duanxuebin1998/cube/docs/01_协议与寄存器/AO电流输出/README.md

# AO 电流输出资料索引

更新日期：2026-08-17

本目录集中保存 4-20 mA/AO 输出的外部参考资料和项目侧整理结论。外部手册只读归档，当前 CUBE 的实际参数语义和运行行为仍以 CPU2/CPU3 当前源码、共享协议记录和版本资料为准。

## 资料入口

| 资料 | 用途 | 维护口径 |
| --- | --- | --- |
| [4-20mA 电流输出逻辑](4-20mA电流输出逻辑.md) | 说明CUBE三种过程源、基础/修正目标、初始/过程/保持/故障状态、维护模式故障电流屏蔽、缓存、阻尼、驱动失败、运行态和可执行测试矩阵 | 当前项目AO行为的正式说明；AO功能基线为协议27，协议33把修正和运行态电流提升为x1000 |
| [NMS81 4-20 mA 输出配置菜单（XMind 导入）](NMS81_4-20mA输出配置菜单.opml) | 按 NMS81 原手册菜单路径整理 Analog I/O、HART 输出和电流仿真菜单；每个配置项包含含义、可配置内容、默认值、显示条件、权限和手册页，并展开 38 个输出源 | XMind 可直接导入的 OPML；只整理原厂设备菜单，不包含项目代码或实现对照 |
| [NMS81 4-20 mA 输出配置整理](NMS81_4-20mA输出配置整理.md) | 提炼 Endress+Hauser Proservo NMS81 的输出模式、量程、故障策略、HART联动、监视和仿真配置，并记录CUBE最终采纳边界 | 原厂事实和项目采纳边界分开维护；不能把CUBE能力反写成NMS81原厂菜单 |
| [N81 - 操作手册.pdf](00_原始资料/N81%20-%20操作手册.pdf) | Proservo NMS81 中文操作手册原件，文档号 `BA01459G/28/ZH/07.23-00` | 原厂资料，只读保存；手册原文与整理文档冲突时以原文为准 |
| [00_原始资料/README.md](00_原始资料/README.md) | 记录原件版本、来源、哈希和使用边界 | 新增或替换原件时同步更新 |

## CUBE 当前依据

- [系统参数出厂默认值](../系统参数出厂默认值.md)：AO 参数字段、默认值、单位和归一化范围。
- [CPU2/CPU3 协议变更记录](../CPU2_CPU3协议变更记录.md)：协议20至27的AO参数、运行态、旧参数迁移、固定地址和兼容性。
- [AO电流输出配置菜单同构优化详细计划](../../02_需求与计划/未实现/2026-07-15_电流输出配置菜单同构优化详细计划.html)：产品语义和测试矩阵；HTML正文已按“5组16项+2个隐藏预留”整理。
- [AO 电流输出正式回读方案与实现流程](../../03_问题分析与整改/已闭环/2026-06-25_AO电流输出正式回读方案与实现流程.md)：CPU2 AO 运行链路和正式回读逻辑。
- [CPU3 当前屏幕菜单树](../../04_界面与菜单/CPU3当前屏幕菜单树.md)：当前可见 AO 菜单项。

AO功能的首个协议27正式组合为CPU2 V1.31.0.0 / CPU3 V1.30.0.0；AO x1000语义从协议33正式组合CPU2 V1.39.0.0 / CPU3 V1.38.0.0起生效，当前协议34双端V1.40.0.0继续沿用。过程源仍为储罐液位、传感器位置和水位；基础AO配置保持x100，`电流修正`为`current_correction_mA_x1000`，最终目标和最近实发值同步为x1000。启用态按`base_x100 * 10 + correction_x1000`统一叠加一次，禁用3.400mA不修正。CPU3电流修正输入和输出电流显示使用三位小数。`AO输出电流`仍只是最近一次成功下发给AD5421的命令值；原错误等级槽位和`DAC回读电流`继续隐藏，DAC预留不是物理环路电流采样。

## 使用边界

- 本目录中的NMS81原始资料和OPML只用于外部产品配置参考；CUBE参数、寄存器、菜单和运行行为以当前协议34源码及上述项目正式文档为准，其中AO倍率和迁移规则源自协议33。
- NMS81 的接线方式、Ex-d/Ex-ia 输出能力、HART 和 SIL/WHG 功能依赖其订货选型与硬件模块，不能直接等同于 CUBE 硬件能力。
- 协议33保持第4个AO槽、LTD/LH地址、结构尺寸、CRC和`DEVICE_PARAM_VERSION=3`不变；协议26～32旧修正值乘10迁移，协议25及更早或未知版本归零。协议34不再改变AO字段。CPU2/CPU3必须严格使用同一协议版本，上位机协议32/33/34参数快照不得混用。自动检查和构建不证明真实电流环0.001mA精度、边界饱和、断环恢复或HART叠加，必须使用电流表台架验证。
