duanxuebin1998/cube/docs/06_SIL功能安全认证/00_外部资料/README.md

# 外部资料索引

更新日期：2026-07-03

## 目录用途

本目录用于归档 SIL/功能安全准备中可公开下载的官方资料，并记录版权受限、需授权或 NDA 资料的官方获取路径。资料只作为工程准备和学习参考，正式认证仍以官方完整标准、公司受控文件、认证机构要求和项目质量体系为准。

## 子目录

| 目录 | 内容 |
| --- | --- |
| `资料用途矩阵.md` | 按 SIL 工作场景整理外部资料用途、优先级、本地状态和推荐阅读顺序 |
| `01_标准与流程/` | IEC 61508 概览、HSE 功能安全流程参考、正式标准获取路径和官方公开下载核查记录 |
| `02_编码规范与静态分析/` | MISRA/CERT C、静态分析、偏离管理和编码检查资料 |
| `03_STM32与X-CUBE-STL/` | STM32、X-CUBE-STL、ST Safety Manual、芯片手册和勘误链接 |
| `04_认证机构与流程/` | TÜV、exida、DNV 等认证机构流程链接和沟通准备项 |
| `05_需购买或NDA资料/` | IEC/MISRA 主标准、ST FMEDA/FMEA、工具资质包等官方获取或受控资料清单 |
| `06_案例参考/` | 外部已认证产品的安全手册、证书整理和可借鉴的工程资料结构 |
| `07_GD32功能安全与自检库/` | CPU2 替换 GD32F450/GD32F470 时的 IEC60730 ClassB 自检库、IEC61508 证书差异和官方资料入口 |

## 资料入口

| 资料范围 | 本地状态 | 入口 |
| --- | --- | --- |
| IEC/GB/T 功能安全标准与流程 | 已归档用户提供的 GB/T 20438-2017 七分册、IEC 61784-3:2021、IEC 概览和 HSG238 | `01_标准与流程/README.md` |
| 标准原文归档状态 | 已登记 GB/T 20438-2017 七分册、IEC 概览、HSG238 和官方核查后待补入的 IEC/ISO/GB/T 标准原文路径 | `01_标准与流程/标准原文归档清单.md` |
| 官方公开下载核查 | 已记录 IEC Webstore 和国家标准全文公开系统页面的公开下载状态 | `01_标准与流程/官方预览与公开说明/README.md` |
| 传感器安全通信相关标准 | 已整理 IEC 61508、IEC 61784-3、IEC 62280、IEC 61511、IEC 62061、ISO 13849-1、IEC 62443 和 EMC 相关标准适用矩阵 | `01_标准与流程/传感器安全通信相关标准适用矩阵.md` |
| MISRA/CERT 与静态分析 | 已归档 MISRA Compliance、MISRA C:2012 Amendment 4 等公开资料；主规则需从官方渠道授权获取 | `02_编码规范与静态分析/README.md` |
| STM32 与 X-CUBE-STL | 已归档用户提供的 ST 官方 SIL 资料和 X-CUBE-STL-F4 V2.0.0 包内文档 | `03_STM32与X-CUBE-STL/README.md` |
| 认证机构流程 | 保留 TÜV、exida、DNV 等官方入口和沟通准备项 | `04_认证机构与流程/README.md` |
| 官方获取或受控资料 | 只记录官方获取路径，不绕过访问控制 | `05_需购买或NDA资料/README.md` |
| 外部案例 | 已归档用户提供的 Endress+Hauser NMS81 功能安全资料 | `06_案例参考/README.md` |
| GD32 功能安全与自检库 | 已整理官方入口和公开结论，未归档 PDF | `07_GD32功能安全与自检库/README.md` |

详细到单份 PDF、官方链接、本地归档状态和推荐阅读顺序时，优先看 `资料用途矩阵.md` 和各子目录 README。

## 资料使用建议

| 工作项 | 优先查看 |
| --- | --- |
| 不知道先看哪份外部资料 | `资料用途矩阵.md` |
| 查标准原文是否已入库、官方是否公开下载或是否待授权 | `01_标准与流程/标准原文归档清单.md`、`01_标准与流程/待获取标准原文/README.md` |
| 查 IEC 61784-3:2021 原文 | `01_标准与流程/待获取标准原文/IEC_61784-3/IEC_61784-3_2021.pdf` |
| 了解 SIL/功能安全生命周期 | `01_标准与流程/README.md`、`01_标准与流程/GB_T_20438_2017/`、IEC 概览、HSG238 |
| 设计或评审传感器安全通信协议 | `01_标准与流程/传感器安全通信相关标准适用矩阵.md`、`01_标准与流程/IEC_61784-3_传感器通信与功能安全手册.md` |
| 制定编码检查和偏离流程 | `02_编码规范与静态分析/README.md`、MISRA Compliance、CPU2 编码规范 |
| 评估 STM32 诊断和安全库 | `03_STM32与X-CUBE-STL/README.md`、X-CUBE-STL、ST Safety Manual |
| 评估 GD32F450/GD32F470 替代 CPU2 的自检库和证书边界 | `07_GD32功能安全与自检库/README.md` |
| 准备认证机构沟通 | `04_认证机构与流程/README.md`、项目交付物清单 |
| 发起授权、采购或 NDA | `05_需购买或NDA资料/README.md` |
| 借鉴外部产品安全手册结构 | `06_案例参考/README.md`、`../02_软件架构/NMS81案例对CUBE_SIL认证和软件架构的启发.md` |

## 维护规则

- 新增外部 PDF 时优先使用官方直链或官方网站下载，并确认下载结果是真正的 PDF 或原始资料文件。
- 不收录非官方分享的 IEC、MISRA、认证报告或供应商 NDA 文件。
- ST、工具厂商和认证机构资料如果需要登录、表单或 NDA，记录官方页面，不绕过访问控制。
- 每个子目录 README 要说明资料用途、获取方式和本地下载状态。
