duanxuebin1998/cube/docs/07_硬件原理图/00_原始资料/README.md

# 硬件原理图原始资料

更新日期：2026-08-03

本目录保存硬件原理图和供应商资料的原始文件。这里的文件用于追溯来源，不直接作为可持续维护的说明文档；需要解释固件关联、接口含义或问题结论时，应在上一级目录编写 Markdown 整理文档。

## 文件说明

| 文件 | 用途 |
| --- | --- |
| `储罐自动计量仪原理图汇总.pdf` | 储罐自动计量仪板级框图和分板原理图原始 PDF |
| `S002-2026-V1.1.pdf` | LTD 传感器 S002-2026-V1.1 原始原理图 |
| `CPU2芯片手册/TMC5130A_datasheet_rev1.21.pdf` | CPU2 电机驱动 TMC5130A 数据手册 |
| `CPU2芯片手册/CH9141K/` | CPU2 无线滑环/蓝牙透传链路使用的 CH9141K 规格书和模块说明 |
| `无线滑环蓝牙主从机/` | 由 `LTD-Transfor-MAIN-A3.DDB` 和 `LTD-Transfor-Slave-A3.DDB` 转换的主机、从机原理图矢量 PDF 及来源校验说明 |
| `DM4四代数字驱动V6.0/` | DM4 电源板、驱动板、采集板和测水连接板 V6.0 原理图 PDF，以及原始 SchDoc/PDF SHA-256 和转换检查说明 |

## 维护规则

- 原始图纸保留原文件名，避免和硬件版本、供应商资料脱节。
- 不直接修改原始 PDF；需要说明时新增或更新上一级 Markdown 整理文档。
- 新增图纸时在本 README 记录来源、版本和适用范围，并在 `docs/07_硬件原理图/README.md` 增加入口。
- 固件开发结论以原理图、BOM、PCB 文件和硬件评审结论共同确认，本目录只提供原始资料追溯。
