duanxuebin1998/cube/docs/01_协议与寄存器/CPU2通信与解耦/README.md

# 通信与解耦资料索引

更新日期：2026-07-10

本目录保存 CPU2 串口调试、CPU2/CPU3 通信、UART6、传感器无线通信、无线滑环匹配和解耦实施资料。

| 文档或目录 | 内容 |
| --- | --- |
| `CPU2串口调试命令协议卷.md` | CPU2 USART1 调试命令的帧格式、严格语法、ACK/ERR、通用 STOP、查询命令、安全边界和验证矩阵 |
| `串口助手命令面板/` | 可直接导入的 CPU2 串口助手命令面板 JSON，以及生成、同步、维护和验证说明 |
| `CPU2串口调试指令与打印信息梳理.md` | CPU2 串口调试指令、状态显示和主要打印字段总表 |
| `CPU2_HART旧栈适配与E+H兼容方案.html` | 放弃当前手写 HART 后，复用 CPU2_v1.563 HART 栈并兼容 E+H 的适配方案 |
| `UART6异常包与CPU2CPU3通信影响分析.md` | UART6 异常包对 CPU2/CPU3 通信链路的影响分析 |
| [CPU3与CPU2通信超时故障状态整改](../../03_问题分析与整改/已闭环/2026-07-09_CPU3与CPU2通信超时故障状态整改.md) | CPU3 连续请求未获得合法 CPU2 响应后的本机故障状态、错误码和状态页显示口径 |
| `传感器与无线通信优化检查.md` | 传感器与无线主从机通信优化检查；传感器内部协议正文维护在 `../传感器通信协议/` |
| `解耦实现计划.md` | LTD_MAIN_CPU2 解耦实施详细计划和 CubeMX 兼容边界 |
| `无线滑环匹配/` | 无线滑环人工匹配、设备端匹配方案和开发执行记录 |

涉及 CPU2/CPU3 共享状态或寄存器时，同步检查 `D:/CUBE/docs/01_协议与寄存器/CPU2_CPU3协议变更记录.md`。

## 维护口径

- 同名 Markdown 和 PDF 同时存在时，以 Markdown 为维护正文，PDF 仅作为导出或阅读件。
- `无线滑环匹配过程.docx` 作为原始过程记录保留在专题目录；后续形成实现结论时，优先补 Markdown 摘要。
