duanxuebin1998/cube/docs/01_协议与寄存器/传感器通信协议/传感器安全协议SIL/README.md

# 传感器安全协议 SIL 资料索引

更新日期：2026-08-07

本目录是 CPU2 与安全相关传感器通信协议的正式 Markdown 维护入口。资料按“现行协议、候选协议、实施与验证、安全论证、历史方案”分层，避免把已实现基线、未来设计和历史方案混在一起。

## 当前结论

- 当前已冻结并具有 CPU2 设备侧实现证据的是安全通信协议 V1，线上 `protocol_version=0x01`。
- V1 的传感器端实现、真实短线和 200 米 RS485、故障注入、FTTI、诊断覆盖率及 SIL 定量论证尚未关闭。
- V2 是待评审的新协议，线上候选 `protocol_version=0x02`，采用单活动端点互斥和安全运行期纯单向主动上报。
- V2 支持后续增加电导率、含水率等不同传感器 Profile，但任一时刻最多只有一个传感器主动发送。
- 旧“双端点同总线轮询”方案已被 V2 单活动端点方案替代，仅保留为历史资料。

## 阅读顺序

| 顺序 | 入口 | 用途 | 状态 |
| ---: | --- | --- | --- |
| 1 | [01_现行协议V1](01_现行协议V1/README.md) | 查看当前冻结协议和线上 V1 契约 | 当前基线 |
| 2 | [02_候选协议V2](02_候选协议V2/README.md) | 评审新的单活动端点纯单向协议 | 待评审，未实现 |
| 3 | [03_实施与验证](03_实施与验证/README.md) | 查看 V1 已有证据和 V2 待执行落地任务 | V1实施资料、V2实施设计 |
| 4 | [04_安全论证](04_安全论证/README.md) | 查看残余危险失效率输入和关闭条件 | 框架未关闭 |
| 5 | [99_历史方案](99_历史方案/README.md) | 追溯已经被替代的设计 | 不再作为实现输入 |

## 权威文档

| 文档 | 定位 |
| --- | --- |
| [传感器安全通信协议V1](01_现行协议V1/传感器安全通信协议V1.md) | 当前冻结线上协议，定义 V1 帧、命令、会话、参数和状态机 |
| [传感器安全通信协议V2](02_候选协议V2/传感器安全通信协议V2.md) | 新协议候选，定义单活动端点、纯单向上报和可扩展 Runtime Profile |
| [V2连接与测量通信示例](02_候选协议V2/V2连接与测量通信示例.md) | V2 控制阶段请求/响应、运行期主动上报、停止、切换和异常交互示例 |
| [V2协议落地方案](03_实施与验证/V2协议落地方案.md) | V2的CPU2、传感器端、Profile、工具、联调和安全证据实施拆分 |
| [V1协议验证记录](03_实施与验证/V1协议验证记录.md) | V1 已执行设备侧证据和未执行硬件证据边界 |

## 机器契约

V1 配套机器契约仍位于上级 `golden_frames/`：

- [sensor_safe_protocol_v1.json](../golden_frames/sensor_safe_protocol_v1.json)
- [sensor_safe_param_digest_v1.json](../golden_frames/sensor_safe_param_digest_v1.json)

V2 尚未生成机器契约和 golden frame。

## PDF 说明

本次只整理 Markdown。目录根部已有 PDF 保持原文件、原名称和原位置，不删除、不移动、不更新；PDF 可能晚于或早于对应 Markdown，不作为当前协议评审依据。

## 维护规则

1. V1 和 V2 分开维护，V2 未评审、实现和验证前不得写成当前固件行为。
2. 新传感器通过 V2 Runtime Profile 扩展；改变公共信封、命令或状态机时必须评估提升安全协议版本。
3. 实施证据必须注明协议版本、CPU2/传感器端范围以及真实硬件是否执行。
4. 历史方案不得重新成为实施输入；需要恢复时必须重新评审并形成新版本。
5. 代码、golden frame、主机测试或构建通过均不等于完成 SIL2/SC3 认证。
