duanxuebin1998/cube/docs/07_硬件原理图/00_原始资料/DM4四代数字驱动V6.0/README.md

# DM4 四代数字驱动 V6.0 原理图

更新日期：2026-08-03

本目录归档用户提供的 DM4 四代数字驱动 V6.0 传感器原理图 PDF。原始 `.SchDoc` 保留在外部来源目录，本仓库仅保存便于查阅的 PDF 和来源校验信息。

## 文件与校验值

| 板卡 | 原始 SchDoc SHA-256 | PDF | 页数 | PDF SHA-256 |
| --- | --- | --- | ---: | --- |
| 电源板 | `E15863B8D6A9390E54DE44D2D0B7FB24E2710EF94FB930B1E5E06C64D2D02629` | [DM4电源板V6.0.pdf](./DM4电源板V6.0.pdf) | 1 | `6F6F8FF259AD42A78A234AD35E39CC1ECA3CD201B045D382E70E18E7FD69F36B` |
| 驱动板 | `FC79E560E497B83C1F3F8D5289EFA8DA1F2EBBD08602663232D53E90CDCC7B45` | [DM4驱动板V6.0.pdf](./DM4驱动板V6.0.pdf) | 1 | `C798C071D3CF901D9DD299B6CFD1A29AC4B9A52092CB04CF115598F41D68A50A` |
| 采集板 | `DDF63B793EDD441FAB12EE67C671887B3522ED46493B9832B5CDE046ADD4980B` | [DM4采集板V6.0.pdf](./DM4采集板V6.0.pdf) | 1 | `F833BF9F6B20BE3F49F80298849027F48744DFCF642C2D27258B11D7A3E2C3C8` |
| 测水连接板 | `BB46F68F6566EFAD17B0022326B9858E40D17BC3F23A10C88ACEC51204FB0709` | [DM4测水连接板V6.0.pdf](./DM4测水连接板V6.0.pdf) | 1 | `9B4971889A487861FB735D125A373486F549442DF7102D03D95D8C297E13FD35` |

## 转换与检查说明

- 使用 `altium-toolkit 1.4.3` 原生解析 `.SchDoc`，生成 SVG 后通过 Chromium 矢量打印为 PDF；本机未安装 Altium Designer，因此这不是 Altium 官方打印输出。
- 四份 PDF 均为单页，页面尺寸为 `1125.12 x 743.04 pt`（约 `396.9 x 262.1 mm`）。
- 已从最终 PDF 重新渲染并逐页检查，未发现空页、裁切、明显重叠或中文乱码；文本层可检索，未发现 Unicode 替换字符或常见乱码字符串。
- 解析器报告了少量“同一网络恢复到多个显式网络名”的提示：驱动板涉及 `AGND/REFIN(-)`、`REFIN(+)/I-`、`IOUT1/I+`，采集板涉及 `LEVEL/OUT`，测水连接板涉及 `AIN1-/I-`、`AIN1+/I+`；电源板无此类提示。此类提示未自动改写图纸，使用时应回到原始 `.SchDoc`、BOM、PCB 和硬件评审记录核对网络语义。

## 使用边界

本目录只证明原理图已归档、转换并通过静态可读性检查，不证明硬件设计、PCB 实现、本安参数、传感器安全协议或 SIL 认证已经验证。生产与安全结论仍需结合原始设计文件、BOM、PCB、实物测试、故障注入和正式硬件/功能安全评审。

详细的四板系统、测量链路和安全证据边界分析见：

- [DM4四代数字驱动V6.0原理图详细分析.md](../../DM4四代数字驱动V6.0原理图详细分析.md)
- [DM4四代数字驱动V6.0原理图详细分析.html](../../DM4四代数字驱动V6.0原理图详细分析.html)
