duanxuebin1998/cube/docs/07_硬件原理图/00_原始资料/无线滑环蓝牙主从机/README.md

# 无线滑环蓝牙主从机原理图 PDF 归档说明

更新日期：2026-07-24

本目录保存由 Protel 99SE DDB 转换得到的无线滑环蓝牙主机、从机原理图 PDF。转换仅用于阅读和资料归档，未修改原始电气设计。

## 归档文件

| 文件 | 内容 | 页数与页面规格 |
| --- | --- | --- |
| `LTD-Transfor-MAIN-A3_蓝牙主机原理图.pdf` | 蓝牙主机项目总览、通信控制页和主机电源/无线供电页 | 3 页：横向 A4、横向 A3、横向 A4 |
| `LTD-Transfor-Slave-A3_蓝牙从机原理图.pdf` | 蓝牙从机项目总览、通信控制页和从机电源/无线供电页 | 3 页：横向 A4、横向 A3、横向 A3 |

两份文件均为可缩放、可检索文字的矢量 PDF。

## 原始文件校验

| 角色 | 原始文件 | SHA-256 |
| --- | --- | --- |
| 主机 | `LTD-Transfor-MAIN-A3.DDB` | `8646CE24DE37875D08CF3AA5EEC4A6BF382F134D8832B251641D0259DC0D47AB` |
| 从机 | `LTD-Transfor-Slave-A3.DDB` | `75224B79E5015513DE322D1767750484768395C9100BAC7CEE450301F572BBBA` |

## PDF 文件校验

| 文件 | SHA-256 |
| --- | --- |
| `LTD-Transfor-MAIN-A3_蓝牙主机原理图.pdf` | `DEA07080455D6C00F7F1167DCAF59A9295A9F661700707EE7A04834F3FEB5B91` |
| `LTD-Transfor-Slave-A3_蓝牙从机原理图.pdf` | `075D9506268A5C273320742E8D900D1966E0700795B6685D76C809A4E9BB505F` |

## 有效页面与主要内容

### 蓝牙主机

| PDF 页码 | DDB 文档 | 主要内容 |
| --- | --- | --- |
| 1 | `A0000-A0.prj` | 项目总览和分图入口 |
| 2 | `A0000-A0.SO1` | CH9141K 无线收发、32 MHz 晶振、ANT-2.4G 天线、SN65HVD72DR RS-485 收发和方向控制 |
| 3 | `A0000-A0.SO2` | 9 V/VDD 电源、PMEG6010CEH、SCT2230、XKT001、XKT-335 及 C424420 无线充电线圈 |

### 蓝牙从机

| PDF 页码 | DDB 文档 | 主要内容 |
| --- | --- | --- |
| 1 | `A0000-A0.prj` | 项目总览和分图入口 |
| 2 | `A0000-A0.SO1` | CH9141K 无线收发、32 MHz 晶振、ANT-2.4G 天线、SN65HVD72DR RS-485 收发、主从机接口 |
| 3 | `A0000-A0.SO2` | AP3015 升压、ADP7102、AP2210、T3168、3.3 V/5 V/AVCC 电源、保护器件及 C424420 无线充电线圈 |

## 转换范围与说明

- 两个 DDB 的当前 `Documents` 目录均只有 `A0000-A0.prj`、`A0000-A0.SO1`、`A0000-A0.SO2` 三个有效文档，因此每份 PDF 只归档这 3 页。
- 项目总览仍保留 `A0000-A0.SO3` 至 `A0000-A0.SO6` 和旧的 5 页编号，但这些文档当前并不存在；转换时没有虚构或补建缺失页面。
- DDB 回收站和历史记录中的旧页面不属于当前有效设计，未纳入 PDF。
- 原始 Protel 缓存中有多个不同器件共用 `Component_1` 名称；转换时依据器件型号、封装和兼容引脚定义消歧，避免 CH9141K、AP3015、SCT2230、XKT001、天线、晶振和二极管符号互相覆盖。
- PDF 未叠加 KiCad 图框，以避免新增图框遮挡原图标题和页码；原图中的标题、网络名、器件参数和设计备注均保留。
- 真实接线、器件选型和硬件版本仍应结合原始 DDB、BOM、PCB 文件及硬件评审结论确认。
