duanxuebin1998/cube/docs/01_协议与寄存器/AO电流输出/00_原始资料/README.md

# AO 电流输出原始资料

更新日期：2026-07-15

本目录保存 4-20 mA/AO 输出相关的外部原始资料。原件用于页级追溯，不直接作为 CUBE 当前实现口径；项目侧结论维护在上一级 Markdown 文档中。

## 文件说明

| 文件 | 来源与版本 | 用途 | 完整性 |
| --- | --- | --- | --- |
| `N81 - 操作手册.pdf` | Endress+Hauser Proservo NMS81 中文操作手册；文档号 `BA01459G/28/ZH/07.23-00`；发布日期 `2023-10-25`；适用设备固件 `01.07.zz` 及以上 | 核对 NMS81 安装、接线、操作和 4-20 mA/HART 输出配置 | 15,550,736 字节；344 页；SHA-256 `3B96DB6BDF3E9A7A05086F97AF4C8AEF8D481F46D7127204F0EA2D85E5A7B9B8` |

## 维护规则

- 原件从 `D:\程序存档\N81 - 操作手册.pdf` 归档，文件名保持不变。
- 不直接修改或重新导出原厂 PDF；如取得新版手册，保留版本可区分的原件并更新本 README。
- 4-20 mA 输出摘要、CUBE 对照和后续建议维护在 [NMS81 4-20 mA 输出配置整理](../NMS81_4-20mA输出配置整理.md)。
