duanxuebin1998/cube/docs/06_SIL功能安全认证/00_外部资料/03_STM32与X-CUBE-STL/99_ST官方原始包/README.md

# ST 官方原始包

更新日期：2026-06-06

## 目录用途

本目录保留用户提供的 X-CUBE-STL-F4 V2.0.0 原始资料包入口，便于后续重新解包、安装或核对包内文件。

## 文件索引

| 文件 | 状态 | 说明 |
| --- | --- | --- |
| `Readme.txt` | 已归档 | X-CUBE-STL-F4 V2.0.0 包 Readme |
| `X-CUBE-STL-F4_v2.0.0.zip` | 本机已复制，Git 忽略 | 原始 zip，受仓库 `.gitignore` 中 `*.zip` 规则忽略，不会进入普通提交 |

## 归档边界

- 未复制 `STM32CubeExpansion_STL_F4_V2.0.0` 解压后的完整源码树；该目录约 334.76MB、5748 个文件。
- 未复制安装包中的 `STM32CubeExpansion_STL_F4_V2.0.0_Setup.exe`，避免把可执行安装器纳入仓库。
- 需要集成 STL 源码或示例工程时，应单独建立引入方案，确认许可证、版本锁定、构建范围和测试证据。
