duanxuebin1998/cube/docs/06_SIL功能安全认证/00_外部资料/03_STM32与X-CUBE-STL/99_ST官方原始包/Readme.txt

version V2.0.0
--------------
This document describes the STM32F4 Safety release, X-CUBE-STL-F4_v2.0.0

Main changes:
- Maintenance release with new STL lib

Content:
- the SW expansion package, delivery itself: STM32CubeExpansion_STL_F4_V2.0.0_Setup.exe

Integrity content check via md5sum:
- STM32CubeExpansion_STL_F4_V2.0.0_Setup.exe: 62e0eefec36efdbbb370720ab27db2ec

version V1.1.0
------------
This document describes the STM32F4 Safety release V1.1.0

Main changes:
The Release content is in line with new Safety package content delivery with:
- removal of TUV certificate and appendix to certificate
- addition of the Safety Manual and User Guide inside STM32CubeExpansion

Contents:
- the SW expansion package, delivery itself: STM32CubeExpansion_STL_F4_V1.1.0_Setup.exe

Integrity content check via md5sum:
- STM32CubeExpansion_STL_F4_V1.1.0_Setup.exe: 6b49c51f0bd7c6943d421d8a8bf1afcf

version V1.0.0
---------------
Please find enclosed the STM32F4 Series self-test library Release V1.0.0.

You can find attached:
- the SW expansion package, delivery itself: STM32CubeExpansion_STL_F4_V1.0.0_Setup.exe
- the STL Safety Manual: STL_F4_SM_cx616769_4.0.pdf
- the STL User Guide: STL_F4_UG_cx616705_2.0.pdf
- the certificate itself: 968_FSP_1627_00_18_en_el.pdf
- the certificate related revision list: FSP_1627_00_18_RL_2019_04_05.pdf

Integrity content check via md5sum:

- 968_FSP_1627_00_18_en_el.pdf: 28e55877dd569afe07f08d09d586a783

- FSP_1627_00_18_RL_2019_04_05.pdf: 9c53bd7b701fe0e2ab0940a28753508f

- STL_F4_SM_cx616769_4.0.pdf: bbc0bdc0e8e397d2d87f61d05b71024e

- STL_F4_UG_cx616705_2.0.pdf: 3e2da1038eaadace9a463d5f279756b1

- STM32CubeExpansion_STL_F4_V1.0.0_Setup.exe: a33f6b4013740b8397425e17843de614
