duanxuebin1998/cube/docs/01_协议与寄存器/SI协议适配/05_官方资料中文整理/tools/audit/translation_audit_report.md

# SI-7000 中文翻译覆盖审计报告

- 原始 PDF 页数：101
- 原始 PDF 可抽取文本总字符数：123858
- 中文章节稿字符数：86103

## 可抽取文本较少的页面

这些页面通常是图片、扫描页、图纸或封面，需要以图片和人工译注核对。

| PDF 页码 | 可抽取字符数 | 文本片段 |
| --- | ---: | --- |
| 3 | 37 | The New SI-7000 LTD Tank Gauge System |
| 7 | 6 | Page 7 |
| 8 | 0 |  |
| 9 | 0 |  |
| 101 | 14 | CSF0030 Rev. - |

## 主题覆盖检查

| 原文主题 | 中文检查词 | 原文出现 | 中文出现 |
| --- | --- | --- | --- |
| Online Informational Catalog | 在线信息目录 | 是 | 是 |
| Cryogenic Temperature Sensors | 低温温度传感器 | 是 | 是 |
| LNG Tank Gauging | LNG 储罐计量 | 是 | 是 |
| DCS Modbus Interface Specification | DCS Modbus 接口规范 | 是 | 是 |
| RS485 | RS485 | 是 | 是 |
| Odd parity | 奇校验 | 是 | 是 |
| Function 1 | Function 1 | 是 | 是 |
| Function 2 | Function 2 | 是 | 是 |
| Function 3 | Function 3 | 是 | 是 |
| Function 4 | Function 4 | 是 | 是 |
| Function 5 | Function 5 | 是 | 是 |
| Function 6 | Function 6 | 是 | 是 |
| Manual | Manual | 是 | 是 |
| Calibrate | 校准 | 是 | 是 |
| Auto | Auto | 是 | 是 |
| Profile | Profile | 是 | 是 |
| Bottom Reference | Bottom Reference | 是 | 是 |
| Upper Level Sensor | 上液位传感器 | 是 | 是 |
| Lower Level Sensor | 下液位传感器 | 是 | 是 |
| Probe Un-calibrated | Probe Un-calibrated | 是 | 是 |
| Alarm Disable | 报警禁用 | 是 | 是 |
| Start Position | 起始位置 | 否 | 否 |
| Stop Position | 停止位置 | 否 | 否 |
| Interval Timer | 间隔定时 | 是 | 是 |
| Auto Profile | 自动 Profile | 否 | 是 |
| Density Alarm | 密度报警 | 是 | 是 |
| Temperature Alarm | 温度报警 | 是 | 是 |
| Level | 液位 | 是 | 是 |
| Temperature | 温度 | 是 | 是 |
| Density | 密度 | 是 | 是 |
| Packaging Specifications | 包装规格 | 是 | 是 |
| General Arrangement | 总体布置 | 是 | 是 |
| Field Wiring Diagram | 现场接线图 | 是 | 是 |
| Installation & Commissioning Manual | 安装与调试手册 | 是 | 是 |
| Warnings, Cautions, and Notices | 警告、注意和通知 | 是 | 是 |
| Installation Requirements | 安装要求 | 是 | 是 |
| Pre-Installation Check Lists | 安装前检查清单 | 是 | 是 |
| Unpacking and Inspection | 开箱和检查 | 是 | 是 |
| Connecting System Wiring | 连接系统接线 | 是 | 是 |
| Initial Power Up | 初始上电 | 是 | 是 |
| Motor Driver Test | 电机驱动测试 | 是 | 是 |
| Bench Marking | Bench Marking | 是 | 是 |
| Operational Manual | 操作手册 | 是 | 是 |
| Theory of Operation | 工作原理 | 是 | 是 |
| System Specifications | 系统规格 | 是 | 是 |
| Home Screen | Home Screen | 是 | 是 |
| System Configuration Menu | System Configuration Menu | 是 | 是 |
| Command Menu | Command Menu | 是 | 是 |
| Service Manual | 维修手册 | 是 | 是 |
| Periodic Maintenance Procedure | 周期性维护流程 | 是 | 是 |
| Basic Functionality Testing | 基本功能测试 | 是 | 是 |
| Systems Warranty Policy | 系统保修政策 | 否 | 是 |

## 英文残留高频词

以下仅用于人工判断，专业术语和界面英文可能需要保留。

| 英文词 | 次数 |
| --- | ---: |
| SI-7000 | 212 |
| png | 87 |
| assets/ | 85 |
| inch | 67 |
| Part | 56 |
| deg | 54 |
| Tank | 35 |
| Point | 32 |
| Mechanical | 31 |
| Instruments | 30 |
| Scientific | 28 |
| Probe | 28 |
| Figure | 28 |
| RS-485 | 27 |
| Reserved | 26 |
| kg/m3 | 26 |
| Host | 23 |
| arrow | 23 |
| Sheet | 22 |
| and | 22 |
| mode | 22 |
| Mode | 22 |
| Electrical | 22 |
| AWG | 22 |
| Alarm | 19 |
| SII | 19 |
| reference | 18 |
| Motor | 18 |
| Address | 16 |
| position | 16 |
| LCD | 16 |
| Operational | 15 |
| High | 15 |
| bottom | 15 |
| Low | 14 |
| Deviation | 14 |
| Unit | 14 |
| Enclosure | 14 |
| Configuration | 14 |
| Wiring | 13 |
| Sensor | 13 |
| Current | 13 |
| Power | 13 |
| IIC | 13 |
| down | 13 |
| parked | 13 |
| Field | 12 |
| Gauging | 12 |
| CUBE | 12 |
| bit | 12 |
| Automatic | 12 |
| Set | 12 |
| Calibration | 12 |
| Interface | 11 |
| Liquid | 11 |
| count | 11 |
| Test | 11 |
| mm2 | 11 |
| pdf | 10 |
| General | 10 |
| West | 10 |
| Bottom | 10 |
| Reference | 10 |
| steel | 10 |
| Communications | 10 |
| flame | 10 |
| path | 10 |
| Inc | 10 |
| run | 10 |
| Interlock | 9 |
| Arrangement | 9 |
| Installation | 9 |
| Gauge | 9 |
| Range | 9 |
| probe | 9 |
| switch | 9 |
| Worksheet | 9 |
| Diagram | 8 |
| drive | 8 |
| Reel | 8 |

## 高风险术语所在中文行

- | 3 | 总体布置图、带夹管阀（Pinch Valve）布置图、所需间隙、现场接线图 | `03_机械布置与现场接线_中文整理.md`，图纸 PNG | 已完成第一版 |
- 需要重点注意：如果主机手动设置任何与探头方向或速度相关的位，会停止正在执行的 Profile 活动或液位跟踪，并把系统切换到 Manual drive mode。系统会无限期保持在该手动驱动状态，直到重新设置为 `Auto`、`Cal` 或 `Profile`。在 Manual mode 下，系统不能执行自动功能。
- | Probe At Liquid Level | 10013 | 探头处于液气界面，液位读数为当前值 |
- - `Probe At Liquid Level`
- `Probe At Liquid Level` 在系统处于 Auto 且探头位于液气界面时置位。该状态表示当前上报的液位是最新值。
- `Liquid Level` 保存最近一次液位读数。如果探头处于液面以下，例如正在执行 Profile，液位读数不会更新，直到探头返回液面。前文的 `Probe At Liquid Level` 状态位用于指示当前上报液位是否为最新值。
- - 模式和速度位的写操作会打断 Profile 或液位跟踪，并进入 Manual drive mode；做兼容适配或联调脚本时应避免无意写入速度位。
- - `Probe At Liquid Level`、`Probe Un-calibrated` 和 `Profile Complete` 是判断液位或 Profile 数据是否有效的关键状态。
- 官方资料把 SI-7000 定位为 LNG 和 LPG 储罐中液位、温度和密度剖面测量的主力方案。第三代 LTD 用于检测储罐内分层现象，并向 DCS 和其他主机提供翻滚 `rollover` 预测、翻滚预防以及贸易计量或财务计算所需数据。
- | Sensor Isolation | Intrinsically Safe | 传感器隔离为本质安全设计。 |
- | Stilling Well | With or Without，Consult Factory | 可带或不带静液井，需咨询厂家。 |
- | Isolation Valves | External Pinch Valve，Required | 要求外部夹管阀（Pinch Valve）。 |
- - `External Pinch Valve (Required)` 在规格页中标为必需，中文按“外部夹管阀（Pinch Valve）”理解；后续安装章节和机械布置图中应继续关注夹管阀安装要求。
- - 限制条件：`Flameproof joints are not intended to be repaired.` 即隔爆接合面不应修理；如需处理应联系厂家，并按证书 Annex 和厂家资料执行。
- - 产品规格页要求外部夹管阀（Pinch Valve）；机械布置图、安装手册和维修手册中涉及夹管阀、法兰、探头保护泡棉、吊装和接地要求的内容已按官方口径保留。
- 本文整理 SI-7000 官方资料包中的总体布置图、带夹管阀（Pinch Valve）布置图、所需维护间隙图和现场接线图。该部分主要是工程图纸，文字抽取不能完全替代图纸，因此本文以原始图纸 PNG 为依据，并补充关键标注中文说明。
- ## 2. SI-7000 General Arrangement with Pinch Valve，Sheet 2 of 4
- SI-7000 带 Pinch Valve 布置图 Sheet 2
- | Title | SI-7000 General Arrangement - with Pinch Valve |
- | M32 Explosion Proof (Exd) Field Conduit Entry (6 PLCS) | M32 隔爆 Exd 现场电缆管入口，共 6 处 |
- ### 2.2 夹管阀（Pinch Valve）相关尺寸和方向
- 图纸备注：夹管阀（Pinch Valve）的方向理想情况下应与机械外壳正面成 90 度或 +/-45 度。
- ## 3. SI-7000 General Arrangement with Pinch Valve，Sheet 3 of 4
- SI-7000 带 Pinch Valve 顶视方向图 Sheet 3
- 该页为顶视图 `Top View`，给出带夹管阀（Pinch Valve）安装时允许的两个方向：
- > Shown above are the two possible orientations when mounting an SI-7000 with a pinch valve. Option A and B ensure proper contact angle with the chain. No other positioning is acceptable.
- 中文整理：上图显示带夹管阀（Pinch Valve）安装 SI-7000 时允许的两种方向。Option A 和 Option B 能确保链条具有正确接触角。其他安装定位均不可接受。
- | Explosion Proof Switch | 防爆开关 |
- - 机械布置图确认 SI-7000 安装到标准 ANSI 6 inch 法兰，且带夹管阀（Pinch Valve）安装方向有明确限制。后续安装手册翻译时，应把夹管阀方向、法兰、吊装和保护泡棉步骤连起来阅读。
- | 42 | 9 | 下放到夹管阀（Pinch Valve）法兰、安装紧固件 | 安装调试手册第 9 页 |
- | 1 ea | Explosion proof external AC power switch | 防爆外部 AC 电源开关 |
- | 探头垂直运动 | 从驱动机构一直到罐底或静液井（stilling well），探头组件是否能够无阻碍垂直移动？任何障碍都可能使探头组件卡住，并损坏探头组件、链条和/或驱动机构。 |
- | 静液井（Stilling well） | 如果使用静液井，它是否垂直且尺寸足够，确保探头不会接触静液井内表面？与内表面接触可能导致不可预测运行，并给驱动系统增加额外应力，导致部件过早失效。 |
- | 夹管阀（Pinch Valve） | 如果使用夹管阀，是否安装为尽可能夹在链条平面侧，且手轮不会阻碍打开电气外壳门或拆除机械外壳盖？夹管阀对不准可能导致密封不良，使维护时过量气体逸出，也可能阻碍人员接近 SI-7000 的一侧。 |
- 1. 确认夹管阀（Pinch Valve）已按 4.3 节说明安装。
- 4. 移除 Blind Flange，并丢弃 3/4 inch 螺栓和螺母。保留平垫圈和锁紧垫圈，用于与夹管阀（Pinch Valve）提供的 3/4-10 x 2.5 inch 螺栓配合安装。
- 8. 将等电位接地电缆连接到电气外壳顶部的接地凸耳，使连接方式能够承受 30 m 范围雷电放电引起的电流路径。原文为 `in such a way that a bolt lightning of a 30m can be controlled`，中文按雷电等电位/接地能力理解，现场应以电气设计和规范复核。
- 整理备注：证书页明确 `Flameproof joints are not intended to be repaired.`，因此隔爆接合面（flame path）的清洁、保护和关门紧固步骤必须严格按厂家资料和现场防爆要求执行。
- - 夹管阀（Pinch Valve）、保护泡棉、吊装和法兰安装步骤与第三批机械布置图互相印证，后续如果整理现场安装检查表，可把这两份中文稿一起引用。
- 除提供准确储罐液位测量外，SI-7000 还可通过把多传感器探头组件定位到储罐任意高度，实现整个储罐内温度和密度的精确测量。由此可获取 Profile，准确呈现罐内当前状态。对于低温液体的安全储存和处理，该信息很关键，因为低温液体可能发生分层，并随时间形成潜在翻滚（rollover）条件。
- LNG 等低温液体储存中的重要安全问题之一是翻滚（rollover）。如果发生翻滚，储罐内部压力可能升至过高水平。储罐配有安全放空阀，用于防止压力上升到可能造成结构损坏的水平。然而，当这些阀动作时，气体会以不受控速率排向大气，这本身也是额外安全风险。
- | Sensor Isolation | Internal I.S. Barriers | 内部本安栅。 |
- | Mechanical | Stilling Well | Not Required，不要求静液井 |
- | Mechanical | Pinch Valve | Required，要求夹管阀 |
- | WARNING | 存在爆炸性环境时不得打开。气体/空气混合物最大实验安全间隙 MESG >= 0.05 mm。 |
- | Special Conditions of Use | Flameproof joints are not intended to be repaired. 隔爆接合面不应修理。 |
- `Probe at Liquid Level`：系统处于 Auto mode 并位于液位时，该指示应点亮。如果该指示不亮，操作员无法确认当前液位读数正确。如果探头在液面以下或在蒸气区，就无法知道液位是否正在变化。
- 偏差报警非常重要，因为密度或温度变化可能表示分层（layering/stratification）；如果不检查，可能导致潜在翻滚（rollover）条件。
- - 偏差报警（Deviation alarms）是判断分层（layering/stratification）的关键报警，和翻滚（rollover）风险相关；不要把它与普通高低温、高低密度报警混为一谈。
- 本文保留必要英文术语，例如 `Service Manual`、`Configuration Worksheet`、夹管阀（`Pinch Valve`）、上锁挂牌（`Lock-out Tag-out`）、隔爆接合面（`flame path` / `flameproof joint`）、`Auto`、`Manual`、`Cal Run`、`Profile`、`DVM`、`COM LED`。
- | WARNING | 存在爆炸性环境时不得打开。气体/空气混合物最大实验安全间隙 `MESG >= 0.05 mm`。 |
- - Grease for pinch valve，夹管阀（Pinch Valve）用润滑脂。
- | WARNING | 轴和轴套属于隔爆接合面（flameproof joints），不应修理。如需替换这些部件，应联系 Scientific Instruments。 |
- | 打开机械单元前，等待探头升温到环境温度。期间执行电子单元检查流程。 | 温暖天气下，探头约 4 小时达到环境温度。机械单元在此期间不能打开，但电子单元可以打开。探头升温期间不必关闭夹管阀（Pinch Valve）。 |
- ### 7.2 Pinch Valve
- | 确认探头位于 top limit switch 后，检查夹管阀（Pinch Valve）是否动作顺畅。此时不要关闭夹管阀。 | 关闭夹管阀前必须确认探头顶部位于 upper limit switch，否则可能损坏探头。将手轮顺时针旋转 5 圈，再逆时针旋转 5 圈。如果配有 grease fitting，应使用优质润滑脂润滑。 |
- | 检查驱动到顶部时记录的数值。牢固关闭夹管阀（Pinch Valve）。 | Top stop value 应与 `Configuration Worksheet` 中的值基本一致。 |
- | 完全打开夹管阀（Pinch Valve），并在 Manual 下驱动系统向下。 | 使用高速。无需在液体界面处停止。驱动期间监测系统，确认运行平稳。 |
- - Manual 驱动、夹管阀（Pinch Valve）、机械单元吹扫（mechanical unit purge）、防爆认证（explosion proof certification）等属于现场安全和厂家授权范围，当前中文稿仅用于资料理解，不作为现场操作授权。

## 原 PDF 页级文本摘要

| PDF 页码 | 可抽取字符数 | 高频英文词 |
| --- | ---: | --- |
| 1 | 382 | and, SI-7000, Online, Informational, Catalog, Cryogenic, Temperature, Sensors |
| 2 | 648 | SI-7000, Manual, of, Specification, Diagram, Table, Contents, LTD |
| 3 | 37 | The, New, SI-7000, LTD, Tank, Gauge, System |
| 4 | 2182 | and, the, for, to, in, LNG, LTD, of |
| 5 | 1072 | to, Range, Accuracy, Sensor, kg/m3, Designed, meet, Resolution |
| 6 | 447 | and, Temperature, Services, OUR, GLOBAL, INSTALLED, BASE, SINCE |
| 7 | 6 | Page |
| 8 | 0 |  |
| 9 | 0 |  |
| 10 | 166 | Page, SI-7000, Tank, Gauging, System, DCS, Modbus, Interface |
| 11 | 2624 | Data, Input, Profile, Definition, General, Digital, Output, or |
| 12 | 1998 | the, and, of, The, to, is, interface, be |
| 13 | 1931 | the, to, is, Function, and, of, are, mode |
| 14 | 907 | the, to, be, mode, of, system, any, in |
| 15 | 2022 | the, is, are, probe, Level, and, Sensor, for |
| 16 | 2275 | the, is, set, it, that, be, in, Profile |
| 17 | 1571 | the, Point, Alarm, Profile, Set, and, to, Reserved |
| 18 | 1431 | the, Profile, at, profile, to, in, be, Automatic |
| 19 | 1822 | the, and, to, in, for, are, be, of |
| 20 | 1421 | Profile, Point, the, Reserved, Current, profile, Probe, Position |
| 21 | 2472 | the, is, of, and, to, number, profile, The |
| 22 | 1321 | the, is, The, and, be, to, LTD, for |
| 23 | 3104 | the, is, of, to, and, are, in, liquid |
| 24 | 706 | the, to, of, and, be, is, graph, The |
| 25 | 1857 | THE, AND, PACKAGING, IS, WITH, DATE, WOODEN, FOR |
| 26 | 1073 | in, mm, DATE, Unit, REV, KN, APPROVED, GTN |
| 27 | 348 | N/A, SCIENTIFIC, INSTRUMENTS, INC., W., TIFFANY, DR., WEST |
| 28 | 348 | N/A, SCIENTIFIC, INSTRUMENTS, INC., W., TIFFANY, DR., WEST |
| 29 | 350 | N/A, SCIENTIFIC, INSTRUMENTS, INC., W., TIFFANY, DR., WEST |
| 30 | 573 | KN, Date, JR, DATE, ECN, LTR, Description, Rev.By |
| 31 | 396 | SCIENTIFICINSTRUMENTSINC., RelatedDrawing, Nomodificationspermitted, W.TIFFANYDR.WESTPALMBEACH, withoutreferencetothe, FLORIDA33407USA, AuthorizedPerson, MATERIAL |
| 32 | 170 | Page, SI-7000, Tank, Gauging, System, Installation, Commissioning, Manual |
| 33 | 2089 | AND, INSTALLATION, REQUIREMENTS, ELECTRICAL, SI-7000, TANK, COMMUNICATIONS, WIRING |
| 34 | 1528 | the, and, of, enclosure, The, section, to, Figure |
| 35 | 705 | and, manual, the, system, at, are, to, location. |
| 36 | 2171 | the, to, be, in, or, and, SI-7000, is |
| 37 | 2228 | the, to, of, ea, and, SI-7000, are, is |
| 38 | 2527 | the, and, to, or, of, that, in, ea |
| 39 | 1409 | the, and, be, SI-7000, to, for, power, crate |
| 40 | 879 | the, SI-7000, to, of, and, lifting, enclosure, probe |
| 41 | 440 | Figure, SI-7000, to, foam, probe, Remove, the, bolts |
| 42 | 403 | the, Figure, SI-7000, Pinch, Valve, flange, are, hardware |
| 43 | 1296 | the, to, THE, be, FOR, AND, of, THREADED |
| 44 | 851 | the, to, port, or, and, door, lower, AWG |
| 45 | 1339 | the, to, AC, power, port, entry, in, be |
| 46 | 1595 | the, to, AWG, signal, be, connector, main, wire |
| 47 | 689 | the, flame, in, door, has, been, position., Remove |
| 48 | 1797 | the, is, power, to, not, If, SI-7000, in |
| 49 | 1612 | the, motor, should, to, The, Touch, probe, its |
| 50 | 830 | the, to, motor, probe, The, should, position., lift |
| 51 | 2039 | the, and, to, bolt, of, Round, on, for |
| 52 | 161 | Page, SI-7000, Tank, Gauging, System, Operational, Manual, Part |
| 53 | 207 | Rev, by, Date, KN, Record, of, Revisions, RFEA |
| 54 | 1517 | SYSTEM, INTRODUCTION, GENERAL, DESCRIPTION, APPLICATION, CONFIGURATION, SPECIFICATIONS, CERTIFICATION |
| 55 | 2533 | the, of, to, and, in, is, tank, an |
| 56 | 1061 | IEC, EN, II, Ex, IIC, Ga, T4, Ta |
| 57 | 1379 | the, Input, to, and, of, cm, Required, all |
| 58 | 1712 | to, the, be, WARNING, or, when, and, Failure |
| 59 | 739 | the, in, to, NOTICE, no, is, operation, are |
| 60 | 153 | SI-7000, Tank, Gauging, System, Operational, Manual, Part, SCIENTIFIC |
| 61 | 248 | Rev, KN, by, Date, Record, of, Revisions, RFEA |
| 62 | 3210 | MODE, LEVEL, TEMPERATURE, DENSITY, ALARMS, SYSTEM, OF, LIQUID |
| 63 | 925 | MODE, START, AUTO/MANUAL, COMMAND, MENU, MANUAL, LEVEL, CALIBRATION |
| 64 | 2285 | the, to, The, and, is, in, liquid, controller |
| 65 | 1394 | the, of, probe, is, to, The, controller, in |
| 66 | 2660 | the, is, to, and, probe, The, of, in |
| 67 | 2441 | the, to, is, it, and, or, in, of |
| 68 | 1652 | the, is, and, The, be, level, to, it |
| 69 | 2404 | the, is, level, be, and, in, of, probe |
| 70 | 1532 | the, is, alarms, and, to, are, temperature, density |
| 71 | 289 | the, screen, SYSTEM, This, INFO, displays, software, revision |
| 72 | 585 | the, of, to, are, level, in, limits, alarms |
| 73 | 1294 | the, is, and, alarm, The, in, are, to |
| 74 | 1027 | the, is, and, alarm, density, are, to, Density |
| 75 | 326 | the, to, of, bottom, The, tank, and, touches |
| 76 | 543 | the, and, enter, ID, of, lower, level, bottom |
| 77 | 523 | the, and, date, to, time, with, for, one |
| 78 | 1147 | is, the, to, This, CAL, for, internal, use |
| 79 | 450 | is, Level, value, Scale, the, The, calibration, that |
| 80 | 630 | the, is, probe, and, Interlock, to, in, that |
| 81 | 844 | the, is, of, at, in, profile, The, point |
| 82 | 870 | the, in, to, is, start, it, will, time |
| 83 | 1083 | the, to, will, it, mode, probe, Manual, button |
| 84 | 1317 | the, to, it, and, After, will, liquid, button |
| 85 | 887 | or, Scientific, Instruments, the, please, contact, scientificinstruments.com, by |
| 86 | 149 | Page, SI-7000, Tank, Gauging, System, Service, Manual, SCIENTIFIC |
| 87 | 1777 | OF, CALIBRATION, ENCLOSURE, MAINTENANCE, ELECTRICAL, DOOR, TEST, TABLE |
| 88 | 1523 | the, and, of, enclosure, The, section, to, Figure |
| 89 | 384 | manual, to, the, at, typical, location., for, This |
| 90 | 2378 | the, to, be, and, in, is, shall, not |
| 91 | 357 | NOTICE, shall, be, All, service, in, to, by |
| 92 | 2521 | the, to, is, of, be, temperature, and, for |
| 93 | 1845 | the, to, door, be, enclosure, flame, is, not |
| 94 | 313 | of, be, WARNING, Shafts, and, bushings, flameproof, joints |
| 95 | 2586 | the, probe, and, in, is, to, with, liquid |
| 96 | 2170 | the, and, to, probe, of, is, Check, it |
| 97 | 1922 | the, to, and, is, it, be, no, are |
| 98 | 1676 | the, is, to, power, not, Touch, The, motor |
| 99 | 1488 | the, motor, to, probe, should, The, Touch, arrow |
| 100 | 640 | the, to, motor, probe, position., The, should, From |
| 101 | 14 | CSF0030, Rev. |
