duanxuebin1998/cube/docs/01_协议与寄存器/系统参数出厂默认值.md

# 系统参数出厂默认值

更新日期：2026-08-17

本文整理 CPU2 `RestoreFactoryParamsConfig()` 写入的系统参数出厂默认值。CPU2 是参数 FRAM 的最终持久化端；CPU3 参数菜单名称和小数位来自 `param_meta[]`，用于辅助阅读。未在恢复出厂函数中显式赋值的 `reserved*` 字段由 `memset()` 清零。

## 数据来源

| 来源 | 用途 |
| --- | --- |
| `LTD_MAIN_CPU2/Services/ParamStorage/system_parameter.c` | 恢复出厂默认值的实际赋值入口 |
| `LTD_MAIN_CPU2/Services/ParamStorage/system_parameter.h` | `DeviceParameters` 字段、枚举、常量 |
| `LTD_DISPLAY_CPU3/Application/system_param/system_parameter.c` | CPU3 参数菜单中文名、单位、小数位 |
| `LTD_MAIN_CPU2/Application/Inc/app_version.h` | CPU2 固件版本编码 |

## 基础参数

| 字段 | 菜单/含义 | 出厂默认值 | 人读值/说明 |
| --- | --- | --- | --- |
| `command` | 设备指令 | `CMD_NONE` | 0，无命令 |
| `powerOnDefaultCommand` | 上电默认指令 | `CMD_NONE` | 0，无命令 |
| `sensorType` | 传感器类型 | `DSM_SENSOR` | 12，一体机传感器 |
| `sensorID` | 传感器编号 | `1234567` | 传感器编号 |
| `sensorSoftwareVersion` | 传感器软件版本 | `0x00010001` | V0.1.0.1 形式编码 |
| `softwareVersion` | CPU2 程序版本 | `CPU2_APP_VERSION_U32` | 当前版本头为 `V1.40.0.0` |
| `protocolVersion` | 协议版本 | `DEVICE_PROTOCOL_VERSION` | 当前开发源码为34；CPU2/CPU3必须严格配套 |
| `error_auto_back_zero` | 故障自动回零 | `0` | 禁用 |
| `error_stop_measurement` | 故障停止测量 | `1` | 启用 |
| `fault_auto_recovery_retry_limit` | 故障自动恢复重跑次数 | `3` | 0 关闭，1~10 为最多重跑次数 |
| `position_source_auto_switch` | 位置源自动切换 | `0` | 禁用 |

## 电机与编码器

| 字段 | 菜单/含义 | 原始默认值 | 人读值/单位 |
| --- | --- | --- | --- |
| `motor_current` | 电机运行电流 | `12` | TMC5130 `IRUN`；按当前 `RSENSE=0.15Ω`、`vsense=0` 硬件换算约 `0.55A RMS` 相电流 |
| `encoder_wheel_circumference_mm` | 编码轮周长 | `95000` | 95.000 mm，单位 0.001 mm |
| `max_motor_speed` | 电机限速 | `200` | 2.00 m/min，单位 0.01 m/min |
| `first_loop_circumference_mm` | 首圈周长 | `6000` | 600.0 mm，单位 0.1 mm |
| `tape_thickness_mm` | 尺带厚度 | `200` | 0.200 mm，单位 0.001 mm |
| `position_count_mode` | 记步模式 | `0` | 编码轮记步 |
| `motor_count_first_loop_circumference_mm` | 电机局部周长 | `600000` | 600.000 mm，单位 0.001 mm，由首圈周长乘 100 得到 |

## 扭力参数

| 字段 | 菜单/含义 | 出厂默认值 | 说明 |
| --- | --- | --- | --- |
| `empty_weight` | 空载扭力 | `0` | 有符号参数 |
| `empty_weight_upper_limit` | 空载扭力上限 | `5000` |  |
| `empty_weight_lower_limit` | 空载扭力下限 | `0` |  |
| `full_weight` | 满载扭力 | `5000` |  |
| `full_weight_upper_limit` | 满载扭力上限 | `30000` |  |
| `full_weight_lower_limit` | 满载扭力下限 | `1000` |  |
| `weight_upper_limit_ratio` | 碰撞上限比率 | `80` | 80% |
| `weight_lower_limit_ratio` | 碰撞下限比率 | `80` | 80% |

## 零点参数

| 字段 | 菜单/含义 | 原始默认值 | 人读值/单位 |
| --- | --- | --- | --- |
| `zero_weight_threshold_ratio` | 零点阈值比例 | `50` | 50% |
| `weight_ignore_zone` | 扭力忽略区 | `1000` | 100.0 mm，单位 0.1 mm |
| `max_zero_deviation_distance` | 零点最大偏差 | `1000` | 100.0 mm，单位 0.1 mm |
| `findZeroDownDistance` | 找零下行距离 | `1000` | 100.0 mm，单位 0.1 mm |

## 液位参数

| 字段 | 菜单/含义 | 原始默认值 | 人读值/单位 |
| --- | --- | --- | --- |
| `tankHeight` | 液位罐高 | `200000` | 20000.0 mm，单位 0.1 mm |
| `liquid_sensor_distance_diff` | 液位探头距差 | `1500` | 150.0 mm，单位 0.1 mm |
| `blindZone` | 液位盲区 | `3000` | 300.0 mm，单位 0.1 mm |
| `oilLevelThreshold` | 液位找液阈值 | `150` | CPU3 菜单显示 15.0 Hz；频率找液兼容路径按 x10 折算回 15 Hz 使用，密度路径复用同一 raw 时为 1.50 kg/m3 |
| `oilLevelHysteresisThreshold` | 液位滞后阈值 | `200` | CPU3 菜单显示 20.0 Hz；频率找液兼容路径按 x10 折算回 20 Hz 使用，密度路径复用同一 raw 时为 2.00 kg/m3 |
| `liquidLevelMeasurementMethod` | 液位测量方式 | `0` | 默认方式 0 |
| `oilLevelFrequency` | 液位跟随频率 | `5200` | Hz |
| `oilLevelDensity` | 液位跟随密度 | `0` | kg/m3，菜单小数位 2，内部密度 raw 为 x100 |
| `oilLevelHysteresisTime` | 液位滞后时间 | `0` | 0 s；仅用于方法 0/1 跟随变化确认，0 表示偏差超滞后阈值后立即重找，>0 表示连续超阈值 N 秒才重找，最大 60 s |

## 水位参数

| 字段 | 菜单/含义 | 原始默认值 | 人读值/单位 |
| --- | --- | --- | --- |
| `water_tank_height` | 水位罐高 | `200000` | 20000.0 mm，单位 0.1 mm |
| `water_level_mode` | 水位测量方式 | `0` | 默认方式 0 |
| `waterBlindZone` | 水位盲区 | `300` | 30.0 mm，单位 0.1 mm |
| `water_cap_threshold` | 水位跟随电容阈值 | `20000` | 20.000 pF，按 x1000 |
| `water_find_cap_threshold` | 水位寻找电容阈值 | `10000` | 10.000 pF，按 x1000 |
| `maxDownDistance` | 水位最大下行距离 | `3000` | 300.0 mm，单位 0.1 mm |
| `zero_cap` | 零点电容 | `0` | 菜单小数位 1 |
| `water_stable_threshold` | 水位稳定阈值 | `500` | 50.0 mm，单位 0.1 mm |
| `waterLevelCorrection` | 水位修正值 | `0` | 0.0 mm，单位 0.1 mm |
| `water_lag_cap_threshold` | 水位滞后电容阈值 | `15000` | 15.000 pF，按 x1000 |
| `water_level_hysteresis_time_s` | 水位滞后时间 | `0` | 0 s，范围 0~3600 s；当前为预留参数，不参与水位算法 |

## 罐底与罐高修正

| 字段 | 菜单/含义 | 原始默认值 | 人读值/单位 |
| --- | --- | --- | --- |
| `bottom_detect_mode` | 罐底检测模式 | `0` | `0=扭力`，`1=陀螺仪角度`；异常值运行期归零 |
| `bottom_angle_threshold` | 探底角度阈值 | `12` | 原始值 |
| `bottom_weight_threshold` | 探底扭力阈值 | `500` | 原始值 |
| `refreshTankHeightFlag` | 更新罐高标志 | `0` | 不自动刷新 |
| `maxTankHeightDeviation` | 实测罐高最大偏差 | `1000` | 100.0 mm，单位 0.1 mm |
| `initialTankHeight` | 初始罐高 | `0` | 0.0 mm，单位 0.1 mm |
| `currentTankHeight` | 当前罐高 | `0` | 0.0 mm，单位 0.1 mm |
| `bottom_encoder_correction_enable` | 探底后编码器修正 | `0` | 禁用 |
| `bottom_encoder_correction_tank_height` | 探底修正罐高 | `0` | 0 表示沿用液位罐高 |

## 密度和温度修正

| 字段 | 菜单/含义 | 原始默认值 | 说明 |
| --- | --- | --- | --- |
| `densityCorrection` | 密度修正 | `100000` | 显示修正量为 0.00 kg/m3；实际修正量 `(raw - 100000) / 100` |
| `temperatureCorrection` | 温度修正 | `1000` | 显示修正量为 0.0 ℃；实际修正量 `(raw - 1000) / 10` |

## 综合测量和分布测

| 字段 | 菜单/含义 | 原始默认值 | 人读值/单位 |
| --- | --- | --- | --- |
| `requireBottomMeasurement` | 是否测罐底 | `0` | 不测 |
| `requireWaterMeasurement` | 是否测水位 | `0` | 不测 |
| `requireSinglePointDensity` | 是否测单点密度 | `0` | 不测 |
| `spreadMeasurementOrder` | 分布测顺序 | `0` | 默认顺序 |
| `spreadMeasurementMode` | 分布测模式 | `0` | 默认模式 |
| `spreadMeasurementCount` | 分布测点数 | `5` | 5 点 |
| `spreadMeasurementDistance` | 分布点间距 | `10000` | 1000.0 mm，单位 0.1 mm |
| `spreadTopLimit` | 最高点距液面 | `1000` | 100.0 mm，单位 0.1 mm |
| `spreadBottomLimit` | 最低点距罐底 | `3000` | 300.0 mm，单位 0.1 mm |
| `spreadPointHoverTime` | 分布点悬停 | `10` | 10 s |
| `intervalMeasurementTopLimit` | 区间测量上限 | `0` | 0.0 mm，单位 0.1 mm |
| `intervalMeasurementBottomLimit` | 区间测量下限 | `0` | 0.0 mm，单位 0.1 mm |

## Wartsila 密度测量

| 字段 | 菜单/含义 | 原始默认值 | 说明 |
| --- | --- | --- | --- |
| `wartsila_upper_density_limit` | 最高密度点 | `38000` | CPU3 菜单单位标为 mm |
| `wartsila_lower_density_limit` | 最低密度点 | `500` | CPU3 菜单单位标为 mm |
| `wartsila_density_interval` | 密度点间距 | `1000` | CPU3 菜单单位标为 mm |
| `wartsila_max_height_above_surface` | 最高点液面距 | `200` | CPU3 菜单单位标为 mm |
| `wartsila_bottom_detect_interval` | 瓦锡兰探底间隔 | `0` | 0 不探底，N 表示每 N 次测量探底一次 |

## SI Profile 参数

| 字段 | 菜单/含义 | 原始默认值 | 人读值/单位 |
| --- | --- | --- | --- |
| `si_profile_first_point` | SI 首点 | `5000` | 500.0 mm，单位 0.1 mm |
| `si_profile_increment` | SI 步距 | `10000` | 1000.0 mm，单位 0.1 mm |
| `si_profile_dwell_time` | SI 停留 | `10` | 10 s |
| `si_profile_bottom_detect_interval` | SI 探底频次 | `1` | 1 次；1 表示每轮 profile 探底 |

## 继电器报警输出

四路继电器 `relayAlarm[0..3]` 出厂默认值完全一致。

| 字段 | 菜单/含义 | 出厂默认值 | 人读值/说明 |
| --- | --- | --- | --- |
| `operating_mode` | 工作模式 | `0` | 禁用 |
| `digital_source` | 输出报警位 | `0` | 无 |
| `contact_type` | 接点 | `0` | 常开 |
| `alarm_mode` | 报警模式 | `0` | 关 |
| `error_value` | 无效值 | `0` | 无报警 |
| `alarm_source` | 报警取值源 | `0` | 储罐液位 |
| `HH_alarm_value` | 高高值 | `0.0f` | IEEE754 原始位 |
| `H_alarm_value` | 高值 | `0.0f` | IEEE754 原始位 |
| `L_alarm_value` | 低值 | `0.0f` | IEEE754 原始位 |
| `LL_alarm_value` | 低低值 | `0.0f` | IEEE754 原始位 |
| `alarm_hysteresis` | 滞回 | `0.0f` | IEEE754 原始位 |
| `damping_factor` | 阻值/阻尼 | `0` | 原始值 |
| `clear_alarm` | 清报警 | `0` | 不清报警 |

## 4-20mA 输出

| 字段 | 菜单/含义 | 原始默认值 | 人读值/单位 |
| --- | --- | --- | --- |
| `ao_output.work_mode` | AO工作模式 | `0` | 0禁用、1为4-20mA输出、2为HART从站+输出；禁用时固定输出3.40mA |
| `ao_output.current_mode` | AO电流模式 | `0` | 0为NE、1为US、2为普通、3为固定电流 |
| `ao_output.output_source` | AO输出源 | `0` | 0储罐液位、1传感器位置、2水位；单位均为mm |
| `ao_output.current_correction_mA_x1000` | AO电流修正 | `0` | 0.000mA，单位0.001mA；原始范围-1000~+1000，对应-1.000~+1.000mA；复用原AO SIL/WHG预留槽 |
| `ao_output.fixed_current_mA_x100` | AO固定电流 | `400` | 4.00mA，单位0.01mA；允许范围4.00~22.50mA |
| `ao_output.range_0_01mm` | AO 0%对应值 | `0` | 0.0mm，单位0.1mm；对应4mA标称点 |
| `ao_output.range_100_01mm` | AO 100%对应值 | 当前源上限 | 储罐液位/传感器位置默认罐高；水位默认水罐高度，水罐高度为0时回退罐高 |
| `ao_output.damping_x10_s` | AO阻尼系数 | `0` | 0.0s，单位0.1s；允许范围0~999.9s，0表示关闭 |
| `ao_output.fault_mode` | AO故障动作 | `0` | 0输出配置的故障电流、1保持上次有效过程电流；保持动作无历史时回退初始电流 |
| `ao_output.fault_current_mA_x100` | AO故障电流 | `2200` | 22.00mA，单位0.01mA；允许范围3.40~22.60mA，仅在真实设备故障且故障动作为“故障电流”时输出 |
| `ao_output.error_level` | AO隐藏预留 | `0` | 原错误等级槽位固定为0，不显示、不允许配置 |
| `ao_output.power_on_current_mA_x100` | AO初始电流 | `400` | 4.00mA，单位0.01mA；允许范围3.40~22.60mA；上电后首次取得有效过程目标前，以及故障保持无历史时使用 |
| `ao_output.simulation_current_mA_x100` | AO仿真电流 | `1200` | 12.00mA，单位0.01mA；允许范围3.40~23.00mA |

`AO输出仿真`不属于`DeviceParameters`，位于CRC后的独立保持寄存器，默认0=关且不持久化。AO当前实际显示5组17项：12项可见持久化配置、仿真开关，以及AO输出状态、AO输入值、AO输入百分比和AO输出电流4项只读运行状态；原错误等级槽位和DAC回读继续隐藏。基础AO电流配置仍为x100，电流修正为x1000；AO输出电流复用运行态`last_sent_mA_x1000`，以三位小数显示最近一次成功下发给AD5421的修正后电流命令值，不是DAC回读或物理环路实测值。12项可见持久化配置始终可预配置，当前模式不使用时仅暂不参与输出；非持久化仿真开关仍仅在输出已启用时可操作，工作模式切到禁用时强制清零。

## 指令和标定参数

| 字段 | 菜单/含义 | 原始默认值 | 人读值/单位 |
| --- | --- | --- | --- |
| `calibrateOilLevel` | 标定液位值 | `0` | 0.0 mm，单位 0.1 mm |
| `calibrateWaterLevel` | 标定水位值 | `0` | 0.0 mm，单位 0.1 mm |
| `calibrateTankHeight` | 标定罐高值 | `0` | 0.0 mm，单位 0.1 mm |
| `singlePointMeasurementPosition` | 单点测量位置 | `0` | 0.0 mm，单位 0.1 mm |
| `singlePointMonitoringPosition` | 单点监测位置 | `0` | 0.0 mm，单位 0.1 mm |
| `densityDistributionOilLevel` | 电机运行位置 | `0` | 0.0 mm，单位 0.1 mm |
| `motorCommandDistance` | 电机上行距离 | `0` | 0.0 mm，单位 0.1 mm |
| `lastOilCorrectionLevel` | 上次液位修正液位 | `0` | 0.0 mm，单位 0.1 mm |
| `tankGasPhaseTemperature` | 气相温度 | `0` | 0.0 ℃，单位 0.1 ℃ |
| `tapeExpansionCoefficient` | 尺带伸缩率 | `0` | 菜单小数位 6 |
| `tapeCalibrationTemperature` | 标定尺带温度 | `0` | 0.0 ℃，单位 0.1 ℃ |

## 元信息和校验字段

| 字段 | 出厂默认值 | 说明 |
| --- | --- | --- |
| `param_version` | `DEVICE_PARAM_VERSION` | 当前源码为 3；密度倍率迁移使用 `protocolVersion < 13` 作为一次性标记，SI Profile 参数补默认使用 `protocolVersion < 14` 作为标记，协议24及更早版本升级时将水位滞后时间预留槽归零 |
| `struct_size` | `sizeof(DeviceParameters)` | 运行时写入结构体大小 |
| `magic` | `DEVICE_PARAM_MAGIC` | `0x4C54444D`，即 `LTDM` |
| `crc` | 保存时计算 | 恢复出厂函数先置 0，`save_device_params()` 再更新 CRC |

## 注意事项

- 恢复出厂会先清零整个`DeviceParameters`，再写入上述AO默认值。0%和100%对应值有效范围为0到所选源上限，两值禁止相等但允许反向；用户写入非法组合时严格拒绝并保留原有效配置，不使用恢复默认掩盖写入错误。
- 普通、NE和US模式中，储罐液位与水位只在匹配跟随状态且样本有效时更新过程电流；传感器位置在当前记步源就绪后不受命令门禁限制并持续跟随。首次有效过程目标成功写入AD5421前输出初始电流；已有成功过程目标后，命令切换、重新搜索或样本暂时无效进入保持状态，不回退初始电流。
- 真实设备故障严格定义为`device_state == STATE_ERROR`且错误码既不是`NO_ERROR`也不是`STATE_SWITCH`，优先级高于仿真。故障动作只允许输出配置的故障电流或保持上次有效过程电流；上次有效值仅在正常过程目标成功写入AD5421后更新，同时缓存该轮输入值和比例。禁用、输出源、电流模式或量程端点变化时清除缓存；传感器位置源的罐高或记步方式变化也清除缓存。
- 保持期间冻结一阶阻尼状态，恢复有效过程输入后从保持值继续计算。缓存只存在于CPU2 RAM，不跨掉电；AD5421写失败不得更新缓存。
- `softwareVersion`和`protocolVersion`取决于当前编译源码。当前工作区目标为共享协议35，首个正式CPU2/CPU3版本组合待版本提交时确定；最近已记录的正式组合为CPU2 `V1.40.0.0` / CPU3 `V1.40.0.0`、共享协议34。
- 2026-07-06 当前源码为协议版本 14，新增 SI Profile 参数默认值并通过旧协议标记或运行期归一化补齐；`DEVICE_PARAM_VERSION` 和 `DeviceParameters` 结构大小保持不变。
- 2026-07-08 CPU2 `V1.21.3.0` 保持协议版本 14 和参数存储版本 3；`oilLevelHysteresisTime` 仅作为方法 0/1 跟随变化确认时间，速度闭环稳定等待改为固定 1000 ms。
- 2026-07-11 CPU2 已更新到 `V1.22.0.0`；共享协议仍为 14，`DEVICE_PARAM_VERSION` 仍为 3，恢复出厂默认值和 `DeviceParameters` 布局未因 V1.21.4.0～V1.22.0.0 改变。
- 2026-07-12 共享协议升至 15，用于同步故障码责任域和编号重排；`DEVICE_PARAM_VERSION` 仍为 3，`DeviceParameters` 结构布局、字段默认值和 FRAM 校验范围均未变化，升级不会因此恢复出厂参数。
- 2026-07-13 CPU2 更新到 `V1.24.0.0`，新增 `SAFE_SENSOR=14` 和设备侧安全传感器协议栈；该值复用既有 `sensorType` 存储位置，`DEVICE_PARAM_VERSION`、结构大小、默认值和 CRC 范围不变。降级到不识别该枚举值的旧固件前，应先恢复旧固件支持的传感器类型。
- 2026-07-14 共享协议正式升至 17，按二代计量仪责任域重新分类、删减并重编号故障码；`DEVICE_PARAM_VERSION` 仍为 3，`DeviceParameters` 结构、默认值和 CRC 范围不变，从 V1.24.0.0 升级到 V1.25.0.0 不会清除现场参数。
- 2026-07-15 协议18正式追加SI Profile阶段、周期计数和有效点进度；这些字段属于共享运行态，不进入 `DeviceParameters`，CPU2 `DEVICE_PARAM_VERSION` 仍为3，从V1.25.0.0升级到V1.26.0.0不会因此清参。
- 2026-07-15 开发中的协议19仅拆分共享故障码解释；`DeviceParameters`结构、默认值、大小、元信息和CRC范围均不变。协议19未形成独立正式版本组合，相关能力随协议21发布。
- 2026-07-15 开发中的协议20将原连续13个AO槽位原位改为`AoOutputConfig`，结构总尺寸、元信息、CRC范围和`DEVICE_PARAM_VERSION=3`仍不变。CPU2按旧协议标记迁移合法的旧使能、液位量程、初始/故障/调试电流，其余新字段补默认值；协议20未单独发布，相关能力随协议21发布，升级不因本次AO重构清除其它现场参数。
- 2026-07-16 协议21在输入寄存器尾部新增单点测量完成代际和固定点监测样本代际，用于CPU3同代快照提交；字段不进入`DeviceParameters`。CPU2 `V1.27.0.0`继续使用`DEVICE_PARAM_VERSION=3`，从V1.26.0.0升级不会因协议21清除其它现场参数。
- 2026-07-16 开发中的协议22只重排32项共享故障编号，不改变`DeviceParameters`、默认值、大小、元信息或CRC范围；`DEVICE_PARAM_VERSION`保持3，不因本次调整清除现场参数。
- 2026-07-16 协议23不新增或移动AO槽位，把`fault_mode`收敛为两种故障动作、`error_level`固定为隐藏预留、`power_on_current_mA_x100`解释为非跟随电流，并把AO运行态来源0解释为非跟随。CPU2启动时迁移协议20~22旧值，`DEVICE_PARAM_VERSION`仍保持3，不清除其它现场参数。
- 2026-07-17 协议24保持AO地址、13个槽位、结构尺寸、元信息和CRC范围不变；输出源1改为传感器位置，原非跟随电流改为初始电流，并新增过程保持运行态。旧FRAM参数通常保留，但升级前后必须人工复核`output_source=1`及0%/100%量程。
- 2026-07-17 开发中的协议24仍不新增或移动AO持久化槽位：输出源1改为传感器位置，`power_on_current_mA_x100`改为初始电流，运行态来源0改为初始并新增来源7保持。`DEVICE_PARAM_VERSION`保持3，结构大小、元信息和CRC范围不变；旧值1升级后按传感器位置解释，现场应复核输出源配置。
- 2026-07-18 协议25将原 `reserved3` 槽位复用为 `water_level_hysteresis_time_s`，范围0~3600 s、默认0 s，当前不参与水位算法。协议24及更早版本升级时强制归零该槽；`DEVICE_PARAM_VERSION`、结构大小、元信息和CRC范围保持不变。
- 2026-07-22 协议26将AO第4个32位槽由`sil_whg_reserved`复用为有符号`current_correction_mA_x100`，默认0、范围-100~100。AO启用时，过程、初始、固定、仿真、故障及保持的基础目标统一叠加一次修正；禁用3.40mA不修正。协议25及更早存储升级时该槽归零，`DEVICE_PARAM_VERSION=3`、结构大小、字段偏移和CRC范围不变。
- 2026-07-22 协议27只把CPU2/CPU3共享Modbus旧紧凑地址替换为固定功能块地址，PDU地址直接作为数组索引；`DeviceParameters`字段、大小、`DEVICE_PARAM_VERSION=3`、magic、CRC范围及FRAM A/B槽格式均不改变。合法旧参数镜像不会仅因地址重排被清除；只有原有参数版本、结构大小、magic、CRC或A/B槽有效性校验失败时，才按既有逻辑回退另一槽或恢复出厂默认值。
- 2026-07-25 协议28增加的命令参数pending/active快照、字段代次和CPU3逐字段ACK确认位均只驻留RAM；共享字段地址、`DeviceParameters`结构、`DEVICE_PARAM_VERSION=3`、CRC范围及FRAM A/B槽格式不变。
- 2026-07-25 协议29只调整故障码数值解释和密度有效上限；不新增、删除或移动持久参数字段，`DeviceParameters`结构、`DEVICE_PARAM_VERSION=3`、CRC范围及FRAM A/B槽格式不变。
- 2026-07-28 协议30只新增23-1～23-6共享故障码；`DeviceParameters`结构、`DEVICE_PARAM_VERSION=3`、CRC范围及参数FRAM A/B槽格式不变。编码器独立位置记录只写V2并兼容读取V1，不因本轮升级清除设备参数。
- 2026-07-29 协议31复用共享调试输入寄存器`0x0116~0x0117`发布Newhall扭力模块温度；该运行态不进入`DeviceParameters`，参数结构、`DEVICE_PARAM_VERSION=3`、CRC范围及参数FRAM A/B槽格式不变。CPU2 `V1.36.1.0`的CH9141K RSSI修复同样不改变参数存储。
- 2026-08-04 CPU2 `V1.36.2.0`在液位标定提交新罐高后归一化既有AO动态端点；不新增参数字段，不改变协议31、`DeviceParameters`结构、`DEVICE_PARAM_VERSION=3`、CRC范围或参数FRAM A/B槽格式。
- 2026-08-10 协议33正式组合CPU2 V1.39.0.0 / CPU3 V1.38.0.0把AO修正槽改为`current_correction_mA_x1000`，默认0、范围-1000~+1000；基础AO配置继续x100，最终目标和最近实发值改为x1000。协议26～32旧值乘10迁移，协议25及更早或未知版本归零；`DEVICE_PARAM_VERSION=3`、结构大小、字段偏移和CRC范围不变。
- 2026-08-14 协议34正式组合CPU2/CPU3 V1.40.0.0新增编码器连续性故障语义，不新增持久参数字段。编码轮周长出厂值仍为`95000`；加载旧参数值0时归一化为该值，FC10写入0被拒绝。`DEVICE_PARAM_VERSION=3`、结构大小、字段偏移、CRC范围和FRAM A/B布局不变。
- 2026-08-18 协议35将同一物理DM4传感器统一为`DM4_SENSOR=14`，V4为普通运行协议，Safe为预留运行协议模式。CPU2加载协议32～34保存的旧`sensorType=15`时只把该字段迁移为14并通过既有FRAM A/B路径写回；其它参数不变。`DEVICE_PARAM_VERSION=3`、`DeviceParameters`结构大小、字段偏移、CRC范围和FRAM A/B布局均不变，不触发整套参数恢复出厂。
- CPU2 源码是出厂默认值的权威来源；CPU3 参数表只用于菜单展示、单位和小数位说明。
