duanxuebin1998/cube/docs/01_协议与寄存器/CPU3外部COM安全快速设备发现协议设计.md

# CPU3 外部 COM `0xF8/0x47` 安全快速设备发现协议设计

更新日期：2026-07-24

## 1. 文档状态与结论

| 项目 | 当前结论 |
| --- | --- |
| 设计版本 | V3 简化版 |
| 实施状态 | 方案已整理，CPU3 固件尚未实现 |
| 适用范围 | CPU3 三路外部 COM 口，不包括 CPU2↔CPU3 UART5 |
| 线上协议 | 保留 V2 已确定的 14 字节组发现、26 字节 UID 逻辑单播和 40 字节统一响应 |
| 设备端状态机 | 每端口一个不可替换的当前发现事务，不保存固定 30 秒历史 Nonce |
| 安全属性 | 完全只读，不写 FRAM，不调用 CPU2，不切换协议、站号或串口参数 |
| 版本影响 | 暂不提升 CPU3 固件版本；不修改 `DEVICE_PROTOCOL_VERSION` |
| 本次范围外 | CPU2、LTDDeviceDebugTool、CPU2↔CPU3 共享协议和真实 RS485 台架实施 |

本方案不需要改动 CPU2、共享参数结构或现有业务命令，功能边界较小；但需要接入三路 UART 的 IDLE 成帧、DMA 发送、错误恢复和主循环调度，因此属于**中等规模改动，串口并发与时序风险中等偏高**，不能按普通的单一功能码解析补丁处理。

### 1.1 改动规模评估

| 维度 | 评估 | 说明 |
| --- | --- | --- |
| 产品功能范围 | 小 | 只新增 CPU3 外部只读管理协议 |
| 固件代码规模 | 中 | 预计新增 2 个纯协议文件，修改约 3 个 CPU3 集成文件 |
| 跨 CPU 影响 | 无 | 不增加 CPU2 命令、寄存器、状态或共享字段 |
| 持久化影响 | 无 | 不修改 FRAM、参数版本、迁移或恢复默认逻辑 |
| 业务协议影响 | 可控 | 在统一分发入口提前消费 `0x47`，不修改 DSM、LTD、LH、SI、Wärtsilä业务语义 |
| 实现风险 | 中等偏高 | 风险集中在 RX DMA 新字节竞态、发送窗口、业务优先级和 UART 恢复 |
| 静态验证工作量 | 中 | 需要纯协议单元测试、状态机测试、CPU3 构建和现有协议回归 |
| 真实台架工作量 | 较大 | 需要多设备、同站号、多串口参数、CPU2 故障和逻辑分析仪验证 |

### 1.2 预计代码落点

| 文件 | 动作 | 主要职责 |
| --- | --- | --- |
| `LTD_DISPLAY_CPU3/Communication/common/protocol_discovery_frame.c` | 新增 | 严格解析、CRC、响应构造、UID匹配、哈希和时隙参数计算 |
| `LTD_DISPLAY_CPU3/Communication/common/protocol_discovery_frame.h` | 新增 | 常量、数据结构、纯协议接口和处理结果枚举 |
| `LTD_DISPLAY_CPU3/Application/app_main.c` | 修改 | 三路事务状态、取消入口、调度、总线空闲复核和仅立即发送DMA入口 |
| `LTD_DISPLAY_CPU3/Application/app_main.h` | 预计修改 | 向IDLE中断暴露只记录完成时刻的轻量入口 |
| `LTD_DISPLAY_CPU3/Core/Src/stm32f4xx_it.c` | 修改 | 在三路外部 UART IDLE 成帧位置记录 `requestCompleteTick` |
| `tools/` 下主机测试 | 本机新增或扩展 | 纯协议、时隙、回绕、状态机和静态副作用检查；按仓库规则不强制纳入 Git |

`LTD_DISPLAY_CPU3/CMakeLists.txt` 当前通过 `GLOB_RECURSE` 自动收录 `Communication/*.c`，正常情况下不需要为新增纯协议模块单独修改构建清单。

以上是实施前预计范围，最终以实际 diff 为准。不得为了实现发现协议顺手重构普通业务发送队列、CPU2 同步通信或所有 UART 状态结构。

## 2. 目标与非目标

### 2.1 目标

1. 在未知设备站号时，用一次组发现请求代替上位机逐站号 `1~247` 扫描。
2. 使用 STM32 UID96 区分相同站号的多台新设备。
3. 使用 Nonce32 绑定请求和响应，避免上位机把残留响应匹配到新一轮发现。
4. 使用确定性时隙降低多设备同时响应造成的碰撞概率。
5. 使用 UID和站号联合匹配的逻辑单播，对已经发现的设备身份进行复核。
6. 发现过程只读取 CPU3 已有身份、版本和当前串口配置，不产生任何配置副作用。
7. 所有非法、非目标或不支持的 `0x47` 帧静默消费，不进入业务协议。

### 2.2 非目标

1. 不实现地址 `0x00` 广播应答。
2. 不保证有限轮次发现绝对完整。
3. 不提供密码学认证、加密、访问控制或抗拒绝服务能力。
4. 不把 CPU2 同步通信改成非阻塞状态机。
5. 不实现设备端重试、发现响应排队或跨时隙迟发。
6. 不修改现有 DSM 地址 `0x00` 兼容行为。
7. 不修改现有 `0x46` 协议切换行为；`0x46/0xFF` 只读当前协议查询是独立的已实现兼容能力，不代替本设计的 `0x47` 多设备快速发现。
8. 不在本任务中修改 CPU2、上位机或共享协议。

## 3. 设计前提

### 3.1 单发现主站

一条 RS485 总线只允许一个发现主站。发现主站必须串行执行发现事务，在当前完整轮次结束前不得启动下一组发现或逻辑单播。

采用该约束后，设备不再需要处理多个发现主站之间的抢占、替换和历史 Nonce 竞争。普通 Modbus/RS485 总线本身通常也是单主站结构。

### 3.2 只读与无副作用

`0x47` 路径只能读取以下信息：

- 当前设备站号。
- 当前 COM 口 `ComProtocolType`。
- 当前 COM 口波特率、数据位、校验和停止位。
- `CPU3_APP_VERSION_U32`。
- STM32 UID96。
- 编译期固定能力位。

`0x47` 路径禁止：

- 调用任何 FRAM 写入或参数写接口。
- 发起任何 CPU2 请求。
- 修改协议、站号、串口配置或运行参数。
- 执行测量、控制、取消、复位或校准命令。
- 使用 `HAL_Delay()` 等阻塞等待。

### 3.3 Nonce边界

Nonce32只用于：

- 上位机把响应绑定到当前请求。
- 参与组发现时隙哈希，使不同轮次获得不同的时隙分布。
- 当前事务内识别重复请求。

Nonce32不是密钥，不证明请求方身份，也不提供防重放或密码学认证能力。

## 4. 协议常量

| 名称 | 值 | 说明 |
| --- | ---: | --- |
| 组地址 | `0xF8` | 请求和响应首字节均固定使用该保留地址 |
| 管理功能码 | `0x47` | 项目自定义发现管理功能码 |
| Magic | `0x4C 0x54 0x44` | ASCII `"LTD"` |
| 发现协议版本 | `0x01` | 首版 |
| 组发现请求操作码 | `0x01` | 所有配置合法的新固件设备均可建立组发现事务 |
| UID逻辑单播请求操作码 | `0x02` | 站号和UID96均匹配时才可建立事务 |
| 组发现响应操作码 | `0x81` | 组发现响应 |
| UID逻辑单播响应操作码 | `0x82` | 逻辑单播响应 |
| 允许的时隙数 | `16`、`32`、`64` | 其它值非法 |

所有多字节整数除CRC外均采用大端。帧尾CRC使用Modbus CRC16，低字节在前、高字节在后。

Modbus CRC16定义为：

- 初值：`0xFFFF`。
- 反射多项式：`0xA001`。
- 按输入字节顺序计算。
- 无最终异或。

## 5. 组发现请求

组发现请求固定为14字节：

```text
[F8][47][4C 54 44][01][01][Nonce32-BE][slotCount][CRC_L][CRC_H]
```

| 偏移 | 长度 | 字段 | 说明 |
| ---: | ---: | --- | --- |
| 0 | 1 | 组地址 | 固定 `0xF8` |
| 1 | 1 | 功能码 | 固定 `0x47` |
| 2 | 3 | Magic | 固定 `"LTD"` |
| 5 | 1 | 版本 | 固定 `0x01` |
| 6 | 1 | 操作码 | 固定 `0x01` |
| 7 | 4 | Nonce32 | 大端 |
| 11 | 1 | `slotCount` | 只能是 `16`、`32` 或 `64` |
| 12 | 2 | CRC16 | 覆盖偏移 `0~11`，低字节在前 |

## 6. UID逻辑单播请求

逻辑单播请求固定为26字节：

```text
[F8][47][4C 54 44][01][02]
[目标站号]
[Nonce32-BE]
[目标UIDw0-BE][目标UIDw1-BE][目标UIDw2-BE]
[CRC_L][CRC_H]
```

| 偏移 | 长度 | 字段 | 说明 |
| ---: | ---: | --- | --- |
| 0 | 1 | 组地址 | 固定 `0xF8` |
| 1 | 1 | 功能码 | 固定 `0x47` |
| 2 | 3 | Magic | 固定 `"LTD"` |
| 5 | 1 | 版本 | 固定 `0x01` |
| 6 | 1 | 操作码 | 固定 `0x02` |
| 7 | 1 | 目标站号 | 范围 `1~247` |
| 8 | 4 | Nonce32 | 大端 |
| 12 | 12 | 目标UID96 | `UIDw0-BE || UIDw1-BE || UIDw2-BE` |
| 24 | 2 | CRC16 | 覆盖偏移 `0~23`，低字节在前 |

只有目标站号和UID96同时匹配本机时，才允许建立逻辑单播事务。

以下情况必须静默消费，且不得占用、替换或取消本机当前发现事务：

- 目标站号不匹配。
- UID96不匹配。
- 地址、Magic、版本、长度、操作码或CRC非法。

## 7. 统一响应

发现响应固定为40字节，首字节始终为 `0xF8`：

| 偏移 | 长度 | 字段 | 说明 |
| ---: | ---: | --- | --- |
| 0 | 1 | 组地址 | 固定 `0xF8` |
| 1 | 1 | 功能码 | 固定 `0x47` |
| 2 | 3 | Magic | 固定 `"LTD"` |
| 5 | 1 | 版本 | 固定 `0x01` |
| 6 | 1 | 响应操作码 | 组发现 `0x81`；逻辑单播 `0x82` |
| 7 | 4 | Nonce32 | 原样返回请求Nonce，大端 |
| 11 | 1 | 实际站号 | 当前 `SlaveAddress`，范围 `1~247` |
| 12 | 1 | 时隙号 | 组发现返回 `0~slotCount-1`；逻辑单播固定 `0xFF` |
| 13 | 1 | 当前协议 | 当前 `ComProtocolType` |
| 14 | 4 | 当前波特率 | 大端 |
| 18 | 1 | 数据位 | V1仅允许返回语义上的 `8` |
| 19 | 1 | 校验 | `0=None`、`1=Even`、`2=Odd` |
| 20 | 1 | 停止位 | `0=1位`、`1=2位` |
| 21 | 4 | CPU3版本 | `CPU3_APP_VERSION_U32`，大端 |
| 25 | 12 | UID96 | `UIDw0-BE || UIDw1-BE || UIDw2-BE` |
| 37 | 1 | 能力位 | 见下表 |
| 38 | 2 | CRC16 | 覆盖偏移 `0~37`，低字节在前 |

### 7.1 `ComProtocolType`

| 值 | 协议 |
| ---: | --- |
| 0 | DSM |
| 1 | Wärtsilä |
| 2 | LTD |
| 3 | LH |
| 4 | 预留 |
| 5 | SI |

线上编码必须显式转换，不能依赖C枚举的底层宽度或未来排列。

### 7.2 能力位

| 位 | 含义 |
| ---: | --- |
| bit0 | 支持16时隙 |
| bit1 | 支持32时隙 |
| bit2 | 支持64时隙 |
| bit3 | 支持UID逻辑单播 |
| bit4 | 支持现有 `0x46` 管理通道（协议切换及 `0xFF` 当前协议只读查询） |
| bit5~7 | 保留，必须为0 |

首版能力值为 `0x1F`。

## 8. 管理层识别与静默消费

统一分发顺序必须为：

1. `0x47` 发现管理层。
2. 现有 `0x46` 管理通道，包括协议切换及 `0xFF` 当前协议只读查询。
3. 当前 DSM、LTD、LH、SI 或 Wärtsilä业务协议。

只要完整接收帧满足 `rx_len >= 2 && rx[1] == 0x47`，就必须由发现管理层消费，不得进入任何业务解析器。该规则覆盖：

- 合法组发现请求。
- 合法UID逻辑单播请求。
- 其他设备的 `0x81/0x82` 响应。
- 地址不是 `0xF8` 的 `0x47` 帧。
- CRC、Magic、版本、长度、操作码或 `slotCount` 非法的 `0x47` 帧。

发现管理层建议返回以下内部分类：

| 内部结果 | 后续动作 |
| --- | --- |
| `NOT_DISCOVERY` | 继续现有 `0x46` 和业务解析 |
| `CONSUMED` | 静默恢复接收，不产生响应 |
| `ELIGIBLE_GROUP_REQUEST` | 由 `app_main.c` 判断配置和端口事务状态 |
| `ELIGIBLE_UID_REQUEST` | 由 `app_main.c` 判断配置和端口事务状态 |

只有严格合法、地址为 `0xF8` 且本机有资格响应的请求，才允许建立新事务。

## 9. UID与组发现时隙

### 9.1 UID字节顺序

```text
UIDw0-BE || UIDw1-BE || UIDw2-BE
```

每个32位UID字按大端展开。

### 9.2 哈希输入

组发现哈希输入固定为17字节：

```text
UID96 || 实际站号 || Nonce32-BE
```

计算：

```text
hash = CRC16_Modbus(hashInput)
slot = hash % slotCount
```

这里的 `hash` 是CRC计算函数返回的16位数值，不对CRC结果再次交换字节。

不同Nonce会重新计算哈希，但仍可能得到相同slot。协议和文档不得声称不同Nonce一定改变时隙。

## 10. 时隙参数

发现协议V1只支持语义上的8数据位。

```text
bitsPerChar =
    1 + 8 + parityBitCount + physicalStopBitCount
```

| 帧格式 | `parityBitCount` | `physicalStopBitCount` | `bitsPerChar` |
| --- | ---: | ---: | ---: |
| 8N1 | 0 | 1 | 10 |
| 8E1 | 1 | 1 | 11 |
| 8O1 | 1 | 1 | 11 |
| 8N2 | 0 | 2 | 11 |

停止位计算必须使用物理数量1或2，不能直接把线上停止位枚举0或1代入。

```text
txMs =
    ceil(40 × bitsPerChar × 1000 / baudRate)

gapMs =
    max(2, ceil(3.5 × bitsPerChar × 1000 / baudRate))

slotMs =
    max(20, txMs + gapMs + 2)

guardMs =
    slotMs
```

`gapMs`最小取2 ms，用于覆盖高波特率下约1.75 ms的Modbus帧间隔，并适配 `HAL_GetTick()` 的毫秒分辨率。

计算必须使用足够宽的无符号中间值，避免先乘法后溢出。任何除数为0或结果不合法的配置均不得响应。

### 10.1 组发现发送窗口

```text
windowStart =
    requestCompleteTick + guardMs + slot × slotMs

latestStart =
    windowStart + slotMs - txMs - gapMs

roundEnd =
    requestCompleteTick + guardMs + slotCount × slotMs
```

### 10.2 逻辑单播发送窗口

逻辑单播使用虚拟slot 0，但响应字段仍返回 `0xFF`：

```text
windowStart =
    requestCompleteTick + guardMs

latestStart =
    windowStart + slotMs - txMs - gapMs

roundEnd =
    requestCompleteTick + guardMs + slotMs
```

### 10.3 调度规则

- `now < windowStart`：继续等待。
- `now > latestStart`：本轮静默放弃。
- 第一次进入合法窗口时，只执行一次总线空闲复核和DMA启动尝试。
- 总线不空闲、业务发送优先、DMA启动失败或任一安全条件不满足：立即静默放弃。
- 不在窗口内反复等待，不排队，不重试，不迟发到下一设备时隙。

Tick比较必须支持32位回绕，例如：

```text
reached(now, deadline) = (int32_t)(now - deadline) >= 0
after(now, deadline)   = (int32_t)(now - deadline) > 0
```

所有单轮时间必须保持远小于 `2^31 ms`。

### 10.4 4800 8N1示例

```text
txMs   = ceil(40 × 10 × 1000 / 4800) = 84 ms
gapMs  = ceil(3.5 × 10 × 1000 / 4800) = 8 ms
slotMs = 84 + 8 + 2 = 94 ms
guardMs = 94 ms
```

16时隙一轮最长等待约：

```text
94 + 16 × 94 = 1598 ms
```

两轮约3.20秒，与“4800 8N1下两轮16时隙约3秒”的目标基本一致。该值是协议计算值，不是多设备现场实测结论。

## 11. V3简化事务状态机

### 11.1 每端口状态

三路外部COM口分别保存一个事务，互不影响。建议状态至少包含：

```text
reservationActive
responseArmed
discoveryTxActive
opcode
nonce
slot
slotCount
gapMs
windowStart
latestStart
roundEnd
response[40]
```

含义：

- `reservationActive`：当前端口处于一个发现轮次内。
- `responseArmed`：本机仍有资格在当前窗口尝试发送。
- `discoveryTxActive`：发现响应DMA已经启动，用于发送完成和错误恢复区分。

### 11.2 建立事务

只有同时满足以下条件才建立事务：

1. 发现管理层返回严格合法且本机有资格响应的请求。
2. 当前端口没有尚未到 `roundEnd` 的事务保留。
3. `SlaveAddress` 在 `1~247`。
4. 当前配置为语义上的8数据位。
5. 波特率、校验、停止位和协议值均合法。
6. 时隙和窗口计算成功。
7. 响应帧构造成功。

### 11.3 当前事务不可替换

`reservationActive`期间：

- 相同操作码和Nonce的重复请求只消费，不重新排期。
- 不同Nonce或不同操作码的请求也只消费，不替换当前事务。
- 原有 `windowStart`、`latestStart` 和响应内容保持不变。
- 其他设备的发现响应只更新总线活动时间。
- UID或站号不匹配的逻辑单播不改变任何事务状态。

该规则替代V2的“新合法请求替换旧pending”。发现主站必须等待完整 `roundEnd` 后才能开始下一事务。

### 11.4 不保存固定30秒历史

V3不保存30秒Nonce历史表。防重复边界改为：

- 当前事务从接收请求一直保留到 `roundEnd`。
- 本机成功发送、窗口超时、总线忙或取消响应后，均只清除 `responseArmed`，事务保留继续存在。
- 在同一轮结束前，旧请求不能重新激活响应。
- 到达 `roundEnd` 后释放事务；同一Nonce此后理论上可被再次接受。

上位机必须保证每轮发现、每台设备复核和每次重试均使用新Nonce。

该简化不降低只读和无配置副作用边界，但不提供“30秒内任意历史Nonce绝不再次应答”的承诺。

## 12. 请求完成时刻

`requestCompleteTick`必须来自各外部UART的IDLE成帧位置，而不是主循环开始解析帧的时刻。

ISR职责仅限：

1. 识别已经形成IDLE帧。
2. 停止RX DMA并计算长度。
3. 在长度大于0时记录 `HAL_GetTick()`。
4. 写入长度并设置 `rx_ready`。

ISR禁止：

- 解析Magic、CRC或操作码。
- 计算时隙。
- 构造响应。
- 打印日志。
- 切换RS485发送方向。
- 启动发现发送。

时间戳必须在设置 `rx_ready` 之前写入，使主循环观察到ready时可以取得同一帧的完成时刻。

## 13. 总线空闲判定

发现响应尝试发送前必须同时满足：

1. 本端口 `g_tx_busy == 0`。
2. 本端口普通业务pending长度为0。
3. 本端口 `rx_ready == 0`。
4. 没有尚未处理的业务候选帧。
5. RX DMA处于预期接收状态。
6. RX DMA剩余计数等于完整缓冲区容量，没有尚未形成IDLE帧的新字节。
7. UART `RXNE`未置位。
8. 没有UART错误、DMA收满或恢复事件pending。
9. 没有单端口或全部端口重初始化pending。
10. 没有串口参数重配置或协议切换pending。
11. 距离本端口最近一次RX/TX活动至少 `gapMs`。
12. 当前时刻仍在本机合法启动窗口内。

`lastBusActivityTick`至少在以下位置更新：

- 外部UART收到非空IDLE帧。
- 外部UART最后一个停止位发送完成。

新字节已经进入RX DMA但尚未形成IDLE时，DMA计数变化直接阻止发现发送，不依赖 `lastBusActivityTick`。

## 14. 仅立即发送入口与原子复核

发现响应禁止调用普通的 `uart_try_send_or_queue()`，也不得写入普通pending缓冲区。

新增的发现发送入口只有两个结果：

- 当前窗口内立即成功启动DMA。
- 立即失败并静默放弃。

### 14.1 原子占用步骤

建议流程：

1. 保存当前中断屏蔽状态并进入短临界区。
2. 重新检查busy、普通pending、ready、恢复、重配置和协议切换状态。
3. 读取RX DMA剩余计数并确认等于缓冲区容量，同时检查 `RXNE`。
4. 设置本端口 `g_tx_busy` 和 `discoveryTxActive`。
5. 关闭IDLE中断并停止RX DMA。
6. 停止后再次检查DMA计数变化、`RXNE`和UART错误标志。
7. 如发现新字节或错误，撤销发送占用并恢复RX DMA。
8. 无新字节时切换RS485发送方向并启动40字节DMA。
9. 恢复进入临界区前的中断屏蔽状态。

关键点：**只关闭CPU中断不足以冻结RX DMA。** DMA在中断关闭期间仍可能接收最后一个字节，因此停止RX DMA后必须再次复核DMA计数和 `RXNE`。

### 14.2 DMA启动失败

DMA启动失败时必须：

- 清除 `g_tx_busy` 和 `discoveryTxActive`。
- 清除 `responseArmed`。
- 切回接收方向。
- 清理必要的UART状态。
- 重新启动RX DMA；失败时进入现有恢复队列。
- 不写普通pending，不在本轮重试。

发现发送成功后复用现有 `g_tx_busy` 和发送完成回调。发现响应不得影响 `0x46` 的 `PENDING_TX→PENDING_APPLY` 语义。

## 15. 业务优先与取消规则

发现响应优先级低于正常业务应答。

### 15.1 集中取消

以下事件必须清除对应端口的 `responseArmed`：

- 发给本机站号的非 `0x47` 业务候选帧。
- 当前DSM协议下地址为 `0x00` 的业务候选帧。
- 现有 `0x46` 协议切换候选或已接受请求。
- UART错误。
- RX DMA收满。
- 端口完整恢复。
- 单端口或全部端口重初始化。
- 串口参数重配置。
- 协议切换应用。
- 发现窗口超时。
- 总线不空闲。
- 发现DMA启动失败。

为保证业务绝对优先，发给本机的非 `0x47` 业务候选帧可以在业务CRC最终确认前撤销发现响应。这样可能因噪声少答一次发现，但不会使发现响应与正常业务抢总线。

取消只清除 `responseArmed`；`reservationActive`继续保留到 `roundEnd`，防止旧请求在同一轮内重新激活。

### 15.2 不得取消的输入

以下输入只消费或更新总线活动，不取消本机当前发现事务：

- 其他设备的 `0x81/0x82` 响应。
- 地址不是 `0xF8` 的 `0x47` 帧。
- CRC、Magic、版本、长度、操作码或 `slotCount` 非法的 `0x47` 帧。
- 站号或UID不匹配的逻辑单播。
- 当前事务期间收到的另一个合法发现请求。

## 16. 配置合法性

发现协议V1只支持：

- `SlaveAddress`：`1~247`。
- 数据位：语义上的8位。
- 波特率：`1200`、`2400`、`4800`、`9600`、`19200`、`38400`、`57600`、`115200`。
- 校验：None、Even、Odd。
- 停止位：1位或2位。
- 帧格式：8N1、8E1、8O1、8N2及由上述合法字段组成的其它8数据位组合。

以下情况必须消费 `0x47` 但不建立事务：

- `SlaveAddress` 不在 `1~247`。
- `cfg->databits == 9`。
- 波特率不在白名单。
- 校验或停止位枚举非法。
- `ComProtocolType` 超出已定义线上编码范围。

9数据位支持留作后续独立任务。

## 17. 纯协议模块边界

`protocol_discovery_frame.c/.h`负责：

- 判断是否为 `0x47` 管理帧。
- 严格解析两类请求。
- 校验长度、地址、功能码、Magic、版本、操作码、`slotCount`和CRC。
- UID和站号联合匹配。
- 计算组发现哈希与slot。
- 计算 `txMs`、`gapMs`和 `slotMs`。
- 构造40字节响应。

模块输入由调用方显式传入：

- 本机站号。
- UID96。
- CPU3版本。
- 当前端口配置。
- 请求字节和长度。

纯协议模块不得直接：

- 调用 `HAL_GetTick()`、`HAL_GetUIDw0/1/2()`或UART HAL。
- 读取或写入FRAM。
- 调用CPU2接口。
- 调用参数写接口。
- 访问普通发送队列。
- 执行阻塞延时。

读取UID、版本和当前端口配置由 `app_main.c` 完成，再作为普通值传给纯协议模块。

## 18. 上位机必须遵守的事务约束

虽然本任务只实现设备端，但以下主站行为是V3成立的协议前提：

1. 一条RS485总线只能有一个发现主站。
2. 每轮使用新的Nonce。
3. 发送组发现后，等待 `guardMs + slotCount × slotMs` 完整结束。
4. 不得在组发现轮次中途对已收到的UID立即发起逻辑单播。
5. 逻辑单播也使用新的Nonce，并等待 `guardMs + slotMs`。
6. 按UID96聚合多轮结果，站号只作为当前设备属性。
7. 使用多个独立Nonce执行多轮发现。
8. 首轮可使用16时隙，碰撞较多时扩大到32或64时隙。
9. 对已发现UID执行站号+UID联合逻辑单播复核。
10. 不得把一轮无新增响应解释为“总线上绝对没有其它设备”。

快速发现只替代站号 `1~247` 扫描。上位机仍需按产品范围遍历可能的波特率、校验和停止位组合。

## 19. 兼容性与安全边界

### 19.1 旧固件

- 新请求和新响应都以 `0xF8` 开头，避免同站号旧DSM设备把新设备响应当成本机未知功能请求。
- 当前CPU3各外部业务协议通常会先检查站号，`0xF8`不属于合法设备站号。
- 仍不能仅凭当前源码断言所有历史固件、所有现场分支都一定忽略 `0xF8`。
- 新旧固件混合行为必须通过真实RS485台架确认。
- 旧固件不支持 `0x47` 时，快速发现只能找到新固件；旧设备后台兼容扫描属于上位机后续任务。

### 19.2 碰撞与完整性

- 同一slot内的多个响应仍会碰撞。
- 不同Nonce可能仍落入相同slot。
- 16时隙只适合低延迟首轮，不代表完整发现。
- 多轮、不同Nonce、扩大slotCount和UID逻辑单播共同提高发现成功率。
- 任何有限轮次都不能从协议上绝对证明不存在尚未成功响应的设备。

### 19.3 信息与访问安全

- UID不是密钥。
- 响应不得包含设备密钥、认证数据或其它敏感配置。
- 协议会公开UID、固件版本和当前串口配置。
- 任意能够接入RS485链路的节点都可以发送请求或使用新Nonce制造发现流量。
- CRC16只提供传输差错检测，不提供身份认证或防篡改能力。
- 如果现场总线不可信，应通过物理隔离、网关访问控制或后续认证协议解决，而不是依赖Nonce。

## 20. CPU2阻塞与best-effort口径

当前CPU3主循环中的CPU2同步请求单次最长可能等待约1秒。发现协议不改变该结构。

因此：

- 主循环在窗口前恢复调度时，可以正常尝试发送。
- 主循环恢复时已经超过 `latestStart`，必须静默放弃，禁止迟发。
- 在115200等高波特率下，20 ms量级slot更容易被CPU2长事务错过。
- 连续CPU2超时可能使发现长期不可用。
- 本任务只记录结果，不扩大为CPU2通信非阻塞化或主循环全面重构。
- 上位机使用新Nonce重试。

主机状态机测试可以模拟主循环停顿1秒并证明“不迟发”；但真实CPU2正常、超时和连续故障对RS485发现成功率的影响，仍需硬件联调。

## 21. Golden Frame

以下示例固定使用：

| 字段 | 示例值 |
| --- | --- |
| 实际站号 | `1` |
| UIDw0 | `0x00112233` |
| UIDw1 | `0x44556677` |
| UIDw2 | `0x8899AABB` |
| 当前协议 | LTD，`0x02` |
| 当前波特率 | 4800，`0x000012C0` |
| 帧格式 | 8N1 |
| 示例CPU3版本值 | `0x01200000`，即V1.32.0.0 |
| 能力位 | `0x1F` |

### 21.1 组发现

Nonce为 `0x12345678`、16时隙：

```text
请求：
F8 47 4C 54 44 01 01 12 34 56 78 10 E4 7C
```

哈希输入：

```text
00 11 22 33 44 55 66 77 88 99 AA BB 01 12 34 56 78
```

哈希CRC数值为 `0x43DA`：

```text
slot = 0x43DA % 16 = 10
```

组发现响应：

```text
F8 47 4C 54 44 01 81 12 34 56 78 01 0A 02
00 00 12 C0 08 00 00 01 20 00 00
00 11 22 33 44 55 66 77 88 99 AA BB
1F 0D 6F
```

### 21.2 UID逻辑单播

Nonce为 `0x89ABCDEF`：

```text
请求：
F8 47 4C 54 44 01 02 01 89 AB CD EF
00 11 22 33 44 55 66 77 88 99 AA BB
0F 00
```

逻辑单播响应：

```text
F8 47 4C 54 44 01 82 89 AB CD EF 01 FF 02
00 00 12 C0 08 00 00 01 20 00 00
00 11 22 33 44 55 66 77 88 99 AA BB
1F 8A 1C
```

Golden Frame测试应向响应构造函数传入固定示例版本值，不直接依赖测试时源码中的实际版本宏；这样未来正常升版不会使协议构造测试无意义地失效。

## 22. 静态与主机测试矩阵

| 编号 | 测试 | 通过标准 |
| --- | --- | --- |
| P01 | 合法16/32/64时隙组发现 | 三类请求均被接受，slot在合法范围 |
| P02 | 合法UID逻辑单播 | 站号和UID均匹配时建立事务 |
| P03 | 站号不匹配 | 静默消费，不建立或修改事务 |
| P04 | UID不匹配 | 静默消费，不建立或修改事务 |
| P05 | 请求Golden Frame | 请求CRC和字节序与第21章一致 |
| P06 | 响应Golden Frame | 40字节长度、字段和CRC与第21章一致 |
| P07 | 错误CRC | 静默消费 |
| P08 | 错误Magic | 静默消费 |
| P09 | 错误版本 | 静默消费 |
| P10 | 错误长度 | 静默消费 |
| P11 | 错误操作码 | 静默消费 |
| P12 | 错误slotCount | 静默消费 |
| P13 | 地址不是F8的0x47 | 静默消费，不进入业务协议 |
| P14 | 其他设备0x81/0x82响应 | 静默消费，只形成总线活动 |
| H01 | 确定性时隙 | 相同UID、站号、Nonce和slotCount结果固定 |
| H02 | 不同Nonce | 能产生不同分布，同时允许选取两个Nonce得到相同slot |
| H03 | UID字节序 | 按三个32位字各自大端参与哈希和响应 |
| T01 | 8N1/8E1/8O1/8N2 | `bitsPerChar`分别为10/11/11/11 |
| T02 | 所有合法波特率 | `txMs + gapMs <= slotMs` |
| T03 | 保护时隙 | slot 0不早于请求完成后的一个 `slotMs` |
| T04 | 逻辑单播虚拟slot 0 | 响应字段为FF，调度使用首个保护后窗口 |
| T05 | HAL Tick回绕 | 回绕前后的窗口判断正确 |
| S01 | 相同请求重复 | 不重新排期，不改变原响应 |
| S02 | 不同Nonce到达 | 当前事务不可替换 |
| S03 | 不同操作码到达 | 当前事务不可替换 |
| S04 | roundEnd前重复 | 已发送、放弃或取消后均不能重新激活 |
| S05 | roundEnd后新请求 | 新Nonce可建立新事务 |
| S06 | 三个COM口 | 三路事务互不影响 |
| C01 | 本机业务候选帧 | 清除 `responseArmed` |
| C02 | DSM地址0业务帧 | 清除 `responseArmed` |
| C03 | 0x46请求 | 清除发现响应资格且0x46行为不变 |
| C04 | UART错误和DMA收满 | 清除响应资格并进入现有恢复 |
| C05 | 重配置和协议切换应用 | 清除响应资格 |
| D01 | 普通业务busy/pending | 发现不发送且不进入普通pending |
| D02 | rx_ready或未处理帧 | 发现不发送 |
| D03 | RX DMA已有新字节 | 发现不发送 |
| D04 | 距最近活动不足gapMs | 发现不发送 |
| D05 | 错过latestStart | 静默放弃且后续不迟发 |
| D06 | DMA启动失败 | 恢复RX，普通pending保持不变 |
| I01 | requestCompleteTick来源 | 证明使用IDLE ISR记录值，而非主循环处理时刻 |
| I02 | CPU2模拟阻塞1秒 | 超过窗口后不迟发 |
| R01 | 0x46回归 | 现有ACK、延迟应用和失败恢复不变 |
| R02 | 五类业务协议回归 | DSM、LTD、LH、SI、Wärtsilä正常通信不进入0x47路径 |
| N01 | 只读静态审计 | 0x47调用图不包含FRAM写、CPU2调用、配置写或控制命令 |
| B01 | CPU3 clean-first构建 | 固件构建成功且无新增错误 |

V2中的以下测试由V3语义替换：

| V2测试 | V3替代测试 |
| --- | --- |
| 固定30秒去重有效期 | 当前事务一直保留到 `roundEnd` |
| 新Nonce替换旧pending | 当前事务期间任何新发现请求均不得替换 |
| 组发现与复核相同Nonce互不抑制 | 主站事务串行化，每次请求使用新Nonce |

## 23. 真实RS485台架矩阵

以下验证不能由CPU3构建或主机测试替代：

- 1、2、4、8台设备。
- 两台新设备使用相同站号。
- 同站号的新旧固件混合。
- 人为选择发生首轮slot冲突的UID、站号和Nonce组合。
- 使用新Nonce以及32/64时隙恢复发现。
- 2400、4800、9600、115200。
- 8N1、8E1、8O1、8N2。
- CPU2正常响应、单次约1秒超时和连续故障。
- UART错误、DMA收满和恢复过程。
- 发现前后正常业务通信。
- 不同USB-RS485适配器、本地回显和线路干扰。
- 逻辑分析仪确认设备没有早于 `windowStart` 或晚于 `latestStart` 启动发送。
- 确认发现响应从未进入普通pending队列。
- 确认新旧固件混合时，旧设备没有因 `0xF8/0x47` 返回未知功能异常。

台架报告必须区分：

- 已观察到的设备数量。
- 每轮收到的UID集合。
- 碰撞、CRC错误和超时。
- CPU2状态。
- 实际发送起点与所属窗口。
- 是否经过多轮和逻辑单播复核。

不得把“CPU3构建成功”或“单机串口响应正确”表述为多设备RS485验证完成。

## 24. V2到V3的正式调整

线上帧格式保持不变，只调整设备端事务语义：

| 项目 | V2 | V3 |
| --- | --- | --- |
| 请求和响应格式 | `0xF8/0x47` | 不变 |
| UID逻辑单播 | 站号+UID96 | 不变 |
| 端口pending | 最多一个，新合法请求可替换 | 每端口一个当前事务，轮次内不可替换 |
| Nonce去重 | 操作码+Nonce，固定30秒 | 当前事务内抑制，不保存固定历史 |
| 组发现和复核并发 | 分操作码记录 | 主站严格串行 |
| 逻辑单播调度 | 未完全定义 | 使用保护后的虚拟slot 0 |
| gapMs | 3.5字符向上取整 | 再增加最小2 ms约束 |
| 取消后行为 | pending清除 | 清除响应资格，事务保留到roundEnd |
| 多主站 | 规则复杂但仍可能互相抢占 | 明确不支持多个发现主站 |

V3减少了历史Nonce缓存、请求替换、分操作码去重和交错请求状态，降低了实现与测试复杂度，同时保留V2的线协议、只读边界、业务优先和不迟发原则。

## 25. 完成定义

只有同时满足以下条件，设备端实现才可标记为完成：

1. 纯协议模块和三路应用状态机已经实现。
2. 所有 `0x47` 帧均在业务协议前被管理层消费。
3. 发现响应只能立即发送，不能进入普通pending。
4. IDLE ISR时间戳、总线活动和RX DMA新字节复核已经接入。
5. 集中取消入口覆盖业务、`0x46`、错误、恢复和重配置。
6. 主机纯协议、状态机、Tick回绕和静态副作用测试通过。
7. CPU3 clean-first构建通过。
8. 正式协议文档与最终代码字段、时序和限制一致。
9. 未完成的真实RS485、多设备、旧固件混合和CPU2故障验证明确保留。

## 26. 当前源码参考

| 入口 | 当前作用 |
| --- | --- |
| `LTD_DISPLAY_CPU3/Application/app_main.c` | 普通单帧发送队列、统一协议分发、协议切换状态和CPU2轮询 |
| `LTD_DISPLAY_CPU3/Core/Src/stm32f4xx_it.c` | 三路外部UART的DMA+IDLE成帧 |
| `LTD_DISPLAY_CPU3/Communication/common/protocol_switch_frame.c` | 现有 `0x46` 管理帧解析参考 |
| `LTD_DISPLAY_CPU3/Communication/external/DSM_modbus/DSM_communication.c` | 当前DSM本机站号与地址0兼容入口 |
| `LTD_DISPLAY_CPU3/Application/system_param/cpu3_comm_display_params.c` | 当前三路端口配置和合法波特率 |
| `LTD_DISPLAY_CPU3/Communication/internal/main_board_modbus/cpu2_communicate.c` | CPU2同步通信和最长约1秒等待 |
| `LTD_DISPLAY_CPU3/Application/app_version.h` | `CPU3_APP_VERSION_U32` |
| `LTD_DISPLAY_CPU3/Communication/common/my_crc.c` | 当前Modbus CRC16实现 |
