duanxuebin1998/cube/docs/07_硬件原理图/DM4四代数字驱动V6.0原理图详细分析.md

# DM4 四代数字驱动 V6.0 原理图详细分析

分析日期：2026-08-04；结构与密度章节整理：2026-08-06；扫频判定说明补充：2026-08-07；双 DDS、密度与黏度链路补充：2026-08-10

DM4 V6.0 由电源板、驱动板、采集板和测水连接板组成。四块板共同完成供电与 RS485 通信、振动式密度测量、温度采集、电容式测水、姿态和零点检测。本文按“测量原理—电路实现—可观测信号—风险与验证”的顺序整理四份原理图，便于设计评审、固件对接和后续安全分析使用。

## 1. 文档目的与使用边界

### 1.1 分析范围

本文回答三个问题：DM4 各板如何配合；密度等物理量怎样从传感器信号得到；现有硬件为诊断和安全通信提供了哪些观测入口。

分析依据只有四份 V6.0 原理图及其转换 PDF。没有 BOM、PCB、装配图、机械图纸、传感器端固件、标定记录和台架数据，因此文中的结论分为四类：

| 结论类型 | 含义 | 典型内容 |
| --- | --- | --- |
| 原理图确认 | 可直接从器件、网络和标注中读取 | STM32G071、双 AD9832、ADS1247、FDC2212、SN65HVD72 |
| 静态计算 | 按图中理想阻容值计算，未计入公差和负载 | POWERTEST 约为 VCC/11、MidV 约为 1.65 V、差分增益约为 41 |
| 功能推断 | 根据信号名和拓扑判断，需由固件或实测确认 | SWAP 的工作时序、TA1CLK 的计数方式、诊断位映射 |
| 待补证据 | 无法由原理图单独判断 | 实装参数、测量精度、标定算法、故障覆盖率、FTTI 和 SIL 符合性 |

原理图可以证明 DM4 具备多参数测量和部分诊断所需的硬件链路，但不能证明传感器端已经实现安全协议，也不能替代 BOM 核对、样机测试、故障注入和功能安全认证。

### 1.2 原始资料

| 板卡 | 原始文件 | 归档 PDF | 原始 SchDoc SHA-256 |
| --- | --- | --- | --- |
| 电源板 | `DM4电源板V6.0.SchDoc` | [DM4电源板V6.0.pdf](00_原始资料/DM4四代数字驱动V6.0/DM4电源板V6.0.pdf) | `E15863B8D6A9390E54DE44D2D0B7FB24E2710EF94FB930B1E5E06C64D2D02629` |
| 驱动板 | `DM4驱动板V6.0.SchDoc` | [DM4驱动板V6.0.pdf](00_原始资料/DM4四代数字驱动V6.0/DM4驱动板V6.0.pdf) | `FC79E560E497B83C1F3F8D5289EFA8DA1F2EBBD08602663232D53E90CDCC7B45` |
| 采集板 | `DM4采集板V6.0.SchDoc` | [DM4采集板V6.0.pdf](00_原始资料/DM4四代数字驱动V6.0/DM4采集板V6.0.pdf) | `DDF63B793EDD441FAB12EE67C671887B3522ED46493B9832B5CDE046ADD4980B` |
| 测水连接板 | `DM4测水连接板V6.0.SchDoc` | [DM4测水连接板V6.0.pdf](00_原始资料/DM4四代数字驱动V6.0/DM4测水连接板V6.0.pdf) | `BB46F68F6566EFAD17B0022326B9858E40D17BC3F23A10C88ACEC51204FB0709` |

转换过程和文件校验见 [原始资料 README](00_原始资料/DM4四代数字驱动V6.0/README.md)。四份图的标题栏没有填写独立的 Title、Number、Revision 或原始发布日期；转换 PDF 中的 `8/03/2026` 是渲染日期，不能作为设计批准日期。本文也不把相似的 [LTD 传感器 S002 原理图整理](LTD传感器S002-2026-V1.1原理图整理.md)中的 MCU 引脚、固件参数或测试结论直接移植到 DM4。

## 2. DM4 系统组成

<div class="system-flow">
  <div class="board board-power"><b>电源板</b><span>VCC → 5 V / 3.3 V</span><span>RS485</span><span>POWERTEST / SWD</span></div>
  <div class="flow-arrow">→</div>
  <div class="board board-control"><b>驱动板</b><span>STM32G071</span><span>DDS / ADC / 姿态 / 零点</span><span>测量控制与通信</span></div>
  <div class="flow-arrow">→</div>
  <div class="board board-analog"><b>采集板</b><span>压电差分驱动与采集</span><span>同步检测</span><span>DDS / 自激切换</span></div>
  <div class="flow-arrow">→</div>
  <div class="board board-sensor"><b>测水连接板</b><span>FDC2212 + LC</span><span>温度 / 压电 / 水电极端子</span><span>传感器物理接口</span></div>
</div>

| 板卡 | 核心器件 | 主要职责 | 关键网络 |
| --- | --- | --- | --- |
| 电源板 | ADP7102-3.3、ADP7102-5、MCP6241、SN65HVD72 | 供电、总线收发、电源监测和调试信号转接 | 3.3 V、5 V、RXD、TXD、DE、POWERTEST |
| 驱动板 | STM32G071RBT6、AD9832×2、ADS1247、ADXL345、DRV5055、TLV9061 | 控制激励和采样，处理姿态、零点与外部通信 | Drive_A/B、DRDY、ZERO、TA1CLK、IN_AD |
| 采集板 | AD8630、MAX942、ADG702、TS5A3160 | 压电驱动与接收、同步检测、液位比较和激励模式切换 | Aout1/2、Ain1/2、LEVEL_INT、IN_AD、SWAP |
| 测水连接板 | FDC2212、18 uH、33 pF、18 pF | 电容测水，并转接压电、温度和测试端子 | TWater、INTB、SD、FDC_SCL/SDA |

板间信号可分为供电、通信、激励、采集和维护五组：

| 信号组 | 主要信号 | 作用 |
| --- | --- | --- |
| 供电 | VCC、5V、3.3V、GND | 电源板产生低压电源并分配给其余板卡 |
| 通信 | A+、B-、TXD、RXD、DE | 外部 RS485 总线经电源板收发器连接驱动板 MCU |
| 密度测量 | Drive_A、Drive_B、SWAP、Aout1/2、Ain1/2、IN_AD、TA1CLK | 形成激励、机械响应采集、同步检测和频率观测链路 |
| 其他测量 | AIN1+/AIN1-、I+/I-、FDC_SCL/SDA、INTB、SD、ZERO | 温度、电容式测水和零点测量 |
| 维护 | JTMS-SWDIO、JTCK-SWCLK、TEST | 烧写、调试和生产测试 |

堆叠连接器一侧标注“插针，底层”，另一侧标注“插母，顶层”。同一物理连接在两张图上的脚号可能因镜像方向产生偏移，不能只按相同脚号判断连通性，最终应结合 PCB、装配方向和实物导通测试确认。

## 3. 密度测量原理

### 3.1 测量对象与基本关系

密度表示单位体积内包含多少质量。对同样大小的一杯液体，质量越大，密度越高。DM4 并不是直接称量液体，而是让一个机械敏感结构在液体中振动，再根据谐振频率反推密度。

这套结构可以近似理解为“弹簧上挂着砝码”：弹簧越硬，振动越快；参与振动的质量越大，振动越慢。对应的简化关系为：

<div class="formula">f<sub>r</sub> = [1 / (2π)] × √(k<sub>eff</sub> / m<sub>eff</sub>)</div>

其中 `f_r` 是谐振频率，`k_eff` 是等效刚度，`m_eff` 是探头本体与周围液体共同形成的等效质量。对几何结构固定的探头，可作一阶近似：

<div class="formula">m<sub>eff</sub> = m<sub>0</sub> + αρ</div>

由此可看出，在结构、温度和安装状态相近时，液体密度 `ρ` 增大通常会使谐振频率下降。工程上常用下式说明标定曲线的大致方向：

<div class="formula">ρ ≈ K<sub>0</sub> + K<sub>1</sub> / f<sub>r</sub><sup>2</sup></div>

这个式子只是物理近似，不是已经确认的 DM4 产品公式。实际算法还可能考虑温度、黏度、幅值、相位和探头个体标定，形式更接近 `ρ = F(f_r, T, A, Q, C_cal)`。

### 3.2 从激励到密度结果

<div class="signal-chain">
  <span>STM32G071</span><i>→</i>
  <span>DDS A / Drive_A</span><i>→</i>
  <span>压电差分驱动</span><i>→</i>
  <span>机械结构与液体</span><i>→</i>
  <span>压电差分采集</span><i>→</i>
  <span>放大与同步检测</span><i>→</i>
  <span>频率、幅值和相位观测</span><i>→</i>
  <span>温度补偿与标定</span><i>→</i>
  <span>密度及质量状态</span>
</div>

一次测量从 MCU 设置激励频率开始。DDS A 产生 `Drive_A`，采集板把它变成 `Aout1/Aout2` 差分电压，驱动组压电陶瓷再把电信号变成机械振动。机械结构受到液体的附加质量和阻尼影响，其振动由采集组压电陶瓷转换为 `Ain1/Ain2` 微弱差分信号。

接收信号经放大后，一路用于幅值门限和同步检测，另一路进入反馈与周期观测链路。MCU据此寻找并测量稳定的谐振频率，同时检查幅值、相位和振荡状态。最后，固件结合温度与该探头的标定参数，把谐振频率换算成密度。

因此，硬件直接提供的是电压、边沿、周期和状态，密度是后续计算结果。`IN_AD` 不是“密度电压”，`LEVEL_INT` 也不是密度值；它们只用于判断当前机械响应是否足够、稳定和可信。

### 3.3 DDS 扫频、谐振点判定与反馈自激

先明确一个容易混淆的结论：**DDS A 是实际激励路，DDS B 是选频/同步参考路。45°和 22.5°首先表示 DDS B 的参考相位设置，不是第二个机械振动通道，也不是电路直接输出的机械相位测量值。**

两颗 AD9832 的作用如下：

| 通道 | 原理图连接 | 是否直接驱动压电 | 实际作用 |
| --- | --- | --- | --- |
| DDS A / `Drive_A` | 经 C701 和 TS5A3160 U7 进入 `Drive` | 是 | 产生实际激励正弦波，用于定频、扫频或为自激切换提供起始激励 |
| DDS B / `Drive_B` | 经 C501、MAX942 U5A 形成 `Select_A`，控制 ADG702 U8 | 否 | 产生与 DDS A 同频、相位可调的选频参考，控制 U8 对接收信号同步取样 |

<div class="signal-chain">
  <span>DDS A 激励</span><i>→</i>
  <span>压电与机械结构</span><i>→</i>
  <span>Ain1/Ain2 接收</span><i>→</i>
  <span>LEVEL 放大信号</span><i>→</i>
  <span>DDS B 控制同步取样</span><i>→</i>
  <span>低通积分得到 IN_AD</span>
</div>

#### 3.3.1 第二路为什么叫“选频”

`Drive_B` 先由 U5A 比较器整形成方波 `Select_A`，再控制 U8 周期性地接通或断开 `LEVEL`。如果 `LEVEL` 中某一部分与 DDS B 同频且相位关系稳定，连续多个周期取样后会在低通电路中累积成稳定的直流分量；其它频率、随机噪声和不稳定分量则会相互抵消。因此，第二路不是再激励一次探头，而是像一把只按指定节奏开门的“电子快门”，从接收信号中选择与参考频率和参考相位匹配的成分。

同步检测结果可用下式说明大致关系：

<div class="formula">IN_AD ∝ A<sub>response</sub> × cos(θ<sub>response</sub> − θ<sub>reference</sub>)</div>

其中 `A_response` 是接收响应幅值，`θ_response` 是包含机械结构、压电、放大器和线缆在内的总响应相位，`θ_reference` 是 DDS B 的参考相位。该式只用于解释同步检波方向，不是已经确认的 DM4 产品公式。

#### 3.3.2 45°和 22.5°到底是什么角度

AD9832 数据手册确认每颗芯片有四个 12 位相位寄存器，所选相位寄存器的数值会作为相位偏移量加到相位累加器输出上。理想数字相位偏移关系为：

<div class="formula">φ<sub>register</sub> = 360° × N / 4096，N = 0～4095</div>

因此，如果以 DDS A 为 0°基准、DDS B 没有额外固定偏移，则 45°对应寄存器值 `512`，22.5°对应寄存器值 `256`。V4.0 协议中的“选频相位”参数范围也是 0～4095，与 AD9832 的 12 位相位寄存器一致。这里能够确认的是数字寄存器的换算关系；当前协议没有直接写明产品运行时一定把 `512` 和 `256` 写入哪个相位寄存器，仍需传感器端固件或串行总线抓取确认。

还要区分三个容易混为一谈的角度：

| 角度 | 由什么决定 | 是否就是协议中的 45°/22.5° |
| --- | --- | --- |
| DDS 数字设定角 | MCU 写入 DDS B 的 12 位相位寄存器决定 | 是，最直接的含义 |
| 电路参考相位 | DDS 数字设定角再叠加比较器、开关极性、连线和器件延时 | 不一定完全相等 |
| 机械响应相位 | 激励频率、机械结构、液体密度与黏度、压电和模拟前端共同决定 | 不是；它是被同步检测的对象 |

所以“为什么选 45°和 22.5°”不能只回答成“硬件固定的”。更准确的说法是：固件选择两个参考相位，在机械响应相位随频率变化的曲线上取得两个特征频率。密度主要移动这条曲线的位置，黏度主要改变相位过渡的宽度；两个特征点之间的间隔因而能为黏度计算提供信息。至于 DM4 为什么最终选择这两个具体角度，以及角度中是否已经包含板级固定补偿，现有原理图和协议没有给出设计推导或标定试验，属于待确认项。

#### 3.3.3 `SWAP` 对应两种工作模式

| `SWAP` 状态 | U7 选择 | 工作方式 | 用途 |
| --- | --- | --- | --- |
| 低电平 | DDS A 输出 | 外部受迫激励 | 主动改变频率，逐点扫描机械响应 |
| 高电平 | 模拟反馈输出 | 反馈自激 | 让环路在满足增益与相位条件的频率附近自行振荡，供连续跟踪或复核 |

扫频模式下，DDS A 负责“敲”，DDS B 负责“按指定节奏听”；自激模式下，接收信号经增益和移相网络返回驱动端，`TA1CLK` 可作为 MCU 的周期观测入口。原理图证明硬件具备这两种模式，但没有传感器端固件，不能确认产品是否在每次密度测量中都执行自激复核。

#### 3.3.4 扫频怎样得到谐振区域和相位特征点

协议给出的密度扫频默认范围为 5500 Hz 到 3000 Hz，并允许配置扫频方向。一次合理的逐点扫描过程如下；等待时间、步长和判定阈值仍需由传感器端固件确认：

| 步骤 | MCU 与电路动作 | 得到的数据 |
| ---: | --- | --- |
| 1 | `SWAP` 选择 DDS A；DDS A 设置当前激励频率 | 当前频率寄存器值 |
| 2 | DDS B 跟随相同频率，并设置选频参考相位 | 45°或 22.5°参考条件 |
| 3 | 等待机械振动和约 0.1 s 名义时间常数的 `IN_AD` 低通链路稳定 | 剔除切换瞬态后的响应 |
| 4 | 连续读取 `IN_AD`，同时观察 `LEVEL_INT` 和可用的周期捕获信号 | 当前频率 AD 平均值和质量状态 |
| 5 | 改变频率并重复上述过程 | “频率—相敏响应”曲线 |
| 6 | 在曲线中寻找峰值、过零点或规定阈值交点 | 候选谐振区域或相位特征频率 |
| 7 | 重复扫描并平均，必要时切换自激，用 `TA1CLK` 复核 | 最终周期、频率和稳定度 |

密度增大主要增加等效振动质量，使整条响应曲线沿频率轴移动；黏度增大主要增加阻尼，使响应幅值降低、相位过渡变缓、曲线变宽。用两个固定参考相位观察同一条曲线，可以同时获得“曲线位置”和“曲线宽度”信息。

协议将两组结果命名为“45°扫频周期平方均值”和“22.5°扫频周期平方均值”。按硬件连接和“选频相位”参数，更合理的理解是：传感器在 DDS B 的两个参考相位条件下分别提取特征频率，可能采用两次独立扫描，也可能在同一频点交替相位取样。原理图和协议没有给出这两种实现的裁决证据。

若两个相位条件下得到的特征频率分别为 `f_45` 和 `f_22.5`，周期平方量可写成：

<div class="formula">S<sub>45</sub> = mean[(K / f<sub>45</sub>)<sup>2</sup>]</div>

<div class="formula">S<sub>22.5</sub> = mean[(K / f<sub>22.5</sub>)<sup>2</sup>]</div>

其中 `K` 表示定时器计数或单位换算比例；当前协议没有写出周期平方的单位和缩放。协议还上报两者的差值 `ΔS`，但没有规定是 `S_22.5 − S_45` 还是相反方向。

候选点还必须通过质量检查：结果不能位于扫描边界；主响应应明显高于背景且不能同时出现多个相近峰；正向扫频、反向扫频和重复扫描的结果应在允许偏差内；`IN_AD` 不应饱和，`LEVEL_INT` 应保持稳定；如果启用自激复核，`TA1CLK` 测得的频率应与扫频区域一致。任一条件不满足时，应报告无峰、多峰、信号过弱、模式不一致或频率不稳定，而不是继续换算密度。

<div class="signal-chain">
  <span>宽范围粗扫</span><i>→</i>
  <span>确定主响应区</span><i>→</i>
  <span>45°与 22.5°相敏取样</span><i>→</i>
  <span>重复扫描并平均</span><i>→</i>
  <span>必要时自激复核</span>
</div>

双 DDS 共用 MCU、时钟、供电和串行控制链路，且只连接一套机械测量结构，因此它们构成激励与同步参考，不是两套独立的安全冗余密度通道。

### 3.4 标定、温度补偿与结果有效性

V4.0 协议的参数结构可以确认“哪些原始量参与哪类标定”，但没有给出插值函数、差值方向和修正顺序。下述公式按参数名称说明最可能的数据关系，不能替代 DM4 传感器端算法源码。

#### 3.4.1 基础密度

协议提供四组“已知密度—45°扫频周期平方”标定点：

| 标定输入 | 标定输出 |
| --- | --- |
| `S_45,1` | 密度点 1 |
| `S_45,2` | 密度点 2 |
| `S_45,3` | 密度点 3 |
| `S_45,4` | 密度点 4 |

因此，基础密度可概括为：

<div class="formula">ρ<sub>raw</sub> = F<sub>density</sub>(S<sub>45</sub>)</div>

`F_density` 可能是分段插值、多项式拟合或其它标定函数，当前资料无法确认。选用周期平方的物理原因是振动系统近似满足 `T² ∝ m_eff`，液体密度改变附加质量后，密度与周期平方通常比与频率本身更接近线性关系。

#### 3.4.2 动力黏度和运动黏度

协议提供十三组“扫频周期平方均值的差—动力黏度×密度²”标定点。令：

<div class="formula">ΔS = S<sub>22.5</sub> − S<sub>45</sub>　或　S<sub>45</sub> − S<sub>22.5</sub></div>

按参数名称，黏度换算关系可概括为：

<div class="formula">G = F<sub>viscosity</sub>(ΔS),　G = η × ρ<sup>2</sup></div>

<div class="formula">η<sub>raw</sub> ≈ G / ρ<sup>2</sup></div>

其中 `η` 为动力黏度。十三点如何排序、越界如何处理、密度采用修正前还是修正后数值，以及单位缩放均需由传感器端固件确认。运动黏度的常用物理换算为：

<div class="formula">ν(cSt) = 1000 × η(cP) / ρ(kg/m³)</div>

#### 3.4.3 黏度、温度和固定修正

协议另有十三组“动力黏度—密度修正值”、四组 30 ℃ 密度温度修正、四组 10 ℃副温度修正，以及黏度、密度等固定修正参数。因此最终结果的合理结构为：

<div class="signal-chain">
  <span>45°周期平方得到基础密度</span><i>→</i>
  <span>双相位差值得到动力黏度</span><i>→</i>
  <span>黏度引起的密度修正</span><i>→</i>
  <span>温度与固定修正</span><i>→</i>
  <span>最终密度和黏度</span>
</div>

上述流程方向有协议字段支持，但加减符号、插值算法和执行顺序没有直接证据，不应写成已确认的产品公式。CUBE CPU2 侧读取的是传感器已经计算完成的频率、密度、动力黏度和运动黏度结果，不负责用 45°、22.5°原始量重新计算。

#### 3.4.4 只为看懂流程的算术示例

下面故意使用虚构系数，只演示数据怎样逐层流动，不能用于 DM4 标定或现场计算。假设某次重复扫描得到 `f_45 = 4000 Hz`、`f_22.5 = 3900 Hz`，用微秒表示周期，则：

<div class="formula">T<sub>45</sub> = 1 / 4000 = 250.00 μs，S<sub>45</sub> = 62500 μs²</div>

<div class="formula">T<sub>22.5</sub> = 1 / 3900 ≈ 256.41 μs，S<sub>22.5</sub> ≈ 65746 μs²</div>

若示例中约定 `ΔS = S_22.5 − S_45`，则 `ΔS ≈ 3246 μs²`。再假设四点密度插值得到 `ρ = 810 kg/m³`，十三点黏度插值得到 `G = η × ρ² = 65,610,000`，则：

<div class="formula">η = G / ρ² = 100 cP，ν = 1000 × 100 / 810 ≈ 123.46 cSt</div>

这个示例只说明“45°特征周期平方 → 密度”“两个特征周期平方的差 → 黏度相关量”“动力黏度除以密度 → 运动黏度”的层级关系。真实设备的周期单位、差值正负方向、插值表数值、温度补偿和固定修正顺序均应以传感器端固件与标定记录为准。

#### 3.4.5 标定和结果有效性

标定需要在受控温度下使用若干已知密度、已知黏度的参考介质，记录两个相位条件下的周期平方、温度和信号质量，再拟合每支探头或受控批次的标定系数，并用独立参考点验证误差。探头的机械尺寸、粘接、预紧和压电装配存在差异，标定系数应与硬件身份、标定版本和适用温度范围绑定。

温度补偿不可省略。温度既会改变液体密度，也会改变敏感结构的刚度和压电、模拟前端特性。DM4 的 ADS1247 温度/电阻通道为补偿提供了硬件入口，但原理图没有给出实际温度元件、补偿模型和标定系数。

影响密度结果的主要因素如下：

| 因素 | 对测量的影响 | 常见表现 |
| --- | --- | --- |
| 温度 | 改变液体性质和机械刚度 | 同一介质的频率随温度缓慢漂移 |
| 黏度 | 增加机械阻尼 | 幅值降低、峰变宽、建立时间变长 |
| 气泡或未完全浸没 | 改变参与振动的介质 | 频率跳变、多峰或结果不稳定 |
| 污垢和沉积 | 增加长期附加质量 | 零点持续偏移，清洗前后读数变化 |
| 安装应力或机械松动 | 改变等效刚度和振动模态 | 重复性下降或谐振点迁移 |
| 压电、电源或时钟故障 | 激励或接收链路失真 | 无峰、停振、饱和或频率不一致 |
| 标定错配 | 使用了错误的换算参数 | 频率稳定但密度持续偏差 |

出现无峰、多峰、响应过小、频率越界或跳变、温度无效、扫频与自激不一致、标定身份不一致时，本次密度应标为无效并报告原因，不能沿用旧值或强行输出平滑结果。

### 3.5 原理图中的关键信号

| 信号或器件 | 原理图可确认的作用 | 在密度测量中的用途 |
| --- | --- | --- |
| `Drive_A` | DDS A 的实际激励输出 | 设置扫频或定频激励 |
| `Drive_B` | 经比较器整形的同步参考 | 控制同步选通的频率和相位 |
| `Aout1/Aout2` | 驱动组压电陶瓷的差分输出 | 把电激励转换为机械振动 |
| `Ain1/Ain2` | 采集组压电陶瓷的差分输入 | 接收机械振动产生的微弱信号 |
| U6A/U6B | 理想差分增益约 41 的接收放大器 | 提高接收信号幅值和共模抑制能力 |
| `IN_AD` | 同步选通并低通后的慢速模拟量 | 观测与激励同频、相位相关的响应质量 |
| `LEVEL_INT` | `LEVEL` 越过比较阈值后的数字状态 | 判断响应是否达到门限，不能直接表示密度 |
| `TA1CLK` | 反馈链的周期信号 | 供 MCU 测量周期、频率和稳定度 |
| ADS1247 温度通道 | 精密差分温度/电阻采样入口 | 为密度换算和结果有效性提供温度信息 |

一条可用的密度结果至少应同时满足：谐振频率有效、响应幅值和相位稳定、温度有效、标定身份正确、关键诊断无故障。只有密度数值而没有这些质量信息，接收方无法区分真实介质变化与传感器故障。

## 4. 四块板的电路实现

### 4.1 电源与 RS485 通信

电源板使用 ADP7102-3.3 和 ADP7102-5，把外部 `VCC` 转换为 3.3 V 和 5 V。两颗 LDO 的 `EN/UVLO` 直接接 VCC，`PG` 未进入 MCU 或板间连接器，因此图中没有独立的 3.3 V、5 V 电源良好诊断。LDO 功耗仍需按实际输入电压和负载核算：

<div class="formula">P<sub>LDO</sub> ≈ (V<sub>CC</sub> − V<sub>OUT</sub>) × I<sub>OUT</sub></div>

`RF01=100 kΩ`、`RF02=10 kΩ` 对 VCC 分压，MCP6241 缓冲后形成 `POWERTEST`：

<div class="formula">POWERTEST ≈ VCC × 10 / (100 + 10) = VCC / 11</div>

该信号适合监测 VCC 的欠压、过压和变化趋势，但不能单独证明 5 V、3.3 V 或各板局部供电正常。3.3 V 上还有 PWR 指示灯以及两只并联的 `SMB5338A` 钳位器件；其钳位电压、功率和并联均流必须以 BOM 和实测确认。

RS485 使用 `SN65HVD72`，DI 接 TXD，RO 接 RXD，DE 与 `/RE` 同接 MCU 的 DE。A+ 由 10 kΩ 上拉，B- 由 10 kΩ 下拉，形成弱空闲偏置。图中未见 120 Ω 终端、总线 TVS、共模电感、隔离和浪涌保护；这些器件是否位于线束或其他板卡需要另行核对。长线使用前应冻结线缆阻抗、终端位置、唯一偏置点、屏蔽接地、DE/RE 时序和 EMC 方案。

### 4.2 控制、DDS 与精密采样

驱动板主控为 `STM32G071RBT6`，外接 7.3728 MHz 晶振。MCU 管理双 DDS、ADS1247、FDC2212、ADXL345、Hall 零点、RS485 以及采集板的模拟和数字信号。

两颗 `AD9832BRUZ` 共用 `MCLK/SCLK/SDATA`，分别保留独立的同步、频率选择和相位选择信号。这种结构便于建立相干激励和同步参考，但公共 MCU、时钟、供电与控制总线仍是共同故障点。

`ADS1247` 用于精密差分温度/电阻测量。`AIN1+`、`AIN1-` 各经 47 Ω 串联，两端各有 47 pF 对 AGND，差分端之间有 100 nF。按理想值计算，差分 RC 截止频率约为：

<div class="formula">f<sub>c</sub> ≈ 1 / [2π × (47 Ω + 47 Ω) × 100 nF] ≈ 16.9 kHz</div>

`IOUT1` 是外部温度敏感元件的激励电流候选，`DRDY` 为采样就绪信号。参考异常、输入开短路、饱和、DRDY 停滞和样本冻结都需要由固件诊断。

驱动板还包含 `ADXL345` 姿态传感器和 `DRV5055 + TLV9061` Hall 零点通道。`ZERO_EN` 可控制 Hall 相关供电或使能路径，为“关闭—开启—检查 ZERO 响应”的主动自检提供条件。图中 `3V3` 与 `3.3V` 使用了不同网络名，两者关系必须通过 PCB/BOM 确认。

有三个上电前需要核对的细节：复位器件标注为 `TLV809I50_DBV_3`，其完整料号和阈值必须适配 3.3 V；`CAPTURE` 同时连接 MCU 的 PC9 和 PA15，固件必须避免双输出争用；SWD 和 TEST 信号经连接器外露，量产时应明确调试口保护和维护解锁策略。

### 4.3 压电驱动、采集与同步检测

采集板用两只 10 kΩ 电阻对 3.3 V 分压，并由 U6C 缓冲形成 `MidV≈1.65 V`。MidV 是单电源模拟链路的公共参考，漂移会同时影响接收放大、比较阈值、自激反馈和 ADC 读数。

`Drive` 经 AD8630 U4C/U4D 形成 `Aout1/Aout2` 差分驱动，两路分别通过 51 Ω 电阻连接驱动组压电陶瓷。接收组输出 `Ain1/Ain2`，经 1 uF 交流耦合和 U6A/U6B 两运放结构放大。图中给出的关系为：

<div class="formula">Uo2 = 20(Ui2 − Ui1) + Ui2</div>
<div class="formula">Uo1 = 20(Ui1 − Ui2) + Ui1</div>

两式相减后，理想差分增益为：

<div class="formula">Uo1 − Uo2 = 41(Ui1 − Ui2)</div>

这个 41 倍只表示理想差分电压增益。实际结果还受电阻匹配、运放参数、压电源阻抗、PCB 对称性和输出饱和裕量影响。

`Drive_B` 经 MAX942 U5A 整形成 `Select_A`，控制 ADG702 U8 对 `LEVEL` 同步选通。选通后的信号进入 U6D，R606=100 kΩ 与 C603=1 uF 形成约 0.1 s 的名义时间常数，对应低通截止频率约 1.59 Hz。由此得到的 `IN_AD` 是慢速幅值/相位相关观测量，不是原始波形和密度数值。

`LEVEL` 同时进入 MAX942 U5B。R503=4.7 kΩ、R504=9.1 kΩ 形成约 2.176 V 的理想比较阈值，输出 `LEVEL_INT`。原理图未明确迟滞量，阈值附近可能抖动，因此固件应结合模拟值、数字状态和持续时间判断。

TS5A3160 U7 由 `SWAP` 控制：低电平选择 DDS 输出，高电平选择反馈输出。自激区标注“移相 90 度”和 `Au=11.9`，名义 RC 转折点约为 79.6 Hz 和 1.59 kHz。真实环路相位还包含机械结构、压电、运放、线缆和寄生参数，不能仅凭图纸标注判断一定在正确模态稳定振荡。

图中还给出了 R408、R609 的 3.3 V/5 V 装配选项。装配差异会改变模拟前端的偏置或范围，应纳入硬件配置 ID、BOM 和标定版本管理。

### 4.4 测水、温度、姿态与零点

温度测量链路为 `I+/I- 激励 → 温度敏感元件 → AIN1+/AIN1- → RC 滤波 → ADS1247 → SPI/DRDY → 温度换算`。原理图没有给出外部温度元件的完整参数，实际量程、接线和换算公式需要结合探头资料确认。

测水连接板使用 `FDC2212` 和 LC 网络测量 TWater 电极电容。当前可见通道采用 18 uH、33 pF 以及两只 18 pF 对地电容，仅按 18 uH 和 33 pF 计算的基础谐振频率约为：

<div class="formula">f<sub>0</sub> ≈ 1 / [2π√(18 uH × 33 pF)] ≈ 6.53 MHz</div>

实际频率还受电极、线缆、PCB 寄生、油水介电常数、盐度、乳化和附着层影响，6.53 MHz 不能当作产品标称值。应覆盖电极开路、短路、对壳泄漏、I2C 超时、INTB 固定、原始值冻结和配置错误。

| 功能 | 物理入口 | 电路 | MCU 接口 | 主要诊断 |
| --- | --- | --- | --- | --- |
| 姿态/冲击 | 板卡运动 | ADXL345 | SPI、INT1/2 | 通信、自检、冻结、范围和安装方向 |
| 磁零点 | Hall 磁场 | DRV5055 + TLV9061 | ZERO、ZERO_EN | 受控使能、固定高低、抖动和超时 |
| 水电容 | TWater 电极 | FDC2212 + LC | I2C、INTB、SD | 开短路、超范围、变化率和配置一致性 |

测水板同时转接压电、温度和测试端子，堆叠连接器故障可能一次影响多个测量通道，应按公共原因故障处理。

## 5. MCU 可观测信号与诊断

驱动板上的 STM32G071 是所有测量状态的汇聚点，也是传感器端安全协议执行节点的合理候选。当前 CUBE [传感器安全协议 V1](../01_协议与寄存器/传感器通信协议/传感器安全协议SIL/01_现行协议V1/传感器安全通信协议V1.md)已定义 CRC32C、会话、序号、采样计数、数据年龄、状态位、诊断位和配置一致性，但 DM4 传感器端实现及硬件联调仍需单独取证。

| 硬件观测 | 可反映的状态 | 建议的诊断处理 |
| --- | --- | --- |
| POWERTEST | 外部 VCC 水平 | 范围、迟滞、持续时间和 ADC/参考合理性 |
| TA1CLK、CAPTURE | 周期、频率和振荡稳定性 | 停滞、跳变、超范围以及模式一致性 |
| IN_AD、LEVEL_INT | 压电响应强度和同步检测状态 | 模拟/数字交叉确认、阈值防抖和饱和检查 |
| ADS1247 DRDY、AIN、REF | 温度采样及精密 ADC 状态 | DRDY 停滞、参考故障、开短路和饱和 |
| FDC 原始频率、INTB、SD | 水电容测量和接口状态 | I2C 错误、开短路、原始值冻结和变化率 |
| ADXL345 INT1/2 | 姿态、运动和冲击 | 通信、自检、冻结和方向合理性 |
| ZERO、ZERO_EN | Hall 零点及主动自检 | 使能后响应、固定高低和抖动 |
| SWAP、DDS 配置 | 当前激励模式 | 切换确认、稳定时间和旧快照失效 |
| 硬件/标定身份 | 量程与换算配置 | 纳入配置摘要，错配时拒绝测量结果 |

安全协议不能替代硬件诊断。CRC 只能发现传输损坏，`sample_counter` 只能证明快照在更新，`data_age_ms` 只能约束数据新鲜度；它们都不能证明机械响应、温度或电容值本身正确。密度上报应在同一采样快照中至少包含原始频率或周期、测量模式、信号质量、温度有效性、诊断状态、采样计数、数据年龄以及硬件/标定配置身份。

## 6. 主要风险和待确认问题

下表按处理时机归并原理图评审中最重要的问题。优先级表示建议的关闭顺序，不代表现场故障频率。

| 优先级 | 问题 | 影响 | 关闭依据 |
| --- | --- | --- | --- |
| P0 | TLV809 完整料号和复位阈值未确认 | 阈值不匹配可能造成复位长期不释放或欠压保护不足 | BOM、上电/掉电和慢升压波形 |
| P0 | CAPTURE 同时连接 PC9 与 PA15 | 两脚均输出时可能发生管脚争用 | 原理图意图、固件方向和上电默认态测试 |
| P0 | 堆叠连接器存在镜像脚号理解风险 | 错位可同时损坏供电和多个测量通道 | PCB/装配图、逐针导通表和实物检查 |
| P0 | VCC 范围、LDO 负载和热设计未冻结 | 压差、启动和温升裕量未知 | 输入范围、最大负载、铜皮与温升测试 |
| P0 | RS485 图中未见终端、TVS、隔离和浪涌方案 | 长线、EMC 和接地故障风险未关闭 | 总线图、BOM、线缆规范和 200 米测试 |
| P0 | R408/R609 对应的 3.3 V/5 V 装配版本未冻结 | 错装会引起量程、阈值和标定错误 | 硬件 ID、BOM、标定与配置摘要一致 |
| P0 | 未提供 STM32G071 传感器端安全固件 | 协议、诊断和安全状态尚无实现证据 | 源码、协议对拍、真实硬件状态和故障注入 |
| P1 | 只用 POWERTEST 监测 VCC，LDO PG 未接入 | 3.3 V/5 V 局部故障可能缺少独立诊断 | 分别监测各电源并验证掉电恢复 |
| P1 | 双 DDS 共用 MCU、时钟、供电和控制链路 | 不能把双 DDS 计为独立冗余 | 共同故障分析和外部观测交叉诊断 |
| P1 | LEVEL 迟滞、滤波和持续时间未冻结 | 阈值附近可能抖动或误判 | 示波器波形、噪声测试和固件判据 |
| P1 | 压电、ADS1247、FDC2212、ADXL345、ZERO 的故障阈值未建立 | 测量前端可能稳定地输出错误值 | 开短路、冻结、越界和模式错配注入 |
| P2 | 图纸标题栏、网络别名和版本链不完整 | 生产追溯和变更控制不足 | 原理图—BOM—PCB—固件—标定—协议矩阵 |
| P2 | 调试口、测试点和装配选项缺少量产规则 | 维护边界和返修一致性不足 | 生产检验表、调试口策略和返修复测规范 |

目前有利的基础是测量功能分区清楚，MCU 能观察电源、频率、模拟量、ADC、FDC、姿态和零点状态；主要缺口集中在独立电源诊断、复位与看门狗证据、通信物理层、共同故障、传感器端固件和生产配置管理。安全评审应围绕这些可观测量建立诊断覆盖，而不是把“双 DDS”或“多个传感器”直接解释为冗余。

## 7. 板级验证建议

| 阶段 | 主要测试 | 需要记录的证据 |
| --- | --- | --- |
| 1. 供电 | VCC、5 V、3.3 V、静态电流、启动和 LDO 温升 | 输入范围、纹波、压差、慢升压和钳位器件温升 |
| 2. 复位与时钟 | RESET、7.3728 MHz、SWD、IWDG | 复位阈值、释放时间、欠压和看门狗最坏恢复时间 |
| 3. RS485 | RXD、TXD、DE、A/B 波形 | 终端、偏置、方向切换、短线和 200 米误码统计 |
| 4. DDS 与压电 | Drive_A/B、Aout1/2、Ain1/2 | 频率、相位、幅值、失真、负载和温升 |
| 5. 采集前端 | MidV、LEVEL、IN_AD、LEVEL_INT、TA1CLK | 增益、阈值、迟滞、噪声、饱和恢复和频率稳定度 |
| 6. 温度与测水 | ADS1247 的 AIN/REF/DRDY；FDC 的 TWater/INTB/SD | 原始码、温漂、空载、油、水、污染和线缆寄生 |
| 7. 姿态与零点 | ADXL345、ZERO_EN/ZERO | 自检、固定故障、安装方向和冲击响应 |
| 8. 测量与标定 | 扫频、自激、参考介质、温度点 | 峰值、模式一致性、补偿曲线、重复性和无效条件 |
| 9. 安全通信 | HELLO、组合快照、快报、退出与恢复 | CRC、会话、序号、年龄、状态、诊断和配置摘要 |
| 10. 整机故障注入 | 掉电、重启、噪声、连接器及传感器故障 | 从故障发生到安全输出动作的端到端时间 |

验证时应保留原始波形、配置、环境条件、样机编号和判定标准。静态检查、协议对拍和构建结果不能替代真实探头、长线、温度、介质和故障注入试验。

## 8. 结论

DM4 V6.0 已形成完整的多参数传感器硬件骨架。双 DDS 与压电前端承担振动式密度测量，ADS1247 提供温度/电阻采样，FDC2212 承担电容式测水，ADXL345 和 Hall 通道提供姿态与零点信息，STM32G071 汇总状态并通过 RS485 对外通信。

密度测量的核心不是把某个模拟电压直接换算为密度，而是通过压电激励和接收获得机械谐振频率，再结合响应质量、温度和探头标定得到密度。`Drive_A` 是实际激励，`Drive_B` 是同步检测参考，`IN_AD` 和 `LEVEL_INT` 用于判断信号质量，`TA1CLK` 提供频率观测；这些信号共同构成测量与诊断基础。

在复位器件、CAPTURE 同网、连接器镜像、供电热设计、RS485 物理层、模拟装配版本和传感器端安全固件等问题关闭之前，这四份原理图只能作为研发和安全分析输入，不能作为测量精度、量产合格或 SIL 达成的证明。

## 附录 A：主要器件

| 板卡 | 主要器件 |
| --- | --- |
| 电源板 | ADP7102-3.3、ADP7102-5、MCP6241T-E、SN65HVD72、SMB5338A |
| 驱动板 | STM32G071RBT6、AD9832BRUZ×2、ADS1247、ADXL345BCCZ-RL7、DRV5055A1QLPG、TLV9061IDBVR、TLV809、SI4559ADY |
| 采集板 | AD8630、MAX942、ADG702、TS5A3160 |
| 测水连接板 | FDC2212、18 uH、33 pF、18 pF、4.7 kΩ I2C 上拉 |

## 附录 B：静态计算汇总

| 项目 | 理想结果 | 使用边界 |
| --- | ---: | --- |
| POWERTEST 分压 | VCC/11 | 未计入电阻、运放、ADC 和参考误差 |
| MidV | 1.65 V | 未计入负载、偏置和温漂 |
| 压电差分增益 | 41 V/V | 未计入电阻匹配、运放和源阻抗 |
| LEVEL 阈值 | 约 2.176 V | 未确认比较器迟滞和器差 |
| 同步检测低通 | τ≈0.1 s，f_c≈1.59 Hz | 未计入开关、运放和采样影响 |
| ADS1247 差分 RC 截止 | 约 16.9 kHz | 未计入 ADC 数字滤波和传感器阻抗 |
| FDC 基础 LC 频率 | 约 6.53 MHz | 未计入 18 pF、电极、线缆和寄生参数 |

## 附录 C：故障注入要点

| 故障 | 可用观测 | 期望处理 | 仍需确定 |
| --- | --- | --- | --- |
| VCC 或 LDO 异常 | POWERTEST、复位、模拟量 | 数据失效、会话重建并报告电源故障 | 阈值、迟滞、反应时间和独立监测 |
| RS485 开路、短路或反接 | 超时、CRC、UART 错误 | 撤销当前快照，在 FTTI 内进入定义的安全状态 | 终端、200 米、EMC 和浪涌条件 |
| MCU 卡死 | 上报静默、看门狗 | 复位或由 CPU2 超时撤销数据 | IWDG 配置和最坏恢复时间 |
| DDS 或压电故障 | TA1CLK、IN_AD、LEVEL_INT | 密度通道无效并报告具体故障 | 扫频、自激、开短路和寄存器测试 |
| ADS1247 输入/参考故障 | DRDY、饱和码、参考值 | 温度无效，保留 ADC 或参考错误 | 原始码范围和激励诊断 |
| FDC 电极故障 | 原始频率、INTB、SD | 水电容无效，区分开路、短路和超范围 | 电极、线缆和对壳泄漏注入 |
| ADXL345 或 ZERO 冻结 | SPI、中断、ZERO_EN/ZERO | 对应通道无效，不接受伪姿态或伪零点 | 自检和安装方向基准 |
| 连接器松动或错位 | 多个信号同时异常 | 按公共原因故障处理 | 振动、插拔、污染和接触电阻测试 |
| 配置或标定错配 | 配置摘要、标定版本 | 拒绝结果并重新确认配置 | 硬件 ID 和标定身份管理 |

## 附录 D：原理图解析提示

`altium-toolkit 1.4.3` 原生解析时没有报告丢页或组件恢复失败，但报告少量“同一网络恢复到多个显式网络名”的提示，包括 `AGND/REFIN(-)`、`REFIN(+)/I-`、`IOUT1/I+`、`LEVEL/OUT`、`AIN1-/I-` 和 `AIN1+/I+`。这些名称可能是设计者有意使用的别名，也可能反映连接或标注需要清理。本文没有自动合并或改写网络，最终网络表应由 Altium 官方工程、PCB 和硬件评审确认。
