duanxuebin1998/cube/docs/07_硬件原理图/储罐自动计量仪原理图汇总整理.md

# 储罐自动计量仪原理图汇总整理

整理日期：2026-06-06

## 资料信息

| 项目 | 内容 |
| --- | --- |
| 原始文件 | `00_原始资料/储罐自动计量仪原理图汇总.pdf` |
| 来源文件 | `C:\Users\admin\Downloads\储罐自动计量仪原理图汇总.pdf` |
| PDF 页数 | 30 页 |
| PDF 元数据 | Producer: `jsPDF 0.0.0`; 创建时间：2025-09-18 13:48:28; 修改时间：2026-06-04 09:37:11 |
| 文件大小 | 4,536,481 字节 |
| SHA256 | `6DF2037F76BE29A8715D20077DBB5873FA7954B479DBBFCBE30CB9E44A0870E5` |
| 整理方式 | 结合 `pdfinfo`、`pdftotext -layout` 文本提取和 160 dpi 页面渲染人工核对 |

说明：该 PDF 的部分中文字体在 `pdftotext` 中存在 Adobe-GB1 字体映射告警，因此本文以页面渲染核对为主、文本提取为辅。本文用于固件和联调快速定位，不替代硬件设计评审、本安认证、BOM 或 PCB 文件。

## 总体架构

第一页是整机板级框图，核心结构如下：

| 模块 | 图纸表现 | 主要连接 |
| --- | --- | --- |
| 对外接线腔 | 外部接线入口，包含可选 `220AC 转 24DC` 电源 | 通过排线和插槽连接母板 |
| 母板 | 作为 CPU2 主控板、CPU3 板、CPU4 板和对外接线腔之间的转接底板 | 母型插槽、公型插头、排线插座 |
| 主控板 | CPU2 相关主板，图中标注主控板和“本安部分” | 电机、编码器、扭力传感器、导电滑环、4-20mA、HART、CPU3 485 |
| CPU3 板 | 显示和外部通讯板 | 上位机 485、CPU2 485、BPM、HART、瓦锡兰协议通讯、显示板 |
| CPU4 板 | 温度采集相关板 | 9V 供电、温度通讯、瓦锡兰温度计接口 |
| 本安部分 | 以红色虚线框标注，覆盖无线供电、传感器、HART、温度采集等接口 | 需要结合本安参数、隔离器件和安规评审单独确认 |

整机可以按三条主链路理解：

| 链路 | 说明 |
| --- | --- |
| 测量控制链路 | CPU2 控制电机驱动、编码器、扭力传感器、传感器驱动板和无线从机链路 |
| 显示通讯链路 | CPU3 负责 OLED/显示、外部 RS485、CPU2 通讯、HART/BPM 等接口 |
| 温度采集链路 | CPU4/RTD 板负责温度采集和瓦锡兰温度计接口，本安小板负责信号限能 |

## 逐页目录

| 页码 | 图纸标题或编号 | 主要内容 | 固件/联调关注点 |
| --- | --- | --- | --- |
| 1 | 总体框图 | 对外接线腔、母板、主控板、CPU3 板、CPU4 板和本安区域关系 | 理解 CPU2/CPU3/CPU4 的物理边界和外部接口来源 |
| 2 | 主控板 CPU2 主控 | `STM32F429ZGT6`、24V/12V 检测、复位/看门狗、FRAM、SWD、调试串口 | CPU2 引脚复用、`24V-TEST`、`12V-TEST`、`WDI`、`NRESET`、`DRV_ENN`、SPI/USART 网络 |
| 3 | 主控板电机驱动 | `TMC5130A` 步进电机驱动、`SPI2`、`DRV_ENN`、`AOUT/BOUT`、24V 电机电源、隔离串口和局部电源 | CPU2 电机驱动、失能脚、安全启动、驱动电源和 TMC5130 寄存器调试 |
| 4 | 主控板 HART/4-20mA | `SD2017B` HART 调制解调、`AD5421` 4-20mA 输出、隔离器件和浪涌/限能保护 | 4-20mA 输出、HART RTS/TX/RX、外部回路保护和本安边界 |
| 5 | CPU2 隔离 RS485 和指示 | `SN65HVD72DR`、`NSI8021N1D`、`B0303S-1WR3`、`SEL-485`、多路 RX/TX 指示灯、SPI5 缓冲 | CPU2 到外部/母板 RS485 通道、方向控制和串口指示灯 |
| 6 | CPU2 继电器和母板接口 | `ULN2001D` 继电器驱动、`HFD3/9` 继电器、`ADUM1200` 隔离、50 针母板连接器 | 继电器 COM/NC/NO 关系、`P420PW`、`NB_A+`/`NB_B-`、AOUT/BOUT 等跨板信号 |
| 7 | CPU2 传感侧电源/接口 | `BA_EN` 控制的 24V 开关、`TXD6/RXD6` 缓冲、`OUT_12V`、`SA+`、`SB-` 连接器 | 传感器供电使能、串口 6 方向、传感侧接口安全状态 |
| 8 | CPU2 电源树 | `48VIN` 输入，生成 `24V_MD`、`24V`、`12V`、`5V`、`3V3`、`9V`，含保险、TVS、DC/DC 和 LDO | 上电时序、电源检测、外设供电来源和故障排查 |
| 9 | `LTD-01-01` | 24V 到 24V/3.3V、本安 RS485、`SA+`/`SB-`、9V/24V 连接器，标注本安参数 | 无线/传感链路第一类本安接口，关注 `ISO-TXD`、`ISO-RXD`、`485_SEL` |
| 10 | `LTD-01-02` | 24V 到 9V/18V 供电，LM2576/LM317/LM258/LM293，齐纳限能网络 | 9V 输出和电源监测/开关逻辑，图中部分本安参数文本需以原图复核 |
| 11 | `LTD-01-03` 第 1 页 | `CH9141K` 2.4G 无线 UART、天线、`SN65HVD72DR` RS485 | 无线 UART 和 RS485 的 TXD/RXD/485_SEL 关系 |
| 12 | `LTD-01-03` 第 2 页 | `VIN/GND/SA+/SB-` 输入、9V/VDD 电源、`XKT-L108` 无线供电相关电路 | 无线供电线圈和 VDD 电源边界 |
| 13 | `LTD-01-04` 第 1 页 | `VIN` 到 `AVCC`、`3V3` 的电源生成，含 `AP3015`、`ADP7104`、`AP2210`、`T3168` 和 `XKT-L108` | 模拟/无线侧电源和 AVCC/3V3 保护 |
| 14 | `LTD-01-04` 第 2 页 | `CH9141K` 无线 UART、`SN65HVD72DR` RS485、`SA+`/`SB-` 接口 | 第二类无线/RS485 子板接口 |
| 15 | `LTD-01-05` | `STM32F103RET6`、`AD9832`、`ADS1247`、`AD8226`、`AD8629/AD8630`、`MAX942`、`ADG702` 等模拟采集/激励电路 | 传感器驱动、DDS 激励、ADC 采样、`AIN`、`I+`/`I-`、`A/B` 信号 |
| 16 | CPU3 第 1 页 | OLED/显示接口、按键/离散输入、HART/BPM 接口连接器和滤波 | CPU3 显示、HART/BPM 插座和面板输入信号 |
| 17 | CPU3 第 5 页 | CPU3 `STM32F429ZGT6`、FRAM、复位、SWD、调试串口、OLED/SPI/UART 网络 | CPU3 主控引脚、OLED、外部通讯口、`SEL_485`、`WDI` |
| 18 | CPU3 第 7 页 | RS485 总线、CPU2/CPU4/母板 50 针连接、串口指示灯 | CPU3 到 CPU2/CPU4 的 RS485/串口路径和母板针脚 |
| 19 | CPU3 第 2 页 | `P20MA1` 和 `485A1/485B1` 通道，继电器/TVS/PTC 保护，`TY-485` | 外部 COM 通道 1、P20MA 与 RS485 切换关系 |
| 20 | CPU3 第 6 页 | `P20MA1/P20MA2` 光耦隔离控制、`OUT1/OUT2`、TX/RX 指示 | P20MA 通道控制、光耦输入输出和调试灯 |
| 21 | CPU3 第 4 页 | `12V1` 到 `12V/5V/3V3` 电源树，含 `URB2412S`、`K7805`、`AMS1117` | CPU3 供电来源、CPU2/CPU3 3.3V 域和复位电源 |
| 22 | CPU3 第 3 页 | `P20MA2` 和 `485A2/485B2` 通道，继电器/TVS/PTC 保护，`TY-485` | 外部 COM 通道 2、P20MA 与 RS485 切换关系 |
| 23 | HART 第 1 页 | HART 板 12V 到隔离 24V/5V/3.3V，`WP420HT1+/-` 本安限能 | CPU3/HART 板供电、本安参数和 HART 外部端子 |
| 24 | HART 第 2 页 | `SD2017B` HART 调制解调，光耦隔离 RX/TX/RTS，HART 回路保护 | HART 通讯方向、RTS 控制和 `WP420HT` 回路 |
| 25 | CPU4 第 1 页 | CPU4/温度链路电源、`DSM05S`、隔离 RS485、`AB09DT` 相关接口 | CPU4 与 CPU3/CPU2、RTD/DSM 小板之间的通信和供电 |
| 26 | CPU4 第 2 页 | CPU4 50 针连接器、CPU3/CPU2 电源和 `NB_A+`/`NB_B-`，RTD 接插件 | CPU4 母板针脚、RTD 插座和电源域 |
| 27 | RTD | `MSP430FR2476`、`ADS1220IRVAR`、32.768 kHz 晶振、SBW 调试、RTD 输入 | RTD 温度采集、ADC 输入、`AIN1`、`I+`/`I-`、SBW 调试 |
| 28 | `LTD-01-09` / AB09 | AB09 本安限能小板，9V/3.3V_T 保护，标注 Uo/Io/Po/Co/Lo | 温度/通信小板限能参数复核 |
| 29 | `LTD-01-10` / AB10D | AB10D 本安限能小板，9V/3.3V_T 保护，标注 Uo/Io/Po/Co/Lo | 与 AB09 类似但 Io/Po/Lo 参数不同 |
| 30 | `LTD-01-011` / DSM05S | DSM05S 串口 TXD/RXD 限能保护，保险丝、6.8V 齐纳和 6 针连接器 | DSM05S 通讯线保护和本安参数复核 |

## 主要板卡和功能归类

| 板卡/页段 | 角色 | 关键器件或网络 |
| --- | --- | --- |
| 主控板/CPU2，页 2-8 | 测量控制、电机、4-20mA/HART、继电器、传感器接口、电源 | `STM32F429ZGT6`、`TMC5130A`、`AD5421`、`SD2017B`、`MAX6746`、`MB85RS2M`、`SN65HVD72DR`、`DRV_ENN`、`BA_EN` |
| 本安/无线/传感侧子板，页 9-15 | 无线供电、无线 UART/RS485、传感器激励和采集、本安限能 | `CH9141K`、`XKT-L108`、`XKT-335`、`STM32F103RET6`、`ADS1247`、`AD9832`、`AD8226` |
| CPU3 板，页 16-22 | 显示、外部通讯、CPU2/CPU4 桥接、P20MA/RS485 切换、电源 | `STM32F429ZGT6`、OLED SPI、`TY-485`、`P20MA1/2`、`SEL_485`、`URB2412S` |
| HART 板，页 23-24 | HART 本安接口和 HART 调制解调 | `SD2017B`、`WP420HT1+/-`、24VOUT/5VOUT/3V3-1 |
| CPU4/RTD/DSM/AB 小板，页 25-30 | 温度采集、RTD ADC、DSM 通讯限能和本安保护 | `MSP430FR2476`、`ADS1220IRVAR`、`DSM05S`、`AB09`、`AB10D` |

## 电源整理

| 电源域 | 来源/生成位置 | 主要用途 |
| --- | --- | --- |
| `48VIN` | 对外输入，经保险、浪涌保护和隔离/转换模块 | 主控板一次电源输入 |
| `24V_MD` | 主控板页 8，由 48V 转换后滤波 | 电机驱动高压侧 |
| `24V` | 主控板页 8，48V 转 24V | 传感器/外部接口/后级电源 |
| `12V` | 主控板页 8、CPU3 页 21、HART 页 23 | HART、BPM、CPU3 后级和部分模拟/隔离模块 |
| `9V` | 主控板页 8、LTD-01-02 页 10、CPU4 页 25 | 继电器、无线/本安小板、CPU4/AB09DT 相关链路 |
| `5V` | 主控板页 8、CPU3 页 21、HART 页 23 | 模拟、隔离电源、CPU3/子板后级 |
| `3V3` | 主控板、CPU3、LTD 子板和 RTD 板多处 LDO 生成 | MCU、FRAM、OLED、RS485、无线 UART 和 ADC 数字侧 |
| `AVCC`/`AGND` | LTD-01-04、RTD 板局部生成 | 模拟采集、ADC 和传感器激励 |

## 通讯和接口整理

| 接口 | 相关页 | 硬件路径 | 固件关注 |
| --- | --- | --- | --- |
| CPU2 到 CPU3 内部通讯 | 页 1、5、18 | 主控板隔离 RS485，CPU3 母板连接器 | CPU2/CPU3 Modbus RTU、方向控制、超时和错误分类 |
| CPU3 外部 RS485 | 页 18、19、22 | `TY-485`、继电器切换、TVS/PTC 保护 | COM1/COM2/COM3 协议适配和 P20MA/485 切换 |
| CPU4 温度通讯 | 页 1、25、26、27 | CPU4 连接器、RTD 板、DSM/AB 小板 | 温度数据采集、瓦锡兰温度计接口、DSM 通讯 |
| HART | 页 4、23、24 | CPU2 主控板 HART/4-20mA 与 CPU3/HART 本安板均有相关电路 | HART RTS/TX/RX、4-20mA 回路和本安接口需按实际接线区分 |
| 无线 UART/无线 RS485 | 页 9、11、14 | `CH9141K`、`SN65HVD72DR`、`SA+`/`SB-` | 无线从机通讯、传感器驱动板链路、串口方向 |
| RTD | 页 26、27 | CPU4 到 RTD 板，`MSP430FR2476` + `ADS1220` | 温度采集、ADC 配置、SBW 调试接口 |
| 4-20mA/P20MA | 页 4、6、19、20、22 | `AD5421` 和 CPU3 P20MA1/2 相关电路 | 输出模式、通道选择和外部回路保护 |

## 本安和安全边界

图纸中多处以红色虚线或绿色隔离线表达本安边界，重点位置如下：

| 位置 | 相关页 | 说明 |
| --- | --- | --- |
| 主控板右侧无线/传感器区域 | 页 1 | 无线供电主机、无线线圈、传感器驱动板、传感器和无线从机均在“本安部分”框内 |
| CPU3 HART 区域 | 页 1、23、24 | HART 安全栅和本安 HART 接口 |
| CPU4 温度采集区域 | 页 1、25-30 | 电源安全栅、信号安全栅、RTD 和 DSM/AB 限能小板 |
| LTD/AB/DSM 小板 | 页 9-14、28-30 | 多处使用保险丝、齐纳管、限流电阻和隔离器件标注 Uo/Io/Po/Co/Lo |

已能从图中辨认的本安参数示例：

| 图纸页 | 标注对象 | Uo | Io | Po | Co | Lo |
| --- | --- | --- | --- | --- | --- | --- |
| 9 | `LTD-01-01` | 7.14 V | 16.4 mA | 29.3 mW | 150 uF | 100 mH |
| 23 | HART | 27.3 V | 0.1 A | 0.69 W | 0.06 uF | 5.5 mH |
| 28 | AB09 | 10.7 V | 180.3 mA | 2.38 W | 22 uF | 2 mH |
| 29 | AB10D | 10.7 V | 0.36 A | 0.96 W | 22 uF | 0.1 mH |
| 30 | DSM05S | 7.14 V | 16.4 mA | 29.3 mW | 150 uF | 100 mH |

注意：页 10 的参数文本在渲染图中存在字符叠加，正式引用前应回到原 PDF 或硬件设计源文件复核。

## 和当前固件工程的关联

| 固件工程 | 硬件依据 | 需要重点对照的代码方向 |
| --- | --- | --- |
| `LTD_MAIN_CPU2` | 页 2-8 的 CPU2 主控板、电机、传感器、4-20mA/HART、RS485 和继电器 | TMC5130 驱动、测量状态机、传感器供电使能、4-20mA/HART、内部 Modbus、错误检测 |
| `LTD_DISPLAY_CPU3` | 页 16-22 的 CPU3 主控、OLED、外部 RS485/P20MA、CPU2/CPU4 通讯 | 屏幕显示、COM1/COM2/COM3 协议适配、CPU2 轮询、P20MA/RS485 模式切换 |
| 温度/RTD 相关逻辑 | 页 25-30 的 CPU4、RTD、DSM05S、AB09/AB10D | 瓦锡兰温度计接口、RTD 数据来源、DSM 通讯和本安侧状态限制 |

建议后续开发或排故时按以下顺序使用本文：

1. 先从“逐页目录”找到目标硬件页码。
2. 再从“通讯和接口整理”确认信号属于 CPU2、CPU3、CPU4 还是本安小板。
3. 最后打开原始 PDF 核对具体网络名、器件位号和连接器针脚。

## 待确认项

| 项目 | 说明 |
| --- | --- |
| 部分页标题缺失 | 页 2-8 的图纸标题栏主要给出页号，具体功能名由器件和网络名推断 |
| `P20MA`、`BPM`、`WP420HT` 等命名 | 已按图纸网络名记录，业务含义需结合硬件工程师或 BOM 确认 |
| HART 路径 | 主控板和 HART 小板均有 HART 相关电路，实际部署中哪个作为主通道需要结合接线和固件配置确认 |
| 本安参数 | 本文只摘录清晰可见的 Uo/Io/Po/Co/Lo，不能作为认证依据 |
| CPU4 温度链路 | 图纸显示 CPU4/RTD/DSM/AB 小板组合，固件是否已完整接入需要结合当前代码和现场需求再核对 |
