duanxuebin1998/cube/docs/03_问题分析与整改/2026-06-16_AD5421控制寄存器回读FFFF问题分析与现场验证.md

# AD5421 控制寄存器回读 0xFFFF 问题分析与现场验证

更新日期：2026-06-16

## 1. 问题摘要

CPU2 开启 AO 输出后，AD5421 初始化失败，最终错误码为 `0x00130009`，CPU3 侧显示为报警 `19-9`。

错误含义：

| 字段 | 值 | 含义 |
| --- | --- | --- |
| 完整错误码 | `0x00130009` | AD5421 控制寄存器回读失败 |
| 高 16 位 | `0x0013`，十进制 19 | 模块/错误族显示为 19 |
| 低 16 位 | `0x0009`，十进制 9 | AD5421 控制回读失败 |
| 触发动作 | AO 使能后初始化 AD5421 | 写控制寄存器后回读校验 |
| 当前处理 | 停止测量/置错误状态 | 防止 AO 初始化异常后继续默认测量 |

补充现场信息：之前电流值能够正常下发并设置。若该现象指的是同一硬件上实测 4-20mA 输出会随设定值变化，则不能优先判断为整条 SPI 写入链路断开，也不能简单判断为 AD5421 完全未工作。当前问题更应优先看成“写入方向可能可用，但控制寄存器读回方向异常”。

现场串口关键日志：

```text
AD5421 PB4/MISO probe: nopull=1 pulldown=1 pullup=1
AD5421 diag pins: cs=1 miso=1 fault=1
AD5421 diag mode=0 pol=0 pha=0 w=0x00000000 direct=0xFFFF rx=FF FF FF cmd1=0xFFFF rx=FF FF two=0xFFFF rx=FF FF FF ret=0x00000000
AD5421 diag mode=1 pol=0 pha=1 w=0x00000000 direct=0xFFFF rx=FF FF FF cmd1=0xFFFF rx=FF FF two=0xFFFF rx=FF FF FF ret=0x00000000
AD5421 diag mode=2 pol=2 pha=0 w=0x00000000 direct=0xFFFF rx=FF FF FF cmd1=0xFFFF rx=FF FF two=0xFFFF rx=FF FF FF ret=0x00000000
AD5421 diag mode=3 pol=2 pha=1 w=0x00000000 direct=0xFFFF rx=FF FF FF cmd1=0xFFFF rx=FF FF two=0xFFFF rx=FF FF FF ret=0x00000000
AD5421 control readback mismatch: write=0x1000 read=0xFFFF rx=FF FF FF
```

当前结论：软件 SPI 模式、速度和读帧格式基本已排除。结合历史上电流值能够正常下发并设置的信息，更可能是 AD5421 SDO 到 CPU2 PB4 的回读链路一直处于高电平，或当前初始化/回读校验时序和历史写电流路径存在差异。排查重点应从“整条 AD5421 通信链路不通”收敛到“读回方向、读回时序、U9 回读通道、当前上电/AO 使能状态差异”。

## 2. 触发路径

AO 使能打开后，CPU2 会进入 AD5421 初始化流程：

1. `AoOutput_EnsureInitialized()` 或 AO 输出刷新路径触发 `Ad5421Init()`。
2. `Ad5421Init()` 复位 AD5421。
3. `WriteControlRegister(CUR_SPIOFF_COMMAND)` 写入控制寄存器。
4. 写入值为 `0x1000`，含义是关闭 AD5421 SPI 看门狗。
5. 随后读取 `READCONTROL` 做回读校验。
6. 当前读回值始终为 `0xFFFF`，和写入的 `0x1000` 不一致。
7. 驱动返回 `AD5421_READBACK_ERROR`，上层转为 `0x00130009`。

相关源码位置：

| 文件 | 说明 |
| --- | --- |
| `LTD_MAIN_CPU2/BSP/Peripherals/src/ad5421.c` | AD5421 SPI 写入、读取、初始化和诊断打印 |
| `LTD_MAIN_CPU2/BSP/Peripherals/inc/ad5421.h` | AD5421 寄存器命令和故障标志定义 |
| `LTD_MAIN_CPU2/Services/AoOutput/ao_output.c` | AO 使能后初始化和运行态维护 |
| `LTD_MAIN_CPU2/Application/Src/app_main.c` | 全局错误进入错误状态 |

## 3. 已做的软件侧验证

### 3.1 SPI 原始接收字节

最初只打印 `read=0xFFFF`，后续增加原始 SPI 接收字节：

```text
AD5421 control readback mismatch: write=0x1000 read=0xFFFF rx=FF FF FF
```

说明不是解析高低字节顺序导致的误判，而是整个 SPI 接收帧三个字节全为 `0xFF`。

### 3.2 PB4/MISO 普通 GPIO 探测

临时诊断把 PB4 先从 SPI3_MISO 切为普通输入，分别配置无上下拉、内部下拉、内部上拉：

```text
AD5421 PB4/MISO probe: nopull=1 pulldown=1 pullup=1
```

该结果说明 PB4 输入在内部下拉时仍然读高。考虑到 PB4 前级接了数字隔离器 U9，这个结果不能直接等价于 PB4 对 3.3V 短路，更准确的解释是：U9 的 MCU 侧输出正在把 PB4 驱动为高，或 PB4 线上存在比 MCU 内部下拉更强的外部高电平驱动。

### 3.3 SPI 模式矩阵

临时诊断遍历 4 种 CPOL/CPHA，并把 SPI3 降速到 `SPI_BAUDRATEPRESCALER_256`。四种组合全部读回 `0xFFFF`：

| mode | CPOL | CPHA | 直接 3 字节读 | 1 字节命令 + 2 字节读 | 两帧读 |
| --- | --- | --- | --- | --- | --- |
| 0 | LOW | 1EDGE | `0xFFFF` | `0xFFFF` | `0xFFFF` |
| 1 | LOW | 2EDGE | `0xFFFF` | `0xFFFF` | `0xFFFF` |
| 2 | HIGH | 1EDGE | `0xFFFF` | `0xFFFF` | `0xFFFF` |
| 3 | HIGH | 2EDGE | `0xFFFF` | `0xFFFF` | `0xFFFF` |

这基本排除 SPI 极性、相位和速度造成的读取失败。

### 3.4 读帧格式对比

已测试三种读法：

| 读法 | 说明 | 结果 |
| --- | --- | --- |
| 直接 3 字节 `TransmitReceive` | `82 00 00` 同一帧读回 | `FF FF FF` |
| 1 字节读命令 + 2 字节空读 | CS 保持低，先发命令再读 2 字节 | `FF FF` |
| 两帧读 | 先发读命令帧，再发 dummy 帧读回 | `FF FF FF` |

三种读法都为全 `FF`，所以问题不集中在软件读帧格式。

### 3.5 CS 默认电平

GPIO 初始化已临时调整为 AD5421 CS 默认高电平，避免上电后 CS 长时间低电平：

```text
AD5421 diag pins: cs=1 miso=1 fault=1
```

CS 空闲状态符合低有效片选器件的一般要求，但回读仍然失败。

### 3.6 历史正常输出信息

现场补充信息显示：之前电流值能够正常下发并设置。该信息对判断有明显约束：

| 约束点 | 对根因排序的影响 |
| --- | --- |
| 若同一硬件曾经实测电流输出随设定值变化 | `SYNC/SCLK/SDIN` 前向写入链路、AD5421 输出回路和基本供电不应被优先判为永久断开 |
| 当前只在控制寄存器回读处失败 | 更像是 `SDO -> U9 -> PB4` 回读方向异常，或新增/当前回读校验暴露了原来未检查的问题 |
| 若“正常下发并设置”只是上位机命令被接受 | 仍需要现场实测 `P420+`/`P420-` 电流，不能把命令接受等同于 AD5421 输出正常 |
| 若当前硬件、接线、固件版本或 AO 使能时序已经变化 | 仍需重新确认供电、回路、CS 上电状态和 AD5421 初始化时序 |

因此，后续验证应优先区分“写能生效但读不回来”和“当前写也已经不生效”这两种情况。

## 4. 原理图对照

原理图依据：

| 资料 | 位置 |
| --- | --- |
| 原始 PDF | `docs/07_硬件原理图/00_原始资料/储罐自动计量仪原理图汇总.pdf` 第 4 页 |
| 整理文档 | `docs/07_硬件原理图/储罐自动计量仪原理图汇总整理.md` |
| 对照问题清单 | `docs/07_硬件原理图/原理图与固件对照问题清单.md` |

### 4.1 MCU 到 AD5421 的 SPI 链路

原理图第 4 页显示 CPU2 SPI3 先经过 U9 数字隔离器，再到 AD5421：

| CPU2 MCU 侧 | U9 MCU 侧 | U9 AD5421 侧 | AD5421 侧 | 方向 |
| --- | --- | --- | --- | --- |
| `PB6/SPI3_CS` | U9 `VIA` pin3 | U9 `VOA` pin14 | `SPI1_NSS1` -> AD5421 `SYNC` | CPU2 -> AD5421 |
| `PB3/SPI3_SCK` | U9 `VIB` pin4 | U9 `VOB` pin13 | `SPI1_SCLK1` -> AD5421 `SCLK` | CPU2 -> AD5421 |
| `PB5/SPI3_MOSI` | U9 `VIC` pin5 | U9 `VOC` pin12 | `SPI1_SDI1` -> AD5421 `SDIN` | CPU2 -> AD5421 |
| AD5421 `SDO` | U9 `VID` pin11 | U9 `VOD` pin6 | `SPI3_MISO` -> `PB4` | AD5421 -> CPU2 |

结论：从原理图看，PB4/PB5 物理方向没有接反。PB4 是 MISO，PB5 是 MOSI。

### 4.2 容易误导的命名问题

固件工程存在标签和宏名错误：

| 实际引脚 | 实际功能 | 当前标签/宏名问题 |
| --- | --- | --- |
| PB4 | `SPI3_MISO` | CubeMX 标签为 `AD5421_SPI3_MOSI`，宏名也是 `AD5421_SPI3_MOSI_Pin` |
| PB5 | `SPI3_MOSI` | 标签也为 `AD5421_SPI3_MOSI`，生成 `AD5421_SPI3_MOSIB5_Pin` |

这个问题不一定影响 HAL SPI 复用，因为 `.ioc` 的 Signal 仍然是 PB4=`SPI3_MISO`、PB5=`SPI3_MOSI`；但会严重影响现场核线、临时 GPIO 探测和后续维护。

### 4.3 FAULT 引脚疑点

固件中 PB8 配置为 `AD5421_FAULT` 输入。原理图 MCU 页能看到 `FAULT` 网络在 PB8 附近，但 AD5421 页上 AD5421 `FAULT` 脚附近没有清晰看到它通过 U9 或跨页网络回到 PB8。

当前判断：

- 这不是导致 SPI 回读全 `FF` 的直接原因。
- 但它说明 AD5421 硬件故障诊断闭环可能和固件假设不一致。
- 现场应确认 AD5421 `FAULT` 脚是否实际接到 PB8，还是 PB8 的 `FAULT` 来自别的网络或未装配链路。

### 4.4 LDAC 引脚疑点

原理图中 AD5421 `LDAC` 脚看起来没有明显连接。若 LDAC 确实悬空，可能影响 DAC 输出更新行为。该点不太像导致 SPI SDO 全 `FF` 的主因，但会影响后续“写入是否能产生电流输出”的验证。

现场应确认：

- LDAC 是否在 PCB 上有隐藏网络、默认焊接或器件内部处理。
- 若无连接，是否需要固定到明确电平。

## 5. 关键判断

当前最关键的证据是：

```text
PB4/MISO probe: nopull=1 pulldown=1 pullup=1
rx=FF FF FF
历史上电流值能够正常下发并设置
```

由于 PB4 不是直接接 AD5421 SDO，而是通过 U9 隔离器接收，所以应把问题优先定位为“AD5421 SDO -> U9 -> PB4 回读通道一直为高”。历史上电流输出能设置，则进一步降低了“前向写入链路永久断开”的优先级。

优先级最高的可能原因：

1. AD5421 `SDO -> U9 -> PB4` 回读方向被固定为高，导致所有读回字节都是 `FF`。
2. U9 回读方向通道供电、焊接或器件状态异常，AD5421 侧 SDO 有数据但 MCU 侧 PB4 仍为高。
3. AD5421 在当前初始化/回读校验时序下没有驱动 SDO，但历史写电流路径可能仍曾经可用。
4. 新增或当前启用的控制寄存器回读校验暴露了原来未检查的读回问题，旧流程可能只写 DAC 而没有强制读回确认。
5. 当前上电、AO 使能、CS 默认电平或复位时序和历史正常设置电流时不同，导致 AD5421 当前没有进入可读状态。
6. AD5421 所在 PVDD/COM/VLOOP/REGOUT/DVDD 条件在当前现场状态下异常，历史正常不代表当前仍正常。
7. AD5421 SDO 到 U9 pin11 断线、虚焊、连锡或网络接错。
8. 只有在示波器确认 `SYNC/SCLK/SDIN` 到不了 AD5421 后，才把前向写入链路断开作为高优先级原因。

相对低优先级的软件原因：

| 软件原因 | 当前判断 |
| --- | --- |
| SPI CPOL/CPHA 错误 | 已遍历 4 种模式，仍全 `FF` |
| SPI 速度过快 | 已降速，仍全 `FF` |
| 读帧格式错误 | 已测三种读法，仍全 `FF` |
| 字节序解析错误 | 原始字节全 `FF`，不是解析问题 |
| CS 空闲电平不对 | 已改为默认高，仍失败 |

## 6. 现场验证步骤

### 6.1 优先使用逻辑分析仪或示波器

建议同时抓 4 根 SPI 线，并尽量在 U9 两侧都测：

| 信号 | MCU 侧 | AD5421 侧 | 期望现象 |
| --- | --- | --- | --- |
| CS/SYNC | PB6、U9 pin3 | U9 pin14、AD5421 SYNC | 访问时拉低，空闲高 |
| SCLK | PB3、U9 pin4 | U9 pin13、AD5421 SCLK | 访问时有时钟 |
| MOSI/SDIN | PB5、U9 pin5 | U9 pin12、AD5421 SDIN | 写控制寄存器时有 `02 10 00`，读时有 `82` |
| MISO/SDO | AD5421 SDO、U9 pin11 | U9 pin6、PB4 | 不应一直高，应在读回阶段有数据变化 |

判断分支：

| 观测结果 | 判断方向 |
| --- | --- |
| 写电流帧能改变实际输出，但读回帧 MISO 全高 | 写入链路基本成立，重点查读回链路、读回命令/时序和 U9 回读方向 |
| PB6/PB3/PB5 有波形，但 U9 另一侧没有 | 查 U9 输入方向通道、U9 供电、焊接 |
| U9 到 AD5421 的 SYNC/SCLK/SDIN 正常，AD5421 SDO 一直高 | 查 AD5421 供电、回路、外围脚、焊接或芯片 |
| AD5421 SDO 有波形，U9 pin6/PB4 一直高 | 查 U9 回读方向通道、U9 供电或 PB4 网络 |
| PB4 有数据波形但软件仍读 `0xFFFF` | 再回到 SPI 模式、采样边沿和软件读法 |

### 6.2 电源和参考点测量

在 AO 使能、AD5421 初始化期间测：

| 测点 | 目的 |
| --- | --- |
| U9 左侧 `3V3/GND` | 确认 MCU 侧隔离器供电正常 |
| U9 右侧 `PVDD/COM` | 确认 AD5421 侧隔离器供电正常 |
| AD5421 `DVDD/IOVDD` | 确认数字接口电源正常 |
| AD5421 `REGOUT/REGIN` | 确认内部调节相关脚状态正常 |
| AD5421 `VLOOP/LOOP-/COM` | 确认回路供电和输出回路条件 |
| `P420+`/`P420-` 外部端子 | 确认现场电流环连接和负载条件 |

### 6.3 断电电阻/连通性检查

断电后检查：

| 检查项 | 预期 |
| --- | --- |
| PB4 到 U9 pin6 | 应连通 |
| U9 pin11 到 AD5421 SDO | 应连通 |
| PB5 到 U9 pin5，再到 U9 pin12/AD5421 SDIN | 路径应符合原理图 |
| PB3 到 U9 pin4，再到 U9 pin13/AD5421 SCLK | 路径应符合原理图 |
| PB6 到 U9 pin3，再到 U9 pin14/AD5421 SYNC | 路径应符合原理图 |
| PB4 对 3V3/COM/GND 的阻值 | 不应异常低阻短路 |
| AD5421 SDO 对 PVDD/COM 的阻值 | 不应异常低阻短路 |

### 6.4 FAULT 和 LDAC 补充确认

| 项目 | 验证目的 |
| --- | --- |
| AD5421 FAULT 是否接 PB8 | 确认固件 `AD5421_FAULT` 是否真实有效 |
| PB8 的 `fault=1` 是否来自 AD5421 | 避免误把悬空或其它网络当成 AD5421 非故障 |
| LDAC 是否固定电平 | 避免后续电流输出写入不更新 |
| `REG_SEL0/1/2`、`Rext1/2` 实装 | 确认量程/调节相关外围符合设计 |

## 7. 建议的排查顺序

1. 先确认“之前电流值能够正常下发并设置”是实测电流输出变化，还是仅上位机/CPU2 接受了设定值。
2. 若是实测输出曾正常，优先做一次受控对比：写电流设定帧是否仍能让 `P420+`/`P420-` 输出变化。
3. 如果写电流仍能生效，但控制寄存器读回全 `FF`，优先查 AD5421 `SDO -> U9 -> PB4` 回读链路。
4. 如果当前写电流也不再生效，再用示波器确认 PB6/PB3/PB5 在 MCU 侧有波形。
5. 再确认 U9 输出到 AD5421 侧的 `SPI1_NSS1/SCLK1/SDI1` 有对应波形。
6. 测 AD5421 SDO 和 U9 pin11 是否有变化。
7. 如果 AD5421 SDO 一直高，优先查 AD5421 当前供电、回路、复位/CS 时序和焊接。
8. 如果 AD5421 SDO 有变化但 PB4 一直高，优先查 U9 回读通道。
9. 确认 FAULT 和 LDAC 是否和固件假设一致。
10. 若硬件波形恢复正常，再移除临时诊断代码，保留必要的错误打印和 CS 默认高修正。

## 8. 当前临时软件改动说明

当前用于诊断的临时改动包括：

| 文件 | 改动 |
| --- | --- |
| `LTD_MAIN_CPU2/Core/Src/gpio.c` | AD5421 CS 初始电平改为高，HART_RTS 仍保持低 |
| `LTD_MAIN_CPU2/BSP/Peripherals/src/ad5421.c` | 增加 PB4/MISO GPIO 上下拉探测 |
| `LTD_MAIN_CPU2/BSP/Peripherals/src/ad5421.c` | 打印原始 SPI 接收字节 |
| `LTD_MAIN_CPU2/BSP/Peripherals/src/ad5421.c` | 增加 SPI 模式矩阵、降速和多读法诊断 |

这些改动用于现场定位，不建议作为最终长期版本全部保留。建议最终保留：

- CS 默认高电平。
- AD5421 初始化失败时打印 `write/read/rx` 原始字节。
- 有节流的 AO 错误记录和运行态上报。

建议最终移除：

- 每次启动的 SPI 模式矩阵测试。
- PB4 临时 GPIO 上下拉探测。
- 影响启动时间或改变 SPI 配置的临时诊断函数。

## 9. 整改建议

### 9.1 硬件和原理图

1. 确认 U9 型号、方向、供电和默认输出状态。
2. 确认 AD5421 SDO 到 U9 pin11、U9 pin6 到 PB4 的实际 PCB 网络。
3. 补充或修正 AD5421 FAULT 到 PB8 的原理图连接说明。
4. 确认 LDAC 是否固定到有效电平，避免悬空。
5. 确认 AD5421 回路供电条件和外部 4-20mA 负载要求。

### 9.2 固件

1. 修正 CubeMX 标签：PB4 使用 `AD5421_SPI3_MISO`，PB5 使用 `AD5421_SPI3_MOSI`。
2. 更新生成后的宏名引用，避免 `AD5421_SPI3_MOSI_Pin` 实际指向 PB4。
3. 保留 AD5421 回读失败时的原始字节打印，便于现场区分全 `FF`、全 `00` 和随机数据。
4. 若 FAULT 线确认有效，将 PB8 和 `READFAULT` 合并为 AO 诊断状态。
5. 若 FAULT 线确认无效，应从固件和文档中明确标注 PB8 诊断不可用，避免误报。

## 10. 当前结论

本次问题不是典型的软件 SPI 配置错误，也不应在已有“历史上电流值能够正常下发并设置”的前提下直接判断为完整 AD5421 写入链路断开。已验证的现象说明 CPU2 从 AD5421 回读路径收到的始终是高电平。原理图显示该路径经过 U9 数字隔离器，因此现场排查应集中在：

- 历史正常设置电流是否为实测输出正常，当前写电流是否仍能生效。
- AD5421 是否在当前 AO 使能和初始化时序下进入可读状态。
- U9 两侧供电和回读隔离方向是否正常。
- AD5421 SDO 到 U9，再到 PB4 的回读链路是否断线、焊接异常或被固定高电平。
- 原理图中 FAULT/LDAC 等辅助脚是否和固件假设一致。

在 U9 两侧波形和“写能否生效”没有确认前，不建议继续反复调整 SPI 模式或读帧格式，也不建议把读回校验直接长期屏蔽。
