duanxuebin1998/cube/docs/00_构建与版本/版本改动与测试/2026-09-24_CPU2_V1.45.1.0_无线状态格式异常重试_改动与测试方案.md

# CPU2 V1.45.1.0 无线状态格式异常重试改动与测试方案

## 1. 版本与兼容性

- CPU2：`V1.45.0.0 -> V1.45.1.0`（PATCH）。
- CPU3：保持 `V1.44.0.0`，本次无 CPU3 源码和固件行为变化。
- `DEVICE_PROTOCOL_VERSION` 保持 38；CPU2/CPU3 共享命令、寄存器、状态、错误码数值和字段语义不变，不需要新增交叉版本兼容逻辑。
- CPU2 `DEVICE_PARAM_VERSION` 为 `3 -> 3`，CPU3 `CPU3_PARAM_VERSION` 为 `0x0007 -> 0x0007`。`DeviceParameters` / `struct_size` 为 `682 -> 682` 字节，字段偏移、CRC 范围和 FRAM 布局均未修改，升级不恢复出厂、不清除或迁移现场参数。
- 本次只改变 CPU2 读取部件参数期间的无线状态诊断恢复；扫描、连接、保存默认连接、模块复位等有副作用流程仍按原逻辑单次执行。

## 2. 提交范围

- CPU2 源码：`LTD_MAIN_CPU2/Services/Sensor/Wireless/wireless_pairing.c`、`LTD_MAIN_CPU2/Application/Src/diagnostics/part_diagnostics.c`、CPU2 版本头。
- 正式资料：`CHANGELOG.md`、售后版本升级记录、本方案、问题整改记录及两级问题索引。
- 本机同步但不提交：`tools/check_wireless_rssi_contract.py`、`docs/00_程序流程导航/CPU2/09_传感器与无线通信.html` 及导航生成资料。
- 本次不纳入工作区已有的历史 PDF 删除；不修改 CPU3、共享协议资料、参数存储升级清单、`ch9141_at.c/.h` 和错误码定义。

## 3. 详细改动

### 3.1 格式异常按完整只读事务重试

- 源码位置：`wireless_pairing.c` 的 `WirelessPairing_UpdateConnectionStatusSnapshot()`；调用链为 `PartDiagnostics_ReadAllInternal -> PartDiagnostics_UpdateWirelessRssi -> WirelessPairing_UpdateConnectionStatusSnapshot -> WirelessPairing_ReadConnectionStatus`。
- 改前问题：`BLEMODE`、`BLESTA`、`CCADD` 或异步 RSSI 任一格式异常都会在第一次查询后返回 `WIRELESS_RESP_FORMAT_ERROR`，周期刷新随后进入最终故障并停止测量。
- 具体改法：增加 `WIRELESS_STATUS_QUERY_MAX_ATTEMPTS=3` 和 `WIRELESS_STATUS_QUERY_RETRY_DELAY_MS=300`；仅当执行返回值为格式错误，或执行安全完成但快照错误码为格式错误时，记录重试并在可被命令切换取消的 300 ms 等待后重做整个读取函数。
- 必查边界：首次成功、第二/三次恢复、明确未连接、非格式执行错误、重试等待期间命令切换、计数上限；不在同一 AT 会话中重发当前命令。
- 通过标准：格式异常最多调用 3 次完整事务；每次尝试均经既有路径关闭 RSSI、退出 AT 并完成透明交接；非格式结果和不安全执行错误不进入下一次查询。

### 3.2 连续格式异常安全降级

- 源码位置：`wireless_pairing.c` 的重试耗尽出口及 `WirelessPairing_ResetConnectionStatus()`。
- 改前问题：单次格式异常既停止整条部件参数刷新，又可能被上层描述成 UART6 透明交接失败，无法区分诊断内容无效与共享串口不安全。
- 具体改法：连续 3 次格式异常且每轮执行返回仍证明收尾安全时，清空连接、MAC、RSSI 等有效标志，保留 `WIRELESS_RESP_FORMAT_ERROR`，发布无效快照、记录告警并返回 `NO_ERROR`；其它部件诊断继续刷新。
- 必查边界：三次快照不能混合前次字段；明确未连接不按格式异常重试；清理、退出 AT、透明交接及等待错误均原样返回，不允许降级掩盖。
- 通过标准：安全耗尽后 CPU3 只看到同一代无效无线快照，上层不进入最终故障；任何无法证明 UART6 安全的错误仍阻断后续访问。

### 3.3 上层失败日志收口

- 源码位置：`part_diagnostics.c` 的 `PartDiagnostics_ReadAllInternal()`。
- 改前问题：所有无线状态刷新非零返回统一打印“蓝牙状态刷新失败，UART6透明传输未确认”，即使错误只是内容格式异常且透明交接已经成功。
- 具体改法：安全格式异常由快照层内部重试或降级并返回成功；上层非零路径改写为“无线状态查询收尾失败”，只描述真正传播到调用方的执行、清理或交接错误。
- 必查边界：`STATE_SWITCH` 仍正常退出、不打印最终故障；安全降级不进入该日志；其它非零返回继续阻断。
- 通过标准：格式异常不会被误报为交接失败，真实不安全错误仍保留具体错误码并停止后续 UART6 访问。

## 4. 数据流与异常闭环

```text
每 5 秒无线状态刷新
  -> 完整读取 BLEMODE/BLESTA/CCADD/RSSI
  -> RSSI OFF、AT EXIT、UART6 透明交接
  -> 成功或明确业务状态：发布快照并返回
  -> 非格式执行/收尾错误：发布本次状态并立即返回错误
  -> 格式错误且收尾安全：等待 300 ms 后重做完整事务，最多 3 次
  -> 三次均为格式错误且收尾安全：发布统一无效快照、告警、继续其它部件诊断
  -> 等待期间命令切换：返回 STATE_SWITCH，不进入最终故障
```

## 5. 测试矩阵

| 编号 | 关联改动 | 前置条件 | 操作与观测位置 | 预期结果与通过标准 | 状态 |
| --- | --- | --- | --- | --- | --- |
| WLS-01 | 3.1 | 最终源码 | 运行无线契约检查并核对循环、次数和延时 | 只对格式错误执行最多 3 次完整事务，间隔 300 ms | 已通过 |
| WLS-02 | 3.2 | 最终源码 | 核对重试耗尽出口和快照发布 | 所有有效标志清零，错误码为格式异常，记录告警并返回成功 | 已通过 |
| WLS-03 | 3.1、3.2 | 最终源码 | 核对非格式错误、`STATE_SWITCH` 和延时错误出口 | 命令切换正常退出；其它不安全错误立即返回且不重试 | 已通过 |
| WLS-04 | 3.3 | 最终源码 | 检查部件诊断上层日志和返回路径 | 仅非零收尾/交接错误打印停止访问；格式安全降级不进入该日志 | 已通过 |
| WLS-05 | 全部 | CPU2 ARM 工具链 | `--fresh` 配置、clean、Debug 全量构建 | 134 个目标完成，无编译或链接错误，产物名包含 V1.45.1.0 | 已通过 |
| WLS-06 | 3.1 | CPU2、CH9141K 和 UART6 故障注入 | 分别向 BLEMODE、BLESTA、CCADD 和 RSSI 注入一次坏帧，第二次返回正常 | 第一轮完整收尾，第二轮成功并记录恢复，不进入最终故障 | 待台架 |
| WLS-07 | 3.2 | 同上 | 连续三轮返回格式错误，每轮允许安全退出 | 发布无线无效快照并告警，其它部件参数继续刷新 | 待台架 |
| WLS-08 | 3.2 | 同上 | 在格式异常后制造 RSSI OFF、AT EXIT 或透明交接失败 | 不开始下一轮，返回具体错误并停止后续 UART6 访问 | 待台架 |
| WLS-09 | 3.1 | 可切换命令 | 在 300 ms 重试等待中下发新命令 | 返回 `STATE_SWITCH`，不进入最终故障，不遗留 AT/RSSI 状态 | 待台架 |
| WLS-10 | 全部 | DSM/V3/V4 与抓包工具 | 重试后立即继续其它传感器访问，并运行读取部件参数 24 小时 | 无 RSSI 尾包污染、owner 冲突或额外停机 | 待台架/长期 |

## 6. 已执行验证

- 2026-09-24 CPU2 `V1.45.1.0` Debug clean-first 构建通过：重新配置、清理并完成 134 个目标；`text=370404`、`data=2360`、`bss=60672`。
- `LTD_MAIN_CPU2_DEBUG.hex` 与 `LTD_MAIN_CPU2_V1.45.1.0_DEBUG.hex` 均为 1048590 字节，SHA-256 均为 `1D5E971E2EE754055A6CBE73B1FB7306CF0FB24FC21212A5E2F69A64EF111883`；BIN 为 372788 字节，SHA-256 为 `04C57F29321FB7E10819EF85FDF5AB3498DEAEF1FC7326F21CC542D6F4C3E166`。
- `py tools/check_wireless_rssi_contract.py`、`py tools/check_si_protocol_contract.py`、CP936 严格往返、流程导航检查和程序流程 HTML 契约检查通过。
- 售后工作簿新增 CPU2 V1.45.1.0 / CPU3 V1.44.0.0 记录后重新导入成功，无公式错误；“版本改动”页渲染检查确认新增行内容完整可见。

## 7. 回归范围

- 读取部件参数首次进入和 1 秒长驻刷新、5 秒无线状态节流、命令切换和最终故障入口。
- CH9141K 进入 AT、BLEMODE/BLESTA/CCADD/RSSI 读取、RSSI OFF、AT EXIT、强制恢复和 UART6 owner 交接。
- 无线扫描、按 RSSI/名称配对、连接保存和复位，确认未继承本次自动重试。
- DSM、V3、V4 后续串口访问，确认无线查询没有遗留异步文本或错误 owner 状态。
- CPU3 无线连接、MAC、RSSI 和错误码显示，确认无效快照不混用旧字段。

## 8. 风险与未验证项

- 尚未获得现场异常前完整 AT 日志和 UART6 抓包，代码修复降低瞬态格式错误影响，但不能证明现场原始坏帧来源已消除。
- 目标板短帧、粘包、丢 ACK、异步 RSSI 延迟/残留、UART FE/NE/ORE、清理/退出失败和命令切换均未注入验证。
- 尚未验证 DSM/V3/V4 与无线重试的串口互不污染，以及读取部件参数 24 小时长期稳定性。
- Debug 构建和静态契约只能证明当前源码可编译及策略结构符合约束，不能替代真实 CH9141K、传感器、RS485 和现场运行证据。

## 9. 提交前检查清单

- [x] CPU2 版本头为 `V1.45.1.0`，CPU3 保持 `V1.44.0.0`。
- [x] `DEVICE_PROTOCOL_VERSION=38`，参数存储版本、结构大小和 FRAM 布局不变。
- [x] `CHANGELOG.md`、售后版本记录、问题整改记录、索引和本方案已同步。
- [x] 最终版本执行 CPU2 Debug clean-first 构建并记录产物大小和哈希。
- [x] 无线契约、共享协议、编码、流程 HTML 和工作簿检查已执行。
- [x] `git diff --check`、文档检查、暂存范围和版本门禁已通过。
- [ ] 提交消息与提交后范围检查在提交阶段执行。
- [x] 本文件随本次提交纳入；提交哈希以 Git 记录为准。
