duanxuebin1998/cube/docs/00_构建与版本/版本改动与测试/2026-09-24_CPU2_V1.44.2.0_继电器参数对齐修复_改动与测试方案.md

# CPU2 V1.44.2.0 继电器参数对齐修复改动与测试方案

## 1. 版本与兼容性

- CPU2：`V1.44.1.0 -> V1.44.2.0`（PATCH）。
- CPU3：保持 `V1.43.1.0`。
- `DEVICE_PROTOCOL_VERSION` 保持 37，CPU2/CPU3 的共享寄存器、命令、状态和字段语义不变。
- CPU2 `DEVICE_PARAM_VERSION` 保持 3。ARM 目标 ABI 下，`RelayAlarmConfig` 修改前后均为 52 字节，`DeviceParameters.relayAlarm` 偏移均为 458，`DeviceParameters` 总大小均为 682 字节；`struct_size`、CRC 范围和 FRAM 布局不变。
- 从 CPU2 V1.44.1.0 升级不恢复出厂、不清除或迁移现场参数。升级前记录继电器报警设置，升级后读取核对并执行一次物理报警输出测试；回退时无需转换参数。

## 2. 提交范围

- CPU2 源码：`LTD_MAIN_CPU2/Services/ParamStorage/system_parameter.h`。
- 版本与日志：`LTD_MAIN_CPU2/Application/Inc/app_version.h`、`CHANGELOG.md`。
- 发布资料：`docs/00_构建与版本/版本改动与测试/Ⅱ代储罐在线计量仪版本升级记录.xlsx` 和本方案。

本次不修改继电器报警计算、输出 GPIO、共享协议和 CPU3 源码。参数存储版本及清参数规则不变，因此不更新 `CPU2参数存储升级清单.md`。本次只收紧类型对齐契约，不改变入口、命令分发、状态机、循环、异常出口或结果上报，所以不更新本机程序流程导航。

## 3. 详细改动

### 3.1 固化继电器报警配置的一字节对齐

- 源码位置：`LTD_MAIN_CPU2/Services/ParamStorage/system_parameter.h` 的 `RelayAlarmConfig`；数据链路为 `DeviceParameters.relayAlarm -> relay_output.c 配置快照 -> 报警计算`。
- 改前问题：父结构使用一字节打包，但 `RelayAlarmConfig` 类型自身仍按自然对齐声明。编译器在通过该类型访问嵌套成员时可能假定四字节对齐，Release 优化下读取非对齐浮点原始位存在生成不安全装载指令并触发 HardFault 的风险。
- 具体改法：在 `RelayAlarmConfig` 定义外单独使用 `#pragma pack(push, 1)` 与 `#pragma pack(pop)`，使类型本身的对齐要求固定为 1，同时不改变 13 个 `uint32_t` 字段的顺序和大小。
- 必查边界：两个继电器通道、首末字段、零值与 IEEE754 浮点原始位、CPU2 Debug/Release 编译、旧 FRAM 数据读取、结构嵌套和数组步长。
- 通过标准：`sizeof(RelayAlarmConfig)=52`、`_Alignof(RelayAlarmConfig)=1`；ARM 固件可编译，旧参数位置和值不变，目标板读取配置时不再依赖四字节对齐假设。

### 3.2 增加持久化布局编译期门禁

- 源码位置：同一头文件中 `DeviceParameters` 定义后的 `_Static_assert`。
- 改前问题：继电器子结构的大小、对齐、父结构偏移和总大小缺少就地约束，后续修改可能在代码评审时漏掉持久化兼容性变化。
- 具体改法：增加 52 字节大小和 1 字节对齐断言；在 ARM/Thumb 构建中增加 `relayAlarm` 偏移 458 和父结构总大小 682 的断言。
- 必查边界：主机 ABI 与 ARM ABI 不同，因此父结构偏移和总大小只在固件目标宏下断言；子结构大小和对齐在全部编译环境检查。
- 通过标准：当前 ARM 工具链通过全部断言；任一受保护值变化时编译直接失败，要求开发者先评估协议和参数存储版本。

## 4. 测试矩阵

| 编号 | 关联改动 | 前置条件 | 操作与观测位置 | 预期结果与通过标准 | 状态 |
| --- | --- | --- | --- | --- | --- |
| TC01 | 3.1、3.2 | ARM GCC 工具链可用，CPU2 最终源码和版本头已固定 | 对 `build/LTD_MAIN_CPU2` 重新配置后执行 clean 和 Debug 全量构建，观察静态断言及链接结果 | 134 个目标完成，无断言、编译或链接错误；产物名包含 `V1.44.2.0` | 已通过 |
| TC02 | 3.1、3.2 | 当前参数头文件 | 运行继电器配置契约检查并核对 ARM 基线 | 子结构大小 52、对齐 1；ARM 偏移 458、总大小 682 | 已通过 |
| TC03 | 3.1 | 已保存 V1.44.1.0 现场参数样本 | 升级到 V1.44.2.0 后读取两路继电器模式、源、阈值、回差、故障动作和清报警命令 | 所有值与升级前一致，不触发恢复出厂；读写不重启 | 待台架 |
| TC04 | 3.1 | 继电器 1、2 分别配置模拟量高低限和数字量报警 | 分别跨越阈值与回差，观察 GPIO、报警状态和复位 | 两路输出仍按原配置动作和释放，无 HardFault 或看门狗重启 | 待台架 |
| TC05 | 3.1 | 可执行长时间目标板测试 | 在继电器报警反复动作、参数读取和保存并发条件下持续运行 | 无 HardFault、异常复位和参数漂移；异常日志为空 | 待现场 |

## 5. 回归范围

- 两路继电器的模拟量源、数字量源、常开/常闭、上下限、回差、故障动作和清报警命令。
- CPU2 参数加载、CRC 校验、保存、恢复出厂和 CPU3 参数读取。
- 协议 37 下的继电器配置地址、读写权限及 CPU2/CPU3 配套通信。
- 正常上电、看门狗复位和 FRAM 掉电恢复；本次未修改这些路径，但它们消费同一持久化结构。

## 6. 已执行验证

- 2026-09-24 CPU2 `V1.44.2.0` Debug clean-first 构建通过：重新配置当前工作区构建缓存后，清理并完成 134 个目标，无编译警告或错误；`text=370188`、`data=2360`、`bss=60672`。
- 构建产物 `LTD_MAIN_CPU2_DEBUG.hex` 与 `LTD_MAIN_CPU2_V1.44.2.0_DEBUG.hex` SHA-256 均为 `7F4F8CD77551B5A90B9C1CAD66F448DFFCD65F5FFD521CFA239F7691E814A456`。
- 继电器布局契约检查通过；ARM 编译期断言确认偏移 458、总大小 682。源文件按 CP936 严格解码和重新编码检查通过，无中文乱码或不可编码字符。
- 售后工作簿新增记录后重新导入成功，历史首行正确下移，未发现公式错误；“版本改动”页已渲染检查，日期、版本、编号换行和文本显示完整。

## 7. 风险与未验证项

- 尚未执行目标板烧写、真实继电器负载、FRAM 掉电、CPU3 联机读取、Release 反汇编和长期现场验证。
- Debug 构建和静态断言证明布局契约与可编译性，不证明真实硬件总线访问、现场电气负载或长期运行稳定性。
- 建议台架同时覆盖旧参数升级读取和两路继电器反复动作；如需要关闭原 HardFault 风险证据，再补充 Release 反汇编确认非对齐字段不使用要求四字节对齐的装载序列。

## 8. 提交前检查清单

- [x] CPU2 版本头为 `V1.44.2.0`，CPU3 保持 `V1.43.1.0`。
- [x] `DEVICE_PROTOCOL_VERSION=37`、CPU2 `DEVICE_PARAM_VERSION=3` 和结构持久化布局不变。
- [x] `CHANGELOG.md`、售后版本升级记录和本方案已同步。
- [x] 使用最终版本头执行 CPU2 Debug clean-first 构建并记录产物。
- [x] `git diff --check`、布局契约和编码检查已执行。
- [ ] 提交消息、暂存范围、版本门禁和提交后范围检查在提交阶段执行。
- [x] 本文件随本次提交纳入；提交哈希以 Git 记录为准。
