duanxuebin1998/cube/docs/03_问题分析与整改/未处理/2026-09-18_UART6液位频率乱包与蓝牙主机重启证据分析.md

# 2026-09-18 UART6 液位频率乱包与蓝牙主机重启证据分析

日期：2026-09-18

当前状态：日志分析完成；确认两天内存在多次 DSM 响应格式错误、超时和跨帧内容。2026-09-15 22:21:13 首次出现明确的 `Welcome` 启动文本，随后又出现 `25 0D 0A`、`Welcome` 与 `F0006600...` 粘连，强烈支持无线主机或无线透传模块发生重启、重新初始化或模式切换。2026-09-14 和 2026-09-15 白天的孤立坏帧不能全部归为蓝牙模块重启。是否为模块真实掉电复位，仍需模块侧串口、复位脚和电源波形证据确认。

## 1. 分析目标

本次重新核对以下问题：

1. 两天日志中的所有液位频率乱包具体包含什么内容；
2. 哪些乱包只是通信帧损坏，哪些乱包包含启动或控制输出；
3. 是否可以把全部格式错误统一解释为蓝牙主机重启；
4. 第一次出现蓝牙主机重启有力证据的时间；
5. 现象最可能的原因和下一步最有区分力的验证方法。

## 2. 原始证据和边界

### 2.1 原始文件

原始文件位于用户下载目录，分析时按 CP936 解码，未修改原始文件。行号均为原始文本行号，时间为日志中的设备时间，未做跨设备时钟校正。

| 文件 | 大小 | 行数 | 日志时间范围 | SHA-256 |
| --- | ---: | ---: | --- | --- |
| `2026.09.14.txt` | 6,455,629 字节 | 189,812 | `00:00:00`～`23:59:59` | `44D3245FE9D9554B4D267061165C477C7F27DC7CC78F4D9A51FD27AA598BD3AB` |
| `2026.09.15.txt` | 9,735,635 字节 | 244,720 | `00:00:02`～`23:19:24` | `6AEB4F30BE65BF2A73B99104B07985016BB5147FD72CBBB36A0B3EB801FE09DF` |

日志中的异常是 CPU2 软件记录的 UART6 接收结果，属于透明通信链路的一个观测点。当前没有无线主机模块前后两侧的同步抓包，也没有 CH9141K 的 `RST`、电源、连接状态或复位原因记录。因此，日志可以证明“CPU2 收到了什么”，不能单独证明字节是在传感器、无线模块、UART6 电气链路还是 CPU2 接收缓存中发生变化。

### 2.2 日志总体统计

| 文件 | 传感器响应格式异常 | 传感器通信超时 | 震动管频率异常 | 最终报错 | 自动恢复失败 | 含 `Welcome` 字节 | 含 `25 0D 0A` |
| --- | ---: | ---: | ---: | ---: | ---: | ---: | ---: |
| `2026.09.14.txt` | 2 | 0 | 5 | 0 | 0 | 0 | 0 |
| `2026.09.15.txt` | 22 | 11 | 36 | 4 | 1 | 9 | 8 |

`Welcome` 的统计按 ASCII 对应字节 `57 65 6C 63 6F 6D 65` 计算，`25 0D 0A` 是 `%\r\n` 的十六进制表示。9 月 15 日的 22 条格式错误中，19 条是实际收到的异常字节，3 条是格式错误最终报错行；统计没有把最终报错重复当成新的接收帧。

两天日志时间均没有倒退。9 月 14 日没有超过 10 秒的时间间隔；9 月 15 日只有 15:47 和 16:00 附近的 3 个日志间隔，均不靠近晚间乱包。因此，没有发现 CPU2 黑匣子整体重启的直接证据。无线模块单独重启仍可能不影响 CPU2 日志时间轴。

## 3. 协议判断基准

这两份日志中的异常命令是 DSM 文本命令 `Cb`、`Ch`，不是多参数传感器 V3 的固定 8 字节二进制帧。当前仓库的 DSM 实现定义：

| 项目 | 当前实现依据 |
| --- | --- |
| `Cb` 液位频率响应 | 正常响应长度 11 字节；命令表位于 `dsm_sensor_communication.c` 第 62～74 行 |
| `Cb` 读取入口 | `Read_Level_Frequency()` 调用 `UART6_SendWithRetry("Cb", ...)`，位于第 1342～1348 行 |
| 通用收帧错误 | 收到长度不符合预期、帧未完成或超时收到部分数据时返回 `SENSOR_RESP_FORMAT_ERROR`，位于第 389～448 行 |
| DSM BCC | 从第 0 字节开始，跳过第 1 字节，对后续字段异或，位于第 1410～1416 行 |
| `25 0D 0A` | DSM 的模式切换应答宏为 `%\r\n`；同时当前 CH9141K AT 代码把“只有 `%` 加 CR/LF”识别为上电百分号，位于 `ch9141_at.c` 第 245～280 行 |

这意味着，异常帧首先可以确认是“对 `Cb` 或 `Ch` 请求返回的内容不符合 DSM 当前帧约束”。`25 0D 0A` 在 DSM 模式切换场景下有合法含义，但它出现在 `Cb` 或 `Ch` 的响应窗口内时已经是错位内容；结合当前 CH9141K 代码对该字节串的上电处理，它同时具备无线模块启动输出的嫌疑。

## 4. 全部乱包内容

### 4.1 2026-09-14：两帧孤立乱码

| 时间 | 原始行 | 长度 | 十六进制 | 可见文本 | 后续现象 |
| --- | ---: | ---: | --- | --- | --- |
| `02:38:41` | 20475 | 10 | `45 30 F8 AA 92 AA 82 3A 35 0A` | `E0.....:5\n` | 第 2 次重试成功；随后收到 `F0006600F`，报震动管频率异常 |
| `02:38:43` | 20480 | 10 | `45 30 30 F0 36 3F 98 2A 35 0A` | `E00.6?.*5\n` | 第 2 次重试成功；随后再次收到 `F0006600F`，报震动管频率异常 |

两帧都不是 `Welcome`、`%\r\n` 或完整的 DSM `Cb` 响应。它们包含非 ASCII 字节、长度不足、结尾只有 `LF` 或没有规范的 `CRLF`，更像响应内容被破坏或接收边界错位。由于 `uart=0x00000000`，日志没有同时记录 UART 硬件错误标志，不能从这两行确认 UART6 发生过 ORE、帧错误或噪声错误。

### 4.2 2026-09-15 白天：两帧与正常响应有部分重合的坏帧

| 时间 | 原始行 | 十六进制 | 可见文本 | 对照 |
| --- | ---: | --- | --- | --- |
| `05:34:58` | 46021 | `46 30 30 30 35 72 3C 37 F8 47 FC` | `F0005r<7.G.` | 前 5 字节 `F0005` 与正常帧前缀相似，但数值字段、BCC 和 `CRLF` 均不成立 |
| `06:31:15` | 52465 | `45 30 30 30 35 32 33 30 41 0D 2A` | `E0005230A\r*` | 长度为 11，但结尾不是 `\r\n`，且首字节和尾部不符合正常 `Cb` 响应 |

第一帧前后是正常的 `F0005250D`，异常后第 2 次重试成功，但紧接着得到 `F0006600F` 并报频率异常。第二帧后第 2 次重试得到 `F0005230B`，随后记录 `5230 Hz`，说明通信很快恢复。

这两帧可以确认是 DSM 响应损坏或错位，不能单独确认蓝牙主机重启。它们没有启动字符串，也没有同一时间窗内的 `25 0D 0A` 或连续多帧控制输出。

### 4.3 2026-09-15 22:21 以后：启动文本和跨帧粘连

| 时间 | 原始行 | 收到内容 | 说明 |
| --- | ---: | --- | --- |
| `22:21:13`～`22:21:15` | 233245～233247 | `Welcome`、`WelcomeWelco`、`Welcome` | 同一个 `Cb` 读取的 3 次重试连续收到启动文本，随后第 3 次重试最终格式错误并停止测量 |
| `22:22:07` | 233404 | `%\r\n` | 在 `Cb` 响应窗口中出现；当前 CH9141K 代码将单独的 `%` 加 CR/LF 视为上电百分号 |
| `23:00:07`～`23:00:10` | 240842～240847 | `Cb` 先两次无响应，再收到 `%\r\n`；随后 `Ch` 也收到 `%\r\n` | 同一透明链路上的不同命令都受到影响 |
| `23:06:26`～`23:06:27` | 242116～242117 | `Welcome`、`%\r\n` | 启动文本和上电百分号连续出现，之后恢复到 `F0006600F`，并报频率异常 |
| `23:11:58`～`23:12:02` | 243144～243150 | `Welcome`、`Welcome`、`%\r\nF0006600F`；`Ch` 收到 `Welcome`、`%\r\n` | 启动文本、控制输出和传感器帧粘连；随后液位频率和倾角均进入格式错误 |
| `23:19:01`、`23:19:21` | 244694～244715 | `Welcome`；`%\r\nF0006600` | 同样的启动文本和部分 `F0006600...` 重复出现，随后无响应并在 23:19:24 自动恢复失败 |

这一组内容已经超出单个 DSM 传感器频率值异常的解释范围：

1. `Welcome` 不是 DSM `Cb` 或 `Ch` 的合法响应字段；
2. `WelcomeWelco` 表明启动文本至少重复到接收窗口中，存在缓存或连续输出；
3. `%\r\nF0006600F` 把控制应答和频率帧拼在一起，说明接收窗口内存在跨事务内容；
4. `Cb` 和 `Ch` 在同一时间段收到相似内容，问题更接近共同的 UART6 透明链路或无线主机状态；
5. 之后出现超时、最终报错和自动恢复失败，说明链路异常并非一次孤立字节翻转。

## 5. 第一次重启有力证据的时间

应区分两个时间点：

### 5.1 最早的明确启动文本

**2026-09-15 22:21:13，原始行 233245** 是两天日志中第一次出现强烈指向模块启动或重新初始化的内容：

```text
cmd=Cb,len=7,hex=57 65 6C 63 6F 6D 65
ASCII: Welcome
```

随后 22:21:14 和 22:21:15 仍分别收到 `WelcomeWelco` 和 `Welcome`。这不是普通 BCC 错误或单字节乱码，而是完整的可读启动文本连续进入 `Cb` 响应窗口。因此，把 **22:21:13 作为第一次出现启动证据的时间** 是有力且可复核的判断。

### 5.2 第一次与当前 CH9141K 启动处理逻辑直接对应的字节串

**2026-09-15 22:22:07，原始行 233404** 首次出现：

```text
hex=25 0D 0A
ASCII: %\r\n
```

当前仓库的 CH9141K AT 处理代码明确把“只有 `%` 加可选 CR/LF”的响应识别为上电百分号，并在首次进入 AT 失败时执行恢复重试。由于现场日志对应的固件版本和当前源码提交尚未建立一一映射，这一条是**源码相关的强支持证据**，不是单独的现场硬件复位证明。

综合时间顺序，模块异常状态至少在 `22:21:13` 已经表现出来，`22:22:07` 又出现了与当前 CH9141K 启动处理相符的输出。真实复位时刻可能早于 `22:21:13`，因为日志只记录接收窗口结束后的结果，且模块输出可能经过缓冲后才被 CPU2 收到。

## 6. 原因判断

### 6.1 最可能原因：无线主机或透传模块重启、重新初始化或发生模式切换

支持证据：

- `Welcome` 完整启动文本连续出现；
- `%\r\n` 与当前 CH9141K 对上电百分号的处理逻辑相符；
- `Welcome`、`%\r\n`、`F0006600...` 互相粘连，符合模块启动输出与透明传感器数据同时进入 UART6 接收窗口的表现；
- `Cb` 和 `Ch` 都受到影响，说明异常点可能位于共同链路；
- 后续出现无响应、最终报错和自动恢复失败，符合模块重启后尚未恢复透明通信或连接状态的过程。

当前可给出的结论是：**2026-09-15 22:21:13 之后，蓝牙主机发生重启、重新初始化或透明/AT 状态切换的可能性高，重启是首要怀疑方向。** 日志本身还不能区分“模块掉电复位”“模块内部看门狗复位”“无线链路重新初始化”或“CPU2 主动触发 AT/RESET”。

### 6.2 次要原因：透明链路缓存残留、迟到响应或接收边界错位

9 月 14 日的两帧乱码、9 月 15 日 05:34 和 06:31 的两帧坏帧都在第 2 次重试恢复，且没有启动文本。这一模式更符合以下一种或多种情况：

- 无线透明传输中短时丢字节或插入字节；
- 模块重连或模式切换期间，前一事务的残留字节进入下一次 `Cb` 接收窗口；
- 响应迟到，在下一次 DMA/接收窗口中被拼接；
- UART6 DMA 停止、启动或清理时刻与透明数据到达重叠，造成帧边界错位。

这些解释能说明早期孤立坏帧，但不能说明 22:21 之后的完整 `Welcome` 文本来自哪里。后者仍需模块侧抓包确认。

### 6.3 可能的触发因素：模块供电瞬态、复位脚、电磁干扰或连接不良

电源跌落、模块 `RST` 触发、地线或连接器接触问题，都可能使无线模块重启并输出启动内容，也可能只造成短时乱码。当前日志没有模块供电、复位原因、UART6 引脚波形或无线空口记录，因此这些只能作为硬件触发方向，不能从日志中直接排序确认。

### 6.4 不宜单独作为根因的现象：`F0006600F` 和震动管频率异常

`F0006600F` 看起来是格式完整的 `Cb` 文本响应，但其数值随后被程序判定为震动管频率异常。它可能是传感器在通信恢复过程中的真实异常值，也可能是模式切换或残留内容产生的合法外形帧。日志只能证明程序收到了该内容并判为频率异常，不能据此单独证明传感器本体故障或蓝牙模块重启。

## 7. 结论矩阵

| 判断项 | 结论 | 置信度和证据边界 |
| --- | --- | --- |
| 两天存在通信格式错误 | 确认 | 9 月 14 日 2 条，9 月 15 日 22 条，均有原始行号和十六进制内容 |
| 所有乱包都是蓝牙主机重启 | 不成立 | 白天 4 帧是孤立坏帧，没有启动文本或启动标记 |
| 9 月 15 日 22:21 之后存在模块启动/重新初始化迹象 | 高度怀疑 | `Welcome`、`%\r\n`、跨帧粘连和 `Cb/Ch` 同时异常；尚缺模块侧电气证据 |
| 第一次出现有力的启动证据 | `2026-09-15 22:21:13` | 首次出现完整 `Welcome`；真实复位时刻可能更早 |
| 第一次出现与当前 CH9141K 启动处理直接对应的字节 | `2026-09-15 22:22:07` | 首次出现 `25 0D 0A`；现场固件与当前源码映射尚未确认 |
| CPU2 黑匣子整体重启 | 未发现证据 | 时间轴没有倒退；日志持续到后续事件 |
| 9 月 14 日乱码的唯一原因 | 未确认 | 可确认帧损坏/错位，无法区分无线传输、UART6 接收和传感器端 |

## 8. 建议的区分性验证

后续复现时，优先保留同一时间基准下的以下证据：

1. 在无线主机模块 UART6 侧直接抓取 TX/RX 原始字节，确认 `Welcome` 和 `%\r\n` 是模块主动输出，还是传感器端经透明链路送来的内容；
2. 同时监测无线主机模块的 `RST`、电源使能、供电电压和连接状态，记录复位前后至少 2 秒；
3. 在传感器或无线从机侧同步抓取 `Cb`、`Ch` 请求和响应，区分“传感器返回坏帧”“无线主机插入启动输出”和“CPU2 接收边界错位”；
4. 对无线主机执行一次受控断电/复位，在 `Cb` 连续读取期间采集完整 UART6 字节流，检查是否能复现 `Welcome`、`%\r\n` 和 `Welcome + F000...` 的顺序；
5. CPU2 临时诊断中记录每次事务的请求、重试号、DMA 实际接收长度、原始 HEX、UART `ErrorCode`、接收窗口起止时间和模块链路状态；
6. 检查自动恢复前是否先清空 UART6 残留并确认透明模式。恢复动作不能只依赖下一次 `Cb` 重试成功，否则可能把旧帧或启动输出误当作新事务内容。

## 9. 本次分析的验证边界

- 已完成：原始文件大小、行数、SHA-256、时间轴、异常类型计数、全部格式错误行和关键乱包上下文核对。
- 已完成：按当前仓库 DSM 和 CH9141K 代码检查 `Cb` 帧长度、DSM BCC、`%\r\n` 双重语义及启动百分号处理路径。
- 未执行：无线主机前后双端抓包、传感器端抓包、UART6 引脚示波器/逻辑分析仪采集、模块电源和复位波形测量、受控故障注入。
- 未确认：两份黑匣子日志对应的 CPU2 固件版本、无线主机固件版本和模块实际复位原因。因此，本文将 22:21:13 定义为“首次出现强启动证据”，不写成“已证明模块在该秒掉电重启”。

关联源码：

- [DSM 传感器通信实现](../../../LTD_MAIN_CPU2/Services/Sensor/Protocols/Dsm/dsm_sensor_communication.c)
- [CH9141K AT/透传实现](../../../LTD_MAIN_CPU2/Services/Sensor/Wireless/ch9141_at.c)
- [无线滑环设备端匹配方案](../../01_协议与寄存器/CPU2通信与解耦/无线滑环匹配/无线滑环设备端匹配方案.md)
