duanxuebin1998/cube/docs/00_构建与版本/版本改动与测试/2026-09-05_CPU2_V1.42.11.0_方式5丢步检测修复与架构资料更新_改动与测试方案.md

# CPU2 V1.42.11.0 方式5丢步检测修复与架构资料更新改动与测试方案

## 1. 版本与目的

- CPU2：`V1.42.10.0 -> V1.42.11.0`（PATCH）。
- CPU3：保持 `V1.41.0.0`。
- 目的：修复方式5液位定频闭环在换向、变速、停止等待和低速检测切换时使用错误方向或速度累计期望位移的问题，并纳入当前已完成的 SI PLC 对接协议、系统架构和软件架构资料。
- 范围边界：本次明确不纳入称重探底可靠性改造；普通液位运动仍保留原有向下绝对称重阈值保护。

## 2. 协议版本与兼容性

- `DEVICE_PROTOCOL_VERSION` 保持 35；CPU2/CPU3 共享寄存器、共享命令、共享状态和 SI 对外寄存器语义不变。
- CPU2 `DEVICE_PARAM_VERSION` 保持 3，CPU3 `CPU3_PARAM_VERSION` 保持 `0x0007`；参数结构、字段偏移、CRC 范围和 FRAM 布局不变，升级不恢复出厂、不清除现场参数。
- 方式5改动只调整 CPU2 内部丢步检测输入和窗口统计，不新增命令、状态、故障码或参数。
- SI PLC 对接协议 PDF 当前文件与上一版本二进制不同，但逐页栅格比对未发现视觉差异；不能据此声明对外协议内容发生变化。

## 3. 本次修改

### 3.1 方式5按有效指令积分期望位移

- 源码位置：`motor_ctrl_lost_step_detect.c` 的 `MotorCtrl_CheckLostStepAutoTimingWithSpeed()` 及其方式5私有状态；声明位于 `motor_ctrl.h`。
- 改前问题：通用丢步检测按窗口首尾位置和固定阈值判断，方式5闭环的换向、速度变化和停机等待没有形成与实际指令一致的期望位移窗口，可能用新方向解释旧位移或继续按旧速度累计停止时段，造成误报。
- 具体改法：新增方式5专用累计状态。每次调用先按“上一有效方向和速度”结算上一个时间段的期望位移和三路实际有效前进量，再保存本次新方向和速度；速度为 0 时只刷新三路前沿，不累计期望位移。
- 必查边界：首次进入、同方向变速、上转下、下转上、运动转停止、停止转运动、HAL tick 回绕、非法方向、负速度、超上限速度、窗口未满和期望位移为 0 均需复核。
- 通过标准：每段期望位移等于该段已下发速度与持续时间的积分；换向后的首个样本不把旧方向位移计入新方向；停止等待期间期望位移不增长；非法输入返回 `PARAM_RANGE_ERROR`。

### 3.2 三路位置按指令方向累计有效前进量

- 源码位置：`MotorCtrl_UpdateMethod5ForwardProgress01mm()`、`MotorCtrl_AccumulateMethod5ForwardProgress()` 和 `MotorCtrl_StoreMethod5LostStepSnapshot()`。
- 改前问题：窗口首尾差值会受换向、回退和抖动抵消或放大，无法稳定表达业务位置、电机模型和编码器在当前指令方向上的实际进展。
- 具体改法：业务位置、电机模型位置和编码器位置分别维护方向前沿，只有越过当前指令方向上的最远前沿时才累计有效前进量；回退、抖动和重复到达旧位置均计 0。窗口保存三路累计值与累计期望位移快照。
- 必查边界：三路信号的正负方向不同、编码器抖动、短时回退后恢复、跨方向切换、累计量长时间增长和窗口索引回绕均需复核。
- 通过标准：单调前进量正常累计；回退和未越过前沿的恢复不重复累计；电机模型有明显前进而编码器跟随不足时仍可返回 `ENCODER_LOST_STEP`；电机位置源场景保持既有只记录、不返回编码器丢步的处理。

### 3.3 液位定频闭环传递当前方向、速度和检测状态

- 源码位置：`oil_level_frequency.c` 的 `FrequencyLevel_CheckMotionGuards()`、`FrequencyLevel_ReadCurrentWithGuards()` 和 `FrequencyLevel_RunClosedLoopConfigured()`。
- 改前问题：运动保护只接收一个方向，无法区分“本轮位置/碰撞保护方向”和“上一段已生效的丢步统计方向”；细调速度变化和换向前停机也没有显式结算上一指令时段。
- 具体改法：保护函数分别接收保护方向、有效指令方向和有效指令速度。换向停机前用旧方向、速度 0 调用方式5接口结算上一时段；运动状态或低速检测启停发生变化时重建窗口，同一运动阶段的连续速度变化由方式5接口逐段积分。
- 必查边界：定频初始运动、细调速度连续变化、细调速度低于 `0.03 m/min`、低速后重新启用检测、稳定停机、上下限保护和称重碰撞保护均需复核。
- 通过标准：丢步检测只在已经存在有效运动指令且检测启用时运行；低速禁用和重新启用不会继承旧窗口；换向前先结算旧方向，换向后重建方向前沿；位置和称重保护返回码不变。

### 3.4 协议与架构资料

- 资料位置：SI PLC 对接协议 PDF、`CG01.系统架构设计-V1.2.docx` 和 `ER02.储罐在线自动计量仪软件架构设计V0.4.docx`。
- 改前问题：当前工作区已经形成相应资料修订，但尚未纳入版本记录；静态文档与本次固件修复属于不同证据层级，需要在提交中分别说明。
- 具体改法：按当前文件状态纳入版本；对 PDF/DOCX 做只读渲染检查，不对其技术内容作超出来源的扩展解释。
- 必查边界：页码、目录、表格、分页、正文裁切、图文对应关系和协议对外语义均需人工复核。
- 通过标准：Word 原生分页下正文无重叠或裁切；SI PDF 所有页面可渲染；架构文档可打开且主体内容可读。ER02 末页旧总页数字段作为已知问题记录，不据此判定正文失效。

## 4. 提交文件

- `LTD_MAIN_CPU2/Application/Inc/app_version.h`
- `LTD_MAIN_CPU2/Application/Src/measurement/oil_level/oil_level_frequency.c`（仅方式5相关语义，保留原向下绝对称重阈值）
- `LTD_MAIN_CPU2/Services/MotorControl/motor_ctrl.h`
- `LTD_MAIN_CPU2/Services/MotorControl/motor_ctrl_lost_step_detect.c`
- `CHANGELOG.md`
- `docs/00_构建与版本/版本改动与测试/2026-09-05_CPU2_V1.42.11.0_方式5丢步检测修复与架构资料更新_改动与测试方案.md`
- `docs/01_协议与寄存器/SI协议适配/06_对外PLC协议/CUBE_SI_Modbus_RTU_PLC对接协议V1.0.pdf`
- `docs/06_SIL功能安全认证/02_软件架构/CG01.系统架构设计-V1.2.docx`
- `docs/06_SIL功能安全认证/02_软件架构/ER02软件架构设计编制工作包/03_当前二代软件架构/ER02.储罐在线自动计量仪软件架构设计V0.4.docx`

以下内容明确保留在工作区，不纳入本次提交：

- `measure_level_commands.c`、`measure_tank_height.c`、`weight.c`、`weight.h` 中的称重探底可靠性改造。
- `2026-09-03_CPU2称重探底可靠判定方案.md/.pdf` 及问题目录索引更新。
- `oil_level_frequency.c` 中取消普通液位向下绝对称重阈值的改动。
- `docs/00_程序流程导航/` 和 `tools/` 的本机同步内容。

## 5. 测试环境与前置条件

- 固件：CPU2 `V1.42.11.0` Debug；CPU3 继续使用 `V1.41.0.0`。
- 设备：可执行液位定频闭环的目标板、电机、编码器、尺带与液位传感器；可控的换向和速度阶跃条件。
- 采集：CPU2 完整日志、电机指令方向和速度、业务位置、电机模型位置、编码器位置以及最终错误码。
- 判定：每个实机用例必须保存输入条件、指令时序、三路位置、窗口统计和返回码；缺少任一关键证据只记为未完成，不记为通过。

## 6. 可执行测试矩阵

| 编号 | 关联改动 | 前置与输入 | 操作步骤 | 观测位置 | 预期与通过标准 | 状态/证据 |
|---|---|---|---|---|---|---|
| M5-01 | 3.1、3.3 | 定频闭环稳定向同一方向运动 | 先以一个速度运行，再连续改变细调速度 | 指令速度、期望位移、三路进展 | 每段按旧速度结算后采用新速度；无突跳和误报 | 未执行，待目标板 |
| M5-02 | 3.1~3.3 | 可触发上下换向 | 连续执行上转下、下转上 | 停机前结算日志、窗口快照、返回码 | 旧方向先结算，新方向从当前点建立前沿；旧位移不进入新方向窗口 | 未执行，待目标板 |
| M5-03 | 3.1、3.3 | 运动后进入稳定等待 | 记录停止前后至少一个完整窗口 | 指令速度、期望位移 | 停止期间速度为 0，期望位移不增长，不产生停止导致的丢步报警 | 未执行，待目标板 |
| M5-04 | 3.3 | 细调速度跨越 `0.03 m/min` | 分别从高于阈值降到低于阈值，再升回高于阈值 | 检测状态、窗口重建日志 | 低速时暂停检测；重新启用时窗口从当前状态开始，不继承旧样本 | 未执行，待目标板 |
| M5-05 | 3.2 | 编码器正常跟随 | 正常运行多个约 5 秒窗口 | 电机模型与编码器累计前进量 | 编码器进展不低于随动阈值，不返回 `ENCODER_LOST_STEP` | 未执行，待目标板 |
| M5-06 | 3.2 | 可模拟编码器停滞 | 保持电机模型前进而冻结编码器反馈 | 窗口统计、错误码 | 达到最小电机进展且编码器不足时返回 `ENCODER_LOST_STEP` | 未执行，待故障注入 |
| M5-07 | 3.2 | 可模拟短时回退和抖动 | 先前进、回退、再恢复但不越过旧前沿 | 三路累计有效前进量 | 回退和恢复段不重复累计，只有越过旧前沿的增量被加入 | 未执行，待模拟器或目标板 |
| M5-08 | 3.3 | 分别接近上限、下限和称重保护阈值 | 执行相应方向运动 | 保护返回码、电机停机 | 位置上下限和原向下绝对称重阈值仍生效，返回码保持既有语义 | 未执行，待目标板 |
| DOC-01 | 3.4 | 安装 Microsoft Word | 只读打开并导出 CG01、ER02，逐页检查 | Word 导出 PDF、页面图像 | 主体正文、表格和图形无重叠或裁切 | 已执行；CG01 19 页、ER02 16 页 |
| DOC-02 | 3.4 | 当前与 HEAD 的 SI PDF | 同参数逐页栅格化并比较 | 页面像素 | 页面数量一致且未发现视觉差异 | 已执行；13 页 |

## 7. 已执行验证

- 隔离候选树执行 `cmake --build build/LTD_MAIN_CPU2 --clean-first -j 8`：通过，132 个目标完成；`text=362876`、`data=2360`、`bss=59920`。
- `LTD_MAIN_CPU2_DEBUG.hex` 与 `LTD_MAIN_CPU2_V1.42.11.0_DEBUG.hex` 均为 1027398 字节，SHA-256 均为 `CB6EE1AEA44477B8F02A656BCA4E9D3DF3CFD4C2858FCE28A8C0E5DC07A272F0`。
- `LTD_MAIN_CPU2_DEBUG.bin` 为 365260 字节，SHA-256 为 `DD901E953F4A26B0CB1737AA6D2C2A8607A31F76DE9370E3491E23EDD1F10A12`。
- `LTD_MAIN_CPU2.elf` 为 3968980 字节，SHA-256 为 `3483EA9EBCB01836B7EAEFD690F4470CD9E3A4B9405B735F011382EB83149001`。
- 方式5本机流程导航已同步；`check_flow_docs.py` 通过（34 页、196 张 SVG、60 张表格），严格 `check_flow_impact.py` 通过（2 个流程、4 条业务链路、无待复核项）。
- `check_motor_motion_target_plan.py`、`check_version_bumped.py`、scoped 提交范围门禁和 `git diff --cached --check` 通过；四个候选源码文件均通过 CP936 严格解码并保持 CRLF。
- `check_docs.py` 通过；本机证据身份登记补齐 3 份既有版本方案后，29 份稳定证据精确覆盖流程清单，18/18 个流程和 8/8 条业务链路无专项缺口。本机登记文件不纳入 Git。
- CG01 使用 Word 只读导出为 19 页、ER02 导出为 16 页并逐页检查；主体内容未发现重叠或裁切。ER02 末页显示“第13页 共12页”，属于文档内部旧总页数字段，未在本次范围内改写。
- SI PDF 共 13 页，当前文件与 HEAD 逐页栅格比对未发现视觉差异。

## 8. 剩余风险与现场验证

- 尚未执行目标板烧写、真实电机/编码器换向、连续变速、低速阈值切换、编码器停滞、RS485/PLC、故障注入、现场或 SIL 验证。
- 构建和静态检查只能证明候选源码可编译及指定静态约束成立，不能证明机械系统在负载、惯性、抖动和编码器故障下满足检测阈值。
- ER02 末页旧总页数字段需要后续文档维护时更新；本次只记录，不将其解释为正文分页失败。
- SI PDF 的二进制差异未表现为页面像素差异；其变更原因仍应由文档源或生成链进一步追溯，本次不据此声明协议内容更新。

## 9. 提交前检查清单与状态

- [x] CPU2 版本从 `V1.42.10.0` 升为 `V1.42.11.0`；CPU3 保持 `V1.41.0.0`。
- [x] `DEVICE_PROTOCOL_VERSION=35`、CPU2 `DEVICE_PARAM_VERSION=3`、CPU3 `CPU3_PARAM_VERSION=0x0007` 保持不变。
- [x] 称重探底可靠性改造和问题资料保留在工作区，未纳入隔离候选提交。
- [x] CPU2 隔离候选 Debug clean-first 构建通过。
- [x] 文档完成只读渲染检查，已知页脚问题和验证边界已记录。
- [ ] 目标板、真实电机/编码器、RS485/PLC、故障注入、现场和 SIL 验证尚未执行，不能据此声称实机或安全完整性验证通过。
