duanxuebin1998/cube/docs/00_构建与版本/版本改动与测试/2026-09-05_CPU3_V1.41.0.0_LED面板指示灯初始化_改动与测试方案.md

# CPU3 V1.41.0.0 LED 面板指示灯初始化改动与测试方案

## 1. 版本与目的

- CPU2：保持 `V1.42.10.0`。
- CPU3：`V1.40.1.0 -> V1.41.0.0`（MINOR）。
- 目的：初始化 LED 面板的两个指示灯并暂时保持常亮，为后续状态指示逻辑建立稳定的 GPIO 基线。

## 2. 协议版本与兼容性

- `DEVICE_PROTOCOL_VERSION` 保持 35；CPU2/CPU3 共享寄存器、命令、状态和字段不变。
- CPU3 `CPU3_PARAM_VERSION` 保持 `0x0007`；参数布局、FRAM 数据和启动加载逻辑不变，升级不清除现场参数。
- 本次只新增 PF0/PF10 GPIO 输出初始化，不改变串口、SPI、OLED 刷新、菜单和对外协议行为。

## 3. 本次修改

### 3.1 LED 引脚定义与低电平常亮

- 源码位置：`LTD_DISPLAY_CPU3/Core/Inc/main.h` 的 GPIO 宏，以及 `LTD_DISPLAY_CPU3/Core/Src/gpio.c` 的 `MX_GPIO_Init()`。
- 改前问题：CPU3 未定义或初始化 LED 面板的两个控制引脚，固件无法保证上电后的指示灯状态。
- 具体改法：定义 `WLED1=PF10`、`WLED2=PF0`；GPIOF 时钟启用后先把两引脚写为 `GPIO_PIN_RESET`，再配置为低速推挽输出、无上下拉，使其按当前低有效假设保持常亮。
- 必查边界：冷上电、软件复位、看门狗复位、两灯同时驱动、OLED 刷新和 SPI 通信期间的电平保持；还需核对面板实物是否存在引脚互换或硬件改线。
- 通过标准：PF10 和 PF0 初始化后均持续为低电平，两只指示灯从 CPU3 初始化完成后持续点亮，且 OLED、按键和通信功能无新增异常。

### 3.2 CubeMX 配置同步

- 源码位置：`LTD_DISPLAY_CPU3/LTD_DISPLAY_CPU3.ioc` 的 `PF0`、`PF10` 和 `Mcu.Pin*` 配置。
- 改前问题：只修改生成源码会在后续 CubeMX 重新生成时丢失 LED 初始化。
- 具体改法：把 PF0 标记为 `WLED2`、PF10 标记为 `WLED1`，均设置为 `GPIO_Output`，初始状态为 `GPIO_PIN_RESET`，并把引脚总数由 54 更新为 56。
- 必查边界：重新打开 `.ioc` 时无引脚冲突；重新生成后宏、输出电平和 GPIO 模式与当前源码一致；PF0 不再作为 I2C2，PF10 不再作为 ADC3 使用。
- 通过标准：CubeMX 能正常载入工程且不报告 PF0/PF10 冲突，重新生成的 `main.h` 与 `gpio.c` 保留相同配置。

## 4. 提交文件

- `LTD_DISPLAY_CPU3/Core/Inc/main.h`
- `LTD_DISPLAY_CPU3/Core/Src/gpio.c`
- `LTD_DISPLAY_CPU3/LTD_DISPLAY_CPU3.ioc`
- `LTD_DISPLAY_CPU3/Application/app_version.h`
- `CHANGELOG.md`
- `docs/00_构建与版本/版本改动与测试/2026-09-05_CPU3_V1.41.0.0_LED面板指示灯初始化_改动与测试方案.md`

现有 CPU2 源码、SI 协议资料、问题分析资料和架构文档改动不属于本次提交，保持原有暂存或工作区状态。

## 5. 可执行测试矩阵

| 编号 | 前置条件 | 操作步骤 | 观测位置 | 预期与通过标准 | 状态/证据 |
|---|---|---|---|---|---|
| LED-01 | 烧写 CPU3 V1.41.0.0，连接当前 LED 面板 | 断电后重新上电 | WLED1、WLED2 实物及 PF10/PF0 电平 | PF10、PF0 均为低电平且两灯持续点亮 | 未执行，需目标板 |
| LED-02 | 设备正常运行 | 分别执行软件复位和看门狗复位 | 两灯、启动日志、PF10/PF0 | 初始化完成后两灯恢复常亮，无长期熄灭或闪烁 | 未执行，需目标板 |
| LED-03 | 两灯常亮 | 连续切换页面并保持 OLED 刷新 10 分钟 | OLED、两灯、SPI 波形 | 页面显示正常，两灯状态不受刷新影响 | 未执行，需目标板 |
| LED-04 | 连接通信台架 | 同时执行 CPU2/CPU3 通信和外部 Modbus 轮询 | 通信统计、错误日志、两灯 | 无新增超时或帧错误，两灯持续点亮 | 未执行，需台架 |
| LED-05 | 安装 STM32CubeMX 6.16.0 | 打开 `.ioc`，检查 PF0/PF10 后重新生成并比较 | CubeMX 冲突提示、生成差异 | 无引脚冲突，生成代码保留低电平推挽输出 | 未执行，避免提交前重生成覆盖并行改动 |

## 6. 已执行验证

- `cmake --build build/LTD_DISPLAY_CPU3 --clean-first`：通过，62 个目标完成；`text=220960`、`data=20996`、`bss=100764`。
- `LTD_DISPLAY_CPU3.hex` 与 `LTD_DISPLAY_CPU3_V1.41.0.0.hex` 均为 680652 字节，SHA-256 均为 `067353FD8C41F10F044F0A30A0C45D75B8B6028B4AD82D95B2F19A7111475A17`。
- `LTD_DISPLAY_CPU3.bin` 为 241976 字节，SHA-256 为 `DBB887332E6A7A654DE90BDE4A59BF22D8768FCFCB17F6E2474C90F2ABE02835`。
- 高电平初始化版本已由目标板反馈“两灯未亮”，因此本次改为低电平初始化；该反馈不能替代低电平版本的实板验证。
- 本次只增加启动 GPIO 配置，不改变业务流程、状态机、命令分发或异常出口，因此不更新 `docs/00_程序流程导航/`。

## 7. 回归范围与剩余风险

- 回归 CPU3 上电、复位、OLED 初始化和正常页面刷新，确认 GPIOF 新增输出不影响 PF1~PF5 按键/OLED 复位及 PF12~PF15 地址输入。
- 回归 SPI1 OLED、SPI4 FRAM、CPU2 板间通信和外部 Modbus 基本收发。
- 低电平常亮依据当前高电平版本未点亮的实板现象推定；尚未对 PF0/PF10 电压、LED 驱动极性、面板引脚互换和硬件改线做测量确认。
- 尚未执行本版固件烧写、目标板常亮确认、示波器测量、长时间运行、EMC、现场或 SIL 验证。

## 8. 提交前检查清单与状态

- [x] CPU3 版本已从 `V1.40.1.0` 升为 `V1.41.0.0`；CPU2 保持 `V1.42.10.0`。
- [x] `DEVICE_PROTOCOL_VERSION=35`、`CPU3_PARAM_VERSION=0x0007`，协议和参数存储不变。
- [x] `CHANGELOG.md` 已按版本、兼容性、本次修改和验证四部分补齐。
- [x] CPU3 clean-first 构建通过，产物版本名与版本头一致。
- [x] 本文件随本次范围提交纳入，提交哈希以 Git 记录为准。
- [ ] 低电平版本尚未在目标板和台架验证，不能声称硬件或现场验证通过。
