duanxuebin1998/cube/docs/00_构建与版本/版本改动与测试/2026-09-03_CPU2_V1.42.9.0_V4通信重试与频率判定修复_改动与测试方案.md

# CPU2 V1.42.9.0 V4通信重试与频率判定修复改动与测试方案

## 1. 文档目的和适用版本

- CPU2：`V1.42.8.0 -> V1.42.9.0`（PATCH）。
- CPU3：保持`V1.40.1.0`。
- 适用链路：DM4 V4交互读取、部件参数刷新、主动/交互异常包打印、液位频率读取与运动等待、自动恢复检查。
- 本文件随本次提交纳入；提交哈希以Git记录为准。

## 2. 协议和参数存储兼容性

- `DEVICE_PROTOCOL_VERSION`保持35；不改变CPU2/CPU3共享寄存器、命令、状态、字段或CPU3对外LTD标准Modbus共享区。
- DM4 V4帧格式、参数地址、R/W/D/S/L/M功能码和错误码不变。通信重试只改变CPU2本地执行次数、日志和耗时，不要求传感器协议升级。
- 幂等读取及可安全重复的D/S模式命令只对超时、UART传输、响应格式、BCC和地址不匹配最多尝试3次；`STATE_SWITCH`、调用条件、流状态、模式不匹配及业务数据异常不在协议层重试。
- 参数写入保持单次写命令，写应答失败后使用读回确认；L/M等非幂等命令仍为单次下发，避免重复执行远端动作。
- CPU2 `DEVICE_PARAM_VERSION`保持3；`DeviceParameters`、`struct_size`、字段偏移、CRC范围和FRAM布局不变。升级不恢复出厂、不清除现场参数，无需迁移或补默认值。

## 3. 本次提交范围

### 3.1 V4幂等通信错误最多尝试3次并逐次打印原包

- 源码位置：`LTD_MAIN_CPU2/Services/Sensor/Protocols/Dm4/V4/multiparam_v4_interactive.c`的`MULTIPARAM_V4_TransceiveIdempotent`；`multiparam_v4_diagnostics.c`的`MULTIPARAM_V4_PrintTransactionFailureAttempt`和`MULTIPARAM_V4_PrintFailurePackets`；对应声明位于`multiparam_v4_communication.h`和`multiparam_v4_internal.h`。
- 改前问题：V4读取虽然存在三次循环，但各类返回码没有明确区分是否可重试，也没有在每次通信失败后输出对应TX/RX原包和尝试序号，现场难以确认是哪一包导致失败。
- 具体改法：仅将超时、UART传输、响应格式、BCC和地址不匹配列为可重试通信错误；每次失败后打印TX、实收RX、失败阶段、UART状态和`尝试=n/3`，第三次后返回最后错误。后续尝试成功时记录恢复日志。同一事务增加打印去重，避免协议层和业务层重复输出。
- 必查边界：首次成功、第二/第三次成功、连续三次同类或不同类通信错误、空RX、短帧、错误地址、BCC错误、命令切换、非重试错误、tick回绕和UART所有权切换。
- 通过标准：五类可重试通信错误最多产生三次真实发送，每次失败均有对应包；成功立即停止后续发送；非重试错误不额外发送；返回码保持最后一次真实结果。

### 3.2 主动与交互模式统一提供失败包证据

- 源码位置：`LTD_MAIN_CPU2/Services/Sensor/sensor_comm_diagnostics.c/.h`的`SensorComm_PrintFailurePackets`；`multiparam_v4_diagnostics.c`的主动帧和交互事务分流；`part_diagnostics.c`的`PartDiagnostics_ReportV4Failure`。
- 改前问题：交互读取失败只在上层打印最后事务，主动模式没有对应发送事务且缺少匹配的原始帧；多层调用还可能重复打印。
- 具体改法：确认当前已识别为DM4 V4后再输出证据。交互模式优先使用当前事务TX/RX且自动去重；主动模式优先打印错误码匹配且不早于最后有效快照的异常帧，否则打印最近有效主动帧，没有原帧时明确长度0。
- 必查边界：V3/DSM、未识别、主动异常帧早于/晚于快照、交互事务尚未实际发送、业务拒绝频率和`SENSOR_DATA_STALE`。
- 通过标准：只在DM4 V4线程态失败路径打印；不发送额外探测包、不改变错误码；交互事务不重复，主动模式不把旧异常帧误归因于新快照。

### 3.3 读取部件参数复用相同通信重试

- 源码位置：`LTD_MAIN_CPU2/Application/Src/diagnostics/part_diagnostics.c`的状态、密度、分析参数和水位电容读取；底层经`MULTIPARAM_V4_ReadParamRaw`进入幂等事务。
- 改前问题：上层只能看到一次最终错误，无法确认部件参数读取是否进入协议重试，也无法获得主动/交互模式一致的失败包。
- 具体改法：保持原有部件读取顺序和返回码，仅把失败包输出收口到`SensorComm_PrintFailurePackets`。交互参数读取沿用底层最多3次通信尝试；`SENSOR_DATA_STALE`仍表示当前数据未更新，不打印为通信故障。
- 必查边界：状态读取、密度/温度/频率、水位电容、分析参数、主动数据未更新、模式切换失败和命令切换。
- 通过标准：部件参数的五类交互通信错误按底层最多尝试3次；未稳定/未更新数据不触发通信错误包；原有首个真实错误继续向上返回。

### 3.4 频率0等待与非零越界业务判定

- 源码位置：`multiparam_v4_measurement.c`的`MULTIPARAM_V4_MeasurementReadLevelFrequency`；`oil_level_common.c`的`OilLevel_ReadFrequencySample`和`OilLevel_ReadValidatedFrequencyInternal`；`oil_level_frequency.c`与`oil_level_step_search.c`的运动读取路径。
- 改前问题：V4测量层把0或越界频率直接归为`SONIC_FREQ_ABNORMAL`，导致0这个“当前未稳定”状态一次即报错，上层也无法统一执行三次业务判定。
- 具体改法：交互和主动路径收到0时返回`NO_ERROR`并输出频率0，不刷新调试频率。非零可解码样本原样返回，由液位业务层按`1..6500 Hz`判断。静止校验遇0只等待下一样本且不增加错误计数；运动闭环和步进判定遇0先停机、清稳定状态并等待。非零越界每轮连续计数3次后才进入原有有限模式恢复，搜索流程继续受统一超时约束。
- 必查边界：`0`、`1`、`6500`、`6501`、`6600`、`6601`、普通负值和`INT32_MIN`；主动/交互、静止/运动、搜索超时和跟随无超时路径。
- 通过标准：0不会直接产生频率异常且运动停止；`1..6500 Hz`正常进入业务；非零越界不由V4测量层首次报错，液位层完成连续计数；真实通信错误仍立即返回底层错误。

### 3.5 自动恢复检查有界退出并保留首次错误

- 源码位置：`LTD_MAIN_CPU2/Application/Src/diagnostics/fault_recovery.c`的`FaultRecoveryContext`、`FaultRecovery_HandleCheckFailure`、`FaultRecovery_Start`和`FaultRecovery_Poll`。
- 改前问题：电机初始化或部件检查持续失败时，每秒重复检查但没有独立上限；后续检查错误还会覆盖首次触发自动恢复的原因。
- 具体改法：分别保存首次触发错误和最近错误；恢复检查失败使用独立计数，达到配置的自动恢复上限后保持`STATE_ERROR`、停止恢复并打印首次/最终错误。检查成功后清检查失败段，再按原业务重跑计数决定是否重跑原命令。
- 必查边界：电机错误触发、通信错误触发、检查间歇成功、连续失败到上限、业务重跑失败、达到业务上限和新命令取消。
- 通过标准：连续检查失败不会无限轮询；首次触发错误不被覆盖；检查次数和业务重跑次数互不混用；新命令仍能立即取消恢复。

## 4. 提交文件清单

- `LTD_MAIN_CPU2/Application/Inc/app_version.h`
- `LTD_MAIN_CPU2/Application/Src/diagnostics/fault_recovery.c`
- `LTD_MAIN_CPU2/Application/Src/diagnostics/part_diagnostics.c`
- `LTD_MAIN_CPU2/Application/Src/measurement/oil_level/oil_level_common.c`
- `LTD_MAIN_CPU2/Application/Src/measurement/oil_level/oil_level_frequency.c`
- `LTD_MAIN_CPU2/Application/Src/measurement/oil_level/oil_level_internal.h`
- `LTD_MAIN_CPU2/Application/Src/measurement/oil_level/oil_level_step_search.c`
- `LTD_MAIN_CPU2/Services/Sensor/Protocols/Dm4/V4/multiparam_v4_communication.h`
- `LTD_MAIN_CPU2/Services/Sensor/Protocols/Dm4/V4/multiparam_v4_diagnostics.c`
- `LTD_MAIN_CPU2/Services/Sensor/Protocols/Dm4/V4/multiparam_v4_interactive.c`
- `LTD_MAIN_CPU2/Services/Sensor/Protocols/Dm4/V4/multiparam_v4_internal.h`
- `LTD_MAIN_CPU2/Services/Sensor/Protocols/Dm4/V4/multiparam_v4_measurement.c`
- `LTD_MAIN_CPU2/Services/Sensor/sensor_comm_diagnostics.c`
- `LTD_MAIN_CPU2/Services/Sensor/sensor_comm_diagnostics.h`
- `CHANGELOG.md`
- `docs/00_构建与版本/版本改动与测试/2026-09-03_CPU2_V1.42.9.0_V4通信重试与频率判定修复_改动与测试方案.md`

本机同步但不提交：`docs/00_程序流程导航/CPU2/04_液位测量与跟随.html`、`07_故障管理与恢复.html`、`09_传感器与无线通信.html`、`流程证据清单.json`及`tools/update_multiparam_v4_flow_docs.py`。它们记录了频率0等待、非零越界判定、通信重试和恢复检查上限；按仓库边界不进入Git。

## 5. 可执行测试矩阵

| 编号 | 关联改动 | 前置条件和操作 | 观测位置 | 预期结果和通过标准 | 状态/证据 |
| --- | --- | --- | --- | --- | --- |
| V4-RETRY-01 | 3.1 | 对同一R请求分别注入超时、UART、短帧/BCC、错地址，连续失败3次 | UART6抓包、CPU2日志 | 每类最多3次TX；每次有对应TX/RX和`尝试=n/3`；最终返回最后错误 | 待台架 |
| V4-RETRY-02 | 3.1 | 第1次通信错误，第2次返回合法应答 | UART6抓包、恢复日志 | 只发送2次并记录第2次恢复成功，不再发送第3次 | 待台架 |
| V4-RETRY-03 | 3.1 | 触发`STATE_SWITCH`、调用条件错误或模式不匹配 | UART6抓包 | 不执行通信重试，不产生伪造TX包 | 静态契约通过，待台架 |
| V4-WRITE-01 | 3.1 | W命令应答丢失但远端实际写入成功 | UART6抓包、参数读回 | W只发送1次；读回值一致时按成功处理 | 待台架 |
| V4-LM-01 | 3.1 | L/M应答丢失 | UART6抓包、状态R02 | L/M不盲目重发，后续只通过状态确认 | 静态契约通过，待台架 |
| V4-PACKET-01 | 3.2 | 交互读取在第1、2、3次分别失败 | CPU2原包日志 | 每次输出本次8字节TX和实际RX，业务层不重复打印 | 待台架 |
| V4-PACKET-02 | 3.2 | 主动模式注入CRC/固定字段异常后触发业务失败 | 主动异常包日志 | 打印匹配异常帧；无匹配异常时使用最近有效主动帧并标明来源 | 待台架 |
| PART-READ-01 | 3.3 | 命令15读取状态、密度和水位电容时令前两次超时、第3次成功 | UART6抓包、部件参数输出 | 各幂等参数读取最多3次，成功后继续原流程 | 待台架 |
| PART-READ-02 | 3.3 | 主动数据代次未更新 | CPU2日志 | 返回`SENSOR_DATA_STALE`，不打印为通信错误 | 静态契约通过，待台架 |
| V4-FREQ-01 | 3.4 | 交互和主动路径分别输入0 | CPU2日志、频率输出 | 返回`NO_ERROR`和0，不上报`SONIC_FREQ_ABNORMAL`，不发布为有效调试频率 | 静态契约通过，待台架 |
| V4-FREQ-02 | 3.4 | 运动中连续输入0 | 电机状态、液位稳定标志 | 电机先停止，稳定/命中状态清零，等待下一样本且不增加非零越界计数 | 静态契约通过，待台架 |
| V4-FREQ-03 | 3.4 | 依次输入1、6500、6501、6600、6601 Hz | V4返回值、液位业务日志 | 1和6500有效；6501及以上交液位层判定，不在V4层首次报错 | 静态契约通过，待台架 |
| V4-FREQ-04 | 3.4 | 连续输入3个非零越界样本 | 重试日志、模式切换包 | 第3个样本后才进入模式恢复；搜索总超时仍有效 | 静态契约通过，待台架 |
| RECOVER-01 | 3.5 | 自动恢复检查连续失败到配置上限 | CPU2恢复日志、设备状态 | 检查失败次数达到上限后停止恢复并保持`STATE_ERROR` | 静态契约通过，待台架 |
| RECOVER-02 | 3.5 | 首次电机错误，后续部件检查返回通信错误 | 恢复停止日志 | 同时保留首次电机错误和最终通信错误，电机初始化判断不丢失 | 静态契约通过，待台架 |
| STATIC-01 | 全部 | 运行8项V4、传感器、液位、故障和Safe集成检查 | 主机脚本输出 | 所有脚本退出码0 | 已通过，2026-09-03 |
| FLOW-01 | 全部 | 运行`py tools/check_flow_docs.py`及严格流程影响检查 | 主机脚本输出 | HTML合同通过，3个受影响页面无未分类源码 | 已通过，2026-09-03 |
| BUILD-01 | 全部 | 在隔离验证树应用与主工作区哈希一致的14个固件文件，配置Debug并clean-first构建 | 隔离树`build/LTD_MAIN_CPU2` | 132个目标完成，无编译/链接错误 | 已通过，2026-09-03 17:32:12 |

## 6. 已执行验证证据

- 静态检查：`check_v4_retry_zero_recovery_contract.py`、`check_multiparam_v4_protocol.py`、`check_sensor_service_architecture.py`、`check_density_level_control_contract.py`、`check_read_part_params_refresh_contract.py`、`check_sensor_fault_contract.py`、`check_tmc5130_diagnostic_contract.py`和`check_sensor_safe_cpu2_integration.py`全部退出码0。
- 流程HTML：`py tools/check_flow_docs.py`通过，检查34页、196张SVG和60张表格；`check_flow_impact.py --strict`确认13个固件文件全部映射到04、07、09三个受影响页面，待判断为0。
- 构建环境：`CMake + Ninja`，GNU Arm Embedded GCC 15.2.1，Debug配置。
- 构建命令：`cmake -S LTD_MAIN_CPU2 -B build/LTD_MAIN_CPU2 -G Ninja "-DCMAKE_TOOLCHAIN_FILE=D:/CUBE/cmake/toolchain-arm-none-eabi.cmake" -DCMAKE_BUILD_TYPE=Debug`；`cmake --build build/LTD_MAIN_CPU2 --clean-first -j 8`。
- 构建结果：132个目标完成，`text=360060`、`data=2360`、`bss=59632`；ELF的SHA-256为`035B74BEA17025EC3AAF04D9D150DAE4377499A5B8E3EBDAC7192273FFF520AD`。
- 固件产物：固定名和`LTD_MAIN_CPU2_V1.42.9.0_DEBUG.hex`大小均为1019478字节，SHA-256均为`D1E5F2C5FEBD55AEF11DC9AC36A7F5210452FD816449AF0D9D53DAE1467985A3`；BIN大小362444字节，SHA-256为`5EC8428AB0AC0FFC20C47FEAE4D9398A0A7515CC2E08C0C68F5A126448938036`。
- 构建证明最终固件文件可编译链接，不证明目标板、UART6/RS485时序、传感器响应或恢复动作符合现场要求。

## 7. 回归范围

- V4 R01/R02/R04/R05/R06/R07/R22/R65/R67读取，D/S模式切换，W写入读回，L取水和M磁零点。
- V4主动帧接收、异常帧保存、交互抢占、UART6所有权、帧间隔、地址学习和广播请求地址策略。
- 命令15读取部件参数、DM4综合通信自检、密度/温度/水位电容和分析参数刷新。
- 方法0/1步进找液位、方法4/5频率速度闭环、液位跟随、命令切换、搜索超时和停机失败出口。
- 自动恢复的电机初始化、部件检查、业务重跑、新命令取消和达到上限停止。

## 8. 风险与未验证项

- 未执行真实DM4 V4传感器和RS485抓包，无法以静态检查证明每次异常包与物理总线时序一一对应。
- 未执行超时、UART、短帧、BCC、错地址组合故障注入；不同错误跨3次尝试时的现场日志可读性仍需台架确认。
- 未执行频率0、6500/6501/6600/6601及`INT32_MIN`真实帧注入；运动中停机时序和稳定标志需目标板观测。
- 未执行长时间自动恢复和新命令抢占压力测试；检查上限退出只由静态契约覆盖。
- 未执行现场、硬件故障注入或SIL独立验证；本提交不能作为这些证据的替代。

## 9. 提交前检查清单

- [x] CPU2版本按BUG修复由`V1.42.8.0`升为`V1.42.9.0`，CPU3保持`V1.40.1.0`。
- [x] `DEVICE_PROTOCOL_VERSION=35`、`DEVICE_PARAM_VERSION=3`，参数结构和存储布局不变。
- [x] `CHANGELOG.md`覆盖版本、兼容性、改动、验证和未验证边界。
- [x] CPU2 Debug clean-first构建和8项相关静态检查通过。
- [x] 本机流程导航已同步；`tools/`和`docs/00_程序流程导航/`不进入Git。
- [ ] 最终scoped暂存区执行版本、提交范围、提交信息、编码、`git diff --cached --check`和敏感信息门禁。
- [ ] 提交后核对完整正文、真实文件范围、剩余并行改动及`origin/MAIN..HEAD`标题版本门禁。
