duanxuebin1998/cube/docs/00_构建与版本/版本改动与测试/2026-08-27_CPU2_V1.42.8.0_V4帧间隔与负频率提示_改动与测试方案.md

# CPU2 V1.42.8.0 V4帧间隔与负频率提示改动与测试方案

## 1. 版本和适用范围

- CPU2：`V1.42.7.0 -> V1.42.8.0`（PATCH）。
- CPU3：保持`V1.40.1.0`。
- 适用链路：CPU2 DM4 多参数传感器 V4 交互读写、主动转交互窗口、密度/液位前台频率读取。

## 2. 协议和参数存储兼容性

- `DEVICE_PROTOCOL_VERSION`保持35；不改变CPU2/CPU3共享寄存器、共享命令、共享状态或共享字段。
- DM4 V4帧格式和命令语义保持兼容；所有8字节V4请求新增CPU2侧事务间最小30 ms门禁。
- CPU2 `DEVICE_PARAM_VERSION`保持3；`DeviceParameters`大小、字段偏移、元信息和CRC范围不变。
- 升级不会恢复出厂参数、不清除现场参数；无需参数迁移。

## 3. 本次提交范围

### 3.1 V4事务帧间隔

- 源码位置：`LTD_MAIN_CPU2/Services/Sensor/Protocols/Dm4/V4/multiparam_v4_internal.h` 的 `MULTIPARAM_V4_INTER_FRAME_GAP_MS`；`multiparam_v4_interactive.c` 的 `MULTIPARAM_V4_WaitInterFrameGap`、`MULTIPARAM_V4_MarkTransactionEnd` 和 `MULTIPARAM_V4_TransceiveOnceInternal`。
- 改前问题：连续V4事务可能在上一笔事务收尾后立即进入下一次发送，无法保证总线静默时间。
- 具体改法：事务成功、业务校验失败、异常帧和超时返回前后统一记录退出 tick；下一次发送前以 `HAL_GetTick() - last_exit_tick >= 30` 检查，不满足时每次延时1 ms；主动转交互还必须同时满足主动帧15～100 ms窗口。
- 必查边界：首次事务无历史tick、有效应答、业务校验失败、短帧、UART错误、无响应超时、命令切换请求、主动帧窗口过早/过晚、tick回绕。
- 通过标准：相邻V4事务TX时间戳差值满足上一笔事务退出后至少30 ms；错误或超时后下一次V4 TX也满足同一门禁；不产生永久等待。

### 3.2 负频率提示

- 源码位置：`LTD_MAIN_CPU2/Services/Sensor/Protocols/Dm4/V4/multiparam_v4_measurement.c` 的 `MULTIPARAM_V4_PrintNegativeFrequencyWarning` 及密度/液位读取入口。
- 改前问题：前台读到负频率时没有明确提示当前频率可能不稳定，现场容易把该值当作可信频率。
- 具体改法：密度交互读取、密度主动快照读取、液位交互读取和液位主动快照读取在消费R04前台值时，检测负值并打印原始有符号频率；不改变既有返回码、原始值保留、绝对值发布和无效值归一化。
- 必查边界：`0`、正值、普通负值、`INT32_MIN`、超量程值、密度模式和液位模式、交互和主动两条路径。
- 通过标准：负值出现一条明确提示并包含原始值；返回码和业务归一化结果与改动前保持一致；`INT32_MIN`不执行未定义的绝对值转换。

## 4. 测试矩阵

| 编号 | 关联改动 | 前置条件与步骤 | 观测位置 | 通过标准 | 状态 |
| --- | --- | --- | --- | --- | --- |
| V4-GAP-01 | 3.1 | 连续发送至少20笔正常R02/R/W请求，记录RX结束和下一笔TX时间戳 | UART6逻辑分析仪/抓包 | 每笔事务退出后至下一TX不少于30 ms | 待执行 |
| V4-GAP-02 | 3.1 | 注入业务校验失败和坏帧后继续发送下一笔R02 | UART6抓包、V4诊断 | 错误返回后仍满足30 ms，不立即重发 | 待执行 |
| V4-GAP-03 | 3.1 | 让传感器无响应直至事务超时，再触发下一笔读取 | UART6抓包、错误日志 | 超时路径记录退出tick，下一TX经过门禁且无死锁 | 待执行 |
| V4-GAP-04 | 3.1 | 主动帧窗口内执行V4I，覆盖事件年龄小于15 ms、15～100 ms、大于100 ms | UART6抓包 | 仅双门禁同时满足时发送W/R65=1 | 待执行 |
| V4-FREQ-01 | 3.2 | 交互密度模式返回R04正值、0、负值 | CPU2串口日志和测量输出 | 负值打印提示；0和正值行为不变 | 待执行 |
| V4-FREQ-02 | 3.2 | 主动快照分别提供正值、0、负值和`INT32_MIN` | CPU2测量输出 | 负值提示；`INT32_MIN`按无效编码处理 | 待执行 |
| V4-FREQ-03 | 3.2 | 液位模式重复V4频率读取并切换交互/主动路径 | CPU2串口日志 | 两条路径均提示负值且不改变原返回码 | 待执行 |
| V4-REG-01 | 3.1/3.2 | 运行V4协议、传感器服务架构、传感器故障、参数测量故障、读取部件参数刷新、DSM兼容和探测日志契约检查 | 主机脚本输出 | 所有相关检查通过 | 已通过 |
| V4-BUILD-01 | 3.1/3.2 | CPU2 Debug clean-first构建 | `build/LTD_MAIN_CPU2` | 132个目标完成，无编译/链接错误；`text=357012`、`data=2352`、`bss=59632` | 已通过 |

## 5. 回归范围

- V4协议探测R01、状态R02、参数R/W、密度/液位模式D/S、取水L、磁零点M和通信方式切换R65。
- 主动接收、主动帧校验失败、主动帧超时、交互抢占、UART6所有权交接和命令切换恢复。
- 密度无效值归一化、温度NaN处理、频率范围校验、`INT32_MIN`和快扫完成标志解析。

## 6. 已执行验证和未验证风险

- 已完成工作区差异和协议文档对照，确认本次不改变共享协议版本和参数存储布局。
- 已对用户提供的V4抓包复核：相邻RX到TX为38～41 ms，说明当前30 ms门禁之外还有日志和调度开销；该抓包不是目标板认证证据。
- 已执行相关静态检查、`git diff --check`和CPU2 V1.42.8.0 Debug clean-first构建；结果均通过。
- 尚未由本方案证明真实RS485静默时间、传感器响应边界、目标板异常注入、长时间恢复和SIL安全证据；这些必须在对应硬件/台架环境单独验证。
