duanxuebin1998/cube/docs/00_构建与版本/版本改动与测试/2026-08-26_CPU2_V1.42.5.0_DM4综合通信自检修复_改动与测试方案.md

# CPU2 V1.42.5.0 DM4综合通信自检修复改动与测试方案

## 1. 文档目的和适用版本

本文记录CPU2 V1.42.5.0相对V1.42.4.0的提交范围、兼容性、已执行验证、台架测试步骤和未验证风险。本次为CPU2范围提交，不修改CPU3，不自动推送。

## 2. 版本、协议和参数存储兼容性

- CPU2：`V1.42.4.0 -> V1.42.5.0`，PATCH。
- CPU3：保持`V1.40.1.0`。
- CPU2/CPU3 `DEVICE_PROTOCOL_VERSION`保持35；不修改共享寄存器、共享命令、共享状态和共享字段。
- CPU2 `DEVICE_PARAM_VERSION`保持3；`DeviceParameters`结构大小、字段偏移、CRC范围和FRAM布局不变，升级不恢复出厂、不清除现场参数。
- DM4 V4、V3、DSM和CH9141K线上帧格式、命令、地址及错误码不变；本次仅调整CPU2串口调试命令`SC`的调用顺序和测试结果归类。

## 3. 本次提交范围

- CPU2服务调试：`LTD_MAIN_CPU2/Application/Src/service_debug/service_debug_command.c`。
- CPU2版本：`LTD_MAIN_CPU2/Application/Inc/app_version.h`。
- 正式资料：`CHANGELOG.md`、`docs/01_协议与寄存器/CPU2通信与解耦/CPU2串口调试指令与打印信息梳理.md`和本文档。
- 本机同步但不提交：`tools/check_sensor_probe_trace.py`、`tools/update_multiparam_v4_flow_docs.py`和`docs/00_程序流程导航/`。
- 其它已修改或未跟踪的构建配置、串口代码、SIL资料和测试目录全部保留，不进入本次提交。

## 4. 逐项改动清单

### 4.1 SC先监听V4主动帧再按需查询蓝牙

- 源码位置：`service_debug_command.c`的`SensorWireless_CommTest()`；调用链为串口`SC` -> `SensorService_Detect()` -> V4主动监听 -> 必要时蓝牙AT查询 -> 透传恢复后再次监听 -> 交互协议识别。
- 改前问题：`SC`在调用统一识别流程前额外执行一次`WirelessPairing_CheckBluetoothLink()`。V4主动DMA已经占用UART6时，蓝牙AT查询无法取得链路所有权并返回`0x000D0021`，随后统一识别却能通过主动帧识别成功，形成同一轮测试先报蓝牙异常再报传感器正常的矛盾结果。
- 具体改法：删除`SC`入口的重复蓝牙查询和只为该查询服务的停止辅助函数；`SC`直接调用`SensorService_Detect()`，由识别流程统一保证“主动监听优先、未命中才查蓝牙、恢复透传后再监听”的顺序。
- 必查边界：查询前主动帧命中、查询前监听超时、蓝牙已连接、蓝牙未连接、AT查询失败、透传恢复后主动帧命中、主动帧两次未命中后V4/V3/DSM交互回退及命令切换。
- 通过标准：主动帧命中时本轮不进入蓝牙AT查询且不出现`0x000D0021`；主动帧未命中时仍打印蓝牙链路检查和透传恢复后监听阶段；协议识别结果及原始探测包保持可观察。

### 4.2 空气中DM4密度无效不计通信故障

- 源码位置：`service_debug_command.c`的`SensorWireless_CommTest()`；调用链为DM4识别 -> 切换密度模式 -> `SensorService_ReadDensity()` -> `SC`结果计数和日志。
- 改前问题：DM4位于空气中时可能返回R04为0、R07为NaN。8字节请求、应答和校验均成功，但协议层以`SENSOR_DATA_STALE`表示当前密度无有效值，旧`SC`通过通用结果函数把它计为通信失败并打印`0x000D0024`。
- 具体改法：仅当返回值为`SENSOR_DATA_STALE`且当前V4通信方式为交互模式时，`SC`增加成功计数并打印“交互通信正常，当前密度无有效值（空气中允许）”；不写频率、密度和温度输出，也不改变协议驱动及正式测量接口的返回值。
- 必查边界：交互模式有效密度、交互模式R07为NaN、交互模式其它通信或格式错误、主动模式快照过期、主动模式无密度新数据、传感器模式不匹配和密度模式切换失败。
- 通过标准：交互模式R04为0、R07为NaN时`SC`该项打印`[正常]`且失败计数不增加；主动上报超时及其它错误仍打印`[异常]`和原错误码；正式测量流程仍能收到`SENSOR_DATA_STALE`。

## 5. 数据流和异常闭环

- 识别链路：`SC` -> `SensorService_Detect()` -> 首次V4主动监听；未命中后才执行蓝牙链路查询，恢复透传后再次监听，最后进入R01/V3/DSM交互探测。
- 密度链路：DM4识别成功 -> `SensorService_EnableDensityMode()` -> `SensorService_ReadDensity()`；有效结果按原格式打印，交互模式空气密度无效只改变调试汇总，主动超时和其它错误仍进入通用失败记录。
- 本次不修改传感器驱动、错误码、全局故障状态、正式测量状态机、CPU2/CPU3共享数据或参数存储。

## 6. 可执行测试矩阵

### T01 V4主动上报识别优先

- 前置条件：DM4参数65处于主动上报方式，蓝牙透传正常。
- 步骤：执行`SC`，记录首次72字节主动帧、是否进入蓝牙AT查询、识别结果和汇总计数。
- 预期与通过标准：首次主动帧命中后直接完成V4识别，不打印蓝牙AT查询异常，不出现`0x000D0021`。
- 执行状态：未执行；缺少本轮目标板和真实主动上报台架。

### T02 V4交互模式空气探头

- 前置条件：DM4处于交互通信，探头在空气中；确认R04为0、R06为有限温度、R07为NaN。
- 步骤：执行`SC`并保存R02/R04/R06/R07原始应答和最终汇总。
- 预期与通过标准：模式切换和8字节交互校验成功；密度读取打印`[正常]`及“当前密度无有效值（空气中允许）”，失败数不因`0x000D0024`增加。
- 执行状态：现场原始帧已证明R04为0、R06为27.61、R07为NaN；V1.42.5.0目标板汇总尚未复测。

### T03 V4交互模式有效介质

- 前置条件：DM4浸入可形成有效密度的稳定介质，处于交互通信。
- 步骤：执行`SC`，记录频率、密度、温度和汇总。
- 预期与通过标准：三项值通过范围检查并按原格式输出；成功计数增加且不进入空气无效提示分支。
- 执行状态：未执行，缺少本轮真实介质台架。

### T04 主动流超时和其它错误保持失败

- 前置条件：分别制造主动帧超时、8字节应答超时、校验失败或模式不匹配。
- 步骤：执行`SC`并记录错误码和汇总计数。
- 预期与通过标准：主动模式`SENSOR_DATA_STALE`及其它错误仍打印`[异常]`，保留原错误码并增加失败数，不被空气无效特例吞掉。
- 执行状态：未执行，缺少可控故障注入环境。

## 7. 已执行验证

- `py tools/check_sensor_probe_trace.py`通过，确认`SC`先进入统一识别流程、V4主动帧监听早于蓝牙查询，且空气密度无效特例仅作用于V4交互模式。
- `py tools/check_wireless_rssi_contract.py`和`py tools/check_sensor_service_architecture.py`通过。
- `service_debug_command.c`与`app_version.h`通过CP936严格解码和CRLF检查；`py -X utf8 tools/check_flow_docs.py`通过，程序流程HTML契约为33页、194张SVG、59张表格。
- `py -X utf8 tools/check_docs.py`的正式文档结构检查通过；其聚合流程同步检查因工作区另有18个非本任务源码改动而报告对应本机流程页待同步，本次scoped提交不纳入这些其它改动。
- CPU2 V1.42.5.0在隔离候选树执行`cmake --build build/LTD_MAIN_CPU2 --clean-first -j 8`通过，132个目标完成编译链接；`text=357556`、`data=2352`、`bss=59624`。
- `LTD_MAIN_CPU2.hex`与`LTD_MAIN_CPU2_V1.42.5.0.hex`的SHA-256均为`AF6335F2A55C0C4FC367F0D71FAD715E9F8DD1C592F6CA57C764B5C4353A6424`；`LTD_MAIN_CPU2.bin`的SHA-256为`A8E3C771537EAAFDB4CDA5CB81F5F20486FBEBBF3027B9703DCFA62CBE0C7090`。

## 8. 回归范围和风险

- 回归范围：`SC`命令分发、V4主动帧识别、蓝牙AT查询与透传恢复、V4交互识别、V3/DSM回退、DM4密度模式切换、有效密度输出、空气密度无效提示、主动流超时和命令切换。
- 未执行真实DM4/V3/DSM、CH9141K、RS485、目标板、台架、现场或SIL验证；构建和静态契约不能证明真实UART6所有权切换、无线恢复首帧时序或空气/介质测量行为。
- `SENSOR_DATA_STALE`仍由正式测量和协议层原样传播；本次非故障口径只适用于`SC`的V4交互通信自检，不扩大到主动流或生产测量流程。

## 9. 提交前检查清单

- [x] CPU2升级为`V1.42.5.0`；CPU3保持`V1.40.1.0`。
- [x] `DEVICE_PROTOCOL_VERSION`保持35；`DEVICE_PARAM_VERSION`保持3。
- [x] CHANGELOG、串口调试说明和本文档覆盖兼容性、改动、测试与未验证风险。
- [x] 最终CPU2 clean-first构建和验证证据新鲜度通过。
- [x] 暂存区范围、编码、hook和版本门禁通过；提交消息按仓库四段式格式校验。
- [x] 根目录Compare通过；提交后继续核对完整提交正文和剩余工作区。
