duanxuebin1998/cube/docs/00_构建与版本/版本改动与测试/2026-08-25_CPU2_V1.42.4.0_部件参数与DM4自检模式修复_改动与测试方案.md

# CPU2 V1.42.4.0 部件参数与DM4自检模式修复改动与测试方案

## 1. 文档目的和适用版本

本文记录CPU2 V1.42.4.0相对V1.42.3.0的提交范围、兼容性、已执行验证、可执行测试和未验证风险。本次只创建本地Git提交，不自动推送；范围外工作区改动保持原样。

## 2. 版本、协议和参数存储兼容性

- CPU2：`V1.42.3.0 -> V1.42.4.0`，PATCH。
- CPU3：保持`V1.40.1.0`。
- CPU2/CPU3 `DEVICE_PROTOCOL_VERSION`保持35；不修改共享寄存器、共享命令、共享状态和共享字段。
- CPU2 `DEVICE_PARAM_VERSION`保持3；参数结构、字段偏移、CRC范围和FRAM布局不变，升级不恢复出厂、不清除现场参数。
- DM4 V4、DSM和V3帧格式、命令码、参数地址及错误码不变；本次仅补齐既有密度模式切换前置。

## 3. 本次提交范围

- CPU2部件诊断：`LTD_MAIN_CPU2/Application/Src/diagnostics/part_diagnostics.c`。
- CPU2服务调试：`LTD_MAIN_CPU2/Application/Src/service_debug/service_debug_command.c`。
- 版本与记录：`LTD_MAIN_CPU2/Application/Inc/app_version.h`、`CHANGELOG.md`和本文档。
- 本机契约检查同步：`tools/check_read_part_params_refresh_contract.py`，按仓库规则不进入Git。
- 其它已修改或未跟踪的文档、测试目录和资料不属于本次提交，全部保留在工作区。

## 4. 逐项改动清单

### 4.1 命令15统一准备密度模式

- 源码位置：`part_diagnostics.c`的`PartDiagnostics_PrepareDensityMode()`和`PartDiagnostics_ReadAllInternal()`；调用链为命令15 -> 识别传感器 -> 切换密度模式 -> `SensorService_ReadDensity()`。
- 改前问题：旧逻辑只对V3/LTD执行密度模式切换。DM4 V4或DSM若继承上一液位测量状态，命令15直接读取密度，V4在R02业务校验阶段返回`0x000D002F`并停止测量。
- 具体改法：所有已识别传感器在读取密度前统一调用`SensorService_EnableDensityMode()`；非V3成功后立即读取，V3继续执行原有3000 ms稳定等待；模式切换错误和命令切换`STATE_SWITCH`沿既有出口返回。
- 必查边界：V4从液位模式进入、V4已处于密度模式、DSM、V3稳定等待、切换失败、等待期间命令切换和未知传感器类型。
- 通过标准：V4或DSM处于液位模式时执行命令15，先完成密度模式切换再读取密度，不再因残留模式返回`0x000D002F`；V3等待时序和中断行为不变。

### 4.2 DM4诊断测试显式准备密度模式

- 源码位置：`service_debug_command.c`的`Sensor_CommCheckAndLog()`和`SensorWireless_CommTest()`；消费链路为诊断入口 -> DM4模式切换 -> 密度/温度/频率读取 -> 结果计数与日志。
- 改前问题：两处DM4诊断路径直接读取密度，残留液位模式会被计为通信失败，无法区分模式前置缺失与真实通信错误。
- 具体改法：读取前调用`SensorService_EnableDensityMode()`并单独记录切换结果；切换失败时保留底层错误和失败计数，不再发送后续密度读取。
- 必查边界：切换成功、切换超时、帧校验失败、业务校验失败、已处于密度模式、无线识别后首次读取和连续多次诊断。
- 通过标准：模式切换与密度读取分别形成可观察日志；切换失败只计一次对应失败且不继续读密度；成功时输出频率、密度和温度。

## 5. 数据流和异常闭环

- 命令15：命令分发 -> `PartDiagnostics_ReadAllInternal()` -> 传感器识别 -> `SensorService_EnableDensityMode()` -> V3可中断稳定等待 -> `SensorService_ReadDensity()` -> 成功打印或既有故障上报。
- DM4自检：调试入口 -> `SensorService_EnableDensityMode()` -> 独立打印/记录切换结果 -> 成功后读取密度 -> 输出数据或记录底层错误。
- 本次不修改V4底层R02模式校验，因为该校验能正确识别调用方前置缺失；修复位于发起密度读取的业务入口。

## 6. 可执行测试矩阵

### T01 DM4液位模式后执行命令15

- 前置条件：CPU2 V1.42.4.0目标板连接DM4 V4传感器，先执行液位测量使R02 Bit0为1。
- 步骤：执行命令15，抓取模式切换及后续R02通信包、返回码和最终状态。
- 预期与通过标准：先完成密度模式切换，后续密度读取帧通过业务校验；不出现`0x000D002F`，命令继续输出密度、温度和频率。
- 执行状态：未执行，缺少本轮目标板和真实DM4台架。

### T02 DM4已处于密度模式时执行命令15

- 前置条件：DM4 R02 Bit0为0，通信正常。
- 步骤：连续执行命令15至少3次，记录每次模式准备、读取结果和耗时。
- 预期与通过标准：模式准备幂等成功，每次读取均不改变错误语义，不产生模式不一致故障。
- 执行状态：未执行，缺少本轮目标板和真实DM4台架。

### T03 DSM和V3兼容回归

- 前置条件：分别连接DSM和V3/LTD传感器。
- 步骤：使传感器经历液位读取后执行命令15；V3等待期间再下发其它命令。
- 预期与通过标准：DSM先执行既有密度模式命令再读取；V3保留3000 ms稳定等待；等待期间命令切换返回`STATE_SWITCH`且不置普通测量故障。
- 执行状态：未执行；DSM兼容和命令15源码契约检查已通过，但不替代真实设备。

### T04 DM4通信自检模式切换失败

- 前置条件：可通过断线、超时或仿真响应使密度模式切换失败。
- 步骤：分别执行普通DM4通信自检和无线综合通信测试，记录包序列、日志和计数。
- 预期与通过标准：日志明确记录“DM4切换密度模式”失败；本轮不发送密度读取；保留原底层错误码且不重复计数。
- 执行状态：未执行，缺少可控RS485故障注入环境。

## 7. 已执行验证

- 六项传感器静态契约通过：命令15刷新合同、V4协议、传感器服务架构、传感器故障、DSM兼容和测量故障合同。
- 修改后的CP936源码和版本头严格往返检查通过，无替换字符；源码保持CRLF，新增注释使用块注释。
- CPU2执行`cmake --build build/LTD_MAIN_CPU2 --clean-first -j 8`并通过，132个目标完成编译链接，生成V1.42.4.0 ELF/HEX/BIN；`text=356716`、`data=2352`、`bss=59624`。
- 程序流程导航已在本机同步到V1.42.4.0，命令15流程图补充统一密度模式准备节点；`check_flow_docs.py`检查33页HTML、194张SVG和59张表格通过，严格流程影响检查通过。
- `git diff --cached --check`、scoped提交范围、hook、版本一致性和根目录Compare均已在最终暂存区上执行并通过。

## 8. 回归范围和风险

- 回归范围：命令15刷新循环、V3等待中断、DM4主动/交互通信、DSM密度读取、普通密度测量、液位测量后切换、无线识别及两类DM4通信自检。
- 未执行真实DM4/DSM/V3、RS485、无线滑环、目标板、台架、现场或SIL验证；构建和静态契约不能证明真实传感器时序、总线质量或模式切换耗时。
- `MotorLostStep_NoDetectRuntimeLogUpdate()`的密度读取属于不改变传感器业务模式的尽力运行日志，错误被局部忽略且不会置全局故障；本次不从电机层引入传感器模式切换副作用。

## 9. 提交前检查清单

- [x] CPU2升级为`V1.42.4.0`；CPU3保持`V1.40.1.0`。
- [x] `DEVICE_PROTOCOL_VERSION`保持35；`DEVICE_PARAM_VERSION`保持3。
- [x] `CHANGELOG.md`和本文档覆盖兼容性、改动、验证与未验证风险。
- [x] 最终V1.42.4.0 CPU2 clean-first构建和验证证据新鲜度通过。
- [x] 暂存区范围、编码、`git diff --cached --check`、hook及提交消息门禁通过。
- [x] 根目录Compare通过；提交后版本标题检查按真实提交范围执行。
- [x] 本文档随本次提交纳入，提交哈希以Git记录为准。
