duanxuebin1998/cube/docs/00_构建与版本/版本改动与测试/2026-08-21_CPU2_V1.42.1.0_测量流程模块拆分与探底兜底恢复_改动与测试方案.md

# CPU2 V1.42.1.0 测量流程模块拆分与探底兜底恢复改动与测试方案

## 1. 文档目的和适用版本

本文记录CPU2 V1.42.1.0相对V1.42.0.0的提交范围、兼容性、已执行验证和未验证风险。本次只创建本地Git提交，不自动推送；`tools/`、`docs/00_程序流程导航/`、`docs-site/`、`outputs/`和`tmp/`不进入提交。

## 2. 版本、协议和参数存储兼容性

- CPU2：`V1.42.0.0 -> V1.42.1.0`，PATCH。
- CPU3：保持`V1.40.1.0`。
- CPU2/CPU3 `DEVICE_PROTOCOL_VERSION`保持35；共享寄存器、共享命令、共享状态和共享字段不变。
- CPU2 `DEVICE_PARAM_VERSION`保持3，`DeviceParameters`结构大小、字段偏移、`struct_size`、CRC范围和FRAM布局不变；升级不恢复出厂、不清除现场参数。
- 串口调试命令名称和正式测量命令编号保持兼容；本次改变集中在CPU2内部代码组织、测量收尾和AO过程样本边界。

## 3. 本次提交范围

- CPU2源码：`Application/Src/measurement/`、`Application/Src/commands/`、`Application/Src/diagnostics/`、`Application/Src/service_debug/`、`Services/MotorControl/`、`Services/Sensor/`和`Services/Weight/`。
- 构建和版本：`LTD_MAIN_CPU2/CMakeLists.txt`、`LTD_MAIN_CPU2/Application/Inc/app_version.h`、`CHANGELOG.md`和本文档。
- 正式资料：`docs/00_构建与版本/`、`docs/01_协议与寄存器/`和`docs/03_问题分析与整改/`下本次暂存的代码规模、故障码和传感器协议资料。

## 4. 逐项改动清单

### 4.1 测量代码目录拆分

- 源码位置：`LTD_MAIN_CPU2/Application/Src/measure*.c`拆分到`Application/Src/measurement/`各子目录，命令入口由`measurement/measure.c`和`measure_commands_internal.h`组织。
- 改前问题：测量、密度、油位、水位、调试和维护逻辑集中在少数大文件，命令入口、算法状态和调试路径边界难以逐项复核。
- 具体改法：按入口分发、液位命令、维护命令、油位、水位、密度、零点和罐高拆分源文件，更新CMake源列表和公共头文件。
- 必查边界：正式命令编号、外部头文件符号、CMake编译清单、旧文件删除、新文件新增和GBK源码编码。
- 通过标准：CPU2 clean-first构建通过，正式命令入口仍由`ProcessMeasureCmd()`分发。

### 4.2 测量启动和命令切换收口

- 源码位置：`Application/Src/measurement/measure.c`的`ProcessMeasureCmd()`；各`CMD_*`命令中的`STATE_SWITCH`返回处理。
- 改前问题：多个命令内部各自调用`MeasureStart()`，初始化时机分散；命令切换可能进入普通错误上报路径。
- 具体改法：分发层统一执行`Encoder_BeginNewProcess()`、`PowerMonitor_BeginNewProcess()`和`MeasureStart()`；测量过程遇到`STATE_SWITCH`时安全停机并直接返回。
- 必查边界：直接调用`CMD_*`、重复测量、取消/切换命令、传感器识别失败和初始化失败。
- 通过标准：正式命令经`ProcessMeasureCmd()`进入时只执行一次测量初始化；命令切换不被记录为普通测量失败。

### 4.3 探底兜底和罐底参考封装

- 源码位置：`measurement/measure_level_commands.c`的`CMD_MeasureBottom()`；`measurement/tank_height/measure_tank_height.c`的`TankHeight_SetBottomCableLength01mm()`；`Services/MotorControl/motor_ctrl_lost_step_detect.c`。
- 改前问题：罐底参考原为全局`bottom_value`，调用边界不清；探底失败或偏差过大时曾被改成不再作为成功参考，偏离原有兜底逻辑。
- 具体改法：罐底参考通过`TankHeight_Set/GetBottomCableLength01mm()`封装，并同步到电机失步检测；恢复非开关错误且允许停止测量时使用标定罐高或当前罐高兜底，设置当前实高和`bottom_reference_valid`后完成探底。
- 必查边界：探底成功、探底失败、偏差超过10.0 mm、命令切换、无罐高参数、失步检测靠近罐底区间。
- 通过标准：失败兜底路径仍能写入罐底参考并结束探底；命令切换不走兜底成功路径。

### 4.4 油位、水位、密度和AO样本边界

- 源码位置：`measurement/oil_level/`、`measurement/water_level/`和`measurement/density/measure_density.c`。
- 改前问题：油位、水位、密度测量的结果提交、AO过程样本失效和前置找液位逻辑分散，异常出口不易保持一致。
- 具体改法：油位通过`OilLevelRuntime_CommitLevel()`和`OilLevelRuntime_StopAndInvalidate()`统一提交或失效AO油位样本；水位通过`WaterLevel_SetAndLog()`统一计算、钳位和发布AO水位样本；密度测量内部统一调用`SearchOilLevel()`完成前置找油位。
- 必查边界：油位负值、无效液位、找油失败、找水失败、跟随误差、AO更新失败、密度测量前找油位失败。
- 通过标准：成功测量发布对应AO过程样本，失败或退出时失效旧样本；静态契约检查通过。

### 4.5 故障管理、部件诊断和串口调试拆分

- 源码位置：`diagnostics/fault_manager.c`、`diagnostics/part_diagnostics.c`、`commands/serial_command.c`和`service_debug/`。
- 改前问题：故障上下文使用外部全局变量，调试命令集中在`test.c`，部件诊断启动测量的职责和正式分发层重叠。
- 具体改法：故障上下文收为`fault_manager`内部静态对象，`RETURN_ERROR`、`CHECK_ERROR`和命令切换走统一函数；部件诊断读取内部不再重复`MeasureStart()`；串口正式入口调用`ServiceDebug_ProcessSerialCommand()`，调试功能按传感器、存储、水位、电机等模块拆分。
- 必查边界：同步错误、异步错误、命令切换、读部件参数、V3/V4调试命令、固定频率调试命令。
- 通过标准：构建和命令解析契约检查通过，正式串口命令仍能进入调试处理模块。

## 5. 已执行验证

- `cmake --build build/LTD_MAIN_CPU2 --clean-first -j 8`：通过，最终CPU2源码、版本头和CMake列表均参与构建。
- `py tools/check_parameter_measurement_fault_contract.py`：通过。
- `py tools/check_command_argument_transaction_contract.py`：通过。
- `py tools/check_si_protocol_contract.py`：通过。
- `py tools/check_version_bumped.py`：通过。
- `py .agents/skills/cube-development/scripts/bootstrap_cube_hooks.py --check --repo-root D:\CUBE`：通过。
- `git diff --cached --check`：通过。
- 根目录布局Snapshot/Compare：通过。

## 6. 回归范围和未验证风险

- 回归范围：探底、罐高标定、找零、找水、跟随水位、找油、跟随油位、综合测量、密度测量、单点密度、读取部件参数、取消/切换命令、电机失步检测、AO输出和V3/V4串口调试。
- 未验证项：尚未执行真实探底、找水、找油、密度测量、命令切换、电机失步、AO输出、RS485、传感器、目标板、台架、现场或SIL验证。
- 风险说明：本次有大范围目录拆分和内部职责收口，构建和静态契约只能证明编译与约束检查通过，不能替代完整目标板流程回归。

## 7. 提交前检查清单

- [x] CPU2版本头升至`V1.42.1.0`；CPU3保持`V1.40.1.0`。
- [x] `DEVICE_PROTOCOL_VERSION`保持35；CPU2 `DEVICE_PARAM_VERSION`保持3。
- [x] `CHANGELOG.md`和本文档覆盖本次主要行为变化、兼容性、验证和未验证风险。
- [x] `tools/`、`docs/00_程序流程导航/`、`docs-site/`、`outputs/`和`tmp/`未进入暂存区。
- [x] 本文件随本次提交纳入，提交哈希以Git记录为准。
