duanxuebin1998/cube/docs/00_构建与版本/版本改动与测试/2026-08-19_CPU2_V1.41.1.0_无线滑环匹配后传感器识别与13-3抑制_改动与测试方案.md

# CPU2 V1.41.1.0 无线滑环匹配后传感器识别与 13-3 抑制改动与测试方案

## 版本与兼容性

- CPU2：`V1.41.0.0 -> V1.41.1.0`，PATCH 修复。
- CPU3：保持 `V1.40.1.0`。
- `DEVICE_PROTOCOL_VERSION` 保持 34；不新增或移动共享寄存器、命令、状态和字段，CPU3 无需修改。
- CPU2 `DEVICE_PARAM_VERSION` 保持 3；参数结构、`struct_size`、CRC 范围和 FRAM 布局不变，升级不恢复出厂参数。
- 无线滑环旧 RSSI 接口继续保留；正式命令 117 使用带传感器识别校验的新接口。

## 改动点

### 1. 匹配后重新识别传感器

- 源码位置：`LTD_MAIN_CPU2/Application/Src/measure.c` 的 `ProcessMeasureCmd`；`LTD_MAIN_CPU2/Services/Sensor/Wireless/wireless_pairing.c/.h` 的 RSSI 匹配入口。调用链为 `命令117 -> RSSI扫描/连接保存 -> SensorService_Detect -> 最终成功状态`。
- 改前问题：无线连接成功后直接发布匹配成功，可能继续使用 FRAM 中旧的传感器类型；测量命令检测状态无效时也可能仅依据旧结果继续执行。
- 具体改法：增加 `WirelessPairing_RunByRssiWithValidator`；命令117在连接保存后调用 `SensorService_Detect`，识别失败则将匹配结果改为失败。需要传感器的测量命令在检测状态无效时主动重新识别，`STATE_SWITCH` 保持取消语义，其它失败设置错误并拒绝测量。
- 必查边界：扫描无候选、连接失败、复位后断链、DSM/V3/V4识别、识别超时、命令切换和重复匹配。
- 通过标准：只有链路正常且识别有效时命令117显示成功并发布目标信息；识别失败不进入测量流程。

### 2. 识别阶段抑制预期的 V4 异步故障上报

- 源码位置：`multiparam_v4_communication.h`、`multiparam_v4_diagnostics.c` 的识别探测模式；`sensor_detector.c` 的 `Sensor_ProbeV4Active`。调用链为 `V4主动探测 -> 预期超时统计 -> 质量故障上报门禁`。
- 改前问题：DSM传感器对V4主动帧保持静默时，连续超时达到阈值会触发全局异步 `13-3`，随后DSM识别成功但屏幕曾短暂显示故障。
- 具体改法：主动探测前开启识别模式；仍记录探测包、超时和质量统计，但不排队全局异步质量故障。成功、超时、命令切换和启动失败均关闭模式并清理质量锁存与连续计数。
- 必查边界：真实V4有效帧、非V4静默、连续超时、异常帧、启动失败、命令切换、中断并发和下一次正常测量。
- 通过标准：非V4识别期间可见探测超时日志，但不出现短暂 `13-3` 屏显；正常测量阶段仍保留连续异常故障上报能力。

## 测试用例

| 编号 | 前置条件与步骤 | 观测与通过标准 | 状态 |
| --- | --- | --- | --- |
| T1 | 连接DSM传感器，执行 `SC`。 | `Cv/CV/CN` 和密度握手成功，识别为DSM；V4探测超时不引起 `13-3`。 | 已执行，日志通过 |
| T2 | 连接正常，执行命令117。 | 匹配、复位后链路检查和传感器识别均成功，最终发布成功。 | 已执行，日志通过 |
| T3 | 首次扫描无候选，再次执行命令117。 | 首次返回无线扫描未发现设备并复位恢复；第二次可重新扫描、连接和识别。 | 已执行，日志通过 |
| T4 | 让传感器类型状态无效后执行需要传感器的测量命令。 | 先重新识别；识别失败时设置错误并拒绝测量，命令切换时正常取消。 | 未执行，需目标板 |
| T5 | 连续执行10轮命令117，覆盖已连接、断链和重连。 | 不出现瞬时 `13-3`；MAC、传感器类型和编号一致，失败恢复路径有界。 | 未执行，需目标板 |
| T6 | 使用真实V4设备连续产生异常帧，退出识别进入正常测量。 | 识别阶段不误报；正常测量阶段达到阈值仍能产生质量故障。 | 未执行，需故障注入 |

## 已执行验证与未验证风险

- 已执行：CPU2构建、识别探测质量门禁主机测试、传感器服务架构检查、无线RSSI契约检查、源码编码/CRLF检查、`git diff --check`和根目录布局Compare。
- 目标板日志已覆盖 `SPC`、`SC`、命令117二次匹配成功，以及首次无候选后的模块复位恢复；日志属于设备实测证据，但不替代连续压力和故障注入。
- 未验证：10轮重复匹配、断链重连压力、真实V4异常帧故障阈值、功耗/复位边界、现场长期运行和SIL。构建及静态检查不能证明这些硬件行为。
