duanxuebin1998/cube/docs/00_构建与版本/版本改动与测试/2026-08-17_CPU2_V1.40.1.0_方法5精细调速与AO禁用态硬件门禁_改动与测试方案.md

# CPU2 V1.40.1.0 方法5精细调速与AO禁用态硬件门禁改动与测试方案

## 1. 文档目的和适用版本

本文记录CPU2 `V1.40.0.0 -> V1.40.1.0`的两项问题修复：方法5在液面附近的精细连续调速，以及AO禁用态对AD5421硬件访问的完整门禁。本文用于代码复核、台架测试和提交范围核对，不把静态检查或构建结果表述为目标板验证。

适用组合：CPU2 `V1.40.1.0`、CPU3 `V1.40.0.0`、共享协议34。

## 2. 版本、协议和参数存储兼容性

| 项目 | 改前 | 改后 | 兼容结论 |
| --- | --- | --- | --- |
| CPU2固件 | `V1.40.0.0` | `V1.40.1.0` | PATCH问题修复 |
| CPU3固件 | `V1.40.0.0` | 保持 | CPU3无需修改 |
| `DEVICE_PROTOCOL_VERSION` | 34 | 34 | 共享地址、命令、状态和字段不变 |
| `DEVICE_PARAM_VERSION` | 3 | 3 | 参数结构、大小、偏移、CRC及FRAM A/B槽不变 |
| CPU3参数版本 | `0x0007` | 保持 | CPU3本机FRAM布局不变 |

升级不恢复出厂、不清除现场参数。方法5继续消费既有`oilLevelFrequency`、`oilLevelThreshold`和`oilLevelHysteresisThreshold`；AO仍消费既有工作模式、输出源、电流模式、量程和修正参数，没有新增默认值或改变旧值解释。

## 3. 本次提交范围

### 3.1 CPU2源码

- `LTD_MAIN_CPU2/Application/Inc/app_version.h`
- `LTD_MAIN_CPU2/Application/Src/measure_oilLevel.c`
- `LTD_MAIN_CPU2/Services/MotorControl/motor_ctrl.h`
- `LTD_MAIN_CPU2/Services/MotorControl/motor_ctrl_motion_api.c`
- `LTD_MAIN_CPU2/Services/AoOutput/ao_output.c`

### 3.2 版本与正式资料

- `CHANGELOG.md`
- `docs/00_构建与版本/版本改动与测试/2026-08-17_CPU2_V1.40.1.0_方法5精细调速与AO禁用态硬件门禁_改动与测试方案.md`
- `docs/01_协议与寄存器/AO电流输出/4-20mA电流输出逻辑.md`
- `docs/01_协议与寄存器/AO电流输出/README.md`
- `docs/03_问题分析与整改/未处理/2026-06-16_AD5421控制寄存器回读FFFF问题分析与现场验证.md`

### 3.3 本机同步但不提交

- `docs/00_程序流程导航/流程证据清单.json`
- `docs/00_程序流程导航/CPU2/04_液位测量与跟随.html`
- `docs/00_程序流程导航/CPU2/13_扭力与继电器输出.html`

`tools/`和程序流程导航按仓库规则保持本机同步，不进入Git暂存区。传感器通信源码、DM4协议资料、无效值方案及其PDF、DM4现场记录和混合索引明确保留在工作区。

## 4. 详细改动

### 4.1 方法5在首次换向后进入精细调速

- 源码位置：`measure_oilLevel.c`的`FrequencyLevel_RunClosedLoopConfigured()`和`FrequencyLevel_ComputeFineSpeedMMin()`。
- 改前问题：方法5接近目标频率后仍受常规`0.01 m/min`速度分辨率限制；液面反馈约4秒一轮时，最小步幅偏大，容易在死区两侧反复越过。
- 具体改法：首次搜索记录初始方向，第一次跨越目标并换向后锁存精细模式；持续跟随从入口即使用精细模式。死区外速度按`0.0007 + (0.1000 - 0.0007) * ratio^2`计算，`ratio=(|频差|-死区)/450`并限制到`0~1`。
- 必查边界：死区内返回0并慢停；死区外最小速度不低于`0.0007 m/min`；频差达到死区外450 Hz后不超过`0.10 m/min`；首次搜索在尚未换向时仍保留常规速度。
- 通过标准：曲线单调、边界限幅正确；16 Hz死区示例中55 Hz绝对频差对应约`0.001446 m/min`，4秒理论位移小于`0.1 mm`。

### 4.2 精细速度运动入口保持原安全前置条件

- 源码位置：`motor_ctrl.h`和`motor_ctrl_motion_api.c`的`MotorCtrl_StartFineVelocity()`。
- 改前问题：既有速度接口使用`m/min x100`整数，无法表达液面附近所需的千分之一米每分钟以下速度。
- 具体改法：新增浮点线速度入口，校验方向、正速度和设备最大速度，随后依次执行命令切换、驱动就绪、驱动健康、位置同步、线速度换算和JOG启动；运动显示状态仍由原统一接口发布。
- 必查边界：非法方向、速度0、负速度、超过最大速度、位置未就绪、驱动故障、速度换算为0和命令切换。
- 通过标准：合法精细速度能转换为非零驱动速度并启动；任一前置门禁失败时不启动运动并返回原错误码。

### 4.3 低速失步门限按适用范围启用

- 源码位置：`measure_oilLevel.c`的`FrequencyLevel_CheckMotionGuards()`和`FrequencyLevel_ReadCurrentWithGuards()`。
- 改前问题：现有失步检测以`0.5 mm/s`为最小速度门限；精细速度低于`0.03 m/min`时，实际期望速度低于该门限，继续套用会形成确定性误报。
- 具体改法：精细速度低于`0.03 m/min`时只跳过`MotorCtrl_CheckLostStepAutoTiming()`；位置刷新、罐高/盲区、称重通信、满载/罐底、碰撞、传感器读取和命令切换仍执行。速度达到阈值或处于常规速度模式时恢复失步检测。
- 必查边界：`0.0299`和`0.0300 m/min`两侧；跳过失步检测时的碰撞、位置越界和称重故障；精细模式退出后的门禁恢复。
- 通过标准：低于阈值不因旧速度门限误报失步，其他安全出口仍能停止并传播原错误；达到阈值后失步检测重新执行。

### 4.4 AO禁用态不访问AD5421

- 源码位置：`ao_output.c`的`AoOutput_EnterDisabledState()`、`AoOutput_Init()`和`AoOutput_UpdateInternal()`。
- 改前问题：AO工作模式为禁用时仍可能初始化AD5421、轮询诊断或写入名义禁用电流；在未安装、断环或故障硬件上会产生无意义SPI访问和故障副作用。
- 具体改法：上电即禁用或运行中切到禁用时，先清驱动就绪/重试、诊断节拍、恢复状态、写入尝试和仿真状态，再在临界区清待处理诊断事件；运行态发布`AO_OUTPUT_SOURCE_DISABLED`、名义目标、最近实发0、无驱动故障、无有效回读，并直接返回。
- 必查边界：上电禁用、启用后切禁用、禁用期间周期刷新、禁用期间电流修正非0、禁用后重新启用、AD5421开路和故障状态残留。
- 通过标准：禁用期间SPI上没有AD5421初始化、诊断或写入帧；最近实发为0、回读无效、故障状态清除；重新启用后按原驱动初始化和恢复路径工作。

## 5. 数据流和异常闭环

方法5链路为：目标频率/死区配置 -> 当前频率 -> 方向与精细速度计算 -> 电机就绪/健康/位置同步 -> 连续运动 -> 位置/称重/碰撞/适用范围内失步检查 -> 死区稳定或错误出口。换向前先慢停，任何启动、停止或保护错误都由`FrequencyLevel_StopAndReturn()`停止并返回。

AO链路为：AO配置快照 -> 工作模式判断。禁用分支只更新CPU2运行态并返回；启用分支才进入AD5421就绪、诊断、恢复、目标选择、修正、写入和结果发布。该分支顺序保证禁用时不会先产生硬件访问再退出。

## 6. 已执行验证

| 编号 | 验证 | 结果 |
| --- | --- | --- |
| STATIC-01 | `py tmp/20260814-method5-fine-speed-tune/verify_fine_speed_curve.py` | 通过；17~516 Hz样点速度单调且限幅正确 |
| STATIC-02 | `py tools/check_density_level_control_contract.py` | 通过；方法5生产入口和连续闭环契约保持 |
| STATIC-03 | `py tools/check_motor_motion_target_plan.py` | 通过；运动目标和状态计划契约保持 |
| STATIC-04 | `py tools/check_ao_output_enable_contract.py` | 通过；协议34 AO共享契约和禁用语义一致 |
| BUILD-01 | `cmake --build build/LTD_MAIN_CPU2 --clean-first` | 通过；隔离候选未混入传感器通信工作区改动 |

隔离候选树为`a9fe8ee7c197b6b569204102b5efb33933e67171`。2026-08-17 14:29 +08:00完成CPU2 clean-first构建，结果为`text=343092`、`data=2352`、`bss=59296`。固定名与版本名HEX的SHA-256均为`F4985EF4056F015F94F91BBB7A13ED44AFC1CD90EC08F509F25118E45292B847`。

## 7. 可执行台架测试矩阵

| 用例 | 前置条件 | 操作步骤 | 观测位置 | 预期与通过标准 | 状态 |
| --- | --- | --- | --- | --- | --- |
| M5-01 首次搜索 | 方法5，目标与死区已配置，探头位于目标同侧 | 启动找液，记录首次跨越目标前后方向和速度 | 串口日志、电机驱动、频率 | 换向前为常规速度；首次换向先慢停，随后进入精细曲线 | 未执行：缺目标板和电机台架 |
| M5-02 死区边缘 | 稳定提供死区外1 Hz、14 Hz、39 Hz频差 | 每档保持至少3轮反馈 | 日志速度、4秒位移、方向 | 速度单调且接近目标时位移收敛，不出现方向抖动 | 未执行：缺可控频率源 |
| M5-03 低速保护 | 精细速度分别设在`0.0299`和`0.0300 m/min`附近 | 注入失步、碰撞和位置越界 | 返回码、电机状态、错误日志 | 低速侧不因旧门限误报；碰撞/越界仍触发；阈值侧恢复失步检测 | 未执行：缺故障注入台架 |
| M5-04 命令切换 | 方法5正在精细运动 | 下发取消或其它测量命令 | 电机、设备状态、返回码 | 有界停止并返回`STATE_SWITCH`，无继续运动 | 未执行：缺目标板 |
| AO-01 上电禁用 | AO模式禁用，逻辑分析仪连接SPI | CPU2上电并观察10秒 | SPI、AO运行态、错误日志 | 无AD5421初始化/诊断/写入；最近实发0且回读无效 | 未执行：缺硬件台架 |
| AO-02 启用转禁用 | AO先正常输出，随后切换禁用 | 记录切换前后SPI和运行态 | SPI、电流表、CPU3 AO页 | 切换后停止访问AD5421，运行态来源为禁用，不残留驱动错误 | 未执行：缺硬件台架 |
| AO-03 禁用转启用 | AO保持禁用后切到启用 | 观察驱动初始化、诊断和首次写入 | SPI、电流表、错误日志 | 重新走原就绪链，成功后发布真实实发值；失败时报告原驱动错误 | 未执行：缺硬件台架 |
| AO-04 禁用加修正 | 禁用模式，修正分别设`-1000/+1000` | 周期刷新并读取运行态 | SPI、目标值、实发值 | 名义禁用目标不受修正影响，SPI保持静默，实发仍为0 | 未执行：缺硬件台架 |

## 8. 回归范围

- 方法5原目标频率、搜索/跟随死区、盲区、低液位、600秒超时、稳定3次和`LF/LF?`调试入口。
- 方法0/1离散精找、方法2/4速度闭环、普通电机JOG/定位、位置源切换、称重与碰撞保护。
- AO启用态的初始、过程、保持、固定、仿真、故障电流、修正、诊断恢复和CPU3运行态显示。
- 协议34严格匹配、参数读取/保存、恢复出厂和CPU2/CPU3既有通信。

## 9. 风险与未验证项

- 尚未验证真实机械系统在`0.0007 m/min`附近能否克服静摩擦，或驱动换算后的最小非零速度是否产生爬行；需要电机、卷筒和实际缆带负载台架。
- 低于`0.03 m/min`时有意跳过旧失步判据；位置、称重和碰撞保护仍在，但极低速真实失步需要后续建立适用的独立判据。
- 尚未用逻辑分析仪证明禁用态SPI绝对静默，也未验证从禁用重新启用时AD5421电气状态和4-20mA环路恢复。
- 未执行目标板、FRAM掉电、RS485、长期运行、现场或SIL验证。静态检查和构建只证明代码形状与可编译链接。

## 10. 提交前检查清单

- [x] CPU2版本头更新为`V1.40.1.0`。
- [x] 共享协议34、CPU2参数存储3和CPU3参数版本`0x0007`保持不变。
- [x] CHANGELOG覆盖版本、兼容性、改动、验证和未验证风险。
- [x] CPU2隔离候选完成clean-first构建并记录产物哈希。
- [x] 方法5、AO和电机相关静态检查通过。
- [x] 最终暂存区范围、编码、Markdown链接、`git diff --cached --check`和版本门禁在提交前执行。
- [x] 本文件随本次提交纳入，提交哈希以Git记录为准。
