duanxuebin1998/cube/docs/03_问题分析与整改/未处理/2026-08-13_CPU3到CPU2带参指令偶发超时问题分析与整改.md

# CPU3到CPU2带参指令偶发超时问题分析与整改

更新时间：2026-08-13

## 1. 问题结论

外部LTD协议下发带参指令时，CPU3需要先把参数槽通过FC10写入CPU2，再写命令寄存器。现场“正在读取参数”并不是CPU2进入读取参数状态，而是CPU3在板间参数事务失败后使完整参数快照失效，随后按忙状态拒绝继续发送带参命令。

本次原CPU2实板诊断中，毫秒级ST-LINK采样未观察到失败FC10进入CPU2 UART5接收缓冲，CPU2也未生成对应ACK；采样能力不能排除短帧已经出现在物理线上但未被捕获。结合故障总发生在CPU3完成上一笔周期读取、立即启动参数写事务的边界，当前最高置信的软件触发机制是板间通信没有统一保证Modbus RTU帧间静默时间。原CPU2板的RS485换向裕量较小可能使该问题更易暴露；更换另一块CPU2板后不触发说明板级差异会改变复现概率，但尚不能确定具体硬件层原因。

当前整改在CPU3到CPU2的UART5统一发送入口增加3ms毫秒门限。由于HAL毫秒节拍的量化误差，实际静默时间不少于约2ms，覆盖115200波特率下固定1.75ms的Modbus RTU帧间要求。整改不改变寄存器、功能码、帧格式、响应超时、重试策略、参数存储和共享协议版本。

## 2. 现场基线

| 项目 | 现场配置或结果 |
| --- | --- |
| 外部端口 | COM5，LTD协议，地址129，4800 8N1 |
| CPU3打印口 | COM12，115200 8N1 |
| CPU2板间通信 | UART5，115200 8N1，RS485半双工 |
| 现场CPU2 | V1.39.1.0，协议33 |
| 现场CPU3 | 与CPU2协议33匹配 |
| 故障操作 | 写参数槽`0x0524`后下发带参命令 |
| 界面现象 | 显示“正在读取参数”，指令未继续执行 |
| 板级对照 | 原CPU2复现；更换CPU2后不复现；换回原CPU2再次复现 |

任务开始时仓库工作区同时存在其它并行开发，CPU3为V1.38.1.1且共享协议已在未提交工作区推进到34。本专题的现场结论以现场固件和原始抓包为准；当前源码仅用于落实同一板间通信入口的鲁棒性修复，不能用当前构建替代现场固件解释历史行为。

## 3. 触发链

1. 上位机向CPU3外部COM3发送13字节LTD FC10参数写帧。
2. CPU3主循环此前可能已启动一笔100ms周期的CPU2 FC03或FC04读取；外部帧接收完成中断在等待期间置位。
3. CPU3收到CPU2响应并退出同步等待，下一轮主循环立即处理已经就绪的外部FC10。
4. CPU3在没有显式帧间保护的情况下切换UART5为发送方向；在失败轮的毫秒级采样中未观察到参数FC10进入CPU2 UART5接收缓冲，CPU2也未生成ACK。
5. CPU3等待1秒仍无响应，记录“响应超时，功能码0x10，起始地址0x0524，接收长度0”。
6. CPU3使参数快照失效，后续参数写或带参命令在本地返回Slave Device Busy。
7. OLED显示“正在读取参数”；后台参数组重新同步完成后链路恢复。

## 4. 直接证据

### 4.1 对外事务与CPU3日志

- 重复写相同参数值时可稳定观察到正常FC10 ACK与`81 90 06`交替出现。
- 等待约1.18秒后返回的Busy对应CPU3已启动板间FC10事务，但等待CPU2响应超时。
- 约0.17秒即返回的Busy对应参数快照已经失效，CPU3在本地门禁处直接拒绝，没有再次发送板间FC10。
- CPU3超时日志共同特征为接收长度0、UART标志0，随后参数快照变为无效并进入“同步中”。

### 4.2 CPU2 ST-LINK运行态观测

- ST-LINK HOTPLUG连接期间未复位、未halt、未烧写CPU2。
- CPU2目标始终处于running，UART5 RX DMA开启，DMA错误标志为0，RS485方向为空闲接收。
- 30,405个约毫秒级NDTR样本确认CPU2在故障前后持续接收CPU3的8字节周期读请求。
- 正常参数写轮能够在CPU2接收缓冲中捕获`01 10 05 24 00 02 04...`帧头。
- 真实超时轮在外部FC10到达后只捕获到一帧CPU3周期FC04；随后约1秒的毫秒级采样未观察到参数FC10，CPU2未生成对应ACK，超时后FC03参数组读取立即恢复。

这些证据显著削弱了“CPU2完整收到FC10后被FRAM保存阻塞一秒”的解释，也没有证据支持CPU2主循环或UART5持续失联；但在取得逻辑分析仪物理层波形前，不能绝对排除CPU2端收到残缺短帧或采样遗漏。

### 4.3 固件与硬件边界

- 板上CPU2 Flash已只读备份，SHA-256为`964714E896B6510217D46ADA0C6B17B4A92D69EE5AF3BDFE5A7879FA4C2B7AEC`。
- 板上固件与保留的V1.39.0.0正式固件属于同一链接谱系；不存在可安全直接套用的逐字节匹配ELF，因此本次没有在线下断点。
- 更换CPU2板后现象消失仍是有效的板级对照证据。它说明原板的RS485收发器、方向控制、器件离散性或时钟裕量可能更差，但不能单独证明CPU2 MCU损坏。

## 5. 源码问题点

CPU3板间通信的所有读写最终进入`CPU2_CombinatePackage_SendWire()`和`sendToCPU2()`：

- 每笔事务使用全局期望功能码、起始地址、数量和`wait_response`同步等待CPU2响应。
- UART5 IDLE中断把一帧响应标记为完成。
- 响应解析结束后，下一笔周期读、参数写或命令写可以立即调用`sendToCPU2()`。
- 原实现没有记录上一帧响应结束时间，也没有在下一次切换RS485发送方向之前保证Modbus RTU帧间静默时间。

这使板间通信可靠性可能依赖CPU2板上收发器和方向切换的实际裕量。响应更快或换向更稳定的CPU2板可能长期不触发，原CPU2板则可能在特定相位漏掉下一请求；该机制仍需修复后波形和重复回归确认。

## 6. 整改设计

### 6.1 实现范围

仅修改CPU3板间通信文件：

`LTD_DISPLAY_CPU3/Communication/internal/main_board_modbus/cpu2_communicate.c`

实现内容：

1. 定义统一帧间门限`CPU2_MODBUS_INTERFRAME_GAP_MS = 3U`。
2. UART5响应等待结束后记录`HAL_GetTick()`。
3. 所有事务进入`sendToCPU2()`后，先等待上一响应结束至当前发送满足门限，再切换RS485发送方向并启动TX DMA。
4. 首次事务没有上一响应时间，直接发送。
5. 使用无符号节拍差，兼容`HAL_GetTick()`回绕。

### 6.2 不改变的契约

- CPU2/CPU3共享寄存器地址与字段不变。
- FC03、FC04、FC10帧格式和ACK语义不变。
- `DEVICE_PROTOCOL_VERSION`不因本修复提升。
- CPU2的参数校验、运行状态门禁、FRAM A/B保存和参数更新代际不变。
- CPU3的一秒响应超时、连续失败计数、快照失效和恢复策略不变。

### 6.3 性能影响

帧间保护只在已经完成过CPU2事务后生效，单次最多阻塞约3ms。正常100ms轮询周期中，该开销不会放大为额外板间请求，也不会改变业务状态机。相比现有1秒超时和参数全量重同步，3ms保护的最坏开销显著更小。

## 7. 验证方案

### 7.1 静态与构建

- 运行`tools/check_cpu3_uart5_interframe_gap_contract.py`，确认所有UART5事务共用同一门限，且等待发生在切发送方向和启动TX DMA之前。
- 运行现有CPU3通信超时、命令参数事务和外部快照契约检查。
- 检查源码保持UTF-8、CRLF，新增C注释只使用块注释。
- 对最终源码执行CPU3 clean-first构建。

### 7.2 原CPU2实板回归

1. 备份并记录待烧写CPU3固件版本、BIN/HEX哈希。
2. 保持原CPU2、COM5地址129、LTD 4800 8N1和COM12打印配置不变。
3. 连续写相同参数`0x0524 = 1000`至少200次，不发送电机动作命令。
4. 通过标准：200次均取得合法FC10 ACK；CPU3无新增板间FC10超时；参数快照不失效；界面不出现“正在读取参数”。
5. 再执行最小安全带参命令，先写`0x0524 = 10`，再写命令`0x0F00 = 104`，确认ACK、状态变化和动作完成；测试后恢复`0x0524 = 1000`并读回。
6. 对新CPU2板执行同样回归，确认修复没有引入兼容回退。

### 7.3 波形闭环

使用逻辑分析仪同步观察CPU3 UART5 TX、CPU3 `MAIN_BOARD_485_SEL`、CPU2 UART5 RX和CPU2 `CPU2_485_SEL`。至少保存一次周期读响应后紧接参数FC10的最小间隔。

通过标准为上一响应结束到下一请求起始不小于1.75ms，CPU2 RX端看到完整13字节FC10，且方向脚没有重叠驱动。

## 8. 当前状态与残余风险

- COM5、COM12和CPU2 ST-LINK运行态证据已把问题收敛到相邻事务边界，并支持“缺少帧间静默保护”为当前最高置信的软件触发机制；尚未完成修复后实板闭环。
- CPU3软件整改已实现：统一发送入口增加3ms帧间静默保护；新增专项契约及既有通信超时、带参事务、外部快照新鲜度契约均通过。
- 当前工作区CPU3 V1.38.1.1 clean-first构建通过，ELF为`text=220672`、`data=20996`、`bss=100764`。该构建同时包含其它并行任务的协议34改动，只证明当前工作区组合可编译，不能直接烧入现场协议33的CPU2/CPU3组合。
- 已在独立worktree以`HEAD c90e7346`的协议33基线应用相同修复并按最终CPU3 V1.38.2.0完成clean-first构建，ELF为`text=220664`、`data=20996`、`bss=100764`；专项契约、通信超时、带参事务和外部快照新鲜度契约均通过。固定名与版本名HEX的SHA-256均为`91911364F5C4775E3657FB53C341B1B86CD620623F4C9005E71DBDD50D0D95AA`。
- 当前仍需将ST-LINK接回CPU3后烧写协议33 V1.38.2.0台架候选，并在原CPU2上完成200次参数写、最小安全带参命令和逻辑分析仪回归。该构建尚未经过实板验收，不能作为已验证正式发布件。
- 在取得修复后逻辑分析仪波形前，“原CPU2板具体哪颗器件导致裕量更小”仍属于未确认硬件层原因。
- 如果加帧间保护后原板仍丢帧，应继续检查CPU2 RS485收发器供电、终端/偏置、方向脚电平、焊接和晶振误差，而不是继续扩大软件等待时间掩盖硬件异常。
