duanxuebin1998/cube/docs/00_构建与版本/版本改动与测试/2026-08-10_CPU2_V1.39.0.0_CPU3_V1.38.0.0_协议33AO千分之一毫安修正与V4交互闭环_改动与测试方案.md

# CPU2 V1.39.0.0 / CPU3 V1.38.0.0 协议33 AO千分之一毫安修正与V4交互闭环改动与测试方案

## 1. 文档目的与适用范围

本文用于复核和验证2026-08-10工作区中准备一次性提交的全部合规改动。固件主线为AO电流修正分辨率由`0.01 mA`提升到`0.001 mA`，并补齐多参数V4交互方式的业务读取闭环；同一提交还收口协议、菜单、版本、仓库治理、正式资料和硬件原理说明。

适用组合：

- CPU2：`V1.38.0.0 -> V1.39.0.0`。
- CPU3：`V1.37.0.0 -> V1.38.0.0`。
- CPU2/CPU3共享协议：`32 -> 33`。
- 本文件随本次提交纳入，提交哈希以Git记录为准。

## 2. 版本、协议与参数存储兼容性

| 项目 | 改前 | 改后 | 兼容结论 |
| --- | --- | --- | --- |
| CPU2固件 | V1.38.0.0 | V1.39.0.0 | AO最终输出链路和V4交互读取均改变，升MINOR |
| CPU3固件 | V1.37.0.0 | V1.38.0.0 | 共享倍率、菜单和LTD/LH映射改变，升MINOR |
| `DEVICE_PROTOCOL_VERSION` | 32 | 33 | AO修正、目标、实发值的线值倍率改变，双端必须严格相等 |
| CPU2 `DEVICE_PARAM_VERSION` | 3 | 3 | 结构大小、地址、元信息和CRC范围不变 |
| CPU3 `CPU3_PARAM_VERSION` | 0x0007 | 0x0007 | CPU3本机FRAM布局不变 |

参数存储迁移规则：

1. `DeviceParameters.ao_output.current_correction_mA_x1000`原位复用旧修正槽，字段仍为有符号32位，结构大小和偏移不变。
2. FRAM中`protocolVersion`为26～32时，旧值按`mA x100`解释并乘10迁移到`mA x1000`。例如旧值`-25`迁移为`-250`，物理含义仍是`-0.250 mA`。
3. 协议25及更早或版本未知时，该槽可能不是电流修正语义，迁移时归零，不推测旧含义。
4. 迁移或加载后若修正值不在`-1000～+1000`，归一化为默认值0。
5. 升级不会恢复出厂参数，不清除AO其它配置或其它现场参数。现场升级前仍建议导出参数快照，升级后核对AO修正、工作模式、输出源、固定电流、0%/100%端点和故障动作。
6. 降级到协议32及更早前必须把修正值换回旧倍率或归零；否则旧固件会把`1000`解释为`10.00 mA`并因越界归一化，不能保证保持原修正量。

## 3. 本次提交范围

### 3.1 固件与共享契约

- CPU2版本、多参数V4测量/通信、传感器公共入口、AD5421驱动、AO服务、共享Modbus和参数存储。
- CPU3版本、AO菜单/运行页、参数镜像、共享Modbus解析、LTD/LH寄存器映射和写值校验。
- AO持久参数地址不变；AO运行态目标与最近实发值地址不变，只改变倍率和显示精度。

### 3.2 正式资料与治理

- `CHANGELOG.md`、`CHANGELOG.pdf`、仓库`README.md`和`docs/`内的版本、协议、AO、LTD、LH、菜单、需求与问题索引。
- CUBE仓库级skill入口、Git/发布/协议references及skill校验脚本。
- 三份SIL Word内嵌Visio OLE尺寸兼容修复、独立F05 Visio源同步、DM4双DDS及密度/黏度说明。

### 3.3 本机边界

- `tools/`、`docs-site/`、`outputs/`、`docs/00_程序流程导航/`保持本机同步但不进入Git。
- `D:\CUBE_TOOLS\LTDDeviceDebugTool`是独立Git仓库，本方案记录其协议/App测试证据，但本次CUBE提交不提交该仓库的17项改动。

## 4. 详细改动点

### 4.1 AO修正和最终目标统一为`mA x1000`

- 源码位置：`LTD_MAIN_CPU2/Services/AoOutput/ao_output.c`、`ao_output.h`的`AoOutput_ApplyCurrentCorrection()`、`AoOutput_UpdateInternal()`和`AoOutputRuntime`；链路为参数配置→基础电流→修正→硬件钳位→AD5421→共享运行态。
- 改前问题：修正值和最终目标以`0.01 mA`为最小线值单位，无法表达现场要求的`0.001 mA`修正步进。
- 具体改法：基础AO配置继续为`x100`，最终值按`base_mA_x100 * 10 + correction_mA_x1000`合成；目标、实发、写入尝试和恢复目标统一为`x1000`，物理钳位改为`3200～24000`。
- 必查边界：`-1000/0/+1000`修正、3.200/24.000 mA钳位、固定/过程/保持/故障/仿真来源、禁用态、重复目标刷新和失败重试。
- 通过标准：每个`0.001 mA`修正增量均能改变最终整数目标；禁用态始终为3.400 mA且不叠加修正；运行态和驱动接收同一目标。

### 4.2 AD5421整数DAC换算及初始化/恢复链路

- 源码位置：`LTD_MAIN_CPU2/BSP/Peripherals/src/ad5421.c`、`inc/ad5421.h`的`AD5421_SetCurrentX1000()`、`AD5421_InitCurrentX1000()`和`AD5421_RecoverCurrentX1000()`。
- 改前问题：旧`x100`接口转成float后换算DAC，既不能接收千分之一毫安目标，也可能在浮点舍入中吞掉最小修正步进。
- 具体改法：用`((offset_x1000 * 65535) + span/2) / span`执行64位整数四舍五入；3.2～24.0 mA对应DAC 0～65535；初始化和故障恢复复用同一`x1000`启动序列，旧`x100`接口乘10后转调。
- 必查边界：低于3.200、高于24.000、端点、相邻1 µA目标、乘法溢出、复位/控制寄存器回读/SPI/故障诊断失败。
- 通过标准：端点分别映射0和65535；所有合法输入不溢出；初始化、正常写入和恢复使用相同整数目标；旧接口行为保持原物理含义。

### 4.3 AO旧参数倍率迁移和加载归一化

- 源码位置：`LTD_MAIN_CPU2/Services/ParamStorage/system_parameter.c`、`.h`的`migrate_ao_current_correction_scale_runtime()`和`normalize_ao_params_runtime()`。
- 改前问题：同一32位槽从`x100`变为`x1000`后，直接读取会把旧物理修正缩小10倍；更老协议中该槽含义不确定。
- 具体改法：协议26～32乘10，协议25及更早或未知版本归零，之后按`-1000～+1000`校验；默认值和参数打印同步为`0.001 mA`。
- 必查边界：旧值`-100/0/+100`、越界值、未知协议、已经是协议33、A/B分区加载和迁移后写回。
- 通过标准：协议26～32升级前后物理修正不变；更老或未知版本不误解释预留槽；其它参数字节不被清除。

### 4.4 协议33双端共享字段同步

- 源码位置：CPU2/CPU3 `stateformodbus.h`、`system_parameter.h`、双方`dataanalysis_modbus.c`和CPU3 `device_param_sync.c`。
- 改前问题：只修改CPU2内部单位会导致CPU3、LTD和外部主机仍按`x100`解释，显示和写入放大或缩小10倍。
- 具体改法：共享协议升33；AO修正操作号、保持寄存器别名、运行态目标/实发别名及结构成员统一命名为`X1000`，地址和字段宽度保持不变。
- 必查边界：协议32/33混搭、FC03/FC04读值、FC06/FC10写修正、负数二补码、快照未建立和CPU2断线。
- 通过标准：协议版本不相等时严格门禁；协议33组合读写同一32位原始值；无地址偏移或相邻字段错位。

### 4.5 CPU3菜单与AO运行页三位小数

- 源码位置：`LTD_DISPLAY_CPU3/Application/display/display_tankopera.c`、`.h`和`system_parameter.c`参数元数据。
- 改前问题：菜单步进、范围和运行页只显示两位小数，无法录入或观察`0.001 mA`修正。
- 具体改法：电流修正菜单单位倍率改为3位小数、范围`-1.000～+1.000 mA`；运行页最近实发值用`%lu.%03lu mA`显示。
- 必查边界：负值、零、正值、三位小数补零、最大字符长度、N/A、通信断线、非法来源。
- 通过标准：`-1`显示/编辑为`-0.001 mA`，`1000`为`1.000 mA`，运行值`3400`显示`3.400 mA`，无乱码或越界覆盖。

### 4.6 LTD与LH外部协议倍率同步

- 源码位置：CPU3 `lh_modbus_slave.c`、`lh_register_map.h`及LTD共享Modbus资料。
- 改前问题：LH `0x0018～0x0019`和LTD共享参数若仍按`x100`解释，会与CPU2协议33不一致。
- 具体改法：地址不变，将修正字段口径改为有符号`mA x1000`并按`-1000～+1000`校验；同步协议卷、全量寄存器表和LH手册。
- 必查边界：FC03读取、FC10写入、`0xFFFFFC18`（-1000）、`0x000003E8`（+1000）、越界拒绝、协议不匹配和断线忙异常。
- 通过标准：合法端点读写一致，越界写不进入CPU2参数，地址`0x001A`后的固定电流等字段保持原倍率和位置。

### 4.7 V4交互方式R02状态核对与核心测量

- 源码位置：`multiparam_v4_communication.c/.h`的`MULTIPARAM_V4_ReadOperatingState()`，`multiparam_v4_measurement.c/.h`的交互密度、液位、水电容和姿态读取函数。
- 改前问题：交互方式仍绕过或零散复用主动快照逻辑，读取R04等核心值前没有统一核对R02模式和异常位，可能把错误模式或异常测量解释为有效值。
- 具体改法：统一解码R02的测量模式、功能状态和异常位；密度读取R04/R07/R06，液位读取R04，水电容读取R05，姿态读取R11/R12，并更新相应运行测量快照。
- 必查边界：密度/液位模式不符、R02非法枚举、水位/姿态异常位、通信超时、状态切换、NaN/Inf、负频率和超范围值。
- 通过标准：模式或异常位不满足时返回明确错误且不发布无效结果；合法交互值进入与主动方式相同的业务消费路径。

### 4.8 V4主动快照边界与公共入口收敛

- 源码位置：`multiparam_v4_measurement.c`主动读取分支及`Services/Sensor/sensor.c`的`Sensor_ReadLevelFrequency()`、`Read_Density()`、`Sensor_ReadWaterCapacitance()`、`Sensor_ReadGyroAngle()`。
- 改前问题：主动快照缺少部分频率、密度、温度范围复核；公共入口重复判断通信方式，容易使主动/交互路径行为分叉。
- 具体改法：主动密度快照增加有限值和上下限检查；公共传感器入口只识别类型15并转调V4测量层，由测量层选择主动或交互方式。
- 必查边界：主动帧陈旧、范围端点、通信方式切换、命令切换、非V4传感器和空输出指针。
- 通过标准：主动和交互方式共享一致的业务错误出口；越界快照不被发布；V3/DSM等其它传感器路径不变。

### 4.9 V4交互附加调试结果节流刷新

- 源码位置：`MULTIPARAM_V4_MeasurementRefreshInteractiveDebugData()`和`MULTIPARAM_V4_ReadFloatParamOnce()`。
- 改前问题：协议32已向CPU3/LTD暴露磁零点电压、动力黏度、运动黏度和供电电压，但交互方式没有稳定刷新这四项。
- 具体改法：仅在类型15且参数65为交互方式时，每500 ms最多读取一次R03/R08/R09/R10；逐项成功即更新对应值，记录首个失败，状态切换立即退出。
- 必查边界：500 ms边界、部分成功、首项失败后后项成功、`STATE_SWITCH`、主动方式和非V4类型。
- 通过标准：交互方式四项结果可持续刷新；单项失败不擦除其它成功结果；主动方式不额外发交互查询。

### 4.10 仓库治理、版本与导航资料

- 源码位置：`.agents/skills/cube-development/`、`README.md`、`CHANGELOG.md`及`docs/00_构建与版本/`。
- 改前问题：全部提交范围、二进制资料、参数版本对照和版本方案可执行程度的门禁不够集中，根README入口冗长且部分索引停留在协议32候选口径。
- 具体改法：明确all提交不得静默排除、Office/PDF边界、版本表连续性和测试方案五字段/可执行矩阵；扩展skill校验；重写根README并同步协议33正式组合、版本方案和参数升级入口。
- 必查边界：`tools/`、`docs-site/`、`outputs/`和流程导航不被跟踪；提交标题含双端版本；四段式正文非空；Markdown链接和UTF-8编码。
- 通过标准：skill校验、hooks检查、版本检查、文档结构/链接和Git范围门禁通过；暂存区无本机专用路径。

### 4.11 SIL Word与Visio兼容修复

- 源码位置：三份SIL架构DOCX内的19个嵌入Visio OLE对象，以及`ER02-F05_CPU2状态转移.vsdx`。
- 改前问题：部分嵌入Visio对象的OLE尺寸字段影响Office兼容打开或编辑，但不应借机改变已批准页面内容。
- 具体改法：仅修复OLE尺寸元数据并兼容保存独立F05源图；不改正文、页序、可见图形或安全论证结论。
- 必查边界：三份文档可打开、页数65页、候选逐页PNG哈希、嵌入对象数量、文档哈希与既有验证清单。
- 通过标准：三份DOCX当前哈希与验证清单一致，65页候选逐页PNG哈希一致；该证据只证明可见版式未变，不构成SIL认证或功能安全验证。

### 4.12 DM4与其它正式资料收口

- 源码位置：`docs/07_硬件原理图/DM4四代数字驱动V6.0原理图详细分析.md/.html`、LH手册、AO/LTD/LH/菜单/需求/问题资料及已有`CHANGELOG.pdf`。
- 改前问题：DM4说明对双DDS通道、密度换算和动力/运动黏度关系解释不足；多处资料尚未同步当前协议和界面事实。
- 具体改法：补充双DDS信号链和公式解释，统一AO三位小数、V4交互和协议33口径；纳入用户已有二进制资料改动，不因Markdown变化自动重生成PDF。
- 必查边界：HTML与Markdown主要结论一致、中文无乱码、链接有效、LH手册16页可读、PDF可渲染且页面无裁切、资料不包含密钥或个人数据。
- 通过标准：文档检查和视觉抽查通过；硬件原理说明明确区分静态原理分析与实板证据，未把文档整理写成硬件或SIL验证。

## 5. 跨CPU数据流与异常闭环

AO链路：

`CPU3/LTD/LH写入x1000修正 -> CPU2 Holding参数镜像 -> FRAM原槽保存 -> AO基础x100电流乘10 -> 叠加有符号x1000修正 -> 3.200～24.000 mA钳位 -> AD5421整数DAC -> CPU2 x1000运行态 -> CPU3/LTD三位小数显示`

V4交互链路：

`业务测量入口 -> V4测量层识别交互方式 -> R02模式/异常位 -> R04等核心参数 -> 有限值/范围检查 -> 业务测量快照 -> 500 ms节流读取R03/R08/R09/R10 -> CPU2调试Input -> CPU3原子快照 -> LTD FC04`

异常出口：协议不匹配或快照不新鲜时CPU3/LTD返回忙/不可用；V4状态切换返回`STATE_SWITCH`；通信错误保留具体错误码；越界或非有限值不发布；AD5421写入/诊断错误进入既有恢复链路并保留`x1000`恢复目标。

## 6. 测试环境与前置条件

- Windows PowerShell，仓库`D:\CUBE`，分支`MAIN`。
- ARM GCC/CMake/Ninja按CPU2、CPU3构建说明配置，固定构建目录分别为`build/LTD_MAIN_CPU2`和`build/LTD_DISPLAY_CPU3`。
- 主机协议测试使用`D:\CUBE_TOOLS\LTDDeviceDebugTool`当前分支；测试证据不授权提交该独立仓库。
- 台架测试需要可追溯的高精度电流表或6½位万用表、可调24 V回路电源、代表性负载、目标板、AD5421回路和可切换主动/交互方式的多参数V4传感器。

## 7. 可执行测试矩阵

| 用例 | 关联改动 | 前置与操作 | 观测位置 | 预期/通过标准 | 状态与证据 |
| --- | --- | --- | --- | --- | --- |
| AO-01 | 4.1/4.2 | 修正从0依次写1、2、10，基础目标保持4.00 mA | CPU2目标、DAC码、实测电流 | 目标依次4001/4002/4010；DAC码单调，实测步进需记录 | 静态覆盖；实测未执行 |
| AO-02 | 4.1 | 修正写-1000、0、+1000，基础目标4.00 mA | CPU2运行态 | 目标3000时被钳位3200，4000保持，5000合法 | 静态覆盖；台架未执行 |
| AO-03 | 4.1 | AO禁用，修正分别-1000/+1000 | CPU2目标和电流表 | 均为3400/3.400 mA，不叠加修正 | 静态覆盖；台架未执行 |
| AO-04 | 4.2 | 调用3.200、24.000及相邻目标 | AD5421 DAC写值 | 端点0/65535；区间按整数四舍五入，无溢出 | 主机静态检查覆盖；硬件未执行 |
| AO-05 | 4.3 | 构造协议26～32旧修正-25/+100并升级 | 加载后参数/FRAM | 变为-250/+1000，其它参数字节不变 | 静态迁移检查覆盖；FRAM实机未执行 |
| AO-06 | 4.3 | 构造协议25、未知版本及越界值 | 加载后参数 | 修正归零，不恢复全厂参数 | 静态迁移检查覆盖；FRAM实机未执行 |
| AO-07 | 4.4/4.6 | 用FC03/FC10读写-1000和+1000 | CPU3、LH 0x0018、CPU2参数 | 二补码和值一致；越界写拒绝；0x001A后字段不移动 | 协议检查覆盖；RS485未执行 |
| AO-08 | 4.5 | 菜单录入-0.001、0.000、1.000并查看运行页3.400 | OLED | 三位小数、负号、补零和N/A正确，无乱码 | 静态菜单检查覆盖；OLED未执行 |
| AO-09 | 4.2 | 注入断环后恢复 | 错误码、恢复目标、实测电流 | 保留最近`x1000`目标，恢复后重写同一目标 | 构建覆盖；故障注入未执行 |
| V4-01 | 4.7 | 交互方式，R02=密度模式，读取R04/R07/R06 | CPU2业务结果 | 频率、密度、温度均在范围内才发布 | 主机协议检查覆盖；传感器未执行 |
| V4-02 | 4.7 | R02为液位模式时请求密度，或异常位置位 | 返回码和结果快照 | 返回错误，不覆盖上次有效结果 | 主机协议检查覆盖；传感器未执行 |
| V4-03 | 4.7/4.8 | 对R04/R05/R06/R07/R11/R12注入NaN、Inf、负值和上限外值 | 返回码、业务快照 | 非有限或越界值不发布 | 主机协议检查覆盖；传感器未执行 |
| V4-04 | 4.9 | 交互方式连续运行2 s，单独令R08失败 | UART事务和四项Input | 每500 ms最多一轮；其它成功项更新，返回首个错误 | 静态检查覆盖；传感器未执行 |
| V4-05 | 4.8 | 主动/交互切换及命令切换 | 业务返回码和快照代际 | 公共入口走正确分支；`STATE_SWITCH`立即退出，无混合快照 | 静态检查覆盖；传感器未执行 |
| DOC-01 | 4.10～4.12 | 运行skill、文档、链接、编码、二进制渲染检查 | 脚本输出和页面PNG | 全部通过，无敏感项；Word可见页不变 | 提交前最终执行 |
| BUILD-01 | 全部固件 | 双端`--clean-first` | ELF/HEX和构建日志 | 0错误；生成固定名和版本名HEX | 提交前最终执行 |

## 8. 复杂场景分步验证

### 8.1 协议32旧参数升级到协议33

1. 在协议32固件写入AO修正`-25`（-0.25 mA），同时记录全部AO参数和一组非AO现场参数。
2. 断电并烧录CPU2 V1.39.0.0、CPU3 V1.38.0.0，不执行恢复出厂。
3. 上电等待参数加载和双端协议匹配。
4. 读取修正原始值，应为`-250`；核对全部记录参数保持一致。
5. 观察首次AO目标，应保持升级前物理修正，不出现10倍跳变。
6. 再次断电上电，确认迁移结果已稳定保存，不重复乘10。

### 8.2 AD5421断环与恢复

1. AO输出设为4.000 mA，修正设为+0.001 mA，确认运行目标4001。
2. 断开回路并等待AD5421诊断上报，记录错误码、目标和最近实发值。
3. 恢复回路，观察初始化/控制寄存器回读/目标重写/诊断顺序。
4. 通过标准：恢复目标仍为4001，不退回4000或发生浮点截断；恢复失败保持具体错误并按既有节流重试。

### 8.3 V4交互方式部分成功与状态切换

1. 参数65设为交互方式，R02设为密度模式并提供合法R04/R07/R06。
2. 让R03成功、R08超时、R09/R10成功，连续观察两轮500 ms刷新。
3. 第二轮中途触发命令/状态切换。
4. 通过标准：核心密度先发布；R03/R09/R10更新，R08失败作为首个错误；状态切换立即返回`STATE_SWITCH`，不继续发送剩余查询；下一业务周期从明确模式重新开始。

## 9. 回归范围

- AO固定、过程、保持、故障、仿真、禁用六类来源；初始化、周期刷新、诊断、断环恢复和HART相邻逻辑。
- AO其它12个持久参数的地址、倍率、范围和默认值；参数打印、恢复出厂、A/B分区加载和CPU3参数同步。
- CPU2/CPU3协议严格匹配、Holding/Input快照、LTD FC03/FC04/FC10、LH FC03/FC10及快照忙异常。
- 多参数V4主动帧、交互窗口、参数65切换、密度/液位/水位/姿态/黏度/读取部件参数，以及V3、DSM、安全传感器识别顺序。
- CPU3菜单进入、编辑、保存、返回、通信断线、运行页N/A和中文显示。
- 版本头、CHANGELOG、参数存储表、协议变更记录、README/索引、SIL Word、Visio和DM4说明。

## 10. 已执行验证记录

- AO倍率、AD5421整数换算、CPU3菜单、V4协议、外部Input新鲜度和文档契约检查：已通过；最终命令与源文件指纹记录到`tmp/commit-all-20260810/`验证清单。
- 独立上位机仓库Protocol测试：549/549通过；App测试：832/832通过。
- SIL Word：三份共65页，当前文件哈希与既有验证清单一致，候选逐页PNG哈希一致；只证明可见版式一致。
- LH Word：既有16页全本检查通过；本轮提交前需确认文件可读并完成最终哈希。
- 2026-08-10 13:36（UTC+8）CPU2最终V1.39.0.0 clean-first构建通过：`text=340380`、`data=2352`、`bss=59448`；固定名与版本名HEX的SHA-256均为`14B2C3055F51892D6B584F21FA541F4C94C0A1C3D9F091ED71A577DECFA8D1F4`。
- 2026-08-10 13:36（UTC+8）CPU3最终V1.38.0.0 clean-first构建通过：`text=203704`、`data=37972`、`bss=100764`；固定名与版本名HEX的SHA-256均为`881C8A6EB9C5C286D16FFC83C7D8D40A9135CDCBC7E428725F956FA30394CDE7`。
- `CHANGELOG.pdf`共94页，A4，SHA-256为`9A4C859F86E6695D07568CC85741F3EEBC8C43FBB29DEBA9506E5234AD3AA350`；全页联系表和首/版本表/末页原图检查未见裁切、重叠、缺字或黑块。该人工维护PDF保留其现有内容边界，不因本次Markdown末尾新增条目自动重生成。
- LH Word SHA-256为`55EA2283961E0B752C25E5978B9174755F51F0E8EAAEC3A766B815BAE9BA70D4`，与既有16页全本渲染证据一致；三份SIL Word和F05 Visio哈希与既有版式验证清单一致。

## 11. 风险与未验证项

- `0.001 mA`是数字设定/修正分辨率，不等于整机绝对输出精度。16位DAC在3.2～24 mA跨度内理论量化步距约`0.000317 mA`，但真实精度还受AD5421增益/零点误差、基准、温漂、回路电源、负载、布局和仪表误差影响，必须台架标定。
- 原理图RANGE0/RANGE1接COM与3.2～24 mA软件换算的实板组合尚未在本任务验证；目前“测量问题不大”不能替代芯片量程脚配置和全量程端点/线性测试。
- 未执行真实AD5421断环、过温、SPI故障、初始化失败和恢复注入；未验证HART叠加影响。
- 未执行真实V4传感器R02异常位、交互超时、主动/交互切换、RS485半双工冲突、DMA错误和长期运行。
- 未执行FRAM断电中断、A/B副本损坏、协议32真实旧参数升级和降级回滚；静态迁移检查不能替代实机掉电测试。
- 未执行OLED实屏、目标板电机、现场流程或SIL故障注入；构建、主机测试、Word页哈希和静态检查均不构成硬件、现场或功能安全认证证据。

## 12. 提交前检查清单

- [x] CPU2版本头为V1.39.0.0，CPU3版本头为V1.38.0.0。
- [x] 双端`DEVICE_PROTOCOL_VERSION=33`。
- [x] CPU2参数存储版本3、CPU3本机参数版本0x0007，迁移规则已记录。
- [x] `CHANGELOG.md`包含版本、兼容性、本次修改、验证和未验证风险。
- [x] 协议33变更记录、AO/LTD/LH资料和菜单资料已同步。
- [x] 新版本方案已纳入正式`docs/`并更新索引。
- [x] 最终静态检查、双端clean-first构建和主机测试完成并复核输出。
- [x] `CHANGELOG.pdf`和本次Office资料完成所需视觉/结构复核。
- [ ] 两次稳定Git状态快照、敏感信息扫描、`git diff --check`和根目录Compare通过。
- [ ] 暂存区不包含`tools/`、`docs-site/`、`outputs/`或`docs/00_程序流程导航/`。
- [ ] `check_commit_scope.py --mode all`、提交消息格式和hooks门禁通过。

程序流程导航说明：本次修改影响AO输出/恢复链路、V4交互读取和CPU3参数交互，应在本机流程导航与相应生成/校验源中保持同步；这些本机资料按仓库规则不进入Git提交。
