duanxuebin1998/cube/docs/00_构建与版本/版本改动与测试/2026-08-07_CPU2_V1.36.4.0_DSM与UART6通信修复_改动与测试方案.md

# CPU2 V1.36.4.0 DSM与UART6通信修复改动与测试方案

## 1. 文档目的和适用范围

本文记录CPU2从V1.36.3.0升级到V1.36.4.0时，DSM一代文本通信、CH9141K AT/透传交接、无线状态查询错误传播以及无丢步日志读取节流的实际代码变化和验证方法。

本次只修改CUBE CPU2，不修改DSM传感器端程序，不改变CPU3固件，不引入新的自动协议探测步骤。本文随本次提交纳入，提交哈希以Git记录为准。

## 2. 版本与兼容性

| 项目 | 变更前 | 变更后 | 兼容性结论 |
| --- | --- | --- | --- |
| CPU2固件 | V1.36.3.0 | V1.36.4.0 | PATCH修复 |
| CPU3固件 | V1.36.0.0 | V1.36.0.0 | 不受影响 |
| DEVICE_PROTOCOL_VERSION | 31 | 31 | CPU2/CPU3共享协议不变 |
| DEVICE_PARAM_VERSION | 3 | 3 | 参数存储格式不变 |
| DeviceParameters结构 | 不变 | 不变 | 大小、偏移、struct_size、CRC范围和FRAM地址不变 |
| 升级参数处理 | 保留现场参数 | 保留现场参数 | 不恢复出厂、不清参数 |

DSM线上命令字和响应字节定义保持不变。`CL/CB/CD`仍以`25 0D 0A`表示成功；`CN/CK/Cb/Cd/Ch/Cl`仍按既有BCC和CRLF传输；`CV/Cv`只补齐既有六字节无CRLF响应的事务层处理，未加入开机或识别流程。测水电容小于`30.0 pF`映射为`99999.9 pF`的产品规则继续保留。

## 3. 本次提交范围

### 3.1 CPU2源码

- `LTD_MAIN_CPU2/Services/Sensor/dsm_sensor_communication.c`
- `LTD_MAIN_CPU2/Services/Sensor/ch9141_at.c`
- `LTD_MAIN_CPU2/Services/Sensor/ch9141_at.h`
- `LTD_MAIN_CPU2/Services/Sensor/wireless_pairing.c`
- `LTD_MAIN_CPU2/Services/Sensor/sensor.c`：只纳入RSSI错误传播相关两个代码块，不纳入同一工作区的多参数协议并行改动。
- `LTD_MAIN_CPU2/Services/MotorControl/motor_ctrl_lost_step_detect.c`

### 3.2 版本与正式记录

- `LTD_MAIN_CPU2/Application/Inc/app_version.h`
- `CHANGELOG.md`
- 本文档

### 3.3 本机同步但不提交

- `tools/check_dsm_uart6_frame_contract.py`等本机契约工具。
- `docs/00_程序流程导航/CPU2/09_传感器与无线通信.html`及流程证据清单。
- `build/LTD_MAIN_CPU2/`构建产物。

## 4. 详细改动

### 4.1 建立DSM命令级固定帧规格

- 源码位置：`dsm_sensor_communication.c`的`DsmCommandFrameSpec`、`s_dsm_frame_specs`、`DSM_GetExpectedFrameLength()`和`UART6_WaitTextReceiveDma()`。
- 改前问题：旧接收路径遇到首个`0x0A`就结束；当原始BCC恰好为`0x0A`时，`CN`或`Cb`会被提前截断并报格式或BCC错误。`CV/Cv`没有CRLF，会一直等到超时。
- 具体改法：为`CL/CB/CD/CV/Cv/CN/CK/Cb/Cd/Ch/Cl`登记正常长度、错误长度、帧类型和日志操作名；数据命令收到首字节`A`时按19字节错误帧接收，其余按正常长度接收；DMA额外保留一个字节用于发现已经进入缓冲区的超长帧。
- 必查边界：BCC为`0x00/0x0A/0x0D`、零字节、全长度短一字节、超长一字节、无CRLF版本帧、19字节错误帧和未知命令。
- 通过标准：合法帧不因BCC内容提前结束；短帧和超长帧返回格式错误；`CV/Cv`六字节帧能在事务层完成，不改变生产探测顺序。

### 4.2 严格校验ACK、字段、BCC和CRLF

- 源码位置：`dsm_sensor_communication.c`的`DSM_ValidateFixedFrame()`、`DSM_IsSevenDigitInteger()`、`DSM_IsSevenDigitValue()`、`DSM_IsSignedSevenDigitValue()`和`DSM_ParseSevenByteFloat()`。
- 改前问题：模式ACK只判断响应是否包含`%`；数值使用`atof/strtod`直接从帧内地址继续读取，原始BCC为ASCII数字时可能被继续消费；中间版本错误地要求`Cd`频率必须带小数点。
- 具体改法：`CL/CB/CD`只接受精确`25 0D 0A`；正常数据帧逐字节校验标签、七字节字段、BCC和CRLF；`Cd`频率允许六位整数或小数，密度和温度必须带一个小数点；数值复制到八字节本地缓冲区后限长解析。
- 必查边界：额外`%`、缺少CRLF、错误标签、频率`+000000`、密度或温度无小数点、BCC为数字字符、NaN/Inf文字和字段错位。
- 通过标准：现场帧`F+000000D+0000.0T+26.590`通过；异常ACK和错位帧不能进入业务解析。

### 4.3 锁存UART6硬件错误

- 源码位置：`dsm_sensor_communication.c`的`UART6_StopDmaReceive()`、`UART6_TakeHardwareError()`和事务完成检查。
- 改前问题：停止DMA会清除`huart6.ErrorCode`，最后几个字节附近的FE、NE、ORE或PE可能被误报为格式/BCC错误，日志中的`uart`字段仍为0。
- 具体改法：停止DMA前后把HAL错误位合并到本事务快照；协议解析前消费锁存值；收到硬件错误后禁止部分数据继续进入协议解析。
- 必查边界：接收中错误、最后字节附近错误、停止DMA过程中新增错误、无数据超时和部分帧超时。
- 通过标准：契约检查确认锁存顺序存在；目标板错误注入时应返回UART传输错误并保留非零HAL位图。

### 4.4 完整映射DSM错误并改进日志

- 源码位置：`dsm_sensor_communication.c`的`s_dsm_response_errors`、`DSM_MapErrorResponse()`和`UART6_SendWithRetry()`。
- 改前问题：错误6、7满足正常倾角格式，可能被当作`666.66°/777.88°`；所有DSM重试日志都显示“读取液位”。
- 具体改法：错误6、7映射为`SENSOR_REMOTE_INTERNAL_ERROR`；错误帧必须是精确19字节并具有CRLF；重试、恢复和失败日志的操作名来自当前命令规格。
- 必查边界：错误1至9、未知16字节载荷、低电压`E/e`编号帧、不同命令的重试和恢复日志。
- 通过标准：错误6、7不进入角度解析；`CN/CD/Cd/Ch/Cl`日志分别显示真实业务操作。

### 4.5 建立CH9141K与DSM共用UART6的交接状态机

- 源码位置：`ch9141_at.h/.c`的`CH9141Uart6LinkState`、`CH9141_AT_GetUart6LinkState()`、`CH9141_AT_CompleteTransparentHandoff()`、`CH9141_AT_RecoverRssiQuery()`和AT发送/恢复路径。
- 改前问题：AT退出或复位后的排空过程可以被命令切换打断；函数返回后UART6可能永久停在`NOT_READY`或仍有异步RSSI文本，随后DSM模式切换连续返回`0x000D0021`。
- 具体改法：显式维护`TRANSPARENT_READY/ENTERING_AT/AT_ACTIVE/RECOVERING/NOT_READY`；AT退出、复位和强制恢复使用不可中断的最终交接；恢复步骤保留第一个具体错误，只有完整排空成功才发布`TRANSPARENT_READY`。
- 必查边界：正常AT退出、半ACK、无ACK、命令切换、RSSI关闭失败、AT退出失败、HAL abort失败、持续异步文本和恢复后二次DSM访问。
- 通过标准：交接未完成时DSM不能抢占；失败状态可在下一次DSM事务前进行一次有界恢复，不会无限恢复或永久锁死。

### 4.6 无线状态查询和部件参数读取传播交接错误

- 源码位置：`wireless_pairing.c`的连接状态查询/打印/扫描收尾；`sensor.c`的`Sensor_UpdateWirelessRssiForPartParams()`和`Sensor_ReadPartParamsInternal()`。
- 改前问题：RSSI关闭、AT退出或透明交接失败后仍可能继续读传感器；部件参数流程会打印失败但把返回值改回`NO_ERROR`。
- 具体改法：无线流程检查强制恢复和透明交接结果并保存具体错误；部件参数流程在透明传输未确认时立即返回错误，停止后续DSM访问。
- 必查边界：未连接、RSSI无有效数值但交接成功、恢复失败、命令切换、查询错误和原始错误优先级。
- 通过标准：只有UART6已确认恢复透明传输时才能继续读传感器；RSSI数值无效与链路交接失败得到不同结果。

### 4.7 避免无丢步日志连续占用UART6

- 源码位置：`motor_ctrl_lost_step_detect.c`的`MotorLostStep_NoDetectRuntimeLogUpdate()`。
- 改前问题：密度读取前更新周期时间戳；若一次UART事务耗时较长，返回时下一周期可能已到，主循环会立即再次读取。
- 具体改法：在`Read_Density()`阻塞调用结束后用新的`HAL_GetTick()`更新周期起点。
- 必查边界：快速成功、三次重试、模式恢复、通信超时和命令切换。
- 通过标准：下一轮间隔从本次读取结束时开始计算，慢事务结束后不立即再次占用UART6。

## 5. 跨模块数据流和异常闭环

```text
部件参数/测量请求
  -> WirelessPairing进入CH9141K AT状态
  -> RSSI关闭、AT退出或模块复位
  -> CompleteTransparentHandoff确认UART6透明链路
  -> DSM事务检查链路状态
       READY：按命令启动定长DMA
       NOT_READY：执行一次有界恢复后重试
       其它AT状态：返回模式未就绪，禁止抢占
  -> 固定长度、字段、BCC、CRLF和UART错误校验
  -> 正常数据/远端错误/本地通信错误向上传递
  -> ErrorLog按真实命令记录
```

## 6. 测试环境

- 构建主机：Windows，Arm GNU Toolchain 15.2.1，Ninja/CMake。
- 范围候选：从`MAIN@015aae58906b`建立的隔离worktree，只应用本次六个源码文件、版本和记录文件。
- CPU2版本：V1.36.4.0。
- CPU3版本：V1.36.0.0。
- 共享协议：31。
- 参数存储版本：3。

## 7. 可执行测试矩阵

| 用例 | 关联改动 | 前置条件 | 操作与输入 | 观测位置 | 预期与通过标准 | 状态 |
| --- | --- | --- | --- | --- | --- | --- |
| DSM-01 | 4.1/4.2 | 运行契约工具 | 正常执行全部DSM命令模拟帧 | 工具退出码 | 全部正常帧通过 | 已通过 |
| DSM-02 | 4.1 | 运行契约工具 | BCC分别为`00/0A/0D` | 帧判定结果 | 不提前截帧 | 已通过 |
| DSM-03 | 4.1/4.2 | 运行契约工具 | 短帧、超长帧、坏BCC、坏CRLF | 错误分类 | 分别返回格式或BCC错误 | 已通过 |
| DSM-04 | 4.2 | 运行契约工具 | `25 0D 0A`及额外`%` | ACK判定 | 仅精确ACK通过 | 已通过 |
| DSM-05 | 4.2 | 运行契约工具 | `F+000000D+0000.0T+26.590` | 字段解析 | 频率0、密度0、温度26.590正常解析 | 已通过 |
| DSM-06 | 4.4 | 运行契约工具 | 错误1至9 | 错误映射 | 错误6/7不进入角度解析 | 已通过 |
| UART-01 | 4.5/4.6 | 运行无线契约工具 | 检查AT状态、恢复和交接调用形状 | 工具退出码 | 状态机和错误传播契约通过 | 已通过 |
| BUILD-01 | 全部 | 隔离候选、完整工具链 | `cmake --build build/LTD_MAIN_CPU2 --clean-first` | 链接和size输出 | 0错误完成并生成V1.36.4.0 HEX | 已通过 |
| FIELD-01 | 4.1至4.6 | 正常DSM传感器和整机 | 冷启动后连续执行`SC`20次 | 串口完整日志 | 每次识别成功，不出现合法帧格式错误和永久模式未就绪 | 未执行 |
| FIELD-02 | 4.1至4.6 | 正常传感器 | 密度、油位、水位、倾角各10轮 | 结果和错误日志 | 数据合理，日志操作名对应当前命令 | 未执行 |
| FIELD-03 | 4.5/4.6 | 可安全断开蓝牙 | 断开、重新连接后再次`SC`，共5轮 | 链路状态和恢复日志 | 允许断开时报错；重连后恢复，不持续`0x000D0021` | 未执行 |
| FIELD-04 | 全部 | 正常整机 | 连续运行2小时或100轮 | 完整串口记录 | 无偶发合法帧截断、AT文本污染或恢复死锁 | 未执行 |

## 8. 复杂场景验证步骤

### 8.1 正常设备综合验证

1. 记录CPU2启动打印、HEX文件名和SHA-256。
2. 冷启动设备，确认蓝牙主从机连接正常。
3. 连续执行`SC`20次，记录`CN`编号、`CD`成功和`Cd`数据。
4. 执行密度、油位、水位和倾角业务流程；没有测水探针时将水位流程明确标记为未测试。
5. 检查错误日志操作名是否分别对应编号、模式、频率、密度温度、倾角和电容读取。

### 8.2 断链与恢复

1. 在设备静止且允许断链的条件下断开蓝牙链路。
2. 执行一次`SC`或部件参数读取，保存预期通信失败日志。
3. 恢复蓝牙连接，等待连接状态稳定。
4. 再次执行`SC`，确认发生一次有界恢复或直接进入透明就绪。
5. 重复5轮；任何一轮持续返回`0x000D0021`或需要重启CPU2才能恢复均判定失败。

### 8.3 特殊BCC和硬件错误

普通传感器不能稳定主动制造BCC特殊值、非法ACK、错误6/7或UART FE/NE/ORE。这些边界由静态契约覆盖，但目标板硬件证据仍需可控串口应答器或故障注入环境；未执行时不得登记为实机通过。

## 9. 回归范围

- DSM传感器识别：蓝牙链路、`CN`编号和密度模式握手。
- DSM模式与数据：`CL/CB/CD/Cb/Cd/Ch/Cl/CK`。
- 安全传感器和原LTD/V2回退顺序保持不变。
- 无线状态查询、调试扫描、RSSI读取和配对失败收尾。
- 部件参数读取的错误传播、命令切换和上次RSSI快照保留。
- 无丢步运行日志的密度读取周期。
- 现有故障码、CPU2/CPU3共享协议和参数存储兼容性。

## 10. 已执行验证

- `py -X utf8 tools/check_dsm_uart6_frame_contract.py`：通过。
- `py -X utf8 tools/check_dsm_compat_contract.py`：通过。
- `py -X utf8 tools/test_dsm_cn_low_voltage_response.py`：通过。
- `py -X utf8 tools/check_wireless_rssi_contract.py`：通过。
- `py -X utf8 tools/check_version_bumped.py`：通过，CPU2版本和流程影响识别通过。
- `git diff --cached --check`：通过。
- CPU2隔离候选clean-first构建：2026-08-07 17:27 +08:00通过，`text=328100`、`data=2344`、`bss=58352`。
- `LTD_MAIN_CPU2.hex`与`LTD_MAIN_CPU2_V1.36.4.0.hex`的SHA-256均为`BBCF73064D3A33AF7A954B9CA4D0D1AFE20600AB69223B5159206379B1684C6A`。
- BIN SHA-256为`ECD55DB0F7E39996C27165A4A1F34D35ACDAB283F1E281C14310A43B53678B31`。

`check_sensor_fault_contract.py`在主工作区组合状态曾通过；隔离候选中该本机工具依赖另一个并行任务尚未提交的`multiparam_v3_communication.c`，因此本版本不把该结果登记为范围候选证据。

## 11. 风险与未验证项

- 已由代码和契约关闭：首个LF截帧、宽松ACK、整数频率误拒绝、越界数值解析、错误6/7误当角度、DMA停止后UART错误丢失、日志操作名错误。
- 已由构建关闭：本次范围候选的声明、类型、链接和版本产物生成错误。
- 必须台架或现场验证：真实CH9141K半ACK/无ACK、异步RSSI残留、AT退出失败、UART硬件错误注入、传感器错误6/7、正常设备长时间运行。
- 静态检查和clean-first构建不能替代目标板、传感器、蓝牙链路、电机动作或现场验收。

## 12. 提交前检查清单

- [x] CPU2版本升级到V1.36.4.0，CPU3保持V1.36.0.0。
- [x] `DEVICE_PROTOCOL_VERSION`保持31。
- [x] `DEVICE_PARAM_VERSION`保持3，参数结构不变且升级不清参数。
- [x] CHANGELOG覆盖版本、兼容性、改动、验证和未验证风险。
- [x] 版本测试方案覆盖全部范围源码和可执行验证步骤。
- [x] CPU2隔离候选clean-first构建通过。
- [x] DSM和无线相关范围契约通过。
- [x] CP936、CRLF、无BOM、无替换字符和无新增`//`检查纳入提交门禁复核。
- [x] 程序流程影响定位为CPU2“传感器与无线通信”，本机流程资料同步但不提交。
- [x] `git diff --cached --check`通过。
- [ ] 真实目标板、CH9141K和DSM传感器验证未执行，已作为未验证风险保留。
