duanxuebin1998/cube/docs/00_构建与版本/版本改动与测试/2026-08-07_CPU2_V1.36.3.0_电机目标运动动态超时_改动与测试方案.md

# CPU2 V1.36.3.0 电机目标运动动态超时改动与测试方案

## 1. 文档目的和适用版本

本文用于复核并验证CPU2普通阻塞目标运动由固定1小时上限改为按计划距离和生效线速度计算单次等待预算的行为变化。

- 修改前版本：CPU2 `V1.36.2.0`
- 修改后版本：CPU2 `V1.36.3.0`
- CPU3版本：保持`V1.36.0.0`
- CPU2/CPU3共享协议：`DEVICE_PROTOCOL_VERSION = 31`，不变
- CPU2参数存储：`DEVICE_PARAM_VERSION = 3`，不变

## 2. 协议与参数存储兼容性

- 不新增、删除或移动CPU2/CPU3共享寄存器，不改变命令、状态、错误码、字段宽度、字序、缩放或双方消费语义；CPU3无需升版。
- `DeviceParameters`结构、大小、字段偏移、`struct_size`、magic、CRC范围、FRAM A/B地址和单槽容量均不变。
- 升级不会因版本变化恢复出厂或清除现场参数；`MOTOR_RUN_TIMEOUT`编号及既有故障恢复入口保持不变。

## 3. 本次提交范围

### 3.1 Git提交文件

- `LTD_MAIN_CPU2/Services/MotorControl/motor_ctrl_motion_api.c`
- `LTD_MAIN_CPU2/Application/Inc/app_version.h`
- `CHANGELOG.md`
- `docs/00_构建与版本/版本改动与测试/2026-08-07_CPU2_V1.36.3.0_电机目标运动动态超时_改动与测试方案.md`

### 3.2 本机维护但不提交

- `docs/00_程序流程导航/CPU2/08_电机与位置模型.html`同步目标运动等待预算说明，并执行本机流程导航检查。
- `tools/`、`docs-site/`、`tmp/`、`outputs/`和构建产物不进入Git，不使用`git add -f`。

当前工作区内其它`.agents/`和`docs/`并行改动不属于本提交；最终精确范围以提交前`git diff --cached --name-status`为准。

## 4. 详细改动

### 4.1 按距离和生效速度计算单次目标运动等待预算

- 源码位置：`LTD_MAIN_CPU2/Services/MotorControl/motor_ctrl_motion_api.c`的`MotorCtrl_MoveAndWait()`；调用链为`MotorMotion_BeginSpeedScope -> MotorMotion_BuildRelativeTargetPlan -> MotorCtrl_MoveNoWait -> MotorMotion_WaitUntilStopWithTarget`。
- 改前问题：所有普通阻塞目标运动统一使用固定`3600000 ms`上限；同一目标运动在低速度或长距离条件下，即使仍按计划运行，也可能在1小时后返回`MOTOR_RUN_TIMEOUT`。
- 具体改法：临时速度生效并完成目标规划后读取当前线速度设定，计算`理论时间(ms) = 计划距离(mm) × 60 ÷ 生效线速度(m/min)`；允许时间取`max(3600000 ms, 理论时间 × 2 + 60000 ms)`并在启动运动前固化，本次运动进展不重置该预算。
- 必查边界：距离小于等于0的原提前返回；0.10～6.00 m/min速度限幅；允许时间恰好落在1小时下限两侧；最大合法行程；`uint32_t`换算；HAL Tick回绕；命令切换、位置刷新、碰撞和驱动健康错误先于超时退出。
- 通过标准：短距离仍至少保留1小时预算；长距离或低速度按公式获得更长预算；预算只计算一次并传给目标等待函数；其它保护顺序和返回码不变。

### 4.2 超时日志区分实际时间和允许时间

- 源码位置：`MotorMotion_WaitUntilStopWithTarget()`的超时判断和`ErrorLog_WarnDetail()`调用。
- 改前问题：日志只输出固定超时常量，无法区分现场实际等待时长与本次允许运行预算。
- 具体改法：每轮以`HAL_GetTick() - startTick`计算已运行时间；超过本次`max_wait_ms`后，结构化日志和普通打印同时输出当前位置、目标位置、已运行毫秒数和允许毫秒数，仍返回`MOTOR_RUN_TIMEOUT`。
- 必查边界：Tick正常递增与单次回绕；日志缓冲区长度；目标到位、驱动停止、命令切换、碰撞和健康错误不得误报为运行超时。
- 通过标准：真实超时日志能同时看到“已运行”和“允许”两个值，且错误码和停机出口保持原语义。

## 5. 可执行测试矩阵

| 用例 | 关联改动 | 前置条件 | 操作步骤 | 观测位置 | 预期结果 | 状态 |
| --- | --- | --- | --- | --- | --- | --- |
| T01 | 4.1 | CPU2目标运动可用，距离较短 | 以合法速度执行理论时间明显小于29.5分钟的目标运动 | 调试日志、返回码 | 允许时间为`3600000 ms`，到位返回`NO_ERROR` | 未执行台架 |
| T02 | 4.1 | 可设置低速度或长距离 | 选择`理论时间 × 2 + 60000 ms`大于1小时的组合并启动目标运动 | 允许时间日志、运动状态 | 允许时间按公式大于1小时，不在固定1小时处误报 | 未执行台架 |
| T03 | 4.1 | 可构造1小时下限临界组合 | 分别选择理论时间略低于、等于和略高于29.5分钟的距离/速度 | 计算值、超时预算 | 下限两侧分别保持1小时或切换到公式值，无截断反向 | 未执行台架 |
| T04 | 4.2 | 可缩短测试环境等待或注入Tick | 让运动持续超过本次允许时间 | 结构化错误日志、普通打印、错误码 | 日志同时输出已运行/允许时间并返回`MOTOR_RUN_TIMEOUT` | 未执行故障注入 |
| T05 | 4.1、4.2 | 可注入命令切换、碰撞和驱动异常 | 在等待期间分别触发各保护 | 返回码、停机动作、错误日志 | 对应保护先退出，不被改写为`MOTOR_RUN_TIMEOUT` | 未执行台架 |
| T06 | 全部 | 本地ARM工具链可用 | 执行专项静态检查、编码检查和CPU2 clean-first构建 | 命令退出码、ELF/HEX | 检查退出码0，生成V1.36.3.0产物 | 已执行 |

## 6. 回归范围

- `MotorCtrl_MoveAndWait()`的相对目标规划、临时速度应用与恢复、启动观察、目标到位和最终位置复核。
- `MotorCtrl_MoveToPosition()`及测量、回零、水位和传感器流程对普通阻塞运动接口的调用。
- 命令切换、驱动通信与健康检查、24 V异常、位置刷新、碰撞检测、停止收尾和`MOTOR_RUN_TIMEOUT`错误传播。
- `MotorCtrl_JogMoveAndWait()`、强制无检测运动和停止命令等待使用各自既有时限，本次不改变其行为。
- CPU2/CPU3协议31、CPU2参数存储版本3和CPU3 V1.36.0.0兼容组合。

## 7. 已执行验证与提交前检查

- [x] `py tools\check_motor_motion_target_plan.py`通过。
- [x] 目标源码CP936往返、CRLF、无`U+FFFD`、无连续问号和无新增`//`注释检查通过。
- [x] `git diff --check`对目标源码无空白错误；工作区其它并行文档存在行尾转换提示，不属于本提交。
- [x] `py -X utf8 tools\update_flow_navigation.py --check`通过，本机流程导航与最终源码同步。
- [x] `cmake --build build\LTD_MAIN_CPU2 --clean-first`按最终CPU2 V1.36.3.0源码通过；生成`LTD_MAIN_CPU2_V1.36.3.0.hex`，ELF为`text=326596`、`data=2344`、`bss=58352`。
- [x] 版本头、`DEVICE_PROTOCOL_VERSION`、`DEVICE_PARAM_VERSION`、`CHANGELOG.md`、协议兼容性和4个计划提交文件已按最终工作区复核。
- 最终暂存区范围、提交信息格式、敏感信息和根目录Compare由提交门禁及提交后检查继续复核。

## 8. 风险与未验证项

- 尚未在真实目标板和电机机构上执行短距离、长距离、最低/最高速度、1小时临界预算和真实超时验证。
- 尚未执行运动期间命令切换、碰撞、驱动通信/健康异常和故障恢复的目标板注入测试。
- 静态检查和clean-first构建只证明源码契约、编码和可编译性，不替代真实电机、编码器、机构、目标板或现场验收。

## 9. 提交状态

本文件随本次scoped提交纳入，提交哈希以Git记录为准；本次不推送。提交前以两次稳定快照和最终暂存区为准。
