duanxuebin1998/cube/docs/06_SIL功能安全认证/03_软件详细设计/CPU2软件详细设计编制工作包/04_流程图版式基准/流程图预览V0.4.png

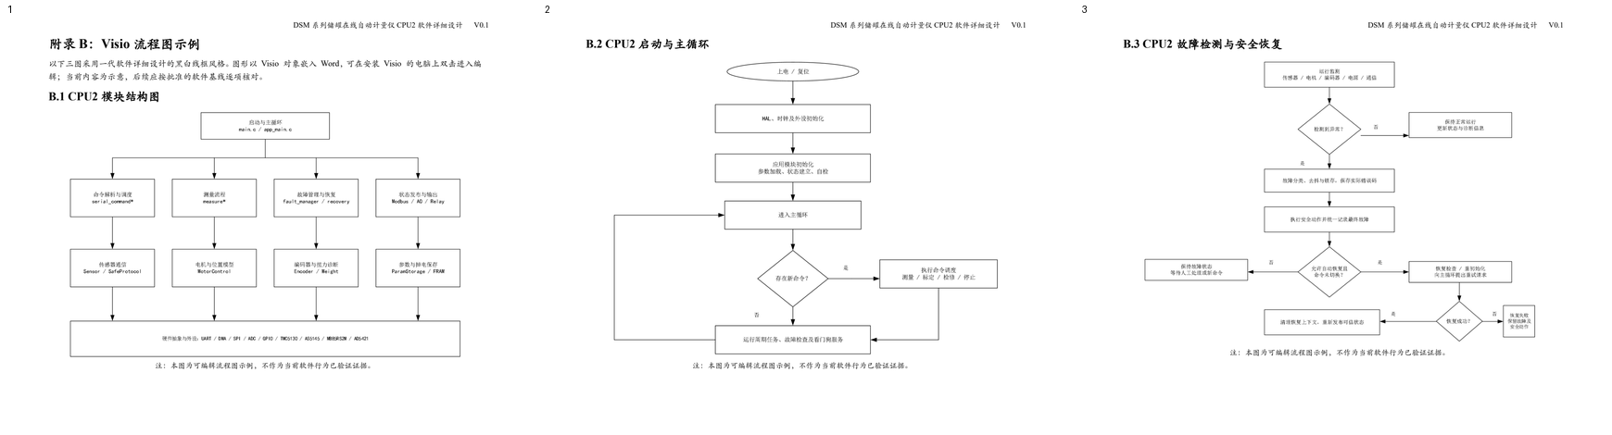
docs/06_SIL功能安全认证/03_软件详细设计/CPU2软件详细设计编制工作包/04_流程图版式基准/流程图预览V0.4.png
