duanxuebin1998/cube/docs/04_界面与菜单/CPU3参数单位与范围补充清单.md

# CPU3参数单位与范围补充清单

日期：2026-08-17

## 1. 结论

本文用于跟踪 CPU3 参数菜单 `param_meta[]` 的单位、范围显示和范围校验后续工作。

当前结论：

- 已完成稳定单位补充：机械、液位、水位、罐高、分布、Wartsila、AO、手输值等已确认单位的参数已经在菜单中显示单位。
- 已完成已有范围显示：`is_check=true` 的参数会在详情页显示范围，未额外打开新的范围校验。
- 已完成继电器动态单位：CPU3 V1.11.1.1 起，K1~K4 报警阈值和报警滞回按本路“报警取值源”动态显示 `mm` 或 `℃`。
- 暂不启用新的静态范围：罐高、盲区、分布上下限、单点位置、电机距离等依赖现场配置或其它参数，不适合直接写死范围。
- 本轮已从源码确认：电机限速为 `0.01m/min`，协议 13 起液位找液/滞后阈值按密度阈值 `kg/m3 x100` 保存，旧频率找液路径由 CPU2 折算回历史 Hz 阈值使用；运行态角度为 `0.01°`，探底角度阈值为 `°`，水位阈值类电容为 `pF` 且参数原始值 `x1000`，零点电容为 `0.1pF`，磁通量 D/T 本质为密度/温度修正量。
- 已完成密度两位小数口径整改：CPU2/CPU3 共享密度 raw 按 `kg/m3 x100` 解释，CPU3 状态页和参数菜单按两位小数显示；DSM/Wartsila 外部协议在边界继续保持原 `x10` 口径。
- CPU3本地参数结构当前`CPU3_PARAM_VERSION`为`0x0007`，并保留V3～V6迁移路径；CPU2设备参数和CPU2/CPU3共享协议单独维护。当前正式`DEVICE_PROTOCOL_VERSION = 34`、双端固件V1.40.0.0；协议33把AO电流修正和输出电流显示提升为三位小数，协议34不改变CPU3本机FRAM参数布局或该显示倍率。
- 已同步读取部件参数状态页口径：X/Y 角按 `debug_data.angle_x/y` 的角度 `x100` 显示，读取参数态不受 `bottom_detect_mode` 限制；协议31扭力模块温度按`debug_data.torque_temperature_bits`的IEEE754单精度原始位显示2位小数，无效时显示`--.--`；蓝牙 RSSI 为运行态字段，单位 `dB`，`rssi_valid == 0` 时显示 `RSSI:N/A`。三者都不属于 `param_meta[]` 可写参数。
- 仍需现场或算法确认：扭力类原始量含义、尺带伸缩率单位、是否给液位探头距差启用范围校验，以及“尺带类型”选项与厚度映射。

## 2. 参数元数据规则

CPU3 参数菜单的数据来自 `LTD_DISPLAY_CPU3/Application/system_param/system_parameter.c` 中的 `param_meta[]`。

| 字段 | 作用 |
| --- | --- |
| `unit` | 菜单列表、详情页和输入页的单位显示 |
| `flag_checkvalue` | 是否启用写入前范围检查 |
| `valuemin` / `valuemax` | 写入范围 |
| `point` | 小数位，决定原始整数和显示值之间的倍率 |
| `offset` | 输入/显示偏移，当前主要用于磁通量 D/T |

维护原则：

1. 只补 `unit` 属于显示体验变化，通常只升 CPU3 固件版本，不改变 `DEVICE_PROTOCOL_VERSION`。
2. 启用 `flag_checkvalue` 或改 `valuemin` / `valuemax` 会改变现场可写入行为，必须单独评估版本、CHANGELOG 和测试方案。
3. 源相关参数不写静态单位，例如继电器报警阈值和滞回，必须按“报警取值源”动态显示。
4. 动态范围和组合校验不要混入单位补充提交，应单独设计、单独验证。

## 3. 已完成项

### 3.1 稳定单位

| 参数类别 | 已完成内容 | 版本/说明 |
| --- | --- | --- |
| 编码与尺带 | 编码轮周长、首圈周长、尺带厚度显示 `mm` | 已完成 |
| 液位/水位 | 液位罐高、液位探头距差、液位盲区、水位罐高、水位盲区、水位最大下行距离显示 `mm` | 已完成 |
| 罐高/罐底 | 实测罐高最大偏差、初始罐高、当前罐高、探底修正罐高显示 `mm` | 已完成 |
| 零点/扭力行程 | 扭力忽略区、零点最大偏差、找零下行距离显示 `mm` | 已完成 |
| 分布/区间 | 分布点间距、最高点距液面、最低点距罐底、区间测量上下限显示 `mm` | 已完成 |
| Wartsila | 最高密度点、最低密度点、密度点间距、最高点液面距显示 `mm`，瓦锡兰探底间隔显示 `次` | 已完成 |
| AO输出 | 0%/100%对应值和输入值显示`mm`；电流修正、固定、故障、初始、仿真和输出电流显示`mA`；阻尼显示`s`；输入百分比显示`%`；工作模式、电流模式、输出源、故障动作、输出状态和仿真开关不显示物理单位 | 协议27口径；当前5组17项（13项可操作、4项只读），另2个隐藏预留不计菜单 |
| CPU3 手输值 | 液位/水位手输值显示 `mm`，密度手输值显示 `kg/m3`，温度手输值显示 `℃` | 已完成 |

### 3.2 已有范围显示

以下参数已有 `flag_checkvalue=true`，菜单详情页可显示范围，写入时也按现有范围检查。

| 参数 | 范围 | 单位/说明 |
| --- | --- | --- |
| 故障自动恢复重跑次数 | `0~10` | 次，`0` 表示关闭自动重跑 |
| 电机运行电流 | `1~31` | TMC5130 `IRUN` 档位，CPU3 选择列表显示档位和当前硬件换算的 RMS 相电流，例如默认 `12 0.55A` |
| 电机局部周长 | `50000~5000000` | `50.000~5000.000 mm` |
| 零点阈值比例 | `0~100` | `%` |
| 罐底检测模式 | `0~1` | `0=扭力`，`1=陀螺仪角度` |
| 分布测点数 | `1~200` | 点 |
| 分布点悬停 | `0~600` | s |
| 瓦锡兰探底间隔 | `0~100` | 次 |
| AO工作模式 | `0~2` | 0禁用、1为4-20mA输出、2为HART从站+输出 |
| AO电流模式 | `0~3` | 0为NE、1为US、2为普通、3为固定电流 |
| AO输出源 | `0~2` | 0储罐液位、1传感器位置、2水位；单位均为mm |
| AO电流修正 | `-1000~1000` | `-1.000~1.000 mA`，原始倍率0.001mA并显示三位小数；仅在启用态的最终输出阶段叠加一次，禁用态仍固定3.400mA |
| AO固定电流 | `400~2250` | `4.00~22.50 mA` |
| AO 0%/100%对应值 | `0~当前源上限` | 原始倍率0.1mm；两值禁止相等但允许反向，切换源时加载新源默认量程 |
| AO阻尼系数 | `0~9999` | `0.0~999.9 s`，0表示关闭 |
| AO故障动作 | `0~1` | 0输出故障电流、1保持上次有效过程电流；保持无历史时回退初始电流 |
| AO故障电流 | `340~2260` | `3.40~22.60 mA`；故障动作选择故障电流时参与输出 |
| AO初始电流 | `340~2260` | `3.40~22.60 mA`，默认4.00mA；首次有效过程目标成功写入前使用 |
| AO仿真电流 | `340~2300` | `3.40~23.00 mA`，默认12.00mA；仿真关闭时仍可预配置 |
| AO输出仿真 | `0~1` | 关/开；非持久化，上电和切换禁用时关闭，仅输出已启用时可操作 |
| AO输出状态/输入值/输入百分比 | 只读 | 输出状态显示初始、过程、保持、故障、模拟、固定、禁用、驱动故障或N/A；输入值和百分比分别显示mm和%，过程、保持及采用保持动作的故障状态显示同一成功过程目标对应的值，初始、固定、仿真、禁用、驱动错误或CPU2快照不可用时显示`N/A` |
| AO输出电流 | 只读 | 显示最近一次成功下发给AD5421的电流命令值，单位mA并保留三位小数；禁用、CPU2快照不可用或尚无成功下发记录时显示`N/A`；不是物理环路实测值 |
| 液位/水位手输值 | `0~999999` | `0.0~99999.9 mm` |
| 密度手输值 | `0~300000` | `0.00~3000.00 kg/m3` |
| 温度手输值 | `-500~2000` | `-50.0~200.0 ℃` |
| 小数点位数 | `0~4` | 位 |
| 屏幕密码 | `0~9999` | 无单位 |
| COM 参数 | 按枚举范围 | 波特率、数据位、校验、停止位、协议 |

AO上述12项持久化配置始终可预配置，不受工作模式、电流模式、故障动作或仿真开关状态限制；表内模式说明只表示配置何时参与运行输出。AO输出状态、输入值、输入百分比和输出电流共4项继续永久只读；原错误等级槽位和DAC回读继续隐藏预留。

### 3.3 继电器动态单位

CPU3 V1.11.1.1 起，K1~K4 的 HH/H/L/LL 报警阈值和报警滞回不在 `param_meta[]` 写静态单位，而是在显示侧按本路 `报警取值源` 动态显示。

| 报警取值源 | 显示单位 |
| --- | --- |
| 储罐液位 | `mm` |
| 水位 | `mm` |
| 浮子位置 | `mm` |
| 液相温度 | `℃` |
| 无/非法值 | 不显示静态单位 |

覆盖页面：

- 参数列表页
- 参数详情页
- 参数输入页

## 4. 本轮确认结果

依据 CPU2/CPU3 当前源码确认如下。本节只确认单位和倍率口径，不改变寄存器地址、字段顺序或写入行为。

| 参数/类别 | 确认口径 | 源码依据 | 菜单建议 |
| --- | --- | --- | --- |
| 电机限速 | 原始值单位为 `0.01m/min`；`200` 表示 `2.00m/min` | `max_motor_speed` 注释、运动接口 `speed_x100` 和日志均按 `0.01m/min` | 可显示为 `m/min`，`point=2`，单位 `m/min` |
| 运行态电机速度 | 原始值单位为 `0.01m/min` | `debug_data.motor_speed` 注释和打印口径 | 状态/调试页按 `m/min` 显示时用 `point=2` |
| 运行态 X/Y 角 | 原始值为角度 `x100`；`123` 表示 `1.23°` | 读陀螺仪后写入 `angle_x = ax * 100`，显示侧 `point=2` | 已按 `°`、2 位小数显示，保持 |
| 读取参数态 X/Y 角 | 与运行态 X/Y 角同口径；读取部件参数完成态直接按 `debug_data.angle_x/y` 显示，不依赖 `bottom_detect_mode` | `CMD_ReadPartParams()` 读取陀螺仪后刷新 `debug_data.angle_x/y`，CPU3 状态页读取参数上下文直接使用该快照 | 读取参数页保持 `°`、2 位小数；探底/罐高上下文仍按探底模式控制角度显示 |
| 扭力模块温度 | 协议31共享IEEE754单精度原始位；只在读取部件参数完成态消费 | CPU2把Newhall帧温度原始位发布到`debug_data.torque_temperature_bits`；CPU3拒绝NaN、无穷和`-999.99～999.99 ℃`范围外数值 | 状态页只读显示“扭温”/`T.Temp`、单位`℃`和2位小数；无效时固定显示`--.--`，不是`param_meta[]`参数 |
| 蓝牙连接 RSSI | 运行态原始值为 dB；`rssi_valid` 表示当前快照是否有效 | CPU2 发布 `wireless_pairing_status.rssi_valid/rssi`，CPU3 从协议 9 起读取 | 状态页只读显示 `RSSI:<value>dB` 或 `RSSI:N/A`；不是 `param_meta[]` 参数 |
| 液位找液阈值 | 底层 raw 仍经协议 13 迁移为原值的 10 倍；频率液位路径通过 `FrequencyLevel_GetCompatThresholdHz(raw/10)` 折算为 Hz | 频率找液位按 Hz 死区比较；密度连续找液位复用同一 raw 时仍按 `RAW_TO_DENSITY()` 比较密度差 | CPU3 按 `Hz`、`point=1` 显示；默认 `150` 显示为 `15.0 Hz` |
| 液位滞后阈值 | 底层 raw 仍经协议 13 迁移为原值的 10 倍；频率液位路径通过 `FrequencyLevel_GetCompatThresholdHz(raw/10)` 折算为 Hz | 频率跟随按 Hz 滞后死区比较；密度跟随复用同一 raw 时仍按 `RAW_TO_DENSITY()` 比较密度差 | CPU3 按 `Hz`、`point=1` 显示；默认 `200` 显示为 `20.0 Hz` |
| 探底角度阈值 | 原始值为整度；默认 `12` 表示 `12°` | 默认值注释为“单位(度)/倍率*1”，探底判断中直接转 `float` 比较 | 可补单位 `°`，小数位保持 `0` |
| 水位跟随电容阈值 | 原始值为 `pF x1000`；CPU2 V1.12.1.3 默认 `20000` 表示 `20.000pF` | `WaterCapRawToFloat(raw) = raw / 1000.0f`，跟随目标为 `air_cap + threshold` | 可显示单位 `pF`，`point=3` |
| 水位寻找电容阈值 | 原始值为 `pF x1000`；CPU2 V1.12.1.3 默认 `10000` 表示 `10.000pF` | 与水位跟随阈值同用 `WaterCapRawToFloat()` | 可显示单位 `pF`，`point=3` |
| 水位滞后电容阈值 | 原始值为 `pF x1000`；CPU2 V1.12.1.3 默认 `30000` 表示 `30.000pF` | 稳定监测中用 `WaterCapRawToFloat(water_lag_cap_threshold)` | 可显示单位 `pF`，`point=3` |
| 零点电容 | 原始值为 `0.1pF`；保存时 `zero_cap = 10 * cap` | 读取零点电容后保存 `10*cap`，加载时 `zero_cap / 10.0` | 可显示单位 `pF`，`point=1` |
| 当前电容状态量 | 运行态是 float pF；显示侧乘 10 后按 1 位显示 | `current_capacitance` 来自 `Sensor_ReadWaterCapacitance(float*)`，状态页显示 `cap * 10` 且 `point=1` | 状态页可补显示单位 `pF` |
| 磁通量D/密度修正 | 协议 13 起存储原始值以 `100000` 为零点，实际修正量为 `(raw - 100000) / 100` | CPU2 传感器读数后执行 `density += (densityCorrection - 100000) / 100` | CPU3 按 `密度修正` 语义显示，单位 `kg/m3`，`point=2`，菜单 offset 为 `-100000` |
| 磁通量T/温度修正 | 存储原始值以 `1000` 为零点，实际修正量为 `(raw - 1000) / 10` | CPU2 传感器读数后执行 `temp += (temperatureCorrection - 1000) / 10` | CPU3 V1.11.1.2 起文案改为 `温度修正`，单位 `℃`，`point=1` |
| 扭力类参数 | 当前源码只能确认是扭力传感器/算法内部计数，不是物理 g/kg | UART4 取 `int16_t g_weight`，`current_weight = empty_weight - g_weight`，碰撞阈值直接用该内部值计算 | 暂不补 g/kg；可文案标注“扭力值”或“计数” |
| 探底扭力阈值 | 与扭力内部值同口径 | 探底判断直接比较 `current_weight` 和 `bottom_weight_threshold` | 暂不补 g/kg；可显示为“扭力值” |
| 密度手输值 | 原始值按 `kg/m3 x100`；`100000` 表示 `1000.00kg/m3` | 运行态密度显示按 `x100 kg/m3`，CPU3 本地手输值字段为 32 位，V3/V4 本地 FRAM 迁移时从 x10 转为 x100 | CPU3 显示为 `kg/m3`，`point=2`，范围 `0~300000` |

## 5. 可直接做的下一步

这些工作风险较低，但仍建议拆成独立提交。

| 优先级 | 工作项 | 建议动作 | 版本影响 |
| --- | --- | --- | --- |
| P1 | 液位探头距差范围校验 | 现场确认后决定是否打开 `flag_checkvalue`，现有范围字段为 `-999999~999999` | 改写入行为，需升 CPU3 build/patch 并写明兼容影响 |
| P2 | 补电容/速度/角度显示单位 | 已在 CPU3 V1.11.1.2 补 `pF`、`m/min`、`°` | 需实物确认 OLED 排版和输入页显示 |
| P2 | 磁通量 D/T 文案优化 | 已在 CPU3 V1.11.1.2 改为“密度修正/温度修正” | 需现场确认操作人员是否接受新文案 |
| P2 | 清理不确定单位表 | 对扭力类、尺带伸缩率逐项确认单位 | 先只更新文档，不升版 |

## 6. 需要确认后再做

这些参数目前不能直接补单位或启用范围，需要你或现场/算法口径确认。

| 参数 | 当前线索 | 需要确认 |
| --- | --- | --- |
| 探底扭力阈值 | 与 `current_weight` 直接比较 | 是否对现场文档命名为“扭力计数/扭力值”，不建议写 g/kg |
| 空载/满载扭力及上下限 | 来自扭力串口原始值差值 | 是否对现场文档命名为“扭力计数/扭力值”，不建议写 g/kg |
| 尺带伸缩率 | 小数 6 位 | 是无量纲系数、ppm，还是 1/℃ 系数 |
| 尺带类型 | 《LNG计量仪屏幕菜单.docx》备注要求将“尺带厚度”改为选项型“尺带类型”；当前 CPU2/CPU3 共享字段仍为 `tape_thickness_mm`，单位 0.001mm | 需要确认每个尺带类型的显示名称、对应写入的 `tape_thickness_mm` 原始值，以及是否保留手工输入厚度 |

## 7. 暂不做静态范围的项目

以下参数适合后续做动态范围或组合校验，不建议直接在 `param_meta[]` 写死范围。

| 参数类别 | 参数 | 原因 |
| --- | --- | --- |
| 罐高/盲区 | 液位罐高、液位盲区、水位罐高、水位盲区 | 上限依赖机械行程、项目罐高或其它参数 |
| 回零/水位行程 | 扭力忽略区、零点最大偏差、找零下行距离、水位最大下行距离 | 与安全边界和实际行程相关 |
| 分布/区间 | 分布点间距、最高点距液面、最低点距罐底、区间测量上下限 | 需要与点数、液位、罐底和上下限组合判断 |
| Wartsila | 最高密度点、最低密度点、密度点间距、最高点液面距 | 方向口径和上下限组合关系需确认 |
| 指令参数 | 单点测量位置、单点监测位置、电机运行位置、电机上行/下行距离 | 调试和强制运动需要保留弹性，不能简单收窄 |

## 8. 不建议补单位的参数

以下参数是枚举、布尔、版本号、只读校验值、命令值或源相关配置，不需要静态物理单位。

- `设备指令`
- `传感器类型`
- `传感器编号`
- `传感器软件版本`
- `CPU2程序版本`
- `CPU3程序版本`
- `协议版本`
- `参数版本号`
- `结构体大小`
- `魔术字`
- `参数CRC32`
- `上电默认指令`
- `故障自动回零`
- `故障停止测量`
- `位置源自动切换`
- `记步模式`
- `液位测量方式`
- `水位测量方式`
- `罐底检测模式`
- `更新罐高标志`
- `罐底后编码器修正`
- `是否测罐底`
- `是否测水位`
- `是否测单点密度`
- `分布测顺序`
- `分布测模式`
- `语言`
- `液位/水位/密度/温度数据源`
- `上传手输密度`
- `息屏开关`
- `COM1/COM2/COM3` 的波特率、数据位、校验、停止位、协议
- `K1~K4` 的工作模式、输出报警位、接点、报警模式、无效值、报警取值源、清报警
- `K1~K4` 的报警阈值和报警滞回：不写静态单位，已按报警取值源动态显示

## 9. 下一步计划

### 第一步：文档确认，不改代码

目标：确认剩余不确定单位。

待确认清单：

1. 扭力类参数现场名称：建议使用“扭力值/扭力计数”，除非传感器或标定文档确认 g/kg。
2. 尺带伸缩率是否为无量纲系数、ppm 或 1/℃。

输出：更新本文第 6 节，形成可直接改代码的确认表。

### 第二步：低风险显示补充

前提：第一步确认单位后执行。

可做内容：

- 只补 `unit` 和必要显示文案。
- 不改 `flag_checkvalue`。
- 不改 `valuemin` / `valuemax`。
- 不改 `DEVICE_PROTOCOL_VERSION`。

验证：

- `py LTD_DISPLAY_CPU3\font_check.py`
- `cmake --build build\LTD_DISPLAY_CPU3`
- `py tools\check_version_bumped.py`

### 第三步：已有范围校验评估

前提：现场确认不会依赖超限写入。

候选项：

| 参数 | 现有范围字段 | 建议 |
| --- | --- | --- |
| 液位探头距差 | `-999999~999999`，小数 1 位，`mm` | 可优先评估是否启用 |
| 磁通量D | `-10000~10000`，小数 1 位，offset `-10000` | 算法口径已确认，启用前仍需确认现场是否允许负修正范围 |
| 磁通量T | `-1000~1000`，小数 1 位，offset `-1000` | 算法口径已确认，启用前仍需确认现场是否允许负修正范围 |

注意：这一步会改变写入行为，必须单独升 CPU3 版本并写清兼容影响。

### 第四步：动态范围/组合校验设计

前提：完成现场边界和安全策略确认。

候选规则：

- 液位盲区 `<=` 液位罐高。
- 水位盲区 `<=` 水位罐高。
- 区间测量上限/下限满足方向口径和大小关系。
- 分布点数、点间距、最高点距液面、最低点距罐底组合后不越界。
- 单点位置满足盲区和罐高边界。
- 电机运行距离满足普通/强制运动不同安全边界。

注意：这一步不是简单 `param_meta[]` 范围，建议独立做校验函数和测试方案。
