duanxuebin1998/cube/docs/03_问题分析与整改/未处理/2026-07-23_CUBE全量问题核对清单与整改跟踪.md

<div class="hero">

# CUBE 全量问题核对清单与整改跟踪

本页以 2026-06-30 首轮多智能体代码审查清单为基础，交叉核对后续全工程审查、专题问题文档、流程导航和协议增量。稳定编号用于追溯；**2026-09-07 增量是本轮现行状态入口**，此前各层保留历史证据。本轮重点复核 20 个既有 C 主项及 DM4 专题，不表示所有历史问题均已重新完成源码审查。当前固件版本以[版本总览](../../00_构建与版本/版本总览.md)为准，不能把历史证据基线、未提交工作树或构建结果冒充当前发布和实机闭环。

<div class="meta-grid">

<div class="meta-item">

**本轮源码基线** `MAIN@b756b6b6d7e5` / CPU2 V1.42.11.0 / CPU3 V1.41.0.0 / 共享协议 35；称重探底另注明已暂存工作树

</div>

<div class="meta-item">

**整理方式**全来源去重；按统一编号、当前状态、责任端和证据层维护

</div>

<div class="meta-item">

**2026-09-07 复核结果**更新代码已整改及部分整改事实；C-25 增加非有限温度消费链；补录 C-48／C-49，仍有 47 个未关闭主项

</div>

<div class="meta-item">

**证据限制**本轮为源码审查、专项静态检查和文档校验；未运行固件构建或实机台架。历史 clean-first 记录不作为本轮硬件闭环证据

</div>

</div>

</div>

<div id="current-review-2026-09-07" class="section">

## 2026-09-07 整改状态复核（现行增量）

### 基线、范围与统计

本轮源码提交基线为 `MAIN@b756b6b6d7e5`，CPU2 `V1.42.11.0`、CPU3 `V1.41.0.0`、双端共享协议 `35`，CPU2 参数存储版本 `3`、CPU3 本机参数版本 `0x0007`。开始时有 26 个已暂存文件，包含 7 个 CPU2 称重探底相关源码文件；本轮 C-11 的进展取自该已暂存工作树，不冒充 HEAD 或已发布固件。恢复审查时另出现并行液位策略文件和规则文档改动，本轮不修改、不纳入整改完成结论。

本轮仅维护总账、HTML 阅读版和两个问题索引，不整改固件、不升版、不暂存、不提交、不生成 PDF。重点复核 C-03、C-07～C-11、C-14、C-22、C-23、C-25～C-27、C-32、C-35～C-38、C-41、C-46、C-47 共 20 个既有主项，以及 2026-08-10 DM4 专题三项。其余编号沿用历史状态，标识为待下一轮复核，而非本轮重新确认。

| 统计项 | 数量 | 口径 |
| --- | ---: | --- |
| C 主项总数 | 49 | C-01～C-49；保留 C-21 产品行为和 C-39→F-22 的历史编号 |
| 尚未关闭主问题 | 47 | 原 45 项，加本轮专题补录 C-48、C-49；代码已整改但未满足关闭条件的仍计入 |
| CPU2／CPU3／工具主责 | 31 / 15 / 1 | 沿用既有主责归属；C-48、C-49 均归 CPU2 |
| P0 / P1 / P2 / P3 | 11 / 25 / 10 / 1 | C-48 定为 P1；C-49 对应专题中等级，定为 P2；其余不因局部改善自动降级 |
| 本轮完整关闭 C 主项 | 0 | 不把代码主因消除、静态通过或历史构建等同于全部验收完成 |
| 本轮新证据／专题补录 | 1 / 2 | 新证据为 C-25 非有限温度消费链；C-48／C-49 是 8 月已有专题问题，不是 9 月新引入 |
| R／B／F 记录 | 5 / 10 / 22 | R-01～R-05、B-01～B-10、F-01～F-22；F-11 关闭前提失效并入 C-03，不能称 22 项全部已关闭 |

### 已修复的代码主因与部分整改

表中“代码主因已消除”仅指明确列出的原路径；现存残余和未完成验收分别列出。源码位置按本轮基线记录；CPU2 路径相对 `LTD_MAIN_CPU2/`，表内应用层短路径 `app/`、`measurement/`、`tank_height/`、`measure_density.c` 对应 `Application/Src/` 下相应模块，后续重构时优先按函数名定位。

| 编号 | 本轮状态 | 已核实的整改事实 | 剩余关闭条件 |
| --- | --- | --- | --- |
| C-10 / P0 | 代码已整改，待边界验证 | `Application/Src/measurement/density/measure_density.c:612` 的 `BuildPoints_Interval_Exact()` 使用 `uint32_t i`，先检查点数上限与输出容量；原 128～200 点 `int8_t` 回绕写栈路径已消除 | 仍需 0、1、100、127、128、199、200、201 点及容量不足的输出数量、数组哨兵、取消／失败不发布验证；本轮未执行该宿主矩阵 |
| C-47 / P1 | 原两条代码主因已整改，待台架 | `Services/power_monitor.c:301` 启动先进入安全态，失败锁存 `POWER_MONITOR_INIT_FAILED`；`app/app_main.c:132` 已消费启动返回。`power_monitor.c:457` 在电压稳定且紧急持久化结束后才释放 FRAM 预留；`Services/Encoder/encoder.c:595` 等自行释放路径仅限测试来源 | 低压保持、恢复抖动、ADC／DMA／OVR 故障和随机相位掉电台架；记录供电波形、保持时间、普通写门禁和重启值。关联 B-01，不再列“启动返回被丢弃／真实低压期间提前释放”作为当前代码缺陷 |
| C-07 / P1 | 部分整改 | 编码器已有启动稳定同步、动态增量上限、断档撤销位置可信度和锁存；`Services/Encoder/encoder.c:933` 的 `Encoder_IsReady()` 同时要求位置有效、角度同步且无锁存，不再仅靠历史单帧好值。`FaultManager_LatchAsyncError()` 已硬件禁用驱动 | 保留多故障覆盖／清错归属、连续故障及真实停机验证。新正式命令清锁存和 LIN 仅统计是当前明确策略，不继续把旧“白名单过宽／LIN 漏判”当作未确认产品需求 |
| C-14 / P1 | 部分整改，待时延证据 | AS5145 硬件 ISR 最小投递、PendSV 有界消费已进入 HEAD，不再写“仅未提交试改” | PendSV 仍执行有界 FRAM 提交／读回和延后协议任务；需最坏占用、积压、HART／板间通信／编码器竞争实测，不能仅凭移出硬件 IRQ 关闭 |
| C-22 / P1 | 维持部分整改 | 命令定长、精确 ACK、严格字段校验、有界重试与 RAM-only 版本识别仍在；本轮 DSM 帧与兼容契约通过 | CPU1 `CB/CD` ACK 不等于内部业务模式成功；真实版本、坏帧、恢复后首帧及结果不陈旧矩阵留 B-06 |
| C-23 / P2 | 统一 owner 已实现，集成验证未闭环 | `95142c6d` 后 `Services/Sensor/sensor_uart6_owner.c:21` 提供非抢占所有权、同 owner 嵌套和原子交接；DSM、V3、V4 主动／交互、Safe、CH9141 AT 已接入，回调按 owner 路由；本轮架构契约通过 | 无线长稳、冷唤醒、协议切换、UART 错误恢复和 owner 释放闭环仍需实物验证；不再保留“尚无 UART6 统一 owner”的旧结论。DM4 不确定切换另按 C-49 跟踪，避免重复计数 |
| C-26 / P2 | 部分整改，策略口径已纠正 | `BSP/Peripherals/src/AS5145.c:24` 明确 `SSI_LINEARITY_FAULT_ENABLED 0U`；LIN 仅计数、12-13 保留是当前实现策略，不是遗漏条件的新增缺陷 | 其它故障码边界、双端展示和故障注入仍待验收；未来启用 LIN 故障需单独变更策略与验收，不以补判据作为当前必改项 |
| C-35 / P1 | 部分整改 | 电机位置存储已有统一 FRAM 调用与读回，安全身份平台 `sensor_safe_identity_platform.c:33/55` 已通过 `FRAM_Read/Write`；旧“身份绕锁／电机完全忽略写结果”不再适用 | 旧 void 包装仍需逐调用者审查；`BSP/Peripherals/src/TMC5130.c:376/463` 仍使用 `HAL_MAX_DELAY`，超时、BUSY、掉线和共享 SPI4 竞争未整体关闭 |
| C-41 / P0 | 编码器异步硬停已整改，通用出口仍缺 | `Application/Src/diagnostics/fault_manager.c:58` 发布异步错误后直接 `stpr_disableDriver()`，不是单纯等待主循环处理 | 通用 `AbortableDelay_CommandSwitch()` 及密度长循环仍主要检查命令切换，缺统一阻塞故障出口；硬停不等于停止结果发布、终态正确或机械停止时延已证 |
| C-11 / P0 | 已暂存工作树部分整改，未发布 | 称重探底增加预计窗口、两次触发一致性、按触发／刹停位置释放；`tank_height/measure_tank_height.c:758` 在最终释放成功后才提交候选罐高，`770` 才发布罐底参考有效 | 300／200／10 mm 是内部暂定值；需不同载荷、噪声、惯性、取消和释放失败的目标板验证。不能由局部探底整改关闭全部探底／标定终态路径 |
| DM4-MSR-01（专题） | 测水使能未接入的代码主因已消除 | `Services/Sensor/sensor_driver_registry.c:274` 读水前调用 `SensorDriverV4_SetWaterEnabled(1U)`，成功后 `SensorDriverV4_WaitForValue()` 等新鲜值，支持取消／超时；统一入口为 `sensor_service.c:213` | 真实 DM4 测水、霍尔互斥、首个新鲜 R05 和状态切换验收留 B-06；不另增开放 C 主项，也不把整套 DM4 测量流程写成已闭环 |

对应实现资料：[编码器当前实现说明](2026-08-14_CPU2编码器采集_连续性保护与持久化当前实现说明.md)、[传感器分层与 DM4 身份统一整改记录](../已闭环/2026-08-18_传感器代码分层与DM4身份统一整改记录.md)、[称重探底可靠判定方案](2026-09-03_CPU2称重探底可靠判定方案.md)。历史专题中尚未刷新的状态，以本节逐项结论为准。

### 本轮仍确认存在的旧问题

| 编号 | 本轮代码证据 | 结论与下一步 |
| --- | --- | --- |
| C-03 / P0 | `Services/ParamStorage/system_parameter.c:1777` 分别写 A/B，`1791` 仅双槽失败才返回失败，`1826` 至少一槽成功即推进完成标志；`1932` 启动仍固定优先有效 A | A 保留旧有效镜像、更新 A 失败而 B 成功时，保存完成后重启仍可读旧 A；需参数提交代次与启动选新槽一致。**编码器记录已有 generation，不代表参数 A/B 已修复。** 此前“工作树回归”现已存在于 HEAD |
| C-08 / P1 | `Core/Src/stm32f4xx_it.c:538` 仍以 `RETTOBASE` 作为 CPU2 喂狗门禁 | 缺前台／关键任务健康票据，不能用 CPU3 已整改代替 CPU2 闭环 |
| C-09 / P0 | `Services/Weight/weight.c:82` 的 `weight_init()` 刷新接收时间；`Application/Src/measurement/measure.c:337` 测量启动仍调用 | 称重探底优化不等于扭力新鲜度已修复；只有真实合格接收帧才能刷新该时间 |
| C-32 / P1 | `measurement/density/measure_density_acquisition.c:124` 超时兜底可返回 `NO_ERROR`；`measure_density.c:221` 分布调用传 `stable_out=NULL`，随后累加并 `valid++` | 固定点消费者已有稳定标志检查，不代表分布路径已修；无效／未稳定数据应等待或跳过且不发布，不应被当作正常稳定样本或直接升级为通信错误 |
| C-36 / P1 | CPU3 `Application/system_param/mb85rs2m.c` 仍多处 `HAL_MAX_DELAY` | CPU2 FRAM 超时整改不覆盖 CPU3；需其调用链有界等待与失败传播 |
| C-37 / P2 | CPU3 `Application/display/display_tankopera.c:2857/2865` 仍 `HAL_Delay(100/500)` | 前台交互阻塞仍在，需按键＋通信并行台架与非阻塞退出设计 |
| C-38 / P2 | CPU3 `Application/display/display.c:2435` 的周期判断到 60000 ms 无条件成立 | 8 月恢复重试和 GDDRAM 清屏改善不等于取消健康周期复位；仍需长稳及屏幕波形证据 |
| C-27 / P3 | `tools/check_parameter_measurement_fault_contract.py:77` 对提交顺序使用固定 240／360／180／600 字符窗口，本轮报错 | 源码最终释放、`CHECK_ERROR(ret)`、候选罐高提交顺序正确；新增释放分支超出文本窗口，归工具漂移，不伪报“安全抬升前提交”的固件缺陷 |
| C-46 / P2 | 本轮 strict inventory 为 `diagnostics.status=error`、62 个 `unresolvedCalls`，前置入口实际 5 个而工具仍要求 2 个，继电器 END 地址双端 `None` | 工具尚不能作为完整协议闭环证据；需适配当前分发／ACK 链、嵌套宏和函数来源。7 月的 54 个未解析调用及 440 项回归结果只保留历史用途 |

### C-25 新确认：非有限温度穿过通用稳定判定

本项是既有“字段质量无统一契约”的新增可达证据，仍归 C-25 / P1，不另增主项；本轮没有据此认定缺陷最初引入日期。

1. DM4 交互密度读取在 R06 为非有限或越界值时返回 `NAN` 温度；核心通信及后续刷新正常时仍可返回 `NO_ERROR`。见 `Services/Sensor/Protocols/Dm4/V4/multiparam_v4_measurement.c:395`。驱动内部调试快照有 `isfinite()` 保护，但不能保护服务层后续消费者。
2. `Services/Sensor/sensor_service.c:194` 成功分支修正温度后，在 `202` 无条件执行 `TEMP_TO_RAW(*temp)`；`Services/ParamStorage/system_parameter.h:221` 宏直接转为 `uint32_t`。对 NaN 不能依赖可移植的整数结果，本轮不臆测目标 MCU 的具体转换值。
3. `Application/Src/measurement/density/measure_density_acquisition.c:201` 只跳过零密度；当密度非零且温度为 NaN 时，`234` 可把 NaN 记作参考温度。`242` 的温差为 NaN，`245` 的 `dt > TEMP_EPS` 不成立；若频率、密度满足窗口，`256` 仍进入稳定分支，转换无效温度并在 `270` 标记稳定成功。
4. SI 消费者的局部 `isfinite()` 检查不能撤销更早的服务层 NaN 转整数，也不能覆盖通用单点稳定窗口。

关闭条件：驱动、服务和消费者对“传输成功但当前未稳定／字段无效”保持一致；在任何原始值转换、稳定计时和结果发布之前处理非有限值；以正常密度配 NaN、±Inf、越界温度、恢复为正常温度的序列验证不误发布。合法未稳定值按等待／跳过处理，真实通信／帧错误保持故障语义。是否允许单独发布不含有效温度的密度结果，应先明确结果质量契约，不能在本轮文档整理中擅自决定。

### C-48／C-49：补录既有 DM4 专题问题

来源为 [2026-08-10 DM4 测量流程专题](2026-08-10_DM4传感器V4测量流程待处理问题记录.md)。两项在 8 月已记录，9 月仅复核仍可达并纳入统一编号，不应写成“本次新改坏”。专题 DM4-MSR-01 的代码主因已修复，见上表。

| 编号／等级 | 专题映射 | 当前证据与影响 | 关闭条件 |
| --- | --- | --- | --- |
| C-48 / P1 | DM4-MSR-02 | `multiparam_v4_measurement.c:339` 的交互分支读取 R02 后只查密度模式，随后读 R04／R07／R06，未检查 Bit8／Bit9 新数据；同文件 `459` 主动分支已有双标志检查。交互路径可能把旧 R06／R07 当作本轮新结果 | 消费同次 R02 的模式及新数据标志，缺任一标志不得发布；覆盖标志全零、单位置位、双位置位和读取 R02 后标志清零的连续事务。通用质量传播归 C-25，此项只计交互新数据准入 |
| C-49 / P2 | DM4-COM-01 | `multiparam_v4_interactive.c:863` 主动转交互时，R65=1 写入应答失败且 `932` 回读也失败，`941` 仍启动主动接收；`multiparam_v4_active_stream.c:315` 在本地 DMA 启动成功后把本地模式设为主动，但传感器可能已经进入交互，形成状态失步 | 对写成功但 ACK 丢失、读回超时／坏帧等不确定态提供有界重同步；只在取得模式证据后恢复业务，失败可退出且不可发布旧值。UART6 owner 已实现并不证明远端通信模式一致 |

上述源码文件均位于 `LTD_MAIN_CPU2/Services/Sensor/Protocols/Dm4/V4/`。本轮只记录问题和验收边界，不擅自实现新的 DM4 专用状态机。

### 本轮验证与下一步

| 验证项 | 本轮结果 | 证据边界 |
| --- | --- | --- |
| 11 项直接专项静态检查 | 10 通过、1 失败 | 通过项见下文；失败为 C-27 的固定文本窗口漂移，不代表整套检查全绿 |
| `protocol_fact_inventory.py --strict` | 失败，退出码 1 | 本机输出 `tmp/2026-09-07-full-issue-audit/protocol-inventory.json`；62 个未解析调用、双端继电器 END 地址 `None`，归 C-46 |
| 文档结构／Markdown 链接 | 通过 | 本轮检查 887 个文档文件、429 份 Markdown，缺失链接 0；版本人工索引漏收近期方案等提示不等于固件问题，不在本轮顺手扩改 |
| HTML／编码／差异 | 通过 | 保留原阅读样式；桌面 1440 px、手机 390 px 检查，无失效页内锚点或重复 ID，表格列数一致；UTF-8／CRLF 与 Markdown 源哈希同步，`git diff --check` 通过 |
| 固件构建／宿主边界矩阵 | 本轮未执行 | 只读审查与文档维护不重跑固件构建；历史方案中的构建不提升为本轮测试结果 |
| 实机／台架／现场／SIL | 本轮未执行 | 不证明 FRAM 掉电、低压保持、机械硬停、无线长稳、RS485、PLC、OLED 或 DM4 真实时序 |

本轮通过脚本：`check_dsm_uart6_frame_contract.py`、`check_dsm_compat_contract.py`、`check_sensor_fault_contract.py`、`check_multiparam_v4_protocol.py`、`check_cpu3_uart5_interframe_gap_contract.py`、`check_read_part_params_refresh_contract.py`、`check_density_profile_publish_contract.py`、`check_relay_alarm_config_contract.py`、`check_cpu3_display_command_contract.py`、`check_sensor_service_architecture.py`。失败脚本为 `check_parameter_measurement_fault_contract.py`。这些工具的静态通过不能推翻本轮识别的 C-25／C-48／C-49 消费与恢复链缺口。

后续优先级：先处理 C-03 参数持久化回退、C-09 扭力伪新鲜及 C-41 统一故障出口；并行准备 C-10 点数边界与 C-47 供电台架。DM4 按 C-25／C-48／C-49 分别验证字段有效性、新数据准入和模式恢复，C-27／C-46 工具失败单独治理。未在本节重点复核的历史条目继续开放待核对，不据此声称“全工程无其它问题”。

</div>

<div id="current-review-2026-08-10-dsm" class="section">

## 2026-08-10 DSM增量复核（历史专项状态）

本节保留当时的 DSM 证据；UART6 owner 等后续整改及现行状态以 2026-09-07 增量为准。

本增量形成时以`MAIN@c5fed025efc8`为发布基线：CPU2 `V1.38.0.0`、CPU3 `V1.37.0.0`、已发布共享协议32、CPU2参数存储3、CPU3本机参数`0x0007`。截至2026-08-17，当前正式组合已升至CPU2/CPU3 V1.40.0.0、共享协议34；协议33的AO倍率和协议34的编码器故障语义均未改变本节DSM整改事实或剩余关闭条件。

| 编号 | 等级 | 2026-08-10 当前状态 | 已落地事实 | 剩余关闭条件 |
| --- | --- | --- | --- | --- |
| C-22 | P1 | 部分整改，残余仍在 | `d3792fdf`随CPU2 V1.36.4.0发布命令级定长接收、精确ACK、BCC／CRLF／固定字段严检和业务解析有界重试；`c5fed025`随CPU2 V1.38.0.0把RAM-only `Cv/CV`版本上下文接入生产探测链 | DSM CPU1 `CB/CD` ACK仍不能证明内部模式切换成功；需真实V1／V2、V3及以上、歧义版本、golden frame、坏帧及UART错误注入，且失败不得发布旧／部分结果 |
| C-23 | P2 | 部分整改，残余仍在 | CPU2 V1.36.4.0已加入100 ms总时限的有界drain、命令切换／UART错误出口和CH9141K透明链路交接；V1.38.0.0只对大写`E`记录低电压 | 仍需收口DSM／LTD／多参数V3／AT的UART6 owner，验证恢复后首帧和长期无线透传，并处理V5.4 `Ch`冷唤醒首轮日志噪声 |
| B-06 | — | 静态证据增加，实机缺口仍在 | DSM帧、兼容和CN低电压三项静态契约通过；CPU2 V1.36.4.0与V1.38.0.0版本方案记录clean-first构建通过 | 补V1／V2、V3、V4、V5.0／V5.3／V5.4／V6.x、CK／CM、控制字符BCC、冷唤醒、FE／NE／ORE和CH9141K恢复实物证据 |

DSM CPU1 `Cb`本次通信失败后返回旧值的新鲜度风险继续由C-25／B-06承接；CUBE严格帧校验不能证明传感器内部数据新鲜。本次不新增或关闭稳定编号，只把C-22／C-23从旧“未实现”口径更新为“部分整改”，全量统计数量不变。

静态契约和构建只能证明代码形状与可编译性，不证明DSM、UART6、CH9141K、供电电压、密度分析参数或故障恢复的目标板行为。

</div>

<div id="current-review-2026-07-28" class="section">

## 2026-07-28 继续复核（历史全量基线）

本轮以 `MAIN@8297130855cdc294211850dc8cb9deb7be3152a3` 为提交基线，CPU2／CPU3 均为 `V1.34.0.0`，共享协议为 `29`。开始扫描时工作树共有 72 个状态项：46 个已暂存文件、26 个未暂存文件和 2 个未跟踪文件。C-03、C-07、C-14、C-35、C-41、C-47、R-03 和 B-01 的本轮结论包含尚未提交的 CPU2 整改代码，只能说明“当前工作树行为”，不能写成 `HEAD` 已发布能力。

2026-07-23 记录使用的 `46f5d634`、`db0b1322` 仍是可读取的历史对象，但已经不在当前 `MAIN` 祖先链。当前可达的等价固件基线分别为 `3dc72ed4`、`ba7094e8`；差异仅位于 `CHANGELOG.md` 和版本方案文档，固件源码无差异。后续引用保留这组映射，避免把悬空历史对象误作当前分支发布入口。

### 当前统计

| 统计项 | 数量 | 口径 |
| --- | ---: | --- |
| C 主项总数 | 47 | C-01～C-47；C-21 为产品行为，C-39 已转 F-22 |
| 尚未关闭主问题 | 45 | 2026-07-23 的 44 项，关闭 C-39，新增 C-46、C-47 |
| CPU2／CPU3／工具主责 | 29 / 15 / 1 | C-47 归 CPU2，C-46 归本机验证工具治理 |
| P0 / P1 / P2 / P3 | 11 / 24 / 9 / 1 | C-03 因确定性持久化回退链由 P1 上调 P0；C-39 从 P2 关闭；新增 C-46 P2、C-47 P1 |
| 受控偏差／产品决定 | 5 | R-01～R-05 |
| 台架、硬件和证据缺口 | 10 | B-01～B-10 |
| F 归档／转归记录 | 22 | F-01～F-22；其中 F-11 的关闭前提已失效，现重新并入 C-03 |

### 状态变化和新增项

| 编号 | 等级 | 2026-07-28 当前状态 | 本轮结论 | 下一步／关闭条件 |
| --- | --- | --- | --- | --- |
| C-03 | P0 | 部分整改，当前工作树确认回归 | 协议 28 已改善候选校验和 ACK 门禁，但当前已暂存参数 A/B 保存允许“任一槽写入新镜像即成功”；若 A 保留旧有效镜像、A 更新失败而 B 更新成功，本轮会发布完成，重启却固定优先旧 A。F-11 的关闭前提已经失效。 | 见下方 A/B 详细链；保存成功、启动选槽、CPU3 ACK 和重启值必须属于同一代提交。 |
| C-07 | P1 | 代码整改中，残余仍在 | 当前未暂存代码已取消好帧自动清锁存并增加连续坏帧确认；但 LIN-only 帧仍不进入错误条件，Ready 仍可由历史单帧好值成立，测量启动清锁存范围过宽，异步编码器错误仍可能覆盖其它全局故障。 | 建立错误 owner、连续好帧 Ready 和新鲜度；按显式命令白名单清锁存；多故障并发不得互相覆盖。 |
| C-14 | P1 | 部分整改，待时延验证 | AS5145／SPI5 ISR 已改为最小投递且每次 PendSV 有界消费，当前工作树 clean-first 构建通过；PendSV 仍同步执行完整 FRAM 提交、读回和其它 UART／HART 延后任务。 | 测量最坏 PendSV 占用和堆积；把持久化拆成可中断状态机，确认板间通信、HART 和编码器不互相饿死。 |
| C-26 | P2 | 部分关闭，产生链仍缺 | 12-13 在正式工作簿中已标“保留”，源码仍保留 LIN 映射，但错误判定只检查 parity／OCF／COF，LIN-only 帧走正常路径。现有故障码检查器机械期待“使用中”属于假失败，不能作为产生链证据。 | 产品决定删除休眠映射，或实现 LIN 判据和 owner；检查器需能表达“保留定义／显示映射但无产生入口”。 |
| C-27 | P3 | 治理边界正确，验证基线漂移 | `tools/` 和流程导航保持本机不跟踪是治理决定；但 3 个契约脚本仍锁协议 28，流程导航测试仍锁旧固件版本，完整回归不是绿灯。 | 更新本机工具基线并保留版本身份；30 项直接契约和 440 项 unittest 全绿后再关闭工具基线漂移。 |
| C-35 | P1 | 部分整改，错误传播仍缺 | FRAM 核心 API 已增加范围、5 ms 超时、状态和锁；旧 void 包装仍丢弃失败，电机持久化可在写失败后推进“已保存”标记，安全传感器身份链仍绕过统一 FRAM 锁，TMC 仍有 `HAL_MAX_DELAY`。 | 所有调用者消费分阶段状态；统一 SPI4／FRAM owner，并覆盖 BUSY、超时、掉线、读回失败和并发。 |
| C-39 | — | 已关闭，转 F-22 | 协议 28 已明确四路继电器阻尼为预留字段：CPU2 只接受 0，CPU3 输入范围固定 `0..0`，不再存在“可任意写入但业务不消费”的开放语义。 | 维持协议、CPU2 校验、CPU3 元数据和契约检查一致。 |
| C-41 | P0 | 仍存在 | 当前异步编码器故障发布本身不等于立即停机；忽略全局错误的长循环仍要等业务函数返回，不能由 PendSV 改造代替统一故障中断。 | 长循环统一检查“命令切换或全局阻塞故障”，并做运动、密度、水位和断链故障注入。 |
| C-46 | P2 | 新增确认，工具治理 | 协议事实清单解析器仍绑定旧命令集合、旧 ACK／分发函数形状，并不能解析继电器嵌套地址宏；当前生成结果含 54 个 `unresolvedCalls` 和 `address=None`，协议审计退化为不可用。 | 适配当前 3 个维护命令、ACK／分发链和嵌套宏；inventory `diagnostics.status=ok`、地址全为整数、`unresolvedCalls=0`，inventory／catalog／closure 测试全过。 |
| C-47 | P1 | 新增确认，当前工作树 | 24 V 掉电监测启动失败被入口丢弃；紧急编码器保存成功后会在低压仍 active 时释放 FRAM 预留，普通持久化和命令可在持续欠压期间重新进入。 | 低压恢复稳定前保持全局门禁／预留，定义命令和持久化安全态；启动失败必须发布健康状态；用电源波形、保持时间和随机相位掉电验证。 |
| R-03 | — | 继续受控，未关闭 | USART1 生产调试入口仍编译存在；当前解析更严格，但超大移动量仍可能被无符号范围接受后交给 `atoi` 下游。 | 核对物理可达性和维护授权；增加 Release 符号／命令门禁及有符号转换边界测试。 |
| B-01 | — | 代码整改中，硬件未证 | 当前工作树新增 ADC1 DMA／模拟看门狗和 24 V 查询，但阈值、分压、保持时间、启动失败和持续低压安全态尚未由板级证据冻结。 | 原理图／BOM／实测点、阈值误差、掉电保持、启动失败和持续棕断故障注入。 |
| B-09 | — | 协议 29 双端构建已证，其余仍缺 | 本轮已对当前工作树重新执行 CPU2 95 目标、CPU3 62 目标 clean-first 构建并通过；这不覆盖正式 Release 告警策略、WirelessHost 独立构建、长期可复现性或任何实机行为。 | 补 Release／WirelessHost／可复现构建和硬件证据，禁止用本轮构建关闭台架项。 |

### C-03 当前工作树的 A/B 回退链

1. `system_parameter.c:1446-1453` 分别写入并校验 A、B；`1460-1500` 只要任一槽保存本次镜像成功，就允许递增 `parameter_update_flag`。
2. 若 A 仍是旧但有效的镜像、A 本次写入失败、B 写入新镜像成功，本次保存会以“单槽降级”发布完成。
3. `system_parameter.c:1574-1593` 上电始终先接受任何有效 A，只有 A 无效才读取 B；槽中没有用于比较新旧提交的 generation。
4. 因此 CPU3 可收到本次持久化完成，设备重启后却恢复旧 A。该链是确定性的静态回归，不需要依赖随机掉电才能触发。

关闭条件至少包括：保存镜像具有可比较的提交代次；上电从 A/B 选择最新完整提交；单槽失败、写后读回失败和任意掉电切点都不能出现“ACK 成功但重启旧值”；RAM、寄存器镜像、FRAM、CPU3 ACK 和重启读回必须逐项对账。

### C-46 协议审计工具失配

- `tools/protocol_fact_inventory.py:313-320` 仍按旧的前置命令集合建模，未覆盖维护进入、维护退出和清继电器锁存 3 个现行命令。
- `tools/protocol_fact_inventory.py:551-589` 的宏求值不能稳定处理带嵌套参数的继电器地址宏，生成地址为 `None`。
- `tools/protocol_fact_inventory.py:1598-1611`、`1672-1691`、`1781-1823` 仍按旧 ACK 和 CPU2 分发函数形状取证。
- 相关 47 项协议事实测试出现 18 个 failure、1 个 error；完整 440 项工具回归共 20 个 failure、2 个 error。失败证明工具当前不能作为闭环证据，不直接证明固件运行错误。

### C-47 低压活动态门禁

低压 ISR 在 `power_monitor.c:145-162` 置 active、关闭模拟看门狗中断并预留 FRAM；PendSV 紧急提交成功后，`encoder.c:378-386` 在仍未达到恢复条件时即可释放预留。`power_monitor.c:169-198` 要等恢复阈值连续稳定后才清 active 和重新布防，但 active 期间没有统一禁止新命令、普通 FRAM 保存或继续业务。另 `main.c:122` 丢弃 `PowerMonitor_Start()` 返回值，ADC 配置、DMA 或首样本启动失败只打印后继续运行。

关闭条件是把监测健康、低压 active、紧急提交完成和系统安全态分成独立状态；低压恢复稳定前保持持久化／命令门禁；启动失败进入可见故障或受控降级；台架记录 ADC 原始值、电源波形、触发到提交延迟、保持时间和重启恢复值。

### 本轮验证

| 验证 | 结果 | 证明边界 |
| --- | --- | --- |
| 根目录 Snapshot／Check | 通过 | 当前无白名单外根目录或非法 `build/` 一级子项 |
| CPU2 `cmake --build build/LTD_MAIN_CPU2 --clean-first` | 通过，95 个目标 | 当前工作树可编译链接，不证明 FRAM、ADC、电机或传感器硬件行为 |
| CPU3 `cmake --build build/LTD_DISPLAY_CPU3 --clean-first` | 通过，62 个目标 | 当前 V1.34／协议 29 可编译链接，不证明 RS485、OLED 或外部 PLC |
| 文档结构／链接／总检 | 通过 | 617 个文档文件、315 份 Markdown，缺失链接 0 |
| 30 项直接契约检查 | 25 通过、5 失败 | 5 项均定位为协议版本、12-13 分类或旧函数文本形状漂移；固件相关语义另按源码链复核 |
| 440 项工具 unittest | 20 failure、2 error | 主要为协议事实解析器和旧版本断言，已登记 C-46／C-27；当前验证体系不是全绿 |
| 实机／台架 | 未执行 | 不证明 RS485、FRAM 掉电、低压保持、电机停止、PLC、OLED 或真实故障恢复 |

</div>

<div id="review-2026-07-23" class="section">

## 2026-07-23 基线复核（历史）

本节历史证据基线：`MAIN@db0b1322`，CPU2 `V1.31.0.0`，CPU3 `V1.31.0.0`，共享协议 `27`。C-01～C-45 的基础全量复核形成于 `46f5d634`；当时继续核对 `db0b1322` 新增的 CPU3 维护入口／退出、清锁存、维护与 AO 徽标、继电器运行态显示和 LH 状态白名单投影。该增量改善了 C-12、C-19、C-25 和 B-10 的消费端表达，但没有满足当时任何主问题的关闭条件。可达历史对象映射见 2026-07-28 增量，现行复核状态以 2026-09-07 增量为准。

状态口径：

- “代码已整改，待验证”仍保留原 C 编号和原风险等级，完成畸形帧、故障注入或实机台架后才能关闭。
- “部分整改”表示原问题的一部分已经消除，但剩余路径仍可达。
- C-21 已由产品确认属于有意行为，移入 F-18，不再进入整改统计。
- C-42 下设 8 个独立运动风险子项；统计时按 1 个主项计数，但整改和验收必须逐子项关闭。

| 统计项 | 数量 | 口径 |
| --- | ---: | --- |
| 尚未关闭主问题 | 44 | C-01～C-45 中除 C-21 外；包含 C-01、C-02 两项“代码已改、待验证” |
| CPU2 主责 | 29 | C-40 按正常硬件数据源主责归 CPU2，CPU3 协同 |
| CPU3 主责 | 15 | 含 C-43、C-45 |
| P0 / P1 / P2 / P3 | 10 / 24 / 9 / 1 | 只统计尚未关闭主问题 |
| 受控偏差／待产品决定 | 5 | R-01～R-05 |
| 台架、硬件和证据缺口 | 10 | B-01～B-10 |
| 已关闭／明确不整改 | 21 | F-01～F-21 |

### 当前问题矩阵

| 编号 | 等级 | 当前状态 | 2026-07-23 复核结论 | 下一步／关闭条件 |
| --- | --- | --- | --- | --- |
| C-01 | P0 | 代码已整改，待验证 | FC03／FC04 已增加 `1～125` 数量和响应容量门禁，原越界组包路径已被代码封堵。 | 覆盖数量 0、1、125、126，以及原 N=498／499／1001 边界；畸形帧不得组包、越界或污染后续事务。 |
| C-02 | P0 | 代码已整改，待验证 | 共享 FC10 已收口为偶数起始、偶数数量 `2～122`，并校验 byte count 和实际帧长。 | 覆盖短帧、长帧、奇地址、奇数量、0／1／122／123／253；失败必须不改 RAM、硬件或 FRAM。 |
| C-03 | P1 | 部分整改，残余仍在 | FC10 尚未形成通用的候选校验、硬件应用、RAM／FRAM 提交和 ACK 原子事务；写后校验失败不回滚运行态，LH 阈值／标定／阻尼及 `waterLevelCorrection` 仍缺 CPU2 权威语义校验。 | 建立“候选—统一校验—提交—持久化—ACK”事务；故障注入验证 RAM、寄存器镜像、硬件副作用、FRAM 和重启值属于同一次提交。 |
| C-04 | P0 | 仍存在 | 电机故障仍可能被后续健康同步覆盖，目标未到位路径仍可能返回成功。 | 锁存首个高优先级运动故障，完成状态只能在停止、到位和驱动健康均成立时发布。 |
| C-05 | P0 | 仍存在 | 取消流程仍存在先清故障、慢停失败后发布待机的状态失真。 | 先停机并确认停止，再决定清错和发布待机；覆盖停机超时、驱动异常和重复取消。 |
| C-06 | P1 | 部分整改，残余仍在 | 非法命令、重复启动、全局清错和活动故障下的命令准入仍未统一；长循环的全局故障及时退出另见 C-41。 | 建立统一命令准入和清错权限表，活动故障、忙态、重复命令和非法值均有确定返回。 |
| C-07 | P1 | 部分整改，残余仍在 | 协议29已取消无实际生成链的12-11；AS5145好帧仍可能越权清运动故障，12-13的LIN生成链仍未闭环，编码器Ready仍缺连续稳定窗口，孤立好帧可过早恢复可用。 | 按故障owner清错；明确LIN判据；要求连续N帧满足parity、OCF、COF条件后才Ready，并验证单帧好坏交替和持续故障。 |
| C-08 | P1 | 部分整改，CPU2 残余仍在 | CPU3 已改为前台健康代际推进后才由 TIM4 喂狗；CPU2 目前只用 `RETTOBASE` 避免 TIM4 抢占其它 ISR 时喂狗，仍没有主循环／关键业务健康票据，阻塞式前台失活仍可能被持续续命。 | 为 CPU2 建立主循环／关键任务健康投票；双端执行前台卡死、ISR 活跃、通信活锁和外设阻塞故障注入。 |
| C-09 | P0 | 仍存在 | 每次测量启动仍可能刷新扭力接收时间，制造“刚收到帧”的伪新鲜状态。 | 只有真实校验通过的扭力帧可更新新鲜度；覆盖启动前已超时、启动后无帧和畸形帧。 |
| C-10 | P0 | 仍存在 | 合法 128～200 点仍可能使 `int8_t` 索引回绕并形成负索引写栈。 | 改用可覆盖点数上限的无符号类型，并覆盖 127、128、199、200 和上限外输入。 |
| C-11 | P0 | 仍存在 | 探底失败、偏差超限和取消路径仍可能伪装为完成态或发布回退结果。 | 统一成功、失败、取消、降级四类终态；只有完整成功路径可发布完成代次和有效结果。 |
| C-12 | P1 | 部分整改，残余仍在 | 原维护模式前台忙等已改为非阻塞叠加态；CPU3 V1.31 在完整快照无效时禁发维护命令，并把结果页改为“指令已发送”。但进入／退出维护和清锁存仍占用正式命令槽，可隐式抢占测量。 | 产品明确“不抢占、忙时拒绝或显式取消后执行”；若不抢占，应把瞬时控制事件与测量命令槽分离。 |
| C-13 | P1 | 仍存在 | 水位跟随恢复阈值仍存在“定义 20 次、实际按 5 次”不一致，步进后水位未可靠刷新。 | 统一计数语义；每次步进后重新采样并更新水位，覆盖阈值两侧和状态抖动。 |
| C-14 | P1 | 部分整改，残余仍在 | UART／HART 已部分移出硬件 IRQ，但 HART 仍在 PendSV 异常上下文；AS5145／SPI5 回调仍有同步处理和日志风险。 | 中断只记录事件和最小快照，协议解析、日志、重试和 SPI 重操作移至有界后台状态机，并测量最坏中断延迟。 |
| C-15 | P1 | 仍存在 | CPU3 单次 CPU2 请求仍可同步等待约 1000 ms；LH FC10 外层 1.5 s 轮询又嵌套逐笔内部等待，不能形成真实硬截止时间。 | 改为跨主循环推进的异步事务，使用覆盖全部内部请求的绝对 deadline，并做断链／慢响应／并发 COM 压测。 |
| C-16 | P1 | 仍存在 | CPU3 本机参数仍是单槽覆盖写，掉电可能同时破坏最后有效值。 | 实现 A/B 槽、generation、完整 CRC 和写后校验；执行逐字节掉电／复位矩阵。 |
| C-17 | P1 | 部分整改，残余仍在 | `490820b`已增强UART接管和失败重初始化；协议29进一步把远程0x46收口为“保留物理串口参数、旧参数发完ACK后逐口应用、FRAM失败回滚并恢复RX DMA”。单帧pending覆盖以及普通重配等待三口全空、无总截止仍在。 | 建立队列或背压，给普通重配事务统一deadline；台架覆盖三口并发、持续流量、取消、FRAM失败和切换失败。 |
| C-18 | P1 | 仍存在 | SI 自动 Profile 仍缺 Manual／维护态门禁，`manual_alarm_inhibit` 也未完整投影到 SI 对外状态。 | 调度器和命令入口同时门禁，并定义 Manual／维护时的报警、忙态和完成状态。 |
| C-19 | P1 | 部分表达改善，闭环仍缺 | CPU3 维护页已不再把写 ACK 显示成“已进入／已退出”，但外部动作命令仍以寄存器写 ACK 代替业务接受／完成闭环，没有 request ID、完成 ID 或 boot epoch。 | 增加可关联的请求、接受、执行、完成／失败代次，重启和重复请求不得误配旧结果。 |
| C-20 | P0 | 仍存在 | Wärtsilä 超 100 点仍会截断；旧结果失效、完成／失败关联、液位识别条件、超时按空气、整区本地写成功回显等语义仍未闭环。任意地址转发已修，但不能据此关闭本项。 | 明确最大点数和字段有效性；启动时失效旧结果；失败不得发布完成；覆盖 100／101／200 点、传感器超时、液面未识别和写范围边界。 |
| C-21 | — | 产品行为，不整改 | `<30.0 pF → 99999.9 pF` 已明确为产品特殊处理，不得作为缺陷删除，也不得顺带清理 `zero_cap`。 | 移至 F-18；只需把契约、适用版本和回归用例写清。 |
| C-22 | P1 | 仍存在 | DSM 版本、定长帧、ACK、BCC 和模式业务成功判定仍未形成统一事务契约。 | 按命令定义精确长度、帧形和 ACK；业务解析失败允许有界重试，并覆盖全部维护线版本和 golden frame。 |
| C-23 | P2 | 部分整改，残余仍在 | DSM drain 仍缺总截止和取消；CK 的 `E/e`、V5.4 冷唤醒诊断仍混杂；CH9141K 仍用单字节轮询，UART6 的 DSM／LTD／V2／AT 无统一 owner。 | 建立 UART6 owner、缓冲接收和统一 abort／drain／deadline；区分传输失败、业务失败和诊断噪声。 |
| C-24 | P1 | 仍存在 | DSM 外部 Modbus 地址 0 仍会执行并以本机地址回包。 | 明确广播契约；若不支持广播则静默丢弃，若支持写广播则绝不回包。 |
| C-25 | P1 | 仍存在 | CPU3 V1.31 已在继电器快照无效时显示 `N/A`，并把 LH 未定义内部状态投影为待机；这些只是消费端保护。跨 CPU 的位置 0、水位 0、温度哨兵、HART 0、Wärtsilä固定状态和 VCF 双哨兵仍无统一 valid／quality／age 契约。 | 为字段定义有效位、质量、来源和新鲜度，禁止以正常数值兼作多种无效原因。 |
| C-26 | P2 | 部分关闭，待台架 | 协议29已删除12-11、统一13-2为“震动管频率异常”、把13-26上限调整为3000.0 kg/m³并交换18/21类别；双端源码、当前清单、协议记录和两份工作簿已同步。12-13实际产生链和3000边界仍缺台架证据。 | 明确12-13的LIN判据和清错所有权；台架验证2999.99／3000.00／3000.01、双端显示及恢复动作，并持续用自动对账门禁防止漂移。 |
| C-27 | P3 | 部分整改，残余仍在 | `outputs` 仍有历史跟踪资产；`tools/` 和流程导航不跟踪是治理决定，不应再当缺陷。 | 明确历史资产的保留／迁移身份和本机恢复来源，禁止用 `git add -f` 绕过治理边界。 |
| C-28 | P2 | 部分整改，残余仍在 | 国标密度筛点阈值 100 仍是 TODO；SI 空气阈值 100 属当前需求或待确认值，不能直接判定代码错误。 | 产品确认各协议阈值、单位和边界，再建立参数化契约和阈值两侧测试。 |
| C-29 | P1 | 部分整改，残余仍在 | 已补部分帧形／长度门禁，但接收长度尚未完整贯穿 HART 解析契约，未知命令仍会生成非标准响应，8 位长度风险仍在。 | 解析 API 强制携带实际长度，未知命令按协议拒绝或静默；覆盖截断、超长和边界长度。 |
| C-30 | P1 | 仍存在 | UART4 扭力帧仍主要按长度读取固定字节，缺帧头、来源和校验门禁。 | 建立完整帧契约，并与 C-09 的真实新鲜度更新联改。 |
| C-31 | P1 | 代码已整改，待台架 | CPU2 V1.32已把LTD／V2第7字节`0xFF`映射为`SENSOR_REMOTE_INTERNAL_ERROR`并进入原有有限重试，失败帧不再解析数据或完成模式切换；静态契约与构建已通过。 | 用真实设备或故障注入覆盖模式切换、浮点读和整数读的`0xFF`，确认三次重试、最终13-38、旧值保持和状态不伪成功。 |
| C-32 | P1 | 仍存在 | 分布密度单点等待 5 分钟仍未稳定时，结果仍可能被计为有效测点。 | 超时必须返回无效或整点失败，定义是否重试／降级，并发布点级质量。 |
| C-33 | P1 | 仍存在 | 部分密度流程仍忽略传感器模式切换失败。 | 所有模式切换必须检查返回并在失败时停止、恢复原模式和发布失败。 |
| C-34 | P2 | 仍存在 | CPU2 板间 Modbus 地址 0 仍会执行并以本机地址回包。 | 与 C-24 一致收口广播语义，补 CPU2↔CPU3 地址 0 用例。 |
| C-35 | P1 | 仍存在 | CPU2 FRAM／SPI／TMC 仍存在 `HAL_MAX_DELAY` 或 void API，无法向上层报告具体阶段失败。 | 使用有限 deadline 和分阶段错误返回；覆盖 BUSY、超时、CRC／回读失败和总线卡死。 |
| C-36 | P1 | 仍存在 | CPU3 FRAM 同样可能无限阻塞，事务保存拿不到底层阶段结果。 | 与 C-16 联动改造有限超时、错误传播和 A/B 提交流程。 |
| C-37 | P2 | 仍存在 | CPU3 密码结果页仍以固定 `HAL_Delay(100/500)` 阻塞主循环。 | 改为 tick 驱动的结果页状态，期间通信、OLED 和后台任务继续推进。 |
| C-38 | P2 | 仍存在 | 健康 OLED 在满 60 秒后的下一次绘制仍会走硬复位和清屏。 | 区分无响应恢复与正常周期绘制，禁止健康路径周期性复位 OLED。 |
| C-39 | P2 | 新增确认 | K1～K3 阻尼系数可写、可读、可持久化，但继电器判断完全不消费。 | 产品二选一：定义并实现阻尼算法，或将字段改成明确保留／只读并拒绝写入。 |
| C-40 | P2 | 新增确认 | LH 幅值寄存器读取 `current_amplitude`，正常硬件测量路径没有生产该值，可能输出初值或旧值。 | 接入真实硬件数据源并定义单位、刷新和无效语义；若硬件不提供，协议明确“不支持”。 |
| C-41 | P0 | 新增确认 | CPU2 多个长循环和 `AbortableDelay` 只响应命令切换，不响应已经产生的全局阻塞故障；自动恢复只能等待业务函数返回。 | 建立统一“命令切换或全局故障”中断接口，覆盖密度监测、液位闭环、运动等待和 Wärtsilä 后置等待。 |
| C-42 | P0 | 新增确认，含 8 个子项 | 电机保护未形成覆盖所有入口的统一机械硬边界、业务软边界和场景例外边界。 | 按 C-42A～C-42H 独立整改和验收，不能只用已有目标运动限位整体关闭。 |
| C-43 | P1 | 新增确认 | CPU3 数据源／手输值和小数位参数仍未完整驱动状态页；FRAM 显示类参数缺统一启动合法化。 | 逐字段证明菜单入口、范围、持久化、运行态消费和显示输出；非法 FRAM 值必须安全回退。 |
| C-44 | P1 | 新增确认 | `Sensor_CheckAllPartParams()` 和“读取部分参数”路径仍可能复用宽松读取或旧 `debug_data`，把非新鲜／不完整响应当作健康快照。 | 每次请求清除旧快照，严格校验版本、长度、字段、状态和新鲜代次；自动恢复只能消费严格快照。 |
| C-45 | P2 | 新增确认 | CPU3 长标题数值输入页仍可能把第 4 行标题与软键／数值区域重叠。 | 明确标题最大行数和保留区域，中文／英文、最长标题和最大数值均做渲染检查。 |

### C-42 运动安全包络子项

| 子项 | 等级 | 独立风险 | 关闭条件 |
| --- | --- | --- | --- |
| C-42A | P0 | `MoveNoWait`、速度模式及强制运动缺运行中绝对机械限位。 | 公共运动层对所有方向持续检查不可关闭的绝对边界，并能快速停止。 |
| C-42B | P0 | 水位粗找／精找缺下行边界、重量碰撞和总超时。 | 三类保护同时存在，并覆盖水状态始终不翻转和重量异常。 |
| C-42C | P0 | 强制上／下行缺维护授权、单次距离限制和不可绕过硬限位。 | 普通入口不可执行；维护入口也必须受绝对边界和审计日志约束。 |
| C-42D | P1 | 油位负位置会被钳为 0，未形成明确下限错误。 | 负位置立即停机并发布位置／低限故障，保留原始值用于诊断。 |
| C-42E | P1 | `SearchAir()` 缺顶部限位和总超时。 | 到达顶部软边界或超时时停止并返回明确失败。 |
| C-42F | P1 | 找零粗找／精找缺不可关闭上限和总超时。 | 零点条件失效时仍能在绝对上限或 deadline 前停止。 |
| C-42G | P1 | 普通手动和直接目标运动未统一执行业务盲区边界。 | 普通业务统一限制在允许区域，特殊越界只能通过明确维护模式。 |
| C-42H | P2 | `tankHeight`、`blindZone`、`maxDownDistance`、找零距离和手动距离缺关联合例校验。 | 加载、保存和每次运动启动均验证组合关系及单位。 |

### 受控偏差与产品决定

| 编号 | 当前结论 | 维持条件／下一步 |
| --- | --- | --- |
| R-01 | Modbus RTU 仍以 UART IDLE 约 1T 判帧，未严格实现 t1.5／t3.5；已有暂缓决定。 | 保留帧内停顿、ORE／FE／NE、满缓冲和真实波形测试，未完成前不得宣称严格合规。 |
| R-02 | `g_handlers` 以枚举作数组下标，但已有运行期边界和空处理器检查。 | 新增处理器时保持编译期数量检查和未知枚举用例，不夸大为现行越界。 |
| R-03 | 生产固件保留 USART1 高风险调试入口，是否升级为缺陷取决于物理可达性和维护授权。 | 核对 PA9／PA10、封签／跳线和现场流程；物理可接触则升级整改。 |
| R-04 | `tools/` 与流程导航不纳入 Git 是治理决定。 | 本机同步源、恢复步骤和运行记录必须可审计，禁止 `git add -f`。 |
| R-05 | Wärtsilä 最高测点未越过液面时，是否应判整次失败仍属产品语义决定。 | 明确成功所需的液面穿越条件、最高点容差及降级规则，再决定并入 C-20 的实现方式。 |

### 台架、硬件和证据缺口更新

B-01～B-04、B-06、B-08 保留后文既有内容；B-05、B-07、B-09 按下表更新，并新增 B-10。

| 编号 | 更新后的缺口 | 必须补充的证据 |
| --- | --- | --- |
| B-05 | 电机结构改动已有小范围台架记录，但主要只覆盖约 `1.0 m/min`、20～50 mm；不能覆盖 C-42 的全速度、长距离和边界安全。 | 多速度、长距离、上下极限、强制入口、传感状态卡死、TMC／24 V／编码器故障注入。 |
| B-07 | `490820b` 已修复外部 RS485 确定性活锁主因，但 A/B 短接恢复、三路 COM 压力、CPU2 拔线重连、LH／SI／Wärtsilä PLC 和液位识别物理条件仍缺实机证据。 | 真实 PLC、A/B 短接、持续噪声、10 Hz 并发、100／200 点、慢响应和液面／油品／速度组合测试。 |
| B-09 | 当前协议 27 提交已通过双端 clean-first 构建和版本／流程门禁；原“当前双端未构建”表述已过期。 | 仍需核对正式 Release 告警策略、WirelessHost 独立构建和长期可复现性；不得用构建替代硬件验证。 |
| B-10 | K1～K4 NC／NO 输入存在，但业务未读取；CPU3 V1.31 已明确显示“最终逻辑动作”，快照无效时显示 `N/A`，仍不代表物理触点反馈。 | 确认有效电平、装配、断线语义和消抖；注入拒动、粘连、NC／NO 矛盾及线圈失效。 |

### 已关闭／不整改项更新

原 F-01～F-17 保留，新增：

| 编号 | 项目 | 关闭／不整改依据 |
| --- | --- | --- |
| F-18 | C-21 低于 30 pF 映射巨大哨兵值 | 已明确为产品特殊处理；不得删除，也不得清理 `zero_cap`。 |
| F-19 | 历史保持寄存器末尾 off-by-one | 当前地址范围检查已封堵末尾越界；后续边界台架由 C-01 承接。 |
| F-20 | 命令切换后把部分密度点误作完整剖面 | 当前路径已阻止该历史发布方式；Wärtsilä旧结果和字段有效性残余由 C-20 承接。 |
| F-21 | CPU3 外部 RS485 连续流量确定性中断活锁 | `490820b` 已完成代码整改；A/B 短接和压力实机证据转入 B-07。 |
| F-22 | C-39 四路继电器阻尼字段可写但不消费 | 协议 28 已将该字段明确为预留，CPU2 只接受 0、CPU3 范围固定 `0..0`；维持契约即可，不再实现阻尼算法。 |

### 来源文档对账

| 来源资料 | 纳入总账的结论 | 整理后位置／处置 |
| --- | --- | --- |
| 2026-06-30 首轮审查 | 历史 34 项逐项映射至 C、R、B、F；不再单独作为当前状态入口。 | 本文后部保留历史快照。 |
| 2026-07-16 全工程梳理 | 既有 C-01～C-38 的详细分析基础，并吸收 DSM、协议 27／LH 增量。 | 保留专题正文，现行状态以本文为准。 |
| CPU2 系统通信／编码器专题 | AS5145 稳定窗口并入 C-07，中断重处理并入 C-14，CH9141K／UART6 owner 并入 C-23。 | 保留问题专题。 |
| CPU2 全局错误响应专题 | 命令准入并入 C-06；长循环无法及时响应全局故障形成 C-41。 | 保留问题专题。 |
| 传感器运动上下限位专题 | 八类独立风险合并为 C-42A～C-42H；小范围台架边界并入 B-05。 | 保留问题专题。 |
| Wärtsilä 分布测量流程 | 旧结果、超时按空气、完成语义与写范围并入 C-20；物理液面条件并入 B-07；最高点判据列 R-05。 | [归档到流程导航](../../00_程序流程导航/2026-06-11_Wartsila分布测量专题流程.html)。 |
| 电机优化计划、改动汇总与台架资料 | 代码已实现内容与安全缺口分离；C-42 负责代码整改，B-05 负责未完成台架证据。 | 分别归档到需求计划和测试记录目录。 |
| AD5421 两个专题 | 回读 FFFF 的硬件链保留 B-03；断环恢复代码已实现但真实循环验证保留 B-04。 | 保留问题专题。 |
| Modbus RTU 时序专题 | 继续作为 R-01 受控偏差，不能写成严格 t1.5／t3.5 合规。 | 保留问题专题。 |
| 参数与协议无效值专题 | 纳入 C-03、C-20、C-25、C-26；低电容项排除并转 F-18。 | 保留问题专题。 |
| 故障码逐项核查 | 可达性与工作簿一致性纳入 C-07、C-26。 | 保留 Markdown；删除同名 PDF。 |
| DSM 协议适配复查 | 低电容转 F-18；定长事务、恢复／owner 与地址 0 分别纳入 C-22、C-23、C-24。上游 CPU1 空指针 HardFault 与陈旧值风险作为 C-22／C-25／B-06 的开放外部依赖保留，不能写成已关闭。 | 保留 Markdown；删除同名 PDF。 |
| CPU3 外部 RS485 整改专题 | 确定性活锁代码关闭为 F-21；架构残余指向 C-08、C-14、C-17、R-01，完整实机证据并入 B-07。 | 保留 Markdown；删除同名 PDF。 |
| 协议 27／LH 增量 | FRAM 回滚、维护抢占、同步等待、参数质量分别并入 C-03、C-12、C-15、C-25；新增 C-39、C-40 与 B-10。`db0b1322` 已完成 LH 状态白名单投影，但不等于字段质量闭环。 | 已纳入本文稳定编号。 |
| 十个历史孤立项 | 末尾 off-by-one 与部分剖面发布转 F-19／F-20；其余并入 C-03、C-20、C-43、C-44、C-45。 | 不再保留游离编号。 |

统一去重映射：协议 27／LH 的 FRAM 失败不回滚→C-03，维护控制抢占→C-12，LH 同步等待→C-15，参数质量→C-03／C-25，阻尼→C-39，幅值→C-40，物理继电器反馈→B-10；AS5145 稳定窗→C-07，AS5145 ISR→C-14，CH9141K／UART6 owner→C-23；Wärtsilä 软件语义→C-20，物理液面条件→B-07，最高点成功判据→R-05。

</div>

<div class="historical-banner">

**以下“详细问题条目”来自此前统一总账基线，用于保留根因、路径和整改方案。**其中出现的“当前”均指该条目原复核时点；现行状态优先采用 2026-09-07 增量，再按 2026-08-10、2026-07-28 和 2026-07-23 各层追溯。未在新增量复核的条目属于历史待核对状态，不代表本轮已重新证实；历史路径和行号也不作为当前源码位置。

</div>

<div id="current-ledger" class="section">

## 既有详细问题条目总览（追溯）

本节保留 2026-07-21 前后形成的 38 个详细条目、4 个受控偏差、9 个证据缺口和 17 个关闭项，便于追溯原始执行链与整改建议。其统计和状态已经由上方 2026-07-23 矩阵取代。

<div class="ledger-grid">

<div class="ledger-stat">

**25**CPU2 主责问题

</div>

<div class="ledger-stat">

**13**CPU3 主责问题

</div>

<div class="ledger-stat">

**4 + 9**受控偏差与证据缺口

</div>

<div class="ledger-stat">

**17**已关闭／不单独纳入

</div>

</div>

<div class="focus-grid">

<div class="focus-card">

**P0 · 8 项**内存破坏、运动安全状态失真、伪新鲜数据和分布结果截断，必须优先封堵。

</div>

<div class="focus-card">

**P1 · 23 项**事务一致性、错误传播、数据可信度、维护隔离和阻塞恢复。

</div>

<div class="focus-card">

**P2 · 6 项**可靠性、可诊断性、交互停顿和协议治理。

</div>

<div class="focus-card">

**P3 · 1 项**工程资产与检查可复现性。

</div>

</div>

|  |  |
|----|----|
| 仍存在 | 当前源码或当前 Git／配置状态可以直接证明，允许进入整改排期；不等于已经在实机复现。 |
| 受控偏差 | 当前实现与通用规范或理想架构存在差异，但已有产品决定、兼容原因或条件门槛，不能直接按缺陷修改。 |
| 证据缺口 | 静态源码不能给出最终结论，必须补原理图、物料、波形、PLC golden frame、掉电或故障注入证据。 |
| 已关闭 | 问题已被现行实现关闭，或原结论已被当前源码反证；只保留关闭依据，不进入整改优先级。 |

<div class="note">

**归属规则：**跨 CPU 问题按主要代码改动和验收责任端放置，并标明协同端；优先级只对仍存在的问题生效。整改时以统一编号为入口，再回到当前源码和来源专题确认细节。

</div>

</div>

<div id="current-cpu2" class="section owner-issues">

## CPU2 问题清单

主责范围：CPU2 Modbus、测量／运动、传感器、DSM 文本协议、故障码与本机中断边界。C-08 为双端同类问题，CPU2 主责条目要求 CPU3 同步整改。

| 优先级 | 数量 | 统一问题编号 |
|---|---|---|
| P0 | 7 | C-01、C-02、C-04、C-05、C-09～C-11 |
| P1 | 15 | C-03、C-06～C-08、C-12～C-14、C-21、C-22、C-29～C-33、C-35 |
| P2 | 3 | C-23、C-28、C-34 |
| P3 | 0 | 无 |

<div class="issue-head">

### C-01 FC03／FC04 未限制 1～125，零数量与超响应缓冲请求仍可进入组包

<span class="badge p0">P0 · 仍存在</span>

</div>

<div class="evidence">

**原因与证据：**`INPUTREGISTER_AMOUNT=0x0A48`，但 `HCOM_SendBuff` 只有 1000 B；FC04 请求 N=498 时 CRC 高字节首次写到索引 1000，N≥499 时响应 payload 已越界，N≥1001 时还会越写 `SlaveTempBuffer[1000]`。FC03 当前表长 346，不会写越 1000 B 发送缓冲，但 N≥128 时 1 B byte count 截断。FC03／FC04 均未拒绝数量 0。位置：`LTD_MAIN_CPU2/Services/Modbus/hostcommu.c:192-327`、`hostcommu_modbus.c:31-34,126-167,218-258`。

</div>

**影响：**异常大范围 FC04 可写坏响应缓冲、相邻内存或临时数组；超量 FC03 会形成错误 byte count；数量 0 会形成 `start-1` 的有符号负边界，并可能返回空成功帧。

**整改方案：**落实共享协议 25 已规定的 `1～125` 门禁，并按目标表长、PDU 上限和实际发送缓冲做三重校验；组包函数必须接收容量并可失败返回。

**验证边界：**FC03 覆盖 0、1、125、126、127、128、346、347；FC04 覆盖 497、498、499、1000、1001、2632，并补末地址和超范围主机帧。本次仅静态确认，未执行串口压力测试。

完整分析：越界路径、三重容量门禁与负向契约

<div class="analysis-body">

<div class="analysis-grid">

<div class="analysis-panel">

**当前结论**仍存在，维持 P0。这是站号和 CRC 正确、但数量异常的 UART5 请求可直接触发的静态数组越界路径，不只是 Modbus 标准偏差；当前 CPU3 正常轮询不会发送这种请求。

</div>

<div class="analysis-panel">

**关键边界**FC04 输入表有 2632 项，发送缓冲仅 1000 B；完整响应长度为 `2×N+5`。N=498 首次越写 CRC 高字节，N≥499 payload 越界，N≥1001 临时数组也越界；FC03 表长 346，仅存在超标准和 byte count 截断。

</div>

</div>

#### 当前执行链

1.  UART5 收到地址和 CRC 正确的 FC03／FC04 请求，`HostCommuProcess()` 只校验总长度、站号和 CRC；当前 CPU3 正常轮询最大组为 114 个寄存器，点阵块为 96，不会主动触发超 125 请求。
2.  `JudgeStartAddress()` 只拿起始地址和数量与整张表比较，没有要求数量大于 0，也没有限制标准上限 125。
3.  `Compose03Package()`／`Compose04Package()` 把 `count×2` 窄化写入 1 B byte count，并按请求数量连续写临时数组和发送缓冲。
4.  外层继续在当前发送长度后写两字节 CRC：N=498 时 payload 止于索引 998、CRC 低字节位于 999，CRC 高字节首次写到索引 1000；N≥499 时 payload 本身开始越界，随后 CRC 计算／写入和 DMA 长度仍继续扩大；N≥1001 时 `SlaveTempBuffer` 也越界。
5.  数量为 0 时变量仍是有符号 `int`，`start+count-1` 形成 `start-1` 的负边界值，不是整数下溢或未定义行为；`start=table_count,count=0` 还可能被接受并返回空成功帧。

#### 根因

地址跨度、Modbus PDU 约束和真实缓冲容量被混在一个只看整表范围的判断中；组包器没有接收目标容量，也没有失败返回语义；byte count 窄化前没有范围证明。

#### 整改方案

1.  请求分派前统一要求 `1<=count<=125`，并用 `start<table_count && count<=table_count-start` 避免加法溢出。
2.  编译期和运行期同时证明 `2×count+5<=sizeof(send_buffer)`；组包函数必须接收容量并能在不足时返回失败，禁止部分组包。
3.  非法数量返回 Modbus 异常 `0x03`，非法地址跨度返回 `0x02`；长度不足以安全解析时静默丢弃。
4.  完整方案建立按功能码的请求形状表和容量安全响应构建器，解析结果使用局部不可变对象，并与 C-14 一起把组包移出 ISR。

#### 协议与回归

这只是落实共享协议 25 已有的 `1～125` 契约，不新增共享故障码，也无需提升 `DEVICE_PROTOCOL_VERSION`。当前 CPU3 最大轮询组 114、点阵块 96，合法板间轮询无需拆分；实际修复落地仍应提升 CPU2 固件版本，并纳入对应版本改动与测试方案。

<div class="table-scroll">

| 测试组 | 输入 | 预期 |
|----|----|----|
| 数量边界 | FC03：0、1、125、126、127、128、346、347；FC04：497、498、499、1000、1001、2632 | 仅 1～125 进入正常组包，其余返回 `0x03`；byte count 不截断，发送区和临时数组哨兵均不变化。 |
| 地址边界 | 表首、表尾、表尾＋1、跨表跨度 | 零数量和非法跨度均被拒绝，不发生越界访问，异常码准确。 |
| 容量保护 | 缓冲前后放置哨兵 | 任何非法请求都不改变哨兵、不启动超长 DMA。 |
| 正常轮询 | CPU3 当前全部分段请求，含最大组 114 和点阵块 96 | 合法板间数据不回归。 |

</div>

**证据：**`hostcommu.c:15,40-42,192-209,250-330`、`hostcommu.h:8`、`hostcommu_modbus.c:31-34,126-167,207-258`、`stateformodbus.h:390-396`、CPU3 `cpu2_communicate.c:1320-1329,1527-1576`、正式协议卷第 3、8 节。静态分析已能确认异常 UART5 帧的写越界路径；未用真实串口畸形帧复现内存破坏或复位。

</div>

<div class="issue-head">

### C-02 CPU2 共享板间 FC10 缺少数量、对齐、byte count 与实际帧长的原子门禁

<span class="badge p0">P0 · 仍存在</span>

</div>

<div class="evidence">

**原因与证据：**`HostCommuProcess()` 只做总体长度、地址和 CRC；`Compose10Package()` 随后按声明数量直接读取数据区，没有证明 `byteCount == registerCount * 2` 和实际 PDU 足够。UART5 接收数组仅 512 B，声明 N=253 时最后读取索引 512，已构成真实越界读。位置：`hostcommu.c:192-327`、`hostcommu_modbus.c:263-374`、`Core/Inc/usart.h:64-66`。

</div>

**影响：**CRC 正确的短帧或自相矛盾帧可能读取本帧之外的 DMA 残留；较大声明数量还会读越 UART5 数组，随后污染参数候选、回显成功并触发保存。

**整改方案：**任何读取前一次性要求：起始地址和数量均为偶数、`2<=count<=122`、`byteCount==2×count`、`len==9+byteCount` 且地址跨度合法；失败时不得触碰运行态或保存请求。

**来源：**首轮审查、流程图 Modbus 接收链、[全工程问题梳理](2026-07-16_全工程问题梳理与整改优先级.md)。

完整分析：短帧陈旧数据链、原子解析门禁与毒化测试

<div class="analysis-body">

<div class="analysis-grid">

<div class="analysis-panel">

**当前结论**仍存在，维持 P0。CRC 正确只能证明收到的那段字节未损坏，不能证明 FC10 数据区满足声明长度；N=253 时还会读取 512 B UART5 数组之外。

</div>

<div class="analysis-panel">

**核心风险**`Compose10Package()` 不接收实际帧长，也不读取 `byteCount`；小数量短帧读取本次接收长度之外的 DMA 残留，大数量声明则可形成真实数组越界读并写入参数。

</div>

</div>

#### 触发与执行链

1.  可构造 CRC 正确、总长度仍小于 256 B，但数量、byte count 和实际数据长度互相矛盾的 FC10；例如声明 N=253 的短帧可通过当前 CRC、功能码和整表范围检查。
2.  `HostCommuProcess()` 接受 4～255 B，却没有按功能码检查精确长度；4／5 B 片段通过地址和 CRC 门禁后，读取 `rcvbuff[4]`／`rcvbuff[5]` 已越过本次实际接收片段，虽仍落在 512 B UART5 数组内。
3.  `JudgeStartAddress()` 只判整表跨度，允许数量 0，也没有共享字段所需的偶数起始、偶数数量和 `2～122` 数量门禁。
4.  `Compose10Package()` 按声明数量读取 `revframe[7+2*i]` 和 `revframe[8+2*i]`，不证明 `byteCount==2×count` 或 `len==9+byteCount`；末次读取索引为 `2×N+6`，N=253 时访问索引 512。
5.  读出的本帧数据或旧缓冲残留进入保持寄存器、`g_deviceParams` 和延后保存链，并可能得到成功回显。

#### 根因与影响

解析层没有把“实际接收长度、声明数量、byte count、32 位字段对齐、表跨度和目标容量”作为一个不可分割的请求契约，组包／执行函数也没有接收 length。结果是 CRC 正确的短帧可读取 DMA 旧数据，N=253 时还会读取索引 512 越过 UART5 数组，随后污染运行参数、进入持久化并向主机回显成功。

#### 整改方案

先执行不会越界的安全最小长度、地址和 CRC 检查；短到不足以读取 FC10 固定头的帧静默丢弃。对可安全解析的帧，在任何数据读取和全局写入前一次性验证：起始地址为偶数、`count` 为偶数且 `2<=count<=122`、`byteCount==2×count`、`len==9+byteCount`，并用 `start<table_count && count<=table_count-start` 校验范围。解析函数接收 `(buf,len)` 并只输出局部候选，全部验证成功后才提交。数量、对齐、byte count 或帧形状错误返回 `0x03`，地址跨度错误返回 `0x02`。

#### 状态与兼容

所有门禁失败都必须保证保持寄存器、`g_deviceParams`、硬件、保存标志和 FRAM 请求完全不变。这是在 CPU2 端实现共享协议 25 已有契约，不需要新故障码或提升协议版本；它与 Wärtsilä 已确认的现场特殊 FC10 方言必须在代码、文档和测试中保持分离。

<div class="table-scroll">

| 测试维度 | 取值 | 断言 |
|----|----|----|
| 数量／对齐 | 0、1、2、3、122、123、124；奇／偶起始地址 | 只有偶数起始地址且偶数数量 2～122 可进入数据解码，其余返回 `0x03`。 |
| byte count | 0、2N−1、2N、2N＋1、255 | 只有精确 2N 合法。 |
| 实际长度 | 不足安全固定头、期望−1、期望、期望＋1 | 过短帧静默丢弃；可安全解析但形状不一致返回 `0x03`；任何情况均不读取实际长度之外的数据。 |
| DMA 尾部与数组哨兵 | 预填 `0xA5` 后发 CRC 正确短帧，并构造 N=252／253／346 | 三者均在数量门禁返回 `0x03`，不得进入 `Compose10Package()`；不得读取末索引 510、首次越界索引 512 或更远位置。 |

</div>

**证据：**`hostcommu.c:15,192-209,238-310`、`hostcommu_modbus.c:126-147,263-399`、`Core/Inc/usart.h:64-66`、`Core/Src/stm32f4xx_it.c:459-467`、CPU3 参考门禁 `ltd_modbus_slave.h:16-17`、`ltd_modbus_slave.c:148-197,200-240`、正式协议卷 `:36-44,227-237`。越实际帧长和 N=253 的数组越界读取均可静态确认；具体残留值和后续破坏形态仍需抓帧、ASan 宿主测试或内存哨兵验证。

</div>

<div class="issue-head">

### C-03 FC10 仅严格校验 AO 子集，候选、硬件、RAM／FRAM 与 ACK 未形成事务

<span class="badge p1">P1 · 仍存在</span>

</div>

<div class="evidence">

**原因与证据：**`dataanalysis_modbus.c:302-480` 对候选参数没有覆盖所有枚举、布尔、范围和字段关系；电机电流变更后仍以 `(void)MotorCtrl_SetCurrent(...)` 丢弃下发结果。写应答发生在业务消费和 FRAM 最终写后验证之前。

</div>

**影响：**非法组合或未真正作用到硬件的值可能被主机认为成功，并进入持久化链；重启后运行态、存储值和硬件状态可能不一致。

**整改方案：**建立统一候选校验器；硬件应用、运行态更新、持久化提交按事务顺序执行，并把具体失败返回到本次请求。

**来源：**[参数与协议数据无效值梳理](2026-07-18_参数与协议数据无效值梳理及风险分析.md)；需要异常帧、边界值、硬件下发失败和掉电矩阵。

完整分析：候选参数事务、ACK 成功语义与失败回滚

<div class="analysis-body">

<div class="analysis-grid">

<div class="analysis-panel">

**当前结论**仍存在，P1 合理；如果该写入口暴露给不可信主机或可直接改变运动参数，应重新评估为 P0。

</div>

<div class="analysis-panel">

**已确认缺口**严格校验主要集中在 AO；多个枚举、布尔、罐高／盲区／上下限关系和分布参数直接解码。电机电流硬件下发结果被丢弃，FRAM 保存晚于 ACK。

</div>

</div>

#### 当前执行链

1.  FC10 数据先写入全局保持寄存器镜像。
2.  `ReadDeviceParamsFromHoldingRegisters()` 将大部分镜像直接解码到候选参数，只有少数字段被归一化，AO 子集另有严格校验。
3.  电机电流变化时调用 `MotorCtrl_SetCurrent()`，但以 `(void)` 丢弃具体失败。
4.  响应路径提交 RAM、设置延后保存标志并回成功；主循环稍后才写 FRAM A／B 和读回。
5.  FRAM 失败只会在之后置全局存储错误，本次主机早已收到成功 ACK。

#### 根因

寄存器镜像被当作权威对象而不是待验证候选；“帧被接受、硬件已应用、RAM 已提交、持久化已完成”四种成功语义未拆分；硬件和延后保存结果没有回到本次事务。

#### 整改方案

1.  从 `previous_params` 复制 candidate，只覆盖本帧涉及字段；统一执行字段值域、枚举和跨字段关系校验。
2.  提交全局前执行需要立即生效的硬件 prepare／apply，并保留具体错误；失败时恢复硬件和 RAM 镜像。
3.  明确 ACK 提交点。若保持普通 FC10“已完成”语义，则必须等 FRAM A／B 写后读回；若采用 accepted／committed 两阶段，则需正式扩展事务状态，不能继续用普通回显冒充持久化完成。
4.  完整流程按 `parse→candidate→validate→hardware apply→RAM commit→FRAM verify→ACK` 执行，回滚保留首错并追加次生诊断。

#### 错误和协议影响

参数非法返回 Modbus `0x03`，硬件或持久化失败返回 `0x04` 并保留 TMC／`PARAM_STORAGE_WRITE_VERIFY_FAILED` 等具体错误。仅修复电流返回值且不改变合法集合时可不升协议；完整收紧范围或改变 ACK 语义属于共享写事务契约变化，建议 CPU2／CPU3 同步提升 `DEVICE_PROTOCOL_VERSION`。

<div class="table-scroll">

| 用例 | 注入 | 通过标准 |
|----|----|----|
| 逐字段边界 | min−1／min／max／max＋1、未知枚举 | 非法值不改变任何运行态。 |
| 关系校验 | 罐高／盲区／上下限反向或相等 | 整组拒绝并指出责任字段。 |
| 硬件应用失败 | TMC 写／回读失败 | RAM、保持寄存器和硬件一致回滚。 |
| 持久化失败 | A 失败、B 失败、双失败、读回不一致 | ACK 符合最终定义，重启值与返回结果一致。 |

</div>

**证据：**`hostcommu_modbus.c:263-399`、`dataanalysis_modbus.c:294-485`、`motor_ctrl_driver_param.c:485-508`、`system_parameter.c:652-745,1000-1113`。完整事务的可接受时延仍需与 CPU3 请求超时一起台架确认。

</div>

<div class="issue-head">

### C-04 电机错误仍可能被后续健康同步覆盖，未到位也可能返回成功

<span class="badge p0">P0 · 仍存在</span>

</div>

<div class="evidence">

**原因与证据：**`MoveAndWait()` 检出丢步后会用健康同步返回值覆盖原错误；驱动先报告停止的出口没有再次证明当前活动位置源位于目标容差。`MotorDriver_SyncPositionOrCheckHealth()` 自身又可能用健康成功覆盖位置同步失败。另有当前无调用者的 `MotorCtrl_MoveToPosition()` 在 10 轮耗尽后可返回 `NO_ERROR`。位置：`LTD_MAIN_CPU2/Services/MotorControl/motor_ctrl_motion_api.c:438-575,661-726,1774-1782,2299-2370`、`motor_ctrl_driver_param.c:1126-1133`。

</div>

**影响：**上层可能把提前停机、失步、位置源失效或未到位发布为成功；返回值、共享错误码和 CPU3 显示还可能不一致，属于运动安全和结果可信性问题。

**整改方案：**保存首个具体错误并只允许追加诊断；停稳后必须用本次新鲜、读取成功的当前活动位置源（电机或编码器）做最终到位验收。循环耗尽返回明确未到位错误，生产调用链同时发布共享故障并禁止完成态。

**验证边界：**需执行偏差、卡滞、编码器错误、驱动错误和循环耗尽故障注入；静态检查不替代 T15／T16 台架。

完整分析：执行链、根因、整改语义与回归矩阵

<div class="analysis-body">

<div class="analysis-grid">

<div class="analysis-panel">

**当前结论**C-04A 的错误覆盖和 C-04B 的停稳后到位缺口均在实际使用的 `MotorCtrl_MoveAndWait()` 路径存在，维持 P0。C-04C 的 10 轮耗尽出口也存在，但当前业务已改用 Jog 绝对定位，该公共接口在当前源码中没有调用者，属于潜在 P1。

</div>

<div class="analysis-panel">

**成功判定缺口**当前代码把“驱动已停止、同步／健康 helper 返回 `NO_ERROR`”近似当作“运动成功”；该成功甚至可能来自“位置同步失败但健康检查成功”。对于 5 mm 及以下命令、位移偏差不超过 70% 的提前停止，或使用电机位置源时，即使最终偏差很大，现有丢步分支也不会返回错误。

</div>

</div>

#### 当前执行链与触发条件

1.  `MotorCtrl_MoveAndWait()` 读取起点，计算相对目标并下发 TMC5130 位置运动。
2.  `MotorMotion_WaitUntilStopWithTarget()` 在驱动仍运动时会同步当前位置，并在当前活动位置源到达或越过目标时主动停机；缺口出现在驱动先报告停止的分支，该分支直接退出循环，只执行同步／健康检查，没有用本次新鲜的最终位置再次证明到位。
3.  停稳后用实际位移与命令位移计算偏差；仅当偏差大于 70%、命令大于 5 mm 且使用编码器位置源时设置 `ENCODER_LOST_STEP`。
4.  下一步无条件执行 `ret = MotorDriver_SyncPositionOrCheckHealth(&stepper)`。同步成功返回 `NO_ERROR`，覆盖刚刚确认的丢步错误；即使位置同步自身失败，只要随后健康检查成功，该 helper 也会返回 `NO_ERROR`。
5.  局部丢步只修改该 API 的返回值，不直接发布全局故障；即使修正返回覆盖，生产调用链仍必须显式进入统一故障出口，才能让共享错误码和 CPU3 显示一致。
6.  `MotorCtrl_MoveToPosition()` 每轮只在运动前判断到位，第 10 次运动后不再采样，循环耗尽直接以 `NO_ERROR` 退出。

#### 根因

- 同一个 `ret` 同时承载主运动结果、最终同步结果和速度恢复结果，没有“主错误／附加诊断”的明确所有权。
- 运动接口没有统一规定 `NO_ERROR` 必须同时满足“已停稳＋最终位置有效＋到位合格”。
- 重试次数只限制循环，没有为“重试耗尽”定义失败出口。
- `MotorMotion_RefreshActivePositionMm()` 当前除空指针外固定返回成功；电机位置源丢弃位置同步布尔结果，编码器位置源也没有“本次样本新鲜”的证明，因此整改不能继续用缓存值证明到位。

#### 分阶段整改方案

1.  **先关闭错误覆盖：**拆分 `motion_ret`、`sync_ret`、`restore_ret`。已经确认的运动错误保持为主错误，后续同步或恢复失败只追加日志；后续成功绝不能把主错误改回 `NO_ERROR`。
2.  **建立停稳后验收：**无论是活动位置源主动停机还是驱动先报告停止，都取得能够证明本次刷新成功且样本新鲜的最终活动位置，确认驱动停稳后再按明确容差判断到位。读取失败返回位置源或驱动具体错误，不能使用缓存继续判成功。
3.  **修复循环耗尽：**第 10 次运动后再做一次最终采样；确实到位才返回成功，仍超差则返回现有 `POSITION_ARRIVAL_DEVIATION` 并记录目标、实际、偏差、容差和尝试次数。
4.  **统一完成态门禁：**业务调用方只有在返回 `NO_ERROR` 且到位验收通过时才能发布完成、保存依赖到位的结果或继续测量。
5.  **补齐小步边界：**重新定义正式相对运动的停稳容差。无有效位移使用 `MOTOR_STEP_ERROR`，编码器明显未跟随使用 `ENCODER_LOST_STEP`，停稳但位置超差使用 `POSITION_ARRIVAL_DEVIATION`；容差必须由编码器分辨率、制动距离和台架数据确认。

#### 返回优先级与兼容影响

首个真实运动／安全错误优先；没有主错误时才返回停机、同步或最终采样错误；底层均成功但位置不合格时返回 `POSITION_ARRIVAL_DEVIATION`；临时速度恢复失败只在前述步骤全部成功时成为最终错误。`STATE_SWITCH` 属于正常打断，但若取消停机失败，停机故障应优先。上述错误码 CPU2、CPU3 和显示文案均已存在，不需要新增共享故障码或提升共享协议版本。

#### 回归矩阵

<div class="table-scroll">

| 场景 | 预期结果 | 重点观察 |
|----|----|----|
| API 丢步成立，最终同步成功 | `MotorCtrl_MoveAndWait()` 返回 `ENCODER_LOST_STEP` | 主错误不被 helper 成功覆盖。 |
| 生产调用收到丢步返回 | 锁存共享 `ENCODER_LOST_STEP` | CPU2 共享错误码与 CPU3 显示同码，不只停留在函数返回值。 |
| 丢步成立，最终同步也失败 | 保留首个丢步错误，记录同步次生错误 | 日志同时保留两段证据，不能只剩最后一次错误。 |
| 驱动提前报告停止但活动位置未到 | 返回位置超差或位置源具体错误 | 停稳不等于到位，必须执行最终活动位置验收。 |
| 位置同步失败但驱动健康检查成功 | 不得返回成功 | 健康结果不能覆盖同步失败；禁止使用旧缓存。 |
| 编码器样本过期／本轮无新样本 | 返回位置源不可用 | 缓存值即使落在容差内也不能作为本次到位证据。 |
| 3 mm 命令但没有有效位移 | 不得返回成功 | 覆盖当前 `total_cmd_mm > 5 mm` 门槛遗漏。 |
| 第 10 轮刚好到位 | 最终采样确认后成功 | 避免简单把循环后出口改成无条件失败。 |
| 10 轮后仍超差 | 返回 `POSITION_ARRIVAL_DEVIATION` | 不得发布运动完成态或依赖到位的测量结果。 |
| 运动错误且速度恢复失败 | 返回原运动错误 | 速度恢复失败作为附加诊断。 |
| 命令切换与停机失败并发 | 返回停机具体错误 | 不能以普通 `STATE_SWITCH` 掩盖安全停机失败。 |

</div>

**证据边界：**当前源码可证明错误覆盖、位置新鲜度缺口和循环出口缺陷，但不能证明现场失步概率或最终容差。关闭本项必须补 T15 编码器、T16 TMC／24 V 故障注入以及小步、卡滞、越界和命令切换台架记录；每个失败用例同时断言函数返回值、CPU2 共享错误码和 CPU3 故障显示。

</div>

<div class="issue-head">

### C-05 取消测量先清故障，慢停失败后仍发布待机

<span class="badge p0">P0 · 仍存在</span>

</div>

<div class="evidence">

**原因与证据：**取消路径先清命令和错误码，再调用慢停；慢停失败只打印，最终仍无条件设置待机。位置：`LTD_MAIN_CPU2/Application/Src/measure.c:312-332`。

</div>

**影响：**停止下发、运动状态读取或停机超时失败时，外部仍可能看到“待机、无错误”，无法证明机构已安全停稳。

**整改方案：**把“确认停稳”和“取消收尾”分开；进入取消时快照既有锁存故障。只有取消前无锁存故障且停稳、收尾均成功，才进入待机；否则保留具体错误并进入经风险评审、已验证的停机故障策略，禁止新运动。

**来源：**取消流程图、[全工程问题梳理 P1-04](2026-07-16_全工程问题梳理与整改优先级.md)。

完整分析：取消意图、停稳证据与待机发布门禁

<div class="analysis-body">

<div class="analysis-grid">

<div class="analysis-panel">

**当前结论**仍存在，复核后上调 P0：停止下发／VZERO 失败时会在未证明停稳的情况下发布待机；即便已停稳，速度配置恢复失败或取消前已有锁存故障也会被错误清零。

</div>

<div class="analysis-panel">

**状态语义**`STATE_SWITCH` 只说明取消来源，不是物理停稳证明；用户取消也不是故障复位。成功取消需停止命令、VZERO／最终运动状态和收尾共同成功，且取消前不存在必须锁存的故障。

</div>

</div>

#### 当前执行链

1.  运动或测量期间收到取消，当前同步业务函数通过命令切换退出。
2.  主循环进入 `CMD_CancelMeasurement()`，先取消恢复／Profile，并清 pending、current command 和全局错误。
3.  随后调用 `MotorCtrl_SlowStop()`；停止下发、等待 VZERO 或恢复速度任一步骤都可能失败。
4.  失败结果当前只打印，不恢复原错误，也不进入统一故障出口。
5.  函数最终无条件写入 `STATE_STANDBY`，CPU3 因而可能看到待机且错误码为 0。

#### 根因与整改

取消被错误地等同为“非故障”，进而先清除所有故障；命令取消、物理停稳和驱动收尾没有独立结果，void 接口也不能返回取消终态。最小改法在进入取消时快照既有 error，再按“记录取消意图→发停止→确认 VZERO／停稳→恢复配置→裁决终态”排序：停止命令／VZERO 失败优先成为停机故障；VZERO 已确认后若安静速度恢复失败，物理停稳虽已证明，仍以驱动配置错误进入 `STATE_ERROR`。完整方案增加非阻塞 `CANCELLING／STOPPING` 过渡态和取消结果结构；直接硬停、失能或断电可能造成悬挂机构下坠，未完成风险评审前不得写成默认动作，应保持驱动故障态并禁止新运动。

**固定终态裁决：**`active_error = (stop_ret != NO_ERROR) ? normalized_stop_fault : prior_latched_error`。停机失败时对外激活归一后的停机故障，并把取消前故障保留为因果；停机成功仍保留必须锁存的 prior error；两者均无错且收尾成功时才进入待机。即使未来 `stop_ret==STATE_SWITCH`，也必须视为“停机未证明”并归一成具体停机故障。

**避免重复停机的故障发布：**停机失败后不能直接调用 `SET_ERROR(stop_ret)`，因为它会进入 `FaultManager_SetErrorState()→HandleError()→MotorCtrl_SlowStop()`，在同一取消路径再次执行慢停，存在潜在重入。需要增加 `FinalizeAfterStopAttempt` 一类“停机已尝试”专用终结器：只锁存具体错误、发布 `STATE_ERROR`、记录因果链并置锁存式 `motion-inhibit／stop-unconfirmed`，不再次调用停机动作。由于 `MeasureStart()／fault_info_init()` 仍会清 error，运动禁止必须同时放在命令准入和电机公共 API 两层，不能只依赖 `STATE_ERROR`。

#### 错误和兼容

复用 `MOTOR_STOP_WAIT_TIMEOUT`、`MOTOR_TMC_COMM_ERROR` 等具体码即可；只有取消前无锁存故障且本次停机／收尾成功，才允许 `STATE_STANDBY+NO_ERROR`。取消前已有丢步、通信等锁存故障时，即便慢停成功也保留原故障与安全停止／错误态。若只复用现有状态不升协议；新增 `STATE_CANCELLING` 则两端枚举、显示和共享协议版本需同步。

<div class="table-scroll">

| 场景 | 预期 | 禁止结果 |
|----|----|----|
| 正常运动中取消 | 取消前无锁存故障且停机／收尾全部成功后进入待机 | 停稳前清错或发布待机。 |
| 停止命令写失败／VZERO 超时 | 保留具体错误并进入错误态 | `STATE_STANDBY+NO_ERROR`。 |
| VZERO 已确认、恢复安静速度失败 | 确认已停但以配置错误进入错误态 | 把“已停稳”误写成“全部取消成功”。 |
| 取消前已有丢步错误且停稳成功 | 继续锁存原丢步错误 | 取消隐式全清。 |
| 已有真实故障且本次停机又失败 | 停机失败作为当前安全故障，原故障保留为因果 | 只保留最后错误或把原故障清零。 |
| 停机失败进入故障发布 | `MotorCtrl_SlowStop()` 调用次数严格为 1 | `SET_ERROR→HandleError` 再次慢停；同一取消只允许一次停机动作。 |
| 停机返回 `STATE_SWITCH` | 归一为“停机未证明”的具体故障 | 把切令语义当作停稳成功并进入待机。 |
| 取消与新命令连续到达 | 命令准入和电机 API 双门禁拒绝新运动 | 机构未停又接受下一动作。 |
| 故障后显式恢复 | 重新证明停稳和驱动健康后才解除 inhibit | 仅清错误码即可重新运动。 |

</div>

**证据：**`measure.c:94-99,312-333,408-417`、`motor_ctrl_motion_api.c:840-858`、`motor_ctrl_driver_param.c:703-759,847-880`、`app_main.c:39-52,195-204`、`fault_manager.c:230-295,332-335`、`fault_manager.h:169-179`。状态误发布和简单 `SET_ERROR` 导致同一路径再次慢停可静态确认；慢停失败后的机械惯性、驱动使能和 inhibit 解锁必须做电机故障注入。

</div>

<div class="issue-head">

### C-06 非法命令、重复启动和全局清错的边界仍未收口

<span class="badge p1">P1 · 仍存在</span>

</div>

<div class="evidence">

**原因与证据：**`ProcessMeasureCmd()` 在具体命令合法性判定前统一执行 `MeasureStart()`；未知／保留命令也会先初始化并清错。多个命令内部再次调用 `MeasureStart()`；`fault_info_init()` 和 `MeasureStart()` 仍会清全局错误。位置：`measure.c:93-125,291-301,408-417`、`fault_manager.c:332-335`。

</div>

**影响：**无效请求也可能改变硬件和故障状态；重复初始化增加状态重置和本次错误归属不清的风险。

**整改方案：**先做命令白名单与前置条件裁决，再只执行一次启动；故障清除必须由明确恢复／确认流程负责。

**边界澄清：**旧报告“`MeasureStart()` 失败后仍继续分派”已被当前 `SET_ERROR()` 的 `return` 关闭，不再包含在本项。

完整分析：命令裁决顺序、重复启动与故障所有权

<div class="analysis-body">

<div class="analysis-grid">

<div class="analysis-panel">

**当前结论**仍存在，P1。顶层启动失败后继续分派的旧缺陷已经关闭；但未知／预留命令先产生停机、重初始化和清错副作用，以及合法命令重复启动，仍是当前可达路径。

</div>

<div class="analysis-panel">

**直接触发**CPU3 或板间 FC10 写入未知 32 位命令、保留命令 21／22，或下发一个 handler 内部仍自行调用 `MeasureStart()` 的合法命令。

</div>

</div>

#### 当前执行链

1.  板间参数写入口可把候选值写入 `g_deviceParams.command`；整组取值合法性缺口归入 C-03。
2.  主循环只要看到非 `CMD_NONE` 就优先调用 `ProcessMeasureCmd()`。
3.  除取消／无线配对外，函数在命令 `switch` 之前统一执行 `MeasureStart()`。
4.  `MeasureStart()` 经 `fault_info_init()` 尝试慢停并清全局错误，再初始化电机、扭力等上下文；慢停结果本身没有形成可传播的准备失败。
5.  未知／预留命令随后才落入“不支持”分支；多数合法 handler 又调用一次 `MeasureStart()`。

#### 根因、影响与整改

**根因：**命令识别、授权和前置条件裁决晚于硬件准备；顶层统一启动与历史 handler 自启动并存；`fault_info_init()` 又把安全停机与全局故障清除绑成一个无返回值动作。

**影响：**非法命令也可改变机构、驱动和故障状态；重复初始化增加 TMC 通信、位置恢复与扭力新鲜度重置等副作用，后一次清错还会破坏首个故障归属。

**第一阶段：**增加无副作用的 `MeasureCommand_IsSupported／NeedsStart／AllowedInState`，在写命令和分派入口双重白名单；未知命令不调用硬件、不改状态与错误，FC10 以异常码 `0x03` 拒绝。

**第二阶段：**每个合法命令只允许顶层启动一次，移除 handler 内重复启动；让准备过程返回首个具体错误，禁止隐式清除锁存故障。

**完整方案：**以命令描述表驱动编码、权限、可执行状态、依赖资源与重入策略，并改为 `VALIDATE → PREPARE → RUN → COMPLETE／FAIL` 状态机；把 `fault_info_init()` 拆成“安全停机并返回结果”和“初始化本次故障上下文”。

#### 状态、错误和兼容

非法命令应保持原状态／原错误并返回协议拒绝，不应制造新的运行故障；准备失败保留首个具体错误。仅收紧未定义命令且不改合法编码时无需升共享协议，若新增命令 ACK 或状态字段则必须同步 CPU2／CPU3 并升级 `DEVICE_PROTOCOL_VERSION`。

<div class="table-scroll">

| 用例 | 预期 | 关键观测 |
|---|---|---|
| 未知值／保留 21、22 | 入口拒绝 | 电机、错误、状态和 FRAM 均不变。 |
| 已有锁存故障时非法命令 | 保留原故障 | 不得被 `fault_info_init()` 清除。 |
| 每个合法命令 | 准备恰好一次 | 统计慢停、TMC 初始化和扭力初始化次数。 |
| 慢停／TMC 初始化失败 | 立即失败 | 保留首错，不进入 RUN 或完成态。 |

</div>

**证据：**`app_main.c:39-52,59-97,195-204`、`measure.c:94-126,292-303,408-429,473,486,533,545,575,679,770,805,1252`、`fault_manager.c:332-335`、`serial_command.c:113-159`、`hostcommu_modbus.c:278-354`。静态审查可确认副作用顺序；真实 TMC 初始化时延和非法板间帧响应仍需台架。

</div>

<div class="issue-head">

### C-07 AS5145好帧可越权清运动故障，12-13生成链仍不可达

<span class="badge p1">P1 · 仍存在</span>

</div>

<div class="evidence">

**原因与证据：**收到有效SSI帧会清除整个12-x编码器错误范围，其中包含失步等锁存运动故障；`Check_SSI_Error_Condition()`不检查LIN，使LIN对应的12-13不可达。原12-11“连续无效数据”没有独立判据，已在协议29取消。位置：`LTD_MAIN_CPU2/BSP/Peripherals/src/AS5145.c:101-140,155-179`。

</div>

**影响：**一次通信恢复可能掩盖另一类运动故障；工作簿又把不可达错误标为“使用中”，现场和源码口径冲突。

**整改方案：**按错误所有者和恢复条件逐码清除；明确LIN的实际检测条件。协议29已取消12-11，不再为其补造产生逻辑或兼容别名。

**来源：**[二代计量仪故障码逐项核查](2026-07-18_二代计量仪故障码问题逐项核查.md)。

完整分析：SSI 好帧越权清错与不可达错误码

<div class="analysis-body">

<div class="analysis-grid">

<div class="analysis-panel">

**当前结论**部分整改、残余仍存在，P1；协议29已取消12-11。丢步等锁存运动故障仍可被下一帧SSI好数据清除，是本项的高风险部分；LIN对应的12-13仍无实际产生入口。

</div>

<div class="analysis-panel">

**直接触发**先由运动链置 `ENCODER_LOST_STEP(12-3)` 等 12-x 故障，随后输入一帧 parity 正确、OCF=1、COF=0 的 AS5145 数据；另以 LIN=1 的帧验证检测链。

</div>

</div>

#### 当前执行链

1.  运动、校准或 SSI 通信路径把某个 12-x 错误写入全局故障。
2.  任一后续好帧进入 AS5145 成功分支，`Is_Encoder_Error_Code()` 只按 12-1～12-15 的连续数值范围判断。
3.  命中该范围后直接把全局错误改为 `NO_ERROR`，没有验证该错误是否由本次 SSI 通信产生、物理条件是否已恢复。
4.  反向路径只检测parity／OCF／COF，不检查LIN；因此LIN的12-13映射当前没有生成链。原默认回退12-11已由协议29删除。

#### 根因、影响与整改

**根因：**连续编号被当成错误所有者，通信恢复和运动／校准锁存恢复共用一条清错逻辑；检测谓词与“原始位→错误码”映射也不是同一张真值表。

**影响：**一次通信好帧可掩盖仍未处理的丢步、位置差或上电变化；12-13虽保留在源码和CPU3显示映射中，但工作簿已标为“保留”且没有实际产生证据，不能把它当作可用的现场诊断。

**第一阶段：**建立显式 `SSI_IsOwnedErrorCode()` 白名单，只允许好帧清除本模块最近报告且可自动恢复的传输类错误；丢步／差值／标定类故障由各自恢复流程确认后清除。

**第二阶段：**明确LIN是warning还是blocking，并加入统一判定表；12-11已取消，不再进入运行期判定。

**完整方案：**维护 SSI 独立健康对象：当前故障、连续坏／好帧、最后有效时间、锁存位；由表驱动原始位组合、严重度和恢复所需好帧数，全局故障管理器只消费状态事件。

#### 状态、错误和兼容

现有错误码可复用。修复错误所有权并激活既有12-13通常无需新增数值，但必须同步工作簿“使用中／预留”、原因、恢复条件和CPU3显示；不得重新占用协议29已经取消的12-11。

<div class="table-scroll">

| 用例 | 预期 | 禁止结果 |
|----|----|----|
| 先置 12-3，再输入好帧 | 12-3 保持锁存 | SSI 好帧全段清错。 |
| parity／OCF／COF 故障后好帧 | 按规定连续好帧恢复 | 单帧误恢复或清其它错误。 |
| LIN 单独为 1 | 产生已定义的 12-13 或 warning | 完全无诊断。 |
| LIN 与 parity 组合 | 按表确定唯一优先级 | 依赖分支偶然顺序。 |

</div>

**证据：**`AS5145.c:101-140,155-179,194-224,232-247,343-370`、`system_parameter.h:234-246`、`motor_ctrl_motion_api.c:545-553`、`motor_ctrl_position_model.c:1080-1089`。可达性和越权清错可静态确认；LIN 在真实磁场／安装偏差下的严重度与恢复阈值需编码器台架确定。

</div>

<div class="issue-head">

### C-08 双 CPU IWDG 仍由 TIM ISR 无条件刷新

<span class="badge p1">P1 · 仍存在</span>

</div>

<div class="evidence">

**原因与证据：**CPU2 `TIM4_IRQHandler()` 在 `Core/Src/stm32f4xx_it.c:324` 刷新 IWDG；CPU3 对应逻辑位于 `Core/Src/stm32f4xx_it.c:627`，均没有主循环健康代际门禁。

</div>

**影响：**主循环永久卡死但中断继续运行时，看门狗仍持续被喂，不能监督关键任务是否推进。

**整改方案：**由前台发布健康票据，ISR 仅在票据推进且关键任务健康时刷新，或由关键调度完成点直接喂狗。

**验证边界：**必须注入“主循环死锁、TIM 中断正常”和“全局关中断”两类故障，分别确认复位行为。

完整分析：看门狗实际监督对象与健康票据方案

<div class="analysis-body">

<div class="analysis-grid">

<div class="analysis-panel">

**当前结论**CPU2、CPU3 均仍存在，维持 P1；若 IWDG 被安全分析列为关键软件执行监督措施，应提升为 P0 并用故障注入提供证据。

</div>

<div class="analysis-panel">

**直接触发**让前台主循环永久停在 while、死锁或同步外设等待，同时保持 TIM4 中断可以每约 1 秒抢占运行。

</div>

</div>

#### 当前执行链

1.  两端 IWDG 均配置为 prescaler 32、reload 4095，按 32 kHz 标称 LSI 约 4.096 秒超时。
2.  TIM4 初始化后周期中断，CPU2 在处理继电器／AO 请求后、CPU3 在定时处理后均无条件刷新 IWDG。
3.  主循环即使永久不推进，只要 TIM4 仍可抢占，刷新就持续发生；只有关中断或更高优先级永久占用等情况才会复位。

#### 根因、影响与整改

**根因：**喂狗仅证明 TIM4 中断存活，没有证明前台调度、CPU 间通信、运动安全或显示／外部协议在推进。

**影响：**C-10 无限循环、C-12 维护忙等以及 FRAM／SPI 前台阻塞等故障可能长期存在；CPU3 冻结时显示和外部协议停滞但仍不会自动恢复。

**第一阶段：**主循环在完成一个有界调度周期后递增单调健康代际，TIM4 仅在代际较上次消费值推进时刷新；重复票据不能算健康。

**完整方案：**为每个 CPU 定义关键参与者位图与截止期，参与者仅在完成有效工作后打票；watchdog manager 收齐本窗口全部必需新票据才喂狗，并持久化复位原因和缺失参与者。先把所有可能超过 IWDG 最短容差的同步流程改成分步状态机或明确打进度票。

#### 状态和兼容

只改内部健康门禁无需升共享协议；若新增复位原因／健康位共享寄存器则两端同步并升级协议。硬件复位不应被普通业务错误码替代，但复位原因应可追溯。

<div class="table-scroll">

| 故障注入 | 预期 | 判据 |
|---|---|---|
| 主循环死循环，TIM4 正常 | IWDG 复位 | 在 LSI 容差窗口内发生。 |
| 全局关中断 | IWDG 复位 | 记录复位来源。 |
| 票据重复不推进 | 停止喂狗  | 布尔常 1 不可绕过。 |
| 正常长运动／密度测量 | 不误复位  | 每个有界进度点持续发布新代际。 |

</div>

**证据：**CPU2 `Core/Src/iwdg.c:30-46`、`tim.c:72-108`、`stm32f4xx_it.c:315-325`；CPU3 `Core/Src/iwdg.c:30-46`、`tim.c:156-192`、`stm32f4xx_it.c:620-628`。静态确认无健康门禁；未做目标板故障注入，真实超时受 LSI 容差影响。

</div>

<div class="issue-head">

### C-09 每次测量启动会伪造扭力“刚收到帧”的新鲜时间

<span class="badge p0">P0 · 仍存在</span>

</div>

<div class="evidence">

**原因与证据：**`weight_init()` 重置 `s_weight_last_rx_tick`，而超时检测基于该时间戳；测量启动会再次初始化重量链。位置：`LTD_MAIN_CPU2/Services/Weight/weight.c:78-81,117-158`。

</div>

**影响：**已持续断链的扭力通信可在新命令开始时获得新的“宽限期”，推迟真实超时故障，随后运动链可能在缺少最新碰撞信息时继续。

**整改方案：**区分首次上电初始化和业务重入；只有满足已冻结供应商帧契约的样本才更新时间戳，启动流程不得把断链历史伪装成新鲜。

**验证边界：**断开扭力后等待超过阈值，再下发每类运动命令，确认故障不会被清零或延后。

完整分析：伪新鲜窗口、碰撞门禁与快照设计

<div class="analysis-body">

<div class="analysis-grid">

<div class="analysis-panel">

**当前结论**仍存在。扭力是运动碰撞保护输入，已知断链仍可获得约 1 秒伪健康窗口，复核后由 P1 上调 P0。

</div>

<div class="analysis-panel">

**直接触发**距上次被当前解析器接受的 ≥21 B UART4 IDLE 片段已超过 1 秒，随后下发会执行 `MeasureStart()` 并开始运动的命令。当前解析器并没有完整帧校验，见 C-30。

</div>

</div>

#### 当前执行链

1.  长时间无新帧后，主循环可置 `WEIGHT_COMM_TIMEOUT`。
2.  新命令优先进入 `MeasureStart()`；`fault_info_init()` 先尝试慢停，随后清全局错误。
3.  `weight_init()` 把 `s_weight_last_rx_tick` 改成当前时刻并清超时报告位，等同于伪造“刚收到数据”。
4.  随后约 1 秒内，`CheckWeightCollision()` 的通信超时检查返回成功，并继续消费上次缓存的扭力。
5.  部分 handler 重复启动还可能再次重置该窗口；约 1 秒后才会重新报告断链。

#### 根因、影响与整改

**根因：**参数镜像初始化与通信会话新鲜度复用同一函数，把“开始等待首帧”错误地当成“收到有效帧”，快照也没有 valid／generation。

**影响：**运动碰撞判断在已知断链时使用陈旧扭力，真实超时周期性消失／重现；若陈旧值偏低，会削弱机械碰撞保护。

**第一阶段：**`weight_init()` 只加载空／满量程参数，不改最后接收时间和超时状态；新增 `has_valid_frame`。上电后尚未收到首个合法样本或 age≥1000 ms 时，所有可启动或继续运动的入口直接返回 `WEIGHT_COMM_TIMEOUT`；取消、停机和安全收尾必须始终允许执行，不得被无首帧门禁拦住。不依赖扭力的只读诊断命令另设白名单。

**第二阶段：**按冻结的供应商帧契约执行全部有效性规则，只有通过的样本才更新时间戳并清除本模块通信错误；仓库尚无正式帧格式，不能预设一定存在 CRC。C-30 必须与本项一起落地。

**完整方案：**拆成 `Weight_InitOnce／ApplyParams／OnValidatedFrame／GetFreshSnapshot`；快照携带 value、tick、generation、valid，运动开始锁定新鲜代际并在运动中持续检查年龄。

#### 错误和兼容

复用 `WEIGHT_COMM_TIMEOUT(0x00150006)` 即可，无需升协议；若区分“启动后首帧未建立”，新增错误码时需同步 CPU3 显示、故障表和共享协议评估。扭力恢复不得清除其它高优先级故障。

<div class="table-scroll">

| 用例 | 预期 | 关键边界 |
|----|----|----|
| 上电从未收到合法帧 | 首次运动准备立即拒绝 | 不得先给 1 秒伪宽限；取消／停机仍可执行。 |
| 已有合法帧后断线再启动 | 准备阶段按 age 拒绝 | 999／1000／1001 ms。 |
| 重复／嵌套 `MeasureStart()` | 不刷新 tick、generation 或 valid | 同一命令不得重复制造宽限窗。 |
| 不满足冻结帧契约的片段 | 不刷新新鲜度 | generation 不变。 |
| 收到新有效帧 | 仅恢复扭力通信故障 | 其它锁存错误保持。 |
| 运动中断链 | 在阈值到达时安全失败 | 不得继续使用陈旧值。 |

</div>

**证据：**`weight.c:32,39-40,77-109,117-168,287-305`、`measure.c:408-429`、`app_main.c:181-204`、`stm32f4xx_it.c:42-80,423-443`。伪宽限窗可静态确认；真实扭力帧格式和陈旧值的机械后果需协议资料与碰撞台架验证。

</div>

<div class="issue-head">

### C-10 合法 128～200 点使 int8_t 索引超范围，目标 GCC 可回绕并负索引写栈

<span class="badge p0">P0 · 仍存在</span>

</div>

<div class="evidence">

**原因与证据：**点数上限可到 200，相关循环变量仍使用 `int8_t`。位置：`LTD_MAIN_CPU2/Application/Src/measure_density.c:802-862`。

</div>

**影响：**点数超过 127 后计数可溢出为负，造成异常循环、数组访问错误或结果数量不可信。

**整改方案：**把索引和点数统一为与容量匹配的无符号类型，并在入口证明 `count <= capacity`。

**验证边界：**至少覆盖 0、1、100、127、128、199、200、201 点以及中途取消／失败。

完整分析：合法配置触发的索引回绕与栈破坏

<div class="analysis-body">

<div class="analysis-grid">

<div class="analysis-panel">

**当前结论**仍存在。合法点数 128～200 必然让 `int8_t` 索引发生超范围转换；目标 ARM-GCC 通常回绕为负数并继续负索引写栈，即使其它实现不回绕，循环也没有可证明的有界性。复核后由 P1 上调 P0。

</div>

<div class="analysis-panel">

**直接触发**执行区间密度命令，将 `spreadMeasurementCount` 配置为 128～200；不需要坏帧、竞争或异常硬件。

</div>

</div>

#### 当前执行链

1.  区间规划器把点数转成 `int`，并钳制到 `MAX_MEASUREMENT_POINTS=200`。
2.  循环索引却是 `int8_t i`；128 无法由该类型表示，转换结果在 C 标准上实现相关，项目目标 ARM-GCC 通常把 127 加 1 回绕为 -128。
3.  `-128 < count` 仍成立，循环继续并写 `out_p01[-128]`，之后反复回绕。
4.  调用者输出是栈上 `points01[200]`，因此出现负索引写、栈破坏和函数无法正常返回；C-08 还可能让 IWDG 继续被中断喂养。

#### 根因、影响与整改

**根因：**容量从 100 扩到 200 后索引类型未同步，入口只静默钳位而不拒绝非法数量，planner 接口也没有输出容量。

**影响：**无限循环、栈内存覆盖、异常运动点、HardFault 或不可预测控制流；不是单纯“结果数量不可信”。

**第一阶段：**把 count 和索引统一为 `uint32_t`／`size_t`；`count==0 || count>MAX` 返回 `MEASUREMENT_DENSITY_PLAN_INVALID`，不再静默钳位。

**完整方案：**所有 BuildPoints 接口增加 `out_capacity`，用统一安全 append helper 证明每次写入 `index<capacity`；对 FC10 解析出的 `spreadMeasurementCount` 参数候选值限制 1～200，并以宿主测试、数组 canary 和转换告警门禁覆盖。planner 失败时显式令 `*out_n=0`，输出数组保持不变。

#### 错误和兼容

复用现有 `MEASUREMENT_DENSITY_PLAN_INVALID(15-29)`；内部类型修复不改协议。把 \>200 从钳位改成拒绝属于非法参数收紧，应与 C-03 参数事务变更一并记录。

<div class="table-scroll">

| 点数 | 预期 | 附加检查 |
|---|---|---|
| 0、201、UINT32_MAX | 明确拒绝 | 输出数组不变。 |
| 1、2、3、126、127  | 正常生成 | 首尾和单调性正确。 |
| 128、129、199、200 | 正常且有界返回 | 前后 canary 不变。 |
| 上下行／中途取消 | 结果数不超过容量 | 无部分剖面误发布。 |

</div>

**证据：**`measure_density.h:16`、`system_parameter.h:29,575,800`、`measure_density.c:793-863,870-923`、入口 `measure.c:202-205`，以及工程 `.cproject` 的 ARM GCC 目标。类型范围缺口可静态确认；应再用目标 Release 构建／反汇编或板级故障注入确认本构建的回绕和实际破坏形态。

</div>

<div class="issue-head">

### C-11 探底失败／偏差超限会伪装完成，取消也可能发布完成态

<span class="badge p0">P0 · 仍存在</span>

</div>

<div class="evidence">

**原因与证据：**罐底 fallback 在搜索失败或偏差超限时可能写入参考值、清除错误并发布完成；`SearchBottom()` 返回 `STATE_SWITCH` 时虽跳过 fallback，后续仍无条件写 `STATE_FINDBOTTOM_OVER`，旧 `bottom_reference_valid` 也可能继续为 1。位置：`LTD_MAIN_CPU2/Application/Src/measure.c:573-669`。

</div>

**影响：**外部无法区分“本次真实找到罐底”“失败后使用配置参考”和“已取消”；测量结果、有效位和运动状态会被错误闭环。

**整改方案：**把实测、显式降级、失败和取消拆成不同终态；回退不得清掉本次搜索错误或使用普通完成语义，取消不得发布完成沿或沿用上一轮有效位。

**验证边界：**需要搜索超时、碰撞、位置偏差超限、参考值合法／非法和取消矩阵。

完整分析：失败随机回退、完成态伪装与参考值传播

<div class="analysis-body">

<div class="analysis-grid">

<div class="analysis-panel">

**当前结论**仍存在。该路径既会把“本次未测得”伪装成“物理测量完成”，也会把命令切换后的取消出口写成完成态；旧参考有效位还可能跨尝试残留，复核后由 P1 上调 P0。

</div>

<div class="analysis-panel">

**直接触发**路径 A：`error_stop_measurement==1`、ret≠`STATE_SWITCH`、参考罐高非 0，且探底失败或成功值与参考偏差\>10 mm；只有采用非 0 标定罐高时才叠加 ±3 mm 随机量。路径 B：`SearchBottom()` 返回 `STATE_SWITCH`，随后仍走到无条件完成态。

</div>

</div>

#### 当前执行链

1.  `CMD_FIND_BOTTOM → CMD_MeasureBottom → SearchBottom()` 执行真实搜索。
2.  失败或偏差超限时，优先从 `calibrateTankHeight`，否则从 `currentTankHeight` 取得非 0 配置参考。
3.  标定罐高非 0 时，以 tick 和缆长播种，生成参考值 ±30 个 0.1 mm、即 ±3 mm 的随机结果；currentTankHeight 分支不随机。
4.  该结果覆盖 `bottom_value／current_real_height`，清全局错误并仅记录 warning。
5.  随后置 `bottom_reference_valid=1` 和 `STATE_FINDBOTTOM_OVER` 并提前返回，绕过正常 `SET_ERROR(ret)`。
6.  CPU3 显示、SI Bottom Reference 和 CPU2 SI Profile 均可继续消费该值。
7.  另一路取消缺口是：`ret==STATE_SWITCH` 时 fallback 被跳过，`SET_ERROR(STATE_SWITCH)` 不置错误，但函数随后仍无条件写 `STATE_FINDBOTTOM_OVER`；若上一轮已置 `bottom_reference_valid=1`，本轮也没有先清除。

#### 根因、影响与整改

**根因：**容错继续运行与本次测量成功共用同一值、有效位和完成态；没有 attempt generation／source／quality；标定分支还用随机抖动掩盖重复回退。此处硬编码 10 mm，而 `maxTankHeightDeviation` 默认值与它并不相同，不能未经产品确认就直接替换。

**影响：**CPU3／SI 对外得到“罐底完成且无故障”，却无法区分实测、配置推算和取消；同一失败重复执行还可能得到不同“测量值”，破坏追溯、校准和后续运动点位可信性。

**第一阶段：**先在 CPU2 本地建立 attempt generation，并在每轮开始清本轮 valid；历史 last-good 独立保存且带 source／age。删除随机回退和提前成功出口，搜索失败原样保留具体错误；先冻结唯一权威偏差阈值并确认是否复用 `maxTankHeightDeviation`，再对成功值校验。失败／超限不得覆盖本次结果、清错、置完成态或沿用上一轮有效位；`STATE_SWITCH` 必须显式返回取消态，后续由 C-05 的停稳终态处理。

**完整方案：**定义 `MEASURED／FALLBACK_LAST_VALID／CONFIG_REFERENCE／INVALID` 来源和质量；只有 MEASURED 进入普通完成。若业务允许降级，使用独立降级状态／质量字段、明确告警和消费策略，SI、密度、校准分别声明是否接受，禁止随机化。

#### 状态、错误和兼容

最小修复复用 `SearchBottom()` 首个具体错误和现有高度无效／偏差码，失败进入 `STATE_ERROR`，取消返回现有切令语义，均无需升协议。本地 attempt generation 不改变共享结构；若把 generation、`STATE_FINDBOTTOM_DEGRADED` 或 reference source 暴露到 CPU2／CPU3 共享结构，则两端、SI 映射和 `DEVICE_PROTOCOL_VERSION` 必须同步。

<div class="table-scroll">

| 场景 | 预期 | 禁止结果 |
|----|----|----|
| 成功且阈值内 | 发布 MEASURED 完成 | 人为随机化。 |
| 成功但刚好／超过阈值 | 按统一参数判定 | 硬编码 10 mm 漂移。 |
| 超时／碰撞／TMC 错误 | 保留具体首错 | error=0、完成态、valid=1。 |
| 多次相同失败 | 结果无新测量 | 每次产生不同随机值。 |
| `STATE_SWITCH`／取消 | 显式取消并交给停稳终态 | `STATE_FINDBOTTOM_OVER` 完成沿或沿用旧 valid。 |
| 旧 last-good 存在 | 仅以历史来源读取 | 冒充本次完成沿。 |

</div>

**证据：**`measure.c:573-669`、`system_parameter.c:1245,1306`、`system_parameter.h:716,781`、`dataanalysis_modbus.c:552-560`、CPU3 `dataanalysis_modbus.c:560`、`si_modbus_slave.c:1158`、CPU2 `measure_density.c:1191-1205`。数据伪装链可静态确认；是否允许某种显式降级及机械风险需产品决策和罐底台架。

</div>

<div class="issue-head">

### C-12 维护模式忙等占满前台，异类自动命令还可解除隔离

<span class="badge p1">P1 · 仍存在</span>

</div>

<div class="evidence">

**原因与证据：**维护模式在 `LTD_MAIN_CPU2/Application/Src/measure.c:826-841` 进入 `while(1)`，等待新命令退出，而不是由主循环状态机调度。

</div>

**影响：**进入维护态后会阻塞同一前台中的后台任务；同时 SI 自动 Profile 可发送新命令并意外打断维护。

**整改方案：**改为显式维护状态，由主循环继续调度通信、健康和安全任务；只有授权退出命令可切换状态。

**验证边界：**维护中持续轮询三路外部协议、CPU2 链路、OLED 和安全任务，并验证自动任务不会强制退出。

完整分析：前台忙等、后台停滞与维护态授权缺口

<div class="analysis-body">

<div class="analysis-grid">

<div class="analysis-panel">

**当前结论**仍存在。它不仅占用 CPU，还停止 CPU2 前台健康与延后任务，并允许异类自动命令解除维护隔离，复核后由 P2 上调 P1。

</div>

<div class="analysis-panel">

**直接触发**下发命令 109 进入维护态；随后保持无退出命令，或由 CPU3／SI 写入任一与当前维护命令不同的有效命令。

</div>

</div>

#### 当前执行链

1.  顶层先执行 `MeasureStart()`，handler 设置两个 manual inhibit 并发布 `STATE_MAINTENANCEMODE`。
2.  函数进入无 delay、无任务调度的紧密 `while(1)`，循环只检查 `HasEffectiveCommandSwitchRequest()`。
3.  电机位置轮询、扭力超时、延后日志、AO 诊断、参数延后保存和故障恢复等 CPU2 主循环任务停止；TIM／UART 中断仍运行，C-08 仍可能喂狗。
4.  除同一且不可自中断的维护命令外，任一 pending／串口新命令都可使循环退出、清 inhibit，随后主循环执行新命令；自动 SI Profile 也可能触发。

#### 根因、影响与整改

**根因：**长期运行状态被实现成阻塞函数，维护态没有来源／权限白名单，只复用了普通命令切换布尔判断。

**影响：**CPU 占用 100%，CPU2 数据新鲜度、故障检测和持久化停滞；维护人员预期的手动隔离可被自动任务解除。CPU3 自身 OLED／外部协议不会因 CPU2 while 直接停机，但板间业务语义会退化。

**第一阶段：**进入命令只执行一次准备并立即返回；主循环看到 `STATE_MAINTENANCEMODE` 时继续全部后台健康任务，仅白名单接受显式退出／取消／安全命令，其余返回 busy 或拒绝并保持维护态。

**完整方案：**维护态改成 `ENTERING → ACTIVE → EXITING／FAULT` 状态机；进入先证明电机停稳和输出安全，退出验证授权来源，自动调度器读取 manual inhibit 后不得下发任务，异常退出保证 inhibit 与终态一致。

#### 状态和兼容

维护本身不是错误：ACTIVE 保持 `STATE_MAINTENANCEMODE`，显式退出后才进入待机，硬件失败进入错误态并保留具体码。复用取消作为退出且不新增枚举可不升协议；新增退出命令／过渡态需双端同步升级。

<div class="table-scroll">

| 用例 | 预期 | 关键观测 |
|---|---|---|
| 维护态持续 10 分钟 | 后台 generation 持续推进 | 位置、扭力、日志、保存不饥饿。 |
| 普通／自动 SI 命令 | 拒绝且保持维护 | manual inhibit 不被清。 |
| 显式取消／退出 | 有序退出到待机 | 先确认安全终态。 |
| 维护中硬件故障 | 进入错误态 | 首个具体错误可追溯。 |

</div>

**证据：**`measure.c:283-286,826-841`、`app_main.c:169-232`、`system_parameter.h:893-925`、UART5 入口 `stm32f4xx_it.c:451-468`。阻塞和退出条件可静态确认；现场允许命令集、SI 自动触发频率和长期运行行为需产品／台架确认。

</div>

<div class="issue-head">

### C-13 水位跟随定义 20 次却按 5 次恢复，步进后水位不刷新

<span class="badge p1">P1 · 仍存在</span>

</div>

<div class="evidence">

**原因与证据：**流程设计宏使用 20 次阈值，实际丢失计数以 `lost_count >= 5` 触发；稳定带内的 `WaterLevelSyncFromCable()` 调用仍被注释，位置状态不会持续刷新。

</div>

**影响：**流程图、参数口径与运行态行为不一致，可能导致过早判失、稳定区内位置陈旧和下游状态抖动。

**整改方案：**确定唯一阈值来源并由配置／宏消费；明确稳定带内是否必须同步缆长和有效状态，补临界值用例。

**来源：**水位跟随流程图与当前算法交叉核查；需要真实水位信号抖动和边界台架才能确定最终参数。

完整分析：丢失判据漂移、运动后水位未发布与恢复状态机

<div class="analysis-body">

<div class="analysis-grid">

<div class="analysis-panel">

**当前结论**仍存在。阈值宏未被消费、恢复判据忽略电容响应、运动和 monitor 期间共享水位长期不刷新，复核后由 P2 上调 P1。

</div>

<div class="analysis-panel">

**直接触发**进入任一水位跟随模式；持续出现超过 `0.6×water_cap_threshold` 的偏差，或探头每步成功移动但共享水位／AO 仍由旧缓存提供。

</div>

</div>

#### 当前执行链

1.  两种入口最终进入 `FollowWaterLevelCore()`，约每 500 ms 读取电容。
2.  大偏差时运动 10 mm；成功后只打印旧 `water_level`，未调用 `WaterLevelSyncFromCable()`。
3.  每次大偏差直接 `lost_count++`，虽然计算了 `cap_delta`，但它不参与“机构／传感器无响应”判断。
4.  实际使用硬编码 `lost_count>=5` 触发重新寻水，文件定义的 `WATER_FOLLOW_LOST_COUNT_MAX=20` 和“10 秒”注释未生效。
5.  稳定带同步也被注释；仅进入 monitor 时同步一次，monitor 循环继续发布缓存值。

#### 根因、影响与整改

**根因：**参数／宏与执行条件分叉；“真实液位快速变化”和“运动或传感器无响应”共用大偏差计数；电机位置更新没有统一映射为水位结果发布。

**影响：**约 5 轮偏差即可过早重复寻水，即便电容正正常响应；每步后的共享水位和 AO 样本仍为旧值但保持 valid，CPU3／外部看到电机位置与水位不一致。

**第一阶段：**只保留一个阈值来源并实际消费；每次运动成功并获得新鲜位置后立即调用 `WaterLevelSyncFromCable()`，稳定／monitor 也按明确周期发布。丢失至少要求“连续大偏差且运动后电容变化低于响应阈值”。

**完整方案：**改为按真实 elapsed 管理的 `TRACKING／STABLE_MONITOR／RECOVERING` 状态机；记录命令位移、实际位移、电容前后差和 position generation，区分液位阶跃、探头脱离、机构未动和传感器卡值。结果携带 fresh tick／valid／source，失败立即使 AO 样本失效。

#### 错误、状态和兼容

恢复失败继续传播搜索／运动的具体错误，不新增笼统错误覆盖原因。只修正阈值消费和现有水位同步不需升协议；新增 fresh／valid／source 共享字段需同步 CPU3 显示与外部映射并升级协议。

<div class="table-scroll">

| 用例 | 预期 | 边界 |
|---|---|---|
| 计数 4／5／19／20 | 按最终唯一规则触发 | 代码、流程图、日志一致。 |
| 大偏差且 cap 正常变化 | 继续跟踪，不误恢复 | cap_delta 进入判据。 |
| 大偏差且 cap 卡死 | 目标时限内恢复／失败 | 不依赖可变循环耗时。 |
| 每次步进与 monitor | 水位=罐高−缆长且新鲜 | AO valid／age 同步。 |

</div>

**证据：**`measure_waterLevel.c:52-60,104-183,1038-1075,1084-1136,1138-1209,1215-1299,1307-1328`、入口 `measure.c:483-524`、共享发布 `dataanalysis_modbus.c:546-550`。阈值漂移和缓存不刷新可静态确认；5／20、cap_delta 阈值和真实液位动态必须由水位／运动台架定标。

</div>

<div class="issue-head">

### C-14 ISR 调用链仍执行完整协议处理或同步日志

<span class="badge p1">P1 · 仍存在</span>

</div>

<div class="evidence">

**原因与证据：**CPU2 UART5 中断路径直接执行完整 `HostCommuProcess()`；USART2 IDLE 中断直接完成 HART 解包、打印和组包；HART 发送完成回调还会等待 TC 并执行 180000 次 NOP；AS5145 DMA 完成回调直接解析，错误重试路径同步进入 `ErrorLog_Retry()`／`printf` 并立即重启 DMA。

</div>

**影响：**CRC、Modbus、HART、SPI 参数应用、日志和忙等的执行时间进入中断上下文，放大其它 UART／DMA 的抖动并降低最坏时序可证明性。

**整改方案：**ISR 只收帧、记录时间和发布事件；协议解析、错误日志、硬件应用和重试统一移到前台任务。

**验证边界：**需用逻辑分析仪量化中断占用、嵌套延迟和满负荷多串口丢帧率；源码重构本身不能证明时序达标。

完整分析：五类中断重处理、无界等待与事件化改造

<div class="analysis-body">

<div class="analysis-grid">

<div class="analysis-panel">

**当前结论**仍存在，P1。HostCommu 异常日志、AO 诊断和部分保存已延后，但 UART5／HART／SSI／扭力／TIM4 的核心非恒定业务仍在 ISR，只能判“部分改善、主问题未关闭”。

</div>

<div class="analysis-panel">

**最高风险触发**HART TX 完成后 TC 位迟迟不置位会在回调中无上限等待；大 FC03／FC04／FC10、连续 SSI 坏帧和多串口同时满载会放大 ISR 占用。

</div>

</div>

#### 当前 ISR 执行链

- **UART5：**停 DMA／取长度后直接进入 CRC、地址、FC03／04 投影、FC10 候选解析及可能的 TMC SPI 硬件应用，再启动 TX DMA。
- **HART：**USART2 IDLE ISR 直接解析、打印和组包；TX 回调 `while(TC未置位)` 无超时，随后执行 180000 次 NOP 才切回接收。
- **SSI：**DMA 完成回调直接解析，错误路径同步记录重试／打印并立即重启 DMA；TIM1 回调也可直接启动 DMA。
- **扭力／TIM4：**UART4 ISR 取值、滤波并更新恢复日志；TIM4 ISR 执行继电器状态计算、GPIO、AO 请求和无条件喂狗。

#### 根因、影响与整改

**根因：**DMA／IDLE 完成被当作业务任务入口，缺少帧所有权队列、双缓冲与前台事件层；方向切换用忙等补时序，日志 API 也没有 ISR 安全边界。

**影响：**ISR 时间随寄存器数量、命令和错误日志变化，推迟其它 UART／DMA／TIM，造成丢帧、采样抖动和位置／扭力更新延迟；TC 异常可永久卡在中断，最坏时序不可证明。

**第一阶段：**UART5／USART2／UART4 ISR 仅冻结 length、tick、buffer index 并投递事件，采用 ping-pong buffer 立即重启接收；SSI ISR 只复制固定 4 字节和状态。所有解析、日志、硬件应用和重试移到前台。

**第二阶段：**删除 TX 回调中的无界 while／NOP，改用 UART TC 中断、硬件 DE 或一次性定时器完成方向切换，并为异常设置有限截止。

**完整方案：**统一 SPSC 事件队列、溢出计数和背压；协议任务按优先级／截止期运行；静态门禁禁止 ISR 可达 `printf／ErrorLog／HAL_Delay／FRAM／同步 SPI`，继电器计算移前台，只在中断提交必要的原子 GPIO。

#### 状态和兼容

保持线上帧与响应期限不变时无需升共享协议；若新增 busy／重试响应则更新协议。队列溢出、DMA 重启和 TC 超时应进入通信诊断计数或现有具体错误，ISR 不直接覆盖全局最终故障。

<div class="table-scroll">

| 负载／故障 | 预期 | 证明方式 |
|----|----|----|
| FC03／04 1、125；FC10 123 | ISR 固定短时 | DWT／GPIO 测平均、99.9% 和最大值。 |
| HART 最大帧／TC 不置位 | 有限退出 | 无中断永久等待。 |
| SSI 连续坏帧／恢复 | 日志不占 ISR | 事件队列可追踪。 |
| UART2／4／5／SPI5 满载 | 无 DMA 覆盖和业务丢帧 | 队列满策略和 CRC／BCC 保持。 |

</div>

**证据：**`stm32f4xx_it.c:331-360,366-404,423-468,505-510`、`usart.c:48-93`、`hart.c:116-193,206-250`、`AS5145.c:101-140,194-224,232-283,337-370`、`hostcommu.c:192-330`、`hostcommu_modbus.c:207-399`、`relay_output.c:565-671`。静态确认非恒定业务和无界等待；未用 DWT／逻辑分析仪量化现场时序。

</div>

<div class="issue-head">

### C-21 DSM 小于 30 pF 的水电容映射（产品特殊处理）

<span class="badge p3">已关闭 · 不整改</span>

</div>

<div class="evidence">

**现行决定：**传统 DSM 水测量链的 `<30.0 pF → 99999.9 pF` 是已确认的产品特殊处理，不作为缺陷修改，也不得顺带清理 `zero_cap`。原 DSM-CUBE-01 结论已由 F-18 取代。

</div>

**边界：**该口径只适用于传统 `DSM_SENSOR` 的 Cl 水电容链；`SAFE_SENSOR` 不经过该转换。调用方必须按现有产品语义解释，不得把该数值推广为通用无效值契约。

**维护要求：**冻结适用版本、触发阈值和消费链；任何改变必须先取得新的产品决定，再评估历史 FRAM 与回归影响。

**验证边界：**用 3.3、29.9、30.0、30.1 pF golden frame 确认阈值两侧保持既定产品行为，并证明没有误改其它传感器类型。

历史分析校正：产品特殊处理的适用范围与回归边界

<div class="analysis-body">

<div class="analysis-grid">

<div class="analysis-panel">

**当前结论**已关闭／不整改。仅传统文本协议 `DSM_SENSOR` 的 Cl 水电容链采用该产品特殊处理；`SAFE_SENSOR` 不经过该转换，不能笼统扩大范围。

</div>

<div class="analysis-panel">

**直接触发**传统 DSM 返回 BCC 和 CRLF 均正确、D／E 格式合法且真实数值小于 30.0 pF 的 11 字节 Cl 响应；触发后按既定产品口径映射。

</div>

</div>

#### 当前执行链

1.  `Sensor_ReadWaterCapacitance()` 调用 `Read_Water_Capacitance()` 完成协议事务。
2.  合法 D／E、BCC、CRLF 响应先被正确解析成真实 pF 数值。
3.  解码函数随后把任何 `<30.0` 的值静默改为 `99999.9`，仍返回 `NO_ERROR`。
4.  该值可继续写入 `zero_cap`，被水／空气判断、方向选择和后续测量算法消费。

#### 根因、影响与整改

**产品口径：**该阈值与映射已被确认是有意行为，不能再以“缺少来源”为由删除；本条只记录其适用范围和消费边界。

**兼容影响：**现场参数、零点和算法已按该映射运行；擅自恢复原始低值会改变历史设备行为并可能造成跨版本不一致。

**当前动作：**保持 `<30 → 99999.9` 和现有 `zero_cap` 行为，不做代码清理或数据迁移。

**后续变更条件：**只有新的产品决定明确替代语义、迁移方案和回归矩阵后，才允许另立变更项；通用字段质量治理继续由 C-25 处理，但不得借此改写本条行为。

#### 错误和兼容

合法低值按产品语义映射后继续返回 `NO_ERROR`；真正的帧形状或 BCC 异常仍返回既有具体错误。若未来改变映射或持久化结构，必须同步评估 CPU2／CPU3、现场历史值和迁移版本。

<div class="table-scroll">

| 输入 | 预期 | 检查点 |
|---|---|---|
| 3.3／29.9 pF | 映射为 99999.9 pF | 保持既定产品行为。 |
| 30.0／30.1 pF | 原值交付 | 阈值边界符合现行实现。 |
| D／E 合法格式 | 数值一致 | 单位和符号正确。 |
| 坏 BCC／短帧 | 明确错误 | 不更新值和时间戳。 |
| 历史 `zero_cap` | 原样保留 | 不执行清理或迁移。 |

</div>

**证据：**`dsm_sensor_communication.c:761-802`、`sensor.c:749-759`、`measure_waterLevel.c:683-699,708-745`。源码确认数值改写与消费链；2026-07-23 总账复核已按当前产品决定转入 F-18。

</div>

<div class="issue-head">

### C-22 DSM 版本、帧边界、ACK 和模式成功判定仍未形成定长事务契约

<span class="badge p1">P1 · 仍存在</span>

</div>

<div class="evidence">

**原因与证据：**尚未执行 `Cv/CV` 版本识别，现有 LF 截帧无法接收 6 字节无 CRLF 版本帧；任意 LF 都会结束接收，BCC 为 `0x0A` 时提前截帧；ACK、密度、频率、编号和陀螺仪缺命令级严格形状校验；`CB/CD` ACK 被 CUBE 当成模式成功。

</div>

**影响：**控制字符 BCC、短帧、错事务 ACK 或未知维护线可能形成伪成功；DSM CPU1 的 `CB/CD` 路径还存在空指针 HardFault 上游风险。

**整改方案：**先查询版本并选择能力矩阵；按命令固定长度接收，完整校验后才更新状态；模式成功必须以 CPU1 内部结果成功为准。

**来源：**[DSM 复查 DSM-CUBE-02～05](2026-07-18_DSM传感器协议适配复查.md)；同时需要 DSM CPU1 端修复与 golden frame。

完整分析：版本能力、定长收帧、ACK 与模式完成语义

<div class="analysis-body">

<div class="analysis-grid">

<div class="analysis-panel">

**当前结论**总体仍为 P1，需拆成四个子项：模式伪成功和版本／能力选择为 P1；LF 截帧及形状／重试设计为 P2。不能把 ACK 等同于物理模式已就绪。

</div>

<div class="analysis-panel">

**直接触发**维护线版本不同、6 字节无 CRLF 的版本响应、BCC 恰为 `0x0A`、短／错形状响应，或 CPU1 接受 `CB／CD` 后内部执行失败。

</div>

</div>

#### 当前执行链与四个缺口

1.  启动只用 `CN` 探测，未通过 `Cv／CV` 选择版本／能力矩阵，随后直接发送 `CD`。
2.  UART6 把遇到的首个 LF 当帧尾：6 字节无 CRLF 版本帧无法收齐，11 字节数据帧若 BCC=`0x0A` 也会提前结束。
3.  `CB／CD／CL` 只要响应中含 `%` 就可通过；没有对长度、CRLF、字段范围和命令上下文逐项验证。
4.  部分形状错误在通用重试层之后才暴露，不能触发正确的本事务重试；CPU1 的 ACK 只表示收到命令，CUBE 却将其当成模式已成功。

#### 根因、影响与整改

**根因：**串口结束条件、命令响应形状、能力选择和业务完成语义没有统一事务描述；接收器按分隔符猜帧而不是按命令契约收帧。

**影响：**合法控制字符会被误判帧尾，错事务 ACK／短帧可形成伪成功，不兼容维护线可能继续运行；模式未真正完成时后续测量语义错误。DSM CPU1 的 CB／CD 空指针路径还需上游独立修复。

**第一阶段：**引入 `DsmTransactionSpec`，至少包含命令、允许长度、CRLF 策略、BCC 位置、超时和重试条件；按已知长度收齐后再校验。ACK 必须精确为 `%\r\n`，只表示受理。

**第二阶段：**启动查询 `Cv／CV`，按明确版本／能力矩阵选择命令；模式切换完成必须通过 CPU1 明确结果或可验证的新状态／新数据确认。

**完整方案：**UART6 由单一事务引擎所有，统一完成排空、发送、按 spec 收帧、形状／BCC 校验、重试和取消；DSM CPU1 同步修复 CB／CD 内部结果上报。

#### 错误、状态和协议

优先复用 `SENSOR_PROTOCOL_VERSION_INCOMPATIBLE`、`SENSOR_MODE_NOT_READY`、`SENSOR_COMMAND_UNSUPPORTED`、`SENSOR_CAPABILITY_UNSUPPORTED`、`SENSOR_RESP_FORMAT_ERROR`、`SENSOR_BCC_ERROR`。如这些码已在共享表中，仅激活无需新增编号；改变 CPU1 对外响应语义则需维护线协议与兼容矩阵同步。

<div class="table-scroll">

| 用例 | 预期 | 关键检查 |
|---|---|---|
| 6 字节版本帧无 CRLF  | 按定长完整接收  | 能力矩阵选择正确。 |
| 11 字节帧 BCC=0x0A | 不提前截帧 | BCC 位按 spec 解析。 |
| `%\r\n`／含 % 的杂帧 | 仅精确 ACK 通过 | 不把受理当模式完成。 |
| 短帧／错形状／坏 BCC | 本事务有限重试  | 最终返回具体错误。 |

</div>

**证据：**`app_main.c:133-135`、`sensor.c:223-255,284-351`、`dsm_sensor_communication.h:14-27`、`dsm_sensor_communication.c:191-255,342-432,437-504,533-602,605-676,696-746,838-874`。静态审查可确认当前契约缺失；CPU1 真实模式完成时序和跨版本兼容需 golden frame 与联机台架。

</div>

<div class="issue-head">

### C-23 DSM 失败恢复、UART6 排空和供电／冷唤醒诊断语义仍不完整

<span class="badge p2">P2 · 部分存在</span>

</div>

<div class="evidence">

**原因与证据：**`Cb` 可能用旧值／默认值掩盖 CPU0 本次失败；UART6 drain 只等待连续空闲 5 ms，没有总超时和命令切换出口；`CK` 的 `e/E` 日志和数据质量语义不完整；V5.4 正常 `Ch` 冷唤醒首轮 500 ms 超时会打印通信错误。

</div>

**影响：**旧结果、持续噪声和协议允许的冷启动等待可能分别造成伪数据、前台卡住或现场错误日志噪声。

**整改方案：**解析失败纳入本次事务重试；drain 增加总时限／取消；供电状态写入质量语义；对 V5.4 首轮冷唤醒使用普通诊断而非最终错误。

**来源：**[DSM 复查 DSM-CUBE-06～09](2026-07-18_DSM传感器协议适配复查.md)。

完整分析：排空无总截止、旧值新鲜度与冷唤醒诊断

<div class="analysis-body">

<div class="analysis-grid">

<div class="analysis-panel">

**当前结论**部分存在且风险不同：UART6 排空无总超时／取消为已确认 P2；Cb 旧值问题主要源于 DSM CPU1；CK 供电语义和 V5.4 首次冷唤醒日志为当前无生产调用或诊断噪声的 P3 子项。

</div>

<div class="analysis-panel">

**直接触发**UART6 连续每小于 5 ms 到来一个噪声字节；CPU1 本次 Cb 失败但返回旧／默认频率；或 V5.4 冷启动 `Ch` 首次需要超过 500 ms。

</div>

</div>

#### 当前执行链与证据边界

1.  每个 UART6 命令先调用 `UART6_DrainRX_UntilIdle(5)`；每收到一个字节都会重置空闲计时。
2.  排空没有总截止、命令切换检查或错误返回，持续噪声可在真正发命令前永久占住前台。
3.  Cb 结果没有“本请求代际／新鲜度”语义，上游 CPU0 失败时可能看到旧／默认频率；该修复不能只在 CUBE 端猜测。
4.  CK 把 `E／e` 作为低电压日志但仍以数值成功返回，当前无生产调用；V5.4 合法冷唤醒的首次超时会被记成错误重试。

#### 根因、影响与整改

**根因：**排空只定义“连续空闲”而没有事务总预算；值、质量和新鲜度混在一个返回值中；协议允许的冷启动阶段与最终失败使用同一日志级别。

**影响：**持续噪声可阻塞所有后续传感器事务；旧值被误认为本次结果；合法冷启动产生错误日志噪声，CK 若未来启用则无法表达低压质量。

**第一阶段：**让 drain 返回状态，同时具有 idle deadline、total deadline、`STATE_SWITCH` 和 UART 错误出口；任何退出路径清理 DMA／接收状态。

**第二阶段：**Cb 由 DSM CPU1 返回每请求结果或 generation／freshness；CK 把数值与供电质量分开；V5.4 已知的首次唤醒等待记为普通诊断，只有后续失败升级为重试错误。

**完整方案：**与 C-22 合并为 UART6 单所有者事务引擎；每个命令的排空、冷启动预算、重试、取消和质量输出都由 spec 管理。

#### 错误和状态

排空总超时应返回明确 UART／事务超时，不得静默继续；命令切换透传 `STATE_SWITCH`。Cb／CK 使用 `{value, valid, quality, generation}`，上一次成功值只能作为带 STALE 标记的诊断缓存，不能伪装本次成功。

<div class="table-scroll">

| 用例 | 预期 | 关键检查 |
|----|----|----|
| 持续噪声／每 4 ms 一字节 | 总时限内退出 | 主循环可继续，DMA 状态干净。 |
| 排空中命令切换 | 立即返回 STATE_SWITCH | 不再发送旧命令。 |
| Cb 本次失败但有旧值 | 返回失败或 STALE | generation 不冒充更新。 |
| V5.4 冷唤醒首轮超时 | 按能力矩阵继续 | 成功后不留下最终错误。 |

</div>

**证据：**`dsm_sensor_communication.c:32-46,71-90,191-255,342-356,437-504,508-530,627-647,838-874`。drain 无总截止可静态确认；Cb 的旧值来源、CK 实际用途和 V5.4 冷启动时间需 CPU1 源码／联机记录验证。

</div>

<div class="issue-head">

### C-28 国标密度筛点阈值仍是 TODO 占位；SI 100 阈值待契约确认

<span class="badge p2">P2 · 部分存在</span>

</div>

<div class="evidence">

**原因与证据：**国标路径仍使用局部 `oil_standard_th = 100`，旁有“替换为实际参数”TODO，当前参数结构中又未找到权威 `Oil_Standard` 字段。SI 的 `100.0f` 与现有需求“实际密度小于 100 判空气”一致，单凭硬编码不能判错。

</div>

**影响：**国标筛点规则缺少可追溯的产品／规范来源，若现场介质要求不同，可能误删或漏删测点并改变平均值；SI 仅在需求、单位或阈值将来变化时有治理风险。

**整改方案：**先冻结国标阈值单位、来源和默认值；若规范固定为 100，改为语义化常量并加契约测试；若需要配置，再接入唯一参数源和完整迁移链。SI 100 暂保留并补需求引用。

**验证边界：**未取得 `Oil_Standard` 权威参数定义／计量规范，不能把 SI=100 定性为缺陷。

完整分析：已确认的国标占位与未证实的 SI 常量风险

<div class="analysis-body">

<div class="analysis-grid">

<div class="analysis-panel">

**当前结论**部分存在，P2。C-28A 国标筛点阈值仍为 TODO 占位可确认；C-28B SI 空气阈值 100 与现行需求一致，只能列为待产品确认，不能直接算代码缺陷。

</div>

<div class="analysis-panel">

**直接触发**国标密度测量进入 `GB_FilterPoints_ByDensity20()` 后处理；SI 点的实际密度位于 100 边界附近。

</div>

</div>

#### 当前执行链

1.  国标路径在 `Density_MeasureByMode_Exact()` 后把局部 `oil_standard_th=100` 传入筛点逻辑，注释仍要求替换为实际参数。
2.  当前 `g_deviceParams` 未找到对应权威字段，因此该 100 的单位、来源、默认值和可配置性无法由代码闭环。
3.  SI 路径以 `SI_PROFILE_AIR_DENSITY_THRESHOLD=100.0f` 区分空气；已有需求明确同一判据，因此“硬编码”本身不等于行为错误。

#### 根因、影响与整改

**根因：**国标算法代码先落地了占位阈值，但产品参数模型和规范引用未同步；SI 虽有需求，却缺少就地来源注释和边界契约测试。

**影响：**国标在不同介质／标准下可能误删或漏删点并改变平均密度；SI 当前无已证实偏差，风险仅在需求或单位变化后常量漂移。

**第一阶段：**由产品／计量规范冻结国标阈值的物理量、单位、适用模式和固定／可配属性。若固定为 100，改为命名常量并引用规范；若已有权威参数，改为从唯一运行态入口读取。

**完整方案：**只有确需可配置时才新增参数校验、默认值、版本迁移、CPU3 菜单／读写和 A/B 存储；避免为尚未证实的配置需求扩大共享协议。

#### 状态和兼容

常量治理不需新错误码或协议升级。新增共享持久化参数才需 CPU2／CPU3 同步并评估 `DEVICE_PROTOCOL_VERSION／DEVICE_PARAM_VERSION`；非法参数应在保存事务入口拒绝，不在测量中静默替换。

<div class="table-scroll">

| 用例 | 预期 | 判据 |
|---|---|---|
| 国标阈值 99／100／101  | 筛点符合冻结规则 | 边界含等号语义明确。 |
| 3／4／5 点及删点后平均 | 有效点数和均值正确 | 全删时明确失败。 |
| 正／反测量顺序 | 筛点结果与顺序无关 | 点来源可追溯。 |
| SI 99.99／100／100.01  | 符合现行需求 | 单位和实际密度口径一致。 |

</div>

**证据：**`measure_density.c:374-384,927-938,1300-1317,1974-2056`；需求 `2026-06-11_瓦锡兰分布测量点间移动与慢速下行识别液位优化需求方案.md:297`。源码能确认国标 TODO，不能在缺少计量规范时断言正确阈值。

</div>

<div class="issue-head">

### C-29 HART 接收长度未进入解析契约，未知命令仍会继续生成非标准响应

<span class="badge p1">P1 · 仍存在</span>

</div>

<div class="evidence">

**原因与证据：**`HartCommunicationProcess()` 没有接收本帧长度参数；`AnalyseRcvPackage()` 直接按帧内 `BytesCount` 访问 BCC 和数据，却不证明 `USART2_RX_LEN` 足够。未知命令的 `default` 只打印，随后仍对零长度／旧发送区执行短地址转换、BCC 和前导码处理。位置：`LTD_MAIN_CPU2/Services/Hart/hart.c:116-252`。

</div>

**影响：**短帧、伪造 byte count 或未知命令可能读取本帧之外的旧 DMA 数据并形成不可预测响应；HART 主站难以区分不支持命令、坏帧和正常设备响应。

**整改方案：**把实际接收长度传入解析器，按长／短帧最小长度、byte count、BCC 位置和接收上限逐项校验；未知命令返回规范状态码，禁止继续使用未初始化的响应长度。

**验证边界：**覆盖 0～最大长度、byte count 0／越界、缺 BCC、长短地址、未知命令和连续短帧污染场景。

完整分析：实际长度缺失、8 位截断与未知命令 0 长度回绕

<div class="analysis-body">

<div class="analysis-grid">

<div class="analysis-panel">

**当前结论**仍存在，P1。除解析 API 不接收实际长度外，512 字节 DMA 缓冲配 `uint8_t USART2_RX_LEN` 会截断；短地址未知命令还可把 0 长度减 4 回绕为 252。

</div>

<div class="analysis-panel">

**直接触发**截断帧、帧内 byteCount 大于实收、256 字节以上接收、未知命令，尤其是短地址未知命令。

</div>

</div>

#### 当前执行链

1.  USART2 IDLE ISR 计算接收长度，但调用 `HartCommunicationProcess()` 时不传本帧实际 length／capacity。
2.  `AnalyseRcvPackage()` 信任帧内 `BytesCount` 定位数据和 BCC，无法证明索引仍在本次 DMA 数据内。
3.  DMA 缓冲为 512 字节而长度变量仅 8 位，255 以上会截断。
4.  未知命令 default 只打印，`Sendlen` 保持 0；短地址转换把 `uint8_t datalen -= 4` 回绕为 252，随后读取旧 TX 区组装异常响应。
5.  长地址未知命令也继续在未初始化候选区计算 BCC 和前导码。

#### 根因、影响与整改

**根因：**解析 API 没有 rx_len／capacity，长度类型不足；帧验证、命令分派和响应构造耦合，未知命令没有终止语义或独立 TX 候选。

**影响：**读取本帧之外的旧 DMA／TX 数据，生成异常响应或静默，外部 HART 主站无法区分坏帧、不支持命令和正常响应；C-14 还会把整条风险链放在 ISR。

**第一阶段：**API 显式传 `size_t rx_len／capacity`，长度变量改 `uint16_t／size_t`；按 delimiter、长／短头、最小／最大长度、byteCount、BCC 下标与实收长度完全一致校验。

**第二阶段：**未知命令立即构造目标 HART 版本规定的“不支持命令”响应或按契约静默，禁止继续用 0 长度组包；每帧使用清零的独立 TX candidate，并在每次 append 前检查容量。

**完整方案：**ISR 只投递 frame+length，前台 parser 返回 `OK／BAD_FRAME／BAD_BCC／WRONG_ADDRESS／UNSUPPORTED`，response builder 只接受验证后的解析结果。

#### 协议和版本

这是外部 HART 行为修复，不改 CPU2／CPU3 共享布局；CPU2 功能版本需记录。具体 Response Code 必须按目标 HART 版本和主站契约确认，不能在整改文档中凭空写死。

<div class="table-scroll">

| 帧 | 预期 | 关键检查 |
|----|----|----|
| byteCount 0／合法最大／声明超实收 | 严格形状裁决 | BCC 下标不越界。 |
| 128／255／256／511 字节 | 长度不截断 | 容量上限生效。 |
| 未知命令长／短地址 | 规范 unsupported 或静默 | 不读取旧 TX 缓冲。 |
| 连续坏帧后好帧 | 帧间隔离 | 候选区无污染。 |

</div>

**证据：**`stm32f4xx_it.c:366-401`、`hart.c:116-193,206-258,443-476`、`usart.h:54-58`、`usart.c:37-40`、`hart.h:48-73,140-148`。静态确认契约缺口；未用 HART 主站／示波器复现具体现场表现。

</div>

<div class="issue-head">

### C-30 UART4 扭力帧只按长度取固定字节，没有帧头、来源或校验门禁

<span class="badge p1">P1 · 仍存在</span>

</div>

<div class="evidence">

**原因与证据：**`UART4_UpdateWeightFromFrame()` 只要求接收长度大于 20，随后固定取第 19／20 字节更新扭力并调用 `Weight_MarkFrameReceived()`；没有校验帧头、固定总长、地址、功能码、校验和或 CRC。位置：`LTD_MAIN_CPU2/Core/Src/stm32f4xx_it.c:42-79,423-442`。

</div>

**影响：**噪声、错位帧或任意 21 字节以上数据都可能刷新“通信新鲜”时间并进入碰撞保护，既可能误停，也可能用错误扭力掩盖真实碰撞。

**整改方案：**冻结扭力模块正式帧格式；只有完整通过帧头、长度、地址／类型和校验的数据才更新扭力与新鲜时间，坏帧只累计诊断并保持上一有效值。

**验证边界：**需要真实模块 golden frame、错一字节、插删字节、噪声、粘包、半帧和超时恢复测试。

完整分析：任意长帧刷新扭力与通信新鲜度

<div class="analysis-body">

<div class="analysis-grid">

<div class="analysis-panel">

**当前结论**仍存在，P1。任意 21 字节以上数据都可更新碰撞输入并刷新“合法帧”时间；512 字节缓冲配 8 位长度还存在 256／512 截断。

</div>

<div class="analysis-panel">

**直接触发**UART4 收到噪声、错位、半帧／粘包、校验错帧或任意长度≥21 的字节流；持续发送即可一直掩盖通信超时。

</div>

</div>

#### 当前执行链

1.  UART4 以 19200／8N1、512 字节 DMA 接收，IDLE 中断计算长度。
2.  `UART4_UpdateWeightFromFrame()` 只检查 `rx_len>20`，固定取字节 19／20。
3.  该值直接更新 `g_weight／current_weight`，再无条件调用 `Weight_MarkFrameReceived()`。
4.  新鲜时间被刷新；若当前只有 `WEIGHT_COMM_TIMEOUT`，还会直接清成 `NO_ERROR`。8 位 length 在长接收时可截断。

#### 根因、影响与整改

**根因：**仓库没有可执行的正式帧契约门禁，“收到足够字节”被等同为“收到合法称重帧”，长度类型和流式重同步也未设计。

**影响：**伪扭力参与碰撞保护，可能误停或漏停；持续坏帧保持链路健康并清除超时，和 C-09 一起形成陈旧／错误值的安全窗口。

**第一阶段：**先冻结供应商正式帧格式；解析器校验帧头、精确长度、来源／类型和校验，返回成功或具体失败。只有成功帧更新重量并调用 `Weight_MarkFrameReceived()`，length 改 16 位以上。

**完整方案：**ISR 仅投递 RX 事件，前台流式 parser 处理半帧、粘包和错位重同步；维护 last-valid weight、timestamp 和 quality，碰撞保护对 stale／invalid 采用经风险评审的 fail-safe。

#### 错误和兼容

`WEIGHT_COMM_TIMEOUT` 可定义为“超时内没有收到合法帧”；坏帧只计诊断，不刷新有效时间、不清全局其它错误。若新增共享校验错误码需同步 CPU3 故障表并评估协议升级。

<div class="table-scroll">

| 输入 | 预期 | 安全判据 |
|---|---|---|
| 真实合法帧 | 更新值和 generation | 允许恢复本模块超时。 |
| 20／21／22 字节噪声 | 全部拒绝 | 时间戳不刷新。 |
| 单比特错／插删／半帧／粘包 | 拒绝或正确重同步 | 不更新碰撞输入。 |
| 持续坏帧超过 1 秒 | 报告通信超时 | 不得被坏帧清除。 |

</div>

**证据：**`stm32f4xx_it.c:42-80,420-446`、`usart.c:113-139`、`usart.h:60-62`、`weight.c:78-109,117-149`。仓库未找到正式扭力帧协议，不能猜帧头或校验算法；需真实模块帧与碰撞台架。

</div>

<div class="issue-head">

### C-31 LTD/V2传感器0xFF粗粒度失败已映射为明确错误

<span class="badge p1">P1 · 代码已整改，待台架</span>

</div>

<div class="evidence">

**整改与证据：**正式传感器协议卷把LTD/V2的`0xFF`定义为粗粒度失败。CPU2 V1.32已修改`DSM_V2_CheckReply()`：当`rx[6] == 0xFF`时返回`SENSOR_REMOTE_INTERNAL_ERROR`，由模式切换、浮点读取和整数读取入口进入既有限次重试及最终故障传播；失败帧不得继续解析`rx[2..5]`或发布模式切换成功。

</div>

**当前影响：**已封堵已知软件伪成功路径；剩余风险是供应商实机对`0xFF`的具体语义、三类命令实际重试次数以及最终错误传播尚未完成台架复核。

**后续方案：**不再扩大代码改动；用真实设备或主机故障注入确认模式切换、浮点读、整数读均保持旧值、不发布完成状态，并最终形成13-38。

**验证边界：**已有静态契约和clean-first构建证据；仍需真实链路覆盖三类`0xFF` golden frame、三次重试、最终13-38、旧值保持和后续恢复。

完整分析：远端明确失败的软件路径已关闭，保留台架验收

<div class="analysis-body">

<div class="analysis-grid">

<div class="analysis-panel">

**当前结论**代码已整改、待台架，P1。源码已把第7字节`0xFF`作为明确远端失败处理，不再返回`NO_ERROR`；静态和构建证据不能替代真实传感器验收。

</div>

<div class="analysis-panel">

**直接触发**LTD／V2 对模式切换、浮点参数读或整数参数读的任一固定 8 字节事务返回 `rx[6]==0xFF` 且帧校验和正确。

</div>

</div>

#### 当前执行链

1.  主机发送固定 8 字节请求，接收器先验证长度、校验和和功能码。
2.  `DSM_V2_CheckReply()`发现`rx[6]==0xFF`时返回`SENSOR_REMOTE_INTERNAL_ERROR`。
3.  模式切换、浮点和整数读取沿原有重试链处理，失败帧不写输出、不发布切换成功。
4.  通用重试层接收明确失败并按既有次数重试；全部失败后向测量层传播错误。

#### 根因、影响与整改

**历史根因：**旧实现把远端“没有细分原因的失败”误当成可接受响应，协议校验只验证传输完整性，没有验证业务结果字段。CPU2 V1.32已修复该偏差。

**当前影响：**已知软件路径不再把失败帧当作新数据或模式完成；若真实设备返回形态与协议卷不同，仍需台架捕获后再评估。

**已完成阶段：**把`0xFF`映射为现有`SENSOR_REMOTE_INTERNAL_ERROR`并进入有限重试；失败帧禁止解析数据、更新模式或刷新有效性。

**完整方案：**若供应商将来提供细分原因，再按设备版本／能力映射 `SENSOR_MODE_NOT_READY／SENSOR_COMMAND_UNSUPPORTED` 等；在只有 0xFF 时不得猜具体原因。

#### 错误和兼容

复用已有共享错误码通常无需升协议；新增编号才需 CPU2／CPU3 故障表同步。传输校验失败、远端业务失败和版本不支持必须保持不同诊断。

<div class="table-scroll">

| 用例 | 预期 | 输出约束 |
|---|---|---|
| 模式／浮点／整数各 0xFF | 明确远端失败 | 模式和输出不变。 |
| 前两次失败、第三次成功  | 成功并记录重试 | 只提交第三帧数据。 |
| 三次均失败 | 返回最终具体错误 | 不发布完成。 |
| 校验错与 0xFF | 分类不同 | 诊断可区分链路／远端。 |

</div>

**证据：**`ltd_sensor_communication.h:13-31`、`ltd_sensor_communication.c:251-325,342-404,421-485,500-567`。当前源码的错误映射和禁止提交路径可静态确认；各命令0xFF的真实设备语义仍需供应商协议／实机确认。

</div>

<div class="issue-head">

### C-32 分布密度单点等待 5 分钟未稳定后仍会计为有效测点

<span class="badge p1">P1 · 仍存在</span>

</div>

<div class="evidence">

**原因与证据：**`SinglePoint_ReadSensorWithStableWindow()` 超时后用最后非零值或 0 填充结果并返回 `NO_ERROR`；普通单点包装器通过 `stable_out` 识别并重试，但分布路径传入 `NULL`，随后无条件累加并递增 `valid`。位置：`LTD_MAIN_CPU2/Application/Src/measure_density.c:417-455,2181-2267,2399-2415`。

</div>

**影响：**未达到稳定条件的兜底值会被当成正式分布点，参与平均密度、点数和完成结果；全程无非零密度时甚至可把 0 当有效点发布。

**整改方案：**让稳定状态成为必填返回值或独立错误码；分布路径只能提交稳定点，超时应按产品策略重试、跳点并标质量，或整轮失败，不能仅凭 `NO_ERROR` 计入有效数。

**验证边界：**覆盖始终抖动、始终为 0、最后一次非零、单点稳定／不稳定混合，以及取消和总体超时。

完整分析：稳定超时返回成功并被分布流程计为有效点

<div class="analysis-body">

<div class="analysis-grid">

<div class="analysis-panel">

**当前结论**仍存在，P1。5 分钟超时并不返回测量失败，分布调用者又丢弃 `stable_out`，因此不稳定／零兜底值会确定性进入 valid 和平均值。

</div>

<div class="analysis-panel">

**直接触发**单点在 5 分钟内持续抖动、始终为 0，或始终无法形成要求的连续稳定窗口；分布流程调用时传 `stable_out=NULL`。

</div>

</div>

#### 当前执行链

1.  `Density_RunPoints01mmWithDwell()` 完成移动／停留后调用 `SinglePoint_ReadSensorWithStableWindow(..., NULL)`。
2.  函数最多等 5 分钟；若未稳定，写入最后一次非零值，若从未非零则写 0。
3.  超时分支仍返回 `NO_ERROR`，稳定性只通过可选 out 参数表达。
4.  分布调用者没有该参数，随后无条件累加温度／密度、`valid++`、计算平均并发布完成。

#### 根因、影响与整改

**根因：**返回码只表示采样循环结束，不表示数据达到稳定质量；关键质量被设计成可选参数，调用者可以无意丢弃。

**影响：**不稳定或 0 兜底点污染分布点数和平均密度，外部无法观察失败；全部点无效时也可能得到成功完成。

**第一阶段：**`stable_out` 改为必填且所有分布调用强制检查，或稳定超时直接返回明确非成功；未稳定点绝不进入 sum／valid。

**完整方案：**产品先确定“整轮失败／有限重试／跳点并标质量”；若允许跳点，结果保存每点 quality 和 reason，全无效返回 `MEASUREMENT_DENSITY_NO_VALID_POINT`，`STATE_SWITCH` 始终原样透传。

#### 错误和协议

现有 `MEASUREMENT_DENSITY_NO_VALID_POINT` 可用于全无效，`DENSITY_INVALID` 可用于值无效；仓库暂无专用稳定超时码。若新增点级质量字段／错误码需同步 CPU3 展示和共享协议，单纯使超时返回失败不改变布局。

<div class="table-scroll">

| 场景 | 预期 | 结果约束 |
|---|---|---|
| 始终抖动／始终 0 | 不计有效点 | 不得发布成功均值。 |
| 最后一次非零但不稳定 | 保持诊断样本，不提交 | valid 不递增。 |
| 稳定／不稳定混合 | 按冻结策略跳点或整轮失败 | 每点质量可追溯。 |
| 通信失败／命令取消 | 保留原返回 | 取消不转成测量错误。 |

</div>

**证据：**`measure_density.c:397-475,2152-2267,2371-2415`，错误码 `system_parameter.h:256,305-312`。静态确认不稳定点被提交；5 分钟路径可用 tick／传感器桩加速测试，现场策略仍需产品裁决。

</div>

<div class="issue-head">

### C-33 部分密度流程仍忽略传感器模式切换失败

<span class="badge p1">P1 · 仍存在</span>

</div>

<div class="evidence">

**原因与证据：**`Density_MeasureByMode_Exact()` 在找液位成功后直接调用 `EnableDensityMode()` 而不检查返回值；综合测量入口也再次忽略该返回值，随后继续规划测点和读数。位置：`LTD_MAIN_CPU2/Application/Src/measure_density.c:870-909`、`Application/Src/measure.c:1191-1226`。

</div>

**影响：**传感器可能仍停留在液位模式，错误被延迟到读数阶段甚至得到语义错误的数据；重复调用还增加流程耗时和本次失败归属不清。

**整改方案：**模式切换只保留一个责任入口并强制检查结果；失败立即停止测点流程、保持原错误码并禁止发布完成沿。

**验证边界：**注入模式切换超时、坏 ACK、`0xFF` 失败、命令切换和第二次调用成功／失败组合。

完整分析：两处裸调用、重复切换与首错被后续成功掩盖

<div class="analysis-body">

<div class="analysis-grid">

<div class="analysis-panel">

**当前结论**仍存在，P1。全仓确认有两处生产裸调用；综合流程还重复寻找液位和切模式，模式保障责任分散。

</div>

<div class="analysis-panel">

**直接触发**第一次或第二次 `EnableDensityMode()` 返回超时、坏 ACK、LTD `0xFF` 或 `STATE_SWITCH`，尤其前一次失败而后续点内重试成功。

</div>

</div>

#### 当前两条执行链

1.  **精确密度：**`Density_MeasureByMode_Exact()` 找液位成功后裸调用模式切换，不论结果继续规划／移动；每个点内部又切一次且检查。
2.  **综合测量：**入口先找液位、裸切模式，再调用精确密度；后者重复找液位、裸切模式，点读取又再次保证模式。
3.  后续一次成功可掩盖第一次失败，导致错误归属延后；命令切换也可能被继续执行的流程消耗。

#### 根因、影响与整改

**根因：**模式保障责任同时落在业务入口、流程路由和单点读取层，两处返回值被丢弃，也没有统一“保留首个失败”规则。

**影响：**模式未切成功仍可能开始规划和运动；失败被后续成功掩盖，数据可能来自错误模式，重复外设事务增加耗时和命令切换窗口。

**第一阶段：**两处立即保存并检查 ret：`STATE_SWITCH` 原样返回，其它失败停止流程，禁止规划、运动和完成发布。

**完整方案：**选择唯一责任模型。建议由 `Density_MeasureByMode_Exact()` 负责一次找液位和一次切模式且强制检查，底层点读取只读；综合入口删除重复 Search／Enable。若改为每点自保证，上层就完全不得再调用。

#### 错误和兼容

保留传感器返回的首个具体错误；`STATE_SWITCH` 是正常打断，不设置故障。仅修复控制流无需升协议，除非新增运行状态或错误码。

<div class="table-scroll">

| 注入 | 预期 | 关键观测 |
|---|---|---|
| 超时／坏 ACK／0xFF | 立即失败 | 无运动、无点数、无完成沿。 |
| STATE_SWITCH | 正常取消 | 不改全局错误。 |
| 第一次失败、第二次可成功 | 不得进入第二次 | 首错保持。 |
| 传统 DSM／SAFE／LTD | 每条路径责任唯一 | 统计切模式调用次数。 |

</div>

**证据：**`measure_density.c:870-925,2152-2173`、`measure.c:1191-1236`、`sensor.c:373-383`。全仓裸调用仅位于 `measure_density.c:885` 与 `measure.c:1212`；真实错模式是否产出看似合理数据需传感器台架。

</div>

<div class="issue-head">

### C-34 CPU2 板间 Modbus 地址 0 仍会执行并以本机地址回包

<span class="badge p2">P2 · 仍存在</span>

</div>

<div class="evidence">

**原因与证据：**CPU2 `SlaveCheckAddress()` 同时接受配置站号和地址 0，后续 FC03／FC04／FC10 响应均使用 `SlaveAddress` 组帧，没有广播静默分支。位置：`LTD_MAIN_CPU2/Services/Modbus/hostcommu_modbus.c:49-55,173-185,218-257,358-372`。

</div>

**影响：**当前 CPU2—CPU3 点对点链路不一定立即冲突，但行为偏离通用 Modbus 广播语义；复用到多节点或误发地址 0 时可能出现非预期读写和回包。

**整改方案：**先冻结板间协议是否允许地址 0；若按 Modbus，广播读静默丢弃，允许的广播写可执行但不得应答；若不需要广播则入口直接拒绝。

**验证边界：**对 FC03／FC04／FC10 分别发送地址 0、配置站号和其它站号，核对执行与响应矩阵。

完整分析：地址 0 被当单播执行并以地址 1 回包

<div class="analysis-body">

<div class="analysis-grid">

<div class="analysis-panel">

**当前结论**代码偏差仍存在，P2。正常 CPU2—CPU3 点对点链路风险较低，因为 CPU3 固定发送 0x01；但向 UART5 注入合法地址 0 帧可真实执行并回包。

</div>

<div class="analysis-panel">

**直接触发**向 CPU2 UART5 发送 CRC 正确、地址 0 的 FC03／FC04／FC10，或地址 0 的非法功能／非法寄存器帧。

</div>

</div>

#### 当前执行链

1.  `SlaveCheckAddress()` 同时接受全局 `SlaveAddress` 和 0，但没有向后传递 `is_broadcast` 属性。
2.  CRC、功能和寄存器门禁通过后，FC03／04 执行读表，FC10 修改 holding array／`g_deviceParams` 并可能请求保存。
3.  所有正常／异常组包器均使用全局 `SlaveAddress=1`；发送层没有广播静默兜底，因此地址 0 请求以地址 1 回包。
4.  CPU3 当前内部主站只发 0x01 且严格校验响应地址 1，所以正常链路不会主动产生该触发。

#### 根因、影响与整改

**根因：**寻址层把 0 当合法请求，却没有区分单播与广播的执行／响应规则；组包器只知道本机全局地址。

**影响：**地址 0 读会执行并回地址 1，地址 0 写会改 RAM／可能落 FRAM 并回包；未来多节点复用或误发广播时会产生总线冲突和非预期副作用。

**推荐最小整改：**若板间契约不需要广播，地址检查只接受固定本机地址，地址 0 静默丢弃，并在正式板间协议写明。

**完整 Modbus 方案：**若确需广播，解析结果携带 `is_broadcast`；广播读静默且不执行，允许的广播写可执行但所有正常／异常分支均不得应答；TX 层增加最终兜底。

#### 错误和兼容

地址不匹配／广播静默属于协议丢弃，不设置整机故障、不返回异常；合法单播保持 0x01／0x02／0x03。冻结地址只能为 1 且不改寄存器布局时可只升 CPU2 功能版本；正式新增广播写能力则需双端协议和版本评估。

<div class="table-scroll">

| 矩阵 | 检查 | 预期 |
|---|---|---|
| 地址 0／1／2 × FC03／04 | 是否执行／是否 TX | 符合冻结的单播／广播规则。 |
| 地址 0／1／2 × FC10 | RAM、FRAM、响应 | 静默写策略无歧义。 |
| 非法功能／地址／坏 CRC  | 异常或静默 | 广播绝不回包。 |
| CPU3 既有轮询写参 | 0x01 全回归 | 行为不变。 |

</div>

**证据：**`hostcommu_modbus.c:50-55,170-193,208-258,263-375`、`hostcommu.c:192-331`、CPU3 `cpu2_communicate.c:16,1488-1493,1855-1884`。静态确认执行／回包及 CPU3 不发 0；未做 UART5 抓包或多节点台架。

</div>

<div class="issue-head">

### C-35 CPU2 通用 FRAM／SPI 驱动可无限阻塞且不能向上层报告阶段失败

<span class="badge p1">P1 · 仍存在</span>

</div>

<div class="evidence">

**原因与证据：**`WriteMultiData()`／`ReadMultiData()` 对 SPI 命令、地址和数据阶段全部使用 `HAL_MAX_DELAY`，返回类型为 `void`，也不检查空指针、负地址或 `start + length` 越界。位置：`LTD_MAIN_CPU2/BSP/Peripherals/src/mb85rs2m.c:112-159`；TMC 通用 SPI 也仍使用 `HAL_MAX_DELAY`。

</div>

**影响：**总线卡死可永久占住前台，而 C-08 的 ISR 喂狗又可能阻止复位；立即返回的 HAL 失败被丢弃，上层只能靠后续内容校验间接发现，地址错误还可能破坏相邻 FRAM 区域。

**整改方案：**统一使用有限超时和分阶段状态返回；校验指针、地址、长度和溢出；参数／位置／编码器存储层必须消费失败并保持最后有效镜像。

**验证边界：**注入命令、地址、数据三阶段超时／失败和边界地址，确认有限时间返回、看门狗恢复、A/B 槽与相邻区域不受污染。

完整分析：FRAM 无返回契约与 TMC SPI 无限等待

<div class="analysis-body">

<div class="analysis-grid">

<div class="analysis-panel">

**当前结论**仍存在，P1。应拆成 C-35A 通用 FRAM 驱动无边界／无结果契约，以及 C-35B TMC SPI 虽能映射错误、但 `HAL_MAX_DELAY` 使标志卡死时永远到不了错误分支。

</div>

<div class="analysis-panel">

**直接触发**SPI4 BUSY／标志卡死、任一 HAL_BUSY／ERROR、MISO 故障、空指针、负地址、0 长、\>65535 长度或跨越 0x40000；TMC SPI 标志永久不完成。

</div>

</div>

#### 当前执行链

1.  参数、编码器和电机位置层调用 `ReadMultiData／WriteMultiData`。
2.  驱动依次执行 WREN、命令、3 字节地址和数据传输，全部使用 `HAL_MAX_DELAY`，忽略每阶段 `HAL_StatusTypeDef`，接口为 void。
3.  上层只能把未初始化／旧缓冲按 magic／version／CRC 解释，或靠写后读回间接发现；即时 I/O 失败无法区分。
4.  编码器／电机保存路径还可能在真实写失败后推进 saved 标记，抑制后续重写；32 位 length 传入 HAL 16 位 size 也可截断。
5.  TMC 驱动已有参数、互斥和错误映射，但底层传输同样用无限等待，卡死时不会返回 `MOTOR_TMC_COMM_ERROR`。

#### 根因、影响与整改

**根因：**底层 transaction 不返回阶段结果、不校验容量／溢出，失败后仍继续下一阶段；无限等待禁用了 HAL 超时。A/B 上层校验只能处理内容损坏，不能替代 I/O 结果。

**影响：**前台永久阻塞且 C-08 可能继续喂狗；I/O 失败被误分类为内容坏并可能触发错误恢复／默认重写；越界污染相邻区域，写失败却更新 saved 代际。

**第一阶段：**FRAM API 改为显式结果、`uint32_t address／size_t length`，校验 null、0 长、\>UINT16_MAX、`address<0x40000` 和 `length<=capacity-address`；各阶段使用有限超时、失败立即短路，所有出口 CS 拉高。

**第二阶段：**上层先消费 I/O 结果：读失败不解析对象，写失败不更新 saved／完成标志；传输成功但读回不一致才用 `PARAM_STORAGE_WRITE_VERIFY_FAILED`。TMC 改为经时序验证的有限超时并沿用现有通信错误。

**完整方案：**抽取已有 `sensor_safe_identity_platform.c` 的 0x40000 容量、100 ms 超时、短路和 CS 释放模板为单一 FRAM transaction；串行化 SPI4，共享给参数、编码器、电机和安全身份，A/B 至少一槽成功才推进代际。

#### 错误、状态和版本

参数存储复用 `PARAM_EEPROM_FAIL／PARAM_STORAGE_WRITE_VERIFY_FAILED`，TMC 复用 `MOTOR_TMC_COMM_ERROR`；不改 FRAM 布局时无需升共享／参数版本，但 CPU2 功能版本需升级。若新增共享“FRAM I/O 失败”码，需同步 CPU3 故障表并评估协议。

<div class="table-scroll">

| 注入／边界 | 预期 | 关键不变量 |
|----|----|----|
| 0、0x3FFFF、0x40000、跨尾、NULL、65535／65536 | 合法有界或明确拒绝 | 无溢出、无相邻污染。 |
| WREN／命令／地址／数据各阶段失败 | 有限时间返回 | CS 高，后续阶段不执行。 |
| A／B 槽四种成功失败组合 | 至少一好槽保留 | 瞬时 I/O 失败不恢复出厂。 |
| 编码器／电机写失败 | saved 不推进 | 总线恢复后可重写。 |
| TMC 永久 BUSY | 通信错误并安全停止 | 与 C-08 联测复位策略。 |

</div>

**证据：**`mb85rs2m.c:11-22,25-77,81-110,112-163`、`system_parameter.c:770-905,990-1065`、`encoder.c:60-129,152-171,200-207,285-326`、`motor_ctrl_position_model.c:1439-1532`、`sensor_safe_identity_platform.c:8-131`、`TMC5130.c:320-383,393-463`。无限等待和错误丢弃可静态确认；未做 SPI 故障注入、断电或逻辑分析仪测试。

</div>

</div>

<div id="current-cpu3" class="section owner-issues">

## CPU3 问题清单

主责范围：CPU2 板间通信、CPU3 本机参数、三路外部 COM、SI、Wärtsilä、对外 DSM Modbus、显示／协议数据投影和工程门禁。

| 优先级 | 数量 | 统一问题编号 |
|---|---|---|
| P0 | 1 | C-20 |
| P1 | 8 | C-15～C-19、C-24、C-25、C-36 |
| P2 | 3 | C-26、C-37、C-38 |
| P3 | 1 | C-27 |

<div class="issue-head">

### C-15 CPU3 单次 CPU2 请求约 1000 ms 同步忙等，断链重试可连续阻塞前台

<span class="badge p1">P1 · 仍存在</span>

</div>

<div class="evidence">

**原因与证据：**`CPU2_CombinatePackage_Send()` 启动 UART5 DMA 后在 `while (wait_response)` 中空转，直到响应中断或约 1000 ms 超时；断链后 `PollingInputData()` 仍按前台周期继续探测。位置：`LTD_DISPLAY_CPU3/Application/app_main.c:927-945,1113-1125`、`Communication/internal/main_board_modbus/cpu2_communicate.c:17,1582-1652,1835-1923`。

</div>

**影响：**CPU2 断链时会造成 OLED、SI 周期任务、外部协议处理和重连逻辑反复出现秒级停顿；三路 COM 的最坏响应时间不可控。

**整改方案：**改为单所有者非阻塞事务状态机；过渡阶段至少对断链探测退避，并让外部请求快速返回 Busy／Unavailable。

**验证边界：**拔掉 CPU2，同时向 COM1～3 发送 10 Hz 请求，量化最大响应、OLED 刷新和重连时间。

完整分析：同步 RPC 执行链、非阻塞改造与并发验证

<div class="analysis-body">

<div class="analysis-grid">

<div class="analysis-panel">

**当前结论**问题仍存在，P1 准确。1000 ms 是单请求超时，不是整个断链期的总上限；持续断链时下一轮探测会再次进入同步等待。

</div>

<div class="analysis-panel">

**影响范围**周期轮询、外部写穿透 CPU2、菜单写参、SI／Wärtsilä命令都复用该同步入口，阻塞的是 CPU3 单一前台，而不只是 UART5。

</div>

</div>

#### 当前执行链

1.  `App_MainLoop()` 在同一前台依次推进 SI、显示、三路外部 COM 和 CPU2 轮询。
2.  `PollingInputData()` 选择一组状态或参数请求，并调用 `CPU2_CombinatePackage_Send()`。
3.  发送函数启动 UART5 DMA、设置全局期望字段和 `wait_response`，随后原地等待。
4.  只有响应中断清标志，或约 1000 ms 到期，调用才返回；等待期间其它前台业务均不推进。
5.  故障锁存后仍会继续探测，形成“约 1 s 阻塞—短暂返回—再次阻塞”的重复空窗。

#### 根因与整改

UART5 已使用 DMA／中断，但上层仍以单一全局标志模拟同步 RPC，没有请求对象、pending 状态、截止时间、回调和断链退避。最小方案是对故障探测分级退避，CPU2 不可用时对外立即返回不可用；完整方案是建立 `IDLE→TX→RX_WAIT→PARSE→DONE/FAILED→BACKOFF` 非阻塞状态机，每轮只推进一步，并让 CPU2 ACK 完成后再唤醒对应外部事务。

#### 兼容与验收

只改变 CPU3 调度、保持共享寄存器和命令格式时不提升 `DEVICE_PROTOCOL_VERSION`；若新增共享事务字段才需要 CPU2／CPU3 同步升版。验收覆盖 CPU2 拔线、迟到响应、CRC／地址／功能／长度错误、参数刷新中读写和协议不匹配，并记录外部响应最大值、OLED 最大帧间隔和重连时间。

<div class="table-scroll">

| 用例 | 期望 | 证明边界 |
|----|----|----|
| CPU2 拔线＋三路 COM 10 Hz | 前台不中断；外部快速返回不可用 | 量化 P99／最大响应，不以中断仍运行代替。 |
| 响应刚好越过截止时间 | 旧响应不污染下一事务 | 检查事务代际和目的缓冲。 |
| 断链后恢复 | 退避后有限时间重连且不请求风暴 | 记录探测频率和恢复时延。 |
| 外部写与周期轮询并发 | 单所有者仲裁，ACK 关联正确 | 不能重入同一 CPU2 事务。 |

</div>

**证据边界：**同步忙等和重复探测可由源码确认；具体 RS485 最坏响应、显示卡顿和重连时间必须在高负荷台架测量。

</div>

<div class="issue-head">

### C-16 CPU3 本机参数仍是单槽覆盖写，掉电时没有最后有效镜像

<span class="badge p1">P1 · 仍存在</span>

</div>

<div class="evidence">

**原因与证据：**参数只有 magic、版本、payload 和 CRC；保存直接覆盖同一 FRAM 槽，完成后才读回。CRC 失败启动路径恢复默认值。位置：`LTD_DISPLAY_CPU3/Application/system_param/cpu3_comm_display_params.c:1258-1292,1299-1418`。

</div>

**影响：**覆盖中断电可同时破坏旧值和新值，导致 COM 协议／波特率、显示、SI 周期和报警阈值整份恢复默认。

**整改方案：**采用 A/B 双槽、generation 和最后提交标记；先写非活动槽并完整读回，再切换有效代际；迁移成功前保留旧槽。

**验证边界：**需要逐字节边界断电、HAL_ERROR／TIMEOUT、各历史版本迁移和保存失败回滚矩阵。

完整分析：掉电事务、A／B 槽设计与迁移矩阵

<div class="analysis-body">

<div class="analysis-grid">

<div class="analysis-panel">

**当前结论**仍存在，P1 准确。C-16 负责“唯一镜像覆盖导致掉电不原子”，与 C-36 的“底层 SPI 可无限阻塞且不返回阶段错误”相关但不重复。

</div>

<div class="analysis-panel">

**受影响数据**同一镜像包含 COM1～3 协议和串口参数、显示、密码、SI 调度和报警阈值；CRC 失败会整份恢复默认。

</div>

</div>

#### 当前执行链

1.  菜单或外部协议调用 `Cpu3Local_WriteValueChecked()`，先修改 RAM 运行态。
2.  `Cpu3_Params_SaveToFRAM()` 生成 magic、V7、payload 和 CRC，并读取 `0x1000` 唯一槽判重。
3.  保存直接覆盖同一槽，写完后才读回；失败时调用方恢复 RAM，并再次“尽力”覆盖旧镜像。
4.  掉电或总线故障期间，旧镜像和新镜像可以同时失去有效性；冷启动只能恢复整份默认。
5.  V3～V6 迁移也会回写同一槽，没有保留可回退的旧代。

#### 根因与完整方案

CRC 只能检错，不能提供原子提交。新槽头建议至少包含 `magic`、存储版本、结构长度、`generation`、payload CRC 和提交标记；保存按“非活动槽未提交头→payload→CRC→完整读回→最后写提交标记”执行，启动扫描两槽并选择已提交且 CRC 有效的最新代。增加 generation 回绕比较、双坏默认原因和 V3～V7 单槽到双槽的可断电迁移。

#### 地址与版本影响

`FRAM_CPU3_PARAM_ADDRESS=0x1000` 与驱动头遗留的 `FRAM_ANGLE_ADDRESS=0x1000` 重名，虽然后者当前无运行调用，布局设计仍应清理或冻结。A／B 槽属于 CPU3 本机存储变化，应提升 CPU3 本地参数版本并提供迁移，不自动提升共享协议。

<div class="table-scroll">

| 用例 | 预期 | 检查点 |
|----|----|----|
| 槽头／payload／CRC／提交标记处断电 | 启动仍选择上一有效代 | 旧槽在新槽提交前不得失效。 |
| A 坏 B 好／A 好 B 坏／双好／双坏 | 选择最新有效代或明确恢复默认 | 记录恢复原因和 generation。 |
| V3～V7 迁移中断电 | 旧布局或新槽至少一份可恢复 | 迁移不得先破坏唯一旧值。 |
| 保存失败后重启 | 运行态和持久化结果一致 | 逐字段复核三路 COM、显示和 SI。 |

</div>

**证据边界：**单槽覆盖和启动回默认可静态确认；真实断电窗口、FRAM 写时序和历史现场数据只能通过逐阶段断电测试证明。

</div>

<div class="issue-head">

### C-17 外部响应单帧 pending 仍可覆盖，普通串口重配可能长期等待

<span class="badge p1">P1 · 部分存在</span>

</div>

<div class="evidence">

**原因与证据：**外部 COM pending 使用单帧槽，新响应可以覆盖旧帧：`LTD_DISPLAY_CPU3/Application/app_main.c:352-398`；串口重配要求三路端口同时空闲，持续流量下没有强制收敛出口：`app_main.c:306-325`。

</div>

**影响：**并发或背靠背请求可能丢失待发响应；高流量现场修改串口参数后可能长期不生效，且缺少可观测状态。

**整改方案：**每端口独立有界队列／事务所有权；重配使用“停止接新请求—排空—切换—复验”状态机并设置总时限。

**边界纠正：**专用“协议切换帧”已经采用目标端口 `PENDING_TX→PENDING_APPLY`，不再要求三口同时空闲；当前长期等待主要指普通菜单串口参数重配。

完整分析：响应覆盖窗口、已改善边界与逐口重配方案

<div class="analysis-body">

<div class="analysis-grid">

<div class="analysis-panel">

**当前结论**部分存在，P1 保留。单帧 pending 和普通菜单重配饥饿仍在；专用协议切换已改为等目标端口最后一帧发送完成后逐口应用，原表述不能再覆盖该路径。

</div>

<div class="analysis-panel">

**可达性边界**代码允许忙时第二个响应覆盖第一个 pending；半双工发送期间接收 DMA 的恢复节奏会影响真实触发窗口，因此发生频率需台架确认。

</div>

</div>

#### 两条真实执行链

1.  **响应覆盖：**每端口只有 `tx_busy`、一个 `pending_len` 和 256 B 缓冲；第一帧等待续发时，第二帧直接重写该槽，发送完成回调只续发最后保留的一帧。
2.  **普通重配：**菜单保存串口参数后置全局 reinit 标志；只有三路端口同时满足接收空闲、发送空闲、pending 为空时才一次性重初始化，持续流量下没有截止时间。
3.  **已改善路径：**协议切换请求等待目标口 TX 完成后进入 APPLY，仅重配该口，不依赖其它两口空闲。

#### 根因与影响

外部响应没有队列或事务所有权，串口参数应用又以“三口偶然同时空闲”代替显式静默／排空协议。背靠背请求因此可能无告警覆盖响应，持续流量则可让普通菜单改参无限期停留在“待应用”，运行配置、保存值和用户看到的设置长期不一致。

#### 整改方案

每端口采用至少 2～4 深度的有界 TX 队列，满时明确拒绝新请求并计数，不能覆盖旧响应。菜单改参和协议切换共用逐口事务状态机：`RUNNING→QUIESCING→DRAINING→RECONFIGURING→VERIFYING／ROLLBACK`；进入静默期后停止接新业务或返回 Busy，排空必须有总时限，并对外／对 UI 发布“待应用、已应用、失败”。

#### 兼容和回归

纯 CPU3 队列与串口重配行为不影响 CPU2 共享协议；如果新增外部可读状态寄存器，则按各外部协议治理。回归覆盖同口背靠背响应、三口并发洪泛、队列满、TX DMA 启动／续发失败、旧／新串口参数交界、协议 ACK 最后停止位后应用，以及 FRAM／HAL 重配失败回滚。

<div class="table-scroll">

| 场景 | 预期 | 关键证据 |
|----|----|----|
| DMA 忙时连续产生两帧响应 | 顺序发送或明确拒绝后一帧 | 不得覆盖前一事务响应。 |
| 三口持续流量下菜单改参 | 目标口有限时间进入静默并完成／回滚 | 其它端口不被无关重配。 |
| 协议切换专用帧 | ACK 完整发完后再应用新参数 | 保持已实现的逐口边界。 |
| 重初始化失败 | 恢复旧配置并发布失败 | 保存值、运行态和硬件串口一致。 |

</div>

**证据边界：**`app_main.c:306-325,352-398` 可静态确认单槽覆盖能力和普通重配无总截止；半双工接收恢复节奏、真实覆盖频率和长流量下的应用时限仍需三口并发台架。

</div>

<div class="issue-head">

### C-18 SI Manual／维护态仍可能启动自动 Profile，且报警抑制未投影到 SI

<span class="badge p1">P1 · 仍存在</span>

</div>

<div class="evidence">

**原因与证据：**`si_modbus_periodic_task()` 到时直接调用 Profile 请求，没有 Manual 门禁：`si_modbus_slave.c:1352-1442`；SI 报警合成未消费 CPU2 已发布的 `manual_alarm_inhibit`：`si_modbus_slave.c:1140-1206`。

</div>

**影响：**自动计划可打断维护／强制操作；Manual 时 PLC 仍可能收到阈值报警，违反当前 SI 操作口径。

**整改方案：**使用 CPU2 权威维护状态阻止自动启动，并只抑制 SI 对外报警投影，不掩盖 CPU2 本机安全故障和继电器保护。

**验证边界：**需覆盖 Manual 跨计划点、RTC 回拨、重启首轮、报警阈值跨越和退出 Manual 后恢复。

完整分析：自动调度互斥、报警投影白名单与产品决策

<div class="analysis-body">

<div class="analysis-grid">

<div class="analysis-panel">

**当前结论**仍存在，P1 准确。应在同一卡片区分 C-18A“自动 Profile 调度缺少 Manual 互斥”和 C-18B“SI 对外过程报警未消费抑制状态”。

</div>

<div class="analysis-panel">

**安全边界**整改只能抑制 SI 对外的过程阈值报警，不得清除 CPU2 真实故障、卷筒报警、继电器保护或本机安全停机。

</div>

</div>

#### 当前执行链

1.  CPU2 已把 `manual_alarm_inhibit` 同步到 CPU3。
2.  `si_modbus_periodic_task()` 到计划时间后检查开关、间隔、RTC 和重复触发，但不检查当前工作模式、命令或抑制状态，随后直接向 CPU2 写入 `CMD_SI_PROFILE`。
3.  SI 离散输入刷新会按密度、温度、液位和 Profile 阈值重新合成报警，也没有消费 `manual_alarm_inhibit`。
4.  因此维护／强制操作可能被新 Profile 请求切换，PLC 在 Manual 期间仍能看到应被抑制的过程报警。

#### 根因与影响

自动调度、操作模式互斥和报警投影分别演进，CPU2 已发布的抑制事实没有成为 CPU3 两条路径的共同门禁。结果是自动 Profile 可打断维护隔离，SI 又对外发布与 Manual 口径冲突的过程报警；若整改误做成全局清错，还会反向掩盖真实安全故障。

#### 整改方案与状态语义

最小方案是在计划触发前要求 CPU2 快照有效且 `manual_alarm_inhibit==0`，被 Manual 阻止时记录该计划点已抑制，避免每 5 s 重发；SI 报警合成最后按白名单只清过程报警位。完整方案增加 CPU2 权威的 `automatic_allowed`／操作模式语义和 `DUE→BLOCKED→START_REQUESTED→ACCEPTED→RUNNING→TERMINAL` 调度状态，并与 C-19 的事务 ID 关联。

#### 兼容与待决策

复用现有抑制字段且不改变共享含义时不升协议；新增操作模式或调度状态字段则需 CPU2／CPU3 同步提升 `DEVICE_PROTOCOL_VERSION`。Manual 跨过计划点后是否补跑属于产品决定，不能由实现默认猜测。

<div class="table-scroll">

| 用例 | 预期 | 不得发生 |
|----|----|----|
| Manual 在计划点前／同分钟／计划后 | 不启动自动 Profile，且不反复重发 | 自动命令切换维护操作。 |
| 退出 Manual | 按已确认的补跑策略执行 | 未决策时偷偷补跑。 |
| Manual 下跨越过程阈值 | SI 过程报警位被抑制 | 清除卷筒报警、CPU2 错误或继电器保护。 |
| RTC 回拨／跨日／CPU3 重启 | 同一计划点最多一次确定性处理 | 重复 Profile 或漏记阻断原因。 |

</div>

**显示边界：**若新增“自动测量受抑制”OLED 提示，必须检查 4 行布局、字串长度和新增汉字字库。

**证据边界：**`si_modbus_slave.c:1140-1206,1352-1442` 可静态确认两处未消费抑制状态；Manual 跨计划点是否补跑、真实 PLC 对报警抑制的期望和自动任务时序需产品决定与联机台架。

</div>

<div class="issue-head">

### C-19 外部动作命令只有寄存器 ACK，仍缺请求到完成的可关联闭环

<span class="badge p1">P1 · 仍存在</span>

</div>

<div class="evidence">

**原因与证据：**参数写至少能确认 CPU2 返回合法 FC10 ACK；真正缺口是 SI／DSM／Wärtsilä 动作命令写入唯一 `g_deviceParams.command` 后立即对外成功，而共享状态没有 request id、accepted id、completed id、result 或重启代际。

</div>

**影响：**主站无法判断某次动作是已接受、执行中、已完成、被后续命令覆盖还是在 CPU2 重启后中止，失败结果也不能严格关联到请求。

**整改方案：**短期把现有 ACK 定义为“寄存器写已接受”并在 busy 时拒绝第二动作；完整方案增加请求 ID、接受／完成 ID、阶段、结果和 boot epoch，定义重发幂等与并发行为。

**来源：**命令流程图、共享协议链和外部协议专题；需要 Busy、前置条件失败、运行中失败、重启和重复请求台架。

完整分析：寄存器接受、业务执行与完成结果的三层语义

<div class="analysis-body">

<div class="analysis-grid">

<div class="analysis-panel">

**当前结论**仍存在，P1；范围应限定为动作命令。普通参数写已有 CPU2 FC10 形状正确的 ACK，不能笼统说“所有外部写都无法确认”。

</div>

<div class="analysis-panel">

**直接触发**SI／DSM／Wärtsilä 下发任一映射为 `CMD_*` 的动作，随后在 CPU2 主循环消费前重发、并发写另一个命令，或在 accepted 后 CPU2 重启。

</div>

</div>

#### 当前执行链

1.  外部动作在 CPU3 被映射为 `CMD_*`，同步写 CPU2 的 `HOLDREGISTER_DEVICEPARAM_COMMAND`。
2.  CPU2 FC10 把值写入唯一 `g_deviceParams.command` 并立即回 ACK；CPU3 因此向外部返回写成功。
3.  CPU2 主循环之后才取走该单槽、清空它、设置 `current_command` 并运行 `ProcessMeasureCmd()`。
4.  ACK 到消费之间的另一次写可覆盖单槽；完成后 `current_command` 清零，只剩通用 state／error，不能证明属于哪次请求。
5.  CPU2 重启、迟到 ACK 或多端口重发也没有 boot epoch／事务代际可区分。

#### 根因、影响与整改

**根因：**共享协议只有 command 单槽和全局状态，把“帧写成功、命令已接受、业务执行成功”三种成功混为一体，没有请求身份、阶段或结果所有权。

**影响：**外部主机可把动作失败误当成功；并发／超时重发可能覆盖或重复运动，重启后旧状态也会被错配为旧请求的完成。

**第一阶段：**正式说明现有 ACK 只表示 CPU2 接受了寄存器写；当 command／current_command／busy 未清时，CPU3 拒绝第二动作并返回 Busy，主机再轮询状态和错误。该方案只能降低覆盖风险，不能完全关联。

**完整方案：**共享协议增加 `request_id、accepted_id、completed_id、command_echo、phase、result_code、boot_epoch`；重复 ID 幂等，重启代际变化将未完成事务明确标记 aborted。全局 `error_code` 不得冒充本请求 result。

#### 状态、协议和版本

标准写响应只在 accepted 后返回；运行完成／失败通过状态寄存器查询。完整闭环需 CPU2／CPU3 同步改动并升级 `DEVICE_PROTOCOL_VERSION`，外部三路端口还需各自定义 Busy、查询和超时策略。

<div class="table-scroll">

| 场景 | 预期 | 关联不变量 |
|----|----|----|
| A accepted 后、消费前注入 B | A 不丢，B Busy 或排队 | 两者 ID 不混淆。 |
| A 成功／具体失败 | 只更新 A 的结果 | completed_id 与 request_id 一致。 |
| 同一 ID 超时重发 | 幂等返回 | 不重复运动。 |
| accepted 后 CPU2 重启 | A=aborted | boot_epoch 变化。 |
| 三端口并发 | 顺序／拒绝确定 | 迟到 ACK 不污染下一事务。 |

</div>

**证据：**CPU3 `si_modbus_slave.c:877-905`、`DSM_SlaveModbus_modbus2.c:886-972`、`wartsila_modbus_communication.c:252-306`；CPU2 `dataanalysis_modbus.c:305-306,504-506`、`hostcommu_modbus.c:263-354`、`app_main.c:39-53,190-204`。静态可确认语义缺口；未做多端口／外部主机台架。

</div>

<div class="issue-head">

### C-20 Wärtsilä 超 100 点结果被截断，完成态和字段有效性仍未闭环

<span class="badge p0">P0 · 仍存在</span>

</div>

<div class="evidence">

**原因与证据：**CPU2／CPU3 共享结果支持 200 点，但外部适配常量、`dens_points[100]` 和寄存器图只到 100，`measurement_points>100` 被静默钳成 100。现场抓包的点数字段为 114、下载统计有 115 个非零槽，两者差 1 的语义尚未冻结，但已证明存在 \>100 点场景。

</div>

**影响：**PLC 获得不完整 profile 却看不到截断；完成态仍像测量中，无效／旧值又可能被解释为正常 0，直接影响分布密度结果完整性。

**整改方案：**先把点表端到端统一到已冻结容量并禁止静默截断；再以真实 PLC／供应商 golden frame 冻结状态序列、错误和字段质量，候选完成码不能静态猜定。

**边界：**“无法区分测量中／完成”是当前源码事实；完成码是否直接改为 `0x2840` 仍是外部契约决策，不能静态猜定。

完整分析：点表容量丢失、状态字冲突与字段质量

<div class="analysis-body">

<div class="analysis-grid">

<div class="analysis-panel">

**当前结论**仍存在。C-20A 的代码对 \>100 点静态必截断，现场抓包证明存在 \>100 点需求，但尚未用当前 CUBE＋真实 PLC 复现截断，仍按 P0；C-20B 完成态／字段质量为 P1。整项按最高子项由 P1 上调 P0。

</div>

<div class="analysis-panel">

**直接触发**CPU2 产生 101～200 点分布结果；或主机读取测量完成、无效密度／温度、旧快照和失败回位／探底状态。

</div>

</div>

#### 当前执行链

1.  CPU2／CPU3 共享点阵可承载 200 点，CPU3 外部适配常量却固定 100，并把 `measurement_points>100` 钳为 100。
2.  Wärtsilä 寄存器图终点只覆盖 100 点，投影只写前 100 项，对外点数也被改成 100；101 项以后不可读取。
3.  现场抓包中 `0x0050` 点数字段为 114，下载统计为 115 个非零槽；差 1 语义未冻结，但两项共同证明现场存在 \>100 点场景，并不等同于当前 CUBE 已实机复现。
4.  `STATE_WARTSILA_DENSITY_OVER` 和 MEASURING 均输出 `0x0C60`；主机不能靠工作状态区分完成。
5.  float／temp／density／liquid 状态固定 0，无效密度会转成数值 0 仍配状态 0；整帧 freshness 不能替代字段级质量。

#### 根因、影响与整改

**根因：**第一版 100 点适配容量被当作正式上限并用静默钳位消化；状态字、倍率和质量位缺少供应商／现场冻结契约，共享数据又缺字段级 quality。

**影响：**PLC 接收不完整 profile 但看不到错误；完成态长期像测量中；无效／旧值可被解释为正常 0，影响密度和库存结论可信性。

**第一阶段：**先冻结外部点表容量和寄存器地址契约，再统一常量、`dens_points` 结构、`HOLDREG_END_ADDR`、freshness 分类、清零和投影循环。容量尚未冻结或 `point_count` 超出当前支持能力时，投影函数必须返回失败，相关摘要／点表 FC03 按冻结契约返回异常或忙态，并且不得提交“截成 100 点”的伪成功快照；未冻结前不得发布普通完成态。

**第二阶段：**用真实主机冻结完成状态码；候选 `0x2840` 未验证前不得写死。建立每字段 valid→状态位／数值的显式表，无正式定义时标决策缺口，不猜“0=正常”。

**完整方案：**建立版本化 Wärtsilä 协议卷和字段 quality／age／generation；保留并扩展现有 `CPU2_ProfileCommitCandidate()` 的同代原子提交／完成门禁。只有目标外部协议已定义能力字段时才映射能力，不能自行新增寄存器。

#### 协议和版本

只扩 CPU3 外部寄存器适配、不改板间共享字段时无需提升 `DEVICE_PROTOCOL_VERSION`，但仍必须修订 Wärtsilä 外部协议卷、寄存器地址边界和 golden frames；若新增共享质量／能力字段则两端同步升级。莆田现场 FC10 的 `byteCount=qty`、数据仍 `2×qty` 是已冻结契约，本整改不得改回标准格式。

<div class="table-scroll">

| 用例 | 预期 | 关键检查 |
|----|----|----|
| 99／100／101／200 点 | 按冻结容量完整或明确拒绝 | 尾部清零、无静默截断。 |
| 抓包回放：摘要 114＋115 个非零槽 | 先确认差 1 语义再映射 | 不得当作两个普通点数用例混同。 |
| 成功／回位失败／探底失败／断链 | 状态序列可区分 | 候选提交不提前完成。 |
| 有效／哨兵／边界／过期字段 | 数值与状态组合正确 | 旧值不标正常。 |
| 莆田 FC10 golden frame | 既有现场方言保持 | 标准 FC10 继续按冻结策略处理。 |

</div>

**证据：**`external_read_freshness.h:6-10,235-245,280-307`、`wartsila_register_map.h:21,72-101`、`wartsila_modbus_data_analysis.h:53-58`、`wartsila_modbus_data_analysis.c:30-42,56-94,150-217,261-320`、`wartsila_modbus_communication.c:67-134`，正式兼容资料及 `2026-01-27_莆田现场Wartsila抓包协议整理.md:227-231`。源码证明 \>100 必截断，抓包证明 \>100 场景；未用当前 CUBE＋真实 PLC 复现，完成码也仍需主机确认。

</div>

<div class="issue-head">

### C-24 DSM 外部 Modbus 地址 0 仍会执行并回包

<span class="badge p1">P1 · 仍存在</span>

</div>

<div class="evidence">

**原因与证据：**地址检查同时接受配置站号和 0，地址 0 会继续进入读写和异常响应路径，响应又使用配置站号构造。位置：`LTD_DISPLAY_CPU3/Communication/external/DSM_modbus/DSM_communication.c`。

</div>

**影响：**多台从站收到地址 0 时可能同时回包造成 RS485 冲突；广播读和异常响应也偏离通用 Modbus 语义。

**整改方案：**除非 DSM 正式协议明确把 0 定义为非标准单播，否则广播读静默丢弃，允许的广播写可执行但绝不应答。

**验证边界：**最终行为必须写入 DSM 协议卷，并用多从站总线验证。

完整分析：地址 0 的广播执行与回包语义

<div class="analysis-body">

<div class="analysis-grid">

<div class="analysis-panel">

**当前结论**仍存在，P1。当前 DSM 正式资料未找到“0 是特殊单播”的依据；代码会对地址 0 的读、写和非法请求全部执行／响应。

</div>

<div class="analysis-panel">

**直接触发**在一台或多台 DSM Modbus 从站总线上发送 CRC 正确、地址 0 的 FC01／03／04／05／10 或非法功能帧。

</div>

</div>

#### 当前执行链

1.  `DSM_CommunicationProcess()` 的地址门禁显式接受配置站号或 0。
2.  地址 0 随后照常进入长度、功能码、读表／写入和异常响应路径。
3.  各响应构建器统一写配置 `SlaveAddress`，没有广播静默分支，回包地址还与请求地址 0 不一致。
4.  多台同固件设备收到同一广播时可能同时驱动 RS485。

#### 根因、影响与整改

**根因：**0 被实现成第二个本机地址，没有把 broadcast 作为请求属性传入执行／响应层，也没有按功能码建立广播许可表。

**影响：**广播读、非法请求和写操作都可能多机同时回包造成碰撞；主站收到与请求地址不一致的响应，诊断和兼容行为不可预测。

**第一阶段：**若按 Modbus，地址 0 仅允许协议明确可广播的写，执行一次但 `tx_len=0`；广播读、非法功能和异常全部静默且无读副作用。

**完整方案：**解析结果携带 `address_mode(unicast／broadcast)`，按功能码表驱动广播许可，每个响应构建器和最终发送层都强制 `broadcast ⇒ no TX`。若正式 DSM 协议证明 0 是非标准单播，应以协议卷和现场抓包冻结为受控偏差。

#### 错误和兼容

广播静默不设置整机故障，也不返回异常；单播异常码保持。该变更只影响 CPU3 外部协议，不改共享字段，无需升 `DEVICE_PROTOCOL_VERSION`，但可能影响依赖错误回包的旧主机，应先抓包。

<div class="table-scroll">

| 请求 | 预期 | 副作用／回包 |
|---|---|---|
| 配置站号读／写 | 正常单播 | 执行并按规范响应。 |
| 其它站号 | 静默忽略 | 无副作用。 |
| 地址 0 读／非法功能 | 静默 | 不执行、不响应。 |
| 地址 0 合法写 | 至多执行一次 | `tx_len=0`。 |
| 两从站并联广播 | 总线无回包 | 波形无碰撞。 |

</div>

**证据：**`DSM_communication.c:67-128`、示例响应 `DSM_SlaveModbus_modbus2.c:886-972`。静态确认地址 0 的执行和回包；未做真实多从站波形测试。

</div>

<div class="issue-head">

### C-25 跨 CPU 的无效值和字段质量仍无统一契约

<span class="badge p1">P1 · 仍存在</span>

</div>

<div class="evidence">

**原因与证据：**合法位置／水位 0 与 `UNVALID_POSITION=0` 冲突；温度存在 0、9999、99999、-2000 四类哨兵；HART 把无效 PV／SV／TV 输出为 0.0；VCF 无效值同时使用 0 和 1；OLED、SI、继电器和 Wärtsilä 的漏判口径不一致。

</div>

**影响：**合法 0 可能被误判无效，无效数据又可能伪装成合法 0；不同协议对同一快照给出互相矛盾的有效性。

**整改方案：**短期先统一每个消费端的有效判断；中期在共享契约增加字段级 valid／quality、样本代际和无效值总表。

**来源：**[参数与协议数据无效值梳理](2026-07-18_参数与协议数据无效值梳理及风险分析.md)；改变共享字段需评估协议版本。

完整分析：数值哨兵跨出口漂移与字段级质量契约

<div class="analysis-body">

<div class="analysis-grid">

<div class="analysis-panel">

**当前结论**仍存在，P1，属于跨 CPU 问题：CPU2 是多数样本生产端，CPU3／OLED／外部协议是消费端，整改不能只归 CPU3 本地。

</div>

<div class="analysis-panel">

**直接触发**冷启动、CPU2 断链、样本过期、合法位置／水位为 0、温度为历史哨兵 9999／99999／-2000，或 VCF／HART 字段无效。

</div>

</div>

#### 当前传播链

1.  CPU2 各业务用不同数值表示无效：温度 99999、无线 9999、位置／密度／水位 0、VCF 1 等，共享结构大多只传数值和全局状态。
2.  CPU3 另有无线温度 -2000，OLED、SI、继电器、HART、Wärtsilä 各自重写有效范围。
3.  OLED 温度只判断 `0<value<40000`，9999 可被显示为有效；水位 0 又被判无效，而 AO 已证明位置 0 可以是真实值。
4.  HART 无效值改成 0.0 但变量状态未同步，Wärtsilä 字段状态固定 0；同一数值在不同出口得到相反质量结论。

#### 根因、影响与整改

**根因：**业务数值承担 validity；范围、来源就绪、年龄和质量散落在消费模块，没有 producer contract／统一 helper，少量共享状态也未跟随样本原子发布。

**影响：**合法 0 被丢弃，9999／99999 被当真实温度，无效 0 被 PLC 标正常；AO、继电器、OLED 和外部协议可能对同一快照作出相反控制／显示。

**第一阶段：**CPU2 定义按字段的 validity／quality helper（温度、位置、水位、密度、VCF），CPU3 所有消费端复用同一规则；位置以 source ready／quality 判断，不能只判 0。OLED 在现有 4 行内显示 `--／N/A`，不新增第 5 行。

**第二阶段：**HART 按正式 DeviceStatus／变量状态表示无效，Wärtsilä 状态位经协议确认后映射；CPU2 断链、协议不匹配和 age 超限一律不得返回旧有效。

**完整方案：**在共享测量结构尾部增加 per-field valid／quality、sample_generation、age／source，由 CPU2 原子发布，CPU3 完整快照验证后消费。

#### 协议和版本

仅统一本地 helper 且不改线缆契约可不升协议；新增共享字段属于语义／布局变化，必须 CPU2／CPU3 同步、拦截旧新固件组合并提升 `DEVICE_PROTOCOL_VERSION`。

<div class="table-scroll">

| 用例组 | 预期 | 跨出口不变量 |
|---|---|---|
| 最小／最大／真实 0／历史哨兵 | 逐字段质量正确 | OLED、AO、继电器、协议一致。 |
| encoder／motor 来源的真实 0  | 有效位置 | 不被 UNVALID_POSITION 吞掉。 |
| 断链／过期／协议不匹配 | invalid／stale | 旧值不标 valid。 |
| HART／Wärtsilä／SI | 数值与状态匹配 | 0.0 不冒充正常。 |
| 冷启动到首样本 | 质量单向建立 | generation 和 age 正确。 |

</div>

**证据：**CPU2 `system_parameter.h:17-27`、`relay_output.c:309-352`、`ao_output.c:272-300`、`hart.c:70-107,267-278,355-414`、`measure_density.c:479,966,1356,1613,2264,2382`；CPU3 `system_parameter.h:198-205`、`display.c:252-261,377-419,465-494`、`si_modbus_slave.c:265-321`、`wartsila_modbus_data_analysis.c:150-217`。静态确认跨出口冲突；未做 HART／PLC／继电器台架。

</div>

<div class="issue-head">

### C-26 故障码主要口径已同步，12-13可达性和台架证据仍开放

<span class="badge p2">P2 · 部分关闭</span>

</div>

<div class="evidence">

**原因与证据：**协议29已删除不可达12-11、把13-26密度上限提高到3000.0 kg/m³、统一13-2名称并交换18/21类别；CPU2/CPU3 V1.34.0.0、当前清单和两份工作簿已同步。剩余问题是12-13虽有LIN映射但AS5145检测入口仍未检查LIN状态，且3000边界、双端显示和真实故障注入尚无台架证据。

</div>

**影响：**售后、测试和源码对“会不会报、何时会报、适用版本”得出不同结论，故障注入和现场处置容易偏离。

**整改方案：**保留协议29已完成的编号和资料治理；后续单独明确12-13的LIN判据、报警级别和清错所有权，再完成2999.99／3000.00／3000.01、双端显示和故障恢复台架验证。

**来源：**[二代计量仪故障码逐项核查](2026-07-18_二代计量仪故障码问题逐项核查.md)。

完整分析：页眉基线、逐码可达性与协议适用域

<div class="analysis-body">

<div class="analysis-grid">

<div class="analysis-panel">

**当前结论**部分关闭，P2。协议29的编号、名称、阈值、工作簿版本和迁移记录已一致；静态契约与构建仍不能替代12-13真实产生链、3000边界、双端显示和恢复动作验证。

</div>

<div class="analysis-panel">

**直接触发**测试12-13的LIN状态、密度2999.99～3000.01边界，或用协议28旧表解释CPU2/CPU3 V1.34.0.0协议29设备的18/21类别故障。

</div>

</div>

#### 当前不一致链

1.  工作簿“文档简介”“故障代码”和内部技术表已统一为CPU2/CPU3 V1.34.0.0、共享协议29。
2.  12-11已从双端枚举、日志、显示和当前工作簿删除；12-13仍保留双端定义和显示映射，当前工作簿已标为“保留”，且AS5145入口只检查parity／OCF／COF，LIN映射没有实际产生入口。
3.  13-26源码有效上限已为3000.0 kg/m³，CPU3手输原始上限已为300000；2999.99／3000.00／3000.01尚待目标板验证。
4.  13-31～13-56的安全协议来源、编号迁移和技术链路已保留在内部治理表；正式售后表继续使用简化现场语言。
5.  13-2已统一为“震动管频率异常”，CPU3 OLED已补“震”字点阵；其它本轮核对文案已按当前产生场景收敛。

#### 根因、影响与整改

**根因：**历史工作簿是手工快照，版本身份、调用可达性、适用域和阈值曾与源码脱节；本轮已同步静态口径，但12-13硬件状态判据和真实边界仍必须由源码入口与台架共同证明。

**影响：**协议29发布后若仍使用协议28历史表，18/21类别会被误解；12-13仍可能被误认为当前入口可主动产生，3000临界值未经台架时也不能视为现场验收完成。

**已完成阶段：**协议29删除12-11、交换18/21类别、统一13-2、提高13-26上限并同步双端源码、当前清单、协议记录和两份工作簿；历史页保持冻结。

**剩余阶段：**单独决定12-13的LIN判据、warning／阻断等级和清错所有权；随后执行3000边界、OLED故障详情、CPU2→CPU3传递、真实故障注入和恢复测试。

**后续门禁：**继续扩展检查器，自动比对版本、枚举唯一性、“使用中”码生产调用点、协议标签和关键阈值；允许已确认的3项预留白名单，并把台架证据与静态契约分开记录。

#### 兼容和版本

协议29随CPU2/CPU3 V1.34.0.0正式发布，不提供协议28旧故障码别名、数值翻译或运行时规避。后续若改变12-13产生语义，仍需重新评估共享协议和双端配套版本。

<div class="table-scroll">

| 检查组 | 预期 | 门禁 |
|----|----|----|
| 故意旧页眉 | 脚本失败 | CPU2／CPU3／协议三项自动比对。 |
| 使用中／预留码 | 调用点与状态一致 | 预留不得有生产调用。 |
| 12-13 位组合 | 判据和文档一致 | parity／OCF／COF／LIN 全覆盖；当前LIN入口仍待实现。 |
| 2999.99／3000.00／3000.01 | 双端一致 | 源码、手输、协议、工作簿已同步，目标板边界待验证。 |
| 工作簿渲染 | 列宽、换行、筛选正常 | 历史页不覆写。 |

</div>

**证据：**`docs/00_构建与版本/故障码/LTD故障代码统一表.xlsx`、`LTD内部技术与治理资料.xlsx`、双端`system_parameter.h`、CPU2 `AS5145.c`与`measure_oilLevel.c`、CPU3 `system_parameter.c`和`display.c`。两份工作簿已完成结构、公式和全部工作表渲染检查；真实OLED、边界输入和故障注入仍未执行。

</div>

<div class="issue-head">

### C-27 历史 outputs 仍被跟踪，本机检查资产恢复身份未闭环

<span class="badge p3">P3 · 部分存在</span>

</div>

<div class="evidence">

**原因与证据：**`outputs/` 已被忽略但仍有 4 个 Git 跟踪文件；完整文档／流程／协议检查依赖本机同步的 `tools/` 和流程导航源，普通新克隆或 CI 不能直接复现全部门禁。

</div>

**影响：**派生产物可能继续出现在版本差异中；发布者可能只运行到仓库可见的检查子集，却误认为全部门禁已覆盖。

**整改方案：**对 4 个跟踪产物逐项决定迁出或正式保留；为本机工具建立受控恢复源、版本身份和 CI 可执行的最小公开检查集。

**边界：**`tools/` 和 `docs/00_程序流程导航/` 不纳入 Git 是当前项目规则，本项不是要求用 `git add -f` 强制跟踪。

完整分析：已跟踪派生物与本机门禁的可恢复证据

<div class="analysis-body">

<div class="analysis-grid">

<div class="analysis-panel">

**当前结论**部分存在，P3。确定缺陷是 `outputs/` 仍有 4 个历史 Git 对象；`tools/` 和流程导航不跟踪是治理决定，不是缺陷，但依赖它们的“完整检查”必须证明本机资产身份和恢复方式。

</div>

<div class="analysis-panel">

**直接触发**后续提交更新已跟踪 outputs，或在新克隆／另一台开发机宣称“完整检查通过”但使用了不同版本或缺失的本机工具。

</div>

</div>

#### 当前资产链

1.  生成／检查产物曾进入 Git；后来 `.gitignore` 忽略 outputs，但已跟踪的 3 个历史 xlsx 和 1 个 inspect.ndjson 不会自动退出索引。
2.  这些派生副本可继续出现在差异中，与 `docs/` 正式工作簿漂移。
3.  `tools/` 和 `docs/00_程序流程导航/` 当前均为 0 个跟踪文件，符合 AGENTS 规则。
4.  发布检查依赖这些本机资产时，普通 clone 缺少同步源版本、哈希和恢复验收，无法严格复现同名检查。

#### 根因、影响与整改

**根因：**ignore 规则添加后未一次性清理历史索引；本机资产边界虽已声明，但发布证据没有强制记录同步源身份和哈希。

**影响：**审查者难以判断正式／派生版本，NDJSON 和输出包污染仓库；不同机器使用不同 tools 仍可能给出同样的“全部门禁通过”表述。本项不影响固件运行，维持 P3。

**第一阶段：**逐项确认 4 个对象不承载唯一历史证据后，用精确路径从索引移除并保留忽略；增加门禁，任何 `git ls-files` 命中 outputs／docs-site／tmp 等禁止目录即失败。

**第二阶段：**保持 tools／流程导航本机不跟踪且绝不 `git add -f`；在已跟踪治理文档记录同步源标识、版本／哈希、恢复命令和验收命令，发布证据记录本次实际资产身份。

**边界：**若没有可恢复同步源，只能称“本机检查”，不能宣称普通 clone／CI 可复现。本次任务不授权移除索引、提交或修改这些资产。

<div class="table-scroll">

| 验证 | 预期 | 失败条件 |
|----|----|----|
| `git ls-files -- outputs` | 为空 | 任一派生物仍跟踪。 |
| 新生成 outputs | 保持 ignored | 出现在 status／提交候选。 |
| 禁止目录样例 | 门禁失败 | 被错误允许跟踪。 |
| 干净 clone 恢复本机资产 | 哈希一致且门禁可运行 | 无同步源／版本不匹配仍放行。 |

</div>

**证据：**当前跟踪项为 `outputs/fault_code_after_sales_20260711/LTD故障代码统一表.xlsx`、`outputs/fault_code_formal_20260711/LTD内部技术与治理资料.xlsx`、同目录 `LTD故障代码统一表.xlsx` 和 `.inspect.ndjson`；`.gitignore:69-73` 与 `AGENTS.md`。静态 Git 索引确认；未执行索引移除。

</div>

<div class="issue-head">

### C-36 CPU3 本机 FRAM 驱动同样可无限阻塞，事务保存无法获得底层阶段状态

<span class="badge p1">P1 · 仍存在</span>

</div>

<div class="evidence">

**原因与证据：**CPU3 `WriteMultiData()`／`ReadMultiData()` 的 SPI 命令、地址和数据阶段均使用 `HAL_MAX_DELAY`，接口返回 `void` 且没有地址／长度边界检查。上层 `Cpu3_Params_SaveToFRAM()` 虽做写后读回，但只能判断最终镜像，不知道哪个底层阶段失败。位置：`LTD_DISPLAY_CPU3/Application/system_param/mb85rs2m.c:112-159`、`cpu3_comm_display_params.c:1258-1292`。

</div>

**影响：**SPI 卡死可冻结显示、外部 COM、CPU2 轮询和串口重配，而 C-08 的 ISR 喂狗可能继续；HAL 立即失败又会被静默吞掉，事务层只能间接回滚，无法形成准确诊断。

**整改方案：**把 CPU3 FRAM 驱动改为有限超时、带阶段错误码和完整边界校验；保存、迁移和旧镜像修复必须消费底层结果并记录可显示的恢复原因。

**验证边界：**分别注入命令／地址／数据阶段失败、总线忙、越界和旧镜像二次修复失败，验证有限时间返回、运行态回滚和掉电重启结果。

完整分析：SPI 阻塞、启动读失败误判坏镜像与默认覆盖

<div class="analysis-body">

<div class="analysis-grid">

<div class="analysis-panel">

**当前结论**仍存在，P1，与 C-16 不重复：C-16 是单槽覆盖／掉电原子性，C-36 是底层阻塞、参数边界和 I/O／内容错误语义。

</div>

<div class="analysis-panel">

**直接触发**CPU3 保存或启动加载时出现 SPI BUSY／ERROR／TIMEOUT、MISO 故障，或传入 NULL、负地址、跨容量和超过 65535 的长度。

</div>

</div>

#### 当前执行链

1.  保存／启动加载调用 `ReadMultiData／WriteMultiData`；WREN、命令、3 字节地址和数据均使用 `HAL_MAX_DELAY`。
2.  HAL 状态全部丢弃，接口 void；`startcnt` 为 int、length 为 uint32，未检查 NULL、负数、容量、加法溢出和 HAL 16 位 size。
3.  保存层只能做最终 CRC／memcmp，不知道哪个阶段失败，也不能在标志卡死时返回。
4.  启动读若瞬时失败，目标结构保持全 0，被解释成 magic／version 无效；随后初始化默认值并尝试覆盖 FRAM。

#### 根因、影响与整改

**根因：**驱动按“SPI 总会成功”的顺序脚本设计，没有事务预算、统一 cleanup 和结构化阶段状态；存储层又把“传输失败”与“成功读取但内容无效”合并。

**影响：**SPI 卡死会冻结 OLED、三路 COM、SI 和 CPU2 轮询，而 C-08 仍可能喂狗；瞬时读失败可把合法现场参数当坏数据并触发默认覆盖，越界／长度截断访问未定义区域。

**第一阶段：**定义 FRAM 容量和事务总预算，API 返回 `status+stage`；校验 NULL、len\>0、start\<capacity、len≤capacity-start、len≤UINT16_MAX，任何失败统一拉高 CS 并可受控复位 SPI。

**第二阶段：**Save／Load 区分 transport failure 与 content invalid：读失败不得恢复默认或写回；只有读取成功且 magic／version／CRC 无效才进入恢复策略，日志保留首个阶段错误。

**完整方案：**与 C-16 合并建立 A/B 槽、代际／提交标记、统一地址图和编译期重叠检查。历史 angle／encoder 地址与参数槽重叠目前无生产调用，只能记潜在死代码冲突，不宣称已覆盖。

#### 兼容和版本

纯驱动 API／错误传播不改共享协议；A/B 布局需提升 CPU3 本机存储版本并提供 V3～V7 迁移。新增 CPU3 本机故障码需更新显示／工作簿，但不自动要求共享协议升级。

<div class="table-scroll">

| 注入／参数 | 预期 | 不变量 |
|----|----|----|
| 命令／地址／数据／读回 BUSY、ERROR、TIMEOUT | 有限返回且 stage 准确 | CS 拉高。 |
| NULL、len0、start=-1、末地址、65535／65536 | 合法有界或明确拒绝 | 不触发 SPI。 |
| 启动瞬时读失败 | 保留运行态／报告 I/O 失败 | 不写默认。 |
| 读成功但 CRC 坏 | 进入受控内容恢复 | 与传输失败可区分。 |
| 每个写偏移掉电 | 旧／新至少一份可恢复 | 与 C-16 联测。 |

</div>

**证据：**`mb85rs2m.c:5-22,112-163`、`mb85rs2m.h:15-33`、HAL `stm32f4xx_hal_spi.h:674-675`、`cpu3_comm_display_params.h:12`、`cpu3_comm_display_params.c:1258-1292,1299-1418`。静态确认阻塞和误分类链；未做 SPI 故障注入／掉电。

</div>

<div class="issue-head">

### C-37 CPU3 密码结果页仍用固定 HAL_Delay 阻塞整个主循环

<span class="badge p2">P2 · 仍存在</span>

</div>

<div class="evidence">

**原因与证据：**`ifsendcmd()` 在密码正确时固定延时 100 ms，密码错误时固定延时 500 ms，然后切页；该函数由显示任务在单一前台主循环中执行。位置：`LTD_DISPLAY_CPU3/Application/display/display_tankopera.c:2540-2577`。

</div>

**影响：**密码操作期间 CPU2 轮询、SI 周期任务、三路外部协议和串口重配全部停顿；错误输入可反复制造 500 ms 响应空窗。

**整改方案：**用显示状态和截止时间代替阻塞延时，主循环继续调度；到期后再切回目标页面，并限制连续错误尝试的交互频率。

**验证边界：**在密码正确／错误连续操作时并发三路 COM 请求和 CPU2 拔线，量化最大响应间隔和 OLED 状态。

完整分析：密码结果展示阻塞前台调度与非阻塞页面状态

<div class="analysis-body">

<div class="analysis-grid">

<div class="analysis-panel">

**当前结论**仍存在，P2。100／500 ms 延时位于真实菜单按键执行链，不是测试辅助代码。

</div>

<div class="analysis-panel">

**直接触发**用户提交正确或错误密码；错误输入可连续触发 500 ms 前台响应空窗。

</div>

</div>

#### 当前执行链

1.  用户输入密码后进入 `ifsendcmd()`，页面清屏、比较密码并绘制正确／错误提示。
2.  `Display_Task()` 由 `App_MainLoop()` 同步调用输入和按键处理。
3.  `ifsendcmd()` 原地 `HAL_Delay(100／500)`，到期后才跳参数／命令菜单或主菜单。
4.  延时期间主循环后续三路 COM、CPU2 轮询、SI 调度和串口重配均不推进；UART／DMA 只能继续收字节，无法及时消费。

#### 根因、影响与整改

**根因：**结果绘制、展示时长和导航跳转耦合在一次同步回调，没有 `result_state+deadline`。

**影响：**正确输入造成 100 ms、错误输入造成 500 ms 响应空窗；与 C-17 单帧 pending 覆盖叠加时会丢外部响应，断链检测和 OLED／CPU2 调度也被推迟。

**第一阶段：**进入 `PASSWORD_RESULT_OK／ERROR`，记录 `deadline=HAL_GetTick()+100／500`，绘制一次后立即返回；每轮用无符号 tick 差判断到期再导航，结果阶段明确忽略／去抖按键。

**完整方案：**建立通用非阻塞 modal／transition 计时器供确认页复用。保持 128×64／4 行布局，不增加第 5 行；错误尝试限频／持久化锁定是独立产品决策，不能顺手改变认证语义，也不得记录密码。

#### 状态和兼容

密码错误是 UI 结果，不置共享故障码；本地页面状态不改共享协议／FRAM。只有新增持久化锁定计数时才评估本机存储版本和升级体验。

<div class="table-scroll">

| 用例 | 预期 | 关键检查 |
|---|---|---|
| 正确／错误 + 三路 COM 10 Hz | 调度持续 | 提示仍保持 100／500 ms。 |
| 连续错误输入 | 无通信阻塞 | 结果阶段无重复跳页。 |
| deadline 跨 tick 回绕 | 到期判断正确 | 使用无符号差值。 |
| 提示期 CPU2 断链／恢复 | 仍被调度 | 状态及时更新。 |
| 中英文 4 行页面 | 无截断 | 不增加第 5 行。 |

</div>

**证据：**`display_tankopera.c:2540-2577,651-652,1400-1411`、`display.c:2144-2175,2217-2236`、`app_main.c:927-945`。静态确认阻塞链；未做按键＋通信台架。

</div>

<div class="issue-head">

### C-38 健康 OLED 在满 60 秒后的下一次绘制也会硬复位并清屏

<span class="badge p2">P2 · 仍存在</span>

</div>

<div class="evidence">

**原因与证据：**`Display_ShouldRecoverBeforeDraw()` 除了响应显式恢复和 SPI 错误计数变化，还在距离上次恢复达到 `DISPLAY_RECOVER_INTERVAL_MS=60000` 时无条件返回 true，下一帧调用 `OLED_RecoverAndClear()`。位置：`LTD_DISPLAY_CPU3/Application/display/display.c:14,2034-2055`。

</div>

**影响：**健康屏幕也会在下一次绘制时重初始化／清屏，至少产生硬复位空窗和额外 SPI 占用；是否形成可见闪烁尚未实机验证。

**整改方案：**只在显式请求、SPI 错误增长、显示健康探针失败或受控维护窗口触发恢复；正常周期仅做轻量健康检查，不清屏。

**验证边界：**连续运行超过 10 个周期，记录无故障时的重初始化次数、屏幕闪烁、SPI 错误和外部 COM 最坏响应。

完整分析：定时条件触发破坏性恢复与分级恢复设计

<div class="analysis-body">

<div class="analysis-grid">

<div class="analysis-panel">

**当前结论**代码路径存在，P2。准确表述是“距上次恢复≥60 秒后的下一次绘制触发”，60 秒分支本身不主动调度刷新；静态审查不能宣称现场已看到闪烁。

</div>

<div class="analysis-panel">

**直接触发**显示健康、没有新显式恢复请求和 SPI 错误增长，运行超过 60000 ms 后发生下一次状态页／菜单绘制。

</div>

</div>

#### 当前执行链

1.  `DisplayInit()` 记录 `last_recover_tick`，正常绘制持续运行。
2.  下次绘制调用 `Display_ShouldRecoverBeforeDraw()`；即使无错误，只要 elapsed≥60000 也返回 true 并更新时间。
3.  调用 `OLED_RecoverAndClear()`：全屏清零、NREST 拉低、`HAL_Delay(10)`、重发初始化命令，再分 80 块写满 5120 B 零数据并 DisplayOn。
4.  最后才重绘当前页；恢复 API 为 void，失败只能由后续 SPI 错误计数间接看见。

#### 根因、影响与整改

**根因：**把固定时间当作恢复条件，没有区分无破坏的周期健康检查与硬复位／清屏；void API 也掩盖阶段成本和失败结果。

**影响：**健康屏至少出现 10 ms 复位空窗、全屏清空／重绘和每分钟额外 SPI 流量，并阻塞同一主循环其它任务；闪烁和真实总耗时需录像／波形确认。

**第一阶段：**移除 elapsed 分支的破坏性恢复，只保留显式请求和 SPI 错误增长；周期任务最多做不清屏的软件统计／健康检查。

**完整方案：**建立 `HEALTHY → SOFT_REDRAW → REINIT → HARD_RESET → COOLDOWN` 分级状态机，恢复 API 返回阶段结果并限制连续次数。shadow CRC／refresh sequence 只能证明软件写入一致，不能冒充面板读回。

**受控偏差边界：**若历史现场确有 OLED 挂机且必须周期复位，需以长稳台架证据冻结为受控维护策略，并选择不影响操作的窗口，而不是默认每 60 秒硬复位。

#### 兼容

CPU3 本地显示改动不改共享协议／FRAM，不增加第 5 行；新增本机诊断计数也无需协议升级，除非决定通过共享寄存器对外暴露。

<div class="table-scroll">

| 用例 | 预期 | 观测 |
|---|---|---|
| 健康运行超过 10×60 秒 | hard recovery=0 | 无可见闪烁，COM 间隔稳定。 |
| 一次 HAL SPI 失败 | 一次分级恢复 | 有 cooldown 和阶段结果。 |
| 显式息屏→亮屏 | 按设计恢复一次 | 不被定时器重复触发。 |
| 持续 SPI 失败 | 有限重试，不每帧复位 | 外部调度仍有界。 |
| tick 回绕／中英文页面 | 时间和重绘正确 | 4 行内容一致。 |

</div>

**证据：**`display.c:14,30-32,1993-1999,2034-2057,2088-2106,3187-3238`、`hgs.c:12,136-140,163-190,330-374,434-451,591-594,675-686`。静态确认周期路径和最低 10 ms 复位延时；未做示波／录像／长稳台架。

</div>

</div>

<div id="controlled-risks" class="section">

## 条件风险与受控偏差

| 编号 | 主责端 | 当前结论 | 继续保持的条件 |
|----|----|----|----|
| R-01 | CPU2＋CPU3 | **Modbus RTU 仍以 UART IDLE 约 1T 判帧。**与 t1.5／t3.5 严格实现有偏差，但已有“暂缓实施”决定。 | 保留为受控偏差，必须继续保存帧内停顿、ORE／FE／NE、满缓冲和真实波形测试计划；未完成前不得宣称严格合规。 |
| R-02 | CPU3 | **`g_handlers` 以枚举作数组下标。**当前已有边界和空处理器检查，不能夸大为现行越界。 | 新增命令或处理器时维持编译期数量检查、运行期边界检查和未知值用例；作为低优先级维护风险。 |
| R-03 | CPU2 | **生产固件包含 USART1 高风险调试入口。**CMake、启动和主循环均启用，且可进入测试命令；是否为发布阻断取决于成品物理可达性和维护控制。 | 必须确认 PA9／PA10 的物理暴露、封签／跳线／授权流程。若现场可接触，升级为 P1；若受控，也应以 Release 符号／字符串检查证明边界。 |
| R-04 | CPU2＋CPU3 | **`tools/` 与流程导航不纳入 Git。**这是项目治理决定，不是“未跟踪即错误”。 | 本机同步源、版本身份、恢复步骤和运行记录必须可审计；不得用 `git add -f` 绕过规则。 |

</div>

<div id="flow-audit" class="section">

## 流程导航问题核验结果

本轮扫描 [CPU2 问题点总表](../../00_程序流程导航/CPU2/问题点总表.html)中的 171 条候选，以及 [CPU3 八个流程页](../../00_程序流程导航/CPU3/CPU3程序流程总览.html)中的 43 条候选。流程页只负责提示风险，最终是否进入整改仍以当前源码、正式协议和已确认产品口径为准。

<div class="audit-list">

<div class="audit-item">

**新增确认：10 个**CPU2 新增 7 个，覆盖 HART、扭力帧、LTD/V2、密度稳定性、模式切换、广播和 FRAM；CPU3 新增 3 个，覆盖 FRAM、菜单阻塞和 OLED 周期恢复。

</div>

<div class="audit-item">

**重复项：并入既有问题**CPU2 同步阻塞、外部单帧 pending、多字段写非原子、ISR 协议处理、水位阈值、国标硬编码等均已在原 28 项中，不重复编号。

</div>

<div class="audit-item">

**条件项：保留边界**生产调试入口、RS485 DE 尾保持、1 ms 主循环负载、FRAM 迁移和真实 PLC 行为需要硬件或台架证据，继续放在受控风险／证据缺口中。

</div>

<div class="audit-item">

**反证项：不进入整改**无线配对虽忽略返回值但已发布独立成功／失败状态；`g_handlers` 已有运行期边界；Wärtsilä 特殊 FC10 是已确认现场契约；`stpr_waitMove()` 当前仅由测试入口调用。

</div>

</div>

核验日期：2026-07-21。静态确认不等于真实设备复现；所有新增项仍保留各自验证边界。

</div>

<div id="bench-gaps" class="section">

## 台架、硬件和产品决策缺口

以下事项不能仅凭当前源码定为“已修复”或“实机故障已复现”，但在发布或关闭前必须补齐证据。

| 编号 | 主责端 | 缺口 | 必须补的证据 |
|----|----|----|----|
| B-01 | CPU2＋硬件 | 24 V／12 V 检测 ADC 引脚存在，但业务层未形成采样闭环；外部 WDI 是否装配、是否需要 GPIO 喂狗仍不清楚。 | 原理图、BOM、PCB 实测点、阈值／故障注入和复位行为。 |
| B-02 | CPU2 | `SENSOR_ENN` 只在 GPIO 初始化置高，没有运行期电源管理和恢复状态机。 | 传感器上电时序、掉电／棕断／重启、命令切换和安全状态测试。 |
| B-03 | CPU2＋硬件 | AD5421 FAULT 引脚未接 MCU，只能依赖 SPI `READFAULT`；回读全 `FFFF` 的 SDO→U9→PB4 链仍需现场核实。 | 不同板卡的连通性、电平、SPI 波形、READCONTROL／READFAULT 返回和异常负载。 |
| B-04 | CPU2 | AD5421 断环恢复代码已实现，但尚不能据此关闭现场 4 mA／24 mA 乱跳问题。 | 真实断环／重接至少 10 轮、HART 共存、逻辑分析仪帧、长期自动跟随。 |
| B-05 | CPU2 | 电机结构改动已有小范围台架记录，但主要只覆盖约 `1.0 m/min`、20～50 mm；不能覆盖 C-42A～C-42H 的全速度、长距离、边界、强制入口和故障注入安全。 | 多速度、长距离、上下极限、强制入口、传感状态卡死、TMC／24 V／编码器故障注入，并保留串口、位置、驱动状态和最终停机证据。 |
| B-06 | CPU2＋DSM | DSM V5.4 冷唤醒第二次是否在 500 ms 内成功、控制字符 BCC 和各维护线版本兼容仍缺真实传感器证明。 | V4.10／V5.0／V5.3／V5.4／V6.1 实物或 golden frame、冷启动与持续噪声测试。 |
| B-07 | CPU2＋CPU3 | `490820b` 已修复外部 RS485 确定性活锁主因，但 A/B 短接恢复、三路 COM 压力、CPU2 拔线重连、LH／SI／Wärtsilä PLC 和液位识别物理条件仍缺实机证据。 | 真实 PLC、A/B 短接、持续噪声、10 Hz 并发、100／200 点、慢响应和液面／油品／速度组合测试。 |
| B-08 | CPU2＋传感器 | 安全传感器已有主机桩和静态契约，但不构成 SIL 或整条安全链闭环。 | 真实传感器端、9600 bps／200 m、噪声和重启、故障注入、SRS／FTTI、独立性与认证证据。 |
| B-09 | CPU2＋CPU3 | 协议 27、CPU2／CPU3 V1.31.0.0 已有双端 clean-first 构建和版本／流程门禁；原“当前双端未构建”口径已过期。正式 Release 告警策略、WirelessHost 独立构建和长期可复现性仍未完整证明。 | 核对 Release 告警策略、独立子工程和长期可复现性；把过期脚本结论与真实失败分开。 |

</div>

<div id="closed-items" class="section">

## 已关闭／不纳入整改

| 编号 | 归属 | 原问题 | 关闭依据 |
|----|----|----|----|
| F-01 | CPU2 | `MeasureStart()` 失败后仍继续命令分派 | `SET_ERROR()` 当前会直接 `return`；本问题已关闭。保留的清错／非法命令问题见 C-06。 |
| F-02 | CPU3 | 不校验 CPU2 FC03／FC04／FC10 响应长度 | `CPU2_ResponseFrameFailureReason()` 已精确检查功能码、byte count、实际长度和 FC10 回显。 |
| F-03 | CPU2＋CPU3 | 协议不匹配仍继续解析和写命令 | 已有协议快照门禁，普通命令和快照访问保持关闭；不能再列为当前未解决。 |
| F-04 | CPU3 | SI 非整日周期重启后相位漂移 | 已改为当天固定起始时分锚点；当前逻辑不再以重启时刻重新起算。 |
| F-05 | CPU3 | SI 探底频次 off-by-one | 当前使用 `count + 1 >= interval`，探底后置 1；按当前计数语义已关闭。 |
| F-06 | CPU3 | Wärtsilä FC10 现场特殊 byteCount 被误判 | 当前已按莆田现场契约仅接受 `byteCount=qty`，数据区仍为 `2*qty`；标准 `byteCount=2*qty` 返回 `0x03`。FC03 保持标准 `2*qty` 响应。 |
| F-07 | CPU2 | HART TX／RX 原理图标签反向 | 标签已修复，不再列为待整改问题。 |
| F-08 | CPU2 | SPI2／SPI3 MISO／MOSI 标签错误 | 当前资料已修复。 |
| F-09 | CPU2＋CPU3 | 文档结构检查未闭环 | 结构检查已闭环；后续仍需按当前治理清单持续检查，但不是同一个未解决项。 |
| F-10 | CPU2＋CPU3 | 暂存区与发布资料冲突 | 工作区／暂存区差异属于任务和发布时点的瞬时状态，不是固件缺陷；本清单不把脏工作区列为主问题，实际发布前仍需单独执行范围核对并保留无关改动。 |
| F-11 | CPU2 | A/B 参数槽缺少单槽自愈 | 该结论只适用于原实现，已被 2026-07-28 当前已暂存工作树推翻：单槽新镜像可发布成功，但上电仍固定优先任何有效 A，存在“B 为新值、A 为旧值、重启回退旧 A”的确定性链。当前重新并入 C-03，不再作为已关闭依据。 |
| F-12 | CPU2 | 无线配对返回值被入口忽略 | 入口确实使用 `(void)WirelessPairing_RunByRssi()`，但函数内部已发布运行中、成功／失败和具体错误状态；当前不构成“失败无反馈”的独立问题。 |
| F-13 | CPU2 | `stpr_waitMove()` 没有总超时 | 当前调用点仅位于 `test.c`，不在正式测量运动链；其风险已并入生产调试入口 R-03 和电机台架缺口 B-05，不重复列主问题。 |
| F-14 | CPU3 | Wärtsilä FC10 使用 `byteCount=qty` | 这是已由现场抓包冻结的唯一口径，标准 `2*qty` 被拒绝是当前产品契约，不是实现缺陷。 |
| F-15 | CPU3 | `g_handlers` 以枚举作数组下标 | 现行路径已有运行期范围和空处理器检查，不能据此认定越界；后续维护风险保留在 R-02。 |
| F-16 | CPU2 | 普通单点超时后直接发布兜底值 | 现行 `SinglePoint_ReadSensor()` 会检查 `stable_out`，未稳定则重开窗口，不再直接发布；分布路径传 `NULL` 的残留问题已单列 C-32。 |
| F-17 | CPU3 | 1 ms 空闲节拍、DE 尾保持和 V7 迁移已静态证明现场安全 | 这些结论仍需要负载、波形和真实 FRAM 证据，只能留在 B-07／B-09 等证据缺口，不能作为已确认代码缺陷或已验证通过项。 |

</div>

<div id="evidence-boundary" class="section">

## 证据、来源与使用边界

<div class="split">

<div>

### 既有详细条目采用的权威顺序（历史）

1.  当前用户决定和 `AGENTS.md` 的项目边界。
2.  该节原复核基线 `MAIN@fa9a8643bd3ad0e9c5ef75e3487952e4e2c8afc6` 的源码、配置和 Git 状态；现行结论改以上方 `MAIN@db0b1322` 矩阵为准。
3.  `docs/` 中当前正式协议、故障资料和专题分析。
4.  流程图、旧 HTML 和历史报告，只作为候选线索。

</div>

<div>

### 统一清单明确没有证明的内容

- 该节形成时没有运行 CPU2／CPU3 构建；当前协议 27 已有双端 clean-first 构建证据，但本次文档整理未改固件，也未重跑固件构建。
- 没有执行台架、真实传感器、PLC、HART 或长线测试。
- 没有进行掉电、故障注入、逻辑分析仪或硬件批次复核。
- 静态确认只能证明当前代码路径存在，不能冒充现场复现或 SIL 证据。

</div>

</div>

### 已交叉核查的主要来源文档

- [CPU2 程序流程问题点总表](../../00_程序流程导航/CPU2/问题点总表.html)、[CPU3 程序流程总览及八个分流程页](../../00_程序流程导航/CPU3/CPU3程序流程总览.html)
- [2026-07-16 全工程问题梳理与整改优先级](2026-07-16_全工程问题梳理与整改优先级.md)
- [2026-07-18 DSM 传感器协议适配复查](2026-07-18_DSM传感器协议适配复查.md)
- [2026-07-18 参数与协议数据无效值梳理及风险分析](2026-07-18_参数与协议数据无效值梳理及风险分析.md)
- [2026-07-18 二代计量仪故障码问题逐项核查](2026-07-18_二代计量仪故障码问题逐项核查.md)
- [2026-07-10 Modbus RTU 帧间隔与字节间超时问题分析及整改方案](2026-07-10_Modbus_RTU帧间隔与字节间超时问题分析及整改方案.md)
- [2026-07-08 AD5421 环路断开重接问题分析](2026-07-08_AD5421环路断开重接后电流乱跳问题分析.md)、[AD5421 回读 FFFF 问题分析](2026-06-16_AD5421控制寄存器回读FFFF问题分析与现场验证.md)
- [电机运动结构优化改动与待测项汇总](../../05_测试记录/版本验证/2026-06-12_CPU2电机运动结构优化改动与待测项汇总.md)、[电机运动剩余台架验证执行规程](../../02_需求与计划/未实现/2026-06-12_电机运动剩余台架验证执行规程.md)

</div>

<div class="historical-banner" hidden="">

**以下为 2026-06-30 历史审查快照，仅供追溯。** 其中既包含当前仍存在的问题，也包含已关闭、已降级或证据口径已经变化的项目；请优先使用上方当前核查总账。

</div>

<div id="summary" class="section" hidden="">

## 2026-06-30 历史审查概览

本轮共整理 34 个问题，其中 P0 3 个、P1 14 个、P2 14 个、P3 3 个。最高风险集中在三条主线：CPU2 Modbus 边界校验不足、电机安全错误被覆盖或清除、CPU3 对 CPU2 数据和外部协议的帧校验不足。

<div class="tagline">

<span class="tag">CPU2 Modbus 边界</span> <span class="tag">电机失步与停机安全</span> <span class="tag">命令切换状态一致性</span> <span class="tag">CPU3 内外协议帧校验</span> <span class="tag">显示参数保存后不生效</span> <span class="tag">版本与提交门禁追溯</span>

</div>

<div class="note">

**处理原则：**先封住会造成内存破坏、错误漏报和现场误动作的 P0/P1，再处理参数语义、显示一致性、文档门禁和诊断体验。涉及 CPU2/CPU3 共享协议、参数语义或错误码传递的修复，需要同步评估 `DEVICE_PROTOCOL_VERSION`、CPU2/CPU3 固件版本、版本文档和回归用例。

</div>

</div>

<div id="priority" class="section" hidden="">

## 2026-06-30 历史优先级定义

|  |  |
|----|----|
| P0 | 可能造成内存破坏、安全边界漏报、参数被错误持久化，或直接阻断现场发布的问题。建议作为第一批修复并补回归测试。 |
| P1 | 可能导致测量状态误报、主机协议不可用、关键错误被吞掉、现场数据错位或用户配置不生效的问题。建议紧随 P0 处理。 |
| P2 | 会降低可靠性、诊断性、兼容性或现场维护效率的问题。建议在 P0/P1 稳定后按模块排期。 |
| P3 | 一致性、可维护性、文档追溯或低概率兼容问题。可以随相关模块改动一起处理。 |

</div>

<div id="p0" class="section" hidden="">

## 历史 P0 阻断级问题

<div class="issue-head">

### P0-01 电机位移偏差检测到失步后被后续健康检查覆盖

<span class="badge p0">P0</span>

</div>

<div class="evidence">

**证据位置：**`LTD_MAIN_CPU2/Services/MotorControl/motor_ctrl_motion_api.c:545-577`，调用点 `LTD_MAIN_CPU2/Application/Src/measure.c:835-882`。

</div>

<div class="split">

<div>

#### 问题原因

`MotorCtrl_MoveAndWait()` 在检测到实际位移与目标位移偏差超过 70% 时，将 `ret` 设置为 `ENCODER_LOST_STEP`。随后函数又立即执行 `MotorDriver_SyncPositionOrCheckHealth(&stepper)`，并把返回值重新赋给同一个 `ret`。如果驱动健康检查返回 `NO_ERROR`，前面已经识别出的失步错误会被覆盖。

调用层通常只根据最终返回值决定是否 `SET_ERROR(ret)`。因此“检测到失步”和“函数最终返回成功”之间出现冲突。

</div>

<div>

#### 影响

大幅位移异常可能不上报、不进入故障、不触发恢复，CPU3 和外部主机看到的是正常状态。该问题属于电机安全边界漏报，现场风险高。

</div>

</div>

#### 整改方案

- 将位移偏差结果保存为独立变量，例如 `motion_ret`，驱动健康检查保存为 `health_ret`，不得覆盖首个具体运动错误。
- 返回优先级建议为：运动安全错误优先，其次驱动健康错误，最后速度恢复错误。
- 当 `motion_ret == ENCODER_LOST_STEP` 时，强制进入故障路径并记录错误日志；如果还需要同步驱动状态，把健康检查结果作为附加诊断信息。
- 同步检查 `MotorCtrl_MoveUp/Down`、手动移动、油位/水位/密度路径是否都正确传播该返回值。

#### 验证建议

- 构造电机实际移动距离明显小于目标距离的仿真或 HIL 场景，确认返回 `ENCODER_LOST_STEP`。
- 确认 CPU2 输入寄存器、CPU3 故障页、外部 DSM/SI 状态均能看到该错误码。
- 补单元测试或静态测试，锁定“健康检查成功不能覆盖失步错误”。

<div class="issue-head">

### P0-02 CPU2 FC04 输入寄存器大范围读可能写爆响应缓冲区

<span class="badge p0">P0</span>

</div>

<div class="evidence">

**证据位置：**`LTD_MAIN_CPU2/Services/Modbus/hostcommu_modbus.c:137`、`hostcommu_modbus.c:244-260`、`LTD_MAIN_CPU2/Services/Modbus/hostcommu.h:8`、`stateformodbus.h:374`。

</div>

<div class="split">

<div>

#### 问题原因

`JudgeStartAddress()` 只校验起始地址和寄存器数量是否落在 `INPUTREGISTER_AMOUNT` 范围内，没有限制 Modbus 单帧读寄存器数量。`Compose04Package()` 根据 `RCV_registercnt` 直接写 `sendframe[3...]`，响应长度为 `3 + RCV_registercnt * 2`。

CPU2 的 `HCOM_SendBuff` 只有 1000 字节，而输入寄存器总量约 2570 个。一次大范围 FC04 请求可以通过地址校验，但响应组包会超过缓冲区，并且 `sendframe[2]` 的 byte count 只有 1 字节，超过 255 后还会截断。

</div>

<div>

#### 影响

外部主站或 CPU3 内部主站发出大范围读取时，CPU2 可能发生内存破坏、响应 CRC 错乱、协议失步或运行异常。该问题不应依赖主站“正常不会这么读”来规避。

</div>

</div>

#### 整改方案

- FC04 寄存器数量必须限制为 `1..125`，超限返回异常码 `0x03`。
- 增加响应缓冲长度保护：`5 + 2 * RCV_registercnt <= HOSTCOMMU_SENDLENGTH`，包含地址、功能码、byte count、数据和 CRC。
- 把 FC03/FC04 的数量限制统一封装，避免保持寄存器和输入寄存器口径不同。
- 对 `RCV_registercnt == 0` 也要返回非法数据值，不能生成空成功响应。

#### 验证建议

- 增加 FC04 数量边界测试：0、1、125、126、500、全表数量。
- 确认 126 及以上返回异常响应，且不写响应缓冲越界。
- 用地址靠近输入寄存器末尾的合法/非法组合测试半开区间边界。

<div class="issue-head">

### P0-03 CPU2 FC10 未校验 byte count 和实际帧长，短帧可污染并持久化参数

<span class="badge p0">P0</span>

</div>

<div class="evidence">

**证据位置：**`LTD_MAIN_CPU2/Services/Modbus/hostcommu.c:209-320`、`LTD_MAIN_CPU2/Services/Modbus/hostcommu_modbus.c:277-337`。

</div>

<div class="split">

<div>

#### 问题原因

CPU2 接收层只做了最小长度、地址、功能码、CRC 等基础检查。FC10 处理时解析 `startAddr` 和 `regCount` 后，`Compose10Package()` 没有检查 `revframe[6]` 是否等于 `regCount * 2`，也没有检查实际接收长度是否等于 `9 + byteCount`。

组包函数直接按 `RCV_registercnt` 循环读取 `revframe[j + 7]` 和 `revframe[j + 8]`。短帧情况下，读取内容可能落到 CRC 字节或 DMA 缓冲旧数据，随后写入 `HoldingRegisterArray`，再由 `ReadDeviceParamsFromHoldingRegisters()` 回灌到 `g_deviceParams` 并触发延迟保存。

</div>

<div>

#### 影响

构造一个 CRC 对短帧有效的 FC10 请求，就可能把错误数据写入参数区并持久化。影响范围包括命令、罐高、密度参数、报警参数、电流输出参数等所有可写保持寄存器。

</div>

</div>

#### 整改方案

- 在进入 `Response10Process()` 前按功能码做精确长度校验。
- FC10 规则：`regCount >= 1`，`regCount <= 123`，`byteCount == regCount * 2`，`frameLen == 9 + byteCount`。
- 长度或 byte count 非法时返回异常码 `0x03`，不得调用 `Compose10Package()`、不得回灌参数、不得请求保存。
- 把 `Compose10Package()` 改成只负责“已验证帧”的寄存器写入，函数入口用断言或显式参数说明前置条件。

#### 验证建议

- 构造 FC10 正常写 1/2/123 个寄存器的 golden frame。
- 构造 byte count 少 1、多 1、帧长短、帧长长但 CRC 有效的异常帧，确认全部拒绝且参数快照不变。
- 验证异常帧不会触发 `request_device_params_save()`。

</div>

<div id="p1" class="section" hidden="">

## 历史 P1 高优先级问题

<div class="issue-head">

### P1-01 CPU2 保持寄存器边界 off-by-one，末尾地址可越界读写

<span class="badge p1">P1</span>

</div>

<div class="evidence">

**证据位置：**`LTD_MAIN_CPU2/Services/Modbus/hostcommu_modbus.c:25-27`、`hostcommu_modbus.c:131`、`stateformodbus.h:200`。

</div>

#### 问题原因

`HoldingRegisterArray` 定义为 `HoldingRegisterArray[HOLEREGISTER_STOP]`，合法下标是 `0..HOLEREGISTER_STOP-1`。但 `HoldingregisterAmount` 被定义为 `HOLEREGISTER_STOP + 1`，地址校验因此允许访问 `HOLEREGISTER_STOP` 对应的越界位置。

#### 影响

FC03 可越界读一个保持寄存器，FC10 可越界写一个保持寄存器。虽然越界宽度小，但位置靠近静态数据区，可能污染相邻状态或导致不可预测问题。

#### 整改方案

- 把保持寄存器数量定义统一为 `HOLEREGISTER_STOP`，不要加 1。
- 边界判断改为半开区间：`start >= base` 且 `start + count <= base + amount`。
- 使用无溢出的范围判断，避免 `start + count - 1` 在 count 为 0 时下溢。

#### 验证建议

补边界测试：最后一个合法地址读写成功，`HOLEREGISTER_STOP` 地址读写返回非法地址。

<div class="issue-head">

### P1-02 CPU2 FC03 保持寄存器读未限制 125 个寄存器，byte count 会截断

<span class="badge p1">P1</span>

</div>

<div class="evidence">

**证据位置：**`LTD_MAIN_CPU2/Services/Modbus/hostcommu_modbus.c:218-232`。

</div>

#### 问题原因

`Compose03Package()` 与 FC04 一样使用 `sendframe[2] = RCV_registercnt * 2`，但没有限制 `RCV_registercnt <= 125`。保持寄存器总长度虽然通常不会超过 1000 字节缓冲，但超过 125 后已违反标准 Modbus RTU 响应长度，超过 127 后 byte count 可能接近或超过单字节边界。

#### 影响

外部主站或 CPU3 大块读保持寄存器时，可能收到非标准响应，造成解析错位、CRC 不一致或后续通信失步。

#### 整改方案

- FC03 和 FC04 共用数量校验函数，统一限制 `1..125`。
- 数量非法返回异常码 `0x03`，地址越界返回 `0x02`。
- 在文档中说明大范围读取需要拆分多帧。

#### 验证建议

用 125 和 126 个保持寄存器分别测试，确认 125 成功、126 异常。

<div class="issue-head">

### P1-03 多个测量命令重复调用 MeasureStart 且不检查返回值

<span class="badge p1">P1</span>

</div>

<div class="evidence">

**证据位置：**`LTD_MAIN_CPU2/Application/Src/measure.c:104`、`measure.c:446-467`、`measure.c:511`、`measure.c:571`、`measure.c:613`、`measure_density.c:1474`、`measure_waterLevel.c:1355`。

</div>

#### 问题原因

调度入口 `ProcessMeasureCmd()` 已经调用并检查 `MeasureStart()`。但多个 `CMD_*` 函数内部再次调用 `MeasureStart();`，且不保存返回值。`MeasureStart()` 中 `MotorCtrl_Init()` 失败时会返回错误，但内部调用方没有处理该错误。

#### 影响

第二次初始化失败时，流程仍可能继续进入找水、找底、密度、重量等动作，造成基于无效电机状态的后续操作。该问题还会让错误日志和 CPU3 状态无法反映真正失败原因。

#### 整改方案

- 优先采用单入口初始化：只在调度层执行 `MeasureStart()`，删除子命令内重复调用。
- 如果某些测试命令确实需要独立初始化，应改为 `ret = MeasureStart(); SET_ERROR(ret);` 并在失败时立即返回。
- 梳理所有 `MeasureStart();` 未检查调用点，明确正式命令、调试命令和测试命令的不同策略。

#### 验证建议

模拟 `MotorCtrl_Init()` 返回错误，确认所有正式命令都会停在错误态，不继续执行测量动作。

<div class="issue-head">

### P1-04 取消测量时电机停机失败只打印，仍强制进入待机

<span class="badge p1">P1</span>

</div>

<div class="evidence">

**证据位置：**`LTD_MAIN_CPU2/Application/Src/measure.c:294-314`、`LTD_MAIN_CPU2/Services/MotorControl/motor_ctrl_motion_api.c:840-847`。

</div>

#### 问题原因

`CMD_CancelMeasurement()` 在用户取消时先清命令和错误码，然后调用 `MotorCtrl_SlowStop()`。如果停机返回真实错误，代码只打印日志，随后仍设置 `device_state = STATE_STANDBY`。

#### 影响

用户取消本身不是故障，但取消过程中的停机失败是安全问题。当前逻辑会把“停止失败”对 CPU3 和外部主站隐藏起来，现场可能以为设备已经安全待机。

#### 整改方案

- 先执行停机，确认停机成功后再清取消相关状态。
- 如果 `MotorCtrl_SlowStop()` 返回真实错误，调用 `FaultManager_SetErrorState()` 或等效路径进入 `STATE_ERROR`。
- 取消成功和取消失败分别记录不同日志，便于现场判断。

#### 验证建议

注入 TMC 停机失败或通信失败，执行取消命令，确认 CPU2/CPU3/外部协议均显示具体错误而不是待机。

<div class="issue-head">

### P1-05 STATE_SWITCH 被 SET_ERROR 吞掉后，包装函数继续写完成态

<span class="badge p1">P1</span>

</div>

<div class="evidence">

**证据位置：**`LTD_MAIN_CPU2/Application/Inc/fault_manager.h:168-178`、`LTD_MAIN_CPU2/Application/Src/measure.c:509-518`、`measure.c:569-578`、`measure.c:611-700`、`measure.c:963`。

</div>

#### 问题原因

`SET_ERROR()` 对 `STATE_SWITCH` 不进入错误路径，也不返回。水位、回零、找底、空/满载重量等命令包装层在子流程返回 `STATE_SWITCH` 后继续执行后续语句，最终写入 `STATE_FINDWATER_OVER`、`STATE_STANDBY`、`STATE_FINDBOTTOM_OVER` 等完成态。

#### 影响

命令切换或取消发生时，CPU2 可能短暂或持续报告“完成”，CPU3 和外部主站可能将中断流程的结果当作有效结果。

#### 整改方案

- 在所有可能返回 `STATE_SWITCH` 的调用后增加显式判断：`if (ret == STATE_SWITCH) return;`。
- 新增专用宏，例如 `SET_ERROR_OR_SWITCH_RETURN(ret)`，避免 void 包装函数遗漏。
- 对测量完成态写入做统一保护：只有 `ret == NO_ERROR` 才能写完成态。

#### 验证建议

在水位、找底、回零、密度过程中注入新命令，确认旧命令不会发布完成态或有效结果。

<div class="issue-head">

### P1-06 区间密度点数循环变量为 int8_t，点数超过 127 有越界风险

<span class="badge p1">P1</span>

</div>

<div class="evidence">

**证据位置：**`LTD_MAIN_CPU2/Application/Src/measure_density.c:643-714`、`LTD_MAIN_CPU2/Application/Inc/measure_density.h:15`。

</div>

#### 问题原因

区间点数 `c_num` 最大被钳到 `MAX_MEASUREMENT_POINTS`，当前为 200。但循环变量 `i` 使用 `int8_t`。当点数大于 127 时，`i++` 会溢出为负数，仍满足 `i < c_num`，并继续作为数组下标。

#### 影响

配置 128 到 200 个区间密度点时，可能出现栈越界、死循环、测量卡死或结果数组污染。

#### 整改方案

- 循环变量改为 `int` 或 `uint32_t`。
- 参数写入阶段限制 `spreadMeasurementCount` 的业务上限。
- 明确 Wartsila/DSM/内部协议对最大密度点数的统一口径。
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
