duanxuebin1998/cube/docs/00_构建与版本/故障码/LTD内部技术与治理资料.xlsx

Sheet: 故障代码技术表
屏幕编号 | 完整码 | 内部标识 | 类别代码 | 子代码 | 类别 | 责任域 | 日志名称 | 日志原因 | CPU3显示 | 当前状态 | 引用次数 | 主要调用位置 | 一代对照 | 兼容性影响
— | 0x00000000 | NO_ERROR | 0 | 0 | 正常状态 | 状态/非故障 | 正常 | — | — | 非故障状态 | 944 | LTD_MAIN_CPU2/Application/Inc/fault_manager.h:126 LTD_MAIN_CPU2/Application/Inc/fault_manager.h:134 LTD_MAIN_CPU2/Application/Inc/fault_manager.h:154 LTD_MAIN_CPU2/Application/Inc/fault_manager.h:172 LTD_MAIN_CPU2/Application/Inc/measure_density.h:73 LTD_MAIN_CPU2/Application/Inc/measure_density.h:80 | 一代无直接同义编号；按二代责任域独立编号 | 协议29正式版；CPU2/CPU3 V1.34.0.0；不兼容协议28旧故障码
— | 0x00000001 | STATE_SWITCH | 0 | 1 | 正常状态 | 状态/非故障 | 状态切换 | — | — | 非故障状态 | 213 | LTD_MAIN_CPU2/Application/Inc/fault_manager.h:144 LTD_MAIN_CPU2/Application/Inc/fault_manager.h:172 LTD_MAIN_CPU2/Application/Inc/fault_manager.h:188 LTD_MAIN_CPU2/Application/Inc/fault_manager.h:190 LTD_MAIN_CPU2/Application/Inc/fault_manager.h:192 LTD_MAIN_CPU2/Application/Src/app_main.c:72 | 一代无直接同义编号；按二代责任域独立编号 | 协议29正式版；CPU2/CPU3 V1.34.0.0；不兼容协议28旧故障码
11-2 | 0x000B0002 | MOTOR_TMC_COMM_ERROR | 11 | 2 | 电机驱动 | 电机驱动 | TMC5130通信异常 | TMC5130寄存器通信失败 | TMC5130通信异常 | 使用中 | 47 | LTD_MAIN_CPU2/Application/Src/fault_manager.c:67 LTD_MAIN_CPU2/Application/Src/fault_recovery.c:45 LTD_MAIN_CPU2/Application/Src/measure_zero.c:67 LTD_MAIN_CPU2/BSP/Peripherals/src/TMC5130.c:47 LTD_MAIN_CPU2/BSP/Peripherals/src/TMC5130.c:343 LTD_MAIN_CPU2/BSP/Peripherals/src/TMC5130.c:369 LTD_MAIN_CPU2/BSP/Peripherals/src/TMC5130.c:431 LTD_MAIN_CPU2/BSP/Peripherals/src/TMC5130.c:454 | 1-2 电机通讯错误 | 协议29正式版；CPU2/CPU3 V1.34.0.0；不兼容协议28旧故障码
11-3 | 0x000B0003 | MOTOR_TMC_CONFIG_LOST | 11 | 3 | 电机驱动 | 电机驱动 | 电机驱动配置丢失 | TMC5130运行期复位或关键配置丢失 | 电机驱动配置丢失 | 使用中 | 7 | LTD_MAIN_CPU2/Application/Src/fault_manager.c:68 LTD_MAIN_CPU2/Application/Src/fault_recovery.c:46 LTD_MAIN_CPU2/Application/Src/measure_zero.c:68 LTD_MAIN_CPU2/BSP/Peripherals/src/TMC5130.c:881 LTD_MAIN_CPU2/BSP/Peripherals/src/TMC5130.c:888 LTD_MAIN_CPU2/BSP/Peripherals/src/TMC5130.c:1021 LTD_MAIN_CPU2/BSP/Peripherals/src/TMC5130.c:1028 | 1-3 电机驱动异常重启 | 协议29正式版；CPU2/CPU3 V1.34.0.0；不兼容协议28旧故障码
11-4 | 0x000B0004 | MOTOR_DISABLED | 11 | 4 | 电机驱动 | 电机驱动 | 电机驱动未使能 | 电机驱动输出未使能 | 电机驱动未使能 | 使用中 | 5 | LTD_MAIN_CPU2/Application/Src/fault_recovery.c:48 LTD_MAIN_CPU2/Application/Src/measure_zero.c:70 LTD_MAIN_CPU2/BSP/Peripherals/src/TMC5130.c:1071 LTD_MAIN_CPU2/BSP/Peripherals/src/TMC5130.c:1075 LTD_MAIN_CPU2/Services/MotorControl/motor_ctrl_driver_param.c:162 | 1-4 修改电机使能输入状态后无法运行（上限位） | 协议29正式版；CPU2/CPU3 V1.34.0.0；不兼容协议28旧故障码
11-5 | 0x000B0005 | MOTOR_UNKNOWN_FEEDBACK | 11 | 5 | 电机驱动 | 电机驱动 | 电机反馈未知 | 电机反馈状态无法识别 | 电机反馈未知 | 使用中 | 2 | LTD_MAIN_CPU2/Application/Src/fault_recovery.c:70 LTD_MAIN_CPU2/BSP/Peripherals/src/TMC5130.c:964 | 1-5 电机状态异常 | 协议29正式版；CPU2/CPU3 V1.34.0.0；不兼容协议28旧故障码
11-10 | 0x000B000A | MOTOR_STEP_ERROR | 11 | 10 | 电机驱动 | 电机驱动 | 电机无有效位移 | 丢步检测 | 电机无有效位移 | 使用中 | 4 | LTD_MAIN_CPU2/Services/MotorControl/motor_ctrl_motion_api.c:1108 LTD_MAIN_CPU2/Services/MotorControl/motor_ctrl_motion_api.c:1111 LTD_MAIN_CPU2/Services/MotorControl/motor_ctrl_motion_api.c:1122 LTD_MAIN_CPU2/Services/MotorControl/motor_ctrl_motion_api.c:2024 | 1-10 输入步进数错误； 下位位置高于当前位置 限制上行时步进数超过零点 | 协议29正式版；CPU2/CPU3 V1.34.0.0；不兼容协议28旧故障码
11-11 | 0x000B000B | MOTOR_STALL_ERROR | 11 | 11 | 电机驱动 | 电机驱动 | 电机堵转 | 电机堵转或负载阻力过大 | 电机运行阻力大 | 使用中 | 3 | LTD_MAIN_CPU2/Application/Src/fault_recovery.c:72 LTD_MAIN_CPU2/BSP/Peripherals/src/TMC5130.c:97 LTD_MAIN_CPU2/BSP/Peripherals/src/TMC5130.c:148 | 1-11 电机堵转 | 协议29正式版；CPU2/CPU3 V1.34.0.0；不兼容协议28旧故障码
11-16 | 0x000B0010 | MOTOR_CHARGE_PUMP_UNDER_VOLTAGE | 11 | 16 | 电机驱动 | 电机驱动 | 电荷泵欠压 | 电荷泵欠压 | 电荷泵欠压 | 使用中 | 3 | LTD_MAIN_CPU2/Application/Src/fault_recovery.c:47 LTD_MAIN_CPU2/Application/Src/measure_zero.c:69 LTD_MAIN_CPU2/BSP/Peripherals/src/TMC5130.c:998 | 1-7 电机驱动器报警 | 协议29正式版；CPU2/CPU3 V1.34.0.0；不兼容协议28旧故障码
11-17 | 0x000B0011 | MOTOR_OVERTEMPERATURE | 11 | 17 | 电机驱动 | 电机驱动 | 电机驱动过温关断 | 电机驱动已过温关断 | 电机驱动过温停止 | 使用中 | 3 | LTD_MAIN_CPU2/Application/Src/fault_recovery.c:71 LTD_MAIN_CPU2/BSP/Peripherals/src/TMC5130.c:101 LTD_MAIN_CPU2/BSP/Peripherals/src/TMC5130.c:142 | 1-7 电机驱动器报警 | 协议29正式版；CPU2/CPU3 V1.34.0.0；不兼容协议28旧故障码
11-18 | 0x000B0012 | MOTOR_RUN_TIMEOUT | 11 | 18 | 电机驱动 | 电机驱动 | 电机运行超时 | 电机整段运行超时 | 电机运行超时 | 使用中 | 6 | LTD_MAIN_CPU2/Application/Src/fault_recovery.c:50 LTD_MAIN_CPU2/Application/Src/measure_zero.c:72 LTD_MAIN_CPU2/Services/MotorControl/motor_ctrl_motion_api.c:2028 LTD_MAIN_CPU2/Services/MotorControl/motor_ctrl_motion_api.c:2352 LTD_MAIN_CPU2/Services/MotorControl/motor_ctrl_motion_api.c:2355 LTD_MAIN_CPU2/Services/MotorControl/motor_ctrl_motion_api.c:2362 | 1-10 输入步进数错误 | 协议29正式版；CPU2/CPU3 V1.34.0.0；不兼容协议28旧故障码
11-19 | 0x000B0013 | MOTOR_PHASE_SHORT_ERROR | 11 | 19 | 电机驱动 | 电机驱动 | 电机相线短路 | 电机相线检测到短路 | 电机相线短路 | 使用中 | 4 | LTD_MAIN_CPU2/Application/Src/fault_recovery.c:73 LTD_MAIN_CPU2/BSP/Peripherals/src/TMC5130.c:114 LTD_MAIN_CPU2/BSP/Peripherals/src/TMC5130.c:121 LTD_MAIN_CPU2/BSP/Peripherals/src/TMC5130.c:144 | 1-15 电机芯片报警 | 协议29正式版；CPU2/CPU3 V1.34.0.0；不兼容协议28旧故障码
11-20 | 0x000B0014 | MOTOR_PHASE_OPEN_ERROR | 11 | 20 | 电机驱动 | 电机驱动 | 电机相线断路 | 电机相线断路或接触不良 | 电机相线开路 | 使用中 | 4 | LTD_MAIN_CPU2/Application/Src/fault_recovery.c:74 LTD_MAIN_CPU2/BSP/Peripherals/src/TMC5130.c:128 LTD_MAIN_CPU2/BSP/Peripherals/src/TMC5130.c:135 LTD_MAIN_CPU2/BSP/Peripherals/src/TMC5130.c:146 | 1-15 电机芯片报警 | 协议29正式版；CPU2/CPU3 V1.34.0.0；不兼容协议28旧故障码
11-21 | 0x000B0015 | MOTOR_DRIVER_OVERTEMP_WARNING | 11 | 21 | 电机驱动 | 电机驱动 | 电机驱动过温预警 | 电机驱动温度接近保护值 | 电机驱动过温预警 | 使用中 | 3 | LTD_MAIN_CPU2/Application/Src/fault_recovery.c:75 LTD_MAIN_CPU2/BSP/Peripherals/src/TMC5130.c:107 LTD_MAIN_CPU2/BSP/Peripherals/src/TMC5130.c:150 | 1-7 电机驱动器报警 | 协议29正式版；CPU2/CPU3 V1.34.0.0；不兼容协议28旧故障码
11-22 | 0x000B0016 | MOTOR_DRIVER_NOT_INITIALIZED | 11 | 22 | 电机驱动 | 电机驱动 | 电机驱动未初始化 | 电机驱动尚未完成初始化 | 电机驱动未初始化 | 使用中 | 6 | LTD_MAIN_CPU2/Application/Src/fault_recovery.c:49 LTD_MAIN_CPU2/Application/Src/measure_zero.c:71 LTD_MAIN_CPU2/Services/MotorControl/motor_ctrl_driver_param.c:319 LTD_MAIN_CPU2/Services/MotorControl/motor_ctrl_position_model.c:439 LTD_MAIN_CPU2/Services/MotorControl/motor_ctrl_position_model.c:575 LTD_MAIN_CPU2/Services/MotorControl/motor_ctrl_position_model.c:880 | 1-3 电机驱动异常重启；1-4 修改电机使能输入状态后无法运行（上限位） | 协议29正式版；CPU2/CPU3 V1.34.0.0；不兼容协议28旧故障码
11-23 | 0x000B0017 | MOTOR_STOP_WAIT_TIMEOUT | 11 | 23 | 电机驱动 | 电机驱动 | 电机停止等待超时 | 停止命令后电机未在规定时间停稳 | 电机停止等待超时 | 使用中 | 6 | LTD_MAIN_CPU2/Application/Src/fault_recovery.c:51 LTD_MAIN_CPU2/Application/Src/measure_zero.c:73 LTD_MAIN_CPU2/Services/MotorControl/motor_ctrl_driver_param.c:735 LTD_MAIN_CPU2/Services/MotorControl/motor_ctrl_driver_param.c:736 LTD_MAIN_CPU2/Services/MotorControl/motor_ctrl_motion_api.c:2416 LTD_MAIN_CPU2/Services/MotorControl/motor_ctrl_motion_api.c:2420 | 1-10 输入步进数错误； 下位位置高于当前位置 限制上行时步进数超过零点 | 协议29正式版；CPU2/CPU3 V1.34.0.0；不兼容协议28旧故障码
11-24 | 0x000B0018 | MOTOR_ARRIVAL_WAIT_TIMEOUT | 11 | 24 | 电机驱动 | 电机驱动 | 电机到位等待超时 | 电机未在规定时间到达目标位置 | 电机到位等待超时 | 使用中 | 5 | LTD_MAIN_CPU2/Application/Src/fault_recovery.c:52 LTD_MAIN_CPU2/Application/Src/measure_zero.c:74 LTD_MAIN_CPU2/Services/MotorControl/motor_ctrl_motion_api.c:1181 LTD_MAIN_CPU2/Services/MotorControl/motor_ctrl_motion_api.c:1184 LTD_MAIN_CPU2/Services/MotorControl/motor_ctrl_motion_api.c:1191 | 1-10 输入步进数错误 | 协议29正式版；CPU2/CPU3 V1.34.0.0；不兼容协议28旧故障码
12-1 | 0x000C0001 | ENCODER_TIMEOUT | 12 | 1 | 编码器 | 编码器链路 | 编码器采集接口异常 | 编码器SPI或DMA采集接口异常 | 编码器读取异常 | 使用中 | 10 | LTD_MAIN_CPU2/Application/Src/app_main.c:33 LTD_MAIN_CPU2/BSP/Peripherals/src/AS5145.c:157 LTD_MAIN_CPU2/BSP/Peripherals/src/AS5145.c:178 LTD_MAIN_CPU2/BSP/Peripherals/src/AS5145.c:260 LTD_MAIN_CPU2/BSP/Peripherals/src/AS5145.c:261 LTD_MAIN_CPU2/BSP/Peripherals/src/AS5145.c:276 LTD_MAIN_CPU2/BSP/Peripherals/src/AS5145.c:277 LTD_MAIN_CPU2/Services/Encoder/encoder.c:176 | 2-1 与EC板通讯超时 （EC板和主控板通讯问题） | 协议29正式版；CPU2/CPU3 V1.34.0.0；不兼容协议28旧故障码
12-2 | 0x000C0002 | ENCODER_PARITY_ERROR | 12 | 2 | 编码器 | 编码器链路 | 编码器校验失败 | 编码器校验失败 | 编码器校验失败 | 使用中 | 1 | LTD_MAIN_CPU2/BSP/Peripherals/src/AS5145.c:160 | 2-2 与EC板通讯编码数据校验错误 | 协议29正式版；CPU2/CPU3 V1.34.0.0；不兼容协议28旧故障码
12-3 | 0x000C0003 | ENCODER_LOST_STEP | 12 | 3 | 编码器 | 编码器链路 | 编码器检测到丢步 | 丢步检测 | 编码器检测到丢步 | 使用中 | 4 | LTD_MAIN_CPU2/Services/MotorControl/motor_ctrl_lost_step_detect.c:168 LTD_MAIN_CPU2/Services/MotorControl/motor_ctrl_lost_step_detect.c:191 LTD_MAIN_CPU2/Services/MotorControl/motor_ctrl_motion_api.c:553 LTD_MAIN_CPU2/Services/MotorControl/motor_ctrl_position_model.c:518 | 2-3 运行过程中丢步 | 协议29正式版；CPU2/CPU3 V1.34.0.0；不兼容协议28旧故障码
12-5 | 0x000C0005 | ENCODER_POWERON_FAIL | 12 | 5 | 编码器 | 编码器链路 | 编码器上电初始化失败 | 初始化失败 | 编码器上电初始化失败 | 使用中 | 4 | LTD_MAIN_CPU2/Application/Src/test.c:2256 LTD_MAIN_CPU2/Application/Src/test.c:2269 LTD_MAIN_CPU2/Application/Src/test.c:2270 LTD_MAIN_CPU2/Services/Encoder/encoder.c:165 | 2-5 读取断电编码值失败 | 协议29正式版；CPU2/CPU3 V1.34.0.0；不兼容协议28旧故障码
12-6 | 0x000C0006 | ENCODER_POWERON_CHANGE | 12 | 6 | 编码器 | 编码器链路 | 编码器上电值变化 | 编码器上电状态变化 | 编码器上电值变化 | 预留 | 0 | 无主动调用 | 2-6 上电后编码值变动； | 协议29正式版；CPU2/CPU3 V1.34.0.0；不兼容协议28旧故障码
12-10 | 0x000C000A | ENCODER_DIFF_EXCESS | 12 | 10 | 编码器 | 编码器链路 | 编码器相邻差值过大 | 丢步检测 | 编码器相邻差值过大 | 使用中 | 1 | LTD_MAIN_CPU2/Services/MotorControl/motor_ctrl_position_model.c:518 | 2-10 固定点检测时编码值发生变化 | 协议29正式版；CPU2/CPU3 V1.34.0.0；不兼容协议28旧故障码
12-12 | 0x000C000C | ENCODER_CORDIC_OVERFLOW | 12 | 12 | 编码器 | 编码器链路 | 编码器角度运算溢出 | 编码器内部角度运算溢出 | 编码器角度运算溢出 | 使用中 | 1 | LTD_MAIN_CPU2/BSP/Peripherals/src/AS5145.c:166 | 一代无直接同义编号；按二代责任域独立编号 | 协议29正式版；CPU2/CPU3 V1.34.0.0；不兼容协议28旧故障码
12-13 | 0x000C000D | ENCODER_LINEARITY_WARNING | 12 | 13 | 编码器 | 编码器链路 | 编码器线性度报警 | 编码器线性度报警 | 编码器线性度报警 | 使用中 | 1 | LTD_MAIN_CPU2/BSP/Peripherals/src/AS5145.c:169 | 一代无直接同义编号；按二代责任域独立编号 | 协议29正式版；CPU2/CPU3 V1.34.0.0；不兼容协议28旧故障码
12-14 | 0x000C000E | ENCODER_OCF_INCOMPLETE | 12 | 14 | 编码器 | 编码器链路 | 编码器角度计算未完成 | 编码器角度计算尚未完成 | 编码器角度计算未完成 | 使用中 | 1 | LTD_MAIN_CPU2/BSP/Peripherals/src/AS5145.c:163 | 一代无直接同义编号；按二代责任域独立编号 | 协议29正式版；CPU2/CPU3 V1.34.0.0；不兼容协议28旧故障码
12-15 | 0x000C000F | ENCODER_FIRST_SAMPLE_TIMEOUT | 12 | 15 | 编码器 | 编码器链路 | 编码器首帧超时 | 启动后未收到首个有效位置 | 编码器首次读取超时 | 使用中 | 8 | LTD_MAIN_CPU2/Application/Src/app_main.c:33 LTD_MAIN_CPU2/Application/Src/app_main.c:144 LTD_MAIN_CPU2/BSP/Peripherals/src/AS5145.c:178 LTD_MAIN_CPU2/BSP/Peripherals/src/AS5145.c:328 LTD_MAIN_CPU2/Services/MotorControl/motor_ctrl_driver_param.c:208 LTD_MAIN_CPU2/Services/MotorControl/motor_ctrl_driver_param.c:220 LTD_MAIN_CPU2/Services/MotorControl/motor_ctrl_driver_param.c:222 LTD_MAIN_CPU2/Services/MotorControl/motor_ctrl_position_model.c:1088 | 2-1 与EC板通讯超时 （EC板和主控板通讯问题） | 协议29正式版；CPU2/CPU3 V1.34.0.0；不兼容协议28旧故障码
12-16 | 0x000C0010 | ENCODER_CIRCUMFERENCE_CALIBRATION_ERROR | 12 | 16 | 编码器 | 编码器链路 | 编码轮周长标定异常 | 编码轮周长标定结果不可信 | 编码轮周长标定异常 | 使用中 | 25 | LTD_MAIN_CPU2/Application/Src/fault_recovery.c:76 LTD_MAIN_CPU2/Services/MotorControl/motor_ctrl_motion_api.c:358 LTD_MAIN_CPU2/Services/MotorControl/motor_ctrl_motion_api.c:364 LTD_MAIN_CPU2/Services/MotorControl/motor_ctrl_motion_api.c:391 LTD_MAIN_CPU2/Services/MotorControl/motor_ctrl_motion_api.c:400 LTD_MAIN_CPU2/Services/MotorControl/motor_ctrl_position_model.c:457 LTD_MAIN_CPU2/Services/MotorControl/motor_ctrl_position_model.c:578 LTD_MAIN_CPU2/Services/MotorControl/motor_ctrl_position_model.c:590 | 2-3 运行过程中丢步；2-10 固定点检测时编码值发生变化 | 协议29正式版；CPU2/CPU3 V1.34.0.0；不兼容协议28旧故障码
13-1 | 0x000D0001 | SENSOR_BCC_ERROR | 13 | 1 | 传感器与密度 | 传感器与密度 | 传感器校验错误 | 传感器数据校验失败 | 传感器校验错误 | 使用中 | 5 | LTD_MAIN_CPU2/Services/Sensor/dsm_sensor_communication.c:432 LTD_MAIN_CPU2/Services/Sensor/dsm_sensor_communication.c:793 LTD_MAIN_CPU2/Services/Sensor/ltd_sensor_communication.c:295 LTD_MAIN_CPU2/Services/Sensor/SafeProtocol/sensor_safe_legacy_adapter.c:33 LTD_MAIN_CPU2/Services/Sensor/SafeProtocol/sensor_safe_legacy_adapter.c:84 | 3-1 传感器数据校验错误 | 协议29正式版；CPU2/CPU3 V1.34.0.0；不兼容协议28旧故障码
13-2 | 0x000D0002 | SONIC_FREQ_ABNORMAL | 13 | 2 | 传感器与密度 | 传感器与密度 | 震动管频率异常 | 震动管频率异常 | 震动管频率异常 | 使用中 | 14 | LTD_MAIN_CPU2/Application/Src/measure_density.c:1304 LTD_MAIN_CPU2/Application/Src/wartsila_density_measurement.c:224 LTD_MAIN_CPU2/Services/Sensor/SafeProtocol/sensor_safe_legacy_adapter.c:348 LTD_MAIN_CPU2/Services/Sensor/SafeProtocol/sensor_safe_legacy_adapter.c:357 LTD_MAIN_CPU2/Services/Sensor/sensor.c:435 LTD_MAIN_CPU2/Services/Sensor/sensor.c:546 LTD_MAIN_CPU2/Services/Sensor/sensor.c:549 LTD_MAIN_CPU2/Services/Sensor/sensor.c:552 | 3-2 密度传感器频率异常 | 协议29正式版；CPU2/CPU3 V1.34.0.0；不兼容协议28旧故障码
13-3 | 0x000D0003 | SENSOR_DEVICE_COMM_TIMEOUT | 13 | 3 | 传感器与密度 | 传感器与密度 | 传感器通信超时 | 传感器无响应 | 传感器通信超时 | 使用中 | 25 | LTD_MAIN_CPU2/Services/Sensor/ch9141_at.c:174 LTD_MAIN_CPU2/Services/Sensor/ch9141_at.c:510 LTD_MAIN_CPU2/Services/Sensor/ch9141_at.c:599 LTD_MAIN_CPU2/Services/Sensor/dsm_sensor_communication.c:254 LTD_MAIN_CPU2/Services/Sensor/dsm_sensor_communication.c:409 LTD_MAIN_CPU2/Services/Sensor/dsm_sensor_communication.c:442 LTD_MAIN_CPU2/Services/Sensor/ltd_sensor_communication.c:241 LTD_MAIN_CPU2/Services/Sensor/ltd_sensor_communication.c:345 | 3-3 密度传感器通信超时 | 协议29正式版；CPU2/CPU3 V1.34.0.0；不兼容协议28旧故障码
13-5 | 0x000D0005 | SENSOR_INTERNAL_CPU_COMM_TIMEOUT | 13 | 5 | 传感器与密度 | 传感器与密度 | 传感器内部通信超时 | 传感器内部处理单元通信超时 | 传感器内部通信超时 | 使用中 | 1 | LTD_MAIN_CPU2/Services/Sensor/dsm_sensor_communication.c:60 | 3-5 二代密度传感器：密度传感器组件失效 三代密度传感器：与CPU0通讯超时 | 协议29正式版；CPU2/CPU3 V1.34.0.0；不兼容协议28旧故障码
13-14 | 0x000D000E | SENSOR_GYRO_ANGLE_ERROR | 13 | 14 | 传感器与密度 | 传感器与密度 | 传感器姿态角异常 | 传感器姿态角异常 | 传感器角度异常 | 使用中 | 2 | LTD_MAIN_CPU2/Services/Sensor/dsm_sensor_communication.c:58 LTD_MAIN_CPU2/Services/Sensor/SafeProtocol/sensor_safe_legacy_adapter.c:381 | 3-14 本次确认液体或者空气中角度值与上次差值大; | 协议29正式版；CPU2/CPU3 V1.34.0.0；不兼容协议28旧故障码
13-16 | 0x000D0010 | SENSOR_INTERNAL_COMM_CHECK_ERROR | 13 | 16 | 传感器与密度 | 传感器与密度 | 传感器内部校验异常 | 传感器内部通信校验异常 | 传感器内部校验异常 | 使用中 | 1 | LTD_MAIN_CPU2/Services/Sensor/dsm_sensor_communication.c:61 | 3-16 与密度管通讯校验错误 | 协议29正式版；CPU2/CPU3 V1.34.0.0；不兼容协议28旧故障码
13-21 | 0x000D0015 | SENSOR_NO_RESONANCE | 13 | 21 | 传感器与密度 | 传感器与密度 | 传感器无谐振 | 传感器未检测到谐振信号 | 传感器频率异常 | 使用中 | 1 | LTD_MAIN_CPU2/Services/Sensor/dsm_sensor_communication.c:55 | 3-21 传感器扫频无谐振(FS) （探头频率>17900或小于10010） | 协议29正式版；CPU2/CPU3 V1.34.0.0；不兼容协议28旧故障码
13-26 | 0x000D001A | DENSITY_INVALID | 13 | 26 | 传感器与密度 | 传感器与密度 | 密度值异常 | 密度值异常（有效范围>0且≤3000.0kg/m³） | 密度值异常 | 使用中 | 4 | LTD_MAIN_CPU2/Application/Src/measure_oilLevel.c:356 LTD_MAIN_CPU2/Application/Src/measure_oilLevel.c:511 LTD_MAIN_CPU2/Application/Src/measure_oilLevel.c:514 LTD_MAIN_CPU2/Services/Sensor/SafeProtocol/sensor_safe_legacy_adapter.c:345 | 3-26 等同于3-12（3-26不会受密度分层影响） 1.二代密度传感器的频率异常 2.三代传感器的密度值异常； 3.温度无效值。 | 协议29正式版；CPU2/CPU3 V1.34.0.0；不兼容协议28旧故障码
13-27 | 0x000D001B | SENSOR_RESP_FORMAT_ERROR | 13 | 27 | 传感器与密度 | 传感器与密度 | 传感器响应格式异常 | 传感器响应内容不符合协议 | 传感器响应格式异常 | 使用中 | 28 | LTD_MAIN_CPU2/Services/Sensor/dsm_sensor_communication.c:168 LTD_MAIN_CPU2/Services/Sensor/dsm_sensor_communication.c:199 LTD_MAIN_CPU2/Services/Sensor/dsm_sensor_communication.c:238 LTD_MAIN_CPU2/Services/Sensor/dsm_sensor_communication.c:254 LTD_MAIN_CPU2/Services/Sensor/dsm_sensor_communication.c:412 LTD_MAIN_CPU2/Services/Sensor/dsm_sensor_communication.c:529 LTD_MAIN_CPU2/Services/Sensor/dsm_sensor_communication.c:549 LTD_MAIN_CPU2/Services/Sensor/dsm_sensor_communication.c:573 | 一代无直接同义编号；按二代责任域独立编号 | 协议29正式版；CPU2/CPU3 V1.34.0.0；不兼容协议28旧故障码
13-28 | 0x000D001C | SENSOR_POWER_SUPPLY_ERROR | 13 | 28 | 传感器与密度 | 传感器与密度 | 传感器供电异常 | 传感器供电电压异常 | 传感器电源异常 | 使用中 | 2 | LTD_MAIN_CPU2/Services/Sensor/dsm_sensor_communication.c:56 LTD_MAIN_CPU2/Services/Sensor/SafeProtocol/sensor_safe_legacy_adapter.c:108 | 3-3 密度传感器通信超时；3-5 二代密度传感器：密度传感器组件失效 三代密度传感器：与CPU0通讯超时 | 协议29正式版；CPU2/CPU3 V1.34.0.0；不兼容协议28旧故障码
13-29 | 0x000D001D | SENSOR_GYRO_COMM_TIMEOUT | 13 | 29 | 传感器与密度 | 传感器与密度 | 姿态模块通信超时 | 传感器姿态模块通信超时 | 角度单元通信超时 | 使用中 | 1 | LTD_MAIN_CPU2/Services/Sensor/dsm_sensor_communication.c:57 | 3-8 陀螺仪组件未响应；；3-10 读取陀螺仪时通信超时； | 协议29正式版；CPU2/CPU3 V1.34.0.0；不兼容协议28旧故障码
13-30 | 0x000D001E | SENSOR_SELF_TEST_FAILED | 13 | 30 | 传感器与密度 | 传感器与密度 | 传感器自检失败 | 传感器自检未通过 | 传感器自检失败 | 使用中 | 2 | LTD_MAIN_CPU2/Services/Sensor/dsm_sensor_communication.c:59 LTD_MAIN_CPU2/Services/Sensor/SafeProtocol/sensor_safe_legacy_adapter.c:106 | 3-5 二代密度传感器：密度传感器组件失效 三代密度传感器：与CPU0通讯超时 | 协议29正式版；CPU2/CPU3 V1.34.0.0；不兼容协议28旧故障码
13-31 | 0x000D001F | SENSOR_IDENTITY_MISMATCH | 13 | 31 | 传感器与密度 | 传感器与密度 | 传感器身份不匹配 | 传感器身份信息与当前设备配置不一致 | 传感器身份不一致 | 使用中 | 3 | LTD_MAIN_CPU2/Application/Src/fault_recovery.c:77 LTD_MAIN_CPU2/Services/Sensor/SafeProtocol/sensor_safe_legacy_adapter.c:43 LTD_MAIN_CPU2/Services/Sensor/SafeProtocol/sensor_safe_legacy_adapter.c:150 | 一代无直接同义编号；按二代责任域独立编号 | 协议29正式版；CPU2/CPU3 V1.34.0.0；不兼容协议28旧故障码
13-32 | 0x000D0020 | SENSOR_PROTOCOL_VERSION_INCOMPATIBLE | 13 | 32 | 传感器与密度 | 传感器与密度 | 传感器协议版本不兼容 | 传感器通信协议版本不兼容 | 传感器协议版本不匹配 | 使用中 | 3 | LTD_MAIN_CPU2/Application/Src/fault_recovery.c:78 LTD_MAIN_CPU2/Services/Sensor/SafeProtocol/sensor_safe_legacy_adapter.c:35 LTD_MAIN_CPU2/Services/Sensor/SafeProtocol/sensor_safe_legacy_adapter.c:76 | 一代无直接同义编号；按二代责任域独立编号 | 协议29正式版；CPU2/CPU3 V1.34.0.0；不兼容协议28旧故障码
13-33 | 0x000D0021 | SENSOR_MODE_NOT_READY | 13 | 33 | 传感器与密度 | 传感器与密度 | 传感器模式未就绪 | 传感器测量模式尚未准备完成 | 传感器模式未准备 | 使用中 | 2 | LTD_MAIN_CPU2/Services/Sensor/SafeProtocol/sensor_safe_legacy_adapter.c:92 LTD_MAIN_CPU2/Services/Sensor/SafeProtocol/sensor_safe_legacy_adapter.c:308 | 一代无直接同义编号；按二代责任域独立编号 | 协议29正式版；CPU2/CPU3 V1.34.0.0；不兼容协议28旧故障码
13-34 | 0x000D0022 | SENSOR_CONFIG_EPOCH_MISMATCH | 13 | 34 | 传感器与密度 | 传感器与密度 | 传感器配置代次不一致 | 传感器配置代次与当前会话不一致 | 传感器配置代次不一致 | 使用中 | 2 | LTD_MAIN_CPU2/Services/Sensor/SafeProtocol/sensor_safe_legacy_adapter.c:53 LTD_MAIN_CPU2/Services/Sensor/SafeProtocol/sensor_safe_legacy_adapter.c:102 | 一代无直接同义编号；按二代责任域独立编号 | 协议29正式版；CPU2/CPU3 V1.34.0.0；不兼容协议28旧故障码
13-35 | 0x000D0023 | SENSOR_STREAM_STATE_ERROR | 13 | 35 | 传感器与密度 | 传感器与密度 | 传感器上报状态不一致 | 传感器周期上报状态与当前记录不一致 | 传感器上报状态不一致 | 使用中 | 1 | LTD_MAIN_CPU2/Services/Sensor/SafeProtocol/sensor_safe_legacy_adapter.c:57 | 一代无直接同义编号；按二代责任域独立编号 | 协议29正式版；CPU2/CPU3 V1.34.0.0；不兼容协议28旧故障码
13-36 | 0x000D0024 | SENSOR_DATA_STALE | 13 | 36 | 传感器与密度 | 传感器与密度 | 传感器数据过期 | 传感器数据超过允许更新时间 | 传感器数据过期 | 使用中 | 3 | LTD_MAIN_CPU2/Services/Sensor/SafeProtocol/sensor_safe_legacy_adapter.c:61 LTD_MAIN_CPU2/Services/Sensor/SafeProtocol/sensor_safe_legacy_adapter.c:100 LTD_MAIN_CPU2/Services/Sensor/SafeProtocol/sensor_safe_legacy_adapter.c:144 | 一代无直接同义编号；按二代责任域独立编号 | 协议29正式版；CPU2/CPU3 V1.34.0.0；不兼容协议28旧故障码
13-37 | 0x000D0025 | SENSOR_TEMPERATURE_RANGE_ERROR | 13 | 37 | 传感器与密度 | 传感器与密度 | 传感器温度超限 | 传感器温度超出工作范围 | 传感器温度超限 | 使用中 | 1 | LTD_MAIN_CPU2/Services/Sensor/SafeProtocol/sensor_safe_legacy_adapter.c:110 | 一代无直接同义编号；按二代责任域独立编号 | 协议29正式版；CPU2/CPU3 V1.34.0.0；不兼容协议28旧故障码
13-38 | 0x000D0026 | SENSOR_REMOTE_INTERNAL_ERROR | 13 | 38 | 传感器与密度 | 传感器与密度 | 传感器内部故障 | 传感器远端内部故障 | 传感器内部故障 | 使用中 | 6 | LTD_MAIN_CPU2/Services/Sensor/SafeProtocol/sensor_safe_legacy_adapter.c:118 LTD_MAIN_CPU2/Services/Sensor/SafeProtocol/sensor_safe_legacy_adapter.c:154 LTD_MAIN_CPU2/Services/Sensor/SafeProtocol/sensor_safe_legacy_adapter.c:171 LTD_MAIN_CPU2/Services/Sensor/SafeProtocol/sensor_safe_legacy_adapter.c:241 LTD_MAIN_CPU2/Services/Sensor/SafeProtocol/sensor_safe_legacy_adapter.c:248 LTD_MAIN_CPU2/Services/Sensor/SafeProtocol/sensor_safe_legacy_adapter.c:369 | 3-5 二代密度传感器：密度传感器组件失效 三代密度传感器：与CPU0通讯超时 | 协议29正式版；CPU2/CPU3 V1.34.0.0；不兼容协议28旧故障码
13-39 | 0x000D0027 | SENSOR_ADDRESS_MISMATCH | 13 | 39 | 传感器与密度 | 传感器与密度 | 传感器地址不匹配 | 传感器响应地址与目标地址不一致 | 传感器地址不匹配 | 使用中 | 2 | LTD_MAIN_CPU2/Services/Sensor/SafeProtocol/sensor_safe_legacy_adapter.c:39 LTD_MAIN_CPU2/Services/Sensor/SafeProtocol/sensor_safe_legacy_adapter.c:90 | 一代无直接同义编号；按二代责任域独立编号 | 协议29正式版；CPU2/CPU3 V1.34.0.0；不兼容协议28旧故障码
13-40 | 0x000D0028 | SENSOR_SESSION_INVALID | 13 | 40 | 传感器与密度 | 传感器与密度 | 传感器会话失效 | 传感器通信会话已失效 | 传感器会话失效 | 使用中 | 4 | LTD_MAIN_CPU2/Services/Sensor/SafeProtocol/sensor_safe_legacy_adapter.c:41 LTD_MAIN_CPU2/Services/Sensor/SafeProtocol/sensor_safe_legacy_adapter.c:88 LTD_MAIN_CPU2/Services/Sensor/SafeProtocol/sensor_safe_legacy_adapter.c:152 LTD_MAIN_CPU2/Services/Sensor/SafeProtocol/sensor_safe_legacy_adapter.c:173 | 一代无直接同义编号；按二代责任域独立编号 | 协议29正式版；CPU2/CPU3 V1.34.0.0；不兼容协议28旧故障码
13-41 | 0x000D0029 | SENSOR_SEQUENCE_ERROR | 13 | 41 | 传感器与密度 | 传感器与密度 | 传感器报文序号异常 | 传感器报文序号不连续或不符合预期 | 传感器报文序号异常 | 使用中 | 2 | LTD_MAIN_CPU2/Services/Sensor/SafeProtocol/sensor_safe_legacy_adapter.c:45 LTD_MAIN_CPU2/Services/Sensor/SafeProtocol/sensor_safe_legacy_adapter.c:86 | 一代无直接同义编号；按二代责任域独立编号 | 协议29正式版；CPU2/CPU3 V1.34.0.0；不兼容协议28旧故障码
13-42 | 0x000D002A | SENSOR_HANDSHAKE_REQUIRED | 13 | 42 | 传感器与密度 | 传感器与密度 | 传感器需要重新握手 | 传感器要求重新建立通信会话 | 传感器需要重新握手 | 使用中 | 1 | LTD_MAIN_CPU2/Services/Sensor/SafeProtocol/sensor_safe_legacy_adapter.c:47 | 一代无直接同义编号；按二代责任域独立编号 | 协议29正式版；CPU2/CPU3 V1.34.0.0；不兼容协议28旧故障码
13-43 | 0x000D002B | SENSOR_REPLAY_DETECTED | 13 | 43 | 传感器与密度 | 传感器与密度 | 传感器重复报文 | 检测到传感器重复或过期报文 | 传感器收到重复报文 | 使用中 | 1 | LTD_MAIN_CPU2/Services/Sensor/SafeProtocol/sensor_safe_legacy_adapter.c:49 | 一代无直接同义编号；按二代责任域独立编号 | 协议29正式版；CPU2/CPU3 V1.34.0.0；不兼容协议28旧故障码
13-44 | 0x000D002C | SENSOR_CAPABILITY_UNSUPPORTED | 13 | 44 | 传感器与密度 | 传感器与密度 | 传感器能力不支持 | 传感器不支持当前设备要求的功能 | 传感器能力不支持 | 使用中 | 3 | LTD_MAIN_CPU2/Application/Src/fault_recovery.c:79 LTD_MAIN_CPU2/Services/Sensor/SafeProtocol/sensor_safe_legacy_adapter.c:37 LTD_MAIN_CPU2/Services/Sensor/SafeProtocol/sensor_safe_legacy_adapter.c:146 | 一代无直接同义编号；按二代责任域独立编号 | 协议29正式版；CPU2/CPU3 V1.34.0.0；不兼容协议28旧故障码
13-45 | 0x000D002D | SENSOR_COMMAND_UNSUPPORTED | 13 | 45 | 传感器与密度 | 传感器与密度 | 传感器命令不支持 | 传感器不支持本次命令 | 传感器命令不支持 | 使用中 | 2 | LTD_MAIN_CPU2/Application/Src/fault_recovery.c:80 LTD_MAIN_CPU2/Services/Sensor/SafeProtocol/sensor_safe_legacy_adapter.c:78 | 一代无直接同义编号；按二代责任域独立编号 | 协议29正式版；CPU2/CPU3 V1.34.0.0；不兼容协议28旧故障码
13-46 | 0x000D002E | SENSOR_ARGUMENT_REJECTED | 13 | 46 | 传感器与密度 | 传感器与密度 | 传感器命令参数被拒绝 | 传感器拒绝本次命令参数 | 传感器拒绝命令参数 | 使用中 | 2 | LTD_MAIN_CPU2/Application/Src/fault_recovery.c:81 LTD_MAIN_CPU2/Services/Sensor/SafeProtocol/sensor_safe_legacy_adapter.c:80 | 一代无直接同义编号；按二代责任域独立编号 | 协议29正式版；CPU2/CPU3 V1.34.0.0；不兼容协议28旧故障码
13-47 | 0x000D002F | SENSOR_MODE_MISMATCH | 13 | 47 | 传感器与密度 | 传感器与密度 | 传感器模式不一致 | 传感器返回的测量模式与请求不一致 | 传感器测量模式不一致 | 使用中 | 2 | LTD_MAIN_CPU2/Application/Src/fault_recovery.c:82 LTD_MAIN_CPU2/Services/Sensor/SafeProtocol/sensor_safe_legacy_adapter.c:63 | 一代无直接同义编号；按二代责任域独立编号 | 协议29正式版；CPU2/CPU3 V1.34.0.0；不兼容协议28旧故障码
13-48 | 0x000D0030 | SENSOR_MODE_NOT_ALLOWED | 13 | 48 | 传感器与密度 | 传感器与密度 | 传感器模式不允许 | 传感器当前状态不允许执行本次操作 | 传感器当前模式不允许 | 使用中 | 2 | LTD_MAIN_CPU2/Application/Src/fault_recovery.c:83 LTD_MAIN_CPU2/Services/Sensor/SafeProtocol/sensor_safe_legacy_adapter.c:94 | 一代无直接同义编号；按二代责任域独立编号 | 协议29正式版；CPU2/CPU3 V1.34.0.0；不兼容协议28旧故障码
13-49 | 0x000D0031 | SENSOR_TRANSACTION_PENDING | 13 | 49 | 传感器与密度 | 传感器与密度 | 传感器通信未完成 | 上一笔传感器通信事务尚未完成 | 传感器通信尚未完成 | 使用中 | 1 | LTD_MAIN_CPU2/Services/Sensor/SafeProtocol/sensor_safe_legacy_adapter.c:65 | 一代无直接同义编号；按二代责任域独立编号 | 协议29正式版；CPU2/CPU3 V1.34.0.0；不兼容协议28旧故障码
13-50 | 0x000D0032 | SENSOR_DEVICE_BUSY | 13 | 50 | 传感器与密度 | 传感器与密度 | 传感器设备忙 | 传感器正在处理其它任务 | 传感器设备忙 | 使用中 | 1 | LTD_MAIN_CPU2/Services/Sensor/SafeProtocol/sensor_safe_legacy_adapter.c:96 | 一代无直接同义编号；按二代责任域独立编号 | 协议29正式版；CPU2/CPU3 V1.34.0.0；不兼容协议28旧故障码
13-51 | 0x000D0033 | SENSOR_PARAM_CRC_ERROR | 13 | 51 | 传感器与密度 | 传感器与密度 | 传感器参数校验失败 | 传感器参数内容校验失败 | 传感器参数校验失败 | 使用中 | 3 | LTD_MAIN_CPU2/Services/Sensor/SafeProtocol/sensor_safe_legacy_adapter.c:51 LTD_MAIN_CPU2/Services/Sensor/SafeProtocol/sensor_safe_legacy_adapter.c:104 LTD_MAIN_CPU2/Services/Sensor/SafeProtocol/sensor_safe_legacy_adapter.c:402 | 一代无直接同义编号；按二代责任域独立编号 | 协议29正式版；CPU2/CPU3 V1.34.0.0；不兼容协议28旧故障码
13-52 | 0x000D0034 | SENSOR_SAMPLE_COUNTER_ERROR | 13 | 52 | 传感器与密度 | 传感器与密度 | 传感器采样计数异常 | 传感器采样计数停滞或跳变异常 | 传感器采样计数异常 | 使用中 | 1 | LTD_MAIN_CPU2/Services/Sensor/SafeProtocol/sensor_safe_legacy_adapter.c:55 | 一代无直接同义编号；按二代责任域独立编号 | 协议29正式版；CPU2/CPU3 V1.34.0.0；不兼容协议28旧故障码
13-53 | 0x000D0035 | SENSOR_STREAM_STOPPED | 13 | 53 | 传感器与密度 | 传感器与密度 | 传感器周期上报停止 | 传感器周期上报意外停止 | 传感器周期上报已停止 | 使用中 | 1 | LTD_MAIN_CPU2/Services/Sensor/SafeProtocol/sensor_safe_legacy_adapter.c:59 | 一代无直接同义编号；按二代责任域独立编号 | 协议29正式版；CPU2/CPU3 V1.34.0.0；不兼容协议28旧故障码
13-54 | 0x000D0036 | SENSOR_STREAM_NOT_ACTIVE | 13 | 54 | 传感器与密度 | 传感器与密度 | 传感器周期上报未启动 | 传感器周期上报尚未启动 | 传感器周期上报未启动 | 使用中 | 1 | LTD_MAIN_CPU2/Services/Sensor/SafeProtocol/sensor_safe_legacy_adapter.c:112 | 一代无直接同义编号；按二代责任域独立编号 | 协议29正式版；CPU2/CPU3 V1.34.0.0；不兼容协议28旧故障码
13-55 | 0x000D0037 | SENSOR_STREAM_ALREADY_ACTIVE | 13 | 55 | 传感器与密度 | 传感器与密度 | 传感器周期上报已启动 | 传感器周期上报已在运行 | 传感器周期上报已启动 | 使用中 | 1 | LTD_MAIN_CPU2/Services/Sensor/SafeProtocol/sensor_safe_legacy_adapter.c:114 | 一代无直接同义编号；按二代责任域独立编号 | 协议29正式版；CPU2/CPU3 V1.34.0.0；不兼容协议28旧故障码
13-56 | 0x000D0038 | SENSOR_STREAM_EXIT_FAILED | 13 | 56 | 传感器与密度 | 传感器与密度 | 传感器周期上报退出失败 | 传感器周期上报退出失败 | 传感器周期上报退出失败 | 使用中 | 1 | LTD_MAIN_CPU2/Services/Sensor/SafeProtocol/sensor_safe_legacy_adapter.c:116 | 一代无直接同义编号；按二代责任域独立编号 | 协议29正式版；CPU2/CPU3 V1.34.0.0；不兼容协议28旧故障码
14-9 | 0x000E0009 | MEASUREMENT_ZERO_OUT_OF_RANGE | 14 | 9 | 零点与位置检测 | 位置检测 | 零点超限 | 零点超限 | 零点超限 | 使用中 | 3 | LTD_MAIN_CPU2/Application/Src/measure_zero.c:127 LTD_MAIN_CPU2/Application/Src/measure_zero.c:221 LTD_MAIN_CPU2/Application/Src/measure_zero.c:352 | 4-9 越过零点位置XXmm报错（1.117以上版本） | 协议29正式版；CPU2/CPU3 V1.34.0.0；不兼容协议28旧故障码
14-11 | 0x000E000B | MEASUREMENT_ZERO_REPEAT_FAIL | 14 | 11 | 零点与位置检测 | 位置检测 | 零点重复性差 | 校验失败 | 零点重复性差 | 使用中 | 2 | LTD_MAIN_CPU2/Application/Src/measure_tank_height.c:726 LTD_MAIN_CPU2/Application/Src/measure_tank_height.c:861 | 一代无直接同义编号；按二代责任域独立编号 | 协议29正式版；CPU2/CPU3 V1.34.0.0；不兼容协议28旧故障码
14-12 | 0x000E000C | POSITION_DATA_INVALID | 14 | 12 | 零点与位置检测 | 位置检测 | 位置数据无效 | 当前位置数据无效 | 位置数据无效 | 使用中 | 4 | LTD_MAIN_CPU2/Services/MotorControl/motor_ctrl_motion_api.c:697 LTD_MAIN_CPU2/Services/MotorControl/motor_ctrl_motion_api.c:1833 LTD_MAIN_CPU2/Services/MotorControl/motor_ctrl_motion_api.c:1875 LTD_MAIN_CPU2/Services/MotorControl/motor_ctrl_motion_api.c:1978 | 2-10 固定点检测时编码值发生变化；4-9 越过零点位置XXmm报错（1.117以上版本） | 协议29正式版；CPU2/CPU3 V1.34.0.0；不兼容协议28旧故障码
14-13 | 0x000E000D | POSITION_TARGET_OVERRUN | 14 | 13 | 零点与位置检测 | 位置检测 | 运动越过目标 | 运动越过目标位置 | 运动位置超过设定 | 使用中 | 1 | LTD_MAIN_CPU2/Services/MotorControl/motor_ctrl_motion_api.c:1984 | 4-9 越过零点位置XXmm报错（1.117以上版本） | 协议29正式版；CPU2/CPU3 V1.34.0.0；不兼容协议28旧故障码
14-14 | 0x000E000E | POSITION_ARRIVAL_DEVIATION | 14 | 14 | 零点与位置检测 | 位置检测 | 到位偏差过大 | 停止后实际位置与目标偏差过大 | 到位偏差过大 | 使用中 | 2 | LTD_MAIN_CPU2/Application/Src/wartsila_density_measurement.c:174 LTD_MAIN_CPU2/Services/MotorControl/motor_ctrl_motion_api.c:2237 | 5-12 电机步进数和实际运行数差距大，拟合数据不正确； | 协议29正式版；CPU2/CPU3 V1.34.0.0；不兼容协议28旧故障码
14-15 | 0x000E000F | POSITION_MOTOR_NOT_STOPPED | 14 | 15 | 零点与位置检测 | 位置检测 | 电机未停止 | 提交测量结果时电机仍未停止 | 电机未停止 | 使用中 | 1 | LTD_MAIN_CPU2/Application/Src/measure_density.c:966 | 1-10 输入步进数错误； 下位位置高于当前位置 限制上行时步进数超过零点 | 协议29正式版；CPU2/CPU3 V1.34.0.0；不兼容协议28旧故障码
15-6 | 0x000F0006 | MEASUREMENT_OILLEVEL_HIGH | 15 | 6 | 测量过程 | 测量流程 | 液位超过罐高 | 液位测量结果超过罐高 | 液位超过罐高 | 使用中 | 2 | LTD_MAIN_CPU2/Application/Src/measure_oilLevel.c:1927 LTD_MAIN_CPU2/Application/Src/measure_oilLevel.c:1950 | 5-6 1.区间测量参数设置最高点高于罐高。 2.分布测量或每米测量液位高度高于罐高 | 协议29正式版；CPU2/CPU3 V1.34.0.0；不兼容协议28旧故障码
15-15 | 0x000F000F | MEASUREMENT_OVERSPEED | 15 | 15 | 测量过程 | 测量流程 | 液位变化过快 | 液位变化过快 | 液位变化过快 | 使用中 | 1 | LTD_MAIN_CPU2/Application/Src/measure_oilLevel.c:1874 | 5-15 液位变化超过最大跟随速度 | 协议29正式版；CPU2/CPU3 V1.34.0.0；不兼容协议28旧故障码
15-16 | 0x000F0010 | MEASUREMENT_HEIGHT_DEVIATION | 15 | 16 | 测量过程 | 测量流程 | 实高偏差过大 | 校验失败 | 实高偏差过大 | 预留 | 0 | 无主动调用 | 5-16 罐高与标定时相差过大 | 协议29正式版；CPU2/CPU3 V1.34.0.0；不兼容协议28旧故障码
15-17 | 0x000F0011 | MEASUREMENT_DENSITY_LEVEL_TIMEOUT | 15 | 17 | 测量过程 | 测量流程 | 密度找液位超时 | 密度闭环找液位超时 | 密度找液位超时 | 使用中 | 1 | LTD_MAIN_CPU2/Application/Src/measure_oilLevel.c:597 | 一代无直接同义编号；按二代责任域独立编号 | 协议29正式版；CPU2/CPU3 V1.34.0.0；不兼容协议28旧故障码
15-18 | 0x000F0012 | MEASUREMENT_OILLEVEL_LOW | 15 | 18 | 测量过程 | 测量流程 | 下行未找到液位 | 下行测量未找到液位 | 下行未找到液位 | 使用中 | 9 | LTD_MAIN_CPU2/Application/Src/measure_oilLevel.c:954 LTD_MAIN_CPU2/Application/Src/measure_oilLevel.c:1471 LTD_MAIN_CPU2/Application/Src/measure_oilLevel.c:1497 LTD_MAIN_CPU2/Application/Src/measure_oilLevel.c:1549 LTD_MAIN_CPU2/Application/Src/measure_oilLevel.c:1797 LTD_MAIN_CPU2/Application/Src/measure_oilLevel.c:1933 LTD_MAIN_CPU2/Application/Src/measure_oilLevel.c:1949 LTD_MAIN_CPU2/Application/Src/wartsila_density_measurement.c:375 | 6-4 油位太低；下行到盲区未检测到油。 | 协议29正式版；CPU2/CPU3 V1.34.0.0；不兼容协议28旧故障码
15-19 | 0x000F0013 | MEASUREMENT_OILLEVEL_NOTFOUND | 15 | 19 | 测量过程 | 测量流程 | 上行未找到液位 | 上行测量未找到液位 | 上行未找到液位 | 使用中 | 3 | LTD_MAIN_CPU2/Application/Src/measure_density.c:963 LTD_MAIN_CPU2/Application/Src/measure_oilLevel.c:1154 LTD_MAIN_CPU2/Application/Src/measure_oilLevel.c:1201 | 6-5 运行到零点位置未找到液位； | 协议29正式版；CPU2/CPU3 V1.34.0.0；不兼容协议28旧故障码
15-20 | 0x000F0014 | MEASUREMENT_WEIGHT_DOWN_FAIL | 15 | 20 | 测量过程 | 测量流程 | 下行寻重失败 | 下行寻重失败 | 下行寻重失败 | 使用中 | 4 | LTD_MAIN_CPU2/Application/Src/measure_oilLevel.c:1354 LTD_MAIN_CPU2/Application/Src/measure_tank_height.c:85 LTD_MAIN_CPU2/Application/Src/measure_tank_height.c:544 LTD_MAIN_CPU2/Application/Src/measure_tank_height.c:642 | 4-4 测量罐底，下行到达罐高+最大下行位置； | 协议29正式版；CPU2/CPU3 V1.34.0.0；不兼容协议28旧故障码
15-21 | 0x000F0015 | MEASUREMENT_WEIGHT_UP_FAIL | 15 | 21 | 测量过程 | 测量流程 | 上行寻重失败 | 上行寻重失败 | 上行寻重失败 | 使用中 | 1 | LTD_MAIN_CPU2/Application/Src/measure_zero.c:338 | 4-3 测量罐底时上行细找找到零点位置； | 协议29正式版；CPU2/CPU3 V1.34.0.0；不兼容协议28旧故障码
15-22 | 0x000F0016 | MEASUREMENT_WATERLEVEL_LOW | 15 | 22 | 测量过程 | 测量流程 | 下行未找到水位 | 下行测量未找到水位 | 下行未找到水位 | 使用中 | 6 | LTD_MAIN_CPU2/Application/Src/measure_waterLevel.c:273 LTD_MAIN_CPU2/Application/Src/measure_waterLevel.c:333 LTD_MAIN_CPU2/Application/Src/measure_waterLevel.c:578 LTD_MAIN_CPU2/Application/Src/measure_waterLevel.c:613 LTD_MAIN_CPU2/Application/Src/measure_waterLevel.c:660 LTD_MAIN_CPU2/Application/Src/measure_waterLevel.c:863 | 6-3 1.找水位时上行到了零点； | 协议29正式版；CPU2/CPU3 V1.34.0.0；不兼容协议28旧故障码
15-23 | 0x000F0017 | MEASUREMENT_DENSITY_NO_VALID_POINT | 15 | 23 | 测量过程 | 测量流程 | 密度测量无有效点 | 密度分布测量无有效测点 | 密度测量无有效点 | 使用中 | 5 | LTD_MAIN_CPU2/Application/Src/measure_density.c:352 LTD_MAIN_CPU2/Application/Src/measure_density.c:959 LTD_MAIN_CPU2/Application/Src/measure_density.c:1490 LTD_MAIN_CPU2/Application/Src/wartsila_density_measurement.c:456 LTD_MAIN_CPU2/Application/Src/wartsila_density_measurement.c:586 | 一代无直接同义编号；按二代责任域独立编号 | 协议29正式版；CPU2/CPU3 V1.34.0.0；不兼容协议28旧故障码
15-24 | 0x000F0018 | MEASUREMENT_DENSITY_SURFACE_NOTFOUND | 15 | 24 | 测量过程 | 测量流程 | 密度测量未找到油面 | 密度分布测量未找到油面 | 密度测量未找到油面 | 使用中 | 1 | LTD_MAIN_CPU2/Application/Src/wartsila_density_measurement.c:581 | 一代无直接同义编号；按二代责任域独立编号 | 协议29正式版；CPU2/CPU3 V1.34.0.0；不兼容协议28旧故障码
15-25 | 0x000F0019 | MEASUREMENT_FREQUENCY_LEVEL_TIMEOUT | 15 | 25 | 测量过程 | 测量流程 | 频率找液位超时 | 频率闭环找液位超时 | 频率找液位超时 | 使用中 | 1 | LTD_MAIN_CPU2/Application/Src/measure_oilLevel.c:979 | 一代无直接同义编号；按二代责任域独立编号 | 协议29正式版；CPU2/CPU3 V1.34.0.0；不兼容协议28旧故障码
15-26 | 0x000F001A | MEASUREMENT_BOTTOM_RELEASE_FAIL | 15 | 26 | 测量过程 | 测量流程 | 探底前离底失败 | 粗找罐底前上行后仍处于触底状态 | 探底前离底失败 | 使用中 | 1 | LTD_MAIN_CPU2/Application/Src/measure_tank_height.c:591 | 4-3 测量罐底时上行细找找到零点位置； | 协议29正式版；CPU2/CPU3 V1.34.0.0；不兼容协议28旧故障码
15-27 | 0x000F001B | MEASUREMENT_TANK_HEIGHT_NOT_CONFIGURED | 15 | 27 | 测量过程 | 测量过程 | 未设置罐高标定值 | 罐高标定值未设置 | 未设置罐高标定值 | 使用中 | 2 | LTD_MAIN_CPU2/Application/Src/fault_recovery.c:91 LTD_MAIN_CPU2/Application/Src/measure.c:41 | 一代无直接同义编号；按二代责任域独立编号 | 协议29正式版；CPU2/CPU3 V1.34.0.0；不兼容协议28旧故障码
15-28 | 0x000F001C | MEASUREMENT_WATER_CALIBRATION_NOT_CONFIGURED | 15 | 28 | 测量过程 | 测量过程 | 未设置水位标定值 | 水位标定值未设置 | 未设置水位标定值 | 使用中 | 2 | LTD_MAIN_CPU2/Application/Src/fault_recovery.c:92 LTD_MAIN_CPU2/Application/Src/measure_waterLevel.c:1365 | 一代无直接同义编号；按二代责任域独立编号 | 协议29正式版；CPU2/CPU3 V1.34.0.0；不兼容协议28旧故障码
15-29 | 0x000F001D | MEASUREMENT_DENSITY_PLAN_INVALID | 15 | 29 | 测量过程 | 测量流程 | 密度测点规划失败 | 密度测点范围、步距或数量无法形成有效计划 | 密度测点设置失败 | 使用中 | 19 | LTD_MAIN_CPU2/Application/Src/fault_recovery.c:95 LTD_MAIN_CPU2/Application/Src/measure_density.c:290 LTD_MAIN_CPU2/Application/Src/measure_density.c:411 LTD_MAIN_CPU2/Application/Src/measure_density.c:413 LTD_MAIN_CPU2/Application/Src/measure_density.c:629 LTD_MAIN_CPU2/Application/Src/measure_density.c:665 LTD_MAIN_CPU2/Application/Src/measure_density.c:700 LTD_MAIN_CPU2/Application/Src/measure_density.c:704 | 5-4 1.进行单点监测或单点测量时，输入的检测位置小于盲区位置或高于罐高。 2.区间测量输入液位区间错误；5-5 密度分布测量或标定液位时，液位值过低； 2.区间测量参数设置最低点要＞（盲区+300）；否侧报错；5-6 1.区间测量参数设置最高点高于罐高。 2.分布测量或每米测量液位高度高于罐高；5-7 密度分布测量点数超过100（加测点过多） | 协议29正式版；CPU2/CPU3 V1.34.0.0；不兼容协议28旧故障码
15-30 | 0x000F001E | MEASUREMENT_TANK_HEIGHT_RESULT_INVALID | 15 | 30 | 测量过程 | 测量过程 | 罐高测量结果无效 | 罐高测量未得到有效实高 | 罐高测量结果无效 | 使用中 | 2 | LTD_MAIN_CPU2/Application/Src/fault_recovery.c:93 LTD_MAIN_CPU2/Application/Src/measure.c:53 | 一代无直接同义编号；按二代责任域独立编号 | 协议29正式版；CPU2/CPU3 V1.34.0.0；不兼容协议28旧故障码
15-31 | 0x000F001F | MEASUREMENT_WATER_CALC_OUT_OF_RANGE | 15 | 31 | 测量过程 | 测量过程 | 水位标定计算超限 | 水位标定计算结果超出允许范围 | 水位标定计算超限 | 使用中 | 2 | LTD_MAIN_CPU2/Application/Src/fault_recovery.c:94 LTD_MAIN_CPU2/Application/Src/measure_waterLevel.c:1334 | 一代无直接同义编号；按二代责任域独立编号 | 协议29正式版；CPU2/CPU3 V1.34.0.0；不兼容协议28旧故障码
17-1 | 0x00110001 | PARAM_EEPROM_FAIL | 17 | 1 | 参数与存储 | 参数与存储 | 参数存储读写失败 | 参数存储分区异常 | 参数存储读写失败 | 使用中 | 2 | LTD_MAIN_CPU2/Services/ParamStorage/system_parameter.c:702 LTD_MAIN_CPU2/Services/ParamStorage/system_parameter.c:979 | 7-1 主控板中存储器的参数异常 | 协议29正式版；CPU2/CPU3 V1.34.0.0；不兼容协议28旧故障码
17-2 | 0x00110002 | PARAM_UNINITIALIZED | 17 | 2 | 参数与存储 | 参数与存储 | 参数未初始化 | 参数未初始化 | 参数未初始化 | 使用中 | 3 | LTD_MAIN_CPU2/Application/Src/test.c:2237 LTD_MAIN_CPU2/Application/Src/test.c:2238 LTD_MAIN_CPU2/Services/ParamStorage/system_parameter.c:699 | 7-2 没有存储置零点时的角度值。 | 协议29正式版；CPU2/CPU3 V1.34.0.0；不兼容协议28旧故障码
17-5 | 0x00110005 | PARAM_RANGE_ERROR | 17 | 5 | 参数与存储 | 参数与存储 | 参数值超出范围 | 参数超限 | 参数值超出范围 | 使用中 | 27 | LTD_MAIN_CPU2/Application/Src/fault_recovery.c:84 LTD_MAIN_CPU2/Application/Src/measure.c:1118 LTD_MAIN_CPU2/Application/Src/measure_density.c:30 LTD_MAIN_CPU2/Application/Src/measure_density.c:150 LTD_MAIN_CPU2/Application/Src/measure_density.c:151 LTD_MAIN_CPU2/Application/Src/measure_density.c:156 LTD_MAIN_CPU2/Application/Src/measure_density.c:157 LTD_MAIN_CPU2/Application/Src/measure_oilLevel.c:641 | 5-4 1.进行单点监测或单点测量时，输入的检测位置小于盲区位置或高于罐高。 2.区间测量输入液位区间错误；5-5 密度分布测量或标定液位时，液位值过低； 2.区间测量参数设置最低点要＞（盲区+300）；否侧报错；5-6 1.区间测量参数设置最高点高于罐高。 2.分布测量或每米测量液位高度高于罐高；5-7 密度分布测量点数超过100（加测点过多） | 协议29正式版；CPU2/CPU3 V1.34.0.0；不兼容协议28旧故障码
17-6 | 0x00110006 | PARAM_CRC_ERROR | 17 | 6 | 参数与存储 | 参数与存储 | 参数完整性校验失败 | CRC不匹配 | 参数完整性校验失败 | 使用中 | 1 | LTD_MAIN_CPU2/Services/ParamStorage/system_parameter.c:684 | 一代无直接同义编号；按二代责任域独立编号 | 协议29正式版；CPU2/CPU3 V1.34.0.0；不兼容协议28旧故障码
17-7 | 0x00110007 | PARAM_CONFIG_MISSING | 17 | 7 | 参数与存储 | 参数与存储 | 必需配置缺失 | 执行当前功能所需配置缺失 | 基础配置未设置 | 使用中 | 10 | LTD_MAIN_CPU2/Application/Src/fault_recovery.c:85 LTD_MAIN_CPU2/Application/Src/measure.c:1116 LTD_MAIN_CPU2/Application/Src/measure_density.c:138 LTD_MAIN_CPU2/Application/Src/measure_density.c:139 LTD_MAIN_CPU2/Application/Src/measure_oilLevel.c:474 LTD_MAIN_CPU2/Application/Src/measure_oilLevel.c:636 LTD_MAIN_CPU2/Application/Src/measure_oilLevel.c:854 LTD_MAIN_CPU2/Application/Src/test.c:325 | 7-1 主控板中存储器的参数异常；；7-2 没有存储置零点时的角度值。 | 协议29正式版；CPU2/CPU3 V1.34.0.0；不兼容协议28旧故障码
17-8 | 0x00110008 | PARAM_COMBINATION_CONFLICT | 17 | 8 | 参数与存储 | 参数与存储 | 参数组合冲突 | 多个参数组合互相冲突 | 参数组合错误 | 使用中 | 4 | LTD_MAIN_CPU2/Application/Src/fault_recovery.c:86 LTD_MAIN_CPU2/Application/Src/measure.c:1117 LTD_MAIN_CPU2/Application/Src/measure_density.c:144 LTD_MAIN_CPU2/Application/Src/measure_density.c:145 | 5-4 1.进行单点监测或单点测量时，输入的检测位置小于盲区位置或高于罐高。 2.区间测量输入液位区间错误；5-5 密度分布测量或标定液位时，液位值过低； 2.区间测量参数设置最低点要＞（盲区+300）；否侧报错；5-6 1.区间测量参数设置最高点高于罐高。 2.分布测量或每米测量液位高度高于罐高；5-7 密度分布测量点数超过100（加测点过多） | 协议29正式版；CPU2/CPU3 V1.34.0.0；不兼容协议28旧故障码
17-9 | 0x00110009 | PARAM_FEATURE_UNSUPPORTED | 17 | 9 | 参数与存储 | 参数与存储 | 功能不支持 | 当前传感器、方法或模式不支持所选功能 | 功能无法使用 | 使用中 | 5 | LTD_MAIN_CPU2/Application/Src/fault_recovery.c:87 LTD_MAIN_CPU2/Application/Src/measure_oilLevel.c:1135 LTD_MAIN_CPU2/Application/Src/measure_oilLevel.c:1436 LTD_MAIN_CPU2/Services/Sensor/sensor.c:782 LTD_MAIN_CPU2/Services/Sensor/sensor.c:802 | 一代无直接同义编号；按二代责任域独立编号 | 协议29正式版；CPU2/CPU3 V1.34.0.0；不兼容协议28旧故障码
17-10 | 0x0011000A | PARAM_STORAGE_SIZE_MISMATCH | 17 | 10 | 参数与存储 | 参数与存储 | 参数存储结构不匹配 | 参数存储结构大小与当前程序不一致 | 参数存储结构不匹配 | 使用中 | 2 | LTD_MAIN_CPU2/Application/Src/fault_recovery.c:88 LTD_MAIN_CPU2/Services/ParamStorage/system_parameter.c:689 | 7-1 主控板中存储器的参数异常 | 协议29正式版；CPU2/CPU3 V1.34.0.0；不兼容协议28旧故障码
17-11 | 0x0011000B | PARAM_STORAGE_VERSION_MISMATCH | 17 | 11 | 参数与存储 | 参数与存储 | 参数存储版本不匹配 | 参数存储版本与当前程序不一致 | 参数存储版本不匹配 | 使用中 | 2 | LTD_MAIN_CPU2/Application/Src/fault_recovery.c:89 LTD_MAIN_CPU2/Services/ParamStorage/system_parameter.c:694 | 7-1 主控板中存储器的参数异常 | 协议29正式版；CPU2/CPU3 V1.34.0.0；不兼容协议28旧故障码
17-12 | 0x0011000C | PARAM_STORAGE_WRITE_VERIFY_FAILED | 17 | 12 | 参数与存储 | 参数与存储 | 参数存储写入校验失败 | 参数写入后读回内容不一致 | 参数存储写入校验失败 | 使用中 | 5 | LTD_MAIN_CPU2/Application/Src/fault_recovery.c:90 LTD_MAIN_CPU2/Services/ParamStorage/system_parameter.c:844 LTD_MAIN_CPU2/Services/ParamStorage/system_parameter.c:847 LTD_MAIN_CPU2/Services/ParamStorage/system_parameter.c:850 LTD_MAIN_CPU2/Services/ParamStorage/system_parameter.c:856 | 7-1 主控板中存储器的参数异常 | 协议29正式版；CPU2/CPU3 V1.34.0.0；不兼容协议28旧故障码
18-1 | 0x00120001 | WEIGHT_OUT_OF_RANGE | 18 | 1 | 扭力检测 | 扭力检测 | 扭力超上限 | 扭力超限 | 扭力超上限 | 使用中 | 1 | LTD_MAIN_CPU2/Services/Weight/weight.c:215 | 一代无直接同义编号；按二代责任域独立编号 | 协议29正式版；CPU2/CPU3 V1.34.0.0；不兼容协议28旧故障码
18-2 | 0x00120002 | WEIGHT_UNDER_RANGE | 18 | 2 | 扭力检测 | 扭力检测 | 扭力超下限 | 扭力超限 | 扭力超下限 | 使用中 | 1 | LTD_MAIN_CPU2/Services/Weight/weight.c:212 | 一代无直接同义编号；按二代责任域独立编号 | 协议29正式版；CPU2/CPU3 V1.34.0.0；不兼容协议28旧故障码
18-3 | 0x00120003 | WEIGHT_COLLISION_DETECTED | 18 | 3 | 扭力检测 | 扭力检测 | 检测到碰撞 | 碰撞检测 | 检测到碰撞 | 使用中 | 10 | LTD_MAIN_CPU2/Services/Weight/weight.c:285 LTD_MAIN_CPU2/Services/Weight/weight.c:407 LTD_MAIN_CPU2/Services/Weight/weight.c:444 LTD_MAIN_CPU2/Services/Weight/weight.c:500 LTD_MAIN_CPU2/Services/Weight/weight.c:535 LTD_MAIN_CPU2/Services/Weight/weight.c:561 LTD_MAIN_CPU2/Services/Weight/weight.c:632 LTD_MAIN_CPU2/Services/Weight/weight.c:649 | 一代无直接同义编号；按二代责任域独立编号 | 协议29正式版；CPU2/CPU3 V1.34.0.0；不兼容协议28旧故障码
18-4 | 0x00120004 | WEIGHT_DRIFT_ERROR | 18 | 4 | 扭力检测 | 扭力检测 | 扭力漂移异常 | 扭力漂移 | 扭力漂移异常 | 使用中 | 1 | LTD_MAIN_CPU2/Services/Weight/weight.c:187 | 一代无直接同义编号；按二代责任域独立编号 | 协议29正式版；CPU2/CPU3 V1.34.0.0；不兼容协议28旧故障码
18-5 | 0x00120005 | WEIGHT_SENSOR_SATURATION | 18 | 5 | 扭力检测 | 扭力检测 | 扭力传感器饱和 | 扭力传感器饱和 | 扭力传感器饱和 | 预留 | 0 | 无主动调用 | 一代无直接同义编号；按二代责任域独立编号 | 协议29正式版；CPU2/CPU3 V1.34.0.0；不兼容协议28旧故障码
18-6 | 0x00120006 | WEIGHT_COMM_TIMEOUT | 18 | 6 | 扭力检测 | 扭力检测 | 扭力通信超时 | 扭力模块无响应 | 扭力通信超时 | 使用中 | 3 | LTD_MAIN_CPU2/Services/Weight/weight.c:61 LTD_MAIN_CPU2/Services/Weight/weight.c:148 LTD_MAIN_CPU2/Services/Weight/weight.c:149 | 一代无直接同义编号；按二代责任域独立编号 | 协议29正式版；CPU2/CPU3 V1.34.0.0；不兼容协议28旧故障码
20-1 | 0x00140001 | COMM_UART_TRANSFER_ERROR | 20 | 1 | 设备通信链路 | 设备通信链路 | 串口传输异常 | 串口或DMA传输异常 | 通信传输异常 | 使用中 | 16 | LTD_MAIN_CPU2/Services/Sensor/ch9141_at.c:503 LTD_MAIN_CPU2/Services/Sensor/ch9141_at.c:693 LTD_MAIN_CPU2/Services/Sensor/ch9141_at.c:700 LTD_MAIN_CPU2/Services/Sensor/dsm_sensor_communication.c:148 LTD_MAIN_CPU2/Services/Sensor/dsm_sensor_communication.c:155 LTD_MAIN_CPU2/Services/Sensor/dsm_sensor_communication.c:181 LTD_MAIN_CPU2/Services/Sensor/dsm_sensor_communication.c:215 LTD_MAIN_CPU2/Services/Sensor/dsm_sensor_communication.c:377 | 一代无直接同义编号；按二代责任域独立编号 | 协议29正式版；CPU2/CPU3 V1.34.0.0；不兼容协议28旧故障码
20-2 | 0x00140002 | SLIPRING_COMM_FAIL | 20 | 2 | 设备通信链路 | 设备通信链路 | 滑环通信失败 | 滑环设备应答失败 | 滑环通信失败 | 使用中 | 1 | LTD_MAIN_CPU2/Services/Sensor/ch9141_at.c:497 | 一代无直接同义编号；按二代责任域独立编号 | 协议29正式版；CPU2/CPU3 V1.34.0.0；不兼容协议28旧故障码
20-3 | 0x00140003 | SLIPRING_SIGNAL_WEAK | 20 | 3 | 设备通信链路 | 设备通信链路 | 滑环信号弱 | 滑环信号弱 | 滑环信号弱 | 使用中 | 1 | LTD_MAIN_CPU2/Services/Sensor/wireless_pairing.c:1947 | 一代无直接同义编号；按二代责任域独立编号 | 协议29正式版；CPU2/CPU3 V1.34.0.0；不兼容协议28旧故障码
20-4 | 0x00140004 | WIRELESS_HOST_COMM_TIMEOUT | 20 | 4 | 设备通信链路 | 设备通信链路 | 蓝牙主机通信超时 | 蓝牙主机无响应 | 无线主机通信超时 | 使用中 | 3 | LTD_MAIN_CPU2/Services/Sensor/wireless_pairing.c:557 LTD_MAIN_CPU2/Services/Sensor/wireless_pairing.c:1612 LTD_MAIN_CPU2/Services/Sensor/wireless_pairing.h:62 | 一代无直接同义编号；按二代责任域独立编号 | 协议29正式版；CPU2/CPU3 V1.34.0.0；不兼容协议28旧故障码
20-5 | 0x00140005 | WIRELESS_SLAVE_COMM_TIMEOUT | 20 | 5 | 设备通信链路 | 设备通信链路 | 蓝牙从机未连接 | 蓝牙从机未连接 | 无线从机未连接 | 使用中 | 3 | LTD_MAIN_CPU2/Services/Sensor/wireless_pairing.c:593 LTD_MAIN_CPU2/Services/Sensor/wireless_pairing.c:1618 LTD_MAIN_CPU2/Services/Sensor/wireless_pairing.h:62 | 一代无直接同义编号；按二代责任域独立编号 | 协议29正式版；CPU2/CPU3 V1.34.0.0；不兼容协议28旧故障码
20-6 | 0x00140006 | WIRELESS_RESP_FORMAT_ERROR | 20 | 6 | 设备通信链路 | 设备通信链路 | 无线响应格式异常 | 无线模块响应格式异常 | 无线响应格式异常 | 使用中 | 12 | LTD_MAIN_CPU2/Services/Sensor/wireless_pairing.c:640 LTD_MAIN_CPU2/Services/Sensor/wireless_pairing.c:655 LTD_MAIN_CPU2/Services/Sensor/wireless_pairing.c:1213 LTD_MAIN_CPU2/Services/Sensor/wireless_pairing.c:1591 LTD_MAIN_CPU2/Services/Sensor/wireless_pairing.c:1605 LTD_MAIN_CPU2/Services/Sensor/wireless_pairing.c:1634 LTD_MAIN_CPU2/Services/Sensor/wireless_pairing.c:1654 LTD_MAIN_CPU2/Services/Sensor/wireless_pairing.c:1755 | 一代无直接同义编号；按二代责任域独立编号 | 协议29正式版；CPU2/CPU3 V1.34.0.0；不兼容协议28旧故障码
20-8 | 0x00140008 | WIRELESS_SCAN_NO_DEVICE | 20 | 8 | 设备通信链路 | 设备通信链路 | 无线扫描无设备 | 无线扫描未发现任何候选设备 | 无线扫描无设备 | 使用中 | 1 | LTD_MAIN_CPU2/Services/Sensor/wireless_pairing.c:1315 | 一代无直接同义编号；按二代责任域独立编号 | 协议29正式版；CPU2/CPU3 V1.34.0.0；不兼容协议28旧故障码
20-9 | 0x00140009 | WIRELESS_NAME_NOT_UNIQUE | 20 | 9 | 设备通信链路 | 设备通信链路 | 无线名称重复 | 扫描到两个及以上同名无线设备，无法确定连接目标 | 无线名称重复 | 使用中 | 1 | LTD_MAIN_CPU2/Services/Sensor/wireless_pairing.c:1418 | 一代无直接同义编号；按二代责任域独立编号 | 协议29正式版；CPU2/CPU3 V1.34.0.0；不兼容协议28旧故障码
20-10 | 0x0014000A | WIRELESS_NAME_INVALID | 20 | 10 | 设备通信链路 | 设备通信链路 | 无线名称无效 | 无线设备名称为空、过长或格式无效 | 无线名称无效 | 使用中 | 2 | LTD_MAIN_CPU2/Services/Sensor/wireless_pairing.c:1977 LTD_MAIN_CPU2/Services/Sensor/wireless_pairing.c:1978 | 一代无直接同义编号；按二代责任域独立编号 | 协议29正式版；CPU2/CPU3 V1.34.0.0；不兼容协议28旧故障码
20-11 | 0x0014000B | WIRELESS_NOT_HOST_MODE | 20 | 11 | 设备通信链路 | 设备通信链路 | 无线非主机模式 | 无线模块未处于主机模式 | 无线非主机模式 | 使用中 | 1 | LTD_MAIN_CPU2/Services/Sensor/wireless_pairing.c:1261 | 一代无直接同义编号；按二代责任域独立编号 | 协议29正式版；CPU2/CPU3 V1.34.0.0；不兼容协议28旧故障码
20-12 | 0x0014000C | WIRELESS_NAME_NOT_FOUND | 20 | 12 | 设备通信链路 | 设备通信链路 | 无线名称未找到 | 扫描到候选无线设备，但没有找到指定名称 | 无线名称未找到 | 使用中 | 1 | LTD_MAIN_CPU2/Services/Sensor/wireless_pairing.c:1425 | 一代无直接同义编号；按二代责任域独立编号 | 协议29正式版；CPU2/CPU3 V1.34.0.0；不兼容协议28旧故障码
21-2 | 0x00150002 | AD5421_INIT_ERROR | 21 | 2 | 模拟输出与自检 | 模拟输出 | 模拟输出初始化失败 | AD5421初始化失败且未取得更具体原因 | 模拟输出初始化失败 | 使用中 | 14 | LTD_MAIN_CPU2/BSP/Peripherals/src/ad5421.c:587 LTD_MAIN_CPU2/BSP/Peripherals/src/ad5421.c:588 LTD_MAIN_CPU2/BSP/Peripherals/src/ad5421.c:591 LTD_MAIN_CPU2/BSP/Peripherals/src/ad5421.c:597 LTD_MAIN_CPU2/BSP/Peripherals/src/ad5421.c:601 LTD_MAIN_CPU2/BSP/Peripherals/src/ad5421.c:607 LTD_MAIN_CPU2/BSP/Peripherals/src/ad5421.c:611 LTD_MAIN_CPU2/BSP/Peripherals/src/ad5421.c:653 | 8-2 AD5421写控制寄存器失败；8-3 上电自检_电流芯片报警 | 协议29正式版；CPU2/CPU3 V1.34.0.0；不兼容协议28旧故障码
21-6 | 0x00150006 | AD5421_READBACK_ERROR | 21 | 6 | 模拟输出与自检 | 模拟输出 | 模拟输出控制回读不一致 | AD5421控制寄存器回读不一致 | 模拟输出控制回读不一致 | 使用中 | 4 | LTD_MAIN_CPU2/BSP/Peripherals/src/ad5421.c:628 LTD_MAIN_CPU2/BSP/Peripherals/src/ad5421.c:629 LTD_MAIN_CPU2/BSP/Peripherals/src/ad5421.c:632 LTD_MAIN_CPU2/Services/AoOutput/ao_output.c:252 | 8-6 输入电流对比异常 | 协议29正式版；CPU2/CPU3 V1.34.0.0；不兼容协议28旧故障码
21-9 | 0x00150009 | AD5421_INTERNAL_COMM_ERROR | 21 | 9 | 模拟输出与自检 | 模拟输出 | 模拟输出内部通信异常 | AD5421内部通信异常 | 模拟输出内部通信异常 | 使用中 | 3 | LTD_MAIN_CPU2/BSP/Peripherals/src/ad5421.c:202 LTD_MAIN_CPU2/Services/AoOutput/ao_output.c:253 LTD_MAIN_CPU2/Services/AoOutput/ao_output.c:791 | 8-3 上电自检_电流芯片报警 | 协议29正式版；CPU2/CPU3 V1.34.0.0；不兼容协议28旧故障码
21-10 | 0x0015000A | AD5421_LOOP_CURRENT_HIGH | 21 | 10 | 模拟输出与自检 | 模拟输出 | 模拟输出电流过高 | 模拟输出环路电流过高 | 模拟输出电流过高 | 使用中 | 3 | LTD_MAIN_CPU2/BSP/Peripherals/src/ad5421.c:208 LTD_MAIN_CPU2/Services/AoOutput/ao_output.c:254 LTD_MAIN_CPU2/Services/AoOutput/ao_output.c:792 | 8-3 上电自检_电流芯片报警；8-6 输入电流对比异常 | 协议29正式版；CPU2/CPU3 V1.34.0.0；不兼容协议28旧故障码
21-11 | 0x0015000B | AD5421_LOOP_CURRENT_LOW | 21 | 11 | 模拟输出与自检 | 模拟输出 | 模拟输出电流过低 | 模拟输出环路电流过低或断环 | 模拟输出电流过低 | 使用中 | 3 | LTD_MAIN_CPU2/BSP/Peripherals/src/ad5421.c:211 LTD_MAIN_CPU2/Services/AoOutput/ao_output.c:255 LTD_MAIN_CPU2/Services/AoOutput/ao_output.c:793 | 8-3 上电自检_电流芯片报警；8-6 输入电流对比异常 | 协议29正式版；CPU2/CPU3 V1.34.0.0；不兼容协议28旧故障码
21-12 | 0x0015000C | AD5421_LOOP_VOLTAGE_LOW | 21 | 12 | 模拟输出与自检 | 模拟输出 | 模拟输出环路电压低 | 模拟输出环路供电电压不足 | 模拟输出环路电压低 | 使用中 | 3 | LTD_MAIN_CPU2/BSP/Peripherals/src/ad5421.c:214 LTD_MAIN_CPU2/Services/AoOutput/ao_output.c:256 LTD_MAIN_CPU2/Services/AoOutput/ao_output.c:794 | 8-4 设备供电电压异常 | 协议29正式版；CPU2/CPU3 V1.34.0.0；不兼容协议28旧故障码
21-13 | 0x0015000D | AD5421_SPI_TRANSFER_ERROR | 21 | 13 | 模拟输出与自检 | 模拟输出 | 模拟输出通信失败 | AD5421与主控之间SPI传输失败 | 模拟输出通信失败 | 使用中 | 10 | LTD_MAIN_CPU2/BSP/Peripherals/src/ad5421.c:246 LTD_MAIN_CPU2/BSP/Peripherals/src/ad5421.c:247 LTD_MAIN_CPU2/BSP/Peripherals/src/ad5421.c:250 LTD_MAIN_CPU2/BSP/Peripherals/src/ad5421.c:294 LTD_MAIN_CPU2/BSP/Peripherals/src/ad5421.c:295 LTD_MAIN_CPU2/BSP/Peripherals/src/ad5421.c:298 LTD_MAIN_CPU2/BSP/Peripherals/src/ad5421.c:311 LTD_MAIN_CPU2/BSP/Peripherals/src/ad5421.c:312 | 一代无直接同义编号；按二代责任域独立编号 | 协议29正式版；CPU2/CPU3 V1.34.0.0；不兼容协议28旧故障码
21-14 | 0x0015000E | AD5421_ACCESS_BUSY | 21 | 14 | 模拟输出与自检 | 模拟输出 | 模拟输出访问冲突 | AD5421访问冲突或前一操作未结束 | 模拟输出状态异常 | 使用中 | 7 | LTD_MAIN_CPU2/BSP/Peripherals/src/ad5421.c:339 LTD_MAIN_CPU2/BSP/Peripherals/src/ad5421.c:340 LTD_MAIN_CPU2/BSP/Peripherals/src/ad5421.c:343 LTD_MAIN_CPU2/BSP/Peripherals/src/ad5421.c:378 LTD_MAIN_CPU2/BSP/Peripherals/src/ad5421.c:379 LTD_MAIN_CPU2/BSP/Peripherals/src/ad5421.c:382 LTD_MAIN_CPU2/Services/AoOutput/ao_output.c:258 | 一代无直接同义编号；按二代责任域独立编号 | 协议29正式版；CPU2/CPU3 V1.34.0.0；不兼容协议28旧故障码
21-15 | 0x0015000F | AD5421_OVERTEMP_SHUTDOWN | 21 | 15 | 模拟输出与自检 | 模拟输出 | 模拟输出过温关断 | AD5421过温并停止输出 | 模拟输出过温停止 | 使用中 | 5 | LTD_MAIN_CPU2/BSP/Peripherals/src/ad5421.c:205 LTD_MAIN_CPU2/Services/AoOutput/ao_output.c:237 LTD_MAIN_CPU2/Services/AoOutput/ao_output.c:259 LTD_MAIN_CPU2/Services/AoOutput/ao_output.c:795 LTD_MAIN_CPU2/Services/AoOutput/ao_output.c:813 | 8-8 芯片温度过高 | 协议29正式版；CPU2/CPU3 V1.34.0.0；不兼容协议28旧故障码
21-16 | 0x00150010 | AD5421_OVERTEMP_WARNING | 21 | 16 | 模拟输出与自检 | 模拟输出 | 模拟输出过温预警 | AD5421温度接近保护值 | 模拟输出过温预警 | 使用中 | 5 | LTD_MAIN_CPU2/BSP/Peripherals/src/ad5421.c:217 LTD_MAIN_CPU2/Services/AoOutput/ao_output.c:238 LTD_MAIN_CPU2/Services/AoOutput/ao_output.c:260 LTD_MAIN_CPU2/Services/AoOutput/ao_output.c:796 LTD_MAIN_CPU2/Services/AoOutput/ao_output.c:814 | 8-8 芯片温度过高 | 协议29正式版；CPU2/CPU3 V1.34.0.0；不兼容协议28旧故障码
22-1 | 0x00160001 | SYSTEM_BUFFER_CAPACITY_ERROR | 22 | 1 | 系统与软件 | 系统与软件 | 系统容量不足 | 内部缓冲区或存储分区容量不足 | 系统容量过小 | 使用中 | 4 | LTD_MAIN_CPU2/Application/Src/fault_recovery.c:96 LTD_MAIN_CPU2/Services/ParamStorage/system_parameter.c:793 LTD_MAIN_CPU2/Services/ParamStorage/system_parameter.c:925 LTD_MAIN_CPU2/Services/Sensor/SafeProtocol/sensor_safe_legacy_adapter.c:148 | 一代无直接同义编号；按二代责任域独立编号 | 协议29正式版；CPU2/CPU3 V1.34.0.0；不兼容协议28旧故障码
22-2 | 0x00160002 | SYSTEM_CALL_CONDITION_ERROR | 22 | 2 | 系统与软件 | 系统与软件 | 系统调用条件异常 | 内部调用参数或前置条件异常 | 系统输入异常 | 使用中 | 85 | LTD_MAIN_CPU2/Application/Src/fault_recovery.c:97 LTD_MAIN_CPU2/Application/Src/measure_density.c:30 LTD_MAIN_CPU2/Application/Src/measure_density.c:288 LTD_MAIN_CPU2/Application/Src/measure_density.c:393 LTD_MAIN_CPU2/Application/Src/measure_density.c:617 LTD_MAIN_CPU2/Application/Src/measure_density.c:682 LTD_MAIN_CPU2/Application/Src/measure_density.c:757 LTD_MAIN_CPU2/Application/Src/measure_density.c:1145 | 一代无直接同义编号；按二代责任域独立编号 | 协议29正式版；CPU2/CPU3 V1.34.0.0；不兼容协议28旧故障码
22-3 | 0x00160003 | SYSTEM_CALCULATION_ERROR | 22 | 3 | 系统与软件 | 系统与软件 | 系统计算异常 | 内部计算无法得到有效结果 | 系统计算异常 | 使用中 | 2 | LTD_MAIN_CPU2/Application/Src/fault_recovery.c:98 LTD_MAIN_CPU2/BSP/Peripherals/src/TMC5130.c:787 | 一代无直接同义编号；按二代责任域独立编号 | 协议29正式版；CPU2/CPU3 V1.34.0.0；不兼容协议28旧故障码

Sheet: 链路复查
屏幕编号 | 内部标识 | 主要来源 | 最终出口 | 日志名称 | 日志原因 | CPU3显示 | 恢复口径 | 检查结论 | 验证建议 | 一代对照
11-2 | MOTOR_TMC_COMM_ERROR | LTD_MAIN_CPU2/Application/Src/fault_manager.c:67 LTD_MAIN_CPU2/Application/Src/fault_recovery.c:45 LTD_MAIN_CPU2/Application/Src/measure_zero.c:67 LTD_MAIN_CPU2/BSP/Peripherals/src/TMC5130.c:47 LTD_MAIN_CPU2/BSP/Peripherals/src/TMC5130.c:343 LTD_MAIN_CPU2/BSP/Peripherals/src/TMC5130.c:369 LTD_MAIN_CPU2/BSP/Peripherals/src/TMC5130.c:431 LTD_MAIN_CPU2/BSP/Peripherals/src/TMC5130.c:454 | 具体故障码沿返回链保留，最终由业务流程或统一故障管理置错 | TMC5130通信异常 | TMC5130寄存器通信失败 | TMC5130通信异常 | 按现有命令白名单和故障恢复边界处理 | 来源、名称、原因和CPU3显示均已覆盖 | 台架核对编号、日志、停机和恢复行为 | 1-2 电机通讯错误
11-3 | MOTOR_TMC_CONFIG_LOST | LTD_MAIN_CPU2/Application/Src/fault_manager.c:68 LTD_MAIN_CPU2/Application/Src/fault_recovery.c:46 LTD_MAIN_CPU2/Application/Src/measure_zero.c:68 LTD_MAIN_CPU2/BSP/Peripherals/src/TMC5130.c:881 LTD_MAIN_CPU2/BSP/Peripherals/src/TMC5130.c:888 LTD_MAIN_CPU2/BSP/Peripherals/src/TMC5130.c:1021 LTD_MAIN_CPU2/BSP/Peripherals/src/TMC5130.c:1028 | 具体故障码沿返回链保留，最终由业务流程或统一故障管理置错 | 电机驱动配置丢失 | TMC5130运行期复位或关键配置丢失 | 电机驱动配置丢失 | 按现有命令白名单和故障恢复边界处理 | 来源、名称、原因和CPU3显示均已覆盖 | 台架核对编号、日志、停机和恢复行为 | 1-3 电机驱动异常重启
11-4 | MOTOR_DISABLED | LTD_MAIN_CPU2/Application/Src/fault_recovery.c:48 LTD_MAIN_CPU2/Application/Src/measure_zero.c:70 LTD_MAIN_CPU2/BSP/Peripherals/src/TMC5130.c:1071 LTD_MAIN_CPU2/BSP/Peripherals/src/TMC5130.c:1075 LTD_MAIN_CPU2/Services/MotorControl/motor_ctrl_driver_param.c:162 | 具体故障码沿返回链保留，最终由业务流程或统一故障管理置错 | 电机驱动未使能 | 电机驱动输出未使能 | 电机驱动未使能 | 按现有命令白名单和故障恢复边界处理 | 来源、名称、原因和CPU3显示均已覆盖 | 台架核对编号、日志、停机和恢复行为 | 1-4 修改电机使能输入状态后无法运行（上限位）
11-5 | MOTOR_UNKNOWN_FEEDBACK | LTD_MAIN_CPU2/Application/Src/fault_recovery.c:70 LTD_MAIN_CPU2/BSP/Peripherals/src/TMC5130.c:964 | 具体故障码沿返回链保留，最终由业务流程或统一故障管理置错 | 电机反馈未知 | 电机反馈状态无法识别 | 电机反馈未知 | 按现有命令白名单和故障恢复边界处理 | 来源、名称、原因和CPU3显示均已覆盖 | 台架核对编号、日志、停机和恢复行为 | 1-5 电机状态异常
11-10 | MOTOR_STEP_ERROR | LTD_MAIN_CPU2/Services/MotorControl/motor_ctrl_motion_api.c:1108 LTD_MAIN_CPU2/Services/MotorControl/motor_ctrl_motion_api.c:1111 LTD_MAIN_CPU2/Services/MotorControl/motor_ctrl_motion_api.c:1122 LTD_MAIN_CPU2/Services/MotorControl/motor_ctrl_motion_api.c:2024 | 具体故障码沿返回链保留，最终由业务流程或统一故障管理置错 | 电机无有效位移 | 丢步检测 | 电机无有效位移 | 按现有命令白名单和故障恢复边界处理 | 来源、名称、原因和CPU3显示均已覆盖 | 台架核对编号、日志、停机和恢复行为 | 1-10 输入步进数错误； 下位位置高于当前位置 限制上行时步进数超过零点
11-11 | MOTOR_STALL_ERROR | LTD_MAIN_CPU2/Application/Src/fault_recovery.c:72 LTD_MAIN_CPU2/BSP/Peripherals/src/TMC5130.c:97 LTD_MAIN_CPU2/BSP/Peripherals/src/TMC5130.c:148 | 具体故障码沿返回链保留，最终由业务流程或统一故障管理置错 | 电机堵转 | 电机堵转或负载阻力过大 | 电机运行阻力大 | 按现有命令白名单和故障恢复边界处理 | 来源、名称、原因和CPU3显示均已覆盖 | 台架核对编号、日志、停机和恢复行为 | 1-11 电机堵转
11-16 | MOTOR_CHARGE_PUMP_UNDER_VOLTAGE | LTD_MAIN_CPU2/Application/Src/fault_recovery.c:47 LTD_MAIN_CPU2/Application/Src/measure_zero.c:69 LTD_MAIN_CPU2/BSP/Peripherals/src/TMC5130.c:998 | 具体故障码沿返回链保留，最终由业务流程或统一故障管理置错 | 电荷泵欠压 | 电荷泵欠压 | 电荷泵欠压 | 按现有命令白名单和故障恢复边界处理 | 来源、名称、原因和CPU3显示均已覆盖 | 台架核对编号、日志、停机和恢复行为 | 1-7 电机驱动器报警
11-17 | MOTOR_OVERTEMPERATURE | LTD_MAIN_CPU2/Application/Src/fault_recovery.c:71 LTD_MAIN_CPU2/BSP/Peripherals/src/TMC5130.c:101 LTD_MAIN_CPU2/BSP/Peripherals/src/TMC5130.c:142 | 具体故障码沿返回链保留，最终由业务流程或统一故障管理置错 | 电机驱动过温关断 | 电机驱动已过温关断 | 电机驱动过温停止 | 按现有命令白名单和故障恢复边界处理 | 来源、名称、原因和CPU3显示均已覆盖 | 台架核对编号、日志、停机和恢复行为 | 1-7 电机驱动器报警
11-18 | MOTOR_RUN_TIMEOUT | LTD_MAIN_CPU2/Application/Src/fault_recovery.c:50 LTD_MAIN_CPU2/Application/Src/measure_zero.c:72 LTD_MAIN_CPU2/Services/MotorControl/motor_ctrl_motion_api.c:2028 LTD_MAIN_CPU2/Services/MotorControl/motor_ctrl_motion_api.c:2352 LTD_MAIN_CPU2/Services/MotorControl/motor_ctrl_motion_api.c:2355 LTD_MAIN_CPU2/Services/MotorControl/motor_ctrl_motion_api.c:2362 | 具体故障码沿返回链保留，最终由业务流程或统一故障管理置错 | 电机运行超时 | 电机整段运行超时 | 电机运行超时 | 可在部件状态恢复后按命令白名单重跑 | 来源、名称、原因和CPU3显示均已覆盖 | 故障注入11-18，核对屏幕编号、日志原因、停机和恢复口径 | 1-10 输入步进数错误
11-19 | MOTOR_PHASE_SHORT_ERROR | LTD_MAIN_CPU2/Application/Src/fault_recovery.c:73 LTD_MAIN_CPU2/BSP/Peripherals/src/TMC5130.c:114 LTD_MAIN_CPU2/BSP/Peripherals/src/TMC5130.c:121 LTD_MAIN_CPU2/BSP/Peripherals/src/TMC5130.c:144 | 具体故障码沿返回链保留，最终由业务流程或统一故障管理置错 | 电机相线短路 | 电机相线检测到短路 | 电机相线短路 | 按现有命令白名单和故障恢复边界处理 | 来源、名称、原因和CPU3显示均已覆盖 | 台架核对编号、日志、停机和恢复行为 | 1-15 电机芯片报警
11-20 | MOTOR_PHASE_OPEN_ERROR | LTD_MAIN_CPU2/Application/Src/fault_recovery.c:74 LTD_MAIN_CPU2/BSP/Peripherals/src/TMC5130.c:128 LTD_MAIN_CPU2/BSP/Peripherals/src/TMC5130.c:135 LTD_MAIN_CPU2/BSP/Peripherals/src/TMC5130.c:146 | 具体故障码沿返回链保留，最终由业务流程或统一故障管理置错 | 电机相线断路 | 电机相线断路或接触不良 | 电机相线开路 | 按现有命令白名单和故障恢复边界处理 | 来源、名称、原因和CPU3显示均已覆盖 | 台架核对编号、日志、停机和恢复行为 | 1-15 电机芯片报警
11-21 | MOTOR_DRIVER_OVERTEMP_WARNING | LTD_MAIN_CPU2/Application/Src/fault_recovery.c:75 LTD_MAIN_CPU2/BSP/Peripherals/src/TMC5130.c:107 LTD_MAIN_CPU2/BSP/Peripherals/src/TMC5130.c:150 | 具体故障码沿返回链保留，最终由业务流程或统一故障管理置错 | 电机驱动过温预警 | 电机驱动温度接近保护值 | 电机驱动过温预警 | 按现有命令白名单和故障恢复边界处理 | 来源、名称、原因和CPU3显示均已覆盖 | 台架核对编号、日志、停机和恢复行为 | 1-7 电机驱动器报警
11-22 | MOTOR_DRIVER_NOT_INITIALIZED | LTD_MAIN_CPU2/Application/Src/fault_recovery.c:49 LTD_MAIN_CPU2/Application/Src/measure_zero.c:71 LTD_MAIN_CPU2/Services/MotorControl/motor_ctrl_driver_param.c:319 LTD_MAIN_CPU2/Services/MotorControl/motor_ctrl_position_model.c:439 LTD_MAIN_CPU2/Services/MotorControl/motor_ctrl_position_model.c:575 LTD_MAIN_CPU2/Services/MotorControl/motor_ctrl_position_model.c:880 | 具体故障码沿返回链保留，最终由业务流程或统一故障管理置错 | 电机驱动未初始化 | 电机驱动尚未完成初始化 | 电机驱动未初始化 | 按现有命令白名单和故障恢复边界处理 | 来源、名称、原因和CPU3显示均已覆盖 | 台架核对编号、日志、停机和恢复行为 | 1-3 电机驱动异常重启；1-4 修改电机使能输入状态后无法运行（上限位）
11-23 | MOTOR_STOP_WAIT_TIMEOUT | LTD_MAIN_CPU2/Application/Src/fault_recovery.c:51 LTD_MAIN_CPU2/Application/Src/measure_zero.c:73 LTD_MAIN_CPU2/Services/MotorControl/motor_ctrl_driver_param.c:735 LTD_MAIN_CPU2/Services/MotorControl/motor_ctrl_driver_param.c:736 LTD_MAIN_CPU2/Services/MotorControl/motor_ctrl_motion_api.c:2416 LTD_MAIN_CPU2/Services/MotorControl/motor_ctrl_motion_api.c:2420 | 具体故障码沿返回链保留，最终由业务流程或统一故障管理置错 | 电机停止等待超时 | 停止命令后电机未在规定时间停稳 | 电机停止等待超时 | 按现有命令白名单和故障恢复边界处理 | 来源、名称、原因和CPU3显示均已覆盖 | 台架核对编号、日志、停机和恢复行为 | 1-10 输入步进数错误； 下位位置高于当前位置 限制上行时步进数超过零点
11-24 | MOTOR_ARRIVAL_WAIT_TIMEOUT | LTD_MAIN_CPU2/Application/Src/fault_recovery.c:52 LTD_MAIN_CPU2/Application/Src/measure_zero.c:74 LTD_MAIN_CPU2/Services/MotorControl/motor_ctrl_motion_api.c:1181 LTD_MAIN_CPU2/Services/MotorControl/motor_ctrl_motion_api.c:1184 LTD_MAIN_CPU2/Services/MotorControl/motor_ctrl_motion_api.c:1191 | 具体故障码沿返回链保留，最终由业务流程或统一故障管理置错 | 电机到位等待超时 | 电机未在规定时间到达目标位置 | 电机到位等待超时 | 可在部件状态恢复后按命令白名单重跑 | 来源、名称、原因和CPU3显示均已覆盖 | 故障注入11-26，核对屏幕编号、日志原因、停机和恢复口径 | 1-10 输入步进数错误
12-1 | ENCODER_TIMEOUT | LTD_MAIN_CPU2/Application/Src/app_main.c:33 LTD_MAIN_CPU2/BSP/Peripherals/src/AS5145.c:157 LTD_MAIN_CPU2/BSP/Peripherals/src/AS5145.c:178 LTD_MAIN_CPU2/BSP/Peripherals/src/AS5145.c:260 LTD_MAIN_CPU2/BSP/Peripherals/src/AS5145.c:261 LTD_MAIN_CPU2/BSP/Peripherals/src/AS5145.c:276 LTD_MAIN_CPU2/BSP/Peripherals/src/AS5145.c:277 LTD_MAIN_CPU2/Services/Encoder/encoder.c:176 | 具体故障码沿返回链保留，最终由业务流程或统一故障管理置错 | 编码器采集接口异常 | 编码器SPI或DMA采集接口异常 | 编码器读取异常 | 按现有命令白名单和故障恢复边界处理 | 来源、名称、原因和CPU3显示均已覆盖 | 台架核对编号、日志、停机和恢复行为 | 2-1 与EC板通讯超时 （EC板和主控板通讯问题）
12-2 | ENCODER_PARITY_ERROR | LTD_MAIN_CPU2/BSP/Peripherals/src/AS5145.c:160 | 具体故障码沿返回链保留，最终由业务流程或统一故障管理置错 | 编码器校验失败 | 编码器校验失败 | 编码器校验失败 | 按现有命令白名单和故障恢复边界处理 | 来源、名称、原因和CPU3显示均已覆盖 | 台架核对编号、日志、停机和恢复行为 | 2-2 与EC板通讯编码数据校验错误
12-3 | ENCODER_LOST_STEP | LTD_MAIN_CPU2/Services/MotorControl/motor_ctrl_lost_step_detect.c:168 LTD_MAIN_CPU2/Services/MotorControl/motor_ctrl_lost_step_detect.c:191 LTD_MAIN_CPU2/Services/MotorControl/motor_ctrl_motion_api.c:553 LTD_MAIN_CPU2/Services/MotorControl/motor_ctrl_position_model.c:518 | 具体故障码沿返回链保留，最终由业务流程或统一故障管理置错 | 编码器检测到丢步 | 丢步检测 | 编码器检测到丢步 | 按现有命令白名单和故障恢复边界处理 | 来源、名称、原因和CPU3显示均已覆盖 | 台架核对编号、日志、停机和恢复行为 | 2-3 运行过程中丢步
12-5 | ENCODER_POWERON_FAIL | LTD_MAIN_CPU2/Application/Src/test.c:2256 LTD_MAIN_CPU2/Application/Src/test.c:2269 LTD_MAIN_CPU2/Application/Src/test.c:2270 LTD_MAIN_CPU2/Services/Encoder/encoder.c:165 | 具体故障码沿返回链保留，最终由业务流程或统一故障管理置错 | 编码器上电初始化失败 | 初始化失败 | 编码器上电初始化失败 | 按现有命令白名单和故障恢复边界处理 | 来源、名称、原因和CPU3显示均已覆盖 | 台架核对编号、日志、停机和恢复行为 | 2-5 读取断电编码值失败
12-6 | ENCODER_POWERON_CHANGE | 无主动调用 | 具体故障码沿返回链保留，最终由业务流程或统一故障管理置错 | 编码器上电值变化 | 编码器上电状态变化 | 编码器上电值变化 | 按现有命令白名单和故障恢复边界处理 | 来源、名称、原因和CPU3显示均已覆盖 | 台架核对编号、日志、停机和恢复行为 | 2-6 上电后编码值变动；
12-10 | ENCODER_DIFF_EXCESS | LTD_MAIN_CPU2/Services/MotorControl/motor_ctrl_position_model.c:518 | 具体故障码沿返回链保留，最终由业务流程或统一故障管理置错 | 编码器相邻差值过大 | 丢步检测 | 编码器相邻差值过大 | 按现有命令白名单和故障恢复边界处理 | 来源、名称、原因和CPU3显示均已覆盖 | 台架核对编号、日志、停机和恢复行为 | 2-10 固定点检测时编码值发生变化
12-12 | ENCODER_CORDIC_OVERFLOW | LTD_MAIN_CPU2/BSP/Peripherals/src/AS5145.c:166 | 具体故障码沿返回链保留，最终由业务流程或统一故障管理置错 | 编码器角度运算溢出 | 编码器内部角度运算溢出 | 编码器角度运算溢出 | 按现有命令白名单和故障恢复边界处理 | 来源、名称、原因和CPU3显示均已覆盖 | 台架核对编号、日志、停机和恢复行为 | 一代无直接同义编号；按二代责任域独立编号
12-13 | ENCODER_LINEARITY_WARNING | LTD_MAIN_CPU2/BSP/Peripherals/src/AS5145.c:169 | 具体故障码沿返回链保留，最终由业务流程或统一故障管理置错 | 编码器线性度报警 | 编码器线性度报警 | 编码器线性度报警 | 按现有命令白名单和故障恢复边界处理 | 来源、名称、原因和CPU3显示均已覆盖 | 台架核对编号、日志、停机和恢复行为 | 一代无直接同义编号；按二代责任域独立编号
12-14 | ENCODER_OCF_INCOMPLETE | LTD_MAIN_CPU2/BSP/Peripherals/src/AS5145.c:163 | 具体故障码沿返回链保留，最终由业务流程或统一故障管理置错 | 编码器角度计算未完成 | 编码器角度计算尚未完成 | 编码器角度计算未完成 | 按现有命令白名单和故障恢复边界处理 | 来源、名称、原因和CPU3显示均已覆盖 | 台架核对编号、日志、停机和恢复行为 | 一代无直接同义编号；按二代责任域独立编号
12-15 | ENCODER_FIRST_SAMPLE_TIMEOUT | LTD_MAIN_CPU2/Application/Src/app_main.c:33 LTD_MAIN_CPU2/Application/Src/app_main.c:144 LTD_MAIN_CPU2/BSP/Peripherals/src/AS5145.c:178 LTD_MAIN_CPU2/BSP/Peripherals/src/AS5145.c:328 LTD_MAIN_CPU2/Services/MotorControl/motor_ctrl_driver_param.c:208 LTD_MAIN_CPU2/Services/MotorControl/motor_ctrl_driver_param.c:220 LTD_MAIN_CPU2/Services/MotorControl/motor_ctrl_driver_param.c:222 LTD_MAIN_CPU2/Services/MotorControl/motor_ctrl_position_model.c:1088 | 具体故障码沿返回链保留，最终由业务流程或统一故障管理置错 | 编码器首帧超时 | 启动后未收到首个有效位置 | 编码器首次读取超时 | 按现有命令白名单和故障恢复边界处理 | 来源、名称、原因和CPU3显示均已覆盖 | 台架核对编号、日志、停机和恢复行为 | 2-1 与EC板通讯超时 （EC板和主控板通讯问题）
12-16 | ENCODER_CIRCUMFERENCE_CALIBRATION_ERROR | LTD_MAIN_CPU2/Application/Src/fault_recovery.c:76 LTD_MAIN_CPU2/Services/MotorControl/motor_ctrl_motion_api.c:358 LTD_MAIN_CPU2/Services/MotorControl/motor_ctrl_motion_api.c:364 LTD_MAIN_CPU2/Services/MotorControl/motor_ctrl_motion_api.c:391 LTD_MAIN_CPU2/Services/MotorControl/motor_ctrl_motion_api.c:400 LTD_MAIN_CPU2/Services/MotorControl/motor_ctrl_position_model.c:457 LTD_MAIN_CPU2/Services/MotorControl/motor_ctrl_position_model.c:578 LTD_MAIN_CPU2/Services/MotorControl/motor_ctrl_position_model.c:590 | 具体故障码沿返回链保留，最终由业务流程或统一故障管理置错 | 编码轮周长标定异常 | 编码轮周长标定结果不可信 | 编码轮周长标定异常 | 确定性配置、边界或硬件故障，不自动重跑 | 来源、名称、原因和CPU3显示均已覆盖 | 台架核对编号、日志、停机和恢复行为 | 2-3 运行过程中丢步；2-10 固定点检测时编码值发生变化
13-1 | SENSOR_BCC_ERROR | LTD_MAIN_CPU2/Services/Sensor/dsm_sensor_communication.c:432 LTD_MAIN_CPU2/Services/Sensor/dsm_sensor_communication.c:793 LTD_MAIN_CPU2/Services/Sensor/ltd_sensor_communication.c:295 LTD_MAIN_CPU2/Services/Sensor/SafeProtocol/sensor_safe_legacy_adapter.c:33 LTD_MAIN_CPU2/Services/Sensor/SafeProtocol/sensor_safe_legacy_adapter.c:84 | 具体故障码沿返回链保留，最终由业务流程或统一故障管理置错 | 传感器校验错误 | 传感器数据校验失败 | 传感器校验错误 | 按现有命令白名单和故障恢复边界处理 | 来源、名称、原因和CPU3显示均已覆盖 | 台架核对编号、日志、停机和恢复行为 | 3-1 传感器数据校验错误
13-2 | SONIC_FREQ_ABNORMAL | LTD_MAIN_CPU2/Application/Src/measure_density.c:1304 LTD_MAIN_CPU2/Application/Src/wartsila_density_measurement.c:224 LTD_MAIN_CPU2/Services/Sensor/SafeProtocol/sensor_safe_legacy_adapter.c:348 LTD_MAIN_CPU2/Services/Sensor/SafeProtocol/sensor_safe_legacy_adapter.c:357 LTD_MAIN_CPU2/Services/Sensor/sensor.c:435 LTD_MAIN_CPU2/Services/Sensor/sensor.c:546 LTD_MAIN_CPU2/Services/Sensor/sensor.c:549 LTD_MAIN_CPU2/Services/Sensor/sensor.c:552 | 具体故障码沿返回链保留，最终由业务流程或统一故障管理置错 | 震动管频率异常 | 震动管频率异常 | 震动管频率异常 | 按现有命令白名单和故障恢复边界处理 | 来源、名称、原因和CPU3显示均已覆盖 | 台架核对编号、日志、停机和恢复行为 | 3-2 密度传感器频率异常
13-3 | SENSOR_DEVICE_COMM_TIMEOUT | LTD_MAIN_CPU2/Services/Sensor/ch9141_at.c:174 LTD_MAIN_CPU2/Services/Sensor/ch9141_at.c:510 LTD_MAIN_CPU2/Services/Sensor/ch9141_at.c:599 LTD_MAIN_CPU2/Services/Sensor/dsm_sensor_communication.c:254 LTD_MAIN_CPU2/Services/Sensor/dsm_sensor_communication.c:409 LTD_MAIN_CPU2/Services/Sensor/dsm_sensor_communication.c:442 LTD_MAIN_CPU2/Services/Sensor/ltd_sensor_communication.c:241 LTD_MAIN_CPU2/Services/Sensor/ltd_sensor_communication.c:345 | 具体故障码沿返回链保留，最终由业务流程或统一故障管理置错 | 传感器通信超时 | 传感器无响应 | 传感器通信超时 | 按现有命令白名单和故障恢复边界处理 | 来源、名称、原因和CPU3显示均已覆盖 | 台架核对编号、日志、停机和恢复行为 | 3-3 密度传感器通信超时
13-5 | SENSOR_INTERNAL_CPU_COMM_TIMEOUT | LTD_MAIN_CPU2/Services/Sensor/dsm_sensor_communication.c:60 | 具体故障码沿返回链保留，最终由业务流程或统一故障管理置错 | 传感器内部通信超时 | 传感器内部处理单元通信超时 | 传感器内部通信超时 | 按现有命令白名单和故障恢复边界处理 | 来源、名称、原因和CPU3显示均已覆盖 | 台架核对编号、日志、停机和恢复行为 | 3-5 二代密度传感器：密度传感器组件失效 三代密度传感器：与CPU0通讯超时
13-14 | SENSOR_GYRO_ANGLE_ERROR | LTD_MAIN_CPU2/Services/Sensor/dsm_sensor_communication.c:58 LTD_MAIN_CPU2/Services/Sensor/SafeProtocol/sensor_safe_legacy_adapter.c:381 | 具体故障码沿返回链保留，最终由业务流程或统一故障管理置错 | 传感器姿态角异常 | 传感器姿态角异常 | 传感器角度异常 | 按现有命令白名单和故障恢复边界处理 | 来源、名称、原因和CPU3显示均已覆盖 | 台架核对编号、日志、停机和恢复行为 | 3-14 本次确认液体或者空气中角度值与上次差值大;
13-16 | SENSOR_INTERNAL_COMM_CHECK_ERROR | LTD_MAIN_CPU2/Services/Sensor/dsm_sensor_communication.c:61 | 具体故障码沿返回链保留，最终由业务流程或统一故障管理置错 | 传感器内部校验异常 | 传感器内部通信校验异常 | 传感器内部校验异常 | 按现有命令白名单和故障恢复边界处理 | 来源、名称、原因和CPU3显示均已覆盖 | 台架核对编号、日志、停机和恢复行为 | 3-16 与密度管通讯校验错误
13-21 | SENSOR_NO_RESONANCE | LTD_MAIN_CPU2/Services/Sensor/dsm_sensor_communication.c:55 | 具体故障码沿返回链保留，最终由业务流程或统一故障管理置错 | 传感器无谐振 | 传感器未检测到谐振信号 | 传感器频率异常 | 按现有命令白名单和故障恢复边界处理 | 来源、名称、原因和CPU3显示均已覆盖 | 台架核对编号、日志、停机和恢复行为 | 3-21 传感器扫频无谐振(FS) （探头频率>17900或小于10010）
13-26 | DENSITY_INVALID | LTD_MAIN_CPU2/Application/Src/measure_oilLevel.c:356 LTD_MAIN_CPU2/Application/Src/measure_oilLevel.c:511 LTD_MAIN_CPU2/Application/Src/measure_oilLevel.c:514 LTD_MAIN_CPU2/Services/Sensor/SafeProtocol/sensor_safe_legacy_adapter.c:345 | 具体故障码沿返回链保留，最终由业务流程或统一故障管理置错 | 密度值异常 | 密度值异常（有效范围>0且≤3000.0kg/m³） | 密度值异常 | 按现有命令白名单和故障恢复边界处理 | 源码、日志、显示和3000.0kg/m³边界已同步 | 台架验证3000.0有效、3000.01触发13-26 | 3-26 等同于3-12（3-26不会受密度分层影响） 1.二代密度传感器的频率异常 2.三代传感器的密度值异常； 3.温度无效值。
13-27 | SENSOR_RESP_FORMAT_ERROR | LTD_MAIN_CPU2/Services/Sensor/dsm_sensor_communication.c:168 LTD_MAIN_CPU2/Services/Sensor/dsm_sensor_communication.c:199 LTD_MAIN_CPU2/Services/Sensor/dsm_sensor_communication.c:238 LTD_MAIN_CPU2/Services/Sensor/dsm_sensor_communication.c:254 LTD_MAIN_CPU2/Services/Sensor/dsm_sensor_communication.c:412 LTD_MAIN_CPU2/Services/Sensor/dsm_sensor_communication.c:529 LTD_MAIN_CPU2/Services/Sensor/dsm_sensor_communication.c:549 LTD_MAIN_CPU2/Services/Sensor/dsm_sensor_communication.c:573 | 具体故障码沿返回链保留，最终由业务流程或统一故障管理置错 | 传感器响应格式异常 | 传感器响应内容不符合协议 | 传感器响应格式异常 | 按现有命令白名单和故障恢复边界处理 | 来源、名称、原因和CPU3显示均已覆盖 | 台架核对编号、日志、停机和恢复行为 | 一代无直接同义编号；按二代责任域独立编号
13-28 | SENSOR_POWER_SUPPLY_ERROR | LTD_MAIN_CPU2/Services/Sensor/dsm_sensor_communication.c:56 LTD_MAIN_CPU2/Services/Sensor/SafeProtocol/sensor_safe_legacy_adapter.c:108 | 具体故障码沿返回链保留，最终由业务流程或统一故障管理置错 | 传感器供电异常 | 传感器供电电压异常 | 传感器电源异常 | 按现有命令白名单和故障恢复边界处理 | 来源、名称、原因和CPU3显示均已覆盖 | 台架核对编号、日志、停机和恢复行为 | 3-3 密度传感器通信超时；3-5 二代密度传感器：密度传感器组件失效 三代密度传感器：与CPU0通讯超时
13-29 | SENSOR_GYRO_COMM_TIMEOUT | LTD_MAIN_CPU2/Services/Sensor/dsm_sensor_communication.c:57 | 具体故障码沿返回链保留，最终由业务流程或统一故障管理置错 | 姿态模块通信超时 | 传感器姿态模块通信超时 | 角度单元通信超时 | 按现有命令白名单和故障恢复边界处理 | 来源、名称、原因和CPU3显示均已覆盖 | 台架核对编号、日志、停机和恢复行为 | 3-8 陀螺仪组件未响应；；3-10 读取陀螺仪时通信超时；
13-30 | SENSOR_SELF_TEST_FAILED | LTD_MAIN_CPU2/Services/Sensor/dsm_sensor_communication.c:59 LTD_MAIN_CPU2/Services/Sensor/SafeProtocol/sensor_safe_legacy_adapter.c:106 | 具体故障码沿返回链保留，最终由业务流程或统一故障管理置错 | 传感器自检失败 | 传感器自检未通过 | 传感器自检失败 | 按现有命令白名单和故障恢复边界处理 | 来源、名称、原因和CPU3显示均已覆盖 | 台架核对编号、日志、停机和恢复行为 | 3-5 二代密度传感器：密度传感器组件失效 三代密度传感器：与CPU0通讯超时
13-31 | SENSOR_IDENTITY_MISMATCH | LTD_MAIN_CPU2/Application/Src/fault_recovery.c:77 LTD_MAIN_CPU2/Services/Sensor/SafeProtocol/sensor_safe_legacy_adapter.c:43 LTD_MAIN_CPU2/Services/Sensor/SafeProtocol/sensor_safe_legacy_adapter.c:150 | 具体故障码沿返回链保留，最终由业务流程或统一故障管理置错 | 传感器身份不匹配 | 传感器身份信息与当前设备配置不一致 | 传感器身份不一致 | 确定性配置故障，不自动重跑 | 来源、名称、原因和CPU3显示均已覆盖 | 故障注入13-31，核对屏幕编号、日志原因、停机和恢复口径 | 一代无直接同义编号；按二代责任域独立编号
13-32 | SENSOR_PROTOCOL_VERSION_INCOMPATIBLE | LTD_MAIN_CPU2/Application/Src/fault_recovery.c:78 LTD_MAIN_CPU2/Services/Sensor/SafeProtocol/sensor_safe_legacy_adapter.c:35 LTD_MAIN_CPU2/Services/Sensor/SafeProtocol/sensor_safe_legacy_adapter.c:76 | 具体故障码沿返回链保留，最终由业务流程或统一故障管理置错 | 传感器协议版本不兼容 | 传感器通信协议版本不兼容 | 传感器协议版本不匹配 | 确定性版本故障，不自动重跑 | 来源、名称、原因和CPU3显示均已覆盖 | 故障注入13-32，核对屏幕编号、日志原因、停机和恢复口径 | 一代无直接同义编号；按二代责任域独立编号
13-33 | SENSOR_MODE_NOT_READY | LTD_MAIN_CPU2/Services/Sensor/SafeProtocol/sensor_safe_legacy_adapter.c:92 LTD_MAIN_CPU2/Services/Sensor/SafeProtocol/sensor_safe_legacy_adapter.c:308 | 具体故障码沿返回链保留，最终由业务流程或统一故障管理置错 | 传感器模式未就绪 | 传感器测量模式尚未准备完成 | 传感器模式未准备 | 状态恢复后可重新执行测量 | 来源、名称、原因和CPU3显示均已覆盖 | 故障注入13-33，核对屏幕编号、日志原因、停机和恢复口径 | 一代无直接同义编号；按二代责任域独立编号
13-34 | SENSOR_CONFIG_EPOCH_MISMATCH | LTD_MAIN_CPU2/Services/Sensor/SafeProtocol/sensor_safe_legacy_adapter.c:53 LTD_MAIN_CPU2/Services/Sensor/SafeProtocol/sensor_safe_legacy_adapter.c:102 | 具体故障码沿返回链保留，最终由业务流程或统一故障管理置错 | 传感器配置代次不一致 | 传感器配置代次与当前会话不一致 | 传感器配置代次不一致 | 重新建立连接并确认配置后可恢复 | 来源、名称、原因和CPU3显示均已覆盖 | 故障注入13-34，核对屏幕编号、日志原因、停机和恢复口径 | 一代无直接同义编号；按二代责任域独立编号
13-35 | SENSOR_STREAM_STATE_ERROR | LTD_MAIN_CPU2/Services/Sensor/SafeProtocol/sensor_safe_legacy_adapter.c:57 | 具体故障码沿返回链保留，最终由业务流程或统一故障管理置错 | 传感器上报状态不一致 | 传感器周期上报状态与当前记录不一致 | 传感器上报状态不一致 | 重新建立上报状态后可恢复 | 来源、名称、原因和CPU3显示均已覆盖 | 故障注入13-35，核对屏幕编号、日志原因、停机和恢复口径 | 一代无直接同义编号；按二代责任域独立编号
13-36 | SENSOR_DATA_STALE | LTD_MAIN_CPU2/Services/Sensor/SafeProtocol/sensor_safe_legacy_adapter.c:61 LTD_MAIN_CPU2/Services/Sensor/SafeProtocol/sensor_safe_legacy_adapter.c:100 LTD_MAIN_CPU2/Services/Sensor/SafeProtocol/sensor_safe_legacy_adapter.c:144 | 具体故障码沿返回链保留，最终由业务流程或统一故障管理置错 | 传感器数据过期 | 传感器数据超过允许更新时间 | 传感器数据过期 | 按现有命令白名单和故障恢复边界处理 | 来源、名称、原因和CPU3显示均已覆盖 | 台架核对编号、日志、停机和恢复行为 | 一代无直接同义编号；按二代责任域独立编号
13-37 | SENSOR_TEMPERATURE_RANGE_ERROR | LTD_MAIN_CPU2/Services/Sensor/SafeProtocol/sensor_safe_legacy_adapter.c:110 | 具体故障码沿返回链保留，最终由业务流程或统一故障管理置错 | 传感器温度超限 | 传感器温度超出工作范围 | 传感器温度超限 | 按现有命令白名单和故障恢复边界处理 | 来源、名称、原因和CPU3显示均已覆盖 | 台架核对编号、日志、停机和恢复行为 | 一代无直接同义编号；按二代责任域独立编号
13-38 | SENSOR_REMOTE_INTERNAL_ERROR | LTD_MAIN_CPU2/Services/Sensor/SafeProtocol/sensor_safe_legacy_adapter.c:118 LTD_MAIN_CPU2/Services/Sensor/SafeProtocol/sensor_safe_legacy_adapter.c:154 LTD_MAIN_CPU2/Services/Sensor/SafeProtocol/sensor_safe_legacy_adapter.c:171 LTD_MAIN_CPU2/Services/Sensor/SafeProtocol/sensor_safe_legacy_adapter.c:241 LTD_MAIN_CPU2/Services/Sensor/SafeProtocol/sensor_safe_legacy_adapter.c:248 LTD_MAIN_CPU2/Services/Sensor/SafeProtocol/sensor_safe_legacy_adapter.c:369 | 具体故障码沿返回链保留，最终由业务流程或统一故障管理置错 | 传感器内部故障 | 传感器远端内部故障 | 传感器内部故障 | 按现有命令白名单和故障恢复边界处理 | 来源、名称、原因和CPU3显示均已覆盖 | 台架核对编号、日志、停机和恢复行为 | 3-5 二代密度传感器：密度传感器组件失效 三代密度传感器：与CPU0通讯超时
13-39 | SENSOR_ADDRESS_MISMATCH | LTD_MAIN_CPU2/Services/Sensor/SafeProtocol/sensor_safe_legacy_adapter.c:39 LTD_MAIN_CPU2/Services/Sensor/SafeProtocol/sensor_safe_legacy_adapter.c:90 | 具体故障码沿返回链保留，最终由业务流程或统一故障管理置错 | 传感器地址不匹配 | 传感器响应地址与目标地址不一致 | 传感器地址不匹配 | 地址恢复一致后重新连接 | 来源、名称、原因和CPU3显示均已覆盖 | 故障注入13-39，核对屏幕编号、日志原因、停机和恢复口径 | 一代无直接同义编号；按二代责任域独立编号
13-40 | SENSOR_SESSION_INVALID | LTD_MAIN_CPU2/Services/Sensor/SafeProtocol/sensor_safe_legacy_adapter.c:41 LTD_MAIN_CPU2/Services/Sensor/SafeProtocol/sensor_safe_legacy_adapter.c:88 LTD_MAIN_CPU2/Services/Sensor/SafeProtocol/sensor_safe_legacy_adapter.c:152 LTD_MAIN_CPU2/Services/Sensor/SafeProtocol/sensor_safe_legacy_adapter.c:173 | 具体故障码沿返回链保留，最终由业务流程或统一故障管理置错 | 传感器会话失效 | 传感器通信会话已失效 | 传感器会话失效 | 重新建立会话后可恢复 | 来源、名称、原因和CPU3显示均已覆盖 | 故障注入13-40，核对屏幕编号、日志原因、停机和恢复口径 | 一代无直接同义编号；按二代责任域独立编号
13-41 | SENSOR_SEQUENCE_ERROR | LTD_MAIN_CPU2/Services/Sensor/SafeProtocol/sensor_safe_legacy_adapter.c:45 LTD_MAIN_CPU2/Services/Sensor/SafeProtocol/sensor_safe_legacy_adapter.c:86 | 具体故障码沿返回链保留，最终由业务流程或统一故障管理置错 | 传感器报文序号异常 | 传感器报文序号不连续或不符合预期 | 传感器报文序号异常 | 重新建立连接并确认新序号后恢复 | 来源、名称、原因和CPU3显示均已覆盖 | 故障注入13-41，核对屏幕编号、日志原因、停机和恢复口径 | 一代无直接同义编号；按二代责任域独立编号
13-42 | SENSOR_HANDSHAKE_REQUIRED | LTD_MAIN_CPU2/Services/Sensor/SafeProtocol/sensor_safe_legacy_adapter.c:47 | 具体故障码沿返回链保留，最终由业务流程或统一故障管理置错 | 传感器需要重新握手 | 传感器要求重新建立通信会话 | 传感器需要重新握手 | 重新握手后可恢复 | 来源、名称、原因和CPU3显示均已覆盖 | 故障注入13-42，核对屏幕编号、日志原因、停机和恢复口径 | 一代无直接同义编号；按二代责任域独立编号
13-43 | SENSOR_REPLAY_DETECTED | LTD_MAIN_CPU2/Services/Sensor/SafeProtocol/sensor_safe_legacy_adapter.c:49 | 具体故障码沿返回链保留，最终由业务流程或统一故障管理置错 | 传感器重复报文 | 检测到传感器重复或过期报文 | 传感器收到重复报文 | 取得新的有效报文后恢复 | 来源、名称、原因和CPU3显示均已覆盖 | 故障注入13-43，核对屏幕编号、日志原因、停机和恢复口径 | 一代无直接同义编号；按二代责任域独立编号
13-44 | SENSOR_CAPABILITY_UNSUPPORTED | LTD_MAIN_CPU2/Application/Src/fault_recovery.c:79 LTD_MAIN_CPU2/Services/Sensor/SafeProtocol/sensor_safe_legacy_adapter.c:37 LTD_MAIN_CPU2/Services/Sensor/SafeProtocol/sensor_safe_legacy_adapter.c:146 | 具体故障码沿返回链保留，最终由业务流程或统一故障管理置错 | 传感器能力不支持 | 传感器不支持当前设备要求的功能 | 传感器能力不支持 | 确定性能力故障，不自动重跑 | 来源、名称、原因和CPU3显示均已覆盖 | 故障注入13-44，核对屏幕编号、日志原因、停机和恢复口径 | 一代无直接同义编号；按二代责任域独立编号
13-45 | SENSOR_COMMAND_UNSUPPORTED | LTD_MAIN_CPU2/Application/Src/fault_recovery.c:80 LTD_MAIN_CPU2/Services/Sensor/SafeProtocol/sensor_safe_legacy_adapter.c:78 | 具体故障码沿返回链保留，最终由业务流程或统一故障管理置错 | 传感器命令不支持 | 传感器不支持本次命令 | 传感器命令不支持 | 确定性命令故障，不自动重跑 | 来源、名称、原因和CPU3显示均已覆盖 | 故障注入13-45，核对屏幕编号、日志原因、停机和恢复口径 | 一代无直接同义编号；按二代责任域独立编号
13-46 | SENSOR_ARGUMENT_REJECTED | LTD_MAIN_CPU2/Application/Src/fault_recovery.c:81 LTD_MAIN_CPU2/Services/Sensor/SafeProtocol/sensor_safe_legacy_adapter.c:80 | 具体故障码沿返回链保留，最终由业务流程或统一故障管理置错 | 传感器命令参数被拒绝 | 传感器拒绝本次命令参数 | 传感器拒绝命令参数 | 确定性参数故障，不自动重跑 | 来源、名称、原因和CPU3显示均已覆盖 | 故障注入13-46，核对屏幕编号、日志原因、停机和恢复口径 | 一代无直接同义编号；按二代责任域独立编号
13-47 | SENSOR_MODE_MISMATCH | LTD_MAIN_CPU2/Application/Src/fault_recovery.c:82 LTD_MAIN_CPU2/Services/Sensor/SafeProtocol/sensor_safe_legacy_adapter.c:63 | 具体故障码沿返回链保留，最终由业务流程或统一故障管理置错 | 传感器模式不一致 | 传感器返回的测量模式与请求不一致 | 传感器测量模式不一致 | 模式重新一致后可恢复 | 来源、名称、原因和CPU3显示均已覆盖 | 故障注入13-47，核对屏幕编号、日志原因、停机和恢复口径 | 一代无直接同义编号；按二代责任域独立编号
13-48 | SENSOR_MODE_NOT_ALLOWED | LTD_MAIN_CPU2/Application/Src/fault_recovery.c:83 LTD_MAIN_CPU2/Services/Sensor/SafeProtocol/sensor_safe_legacy_adapter.c:94 | 具体故障码沿返回链保留，最终由业务流程或统一故障管理置错 | 传感器模式不允许 | 传感器当前状态不允许执行本次操作 | 传感器当前模式不允许 | 确定性操作顺序故障，不自动重跑 | 来源、名称、原因和CPU3显示均已覆盖 | 故障注入13-48，核对屏幕编号、日志原因、停机和恢复口径 | 一代无直接同义编号；按二代责任域独立编号
13-49 | SENSOR_TRANSACTION_PENDING | LTD_MAIN_CPU2/Services/Sensor/SafeProtocol/sensor_safe_legacy_adapter.c:65 | 具体故障码沿返回链保留，最终由业务流程或统一故障管理置错 | 传感器通信未完成 | 上一笔传感器通信事务尚未完成 | 传感器通信尚未完成 | 等待事务完成后可重试 | 来源、名称、原因和CPU3显示均已覆盖 | 故障注入13-49，核对屏幕编号、日志原因、停机和恢复口径 | 一代无直接同义编号；按二代责任域独立编号
13-50 | SENSOR_DEVICE_BUSY | LTD_MAIN_CPU2/Services/Sensor/SafeProtocol/sensor_safe_legacy_adapter.c:96 | 具体故障码沿返回链保留，最终由业务流程或统一故障管理置错 | 传感器设备忙 | 传感器正在处理其它任务 | 传感器设备忙 | 设备空闲后可重试 | 来源、名称、原因和CPU3显示均已覆盖 | 故障注入13-50，核对屏幕编号、日志原因、停机和恢复口径 | 一代无直接同义编号；按二代责任域独立编号
13-51 | SENSOR_PARAM_CRC_ERROR | LTD_MAIN_CPU2/Services/Sensor/SafeProtocol/sensor_safe_legacy_adapter.c:51 LTD_MAIN_CPU2/Services/Sensor/SafeProtocol/sensor_safe_legacy_adapter.c:104 LTD_MAIN_CPU2/Services/Sensor/SafeProtocol/sensor_safe_legacy_adapter.c:402 | 具体故障码沿返回链保留，最终由业务流程或统一故障管理置错 | 传感器参数校验失败 | 传感器参数内容校验失败 | 传感器参数校验失败 | 重新读取到完整参数后恢复 | 来源、名称、原因和CPU3显示均已覆盖 | 故障注入13-51，核对屏幕编号、日志原因、停机和恢复口径 | 一代无直接同义编号；按二代责任域独立编号
13-52 | SENSOR_SAMPLE_COUNTER_ERROR | LTD_MAIN_CPU2/Services/Sensor/SafeProtocol/sensor_safe_legacy_adapter.c:55 | 具体故障码沿返回链保留，最终由业务流程或统一故障管理置错 | 传感器采样计数异常 | 传感器采样计数停滞或跳变异常 | 传感器采样计数异常 | 取得连续的新采样后恢复 | 来源、名称、原因和CPU3显示均已覆盖 | 故障注入13-52，核对屏幕编号、日志原因、停机和恢复口径 | 一代无直接同义编号；按二代责任域独立编号
13-53 | SENSOR_STREAM_STOPPED | LTD_MAIN_CPU2/Services/Sensor/SafeProtocol/sensor_safe_legacy_adapter.c:59 | 具体故障码沿返回链保留，最终由业务流程或统一故障管理置错 | 传感器周期上报停止 | 传感器周期上报意外停止 | 传感器周期上报已停止 | 重新启动周期上报后恢复 | 来源、名称、原因和CPU3显示均已覆盖 | 故障注入13-53，核对屏幕编号、日志原因、停机和恢复口径 | 一代无直接同义编号；按二代责任域独立编号
13-54 | SENSOR_STREAM_NOT_ACTIVE | LTD_MAIN_CPU2/Services/Sensor/SafeProtocol/sensor_safe_legacy_adapter.c:112 | 具体故障码沿返回链保留，最终由业务流程或统一故障管理置错 | 传感器周期上报未启动 | 传感器周期上报尚未启动 | 传感器周期上报未启动 | 启动周期上报后恢复 | 来源、名称、原因和CPU3显示均已覆盖 | 故障注入13-54，核对屏幕编号、日志原因、停机和恢复口径 | 一代无直接同义编号；按二代责任域独立编号
13-55 | SENSOR_STREAM_ALREADY_ACTIVE | LTD_MAIN_CPU2/Services/Sensor/SafeProtocol/sensor_safe_legacy_adapter.c:114 | 具体故障码沿返回链保留，最终由业务流程或统一故障管理置错 | 传感器周期上报已启动 | 传感器周期上报已在运行 | 传感器周期上报已启动 | 确认现有上报状态或重启上报后恢复 | 来源、名称、原因和CPU3显示均已覆盖 | 故障注入13-55，核对屏幕编号、日志原因、停机和恢复口径 | 一代无直接同义编号；按二代责任域独立编号
13-56 | SENSOR_STREAM_EXIT_FAILED | LTD_MAIN_CPU2/Services/Sensor/SafeProtocol/sensor_safe_legacy_adapter.c:116 | 具体故障码沿返回链保留，最终由业务流程或统一故障管理置错 | 传感器周期上报退出失败 | 传感器周期上报退出失败 | 传感器周期上报退出失败 | 成功退出并重新建立状态后恢复 | 来源、名称、原因和CPU3显示均已覆盖 | 故障注入13-56，核对屏幕编号、日志原因、停机和恢复口径 | 一代无直接同义编号；按二代责任域独立编号
14-9 | MEASUREMENT_ZERO_OUT_OF_RANGE | LTD_MAIN_CPU2/Application/Src/measure_zero.c:127 LTD_MAIN_CPU2/Application/Src/measure_zero.c:221 LTD_MAIN_CPU2/Application/Src/measure_zero.c:352 | 具体故障码沿返回链保留，最终由业务流程或统一故障管理置错 | 零点超限 | 零点超限 | 零点超限 | 按现有命令白名单和故障恢复边界处理 | 来源、名称、原因和CPU3显示均已覆盖 | 台架核对编号、日志、停机和恢复行为 | 4-9 越过零点位置XXmm报错（1.117以上版本）
14-11 | MEASUREMENT_ZERO_REPEAT_FAIL | LTD_MAIN_CPU2/Application/Src/measure_tank_height.c:726 LTD_MAIN_CPU2/Application/Src/measure_tank_height.c:861 | 具体故障码沿返回链保留，最终由业务流程或统一故障管理置错 | 零点重复性差 | 校验失败 | 零点重复性差 | 按现有命令白名单和故障恢复边界处理 | 来源、名称、原因和CPU3显示均已覆盖 | 台架核对编号、日志、停机和恢复行为 | 一代无直接同义编号；按二代责任域独立编号
14-12 | POSITION_DATA_INVALID | LTD_MAIN_CPU2/Services/MotorControl/motor_ctrl_motion_api.c:697 LTD_MAIN_CPU2/Services/MotorControl/motor_ctrl_motion_api.c:1833 LTD_MAIN_CPU2/Services/MotorControl/motor_ctrl_motion_api.c:1875 LTD_MAIN_CPU2/Services/MotorControl/motor_ctrl_motion_api.c:1978 | 具体故障码沿返回链保留，最终由业务流程或统一故障管理置错 | 位置数据无效 | 当前位置数据无效 | 位置数据无效 | 按现有命令白名单和故障恢复边界处理 | 来源、名称、原因和CPU3显示均已覆盖 | 台架核对编号、日志、停机和恢复行为 | 2-10 固定点检测时编码值发生变化；4-9 越过零点位置XXmm报错（1.117以上版本）
14-13 | POSITION_TARGET_OVERRUN | LTD_MAIN_CPU2/Services/MotorControl/motor_ctrl_motion_api.c:1984 | 具体故障码沿返回链保留，最终由业务流程或统一故障管理置错 | 运动越过目标 | 运动越过目标位置 | 运动位置超过设定 | 按现有命令白名单和故障恢复边界处理 | 来源、名称、原因和CPU3显示均已覆盖 | 台架核对编号、日志、停机和恢复行为 | 4-9 越过零点位置XXmm报错（1.117以上版本）
14-14 | POSITION_ARRIVAL_DEVIATION | LTD_MAIN_CPU2/Application/Src/wartsila_density_measurement.c:174 LTD_MAIN_CPU2/Services/MotorControl/motor_ctrl_motion_api.c:2237 | 具体故障码沿返回链保留，最终由业务流程或统一故障管理置错 | 到位偏差过大 | 停止后实际位置与目标偏差过大 | 到位偏差过大 | 按现有命令白名单和故障恢复边界处理 | 来源、名称、原因和CPU3显示均已覆盖 | 台架核对编号、日志、停机和恢复行为 | 5-12 电机步进数和实际运行数差距大，拟合数据不正确；
14-15 | POSITION_MOTOR_NOT_STOPPED | LTD_MAIN_CPU2/Application/Src/measure_density.c:966 | 具体故障码沿返回链保留，最终由业务流程或统一故障管理置错 | 电机未停止 | 提交测量结果时电机仍未停止 | 电机未停止 | 按现有命令白名单和故障恢复边界处理 | 来源、名称、原因和CPU3显示均已覆盖 | 台架核对编号、日志、停机和恢复行为 | 1-10 输入步进数错误； 下位位置高于当前位置 限制上行时步进数超过零点
15-6 | MEASUREMENT_OILLEVEL_HIGH | LTD_MAIN_CPU2/Application/Src/measure_oilLevel.c:1927 LTD_MAIN_CPU2/Application/Src/measure_oilLevel.c:1950 | 具体故障码沿返回链保留，最终由业务流程或统一故障管理置错 | 液位超过罐高 | 液位测量结果超过罐高 | 液位超过罐高 | 按现有命令白名单和故障恢复边界处理 | 来源、名称、原因和CPU3显示均已覆盖 | 台架核对编号、日志、停机和恢复行为 | 5-6 1.区间测量参数设置最高点高于罐高。 2.分布测量或每米测量液位高度高于罐高
15-15 | MEASUREMENT_OVERSPEED | LTD_MAIN_CPU2/Application/Src/measure_oilLevel.c:1874 | 具体故障码沿返回链保留，最终由业务流程或统一故障管理置错 | 液位变化过快 | 液位变化过快 | 液位变化过快 | 按现有命令白名单和故障恢复边界处理 | 来源、名称、原因和CPU3显示均已覆盖 | 台架核对编号、日志、停机和恢复行为 | 5-15 液位变化超过最大跟随速度
15-16 | MEASUREMENT_HEIGHT_DEVIATION | 无主动调用 | 具体故障码沿返回链保留，最终由业务流程或统一故障管理置错 | 实高偏差过大 | 校验失败 | 实高偏差过大 | 按现有命令白名单和故障恢复边界处理 | 来源、名称、原因和CPU3显示均已覆盖 | 台架核对编号、日志、停机和恢复行为 | 5-16 罐高与标定时相差过大
15-17 | MEASUREMENT_DENSITY_LEVEL_TIMEOUT | LTD_MAIN_CPU2/Application/Src/measure_oilLevel.c:597 | 具体故障码沿返回链保留，最终由业务流程或统一故障管理置错 | 密度找液位超时 | 密度闭环找液位超时 | 密度找液位超时 | 按现有命令白名单和故障恢复边界处理 | 来源、名称、原因和CPU3显示均已覆盖 | 台架核对编号、日志、停机和恢复行为 | 一代无直接同义编号；按二代责任域独立编号
15-18 | MEASUREMENT_OILLEVEL_LOW | LTD_MAIN_CPU2/Application/Src/measure_oilLevel.c:954 LTD_MAIN_CPU2/Application/Src/measure_oilLevel.c:1471 LTD_MAIN_CPU2/Application/Src/measure_oilLevel.c:1497 LTD_MAIN_CPU2/Application/Src/measure_oilLevel.c:1549 LTD_MAIN_CPU2/Application/Src/measure_oilLevel.c:1797 LTD_MAIN_CPU2/Application/Src/measure_oilLevel.c:1933 LTD_MAIN_CPU2/Application/Src/measure_oilLevel.c:1949 LTD_MAIN_CPU2/Application/Src/wartsila_density_measurement.c:375 | 具体故障码沿返回链保留，最终由业务流程或统一故障管理置错 | 下行未找到液位 | 下行测量未找到液位 | 下行未找到液位 | 按现有命令白名单和故障恢复边界处理 | 来源、名称、原因和CPU3显示均已覆盖 | 台架核对编号、日志、停机和恢复行为 | 6-4 油位太低；下行到盲区未检测到油。
15-19 | MEASUREMENT_OILLEVEL_NOTFOUND | LTD_MAIN_CPU2/Application/Src/measure_density.c:963 LTD_MAIN_CPU2/Application/Src/measure_oilLevel.c:1154 LTD_MAIN_CPU2/Application/Src/measure_oilLevel.c:1201 | 具体故障码沿返回链保留，最终由业务流程或统一故障管理置错 | 上行未找到液位 | 上行测量未找到液位 | 上行未找到液位 | 按现有命令白名单和故障恢复边界处理 | 来源、名称、原因和CPU3显示均已覆盖 | 台架核对编号、日志、停机和恢复行为 | 6-5 运行到零点位置未找到液位；
15-20 | MEASUREMENT_WEIGHT_DOWN_FAIL | LTD_MAIN_CPU2/Application/Src/measure_oilLevel.c:1354 LTD_MAIN_CPU2/Application/Src/measure_tank_height.c:85 LTD_MAIN_CPU2/Application/Src/measure_tank_height.c:544 LTD_MAIN_CPU2/Application/Src/measure_tank_height.c:642 | 具体故障码沿返回链保留，最终由业务流程或统一故障管理置错 | 下行寻重失败 | 下行寻重失败 | 下行寻重失败 | 按现有命令白名单和故障恢复边界处理 | 来源、名称、原因和CPU3显示均已覆盖 | 台架核对编号、日志、停机和恢复行为 | 4-4 测量罐底，下行到达罐高+最大下行位置；
15-21 | MEASUREMENT_WEIGHT_UP_FAIL | LTD_MAIN_CPU2/Application/Src/measure_zero.c:338 | 具体故障码沿返回链保留，最终由业务流程或统一故障管理置错 | 上行寻重失败 | 上行寻重失败 | 上行寻重失败 | 按现有命令白名单和故障恢复边界处理 | 来源、名称、原因和CPU3显示均已覆盖 | 台架核对编号、日志、停机和恢复行为 | 4-3 测量罐底时上行细找找到零点位置；
15-22 | MEASUREMENT_WATERLEVEL_LOW | LTD_MAIN_CPU2/Application/Src/measure_waterLevel.c:273 LTD_MAIN_CPU2/Application/Src/measure_waterLevel.c:333 LTD_MAIN_CPU2/Application/Src/measure_waterLevel.c:578 LTD_MAIN_CPU2/Application/Src/measure_waterLevel.c:613 LTD_MAIN_CPU2/Application/Src/measure_waterLevel.c:660 LTD_MAIN_CPU2/Application/Src/measure_waterLevel.c:863 | 具体故障码沿返回链保留，最终由业务流程或统一故障管理置错 | 下行未找到水位 | 下行测量未找到水位 | 下行未找到水位 | 按现有命令白名单和故障恢复边界处理 | 来源、名称、原因和CPU3显示均已覆盖 | 台架核对编号、日志、停机和恢复行为 | 6-3 1.找水位时上行到了零点；
15-23 | MEASUREMENT_DENSITY_NO_VALID_POINT | LTD_MAIN_CPU2/Application/Src/measure_density.c:352 LTD_MAIN_CPU2/Application/Src/measure_density.c:959 LTD_MAIN_CPU2/Application/Src/measure_density.c:1490 LTD_MAIN_CPU2/Application/Src/wartsila_density_measurement.c:456 LTD_MAIN_CPU2/Application/Src/wartsila_density_measurement.c:586 | 具体故障码沿返回链保留，最终由业务流程或统一故障管理置错 | 密度测量无有效点 | 密度分布测量无有效测点 | 密度测量无有效点 | 按现有命令白名单和故障恢复边界处理 | 来源、名称、原因和CPU3显示均已覆盖 | 台架核对编号、日志、停机和恢复行为 | 一代无直接同义编号；按二代责任域独立编号
15-24 | MEASUREMENT_DENSITY_SURFACE_NOTFOUND | LTD_MAIN_CPU2/Application/Src/wartsila_density_measurement.c:581 | 具体故障码沿返回链保留，最终由业务流程或统一故障管理置错 | 密度测量未找到油面 | 密度分布测量未找到油面 | 密度测量未找到油面 | 按现有命令白名单和故障恢复边界处理 | 来源、名称、原因和CPU3显示均已覆盖 | 台架核对编号、日志、停机和恢复行为 | 一代无直接同义编号；按二代责任域独立编号
15-25 | MEASUREMENT_FREQUENCY_LEVEL_TIMEOUT | LTD_MAIN_CPU2/Application/Src/measure_oilLevel.c:979 | 具体故障码沿返回链保留，最终由业务流程或统一故障管理置错 | 频率找液位超时 | 频率闭环找液位超时 | 频率找液位超时 | 按现有命令白名单和故障恢复边界处理 | 来源、名称、原因和CPU3显示均已覆盖 | 台架核对编号、日志、停机和恢复行为 | 一代无直接同义编号；按二代责任域独立编号
15-26 | MEASUREMENT_BOTTOM_RELEASE_FAIL | LTD_MAIN_CPU2/Application/Src/measure_tank_height.c:591 | 具体故障码沿返回链保留，最终由业务流程或统一故障管理置错 | 探底前离底失败 | 粗找罐底前上行后仍处于触底状态 | 探底前离底失败 | 按现有命令白名单和故障恢复边界处理 | 来源、名称、原因和CPU3显示均已覆盖 | 台架核对编号、日志、停机和恢复行为 | 4-3 测量罐底时上行细找找到零点位置；
15-27 | MEASUREMENT_TANK_HEIGHT_NOT_CONFIGURED | LTD_MAIN_CPU2/Application/Src/fault_recovery.c:91 LTD_MAIN_CPU2/Application/Src/measure.c:41 | 具体故障码沿返回链保留，最终由业务流程或统一故障管理置错 | 未设置罐高标定值 | 罐高标定值未设置 | 未设置罐高标定值 | 确定性配置故障，不自动重跑 | 来源、名称、原因和CPU3显示均已覆盖 | 故障注入15-28，核对屏幕编号、日志原因、停机和恢复口径 | 一代无直接同义编号；按二代责任域独立编号
15-28 | MEASUREMENT_WATER_CALIBRATION_NOT_CONFIGURED | LTD_MAIN_CPU2/Application/Src/fault_recovery.c:92 LTD_MAIN_CPU2/Application/Src/measure_waterLevel.c:1365 | 具体故障码沿返回链保留，最终由业务流程或统一故障管理置错 | 未设置水位标定值 | 水位标定值未设置 | 未设置水位标定值 | 确定性配置故障，不自动重跑 | 来源、名称、原因和CPU3显示均已覆盖 | 故障注入15-29，核对屏幕编号、日志原因、停机和恢复口径 | 一代无直接同义编号；按二代责任域独立编号
15-29 | MEASUREMENT_DENSITY_PLAN_INVALID | LTD_MAIN_CPU2/Application/Src/fault_recovery.c:95 LTD_MAIN_CPU2/Application/Src/measure_density.c:290 LTD_MAIN_CPU2/Application/Src/measure_density.c:411 LTD_MAIN_CPU2/Application/Src/measure_density.c:413 LTD_MAIN_CPU2/Application/Src/measure_density.c:629 LTD_MAIN_CPU2/Application/Src/measure_density.c:665 LTD_MAIN_CPU2/Application/Src/measure_density.c:700 LTD_MAIN_CPU2/Application/Src/measure_density.c:704 | 具体故障码沿返回链保留，最终由业务流程或统一故障管理置错 | 密度测点规划失败 | 密度测点范围、步距或数量无法形成有效计划 | 密度测点设置失败 | 确定性配置、边界或硬件故障，不自动重跑 | 来源、名称、原因和CPU3显示均已覆盖 | 台架核对编号、日志、停机和恢复行为 | 5-4 1.进行单点监测或单点测量时，输入的检测位置小于盲区位置或高于罐高。 2.区间测量输入液位区间错误；5-5 密度分布测量或标定液位时，液位值过低； 2.区间测量参数设置最低点要＞（盲区+300）；否侧报错；5-6 1.区间测量参数设置最高点高于罐高。 2.分布测量或每米测量液位高度高于罐高；5-7 密度分布测量点数超过100（加测点过多）
15-30 | MEASUREMENT_TANK_HEIGHT_RESULT_INVALID | LTD_MAIN_CPU2/Application/Src/fault_recovery.c:93 LTD_MAIN_CPU2/Application/Src/measure.c:53 | 具体故障码沿返回链保留，最终由业务流程或统一故障管理置错 | 罐高测量结果无效 | 罐高测量未得到有效实高 | 罐高测量结果无效 | 确定性结果故障，不自动重跑 | 来源、名称、原因和CPU3显示均已覆盖 | 故障注入15-32，核对屏幕编号、日志原因、停机和恢复口径 | 一代无直接同义编号；按二代责任域独立编号
15-31 | MEASUREMENT_WATER_CALC_OUT_OF_RANGE | LTD_MAIN_CPU2/Application/Src/fault_recovery.c:94 LTD_MAIN_CPU2/Application/Src/measure_waterLevel.c:1334 | 具体故障码沿返回链保留，最终由业务流程或统一故障管理置错 | 水位标定计算超限 | 水位标定计算结果超出允许范围 | 水位标定计算超限 | 确定性计算边界故障，不自动重跑 | 来源、名称、原因和CPU3显示均已覆盖 | 故障注入15-33，核对屏幕编号、日志原因、停机和恢复口径 | 一代无直接同义编号；按二代责任域独立编号
17-1 | PARAM_EEPROM_FAIL | LTD_MAIN_CPU2/Services/ParamStorage/system_parameter.c:702 LTD_MAIN_CPU2/Services/ParamStorage/system_parameter.c:979 | 具体故障码沿返回链保留，最终由业务流程或统一故障管理置错 | 参数存储读写失败 | 参数存储分区异常 | 参数存储读写失败 | 参数存储故障，不自动重跑测量 | 来源、名称、原因和CPU3显示均已覆盖 | 故障注入17-1，核对屏幕编号、日志原因、停机和恢复口径 | 7-1 主控板中存储器的参数异常
17-2 | PARAM_UNINITIALIZED | LTD_MAIN_CPU2/Application/Src/test.c:2237 LTD_MAIN_CPU2/Application/Src/test.c:2238 LTD_MAIN_CPU2/Services/ParamStorage/system_parameter.c:699 | 具体故障码沿返回链保留，最终由业务流程或统一故障管理置错 | 参数未初始化 | 参数未初始化 | 参数未初始化 | 按现有命令白名单和故障恢复边界处理 | 来源、名称、原因和CPU3显示均已覆盖 | 台架核对编号、日志、停机和恢复行为 | 7-2 没有存储置零点时的角度值。
17-5 | PARAM_RANGE_ERROR | LTD_MAIN_CPU2/Application/Src/fault_recovery.c:84 LTD_MAIN_CPU2/Application/Src/measure.c:1118 LTD_MAIN_CPU2/Application/Src/measure_density.c:30 LTD_MAIN_CPU2/Application/Src/measure_density.c:150 LTD_MAIN_CPU2/Application/Src/measure_density.c:151 LTD_MAIN_CPU2/Application/Src/measure_density.c:156 LTD_MAIN_CPU2/Application/Src/measure_density.c:157 LTD_MAIN_CPU2/Application/Src/measure_oilLevel.c:641 | 具体故障码沿返回链保留，最终由业务流程或统一故障管理置错 | 参数值超出范围 | 参数超限 | 参数值超出范围 | 确定性配置、边界或硬件故障，不自动重跑 | 来源、名称、原因和CPU3显示均已覆盖 | 台架核对编号、日志、停机和恢复行为 | 5-4 1.进行单点监测或单点测量时，输入的检测位置小于盲区位置或高于罐高。 2.区间测量输入液位区间错误；5-5 密度分布测量或标定液位时，液位值过低； 2.区间测量参数设置最低点要＞（盲区+300）；否侧报错；5-6 1.区间测量参数设置最高点高于罐高。 2.分布测量或每米测量液位高度高于罐高；5-7 密度分布测量点数超过100（加测点过多）
17-6 | PARAM_CRC_ERROR | LTD_MAIN_CPU2/Services/ParamStorage/system_parameter.c:684 | 具体故障码沿返回链保留，最终由业务流程或统一故障管理置错 | 参数完整性校验失败 | CRC不匹配 | 参数完整性校验失败 | 按现有命令白名单和故障恢复边界处理 | 来源、名称、原因和CPU3显示均已覆盖 | 台架核对编号、日志、停机和恢复行为 | 一代无直接同义编号；按二代责任域独立编号
17-7 | PARAM_CONFIG_MISSING | LTD_MAIN_CPU2/Application/Src/fault_recovery.c:85 LTD_MAIN_CPU2/Application/Src/measure.c:1116 LTD_MAIN_CPU2/Application/Src/measure_density.c:138 LTD_MAIN_CPU2/Application/Src/measure_density.c:139 LTD_MAIN_CPU2/Application/Src/measure_oilLevel.c:474 LTD_MAIN_CPU2/Application/Src/measure_oilLevel.c:636 LTD_MAIN_CPU2/Application/Src/measure_oilLevel.c:854 LTD_MAIN_CPU2/Application/Src/test.c:325 | 具体故障码沿返回链保留，最终由业务流程或统一故障管理置错 | 必需配置缺失 | 执行当前功能所需配置缺失 | 基础配置未设置 | 确定性配置、边界或硬件故障，不自动重跑 | 来源、名称、原因和CPU3显示均已覆盖 | 台架核对编号、日志、停机和恢复行为 | 7-1 主控板中存储器的参数异常；；7-2 没有存储置零点时的角度值。
17-8 | PARAM_COMBINATION_CONFLICT | LTD_MAIN_CPU2/Application/Src/fault_recovery.c:86 LTD_MAIN_CPU2/Application/Src/measure.c:1117 LTD_MAIN_CPU2/Application/Src/measure_density.c:144 LTD_MAIN_CPU2/Application/Src/measure_density.c:145 | 具体故障码沿返回链保留，最终由业务流程或统一故障管理置错 | 参数组合冲突 | 多个参数组合互相冲突 | 参数组合错误 | 确定性配置、边界或硬件故障，不自动重跑 | 来源、名称、原因和CPU3显示均已覆盖 | 台架核对编号、日志、停机和恢复行为 | 5-4 1.进行单点监测或单点测量时，输入的检测位置小于盲区位置或高于罐高。 2.区间测量输入液位区间错误；5-5 密度分布测量或标定液位时，液位值过低； 2.区间测量参数设置最低点要＞（盲区+300）；否侧报错；5-6 1.区间测量参数设置最高点高于罐高。 2.分布测量或每米测量液位高度高于罐高；5-7 密度分布测量点数超过100（加测点过多）
17-9 | PARAM_FEATURE_UNSUPPORTED | LTD_MAIN_CPU2/Application/Src/fault_recovery.c:87 LTD_MAIN_CPU2/Application/Src/measure_oilLevel.c:1135 LTD_MAIN_CPU2/Application/Src/measure_oilLevel.c:1436 LTD_MAIN_CPU2/Services/Sensor/sensor.c:782 LTD_MAIN_CPU2/Services/Sensor/sensor.c:802 | 具体故障码沿返回链保留，最终由业务流程或统一故障管理置错 | 功能不支持 | 当前传感器、方法或模式不支持所选功能 | 功能无法使用 | 确定性配置、边界或硬件故障，不自动重跑 | 来源、名称、原因和CPU3显示均已覆盖 | 台架核对编号、日志、停机和恢复行为 | 一代无直接同义编号；按二代责任域独立编号
17-10 | PARAM_STORAGE_SIZE_MISMATCH | LTD_MAIN_CPU2/Application/Src/fault_recovery.c:88 LTD_MAIN_CPU2/Services/ParamStorage/system_parameter.c:689 | 具体故障码沿返回链保留，最终由业务流程或统一故障管理置错 | 参数存储结构不匹配 | 参数存储结构大小与当前程序不一致 | 参数存储结构不匹配 | 确定性兼容故障，不自动重跑 | 来源、名称、原因和CPU3显示均已覆盖 | 故障注入17-10，核对屏幕编号、日志原因、停机和恢复口径 | 7-1 主控板中存储器的参数异常
17-11 | PARAM_STORAGE_VERSION_MISMATCH | LTD_MAIN_CPU2/Application/Src/fault_recovery.c:89 LTD_MAIN_CPU2/Services/ParamStorage/system_parameter.c:694 | 具体故障码沿返回链保留，最终由业务流程或统一故障管理置错 | 参数存储版本不匹配 | 参数存储版本与当前程序不一致 | 参数存储版本不匹配 | 确定性版本故障，不自动重跑 | 来源、名称、原因和CPU3显示均已覆盖 | 故障注入17-11，核对屏幕编号、日志原因、停机和恢复口径 | 7-1 主控板中存储器的参数异常
17-12 | PARAM_STORAGE_WRITE_VERIFY_FAILED | LTD_MAIN_CPU2/Application/Src/fault_recovery.c:90 LTD_MAIN_CPU2/Services/ParamStorage/system_parameter.c:844 LTD_MAIN_CPU2/Services/ParamStorage/system_parameter.c:847 LTD_MAIN_CPU2/Services/ParamStorage/system_parameter.c:850 LTD_MAIN_CPU2/Services/ParamStorage/system_parameter.c:856 | 具体故障码沿返回链保留，最终由业务流程或统一故障管理置错 | 参数存储写入校验失败 | 参数写入后读回内容不一致 | 参数存储写入校验失败 | 再次写入并读回一致后仅清除此故障 | 来源、名称、原因和CPU3显示均已覆盖 | 故障注入17-12，核对屏幕编号、日志原因、停机和恢复口径 | 7-1 主控板中存储器的参数异常
18-1 | WEIGHT_OUT_OF_RANGE | LTD_MAIN_CPU2/Services/Weight/weight.c:215 | 具体故障码沿返回链保留，最终由业务流程或统一故障管理置错 | 扭力超上限 | 扭力超限 | 扭力超上限 | 按现有命令白名单和故障恢复边界处理 | 来源、名称、原因和CPU3显示均已覆盖 | 台架核对编号、日志、停机和恢复行为 | 一代无直接同义编号；按二代责任域独立编号
18-2 | WEIGHT_UNDER_RANGE | LTD_MAIN_CPU2/Services/Weight/weight.c:212 | 具体故障码沿返回链保留，最终由业务流程或统一故障管理置错 | 扭力超下限 | 扭力超限 | 扭力超下限 | 按现有命令白名单和故障恢复边界处理 | 来源、名称、原因和CPU3显示均已覆盖 | 台架核对编号、日志、停机和恢复行为 | 一代无直接同义编号；按二代责任域独立编号
18-3 | WEIGHT_COLLISION_DETECTED | LTD_MAIN_CPU2/Services/Weight/weight.c:285 LTD_MAIN_CPU2/Services/Weight/weight.c:407 LTD_MAIN_CPU2/Services/Weight/weight.c:444 LTD_MAIN_CPU2/Services/Weight/weight.c:500 LTD_MAIN_CPU2/Services/Weight/weight.c:535 LTD_MAIN_CPU2/Services/Weight/weight.c:561 LTD_MAIN_CPU2/Services/Weight/weight.c:632 LTD_MAIN_CPU2/Services/Weight/weight.c:649 | 具体故障码沿返回链保留，最终由业务流程或统一故障管理置错 | 检测到碰撞 | 碰撞检测 | 检测到碰撞 | 按现有命令白名单和故障恢复边界处理 | 来源、名称、原因和CPU3显示均已覆盖 | 台架核对编号、日志、停机和恢复行为 | 一代无直接同义编号；按二代责任域独立编号
18-4 | WEIGHT_DRIFT_ERROR | LTD_MAIN_CPU2/Services/Weight/weight.c:187 | 具体故障码沿返回链保留，最终由业务流程或统一故障管理置错 | 扭力漂移异常 | 扭力漂移 | 扭力漂移异常 | 按现有命令白名单和故障恢复边界处理 | 来源、名称、原因和CPU3显示均已覆盖 | 台架核对编号、日志、停机和恢复行为 | 一代无直接同义编号；按二代责任域独立编号
18-5 | WEIGHT_SENSOR_SATURATION | 无主动调用 | 具体故障码沿返回链保留，最终由业务流程或统一故障管理置错 | 扭力传感器饱和 | 扭力传感器饱和 | 扭力传感器饱和 | 按现有命令白名单和故障恢复边界处理 | 来源、名称、原因和CPU3显示均已覆盖 | 台架核对编号、日志、停机和恢复行为 | 一代无直接同义编号；按二代责任域独立编号
18-6 | WEIGHT_COMM_TIMEOUT | LTD_MAIN_CPU2/Services/Weight/weight.c:61 LTD_MAIN_CPU2/Services/Weight/weight.c:148 LTD_MAIN_CPU2/Services/Weight/weight.c:149 | 具体故障码沿返回链保留，最终由业务流程或统一故障管理置错 | 扭力通信超时 | 扭力模块无响应 | 扭力通信超时 | 按现有命令白名单和故障恢复边界处理 | 来源、名称、原因和CPU3显示均已覆盖 | 台架核对编号、日志、停机和恢复行为 | 一代无直接同义编号；按二代责任域独立编号
20-1 | COMM_UART_TRANSFER_ERROR | LTD_MAIN_CPU2/Services/Sensor/ch9141_at.c:503 LTD_MAIN_CPU2/Services/Sensor/ch9141_at.c:693 LTD_MAIN_CPU2/Services/Sensor/ch9141_at.c:700 LTD_MAIN_CPU2/Services/Sensor/dsm_sensor_communication.c:148 LTD_MAIN_CPU2/Services/Sensor/dsm_sensor_communication.c:155 LTD_MAIN_CPU2/Services/Sensor/dsm_sensor_communication.c:181 LTD_MAIN_CPU2/Services/Sensor/dsm_sensor_communication.c:215 LTD_MAIN_CPU2/Services/Sensor/dsm_sensor_communication.c:377 | 具体故障码沿返回链保留，最终由业务流程或统一故障管理置错 | 串口传输异常 | 串口或DMA传输异常 | 通信传输异常 | 按现有命令白名单和故障恢复边界处理 | 来源、名称、原因和CPU3显示均已覆盖 | 台架核对编号、日志、停机和恢复行为 | 一代无直接同义编号；按二代责任域独立编号
20-2 | SLIPRING_COMM_FAIL | LTD_MAIN_CPU2/Services/Sensor/ch9141_at.c:497 | 具体故障码沿返回链保留，最终由业务流程或统一故障管理置错 | 滑环通信失败 | 滑环设备应答失败 | 滑环通信失败 | 按现有命令白名单和故障恢复边界处理 | 来源、名称、原因和CPU3显示均已覆盖 | 台架核对编号、日志、停机和恢复行为 | 一代无直接同义编号；按二代责任域独立编号
20-3 | SLIPRING_SIGNAL_WEAK | LTD_MAIN_CPU2/Services/Sensor/wireless_pairing.c:1947 | 具体故障码沿返回链保留，最终由业务流程或统一故障管理置错 | 滑环信号弱 | 滑环信号弱 | 滑环信号弱 | 按现有命令白名单和故障恢复边界处理 | 来源、名称、原因和CPU3显示均已覆盖 | 台架核对编号、日志、停机和恢复行为 | 一代无直接同义编号；按二代责任域独立编号
20-4 | WIRELESS_HOST_COMM_TIMEOUT | LTD_MAIN_CPU2/Services/Sensor/wireless_pairing.c:557 LTD_MAIN_CPU2/Services/Sensor/wireless_pairing.c:1612 LTD_MAIN_CPU2/Services/Sensor/wireless_pairing.h:62 | 具体故障码沿返回链保留，最终由业务流程或统一故障管理置错 | 蓝牙主机通信超时 | 蓝牙主机无响应 | 无线主机通信超时 | 按现有命令白名单和故障恢复边界处理 | 来源、名称、原因和CPU3显示均已覆盖 | 台架核对编号、日志、停机和恢复行为 | 一代无直接同义编号；按二代责任域独立编号
20-5 | WIRELESS_SLAVE_COMM_TIMEOUT | LTD_MAIN_CPU2/Services/Sensor/wireless_pairing.c:593 LTD_MAIN_CPU2/Services/Sensor/wireless_pairing.c:1618 LTD_MAIN_CPU2/Services/Sensor/wireless_pairing.h:62 | 具体故障码沿返回链保留，最终由业务流程或统一故障管理置错 | 蓝牙从机未连接 | 蓝牙从机未连接 | 无线从机未连接 | 按现有命令白名单和故障恢复边界处理 | 来源、名称、原因和CPU3显示均已覆盖 | 台架核对编号、日志、停机和恢复行为 | 一代无直接同义编号；按二代责任域独立编号
20-6 | WIRELESS_RESP_FORMAT_ERROR | LTD_MAIN_CPU2/Services/Sensor/wireless_pairing.c:640 LTD_MAIN_CPU2/Services/Sensor/wireless_pairing.c:655 LTD_MAIN_CPU2/Services/Sensor/wireless_pairing.c:1213 LTD_MAIN_CPU2/Services/Sensor/wireless_pairing.c:1591 LTD_MAIN_CPU2/Services/Sensor/wireless_pairing.c:1605 LTD_MAIN_CPU2/Services/Sensor/wireless_pairing.c:1634 LTD_MAIN_CPU2/Services/Sensor/wireless_pairing.c:1654 LTD_MAIN_CPU2/Services/Sensor/wireless_pairing.c:1755 | 具体故障码沿返回链保留，最终由业务流程或统一故障管理置错 | 无线响应格式异常 | 无线模块响应格式异常 | 无线响应格式异常 | 按现有命令白名单和故障恢复边界处理 | 来源、名称、原因和CPU3显示均已覆盖 | 台架核对编号、日志、停机和恢复行为 | 一代无直接同义编号；按二代责任域独立编号
20-8 | WIRELESS_SCAN_NO_DEVICE | LTD_MAIN_CPU2/Services/Sensor/wireless_pairing.c:1315 | 具体故障码沿返回链保留，最终由业务流程或统一故障管理置错 | 无线扫描无设备 | 无线扫描未发现任何候选设备 | 无线扫描无设备 | 按现有命令白名单和故障恢复边界处理 | 来源、名称、原因和CPU3显示均已覆盖 | 台架核对编号、日志、停机和恢复行为 | 一代无直接同义编号；按二代责任域独立编号
20-9 | WIRELESS_NAME_NOT_UNIQUE | LTD_MAIN_CPU2/Services/Sensor/wireless_pairing.c:1418 | 具体故障码沿返回链保留，最终由业务流程或统一故障管理置错 | 无线名称重复 | 扫描到两个及以上同名无线设备，无法确定连接目标 | 无线名称重复 | 按现有命令白名单和故障恢复边界处理 | 来源、名称、原因和CPU3显示均已覆盖 | 台架核对编号、日志、停机和恢复行为 | 一代无直接同义编号；按二代责任域独立编号
20-10 | WIRELESS_NAME_INVALID | LTD_MAIN_CPU2/Services/Sensor/wireless_pairing.c:1977 LTD_MAIN_CPU2/Services/Sensor/wireless_pairing.c:1978 | 具体故障码沿返回链保留，最终由业务流程或统一故障管理置错 | 无线名称无效 | 无线设备名称为空、过长或格式无效 | 无线名称无效 | 按现有命令白名单和故障恢复边界处理 | 来源、名称、原因和CPU3显示均已覆盖 | 台架核对编号、日志、停机和恢复行为 | 一代无直接同义编号；按二代责任域独立编号
20-11 | WIRELESS_NOT_HOST_MODE | LTD_MAIN_CPU2/Services/Sensor/wireless_pairing.c:1261 | 具体故障码沿返回链保留，最终由业务流程或统一故障管理置错 | 无线非主机模式 | 无线模块未处于主机模式 | 无线非主机模式 | 按现有命令白名单和故障恢复边界处理 | 来源、名称、原因和CPU3显示均已覆盖 | 台架核对编号、日志、停机和恢复行为 | 一代无直接同义编号；按二代责任域独立编号
20-12 | WIRELESS_NAME_NOT_FOUND | LTD_MAIN_CPU2/Services/Sensor/wireless_pairing.c:1425 | 具体故障码沿返回链保留，最终由业务流程或统一故障管理置错 | 无线名称未找到 | 扫描到候选无线设备，但没有找到指定名称 | 无线名称未找到 | 按现有命令白名单和故障恢复边界处理 | 来源、名称、原因和CPU3显示均已覆盖 | 台架核对编号、日志、停机和恢复行为 | 一代无直接同义编号；按二代责任域独立编号
21-2 | AD5421_INIT_ERROR | LTD_MAIN_CPU2/BSP/Peripherals/src/ad5421.c:587 LTD_MAIN_CPU2/BSP/Peripherals/src/ad5421.c:588 LTD_MAIN_CPU2/BSP/Peripherals/src/ad5421.c:591 LTD_MAIN_CPU2/BSP/Peripherals/src/ad5421.c:597 LTD_MAIN_CPU2/BSP/Peripherals/src/ad5421.c:601 LTD_MAIN_CPU2/BSP/Peripherals/src/ad5421.c:607 LTD_MAIN_CPU2/BSP/Peripherals/src/ad5421.c:611 LTD_MAIN_CPU2/BSP/Peripherals/src/ad5421.c:653 | 具体故障码沿返回链保留，最终由业务流程或统一故障管理置错 | 模拟输出初始化失败 | AD5421初始化失败且未取得更具体原因 | 模拟输出初始化失败 | 按现有命令白名单和故障恢复边界处理 | 来源、名称、原因和CPU3显示均已覆盖 | 台架核对编号、日志、停机和恢复行为 | 8-2 AD5421写控制寄存器失败；8-3 上电自检_电流芯片报警
21-6 | AD5421_READBACK_ERROR | LTD_MAIN_CPU2/BSP/Peripherals/src/ad5421.c:628 LTD_MAIN_CPU2/BSP/Peripherals/src/ad5421.c:629 LTD_MAIN_CPU2/BSP/Peripherals/src/ad5421.c:632 LTD_MAIN_CPU2/Services/AoOutput/ao_output.c:252 | 具体故障码沿返回链保留，最终由业务流程或统一故障管理置错 | 模拟输出控制回读不一致 | AD5421控制寄存器回读不一致 | 模拟输出控制回读不一致 | 按现有命令白名单和故障恢复边界处理 | 来源、名称、原因和CPU3显示均已覆盖 | 台架核对编号、日志、停机和恢复行为 | 8-6 输入电流对比异常
21-9 | AD5421_INTERNAL_COMM_ERROR | LTD_MAIN_CPU2/BSP/Peripherals/src/ad5421.c:202 LTD_MAIN_CPU2/Services/AoOutput/ao_output.c:253 LTD_MAIN_CPU2/Services/AoOutput/ao_output.c:791 | 具体故障码沿返回链保留，最终由业务流程或统一故障管理置错 | 模拟输出内部通信异常 | AD5421内部通信异常 | 模拟输出内部通信异常 | 按现有命令白名单和故障恢复边界处理 | 来源、名称、原因和CPU3显示均已覆盖 | 台架核对编号、日志、停机和恢复行为 | 8-3 上电自检_电流芯片报警
21-10 | AD5421_LOOP_CURRENT_HIGH | LTD_MAIN_CPU2/BSP/Peripherals/src/ad5421.c:208 LTD_MAIN_CPU2/Services/AoOutput/ao_output.c:254 LTD_MAIN_CPU2/Services/AoOutput/ao_output.c:792 | 具体故障码沿返回链保留，最终由业务流程或统一故障管理置错 | 模拟输出电流过高 | 模拟输出环路电流过高 | 模拟输出电流过高 | 按现有命令白名单和故障恢复边界处理 | 来源、名称、原因和CPU3显示均已覆盖 | 台架核对编号、日志、停机和恢复行为 | 8-3 上电自检_电流芯片报警；8-6 输入电流对比异常
21-11 | AD5421_LOOP_CURRENT_LOW | LTD_MAIN_CPU2/BSP/Peripherals/src/ad5421.c:211 LTD_MAIN_CPU2/Services/AoOutput/ao_output.c:255 LTD_MAIN_CPU2/Services/AoOutput/ao_output.c:793 | 具体故障码沿返回链保留，最终由业务流程或统一故障管理置错 | 模拟输出电流过低 | 模拟输出环路电流过低或断环 | 模拟输出电流过低 | 按现有命令白名单和故障恢复边界处理 | 来源、名称、原因和CPU3显示均已覆盖 | 台架核对编号、日志、停机和恢复行为 | 8-3 上电自检_电流芯片报警；8-6 输入电流对比异常
21-12 | AD5421_LOOP_VOLTAGE_LOW | LTD_MAIN_CPU2/BSP/Peripherals/src/ad5421.c:214 LTD_MAIN_CPU2/Services/AoOutput/ao_output.c:256 LTD_MAIN_CPU2/Services/AoOutput/ao_output.c:794 | 具体故障码沿返回链保留，最终由业务流程或统一故障管理置错 | 模拟输出环路电压低 | 模拟输出环路供电电压不足 | 模拟输出环路电压低 | 按现有命令白名单和故障恢复边界处理 | 来源、名称、原因和CPU3显示均已覆盖 | 台架核对编号、日志、停机和恢复行为 | 8-4 设备供电电压异常
21-13 | AD5421_SPI_TRANSFER_ERROR | LTD_MAIN_CPU2/BSP/Peripherals/src/ad5421.c:246 LTD_MAIN_CPU2/BSP/Peripherals/src/ad5421.c:247 LTD_MAIN_CPU2/BSP/Peripherals/src/ad5421.c:250 LTD_MAIN_CPU2/BSP/Peripherals/src/ad5421.c:294 LTD_MAIN_CPU2/BSP/Peripherals/src/ad5421.c:295 LTD_MAIN_CPU2/BSP/Peripherals/src/ad5421.c:298 LTD_MAIN_CPU2/BSP/Peripherals/src/ad5421.c:311 LTD_MAIN_CPU2/BSP/Peripherals/src/ad5421.c:312 | 具体故障码沿返回链保留，最终由业务流程或统一故障管理置错 | 模拟输出通信失败 | AD5421与主控之间SPI传输失败 | 模拟输出通信失败 | 按现有命令白名单和故障恢复边界处理 | 来源、名称、原因和CPU3显示均已覆盖 | 台架核对编号、日志、停机和恢复行为 | 一代无直接同义编号；按二代责任域独立编号
21-14 | AD5421_ACCESS_BUSY | LTD_MAIN_CPU2/BSP/Peripherals/src/ad5421.c:339 LTD_MAIN_CPU2/BSP/Peripherals/src/ad5421.c:340 LTD_MAIN_CPU2/BSP/Peripherals/src/ad5421.c:343 LTD_MAIN_CPU2/BSP/Peripherals/src/ad5421.c:378 LTD_MAIN_CPU2/BSP/Peripherals/src/ad5421.c:379 LTD_MAIN_CPU2/BSP/Peripherals/src/ad5421.c:382 LTD_MAIN_CPU2/Services/AoOutput/ao_output.c:258 | 具体故障码沿返回链保留，最终由业务流程或统一故障管理置错 | 模拟输出访问冲突 | AD5421访问冲突或前一操作未结束 | 模拟输出状态异常 | 按现有命令白名单和故障恢复边界处理 | 来源、名称、原因和CPU3显示均已覆盖 | 台架核对编号、日志、停机和恢复行为 | 一代无直接同义编号；按二代责任域独立编号
21-15 | AD5421_OVERTEMP_SHUTDOWN | LTD_MAIN_CPU2/BSP/Peripherals/src/ad5421.c:205 LTD_MAIN_CPU2/Services/AoOutput/ao_output.c:237 LTD_MAIN_CPU2/Services/AoOutput/ao_output.c:259 LTD_MAIN_CPU2/Services/AoOutput/ao_output.c:795 LTD_MAIN_CPU2/Services/AoOutput/ao_output.c:813 | 具体故障码沿返回链保留，最终由业务流程或统一故障管理置错 | 模拟输出过温关断 | AD5421过温并停止输出 | 模拟输出过温停止 | 按现有命令白名单和故障恢复边界处理 | 来源、名称、原因和CPU3显示均已覆盖 | 台架核对编号、日志、停机和恢复行为 | 8-8 芯片温度过高
21-16 | AD5421_OVERTEMP_WARNING | LTD_MAIN_CPU2/BSP/Peripherals/src/ad5421.c:217 LTD_MAIN_CPU2/Services/AoOutput/ao_output.c:238 LTD_MAIN_CPU2/Services/AoOutput/ao_output.c:260 LTD_MAIN_CPU2/Services/AoOutput/ao_output.c:796 LTD_MAIN_CPU2/Services/AoOutput/ao_output.c:814 | 具体故障码沿返回链保留，最终由业务流程或统一故障管理置错 | 模拟输出过温预警 | AD5421温度接近保护值 | 模拟输出过温预警 | 按现有命令白名单和故障恢复边界处理 | 来源、名称、原因和CPU3显示均已覆盖 | 台架核对编号、日志、停机和恢复行为 | 8-8 芯片温度过高
22-1 | SYSTEM_BUFFER_CAPACITY_ERROR | LTD_MAIN_CPU2/Application/Src/fault_recovery.c:96 LTD_MAIN_CPU2/Services/ParamStorage/system_parameter.c:793 LTD_MAIN_CPU2/Services/ParamStorage/system_parameter.c:925 LTD_MAIN_CPU2/Services/Sensor/SafeProtocol/sensor_safe_legacy_adapter.c:148 | 具体故障码沿返回链保留，最终由业务流程或统一故障管理置错 | 系统容量不足 | 内部缓冲区或存储分区容量不足 | 系统容量过小 | 确定性配置、边界或硬件故障，不自动重跑 | 来源、名称、原因和CPU3显示均已覆盖 | 台架核对编号、日志、停机和恢复行为 | 一代无直接同义编号；按二代责任域独立编号
22-2 | SYSTEM_CALL_CONDITION_ERROR | LTD_MAIN_CPU2/Application/Src/fault_recovery.c:97 LTD_MAIN_CPU2/Application/Src/measure_density.c:30 LTD_MAIN_CPU2/Application/Src/measure_density.c:288 LTD_MAIN_CPU2/Application/Src/measure_density.c:393 LTD_MAIN_CPU2/Application/Src/measure_density.c:617 LTD_MAIN_CPU2/Application/Src/measure_density.c:682 LTD_MAIN_CPU2/Application/Src/measure_density.c:757 LTD_MAIN_CPU2/Application/Src/measure_density.c:1145 | 具体故障码沿返回链保留，最终由业务流程或统一故障管理置错 | 系统调用条件异常 | 内部调用参数或前置条件异常 | 系统输入异常 | 确定性配置、边界或硬件故障，不自动重跑 | 来源、名称、原因和CPU3显示均已覆盖 | 台架核对编号、日志、停机和恢复行为 | 一代无直接同义编号；按二代责任域独立编号
22-3 | SYSTEM_CALCULATION_ERROR | LTD_MAIN_CPU2/Application/Src/fault_recovery.c:98 LTD_MAIN_CPU2/BSP/Peripherals/src/TMC5130.c:787 | 具体故障码沿返回链保留，最终由业务流程或统一故障管理置错 | 系统计算异常 | 内部计算无法得到有效结果 | 系统计算异常 | 确定性配置、边界或硬件故障，不自动重跑 | 来源、名称、原因和CPU3显示均已覆盖 | 台架核对编号、日志、停机和恢复行为 | 一代无直接同义编号；按二代责任域独立编号

Sheet: 第3.2日志清单
ID | 批次 | 故障码 | 源码位置 | 实际场景 | 当前日志 | 缺失上下文 | 建议日志 | 上下文风险 | 行为影响 | 治理结论 | 验证方法 | 状态
P1-001 | 第一批：AD5421/AO | 0x00160002 PARAM_ERROR | LTD_MAIN_CPU2/BSP/Peripherals/src/ad5421.c:AD5421_ReadRegCheckedRaw():176 | AD5421 内部寄存器读接口参数或输出指针非法 | 函数内未见 ErrorLog_* 或 printf | 参数名、输入/输出值、调用模块、失败前置条件 | 模块：调用模块；操作：参数校验；原因：配置或内部调用非法；字段：参数名、输入值、配置项、阶段 | PendSV/SPI/锁敏感；底层只保存快照，禁止直接打印，任务态延后输出 | 清单阶段无源码改动；后续实施必须保持返回值、重试、停机、恢复和状态机不变 | 内部诊断优先；暂不新增对外码 | 参数缺失、非法值和边界输入验证；核对最终错误出口 | 清单完成，待源码批次审批
P1-002 | 第一批：AD5421/AO | 0x00160002 PARAM_ERROR | LTD_MAIN_CPU2/BSP/Peripherals/src/ad5421.c:AD5421_ReadRegChecked():236 | AD5421 内部寄存器读接口参数或输出指针非法 | 函数内未见 ErrorLog_* 或 printf | 参数名、输入/输出值、调用模块、失败前置条件 | 模块：调用模块；操作：参数校验；原因：配置或内部调用非法；字段：参数名、输入值、配置项、阶段 | PendSV/SPI/锁敏感；底层只保存快照，禁止直接打印，任务态延后输出 | 清单阶段无源码改动；后续实施必须保持返回值、重试、停机、恢复和状态机不变 | 内部诊断优先；暂不新增对外码 | 参数缺失、非法值和边界输入验证；核对最终错误出口 | 清单完成，待源码批次审批
P1-003 | 第一批：AD5421/AO | 0x00160002 PARAM_ERROR | LTD_MAIN_CPU2/Services/AoOutput/ao_output.c:AoOutput_GetLevelRange():342 | AO 输出范围、目标选择或电流换算参数无效 | 函数内未见 ErrorLog_* 或 printf | 参数名、输入/输出值、调用模块、失败前置条件 | 模块：调用模块；操作：参数校验；原因：配置或内部调用非法；字段：参数名、输入值、配置项、阶段 | PendSV/SPI/锁敏感；底层只保存快照，禁止直接打印，任务态延后输出 | 清单阶段无源码改动；后续实施必须保持返回值、重试、停机、恢复和状态机不变 | 内部诊断优先；暂不新增对外码 | 参数缺失、非法值和边界输入验证；核对最终错误出口 | 清单完成，待源码批次审批
P1-004 | 第一批：AD5421/AO | 0x00160002 PARAM_ERROR | LTD_MAIN_CPU2/Services/AoOutput/ao_output.c:AoOutput_CalculateLevelCurrent():377 | AO 输出范围、目标选择或电流换算参数无效 | 函数内未见 ErrorLog_* 或 printf | 参数名、输入/输出值、调用模块、失败前置条件 | 模块：调用模块；操作：参数校验；原因：配置或内部调用非法；字段：参数名、输入值、配置项、阶段 | PendSV/SPI/锁敏感；底层只保存快照，禁止直接打印，任务态延后输出 | 清单阶段无源码改动；后续实施必须保持返回值、重试、停机、恢复和状态机不变 | 内部诊断优先；暂不新增对外码 | 参数缺失、非法值和边界输入验证；核对最终错误出口 | 清单完成，待源码批次审批
P1-005 | 第一批：AD5421/AO | 0x00160002 PARAM_ERROR | LTD_MAIN_CPU2/Services/AoOutput/ao_output.c:AoOutput_SelectTarget():477 | AO 输出范围、目标选择或电流换算参数无效 | 函数内未见 ErrorLog_* 或 printf | 参数名、输入/输出值、调用模块、失败前置条件 | 模块：调用模块；操作：参数校验；原因：配置或内部调用非法；字段：参数名、输入值、配置项、阶段 | PendSV/SPI/锁敏感；底层只保存快照，禁止直接打印，任务态延后输出 | 清单阶段无源码改动；后续实施必须保持返回值、重试、停机、恢复和状态机不变 | 内部诊断优先；暂不新增对外码 | 参数缺失、非法值和边界输入验证；核对最终错误出口 | 清单完成，待源码批次审批
P1-006 | 第一批：AD5421/AO | 0x00160003 OTHER_PERIPHERAL_CONFIG_ERROR | LTD_MAIN_CPU2/BSP/Peripherals/src/ad5421.c:AD5421_WriteRegRaw():157 | AD5421 SPI/锁/寄存器访问底层失败被归入外设配置兜底 | 函数内未见 ErrorLog_* 或 printf | 真实外设、操作阶段、SPI/UART/锁状态、底层返回值、配置项 | 模块：真实责任域；操作：外设启动/访问；原因：底层配置或通信失败；字段：外设、阶段、状态、返回值 | PendSV/SPI/锁敏感；底层只保存快照，禁止直接打印，任务态延后输出 | 清单阶段无源码改动；后续实施必须保持返回值、重试、停机、恢复和状态机不变 | AD5421责任域回收候选 | SPI/锁失败与fault位注入；核对任务态日志、错误码和AO恢复行为 | 清单完成，待源码批次审批
P1-007 | 第一批：AD5421/AO | 0x00160003 OTHER_PERIPHERAL_CONFIG_ERROR | LTD_MAIN_CPU2/BSP/Peripherals/src/ad5421.c:AD5421_ReadRegCheckedRaw():189,198 | AD5421 SPI/锁/寄存器访问底层失败被归入外设配置兜底 | 函数内未见 ErrorLog_* 或 printf | 真实外设、操作阶段、SPI/UART/锁状态、底层返回值、配置项 | 模块：真实责任域；操作：外设启动/访问；原因：底层配置或通信失败；字段：外设、阶段、状态、返回值 | PendSV/SPI/锁敏感；底层只保存快照，禁止直接打印，任务态延后输出 | 清单阶段无源码改动；后续实施必须保持返回值、重试、停机、恢复和状态机不变 | AD5421责任域回收候选 | SPI/锁失败与fault位注入；核对任务态日志、错误码和AO恢复行为 | 清单完成，待源码批次审批
P1-008 | 第一批：AD5421/AO | 0x00160003 OTHER_PERIPHERAL_CONFIG_ERROR | LTD_MAIN_CPU2/BSP/Peripherals/src/ad5421.c:AD5421_WriteReg():218 | AD5421 SPI/锁/寄存器访问底层失败被归入外设配置兜底 | 函数内未见 ErrorLog_* 或 printf | 真实外设、操作阶段、SPI/UART/锁状态、底层返回值、配置项 | 模块：真实责任域；操作：外设启动/访问；原因：底层配置或通信失败；字段：外设、阶段、状态、返回值 | PendSV/SPI/锁敏感；底层只保存快照，禁止直接打印，任务态延后输出 | 清单阶段无源码改动；后续实施必须保持返回值、重试、停机、恢复和状态机不变 | AD5421责任域回收候选 | SPI/锁失败与fault位注入；核对任务态日志、错误码和AO恢复行为 | 清单完成，待源码批次审批
P1-009 | 第一批：AD5421/AO | 0x00160003 OTHER_PERIPHERAL_CONFIG_ERROR | LTD_MAIN_CPU2/BSP/Peripherals/src/ad5421.c:AD5421_ReadRegChecked():241 | AD5421 SPI/锁/寄存器访问底层失败被归入外设配置兜底 | 函数内未见 ErrorLog_* 或 printf | 真实外设、操作阶段、SPI/UART/锁状态、底层返回值、配置项 | 模块：真实责任域；操作：外设启动/访问；原因：底层配置或通信失败；字段：外设、阶段、状态、返回值 | PendSV/SPI/锁敏感；底层只保存快照，禁止直接打印，任务态延后输出 | 清单阶段无源码改动；后续实施必须保持返回值、重试、停机、恢复和状态机不变 | AD5421责任域回收候选 | SPI/锁失败与fault位注入；核对任务态日志、错误码和AO恢复行为 | 清单完成，待源码批次审批
P1-010 | 第一批：AD5421/AO | 0x00120009 AD5421_READFAULT_ERROR | LTD_MAIN_CPU2/BSP/Peripherals/src/ad5421.c:AD5421_PollDiagnostics():340 | READFAULT 寄存器访问失败 | 函数内仅见 printf/调试输出，未见统一 ErrorLog_* | READFAULT 原值、SPI/锁返回、fault 位、诊断快照、访问阶段 | 模块：AO；操作：读取READFAULT；原因：访问失败或状态异常；字段：原值、fault位、底层返回 | PendSV/SPI/锁敏感；底层只保存快照，禁止直接打印，任务态延后输出 | 清单阶段无源码改动；后续实施必须保持返回值、重试、停机、恢复和状态机不变 | READFAULT通信失败拆分条件候选；先验证现有诊断快照 | SPI/锁失败与fault位注入；核对任务态日志、错误码和AO恢复行为 | 清单完成，待源码批次审批
P1-011 | 第一批：AD5421/AO | 0x00120009 AD5421_READFAULT_ERROR | LTD_MAIN_CPU2/BSP/Peripherals/src/ad5421.c:AD5421_PollDiagnostics():357 | READFAULT 读取成功但 fault 状态位异常 | 函数内仅见 printf/调试输出，未见统一 ErrorLog_* | READFAULT 原值、SPI/锁返回、fault 位、诊断快照、访问阶段 | 模块：AO；操作：解析READFAULT状态；原因：访问失败或状态异常；字段：原值、fault位、底层返回 | PendSV/SPI/锁敏感；底层只保存快照，禁止直接打印，任务态延后输出 | 清单阶段无源码改动；后续实施必须保持返回值、重试、停机、恢复和状态机不变 | fault状态异常拆分条件候选；先验证现有诊断快照 | SPI/锁失败与fault位注入；核对任务态日志、错误码和AO恢复行为 | 清单完成，待源码批次审批
P2-001 | 第二批：TMC 电机驱动 | 0x000B0002 MOTOR_TMC_COMM_ERROR | LTD_MAIN_CPU2/BSP/Peripherals/src/TMC5130.c:<global>():47 | TMC 寄存器访问宏的统一失败出口 | 函数内未见 ErrorLog_* 或 printf | 寄存器名/地址、读写方向、初始化或运行阶段、底层返回值、驱动状态 | 模块：电机；操作：TMC寄存器访问；原因：通信/状态失败；字段：寄存器、方向、阶段、返回值 | SPI和运动时序敏感；避免重复最终报错，不改变停机/恢复分类 | 清单阶段无源码改动；后续实施必须保持返回值、重试、停机、恢复和状态机不变 | 保持TMC恢复大类；先补寄存器/方向/阶段，不拆码 | TMC读/写/初始化失败注入；核对停机、重试、恢复和寄存器字段 | 清单完成，待源码批次审批
P2-002 | 第二批：TMC 电机驱动 | 0x000B0002 MOTOR_TMC_COMM_ERROR | LTD_MAIN_CPU2/BSP/Peripherals/src/TMC5130.c:stpr_stop():541 | TMC 寄存器读写、初始化、状态检查或运动等待失败 | 函数内未见 ErrorLog_* 或 printf | 寄存器名/地址、读写方向、初始化或运行阶段、底层返回值、驱动状态 | 模块：电机；操作：TMC寄存器访问；原因：通信/状态失败；字段：寄存器、方向、阶段、返回值 | SPI和运动时序敏感；避免重复最终报错，不改变停机/恢复分类 | 清单阶段无源码改动；后续实施必须保持返回值、重试、停机、恢复和状态机不变 | 保持TMC恢复大类；先补寄存器/方向/阶段，不拆码 | TMC读/写/初始化失败注入；核对停机、重试、恢复和寄存器字段 | 清单完成，待源码批次审批
P2-003 | 第二批：TMC 电机驱动 | 0x000B0002 MOTOR_TMC_COMM_ERROR | LTD_MAIN_CPU2/BSP/Peripherals/src/TMC5130.c:stpr_moveBy():581 | TMC 寄存器读写、初始化、状态检查或运动等待失败 | 函数内仅见 printf/调试输出，未见统一 ErrorLog_* | 寄存器名/地址、读写方向、初始化或运行阶段、底层返回值、驱动状态 | 模块：电机；操作：TMC寄存器访问；原因：通信/状态失败；字段：寄存器、方向、阶段、返回值 | SPI和运动时序敏感；避免重复最终报错，不改变停机/恢复分类 | 清单阶段无源码改动；后续实施必须保持返回值、重试、停机、恢复和状态机不变 | 保持TMC恢复大类；先补寄存器/方向/阶段，不拆码 | TMC读/写/初始化失败注入；核对停机、重试、恢复和寄存器字段 | 清单完成，待源码批次审批
P2-004 | 第二批：TMC 电机驱动 | 0x000B0002 MOTOR_TMC_COMM_ERROR | LTD_MAIN_CPU2/BSP/Peripherals/src/TMC5130.c:stpr_checkDriverStatus():651,666,679,744,751,776,795,808 | TMC 寄存器读写、初始化、状态检查或运动等待失败 | 函数内已有 ErrorLog_*；需确认是否覆盖本分支及关键字段 | 寄存器名/地址、读写方向、初始化或运行阶段、底层返回值、驱动状态 | 模块：电机；操作：TMC寄存器访问；原因：通信/状态失败；字段：寄存器、方向、阶段、返回值 | SPI和运动时序敏感；避免重复最终报错，不改变停机/恢复分类 | 清单阶段无源码改动；后续实施必须保持返回值、重试、停机、恢复和状态机不变 | 保持TMC恢复大类；先补寄存器/方向/阶段，不拆码 | TMC读/写/初始化失败注入；核对停机、重试、恢复和寄存器字段 | 清单完成，待源码批次审批
P2-005 | 第二批：TMC 电机驱动 | 0x000B0002 MOTOR_TMC_COMM_ERROR | LTD_MAIN_CPU2/BSP/Peripherals/src/TMC5130.c:stpr_checkDriverPowerReady():838 | TMC 寄存器读写、初始化、状态检查或运动等待失败 | 函数内已有 ErrorLog_*；需确认是否覆盖本分支及关键字段 | 寄存器名/地址、读写方向、初始化或运行阶段、底层返回值、驱动状态 | 模块：电机；操作：TMC寄存器访问；原因：通信/状态失败；字段：寄存器、方向、阶段、返回值 | SPI和运动时序敏感；避免重复最终报错，不改变停机/恢复分类 | 清单阶段无源码改动；后续实施必须保持返回值、重试、停机、恢复和状态机不变 | 保持TMC恢复大类；先补寄存器/方向/阶段，不拆码 | TMC读/写/初始化失败注入；核对停机、重试、恢复和寄存器字段 | 清单完成，待源码批次审批
P2-006 | 第二批：TMC 电机驱动 | 0x000B0002 MOTOR_TMC_COMM_ERROR | LTD_MAIN_CPU2/BSP/Peripherals/src/TMC5130.c:stpr_waitMove():877,889 | TMC 寄存器读写、初始化、状态检查或运动等待失败 | 函数内仅见 printf/调试输出，未见统一 ErrorLog_* | 寄存器名/地址、读写方向、初始化或运行阶段、底层返回值、驱动状态 | 模块：电机；操作：TMC寄存器访问；原因：通信/状态失败；字段：寄存器、方向、阶段、返回值 | SPI和运动时序敏感；避免重复最终报错，不改变停机/恢复分类 | 清单阶段无源码改动；后续实施必须保持返回值、重试、停机、恢复和状态机不变 | 保持TMC恢复大类；先补寄存器/方向/阶段，不拆码 | TMC读/写/初始化失败注入；核对停机、重试、恢复和寄存器字段 | 清单完成，待源码批次审批
P2-007 | 第二批：TMC 电机驱动 | 0x000B0002 MOTOR_TMC_COMM_ERROR | LTD_MAIN_CPU2/BSP/Peripherals/src/TMC5130.c:stpr_initStepper():1081 | TMC 寄存器读写、初始化、状态检查或运动等待失败 | 函数内仅见 printf/调试输出，未见统一 ErrorLog_* | 寄存器名/地址、读写方向、初始化或运行阶段、底层返回值、驱动状态 | 模块：电机；操作：TMC寄存器访问；原因：通信/状态失败；字段：寄存器、方向、阶段、返回值 | SPI和运动时序敏感；避免重复最终报错，不改变停机/恢复分类 | 清单阶段无源码改动；后续实施必须保持返回值、重试、停机、恢复和状态机不变 | 保持TMC恢复大类；先补寄存器/方向/阶段，不拆码 | TMC读/写/初始化失败注入；核对停机、重试、恢复和寄存器字段 | 清单完成，待源码批次审批
P2-008 | 第二批：TMC 电机驱动 | 0x000B0002 MOTOR_TMC_COMM_ERROR | LTD_MAIN_CPU2/Services/MotorControl/motor_ctrl_driver_param.c:MotorCtrl_BootSafeStop():106,112,115,119 | 电机驱动参数/运行状态读取阶段向上传递 TMC 访问失败 | 函数内仅见 printf/调试输出，未见统一 ErrorLog_* | 寄存器名/地址、读写方向、初始化或运行阶段、底层返回值、驱动状态 | 模块：电机；操作：TMC寄存器访问；原因：通信/状态失败；字段：寄存器、方向、阶段、返回值 | SPI和运动时序敏感；避免重复最终报错，不改变停机/恢复分类 | 清单阶段无源码改动；后续实施必须保持返回值、重试、停机、恢复和状态机不变 | 保持TMC恢复大类；先补寄存器/方向/阶段，不拆码 | TMC读/写/初始化失败注入；核对停机、重试、恢复和寄存器字段 | 清单完成，待源码批次审批
P2-009 | 第二批：TMC 电机驱动 | 0x000B0002 MOTOR_TMC_COMM_ERROR | LTD_MAIN_CPU2/Services/MotorControl/motor_ctrl_driver_param.c:MotorDriver_ClearInitResetFlag():243,256 | 电机驱动参数/运行状态读取阶段向上传递 TMC 访问失败 | 函数内仅见 printf/调试输出，未见统一 ErrorLog_* | 寄存器名/地址、读写方向、初始化或运行阶段、底层返回值、驱动状态 | 模块：电机；操作：TMC寄存器访问；原因：通信/状态失败；字段：寄存器、方向、阶段、返回值 | SPI和运动时序敏感；避免重复最终报错，不改变停机/恢复分类 | 清单阶段无源码改动；后续实施必须保持返回值、重试、停机、恢复和状态机不变 | 保持TMC恢复大类；先补寄存器/方向/阶段，不拆码 | TMC读/写/初始化失败注入；核对停机、重试、恢复和寄存器字段 | 清单完成，待源码批次审批
P2-010 | 第二批：TMC 电机驱动 | 0x000B0002 MOTOR_TMC_COMM_ERROR | LTD_MAIN_CPU2/Services/MotorControl/motor_ctrl_driver_param.c:MotorDriver_ReadTargetPositionOpen():440,443 | 电机驱动参数/运行状态读取阶段向上传递 TMC 访问失败 | 函数内未见 ErrorLog_* 或 printf | 寄存器名/地址、读写方向、初始化或运行阶段、底层返回值、驱动状态 | 模块：电机；操作：TMC寄存器访问；原因：通信/状态失败；字段：寄存器、方向、阶段、返回值 | SPI和运动时序敏感；避免重复最终报错，不改变停机/恢复分类 | 清单阶段无源码改动；后续实施必须保持返回值、重试、停机、恢复和状态机不变 | 保持TMC恢复大类；先补寄存器/方向/阶段，不拆码 | TMC读/写/初始化失败注入；核对停机、重试、恢复和寄存器字段 | 清单完成，待源码批次审批
P2-011 | 第二批：TMC 电机驱动 | 0x000B0002 MOTOR_TMC_COMM_ERROR | LTD_MAIN_CPU2/Services/MotorControl/motor_ctrl_driver_param.c:MotorDriver_AlignTargetToActual():470,473 | 电机驱动参数/运行状态读取阶段向上传递 TMC 访问失败 | 函数内未见 ErrorLog_* 或 printf | 寄存器名/地址、读写方向、初始化或运行阶段、底层返回值、驱动状态 | 模块：电机；操作：TMC寄存器访问；原因：通信/状态失败；字段：寄存器、方向、阶段、返回值 | SPI和运动时序敏感；避免重复最终报错，不改变停机/恢复分类 | 清单阶段无源码改动；后续实施必须保持返回值、重试、停机、恢复和状态机不变 | 保持TMC恢复大类；先补寄存器/方向/阶段，不拆码 | TMC读/写/初始化失败注入；核对停机、重试、恢复和寄存器字段 | 清单完成，待源码批次审批
P2-012 | 第二批：TMC 电机驱动 | 0x000B0002 MOTOR_TMC_COMM_ERROR | LTD_MAIN_CPU2/Services/MotorControl/motor_ctrl_driver_param.c:MotorDriver_ReadMovingState():805,815,823 | 电机驱动参数/运行状态读取阶段向上传递 TMC 访问失败 | 函数内未见 ErrorLog_* 或 printf | 寄存器名/地址、读写方向、初始化或运行阶段、底层返回值、驱动状态 | 模块：电机；操作：TMC寄存器访问；原因：通信/状态失败；字段：寄存器、方向、阶段、返回值 | SPI和运动时序敏感；避免重复最终报错，不改变停机/恢复分类 | 清单阶段无源码改动；后续实施必须保持返回值、重试、停机、恢复和状态机不变 | 保持TMC恢复大类；先补寄存器/方向/阶段，不拆码 | TMC读/写/初始化失败注入；核对停机、重试、恢复和寄存器字段 | 清单完成，待源码批次审批
P2-013 | 第二批：TMC 电机驱动 | 0x000B0002 MOTOR_TMC_COMM_ERROR | LTD_MAIN_CPU2/Services/MotorControl/motor_ctrl_driver_param.c:MotorDriver_ReadStoppingState():860,869,876 | 电机驱动参数/运行状态读取阶段向上传递 TMC 访问失败 | 函数内未见 ErrorLog_* 或 printf | 寄存器名/地址、读写方向、初始化或运行阶段、底层返回值、驱动状态 | 模块：电机；操作：TMC寄存器访问；原因：通信/状态失败；字段：寄存器、方向、阶段、返回值 | SPI和运动时序敏感；避免重复最终报错，不改变停机/恢复分类 | 清单阶段无源码改动；后续实施必须保持返回值、重试、停机、恢复和状态机不变 | 保持TMC恢复大类；先补寄存器/方向/阶段，不拆码 | TMC读/写/初始化失败注入；核对停机、重试、恢复和寄存器字段 | 清单完成，待源码批次审批
P2-014 | 第二批：TMC 电机驱动 | 0x000B0002 MOTOR_TMC_COMM_ERROR | LTD_MAIN_CPU2/Services/MotorControl/motor_ctrl_motion_api.c:MotorCtrl_MoveByTicksAndWait():257 | 运动控制流程向上传递 TMC 驱动通信失败 | 函数内已有 ErrorLog_*；需确认是否覆盖本分支及关键字段 | 寄存器名/地址、读写方向、初始化或运行阶段、底层返回值、驱动状态 | 模块：电机；操作：TMC寄存器访问；原因：通信/状态失败；字段：寄存器、方向、阶段、返回值 | SPI和运动时序敏感；避免重复最终报错，不改变停机/恢复分类 | 清单阶段无源码改动；后续实施必须保持返回值、重试、停机、恢复和状态机不变 | 保持TMC恢复大类；先补寄存器/方向/阶段，不拆码 | TMC读/写/初始化失败注入；核对停机、重试、恢复和寄存器字段 | 清单完成，待源码批次审批
P2-015 | 第二批：TMC 电机驱动 | 0x000B0002 MOTOR_TMC_COMM_ERROR | LTD_MAIN_CPU2/Services/MotorControl/motor_ctrl_motion_api.c:MotorMotion_WaitTicksReachTarget():1163 | 运动控制流程向上传递 TMC 驱动通信失败 | 函数内已有 ErrorLog_*；需确认是否覆盖本分支及关键字段 | 寄存器名/地址、读写方向、初始化或运行阶段、底层返回值、驱动状态 | 模块：电机；操作：TMC寄存器访问；原因：通信/状态失败；字段：寄存器、方向、阶段、返回值 | SPI和运动时序敏感；避免重复最终报错，不改变停机/恢复分类 | 清单阶段无源码改动；后续实施必须保持返回值、重试、停机、恢复和状态机不变 | 保持TMC恢复大类；先补寄存器/方向/阶段，不拆码 | TMC读/写/初始化失败注入；核对停机、重试、恢复和寄存器字段 | 清单完成，待源码批次审批
P2-016 | 第二批：TMC 电机驱动 | 0x000B0002 MOTOR_TMC_COMM_ERROR | LTD_MAIN_CPU2/Services/MotorControl/motor_ctrl_position_model.c:MotorCtrl_SwitchPositionSourceToMotor():450,535 | 位置源切换或持久化位置恢复时 TMC 读写失败 | 函数内仅见 printf/调试输出，未见统一 ErrorLog_* | 寄存器名/地址、读写方向、初始化或运行阶段、底层返回值、驱动状态 | 模块：电机；操作：TMC寄存器访问；原因：通信/状态失败；字段：寄存器、方向、阶段、返回值 | SPI和运动时序敏感；避免重复最终报错，不改变停机/恢复分类 | 清单阶段无源码改动；后续实施必须保持返回值、重试、停机、恢复和状态机不变 | 保持TMC恢复大类；先补寄存器/方向/阶段，不拆码 | TMC读/写/初始化失败注入；核对停机、重试、恢复和寄存器字段 | 清单完成，待源码批次审批
P2-017 | 第二批：TMC 电机驱动 | 0x000B0002 MOTOR_TMC_COMM_ERROR | LTD_MAIN_CPU2/Services/MotorControl/motor_ctrl_position_model.c:MotorPosition_RestorePersistedRegisters():887 | 位置源切换或持久化位置恢复时 TMC 读写失败 | 函数内仅见 printf/调试输出，未见统一 ErrorLog_* | 寄存器名/地址、读写方向、初始化或运行阶段、底层返回值、驱动状态 | 模块：电机；操作：TMC寄存器访问；原因：通信/状态失败；字段：寄存器、方向、阶段、返回值 | SPI和运动时序敏感；避免重复最终报错，不改变停机/恢复分类 | 清单阶段无源码改动；后续实施必须保持返回值、重试、停机、恢复和状态机不变 | 保持TMC恢复大类；先补寄存器/方向/阶段，不拆码 | TMC读/写/初始化失败注入；核对停机、重试、恢复和寄存器字段 | 清单完成，待源码批次审批
P3-001 | 第三批：传感器和无线 | 0x000D001B SENSOR_RESP_FORMAT_ERROR | LTD_MAIN_CPU2/Services/Sensor/dsm_sensor_communication.c:UART6_StartTextReceiveDma():166 | UART/DMA 启动、完成状态、接收长度或部分帧异常 | 函数内未见 ErrorLog_* 或 printf | 协议类型、命令、接收长度、期望长度、解析字段、UART/DMA 状态、原始片段 | 模块：传感器/无线；操作：响应解析；原因：格式/硬件状态异常；字段：协议、长度、字段、DMA状态 | UART/DMA/重试时序敏感；ISR仅置标志，避免循环内高频打印 | 清单阶段无源码改动；后续实施必须保持返回值、重试、停机、恢复和状态机不变 | UART/DMA责任域回收候选；格式码暂不改 | 无响应/部分帧/格式错/UART错误注入；核对ISR边界和重试结果 | 清单完成，待源码批次审批
P3-002 | 第三批：传感器和无线 | 0x000D001B SENSOR_RESP_FORMAT_ERROR | LTD_MAIN_CPU2/Services/Sensor/dsm_sensor_communication.c:UART6_WaitTextReceiveDma():197,213,236,252 | UART/DMA 启动、完成状态、接收长度或部分帧异常 | 函数内未见 ErrorLog_* 或 printf | 协议类型、命令、接收长度、期望长度、解析字段、UART/DMA 状态、原始片段 | 模块：传感器/无线；操作：响应解析；原因：格式/硬件状态异常；字段：协议、长度、字段、DMA状态 | UART/DMA/重试时序敏感；ISR仅置标志，避免循环内高频打印 | 清单阶段无源码改动；后续实施必须保持返回值、重试、停机、恢复和状态机不变 | UART/DMA责任域回收候选；格式码暂不改 | 无响应/部分帧/格式错/UART错误注入；核对ISR边界和重试结果 | 清单完成，待源码批次审批
P3-003 | 第三批：传感器和无线 | 0x000D001B SENSOR_RESP_FORMAT_ERROR | LTD_MAIN_CPU2/Services/Sensor/dsm_sensor_communication.c:UART6_SendCommand():404,410 | UART/DMA 启动、完成状态、接收长度或部分帧异常 | 函数内仅见 printf/调试输出，未见统一 ErrorLog_* | 协议类型、命令、接收长度、期望长度、解析字段、UART/DMA 状态、原始片段 | 模块：传感器/无线；操作：响应解析；原因：格式/硬件状态异常；字段：协议、长度、字段、DMA状态 | UART/DMA/重试时序敏感；ISR仅置标志，避免循环内高频打印 | 清单阶段无源码改动；后续实施必须保持返回值、重试、停机、恢复和状态机不变 | UART/DMA责任域回收候选；格式码暂不改 | 无响应/部分帧/格式错/UART错误注入；核对ISR边界和重试结果 | 清单完成，待源码批次审批
P3-004 | 第三批：传感器和无线 | 0x000D001B SENSOR_RESP_FORMAT_ERROR | LTD_MAIN_CPU2/Services/Sensor/dsm_sensor_communication.c:Read_Sensor_Voltage():526 | 传感器响应长度、字段、校验或数值解析失败 | 函数内仅见 printf/调试输出，未见统一 ErrorLog_* | 协议类型、命令、接收长度、期望长度、解析字段、UART/DMA 状态、原始片段 | 模块：传感器/无线；操作：响应解析；原因：格式/硬件状态异常；字段：协议、长度、字段、DMA状态 | UART/DMA/重试时序敏感；ISR仅置标志，避免循环内高频打印 | 清单阶段无源码改动；后续实施必须保持返回值、重试、停机、恢复和状态机不变 | 保持传感器格式码并补解析上下文 | 无响应/部分帧/格式错/UART错误注入；核对ISR边界和重试结果 | 清单完成，待源码批次审批
P3-005 | 第三批：传感器和无线 | 0x000D001B SENSOR_RESP_FORMAT_ERROR | LTD_MAIN_CPU2/Services/Sensor/dsm_sensor_communication.c:Probe_EnableWaterSensor():546 | 传感器响应长度、字段、校验或数值解析失败 | 函数内仅见 printf/调试输出，未见统一 ErrorLog_* | 协议类型、命令、接收长度、期望长度、解析字段、UART/DMA 状态、原始片段 | 模块：传感器/无线；操作：响应解析；原因：格式/硬件状态异常；字段：协议、长度、字段、DMA状态 | UART/DMA/重试时序敏感；ISR仅置标志，避免循环内高频打印 | 清单阶段无源码改动；后续实施必须保持返回值、重试、停机、恢复和状态机不变 | 保持传感器格式码并补解析上下文 | 无响应/部分帧/格式错/UART错误注入；核对ISR边界和重试结果 | 清单完成，待源码批次审批
P3-006 | 第三批：传感器和无线 | 0x000D001B SENSOR_RESP_FORMAT_ERROR | LTD_MAIN_CPU2/Services/Sensor/dsm_sensor_communication.c:DSM_EnableLevelMode():570 | 传感器响应长度、字段、校验或数值解析失败 | 函数内仅见 printf/调试输出，未见统一 ErrorLog_* | 协议类型、命令、接收长度、期望长度、解析字段、UART/DMA 状态、原始片段 | 模块：传感器/无线；操作：响应解析；原因：格式/硬件状态异常；字段：协议、长度、字段、DMA状态 | UART/DMA/重试时序敏感；ISR仅置标志，避免循环内高频打印 | 清单阶段无源码改动；后续实施必须保持返回值、重试、停机、恢复和状态机不变 | 保持传感器格式码并补解析上下文 | 无响应/部分帧/格式错/UART错误注入；核对ISR边界和重试结果 | 清单完成，待源码批次审批
P3-007 | 第三批：传感器和无线 | 0x000D001B SENSOR_RESP_FORMAT_ERROR | LTD_MAIN_CPU2/Services/Sensor/dsm_sensor_communication.c:DSM_EnableDensityMode():594 | 传感器响应长度、字段、校验或数值解析失败 | 函数内仅见 printf/调试输出，未见统一 ErrorLog_* | 协议类型、命令、接收长度、期望长度、解析字段、UART/DMA 状态、原始片段 | 模块：传感器/无线；操作：响应解析；原因：格式/硬件状态异常；字段：协议、长度、字段、DMA状态 | UART/DMA/重试时序敏感；ISR仅置标志，避免循环内高频打印 | 清单阶段无源码改动；后续实施必须保持返回值、重试、停机、恢复和状态机不变 | 保持传感器格式码并补解析上下文 | 无响应/部分帧/格式错/UART错误注入；核对ISR边界和重试结果 | 清单完成，待源码批次审批
P3-008 | 第三批：传感器和无线 | 0x000D001B SENSOR_RESP_FORMAT_ERROR | LTD_MAIN_CPU2/Services/Sensor/dsm_sensor_communication.c:Read_Level_Frequency():640 | 传感器响应长度、字段、校验或数值解析失败 | 函数内仅见 printf/调试输出，未见统一 ErrorLog_* | 协议类型、命令、接收长度、期望长度、解析字段、UART/DMA 状态、原始片段 | 模块：传感器/无线；操作：响应解析；原因：格式/硬件状态异常；字段：协议、长度、字段、DMA状态 | UART/DMA/重试时序敏感；ISR仅置标志，避免循环内高频打印 | 清单阶段无源码改动；后续实施必须保持返回值、重试、停机、恢复和状态机不变 | 保持传感器格式码并补解析上下文 | 无响应/部分帧/格式错/UART错误注入；核对ISR边界和重试结果 | 清单完成，待源码批次审批
P3-009 | 第三批：传感器和无线 | 0x000D001B SENSOR_RESP_FORMAT_ERROR | LTD_MAIN_CPU2/Services/Sensor/dsm_sensor_communication.c:DSM_Read_Frequency_Density_Temp():671 | 传感器响应长度、字段、校验或数值解析失败 | 函数内未见 ErrorLog_* 或 printf | 协议类型、命令、接收长度、期望长度、解析字段、UART/DMA 状态、原始片段 | 模块：传感器/无线；操作：响应解析；原因：格式/硬件状态异常；字段：协议、长度、字段、DMA状态 | UART/DMA/重试时序敏感；ISR仅置标志，避免循环内高频打印 | 清单阶段无源码改动；后续实施必须保持返回值、重试、停机、恢复和状态机不变 | 保持传感器格式码并补解析上下文 | 无响应/部分帧/格式错/UART错误注入；核对ISR边界和重试结果 | 清单完成，待源码批次审批
P3-010 | 第三批：传感器和无线 | 0x000D001B SENSOR_RESP_FORMAT_ERROR | LTD_MAIN_CPU2/Services/Sensor/dsm_sensor_communication.c:Read_VibrationTube_ID():719,731 | 传感器响应长度、字段、校验或数值解析失败 | 函数内仅见 printf/调试输出，未见统一 ErrorLog_* | 协议类型、命令、接收长度、期望长度、解析字段、UART/DMA 状态、原始片段 | 模块：传感器/无线；操作：响应解析；原因：格式/硬件状态异常；字段：协议、长度、字段、DMA状态 | UART/DMA/重试时序敏感；ISR仅置标志，避免循环内高频打印 | 清单阶段无源码改动；后续实施必须保持返回值、重试、停机、恢复和状态机不变 | 保持传感器格式码并补解析上下文 | 无响应/部分帧/格式错/UART错误注入；核对ISR边界和重试结果 | 清单完成，待源码批次审批
P3-011 | 第三批：传感器和无线 | 0x000D001B SENSOR_RESP_FORMAT_ERROR | LTD_MAIN_CPU2/Services/Sensor/dsm_sensor_communication.c:Read_Water_Capacitance():773,778,781,784 | 传感器响应长度、字段、校验或数值解析失败 | 函数内未见 ErrorLog_* 或 printf | 协议类型、命令、接收长度、期望长度、解析字段、UART/DMA 状态、原始片段 | 模块：传感器/无线；操作：响应解析；原因：格式/硬件状态异常；字段：协议、长度、字段、DMA状态 | UART/DMA/重试时序敏感；ISR仅置标志，避免循环内高频打印 | 清单阶段无源码改动；后续实施必须保持返回值、重试、停机、恢复和状态机不变 | 保持传感器格式码并补解析上下文 | 无响应/部分帧/格式错/UART错误注入；核对ISR边界和重试结果 | 清单完成，待源码批次审批
P3-012 | 第三批：传感器和无线 | 0x000D001B SENSOR_RESP_FORMAT_ERROR | LTD_MAIN_CPU2/Services/Sensor/dsm_sensor_communication.c:Read_Gyro_Angle():856,864 | 传感器响应长度、字段、校验或数值解析失败 | 函数内未见 ErrorLog_* 或 printf | 协议类型、命令、接收长度、期望长度、解析字段、UART/DMA 状态、原始片段 | 模块：传感器/无线；操作：响应解析；原因：格式/硬件状态异常；字段：协议、长度、字段、DMA状态 | UART/DMA/重试时序敏感；ISR仅置标志，避免循环内高频打印 | 清单阶段无源码改动；后续实施必须保持返回值、重试、停机、恢复和状态机不变 | 保持传感器格式码并补解析上下文 | 无响应/部分帧/格式错/UART错误注入；核对ISR边界和重试结果 | 清单完成，待源码批次审批
P3-013 | 第三批：传感器和无线 | 0x000D001B SENSOR_RESP_FORMAT_ERROR | LTD_MAIN_CPU2/Services/Sensor/ltd_sensor_communication.c:DSM_V2_StartFixedReceiveDma():139 | UART/DMA 启动、完成状态、接收长度或部分帧异常 | 函数内未见 ErrorLog_* 或 printf | 协议类型、命令、接收长度、期望长度、解析字段、UART/DMA 状态、原始片段 | 模块：传感器/无线；操作：响应解析；原因：格式/硬件状态异常；字段：协议、长度、字段、DMA状态 | UART/DMA/重试时序敏感；ISR仅置标志，避免循环内高频打印 | 清单阶段无源码改动；后续实施必须保持返回值、重试、停机、恢复和状态机不变 | UART/DMA责任域回收候选；格式码暂不改 | 无响应/部分帧/格式错/UART错误注入；核对ISR边界和重试结果 | 清单完成，待源码批次审批
P3-014 | 第三批：传感器和无线 | 0x000D001B SENSOR_RESP_FORMAT_ERROR | LTD_MAIN_CPU2/Services/Sensor/ltd_sensor_communication.c:DSM_V2_WaitFixedReceiveDma():165,179,198 | UART/DMA 启动、完成状态、接收长度或部分帧异常 | 函数内未见 ErrorLog_* 或 printf | 协议类型、命令、接收长度、期望长度、解析字段、UART/DMA 状态、原始片段 | 模块：传感器/无线；操作：响应解析；原因：格式/硬件状态异常；字段：协议、长度、字段、DMA状态 | UART/DMA/重试时序敏感；ISR仅置标志，避免循环内高频打印 | 清单阶段无源码改动；后续实施必须保持返回值、重试、停机、恢复和状态机不变 | UART/DMA责任域回收候选；格式码暂不改 | 无响应/部分帧/格式错/UART错误注入；核对ISR边界和重试结果 | 清单完成，待源码批次审批
P3-015 | 第三批：传感器和无线 | 0x000D001B SENSOR_RESP_FORMAT_ERROR | LTD_MAIN_CPU2/Services/Sensor/ltd_sensor_communication.c:DSM_V2_CheckReply():265,276 | 传感器响应长度、字段、校验或数值解析失败 | 函数内仅见 printf/调试输出，未见统一 ErrorLog_* | 协议类型、命令、接收长度、期望长度、解析字段、UART/DMA 状态、原始片段 | 模块：传感器/无线；操作：响应解析；原因：格式/硬件状态异常；字段：协议、长度、字段、DMA状态 | UART/DMA/重试时序敏感；ISR仅置标志，避免循环内高频打印 | 清单阶段无源码改动；后续实施必须保持返回值、重试、停机、恢复和状态机不变 | 保持传感器格式码并补解析上下文 | 无响应/部分帧/格式错/UART错误注入；核对ISR边界和重试结果 | 清单完成，待源码批次审批
P3-016 | 第三批：传感器和无线 | 0x000D001B SENSOR_RESP_FORMAT_ERROR | LTD_MAIN_CPU2/Services/Sensor/sensor.c:Sensor_ParseDsmTextId():183,192 | 传感器响应长度、字段、校验或数值解析失败 | 函数内未见 ErrorLog_* 或 printf | 协议类型、命令、接收长度、期望长度、解析字段、UART/DMA 状态、原始片段 | 模块：传感器/无线；操作：响应解析；原因：格式/硬件状态异常；字段：协议、长度、字段、DMA状态 | UART/DMA/重试时序敏感；ISR仅置标志，避免循环内高频打印 | 清单阶段无源码改动；后续实施必须保持返回值、重试、停机、恢复和状态机不变 | 保持传感器格式码并补解析上下文 | 无响应/部分帧/格式错/UART错误注入；核对ISR边界和重试结果 | 清单完成，待源码批次审批
P3-017 | 第三批：传感器和无线 | 0x000D001B SENSOR_RESP_FORMAT_ERROR | LTD_MAIN_CPU2/Services/Sensor/wireless_pairing.c:WirelessPairing_PublishStatus():640,655 | CH9141/无线 AT 响应或状态字段解析失败 | 函数内未见 ErrorLog_* 或 printf | 协议类型、命令、接收长度、期望长度、解析字段、UART/DMA 状态、原始片段 | 模块：传感器/无线；操作：响应解析；原因：格式/硬件状态异常；字段：协议、长度、字段、DMA状态 | UART/DMA/重试时序敏感；ISR仅置标志，避免循环内高频打印 | 清单阶段无源码改动；后续实施必须保持返回值、重试、停机、恢复和状态机不变 | 无线责任域回收候选；先补AT上下文 | 无响应/部分帧/格式错/UART错误注入；核对ISR边界和重试结果 | 清单完成，待源码批次审批
P3-018 | 第三批：传感器和无线 | 0x000D001B SENSOR_RESP_FORMAT_ERROR | LTD_MAIN_CPU2/Services/Sensor/wireless_pairing.c:WirelessPairing_EnterAtAndHostMode():1213 | CH9141/无线 AT 响应或状态字段解析失败 | 函数内仅见 printf/调试输出，未见统一 ErrorLog_* | 协议类型、命令、接收长度、期望长度、解析字段、UART/DMA 状态、原始片段 | 模块：传感器/无线；操作：响应解析；原因：格式/硬件状态异常；字段：协议、长度、字段、DMA状态 | UART/DMA/重试时序敏感；ISR仅置标志，避免循环内高频打印 | 清单阶段无源码改动；后续实施必须保持返回值、重试、停机、恢复和状态机不变 | 无线责任域回收候选；先补AT上下文 | 无响应/部分帧/格式错/UART错误注入；核对ISR边界和重试结果 | 清单完成，待源码批次审批
P3-019 | 第三批：传感器和无线 | 0x000D001B SENSOR_RESP_FORMAT_ERROR | LTD_MAIN_CPU2/Services/Sensor/wireless_pairing.c:WirelessPairing_ReadConnectionStatus():1578,1592,1621,1641 | CH9141/无线 AT 响应或状态字段解析失败 | 函数内仅见 printf/调试输出，未见统一 ErrorLog_* | 协议类型、命令、接收长度、期望长度、解析字段、UART/DMA 状态、原始片段 | 模块：传感器/无线；操作：响应解析；原因：格式/硬件状态异常；字段：协议、长度、字段、DMA状态 | UART/DMA/重试时序敏感；ISR仅置标志，避免循环内高频打印 | 清单阶段无源码改动；后续实施必须保持返回值、重试、停机、恢复和状态机不变 | 无线责任域回收候选；先补AT上下文 | 无响应/部分帧/格式错/UART错误注入；核对ISR边界和重试结果 | 清单完成，待源码批次审批
P3-020 | 第三批：传感器和无线 | 0x000D001B SENSOR_RESP_FORMAT_ERROR | LTD_MAIN_CPU2/Services/Sensor/wireless_pairing.c:WirelessPairing_PrintConnectionStatus():1742,1761,1790,1820 | CH9141/无线 AT 响应或状态字段解析失败 | 函数内仅见 printf/调试输出，未见统一 ErrorLog_* | 协议类型、命令、接收长度、期望长度、解析字段、UART/DMA 状态、原始片段 | 模块：传感器/无线；操作：响应解析；原因：格式/硬件状态异常；字段：协议、长度、字段、DMA状态 | UART/DMA/重试时序敏感；ISR仅置标志，避免循环内高频打印 | 清单阶段无源码改动；后续实施必须保持返回值、重试、停机、恢复和状态机不变 | 无线责任域回收候选；先补AT上下文 | 无响应/部分帧/格式错/UART错误注入；核对ISR边界和重试结果 | 清单完成，待源码批次审批
P3-021 | 第三批：传感器和无线 | 0x000D001B SENSOR_RESP_FORMAT_ERROR | LTD_MAIN_CPU2/Services/Sensor/wireless_pairing.c:WirelessPairing_RunByName():1977 | CH9141/无线 AT 响应或状态字段解析失败 | 函数内仅见 printf/调试输出，未见统一 ErrorLog_* | 协议类型、命令、接收长度、期望长度、解析字段、UART/DMA 状态、原始片段 | 模块：传感器/无线；操作：响应解析；原因：格式/硬件状态异常；字段：协议、长度、字段、DMA状态 | UART/DMA/重试时序敏感；ISR仅置标志，避免循环内高频打印 | 清单阶段无源码改动；后续实施必须保持返回值、重试、停机、恢复和状态机不变 | 无线责任域回收候选；先补AT上下文 | 无响应/部分帧/格式错/UART错误注入；核对ISR边界和重试结果 | 清单完成，待源码批次审批
P3-022 | 第三批：传感器和无线 | 0x000D0003 SENSOR_DEVICE_COMM_TIMEOUT | LTD_MAIN_CPU2/Services/Sensor/ch9141_at.c:CH9141_AT_CollectResponse():491 | 无线/AT 响应等待超时 | 函数内未见 ErrorLog_* 或 printf | 链路类型、TX/RX 阶段、已收字节数、期望长度、尝试次数、UART 状态 | 模块：传感器/无线；操作：发送或等待响应；原因：通信超时；字段：链路、字节数、尝试、UART状态 | UART/DMA/重试时序敏感；ISR仅置标志，避免循环内高频打印 | 清单阶段无源码改动；后续实施必须保持返回值、重试、停机、恢复和状态机不变 | 复用无线主机/从机专用超时码候选 | 无响应/部分帧/格式错/UART错误注入；核对ISR边界和重试结果 | 清单完成，待源码批次审批
P3-023 | 第三批：传感器和无线 | 0x000D0003 SENSOR_DEVICE_COMM_TIMEOUT | LTD_MAIN_CPU2/Services/Sensor/dsm_sensor_communication.c:UART6_WaitTransmitDmaDone():153 | UART DMA 发送完成等待超时 | 函数内未见 ErrorLog_* 或 printf | 链路类型、TX/RX 阶段、已收字节数、期望长度、尝试次数、UART 状态 | 模块：传感器/无线；操作：发送或等待响应；原因：通信超时；字段：链路、字节数、尝试、UART状态 | UART/DMA/重试时序敏感；ISR仅置标志，避免循环内高频打印 | 清单阶段无源码改动；后续实施必须保持返回值、重试、停机、恢复和状态机不变 | 保持传感器主链路超时码并补链路上下文 | 无响应/部分帧/格式错/UART错误注入；核对ISR边界和重试结果 | 清单完成，待源码批次审批
P3-024 | 第三批：传感器和无线 | 0x000D0003 SENSOR_DEVICE_COMM_TIMEOUT | LTD_MAIN_CPU2/Services/Sensor/dsm_sensor_communication.c:UART6_WaitTextReceiveDma():252 | 接收窗口无有效字节或未形成完整响应 | 函数内未见 ErrorLog_* 或 printf | 链路类型、TX/RX 阶段、已收字节数、期望长度、尝试次数、UART 状态 | 模块：传感器/无线；操作：发送或等待响应；原因：通信超时；字段：链路、字节数、尝试、UART状态 | UART/DMA/重试时序敏感；ISR仅置标志，避免循环内高频打印 | 清单阶段无源码改动；后续实施必须保持返回值、重试、停机、恢复和状态机不变 | 保持传感器主链路超时码并补链路上下文 | 无响应/部分帧/格式错/UART错误注入；核对ISR边界和重试结果 | 清单完成，待源码批次审批
P3-025 | 第三批：传感器和无线 | 0x000D0003 SENSOR_DEVICE_COMM_TIMEOUT | LTD_MAIN_CPU2/Services/Sensor/dsm_sensor_communication.c:UART6_SendCommand():407 | 传感器主链路无响应或重试后仍超时 | 函数内仅见 printf/调试输出，未见统一 ErrorLog_* | 链路类型、TX/RX 阶段、已收字节数、期望长度、尝试次数、UART 状态 | 模块：传感器/无线；操作：发送或等待响应；原因：通信超时；字段：链路、字节数、尝试、UART状态 | UART/DMA/重试时序敏感；ISR仅置标志，避免循环内高频打印 | 清单阶段无源码改动；后续实施必须保持返回值、重试、停机、恢复和状态机不变 | 保持传感器主链路超时码并补链路上下文 | 无响应/部分帧/格式错/UART错误注入；核对ISR边界和重试结果 | 清单完成，待源码批次审批
P3-026 | 第三批：传感器和无线 | 0x000D0003 SENSOR_DEVICE_COMM_TIMEOUT | LTD_MAIN_CPU2/Services/Sensor/dsm_sensor_communication.c:UART6_SendWithRetry():440 | 传感器主链路无响应或重试后仍超时 | 函数内已有 ErrorLog_*；需确认是否覆盖本分支及关键字段 | 链路类型、TX/RX 阶段、已收字节数、期望长度、尝试次数、UART 状态 | 模块：传感器/无线；操作：发送或等待响应；原因：通信超时；字段：链路、字节数、尝试、UART状态 | UART/DMA/重试时序敏感；ISR仅置标志，避免循环内高频打印 | 清单阶段无源码改动；后续实施必须保持返回值、重试、停机、恢复和状态机不变 | 保持传感器主链路超时码并补链路上下文 | 无响应/部分帧/格式错/UART错误注入；核对ISR边界和重试结果 | 清单完成，待源码批次审批
P3-027 | 第三批：传感器和无线 | 0x000D0003 SENSOR_DEVICE_COMM_TIMEOUT | LTD_MAIN_CPU2/Services/Sensor/ltd_sensor_communication.c:DSM_V2_WaitTransmitDmaDone():126 | UART DMA 发送完成等待超时 | 函数内未见 ErrorLog_* 或 printf | 链路类型、TX/RX 阶段、已收字节数、期望长度、尝试次数、UART 状态 | 模块：传感器/无线；操作：发送或等待响应；原因：通信超时；字段：链路、字节数、尝试、UART状态 | UART/DMA/重试时序敏感；ISR仅置标志，避免循环内高频打印 | 清单阶段无源码改动；后续实施必须保持返回值、重试、停机、恢复和状态机不变 | 保持传感器主链路超时码并补链路上下文 | 无响应/部分帧/格式错/UART错误注入；核对ISR边界和重试结果 | 清单完成，待源码批次审批
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
