duanxuebin1998/cube/docs/06_SIL功能安全认证/06_模板/北德sil认证文件模板/part_1_概念阶段/1-4 文档管理清单/README.md

# 模板资料

本目录保留北德 SIL 认证文件模板的原始资料；文件名和层级按来源保留，使用时应复核适用标准、项目版本和授权。
