duanxuebin1998/cube/docs/00_构建与版本/文档库整理候选清单.md

# 文档库整理候选清单

更新日期：2026-08-03

本清单站在使用者查找和维护的角度，记录下一批文档整理候选项。CPU2/CPU3 子项目文档已并入整机 `docs/`，后续扫描和整理只以 `docs/` 为正式文档源。

## 盘点结论

当前扫描范围：`docs/`。下表是 2026-07-13 运行 `py tools\check_docs.py` 并按扩展名复核得到的快照；后续以检查脚本实时输出为准。

| 项目 | 结果 |
| --- | ---: |
| 文件总数 | 547 |
| Markdown | 275 |
| HTML | 67 |
| PDF | 48 |
| DOCX | 13 |
| XLSX | 7 |
| DAT | 1 |
| ZIP | 1 |
| 其他资源文件 | 135 |
| 缺少 `README.md` 的业务目录 | 0 |
| 无独立 README 的支撑资源目录 | 4（流程导航根目录、CPU2、CPU3 和 SI 中文整理的 `assets/`，仅图片、样式或脚本） |
| Office 临时锁文件 | 0 |

当前文档库的主要问题不是缺业务目录，也不是同名导出件堆积；当前存在少量同名 Markdown+PDF 文件对，统一以 Markdown 为维护正文，PDF 只作为历史导出或外发阅读件且不阻塞文档检查。`assets/` 仅是流程 HTML 的支撑资源目录，不按业务入口补 README。后续重点是让使用者明确“正文改 Markdown、表格看 README、PDF/DOCX/DAT/ZIP 多数是附件、源表、原始记录或外部资料”。

## 已完成的收敛动作

| 范围 | 处理结果 |
| --- | --- |
| CPU2 子项目文档 | 已并入 `docs/00_程序流程导航/CPU2/`、`docs/01_协议与寄存器/CPU2通信与解耦/`、`docs/03_问题分析与整改/`、`docs/07_硬件原理图/00_原始资料/CPU2芯片手册/` 和 `docs/00_构建与版本/故障码/` |
| CPU3 子项目文档 | 已并入 `docs/00_程序流程导航/CPU3/` 和 `docs/00_构建与版本/故障码/` |
| 测试记录旧日期命名 | 当前维护文件已拆入 `问题复测/`、`版本验证/`、`现场记录/`；未建立单独的 `旧格式归档/` 入口，旧名称只在迁移记录和历史版本说明中保留 |
| 故障码表 | 历史分表已收敛：`LTD故障代码统一表.xlsx` 是面向交付的唯一故障项目工作簿；`LTD内部技术与治理资料.xlsx` 保存协议29的130项治理快照、调用点、链路和迁移证据，协议30～34增量待同步 |
| 本地预览展示层 | `docs-site/` 只同步 `docs/`，但不纳入 Git 跟踪；旧 `site/` 工作区副本已删除，只从 Git 历史追溯 |
| 人工查找索引 | 已补 `版本总览.md`、`附件与源文件清单.md`、`流程排查入口.md`、`问题专题索引.md` 和 SIL `资料用途矩阵.md`；这些索引不改变后续 skill 生成版本文档规则 |
| 新增资料落位 | 已补 `新增资料落位检查表.md`，用于新增、移动或重命名前判断业务域、文件类型、索引同步和验证动作；不改变 skill 生成规则 |
| Office/日志附件责任说明 | 已复核 DOCX、XLSX、DAT、ZIP/TXT 所在父目录 README，并在附件总清单记录覆盖情况；附件仍不转换、不批量改名 |
| 旧路径和旧站点引用 | 已复查旧 CPU2/CPU3 docs、旧 `/html/cpu2`、`/html/cpu3`、`8128` 和旧静态站脚本关键词；活文档入口未继续指向旧目录 |
| 同名 PDF 导出件 | 当前存在少量同名 Markdown+PDF 文件对；Markdown 是维护正文，PDF 按历史导出或外发阅读件处理，默认不检查、不自动同步 |
| 入口页瘦身 | 已把 `00_构建与版本/README.md` 的完整版本历史表移交给 `版本总览.md`；已把根 `docs/README.md` 的文件类型/命名细则移交给使用指南、附件清单和治理清单；已把 SIL 外部资料长表压缩为资料范围入口 |

## 判定规则

| 类型 | 维护口径 | 后续处理 |
| --- | --- | --- |
| 同目录同名 Markdown + PDF | Markdown 作为可维护正文，PDF 视为历史导出件或交付阅读件 | 暂不删除、不新增专用归档目录；在父目录 README 标明“以 Markdown 为准” |
| 外部 PDF、芯片手册、标准文档 | 原始资料，不修改正文 | 保留原厂文件名，放在 `00_原始资料/`、`00_外部资料/` 或芯片手册目录 |
| DOCX/XLSX 表格 | 可能是原始确认表、现场交付表或维护表 | 补 Markdown 索引说明用途、责任人和是否仍在维护 |
| HTML 流程页 | 当前作为流程图、结构图或历史阅读页保留 | 放入业务目录并由文档站统一入口跳转 |
| `docs-site/` 生成内容 | 本地预览层，不是业务资料权威来源 | 只改 `docs/` 源文档；`docs-site/` 整体忽略，不提交 |
| 旧 `site/` 与旧静态站脚本 | 已淘汰展示层 | 不恢复、不发布；旧页面需要追溯时看 Git 历史 |
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
