duanxuebin1998/cube/docs/06_SIL功能安全认证/03_软件详细设计/CPU2软件详细设计编制工作包/06_分卷编制/05_故障恢复与安全机制/visio源文件V0.2/README.md

# 第5分册 Visio 源文件 V0.2

本目录保存故障统一出口、自动恢复、业务重跑、供电异常、ADC/DMA 监控和监督喂狗的可编辑流程图。修改后须同步更新对应分册并重新执行整本渲染与逐页复核。
