duanxuebin1998/cube/docs/00_构建与版本/版本改动与测试/2026-09-14_CPU3_V1.43.1.0_外部COM长期运行通信故障修复_改动与测试方案.md

# CPU3 V1.43.1.0 外部 COM 长期运行通信故障修复改动与测试方案

## 1. 文档目的和适用版本

本方案对应 MAIN 分支的 CPU3 `V1.43.1.0` 固件。CPU2 配套版本保持 `V1.44.0.0`。目标是修复外部 COM 启动保护状态在 `HAL_GetTick()` 长期运行回绕后可能重新变为未就绪，导致 COM1/COM2/COM3 不再处理协议帧的问题。

本次提交只改变 CPU3 外部 COM 启动保护状态的判定和版本资料，不改变 CPU2 程序、CPU2/CPU3 共享协议字段、外部协议帧格式、参数地址或参数存储布局。

## 2. 版本、协议和参数存储兼容性

| 项目 | 改前 | 改后 | 说明 |
| --- | --- | --- | --- |
| CPU2 程序 | `V1.44.0.0` | `V1.44.0.0` | 本次不修改 CPU2 |
| CPU3 程序 | `V1.43.0.0` | `V1.43.1.0` | 兼容范围内的通信状态修复，PATCH 升版 |
| 共享协议 | `DEVICE_PROTOCOL_VERSION=37` | `37` | 寄存器、命令、状态和字段不变 |
| CPU2 参数存储 | `DEVICE_PARAM_VERSION=3` | `3` | `DeviceParameters`、`struct_size`、CRC 和 FRAM 布局不变 |
| CPU3 参数存储 | `CPU3_PARAM_VERSION=0x0007` | `0x0007` | `Cpu3CommAndDisplayParams`、CRC 和 FRAM 布局不变 |

从 `V1.43.0.0`/`V1.44.0.0` 升级不恢复出厂、不清除现场参数，不需要重新下发串口参数。现场仍应按既有流程记录当前参数，并确认双板配套版本。

## 3. 本次提交范围

### 3.1 CPU3 源码和版本

- `LTD_DISPLAY_CPU3/Application/app_main.c`
- `LTD_DISPLAY_CPU3/Application/app_version.h`

### 3.2 版本资料

- `CHANGELOG.md`
- `docs/00_构建与版本/版本改动与测试/2026-09-14_CPU3_V1.43.1.0_外部COM长期运行通信故障修复_改动与测试方案.md`
- `docs/00_构建与版本/版本改动与测试/Ⅱ代储罐在线计量仪版本升级记录.xlsx`

## 4. 详细改动清单

### 4.1 外部 COM 就绪状态跨 tick 回绕保持有效

- 源码位置：`LTD_DISPLAY_CPU3/Application/app_main.c` 的 `s_external_ports_start_tick`、`s_external_ports_ready` 和 `cpu3_external_ports_startup_ready()`；调用链为 `App_Init()` -> `App_MainLoop()` -> `cpu3_uart_rx_recovery_task()`/COM1～COM3 协议分发。
- 改前问题：初始化完成后保存未来截止 tick，并用 `(int32_t)(HAL_GetTick() - 截止tick) >= 0` 判断。长期运行跨 32 位 tick 回绕时，已达到保护时间的端口可能再次被判为未就绪，主循环仍运行但不再消费外部 COM 接收帧，现场表现为电流和屏幕正常、通信无响应。
- 具体改法：初始化完成后保存 `s_external_ports_start_tick = HAL_GetTick()`；每轮用 `(uint32_t)(HAL_GetTick() - s_external_ports_start_tick) >= CPU3_EXTERNAL_PORT_STARTUP_GUARD_MS` 判断经过时间；条件满足后置位 `s_external_ports_ready` 并保持为真。`App_Init()` 重新进入时先清零锁存状态，再在三路外部串口初始化完成后重新开始计时。
- 必查边界：启动后 0 ms、999 ms、1000 ms 和更晚时刻；`HAL_GetTick()` 在 `0xFFFFFFFF -> 0` 回绕前后；主循环继续运行但外部端口未就绪；三路端口同时有帧；重复调用就绪判断；重新执行 `App_Init()`；保护期间 CPU2 板间通信、屏幕和日志任务不得被阻塞。
- 通过标准：保护期内不消费 COM1/COM2/COM3 协议帧；达到 1000 ms 后开始消费；tick 回绕后 `s_external_ports_ready` 不回退；屏幕任务和 CPU2 轮询持续执行；源码中不再使用旧的有符号截止 tick 判断。

### 4.2 CPU3 补丁版本和发布资料同步

- 源码位置：`LTD_DISPLAY_CPU3/Application/app_version.h`、`CHANGELOG.md`、售后版本记录和本方案。
- 改前问题：行为修复若沿用旧版本号，会使现场无法区分包含回绕修复的程序包。
- 具体改法：CPU3 `V1.43.0.0` 升为 `V1.43.1.0`；CPU2 保持 `V1.44.0.0`；协议和两端参数存储版本保持原值。售后表新增最新记录，改动点使用现场可理解的现象和修复描述。
- 必查边界：版本头四个字段与字符串一致；CHANGELOG、测试方案和售后表版本一致；协议37、CPU2 参数存储版本3、CPU3 参数版本0x0007 均未误升；升级说明不要求清参数。
- 通过标准：版本脚本识别 CPU3 PATCH 升版；三份发布资料均写出 `V1.43.1.0` 和 `V1.44.0.0` 配套关系；提交标题包含双端版本号。

## 5. 跨模块数据流和异常闭环

1. `App_Init()` 记录 CPU3 启动时间并初始化显示、RTC、FRAM 参数、三路外部串口和 DSM 通信。
2. 三路外部串口初始化完成后记录 `s_external_ports_start_tick`，启动保护窗口为 1000 ms。
3. `App_MainLoop()` 每轮先报告看门狗进度，再计算外部 COM 就绪状态；保护期间仍执行 UART 接收异常恢复、显示、CPU2 板间轮询和日志任务。
4. 就绪后，COM1/COM2/COM3 各消费一帧接收数据，按现有协议处理器生成响应，DMA 发送完成回调按既有路径恢复接收。
5. UART 错误、接收溢出、发送失败和协议处理失败仍沿用原错误统计和恢复路径；本次不把通信错误改成“成功”，也不修改看门狗喂狗逻辑。

## 6. 测试环境和前置条件

- 主机：Windows，CMake + Ninja + `arm-none-eabi-gcc`。
- 固件：CPU3 `V1.43.1.0` Debug，CPU2 配套 `V1.44.0.0`。
- 构建目录：`build/LTD_DISPLAY_CPU3`，使用独立 CPU3 子工程 clean-first 构建。
- 台架：CPU3 三路外部 COM 接入可配置的 RS485 主站，能够连续发送有效请求、记录响应和时间戳；另接 CPU2 板间通信和 OLED 观察点。
- 诊断：保留 CPU3 启动保护日志、端口收发统计、UART 错误统计和发送完成计数；需要时在测试固件中提供可控 tick 回绕注入，不把注入宏带入发布构建。

## 7. 可执行测试矩阵

| 用例 | 关联改动 | 前置条件和步骤 | 观测位置 | 预期结果和通过标准 | 状态/证据 |
| --- | --- | --- | --- | --- | --- |
| COM-01 启动保护 | 4.1 | 上电后在 0 ms、999 ms、1000 ms、1001 ms 各发送一帧 COM3 请求 | COM3 响应、启动日志 | 1000 ms 前不处理，达到门限后按原协议响应；不阻塞 OLED 和 CPU2 轮询 | 主机已执行，待目标板证据 |
| COM-02 三口并行 | 4.1 | 启动后同时向 COM1/COM2/COM3 连续发送合法帧，保持 10 min | 三口响应计数、端口日志 | 三口均在保护结束后持续响应，无端口永久停收 | 待台架 |
| COM-03 tick 回绕 | 4.1 | 将模拟 `HAL_GetTick()` 设为 `0xFFFFFF00`，初始化端口后跨 `0xFFFFFFFF -> 0` 运行并发送请求 | 就绪锁存值、响应和端口统计 | 回绕前后就绪值保持 true，COM3 不丢失处理；无有符号比较误判 | 待仿真/目标板 |
| COM-04 长时间通信 | 4.1 | 三口持续请求至少 24 h，期间保持显示刷新和 CPU2 轮询 | 响应时间序列、`tx_complete_count`、UART 错误计数、看门狗复位记录 | 无永久无响应；若发生单帧错误，按原恢复路径恢复；无看门狗复位 | 待现场台架 |
| COM-05 发送完成恢复 | 4.1 | 连续发送不同长度响应，注入接收帧紧邻发送完成的时序 | DMA 状态、发送完成计数、接收恢复 | 每次最后一帧发送完成后恢复接收，后续请求仍有响应 | 待目标板 |
| COM-06 UART 异常 | 4.1 | 注入 ORE/FE/NE/PE 或接收满块后继续发送 | UART 错误统计、恢复日志、后续响应 | 错误被统计并恢复，不影响已锁存的就绪状态；屏幕和 CPU2 任务继续 | 待目标板 |
| COM-07 重新初始化 | 4.1 | 运行中执行一次受支持的外部串口重配，再分别检查保护窗口前后 | 参数应用日志、COM 响应 | 重新初始化重新开始 1000 ms 保护，保护结束后就绪再次锁存；不影响其它端口 | 待目标板 |
| COM-08 版本与兼容 | 4.2 | 检查版本头、协议37、CPU2 参数3、CPU3 参数0x0007，并使用旧 FRAM 镜像启动 | 启动日志、FRAM 参数和协议握手 | 版本字符串为 `V1.43.1.0`；旧参数不被清除；CPU2/CPU3 协议握手仍成功 | 静态已执行，FRAM 待目标板 |

## 8. 复杂场景分步验证

### 8.1 长时间运行和回绕场景

1. 上电并确认启动日志打印 `V1.43.1.0`、协议37以及外部 COM 初始化完成。
2. 在保护窗口内发送 COM3 合法请求，确认不会因为初始化阶段而执行协议响应，同时确认 OLED 刷新和 CPU2 板间状态继续变化。
3. 保护结束后持续发送 COM3 请求，记录每一笔请求、响应、响应时间、发送完成计数和 UART 错误计数。
4. 让 tick 跨过 32 位回绕，或在受控测试固件中将 tick 起点设到回绕前，重复发送请求并检查 `s_external_ports_ready` 不回退。
5. 继续运行至 24 h，期间加入短时断链、恢复、重复请求和三口并行流量，确认一次异常不会造成永久停收。
6. 测试结束读取看门狗复位原因、端口统计和日志；任何复位、永久无响应或统计停止均判定失败并保留原始记录。

### 8.2 发送完成和接收恢复场景

1. 主站按 COM3 当前协议发送会产生短响应和长响应的请求。
2. 在 DMA 发送期间发送下一帧请求，确认单帧 pending 队列及发送完成回调按现有逻辑工作。
3. 在最后一帧发送完成后立即发送下一帧，确认方向控制恢复接收，后续帧仍能被消费。
4. 记录发送完成回调次数与响应数量；计数单调增加且无永久 busy 即通过。

## 9. 回归范围

- CPU3 启动顺序：日志、OLED 首屏、RTC、FRAM 参数加载、三路外部串口初始化、DSM 初始化。
- COM1/COM2/COM3：当前协议分发、合法请求、无需响应帧、处理失败、DMA 发送、pending 队列和发送完成恢复。
- UART 异常：空闲帧、接收满块、ORE/FE/NE/PE、退避恢复和端口统计。
- CPU2 板间 UART5：轮询门限、方向控制、协议37握手和看门狗进度报告。
- CPU3 显示、参数菜单、串口重配和日志任务，确认启动保护修改未引入前台阻塞。
- 参数和发布资料：CPU2 `DEVICE_PARAM_VERSION=3`、CPU3 `CPU3_PARAM_VERSION=0x0007`、FRAM CRC、版本字符串和售后记录。

## 10. 已执行验证和构建证据

- 已检查最终源码差异，确认只改变外部 COM 启动就绪状态判断、CPU3 补丁版本和发布资料。
- 已完成源码 UTF-8/CRLF 检查；本文件和 CHANGELOG 保持 UTF-8，CPU3 源码保持 UTF-8 与 CRLF。
- CPU3 `V1.43.1.0` Debug clean-first 构建已通过，62 个目标完成；`text=221224`、`data=20996`、`bss=100764`。固定名和版本名 HEX 均为 681401 字节，SHA-256 均为 `E22408214B4DF69FA0AB146A3978258E395422703A03A6AAFCCAF7A868C22B1A`。产物保存在 `outputs/main-com3-long-run-fix-20260914/`。
- `check_cpu3_display_isr_boundaries.py`、`check_cpu3_uart5_interframe_gap_contract.py`、`check_cpu3_cpu2_comm_timeout_fault_contract.py`、`check_cpu3_profile_snapshot_contract.py` 和 `check_flow_impact.py --files LTD_DISPLAY_CPU3/Application/app_main.c --strict --json` 已通过。
- `check_cpu3_external_freshness_contract.py` 和 `check_cpu3_uart5_rx_prearm_contract.py` 仍因 MAIN 基线缺少 `CPU3_Uart5ArmResponseRx`、UART5 RX 预置恢复契约而失败；该既有 UART5 问题不在本次改动路径内，未通过 `--no-verify` 绕过。
- `docs/00_程序流程导航/` 已按 CPU3 `V1.43.1.0` 同步并完成严格影响检查；该目录及 `tools/` 不进入 Git 提交。

## 11. 风险与未验证项

- 已由源码检查关闭：旧的有符号截止 tick 判断已移除；就绪状态在保护结束后锁存；协议、参数存储和看门狗调用未改变。
- 已由构建和通过的静态检查覆盖：代码可编译、版本字符串一致、CPU3 ISR 边界和流程映射符合现有契约。UART5 RX 预置契约缺失是本次之前的基线问题，不能据此宣称 CPU3 所有通信链路均已关闭风险。
- 构建和静态检查不证明中断向量、RS485 收发器、DMA 电气时序或真实 tick 回绕行为。
- 未验证：目标板烧写、RS485 电平和方向控制、真实发送完成中断、长时间 24 h/跨回绕运行、断链恢复、FRAM 掉电、现场多设备安装顺序、SIL 和硬件故障注入。
- 现场验收至少应提供 CPU3 版本、CPU2 配套版本、连续运行时长、三路请求/响应原始时间序列、发送完成计数、UART 错误计数和看门狗复位原因。

## 12. 提交前检查清单

- [ ] `app_version.h` 为 CPU3 `V1.43.1.0`，CPU2 保持 `V1.44.0.0`。
- [ ] `DEVICE_PROTOCOL_VERSION=37`、CPU2 `DEVICE_PARAM_VERSION=3`、CPU3 `CPU3_PARAM_VERSION=0x0007` 已核对。
- [ ] `CHANGELOG.md`、本方案和售后版本记录的日期、版本和改动点一致。
- [ ] CPU3 clean-first 构建成功，固定名 HEX 与版本名 HEX 哈希一致。
- [ ] 相关静态契约、编码、差异、版本和提交范围门禁通过；UART5 RX 预置基线失败项已记录且未绕过门禁。
- [ ] 本机流程导航已同步检查但未进入 Git 暂存区。
- [ ] 目标板、RS485、长期运行和 SIL 未执行项在提交记录和现场计划中保留。

## 13. 提交状态

本文件随本次 MAIN 分支提交纳入，提交哈希以 Git 记录为准；提交前构建和门禁结果将在本节及 CHANGELOG 验证段补录。
