duanxuebin1998/cube/docs/00_构建与版本/故障码/当前程序故障代码清单.md

# 当前程序故障代码清单

更新日期：2026-09-07

本文记录当前开发源码中的故障码定义、屏幕编号、一代对照和版本兼容口径。正式中文说明、可能原因和现场处理方法以 `LTD故障代码统一表.xlsx` 为准；协议29及更早的调用点、拆分来源和编号迁移可查 `LTD内部技术与治理资料.xlsx`，该工作簿尚未同步协议30及以后新增项，协议30～34现行事实应以源码、本清单和共享协议记录为准。

## 当前口径

- CPU2 `ErrorCode` 共138项，其中2项为非故障状态、136项为CPU2/CPU3共享故障。
- CPU3共140项定义：同步CPU2的138项，并额外保留2个本机故障：`CPU2_COMM_TIMEOUT = 0x00140007`（屏幕显示 `20-7`）和 `CPU2_PROFILE_SYNC_FAILED = 0x0014000D`（屏幕显示 `20-13`）。
- 正式工作簿共138个故障项目：均已并入`故障代码`页，`协议34新增故障`页仅保留并入记录；合计136个共享故障和2个CPU3本机故障，其中使用中135项、保留3项。
- 屏幕使用十进制“类别代码-故障码”，例如 `13-3`；正式工作簿不使用十六进制编号作为现场查询入口。
- 协议34首个正式固件组合为CPU2 `V1.40.0.0` / CPU3 `V1.40.0.0`。协议34启用 `12-6` 并新增 `12-17`；`12-13` 保留定义和显示映射，LIN位仅作诊断统计，不作为停机条件。
- 当前开发源码为共享协议36，对应CPU2 `V1.43.0.0` / CPU3 `V1.42.0.0`。新增15-34“液位定时矫正失败”：刷新无法有效回退、回退超时或连续3轮失败时使用；具体传感器、电机、位置故障优先透传，不用15-34覆盖。不复用冻结的历史15-32/15-33。
- 协议29取消不可达的 `12-11`，把扭力检测调整到18类、模拟输出与自检调整到21类，并把 `13-26` 的有效密度上限提升到 `3000.0 kg/m³`。协议29不提供旧故障码别名、翻译或兼容规避，CPU2与CPU3必须成对使用。
- 协议30新增23类整机供电与电源监控故障，分别区分24 V欠压、ADC溢出、DMA停止、监控启动失败、连续3次恢复失败和掉电位置保存失败；协议29及更早程序不能解释这些新编号。
- 协议34上电连续确认3帧稳定角后核对FRAM保存角；运行中按20 m/min物理极限、实际采样间隔和编码轮周长计算动态上限，连续3个超物理上限候选锁存 `12-17`，上电位置跳变立即锁存 `12-6`。16 counts只用于上电稳定确认，不是运行门限。LIN位和方向不一致持续计入 `ENC?` 诊断统计，但两者本身不拒绝位置帧、不触发停机。
- CPU2 `DEVICE_PARAM_VERSION` 仍为3，`DeviceParameters` 结构、大小和校验范围未变；本次故障码拆分不会清除现场参数。
- 现场查询CPU2产生的共享故障时，先确认设备代际，再按CPU2程序版本选择故障表；`DEVICE_PROTOCOL_VERSION` 只用于CPU2与CPU3严格配套判断。CPU3本机 `20-7`、`20-13` 按CPU3程序版本确认。

## 版本归档

| 工作表 | 适用范围 | 项目数 | 维护规则 |
| --- | --- | ---: | --- |
| `故障代码` | CPU2 `V1.43.0.0` / CPU3 `V1.42.0.0`、共享协议36 | 138 | 保留原有项目，12-17已并入；表尾追加15-34，12-13继续保留定义和显示映射 |
| `协议34新增故障` | 协议34历史并入记录 | 0 | 12-17已在主表维护，本页不再重复列故障项目 |
| `历史故障代码_CPU2V1.27.0.0` | CPU2 V1.27.0.0、CPU3 V1.25.0.0、共享协议21 | 130 | 内容保持不变，按CPU2程序版本查询 |
| `历史故障代码_CPU2V1.25.0.0-V1.26.0.0` | CPU2 V1.25.0.0～V1.26.0.0的历史口径；含当时63个共享故障和1个CPU3本机故障记录 | 64 | 内容保持不变，按CPU2程序版本查询 |
| `历史故障代码_CPU2V1.24.0.0` | CPU2 V1.24.0.0开发基线；含75个共享故障和当时CPU3本机故障记录 | 76 | 内容保持不变，保留12个早期停用项 |
| `一代计量仪历史故障代码` | 一代资料版本v1.0（2026-05-23） | 106项两段式代码，另含1项特殊通信代码 | 只用于一代设备，不与二代当前表混用 |

历史页中的编号和含义不回写。二代后续CPU2版本可以复用相同编号，但旧日志仍按产生时的CPU2程序版本解释；协议18移出的10个通用码和CPU2 V1.24.0.0历史页中的12个早期停用码继续分批统计。

## 一代与二代的编号关系

- 二代优先采用“一代类别加10、同含义保留子码”，例如一代 `3-3` 传感器无响应对应二代 `13-3` 传感器通信超时。
- 只有责任域、现场现象和处理方式一致时才沿用一代子码；一代一个大类被拆成多个可定位故障时，二代新增子码并在表中保留一代来源。
- 二代新增责任域使用18扭力检测、20设备通信链路、21模拟输出与自检、22系统与软件、23整机供电与电源监控。10、16、19只保留代际类别位置，当前不分配故障码。
- 一代已有编号不得改作完全不同的二代含义；二代新增项目从不占用一代既有含义的最低可用子码开始安排。

## 类别统计

| 类别代码 | 类别 | CPU2共享故障数 | 正式故障项目数 | 说明 |
| ---: | --- | ---: | ---: | --- |
| 0 | 正常状态 | 0 | 0 | 2项非故障状态，不进入正式故障项目统计 |
| 10 | 上位机预留 | 0 | 0 | 对应一代0类，当前不分配故障码 |
| 11 | 电机驱动 | 15 | 15 | 驱动通信、供电、温度、相线、堵转、停止、到位和配置 |
| 12 | 编码器 | 12 | 12 | 采集、校验、初始化、上电/运行位置跳变、线性度、位置质量和周长标定；12-11已取消 |
| 13 | 传感器与密度 | 38 | 38 | 一代子码优先延续，并拆分安全传感器会话、命令、模式、参数和周期上报结果 |
| 14 | 零点与位置检测 | 6 | 6 | 零点、位置数据、目标越界、到位偏差和停止确认 |
| 15 | 测量过程 | 19 | 19 | 液位、水位、探底、罐高、标定前置条件、密度找液、测点规划和液位定时矫正 |
| 16 | 角度异常预留 | 0 | 0 | 对应一代6类，当前不分配故障码 |
| 17 | 参数与存储 | 10 | 10 | 存储读写、结构与版本校验、写后核对、范围、完整性、缺项、组合和能力 |
| 18 | 扭力检测 | 6 | 6 | 范围、碰撞、漂移、饱和和通信 |
| 19 | 液位预留 | 0 | 0 | 对应一代9类，二代液位过程故障归15类 |
| 20 | 设备通信链路 | 11 | 13 | 11项共享故障，另有2项CPU3本机故障 `20-7`、`20-13` |
| 21 | 模拟输出与自检 | 10 | 10 | 初始化、回读、环路诊断、传输、占用和温度 |
| 22 | 系统与软件 | 3 | 3 | 内部容量、调用条件和计算结果 |
| 23 | 整机供电与电源监控 | 6 | 6 | 24 V欠压、ADC/DMA链路、监控启动与恢复、掉电位置保存 |

## 共享状态和故障码

| 屏幕编号 | 完整码 | 内部标识 | 中文名称 | 状态 | 一代对照编号 |
| --- | --- | --- | --- | --- | --- |
| — | `0x00000000` | `NO_ERROR` | 正常 | 非故障状态 | — |
| — | `0x00000001` | `STATE_SWITCH` | 状态切换 | 非故障状态 | — |
| 11-2 | `0x000B0002` | `MOTOR_TMC_COMM_ERROR` | TMC5130通信异常 | 使用中 | 1-2 |
| 11-3 | `0x000B0003` | `MOTOR_TMC_CONFIG_LOST` | 电机驱动配置丢失 | 使用中 | 1-3 |
| 11-4 | `0x000B0004` | `MOTOR_DISABLED` | 电机驱动电流未建立 | 使用中 | 1-4 |
| 11-5 | `0x000B0005` | `MOTOR_UNKNOWN_FEEDBACK` | 电机驱动故障类型未知 | 使用中 | 1-5 |
| 11-10 | `0x000B000A` | `MOTOR_STEP_ERROR` | 电机无有效位移 | 使用中 | 1-10 |
| 11-11 | `0x000B000B` | `MOTOR_STALL_ERROR` | 电机堵转 | 使用中 | 1-11 |
| 11-16 | `0x000B0010` | `MOTOR_CHARGE_PUMP_UNDER_VOLTAGE` | 电机驱动内部升压不足 | 使用中 | 1-7 |
| 11-17 | `0x000B0011` | `MOTOR_OVERTEMPERATURE` | 电机驱动过温关断 | 使用中 | 1-7 |
| 11-18 | `0x000B0012` | `MOTOR_RUN_TIMEOUT` | 电机运行超时 | 使用中 | 1-10 |
| 11-19 | `0x000B0013` | `MOTOR_PHASE_SHORT_ERROR` | 电机相线短路 | 使用中 | 1-15 |
| 11-20 | `0x000B0014` | `MOTOR_PHASE_OPEN_ERROR` | 电机相线断路 | 使用中 | 1-15 |
| 11-21 | `0x000B0015` | `MOTOR_DRIVER_OVERTEMP_WARNING` | 电机驱动过温预警 | 使用中 | 1-7 |
| 11-22 | `0x000B0016` | `MOTOR_DRIVER_NOT_INITIALIZED` | 电机驱动未初始化 | 使用中 | 1-3、1-4 |
| 11-23 | `0x000B0017` | `MOTOR_STOP_WAIT_TIMEOUT` | 电机未按时停下 | 使用中 | 1-10 |
| 11-24 | `0x000B0018` | `MOTOR_ARRIVAL_WAIT_TIMEOUT` | 电机未按时到位 | 使用中 | 1-10 |
| 12-1 | `0x000C0001` | `ENCODER_TIMEOUT` | 编码器没有有效位置数据 | 使用中 | 2-1 |
| 12-2 | `0x000C0002` | `ENCODER_PARITY_ERROR` | 编码器数据校验失败 | 使用中 | 2-2 |
| 12-3 | `0x000C0003` | `ENCODER_LOST_STEP` | 编码器记录位移不足 | 使用中 | 2-3 |
| 12-5 | `0x000C0005` | `ENCODER_POWERON_FAIL` | 编码器位置记录不可用 | 使用中 | 2-5 |
| 12-6 | `0x000C0006` | `ENCODER_POWERON_CHANGE` | 编码器上电位置跳变 | 使用中 | 2-6 |
| 12-10 | `0x000C000A` | `ENCODER_DIFF_EXCESS` | 编码轮周长标定值过大 | 使用中 | 2-10 |
| 12-12 | `0x000C000C` | `ENCODER_CORDIC_OVERFLOW` | 编码器角度计算超限 | 使用中 | — |
| 12-13 | `0x000C000D` | `ENCODER_LINEARITY_WARNING` | 编码器角度线性异常（保留码） | 保留 | — |
| 12-14 | `0x000C000E` | `ENCODER_OCF_INCOMPLETE` | 编码器角度计算未完成 | 使用中 | — |
| 12-15 | `0x000C000F` | `ENCODER_FIRST_SAMPLE_TIMEOUT` | 编码器首帧超时 | 使用中 | 2-1 |
| 12-16 | `0x000C0010` | `ENCODER_CIRCUMFERENCE_CALIBRATION_ERROR` | 编码轮周长标定异常 | 使用中 | 2-3、2-10 |
| 12-17 | `0x000C0011` | `ENCODER_POSITION_JUMP` | 编码器运行位置跳变 | 使用中 | — |
| 13-1 | `0x000D0001` | `SENSOR_BCC_ERROR` | 传感器校验错误 | 使用中 | 3-1 |
| 13-2 | `0x000D0002` | `SONIC_FREQ_ABNORMAL` | 振动管频率异常 | 使用中 | 3-2 |
| 13-3 | `0x000D0003` | `SENSOR_DEVICE_COMM_TIMEOUT` | 传感器通信超时 | 使用中 | 3-3 |
| 13-5 | `0x000D0005` | `SENSOR_INTERNAL_CPU_COMM_TIMEOUT` | 传感器内部通信超时 | 使用中 | 3-5 |
| 13-14 | `0x000D000E` | `SENSOR_GYRO_ANGLE_ERROR` | 传感器姿态角异常 | 使用中 | 3-14 |
| 13-16 | `0x000D0010` | `SENSOR_INTERNAL_COMM_CHECK_ERROR` | 传感器内部通信校验失败 | 使用中 | 3-16 |
| 13-21 | `0x000D0015` | `SENSOR_NO_RESONANCE` | 传感器无谐振 | 使用中 | 3-21 |
| 13-26 | `0x000D001A` | `DENSITY_INVALID` | 密度值超出有效范围 | 使用中 | 3-26、3-12 |
| 13-27 | `0x000D001B` | `SENSOR_RESP_FORMAT_ERROR` | 传感器响应格式异常 | 使用中 | — |
| 13-28 | `0x000D001C` | `SENSOR_POWER_SUPPLY_ERROR` | 传感器供电异常 | 使用中 | 3-3、3-5 |
| 13-29 | `0x000D001D` | `SENSOR_GYRO_COMM_TIMEOUT` | 姿态模块通信超时 | 使用中 | 3-8、3-10 |
| 13-30 | `0x000D001E` | `SENSOR_SELF_TEST_FAILED` | 传感器自检失败 | 使用中 | 3-5 |
| 13-31 | `0x000D001F` | `SENSOR_IDENTITY_MISMATCH` | 传感器身份不匹配 | 使用中 | — |
| 13-32 | `0x000D0020` | `SENSOR_PROTOCOL_VERSION_INCOMPATIBLE` | 传感器协议版本不兼容 | 使用中 | — |
| 13-33 | `0x000D0021` | `SENSOR_MODE_NOT_READY` | 传感器模式未就绪 | 使用中 | — |
| 13-34 | `0x000D0022` | `SENSOR_CONFIG_EPOCH_MISMATCH` | 传感器配置批次不一致 | 使用中 | — |
| 13-35 | `0x000D0023` | `SENSOR_STREAM_STATE_ERROR` | 传感器上报状态不一致 | 使用中 | — |
| 13-36 | `0x000D0024` | `SENSOR_DATA_STALE` | 传感器数据过期 | 使用中 | — |
| 13-37 | `0x000D0025` | `SENSOR_TEMPERATURE_RANGE_ERROR` | 传感器温度超限 | 使用中 | — |
| 13-38 | `0x000D0026` | `SENSOR_REMOTE_INTERNAL_ERROR` | 传感器内部故障 | 使用中 | 3-5 |
| 13-39 | `0x000D0027` | `SENSOR_ADDRESS_MISMATCH` | 传感器地址不匹配 | 使用中 | — |
| 13-40 | `0x000D0028` | `SENSOR_SESSION_INVALID` | 传感器连接状态失效 | 使用中 | — |
| 13-41 | `0x000D0029` | `SENSOR_SEQUENCE_ERROR` | 传感器应答序号不一致 | 使用中 | — |
| 13-42 | `0x000D002A` | `SENSOR_HANDSHAKE_REQUIRED` | 传感器需要重新确认连接 | 使用中 | — |
| 13-43 | `0x000D002B` | `SENSOR_REPLAY_DETECTED` | 收到重复的传感器数据 | 使用中 | — |
| 13-44 | `0x000D002C` | `SENSOR_CAPABILITY_UNSUPPORTED` | 传感器不支持所需功能 | 使用中 | — |
| 13-45 | `0x000D002D` | `SENSOR_COMMAND_UNSUPPORTED` | 传感器命令不支持 | 使用中 | — |
| 13-46 | `0x000D002E` | `SENSOR_ARGUMENT_REJECTED` | 传感器不接受当前参数 | 使用中 | — |
| 13-47 | `0x000D002F` | `SENSOR_MODE_MISMATCH` | 传感器测量模式不一致 | 使用中 | — |
| 13-48 | `0x000D0030` | `SENSOR_MODE_NOT_ALLOWED` | 传感器当前模式不允许操作 | 使用中 | — |
| 13-49 | `0x000D0031` | `SENSOR_TRANSACTION_PENDING` | 上一次传感器操作尚未完成 | 使用中 | — |
| 13-50 | `0x000D0032` | `SENSOR_DEVICE_BUSY` | 传感器设备忙 | 使用中 | — |
| 13-51 | `0x000D0033` | `SENSOR_PARAM_CRC_ERROR` | 传感器参数校验失败 | 使用中 | — |
| 13-52 | `0x000D0034` | `SENSOR_SAMPLE_COUNTER_ERROR` | 传感器采样序号异常 | 使用中 | — |
| 13-53 | `0x000D0035` | `SENSOR_STREAM_STOPPED` | 传感器周期上报停止 | 使用中 | — |
| 13-54 | `0x000D0036` | `SENSOR_STREAM_NOT_ACTIVE` | 传感器周期上报未启动 | 使用中 | — |
| 13-55 | `0x000D0037` | `SENSOR_STREAM_ALREADY_ACTIVE` | 传感器周期上报重复启动 | 使用中 | — |
| 13-56 | `0x000D0038` | `SENSOR_STREAM_EXIT_FAILED` | 传感器周期上报退出失败 | 使用中 | — |
| 14-9 | `0x000E0009` | `MEASUREMENT_ZERO_OUT_OF_RANGE` | 零点位置超出允许范围 | 使用中 | 4-9 |
| 14-11 | `0x000E000B` | `MEASUREMENT_ZERO_REPEAT_FAIL` | 陀螺仪基准不稳定 | 使用中 | — |
| 14-12 | `0x000E000C` | `POSITION_DATA_INVALID` | 位置数据无效 | 使用中 | 2-10、4-9 |
| 14-13 | `0x000E000D` | `POSITION_TARGET_OVERRUN` | 运动越过目标 | 使用中 | 4-9 |
| 14-14 | `0x000E000E` | `POSITION_ARRIVAL_DEVIATION` | 电机到位偏差过大 | 使用中 | 5-12 |
| 14-15 | `0x000E000F` | `POSITION_MOTOR_NOT_STOPPED` | 电机未停止 | 使用中 | 1-10 |
| 15-6 | `0x000F0006` | `MEASUREMENT_OILLEVEL_HIGH` | 上行找液位到达位置上限 | 使用中 | 5-6 |
| 15-15 | `0x000F000F` | `MEASUREMENT_OVERSPEED` | 液位变化过快 | 使用中 | 5-15 |
| 15-16 | `0x000F0010` | `MEASUREMENT_HEIGHT_DEVIATION` | 实高偏差过大 | 保留 | 5-16 |
| 15-17 | `0x000F0011` | `MEASUREMENT_DENSITY_LEVEL_TIMEOUT` | 密度找液位超时 | 使用中 | — |
| 15-18 | `0x000F0012` | `MEASUREMENT_OILLEVEL_LOW` | 下行未找到液位 | 使用中 | 6-4 |
| 15-19 | `0x000F0013` | `MEASUREMENT_OILLEVEL_NOTFOUND` | 上行未找到液位 | 使用中 | 6-5 |
| 15-20 | `0x000F0014` | `MEASUREMENT_WEIGHT_DOWN_FAIL` | 下行未找到罐底 | 使用中 | 4-4 |
| 15-21 | `0x000F0015` | `MEASUREMENT_WEIGHT_UP_FAIL` | 上行未找到零点 | 使用中 | 4-3 |
| 15-22 | `0x000F0016` | `MEASUREMENT_WATERLEVEL_LOW` | 下行未找到水位 | 使用中 | 6-3 |
| 15-23 | `0x000F0017` | `MEASUREMENT_DENSITY_NO_VALID_POINT` | 密度测量无有效点 | 使用中 | — |
| 15-24 | `0x000F0018` | `MEASUREMENT_DENSITY_SURFACE_NOTFOUND` | 密度测量未找到油面 | 使用中 | — |
| 15-25 | `0x000F0019` | `MEASUREMENT_FREQUENCY_LEVEL_TIMEOUT` | 频率找液位超时 | 使用中 | — |
| 15-26 | `0x000F001A` | `MEASUREMENT_BOTTOM_RELEASE_FAIL` | 探底前未能离开罐底 | 使用中 | 4-3 |
| 15-27 | `0x000F001B` | `MEASUREMENT_TANK_HEIGHT_NOT_CONFIGURED` | 未设置罐高标定值 | 使用中 | — |
| 15-28 | `0x000F001C` | `MEASUREMENT_WATER_CALIBRATION_NOT_CONFIGURED` | 未设置水位标定值 | 使用中 | — |
| 15-29 | `0x000F001D` | `MEASUREMENT_DENSITY_PLAN_INVALID` | 密度测点规划失败 | 使用中 | 5-4、5-5、5-6、5-7 |
| 15-30 | `0x000F001E` | `MEASUREMENT_TANK_HEIGHT_RESULT_INVALID` | 罐高测量结果无效 | 使用中 | — |
| 15-31 | `0x000F001F` | `MEASUREMENT_WATER_CALC_OUT_OF_RANGE` | 水位标定计算结果越界 | 使用中 | — |
| 15-34 | `0x000F0022` | `MEASUREMENT_LEVEL_REFERENCE_REFRESH_FAILED` | 液位定时矫正失败 | 使用中 | — |
| 17-1 | `0x00110001` | `PARAM_EEPROM_FAIL` | 参数存储读写失败 | 使用中 | 7-1 |
| 17-2 | `0x00110002` | `PARAM_UNINITIALIZED` | 参数未初始化 | 使用中 | 7-2 |
| 17-5 | `0x00110005` | `PARAM_RANGE_ERROR` | 参数值超出范围 | 使用中 | 5-4、5-5、5-6、5-7 |
| 17-6 | `0x00110006` | `PARAM_CRC_ERROR` | 参数完整性校验失败 | 使用中 | — |
| 17-7 | `0x00110007` | `PARAM_CONFIG_MISSING` | 关键参数未设置 | 使用中 | 7-1、7-2 |
| 17-8 | `0x00110008` | `PARAM_COMBINATION_CONFLICT` | 参数组合冲突 | 使用中 | 5-4、5-5、5-6、5-7 |
| 17-9 | `0x00110009` | `PARAM_FEATURE_UNSUPPORTED` | 功能不支持 | 使用中 | — |
| 17-10 | `0x0011000A` | `PARAM_STORAGE_SIZE_MISMATCH` | 参数存储结构不匹配 | 使用中 | 7-1 |
| 17-11 | `0x0011000B` | `PARAM_STORAGE_VERSION_MISMATCH` | 参数存储版本不匹配 | 使用中 | 7-1 |
| 17-12 | `0x0011000C` | `PARAM_STORAGE_WRITE_VERIFY_FAILED` | 参数写入后校验失败 | 使用中 | 7-1 |
| 18-1 | `0x00120001` | `WEIGHT_OUT_OF_RANGE` | 满载标定扭力超过上限 | 使用中 | — |
| 18-2 | `0x00120002` | `WEIGHT_UNDER_RANGE` | 满载标定扭力低于下限 | 使用中 | — |
| 18-3 | `0x00120003` | `WEIGHT_COLLISION_DETECTED` | 扭力变化超过保护值 | 使用中 | — |
| 18-4 | `0x00120004` | `WEIGHT_DRIFT_ERROR` | 空载标定扭力偏离零点 | 使用中 | — |
| 18-5 | `0x00120005` | `WEIGHT_SENSOR_SATURATION` | 扭力传感器饱和 | 保留 | — |
| 18-6 | `0x00120006` | `WEIGHT_COMM_TIMEOUT` | 扭力通信超时 | 使用中 | — |
| 20-1 | `0x00140001` | `COMM_UART_TRANSFER_ERROR` | 串口传输异常 | 使用中 | — |
| 20-2 | `0x00140002` | `SLIPRING_COMM_FAIL` | 无线滑环通信失败 | 使用中 | — |
| 20-3 | `0x00140003` | `SLIPRING_SIGNAL_WEAK` | 无线配对信号不达标 | 使用中 | — |
| 20-4 | `0x00140004` | `WIRELESS_HOST_COMM_TIMEOUT` | 蓝牙主机通信超时 | 使用中 | — |
| 20-5 | `0x00140005` | `WIRELESS_SLAVE_COMM_TIMEOUT` | 蓝牙从机未连接 | 使用中 | — |
| 20-6 | `0x00140006` | `WIRELESS_RESP_FORMAT_ERROR` | 无线响应格式异常 | 使用中 | — |
| 20-8 | `0x00140008` | `WIRELESS_SCAN_NO_DEVICE` | 无线扫描未发现设备 | 使用中 | — |
| 20-9 | `0x00140009` | `WIRELESS_NAME_NOT_UNIQUE` | 无线名称重复 | 使用中 | — |
| 20-10 | `0x0014000A` | `WIRELESS_NAME_INVALID` | 无线名称无效 | 使用中 | — |
| 20-11 | `0x0014000B` | `WIRELESS_NOT_HOST_MODE` | 无线非主机模式 | 使用中 | — |
| 20-12 | `0x0014000C` | `WIRELESS_NAME_NOT_FOUND` | 无线名称未找到 | 使用中 | — |
| 21-2 | `0x00150002` | `AD5421_INIT_ERROR` | 模拟输出初始化失败 | 使用中 | 8-2、8-3 |
| 21-6 | `0x00150006` | `AD5421_READBACK_ERROR` | 模拟输出控制回读不一致 | 使用中 | 8-6 |
| 21-9 | `0x00150009` | `AD5421_INTERNAL_COMM_ERROR` | 模拟输出内部通信异常 | 使用中 | 8-3 |
| 21-10 | `0x0015000A` | `AD5421_LOOP_CURRENT_HIGH` | 模拟输出电流过高 | 使用中 | 8-3、8-6 |
| 21-11 | `0x0015000B` | `AD5421_LOOP_CURRENT_LOW` | 模拟输出电流过低 | 使用中 | 8-3、8-6 |
| 21-12 | `0x0015000C` | `AD5421_LOOP_VOLTAGE_LOW` | 模拟输出环路电压低 | 使用中 | 8-4 |
| 21-13 | `0x0015000D` | `AD5421_SPI_TRANSFER_ERROR` | 主控与模拟量输出模块通信失败 | 使用中 | — |
| 21-14 | `0x0015000E` | `AD5421_ACCESS_BUSY` | 模拟输出访问冲突 | 使用中 | — |
| 21-15 | `0x0015000F` | `AD5421_OVERTEMP_SHUTDOWN` | 模拟输出过温关断 | 使用中 | 8-8 |
| 21-16 | `0x00150010` | `AD5421_OVERTEMP_WARNING` | 模拟输出过温预警 | 使用中 | 8-8 |
| 22-1 | `0x00160001` | `SYSTEM_BUFFER_CAPACITY_ERROR` | 内部数据空间不足 | 使用中 | — |
| 22-2 | `0x00160002` | `SYSTEM_CALL_CONDITION_ERROR` | 系统调用条件异常 | 使用中 | — |
| 22-3 | `0x00160003` | `SYSTEM_CALCULATION_ERROR` | 系统计算异常 | 使用中 | — |
| 23-1 | `0x00170001` | `POWER_SUPPLY_24V_UNDERVOLTAGE` | 整机24 V欠压 | 使用中 | — |
| 23-2 | `0x00170002` | `POWER_MONITOR_ADC_OVERRUN` | 电源采样数据处理不及时 | 使用中 | — |
| 23-3 | `0x00170003` | `POWER_MONITOR_DMA_STOPPED` | 电源采样传输意外停止 | 使用中 | — |
| 23-4 | `0x00170004` | `POWER_MONITOR_INIT_FAILED` | 电源采样启动失败 | 使用中 | — |
| 23-5 | `0x00170005` | `POWER_MONITOR_RECOVERY_FAILED` | 电源采样连续恢复失败 | 使用中 | — |
| 23-6 | `0x00170006` | `POWER_LOSS_POSITION_SAVE_FAILED` | 掉电位置保存失败 | 使用中 | — |

## CPU3本机扩展故障码

| 屏幕编号 | 完整码 | 内部标识 | 中文名称 | 触发和恢复口径 |
| --- | --- | --- | --- | --- |
| 20-7 | `0x00140007` | `CPU2_COMM_TIMEOUT` | 主控单元通信超时 | 连续10个请求未获得合法CPU2响应后置错；只有完整包含设备状态和错误码的合法响应才能解除锁存 |
| 20-13 | `0x0014000D` | `CPU2_PROFILE_SYNC_FAILED` | 分布结果读取失败 | 完成锁存有效，但连续三轮或15秒内无法取得完成计数、测点数量、结果来源和完成锁存前后一致的完整点阵时置错；完成锁存清除或新完成代际出现后重新同步，完整提交成功后解除 |

## 保留编号

以下3项保留现有含义，当前流程不主动产生；启用前必须补齐调用点、显示、日志和验证：

- `12-13 ENCODER_LINEARITY_WARNING`：编码器线性度报警；双端保留定义和显示映射，当前仅在 `ENC?` 中保留LIN原始位和累计统计，不进入故障判定。
- `15-16 MEASUREMENT_HEIGHT_DEVIATION`：实高偏差过大，对照一代 `5-16`。
- `18-5 WEIGHT_SENSOR_SATURATION`：扭力传感器饱和，二代新增责任域。

## 协议29取消项

`12-11 ENCODER_INVALID_DATA` 的原实现只是编码器状态位检查后的不可达兜底，协议29已从CPU2/CPU3共享枚举、CPU2日志和CPU3显示中删除。协议29不保留旧码别名；历史设备或旧日志仍按产生该记录的CPU2程序版本解释。

## 协议30新增项

- `23-1`只表示ADC链路可信时检测到的真实24 V欠压，不再复用电机驱动类欠压码。
- `23-2`、`23-3`分别保留ADC溢出和DMA停止的首次原因；主循环最多局部恢复3次，恢复成功仍保留故障码。
- `23-4`用于启动或5 ms首样本失败；连续3次局部恢复失败后升级为`23-5`。
- `23-6`用于真实低压紧急保存未确认，或BOR/POR上电发现真实掉电回执与编码器A/B记录不一致、提交标记或CRC不完整；软件测试回执和非掉电复位不产生该码。
- 同一事件的当前对外故障只按`23-6 > 23-5 > 23-1 > 23-2／23-3 > 23-4`升级；首次原因和恢复原因仍保留在线程态诊断快照中。

## 协议18移出当前枚举

以下10项在 `历史故障代码_CPU2V1.25.0.0-V1.26.0.0` 中保留，当前开发版已用更具体的故障码替代。旧日志必须按当时CPU2版本解释；后续CPU2版本允许复用相同编号：

`MOTOR_ALARM_TRIGGERED`、`SENSOR_DEVICE_REPORTED_ERROR`、`MEASUREMENT_POSITION_ERROR`、`MEASUREMENT_TIMEOUT`、`AD5421_WRITE_CURRENT_ERROR`、`AD5421_FAULT_STATUS_ERROR`、`AD5421_READFAULT_ERROR`、`PARAM_ADDRESS_OVERFLOW`、`PARAM_ERROR`、`OTHER_PERIPHERAL_CONFIG_ERROR`。

## CPU2 V1.24.0.0历史页中的早期停用项

以下12项在协议17阶段已移出当前枚举，只保留在CPU2 V1.24.0.0历史页，和上面的协议18停用批次分开维护：

`MOTOR_FAIL_SETTING`、`MOTOR_RESET_FAIL`、`SLIPRING_BCC_ERROR`、`SLIPRING_PACKET_LOSS`、`SENSOR_TEMPERATURE_ERROR`、`SENSOR_VOLTAGE_ERROR`、`DENSITY_UNSTABLE`、`MEASUREMENT_DENSITY_RANGE_INVALID`、`AD5421_FAULT_PIN_ERROR`、`OTHER_UNKNOWN_ERROR`、`OTHER_ADDRESS_READ_ERROR`、`OTHER_POWER_FLUCTUATION`。

## 维护要求

1. 新增、拆分或调整共享故障码时，同步修改CPU2枚举和产生路径、CPU2日志名称和原因、CPU3枚举和显示、正式工作簿、内部技术工作簿及协议记录。
2. 具体故障已经能够判断时，不得再压缩成一个跨责任域或跨处理方式的通用码；同一代码允许覆盖的多个触发点必须具有相同现场含义和处理方式。
3. 新编号优先保持一代对照，但不得为了编号相似把不同责任域或不同处理方法合在一起。
4. 二代历史、保留和取消项目保留在对应CPU2版本页；后续版本可以复用相同编号，迁移关系追加到内部工作簿“编号迁移”表，现场不得脱离CPU2程序版本解释。
5. 共享故障码取值或解释变化时，同步提升 `DEVICE_PROTOCOL_VERSION`；现场选表仍按CPU2程序版本，不按共享协议版本替代。
6. 修改CPU3中文显示后检查字库；修改源码后运行故障码契约、相关专项检查和CPU2/CPU3构建。
7. 一代、CPU2 V1.24.0.0、CPU2 V1.25.0.0～V1.26.0.0和CPU2 V1.27.0.0历史页只按核验过的历史资料追加说明或勘误，不按当前源码反向改写。
