duanxuebin1998/cube/docs/00_构建与版本/故障码/故障码第3.2阶段日志增强清单.md

# 故障码第 3.2 阶段日志增强清单

更新日期：2026-07-12

> 历史快照：本文保留协议15、16阶段的调用点、日志编号和审批状态，不作为当前故障码表。现行协议34在协议30故障口径上启用12-6并新增12-17；拆分项、停用项和兼容关系见 `LTD内部技术与治理资料.xlsx` 的“编号迁移”工作表和《当前程序故障代码清单》。历史段落不随现行编号改写。

## 1. 范围和结论

本文承接 `故障码第3阶段调用点评审.md`，基于 2026-07-10 工作树快照扫描 8 个候选故障码的 CPU2 业务产生点。第 3.2 形成日志和治理清单时没有修改源码，也没有改变故障码数值、返回值、重试、停机、恢复、状态机、CPU3 显示或共享协议；后续四批源码治理已经完成，当前结果以交接计划为准。

本次共记录 166 个故障码产生函数组、238 个故障码产生语句；另有 15 个仅消费/比较/辅助引用组明确排除。行号和“待源码批次审批”状态均是 2026-07-10 清单快照，不代表当前待办；当前待办是 FI-01～FI-08 台架故障注入。

CPU3 本机扩展码在本阶段仍使用旧值 `CPU2_COMM_TIMEOUT = 0x0013000A`，不并入本清单的8个共享候选码。协议版本15曾将该码调整为 `0x000E000C`（屏幕 `14-12`）；协议版本16又随通信链路类别号互换调整为 `0x000D000C`（屏幕 `13-12`）。当前值以源码和《当前程序故障代码清单》为准。

当前编号对照如下。第5节逐调用点表仍保留重编号前的完整码、行号和“待源码批次审批”状态，用于审计当时的治理依据，不作为当前测试或售后查码依据。

| 快照候选 | 协议15当前编号 | 实施结果 |
| --- | --- | --- |
| `PARAM_ERROR` | 19-3 | 归入系统与软件类，名称调整为调用条件异常 |
| `PARAM_ADDRESS_OVERFLOW` | 19-2 | 归入系统与软件类，名称调整为数据位置异常 |
| `SENSOR_RESP_FORMAT_ERROR` | 14-3 | 保留传感器响应格式语义；UART传输和无线格式分别拆为14-4、14-11 |
| `MOTOR_TMC_COMM_ERROR` | 11-10 | 保留通信异常；TMC关键配置丢失拆为11-11 |
| `SENSOR_DEVICE_COMM_TIMEOUT` | 14-2 | 保留传感器通信超时；无线主机和从机超时继续使用14-9、14-10 |
| `OTHER_PERIPHERAL_CONFIG_ERROR` | 19-6 | 保留外部设备配置失败；UART和AD5421具体故障已回收到14类和16类 |
| `MEASUREMENT_POSITION_ERROR` | 15-1 | 归入测量流程类，名称调整为定位结果异常 |
| `AD5421_READFAULT_ERROR` | 16-4 | 归入模拟量输出类；读取成功但芯片主动报警拆为16-5 |

## 2. 扫描和排除口径

- 扫描范围：`LTD_MAIN_CPU2` 当前 `.c` 业务源码。
- 记录口径：按函数归并，同一函数内的每个产生语句行号全部保留。
- 排除 CPU2/CPU3 枚举定义、CPU2 日志名称/原因映射、CPU3 显示映射、历史注释和纯文档引用。
- `test.c` 诊断入口保留记录，但明确排除出现场日志源码实施批次。
- `ErrorLog_*` 检测以函数范围为线索；“函数内已有”不代表当前分支已经携带足够上下文，实施前仍需逐分支核对。

## 3. 候选码统计

| 故障码 | 业务函数组 | 产生语句 | 函数内已有 ErrorLog_* | 第 3.2 总结论 |
| --- | ---: | ---: | ---: | --- |
| `PARAM_ERROR` | 47 | 75 | 0 | 先补参数/配置上下文；内部调用优先内部诊断 |
| `PARAM_ADDRESS_OVERFLOW` | 50 | 51 | 5 | 真实地址边界保留，其余进入第3.3收窄候选 |
| `SENSOR_RESP_FORMAT_ERROR` | 21 | 41 | 0 | 解析错误保留，UART/DMA和无线边界待回收 |
| `MOTOR_TMC_COMM_ERROR` | 17 | 36 | 4 | 保持恢复大类，先补寄存器、方向和阶段 |
| `SENSOR_DEVICE_COMM_TIMEOUT` | 9 | 10 | 2 | 主传感器链路保留，无线边界复用专用码候选 |
| `OTHER_PERIPHERAL_CONFIG_ERROR` | 15 | 17 | 3 | 停止扩大兜底，按AD5421/传感器/校准责任域回收 |
| `MEASUREMENT_POSITION_ERROR` | 5 | 6 | 0 | 保持兼容，目标非法和到位校验作为条件拆分候选 |
| `AD5421_READFAULT_ERROR` | 2 | 2 | 0 | 区分访问失败和fault状态；先验证现有诊断快照 |

## 4. 源码实施安全边界

- `ErrorLog_*` 会直接打印；ISR 或 ISR 直接调用链只能记录标志/快照，由主循环或任务态延后输出。
- AD5421/AO 公共底层链可能由 PendSV 触发，禁止在底层 SPI/锁路径直接新增打印。
- TMC 日志不得改变电机停止、健康检查、驱动重初始化和恢复分类。
- 传感器/无线日志不得改变 UART/DMA 时序、接收缓冲、重试次数或部分帧判定。
- 参数/位置日志不得把用户配置、内部调用、目标规划和到位校验重新混成新的通用码。
- 最终报错继续由 `fault_manager` 统一出口负责；业务路径只补重试、恢复、警告或诊断上下文，避免重复最终报错。

## 5. 逐调用点清单

### 5.1 第一批：AD5421/AO

| ID | 故障码 | 源码位置 | 实际场景 | 当前日志 | 缺失上下文 | 建议日志 | 上下文风险 | 行为影响 | 治理结论 | 验证方法 | 状态 |
| --- | --- | --- | --- | --- | --- | --- | --- | --- | --- | --- | --- |
| P1-001 | 0x00110006 PARAM_ERROR | LTD_MAIN_CPU2/BSP/Peripherals/src/ad5421.c:AD5421_ReadRegCheckedRaw():176 | AD5421 内部寄存器读接口参数或输出指针非法 | 函数内未见 ErrorLog_* 或 printf | 参数名、输入/输出值、调用模块、失败前置条件 | 模块：调用模块；操作：参数校验；原因：配置或内部调用非法；字段：参数名、输入值、配置项、阶段 | PendSV/SPI/锁敏感；底层只保存快照，禁止直接打印，任务态延后输出 | 清单阶段无源码改动；后续实施必须保持返回值、重试、停机、恢复和状态机不变 | 内部诊断优先；暂不新增对外码 | 参数缺失、非法值和边界输入验证；核对最终错误出口 | 清单完成，待源码批次审批 |
| P1-002 | 0x00110006 PARAM_ERROR | LTD_MAIN_CPU2/BSP/Peripherals/src/ad5421.c:AD5421_ReadRegChecked():236 | AD5421 内部寄存器读接口参数或输出指针非法 | 函数内未见 ErrorLog_* 或 printf | 参数名、输入/输出值、调用模块、失败前置条件 | 模块：调用模块；操作：参数校验；原因：配置或内部调用非法；字段：参数名、输入值、配置项、阶段 | PendSV/SPI/锁敏感；底层只保存快照，禁止直接打印，任务态延后输出 | 清单阶段无源码改动；后续实施必须保持返回值、重试、停机、恢复和状态机不变 | 内部诊断优先；暂不新增对外码 | 参数缺失、非法值和边界输入验证；核对最终错误出口 | 清单完成，待源码批次审批 |
| P1-003 | 0x00110006 PARAM_ERROR | LTD_MAIN_CPU2/Services/AoOutput/ao_output.c:AoOutput_GetLevelRange():342 | AO 输出范围、目标选择或电流换算参数无效 | 函数内未见 ErrorLog_* 或 printf | 参数名、输入/输出值、调用模块、失败前置条件 | 模块：调用模块；操作：参数校验；原因：配置或内部调用非法；字段：参数名、输入值、配置项、阶段 | PendSV/SPI/锁敏感；底层只保存快照，禁止直接打印，任务态延后输出 | 清单阶段无源码改动；后续实施必须保持返回值、重试、停机、恢复和状态机不变 | 内部诊断优先；暂不新增对外码 | 参数缺失、非法值和边界输入验证；核对最终错误出口 | 清单完成，待源码批次审批 |
| P1-004 | 0x00110006 PARAM_ERROR | LTD_MAIN_CPU2/Services/AoOutput/ao_output.c:AoOutput_CalculateLevelCurrent():377 | AO 输出范围、目标选择或电流换算参数无效 | 函数内未见 ErrorLog_* 或 printf | 参数名、输入/输出值、调用模块、失败前置条件 | 模块：调用模块；操作：参数校验；原因：配置或内部调用非法；字段：参数名、输入值、配置项、阶段 | PendSV/SPI/锁敏感；底层只保存快照，禁止直接打印，任务态延后输出 | 清单阶段无源码改动；后续实施必须保持返回值、重试、停机、恢复和状态机不变 | 内部诊断优先；暂不新增对外码 | 参数缺失、非法值和边界输入验证；核对最终错误出口 | 清单完成，待源码批次审批 |
| P1-005 | 0x00110006 PARAM_ERROR | LTD_MAIN_CPU2/Services/AoOutput/ao_output.c:AoOutput_SelectTarget():477 | AO 输出范围、目标选择或电流换算参数无效 | 函数内未见 ErrorLog_* 或 printf | 参数名、输入/输出值、调用模块、失败前置条件 | 模块：调用模块；操作：参数校验；原因：配置或内部调用非法；字段：参数名、输入值、配置项、阶段 | PendSV/SPI/锁敏感；底层只保存快照，禁止直接打印，任务态延后输出 | 清单阶段无源码改动；后续实施必须保持返回值、重试、停机、恢复和状态机不变 | 内部诊断优先；暂不新增对外码 | 参数缺失、非法值和边界输入验证；核对最终错误出口 | 清单完成，待源码批次审批 |
| P1-006 | 0x00130004 OTHER_PERIPHERAL_CONFIG_ERROR | LTD_MAIN_CPU2/BSP/Peripherals/src/ad5421.c:AD5421_WriteRegRaw():157 | AD5421 SPI/锁/寄存器访问底层失败被归入外设配置兜底 | 函数内未见 ErrorLog_* 或 printf | 真实外设、操作阶段、SPI/UART/锁状态、底层返回值、配置项 | 模块：真实责任域；操作：外设启动/访问；原因：底层配置或通信失败；字段：外设、阶段、状态、返回值 | PendSV/SPI/锁敏感；底层只保存快照，禁止直接打印，任务态延后输出 | 清单阶段无源码改动；后续实施必须保持返回值、重试、停机、恢复和状态机不变 | AD5421责任域回收候选 | SPI/锁失败与fault位注入；核对任务态日志、错误码和AO恢复行为 | 清单完成，待源码批次审批 |
| P1-007 | 0x00130004 OTHER_PERIPHERAL_CONFIG_ERROR | LTD_MAIN_CPU2/BSP/Peripherals/src/ad5421.c:AD5421_ReadRegCheckedRaw():189,198 | AD5421 SPI/锁/寄存器访问底层失败被归入外设配置兜底 | 函数内未见 ErrorLog_* 或 printf | 真实外设、操作阶段、SPI/UART/锁状态、底层返回值、配置项 | 模块：真实责任域；操作：外设启动/访问；原因：底层配置或通信失败；字段：外设、阶段、状态、返回值 | PendSV/SPI/锁敏感；底层只保存快照，禁止直接打印，任务态延后输出 | 清单阶段无源码改动；后续实施必须保持返回值、重试、停机、恢复和状态机不变 | AD5421责任域回收候选 | SPI/锁失败与fault位注入；核对任务态日志、错误码和AO恢复行为 | 清单完成，待源码批次审批 |
| P1-008 | 0x00130004 OTHER_PERIPHERAL_CONFIG_ERROR | LTD_MAIN_CPU2/BSP/Peripherals/src/ad5421.c:AD5421_WriteReg():218 | AD5421 SPI/锁/寄存器访问底层失败被归入外设配置兜底 | 函数内未见 ErrorLog_* 或 printf | 真实外设、操作阶段、SPI/UART/锁状态、底层返回值、配置项 | 模块：真实责任域；操作：外设启动/访问；原因：底层配置或通信失败；字段：外设、阶段、状态、返回值 | PendSV/SPI/锁敏感；底层只保存快照，禁止直接打印，任务态延后输出 | 清单阶段无源码改动；后续实施必须保持返回值、重试、停机、恢复和状态机不变 | AD5421责任域回收候选 | SPI/锁失败与fault位注入；核对任务态日志、错误码和AO恢复行为 | 清单完成，待源码批次审批 |
| P1-009 | 0x00130004 OTHER_PERIPHERAL_CONFIG_ERROR | LTD_MAIN_CPU2/BSP/Peripherals/src/ad5421.c:AD5421_ReadRegChecked():241 | AD5421 SPI/锁/寄存器访问底层失败被归入外设配置兜底 | 函数内未见 ErrorLog_* 或 printf | 真实外设、操作阶段、SPI/UART/锁状态、底层返回值、配置项 | 模块：真实责任域；操作：外设启动/访问；原因：底层配置或通信失败；字段：外设、阶段、状态、返回值 | PendSV/SPI/锁敏感；底层只保存快照，禁止直接打印，任务态延后输出 | 清单阶段无源码改动；后续实施必须保持返回值、重试、停机、恢复和状态机不变 | AD5421责任域回收候选 | SPI/锁失败与fault位注入；核对任务态日志、错误码和AO恢复行为 | 清单完成，待源码批次审批 |
| P1-010 | 0x00130008 AD5421_READFAULT_ERROR | LTD_MAIN_CPU2/BSP/Peripherals/src/ad5421.c:AD5421_PollDiagnostics():340 | READFAULT 寄存器访问失败 | 函数内仅见 printf/调试输出，未见统一 ErrorLog_* | READFAULT 原值、SPI/锁返回、fault 位、诊断快照、访问阶段 | 模块：AO；操作：读取READFAULT；原因：访问失败或状态异常；字段：原值、fault位、底层返回 | PendSV/SPI/锁敏感；底层只保存快照，禁止直接打印，任务态延后输出 | 清单阶段无源码改动；后续实施必须保持返回值、重试、停机、恢复和状态机不变 | READFAULT通信失败拆分条件候选；先验证现有诊断快照 | SPI/锁失败与fault位注入；核对任务态日志、错误码和AO恢复行为 | 清单完成，待源码批次审批 |
| P1-011 | 0x00130008 AD5421_READFAULT_ERROR | LTD_MAIN_CPU2/BSP/Peripherals/src/ad5421.c:AD5421_PollDiagnostics():357 | READFAULT 读取成功但 fault 状态位异常 | 函数内仅见 printf/调试输出，未见统一 ErrorLog_* | READFAULT 原值、SPI/锁返回、fault 位、诊断快照、访问阶段 | 模块：AO；操作：解析READFAULT状态；原因：访问失败或状态异常；字段：原值、fault位、底层返回 | PendSV/SPI/锁敏感；底层只保存快照，禁止直接打印，任务态延后输出 | 清单阶段无源码改动；后续实施必须保持返回值、重试、停机、恢复和状态机不变 | fault状态异常拆分条件候选；先验证现有诊断快照 | SPI/锁失败与fault位注入；核对任务态日志、错误码和AO恢复行为 | 清单完成，待源码批次审批 |

### 5.2 第二批：TMC 电机驱动

| ID | 故障码 | 源码位置 | 实际场景 | 当前日志 | 缺失上下文 | 建议日志 | 上下文风险 | 行为影响 | 治理结论 | 验证方法 | 状态 |
| --- | --- | --- | --- | --- | --- | --- | --- | --- | --- | --- | --- |
| P2-001 | 0x000B000A MOTOR_TMC_COMM_ERROR | LTD_MAIN_CPU2/BSP/Peripherals/src/TMC5130.c:<global>():47 | TMC 寄存器访问宏的统一失败出口 | 函数内未见 ErrorLog_* 或 printf | 寄存器名/地址、读写方向、初始化或运行阶段、底层返回值、驱动状态 | 模块：电机；操作：TMC寄存器访问；原因：通信/状态失败；字段：寄存器、方向、阶段、返回值 | SPI和运动时序敏感；避免重复最终报错，不改变停机/恢复分类 | 清单阶段无源码改动；后续实施必须保持返回值、重试、停机、恢复和状态机不变 | 保持TMC恢复大类；先补寄存器/方向/阶段，不拆码 | TMC读/写/初始化失败注入；核对停机、重试、恢复和寄存器字段 | 清单完成，待源码批次审批 |
| P2-002 | 0x000B000A MOTOR_TMC_COMM_ERROR | LTD_MAIN_CPU2/BSP/Peripherals/src/TMC5130.c:stpr_stop():541 | TMC 寄存器读写、初始化、状态检查或运动等待失败 | 函数内未见 ErrorLog_* 或 printf | 寄存器名/地址、读写方向、初始化或运行阶段、底层返回值、驱动状态 | 模块：电机；操作：TMC寄存器访问；原因：通信/状态失败；字段：寄存器、方向、阶段、返回值 | SPI和运动时序敏感；避免重复最终报错，不改变停机/恢复分类 | 清单阶段无源码改动；后续实施必须保持返回值、重试、停机、恢复和状态机不变 | 保持TMC恢复大类；先补寄存器/方向/阶段，不拆码 | TMC读/写/初始化失败注入；核对停机、重试、恢复和寄存器字段 | 清单完成，待源码批次审批 |
| P2-003 | 0x000B000A MOTOR_TMC_COMM_ERROR | LTD_MAIN_CPU2/BSP/Peripherals/src/TMC5130.c:stpr_moveBy():581 | TMC 寄存器读写、初始化、状态检查或运动等待失败 | 函数内仅见 printf/调试输出，未见统一 ErrorLog_* | 寄存器名/地址、读写方向、初始化或运行阶段、底层返回值、驱动状态 | 模块：电机；操作：TMC寄存器访问；原因：通信/状态失败；字段：寄存器、方向、阶段、返回值 | SPI和运动时序敏感；避免重复最终报错，不改变停机/恢复分类 | 清单阶段无源码改动；后续实施必须保持返回值、重试、停机、恢复和状态机不变 | 保持TMC恢复大类；先补寄存器/方向/阶段，不拆码 | TMC读/写/初始化失败注入；核对停机、重试、恢复和寄存器字段 | 清单完成，待源码批次审批 |
| P2-004 | 0x000B000A MOTOR_TMC_COMM_ERROR | LTD_MAIN_CPU2/BSP/Peripherals/src/TMC5130.c:stpr_checkDriverStatus():651,666,679,744,751,776,795,808 | TMC 寄存器读写、初始化、状态检查或运动等待失败 | 函数内已有 ErrorLog_*；需确认是否覆盖本分支及关键字段 | 寄存器名/地址、读写方向、初始化或运行阶段、底层返回值、驱动状态 | 模块：电机；操作：TMC寄存器访问；原因：通信/状态失败；字段：寄存器、方向、阶段、返回值 | SPI和运动时序敏感；避免重复最终报错，不改变停机/恢复分类 | 清单阶段无源码改动；后续实施必须保持返回值、重试、停机、恢复和状态机不变 | 保持TMC恢复大类；先补寄存器/方向/阶段，不拆码 | TMC读/写/初始化失败注入；核对停机、重试、恢复和寄存器字段 | 清单完成，待源码批次审批 |
| P2-005 | 0x000B000A MOTOR_TMC_COMM_ERROR | LTD_MAIN_CPU2/BSP/Peripherals/src/TMC5130.c:stpr_checkDriverPowerReady():838 | TMC 寄存器读写、初始化、状态检查或运动等待失败 | 函数内已有 ErrorLog_*；需确认是否覆盖本分支及关键字段 | 寄存器名/地址、读写方向、初始化或运行阶段、底层返回值、驱动状态 | 模块：电机；操作：TMC寄存器访问；原因：通信/状态失败；字段：寄存器、方向、阶段、返回值 | SPI和运动时序敏感；避免重复最终报错，不改变停机/恢复分类 | 清单阶段无源码改动；后续实施必须保持返回值、重试、停机、恢复和状态机不变 | 保持TMC恢复大类；先补寄存器/方向/阶段，不拆码 | TMC读/写/初始化失败注入；核对停机、重试、恢复和寄存器字段 | 清单完成，待源码批次审批 |
| P2-006 | 0x000B000A MOTOR_TMC_COMM_ERROR | LTD_MAIN_CPU2/BSP/Peripherals/src/TMC5130.c:stpr_waitMove():877,889 | TMC 寄存器读写、初始化、状态检查或运动等待失败 | 函数内仅见 printf/调试输出，未见统一 ErrorLog_* | 寄存器名/地址、读写方向、初始化或运行阶段、底层返回值、驱动状态 | 模块：电机；操作：TMC寄存器访问；原因：通信/状态失败；字段：寄存器、方向、阶段、返回值 | SPI和运动时序敏感；避免重复最终报错，不改变停机/恢复分类 | 清单阶段无源码改动；后续实施必须保持返回值、重试、停机、恢复和状态机不变 | 保持TMC恢复大类；先补寄存器/方向/阶段，不拆码 | TMC读/写/初始化失败注入；核对停机、重试、恢复和寄存器字段 | 清单完成，待源码批次审批 |
| P2-007 | 0x000B000A MOTOR_TMC_COMM_ERROR | LTD_MAIN_CPU2/BSP/Peripherals/src/TMC5130.c:stpr_initStepper():1081 | TMC 寄存器读写、初始化、状态检查或运动等待失败 | 函数内仅见 printf/调试输出，未见统一 ErrorLog_* | 寄存器名/地址、读写方向、初始化或运行阶段、底层返回值、驱动状态 | 模块：电机；操作：TMC寄存器访问；原因：通信/状态失败；字段：寄存器、方向、阶段、返回值 | SPI和运动时序敏感；避免重复最终报错，不改变停机/恢复分类 | 清单阶段无源码改动；后续实施必须保持返回值、重试、停机、恢复和状态机不变 | 保持TMC恢复大类；先补寄存器/方向/阶段，不拆码 | TMC读/写/初始化失败注入；核对停机、重试、恢复和寄存器字段 | 清单完成，待源码批次审批 |
| P2-008 | 0x000B000A MOTOR_TMC_COMM_ERROR | LTD_MAIN_CPU2/Services/MotorControl/motor_ctrl_driver_param.c:MotorCtrl_BootSafeStop():106,112,115,119 | 电机驱动参数/运行状态读取阶段向上传递 TMC 访问失败 | 函数内仅见 printf/调试输出，未见统一 ErrorLog_* | 寄存器名/地址、读写方向、初始化或运行阶段、底层返回值、驱动状态 | 模块：电机；操作：TMC寄存器访问；原因：通信/状态失败；字段：寄存器、方向、阶段、返回值 | SPI和运动时序敏感；避免重复最终报错，不改变停机/恢复分类 | 清单阶段无源码改动；后续实施必须保持返回值、重试、停机、恢复和状态机不变 | 保持TMC恢复大类；先补寄存器/方向/阶段，不拆码 | TMC读/写/初始化失败注入；核对停机、重试、恢复和寄存器字段 | 清单完成，待源码批次审批 |
| P2-009 | 0x000B000A MOTOR_TMC_COMM_ERROR | LTD_MAIN_CPU2/Services/MotorControl/motor_ctrl_driver_param.c:MotorDriver_ClearInitResetFlag():243,256 | 电机驱动参数/运行状态读取阶段向上传递 TMC 访问失败 | 函数内仅见 printf/调试输出，未见统一 ErrorLog_* | 寄存器名/地址、读写方向、初始化或运行阶段、底层返回值、驱动状态 | 模块：电机；操作：TMC寄存器访问；原因：通信/状态失败；字段：寄存器、方向、阶段、返回值 | SPI和运动时序敏感；避免重复最终报错，不改变停机/恢复分类 | 清单阶段无源码改动；后续实施必须保持返回值、重试、停机、恢复和状态机不变 | 保持TMC恢复大类；先补寄存器/方向/阶段，不拆码 | TMC读/写/初始化失败注入；核对停机、重试、恢复和寄存器字段 | 清单完成，待源码批次审批 |
| P2-010 | 0x000B000A MOTOR_TMC_COMM_ERROR | LTD_MAIN_CPU2/Services/MotorControl/motor_ctrl_driver_param.c:MotorDriver_ReadTargetPositionOpen():440,443 | 电机驱动参数/运行状态读取阶段向上传递 TMC 访问失败 | 函数内未见 ErrorLog_* 或 printf | 寄存器名/地址、读写方向、初始化或运行阶段、底层返回值、驱动状态 | 模块：电机；操作：TMC寄存器访问；原因：通信/状态失败；字段：寄存器、方向、阶段、返回值 | SPI和运动时序敏感；避免重复最终报错，不改变停机/恢复分类 | 清单阶段无源码改动；后续实施必须保持返回值、重试、停机、恢复和状态机不变 | 保持TMC恢复大类；先补寄存器/方向/阶段，不拆码 | TMC读/写/初始化失败注入；核对停机、重试、恢复和寄存器字段 | 清单完成，待源码批次审批 |
| P2-011 | 0x000B000A MOTOR_TMC_COMM_ERROR | LTD_MAIN_CPU2/Services/MotorControl/motor_ctrl_driver_param.c:MotorDriver_AlignTargetToActual():470,473 | 电机驱动参数/运行状态读取阶段向上传递 TMC 访问失败 | 函数内未见 ErrorLog_* 或 printf | 寄存器名/地址、读写方向、初始化或运行阶段、底层返回值、驱动状态 | 模块：电机；操作：TMC寄存器访问；原因：通信/状态失败；字段：寄存器、方向、阶段、返回值 | SPI和运动时序敏感；避免重复最终报错，不改变停机/恢复分类 | 清单阶段无源码改动；后续实施必须保持返回值、重试、停机、恢复和状态机不变 | 保持TMC恢复大类；先补寄存器/方向/阶段，不拆码 | TMC读/写/初始化失败注入；核对停机、重试、恢复和寄存器字段 | 清单完成，待源码批次审批 |
| P2-012 | 0x000B000A MOTOR_TMC_COMM_ERROR | LTD_MAIN_CPU2/Services/MotorControl/motor_ctrl_driver_param.c:MotorDriver_ReadMovingState():805,815,823 | 电机驱动参数/运行状态读取阶段向上传递 TMC 访问失败 | 函数内未见 ErrorLog_* 或 printf | 寄存器名/地址、读写方向、初始化或运行阶段、底层返回值、驱动状态 | 模块：电机；操作：TMC寄存器访问；原因：通信/状态失败；字段：寄存器、方向、阶段、返回值 | SPI和运动时序敏感；避免重复最终报错，不改变停机/恢复分类 | 清单阶段无源码改动；后续实施必须保持返回值、重试、停机、恢复和状态机不变 | 保持TMC恢复大类；先补寄存器/方向/阶段，不拆码 | TMC读/写/初始化失败注入；核对停机、重试、恢复和寄存器字段 | 清单完成，待源码批次审批 |
| P2-013 | 0x000B000A MOTOR_TMC_COMM_ERROR | LTD_MAIN_CPU2/Services/MotorControl/motor_ctrl_driver_param.c:MotorDriver_ReadStoppingState():860,869,876 | 电机驱动参数/运行状态读取阶段向上传递 TMC 访问失败 | 函数内未见 ErrorLog_* 或 printf | 寄存器名/地址、读写方向、初始化或运行阶段、底层返回值、驱动状态 | 模块：电机；操作：TMC寄存器访问；原因：通信/状态失败；字段：寄存器、方向、阶段、返回值 | SPI和运动时序敏感；避免重复最终报错，不改变停机/恢复分类 | 清单阶段无源码改动；后续实施必须保持返回值、重试、停机、恢复和状态机不变 | 保持TMC恢复大类；先补寄存器/方向/阶段，不拆码 | TMC读/写/初始化失败注入；核对停机、重试、恢复和寄存器字段 | 清单完成，待源码批次审批 |
| P2-014 | 0x000B000A MOTOR_TMC_COMM_ERROR | LTD_MAIN_CPU2/Services/MotorControl/motor_ctrl_motion_api.c:MotorCtrl_MoveByTicksAndWait():257 | 运动控制流程向上传递 TMC 驱动通信失败 | 函数内已有 ErrorLog_*；需确认是否覆盖本分支及关键字段 | 寄存器名/地址、读写方向、初始化或运行阶段、底层返回值、驱动状态 | 模块：电机；操作：TMC寄存器访问；原因：通信/状态失败；字段：寄存器、方向、阶段、返回值 | SPI和运动时序敏感；避免重复最终报错，不改变停机/恢复分类 | 清单阶段无源码改动；后续实施必须保持返回值、重试、停机、恢复和状态机不变 | 保持TMC恢复大类；先补寄存器/方向/阶段，不拆码 | TMC读/写/初始化失败注入；核对停机、重试、恢复和寄存器字段 | 清单完成，待源码批次审批 |
| P2-015 | 0x000B000A MOTOR_TMC_COMM_ERROR | LTD_MAIN_CPU2/Services/MotorControl/motor_ctrl_motion_api.c:MotorMotion_WaitTicksReachTarget():1163 | 运动控制流程向上传递 TMC 驱动通信失败 | 函数内已有 ErrorLog_*；需确认是否覆盖本分支及关键字段 | 寄存器名/地址、读写方向、初始化或运行阶段、底层返回值、驱动状态 | 模块：电机；操作：TMC寄存器访问；原因：通信/状态失败；字段：寄存器、方向、阶段、返回值 | SPI和运动时序敏感；避免重复最终报错，不改变停机/恢复分类 | 清单阶段无源码改动；后续实施必须保持返回值、重试、停机、恢复和状态机不变 | 保持TMC恢复大类；先补寄存器/方向/阶段，不拆码 | TMC读/写/初始化失败注入；核对停机、重试、恢复和寄存器字段 | 清单完成，待源码批次审批 |
| P2-016 | 0x000B000A MOTOR_TMC_COMM_ERROR | LTD_MAIN_CPU2/Services/MotorControl/motor_ctrl_position_model.c:MotorCtrl_SwitchPositionSourceToMotor():450,535 | 位置源切换或持久化位置恢复时 TMC 读写失败 | 函数内仅见 printf/调试输出，未见统一 ErrorLog_* | 寄存器名/地址、读写方向、初始化或运行阶段、底层返回值、驱动状态 | 模块：电机；操作：TMC寄存器访问；原因：通信/状态失败；字段：寄存器、方向、阶段、返回值 | SPI和运动时序敏感；避免重复最终报错，不改变停机/恢复分类 | 清单阶段无源码改动；后续实施必须保持返回值、重试、停机、恢复和状态机不变 | 保持TMC恢复大类；先补寄存器/方向/阶段，不拆码 | TMC读/写/初始化失败注入；核对停机、重试、恢复和寄存器字段 | 清单完成，待源码批次审批 |
| P2-017 | 0x000B000A MOTOR_TMC_COMM_ERROR | LTD_MAIN_CPU2/Services/MotorControl/motor_ctrl_position_model.c:MotorPosition_RestorePersistedRegisters():887 | 位置源切换或持久化位置恢复时 TMC 读写失败 | 函数内仅见 printf/调试输出，未见统一 ErrorLog_* | 寄存器名/地址、读写方向、初始化或运行阶段、底层返回值、驱动状态 | 模块：电机；操作：TMC寄存器访问；原因：通信/状态失败；字段：寄存器、方向、阶段、返回值 | SPI和运动时序敏感；避免重复最终报错，不改变停机/恢复分类 | 清单阶段无源码改动；后续实施必须保持返回值、重试、停机、恢复和状态机不变 | 保持TMC恢复大类；先补寄存器/方向/阶段，不拆码 | TMC读/写/初始化失败注入；核对停机、重试、恢复和寄存器字段 | 清单完成，待源码批次审批 |

### 5.3 第三批：传感器和无线

| ID | 故障码 | 源码位置 | 实际场景 | 当前日志 | 缺失上下文 | 建议日志 | 上下文风险 | 行为影响 | 治理结论 | 验证方法 | 状态 |
| --- | --- | --- | --- | --- | --- | --- | --- | --- | --- | --- | --- |
| P3-001 | 0x000D000B SENSOR_RESP_FORMAT_ERROR | LTD_MAIN_CPU2/Services/Sensor/dsm_sensor_communication.c:UART6_StartTextReceiveDma():166 | UART/DMA 启动、完成状态、接收长度或部分帧异常 | 函数内未见 ErrorLog_* 或 printf | 协议类型、命令、接收长度、期望长度、解析字段、UART/DMA 状态、原始片段 | 模块：传感器/无线；操作：响应解析；原因：格式/硬件状态异常；字段：协议、长度、字段、DMA状态 | UART/DMA/重试时序敏感；ISR仅置标志，避免循环内高频打印 | 清单阶段无源码改动；后续实施必须保持返回值、重试、停机、恢复和状态机不变 | UART/DMA责任域回收候选；格式码暂不改 | 无响应/部分帧/格式错/UART错误注入；核对ISR边界和重试结果 | 清单完成，待源码批次审批 |
| P3-002 | 0x000D000B SENSOR_RESP_FORMAT_ERROR | LTD_MAIN_CPU2/Services/Sensor/dsm_sensor_communication.c:UART6_WaitTextReceiveDma():197,213,236,252 | UART/DMA 启动、完成状态、接收长度或部分帧异常 | 函数内未见 ErrorLog_* 或 printf | 协议类型、命令、接收长度、期望长度、解析字段、UART/DMA 状态、原始片段 | 模块：传感器/无线；操作：响应解析；原因：格式/硬件状态异常；字段：协议、长度、字段、DMA状态 | UART/DMA/重试时序敏感；ISR仅置标志，避免循环内高频打印 | 清单阶段无源码改动；后续实施必须保持返回值、重试、停机、恢复和状态机不变 | UART/DMA责任域回收候选；格式码暂不改 | 无响应/部分帧/格式错/UART错误注入；核对ISR边界和重试结果 | 清单完成，待源码批次审批 |
| P3-003 | 0x000D000B SENSOR_RESP_FORMAT_ERROR | LTD_MAIN_CPU2/Services/Sensor/dsm_sensor_communication.c:UART6_SendCommand():404,410 | UART/DMA 启动、完成状态、接收长度或部分帧异常 | 函数内仅见 printf/调试输出，未见统一 ErrorLog_* | 协议类型、命令、接收长度、期望长度、解析字段、UART/DMA 状态、原始片段 | 模块：传感器/无线；操作：响应解析；原因：格式/硬件状态异常；字段：协议、长度、字段、DMA状态 | UART/DMA/重试时序敏感；ISR仅置标志，避免循环内高频打印 | 清单阶段无源码改动；后续实施必须保持返回值、重试、停机、恢复和状态机不变 | UART/DMA责任域回收候选；格式码暂不改 | 无响应/部分帧/格式错/UART错误注入；核对ISR边界和重试结果 | 清单完成，待源码批次审批 |
| P3-004 | 0x000D000B SENSOR_RESP_FORMAT_ERROR | LTD_MAIN_CPU2/Services/Sensor/dsm_sensor_communication.c:Read_Sensor_Voltage():526 | 传感器响应长度、字段、校验或数值解析失败 | 函数内仅见 printf/调试输出，未见统一 ErrorLog_* | 协议类型、命令、接收长度、期望长度、解析字段、UART/DMA 状态、原始片段 | 模块：传感器/无线；操作：响应解析；原因：格式/硬件状态异常；字段：协议、长度、字段、DMA状态 | UART/DMA/重试时序敏感；ISR仅置标志，避免循环内高频打印 | 清单阶段无源码改动；后续实施必须保持返回值、重试、停机、恢复和状态机不变 | 保持传感器格式码并补解析上下文 | 无响应/部分帧/格式错/UART错误注入；核对ISR边界和重试结果 | 清单完成，待源码批次审批 |
| P3-005 | 0x000D000B SENSOR_RESP_FORMAT_ERROR | LTD_MAIN_CPU2/Services/Sensor/dsm_sensor_communication.c:Probe_EnableWaterSensor():546 | 传感器响应长度、字段、校验或数值解析失败 | 函数内仅见 printf/调试输出，未见统一 ErrorLog_* | 协议类型、命令、接收长度、期望长度、解析字段、UART/DMA 状态、原始片段 | 模块：传感器/无线；操作：响应解析；原因：格式/硬件状态异常；字段：协议、长度、字段、DMA状态 | UART/DMA/重试时序敏感；ISR仅置标志，避免循环内高频打印 | 清单阶段无源码改动；后续实施必须保持返回值、重试、停机、恢复和状态机不变 | 保持传感器格式码并补解析上下文 | 无响应/部分帧/格式错/UART错误注入；核对ISR边界和重试结果 | 清单完成，待源码批次审批 |
| P3-006 | 0x000D000B SENSOR_RESP_FORMAT_ERROR | LTD_MAIN_CPU2/Services/Sensor/dsm_sensor_communication.c:DSM_EnableLevelMode():570 | 传感器响应长度、字段、校验或数值解析失败 | 函数内仅见 printf/调试输出，未见统一 ErrorLog_* | 协议类型、命令、接收长度、期望长度、解析字段、UART/DMA 状态、原始片段 | 模块：传感器/无线；操作：响应解析；原因：格式/硬件状态异常；字段：协议、长度、字段、DMA状态 | UART/DMA/重试时序敏感；ISR仅置标志，避免循环内高频打印 | 清单阶段无源码改动；后续实施必须保持返回值、重试、停机、恢复和状态机不变 | 保持传感器格式码并补解析上下文 | 无响应/部分帧/格式错/UART错误注入；核对ISR边界和重试结果 | 清单完成，待源码批次审批 |
| P3-007 | 0x000D000B SENSOR_RESP_FORMAT_ERROR | LTD_MAIN_CPU2/Services/Sensor/dsm_sensor_communication.c:DSM_EnableDensityMode():594 | 传感器响应长度、字段、校验或数值解析失败 | 函数内仅见 printf/调试输出，未见统一 ErrorLog_* | 协议类型、命令、接收长度、期望长度、解析字段、UART/DMA 状态、原始片段 | 模块：传感器/无线；操作：响应解析；原因：格式/硬件状态异常；字段：协议、长度、字段、DMA状态 | UART/DMA/重试时序敏感；ISR仅置标志，避免循环内高频打印 | 清单阶段无源码改动；后续实施必须保持返回值、重试、停机、恢复和状态机不变 | 保持传感器格式码并补解析上下文 | 无响应/部分帧/格式错/UART错误注入；核对ISR边界和重试结果 | 清单完成，待源码批次审批 |
| P3-008 | 0x000D000B SENSOR_RESP_FORMAT_ERROR | LTD_MAIN_CPU2/Services/Sensor/dsm_sensor_communication.c:Read_Level_Frequency():640 | 传感器响应长度、字段、校验或数值解析失败 | 函数内仅见 printf/调试输出，未见统一 ErrorLog_* | 协议类型、命令、接收长度、期望长度、解析字段、UART/DMA 状态、原始片段 | 模块：传感器/无线；操作：响应解析；原因：格式/硬件状态异常；字段：协议、长度、字段、DMA状态 | UART/DMA/重试时序敏感；ISR仅置标志，避免循环内高频打印 | 清单阶段无源码改动；后续实施必须保持返回值、重试、停机、恢复和状态机不变 | 保持传感器格式码并补解析上下文 | 无响应/部分帧/格式错/UART错误注入；核对ISR边界和重试结果 | 清单完成，待源码批次审批 |
| P3-009 | 0x000D000B SENSOR_RESP_FORMAT_ERROR | LTD_MAIN_CPU2/Services/Sensor/dsm_sensor_communication.c:DSM_Read_Frequency_Density_Temp():671 | 传感器响应长度、字段、校验或数值解析失败 | 函数内未见 ErrorLog_* 或 printf | 协议类型、命令、接收长度、期望长度、解析字段、UART/DMA 状态、原始片段 | 模块：传感器/无线；操作：响应解析；原因：格式/硬件状态异常；字段：协议、长度、字段、DMA状态 | UART/DMA/重试时序敏感；ISR仅置标志，避免循环内高频打印 | 清单阶段无源码改动；后续实施必须保持返回值、重试、停机、恢复和状态机不变 | 保持传感器格式码并补解析上下文 | 无响应/部分帧/格式错/UART错误注入；核对ISR边界和重试结果 | 清单完成，待源码批次审批 |
| P3-010 | 0x000D000B SENSOR_RESP_FORMAT_ERROR | LTD_MAIN_CPU2/Services/Sensor/dsm_sensor_communication.c:Read_VibrationTube_ID():719,731 | 传感器响应长度、字段、校验或数值解析失败 | 函数内仅见 printf/调试输出，未见统一 ErrorLog_* | 协议类型、命令、接收长度、期望长度、解析字段、UART/DMA 状态、原始片段 | 模块：传感器/无线；操作：响应解析；原因：格式/硬件状态异常；字段：协议、长度、字段、DMA状态 | UART/DMA/重试时序敏感；ISR仅置标志，避免循环内高频打印 | 清单阶段无源码改动；后续实施必须保持返回值、重试、停机、恢复和状态机不变 | 保持传感器格式码并补解析上下文 | 无响应/部分帧/格式错/UART错误注入；核对ISR边界和重试结果 | 清单完成，待源码批次审批 |
| P3-011 | 0x000D000B SENSOR_RESP_FORMAT_ERROR | LTD_MAIN_CPU2/Services/Sensor/dsm_sensor_communication.c:Read_Water_Capacitance():773,778,781,784 | 传感器响应长度、字段、校验或数值解析失败 | 函数内未见 ErrorLog_* 或 printf | 协议类型、命令、接收长度、期望长度、解析字段、UART/DMA 状态、原始片段 | 模块：传感器/无线；操作：响应解析；原因：格式/硬件状态异常；字段：协议、长度、字段、DMA状态 | UART/DMA/重试时序敏感；ISR仅置标志，避免循环内高频打印 | 清单阶段无源码改动；后续实施必须保持返回值、重试、停机、恢复和状态机不变 | 保持传感器格式码并补解析上下文 | 无响应/部分帧/格式错/UART错误注入；核对ISR边界和重试结果 | 清单完成，待源码批次审批 |
| P3-012 | 0x000D000B SENSOR_RESP_FORMAT_ERROR | LTD_MAIN_CPU2/Services/Sensor/dsm_sensor_communication.c:Read_Gyro_Angle():856,864 | 传感器响应长度、字段、校验或数值解析失败 | 函数内未见 ErrorLog_* 或 printf | 协议类型、命令、接收长度、期望长度、解析字段、UART/DMA 状态、原始片段 | 模块：传感器/无线；操作：响应解析；原因：格式/硬件状态异常；字段：协议、长度、字段、DMA状态 | UART/DMA/重试时序敏感；ISR仅置标志，避免循环内高频打印 | 清单阶段无源码改动；后续实施必须保持返回值、重试、停机、恢复和状态机不变 | 保持传感器格式码并补解析上下文 | 无响应/部分帧/格式错/UART错误注入；核对ISR边界和重试结果 | 清单完成，待源码批次审批 |
| P3-013 | 0x000D000B SENSOR_RESP_FORMAT_ERROR | LTD_MAIN_CPU2/Services/Sensor/ltd_sensor_communication.c:DSM_V2_StartFixedReceiveDma():139 | UART/DMA 启动、完成状态、接收长度或部分帧异常 | 函数内未见 ErrorLog_* 或 printf | 协议类型、命令、接收长度、期望长度、解析字段、UART/DMA 状态、原始片段 | 模块：传感器/无线；操作：响应解析；原因：格式/硬件状态异常；字段：协议、长度、字段、DMA状态 | UART/DMA/重试时序敏感；ISR仅置标志，避免循环内高频打印 | 清单阶段无源码改动；后续实施必须保持返回值、重试、停机、恢复和状态机不变 | UART/DMA责任域回收候选；格式码暂不改 | 无响应/部分帧/格式错/UART错误注入；核对ISR边界和重试结果 | 清单完成，待源码批次审批 |
| P3-014 | 0x000D000B SENSOR_RESP_FORMAT_ERROR | LTD_MAIN_CPU2/Services/Sensor/ltd_sensor_communication.c:DSM_V2_WaitFixedReceiveDma():165,179,198 | UART/DMA 启动、完成状态、接收长度或部分帧异常 | 函数内未见 ErrorLog_* 或 printf | 协议类型、命令、接收长度、期望长度、解析字段、UART/DMA 状态、原始片段 | 模块：传感器/无线；操作：响应解析；原因：格式/硬件状态异常；字段：协议、长度、字段、DMA状态 | UART/DMA/重试时序敏感；ISR仅置标志，避免循环内高频打印 | 清单阶段无源码改动；后续实施必须保持返回值、重试、停机、恢复和状态机不变 | UART/DMA责任域回收候选；格式码暂不改 | 无响应/部分帧/格式错/UART错误注入；核对ISR边界和重试结果 | 清单完成，待源码批次审批 |
| P3-015 | 0x000D000B SENSOR_RESP_FORMAT_ERROR | LTD_MAIN_CPU2/Services/Sensor/ltd_sensor_communication.c:DSM_V2_CheckReply():265,276 | 传感器响应长度、字段、校验或数值解析失败 | 函数内仅见 printf/调试输出，未见统一 ErrorLog_* | 协议类型、命令、接收长度、期望长度、解析字段、UART/DMA 状态、原始片段 | 模块：传感器/无线；操作：响应解析；原因：格式/硬件状态异常；字段：协议、长度、字段、DMA状态 | UART/DMA/重试时序敏感；ISR仅置标志，避免循环内高频打印 | 清单阶段无源码改动；后续实施必须保持返回值、重试、停机、恢复和状态机不变 | 保持传感器格式码并补解析上下文 | 无响应/部分帧/格式错/UART错误注入；核对ISR边界和重试结果 | 清单完成，待源码批次审批 |
| P3-016 | 0x000D000B SENSOR_RESP_FORMAT_ERROR | LTD_MAIN_CPU2/Services/Sensor/sensor.c:Sensor_ParseDsmTextId():183,192 | 传感器响应长度、字段、校验或数值解析失败 | 函数内未见 ErrorLog_* 或 printf | 协议类型、命令、接收长度、期望长度、解析字段、UART/DMA 状态、原始片段 | 模块：传感器/无线；操作：响应解析；原因：格式/硬件状态异常；字段：协议、长度、字段、DMA状态 | UART/DMA/重试时序敏感；ISR仅置标志，避免循环内高频打印 | 清单阶段无源码改动；后续实施必须保持返回值、重试、停机、恢复和状态机不变 | 保持传感器格式码并补解析上下文 | 无响应/部分帧/格式错/UART错误注入；核对ISR边界和重试结果 | 清单完成，待源码批次审批 |
| P3-017 | 0x000D000B SENSOR_RESP_FORMAT_ERROR | LTD_MAIN_CPU2/Services/Sensor/wireless_pairing.c:WirelessPairing_PublishStatus():640,655 | CH9141/无线 AT 响应或状态字段解析失败 | 函数内未见 ErrorLog_* 或 printf | 协议类型、命令、接收长度、期望长度、解析字段、UART/DMA 状态、原始片段 | 模块：传感器/无线；操作：响应解析；原因：格式/硬件状态异常；字段：协议、长度、字段、DMA状态 | UART/DMA/重试时序敏感；ISR仅置标志，避免循环内高频打印 | 清单阶段无源码改动；后续实施必须保持返回值、重试、停机、恢复和状态机不变 | 无线责任域回收候选；先补AT上下文 | 无响应/部分帧/格式错/UART错误注入；核对ISR边界和重试结果 | 清单完成，待源码批次审批 |
| P3-018 | 0x000D000B SENSOR_RESP_FORMAT_ERROR | LTD_MAIN_CPU2/Services/Sensor/wireless_pairing.c:WirelessPairing_EnterAtAndHostMode():1213 | CH9141/无线 AT 响应或状态字段解析失败 | 函数内仅见 printf/调试输出，未见统一 ErrorLog_* | 协议类型、命令、接收长度、期望长度、解析字段、UART/DMA 状态、原始片段 | 模块：传感器/无线；操作：响应解析；原因：格式/硬件状态异常；字段：协议、长度、字段、DMA状态 | UART/DMA/重试时序敏感；ISR仅置标志，避免循环内高频打印 | 清单阶段无源码改动；后续实施必须保持返回值、重试、停机、恢复和状态机不变 | 无线责任域回收候选；先补AT上下文 | 无响应/部分帧/格式错/UART错误注入；核对ISR边界和重试结果 | 清单完成，待源码批次审批 |
| P3-019 | 0x000D000B SENSOR_RESP_FORMAT_ERROR | LTD_MAIN_CPU2/Services/Sensor/wireless_pairing.c:WirelessPairing_ReadConnectionStatus():1578,1592,1621,1641 | CH9141/无线 AT 响应或状态字段解析失败 | 函数内仅见 printf/调试输出，未见统一 ErrorLog_* | 协议类型、命令、接收长度、期望长度、解析字段、UART/DMA 状态、原始片段 | 模块：传感器/无线；操作：响应解析；原因：格式/硬件状态异常；字段：协议、长度、字段、DMA状态 | UART/DMA/重试时序敏感；ISR仅置标志，避免循环内高频打印 | 清单阶段无源码改动；后续实施必须保持返回值、重试、停机、恢复和状态机不变 | 无线责任域回收候选；先补AT上下文 | 无响应/部分帧/格式错/UART错误注入；核对ISR边界和重试结果 | 清单完成，待源码批次审批 |
| P3-020 | 0x000D000B SENSOR_RESP_FORMAT_ERROR | LTD_MAIN_CPU2/Services/Sensor/wireless_pairing.c:WirelessPairing_PrintConnectionStatus():1742,1761,1790,1820 | CH9141/无线 AT 响应或状态字段解析失败 | 函数内仅见 printf/调试输出，未见统一 ErrorLog_* | 协议类型、命令、接收长度、期望长度、解析字段、UART/DMA 状态、原始片段 | 模块：传感器/无线；操作：响应解析；原因：格式/硬件状态异常；字段：协议、长度、字段、DMA状态 | UART/DMA/重试时序敏感；ISR仅置标志，避免循环内高频打印 | 清单阶段无源码改动；后续实施必须保持返回值、重试、停机、恢复和状态机不变 | 无线责任域回收候选；先补AT上下文 | 无响应/部分帧/格式错/UART错误注入；核对ISR边界和重试结果 | 清单完成，待源码批次审批 |
| P3-021 | 0x000D000B SENSOR_RESP_FORMAT_ERROR | LTD_MAIN_CPU2/Services/Sensor/wireless_pairing.c:WirelessPairing_RunByName():1977 | CH9141/无线 AT 响应或状态字段解析失败 | 函数内仅见 printf/调试输出，未见统一 ErrorLog_* | 协议类型、命令、接收长度、期望长度、解析字段、UART/DMA 状态、原始片段 | 模块：传感器/无线；操作：响应解析；原因：格式/硬件状态异常；字段：协议、长度、字段、DMA状态 | UART/DMA/重试时序敏感；ISR仅置标志，避免循环内高频打印 | 清单阶段无源码改动；后续实施必须保持返回值、重试、停机、恢复和状态机不变 | 无线责任域回收候选；先补AT上下文 | 无响应/部分帧/格式错/UART错误注入；核对ISR边界和重试结果 | 清单完成，待源码批次审批 |
| P3-022 | 0x000D0003 SENSOR_DEVICE_COMM_TIMEOUT | LTD_MAIN_CPU2/Services/Sensor/ch9141_at.c:CH9141_AT_CollectResponse():491 | 无线/AT 响应等待超时 | 函数内未见 ErrorLog_* 或 printf | 链路类型、TX/RX 阶段、已收字节数、期望长度、尝试次数、UART 状态 | 模块：传感器/无线；操作：发送或等待响应；原因：通信超时；字段：链路、字节数、尝试、UART状态 | UART/DMA/重试时序敏感；ISR仅置标志，避免循环内高频打印 | 清单阶段无源码改动；后续实施必须保持返回值、重试、停机、恢复和状态机不变 | 复用无线主机/从机专用超时码候选 | 无响应/部分帧/格式错/UART错误注入；核对ISR边界和重试结果 | 清单完成，待源码批次审批 |
| P3-023 | 0x000D0003 SENSOR_DEVICE_COMM_TIMEOUT | LTD_MAIN_CPU2/Services/Sensor/dsm_sensor_communication.c:UART6_WaitTransmitDmaDone():153 | UART DMA 发送完成等待超时 | 函数内未见 ErrorLog_* 或 printf | 链路类型、TX/RX 阶段、已收字节数、期望长度、尝试次数、UART 状态 | 模块：传感器/无线；操作：发送或等待响应；原因：通信超时；字段：链路、字节数、尝试、UART状态 | UART/DMA/重试时序敏感；ISR仅置标志，避免循环内高频打印 | 清单阶段无源码改动；后续实施必须保持返回值、重试、停机、恢复和状态机不变 | 保持传感器主链路超时码并补链路上下文 | 无响应/部分帧/格式错/UART错误注入；核对ISR边界和重试结果 | 清单完成，待源码批次审批 |
| P3-024 | 0x000D0003 SENSOR_DEVICE_COMM_TIMEOUT | LTD_MAIN_CPU2/Services/Sensor/dsm_sensor_communication.c:UART6_WaitTextReceiveDma():252 | 接收窗口无有效字节或未形成完整响应 | 函数内未见 ErrorLog_* 或 printf | 链路类型、TX/RX 阶段、已收字节数、期望长度、尝试次数、UART 状态 | 模块：传感器/无线；操作：发送或等待响应；原因：通信超时；字段：链路、字节数、尝试、UART状态 | UART/DMA/重试时序敏感；ISR仅置标志，避免循环内高频打印 | 清单阶段无源码改动；后续实施必须保持返回值、重试、停机、恢复和状态机不变 | 保持传感器主链路超时码并补链路上下文 | 无响应/部分帧/格式错/UART错误注入；核对ISR边界和重试结果 | 清单完成，待源码批次审批 |
| P3-025 | 0x000D0003 SENSOR_DEVICE_COMM_TIMEOUT | LTD_MAIN_CPU2/Services/Sensor/dsm_sensor_communication.c:UART6_SendCommand():407 | 传感器主链路无响应或重试后仍超时 | 函数内仅见 printf/调试输出，未见统一 ErrorLog_* | 链路类型、TX/RX 阶段、已收字节数、期望长度、尝试次数、UART 状态 | 模块：传感器/无线；操作：发送或等待响应；原因：通信超时；字段：链路、字节数、尝试、UART状态 | UART/DMA/重试时序敏感；ISR仅置标志，避免循环内高频打印 | 清单阶段无源码改动；后续实施必须保持返回值、重试、停机、恢复和状态机不变 | 保持传感器主链路超时码并补链路上下文 | 无响应/部分帧/格式错/UART错误注入；核对ISR边界和重试结果 | 清单完成，待源码批次审批 |
| P3-026 | 0x000D0003 SENSOR_DEVICE_COMM_TIMEOUT | LTD_MAIN_CPU2/Services/Sensor/dsm_sensor_communication.c:UART6_SendWithRetry():440 | 传感器主链路无响应或重试后仍超时 | 函数内已有 ErrorLog_*；需确认是否覆盖本分支及关键字段 | 链路类型、TX/RX 阶段、已收字节数、期望长度、尝试次数、UART 状态 | 模块：传感器/无线；操作：发送或等待响应；原因：通信超时；字段：链路、字节数、尝试、UART状态 | UART/DMA/重试时序敏感；ISR仅置标志，避免循环内高频打印 | 清单阶段无源码改动；后续实施必须保持返回值、重试、停机、恢复和状态机不变 | 保持传感器主链路超时码并补链路上下文 | 无响应/部分帧/格式错/UART错误注入；核对ISR边界和重试结果 | 清单完成，待源码批次审批 |
| P3-027 | 0x000D0003 SENSOR_DEVICE_COMM_TIMEOUT | LTD_MAIN_CPU2/Services/Sensor/ltd_sensor_communication.c:DSM_V2_WaitTransmitDmaDone():126 | UART DMA 发送完成等待超时 | 函数内未见 ErrorLog_* 或 printf | 链路类型、TX/RX 阶段、已收字节数、期望长度、尝试次数、UART 状态 | 模块：传感器/无线；操作：发送或等待响应；原因：通信超时；字段：链路、字节数、尝试、UART状态 | UART/DMA/重试时序敏感；ISR仅置标志，避免循环内高频打印 | 清单阶段无源码改动；后续实施必须保持返回值、重试、停机、恢复和状态机不变 | 保持传感器主链路超时码并补链路上下文 | 无响应/部分帧/格式错/UART错误注入；核对ISR边界和重试结果 | 清单完成，待源码批次审批 |
| P3-028 | 0x000D0003 SENSOR_DEVICE_COMM_TIMEOUT | LTD_MAIN_CPU2/Services/Sensor/ltd_sensor_communication.c:DSM_V2_WaitFixedReceiveDma():198 | 接收窗口无有效字节或未形成完整响应 | 函数内未见 ErrorLog_* 或 printf | 链路类型、TX/RX 阶段、已收字节数、期望长度、尝试次数、UART 状态 | 模块：传感器/无线；操作：发送或等待响应；原因：通信超时；字段：链路、字节数、尝试、UART状态 | UART/DMA/重试时序敏感；ISR仅置标志，避免循环内高频打印 | 清单阶段无源码改动；后续实施必须保持返回值、重试、停机、恢复和状态机不变 | 保持传感器主链路超时码并补链路上下文 | 无响应/部分帧/格式错/UART错误注入；核对ISR边界和重试结果 | 清单完成，待源码批次审批 |
| P3-029 | 0x000D0003 SENSOR_DEVICE_COMM_TIMEOUT | LTD_MAIN_CPU2/Services/Sensor/sensor.c:Sensor_SelectProbeError():48,49 | LTD/DSM 双探头通信结果汇总后的超时选择 | 函数内未见 ErrorLog_* 或 printf | 链路类型、TX/RX 阶段、已收字节数、期望长度、尝试次数、UART 状态 | 模块：传感器/无线；操作：发送或等待响应；原因：通信超时；字段：链路、字节数、尝试、UART状态 | UART/DMA/重试时序敏感；ISR仅置标志，避免循环内高频打印 | 清单阶段无源码改动；后续实施必须保持返回值、重试、停机、恢复和状态机不变 | 保持传感器主链路超时码并补链路上下文 | 无响应/部分帧/格式错/UART错误注入；核对ISR边界和重试结果 | 清单完成，待源码批次审批 |
| P3-030 | 0x000D0003 SENSOR_DEVICE_COMM_TIMEOUT | LTD_MAIN_CPU2/Services/Sensor/sensor.c:Sensor_DiagnoseCommTimeout():115 | 传感器主链路无响应或重试后仍超时 | 函数内已有 ErrorLog_*；需确认是否覆盖本分支及关键字段 | 链路类型、TX/RX 阶段、已收字节数、期望长度、尝试次数、UART 状态 | 模块：传感器/无线；操作：发送或等待响应；原因：通信超时；字段：链路、字节数、尝试、UART状态 | UART/DMA/重试时序敏感；ISR仅置标志，避免循环内高频打印 | 清单阶段无源码改动；后续实施必须保持返回值、重试、停机、恢复和状态机不变 | 保持传感器主链路超时码并补链路上下文 | 无响应/部分帧/格式错/UART错误注入；核对ISR边界和重试结果 | 清单完成，待源码批次审批 |
| P3-031 | 0x00130004 OTHER_PERIPHERAL_CONFIG_ERROR | LTD_MAIN_CPU2/Services/Sensor/ch9141_at.c:CH9141_AT_SendCommand():663,670 | CH9141/无线 UART 启动或发送失败被归入外设配置兜底 | 函数内仅见 printf/调试输出，未见统一 ErrorLog_* | 真实外设、操作阶段、SPI/UART/锁状态、底层返回值、配置项 | 模块：真实责任域；操作：外设启动/访问；原因：底层配置或通信失败；字段：外设、阶段、状态、返回值 | UART/DMA/重试时序敏感；ISR仅置标志，避免循环内高频打印 | 清单阶段无源码改动；后续实施必须保持返回值、重试、停机、恢复和状态机不变 | 传感器/无线责任域回收候选 | 无响应/部分帧/格式错/UART错误注入；核对ISR边界和重试结果 | 清单完成，待源码批次审批 |
| P3-032 | 0x00130004 OTHER_PERIPHERAL_CONFIG_ERROR | LTD_MAIN_CPU2/Services/Sensor/dsm_sensor_communication.c:UART6_WaitTransmitDmaDone():146 | 传感器 UART/DMA 启动、发送或模式切换失败被归入兜底 | 函数内未见 ErrorLog_* 或 printf | 真实外设、操作阶段、SPI/UART/锁状态、底层返回值、配置项 | 模块：真实责任域；操作：外设启动/访问；原因：底层配置或通信失败；字段：外设、阶段、状态、返回值 | UART/DMA/重试时序敏感；ISR仅置标志，避免循环内高频打印 | 清单阶段无源码改动；后续实施必须保持返回值、重试、停机、恢复和状态机不变 | 传感器/无线责任域回收候选 | 无响应/部分帧/格式错/UART错误注入；核对ISR边界和重试结果 | 清单完成，待源码批次审批 |
| P3-033 | 0x00130004 OTHER_PERIPHERAL_CONFIG_ERROR | LTD_MAIN_CPU2/Services/Sensor/dsm_sensor_communication.c:UART6_StartTextReceiveDma():179 | 传感器 UART/DMA 启动、发送或模式切换失败被归入兜底 | 函数内未见 ErrorLog_* 或 printf | 真实外设、操作阶段、SPI/UART/锁状态、底层返回值、配置项 | 模块：真实责任域；操作：外设启动/访问；原因：底层配置或通信失败；字段：外设、阶段、状态、返回值 | UART/DMA/重试时序敏感；ISR仅置标志，避免循环内高频打印 | 清单阶段无源码改动；后续实施必须保持返回值、重试、停机、恢复和状态机不变 | 传感器/无线责任域回收候选 | 无响应/部分帧/格式错/UART错误注入；核对ISR边界和重试结果 | 清单完成，待源码批次审批 |
| P3-034 | 0x00130004 OTHER_PERIPHERAL_CONFIG_ERROR | LTD_MAIN_CPU2/Services/Sensor/dsm_sensor_communication.c:UART6_SendCommand():375 | 传感器 UART/DMA 启动、发送或模式切换失败被归入兜底 | 函数内仅见 printf/调试输出，未见统一 ErrorLog_* | 真实外设、操作阶段、SPI/UART/锁状态、底层返回值、配置项 | 模块：真实责任域；操作：外设启动/访问；原因：底层配置或通信失败；字段：外设、阶段、状态、返回值 | UART/DMA/重试时序敏感；ISR仅置标志，避免循环内高频打印 | 清单阶段无源码改动；后续实施必须保持返回值、重试、停机、恢复和状态机不变 | 传感器/无线责任域回收候选 | 无响应/部分帧/格式错/UART错误注入；核对ISR边界和重试结果 | 清单完成，待源码批次审批 |
| P3-035 | 0x00130004 OTHER_PERIPHERAL_CONFIG_ERROR | LTD_MAIN_CPU2/Services/Sensor/ltd_sensor_communication.c:DSM_V2_WaitTransmitDmaDone():119 | 传感器 UART/DMA 启动、发送或模式切换失败被归入兜底 | 函数内未见 ErrorLog_* 或 printf | 真实外设、操作阶段、SPI/UART/锁状态、底层返回值、配置项 | 模块：真实责任域；操作：外设启动/访问；原因：底层配置或通信失败；字段：外设、阶段、状态、返回值 | UART/DMA/重试时序敏感；ISR仅置标志，避免循环内高频打印 | 清单阶段无源码改动；后续实施必须保持返回值、重试、停机、恢复和状态机不变 | 传感器/无线责任域回收候选 | 无响应/部分帧/格式错/UART错误注入；核对ISR边界和重试结果 | 清单完成，待源码批次审批 |
| P3-036 | 0x00130004 OTHER_PERIPHERAL_CONFIG_ERROR | LTD_MAIN_CPU2/Services/Sensor/ltd_sensor_communication.c:DSM_V2_StartFixedReceiveDma():149 | 传感器 UART/DMA 启动、发送或模式切换失败被归入兜底 | 函数内未见 ErrorLog_* 或 printf | 真实外设、操作阶段、SPI/UART/锁状态、底层返回值、配置项 | 模块：真实责任域；操作：外设启动/访问；原因：底层配置或通信失败；字段：外设、阶段、状态、返回值 | UART/DMA/重试时序敏感；ISR仅置标志，避免循环内高频打印 | 清单阶段无源码改动；后续实施必须保持返回值、重试、停机、恢复和状态机不变 | 传感器/无线责任域回收候选 | 无响应/部分帧/格式错/UART错误注入；核对ISR边界和重试结果 | 清单完成，待源码批次审批 |
| P3-037 | 0x00130004 OTHER_PERIPHERAL_CONFIG_ERROR | LTD_MAIN_CPU2/Services/Sensor/ltd_sensor_communication.c:DSM_V2_Transceive():226 | 传感器 UART/DMA 启动、发送或模式切换失败被归入兜底 | 函数内仅见 printf/调试输出，未见统一 ErrorLog_* | 真实外设、操作阶段、SPI/UART/锁状态、底层返回值、配置项 | 模块：真实责任域；操作：外设启动/访问；原因：底层配置或通信失败；字段：外设、阶段、状态、返回值 | UART/DMA/重试时序敏感；ISR仅置标志，避免循环内高频打印 | 清单阶段无源码改动；后续实施必须保持返回值、重试、停机、恢复和状态机不变 | 传感器/无线责任域回收候选 | 无响应/部分帧/格式错/UART错误注入；核对ISR边界和重试结果 | 清单完成，待源码批次审批 |
| P3-038 | 0x00130004 OTHER_PERIPHERAL_CONFIG_ERROR | LTD_MAIN_CPU2/Services/Sensor/ltd_sensor_communication.c:DSM_V2_SwitchMode():298 | 传感器 UART/DMA 启动、发送或模式切换失败被归入兜底 | 函数内已有 ErrorLog_*；需确认是否覆盖本分支及关键字段 | 真实外设、操作阶段、SPI/UART/锁状态、底层返回值、配置项 | 模块：真实责任域；操作：外设启动/访问；原因：底层配置或通信失败；字段：外设、阶段、状态、返回值 | UART/DMA/重试时序敏感；ISR仅置标志，避免循环内高频打印 | 清单阶段无源码改动；后续实施必须保持返回值、重试、停机、恢复和状态机不变 | 传感器/无线责任域回收候选 | 无响应/部分帧/格式错/UART错误注入；核对ISR边界和重试结果 | 清单完成，待源码批次审批 |
| P3-039 | 0x00130004 OTHER_PERIPHERAL_CONFIG_ERROR | LTD_MAIN_CPU2/Services/Sensor/ltd_sensor_communication.c:DSM_V2_Read_FloatParam():384 | 传感器 UART/DMA 启动、发送或模式切换失败被归入兜底 | 函数内已有 ErrorLog_*；需确认是否覆盖本分支及关键字段 | 真实外设、操作阶段、SPI/UART/锁状态、底层返回值、配置项 | 模块：真实责任域；操作：外设启动/访问；原因：底层配置或通信失败；字段：外设、阶段、状态、返回值 | UART/DMA/重试时序敏感；ISR仅置标志，避免循环内高频打印 | 清单阶段无源码改动；后续实施必须保持返回值、重试、停机、恢复和状态机不变 | 传感器/无线责任域回收候选 | 无响应/部分帧/格式错/UART错误注入；核对ISR边界和重试结果 | 清单完成，待源码批次审批 |
| P3-040 | 0x00130004 OTHER_PERIPHERAL_CONFIG_ERROR | LTD_MAIN_CPU2/Services/Sensor/ltd_sensor_communication.c:DSM_V2_Read_IntParamInternal():466 | 传感器 UART/DMA 启动、发送或模式切换失败被归入兜底 | 函数内已有 ErrorLog_*；需确认是否覆盖本分支及关键字段 | 真实外设、操作阶段、SPI/UART/锁状态、底层返回值、配置项 | 模块：真实责任域；操作：外设启动/访问；原因：底层配置或通信失败；字段：外设、阶段、状态、返回值 | UART/DMA/重试时序敏感；ISR仅置标志，避免循环内高频打印 | 清单阶段无源码改动；后续实施必须保持返回值、重试、停机、恢复和状态机不变 | 传感器/无线责任域回收候选 | 无响应/部分帧/格式错/UART错误注入；核对ISR边界和重试结果 | 清单完成，待源码批次审批 |

### 5.4 第四批：参数、测量和位置

| ID | 故障码 | 源码位置 | 实际场景 | 当前日志 | 缺失上下文 | 建议日志 | 上下文风险 | 行为影响 | 治理结论 | 验证方法 | 状态 |
| --- | --- | --- | --- | --- | --- | --- | --- | --- | --- | --- | --- |
| P4-001 | 0x00110006 PARAM_ERROR | LTD_MAIN_CPU2/Application/Src/measure.c:CMD_CalibrateTankHeight():40,52 | 标定配置缺失、标定结果或测量参数非法 | 函数内仅见 printf/调试输出，未见统一 ErrorLog_* | 配置项、输入值、测量方法、上下限、调用阶段 | 模块：调用模块；操作：参数校验；原因：配置或内部调用非法；字段：参数名、输入值、配置项、阶段 | 测量/运动状态机敏感；不得改变返回值、重试、错误置位或状态切换 | 清单阶段无源码改动；后续实施必须保持返回值、重试、停机、恢复和状态机不变 | 保持现码并补配置上下文；配置缺失可列拆分条件候选 | 参数缺失、非法值和边界输入验证；核对最终错误出口 | 清单完成，待源码批次审批 |
| P4-002 | 0x00110006 PARAM_ERROR | LTD_MAIN_CPU2/Application/Src/measure_oilLevel.c:DensityLevel_RunClosedLoop():473 | 液位方法、固定频率/密度配置或闭环输入非法 | 函数内仅见 printf/调试输出，未见统一 ErrorLog_* | 配置项、输入值、测量方法、上下限、调用阶段 | 模块：调用模块；操作：参数校验；原因：配置或内部调用非法；字段：参数名、输入值、配置项、阶段 | 测量/运动状态机敏感；不得改变返回值、重试、错误置位或状态切换 | 清单阶段无源码改动；后续实施必须保持返回值、重试、停机、恢复和状态机不变 | 保持现码并补配置上下文；配置缺失可列拆分条件候选 | 参数缺失、非法值和边界输入验证；核对最终错误出口 | 清单完成，待源码批次审批 |
| P4-003 | 0x00110006 PARAM_ERROR | LTD_MAIN_CPU2/Application/Src/measure_oilLevel.c:FrequencyLevel_SetFixedTarget():635,640 | 液位方法、固定频率/密度配置或闭环输入非法 | 函数内仅见 printf/调试输出，未见统一 ErrorLog_* | 配置项、输入值、测量方法、上下限、调用阶段 | 模块：调用模块；操作：参数校验；原因：配置或内部调用非法；字段：参数名、输入值、配置项、阶段 | 测量/运动状态机敏感；不得改变返回值、重试、错误置位或状态切换 | 清单阶段无源码改动；后续实施必须保持返回值、重试、停机、恢复和状态机不变 | 保持现码并补配置上下文；配置缺失可列拆分条件候选 | 参数缺失、非法值和边界输入验证；核对最终错误出口 | 清单完成，待源码批次审批 |
| P4-004 | 0x00110006 PARAM_ERROR | LTD_MAIN_CPU2/Application/Src/measure_oilLevel.c:FrequencyLevel_RunClosedLoop():853 | 液位方法、固定频率/密度配置或闭环输入非法 | 函数内仅见 printf/调试输出，未见统一 ErrorLog_* | 配置项、输入值、测量方法、上下限、调用阶段 | 模块：调用模块；操作：参数校验；原因：配置或内部调用非法；字段：参数名、输入值、配置项、阶段 | 测量/运动状态机敏感；不得改变返回值、重试、错误置位或状态切换 | 清单阶段无源码改动；后续实施必须保持返回值、重试、停机、恢复和状态机不变 | 保持现码并补配置上下文；配置缺失可列拆分条件候选 | 参数缺失、非法值和边界输入验证；核对最终错误出口 | 清单完成，待源码批次审批 |
| P4-005 | 0x00110006 PARAM_ERROR | LTD_MAIN_CPU2/Application/Src/measure_oilLevel.c:OilLevel_TryRunDirectSearchMethod():1134 | 液位方法、固定频率/密度配置或闭环输入非法 | 函数内仅见 printf/调试输出，未见统一 ErrorLog_* | 配置项、输入值、测量方法、上下限、调用阶段 | 模块：调用模块；操作：参数校验；原因：配置或内部调用非法；字段：参数名、输入值、配置项、阶段 | 测量/运动状态机敏感；不得改变返回值、重试、错误置位或状态切换 | 清单阶段无源码改动；后续实施必须保持返回值、重试、停机、恢复和状态机不变 | 保持现码并补配置上下文；配置缺失可列拆分条件候选 | 参数缺失、非法值和边界输入验证；核对最终错误出口 | 清单完成，待源码批次审批 |
| P4-006 | 0x00110006 PARAM_ERROR | LTD_MAIN_CPU2/Application/Src/measure_oilLevel.c:FollowOilLevel():1435 | 液位方法、固定频率/密度配置或闭环输入非法 | 函数内仅见 printf/调试输出，未见统一 ErrorLog_* | 配置项、输入值、测量方法、上下限、调用阶段 | 模块：调用模块；操作：参数校验；原因：配置或内部调用非法；字段：参数名、输入值、配置项、阶段 | 测量/运动状态机敏感；不得改变返回值、重试、错误置位或状态切换 | 清单阶段无源码改动；后续实施必须保持返回值、重试、停机、恢复和状态机不变 | 保持现码并补配置上下文；配置缺失可列拆分条件候选 | 参数缺失、非法值和边界输入验证；核对最终错误出口 | 清单完成，待源码批次审批 |
| P4-007 | 0x00110006 PARAM_ERROR | LTD_MAIN_CPU2/Application/Src/measure_tank_height.c:check_bottom_status():805 | 标定配置缺失、标定结果或测量参数非法 | 函数内仅见 printf/调试输出，未见统一 ErrorLog_* | 配置项、输入值、测量方法、上下限、调用阶段 | 模块：调用模块；操作：参数校验；原因：配置或内部调用非法；字段：参数名、输入值、配置项、阶段 | 测量/运动状态机敏感；不得改变返回值、重试、错误置位或状态切换 | 清单阶段无源码改动；后续实施必须保持返回值、重试、停机、恢复和状态机不变 | 保持现码并补配置上下文；配置缺失可列拆分条件候选 | 参数缺失、非法值和边界输入验证；核对最终错误出口 | 清单完成，待源码批次审批 |
| P4-008 | 0x00110006 PARAM_ERROR | LTD_MAIN_CPU2/Application/Src/measure_waterLevel.c:CorrectWaterTankHeightProcess():1334 | 标定配置缺失、标定结果或测量参数非法 | 函数内仅见 printf/调试输出，未见统一 ErrorLog_* | 配置项、输入值、测量方法、上下限、调用阶段 | 模块：调用模块；操作：参数校验；原因：配置或内部调用非法；字段：参数名、输入值、配置项、阶段 | 测量/运动状态机敏感；不得改变返回值、重试、错误置位或状态切换 | 清单阶段无源码改动；后续实施必须保持返回值、重试、停机、恢复和状态机不变 | 保持现码并补配置上下文；配置缺失可列拆分条件候选 | 参数缺失、非法值和边界输入验证；核对最终错误出口 | 清单完成，待源码批次审批 |
| P4-009 | 0x00110006 PARAM_ERROR | LTD_MAIN_CPU2/Application/Src/measure_waterLevel.c:CMD_CalibrateWaterLevel():1365 | 标定配置缺失、标定结果或测量参数非法 | 函数内仅见 printf/调试输出，未见统一 ErrorLog_* | 配置项、输入值、测量方法、上下限、调用阶段 | 模块：调用模块；操作：参数校验；原因：配置或内部调用非法；字段：参数名、输入值、配置项、阶段 | 测量/运动状态机敏感；不得改变返回值、重试、错误置位或状态切换 | 清单阶段无源码改动；后续实施必须保持返回值、重试、停机、恢复和状态机不变 | 保持现码并补配置上下文；配置缺失可列拆分条件候选 | 参数缺失、非法值和边界输入验证；核对最终错误出口 | 清单完成，待源码批次审批 |
| P4-010 | 0x00110006 PARAM_ERROR | LTD_MAIN_CPU2/Application/Src/test.c:Test_MotorTextDistanceToTicksNoCheck():291,294,323 | 诊断/自测辅助入口的参数或边界失败 | 函数内未见 ErrorLog_* 或 printf | 参数名、输入/输出值、调用模块、失败前置条件 | 模块：调用模块；操作：参数校验；原因：配置或内部调用非法；字段：参数名、输入值、配置项、阶段 | 仅诊断测试路径，不纳入现场日志源码批次 | 清单阶段无源码改动；后续实施必须保持返回值、重试、停机、恢复和状态机不变 | 排除源码实施；仅保留诊断测试记录 | 静态确认测试入口不进入现场日志批次 | 清单完成，待源码批次审批 |
| P4-011 | 0x00110006 PARAM_ERROR | LTD_MAIN_CPU2/Application/Src/test.c:Test_MoveUntilEncoderTarget():963 | 诊断/自测辅助入口的参数或边界失败 | 函数内仅见 printf/调试输出，未见统一 ErrorLog_* | 参数名、输入/输出值、调用模块、失败前置条件 | 模块：调用模块；操作：参数校验；原因：配置或内部调用非法；字段：参数名、输入值、配置项、阶段 | 仅诊断测试路径，不纳入现场日志源码批次 | 清单阶段无源码改动；后续实施必须保持返回值、重试、停机、恢复和状态机不变 | 排除源码实施；仅保留诊断测试记录 | 静态确认测试入口不进入现场日志批次 | 清单完成，待源码批次审批 |
| P4-012 | 0x00110006 PARAM_ERROR | LTD_MAIN_CPU2/Services/MotorControl/motor_ctrl_driver_param.c:MotorDriver_ReadTargetPositionOpen():436 | 运动命令、距离换算、目标规划或驱动读取前置条件非法 | 函数内未见 ErrorLog_* 或 printf | 参数名、输入值、方向/距离、位置源、允许范围、调用阶段 | 模块：调用模块；操作：参数校验；原因：配置或内部调用非法；字段：参数名、输入值、配置项、阶段 | SPI和运动时序敏感；避免重复最终报错，不改变停机/恢复分类 | 清单阶段无源码改动；后续实施必须保持返回值、重试、停机、恢复和状态机不变 | 内部诊断优先；暂不新增对外码 | 目标越界、位置源无效、到位偏差注入；核对运动停止和恢复 | 清单完成，待源码批次审批 |
| P4-013 | 0x00110006 PARAM_ERROR | LTD_MAIN_CPU2/Services/MotorControl/motor_ctrl_driver_param.c:MotorDriver_AlignTargetToActual():466 | 运动命令、距离换算、目标规划或驱动读取前置条件非法 | 函数内未见 ErrorLog_* 或 printf | 参数名、输入值、方向/距离、位置源、允许范围、调用阶段 | 模块：调用模块；操作：参数校验；原因：配置或内部调用非法；字段：参数名、输入值、配置项、阶段 | SPI和运动时序敏感；避免重复最终报错，不改变停机/恢复分类 | 清单阶段无源码改动；后续实施必须保持返回值、重试、停机、恢复和状态机不变 | 内部诊断优先；暂不新增对外码 | 目标越界、位置源无效、到位偏差注入；核对运动停止和恢复 | 清单完成，待源码批次审批 |
| P4-014 | 0x00110006 PARAM_ERROR | LTD_MAIN_CPU2/Services/MotorControl/motor_ctrl_driver_param.c:MotorDriver_ReadMovingState():799 | 运动命令、距离换算、目标规划或驱动读取前置条件非法 | 函数内未见 ErrorLog_* 或 printf | 参数名、输入值、方向/距离、位置源、允许范围、调用阶段 | 模块：调用模块；操作：参数校验；原因：配置或内部调用非法；字段：参数名、输入值、配置项、阶段 | SPI和运动时序敏感；避免重复最终报错，不改变停机/恢复分类 | 清单阶段无源码改动；后续实施必须保持返回值、重试、停机、恢复和状态机不变 | 内部诊断优先；暂不新增对外码 | 目标越界、位置源无效、到位偏差注入；核对运动停止和恢复 | 清单完成，待源码批次审批 |
| P4-015 | 0x00110006 PARAM_ERROR | LTD_MAIN_CPU2/Services/MotorControl/motor_ctrl_driver_param.c:MotorDriver_ReadStoppingState():854 | 运动命令、距离换算、目标规划或驱动读取前置条件非法 | 函数内未见 ErrorLog_* 或 printf | 参数名、输入值、方向/距离、位置源、允许范围、调用阶段 | 模块：调用模块；操作：参数校验；原因：配置或内部调用非法；字段：参数名、输入值、配置项、阶段 | SPI和运动时序敏感；避免重复最终报错，不改变停机/恢复分类 | 清单阶段无源码改动；后续实施必须保持返回值、重试、停机、恢复和状态机不变 | 内部诊断优先；暂不新增对外码 | 目标越界、位置源无效、到位偏差注入；核对运动停止和恢复 | 清单完成，待源码批次审批 |
| P4-016 | 0x00110006 PARAM_ERROR | LTD_MAIN_CPU2/Services/MotorControl/motor_ctrl_motion_api.c:MotorCtrl_MoveNoWait():305,309 | 运动命令、距离换算、目标规划或驱动读取前置条件非法 | 函数内未见 ErrorLog_* 或 printf | 参数名、输入值、方向/距离、位置源、允许范围、调用阶段 | 模块：调用模块；操作：参数校验；原因：配置或内部调用非法；字段：参数名、输入值、配置项、阶段 | SPI和运动时序敏感；避免重复最终报错，不改变停机/恢复分类 | 清单阶段无源码改动；后续实施必须保持返回值、重试、停机、恢复和状态机不变 | 内部诊断优先；暂不新增对外码 | 目标越界、位置源无效、到位偏差注入；核对运动停止和恢复 | 清单完成，待源码批次审批 |
| P4-017 | 0x00110006 PARAM_ERROR | LTD_MAIN_CPU2/Services/MotorControl/motor_ctrl_motion_api.c:MotorCtrl_CalibrateFirstLoopCircumferenceAtZero():358,364,391,400 | 运动命令、距离换算、目标规划或驱动读取前置条件非法 | 函数内仅见 printf/调试输出，未见统一 ErrorLog_* | 参数名、输入值、方向/距离、位置源、允许范围、调用阶段 | 模块：调用模块；操作：参数校验；原因：配置或内部调用非法；字段：参数名、输入值、配置项、阶段 | SPI和运动时序敏感；避免重复最终报错，不改变停机/恢复分类 | 清单阶段无源码改动；后续实施必须保持返回值、重试、停机、恢复和状态机不变 | 内部诊断优先；暂不新增对外码 | 目标越界、位置源无效、到位偏差注入；核对运动停止和恢复 | 清单完成，待源码批次审批 |
| P4-018 | 0x00110006 PARAM_ERROR | LTD_MAIN_CPU2/Services/MotorControl/motor_ctrl_motion_api.c:MotorCtrl_MoveAndWait():456 | 运动命令、距离换算、目标规划或驱动读取前置条件非法 | 函数内仅见 printf/调试输出，未见统一 ErrorLog_* | 参数名、输入值、方向/距离、位置源、允许范围、调用阶段 | 模块：调用模块；操作：参数校验；原因：配置或内部调用非法；字段：参数名、输入值、配置项、阶段 | SPI和运动时序敏感；避免重复最终报错，不改变停机/恢复分类 | 清单阶段无源码改动；后续实施必须保持返回值、重试、停机、恢复和状态机不变 | 内部诊断优先；暂不新增对外码 | 目标越界、位置源无效、到位偏差注入；核对运动停止和恢复 | 清单完成，待源码批次审批 |
| P4-019 | 0x00110006 PARAM_ERROR | LTD_MAIN_CPU2/Services/MotorControl/motor_ctrl_motion_api.c:MotorCtrl_StartVelocity():616 | 运动命令、距离换算、目标规划或驱动读取前置条件非法 | 函数内未见 ErrorLog_* 或 printf | 参数名、输入值、方向/距离、位置源、允许范围、调用阶段 | 模块：调用模块；操作：参数校验；原因：配置或内部调用非法；字段：参数名、输入值、配置项、阶段 | SPI和运动时序敏感；避免重复最终报错，不改变停机/恢复分类 | 清单阶段无源码改动；后续实施必须保持返回值、重试、停机、恢复和状态机不变 | 内部诊断优先；暂不新增对外码 | 目标越界、位置源无效、到位偏差注入；核对运动停止和恢复 | 清单完成，待源码批次审批 |
| P4-020 | 0x00110006 PARAM_ERROR | LTD_MAIN_CPU2/Services/MotorControl/motor_ctrl_motion_api.c:MotorCtrl_JogMoveAndWait():748 | 运动命令、距离换算、目标规划或驱动读取前置条件非法 | 函数内未见 ErrorLog_* 或 printf | 参数名、输入值、方向/距离、位置源、允许范围、调用阶段 | 模块：调用模块；操作：参数校验；原因：配置或内部调用非法；字段：参数名、输入值、配置项、阶段 | SPI和运动时序敏感；避免重复最终报错，不改变停机/恢复分类 | 清单阶段无源码改动；后续实施必须保持返回值、重试、停机、恢复和状态机不变 | 内部诊断优先；暂不新增对外码 | 目标越界、位置源无效、到位偏差注入；核对运动停止和恢复 | 清单完成，待源码批次审批 |
| P4-021 | 0x00110006 PARAM_ERROR | LTD_MAIN_CPU2/Services/MotorControl/motor_ctrl_motion_api.c:MotorMotion_MoveBlockingNoDetectInternal():958,960 | 运动命令、距离换算、目标规划或驱动读取前置条件非法 | 函数内仅见 printf/调试输出，未见统一 ErrorLog_* | 参数名、输入值、方向/距离、位置源、允许范围、调用阶段 | 模块：调用模块；操作：参数校验；原因：配置或内部调用非法；字段：参数名、输入值、配置项、阶段 | SPI和运动时序敏感；避免重复最终报错，不改变停机/恢复分类 | 清单阶段无源码改动；后续实施必须保持返回值、重试、停机、恢复和状态机不变 | 内部诊断优先；暂不新增对外码 | 目标越界、位置源无效、到位偏差注入；核对运动停止和恢复 | 清单完成，待源码批次审批 |
| P4-022 | 0x00110006 PARAM_ERROR | LTD_MAIN_CPU2/Services/MotorControl/motor_ctrl_motion_api.c:MotorMotion_DistanceToTicks():1219,1224,1230,1252 | 运动命令、距离换算、目标规划或驱动读取前置条件非法 | 函数内未见 ErrorLog_* 或 printf | 参数名、输入值、方向/距离、位置源、允许范围、调用阶段 | 模块：调用模块；操作：参数校验；原因：配置或内部调用非法；字段：参数名、输入值、配置项、阶段 | SPI和运动时序敏感；避免重复最终报错，不改变停机/恢复分类 | 清单阶段无源码改动；后续实施必须保持返回值、重试、停机、恢复和状态机不变 | 内部诊断优先；暂不新增对外码 | 目标越界、位置源无效、到位偏差注入；核对运动停止和恢复 | 清单完成，待源码批次审批 |
| P4-023 | 0x00110006 PARAM_ERROR | LTD_MAIN_CPU2/Services/MotorControl/motor_ctrl_motion_api.c:MotorMotion_BeginSpeedScope():1281 | 运动命令、距离换算、目标规划或驱动读取前置条件非法 | 函数内未见 ErrorLog_* 或 printf | 参数名、输入值、方向/距离、位置源、允许范围、调用阶段 | 模块：调用模块；操作：参数校验；原因：配置或内部调用非法；字段：参数名、输入值、配置项、阶段 | SPI和运动时序敏感；避免重复最终报错，不改变停机/恢复分类 | 清单阶段无源码改动；后续实施必须保持返回值、重试、停机、恢复和状态机不变 | 内部诊断优先；暂不新增对外码 | 目标越界、位置源无效、到位偏差注入；核对运动停止和恢复 | 清单完成，待源码批次审批 |
| P4-024 | 0x00110006 PARAM_ERROR | LTD_MAIN_CPU2/Services/MotorControl/motor_ctrl_motion_api.c:MotorMotion_EndSpeedScope():1295 | 运动命令、距离换算、目标规划或驱动读取前置条件非法 | 函数内未见 ErrorLog_* 或 printf | 参数名、输入值、方向/距离、位置源、允许范围、调用阶段 | 模块：调用模块；操作：参数校验；原因：配置或内部调用非法；字段：参数名、输入值、配置项、阶段 | SPI和运动时序敏感；避免重复最终报错，不改变停机/恢复分类 | 清单阶段无源码改动；后续实施必须保持返回值、重试、停机、恢复和状态机不变 | 内部诊断优先；暂不新增对外码 | 目标越界、位置源无效、到位偏差注入；核对运动停止和恢复 | 清单完成，待源码批次审批 |
| P4-025 | 0x00110006 PARAM_ERROR | LTD_MAIN_CPU2/Services/MotorControl/motor_ctrl_motion_api.c:MotorMotion_ReturnWithSpeedScope():1313 | 运动命令、距离换算、目标规划或驱动读取前置条件非法 | 函数内未见 ErrorLog_* 或 printf | 参数名、输入值、方向/距离、位置源、允许范围、调用阶段 | 模块：调用模块；操作：参数校验；原因：配置或内部调用非法；字段：参数名、输入值、配置项、阶段 | SPI和运动时序敏感；避免重复最终报错，不改变停机/恢复分类 | 清单阶段无源码改动；后续实施必须保持返回值、重试、停机、恢复和状态机不变 | 内部诊断优先；暂不新增对外码 | 目标越界、位置源无效、到位偏差注入；核对运动停止和恢复 | 清单完成，待源码批次审批 |
| P4-026 | 0x00110006 PARAM_ERROR | LTD_MAIN_CPU2/Services/MotorControl/motor_ctrl_motion_api.c:MotorMotion_CheckAbortRefreshAndHealth():1458 | 运动命令、距离换算、目标规划或驱动读取前置条件非法 | 函数内未见 ErrorLog_* 或 printf | 参数名、输入值、方向/距离、位置源、允许范围、调用阶段 | 模块：调用模块；操作：参数校验；原因：配置或内部调用非法；字段：参数名、输入值、配置项、阶段 | SPI和运动时序敏感；避免重复最终报错，不改变停机/恢复分类 | 清单阶段无源码改动；后续实施必须保持返回值、重试、停机、恢复和状态机不变 | 内部诊断优先；暂不新增对外码 | 目标越界、位置源无效、到位偏差注入；核对运动停止和恢复 | 清单完成，待源码批次审批 |
| P4-027 | 0x00110006 PARAM_ERROR | LTD_MAIN_CPU2/Services/MotorControl/motor_ctrl_motion_api.c:MotorMotion_CheckStoppedAndRefresh():1485 | 运动命令、距离换算、目标规划或驱动读取前置条件非法 | 函数内未见 ErrorLog_* 或 printf | 参数名、输入值、方向/距离、位置源、允许范围、调用阶段 | 模块：调用模块；操作：参数校验；原因：配置或内部调用非法；字段：参数名、输入值、配置项、阶段 | SPI和运动时序敏感；避免重复最终报错，不改变停机/恢复分类 | 清单阶段无源码改动；后续实施必须保持返回值、重试、停机、恢复和状态机不变 | 内部诊断优先；暂不新增对外码 | 目标越界、位置源无效、到位偏差注入；核对运动停止和恢复 | 清单完成，待源码批次审批 |
| P4-028 | 0x00110006 PARAM_ERROR | LTD_MAIN_CPU2/Services/MotorControl/motor_ctrl_motion_api.c:MotorMotion_JogMoveToTargetInternal():1632 | 运动命令、距离换算、目标规划或驱动读取前置条件非法 | 函数内仅见 printf/调试输出，未见统一 ErrorLog_* | 参数名、输入值、方向/距离、位置源、允许范围、调用阶段 | 模块：调用模块；操作：参数校验；原因：配置或内部调用非法；字段：参数名、输入值、配置项、阶段 | SPI和运动时序敏感；避免重复最终报错，不改变停机/恢复分类 | 清单阶段无源码改动；后续实施必须保持返回值、重试、停机、恢复和状态机不变 | 内部诊断优先；暂不新增对外码 | 目标越界、位置源无效、到位偏差注入；核对运动停止和恢复 | 清单完成，待源码批次审批 |
| P4-029 | 0x00110006 PARAM_ERROR | LTD_MAIN_CPU2/Services/MotorControl/motor_ctrl_motion_api.c:MotorMotion_RefreshActivePositionMm():1777 | 运动命令、距离换算、目标规划或驱动读取前置条件非法 | 函数内未见 ErrorLog_* 或 printf | 参数名、输入值、方向/距离、位置源、允许范围、调用阶段 | 模块：调用模块；操作：参数校验；原因：配置或内部调用非法；字段：参数名、输入值、配置项、阶段 | SPI和运动时序敏感；避免重复最终报错，不改变停机/恢复分类 | 清单阶段无源码改动；后续实施必须保持返回值、重试、停机、恢复和状态机不变 | 内部诊断优先；暂不新增对外码 | 目标越界、位置源无效、到位偏差注入；核对运动停止和恢复 | 清单完成，待源码批次审批 |
| P4-030 | 0x00110006 PARAM_ERROR | LTD_MAIN_CPU2/Services/MotorControl/motor_ctrl_motion_api.c:MotorMotion_BuildRelativeTargetPlan():1816,1830 | 运动命令、距离换算、目标规划或驱动读取前置条件非法 | 函数内未见 ErrorLog_* 或 printf | 参数名、输入值、方向/距离、位置源、允许范围、调用阶段 | 模块：调用模块；操作：参数校验；原因：配置或内部调用非法；字段：参数名、输入值、配置项、阶段 | SPI和运动时序敏感；避免重复最终报错，不改变停机/恢复分类 | 清单阶段无源码改动；后续实施必须保持返回值、重试、停机、恢复和状态机不变 | 内部诊断优先；暂不新增对外码 | 目标越界、位置源无效、到位偏差注入；核对运动停止和恢复 | 清单完成，待源码批次审批 |
| P4-031 | 0x00110006 PARAM_ERROR | LTD_MAIN_CPU2/Services/MotorControl/motor_ctrl_motion_api.c:MotorMotion_BuildAbsoluteTargetPlan():1861 | 运动命令、距离换算、目标规划或驱动读取前置条件非法 | 函数内未见 ErrorLog_* 或 printf | 参数名、输入值、方向/距离、位置源、允许范围、调用阶段 | 模块：调用模块；操作：参数校验；原因：配置或内部调用非法；字段：参数名、输入值、配置项、阶段 | SPI和运动时序敏感；避免重复最终报错，不改变停机/恢复分类 | 清单阶段无源码改动；后续实施必须保持返回值、重试、停机、恢复和状态机不变 | 内部诊断优先；暂不新增对外码 | 目标越界、位置源无效、到位偏差注入；核对运动停止和恢复 | 清单完成，待源码批次审批 |
| P4-032 | 0x00110006 PARAM_ERROR | LTD_MAIN_CPU2/Services/MotorControl/motor_ctrl_motion_api.c:MotorMotion_CheckJogRuntimeGuards():2001 | 运动命令、距离换算、目标规划或驱动读取前置条件非法 | 函数内未见 ErrorLog_* 或 printf | 参数名、输入值、方向/距离、位置源、允许范围、调用阶段 | 模块：调用模块；操作：参数校验；原因：配置或内部调用非法；字段：参数名、输入值、配置项、阶段 | SPI和运动时序敏感；避免重复最终报错，不改变停机/恢复分类 | 清单阶段无源码改动；后续实施必须保持返回值、重试、停机、恢复和状态机不变 | 内部诊断优先；暂不新增对外码 | 目标越界、位置源无效、到位偏差注入；核对运动停止和恢复 | 清单完成，待源码批次审批 |
| P4-033 | 0x00110006 PARAM_ERROR | LTD_MAIN_CPU2/Services/MotorControl/motor_ctrl_motion_api.c:MotorMotion_CalcJogSlowdownDistanceMm():2058 | 运动命令、距离换算、目标规划或驱动读取前置条件非法 | 函数内仅见 printf/调试输出，未见统一 ErrorLog_* | 参数名、输入值、方向/距离、位置源、允许范围、调用阶段 | 模块：调用模块；操作：参数校验；原因：配置或内部调用非法；字段：参数名、输入值、配置项、阶段 | SPI和运动时序敏感；避免重复最终报错，不改变停机/恢复分类 | 清单阶段无源码改动；后续实施必须保持返回值、重试、停机、恢复和状态机不变 | 内部诊断优先；暂不新增对外码 | 目标越界、位置源无效、到位偏差注入；核对运动停止和恢复 | 清单完成，待源码批次审批 |
| P4-034 | 0x00110006 PARAM_ERROR | LTD_MAIN_CPU2/Services/MotorControl/motor_ctrl_motion_api.c:MotorMotion_StartJogVelocity():2193,2199 | 运动命令、距离换算、目标规划或驱动读取前置条件非法 | 函数内未见 ErrorLog_* 或 printf | 参数名、输入值、方向/距离、位置源、允许范围、调用阶段 | 模块：调用模块；操作：参数校验；原因：配置或内部调用非法；字段：参数名、输入值、配置项、阶段 | SPI和运动时序敏感；避免重复最终报错，不改变停机/恢复分类 | 清单阶段无源码改动；后续实施必须保持返回值、重试、停机、恢复和状态机不变 | 内部诊断优先；暂不新增对外码 | 目标越界、位置源无效、到位偏差注入；核对运动停止和恢复 | 清单完成，待源码批次审批 |
| P4-035 | 0x00110006 PARAM_ERROR | LTD_MAIN_CPU2/Services/MotorControl/motor_ctrl_position_model.c:MotorCtrl_SwitchPositionSourceToMotor():457 | 位置源、卷筒参考或周长标定参数非法 | 函数内仅见 printf/调试输出，未见统一 ErrorLog_* | 参数名、输入值、方向/距离、位置源、允许范围、调用阶段 | 模块：调用模块；操作：参数校验；原因：配置或内部调用非法；字段：参数名、输入值、配置项、阶段 | SPI和运动时序敏感；避免重复最终报错，不改变停机/恢复分类 | 清单阶段无源码改动；后续实施必须保持返回值、重试、停机、恢复和状态机不变 | 内部诊断优先；暂不新增对外码 | 目标越界、位置源无效、到位偏差注入；核对运动停止和恢复 | 清单完成，待源码批次审批 |
| P4-036 | 0x00110006 PARAM_ERROR | LTD_MAIN_CPU2/Services/MotorControl/motor_ctrl_position_model.c:MotorCtrl_CalibrateCurrentTapeCircumference():578,590,599,606 | 位置源、卷筒参考或周长标定参数非法 | 函数内仅见 printf/调试输出，未见统一 ErrorLog_* | 参数名、输入值、方向/距离、位置源、允许范围、调用阶段 | 模块：调用模块；操作：参数校验；原因：配置或内部调用非法；字段：参数名、输入值、配置项、阶段 | SPI和运动时序敏感；避免重复最终报错，不改变停机/恢复分类 | 清单阶段无源码改动；后续实施必须保持返回值、重试、停机、恢复和状态机不变 | 内部诊断优先；暂不新增对外码 | 目标越界、位置源无效、到位偏差注入；核对运动停止和恢复 | 清单完成，待源码批次审批 |
| P4-037 | 0x00110006 PARAM_ERROR | LTD_MAIN_CPU2/Services/MotorControl/motor_ctrl_position_model.c:MotorCtrl_ResetDrumReferenceForZeroCalibration():643 | 位置源、卷筒参考或周长标定参数非法 | 函数内仅见 printf/调试输出，未见统一 ErrorLog_* | 参数名、输入值、方向/距离、位置源、允许范围、调用阶段 | 模块：调用模块；操作：参数校验；原因：配置或内部调用非法；字段：参数名、输入值、配置项、阶段 | SPI和运动时序敏感；避免重复最终报错，不改变停机/恢复分类 | 清单阶段无源码改动；后续实施必须保持返回值、重试、停机、恢复和状态机不变 | 内部诊断优先；暂不新增对外码 | 目标越界、位置源无效、到位偏差注入；核对运动停止和恢复 | 清单完成，待源码批次审批 |
| P4-038 | 0x00110006 PARAM_ERROR | LTD_MAIN_CPU2/Services/MotorControl/motor_ctrl_tape_fit.c:MotorCtrl_TapeFitSolve():144,151,178,190 | 尺带拟合样本、系数、原点或输出参数非法 | 函数内仅见 printf/调试输出，未见统一 ErrorLog_* | 参数名、输入值、方向/距离、位置源、允许范围、调用阶段 | 模块：调用模块；操作：参数校验；原因：配置或内部调用非法；字段：参数名、输入值、配置项、阶段 | SPI和运动时序敏感；避免重复最终报错，不改变停机/恢复分类 | 清单阶段无源码改动；后续实施必须保持返回值、重试、停机、恢复和状态机不变 | 内部诊断优先；暂不新增对外码 | 目标越界、位置源无效、到位偏差注入；核对运动停止和恢复 | 清单完成，待源码批次审批 |
| P4-039 | 0x00110006 PARAM_ERROR | LTD_MAIN_CPU2/Services/MotorControl/motor_ctrl_tape_fit.c:MotorCtrl_TapeFitSolveLocalOrigin():240,247,255,276,291 | 尺带拟合样本、系数、原点或输出参数非法 | 函数内仅见 printf/调试输出，未见统一 ErrorLog_* | 参数名、输入值、方向/距离、位置源、允许范围、调用阶段 | 模块：调用模块；操作：参数校验；原因：配置或内部调用非法；字段：参数名、输入值、配置项、阶段 | SPI和运动时序敏感；避免重复最终报错，不改变停机/恢复分类 | 清单阶段无源码改动；后续实施必须保持返回值、重试、停机、恢复和状态机不变 | 内部诊断优先；暂不新增对外码 | 目标越界、位置源无效、到位偏差注入；核对运动停止和恢复 | 清单完成，待源码批次审批 |
| P4-040 | 0x00110006 PARAM_ERROR | LTD_MAIN_CPU2/Services/MotorControl/motor_ctrl_tape_fit.c:MotorCtrl_TapeFitApply():340,353,358,366,372 | 尺带拟合样本、系数、原点或输出参数非法 | 函数内仅见 printf/调试输出，未见统一 ErrorLog_* | 参数名、输入值、方向/距离、位置源、允许范围、调用阶段 | 模块：调用模块；操作：参数校验；原因：配置或内部调用非法；字段：参数名、输入值、配置项、阶段 | SPI和运动时序敏感；避免重复最终报错，不改变停机/恢复分类 | 清单阶段无源码改动；后续实施必须保持返回值、重试、停机、恢复和状态机不变 | 内部诊断优先；暂不新增对外码 | 目标越界、位置源无效、到位偏差注入；核对运动停止和恢复 | 清单完成，待源码批次审批 |
| P4-041 | 0x00110006 PARAM_ERROR | LTD_MAIN_CPU2/Services/Sensor/sensor.c:Sensor_ReadWaterCapacitance():734 | 传感器读取输出参数或调用前置条件非法 | 函数内仅见 printf/调试输出，未见统一 ErrorLog_* | 参数名、输入/输出值、调用模块、失败前置条件 | 模块：调用模块；操作：参数校验；原因：配置或内部调用非法；字段：参数名、输入值、配置项、阶段 | UART/DMA/重试时序敏感；ISR仅置标志，避免循环内高频打印 | 清单阶段无源码改动；后续实施必须保持返回值、重试、停机、恢复和状态机不变 | 内部诊断优先；暂不新增对外码 | 无响应/部分帧/格式错/UART错误注入；核对ISR边界和重试结果 | 清单完成，待源码批次审批 |
| P4-042 | 0x00110006 PARAM_ERROR | LTD_MAIN_CPU2/Services/Sensor/sensor.c:Sensor_ReadGyroAngle():752 | 传感器读取输出参数或调用前置条件非法 | 函数内仅见 printf/调试输出，未见统一 ErrorLog_* | 参数名、输入/输出值、调用模块、失败前置条件 | 模块：调用模块；操作：参数校验；原因：配置或内部调用非法；字段：参数名、输入值、配置项、阶段 | UART/DMA/重试时序敏感；ISR仅置标志，避免循环内高频打印 | 清单阶段无源码改动；后续实施必须保持返回值、重试、停机、恢复和状态机不变 | 内部诊断优先；暂不新增对外码 | 无响应/部分帧/格式错/UART错误注入；核对ISR边界和重试结果 | 清单完成，待源码批次审批 |
| P4-043 | 0x00110004 PARAM_ADDRESS_OVERFLOW | LTD_MAIN_CPU2/Application/Src/measure_density.c:Density_RunPoints01mmWithDwell():280 | 测点数组、点数、输出缓冲或索引边界异常 | 函数内仅见 printf/调试输出，未见统一 ErrorLog_* | 空指针/真实地址/索引的区分、缓冲长度、点数、地址或范围上下限 | 模块：调用模块；操作：参数/缓冲校验；原因：地址或内部边界异常；字段：参数名、地址、长度、索引、范围 | 测量/运动状态机敏感；不得改变返回值、重试、错误置位或状态切换 | 清单阶段无源码改动；后续实施必须保持返回值、重试、停机、恢复和状态机不变 | 第3.3收窄候选；本阶段只补上下文 | 参数缺失、非法值和边界输入验证；核对最终错误出口 | 清单完成，待源码批次审批 |
| P4-044 | 0x00110004 PARAM_ADDRESS_OVERFLOW | LTD_MAIN_CPU2/Application/Src/measure_density.c:BuildPoints_Spread_Exact():385 | 测点数组、点数、输出缓冲或索引边界异常 | 函数内未见 ErrorLog_* 或 printf | 空指针/真实地址/索引的区分、缓冲长度、点数、地址或范围上下限 | 模块：调用模块；操作：参数/缓冲校验；原因：地址或内部边界异常；字段：参数名、地址、长度、索引、范围 | 测量/运动状态机敏感；不得改变返回值、重试、错误置位或状态切换 | 清单阶段无源码改动；后续实施必须保持返回值、重试、停机、恢复和状态机不变 | 第3.3收窄候选；本阶段只补上下文 | 参数缺失、非法值和边界输入验证；核对最终错误出口 | 清单完成，待源码批次审批 |
| P4-045 | 0x00110004 PARAM_ADDRESS_OVERFLOW | LTD_MAIN_CPU2/Application/Src/measure_density.c:BuildPoints_Meter_Exact():609 | 测点数组、点数、输出缓冲或索引边界异常 | 函数内未见 ErrorLog_* 或 printf | 空指针/真实地址/索引的区分、缓冲长度、点数、地址或范围上下限 | 模块：调用模块；操作：参数/缓冲校验；原因：地址或内部边界异常；字段：参数名、地址、长度、索引、范围 | 测量/运动状态机敏感；不得改变返回值、重试、错误置位或状态切换 | 清单阶段无源码改动；后续实施必须保持返回值、重试、停机、恢复和状态机不变 | 第3.3收窄候选；本阶段只补上下文 | 参数缺失、非法值和边界输入验证；核对最终错误出口 | 清单完成，待源码批次审批 |
| P4-046 | 0x00110004 PARAM_ADDRESS_OVERFLOW | LTD_MAIN_CPU2/Application/Src/measure_density.c:BuildPoints_Interval_Exact():674 | 测点数组、点数、输出缓冲或索引边界异常 | 函数内未见 ErrorLog_* 或 printf | 空指针/真实地址/索引的区分、缓冲长度、点数、地址或范围上下限 | 模块：调用模块；操作：参数/缓冲校验；原因：地址或内部边界异常；字段：参数名、地址、长度、索引、范围 | 测量/运动状态机敏感；不得改变返回值、重试、错误置位或状态切换 | 清单阶段无源码改动；后续实施必须保持返回值、重试、停机、恢复和状态机不变 | 第3.3收窄候选；本阶段只补上下文 | 参数缺失、非法值和边界输入验证；核对最终错误出口 | 清单完成，待源码批次审批 |
| P4-047 | 0x00110004 PARAM_ADDRESS_OVERFLOW | LTD_MAIN_CPU2/Application/Src/measure_density.c:Density_MeasureByMode_Exact():749 | 测点数组、点数、输出缓冲或索引边界异常 | 函数内仅见 printf/调试输出，未见统一 ErrorLog_* | 空指针/真实地址/索引的区分、缓冲长度、点数、地址或范围上下限 | 模块：调用模块；操作：参数/缓冲校验；原因：地址或内部边界异常；字段：参数名、地址、长度、索引、范围 | 测量/运动状态机敏感；不得改变返回值、重试、错误置位或状态切换 | 清单阶段无源码改动；后续实施必须保持返回值、重试、停机、恢复和状态机不变 | 第3.3收窄候选；本阶段只补上下文 | 参数缺失、非法值和边界输入验证；核对最终错误出口 | 清单完成，待源码批次审批 |
| P4-048 | 0x00110004 PARAM_ADDRESS_OVERFLOW | LTD_MAIN_CPU2/Application/Src/measure_density.c:SiProfile_BuildPoints():925 | 测点数组、点数、输出缓冲或索引边界异常 | 函数内未见 ErrorLog_* 或 printf | 空指针/真实地址/索引的区分、缓冲长度、点数、地址或范围上下限 | 模块：调用模块；操作：参数/缓冲校验；原因：地址或内部边界异常；字段：参数名、地址、长度、索引、范围 | 测量/运动状态机敏感；不得改变返回值、重试、错误置位或状态切换 | 清单阶段无源码改动；后续实施必须保持返回值、重试、停机、恢复和状态机不变 | 第3.3收窄候选；本阶段只补上下文 | 参数缺失、非法值和边界输入验证；核对最终错误出口 | 清单完成，待源码批次审批 |
| P4-049 | 0x00110004 PARAM_ADDRESS_OVERFLOW | LTD_MAIN_CPU2/Application/Src/measure_density.c:SiProfile_ReadPointAndClassify():1053 | 测点数组、点数、输出缓冲或索引边界异常 | 函数内未见 ErrorLog_* 或 printf | 空指针/真实地址/索引的区分、缓冲长度、点数、地址或范围上下限 | 模块：调用模块；操作：参数/缓冲校验；原因：地址或内部边界异常；字段：参数名、地址、长度、索引、范围 | 测量/运动状态机敏感；不得改变返回值、重试、错误置位或状态切换 | 清单阶段无源码改动；后续实施必须保持返回值、重试、停机、恢复和状态机不变 | 第3.3收窄候选；本阶段只补上下文 | 参数缺失、非法值和边界输入验证；核对最终错误出口 | 清单完成，待源码批次审批 |
| P4-050 | 0x00110004 PARAM_ADDRESS_OVERFLOW | LTD_MAIN_CPU2/Application/Src/measure_density.c:SiProfile_RunPoints01mmWithDwell():1188 | 测点数组、点数、输出缓冲或索引边界异常 | 函数内仅见 printf/调试输出，未见统一 ErrorLog_* | 空指针/真实地址/索引的区分、缓冲长度、点数、地址或范围上下限 | 模块：调用模块；操作：参数/缓冲校验；原因：地址或内部边界异常；字段：参数名、地址、长度、索引、范围 | 测量/运动状态机敏感；不得改变返回值、重试、错误置位或状态切换 | 清单阶段无源码改动；后续实施必须保持返回值、重试、停机、恢复和状态机不变 | 第3.3收窄候选；本阶段只补上下文 | 参数缺失、非法值和边界输入验证；核对最终错误出口 | 清单完成，待源码批次审批 |
| P4-051 | 0x00110004 PARAM_ADDRESS_OVERFLOW | LTD_MAIN_CPU2/Application/Src/measure_oilLevel.c:DensityLevel_ReadCurrent():345 | 空指针、输出参数、数组计数或内部缓冲边界异常 | 函数内仅见 printf/调试输出，未见统一 ErrorLog_* | 空指针/真实地址/索引的区分、缓冲长度、点数、地址或范围上下限 | 模块：调用模块；操作：参数/缓冲校验；原因：地址或内部边界异常；字段：参数名、地址、长度、索引、范围 | 测量/运动状态机敏感；不得改变返回值、重试、错误置位或状态切换 | 清单阶段无源码改动；后续实施必须保持返回值、重试、停机、恢复和状态机不变 | 第3.3收窄候选；本阶段只补上下文 | 参数缺失、非法值和边界输入验证；核对最终错误出口 | 清单完成，待源码批次审批 |
| P4-052 | 0x00110004 PARAM_ADDRESS_OVERFLOW | LTD_MAIN_CPU2/Application/Src/measure_oilLevel.c:LevelVelocity_StartOrUpdateMotion():406 | 空指针、输出参数、数组计数或内部缓冲边界异常 | 函数内未见 ErrorLog_* 或 printf | 空指针/真实地址/索引的区分、缓冲长度、点数、地址或范围上下限 | 模块：调用模块；操作：参数/缓冲校验；原因：地址或内部边界异常；字段：参数名、地址、长度、索引、范围 | 测量/运动状态机敏感；不得改变返回值、重试、错误置位或状态切换 | 清单阶段无源码改动；后续实施必须保持返回值、重试、停机、恢复和状态机不变 | 第3.3收窄候选；本阶段只补上下文 | 参数缺失、非法值和边界输入验证；核对最终错误出口 | 清单完成，待源码批次审批 |
| P4-053 | 0x00110004 PARAM_ADDRESS_OVERFLOW | LTD_MAIN_CPU2/Application/Src/measure_oilLevel.c:OilLevel_ReadAverageFrequencyWithRetry():663,666 | 空指针、输出参数、数组计数或内部缓冲边界异常 | 函数内已有 ErrorLog_*；需确认是否覆盖本分支及关键字段 | 空指针/真实地址/索引的区分、缓冲长度、点数、地址或范围上下限 | 模块：调用模块；操作：参数/缓冲校验；原因：地址或内部边界异常；字段：参数名、地址、长度、索引、范围 | 测量/运动状态机敏感；不得改变返回值、重试、错误置位或状态切换 | 清单阶段无源码改动；后续实施必须保持返回值、重试、停机、恢复和状态机不变 | 第3.3收窄候选；本阶段只补上下文 | 参数缺失、非法值和边界输入验证；核对最终错误出口 | 清单完成，待源码批次审批 |
| P4-054 | 0x00110004 PARAM_ADDRESS_OVERFLOW | LTD_MAIN_CPU2/Application/Src/measure_oilLevel.c:OilLevel_TryRunDirectSearchMethod():1124 | 空指针、输出参数、数组计数或内部缓冲边界异常 | 函数内仅见 printf/调试输出，未见统一 ErrorLog_* | 空指针/真实地址/索引的区分、缓冲长度、点数、地址或范围上下限 | 模块：调用模块；操作：参数/缓冲校验；原因：地址或内部边界异常；字段：参数名、地址、长度、索引、范围 | 测量/运动状态机敏感；不得改变返回值、重试、错误置位或状态切换 | 清单阶段无源码改动；后续实施必须保持返回值、重试、停机、恢复和状态机不变 | 第3.3收窄候选；本阶段只补上下文 | 参数缺失、非法值和边界输入验证；核对最终错误出口 | 清单完成，待源码批次审批 |
| P4-055 | 0x00110004 PARAM_ADDRESS_OVERFLOW | LTD_MAIN_CPU2/Application/Src/measure_oilLevel.c:OilLevel_RunResolvedSearchMethod():1300 | 空指针、输出参数、数组计数或内部缓冲边界异常 | 函数内未见 ErrorLog_* 或 printf | 空指针/真实地址/索引的区分、缓冲长度、点数、地址或范围上下限 | 模块：调用模块；操作：参数/缓冲校验；原因：地址或内部边界异常；字段：参数名、地址、长度、索引、范围 | 测量/运动状态机敏感；不得改变返回值、重试、错误置位或状态切换 | 清单阶段无源码改动；后续实施必须保持返回值、重试、停机、恢复和状态机不变 | 第3.3收窄候选；本阶段只补上下文 | 参数缺失、非法值和边界输入验证；核对最终错误出口 | 清单完成，待源码批次审批 |
| P4-056 | 0x00110004 PARAM_ADDRESS_OVERFLOW | LTD_MAIN_CPU2/Application/Src/measure_oilLevel.c:determine_level_status_internal():1661 | 空指针、输出参数、数组计数或内部缓冲边界异常 | 函数内仅见 printf/调试输出，未见统一 ErrorLog_* | 空指针/真实地址/索引的区分、缓冲长度、点数、地址或范围上下限 | 模块：调用模块；操作：参数/缓冲校验；原因：地址或内部边界异常；字段：参数名、地址、长度、索引、范围 | 测量/运动状态机敏感；不得改变返回值、重试、错误置位或状态切换 | 清单阶段无源码改动；后续实施必须保持返回值、重试、停机、恢复和状态机不变 | 第3.3收窄候选；本阶段只补上下文 | 参数缺失、非法值和边界输入验证；核对最终错误出口 | 清单完成，待源码批次审批 |
| P4-057 | 0x00110004 PARAM_ADDRESS_OVERFLOW | LTD_MAIN_CPU2/Application/Src/measure_waterLevel.c:check_water_status():713 | 空指针、输出参数、数组计数或内部缓冲边界异常 | 函数内仅见 printf/调试输出，未见统一 ErrorLog_* | 空指针/真实地址/索引的区分、缓冲长度、点数、地址或范围上下限 | 模块：调用模块；操作：参数/缓冲校验；原因：地址或内部边界异常；字段：参数名、地址、长度、索引、范围 | 测量/运动状态机敏感；不得改变返回值、重试、错误置位或状态切换 | 清单阶段无源码改动；后续实施必须保持返回值、重试、停机、恢复和状态机不变 | 第3.3收窄候选；本阶段只补上下文 | 参数缺失、非法值和边界输入验证；核对最终错误出口 | 清单完成，待源码批次审批 |
| P4-058 | 0x00110004 PARAM_ADDRESS_OVERFLOW | LTD_MAIN_CPU2/Application/Src/test.c:Test_MotorTextDistanceToTicksNoCheck():288 | 诊断/自测辅助入口的参数或边界失败 | 函数内未见 ErrorLog_* 或 printf | 空指针/真实地址/索引的区分、缓冲长度、点数、地址或范围上下限 | 模块：调用模块；操作：参数/缓冲校验；原因：地址或内部边界异常；字段：参数名、地址、长度、索引、范围 | 仅诊断测试路径，不纳入现场日志源码批次 | 清单阶段无源码改动；后续实施必须保持返回值、重试、停机、恢复和状态机不变 | 排除源码实施；仅保留诊断测试记录 | 静态确认测试入口不进入现场日志批次 | 清单完成，待源码批次审批 |
| P4-059 | 0x00110004 PARAM_ADDRESS_OVERFLOW | LTD_MAIN_CPU2/Application/Src/wartsila_density_measurement.c:Wartsila_MoveToDensityPoint():137 | 测点数组、点数、输出缓冲或索引边界异常 | 函数内仅见 printf/调试输出，未见统一 ErrorLog_* | 空指针/真实地址/索引的区分、缓冲长度、点数、地址或范围上下限 | 模块：调用模块；操作：参数/缓冲校验；原因：地址或内部边界异常；字段：参数名、地址、长度、索引、范围 | 测量/运动状态机敏感；不得改变返回值、重试、错误置位或状态切换 | 清单阶段无源码改动；后续实施必须保持返回值、重试、停机、恢复和状态机不变 | 第3.3收窄候选；本阶段只补上下文 | 参数缺失、非法值和边界输入验证；核对最终错误出口 | 清单完成，待源码批次审批 |
| P4-060 | 0x00110004 PARAM_ADDRESS_OVERFLOW | LTD_MAIN_CPU2/Application/Src/wartsila_density_measurement.c:Wartsila_ReadPointAndClassify():202 | 测点数组、点数、输出缓冲或索引边界异常 | 函数内未见 ErrorLog_* 或 printf | 空指针/真实地址/索引的区分、缓冲长度、点数、地址或范围上下限 | 模块：调用模块；操作：参数/缓冲校验；原因：地址或内部边界异常；字段：参数名、地址、长度、索引、范围 | 测量/运动状态机敏感；不得改变返回值、重试、错误置位或状态切换 | 清单阶段无源码改动；后续实施必须保持返回值、重试、停机、恢复和状态机不变 | 第3.3收窄候选；本阶段只补上下文 | 参数缺失、非法值和边界输入验证；核对最终错误出口 | 清单完成，待源码批次审批 |
| P4-061 | 0x00110004 PARAM_ADDRESS_OVERFLOW | LTD_MAIN_CPU2/Application/Src/wartsila_density_measurement.c:Wartsila_MoveDownToLiquidAfterAirPoint():328 | 测点数组、点数、输出缓冲或索引边界异常 | 函数内仅见 printf/调试输出，未见统一 ErrorLog_* | 空指针/真实地址/索引的区分、缓冲长度、点数、地址或范围上下限 | 模块：调用模块；操作：参数/缓冲校验；原因：地址或内部边界异常；字段：参数名、地址、长度、索引、范围 | 测量/运动状态机敏感；不得改变返回值、重试、错误置位或状态切换 | 清单阶段无源码改动；后续实施必须保持返回值、重试、停机、恢复和状态机不变 | 第3.3收窄候选；本阶段只补上下文 | 参数缺失、非法值和边界输入验证；核对最终错误出口 | 清单完成，待源码批次审批 |
| P4-062 | 0x00110004 PARAM_ADDRESS_OVERFLOW | LTD_MAIN_CPU2/Application/Src/wartsila_density_measurement.c:Wartsila_TrimPointsByOilLevel():433 | 测点数组、点数、输出缓冲或索引边界异常 | 函数内仅见 printf/调试输出，未见统一 ErrorLog_* | 空指针/真实地址/索引的区分、缓冲长度、点数、地址或范围上下限 | 模块：调用模块；操作：参数/缓冲校验；原因：地址或内部边界异常；字段：参数名、地址、长度、索引、范围 | 测量/运动状态机敏感；不得改变返回值、重试、错误置位或状态切换 | 清单阶段无源码改动；后续实施必须保持返回值、重试、停机、恢复和状态机不变 | 第3.3收窄候选；本阶段只补上下文 | 参数缺失、非法值和边界输入验证；核对最终错误出口 | 清单完成，待源码批次审批 |
| P4-063 | 0x00110004 PARAM_ADDRESS_OVERFLOW | LTD_MAIN_CPU2/Application/Src/wartsila_density_measurement.c:Wartsila_Density_SpreadMeasurement():475 | 测点数组、点数、输出缓冲或索引边界异常 | 函数内仅见 printf/调试输出，未见统一 ErrorLog_* | 空指针/真实地址/索引的区分、缓冲长度、点数、地址或范围上下限 | 模块：调用模块；操作：参数/缓冲校验；原因：地址或内部边界异常；字段：参数名、地址、长度、索引、范围 | 测量/运动状态机敏感；不得改变返回值、重试、错误置位或状态切换 | 清单阶段无源码改动；后续实施必须保持返回值、重试、停机、恢复和状态机不变 | 第3.3收窄候选；本阶段只补上下文 | 参数缺失、非法值和边界输入验证；核对最终错误出口 | 清单完成，待源码批次审批 |
| P4-064 | 0x00110004 PARAM_ADDRESS_OVERFLOW | LTD_MAIN_CPU2/BSP/Peripherals/src/TMC5130.c:stpr_moveBy():576 | TMC 接口参数、寄存器地址或输出参数边界异常 | 函数内仅见 printf/调试输出，未见统一 ErrorLog_* | 空指针/真实地址/索引的区分、缓冲长度、点数、地址或范围上下限 | 模块：调用模块；操作：参数/缓冲校验；原因：地址或内部边界异常；字段：参数名、地址、长度、索引、范围 | SPI和运动时序敏感；避免重复最终报错，不改变停机/恢复分类 | 清单阶段无源码改动；后续实施必须保持返回值、重试、停机、恢复和状态机不变 | 第3.3收窄候选；本阶段只补上下文 | 参数缺失、非法值和边界输入验证；核对最终错误出口 | 清单完成，待源码批次审批 |
| P4-065 | 0x00110004 PARAM_ADDRESS_OVERFLOW | LTD_MAIN_CPU2/BSP/Peripherals/src/TMC5130.c:stpr_initStepper():1015 | TMC 接口参数、寄存器地址或输出参数边界异常 | 函数内仅见 printf/调试输出，未见统一 ErrorLog_* | 空指针/真实地址/索引的区分、缓冲长度、点数、地址或范围上下限 | 模块：调用模块；操作：参数/缓冲校验；原因：地址或内部边界异常；字段：参数名、地址、长度、索引、范围 | SPI和运动时序敏感；避免重复最终报错，不改变停机/恢复分类 | 清单阶段无源码改动；后续实施必须保持返回值、重试、停机、恢复和状态机不变 | 第3.3收窄候选；本阶段只补上下文 | 参数缺失、非法值和边界输入验证；核对最终错误出口 | 清单完成，待源码批次审批 |
| P4-066 | 0x00110004 PARAM_ADDRESS_OVERFLOW | LTD_MAIN_CPU2/Services/MotorControl/motor_ctrl_position_model.c:MotorPosition_RestorePersistedRegisters():877 | 持久化电机位置寄存器地址/范围异常 | 函数内仅见 printf/调试输出，未见统一 ErrorLog_* | 空指针/真实地址/索引的区分、缓冲长度、点数、地址或范围上下限 | 模块：调用模块；操作：参数/缓冲校验；原因：地址或内部边界异常；字段：参数名、地址、长度、索引、范围 | SPI和运动时序敏感；避免重复最终报错，不改变停机/恢复分类 | 清单阶段无源码改动；后续实施必须保持返回值、重试、停机、恢复和状态机不变 | 保持现码：真实地址/存储边界 | 目标越界、位置源无效、到位偏差注入；核对运动停止和恢复 | 清单完成，待源码批次审批 |
| P4-067 | 0x00110004 PARAM_ADDRESS_OVERFLOW | LTD_MAIN_CPU2/Services/ParamStorage/system_parameter.c:save_device_params_internal():751 | 参数存储地址、结构大小或 FRAM 边界异常 | 函数内仅见 printf/调试输出，未见统一 ErrorLog_* | 空指针/真实地址/索引的区分、缓冲长度、点数、地址或范围上下限 | 模块：调用模块；操作：参数/缓冲校验；原因：地址或内部边界异常；字段：参数名、地址、长度、索引、范围 | FRAM/启动与持锁路径；避免阻塞，区分真实存储边界 | 清单阶段无源码改动；后续实施必须保持返回值、重试、停机、恢复和状态机不变 | 保持现码：真实地址/存储边界 | 空指针、地址边界、结构大小和FRAM读写失败静态/单元验证 | 清单完成，待源码批次审批 |
| P4-068 | 0x00110004 PARAM_ADDRESS_OVERFLOW | LTD_MAIN_CPU2/Services/ParamStorage/system_parameter.c:load_device_params():850 | 参数存储地址、结构大小或 FRAM 边界异常 | 函数内已有 ErrorLog_*；需确认是否覆盖本分支及关键字段 | 空指针/真实地址/索引的区分、缓冲长度、点数、地址或范围上下限 | 模块：调用模块；操作：参数/缓冲校验；原因：地址或内部边界异常；字段：参数名、地址、长度、索引、范围 | FRAM/启动与持锁路径；避免阻塞，区分真实存储边界 | 清单阶段无源码改动；后续实施必须保持返回值、重试、停机、恢复和状态机不变 | 保持现码：真实地址/存储边界 | 空指针、地址边界、结构大小和FRAM读写失败静态/单元验证 | 清单完成，待源码批次审批 |
| P4-069 | 0x00110004 PARAM_ADDRESS_OVERFLOW | LTD_MAIN_CPU2/Services/Sensor/ch9141_at.c:CH9141_AT_CollectResponse():463 | 响应缓冲、输出指针、解析长度或 AT 参数边界异常 | 函数内未见 ErrorLog_* 或 printf | 空指针/真实地址/索引的区分、缓冲长度、点数、地址或范围上下限 | 模块：调用模块；操作：参数/缓冲校验；原因：地址或内部边界异常；字段：参数名、地址、长度、索引、范围 | UART/DMA/重试时序敏感；ISR仅置标志，避免循环内高频打印 | 清单阶段无源码改动；后续实施必须保持返回值、重试、停机、恢复和状态机不变 | 第3.3收窄候选；本阶段只补上下文 | 无响应/部分帧/格式错/UART错误注入；核对ISR边界和重试结果 | 清单完成，待源码批次审批 |
| P4-070 | 0x00110004 PARAM_ADDRESS_OVERFLOW | LTD_MAIN_CPU2/Services/Sensor/ch9141_at.c:CH9141_AT_WaitAsync():605 | 响应缓冲、输出指针、解析长度或 AT 参数边界异常 | 函数内仅见 printf/调试输出，未见统一 ErrorLog_* | 空指针/真实地址/索引的区分、缓冲长度、点数、地址或范围上下限 | 模块：调用模块；操作：参数/缓冲校验；原因：地址或内部边界异常；字段：参数名、地址、长度、索引、范围 | UART/DMA/重试时序敏感；ISR仅置标志，避免循环内高频打印 | 清单阶段无源码改动；后续实施必须保持返回值、重试、停机、恢复和状态机不变 | 第3.3收窄候选；本阶段只补上下文 | 无响应/部分帧/格式错/UART错误注入；核对ISR边界和重试结果 | 清单完成，待源码批次审批 |
| P4-071 | 0x00110004 PARAM_ADDRESS_OVERFLOW | LTD_MAIN_CPU2/Services/Sensor/ch9141_at.c:CH9141_AT_SendCommand():642 | 响应缓冲、输出指针、解析长度或 AT 参数边界异常 | 函数内仅见 printf/调试输出，未见统一 ErrorLog_* | 空指针/真实地址/索引的区分、缓冲长度、点数、地址或范围上下限 | 模块：调用模块；操作：参数/缓冲校验；原因：地址或内部边界异常；字段：参数名、地址、长度、索引、范围 | UART/DMA/重试时序敏感；ISR仅置标志，避免循环内高频打印 | 清单阶段无源码改动；后续实施必须保持返回值、重试、停机、恢复和状态机不变 | 第3.3收窄候选；本阶段只补上下文 | 无响应/部分帧/格式错/UART错误注入；核对ISR边界和重试结果 | 清单完成，待源码批次审批 |
| P4-072 | 0x00110004 PARAM_ADDRESS_OVERFLOW | LTD_MAIN_CPU2/Services/Sensor/dsm_sensor_communication.c:Read_Sensor_Voltage():510 | 响应缓冲、输出指针、解析长度或 AT 参数边界异常 | 函数内仅见 printf/调试输出，未见统一 ErrorLog_* | 空指针/真实地址/索引的区分、缓冲长度、点数、地址或范围上下限 | 模块：调用模块；操作：参数/缓冲校验；原因：地址或内部边界异常；字段：参数名、地址、长度、索引、范围 | UART/DMA/重试时序敏感；ISR仅置标志，避免循环内高频打印 | 清单阶段无源码改动；后续实施必须保持返回值、重试、停机、恢复和状态机不变 | 第3.3收窄候选；本阶段只补上下文 | 无响应/部分帧/格式错/UART错误注入；核对ISR边界和重试结果 | 清单完成，待源码批次审批 |
| P4-073 | 0x00110004 PARAM_ADDRESS_OVERFLOW | LTD_MAIN_CPU2/Services/Sensor/dsm_sensor_communication.c:parse_freq_response():604 | 响应缓冲、输出指针、解析长度或 AT 参数边界异常 | 函数内未见 ErrorLog_* 或 printf | 空指针/真实地址/索引的区分、缓冲长度、点数、地址或范围上下限 | 模块：调用模块；操作：参数/缓冲校验；原因：地址或内部边界异常；字段：参数名、地址、长度、索引、范围 | UART/DMA/重试时序敏感；ISR仅置标志，避免循环内高频打印 | 清单阶段无源码改动；后续实施必须保持返回值、重试、停机、恢复和状态机不变 | 第3.3收窄候选；本阶段只补上下文 | 无响应/部分帧/格式错/UART错误注入；核对ISR边界和重试结果 | 清单完成，待源码批次审批 |
| P4-074 | 0x00110004 PARAM_ADDRESS_OVERFLOW | LTD_MAIN_CPU2/Services/Sensor/dsm_sensor_communication.c:Read_Level_Frequency():626 | 响应缓冲、输出指针、解析长度或 AT 参数边界异常 | 函数内仅见 printf/调试输出，未见统一 ErrorLog_* | 空指针/真实地址/索引的区分、缓冲长度、点数、地址或范围上下限 | 模块：调用模块；操作：参数/缓冲校验；原因：地址或内部边界异常；字段：参数名、地址、长度、索引、范围 | UART/DMA/重试时序敏感；ISR仅置标志，避免循环内高频打印 | 清单阶段无源码改动；后续实施必须保持返回值、重试、停机、恢复和状态机不变 | 第3.3收窄候选；本阶段只补上下文 | 无响应/部分帧/格式错/UART错误注入；核对ISR边界和重试结果 | 清单完成，待源码批次审批 |
| P4-075 | 0x00110004 PARAM_ADDRESS_OVERFLOW | LTD_MAIN_CPU2/Services/Sensor/dsm_sensor_communication.c:DSM_Read_Frequency_Density_Temp():650 | 响应缓冲、输出指针、解析长度或 AT 参数边界异常 | 函数内未见 ErrorLog_* 或 printf | 空指针/真实地址/索引的区分、缓冲长度、点数、地址或范围上下限 | 模块：调用模块；操作：参数/缓冲校验；原因：地址或内部边界异常；字段：参数名、地址、长度、索引、范围 | UART/DMA/重试时序敏感；ISR仅置标志，避免循环内高频打印 | 清单阶段无源码改动；后续实施必须保持返回值、重试、停机、恢复和状态机不变 | 第3.3收窄候选；本阶段只补上下文 | 无响应/部分帧/格式错/UART错误注入；核对ISR边界和重试结果 | 清单完成，待源码批次审批 |
| P4-076 | 0x00110004 PARAM_ADDRESS_OVERFLOW | LTD_MAIN_CPU2/Services/Sensor/dsm_sensor_communication.c:Read_VibrationTube_ID():697 | 响应缓冲、输出指针、解析长度或 AT 参数边界异常 | 函数内仅见 printf/调试输出，未见统一 ErrorLog_* | 空指针/真实地址/索引的区分、缓冲长度、点数、地址或范围上下限 | 模块：调用模块；操作：参数/缓冲校验；原因：地址或内部边界异常；字段：参数名、地址、长度、索引、范围 | UART/DMA/重试时序敏感；ISR仅置标志，避免循环内高频打印 | 清单阶段无源码改动；后续实施必须保持返回值、重试、停机、恢复和状态机不变 | 第3.3收窄候选；本阶段只补上下文 | 无响应/部分帧/格式错/UART错误注入；核对ISR边界和重试结果 | 清单完成，待源码批次审批 |
| P4-077 | 0x00110004 PARAM_ADDRESS_OVERFLOW | LTD_MAIN_CPU2/Services/Sensor/dsm_sensor_communication.c:Read_Water_Capacitance():761 | 响应缓冲、输出指针、解析长度或 AT 参数边界异常 | 函数内未见 ErrorLog_* 或 printf | 空指针/真实地址/索引的区分、缓冲长度、点数、地址或范围上下限 | 模块：调用模块；操作：参数/缓冲校验；原因：地址或内部边界异常；字段：参数名、地址、长度、索引、范围 | UART/DMA/重试时序敏感；ISR仅置标志，避免循环内高频打印 | 清单阶段无源码改动；后续实施必须保持返回值、重试、停机、恢复和状态机不变 | 第3.3收窄候选；本阶段只补上下文 | 无响应/部分帧/格式错/UART错误注入；核对ISR边界和重试结果 | 清单完成，待源码批次审批 |
| P4-078 | 0x00110004 PARAM_ADDRESS_OVERFLOW | LTD_MAIN_CPU2/Services/Sensor/dsm_sensor_communication.c:Read_Gyro_Angle():838 | 响应缓冲、输出指针、解析长度或 AT 参数边界异常 | 函数内未见 ErrorLog_* 或 printf | 空指针/真实地址/索引的区分、缓冲长度、点数、地址或范围上下限 | 模块：调用模块；操作：参数/缓冲校验；原因：地址或内部边界异常；字段：参数名、地址、长度、索引、范围 | UART/DMA/重试时序敏感；ISR仅置标志，避免循环内高频打印 | 清单阶段无源码改动；后续实施必须保持返回值、重试、停机、恢复和状态机不变 | 第3.3收窄候选；本阶段只补上下文 | 无响应/部分帧/格式错/UART错误注入；核对ISR边界和重试结果 | 清单完成，待源码批次审批 |
| P4-079 | 0x00110004 PARAM_ADDRESS_OVERFLOW | LTD_MAIN_CPU2/Services/Sensor/ltd_sensor_communication.c:DSM_V2_Read_FloatParam():381 | 响应缓冲、输出指针、解析长度或 AT 参数边界异常 | 函数内已有 ErrorLog_*；需确认是否覆盖本分支及关键字段 | 空指针/真实地址/索引的区分、缓冲长度、点数、地址或范围上下限 | 模块：调用模块；操作：参数/缓冲校验；原因：地址或内部边界异常；字段：参数名、地址、长度、索引、范围 | UART/DMA/重试时序敏感；ISR仅置标志，避免循环内高频打印 | 清单阶段无源码改动；后续实施必须保持返回值、重试、停机、恢复和状态机不变 | 第3.3收窄候选；本阶段只补上下文 | 无响应/部分帧/格式错/UART错误注入；核对ISR边界和重试结果 | 清单完成，待源码批次审批 |
| P4-080 | 0x00110004 PARAM_ADDRESS_OVERFLOW | LTD_MAIN_CPU2/Services/Sensor/ltd_sensor_communication.c:DSM_V2_Read_IntParamInternal():463 | 响应缓冲、输出指针、解析长度或 AT 参数边界异常 | 函数内已有 ErrorLog_*；需确认是否覆盖本分支及关键字段 | 空指针/真实地址/索引的区分、缓冲长度、点数、地址或范围上下限 | 模块：调用模块；操作：参数/缓冲校验；原因：地址或内部边界异常；字段：参数名、地址、长度、索引、范围 | UART/DMA/重试时序敏感；ISR仅置标志，避免循环内高频打印 | 清单阶段无源码改动；后续实施必须保持返回值、重试、停机、恢复和状态机不变 | 第3.3收窄候选；本阶段只补上下文 | 无响应/部分帧/格式错/UART错误注入；核对ISR边界和重试结果 | 清单完成，待源码批次审批 |
| P4-081 | 0x00110004 PARAM_ADDRESS_OVERFLOW | LTD_MAIN_CPU2/Services/Sensor/ltd_sensor_communication.c:DSM_V2_Read_LevelFrequency():599 | 响应缓冲、输出指针、解析长度或 AT 参数边界异常 | 函数内未见 ErrorLog_* 或 printf | 空指针/真实地址/索引的区分、缓冲长度、点数、地址或范围上下限 | 模块：调用模块；操作：参数/缓冲校验；原因：地址或内部边界异常；字段：参数名、地址、长度、索引、范围 | UART/DMA/重试时序敏感；ISR仅置标志，避免循环内高频打印 | 清单阶段无源码改动；后续实施必须保持返回值、重试、停机、恢复和状态机不变 | 第3.3收窄候选；本阶段只补上下文 | 无响应/部分帧/格式错/UART错误注入；核对ISR边界和重试结果 | 清单完成，待源码批次审批 |
| P4-082 | 0x00110004 PARAM_ADDRESS_OVERFLOW | LTD_MAIN_CPU2/Services/Sensor/ltd_sensor_communication.c:DSM_V2_Read_DensityFrequency():617 | 响应缓冲、输出指针、解析长度或 AT 参数边界异常 | 函数内仅见 printf/调试输出，未见统一 ErrorLog_* | 空指针/真实地址/索引的区分、缓冲长度、点数、地址或范围上下限 | 模块：调用模块；操作：参数/缓冲校验；原因：地址或内部边界异常；字段：参数名、地址、长度、索引、范围 | UART/DMA/重试时序敏感；ISR仅置标志，避免循环内高频打印 | 清单阶段无源码改动；后续实施必须保持返回值、重试、停机、恢复和状态机不变 | 第3.3收窄候选；本阶段只补上下文 | 无响应/部分帧/格式错/UART错误注入；核对ISR边界和重试结果 | 清单完成，待源码批次审批 |
| P4-083 | 0x00110004 PARAM_ADDRESS_OVERFLOW | LTD_MAIN_CPU2/Services/Sensor/ltd_sensor_communication.c:DSM_V2_Read_SensorID():648 | 响应缓冲、输出指针、解析长度或 AT 参数边界异常 | 函数内未见 ErrorLog_* 或 printf | 空指针/真实地址/索引的区分、缓冲长度、点数、地址或范围上下限 | 模块：调用模块；操作：参数/缓冲校验；原因：地址或内部边界异常；字段：参数名、地址、长度、索引、范围 | UART/DMA/重试时序敏感；ISR仅置标志，避免循环内高频打印 | 清单阶段无源码改动；后续实施必须保持返回值、重试、停机、恢复和状态机不变 | 第3.3收窄候选；本阶段只补上下文 | 无响应/部分帧/格式错/UART错误注入；核对ISR边界和重试结果 | 清单完成，待源码批次审批 |
| P4-084 | 0x00110004 PARAM_ADDRESS_OVERFLOW | LTD_MAIN_CPU2/Services/Sensor/ltd_sensor_communication.c:DSM_V2_Probe_SensorID():659 | 响应缓冲、输出指针、解析长度或 AT 参数边界异常 | 函数内未见 ErrorLog_* 或 printf | 空指针/真实地址/索引的区分、缓冲长度、点数、地址或范围上下限 | 模块：调用模块；操作：参数/缓冲校验；原因：地址或内部边界异常；字段：参数名、地址、长度、索引、范围 | UART/DMA/重试时序敏感；ISR仅置标志，避免循环内高频打印 | 清单阶段无源码改动；后续实施必须保持返回值、重试、停机、恢复和状态机不变 | 第3.3收窄候选；本阶段只补上下文 | 无响应/部分帧/格式错/UART错误注入；核对ISR边界和重试结果 | 清单完成，待源码批次审批 |
| P4-085 | 0x00110004 PARAM_ADDRESS_OVERFLOW | LTD_MAIN_CPU2/Services/Sensor/sensor.c:Sensor_ParseDsmTextId():174 | 响应缓冲、输出指针、解析长度或 AT 参数边界异常 | 函数内未见 ErrorLog_* 或 printf | 空指针/真实地址/索引的区分、缓冲长度、点数、地址或范围上下限 | 模块：调用模块；操作：参数/缓冲校验；原因：地址或内部边界异常；字段：参数名、地址、长度、索引、范围 | UART/DMA/重试时序敏感；ISR仅置标志，避免循环内高频打印 | 清单阶段无源码改动；后续实施必须保持返回值、重试、停机、恢复和状态机不变 | 第3.3收窄候选；本阶段只补上下文 | 无响应/部分帧/格式错/UART错误注入；核对ISR边界和重试结果 | 清单完成，待源码批次审批 |
| P4-086 | 0x00110004 PARAM_ADDRESS_OVERFLOW | LTD_MAIN_CPU2/Services/Sensor/sensor.c:DSM_Get_LevelMode_Frequence():472 | 响应缓冲、输出指针、解析长度或 AT 参数边界异常 | 函数内已有 ErrorLog_*；需确认是否覆盖本分支及关键字段 | 空指针/真实地址/索引的区分、缓冲长度、点数、地址或范围上下限 | 模块：调用模块；操作：参数/缓冲校验；原因：地址或内部边界异常；字段：参数名、地址、长度、索引、范围 | UART/DMA/重试时序敏感；ISR仅置标志，避免循环内高频打印 | 清单阶段无源码改动；后续实施必须保持返回值、重试、停机、恢复和状态机不变 | 第3.3收窄候选；本阶段只补上下文 | 无响应/部分帧/格式错/UART错误注入；核对ISR边界和重试结果 | 清单完成，待源码批次审批 |
| P4-087 | 0x00110004 PARAM_ADDRESS_OVERFLOW | LTD_MAIN_CPU2/Services/Sensor/sensor.c:DSM_Get_LevelMode_Frequence_Avg():546 | 响应缓冲、输出指针、解析长度或 AT 参数边界异常 | 函数内仅见 printf/调试输出，未见统一 ErrorLog_* | 空指针/真实地址/索引的区分、缓冲长度、点数、地址或范围上下限 | 模块：调用模块；操作：参数/缓冲校验；原因：地址或内部边界异常；字段：参数名、地址、长度、索引、范围 | UART/DMA/重试时序敏感；ISR仅置标志，避免循环内高频打印 | 清单阶段无源码改动；后续实施必须保持返回值、重试、停机、恢复和状态机不变 | 第3.3收窄候选；本阶段只补上下文 | 无响应/部分帧/格式错/UART错误注入；核对ISR边界和重试结果 | 清单完成，待源码批次审批 |
| P4-088 | 0x00110004 PARAM_ADDRESS_OVERFLOW | LTD_MAIN_CPU2/Services/Sensor/sensor.c:Read_Density_text():601 | 响应缓冲、输出指针、解析长度或 AT 参数边界异常 | 函数内仅见 printf/调试输出，未见统一 ErrorLog_* | 空指针/真实地址/索引的区分、缓冲长度、点数、地址或范围上下限 | 模块：调用模块；操作：参数/缓冲校验；原因：地址或内部边界异常；字段：参数名、地址、长度、索引、范围 | UART/DMA/重试时序敏感；ISR仅置标志，避免循环内高频打印 | 清单阶段无源码改动；后续实施必须保持返回值、重试、停机、恢复和状态机不变 | 第3.3收窄候选；本阶段只补上下文 | 无响应/部分帧/格式错/UART错误注入；核对ISR边界和重试结果 | 清单完成，待源码批次审批 |
| P4-089 | 0x00110004 PARAM_ADDRESS_OVERFLOW | LTD_MAIN_CPU2/Services/Sensor/sensor.c:Read_Density():639 | 响应缓冲、输出指针、解析长度或 AT 参数边界异常 | 函数内仅见 printf/调试输出，未见统一 ErrorLog_* | 空指针/真实地址/索引的区分、缓冲长度、点数、地址或范围上下限 | 模块：调用模块；操作：参数/缓冲校验；原因：地址或内部边界异常；字段：参数名、地址、长度、索引、范围 | UART/DMA/重试时序敏感；ISR仅置标志，避免循环内高频打印 | 清单阶段无源码改动；后续实施必须保持返回值、重试、停机、恢复和状态机不变 | 第3.3收窄候选；本阶段只补上下文 | 无响应/部分帧/格式错/UART错误注入；核对ISR边界和重试结果 | 清单完成，待源码批次审批 |
| P4-090 | 0x00110004 PARAM_ADDRESS_OVERFLOW | LTD_MAIN_CPU2/Services/Sensor/wireless_pairing.c:WirelessPairing_Scan():1263 | 响应缓冲、输出指针、解析长度或 AT 参数边界异常 | 函数内仅见 printf/调试输出，未见统一 ErrorLog_* | 空指针/真实地址/索引的区分、缓冲长度、点数、地址或范围上下限 | 模块：调用模块；操作：参数/缓冲校验；原因：地址或内部边界异常；字段：参数名、地址、长度、索引、范围 | UART/DMA/重试时序敏感；ISR仅置标志，避免循环内高频打印 | 清单阶段无源码改动；后续实施必须保持返回值、重试、停机、恢复和状态机不变 | 第3.3收窄候选；本阶段只补上下文 | 无响应/部分帧/格式错/UART错误注入；核对ISR边界和重试结果 | 清单完成，待源码批次审批 |
| P4-091 | 0x00110004 PARAM_ADDRESS_OVERFLOW | LTD_MAIN_CPU2/Services/Sensor/wireless_pairing.c:WirelessPairing_ConnectAndSave():1429 | 响应缓冲、输出指针、解析长度或 AT 参数边界异常 | 函数内仅见 printf/调试输出，未见统一 ErrorLog_* | 空指针/真实地址/索引的区分、缓冲长度、点数、地址或范围上下限 | 模块：调用模块；操作：参数/缓冲校验；原因：地址或内部边界异常；字段：参数名、地址、长度、索引、范围 | UART/DMA/重试时序敏感；ISR仅置标志，避免循环内高频打印 | 清单阶段无源码改动；后续实施必须保持返回值、重试、停机、恢复和状态机不变 | 第3.3收窄候选；本阶段只补上下文 | 无响应/部分帧/格式错/UART错误注入；核对ISR边界和重试结果 | 清单完成，待源码批次审批 |
| P4-092 | 0x00110004 PARAM_ADDRESS_OVERFLOW | LTD_MAIN_CPU2/Services/Sensor/wireless_pairing.c:WirelessPairing_ReadConnectionStatus():1557 | 响应缓冲、输出指针、解析长度或 AT 参数边界异常 | 函数内仅见 printf/调试输出，未见统一 ErrorLog_* | 空指针/真实地址/索引的区分、缓冲长度、点数、地址或范围上下限 | 模块：调用模块；操作：参数/缓冲校验；原因：地址或内部边界异常；字段：参数名、地址、长度、索引、范围 | UART/DMA/重试时序敏感；ISR仅置标志，避免循环内高频打印 | 清单阶段无源码改动；后续实施必须保持返回值、重试、停机、恢复和状态机不变 | 第3.3收窄候选；本阶段只补上下文 | 无响应/部分帧/格式错/UART错误注入；核对ISR边界和重试结果 | 清单完成，待源码批次审批 |
| P4-093 | 0x00130004 OTHER_PERIPHERAL_CONFIG_ERROR | LTD_MAIN_CPU2/Application/Src/measure_tank_height.c:check_bottom_status():861 | 测量校准/外设配置失败被归入系统兜底 | 函数内仅见 printf/调试输出，未见统一 ErrorLog_* | 真实外设、操作阶段、SPI/UART/锁状态、底层返回值、配置项 | 模块：真实责任域；操作：外设启动/访问；原因：底层配置或通信失败；字段：外设、阶段、状态、返回值 | 测量/运动状态机敏感；不得改变返回值、重试、错误置位或状态切换 | 清单阶段无源码改动；后续实施必须保持返回值、重试、停机、恢复和状态机不变 | 真实外设/校准责任域回收候选 | 参数缺失、非法值和边界输入验证；核对最终错误出口 | 清单完成，待源码批次审批 |
| P4-094 | 0x000F0001 MEASUREMENT_POSITION_ERROR | LTD_MAIN_CPU2/Application/Src/wartsila_density_measurement.c:Wartsila_MoveToDensityPoint():174 | Wartsila 测点目标或到位结果不满足位置要求 | 函数内仅见 printf/调试输出，未见统一 ErrorLog_* | 测量阶段、目标位置、当前位置、位置源、允许范围、停止/恢复结果 | 模块：电机/测量；操作：目标规划或到位校验；原因：位置异常；字段：阶段、目标、当前、来源、范围 | 测量/运动状态机敏感；不得改变返回值、重试、错误置位或状态切换 | 清单阶段无源码改动；后续实施必须保持返回值、重试、停机、恢复和状态机不变 | 保持现码；到位/恢复校验拆分条件候选 | 目标越界、位置源无效、到位偏差注入；核对运动停止和恢复 | 清单完成，待源码批次审批 |
| P4-095 | 0x000F0001 MEASUREMENT_POSITION_ERROR | LTD_MAIN_CPU2/Services/MotorControl/motor_ctrl_motion_api.c:MotorMotion_BuildRelativeTargetPlan():1833 | 相对/绝对运动目标不可达或超出位置范围 | 函数内未见 ErrorLog_* 或 printf | 测量阶段、目标位置、当前位置、位置源、允许范围、停止/恢复结果 | 模块：电机/测量；操作：目标规划或到位校验；原因：位置异常；字段：阶段、目标、当前、来源、范围 | SPI和运动时序敏感；避免重复最终报错，不改变停机/恢复分类 | 清单阶段无源码改动；后续实施必须保持返回值、重试、停机、恢复和状态机不变 | 保持现码；目标非法拆分条件候选 | 目标越界、位置源无效、到位偏差注入；核对运动停止和恢复 | 清单完成，待源码批次审批 |
| P4-096 | 0x000F0001 MEASUREMENT_POSITION_ERROR | LTD_MAIN_CPU2/Services/MotorControl/motor_ctrl_motion_api.c:MotorMotion_BuildAbsoluteTargetPlan():1875 | 相对/绝对运动目标不可达或超出位置范围 | 函数内未见 ErrorLog_* 或 printf | 测量阶段、目标位置、当前位置、位置源、允许范围、停止/恢复结果 | 模块：电机/测量；操作：目标规划或到位校验；原因：位置异常；字段：阶段、目标、当前、来源、范围 | SPI和运动时序敏感；避免重复最终报错，不改变停机/恢复分类 | 清单阶段无源码改动；后续实施必须保持返回值、重试、停机、恢复和状态机不变 | 保持现码；目标非法拆分条件候选 | 目标越界、位置源无效、到位偏差注入；核对运动停止和恢复 | 清单完成，待源码批次审批 |
| P4-097 | 0x000F0001 MEASUREMENT_POSITION_ERROR | LTD_MAIN_CPU2/Services/MotorControl/motor_ctrl_motion_api.c:MotorMotion_RefreshJogPositionChecked():1978,1984 | 点动过程位置源无效或位置读取失败 | 函数内未见 ErrorLog_* 或 printf | 测量阶段、目标位置、当前位置、位置源、允许范围、停止/恢复结果 | 模块：电机/测量；操作：目标规划或到位校验；原因：位置异常；字段：阶段、目标、当前、来源、范围 | SPI和运动时序敏感；避免重复最终报错，不改变停机/恢复分类 | 清单阶段无源码改动；后续实施必须保持返回值、重试、停机、恢复和状态机不变 | 保持现码；到位/恢复校验拆分条件候选 | 目标越界、位置源无效、到位偏差注入；核对运动停止和恢复 | 清单完成，待源码批次审批 |
| P4-098 | 0x000F0001 MEASUREMENT_POSITION_ERROR | LTD_MAIN_CPU2/Services/MotorControl/motor_ctrl_motion_api.c:MotorMotion_StopJogAndRestore():2237 | 运动停止后的目标恢复或最终位置校验失败 | 函数内仅见 printf/调试输出，未见统一 ErrorLog_* | 测量阶段、目标位置、当前位置、位置源、允许范围、停止/恢复结果 | 模块：电机/测量；操作：目标规划或到位校验；原因：位置异常；字段：阶段、目标、当前、来源、范围 | SPI和运动时序敏感；避免重复最终报错，不改变停机/恢复分类 | 清单阶段无源码改动；后续实施必须保持返回值、重试、停机、恢复和状态机不变 | 保持现码；到位/恢复校验拆分条件候选 | 目标越界、位置源无效、到位偏差注入；核对运动停止和恢复 | 清单完成，待源码批次审批 |

## 6. 明确排除项

以下命中仅消费、比较或辅助引用故障码，不是本轮日志源码实施对象；保留记录用于证明调用点扫描完整。

| ID | 故障码 | 源码位置 | 类型 | 排除理由 |
| --- | --- | --- | --- | --- |
| X-001 | `PARAM_ERROR` | LTD_MAIN_CPU2/Application/Src/fault_recovery.c:FaultRecovery_IsNonRecoverableError():67 | consumer_case | 仅用于恢复/分类 switch，不产生新故障码 |
| X-002 | `PARAM_ADDRESS_OVERFLOW` | LTD_MAIN_CPU2/Application/Src/fault_recovery.c:FaultRecovery_IsNonRecoverableError():66 | consumer_case | 仅用于恢复/分类 switch，不产生新故障码 |
| X-003 | `MOTOR_TMC_COMM_ERROR` | LTD_MAIN_CPU2/Application/Src/fault_recovery.c:FaultRecovery_IsMotorDriverError():45 | consumer_case | 仅用于恢复/分类 switch，不产生新故障码 |
| X-004 | `MOTOR_TMC_COMM_ERROR` | LTD_MAIN_CPU2/Application/Src/measure_zero.c:Zero_IsMotorDriverRecoveryError():66 | consumer_case | 仅用于恢复/分类 switch，不产生新故障码 |
| X-005 | `MOTOR_TMC_COMM_ERROR` | LTD_MAIN_CPU2/BSP/Peripherals/src/TMC5130.c:tmc5130_initWrite():370 | reference | 仅辅助引用，未形成故障码返回/置位 |
| X-006 | `SENSOR_DEVICE_COMM_TIMEOUT` | LTD_MAIN_CPU2/Services/Sensor/ch9141_at.c:CH9141_AT_EnterSoftwareMode():574 | consumer_compare | 仅比较或过滤返回码，不是故障码产生点 |
| X-007 | `SENSOR_DEVICE_COMM_TIMEOUT` | LTD_MAIN_CPU2/Services/Sensor/sensor.c:Sensor_SelectProbeError():40,44 | consumer_compare | 仅比较或过滤返回码，不是故障码产生点 |
| X-008 | `SENSOR_DEVICE_COMM_TIMEOUT` | LTD_MAIN_CPU2/Services/Sensor/sensor.c:Sensor_DiagnoseCommTimeout():86 | consumer_compare | 仅比较或过滤返回码，不是故障码产生点 |
| X-009 | `SENSOR_DEVICE_COMM_TIMEOUT` | LTD_MAIN_CPU2/Services/Sensor/wireless_pairing.c:WirelessPairing_MapBluetoothLinkError():556 | consumer_compare | 仅比较或过滤返回码，不是故障码产生点 |
| X-010 | `SENSOR_DEVICE_COMM_TIMEOUT` | LTD_MAIN_CPU2/Services/Sensor/wireless_pairing.c:WirelessPairing_ResetModule():1152,1157 | consumer_compare | 仅比较或过滤返回码，不是故障码产生点 |
| X-011 | `SENSOR_DEVICE_COMM_TIMEOUT` | LTD_MAIN_CPU2/Services/Sensor/wireless_pairing.c:WirelessPairing_PrintConnectionStatus():1822 | consumer_compare | 仅比较或过滤返回码，不是故障码产生点 |
| X-012 | `OTHER_PERIPHERAL_CONFIG_ERROR` | LTD_MAIN_CPU2/Services/AoOutput/ao_output.c:AoOutput_IsRuntimeDriverError():140 | consumer_compare | 仅比较或过滤返回码，不是故障码产生点 |
| X-013 | `MEASUREMENT_POSITION_ERROR` | LTD_MAIN_CPU2/Services/MotorControl/motor_ctrl_motion_api.c:MotorCtrl_MoveToPosition():697 | consumer_compare | 仅比较或过滤返回码，不是故障码产生点 |
| X-014 | `AD5421_READFAULT_ERROR` | LTD_MAIN_CPU2/Services/AoOutput/ao_output.c:AoOutput_IsRuntimeDriverError():138 | consumer_compare | 仅比较或过滤返回码，不是故障码产生点 |
| X-015 | `AD5421_READFAULT_ERROR` | LTD_MAIN_CPU2/Services/AoOutput/ao_output.c:AoOutput_UpdateInternal():666 | consumer_compare | 仅比较或过滤返回码，不是故障码产生点 |

## 7. 原建议审批批次（均已执行）

清单完成后按以下顺序完成了第 3.2A 审批和四批源码治理，具体结果见交接计划：

1. AD5421/AO：先确认底层只存快照、任务态延后日志的落点。
2. TMC：先补寄存器、读写方向、初始化/运行阶段，不拆对外码。
3. 传感器/无线：先区分无响应、部分帧、格式错误、UART/DMA 和无线 AT 边界。
4. 参数/测量/位置：按模块小批次处理，先参数名和值，再决定收窄或拆分。

四批源码治理完成后，相关专项门禁和 CPU2／CPU3 clean-first 构建均已通过；由于当前窗口没有台架硬件，故障注入统一保留到 FI-01～FI-08，未将其写成已通过。

## 8. 第 3.2 清单完成门槛（已满足）

- 8 个候选码的业务产生点均已记录，非产生点有排除理由。
- 每个函数组均有当前日志、缺失上下文、风险、治理结论和验证方法。
- 内部技术工作簿、README、当前清单和第 3 阶段评审状态同步。
- 文档、链接、表格结构/公式和 diff 检查通过。
- 第 3.2A 审批门槛已结束，后续四批源码治理已完成；当前仍未暂存、未提交、未升固件版本，共享协议版本保持不变。
