duanxuebin1998/cube/docs/00_构建与版本/故障码/故障码第3阶段调用点评审.md

# 故障码第 3 阶段调用点评审

更新日期：2026-07-12

> 历史快照：本文保留协议15、16阶段的评审过程、编号和统计，不作为当前故障码表。现行协议34在协议30故障口径上启用12-6并新增12-17；拆分项、停用项和兼容关系见 `LTD内部技术与治理资料.xlsx` 的“编号迁移”工作表和《当前程序故障代码清单》。历史段落不随现行编号改写。

## 评审范围

本文承接 `当前程序故障代码清单.md` 中标出的 8 项第 3 阶段候选故障码，记录阶段启动时的调用点语义复查和实施判断。本文中的调用次数、问题描述和建议方向作为评审快照保留；后续四批源码治理已经完成，当前结果和待办以 `故障码整体治理执行、当前进度与窗口交接计划.md` 为准。

内部技术工作簿中的“源码使用次数”作为阶段基线统计口径；本文的调用点说明用于追溯当时如何判断语义是否过宽、是否可统一归类、是否值得拆分。

> 路径说明：表内 `LTD_MAIN_CPU2/src/<文件名>:<行号>` 是故障码治理台账导出的归一化定位符，不是当前仓库的真实相对路径；目录重构后行号也只代表本次评审快照。进入源码修改前，必须先按文件名和符号在 `LTD_MAIN_CPU2/Application`、`Services`、`BSP` 中重新定位，不能直接把该定位符当作可访问路径。

| 故障码 | 统一表使用次数 | 当前主要承载语义 | 本阶段建议 | 拆分优先级 |
| --- | ---: | --- | --- | --- |
| `PARAM_ERROR` | 72 | 配置缺失、调用参数非法、电机位置模型参数异常、预留模式误用 | 先文档分桶，不立即拆代码 | 中 |
| `PARAM_ADDRESS_OVERFLOW` | 48 | 名义地址越界，实际大量承载空指针、输出参数非法、缓冲区参数非法 | 后续优先收窄语义 | 高 |
| `SENSOR_RESP_FORMAT_ERROR` | 40 | 传感器响应格式、协议字段解析、UART 硬件异常、无线 AT 响应解析 | 先分责任域，再决定复用或拆分 | 高 |
| `MOTOR_TMC_COMM_ERROR` | 39 | TMC 寄存器读写失败、配置丢失、运行期状态读失败 | 保持恢复大类，内部可拆子因 | 中 |
| `SENSOR_DEVICE_COMM_TIMEOUT` | 18 | DSM/LTD 主链路无响应、CH9141/无线 AT 无完整响应 | 保留传感器主链路语义，无线侧尽量映射专用码 | 中 |
| `OTHER_PERIPHERAL_CONFIG_ERROR` | 17 | AD5421 底层 SPI/锁失败、UART 启动/发送失败、陀螺零点配置异常 | 停止扩大兜底，向真实责任域回收 | 高 |
| `MEASUREMENT_POSITION_ERROR` | 7 | 测量过程中的电机目标位置、位置源和最终位置校验异常 | 保持兼容，后续按电机位置责任域整理 | 中 |
| `AD5421_READFAULT_ERROR` | 2 | 读取故障寄存器失败、故障寄存器已读到但状态异常 | 最适合做小范围拆分 | 中 |

## 总体结论

第 3 阶段评审时没有直接批量改源码。8 项候选码已经进入 CPU2 日志、CPU3 显示和协议资料，直接重命名或改枚举会引入兼容风险，因此先按调用点补齐语义分桶，再按影响面分四批实施。后续实施已完成责任域重排、故障码重编号和4项新增码，CPU2、CPU3共享协议版本由14升至15，并因13/14类别互换继续升至16；本节后续表格保留评审时的判断，当前有效结果以本节“实施结果”和《当前程序故障代码清单》为准。

建议分成三类处理：

| 处理类型 | 对象 | 原因 | 协议15实施结果 |
| --- | --- | --- | --- |
| 收窄兜底 | `PARAM_ADDRESS_OVERFLOW`、`PARAM_ERROR`、`OTHER_PERIPHERAL_CONFIG_ERROR` | 名称和实际调用语义偏差最大，继续新增调用会让定位越来越困难 | 分别调整为19-2数据位置异常、19-3调用条件异常、19-6外部设备配置失败；继续禁止新增泛用兜底 |
| 按责任域回收 | `SENSOR_RESP_FORMAT_ERROR`、`SENSOR_DEVICE_COMM_TIMEOUT`、`MEASUREMENT_POSITION_ERROR` | 通用码混入无线、UART、运动控制等不同责任域 | 传感器格式和超时保留为14-3、14-2；UART传输拆为14-4，无线格式拆为14-11；测量定位归为15-1 |
| 小范围拆分 | `AD5421_READFAULT_ERROR`、部分 `MOTOR_TMC_COMM_ERROR` | 调用点集中，拆分收益明确 | AD5421读取失败调整为16-4并新增16-5主动报警；TMC通信保留11-10并新增11-11配置丢失 |

## `PARAM_ERROR`

### 当前调用语义

`PARAM_ERROR` 当前不是单一“参数错误”，而是多个层次的通用错误出口：

| 语义分桶 | 代表调用点 | 说明 |
| --- | --- | --- |
| 用户配置缺失或配置值无效 | `LTD_MAIN_CPU2/src/measure.c:40`、`LTD_MAIN_CPU2/src/measure_oilLevel.c:473`、`LTD_MAIN_CPU2/src/measure_waterLevel.c:1365` | 例如罐高标定为 0、密度目标未配置、固定频率未配置或超范围 |
| 内部 API 参数非法 | `LTD_MAIN_CPU2/src/ad5421.c:176`、`LTD_MAIN_CPU2/src/sensor.c:728`、`LTD_MAIN_CPU2/src/measure_tank_height.c:805` | 多数是空指针、输出参数为空或内部调用前置条件不满足 |
| 电机位置模型和运动规划异常 | `LTD_MAIN_CPU2/src/motor_ctrl_motion_api.c:1340`、`LTD_MAIN_CPU2/src/motor_ctrl_position_model.c:107`、`LTD_MAIN_CPU2/src/motor_ctrl_tape_fit.c:53` | 覆盖方向非法、位移换算失败、位置模型输入非法、胶带拟合参数非法等 |
| 预留或不支持模式 | `LTD_MAIN_CPU2/src/measure_oilLevel.c:1134`、`LTD_MAIN_CPU2/src/measure_oilLevel.c:1435` | 预留超声测量方法被选中时返回通用参数错误 |
| 恢复策略分类 | `LTD_MAIN_CPU2/src/fault_recovery.c:67` | 当前被归入不可恢复类，说明后续拆分需要重新审视恢复策略 |

### 判断

该码使用面广，短期不适合直接拆成多个新码后全量替换。它的问题不在于“不能复用”，而在于同一枚故障码同时代表用户配置、内部调用、运动模型和不支持模式，现场定位时需要依赖日志上下文。

### 建议

| 阶段 | 动作 | 影响 |
| --- | --- | --- |
| 文档阶段 | 在统一表和清单中保留 `PARAM_ERROR`，但标注 4 个子语义：配置缺失、调用非法、运动模型参数异常、不支持模式 | 无固件影响 |
| 代码准备阶段 | 对高频路径补充日志上下文，例如配置项名、输入值、测量模式、电机目标位置 | 不改变故障码，只提高定位能力 |
| 代码拆分阶段 | 如确需新增码，可考虑 `PARAM_CONFIG_MISSING`、`PARAM_CALL_INVALID`、`MOTOR_POSITION_PARAM_ERROR` | 需要 CPU2/CPU3 枚举、显示、日志、协议资料同步 |

优先不要把所有 `PARAM_ERROR` 一次性拆完。建议先处理用户配置缺失类，因为它最接近现场可操作原因；内部 API 参数非法类可先留日志，不一定需要用户可见新码。

## `PARAM_ADDRESS_OVERFLOW`

### 当前调用语义

`PARAM_ADDRESS_OVERFLOW` 名称指向“地址越界”，但当前调用点中只有少数是真正的参数地址或存储边界问题，大量调用实际是空指针、输出参数非法或缓冲区参数非法。

| 语义分桶 | 代表调用点 | 说明 |
| --- | --- | --- |
| 真实地址/存储越界 | `LTD_MAIN_CPU2/src/system_parameter.c:751`、`LTD_MAIN_CPU2/src/system_parameter.c:850` | 参数存储写入或地址计算失败，和名称匹配 |
| 输出参数为空 | `LTD_MAIN_CPU2/src/measure_density.c:177`、`LTD_MAIN_CPU2/src/measure_oilLevel.c:1058`、`LTD_MAIN_CPU2/src/wartsila_density_measurement.c:99` | 由内部调用者传入空输出指针触发 |
| 通信封装入参非法 | `LTD_MAIN_CPU2/src/dsm_sensor_communication.c:234`、`LTD_MAIN_CPU2/src/ltd_sensor_communication.c:121`、`LTD_MAIN_CPU2/src/ch9141_at.c:331` | 多为响应缓冲区、长度指针或解析输出为空 |
| 电机驱动接口参数非法 | `LTD_MAIN_CPU2/src/TMC5130.c:576` | 例如 `tmc5130` 或输出 `ticks` 为空 |
| 无线配对辅助参数非法 | `LTD_MAIN_CPU2/src/wireless_pairing.c:899` | 与地址越界没有直接关系 |

### 判断

这是本轮最需要治理的“名称和实际语义不一致”故障码之一。继续把空指针或输出参数非法报成地址越界，会让日志含义失真，也会影响后续统计。

### 建议

| 阶段 | 动作 | 影响 |
| --- | --- | --- |
| 立即约束 | 后续新增调用只允许真实地址、参数存储边界、参数区越界继续使用该码 | 无兼容风险 |
| 低风险调整 | 空指针、输出参数非法先改为 `PARAM_ERROR`，并补日志说明具体指针或参数名 | CPU2 行为码会变化，需要按调用点评估 |
| 高质量拆分 | 新增 `PARAM_CALL_INVALID` 或 `PARAM_OUTPUT_ARG_INVALID`，专门承载内部 API 调用错误 | 需要双端同步和测试 |

优先建议先在文档和代码审查规则里把 `PARAM_ADDRESS_OVERFLOW` 收窄为“真实参数地址或存储边界问题”。是否新增内部调用错误码，可以等日志补齐后再定。

## `SENSOR_RESP_FORMAT_ERROR`

### 当前调用语义

该码覆盖 DSM 文本协议、LTD V2 帧协议和无线 AT 响应解析，语义范围较宽。

| 语义分桶 | 代表调用点 | 说明 |
| --- | --- | --- |
| DSM 文本响应格式错误 | `LTD_MAIN_CPU2/src/dsm_sensor_communication.c:392`、`LTD_MAIN_CPU2/src/dsm_sensor_communication.c:549`、`LTD_MAIN_CPU2/src/sensor.c:395` | 响应长度、数字格式、百分号字段、密度/温度帧格式不符合预期 |
| LTD V2 协议字段不匹配 | `LTD_MAIN_CPU2/src/ltd_sensor_communication.c:341`、`LTD_MAIN_CPU2/src/ltd_sensor_communication.c:423` | 功能码、参数、帧结构不匹配 |
| UART 硬件或 DMA 异常 | `LTD_MAIN_CPU2/src/dsm_sensor_communication.c:284`、`LTD_MAIN_CPU2/src/ltd_sensor_communication.c:181` | 当前有些 UART error 或 DMA 启动失败也落到格式错误 |
| 部分响应超时 | `LTD_MAIN_CPU2/src/dsm_sensor_communication.c:289`、`LTD_MAIN_CPU2/src/ltd_sensor_communication.c:187` | 收到部分字节但未形成完整帧时返回格式错误；完全无字节时通常返回超时 |
| 无线 AT 响应解析错误 | `LTD_MAIN_CPU2/src/wireless_pairing.c:1022`、`LTD_MAIN_CPU2/src/wireless_pairing.c:1235` | `BLEMODE`、`BLESTA`、MAC、RSSI、扫描结果字段解析失败 |

### 判断

格式错误可以继续作为“传感器响应内容不符合协议”的大类，但不宜再承载 UART 硬件失败和无线 AT 解析失败。无线链路已经有 `WIRELESS_HOST_COMM_TIMEOUT`、`WIRELESS_SLAVE_COMM_TIMEOUT` 等专用码，后续应逐步减少通用传感器码在无线模块中的直接暴露。

### 建议

| 阶段 | 动作 | 影响 |
| --- | --- | --- |
| 文档阶段 | 将该码标注为“传感器协议响应格式错误”，无线 AT 解析作为历史兼容调用 | 无固件影响 |
| 代码准备阶段 | 对 UART error、DMA 启动失败、部分帧超时分别补日志原因 | 不改码，降低误判 |
| 代码整理阶段 | DSM/LTD 格式错误继续使用该码；无线 AT 解析失败优先映射到无线责任域；UART 硬件失败考虑独立通信硬件错误或复用现有通信错误码 | 需要回归通信流程 |

如要拆分，建议优先区分三类：协议字段格式错误、底层 UART/DMA 异常、无线 AT 响应解析错误。

## `MOTOR_TMC_COMM_ERROR`

### 当前调用语义

`MOTOR_TMC_COMM_ERROR` 目前是 TMC5130 相关失败的恢复大类，包含读写寄存器、配置状态和运行期状态检查。

| 语义分桶 | 代表调用点 | 说明 |
| --- | --- | --- |
| 寄存器写失败 | `LTD_MAIN_CPU2/src/TMC5130.c:74`、`LTD_MAIN_CPU2/src/motor_ctrl_driver_param.c:172` | 初始化、停止、清状态、写目标位置等操作失败 |
| 寄存器读失败 | `LTD_MAIN_CPU2/src/TMC5130.c:405`、`LTD_MAIN_CPU2/src/TMC5130.c:775`、`LTD_MAIN_CPU2/src/motor_ctrl_driver_param.c:723` | 读取 `XACTUAL`、`GSTAT`、`DRV_STATUS`、目标位置等失败 |
| 驱动配置丢失或读回异常 | `LTD_MAIN_CPU2/src/TMC5130.c:782` | 读回 `CHOPCONF` 为 0 或读失败时按通信/配置异常处理 |
| 运动过程依赖失败 | `LTD_MAIN_CPU2/src/motor_ctrl_motion_api.c:1529`、`LTD_MAIN_CPU2/src/motor_ctrl_motion_api.c:1612` | 运动规划或等待到位过程中底层驱动访问失败 |
| 恢复策略分类 | `LTD_MAIN_CPU2/src/fault_recovery.c:45`、`LTD_MAIN_CPU2/src/measure_zero.c:66` | 当前归入电机驱动恢复路径 |

### 判断

该码虽然语义较宽，但恢复策略上属于一个清晰的大类：TMC 驱动通信或寄存器访问不可用。现场处理通常也会先进入电机驱动恢复。因此短期不建议直接把它从对外故障码层拆散。

### 建议

| 阶段 | 动作 | 影响 |
| --- | --- | --- |
| 立即保留 | 对外继续使用 `MOTOR_TMC_COMM_ERROR` 作为 TMC 访问失败大类 | 保持兼容 |
| 日志增强 | 记录读/写方向、寄存器名、访问阶段、底层返回值 | 不改变协议，收益高 |
| 可选拆分 | 如现场需要区分，可新增 `MOTOR_TMC_REG_READ_ERROR`、`MOTOR_TMC_REG_WRITE_ERROR`、`MOTOR_TMC_CONFIG_LOST` | 影响电机恢复策略和 CPU3 显示 |

如果后续只做一项改动，建议先补日志而不是新增枚举。该码关联运动控制，任何行为码调整都需要 CPU2 构建、关键运动流程回归和故障恢复路径复查。

## `SENSOR_DEVICE_COMM_TIMEOUT`

### 当前调用语义

该码主要表示设备无响应或等待完整响应超时。

| 语义分桶 | 代表调用点 | 说明 |
| --- | --- | --- |
| DSM 主链路无响应 | `LTD_MAIN_CPU2/src/dsm_sensor_communication.c:275`、`LTD_MAIN_CPU2/src/dsm_sensor_communication.c:450` | DMA 接收没有收到任何有效响应，或七位值读取无响应 |
| LTD V2 主链路无响应 | `LTD_MAIN_CPU2/src/ltd_sensor_communication.c:174`、`LTD_MAIN_CPU2/src/ltd_sensor_communication.c:302` | 固定帧接收超时且无完整响应 |
| 发送完成等待超时 | `LTD_MAIN_CPU2/src/dsm_sensor_communication.c:203`、`LTD_MAIN_CPU2/src/ltd_sensor_communication.c:97` | UART DMA 发送等待超时 |
| CH9141/无线 AT 无完整响应 | `LTD_MAIN_CPU2/src/ch9141_at.c:491`、`LTD_MAIN_CPU2/src/ch9141_at.c:574` | AT 层无完整响应，部分路径后续再映射为无线专用码 |
| 无线模块边界映射 | `LTD_MAIN_CPU2/src/wireless_pairing.c:556` | 将通用传感器超时映射成 `WIRELESS_HOST_COMM_TIMEOUT` |

### 判断

在 DSM/LTD 主传感器链路中，该码语义基本准确。问题主要在无线/CH9141 AT 层：底层临时返回通用传感器超时，再由上层决定是否映射为无线专用码。这个模式可以保留，但边界必须清楚。

### 建议

| 阶段 | 动作 | 影响 |
| --- | --- | --- |
| 保留主语义 | DSM/LTD 设备完全无响应继续使用该码 | 保持兼容 |
| 边界整理 | 无线模块对外状态优先使用 `WIRELESS_HOST_COMM_TIMEOUT` 或 `WIRELESS_SLAVE_COMM_TIMEOUT` | 需要检查无线配对和诊断显示 |
| 日志补充 | 区分 TX 等待超时、RX 无字节、RX 部分帧超时、AT 无完整响应 | 不改变故障码 |

不建议新增一个新的“通用通信超时”码。当前已有传感器和无线专用码，重点是边界映射一致。

## `OTHER_PERIPHERAL_CONFIG_ERROR`

### 当前调用语义

该码原本像是系统兜底中的外设配置错误，但当前实际承载了多类不相干问题。

| 语义分桶 | 代表调用点 | 说明 |
| --- | --- | --- |
| AD5421 底层访问失败 | `LTD_MAIN_CPU2/src/ad5421.c:93`、`LTD_MAIN_CPU2/src/ad5421.c:122`、`LTD_MAIN_CPU2/src/ad5421.c:156` | SPI 发送、读寄存器、访问锁等底层失败先返回该码 |
| DSM/LTD UART 启动或发送失败 | `LTD_MAIN_CPU2/src/dsm_sensor_communication.c:234`、`LTD_MAIN_CPU2/src/ltd_sensor_communication.c:128` | UART 发送、DMA 接收启动等硬件接口失败 |
| CH9141 AT UART 发送失败 | `LTD_MAIN_CPU2/src/ch9141_at.c:424` | 无线 AT 底层发送失败 |
| 陀螺零点配置异常 | `LTD_MAIN_CPU2/src/measure_tank_height.c:861` | 底部状态检查时发现陀螺零点参考无效 |

### 判断

这是最不适合继续扩大的兜底码。AD5421 已有独立故障码，传感器/无线也有各自责任域；继续使用 `OTHER_PERIPHERAL_CONFIG_ERROR` 会削弱分类治理效果。

### 建议

| 阶段 | 动作 | 影响 |
| --- | --- | --- |
| 立即约束 | 后续新代码不得把具体外设故障直接落入该码，除非确实无法归属 | 无兼容风险 |
| 文档整理 | 标注当前调用为历史兜底，优先回收至 AD5421、传感器通信、无线通信、测量配置责任域 | 无固件影响 |
| 代码整理 | AD5421 底层失败映射到 AD5421 专用码或新增 `AD5421_SPI_COMM_ERROR`；UART 启动/发送失败映射到通信责任域；陀螺零点异常考虑测量配置或传感器校准错误 | 需要逐点回归 |

优先建议先改 AD5421 和 UART 类调用，因为它们责任域最清晰；陀螺零点配置需要结合现场校准流程再定。

## `MEASUREMENT_POSITION_ERROR`

### 当前调用语义

该码名称属于测量流程，但触发点实际集中在电机目标位置规划、位置源转换和运动后的到位校验。

| 语义分桶 | 代表调用点 | 说明 |
| --- | --- | --- |
| 密度测量目标位置异常 | `LTD_MAIN_CPU2/src/wartsila_density_measurement.c:174` | Wartsila 密度点位转换或移动目标异常 |
| 相对/绝对目标规划异常 | `LTD_MAIN_CPU2/src/motor_ctrl_motion_api.c:1833`、`LTD_MAIN_CPU2/src/motor_ctrl_motion_api.c:1875` | 目标位置计划不可达、越界或换算失败 |
| jog 过程位置一致性异常 | `LTD_MAIN_CPU2/src/motor_ctrl_motion_api.c:1978`、`LTD_MAIN_CPU2/src/motor_ctrl_motion_api.c:1984` | 运动中检查实际位置和目标位置不一致 |
| 停止后恢复校验失败 | `LTD_MAIN_CPU2/src/motor_ctrl_motion_api.c:2237` | 停止 jog 后恢复目标位置校验失败 |

### 判断

该码当前更像“电机位置目标/校验错误”，而不是测量算法本身错误。由于它从测量流程暴露出来，保留在测量类也可以解释，但文档上应明确它依赖电机位置责任域。

### 建议

| 阶段 | 动作 | 影响 |
| --- | --- | --- |
| 文档阶段 | 标注为“测量过程中的电机位置目标或到位校验异常” | 无固件影响 |
| 日志增强 | 记录目标位置、当前位置、位置源、允许范围和测量阶段 | 不改故障码 |
| 可选拆分 | 新增 `MOTOR_POSITION_TARGET_INVALID`、`MOTOR_POSITION_VERIFY_ERROR`，或将同类错误收敛到电机位置模型错误 | 影响运动控制和测量流程联动 |

该码不建议优先改。除非现场已经需要明确区分“目标不可达”和“执行后未到位”，否则先补日志更合适。

## `AD5421_READFAULT_ERROR`

### 当前调用语义

该码只有两个核心场景，但两者语义不同。

| 语义分桶 | 代表调用点 | 说明 |
| --- | --- | --- |
| 故障寄存器读取失败 | `LTD_MAIN_CPU2/src/ad5421.c:340` | `AD5421_ReadRegChecked(READFAULT, &fault_reg)` 失败，实际可能是 SPI、访问锁或底层读异常 |
| 故障寄存器状态异常 | `LTD_MAIN_CPU2/src/ad5421.c:357` | 故障寄存器读取成功，但状态位显示 AD5421 处于故障状态 |

### 判断

这是最适合做小范围拆分的候选码之一。读取失败和芯片报告故障是两类完全不同的处理方向：前者偏通信/访问，后者偏 AD5421 输出或芯片状态。

### 建议

| 阶段 | 动作 | 影响 |
| --- | --- | --- |
| 低风险增强 | 保留 `AD5421_READFAULT_ERROR`，但在 `ao_output_runtime.last_error_code` 或日志中记录子原因 | 不改对外码 |
| 推荐拆分 | 新增 `AD5421_READFAULT_COMM_ERROR` 和 `AD5421_FAULT_STATUS_ERROR`，或至少新增一个通信读取失败码，保留原码表示 fault 状态 | 影响小，但仍需 CPU3 显示同步 |
| 联动整理 | 与 `OTHER_PERIPHERAL_CONFIG_ERROR` 中 AD5421 底层访问失败一起处理 | 可减少 AD5421 责任域外溢 |

如果决定进入代码修改，建议把 AD5421 作为第一批试点：调用点少、责任域清楚、回归范围可控。

## 推荐分阶段计划

### 第 3.1 阶段：文档定责和新增调用约束（已完成）

目标是不改代码行为，只把后续代码评审规则立起来。

2026-07-09 已同步到 `LTD内部技术与治理资料.xlsx`：新增“第3阶段评审”工作表，并在“分类规则”“治理摘要”中补充第 3.1 维护约束。

| 工作项 | 内容 | 产物 |
| --- | --- | --- |
| 责任域标注 | 在统一表或清单中标注 8 项候选码的子语义 | 文档更新 |
| 新增调用约束 | 明确 `PARAM_ADDRESS_OVERFLOW`、`OTHER_PERIPHERAL_CONFIG_ERROR` 不再作为泛用兜底 | 文档更新 |
| 评审检查项 | 后续新增故障码或新增调用点时检查是否落入真实责任域 | 维护规则 |

### 第 3.2 阶段：日志上下文增强（清单已完成）

目标是不改故障码数值，但让同一码能看出真实子原因。

2026-07-10 已完成 `故障码第3.2阶段日志增强清单.md`：基于当时工作树重新扫描并记录 166 个故障码产生函数组、238 个故障码产生语句和 15 个排除组；`LTD内部技术与治理资料.xlsx` 已新增“第3.2日志清单”工作表。清单形成阶段没有修改固件源码或故障码数值，后续源码实施结果另见交接计划。

| 优先级 | 对象 | 日志建议 |
| --- | --- | --- |
| P1 | `MOTOR_TMC_COMM_ERROR` | 寄存器名、读写方向、访问阶段、底层返回值 |
| P1 | `SENSOR_RESP_FORMAT_ERROR` | 协议类型、接收长度、解析字段、是否 UART/DMA error |
| P1 | `PARAM_ERROR` / `PARAM_ADDRESS_OVERFLOW` | 参数名、配置项、输入值、调用模块 |
| P2 | `AD5421_READFAULT_ERROR` | readfault 读取失败还是 fault 位异常，原始寄存器值 |
| P2 | `MEASUREMENT_POSITION_ERROR` | 测量阶段、目标位置、当前位置、位置源、允许范围 |

### 第 3.3 阶段：低风险代码收敛（已完成）

目标是只改责任域非常明确、影响可控的调用点。

| 优先级 | 建议动作 | 说明 |
| --- | --- | --- |
| P1 | AD5421 责任域回收 | 把 AD5421 底层访问失败和 readfault 异常统一纳入 AD5421 专用错误体系 |
| P1 | 无线超时边界映射 | 无线模块对外优先暴露 `WIRELESS_HOST_COMM_TIMEOUT` / `WIRELESS_SLAVE_COMM_TIMEOUT` |
| P2 | 参数地址越界收窄 | 真实地址越界继续用 `PARAM_ADDRESS_OVERFLOW`，内部空指针改为更合适的参数调用错误 |
| P2 | 外设配置兜底收窄 | 将 UART、AD5421、陀螺零点等具体问题移出 `OTHER_PERIPHERAL_CONFIG_ERROR` |

### 第 3.4 阶段：新增拆分码（已实施部分）

日志增强和低风险收敛后，确认4种原因需要独立编号；其余候选继续保留现有码。

| 候选新增码 | 来源 | 适用条件 |
| --- | --- | --- |
| `PARAM_CALL_INVALID` | `PARAM_ERROR`、`PARAM_ADDRESS_OVERFLOW` | 需要明确区分内部调用错误和用户配置错误 |
| `PARAM_CONFIG_MISSING` | `PARAM_ERROR` | 需要把用户可处理的配置缺失单独提示 |
| `MOTOR_TMC_REG_READ_ERROR` | `MOTOR_TMC_COMM_ERROR` | 现场需要区分 TMC 读失败和写失败 |
| `MOTOR_TMC_REG_WRITE_ERROR` | `MOTOR_TMC_COMM_ERROR` | 现场需要区分 TMC 写失败 |
| `MOTOR_TMC_CONFIG_LOST` | `MOTOR_TMC_COMM_ERROR` | CHOPCONF/GSTAT 等读回表现出配置丢失 |
| `AD5421_READFAULT_COMM_ERROR` | `AD5421_READFAULT_ERROR` | 故障寄存器读取失败需要单独定位 |
| `AD5421_FAULT_STATUS_ERROR` | `AD5421_READFAULT_ERROR` | 故障寄存器读取成功但状态位异常需要单独定位 |
| `MOTOR_POSITION_TARGET_INVALID` | `MEASUREMENT_POSITION_ERROR` | 目标不可达、目标越界需要和到位失败区分 |
| `MOTOR_POSITION_VERIFY_ERROR` | `MEASUREMENT_POSITION_ERROR` | 执行后位置偏差或目标恢复失败需要单独定位 |

新增码必须同时更新 CPU2 `ErrorCode`、CPU2 日志名称和原因、CPU3 兼容枚举、CPU3 显示文案、正式工作簿、内部技术工作簿、Markdown 清单和版本资料。

实际新增 `MOTOR_TMC_CONFIG_LOST`、`AD5421_FAULT_STATUS_ERROR`、`COMM_UART_TRANSFER_ERROR` 和 `WIRELESS_RESP_FORMAT_ERROR`。前两项来自本表候选；后两项用于把串口硬件传输错误和无线响应格式错误从传感器通用码中拆开。其余候选未新增。

## 不建议直接做的事

| 不建议动作 | 原因 |
| --- | --- |
| 直接删除或复用已有编号 | 编号已进入 CPU2/CPU3 映射和历史资料，删除或复用会破坏兼容 |
| 批量替换所有 `PARAM_ERROR` | 调用语义差异太大，容易把用户配置和内部调用错误混在一起改错 |
| 把所有通信异常都改成一个新通用码 | 传感器、无线、电机驱动的恢复策略不同，统一后会损失责任域信息 |
| 只改 CPU2 不改 CPU3 | CPU3 显示、枚举和协议资料会和 CPU2 不一致 |
| 只改故障码不补日志 | 现场仍无法看出寄存器名、参数名、响应字段等关键上下文 |

## 改代码前检查项

进入源码修改前，至少确认以下事项：

| 检查项 | 要求 |
| --- | --- |
| 兼容范围 | 确认是否允许改变现有故障码对外表现 |
| CPU3 同步 | 新增或改用故障码时同步 CPU3 枚举和显示文本 |
| 日志同步 | CPU2 日志名称、日志原因和错误恢复分类同步更新 |
| 协议资料 | Modbus/保持寄存器、版本资料和故障码统一表同步更新 |
| 回归测试 | 覆盖传感器通信、无线配对、TMC 运动、AD5421 输出、测量流程 |
| 版本说明 | 如果行为码变化，版本改动文档必须写清楚兼容影响 |

## 当前下一步

第3.1至3.4阶段已完成。当前共享定义77项，新增4项故障码并按9个责任域重编号；13通信链路与14传感器密度类别号已互换，CPU2/CPU3协议版本已升至16，软件检查和两端构建通过，当前进入实机验收阶段：

整体治理进度、软件验证证据、FI-01～FI-08 台架用例和窗口接手顺序见 `故障码整体治理执行、当前进度与窗口交接计划.md`。

1. 在台架上依次执行 AD5421/AO、TMC、传感器/无线、参数/测量/位置和 CPU3 显示／恢复边界故障注入。
2. 保存屏幕照片、串口日志、注入条件和复测结果，并逐项填写 FI-01～FI-08 结论。
3. 只有实机结果证明不同原因需要不同停机、恢复或对外处理策略时，才重新评估第 3.4 新增拆分码。
