duanxuebin1998/cube/docs/01_协议与寄存器/SI协议适配/05_官方资料中文整理/04_安装与调试手册_中文整理.md

# 安装与调试手册中文整理

来源文件：`../00_原始资料/SI7000官方资料包_含Modbus规范.pdf` 第 32-51 页

原始标题：`SI-7000 Tank Gauging System Installation & Commissioning Manual`

原始编号：`090-7000-1 Rev A`

整理日期：2026-07-02

## 0. 整理说明

本文整理 SI-7000 官方安装与调试手册。该手册包含大量安全警告、安装前检查、吊装照片、电气接线入口示意、初始上电和基础功能测试步骤。本文尽量完整翻译正文、清单、步骤、警告和附录，并保留原始页面图片以便对照。

重要边界：

- 本文是官方资料中文译稿，不是 CUBE 项目的施工方案。
- 涉及起吊、防爆、电气接线、接地、法兰、螺栓紧固和上电调试时，必须以项目正式图纸、现场安全规程、厂家最新文件和当地法规为准。
- 原文明确：完整上电、系统测试和校准应在后续调试活动中完成，并且只能在厂家代表在场时进行。本文不授权任何现场操作。

## 1. 原始页面索引

| PDF 页码 | 原始手册页码 | 内容 | 页面图片 |
| --- | --- | --- | --- |
| 32 | 封面 | Installation & Commissioning Manual | 安装调试手册封面 |
| 33 | i | Table of Contents | 安装调试手册目录 |
| 34 | 1 | Introduction 和 Figure 1-6 | 安装调试手册第 1 页 |
| 35 | 2 | 手册适用范围 | 安装调试手册第 2 页 |
| 36 | 3 | Warnings, Cautions, and Notices | 安装调试手册第 3 页 |
| 37 | 4 | Installation Requirements、工具清单开头 | 安装调试手册第 4 页 |
| 38 | 5 | 硬件、罐内/罐外安装前检查 | 安装调试手册第 5 页 |
| 39 | 6 | 电气通信检查、开箱检查 | 安装调试手册第 6 页 |
| 40 | 7 | 开箱检查续、安装步骤开头 | 安装调试手册第 7 页 |
| 41 | 8 | 吊装、法兰定位、泡棉拆除 | 安装调试手册第 8 页 |
| 42 | 9 | 下放到夹管阀（Pinch Valve）法兰、安装紧固件 | 安装调试手册第 9 页 |
| 43 | 10 | 接地和系统接线警告 | 安装调试手册第 10 页 |
| 44 | 11 | 打开电气外壳门、AC 电源和接地说明 | 安装调试手册第 11 页 |
| 45 | 12 | AC 入口和电源接线步骤、信号线入口 | 安装调试手册第 12 页 |
| 46 | 13 | 信号线接线、关闭电气外壳门开头 | 安装调试手册第 13 页 |
| 47 | 14 | 关闭电气外壳门步骤 | 安装调试手册第 14 页 |
| 48 | 15 | Commissioning、Initial Power Up、Motor Driver Test 开头 | 安装调试手册第 15 页 |
| 49 | 16 | Motor Driver Test 续、Bench Marking 开头 | 安装调试手册第 16 页 |
| 50 | 17 | Bench Marking 续、Communications | 安装调试手册第 17 页 |
| 51 | 18 | Appendix A Bolt Tightening Work Sheet | 安装调试手册第 18 页 |

## 2. 目录翻译

| 原章节 | 中文整理 |
| --- | --- |
| 1 Introduction | 1 引言 |
| 2 Warnings, Cautions, and Notices | 2 警告、注意和通知 |
| 3 Installation Requirements | 3 安装要求 |
| 4 Pre-Installation Check Lists | 4 安装前检查清单 |
| 4.1 SI-7000 Installation Tool and Hardware | 4.1 SI-7000 安装工具和硬件 |
| 4.2 Internal Tank Requirements | 4.2 罐内要求 |
| 4.3 External Tank Requirements | 4.3 罐外要求 |
| 4.4 Electrical and Communications | 4.4 电气和通信 |
| 5 SI-7000 Unpacking and Inspection | 5 SI-7000 开箱和检查 |
| 6 Installation | 6 安装 |
| 7 Connecting System Wiring | 7 连接系统接线 |
| 7.1 Opening Electrical Enclosure Door | 7.1 打开电气外壳门 |
| 7.2 AC Power Input & Ground | 7.2 AC 电源输入和接地 |
| 7.3 Signal Wiring Connections | 7.3 信号线连接 |
| 7.4 Closing Electrical Enclosure Door | 7.4 关闭电气外壳门 |
| 8 Commissioning | 8 调试 |
| 8.1 Initial Power Up | 8.1 初始上电 |
| 8.2 Motor Driver Test | 8.2 电机驱动测试 |
| 8.3 Bench Marking | 8.3 基准标定（Bench Marking） |
| 8.4 Communications | 8.4 通信 |

## 3. 引言

SI-7000 Tank Gauging System 用于监测大型储罐内低温液体的液位、温度和密度，通常由控制室中的 PC 操作员界面和/或 DCS 用户界面控制和监测。

SI-7000 由机械部分和电气部分组成：

| 部分 | 原文说明 | 中文整理 |
| --- | --- | --- |
| Mechanical section | chain reel enclosure and probe enclosure | 机械部分由链轮外壳和探头外壳组成。除驱动轴齿轮箱外，该部分包含在储罐内升降探头组件所需的全部机械部件。该部分应视为 Zone 0 环境。多数安装中不需要接触该部分。 |
| Electrical section | electrical enclosure | 电气部分由电气外壳组成，包含所有电子设备和驱动轴齿轮箱。电气部分外壳是防爆容器，应视为 Zone 1 环境。SI-7000 的输入电源和通信在该部分进行物理连接。 |

更详细的部件说明和功能介绍，官方要求参考 `SI-7000 Operational Manual (090-7000-2)`。

探头外壳安装在链轮外壳底部，链轮外壳和电气外壳背靠背安装。

Figure 1-6 的中文图注：

| 图号 | 原文图注 | 中文整理 |
| --- | --- | --- |
| Figure 1 | Chain reel & probe enclosures | 链轮和探头外壳 |
| Figure 2 | Chain reel enclosure w/o Cover | 未安装盖板的链轮外壳 |
| Figure 3 | SI-7000 Side View | SI-7000 侧视图 |
| Figure 4 | Electrical Enclosure | 电气外壳 |
| Figure 5 | Electrical Enclosure w/ door open | 电气外壳门打开状态 |
| Figure 6 | SI-7000 transparent side view | SI-7000 透明侧视图 |

本手册提供在典型位置安装系统所需的信息。对于非典型位置，可能随本手册提供站点专用机械安装图和现场接线图，用于说明具体细节。

完整上电、系统测试和校准会在后续调试活动中完成，并且只能在厂家代表在场时进行。相关活动的更详细说明应参考 `SI-7000 Operational Manual (090-7000-2)`。不过，如果 SI 人员在场，本手册包含的初始上电和基本系统功能测试可以执行。

## 4. 警告、注意和通知

Scientific Instruments, Inc. 不对 SI-7000 安装过程中造成的任何伤害、死亡或损坏承担责任。安装方或客户负责确保操作以安全方式执行，并符合所有政府、地方和主管机构法规。

### 4.1 Warning

| 原文类别 | 中文整理 |
| --- | --- |
| WARNING | 必须严格遵守所有适用的政府、地方和主管机构法规。否则可能导致死亡或严重伤害。 |
| WARNING | 雷电导电接地路径必须以合适方式实现，使升温、可点燃火花或喷射火花不会成为爆炸性环境的点火源。否则可能导致死亡、严重伤害或重大财产损失。 |
| WARNING | 必须确保用于起吊 SI-7000 的设备能够承受设备重量，以及起重机运动造成的突然冲击。否则可能导致死亡、严重伤害或重大财产损失。 |
| WARNING | 起吊和移动 SI-7000 到位时，必须确保结构、其他设备和人员之间保持足够间隙。否则可能导致死亡、严重伤害或重大财产损失。 |
| WARNING | 由于内部本质安全电路的位置，不得对左上入口端口进行任何连接。 |

### 4.2 Caution 和 Notice

| 原文类别 | 中文整理 |
| --- | --- |
| CAUTION - PINCH POINT | 将 SI-7000 定位到安装法兰上时必须小心，SI-7000 下放到位时所有人员必须让手远离夹点。否则手指可能被压碎或切断，造成严重伤害。 |
| NOTICE | 必须遵守本手册中的所有安装说明。否则可能损坏 SI-7000、导致保修失效或造成安装延误。 |
| NOTICE | 在 SI-7000 正在连接到储罐配对法兰之前，不要从探头外壳上移除保护泡棉。过早移除保护泡棉，会导致 SI-7000 移动和吊装到位时探头撞击探头外壳内壁。 |

## 5. 安装要求

以下为 Scientific Instruments 建议的最低安装要求。如果这些最低要求未满足且存在安全风险，Scientific Instruments 人员不会参与安装活动。

| 要求 | 中文整理 |
| --- | --- |
| 法兰 | 可用的 6 inch 150 pound 法兰，安装在最小 6 inch 管道上，提供通向罐内的无阻碍通道。该法兰应能支撑 400 lb，即 181.4 kg，且不会损坏法兰或周边结构。 |
| 间隙 | 法兰周围至少 1 m 间隙。设备不应安装在难以操作 AC 电源断开开关的位置。 |
| 起重 | 起重机和合格操作员。 |
| 导向人员 | 两名人员引导 SI-7000 到位。 |
| 安装人员 | 一名具备机械和电气安装资质的人员。 |
| 安装人员能力 | 了解相关电气工程；理解并能够阅读、评估工程图；实际了解防爆原则和技术。 |
| 工作平台 | 稳定的临时或永久工作平台。 |

其他备注：

- 由于 SI-7000 始终安装在储罐外部，因此没有额外通风要求。
- 无声级相关要求。
- 安装 SI-7000 前不需要装配。
- 任何集成 SI-7000 的系统，其安全性由系统组装方负责。
- Scientific Instruments 当前不为 SI-7000 提供任何附件。

## 6. 安装前检查清单

这些项目需要在 SI-7000 安装前确认。不满足要求会影响 SI-7000 运行、造成严重设备损坏或导致安装延误。

### 6.1 安装工具和硬件

安装 SI-7000 只需要少量基本工具。该检查清单应在登上罐顶前完成。

现场提供工具：

| 数量 | 原文 | 中文整理 |
| --- | --- | --- |
| 2 ea | 1 1/8 inch Wrench | 1 1/8 inch 扳手 2 把 |
| 1 ea | 6 mm Hex T-handle | 6 mm 六角 T 型手柄 1 把 |
| 1 ea | Reversible Screwdriver Set (#2 Philips & 9/32 in. slotted) | 可换向螺丝刀套装，#2 十字和 9/32 inch 一字 |
| 1 ea | Torque wrench (10 ft/lbs - 150 ft/lbs) | 扭矩扳手，范围 10 ft-lb 到 150 ft-lb |
| 1 ea | 1 1/8 inch Socket, 3/8 inch drive | 1 1/8 inch 套筒，3/8 inch 驱动 |
| 1 ea | 1/2 inch to 3/8 inch drive adapter | 1/2 inch 转 3/8 inch 驱动转换头 |
| 1 ea | 1/2 inch Socket, 3/8 inch drive | 1/2 inch 套筒，3/8 inch 驱动 |
| 1 ea | 6 mm Hex bit socket, 3/8 inch drive | 6 mm 六角批头套筒，3/8 inch 驱动 |

Scientific Instruments 提供硬件：

| 数量 | 原文 | 中文整理 |
| --- | --- | --- |
| 1 ea | Explosion proof external AC power switch | 防爆外部 AC 电源开关 |
| 16 ea | 3/4-10 x 2.5 inch Stainless steel bolt | 3/4-10 x 2.5 inch 不锈钢螺栓 |
| 4 ea | 3/4 inch Stainless steel nut (Extra on Blind Flange) | 3/4 inch 不锈钢螺母，盲法兰上额外提供 |
| 16 ea | 3/4 inch Stainless steel lock washer | 3/4 inch 不锈钢锁紧垫圈 |
| 16 ea | 3/4 inch Stainless steel washer | 3/4 inch 不锈钢平垫圈 |
| 4 ea | 3/4-10 x 3 inch Stainless steel bolt (Extra on Blind Flange) | 3/4-10 x 3 inch 不锈钢螺栓，盲法兰上额外提供 |

### 6.2 罐内要求

| 检查项 | 中文整理 |
| --- | --- |
| 罐清洁 | 储罐关闭和密封前是否已清洁？罐内残留的过量铁锈、尘粒、珍珠岩或其他异物，长期可能粘附到密度计上，开始影响密度读数。 |
| 探头垂直运动 | 从驱动机构一直到罐底或静液井（stilling well），探头组件是否能够无阻碍垂直移动？任何障碍都可能使探头组件卡住，并损坏探头组件、链条和/或驱动机构。 |
| 避开泵和充装线 | 探头组件路径是否远离会产生高液流或湍流的泵或充装管线？高液流或湍流可能损坏探头组件，或导致密度和/或液位测量不准确。 |
| 静液井（Stilling well） | 如果使用静液井，它是否垂直且尺寸足够，确保探头不会接触静液井内表面？与内表面接触可能导致不可预测运行，并给驱动系统增加额外应力，导致部件过早失效。 |

### 6.3 罐外要求

| 检查项 | 中文整理 |
| --- | --- |
| 工作平台 | 是否已有稳定工作平台？可以是永久或临时结构，但 SI 强烈建议安装永久工作平台。 |
| 安全设备 | 是否已有足够安全设备，且设备可用？ |
| 配对法兰 | SI-7000 将安装到的配对法兰是否清洁、无损坏、无碎屑？ |
| 垫片 | 配对法兰和 SI-7000 之间使用的垫片是否清洁且可用？ |
| 隔离阀手轮 | 隔离阀手轮是否会妨碍接近机械或电气外壳？如会妨碍，机械外壳盖是否仍能拆下，电气外壳门是否仍能打开？ |
| 夹管阀（Pinch Valve） | 如果使用夹管阀，是否安装为尽可能夹在链条平面侧，且手轮不会阻碍打开电气外壳门或拆除机械外壳盖？夹管阀对不准可能导致密封不良，使维护时过量气体逸出，也可能阻碍人员接近 SI-7000 的一侧。 |

### 6.4 电气和通信

| 检查项 | 中文整理 |
| --- | --- |
| 外部电源开关位置 | 是否已在 SI-7000 可视范围内选择外部电源开关位置？ |
| 电源和通信电缆管 | 电源和通信电缆管是否准备好连接到 SI-7000？SI-7000 可以在电缆管尚未就位时安装，但这些连接完成前安装不视为完成。 |
| 上锁挂牌 | SI-7000 电源是否已经上锁挂牌（lock out/tag out）？如果没有，在电源导体连接到 SI-7000 前必须完成。 |

## 7. SI-7000 开箱和检查

SI-7000 设计为坚固并可用于严苛条件，但移动或起吊设备时仍需小心。SI 设计了定制容器，使 SI-7000 到货后即可安装。不过仍需检查运输过程中可能发生的损坏。

步骤：

1. 确保运输木箱正立在平坦、稳定且相对水平的表面。
   - 如果木箱来回摇晃，应加垫片使其稳定。
2. 确保冲击和倾斜指示器未被触发。
   - 如果指示器已触发，应通知 SI，并尽可能提供照片。
3. 检查运输木箱是否有任何可见损坏迹象。
   - 如有损坏，应通知 SI，并尽可能提供照片。
4. 移除木箱顶部、内部水平支撑和侧板。
5. 彻底检查 SI-7000 是否有任何损坏迹象。
   - 如有损坏，应通知 SI，并尽可能提供照片。
6. 将吊带连接到电气外壳顶部吊眼，并施加轻微起吊力。
7. 使用 1/2 inch 扳手拆下将 SI-7000 固定在木箱底部的 4 个方头木螺钉。

相关图注：

| 图号 | 原文图注 | 中文整理 |
| --- | --- | --- |
| Figure 7 | SI-7000 mounted on crate bottom | SI-7000 安装在木箱底板上 |
| Figure 8 | SI-7000 with lifting strap attached | 已连接吊带的 SI-7000 |

## 8. 安装

参考：Appendix A `Bolt Tightening Worksheet` 和其他随附站点专用图纸。

NOTICE：在 SI-7000 正在连接到储罐配对法兰之前，不要从探头外壳中移除保护泡棉。移除保护泡棉会导致 SI-7000 吊装到位时探头撞击探头外壳内壁。

步骤：

1. 确认夹管阀（Pinch Valve）已按 4.3 节说明安装。
2. 将 SI-7000 吊到罐顶，注意不要让设备过度摆动。
3. 将 SI-7000 定位到安装法兰上方。
4. 移除 Blind Flange，并丢弃 3/4 inch 螺栓和螺母。保留平垫圈和锁紧垫圈，用于与夹管阀（Pinch Valve）提供的 3/4-10 x 2.5 inch 螺栓配合安装。
5. 从探头外壳中移除保护泡棉。
6. 将 SI-7000 下放到夹管阀法兰上，确保孔位对齐，并让夹点区域保持无人员身体部位。
7. 使用随夹管阀提供的 8 组 3/4 inch stainless steel 硬件，把 SI-7000 安装到夹管阀法兰上。详细说明见 Appendix A。
8. 将等电位接地电缆连接到电气外壳顶部的接地凸耳，使连接方式能够承受 30 m 范围雷电放电引起的电流路径。原文为 `in such a way that a bolt lightning of a 30m can be controlled`，中文按雷电等电位/接地能力理解，现场应以电气设计和规范复核。

相关图注：

| 图号 | 原文图注 | 中文整理 |
| --- | --- | --- |
| Figure 9 | Protective foam holding probe in place | 固定探头位置的保护泡棉 |
| Figure 10 | 无图题，仅 Figure 10 | SI-7000 吊装到罐顶过程 |
| Figure 11 | Guiding SI-7000 into position | 引导 SI-7000 到位 |
| Figure 12 | Remove probe protective foam | 移除探头保护泡棉 |
| Figure 13 | Aligning SI-7000 with mating flange | 将 SI-7000 与配对法兰对齐 |
| Figure 14 | Installing mounting hardware | 安装固定硬件 |

## 9. 连接系统接线

WARNING：所有用于 VAC 电源输入和/或通信的电气外壳螺纹入口，例如电缆密封套、导管接头、安装到电气外壳的堵头，都必须额定适用于爆炸性环境。

可选电缆密封套和螺纹入口种类很多，并具有覆盖国际和当地接线规范（wiring codes）的批准和证书。因此，安装方有责任确保电缆密封套、螺纹堵头和/或导管接头获得适用于 SI-7000 安装 Zone 和区域分类的 Ex 认证。更多信息应咨询制造商。

参考：Appendix B Drawing 050-7000-1 Typical Installation Wiring Diagram。

未使用的线缆和屏蔽层只能在控制室端接地。必须正确处理接地和屏蔽连接，以尽量降低通信线路噪声。

由于内部本质安全电路位置，不得对左上入口端口进行任何连接。连接该入口将使 SI-7000 的本质安全认证失效。

### 9.1 打开电气外壳门

在电气外壳内部作业时，必须特别小心，避免划伤或损伤隔爆接合面（flame path）表面。装配和运输期间使用保护覆盖物，安装完成前应保持覆盖。任何隔爆接合面划伤或损坏都会使外壳防爆认证失效。

步骤：

- 松开所有固定外壳门关闭状态的螺栓。
- 完全打开门。
- 插入锁定销，将门保持在打开位置。

Figure 15 图注：`Unused upper left entry port`，中文为“未使用的左上入口端口”。

### 9.2 AC 电源输入和接地

AC 电源线应通过 SI-7000 的右下或左下入口端口连接，其中优先使用右下端口。SI-7000 设计用于 18 AWG 到 10 AWG 电源线，以及 8 AWG Earth ground。

Figure 16 和 Figure 17：

| 图号 | 原文图注 | 中文整理 |
| --- | --- | --- |
| Figure 16 | Lower left-side AC entry port option | 左下侧 AC 入口选项 |
| Figure 17 | Lower right-side AC entry port option | 右下侧 AC 入口选项 |

步骤：

1. 确保 AC 电源已上锁挂牌（lock out/tag out）。
2. 确保外部 AC 电源开关处于 OFF 位置。
3. 将合适的 cable gland 和 conduit 连接到入口端口。
4. 拉入足够长度的电线，使 AC 电源线能够走线到电源端子排，Earth ground 线能够走线到外壳顶部接地螺柱，并且两者都有足够检修余量（service loop）。
5. 在线缆端部压接合适的环形接线端子。
6. 拆下电源端子排盖板上的两颗螺钉，以接触连接端子。
7. 按接线图连接 AC 电源线。
8. 重新安装电源端子排盖板。
9. 按所有当地法规要求的 wiring practices，把 earth ground 端子连接到储罐接地。

备注：3/4 inch NPT conduit entries 为标准配置；其他批准尺寸可按需提供。

### 9.3 信号线连接

信号线可通过除左上端口和 AC 电源所用端口以外的任何入口端口连接到 SI-7000。为了便于内部走线，优先使用右侧中间端口。应注意不要让信号线靠近 AC 电源线走线。

SI-7000 设计用于 22 AWG 到 18 AWG 信号线，也可使用最高 14 AWG 的线规。但由于空间有限，建议使用尽可能小的线规。

所有信号线连接都通过电气外壳内主控制器组件 `150-601` 上的单个连接器 `J2` 完成。要连接到信号线的配对连接器 `Phoenix Contact #1863259` 已插在主控制器上，安装套件中还包含一个备用连接器。

线端套管（ferrules）不是必需的，但强烈建议使用。SI 推荐以下 Phoenix Contact 带套管线端套管，也可使用类似线端套管：

| 线规 | Phoenix Contact 编号 |
| --- | --- |
| 22 AWG | 3203024 |
| 20 AWG | 3200687 |
| 18 AWG | 3200690 |
| 16 AWG | 3200755 |
| 14 AWG | 3200522 |

步骤：

1. 在入口端口安装合适的 cable gland。
2. 拉入足够长度的线缆，使信号线能够走线到主控制器组件上的连接器，并留有足够检修余量（service loop）。
3. 如果使用线端套管（ferrules），将线端套管压接到线端。
4. 从主控制器组件拆下配对连接器。
5. 按接线图把信号线连接到连接器。
6. 将连接器插回主控制器组件 `J2`。

### 9.4 关闭电气外壳门

在电气外壳内部作业时，必须特别小心，避免划伤或损伤隔爆接合面（flame path）表面。任何隔爆接合面划伤或损坏都会使外壳防爆认证失效。

步骤：

1. 如果尚未完成 `Initial Power Up`，确保 AC 电源开关处于 OFF 位置。
2. 从隔爆接合面（flame path）两侧移除保护覆盖物。
3. 使用套件中提供的酒精擦拭片清洁隔爆接合面表面，去除残留粘接剂。
4. 沿外壳侧隔爆接合面一周涂 1/8 inch 真空脂涂敷线（bead），一条靠近外边缘，一条靠近中心。
5. 移除把门保持在打开位置的销。
6. 完全关闭门。
7. 使用提供的 Allen wrench 拧紧外壳门上的所有螺栓。
8. 将螺栓扭矩拧至 20 ft-lb。
9. 擦除从隔爆接合面中挤出的任何硅润滑剂。

整理备注：证书页明确 `Flameproof joints are not intended to be repaired.`，因此隔爆接合面（flame path）的清洁、保护和关门紧固步骤必须严格按厂家资料和现场防爆要求执行。

## 10. 调试

NOTE：如果 SI-7000 未按 Scientific Instruments 规定的方式使用，设备提供的保护可能受损。

初始上电和调试只能由 Scientific Instruments 人员执行，或在其陪同下执行。在 Scientific Instruments 人员检查安装之前给 SI-7000 上电或操作 SI-7000，会导致保修失效，并且 Scientific Instruments 不对设备损坏承担责任。

### 10.1 初始上电

步骤：

1. 确保 SI-7000 电源开关处于 OFF 位置。
2. 解除 AC 电源上锁挂牌（lock out/tag out）。
3. 将 SI-7000 电源开关切到 ON 位置。
4. 检查主控制器上的以下项目：
   - 红色 `A/C` 电源 LED 亮。如果不亮，检查：
     - 确保 AC 电源已供给控制器组件。
     - 确保电源插头完全插入插座。
   - 绿色 `FUSE` LED 亮。如果不亮，检查：
     - 检查 AC 插头模块中的保险丝，套件中含备用保险丝。
   - 绿色 `PWR` LED 亮。如果不亮，最可能原因是：
     - DC 电源不工作，更换控制器组件。
   - LCD 点亮并显示主菜单。如果没有：
     - 拆下控制器组件，确认 LCD 已完全连接。
     - 如果仍不成功，则 LCD 或 CPU 不工作，更换控制器组件。
5. 继续下一项测试，或将 SI-7000 电源开关切到 OFF 位置。

### 10.2 电机驱动测试

步骤：

1. 确保 SI-7000 电源开关处于 ON 位置。
2. 在触摸屏 LCD 上进入 Motor menu。
3. 触摸 down arrow 一次。
   - 电机应以最低速度开始降低探头组件。
4. 第二次触摸 down arrow。
   - 电机应增加到中速。
5. 第三次触摸 down arrow。
   - 电机应增加到最高速度。
6. 第四次触摸 down arrow。
   - 电机应回到中速。
7. 触摸 stop button。
   - 电机应停止，并将探头保持在当前位置。
8. 触摸 up arrow 一次。
   - 电机应以最低速度开始提升探头组件。
9. 第二次触摸 up arrow。
   - 电机应增加到中速。
10. 第三次触摸 up arrow。
    - 电机应增加到最高速度。
11. 第四次触摸 up arrow。
    - 电机应回到中速。
12. 允许电机把探头提升到 parked position。
    - 电机应自动停止，并把探头保持在 parked position。

### 10.3 基准标定（Bench Marking）

步骤：

1. 确保 SI-7000 电源开关处于 ON 位置。
2. 在触摸屏 LCD 上进入 Motor menu。
3. 触摸 down arrow 一次。
   - 电机应以最低速度开始降低探头组件。
4. 通过探头外壳窗口观察链条运动，当链条上的指定标记与参考点对齐时停止电机。记录 step count。
   - 电机应停止，并将探头保持在当前位置。
5. 触摸 down arrow 三次。
   - 电机应开始降低探头组件。
6. 通过探头外壳窗口观察链条运动，当链条上的第二个标记与参考点对齐时停止电机。记录第二个 step count。
7. 计算 level scale。详细信息咨询厂家。
8. 触摸 up arrow 三次。
   - 电机应开始提升探头组件。
9. 允许电机把探头提升到 parked position。
   - 电机应自动停止，并把探头保持在 parked position。

### 10.4 通信

步骤：

1. 确保 SI-7000 电源开关处于 ON 位置。
2. 确保绿色 `COM` LED 亮。
3. 从控制室发送降低探头命令。
   - 电机应开始降低探头组件。
4. 从控制室发送停止电机命令。
   - 电机应停止，并将探头保持在当前位置。
5. 从控制室发送提升探头命令。
   - 电机应开始提升探头组件。
6. 允许电机把探头提升到 parked position。
   - 电机应自动停止，并把探头保持在 parked position。

## 11. Appendix A - Bolt Tightening Work Sheet

该附录是螺栓紧固工作表，用于记录位置、螺栓规格、法兰表面处理、润滑剂、每步签字和最终签名。

需要填写字段：

| 原文 | 中文整理 |
| --- | --- |
| Location/Identification | 位置/标识 |
| Nominal Bolt Size | 公称螺栓尺寸 |
| Surface Finish on Flange | 法兰表面处理 |
| Lubricant Used | 使用的润滑剂 |
| Name | 姓名 |
| Signature | 签名 |
| Date | 日期 |

备注翻译：螺栓润滑会显著影响安装垫片时使用的扭矩值。为了实现相同的垫片压缩量，相比使用有效润滑剂如二硫化钼，干螺栓需要高得多的扭矩。润滑剂不应作为脱模剂涂到垫片或法兰面上。

每一步需要签名或首字母确认：

1. 确保系统处于环境温度并已泄压。
2. 目视检查并清洁法兰、螺栓、螺母和垫圈。
3. 润滑螺栓、螺母以及螺母表面的法兰接触面。
4. 从安装法兰底部插入螺栓并保持到位。
5. 将平垫圈和锁紧垫圈依次放到螺栓端部。
6. 将螺母安装到螺栓端部并手紧。
7. 对剩余七组硬件重复步骤 3 到 6。
8. 使用下列扭矩值和交叉顺序紧固硬件。每个 1 到 8 的紧固序列构成一轮 `round`。
9. 在每一轮之间检查圆周间隙，每隔一个螺栓测量一次。如果圆周间隙不够均匀，应通过选择性拧紧螺栓做适当调整后再继续。

扭矩轮次：

| 轮次 | 原文 | 中文整理 |
| --- | --- | --- |
| Round 1 | Torque to 30 ft-lbs | 拧紧到 30 ft-lb。 |
| Round 2 | Torque to 60 ft-lbs | 拧紧到 60 ft-lb。 |
| Final Rotational Round | 100% of Final Torque | 最终旋转轮，达到最终扭矩 100%，与上文 Round 3 相同。按顺时针旋转顺序，从 Bolt No. 1 开始完成一整轮，并继续直到任何螺母在最终扭矩 100% 下不再发生进一步旋转。 |

附录图给出的交叉紧固顺序为：1、5、3、7、8、4、6、2。

NOTE：初次紧固后 4 到 24 小时之间，由于螺栓松弛，可能发生短期螺栓预紧力损失。SI 建议在初次 `Final Rotation Round` 至少 24 小时后和/或即将调试前重复步骤 10。

## 12. 对 CUBE 适配工作的提示

以下提示不是官方原文，只用于后续整理和项目阅读：

- 安装手册明确 SI-7000 支持 PC 操作员界面和/或 DCS 用户界面，这与 Modbus 协议适配和现场 PLC/DCS 联调相关。
- 手册中的通信测试只检查从控制室发送下降、停止、提升命令后电机动作是否符合预期；具体 Modbus 地址和命令语义仍应以 DCS Modbus 接口规范和当前项目映射表为准。
- 设备 Zone 0 / Zone 1、本安、隔爆和隔爆接合面（flame path）相关要求对现场安全至关重要，协议适配文档不能替代防爆安装和维护规程。
- 夹管阀（Pinch Valve）、保护泡棉、吊装和法兰安装步骤与第三批机械布置图互相印证，后续如果整理现场安装检查表，可把这两份中文稿一起引用。
