duanxuebin1998/cube/docs/03_问题分析与整改/未处理/SI-7000_Reel_Alarm故障分析与现场排查建议.docx

# SI-7000 Reel Alarm 故障分析与现场排查建议

现场维护技术分析报告

设备对象 | Scientific Instruments SI-7000 LTD 原厂设备
文档用途 | Reel Alarm 故障分析 现场排查和维护交接
文档版本 | V1.0
编制日期 | 2026年9月10日
适用人员 | 运行人员 仪表维护人员 现场服务工程师

结论 Reel Alarm 表示 SI-7000 机械单元的 reel 未按预期转动。原厂资料明确指出，该状态可能由驱动机构机械故障或罐内障碍引起，维护人员必须调查。现场还应检查 reel 反馈链路，因为原厂维修流程专门要求确认 decoder 的 reel feedback signal。

该告警不能单独定位到电机、齿轮箱、链条、探头或反馈传感器，也不能证明罐内一定存在障碍。正确处置方法是先停止可能扩大损坏的自动运动，保留告警发生时的状态和位置，再按运动现象逐级隔离故障。

安全限制 机械单元涉及防爆环境和低温介质。打开电气或机械外壳前必须执行现场上锁挂牌和气体安全程序。低温探头提升后应充分升温；原厂资料说明通常需要超过四小时才能接近环境温度。安装 调试和维护应由 Scientific Instruments 认证人员执行。

# 1 告警含义与判断边界

## 1.1 原厂定义

SI-7000 操作手册将 Reel Alarm 定义为机械单元 reel 未转动，并列出两类可能原因：驱动机构机械故障和罐内障碍。DCS Modbus 接口规范把 Reel Alarm 定义在状态地址 10009，并列为必须在自定义操作界面报告的重要状态，用于监控设备是否正常运行。

从系统构成和维修检查项推断，控制器需要同时具备驱动输出和 reel 转动反馈，才能判断运动是否正常。原厂公开资料没有给出 Reel Alarm 的判定延时、允许脉冲差、锁存方式和复位条件，因此不能据此文档设定软件阈值或绕过报警。

## 1.2 驱动链与反馈链

链路 | 设备路径 | 故障后可能表现
驱动链 | 控制器 → Motor Power Output J8 → 电机 → 驱动轴齿轮箱 → reel 链轮和链条 → 探头 | 电机不转 reel 不转 探头不动或运动阻力异常
反馈链 | reel 转动 → decoder 或 encoder → Reel Encoder Input J6 → 控制器 | reel 实际转动但系统仍认为未转动 位置不更新或跳变

## 1.3 相关状态不能混同

状态 | 原厂含义 | 与 Reel Alarm 的关系
Interlock | 探头到达允许的最高位置并禁止继续向上 | 正常停放顶部时可出现 不能替代 Reel Alarm
Probe Uncalibrated | 当前探头位置可能不正确 | 与 Reel Alarm 同时出现时位置和液位可信度进一步下降
Probe At Liquid Level | Auto 模式下探头位于液气界面 | 未置位时不能确认当前液位读数实时有效
Reel Alarm Disable | 覆盖设备中的 reel 安全功能 | 正常不应置位 不能用它消除故障

# 2 故障影响与立即处置

Reel Alarm 出现后，探头位置和运动状态可能已经失去可信基础。继续执行 Calibration Profile 或反复手动升降，可能扩大链条、探头和驱动机构的损坏。若探头没有稳定处于液面，当前液位值也不能作为可靠的实时液位。

优先级 | 现场动作 | 目的
立即 | 停止自动 Profile Calibration 和连续升降命令 保持设备在当前安全状态 | 避免在卡阻或传动失效时继续施加载荷
立即 | 记录报警时间 模式 运动方向 当前位置和同时出现的状态 | 保留故障发生条件 防止复位后证据消失
尽快 | 确认 reel 探头和位置显示是否同步变化 | 区分真实不转和反馈链故障
维护 | 由授权人员按防爆 低温和上锁挂牌要求检查 | 避免人员和设备风险

# 3 设备可能出现的问题

## 3.1 罐内或安装通道阻挡

这是原厂资料明确指出的 Reel Alarm 原因。探头从驱动机构到罐底或静液井的整条路径必须无阻碍。任何障碍都可能使探头卡住，并损坏探头组件 链条或驱动机构。

- 探头碰到罐内结构件 仪表管线 焊接残留或其他障碍物。
- 静液井不垂直 内径不足或局部变形，使探头接触内壁。
- 夹管阀未完全打开或维护后阀门状态错误，限制链条和探头通过。
- 泵或充装管线产生高速液流和湍流，对探头施加侧向载荷。

判别特征 报警经常在相同高度复现 只在某一运动方向出现 或与泵送和装卸液工况同步。若故障位置固定，应优先检查罐内路径和静液井；若只在维护后出现，应先核实阀门和复装状态。

## 3.2 reel 链条和链轮故障

原厂维修手册要求检查链条和链轮是否过度磨损，清洁驱动机构内部并清除异物。严重磨蚀且曾报告驱动问题时，应检查整条驱动链。可能问题包括链条扭结 跳齿 局部损伤 链轮卡涩 异物卷入和润滑或装配状态异常。

判别特征 reel 运动断续 抖动或伴随异常噪声；位置变化不连续；空载测试仍不平顺；报警位置随链条循环而重复。链条检查必须按原厂方法处理，错误搬运本身可能损伤链条。

## 3.3 驱动轴 齿轮箱和轴承故障

SI-7000 的驱动轴齿轮箱位于电气部分，负责把电机输出传递到机械单元。原厂没有在 Reel Alarm 条目中进一步拆分齿轮箱故障，但从传动链分析，联接松脱 齿轮损伤 轴卡滞和轴承磨损都可能造成电机有动作而 reel 不转或负载显著增大。原厂维修资料规定轴承使用十年后更换，该周期基于每天连续机械运动两小时的预期工况。

判别特征 电机有声音或输出，但 reel 完全不转；运动阻力在整个行程持续偏高；设备出现新的机械噪声 振动或温升。此类判断属于工程推断，需要由原厂授权人员拆检确认。

## 3.4 电机驱动和供电故障

电机不产生有效输出时，reel 同样不会转动。应考虑交流输入 保险丝 直流电源 控制器 Motor Power Output J8 电机接头 驱动电子部件和电机本体。原厂维修流程明确要求检查电机连接是否紧固，并通过 Motor 菜单测试上下方向和不同速度。

判别特征 上下方向均无动作且电机无声时，优先查供电和输出；电机启动后立即停止时，优先查驱动保护 负载过大或连接问题；只有一个方向异常时，需进一步检查方向控制 驱动输出和机械受力差异。公开资料没有给出 Reel Alarm 与具体电气故障码的对应关系。

## 3.5 decoder 和 reel 反馈故障

原厂维修手册单独要求检查 decoder 的 reel feedback signal，控制器接口表也列出 Reel Encoder Input J6。因此，Reel Alarm 既可能表示 reel 确实没有转动，也可能表示 reel 已转动但控制器没有收到有效反馈。可能原因包括 decoder 或 encoder 故障 插头松动 端子腐蚀 线束损伤 反馈机构与 reel 脱离及控制器输入故障。

判别特征 目视可见 reel 和链条正常运动，但报警仍存在；位置显示不变化 跳变或与实际方向不一致；轻微振动或触碰连接处时状态变化。现场不得通过短接或禁用 Reel Alarm 来代替反馈检查。

## 3.6 基准开关和位置状态异常

Bottom Reference Switch 和 Top Reference Switch 不属于 Reel Alarm 本身，但它们决定探头停止和位置基准。开关动作异常 接线问题或维护期间物理移动探头，可能导致 Probe Uncalibrated Interlock 或位置异常，并使后续运动进入不合理区间。若这些状态与 Reel Alarm 同时出现，应一起调查，不能只处理 reel。

# 4 现场现象判别表

现场现象 | 优先怀疑 | 下一项证据
电机无声 reel 不动 | 电源 保险丝 控制器 电机输出或接线 | 电源指示 保险丝指示 J8输出 电机接头
电机有声 reel 不动 | 齿轮箱 驱动轴 链轮卡滞或探头受阻 | 电机状态 机械噪声 reel目视状态 发生位置
reel 转动但报警仍置位 | decoder encoder J6或反馈线路 | reel feedback signal 位置变化与实际运动对照
总在同一高度报警 | 罐内障碍 静液井接触或局部链条损伤 | 报警高度 方向 重复性 罐内布置图
只在上行报警 | 上提阻力 收链异常 顶部通道或传动负载 | 上行电机状态 reel状态 Interlock
只在下行报警 | 阀门未全开 放链不顺或罐内障碍 | 夹管阀状态 下行报警高度 reel状态
泵送或装卸液时出现 | 液流和湍流导致探头侧向受力 | 泵和充装状态 报警时段 运行趋势
维护后首次运行出现 | 阀门状态 连接器松动 链条复装或探头位置改变 | 维护项目 复装记录 Probe Uncalibrated
偶发后逐渐频繁 | 磨损 松动 腐蚀或轴承劣化 | 历史报警趋势 机械噪声 维护年限

# 5 建议的现场排查顺序

## 5.1 复位前保留证据

1. 记录 Reel Alarm 首次出现时间 持续时间和是否自动恢复。
2. 记录当时模式 Auto Calibration Profile 或 Manual 以及上行 下行或停止状态。
3. 记录当前位置 液位 Bottom Reference Interlock Probe Uncalibrated 和 Probe At Liquid Level。
4. 保存 Motor 页面参数 报警画面 趋势和最近一次操作或自动任务。
5. 记录泵送 充装 卸液和维护活动，确认是否与告警时间相关。

## 5.2 不开盖的外部观察

6. 确认收到运动命令后电机 reel 链条和位置显示是否同步变化。
7. 比较上行和下行表现，确认故障是否具有方向性。
8. 确认报警是否总在相同位置出现，并与罐内布置和静液井结构对照。
9. 检查 Reel Alarm Disable 是否保持未置位。

Manual 模式限制 原厂操作手册说明 Manual 模式不报告报警且液位读数不更新。因此，Manual 下未出现 Reel Alarm 不能证明设备无故障，必须结合 reel 实际运动和 Motor 页面判断。

## 5.3 授权维护检查

以下检查涉及防爆外壳 低温探头和机械传动，仅用于明确检查范围，不构成现场作业授权。执行人员必须遵守原厂手册和现场安全程序。

10. 执行停机 上锁挂牌 气体检测和现场许可，确认探头已达到允许维护的温度。
11. 检查电气单元端子 连接器 电机接头是否紧固，是否存在腐蚀 异物或部件劣化。
12. 检查 reel 链条和链轮是否磨损 卡涩 扭结 跳齿或卷入异物。
13. 检查驱动轴齿轮箱 联接和轴承是否存在松脱 卡滞 异响或异常间隙。
14. 检查 decoder 的 reel feedback signal 以及 J6接口和线束完整性。
15. 确认夹管阀完全打开，探头和链条通道没有安装干涉。

# 6 维修后的功能验证

恢复运行前应按照原厂基本功能测试验证电机 探头和位置状态。验证不能只以 Reel Alarm 清除为通过标准。

验证项目 | 预期结果 | 不通过时的处理
Motor 向下低 中 高速 | 探头平稳下降 速度变化可识别 无异常噪声 | 停止测试 重新检查负载 驱动和反馈
Motor 停止和保持 | 电机停止并将探头保持在当前位置 | 检查驱动和制动保持能力
Motor 向上低 中 高速 | 探头平稳提升 速度变化可识别 | 检查上行机械阻力和收链状态
顶部停放 | 到达 parked position 后自动停止并保持 | 检查 Top Reference Interlock和位置状态
Level Calibration | 正确找到罐底并返回液位 到达液位后快速停止 | 检查基准开关 位置和液位传感状态
完整 Profile | 从底部到液位完成采点并返回 Auto | 保留失败阶段和位置 不重复强行运行
报警和状态 | Reel Alarm 保持清除 相关状态与实际位置一致 | 不得通过 Alarm Disable 规避

# 7 现场记录表

编号 | 记录项目 | 现场结果或证据 | 人员和时间
1 | 报警日期和时间
2 | 设备编号和罐号
3 | 运行模式和运动方向
4 | 报警位置和当前液位
5 | 同时出现的状态和报警
6 | 泵送 充装或卸液状态
7 | 最近维护和操作记录
8 | reel 电机和位置显示现象
9 | 检查结果和更换部件
10 | 复测结果

# 8 结论

原厂 SI-7000 的 Reel Alarm 应按真实驱动或反馈故障处理。优先判断 reel 是否实际转动，再区分罐内阻挡 机械传动 电机输出和 decoder反馈。报警清除只能说明当前监控条件恢复，仍需完成运动 基准 液位和 Profile 验证，确认设备没有残余卡阻 位置偏差或间歇性反馈故障。

若现场证据仍无法区分机械卡阻和反馈丢失，应把报警发生位置 运动方向 Motor页面数据 状态位和操作历史提交给 Scientific Instruments 技术支持，由原厂决定是否进行进一步拆检或部件更换。

# 9 资料依据

- Scientific Instruments SI-7000 DCS Modbus Interface Manual 文件号 020-701 Rev B 状态位章节 第6至7页
- Scientific Instruments SI-7000 Installation and Commissioning Manual 文件号 090-7000-1 Rev A 罐内要求和电机驱动测试章节
- Scientific Instruments SI-7000 Operation Manual 文件号 090-7000-2B Rev A Reel Alarm和运行模式章节
- Scientific Instruments SI-7000 Service Manual 文件号 090-7000-3 Rev - 周期维护和基本功能测试章节
- 仓库原始资料 SI7000官方资料包 含Modbus规范 PDF 共101页

资料边界 原厂公开资料没有披露 Reel Alarm 的内部判定阈值 延时 去抖 锁存和复位算法，也没有给出该状态与各电气部件故障码的一一对应关系。本文中的齿轮箱 轴承和反馈链细分属于基于原厂结构与维护项目的工程分析，最终结论以现场证据和原厂技术支持判断为准。
