duanxuebin1998/cube/docs/06_SIL功能安全认证/03_软件详细设计/CPU2软件详细设计编制工作包/06_分卷编制/05_故障恢复与安全机制/FX01.CPU2软件详细设计_第5分册_故障恢复与安全机制V0.2.docx

DSM 系列储罐在线自动计量仪

CPU2软件详细设计

第5分册 - 故障恢复与安全机制

V0.2 编制稿

青岛澳邦量器有限责任公司

文档信息
文件名 | CPU2软件详细设计第5分册：故障恢复与安全机制 | 日期 | 2026-08-01
作者 | Codex 协助编制 | 批准 | 待批准
文档编号 | FX01-SDD-CPU2-05 | 模版号 | V0.2

版本记录
版本号 | 摘要 | 作者 | 审批 | 日期
V0.1 | 建立故障管理、自动恢复、电源、看门狗和执行上下文首批设计。 | Codex 协助编制 | 待审批 | 2026-07-31
V0.2 | 按一代参考三分节版式重建，补充统一故障出口、自动恢复、24V安全状态、ADC/DMA局部恢复、错误日志、异常上下文和IWDG详细设计，新增九张可编辑流程图。 | Codex 协助编制 | 待审批 | 2026-08-01

目录

# 1. 概述

## 1.1 目的与范围

本分册描述CPU2统一故障快照、同步与异步错误出口、自动恢复状态机、24V电源监控和局部恢复、错误日志、异常上下文以及IWDG监督机制。测量和运动故障产生点由第2A/2B分册维护，板间通信故障由第3分册维护，FRAM记录格式和普通参数持久化由第4分册维护，AO、继电器及其它硬件输出由第6分册维护。

## 1.2 证据边界

正文以MAIN@66d5c062和当前故障链源文件为静态依据；这些目标源文件相对HEAD和暂存区均无单独差异。源码核对、Word/Visio门禁、构建或渲染不等于真实24V低压、ADC/DMA故障、FRAM掉电、电机停机、看门狗复位、异常注入、目标板、现场或SIL认证验证。

对象 | 当前值 | 设计解释 | 证据状态
CPU2固件 | V1.36.1.0 | 本册静态核对版本轴 | 源码已核对
CPU3配套 | V1.36.0.0 | 只作为当前文档配套轴 | 资料已核对
共享协议 | DEVICE_PROTOCOL_VERSION=31 | 本册不改变共享契约 | 源码已核对
参数存储 | DEVICE_PARAM_VERSION=3 | 只引用恢复次数和FRAM门禁边界 | 源码已核对
源码基线 | MAIN@66d5c062 | 故障链目标文件无工作区差异 | Git边界已核对
无关覆盖层 | measure_oilLevel.c两行 | 不进入本册故障链事实 | 隔离保留

# 2. 故障状态与统一出口

## 2.1 故障快照与职责边界

入口 | 上下文 | 立即动作 | 后续动作 | 禁止扩大表述
CHECK_ERROR返回码 | 线程态 | 保存位置并进入统一日志出口 | 普通错误上报；两类均执行HandleError | 不改写原码
CHECK_ERROR全局码 | 线程态 | 标记全局来源并进入统一日志出口 | 普通错误上报；两类均执行HandleError | 不归因成当前返回值
SET_ERROR | 线程态 | 发布STATE_ERROR、原码和回零标志 | 日志和慢停 | 不是等级策略
空闲全局兜底 | 线程态 | 在无新命令/无恢复时发布 | 日志和慢停 | 不能抢占新命令
FaultManager_ LatchAsyncError | ISR/PendSV链 | 发布快照后立即拉高ENN | 无自动补处理；仅保持错误态 | 不打印、不慢停
STATE_SWITCH | 控制流 | 退出或取消当前流程 | 由命令仲裁处理 | 不是故障

## 2.2 CHECK_ERROR优先级

1. 先检查调用函数返回码；非NO_ERROR立即进入FaultManager_HandleCheckError并原样返回。

2. 返回码正常后检查g_measurement.device_status.error_code；存在全局错误时进入FaultManager_HandleGlobalError。

3. 前两项均正常后检查有效命令切换请求；命中时按STATE_SWITCH退出。

4. 上述优先级保证非NO_ERROR函数返回状态先于既有全局状态处理，既有全局状态又先于独立命令切换检查；STATE_SWITCH属于控制流而不是故障。

## 2.3 停机与清错边界

HandleError只在电机驱动初始化有效时调用MotorCtrl_SlowStop；驱动无效时同一连续故障只提示一次。慢停失败只产生错误报警，不能覆盖原始故障码。fault_info_init会请求慢停但不检查返回结果；即使慢停失败，仍继续按Encoder_HasLatchedFault和PowerMonitor_HasLatchedFault两类锁存决定是否清除全局错误码；除这两类锁存外，其他全局错误不会阻止清码。

## 2.4 未消费的分类类型

fault_manager.h定义了FaultCategory、FaultSeverity、FaultRecoveryAction和FaultRecoveryPolicy类型，但当前CPU2运行代码没有实际消费点。本册不得把这些声明写成已落实的等级判定、模块复位或系统重启策略；实际行为必须以错误码调用点、统一出口、独立电源优先级和自动恢复状态机为准。

# 3. 自动恢复状态机

## 3.1 进入条件与排除顺序

1. 命令结束后读取当前真实错误码；NO_ERROR和STATE_SWITCH都不启动恢复。

2. 先排除硬件保护、确定性协议/参数、独立电源状态机及确定性测量/系统错误。

3. 读取fault_auto_recovery_retry_limit：0关闭，1-10有效，大于10回退默认3次。

4. 最后按20个正式业务命令白名单判断；即时控制、维护和未知命令不后台重跑。

5. 满足条件后只保存命令、错误、设备状态、回零状态和节拍，不在命令收尾中嵌套恢复。

排除域 | 代表错误 | 原因 | 处理边界
电机硬件/机构 | 堵转、过温、相线短路/断路、未知反馈 | 自动重跑可能扩大风险 | 保留错误，人工排查
传感器确定性协议 | 身份、版本、能力、命令、参数、模式不匹配 | 重读不能改变配置事实 | 不进通用恢复
参数确定性错误 | 范围、缺失、冲突、不支持、存储大小/版本/写校验 | 需要修改参数或介质处置 | 不进通用恢复
电源类 | 低压、OVR、DMA停止、初始化/恢复失败、掉电保存失败 | 已有独立状态机和解锁点 | 由PowerMonitor处理
测量/系统确定性 | 罐高未配置、结果越界、计划无效、缓冲或调用条件错误 | 恢复检查无法改变输入条件 | 保留错误

## 3.2 等待、健康检查与业务重跑

阶段 | 状态动作 | 成功含义 | 失败/退出
等待 | 每轮恢复原错误状态，按1000ms节流 | 仅保持现场 | 配置关闭则清上下文
驱动准备 | 原错为驱动类或初始化无效时MotorCtrl_Init | TMC5130具备继续检查条件 | 记录真实检查错误
部件检查 | Sensor_CheckAllPartParams | 传感器、命令和位置链具备重跑条件 | 不允许重跑业务
返回命令 | command_retry_count加1并置awaiting | 只通知主循环 | 达到上限则停止
业务重跑 | App_MainLoop调用正式业务入口 | 业务命令返回NO_ERROR才完整恢复 | 失败继续或达到上限
命令切换 | 新串口/正式命令或检查中发现切换 | 用户控制优先 | 普通提示并清上下文

## 3.3 主循环优先级与取消

App_MainLoop每轮先处理PowerMonitor_ProcessDeferred和轻量后台报告，再按新串口命令、正式pending命令、FaultRecovery_Poll、空闲全局错误兜底的顺序仲裁。新命令到达时先取消旧恢复。恢复模块返回的retry_command仍通过DeviceCommand_PrepareRecoveryExecution和App_ExecuteMeasureCommand执行，因此恢复模块不反向依赖ProcessMeasureCmd。

# 4. 24V电源安全与局部恢复

## 4.1 状态、阈值与优先级

项目 | 当前值 | 软件语义 | 验证边界
低压阈值 | 2256 ADC | 约20V时进入安全状态 | 分压、VDDA、误差和温漂待台架校准
恢复阈值 | 2482 ADC | 约22V，形成约2V滞回 | 真实门限待台架校准
稳定时间 | 连续100ms | 达到恢复阈值且紧急保存完成后释放普通FRAM写 | 边界抖动待验证
局部恢复次数 | 3次 | 每轮主循环最多一次ADC/DMA重启 | 失败后不自动重启整机
首样本等待 | 5ms | 启动或局部恢复等待DMA新样本 | 最坏时序待目标板测量
故障优先级 | 2-6 | 模块私有且只升级，掉电保存失败最高 | 不等同于FaultSeverity

## 4.2 低压、紧急保存与稳定恢复

1. ADC模拟看门狗确认采样低于2256后关闭AWD中断，锁存低压并立即拉高ENN、禁止普通FRAM写。

2. 只有编码器可信位置已经布防且本低压事件尚未投递时，才预约FRAM、请求编码器紧急保存并挂PendSV。

3. PendSV先消费SSI事件更新RAM累计位置，再执行编码器A/B记录及独立掉电回执；设备参数普通保存不在此路径。

4. SysTick在电压达到2482后连续累计100ms，并等待编码器紧急保存pending清除。

5. 条件满足后释放FRAM预约、恢复普通FRAM写和AWD中断；电机门禁及锁存错误仍保持。

6. 监控已回到HEALTHY后，新的顶层正式过程调用PowerMonitor_BeginNewProcess再次复核DMA、OVR和电压，才允许软件解锁。

## 4.3 ADC/DMA局部恢复

触发 | ISR/轻量动作 | 线程态动作 | 最终边界
启动失败 | 保持STOPPED/安全门禁 | 进入RECOVERY_PENDING | 最多3次局部重启
ADC OVR | 记录原因、关闭AWD、硬禁止 | 每轮一次重启 | 成功不清锁存
DMA停止 | 记录原因、关闭AWD、硬禁止 | 每轮一次重启 | 成功不清锁存
三次失败 | 无额外中断重启 | 置RECOVERY_FAILED并升级错误 | 本次上电不再恢复；新正式流程仍拒绝
局部成功 | 重新取得并应用首样本 | 记录重试成功 | 等待新正式流程复核解锁

## 4.4 FRAM和电机解锁边界

电压稳定恢复只释放普通FRAM写，不会自动清除PowerMonitor锁存码，也不会开放电机。监控已回到HEALTHY且现场条件全部满足时，新正式过程才在临界区内清首故障、当前锁存、恢复原因和次数并开放电机门禁；RECOVERY_FAILED本次上电仍拒绝新正式过程，需重启后由PowerMonitor_Start重新初始化。因此‘电压恢复’、‘ADC/DMA恢复成功’、‘普通FRAM可写’和‘允许新运动’是四个不同事件。

# 5. 错误日志与可诊断性

## 5.1 统一日志阶段

阶段 | 入口 | 关键字段 | 过滤规则
错误重试 | ErrorLog_Retry/Detail | 模块、操作、原因、次数、错误码、名称、详情 | 长重试只首轮和末轮
重试成功 | ErrorLog_Recover/Detail | 模块、操作、原因、次数、详情 | 由调用方确认恢复
错误报警 | ErrorLog_Warn/Detail | 模块、操作、原因、处理、详情 | 不代替最终报错
最终报错 | ErrorLog_ReportDetail | 模块、操作、原因、错误码、名称、处理、详情 | NO_ERROR/STATE_SWITCH忽略

## 5.2 重复抑制和存储边界

最终报错在RAM中只保留一条最近错误码和时间戳；同码且不超过200ms时用于抑制上下层重复输出。超时或换码后允许新的最终报错。error_log当前只通过printf输出结构化文本，没有FRAM、Flash、文件或环形缓冲持久故障历史，不能写成具备掉电后故障追溯。

# 6. 监督执行与异常上下文

## 6.1 ISR、PendSV和前台职责

上下文 | 允许动作 | 代表入口 | 禁止或风险边界
ISR | 采样、寄存器硬门禁、置标志、投递事件 | ADC、SysTick、TIM4 | 不打印、不运行通用恢复、不做普通FRAM事务
PendSV | 有界延后处理和编码器紧急持久化 | AS5145、Encoder、AO、UART | 仍是异常上下文，不能执行前台策略
前台 | 日志、慢停、ADC/DMA局部重启、自动恢复和业务重跑 | App_MainLoop | 同步业务阻塞会推迟后台任务

## 6.2 TIM4和IWDG

项目 | 配置/条件 | 当前设计含义 | 不能证明
IWDG | 预分频32、重装4095 | 典型32kHz LSI名义约4.096s | 实际超时未测
TIM4 | 75MHz计时钟、PSC=14999、ARR=1249 | 约250ms中断节拍 | 晶振和运行抖动未测
喂狗条件 | SCB ICSR RETTOBASE非0 | 没有被抢占ISR时刷新IWDG | 不等于主循环活性
业务分频 | 每8拍 | 约2s更新继电器、AO投递和UART恢复 | 不等于2s完整业务周期保证

## 6.3 处理器异常边界

NMI、HardFault、MemManage、BusFault和UsageFault当前均进入无限循环，未在处理函数中保存SCB故障寄存器、堆栈、程序计数器或复位原因，也未主动触发受控复位。IWDG能否最终复位取决于TIM4是否仍可运行并满足喂狗条件；当前静态代码不能证明所有异常都会形成可追溯复位。

# 7. 核心函数详细设计

以下函数严格沿用一代参考的分类Heading 2、文件Heading 3、函数Heading 4和双列表格。编号属于SDD-FLT设计项；各故障产生点由对应业务分册维护，本册只展开统一出口、恢复、电源和监督边界。

## 7.1 统一故障出口

### 7.1.1 fault_manager.c

#### 7.1.1.1 SDD-FLT-001 FaultManager_PublishErrorSnapshot

函数原型 | static void FaultManager_PublishErrorSnapshot(uint32_t error_code)
函数功能 | 在短临界区内把设备状态、原始错误码和回零要求作为一致故障快照发布。
形参 | error_code为整机错误码；调用方已排除或接受NO_ERROR、STATE_SWITCH语义。
返回值 | 无。
全局变量 | 写g_measurement.device_status.device_state、error_code和zero_point_status。
静态全局变量 | 无函数静态对象。
局部变量 | 保存进入函数时的PRIMASK。
调用上下文 | 线程态和异步锁存链均可调用；临界区内不打印、不等待。
前置条件 | 全局测量对象已初始化；传入错误码保持原模块语义。
后置条件 | 完成STATE_ERROR、原码和zero_point_status=1U的有序发布，并恢复原中断开关状态。
异常处理 | 不判断错误码类别，不执行停机，不记录日志。
可重入性 | 通过短临界区序列化多字段写入；调用后读取侧仍需遵守共享对象并发约束。
源码证据 | Application/Src/fault_manager.c:28-40。
验证状态 | 源码已核对；ISR/前台竞争与CPU3读取一致性待目标板压力验证。

#### 7.1.1.2 SDD-FLT-002 FaultManager_LatchAsyncError

函数原型 | void FaultManager_LatchAsyncError(uint32_t error_code)
函数功能 | 为ISR或PendSV确认的异步故障发布快照并立即硬关闭电机驱动。
形参 | error_code为异步链确认的原始错误码。
返回值 | 无；NO_ERROR或STATE_SWITCH时直接返回。
全局变量 | 写统一故障快照并调用stpr_disableDriver。
静态全局变量 | 无。
局部变量 | 无大对象局部变量。
调用上下文 | 允许从异步链调用；不执行printf、ErrorLog或慢停。
前置条件 | 异步源已完成自身确认和去抖，错误码不是临时采样值。
后置条件 | 故障状态先发布，随后ENN被拉高，阻止下一次线程态检查前继续运动。
异常处理 | 本函数不执行可控减速，空闲兜底也不会补打印或补慢停；当前仅保持错误态和硬停，未形成自动前台诊断闭环。
可重入性 | 依赖发布函数的短临界区；硬停动作必须保持中断安全。
源码证据 | Application/Src/fault_manager.c:47-58。
验证状态 | 源码已核对；自动前台最终日志/慢停闭环缺失，真实异步注入、ENN波形和停机距离待台架验证。

#### 7.1.1.3 SDD-FLT-003 FaultManager_HandleCheckError

函数原型 | uint32_t FaultManager_HandleCheckError(uint32_t error_code, const char *file, uint32_t line, const char *func)
函数功能 | 处理CHECK_ERROR捕获的函数返回码，保存位置并经过统一日志出口后执行停机；STATE_SWITCH不打印最终报错但仍停机。
形参 | error_code为函数返回码；file、line、func为检查点位置。
返回值 | 原样返回error_code。
全局变量 | 写全局err上下文；读取统一日志映射和电机状态。
静态全局变量 | 无。
局部变量 | 无大对象局部变量。
调用上下文 | 线程态错误出口；可能打印并调用MotorCtrl_SlowStop。
前置条件 | CHECK_ERROR已先判定返回值非NO_ERROR。
后置条件 | 错误位置写入err，经过统一日志出口并调用停机处理；STATE_SWITCH被日志出口过滤。
异常处理 | 慢停失败只补充警告；不覆盖原始error_code。
可重入性 | 全局err不是并发队列；设计依赖前台业务串行执行。
源码证据 | Application/Src/fault_manager.c:176-203、261-274；fault_manager.h:134-160。
验证状态 | 源码已核对；普通错误、STATE_SWITCH、日志过滤和慢停失败组合待主机桩及目标板验证。

#### 7.1.1.4 SDD-FLT-004 FaultManager_HandleGlobalError

函数原型 | uint32_t FaultManager_HandleGlobalError(uint32_t error_code, const char *file, uint32_t line, const char *func)
函数功能 | 处理CHECK_ERROR第二优先级捕获的既有全局错误状态。
形参 | error_code为当前全局错误码；其余参数为捕获位置。
返回值 | 返回仍需传播的原始全局错误码。
全局变量 | 写err；读取当前命令和设备状态形成全局来源日志。
静态全局变量 | 无。
局部变量 | 全局错误日志详情缓冲区位于下层函数。
调用上下文 | 线程态调用；在函数返回码正常之后、命令切换检查之前。
前置条件 | g_measurement.device_status.error_code非NO_ERROR。
后置条件 | 保留原故障码和故障态，输出全局来源并执行停机。
异常处理 | 不把全局错误归因成当前函数返回错误；200ms同码窗口可能抑制重复最终日志。
可重入性 | 依赖前台串行调用和全局错误快照的一致性。
源码证据 | Application/Src/fault_manager.c:216-249、288-301；fault_manager.h:145-152。
验证状态 | 源码已核对；全局异步置错与CHECK_ERROR竞争待注入验证。

#### 7.1.1.5 SDD-FLT-005 FaultManager_SetErrorState

函数原型 | void FaultManager_SetErrorState(uint32_t error_code, const char *file, uint32_t line, const char *func)
函数功能 | 实现SET_ERROR宏的统一置错、最终日志和停机出口。
形参 | error_code为非NO_ERROR且非STATE_SWITCH错误；位置参数由宏注入。
返回值 | 无；宏调用后直接return退出当前void流程。
全局变量 | 写err和统一故障快照；调用最终日志与HandleError。
静态全局变量 | 无。
局部变量 | 无大对象局部变量。
调用上下文 | 线程态；不得从ISR直接使用SET_ERROR。
前置条件 | 调用者允许本函数改变设备状态并结束当前流程。
后置条件 | 设备进入STATE_ERROR并保留原错误码和回零要求。
异常处理 | 非法正常码由宏门禁过滤；本函数本身不实现故障等级策略。
可重入性 | 依赖前台串行和统一故障快照临界区。
源码证据 | Application/Src/fault_manager.c:176-203、312-325；fault_manager.h:181-191。
验证状态 | 源码已核对；不同业务入口的置错传播待单元与目标板验证。

#### 7.1.1.6 SDD-FLT-006 FaultManager_SetGlobalErrorState

函数原型 | void FaultManager_SetGlobalErrorState(uint32_t error_code, const char *file, uint32_t line, const char *func)
函数功能 | 把主循环空闲兜底发现的残留全局错误转入统一故障状态。
形参 | error_code为残留全局错误；位置参数标记兜底检查点。
返回值 | 无。
全局变量 | 写err和统一故障快照；读取当前命令、状态并执行日志和慢停。
静态全局变量 | 无。
局部变量 | 无大对象局部变量。
调用上下文 | 仅由前台空闲兜底调用；新命令和恢复逻辑优先。
前置条件 | 命令槽和current_command均为空，且错误码不是NO_ERROR或STATE_SWITCH。
后置条件 | 残留故障保持原码进入STATE_ERROR；不清除待执行命令。
异常处理 | 已处于错误态时上层避免重复调用，防止重复慢停和日志。
可重入性 | 依赖App_MainLoop的优先级和前台串行。
源码证据 | Application/Src/fault_manager.c:216-249、338-351；Application/Src/app_main.c:66-105。
验证状态 | 源码已核对；新命令并发到达与兜底顺序待压力验证。

#### 7.1.1.7 SDD-FLT-007 HandleError

函数原型 | void HandleError(void)
函数功能 | 在驱动初始化有效时慢速停止电机，同时不改变触发处理的原始错误码。
形参 | 无显式参数。
返回值 | 无。
全局变量 | 读取驱动初始化状态；调用MotorCtrl_SlowStop；维护跳过提示锁存。
静态全局变量 | s_handle_error_skip_logged限制连续故障期间的跳过提示。
局部变量 | ret保存慢停结果。
调用上下文 | 线程态；可能访问TMC5130并打印，禁止从ISR直接调用。
前置条件 | 统一故障出口已记录或发布原始错误上下文。
后置条件 | 驱动有效时请求慢停；无效时只提示一次并返回。
异常处理 | 慢停失败调用ErrorLog_Warn，但保持原故障，不升级为新的停机错误。
可重入性 | 不可并发驱动同一电机；依赖业务串行和驱动层互斥。
源码证据 | Application/Src/fault_manager.c:357-379。
验证状态 | 源码已核对；驱动失效、慢停失败和实际减速距离待台架验证。

#### 7.1.1.8 SDD-FLT-008 fault_info_init

函数原型 | void fault_info_init(void)
函数功能 | 在初始化或内部重试边界请求电机慢停（当前不检查返回结果），并按编码器和电源两类锁存状态决定是否清除全局错误码；除这两类锁存外，其他全局错误不会阻止清码。
形参 | 无。
返回值 | 无。
全局变量 | 调用MotorCtrl_SlowStop；读取编码器和电源锁存；条件写全局error_code。
静态全局变量 | 无。
局部变量 | 无大对象局部变量。
调用上下文 | 线程态初始化或业务流程调用。
前置条件 | 编码器和电源模块已经提供锁存查询接口。
后置条件 | 发出慢停请求后继续执行锁存检查；两类锁存均不存在时，无论慢停结果和现有其他全局错误来源如何都会清码。
异常处理 | 慢停失败或仍存在非编码器、非电源全局错误时仍可能清码，形成未确认停机或未保留其他故障而继续清码的组合风险。
可重入性 | 依赖锁存查询与故障源更新的并发一致性。
源码证据 | Application/Src/fault_manager.c:416-427。
验证状态 | 源码已核对；慢停失败、其他全局错误仍被清码以及内部重试与异步锁存交错待故障注入。

## 7.2 自动恢复状态机

### 7.2.1 fault_recovery.c

#### 7.2.1.1 SDD-FLT-009 FaultRecovery_IsNonRecoverableError

函数原型 | static uint8_t FaultRecovery_IsNonRecoverableError(uint32_t error_code)
函数功能 | 排除硬件保护、确定性协议/参数、独立电源状态机和确定性业务错误。
形参 | error_code为命令失败后的真实错误码。
返回值 | 1表示禁止通用自动恢复；0表示继续按命令白名单判断。
全局变量 | 不修改全局对象。
静态全局变量 | 无。
局部变量 | 无大对象局部变量。
调用上下文 | 线程态恢复启动判定。
前置条件 | 错误码枚举和值已由当前固件冻结。
后置条件 | 只完成排除判定，不清错、不停机、不重试。
异常处理 | 未列入排除表不等于一定恢复，还需次数和命令白名单通过。
可重入性 | 纯函数，可重入。
源码证据 | Application/Src/fault_recovery.c:67-114。
验证状态 | 源码已核对；错误码治理变化后需重新审计覆盖。

#### 7.2.1.2 SDD-FLT-010 FaultRecovery_GetRetryLimit

函数原型 | static uint32_t FaultRecovery_GetRetryLimit(void)
函数功能 | 读取自动恢复次数参数，并把超过固件上限的值回退为默认3次。
形参 | 无。
返回值 | 0表示关闭；1-10为配置值；大于10回退3。
全局变量 | 读取g_deviceParams.fault_auto_recovery_retry_limit。
静态全局变量 | 无。
局部变量 | retry_limit。
调用上下文 | 线程态恢复模块。
前置条件 | 参数对象已加载；上限和默认宏与参数模块一致。
后置条件 | 返回本次判定使用的次数，不修改持久参数。
异常处理 | 非法大值不会写回FRAM；0必须保留关闭语义。
可重入性 | 只读单字段，按当前32位平台访问。
源码证据 | Application/Src/fault_recovery.c:122-132；Services/ParamStorage/system_parameter.h:32-33、833。
验证状态 | 源码已核对；0、1、10、11及极值用例待主机测试。

#### 7.2.1.3 SDD-FLT-011 FaultRecovery_IsRecoverableCommand

函数原型 | static uint8_t FaultRecovery_IsRecoverableCommand(CommandType command)
函数功能 | 按20个正式业务命令白名单决定是否允许后台自动重跑。
形参 | command为刚失败的正式CommandType。
返回值 | 1表示命令允许恢复；0表示即时控制、维护或未知命令不得后台重跑。
全局变量 | 不修改全局对象。
静态全局变量 | 无。
局部变量 | 无大对象局部变量。
调用上下文 | 线程态恢复启动判定。
前置条件 | 命令值已通过正式命令入口形成。
后置条件 | 只完成白名单判定。
异常处理 | 错误类型由独立排除函数判断，不能把白名单写成故障等级策略。
可重入性 | 纯函数，可重入。
源码证据 | Application/Src/fault_recovery.c:141-169。
验证状态 | 源码已核对；全部CommandType枚举覆盖测试待执行。

#### 7.2.1.4 SDD-FLT-012 FaultRecovery_UpdateAfterCommand

函数原型 | void FaultRecovery_UpdateAfterCommand(CommandType command)
函数功能 | 在正式业务命令结束后更新自动恢复上下文，区分成功、切换、继续恢复和达到上限。
形参 | command为刚执行结束的正式命令。
返回值 | 无。
全局变量 | 读取全局错误码和次数参数；更新s_fault_recovery并输出恢复日志。
静态全局变量 | 复用FaultRecoveryContext。
局部变量 | error_code和retry_limit。
调用上下文 | 由App_ExecuteMeasureCommand在线程态调用。
前置条件 | 业务命令已经返回并把真实结果写入全局错误状态。
后置条件 | 只有等待对应重跑结果且业务成功时才记录完整恢复成功；失败则继续或停止。
异常处理 | STATE_SWITCH只清上下文，不记为恢复成功；关闭参数会终止活动恢复。
可重入性 | 不可与另一正式命令并发更新同一恢复上下文。
源码证据 | Application/Src/fault_recovery.c:343-399；Application/Src/app_main.c:45-58。
验证状态 | 源码已核对；成功、切换、换码和上限组合待主机状态机测试。

#### 7.2.1.5 SDD-FLT-013 FaultRecovery_Cancel

函数原型 | void FaultRecovery_Cancel(const char *reason)
函数功能 | 在新串口命令、正式命令或检查到命令切换时取消旧恢复上下文。
形参 | reason为诊断说明，当前实现不写入日志字段。
返回值 | 无。
全局变量 | 读取并清空s_fault_recovery；活动时输出普通提示。
静态全局变量 | 复用FaultRecoveryContext。
局部变量 | 无大对象局部变量。
调用上下文 | 线程态；命令切换属于控制流而非故障日志。
前置条件 | 调用方已经决定新命令优先。
后置条件 | 活动恢复被完整清空；无活动时幂等返回。
异常处理 | 不清全局故障码，不进入ErrorLog链，不执行停机。
可重入性 | 依赖前台串行；不用于ISR。
源码证据 | Application/Src/fault_recovery.c:406-418；Application/Src/app_main.c:257-270、275-287。
验证状态 | 源码已核对；连续命令和恢复边界待串口/主机测试。

#### 7.2.1.6 SDD-FLT-014 FaultRecovery_Poll

函数原型 | FaultRecoveryResult FaultRecovery_Poll(void)
函数功能 | 按1s间隔检查恢复条件，必要时重建驱动并返回待主循环重跑的原命令。
形参 | 无显式参数。
返回值 | handled标记是否接管本轮；should_retry_command和retry_command通知主循环重跑。
全局变量 | 读写s_fault_recovery和全局故障状态；调用MotorCtrl_Init、Sensor_CheckAllPartParams。
静态全局变量 | FaultRecoveryContext。
局部变量 | now、check_ret、retry_limit、need_motor_init和结果结构。
调用上下文 | App_MainLoop第三优先级线程态调用；不直接调用ProcessMeasureCmd。
前置条件 | 恢复上下文由失败命令建立，且新命令分支尚未接管。
后置条件 | 等待期保持原错误；检查成功且仍有额度时只返回命令并等待业务结果。
异常处理 | 部件检查成功不等于完整恢复；检查失败记录真实码；命令切换取消；达到上限停止。
可重入性 | 不可并发轮询同一上下文；调用的驱动和传感器检查可能阻塞。
源码证据 | Application/Src/fault_recovery.c:431-521。
验证状态 | 源码已核对；1s节流、驱动重建、健康检查和业务重跑闭环待目标板验证。

## 7.3 电源安全状态机

### 7.3.1 power_monitor.c

#### 7.3.1.1 SDD-FLT-015 PowerMonitor_ForceSafeState

函数原型 | static void PowerMonitor_ForceSafeState(void)
函数功能 | 把电源监控切入禁止运动和禁止普通FRAM写入的硬安全状态。
形参 | 无。
返回值 | 无。
全局变量 | 置s_motor_power_inhibited；调用FRAM写禁止接口；直接写DRV_ENN BSRR。
静态全局变量 | 电源监控模块静态状态。
局部变量 | 无大对象局部变量。
调用上下文 | 启动线程、ADC回调、SysTick或主循环均可能间接调用；不打印、不等待。
前置条件 | GPIO、FRAM门禁和状态对象已初始化到可写。
后置条件 | 电机ENN拉高，普通FRAM写被禁止，并通过DMB完成顺序约束。
异常处理 | 不清除已有事务，不执行电机慢停，不提交紧急记录。
可重入性 | 设计为中断安全；调用者负责多字段锁存临界区。
源码证据 | Services/power_monitor.c:49-55。
验证状态 | 源码已核对；真实低压下ENN时序和进行中FRAM事务边界待台架验证。

#### 7.3.1.2 SDD-FLT-016 PowerMonitor_LatchFault

函数原型 | static void PowerMonitor_LatchFault(uint32_t error_code)
函数功能 | 保存首故障，并按固定优先级只升级对外锁存故障码。
形参 | error_code为电源、ADC/DMA或掉电保存故障。
返回值 | 无；非电源优先级码直接返回。
全局变量 | 写首故障、锁存码和待报告标志，并强制安全状态。
静态全局变量 | 电源监控静态故障快照。
局部变量 | 保存PRIMASK及新旧优先级。
调用上下文 | 可从中断或线程态调用；短临界区内不打印。
前置条件 | 错误码在PowerMonitor_GetFaultPriority映射中。
后置条件 | 首故障只记录一次；对外码只从低优先级升级到高优先级。
异常处理 | 当前优先级是模块私有实现，不等同于fault_manager.h未消费的FaultSeverity。
可重入性 | 通过PRIMASK临界区保护多字段更新。
源码证据 | Services/power_monitor.c:66-83、93-119。
验证状态 | 源码已核对；多故障竞争和优先级升级待故障注入。

#### 7.3.1.3 SDD-FLT-017 PowerMonitor_Start

函数原型 | uint32_t PowerMonitor_Start(void)
函数功能 | 初始化24V监控状态，保持安全门禁，启动ADC循环DMA并确认首个样本。
形参 | 无。
返回值 | 返回NO_ERROR或当前锁存的初始化、低压、采样相关故障码。
全局变量 | 重置电源监控全部静态状态；调用ADC/DMA启动和首样本应用。
静态全局变量 | 电源监控静态状态机。
局部变量 | 无大对象局部变量。
调用上下文 | CPU2业务初始化线程态调用一次；失败后由主循环局部恢复。
前置条件 | ADC、DMA、GPIO和HAL时基已初始化。
后置条件 | 首个有效样本确认后进入健康态；失败保持运动和普通FRAM写禁止。
异常处理 | 启动成功打印只证明软件取得样本，不证明24V精度或台架门限。
可重入性 | 初始化期间不得并发调用新正式过程解锁。
源码证据 | Services/power_monitor.c:301-341。
验证状态 | 源码已核对；ADC启动、5ms首样本和低压上电待目标板验证。

#### 7.3.1.4 SDD-FLT-018 PowerMonitor_Handle24VWatchdogFromISR

函数原型 | void PowerMonitor_Handle24VWatchdogFromISR(uint32_t adc_sample)
函数功能 | 在24V低于2256计数时锁存低压、硬禁止，并在已布防条件下投递一次编码器紧急保存。
形参 | adc_sample为ADC1通道12的12位采样。
返回值 | 无；高于或等于低压阈值时直接返回。
全局变量 | 更新低压状态和采样证据；关闭AWD中断；锁存故障；预约FRAM并挂PendSV。
静态全局变量 | 低压、布防和投递静态标志。
局部变量 | 无大对象局部变量。
调用上下文 | ADC模拟看门狗回调/ISR；不打印，不直接执行FRAM事务。
前置条件 | 监控链已启动；紧急保存只有可信位置建立后才布防。
后置条件 | 每个低压事件最多投递一次；实际编码器A/B和回执写入留给PendSV。
异常处理 | 未布防时仍禁止普通FRAM写和运动，但不伪造紧急位置记录。
可重入性 | 中断上下文；依赖锁存函数临界区和单次投递标志。
源码证据 | Services/power_monitor.c:351-380；power_monitor.h:12-28。
验证状态 | 源码已核对；2256门限、掉电保持时间和FRAM提交待台架验证。

#### 7.3.1.5 SDD-FLT-019 PowerMonitor_TickFromISR

函数原型 | void PowerMonitor_TickFromISR(void)
函数功能 | 每1ms监控ADC/DMA健康、维持紧急投递并累计24V稳定恢复时间。
形参 | 无。
返回值 | 无。
全局变量 | 读编码器可信/待提交状态、ADC/DMA和采样；更新恢复计数并控制FRAM门禁/AWD。
静态全局变量 | 电源监控静态状态机。
局部变量 | adc_sample。
调用上下文 | SysTick ISR；不重启ADC/DMA、不访问FRAM事务、不打印。
前置条件 | HAL时基为1ms，电源监控已初始化或处于可诊断状态。
后置条件 | 连续100ms达到2482计数且紧急保存结束后，释放FRAM预约和普通写禁止。
异常处理 | 电压恢复只开放普通FRAM写；电机门禁和故障码继续锁存。
可重入性 | 中断安全；多字段故障请求由锁存临界区保护。
源码证据 | Services/power_monitor.c:410-471；power_monitor.h:22-30。
验证状态 | 源码已核对；100ms稳定时间、2V滞回和边界抖动待台架校准。

#### 7.3.1.6 SDD-FLT-020 PowerMonitor_ProcessDeferred

函数原型 | uint32_t PowerMonitor_ProcessDeferred(void)
函数功能 | 在线程态发布待报告电源故障，并且每轮主循环最多尝试一次ADC/DMA局部恢复。
形参 | 无。
返回值 | 返回本轮待发布的锁存故障码；无报告或局部恢复成功时返回NO_ERROR。
全局变量 | 读写恢复状态、次数和待报告标志；调用ADC/DMA重启及ErrorLog。
静态全局变量 | 电源监控静态状态机。
局部变量 | recovery_cause、report_code、primask。
调用上下文 | App_MainLoop每轮最先调用；线程态允许日志和最多一次5ms启动等待。
前置条件 | 监控状态为RECOVERY_PENDING或存在待报告故障。
后置条件 | 成功重新取得样本但不清锁存；三次失败进入RECOVERY_FAILED并保持禁止。
异常处理 | 不自动重启CPU2；进入RECOVERY_FAILED后本次上电无返回HEALTHY的路径，新正式流程仍被拒绝，需重启重新执行PowerMonitor_Start初始化。
可重入性 | 前台串行；待报告标志通过短临界区取走。
源码证据 | Services/power_monitor.c:481-528；Application/Src/app_main.c:244-248。
验证状态 | 源码已核对；OVR、DMA停止、三次失败、新命令拒绝及重启初始化待目标板验证。

#### 7.3.1.7 SDD-FLT-021 PowerMonitor_BeginNewProcess

函数原型 | uint32_t PowerMonitor_BeginNewProcess(void)
函数功能 | 在新的顶层正式过程开始时现场复核链路、电压和恢复状态；仅监控状态已经回到HEALTHY时作为软件解锁点。
形参 | 无。
返回值 | 条件全部满足返回NO_ERROR；否则返回现有锁存码或初始化失败码。
全局变量 | 读取ADC/DMA、OVR、低压和监控状态；条件清故障并开放电机及普通FRAM写。
静态全局变量 | 电源监控锁存和恢复状态。
局部变量 | adc_sample、primask、error_code。
调用上下文 | 线程态正式业务入口；即时控制命令过滤后调用。
前置条件 | 新命令已被接受，但业务运动尚未开始。
后置条件 | 仅HEALTHY、DMA运行、无OVR、低压闭环完成且采样达到2482时清锁存；RECOVERY_FAILED仍返回锁存错误。
异常处理 | 普通电压恢复或局部ADC/DMA恢复成功都不会自动解锁运动；RECOVERY_FAILED需重启初始化。
可重入性 | 通过短临界区完成清锁存和开放动作；不允许并发正式过程。
源码证据 | Services/power_monitor.c:610-661。
验证状态 | 源码已核对；HEALTHY解锁、RECOVERY_FAILED新命令拒绝、重启前后边界、二次低压和解锁波形待台架验证。

## 7.4 前台调度与错误日志

### 7.4.1 app_main.c

#### 7.4.1.1 SDD-FLT-022 App_MainLoop

函数原型 | void App_MainLoop(void)
函数功能 | 按电源恢复、新串口命令、正式命令、自动恢复和空闲故障兜底的顺序调度前台。
形参 | 无。
返回值 | 无；恢复或错误兜底分支可在本轮提前返回。
全局变量 | 读取命令槽和故障状态；调用电源、串口、恢复、正式业务和延迟保存服务。
静态全局变量 | 无函数静态对象。
局部变量 | pending_command和power_fault_code；恢复分支含局部选择结果。
调用上下文 | 永久主循环中的前台函数；正常每轮保持50ms节拍。
前置条件 | 硬件和业务初始化已经完成。
后置条件 | 新命令优先取消旧恢复；恢复模块只返回命令，真正业务仍由App_ExecuteMeasureCommand执行。
异常处理 | 电源报告先异步锁存；恢复handled分支不再进入空闲兜底；延迟参数任务仍被推进。
可重入性 | 设计依赖单一前台调度者；同步业务阻塞会推迟后台恢复。
源码证据 | Application/Src/app_main.c:231-306。
验证状态 | 源码已核对；命令并发、恢复取消和长业务阻塞待集成验证。

### 7.4.2 error_log.c

#### 7.4.2.1 SDD-FLT-023 ErrorLog_TakeRecentReport

函数原型 | uint8_t ErrorLog_TakeRecentReport(uint32_t code)
函数功能 | 在200ms窗口内识别同一错误码的上下层重复最终报错。
形参 | code为准备再次输出的错误码。
返回值 | 1表示同码刚输出过，应抑制；0表示允许继续输出。
全局变量 | 读写最近报告有效标志、错误码和HAL时刻。
静态全局变量 | 三个最近报告静态变量。
局部变量 | 无大对象局部变量。
调用上下文 | 线程态故障日志出口；只管理单个最近记录。
前置条件 | ErrorLog_ReportDetail已在首次最终报错时登记记录。
后置条件 | 同码且时间差不超过200ms时返回1；超时或换码清除记录。
异常处理 | 该机制不是持久故障历史，也不是多码环形缓存。
可重入性 | 未使用临界区；依赖日志出口前台串行。
源码证据 | Services/Utilities/error_log.c:7-12、37-48、56-71。
验证状态 | 源码已核对；tick回绕、换码和200ms边界待主机测试。

#### 7.4.2.2 SDD-FLT-024 ErrorLog_RetryDetail

函数原型 | void ErrorLog_RetryDetail(const char *module, const char *op, const char *reason, uint32_t attempt, uint32_t max, uint32_t code, const char *detail)
函数功能 | 按统一字段输出错误重试日志，并对长重试仅保留首轮和末轮。
形参 | 模块、操作、原因、当前/最大次数、错误码及可选详情。
返回值 | 无。
全局变量 | 读取错误码名称和文本兜底映射；调用printf。
静态全局变量 | 重试打印策略常量，max大于3时限频。
局部变量 | 无大对象局部变量。
调用上下文 | 线程态；禁止从ISR或PendSV直接调用。
前置条件 | 调用方确实执行一次重试，并保留真实错误码。
后置条件 | 输出阶段、模块、操作、原因、次数、错误码、错误名和可选详情。
异常处理 | NO_ERROR和STATE_SWITCH不打印；日志不改变业务重试动作。
可重入性 | printf非可重入资源，依赖前台或已有串口输出约束。
源码证据 | Services/Utilities/error_log.c:8、21-29、803-842。
验证状态 | 源码已核对；格式快照和长重试限频待主机测试。

#### 7.4.2.3 SDD-FLT-025 ErrorLog_ReportDetail

函数原型 | void ErrorLog_ReportDetail(const char *module, const char *op, const char *reason, uint32_t code, const char *action, const char *detail)
函数功能 | 登记最近最终报错并输出统一的最终故障记录。
形参 | 模块、操作、原因、错误码、处理动作和可选详情。
返回值 | 无。
全局变量 | 更新最近报告窗口；读取名称映射；调用printf。
静态全局变量 | 最近报告静态状态。
局部变量 | 无大对象局部变量。
调用上下文 | 线程态最终错误出口。
前置条件 | code为真实故障，且调用方已决定这是最终报错阶段。
后置条件 | 输出阶段=最终报错以及完整字段，并为后续同码抑制登记时间。
异常处理 | NO_ERROR和STATE_SWITCH被忽略；当前实现没有FRAM或Flash持久故障历史。
可重入性 | 依赖printf串行；最近窗口不是并发队列。
源码证据 | Services/Utilities/error_log.c:7-12、37-48、909-942。
验证状态 | 源码已核对；结构化文本、重复抑制和掉电后历史均待独立验证。

## 7.5 异常上下文与看门狗

### 7.5.1 stm32f4xx_it.c

#### 7.5.1.1 SDD-FLT-026 PendSV_Handler

函数原型 | void PendSV_Handler(void)
函数功能 | 按固定顺序执行最低优先级异常上下文中的有界延后任务。
形参 | 无。
返回值 | 无。
全局变量 | 依次调用AS5145、编码器持久化、AO定时刷新、UART帧和UART恢复服务。
静态全局变量 | 各子模块自有事件与pending状态。
局部变量 | 无大对象局部变量。
调用上下文 | PendSV异常上下文；允许实际编码器紧急FRAM事务，但不得打印或运行通用恢复策略。
前置条件 | 相关ISR只投递事件，子服务必须保持有界。
后置条件 | SSI事件先更新累计位置，再提交编码器快照；其余服务按源码固定顺序执行。
异常处理 | 本函数不包含PowerMonitor_ProcessDeferred、FaultRecovery_Poll或业务命令。
可重入性 | 由Cortex-M PendSV串行；子任务执行时间共同决定最坏延迟。
源码证据 | Core/Src/stm32f4xx_it.c:386-402；Core/Src/stm32f4xx_hal_msp.c:74-75。
验证状态 | 源码已核对；最坏执行时间、抢占和掉电窗口待目标板测量。

#### 7.5.1.2 SDD-FLT-027 TIM4_IRQHandler

函数原型 | void TIM4_IRQHandler(void)
函数功能 | 在约250ms节拍中按RETTOBASE条件刷新IWDG，并每8拍调度约2s业务服务。
形参 | 无。
返回值 | 无。
全局变量 | 调用HAL定时器处理、HAL_IWDG_Refresh、继电器、AO和UART恢复投递。
静态全局变量 | s_tim4_business_tick_count。
局部变量 | 无大对象局部变量。
调用上下文 | TIM4 IRQ，抢占优先级3；不执行前台业务命令。
前置条件 | TIM4已按75MHz计时钟、14999预分频和1249周期启动。
后置条件 | 无被抢占ISR时喂狗；累计8拍后执行轻量业务更新并清计数。
异常处理 | RETTOBASE只说明异常嵌套状态，不等价于主循环心跳；线程阻塞时仍可能持续喂狗。
可重入性 | ISR串行；子服务必须保持中断安全和有界。
源码证据 | Core/Src/stm32f4xx_it.c:58、72、513-534；Core/Src/tim.c:72-110、130-140；Core/Src/main.c:114-115、124-129、150-175；Core/Inc/stm32f4xx_hal_conf.h:98-100。
验证状态 | 源码和时钟配置已核对；真实周期、线程卡死和中断嵌套待示波器/故障注入。

### 7.5.2 iwdg.c

#### 7.5.2.1 SDD-FLT-028 MX_IWDG_Init

函数原型 | void MX_IWDG_Init(void)
函数功能 | 配置并启动独立看门狗。
形参 | 无。
返回值 | 无；HAL初始化失败进入Error_Handler。
全局变量 | 写hiwdg实例、预分频32和重装4095并调用HAL_IWDG_Init。
静态全局变量 | 全局IWDG句柄hiwdg。
局部变量 | 无大对象局部变量。
调用上下文 | 启动初始化线程态；IWDG启动后不能由软件普通关闭。
前置条件 | LSI已在系统时钟配置中开启。
后置条件 | 按典型32kHz LSI名义超时约4.096s，实际值受器件LSI容差影响。
异常处理 | 配置本身不证明主循环被监督；喂狗条件由TIM4_IRQHandler决定。
可重入性 | 启动阶段单次调用。
源码证据 | Core/Src/iwdg.c:30-51；Core/Src/main.c:114-115、150-152。
验证状态 | 源码已核对；真实LSI频率、复位时间和复位原因留存待目标板验证。

# 8. 设计追踪矩阵

设计编号 | 设计对象 | 主要代码位置 | 验证建议 | 状态
SDD-FLT-001 | 一致故障快照 | fault_manager.c:28-40 | 同步/异步竞争 | 源码已核对
SDD-FLT-002 | 异步故障锁存 | fault_manager.c:47-58 | ENN、STATE_ERROR和最终日志/慢停缺口 | 源码已核对；自动闭环缺失
SDD-FLT-003 | 返回码错误出口 | fault_manager.c:261-274 | 普通错误/STATE_SWITCH双入口 | 源码已核对；STATE_SWITCH停机待验证
SDD-FLT-004 | 全局码错误出口 | fault_manager.c: 288-301；fault_manager.h: 145-152 | 全局置错竞争 | 源码已核对
SDD-FLT-005 | SET_ERROR入口 | fault_manager.c:312-325 | 业务置错传播 | 源码已核对
SDD-FLT-006 | 空闲全局兜底 | fault_manager.c:338-351 | 命令并发 | 源码已核对
SDD-FLT-007 | 错误慢停 | fault_manager.c:357-379 | 驱动失效和慢停失败 | 源码已核对
SDD-FLT-008 | 故障初始化清码门禁 | fault_manager.c:416-427 | 慢停失败且两类锁存均无 | 源码已核对；慢停失败仍可能清码
SDD-FLT-009 | 不可恢复错误排除 | fault_recovery.c:67-114 | 错误码覆盖 | 源码已核对
SDD-FLT-010 | 恢复次数归一化 | fault_recovery.c:122-132 | 0/1/10/11边界 | 源码已核对
SDD-FLT-011 | 命令恢复白名单 | fault_recovery.c:141-169 | 全部命令枚举 | 源码已核对
SDD-FLT-012 | 命令后恢复更新 | fault_recovery.c:343-399 | 成功/切换/上限 | 源码已核对
SDD-FLT-013 | 恢复取消 | fault_recovery.c:406-418 | 连续新命令 | 源码已核对
SDD-FLT-014 | 恢复轮询 | fault_recovery.c:431-521 | 1s节流和业务重跑 | 源码已核对
SDD-FLT-015 | 电源硬安全状态 | power_monitor.c:49-55 | 低压ENN/FRAM时序 | 源码已核对
SDD-FLT-016 | 电源故障优先级锁存 | power_monitor.c: 66-83、93-119 | 多故障竞争 | 源码已核对
SDD-FLT-017 | 电源监控启动 | power_monitor.c: 301-341 | 首样本和低压上电 | 源码已核对
SDD-FLT-018 | 低压ISR入口 | power_monitor.c: 351-380 | 掉电保持和投递 | 源码已核对
SDD-FLT-019 | 1ms监控和稳定恢复 | power_monitor.c: 410-471 | 阈值/滞回/100ms | 源码已核对
SDD-FLT-020 | ADC/DMA局部恢复 | power_monitor.c: 481-528 | 三次失败/新命令拒绝/重启 | 源码已核对；本次上电不可恢复
SDD-FLT-021 | 新流程软件解锁 | power_monitor.c: 610-661 | HEALTHY与RECOVERY_FAILED边界 | 源码已核对；FAILED时新命令拒绝
SDD-FLT-022 | 主循环优先级 | app_main.c:231-306 | 命令/恢复竞争 | 源码已核对
SDD-FLT-023 | 最终报错去重 | error_log.c:56-71 | 200ms/tick回绕 | 源码已核对
SDD-FLT-024 | 重试日志 | error_log.c:803-842 | 长重试限频 | 源码已核对
SDD-FLT-025 | 最终报错日志 | error_log.c: 7-12、37-48、909-942 | 格式和非持久边界 | 源码已核对
SDD-FLT-026 | PendSV延后处理 | stm32f4xx_it.c: 386-402；stm32f4xx_hal_msp.c: 74-75 | 最坏执行时间 | 源码已核对
SDD-FLT-027 | TIM4监督调度 | stm32f4xx_it.c: 58、72、513-534；tim.c: 72-110、130-140 | 线程卡死注入 | 源码已核对
SDD-FLT-028 | IWDG初始化 | iwdg.c: 30-51；main.c: 114-115、150-152 | LSI和复位时序 | 源码已核对

# 9. 流程图索引

图号 | 图名 | 依据 | 状态
SDD-FLT-F01 | 同步、全局与异步故障统一出口流程 | 当前CPU2源码 | 源码已核对；硬件待验证
SDD-FLT-F02 | 自动恢复启动与准入门禁流程 | 当前CPU2源码 | 源码已核对；硬件待验证
SDD-FLT-F03A | 自动恢复轮询、等待与部件检查流程 | 当前CPU2源码 | 源码已核对；硬件待验证
SDD-FLT-F03B | 业务重跑、结果判定与上限退出流程 | 当前CPU2源码 | 源码已核对；硬件待验证
SDD-FLT-F04 | 新命令取消恢复及主循环优先级流程 | 当前CPU2源码 | 源码已核对；硬件待验证
SDD-FLT-F05 | 24V低压与编码器紧急保存流程 | 当前CPU2源码 | 源码已核对；硬件待验证
SDD-FLT-F06 | 24V稳定恢复与新正式流程解锁流程 | 当前CPU2源码 | 源码已核对；硬件待验证
SDD-FLT-F07 | ADC/DMA监控故障与三次局部恢复流程 | 当前CPU2源码 | 源码已核对；硬件待验证
SDD-FLT-F08 | TIM4监督喂狗、2s业务分频与异常上下文边界 | 当前CPU2源码 | 源码已核对；硬件待验证

## 9.1 SDD-FLT-F01 同步、全局与异步故障统一出口流程

本图表达CHECK_ERROR返回码、全局码、SET_ERROR和异步锁存进入统一错误状态的顺序差异；函数返回STATE_SWITCH仍先进入HandleCheckError，最终日志被过滤但HandleError仍执行；异步入口只硬停，当前没有自动线程态最终日志或慢停闭环。

图 SDD-FLT-F01 同步、全局与异步故障统一出口流程

## 9.2 SDD-FLT-F02 自动恢复启动与准入门禁流程

本图表达命令失败后依次通过真实错误、不可恢复错误、次数参数和20命令白名单四道门禁，再建立恢复上下文；不在命令收尾中嵌套重跑。

图 SDD-FLT-F02 自动恢复启动与准入门禁流程

## 9.3 SDD-FLT-F03A 自动恢复轮询、等待与部件检查流程

本图表达1s等待、可选驱动初始化和部件检查；部件检查成功只表示具备业务重跑前置条件，不等于完整恢复。

图 SDD-FLT-F03A 自动恢复轮询、等待与部件检查流程

## 9.4 SDD-FLT-F03B 业务重跑、结果判定与上限退出流程

本图表达业务重跑额度门禁、真正的业务重跑计数、主循环执行、业务结果判定、完整恢复清理和达到上限后的退出。

图 SDD-FLT-F03B 业务重跑、结果判定与上限退出流程

## 9.5 SDD-FLT-F04 新命令取消恢复及主循环优先级流程

本图表达App_MainLoop中电源延后服务、新串口命令、正式命令、自动恢复和空闲故障兜底的优先级，以及新命令取消旧恢复。

图 SDD-FLT-F04 新命令取消恢复及主循环优先级流程

## 9.6 SDD-FLT-F05 24V低压与编码器紧急保存流程

本图表达2256低压门限、硬门禁、已布防条件、FRAM预约、编码器紧急保存投递和PendSV提交边界。

图 SDD-FLT-F05 24V低压与编码器紧急保存流程

## 9.7 SDD-FLT-F06 24V稳定恢复与新正式流程解锁流程

本图表达2482阈值连续100ms、等待紧急保存结束、仅恢复普通FRAM写，以及新的顶层正式流程再次复核后软件解锁。

图 SDD-FLT-F06 24V稳定恢复与新正式流程解锁流程

## 9.8 SDD-FLT-F07 ADC/DMA监控故障与三次局部恢复流程

本图表达ADC OVR或DMA停止只在轻量上下文挂恢复，主循环每轮最多一次局部重启；累计三次失败进入RECOVERY_FAILED后，本次上电不再恢复，新正式命令仍被拒绝，只有重启后由PowerMonitor_Start重新初始化。

图 SDD-FLT-F07 ADC/DMA监控故障与三次局部恢复流程

## 9.9 SDD-FLT-F08 TIM4监督喂狗、2s业务分频与异常上下文边界

本图表达TIM4约250ms监督节拍、RETTOBASE喂狗条件、每8拍约2s业务分频，以及异常死循环与主循环心跳未直接绑定的边界。

图 SDD-FLT-F08 TIM4监督喂狗、2s业务分频与异常上下文边界

# 10. 实现一致性关注点与验证计划

## 10.1 源码现状与待确认

1. fault_manager.h中的故障类别、等级和恢复策略类型当前无运行消费点，不能作为已落实的安全等级策略证据。

2. CHECK_ERROR的优先级是函数返回码、全局错误码、命令切换；文档和测试必须按该顺序构造竞争用例。

3. FaultManager_LatchAsyncError立即硬关ENN但不慢停；当前没有自动线程态最终日志/慢停闭环，线程态HandleError只在驱动有效时慢停，二者停机动力学不同。

4. 自动恢复白名单当前是20个正式命令；错误排除、次数参数和命令白名单三道门禁均通过才会建立上下文。

5. FaultRecovery_Poll中的部件检查成功只表示具备业务重跑条件；只有正式业务命令返回NO_ERROR才记录完整恢复。

6. 通用自动恢复明确排除23类电源故障责任域；低压或局部恢复成功且监控已回到HEALTHY时，才由PowerMonitor状态机和新正式流程复核解锁。

7. 24V阈值按100k/10k分压和VDDA假设解释；2256、2482及100ms必须通过台架校准后才能形成硬件证据。

8. 低压稳定后只恢复普通FRAM写；电机和锁存码仍保持，只有监控已回到HEALTHY时PowerMonitor_BeginNewProcess才执行软件解锁。

9. ADC/DMA局部恢复每轮主循环最多一次、累计三次；进入RECOVERY_FAILED后本次上电不再恢复，新正式流程仍被拒绝，需重启后由PowerMonitor_Start重新初始化。

10. ErrorLog当前仅结构化printf和200ms单码重复抑制，没有掉电保持的故障历史。

11. TIM4的RETTOBASE喂狗条件不是主循环心跳；线程态死循环而TIM4仍运行时，IWDG可能继续被刷新。

12. NMI、HardFault、MemManage、BusFault和UsageFault当前只停留在无限循环，未保存异常现场或主动复位。

## 10.2 未执行验证

验证层级 | 建议用例 | 通过标准 | 当前状态
主机状态机 | 返回码/全局码/切换竞争 | CHECK_ERROR顺序、原码和状态一致 | 待执行
STATE_SWITCH出口 | 函数返回与命令切换双入口 | 返回码入口仍调用HandleError；最终日志过滤符合源码 | 待执行
异步锁存闭环 | 异步故障后等待多轮主循环和空闲兜底 | ENN和STATE_ERROR成立；当前不应自动补最终日志或慢停 | 待执行
清码门禁 | fault_info_init慢停失败或仍有其他全局错误，且两类锁存均为false | 当前仍继续清码，测试结果与组合风险记录一致 | 待执行
RECOVERY_FAILED | 三次失败、新正式命令和重启初始化 | 重启前新命令拒绝；重启后由PowerMonitor_Start重建状态 | 待执行
自动恢复矩阵 | 排除错误、20命令、0/1/10/11次数 | 进入、关闭和上限符合设计 | 待执行
恢复闭环 | 驱动初始化、部件检查、业务成功/失败/换码 | 仅业务成功记录完整恢复 | 待执行
命令竞争 | 串口帧、正式pending和恢复同时到达 | 新命令优先且旧恢复被取消 | 待执行
24V台架 | 2256下降、2482恢复、100ms抖动 | 门限、滞回和稳定时间满足批准指标 | 待执行
掉电与FRAM | 已布防/未布防、 保存前/中/后掉电、 提交回执异常 | ENN、预约、记录、回执和释放顺序正确 | 待执行
ADC/DMA注入 | OVR、DMA停止、重启成功和三次失败 | 每轮一次且失败后保持禁止 | 待执行
电机停机 | 异步硬停、线程慢停、驱动未初始化 | ENN波形、停机距离和原码保留符合要求 | 待执行
日志 | 同码200ms、换码、长重试和tick回绕 | 字段、限频和去重符合设计 | 待执行
IWDG | 主循环卡死、ISR卡死、异常处理和LSI极差 | 复位时序及覆盖边界可量化 | 待执行
异常现场 | 五类处理器异常注入 | 批准的现场保存和复位策略已验证 | 当前实现不具备
认证活动 | 需求追踪、独立评审、覆盖和证据接受 | 由授权角色或认证机构确认 | 未开展

DSM系列储罐在线自动计量仪CPU2软件详细设计 V0.2
