duanxuebin1998/cube/docs/00_构建与版本/故障码/README.md

# 故障码资料入口

更新日期：2026-08-17

本目录统一维护二代计量仪CPU2/CPU3故障码的正式资料、内部技术资料和历史表。协议19故障码没有形成独立固件，随共享协议21在CPU2 `V1.27.0.0`、CPU3 `V1.25.0.0`组合中发布。协议22也未单独发布，其重排编号随协议23组合首次正式发布。最新正式协议34对应当前CPU2/CPU3 `V1.40.0.0`组合；协议34启用`12-6 ENCODER_POWERON_CHANGE`并新增`12-17 ENCODER_POSITION_JUMP`，`12-13`保留定义和显示映射但当前仅作LIN诊断统计。

| 文件 | 用途 |
| --- | --- |
| `LTD故障代码统一表.xlsx` | 正式工作簿，协议34共137个故障项目：`故障代码`页136项、`协议34新增故障`页1项；另含CPU2 V1.27.0.0、V1.25.0.0～V1.26.0.0、V1.24.0.0及一代历史页、设备参数和测量结果 |
| `LTD内部技术与治理资料.xlsx` | 内部维护工作簿，保存完整码、内部标识、调用点、链路复查、分类规则、一代对照和分阶段编号迁移；当前“治理摘要”和故障技术表仍为协议29的130项快照，协议30～34增量尚未同步 |
| `当前程序故障代码清单.md` | 当前源码中的137项CPU2定义、135项共享故障、2项CPU3本机故障、历史归档项和维护要求 |
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
