duanxuebin1998/cube/docs/07_硬件原理图/00_原始资料/储罐自动计量仪原理图汇总.pdf

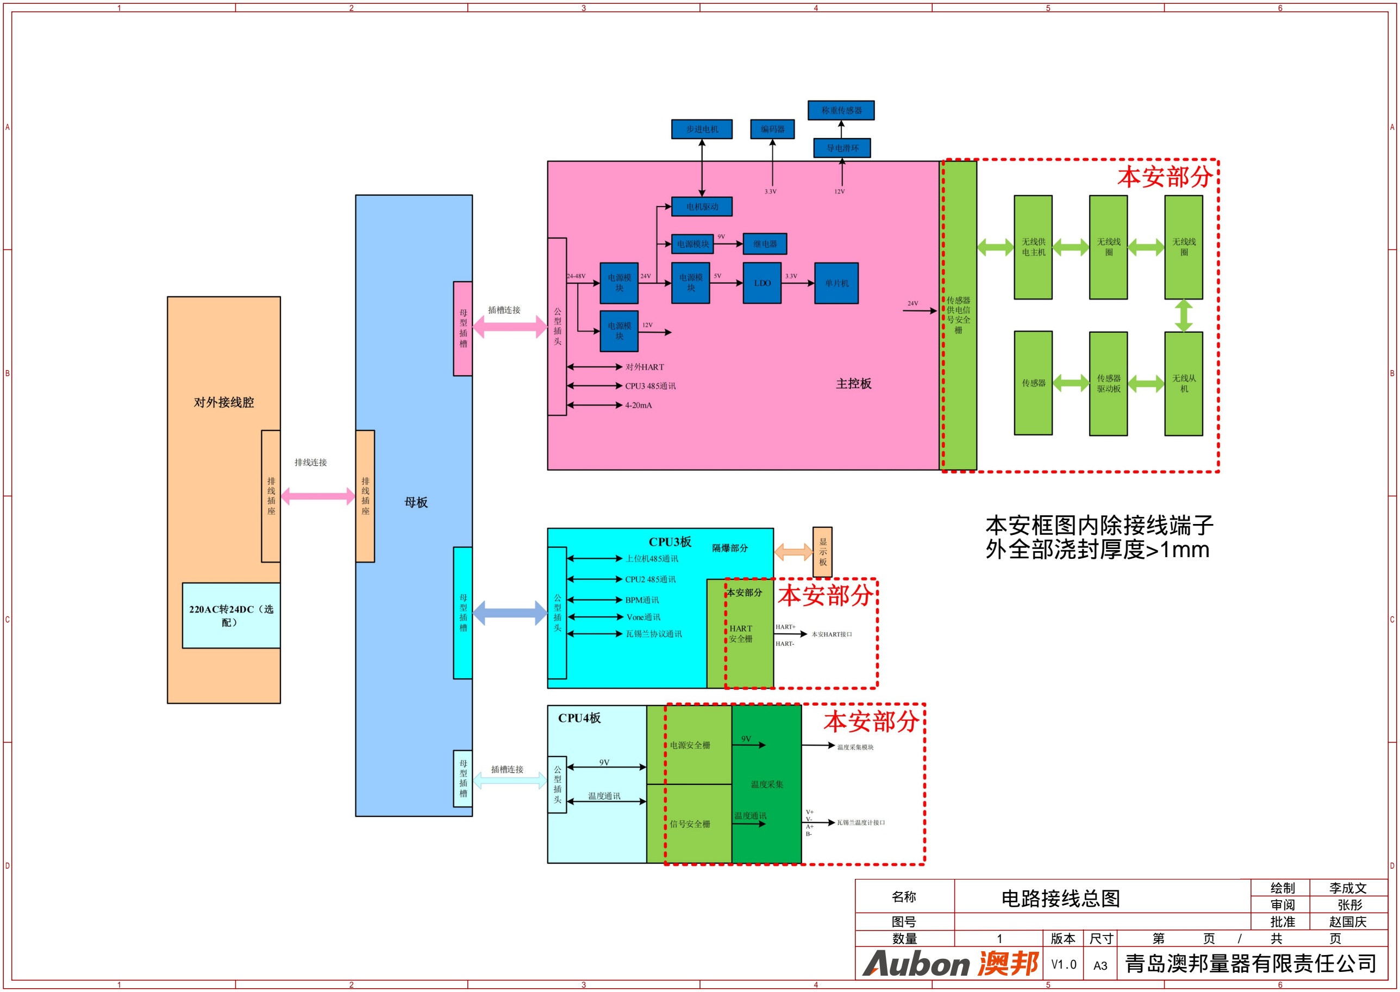
[picture p74: page 1]

版本

审阅
批准
第 | 页

名称

绘制

尺寸

图号
数量

# V1.0 青岛澳邦量器有限责任公司

### 李成文

张彤

### 赵国庆

页 | 共
A3

# 电路接线总图

# 本安框图内除接线端子 外全部浇封厚度>1mm

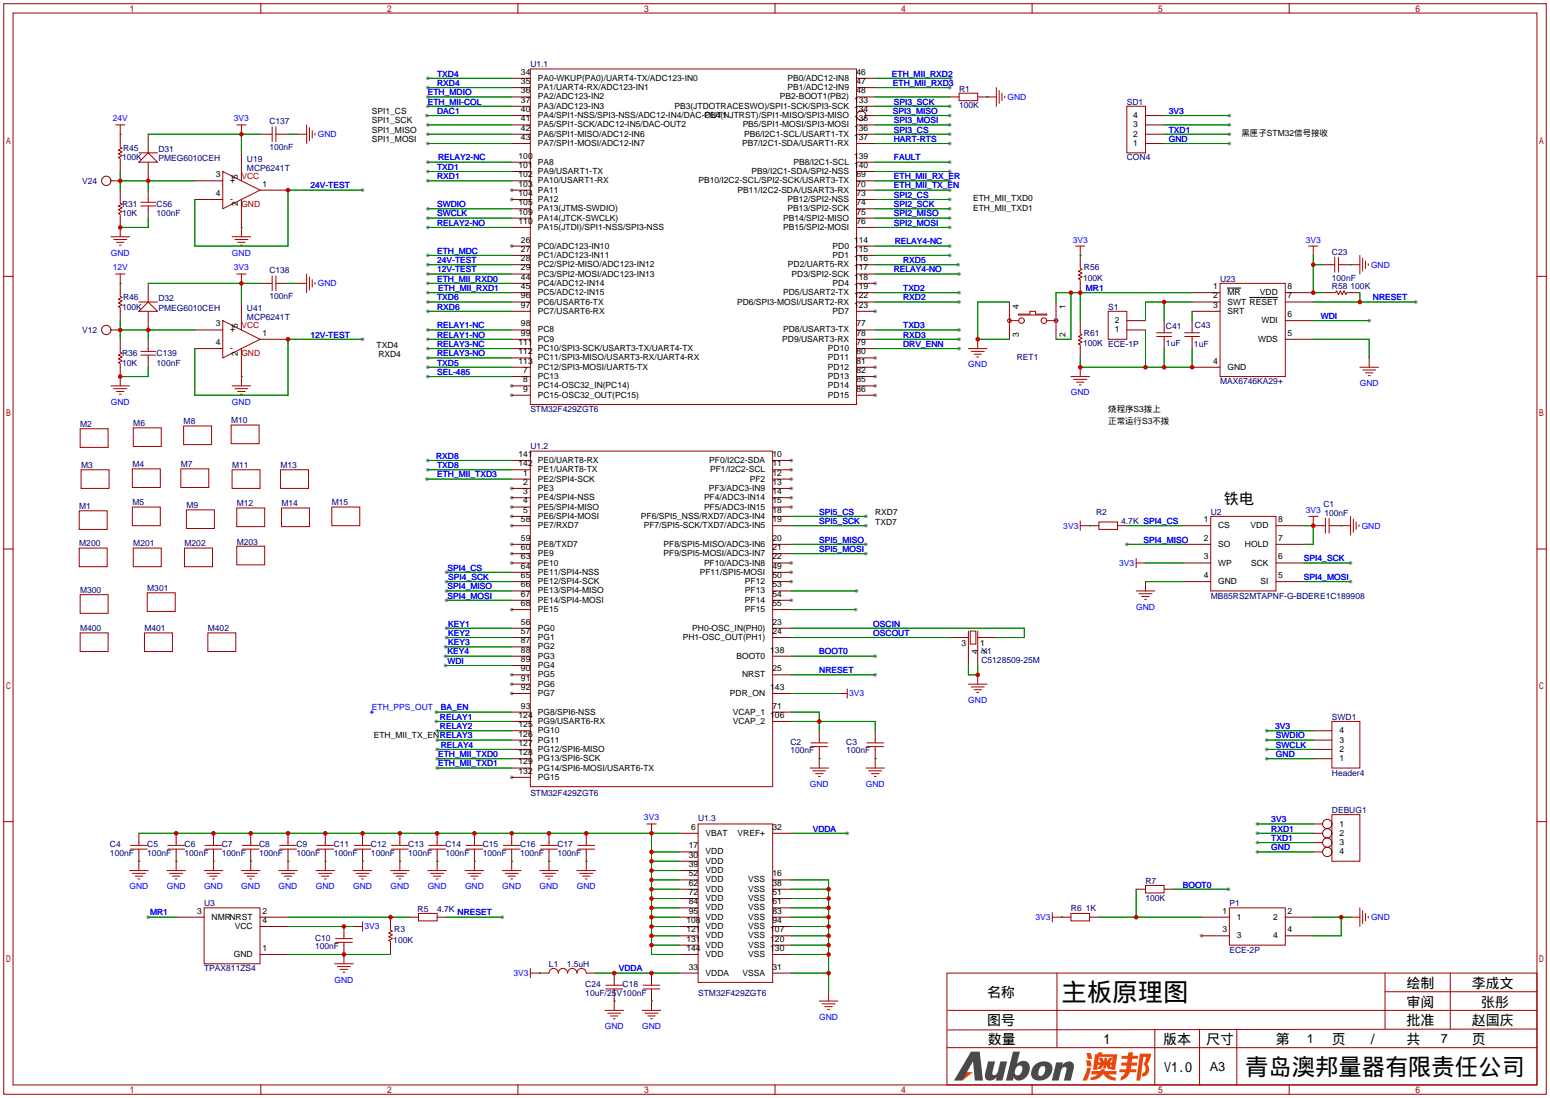
[picture p75: page 2]

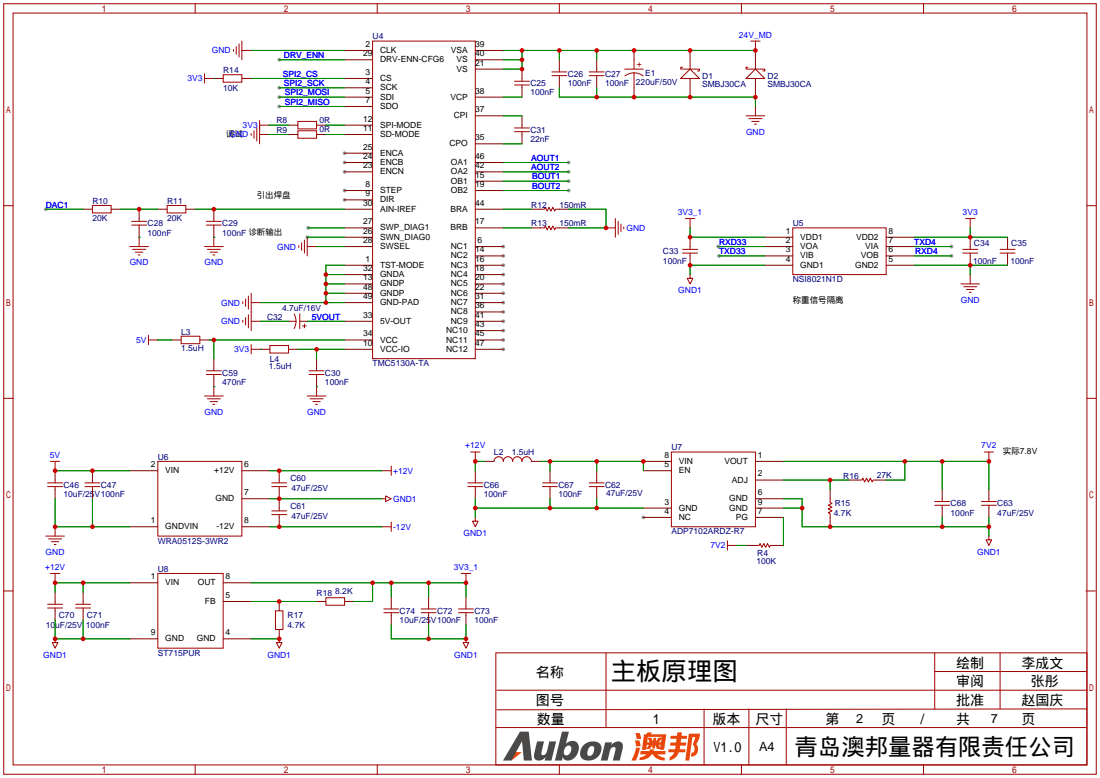
[picture p76: page 3]

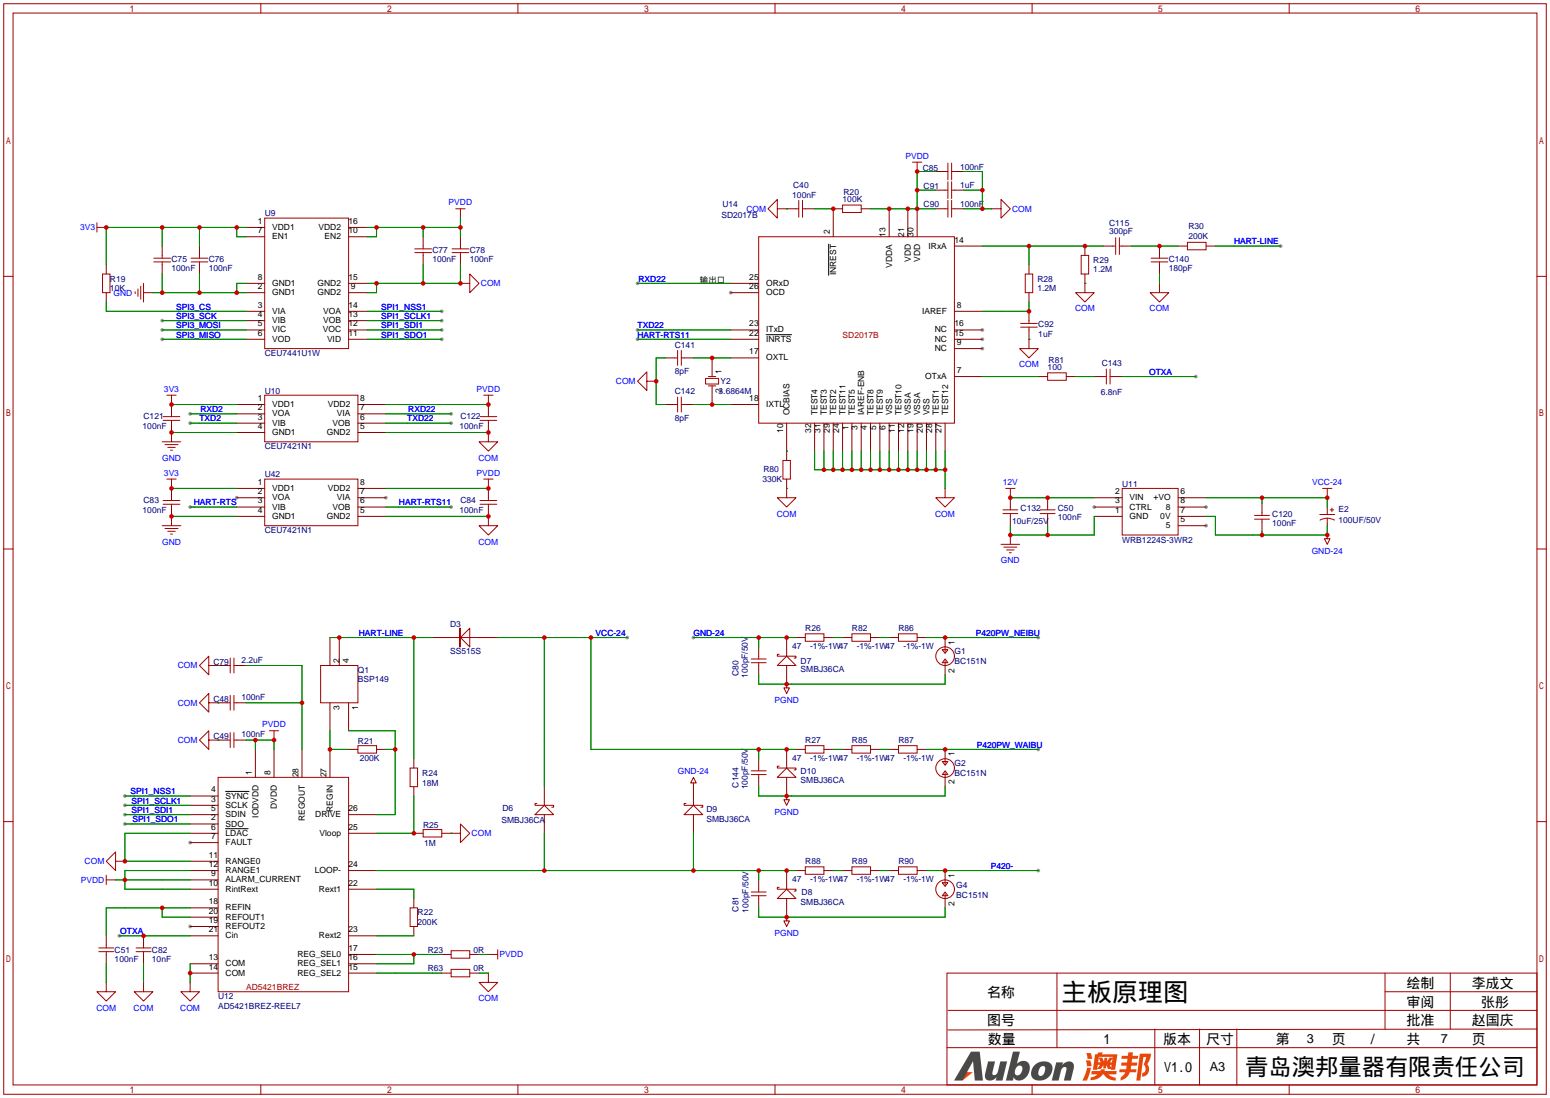
[picture p77: page 4]

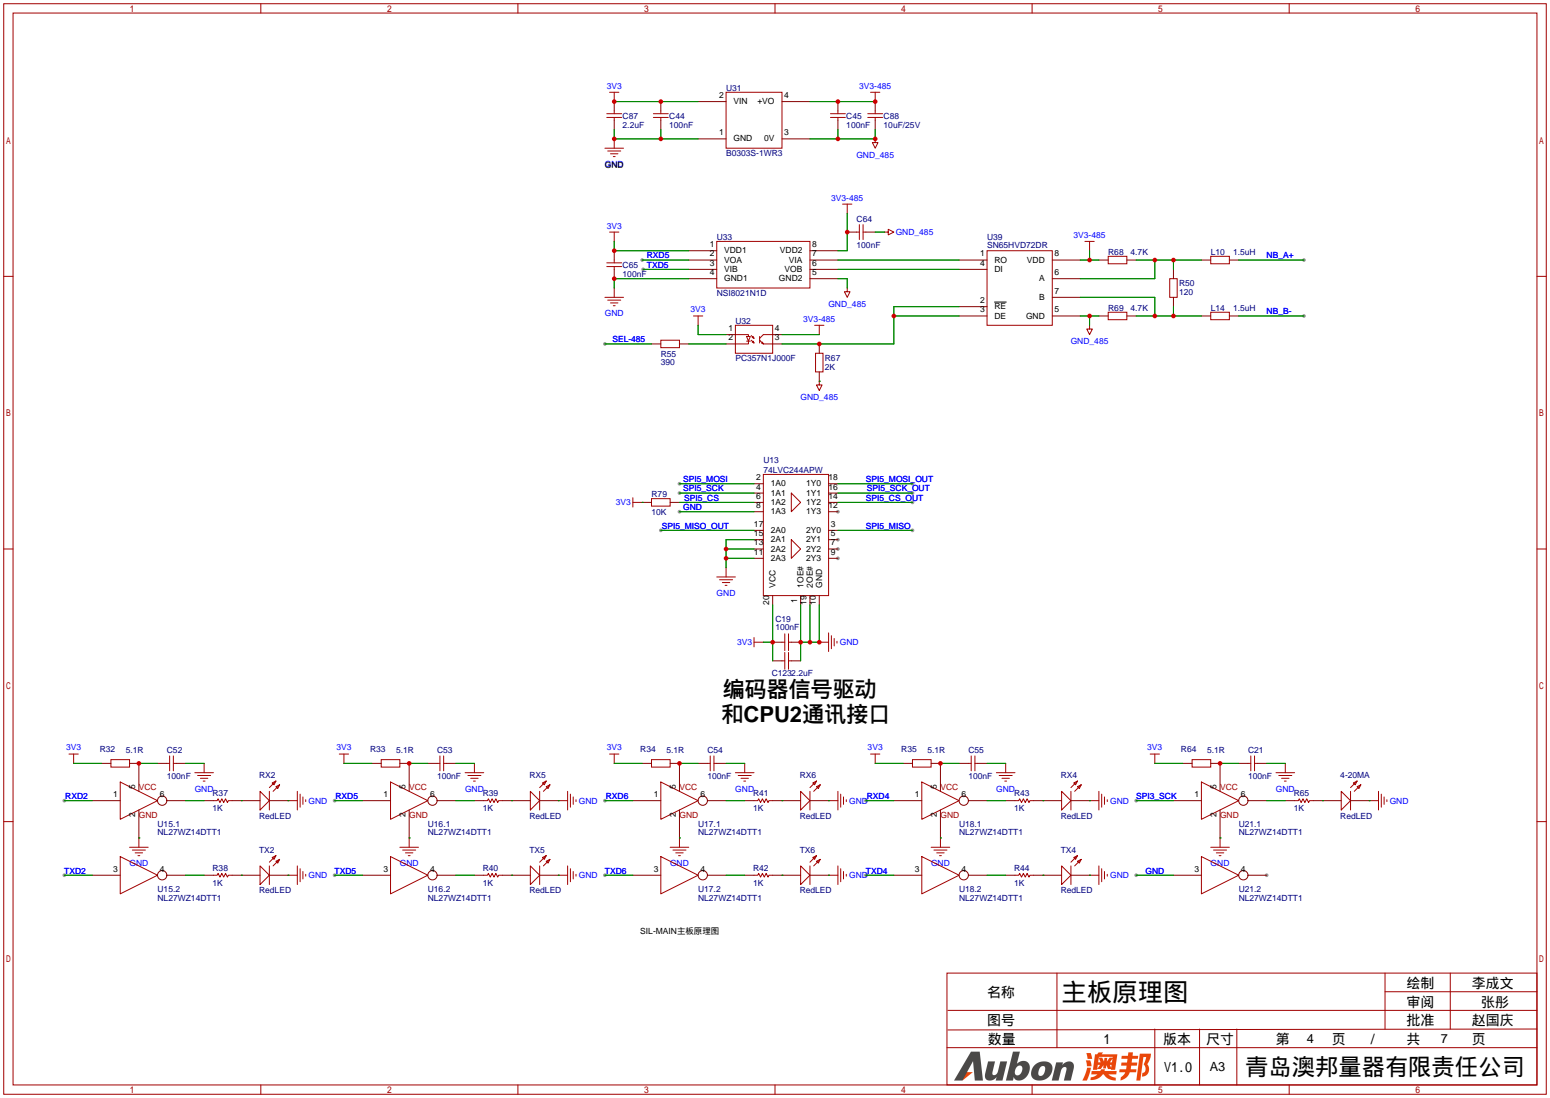
[picture p78: page 5]

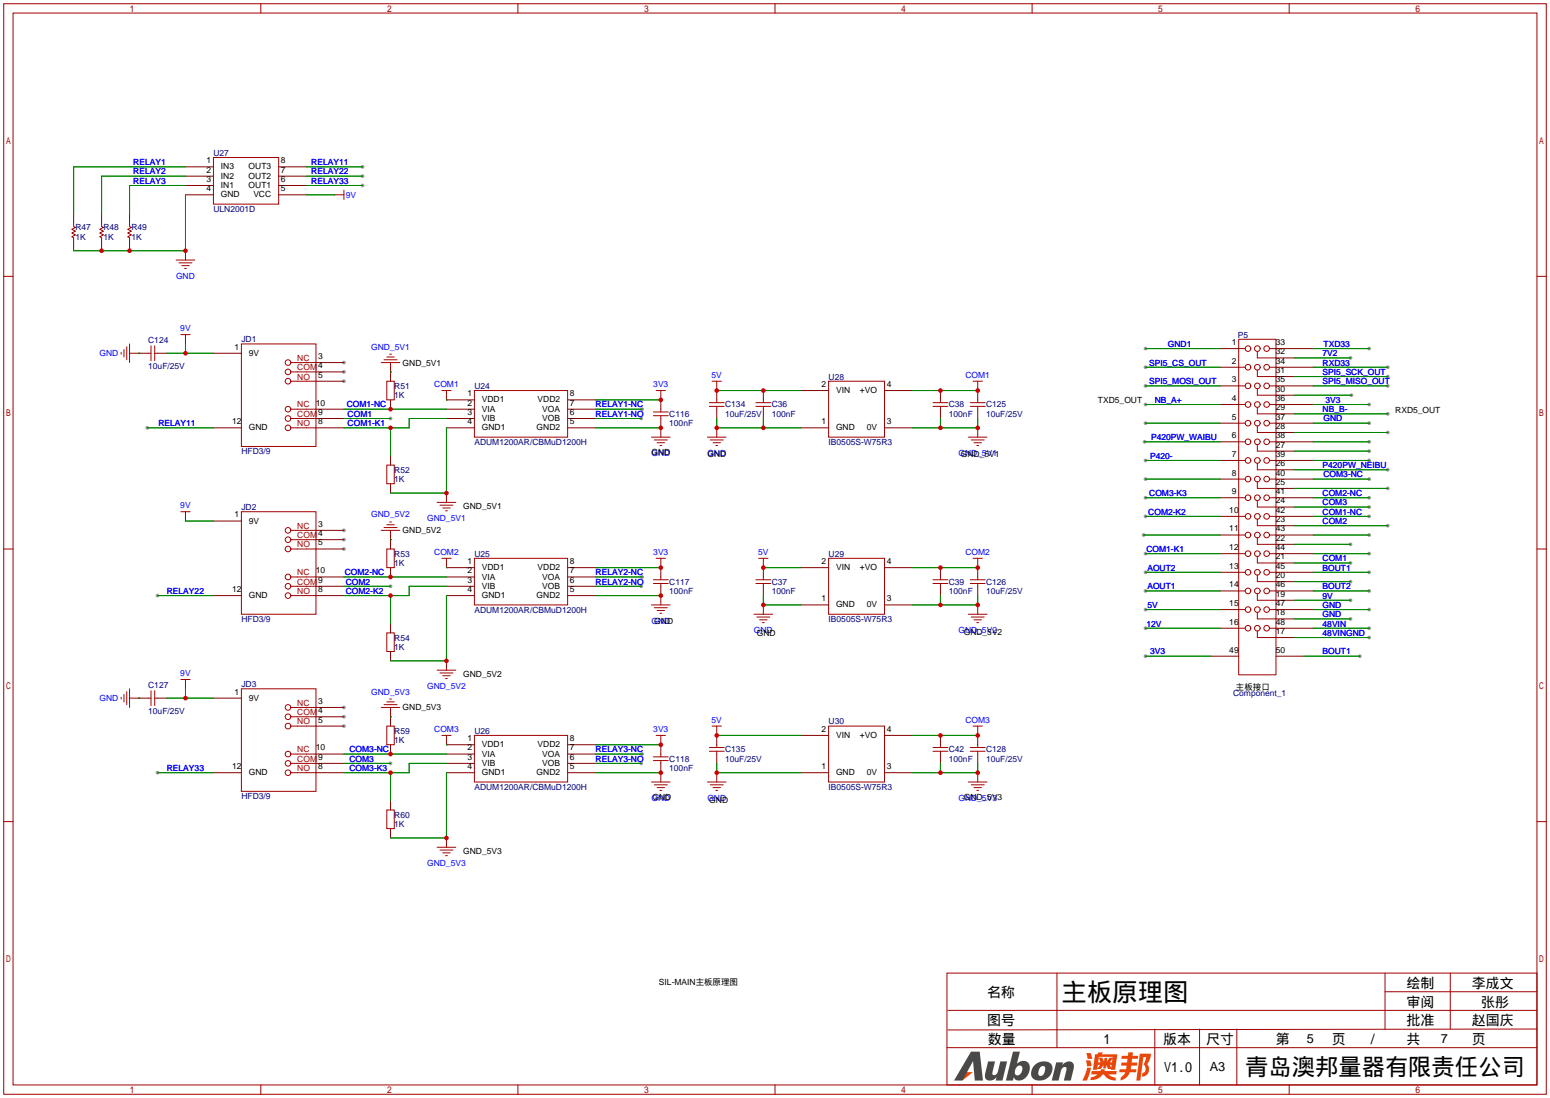
[picture p79: page 6]

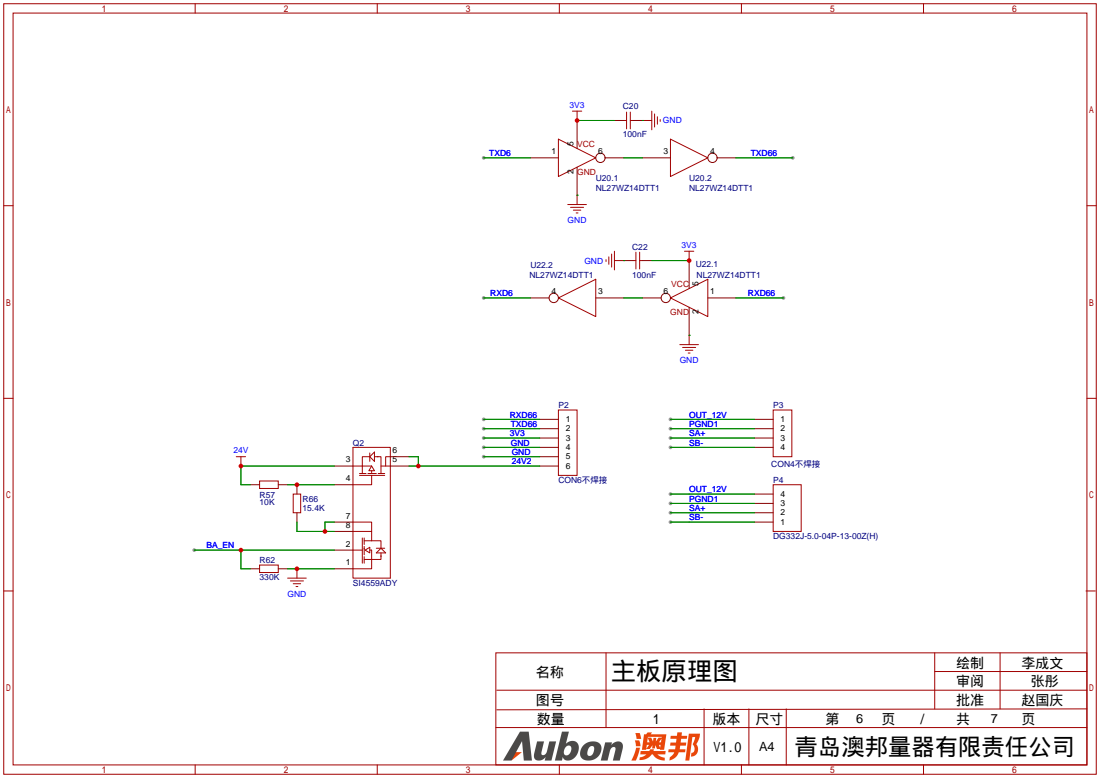
[picture p80: page 7]

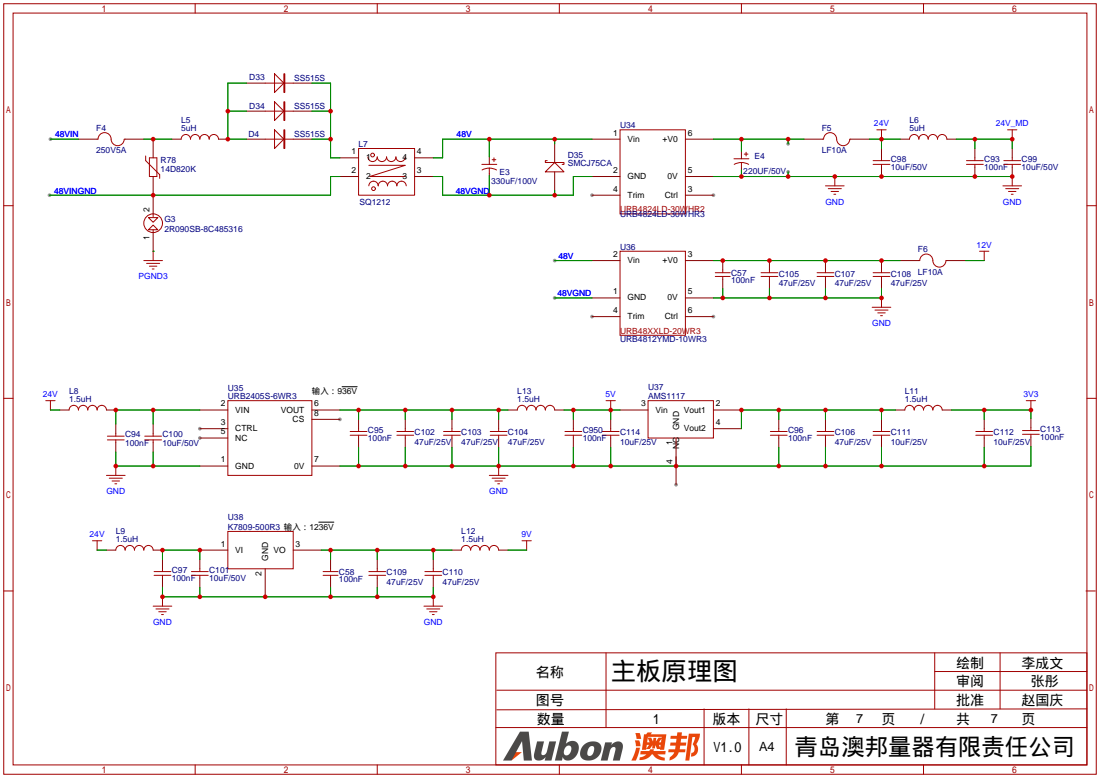
[picture p81: page 8]

# 非本安侧 本安侧

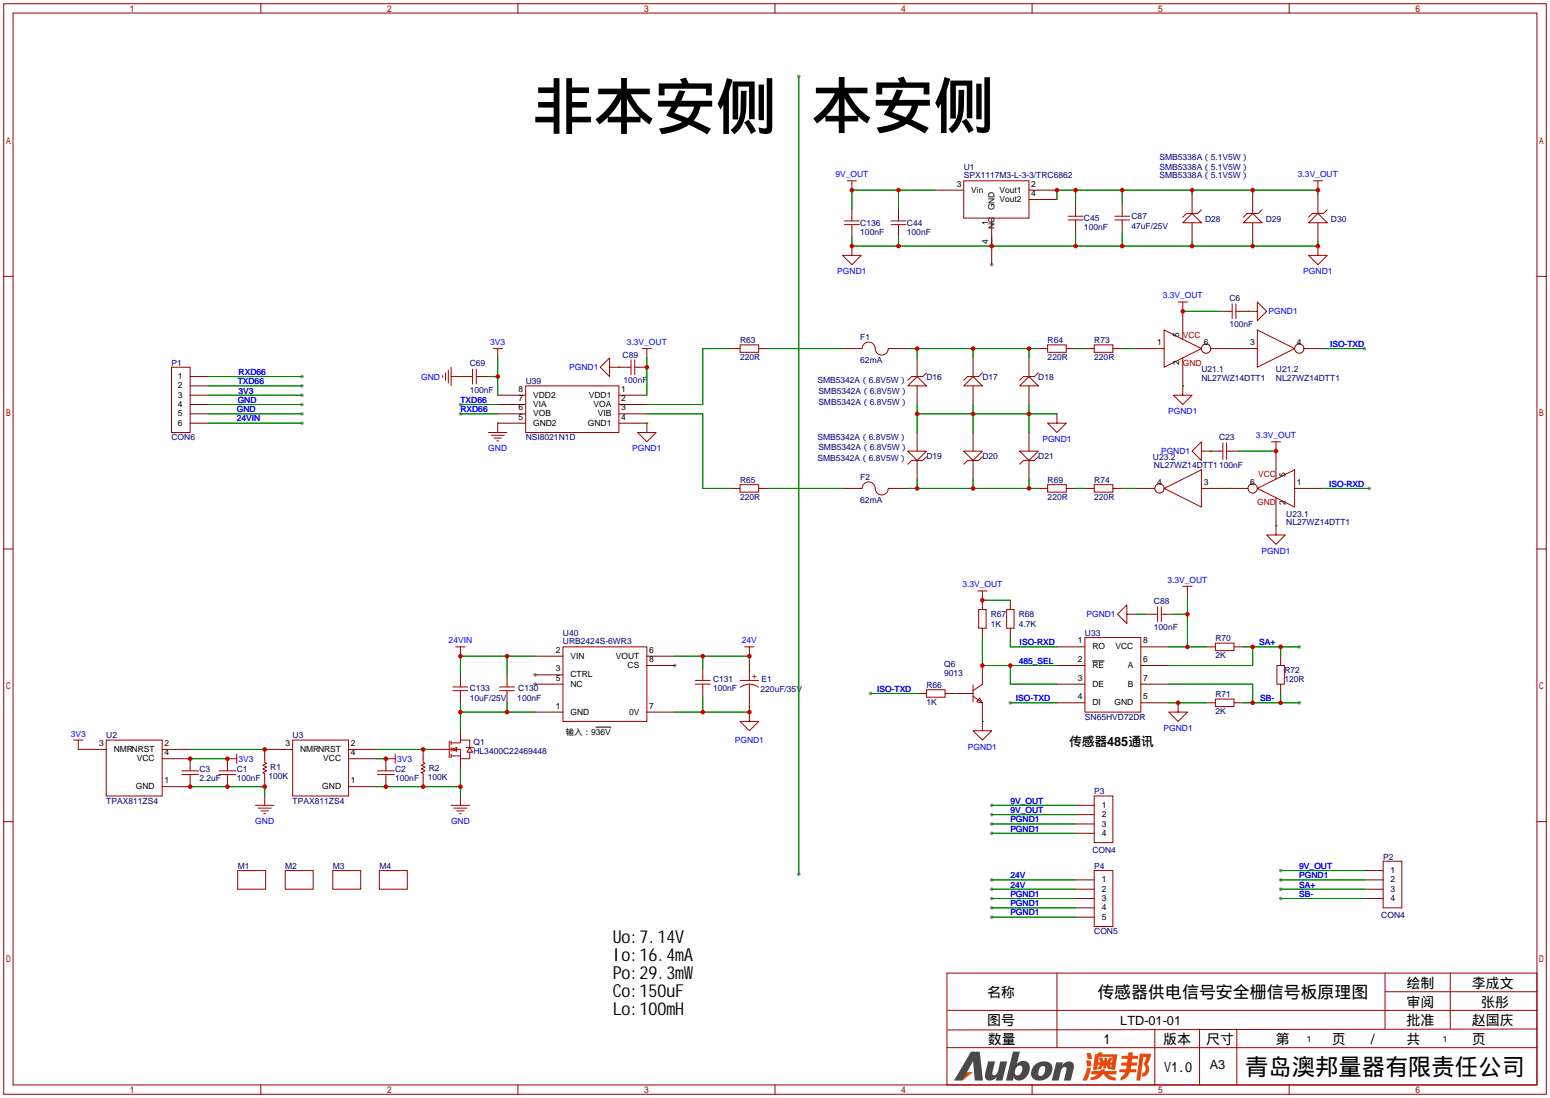
[picture p82: page 9]

# 做本安使用时 本电路除接线端子外全部浇封厚度>1mm

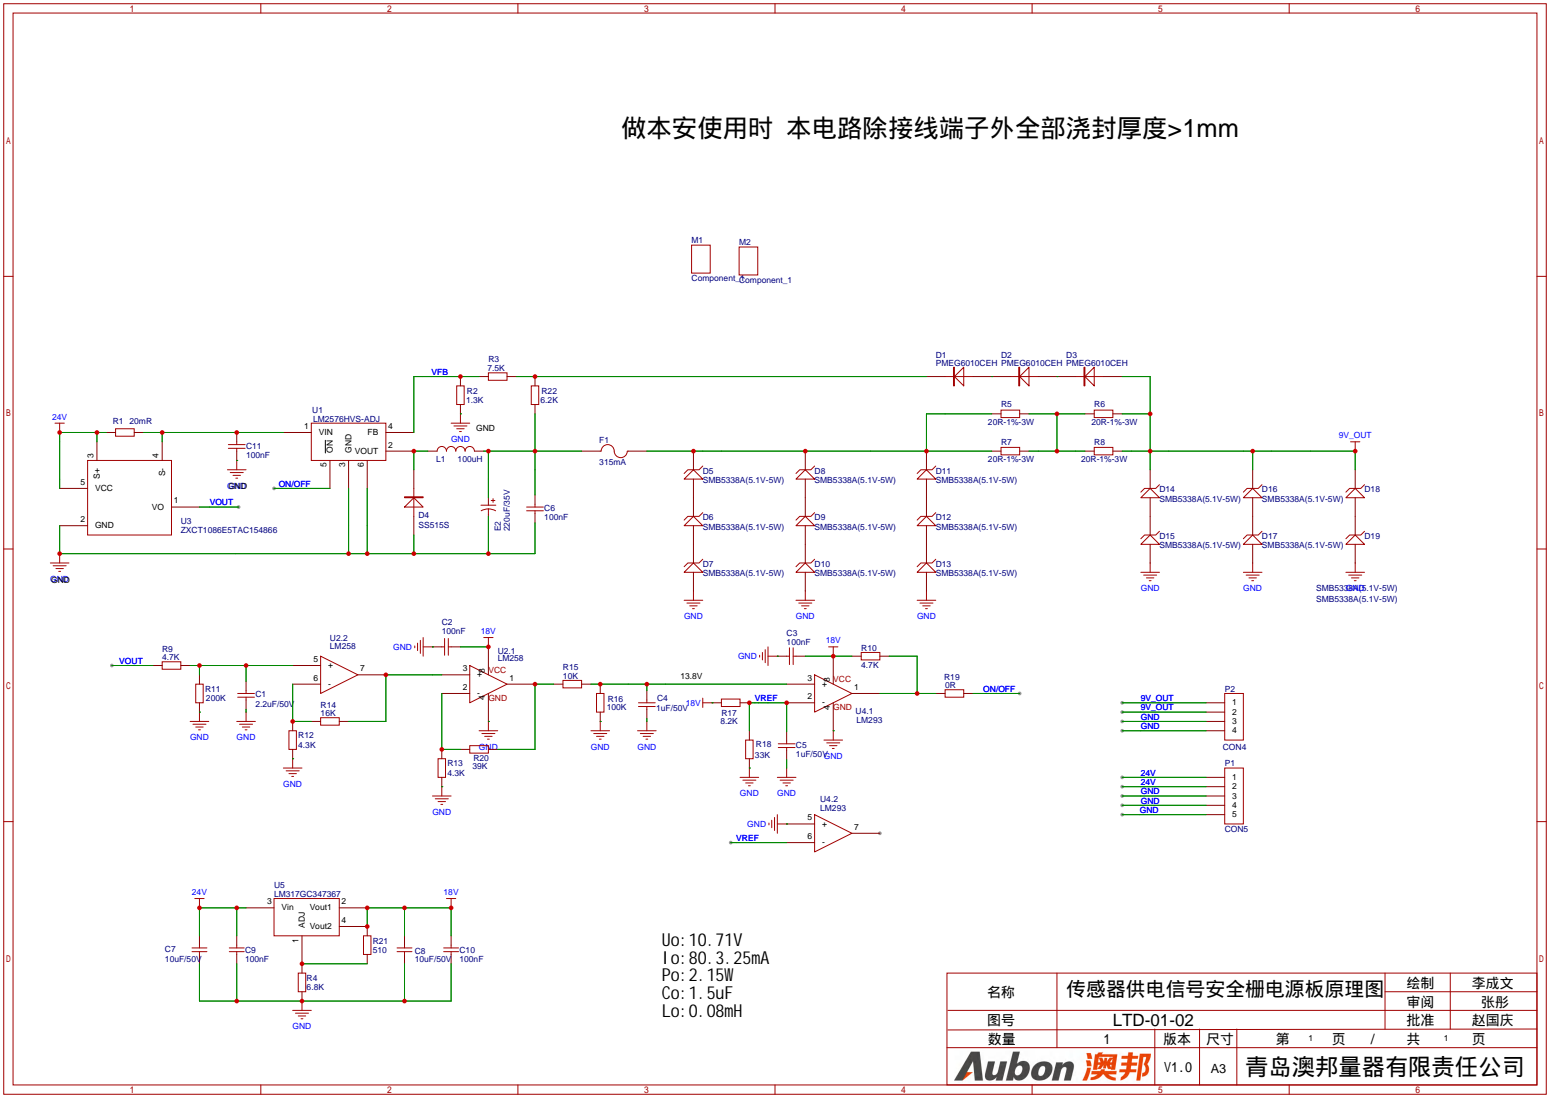
[picture p83: page 10]

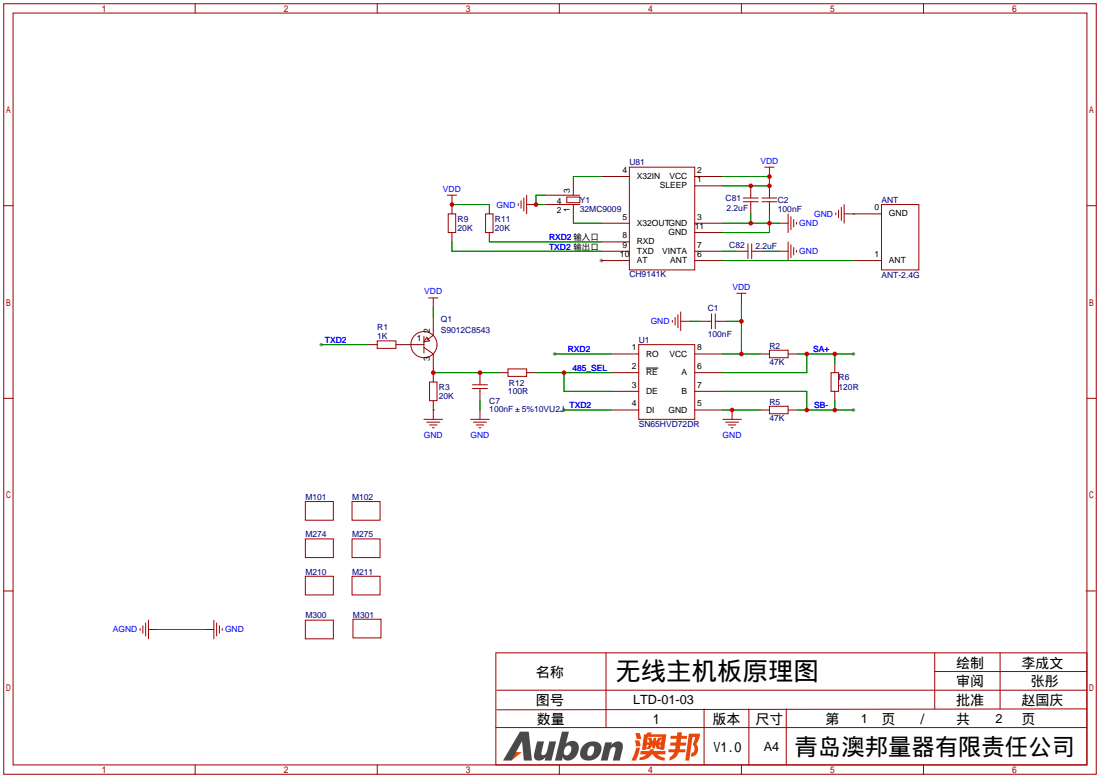
[picture p84: page 11]

主机

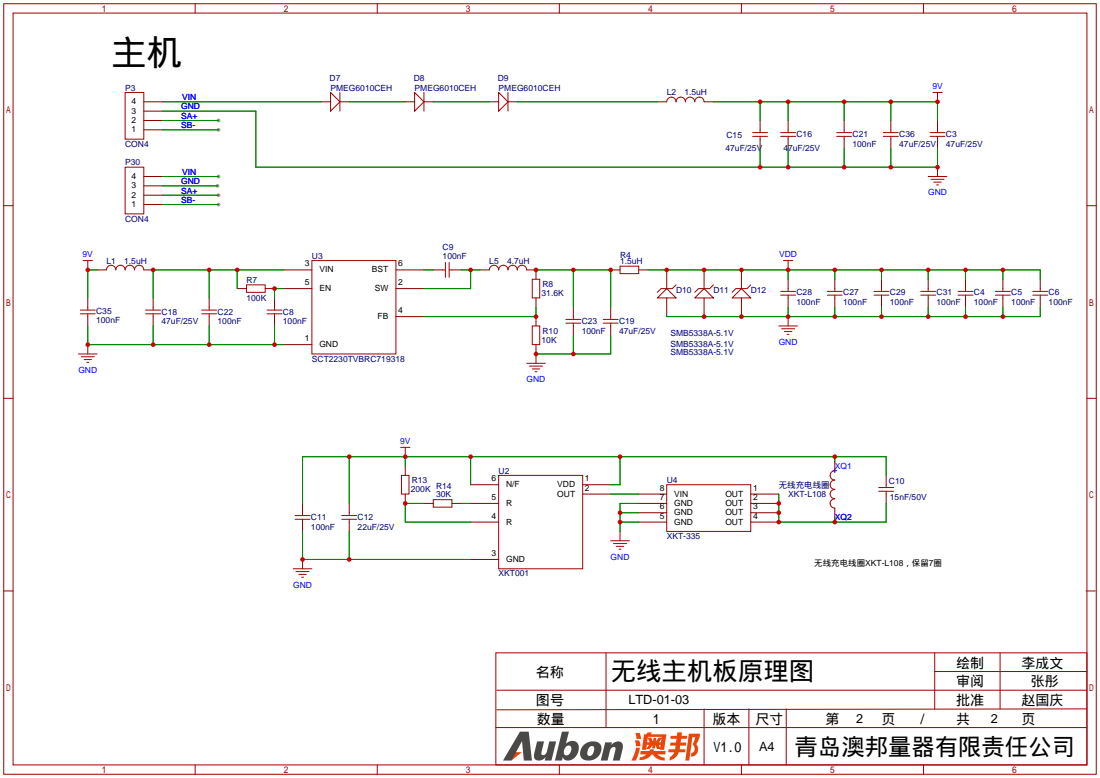
[picture p85: page 12]

从机

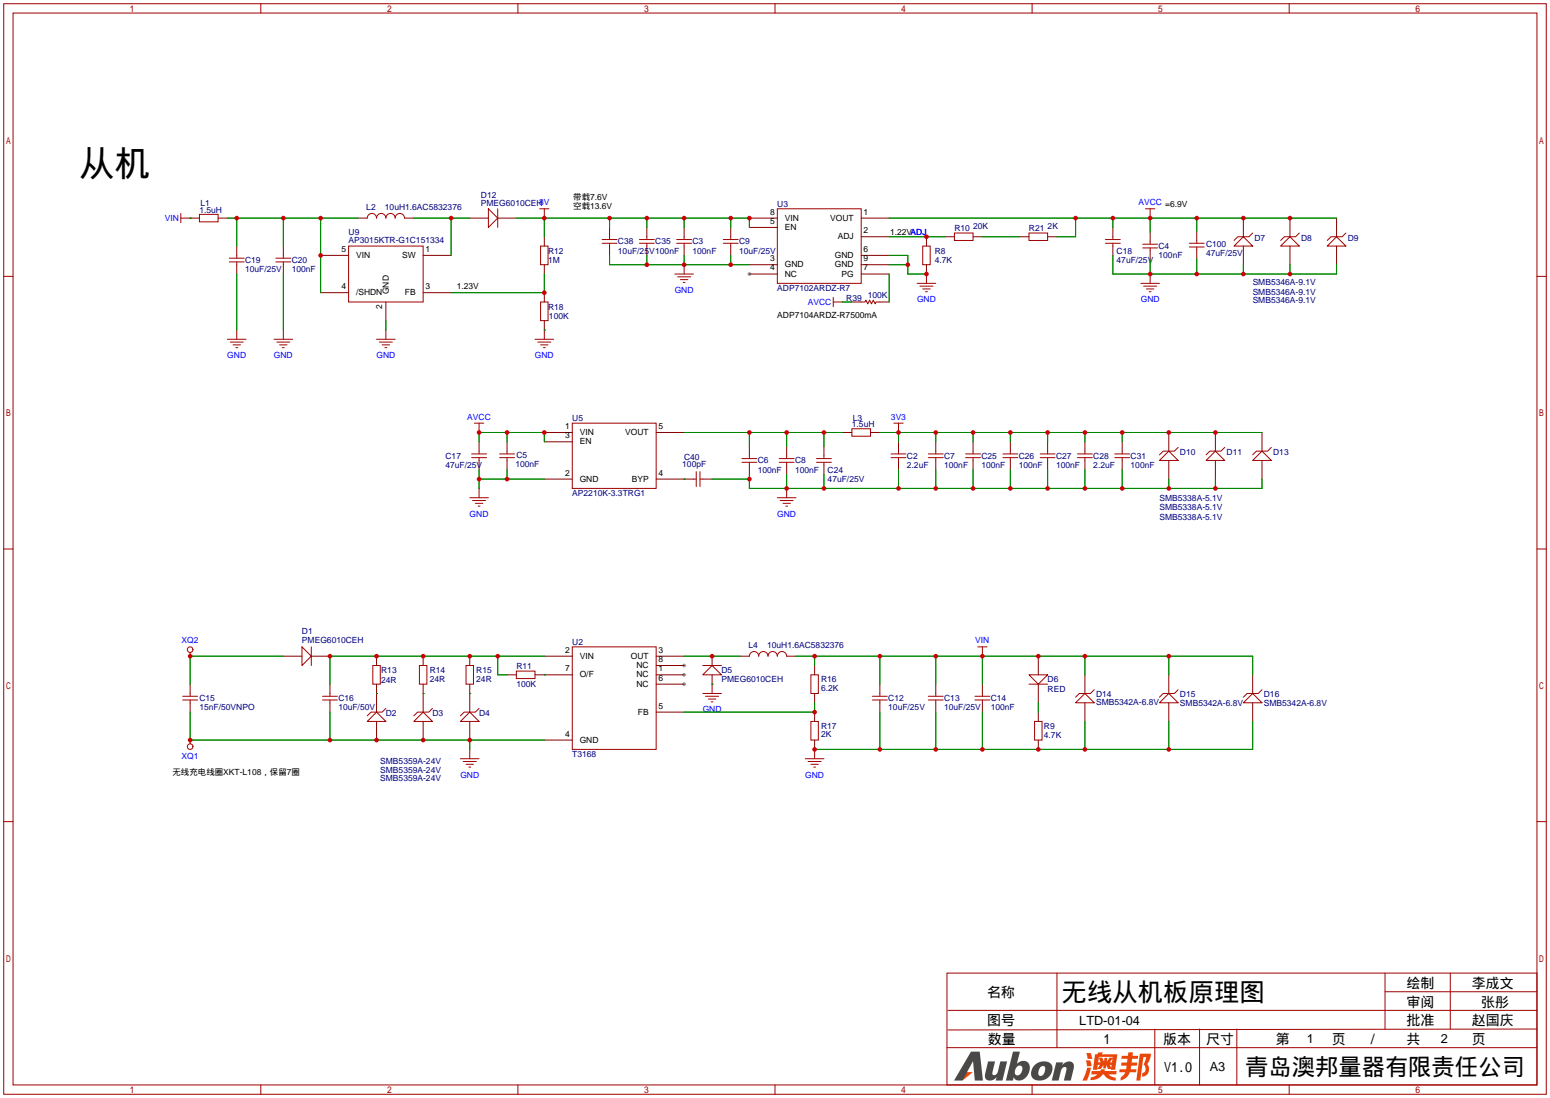
[picture p86: page 13]

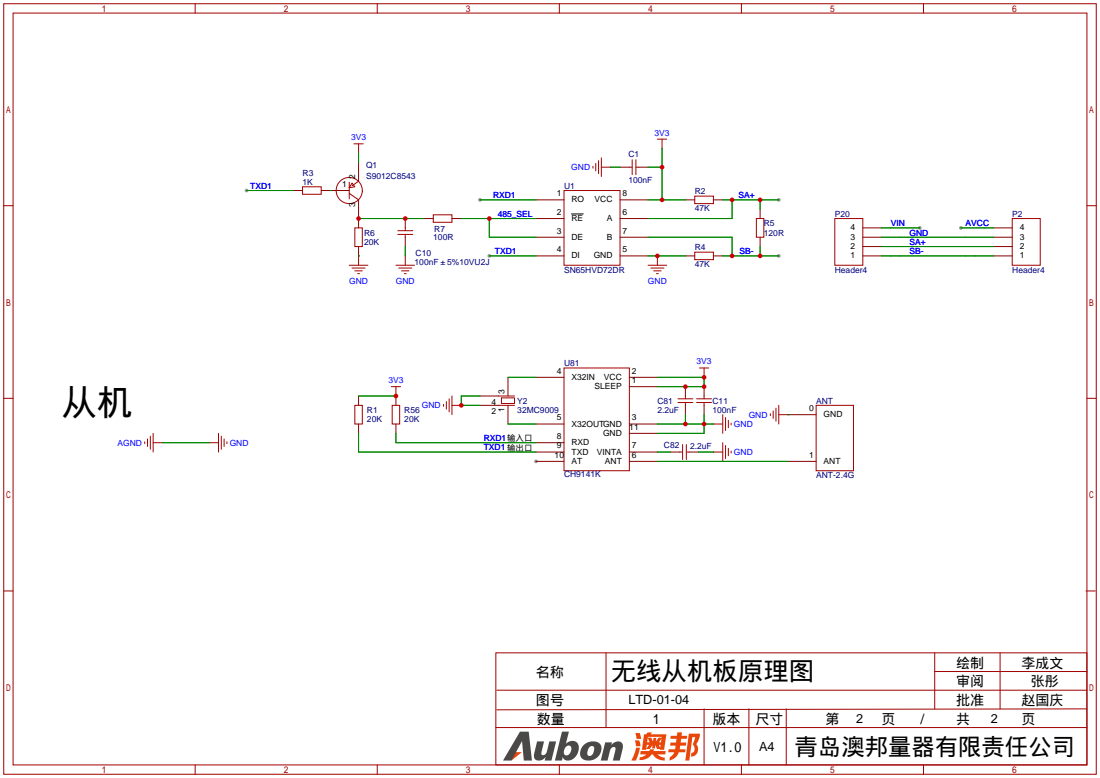
[picture p87: page 14]

# SWD烧写口

# ADS1247

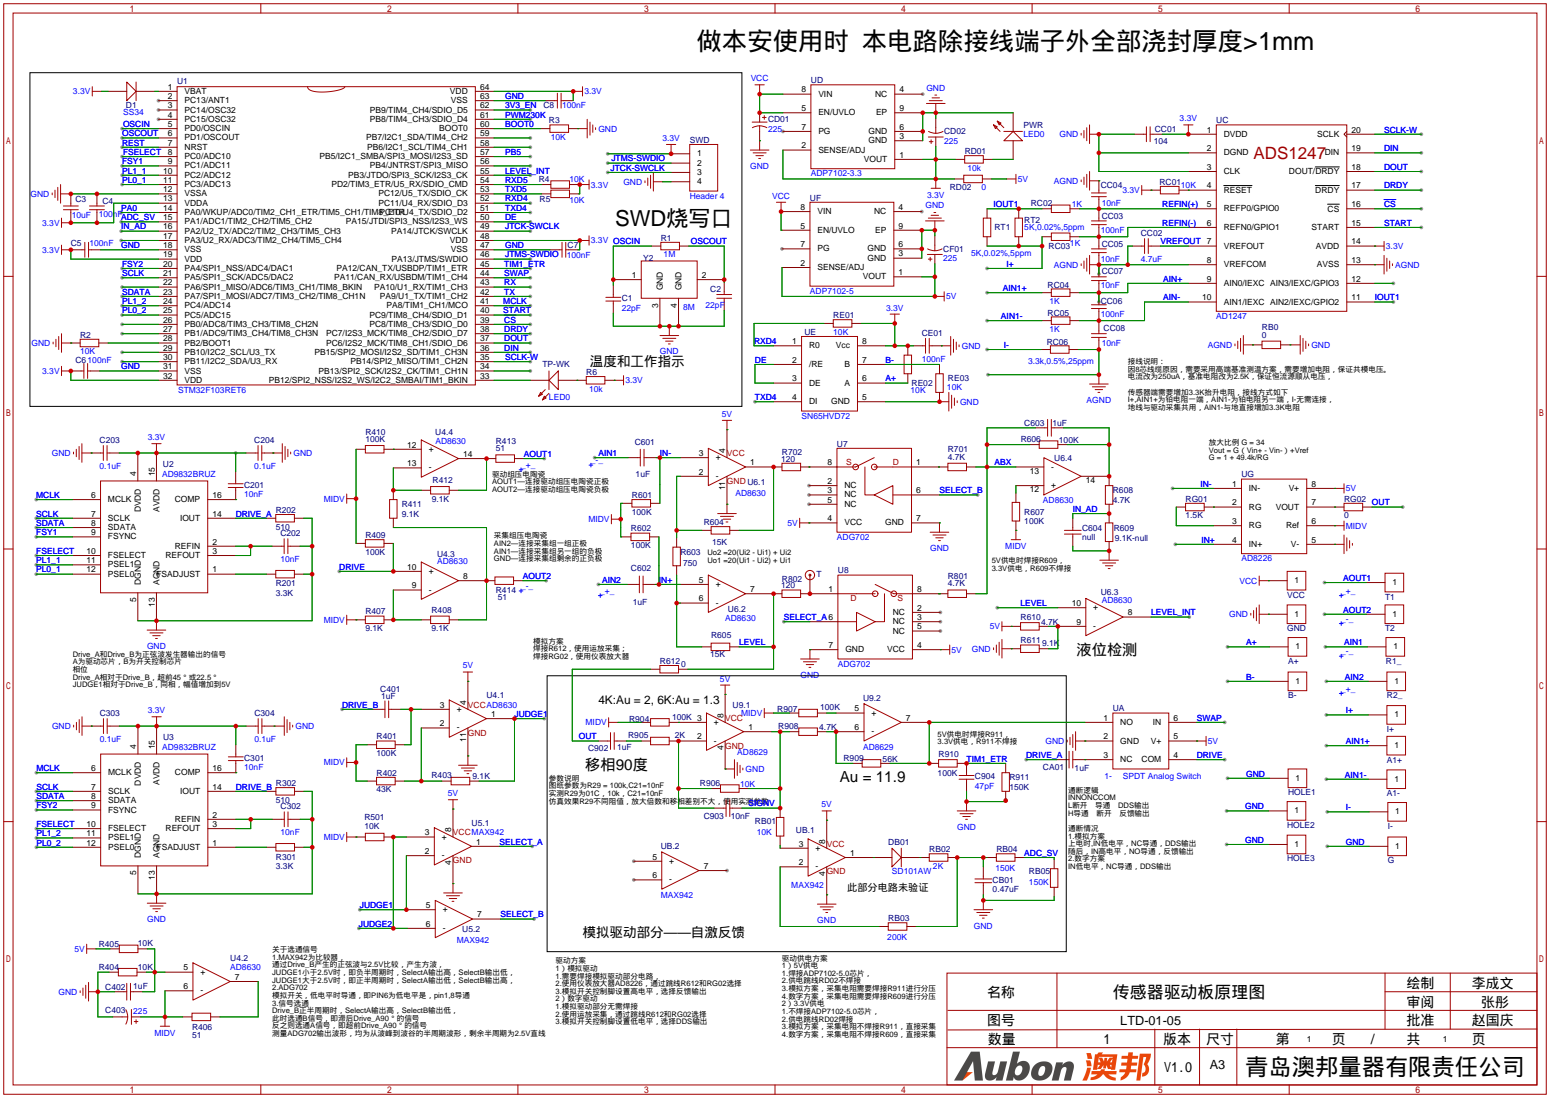
[picture p88: page 15]

通断情况
1.模拟方案
上电时,IN低电平，NC导通，DDS输出
随后，IN高电平，NO导通，反馈输出
2.数字方案
IN低电平，NC导通，DDS输出

## C21100pF

## C22100pF

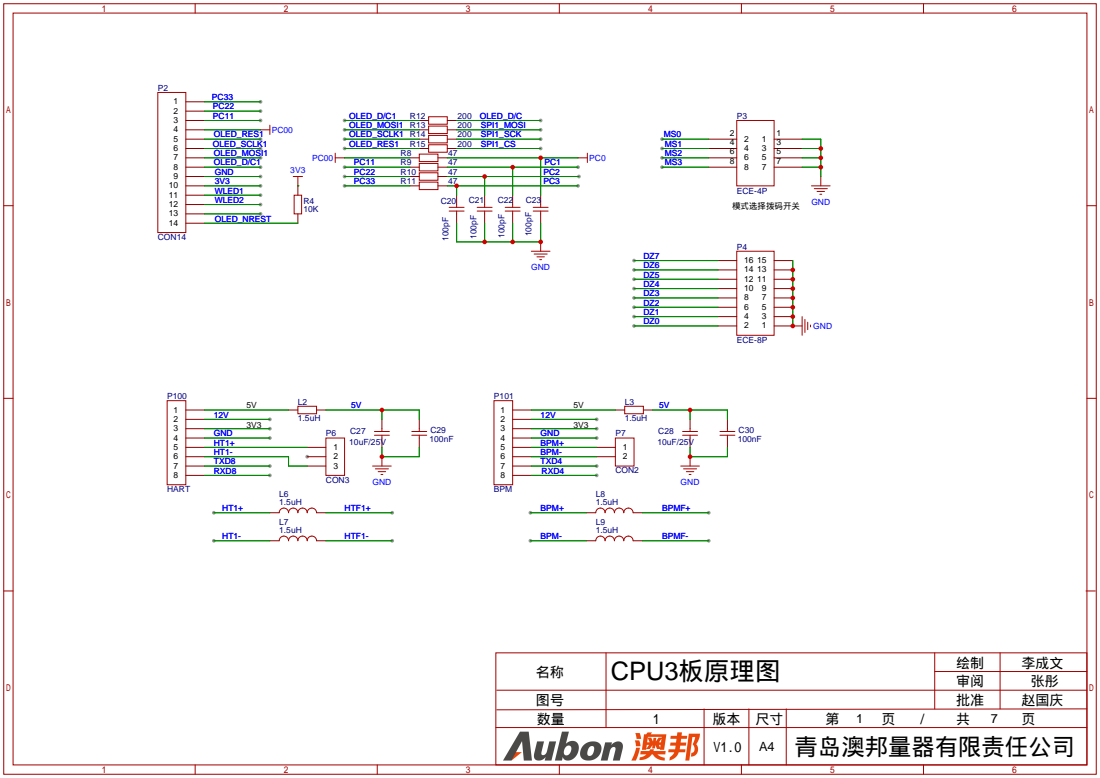
[picture p89: page 16]

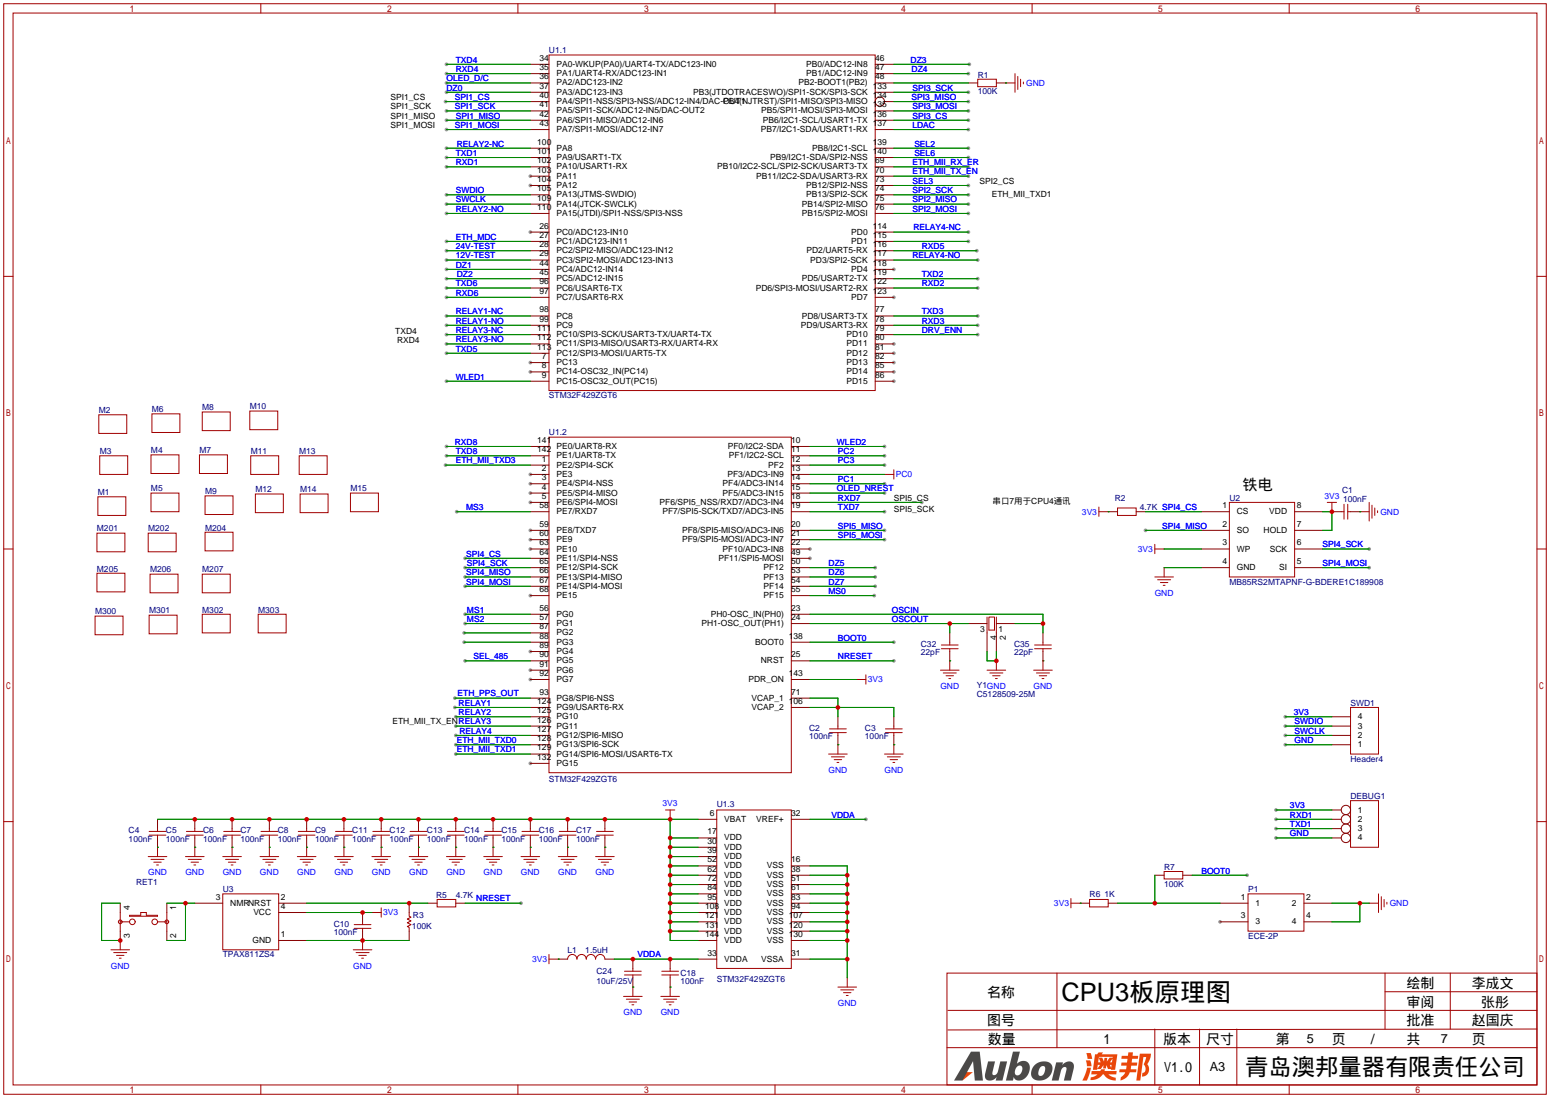
[picture p90: page 17]

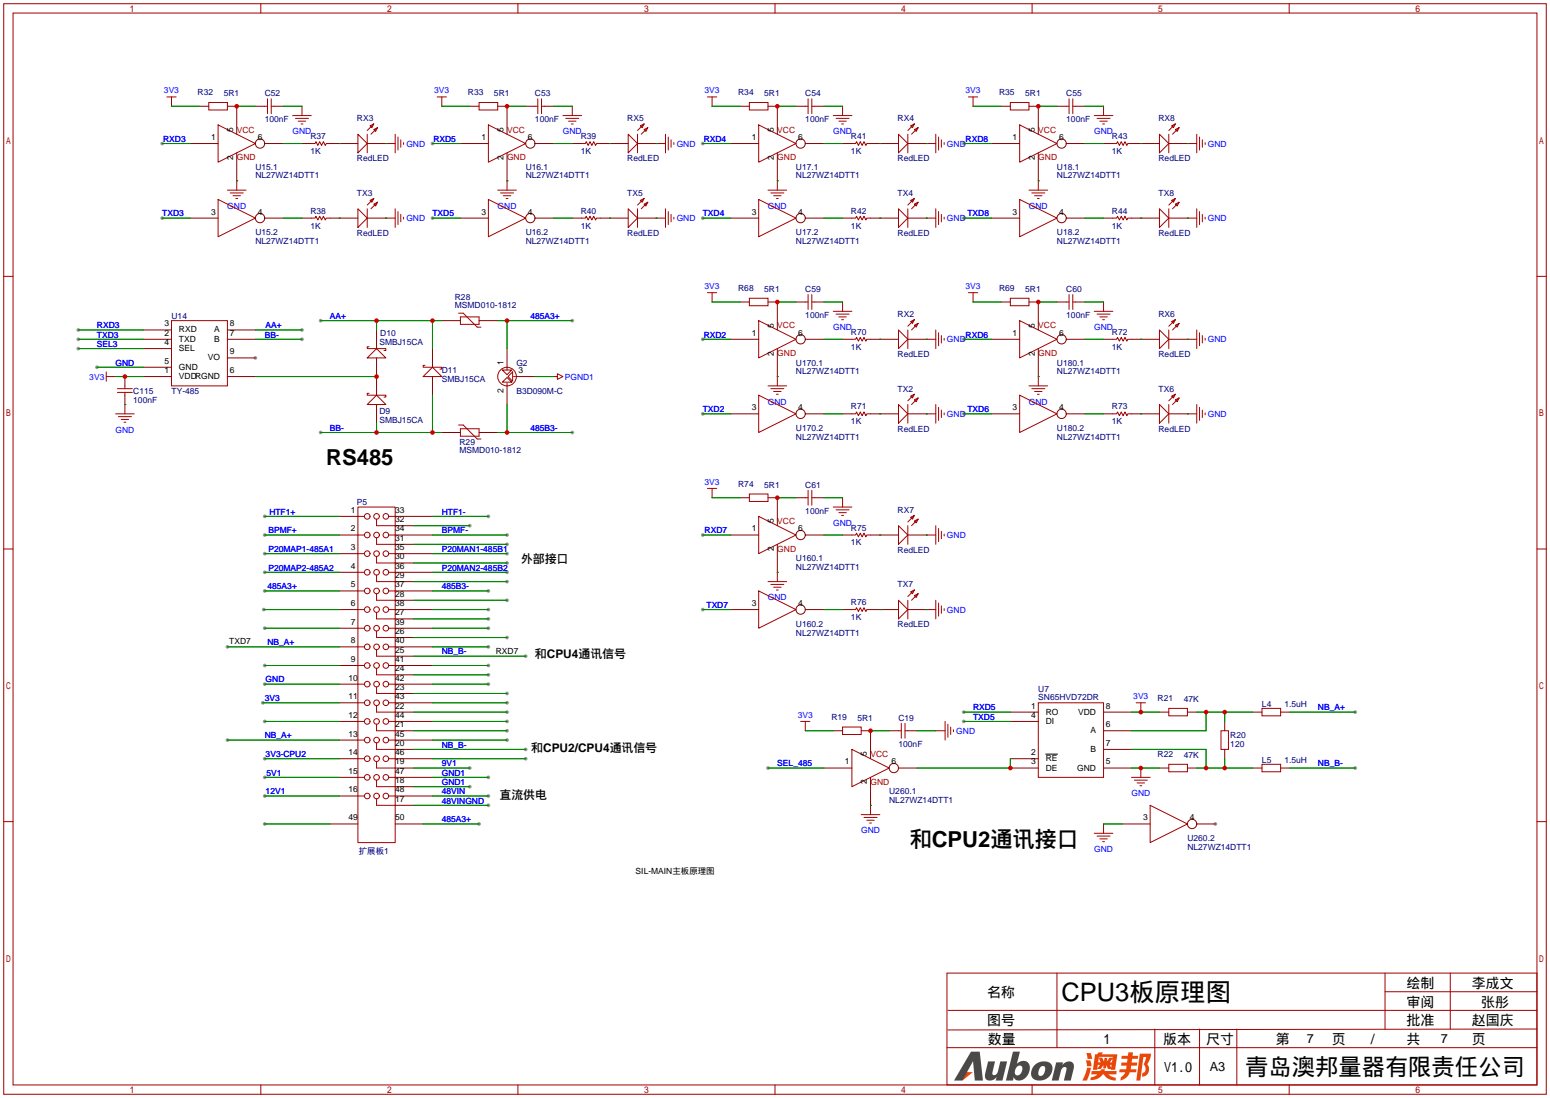
[picture p91: page 18]

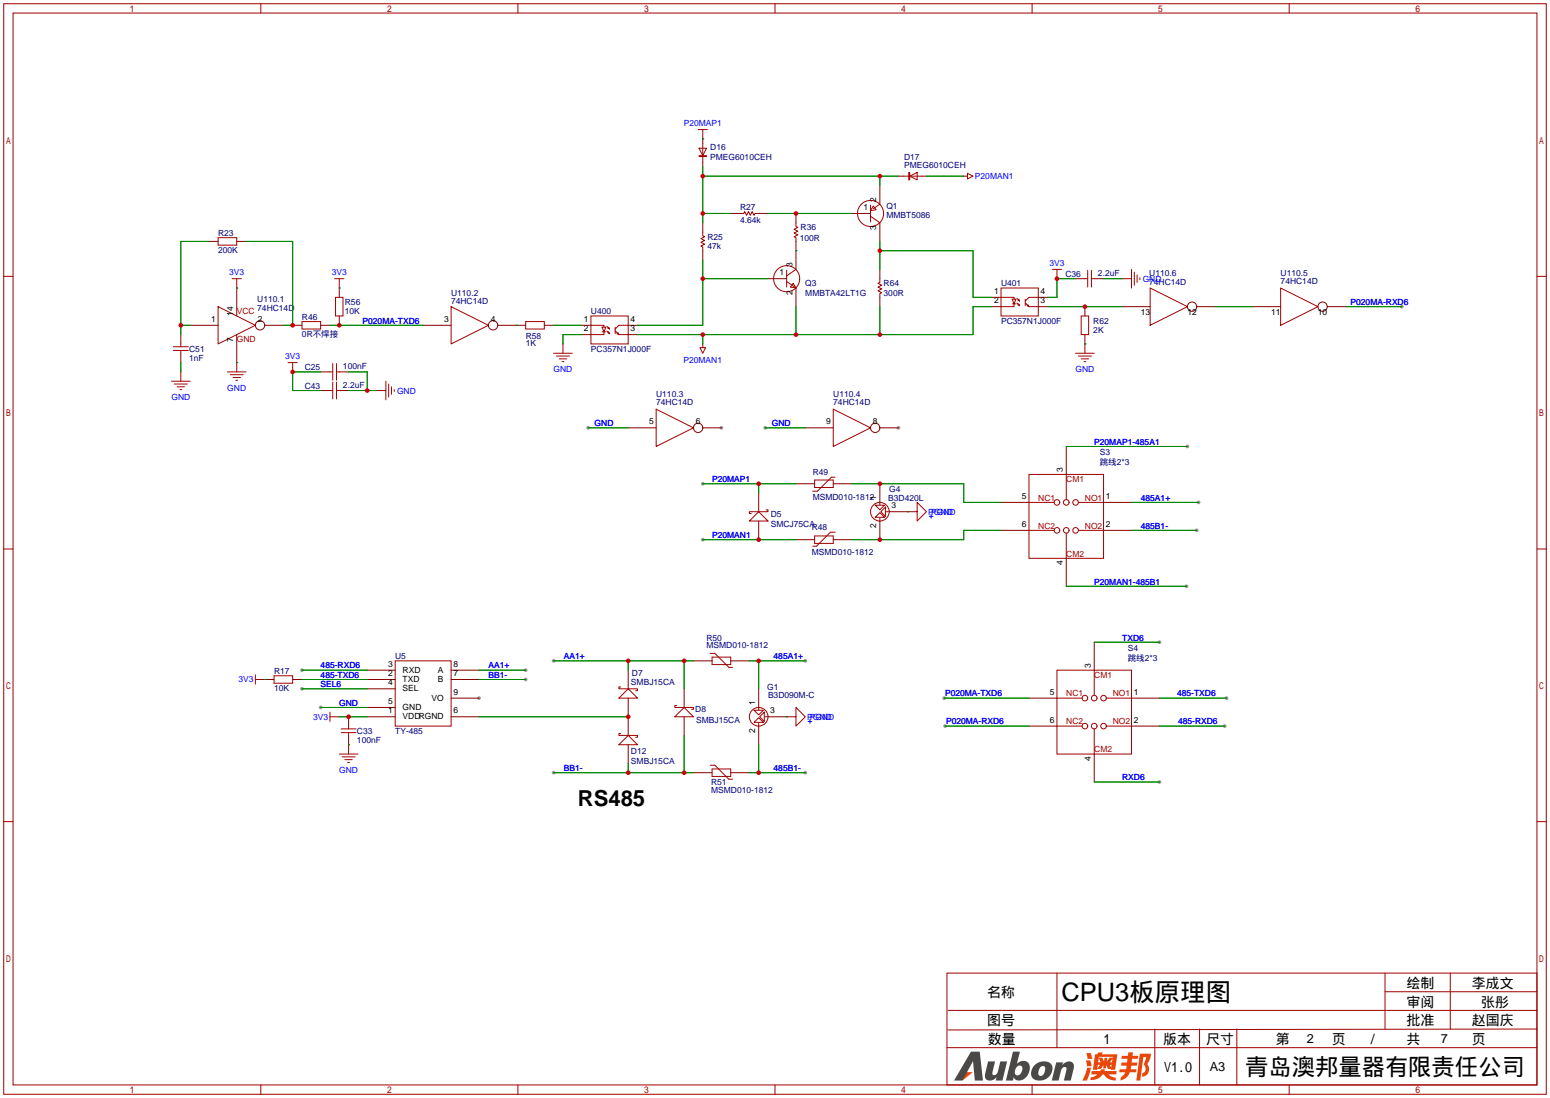
[picture p92: page 19]

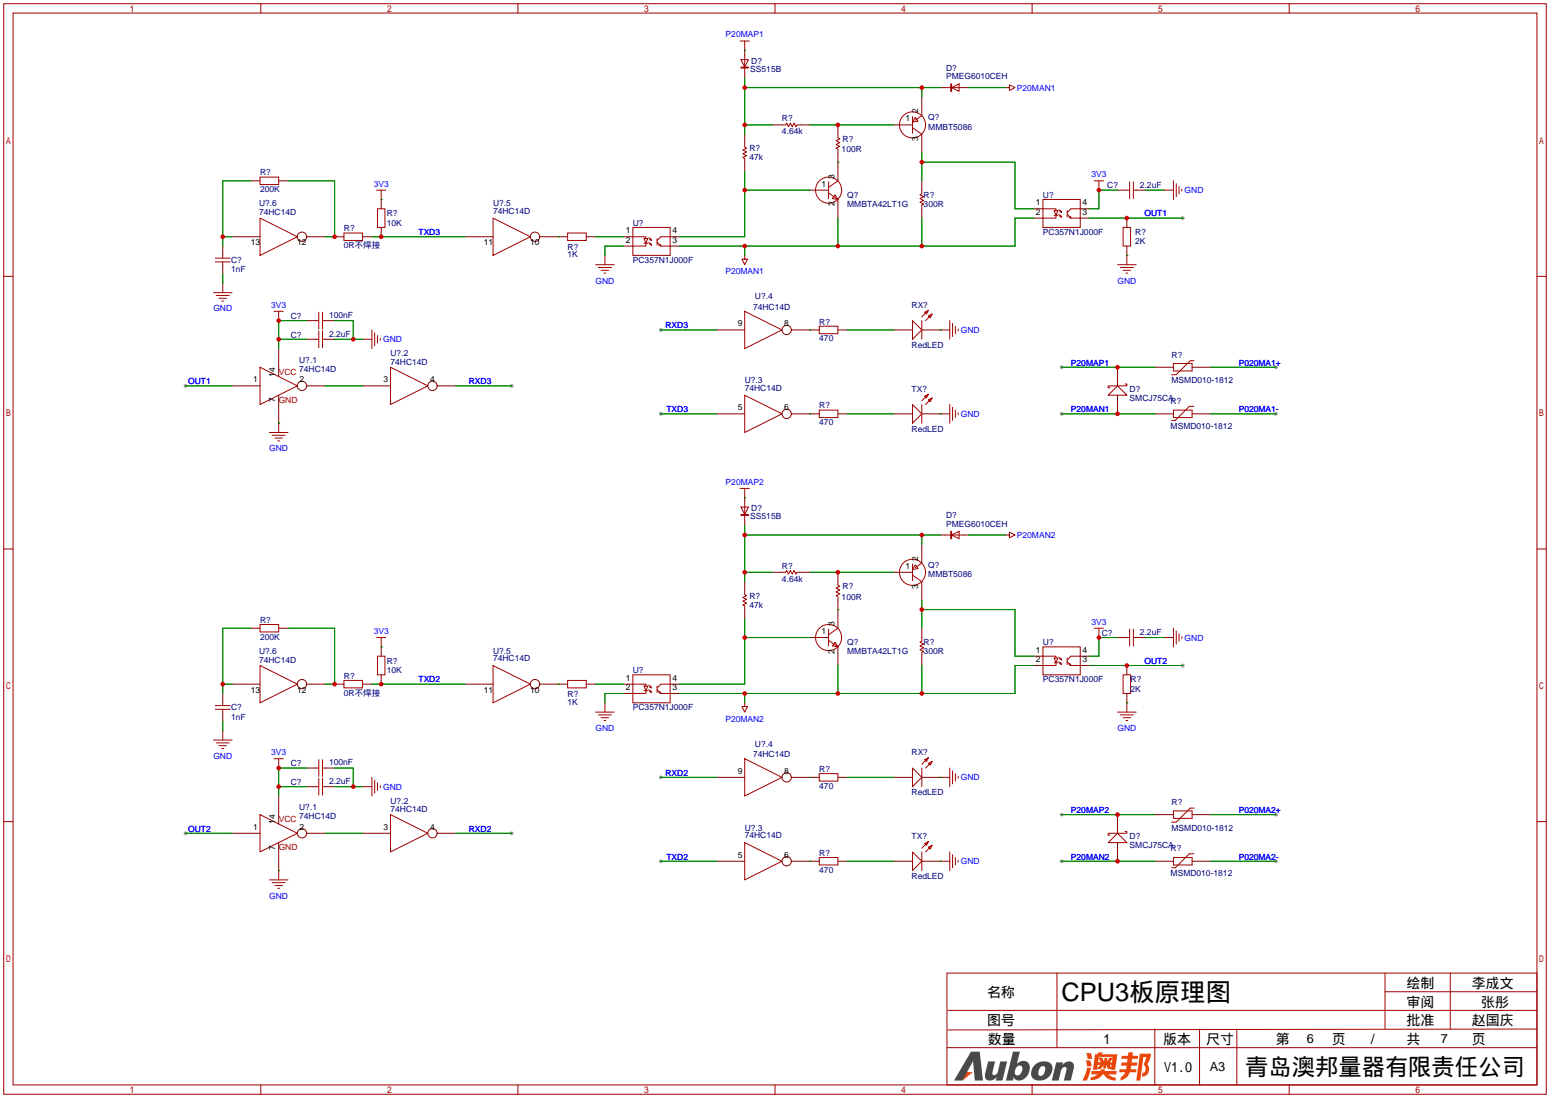
[picture p93: page 20]

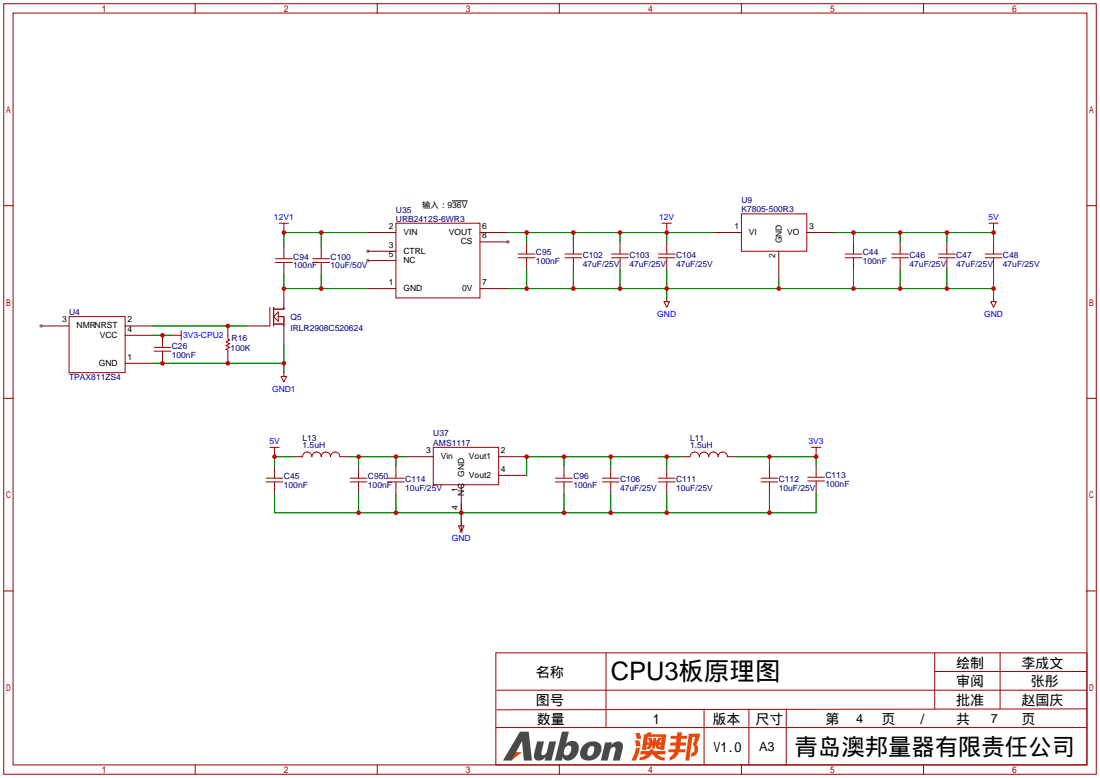
[picture p94: page 21]

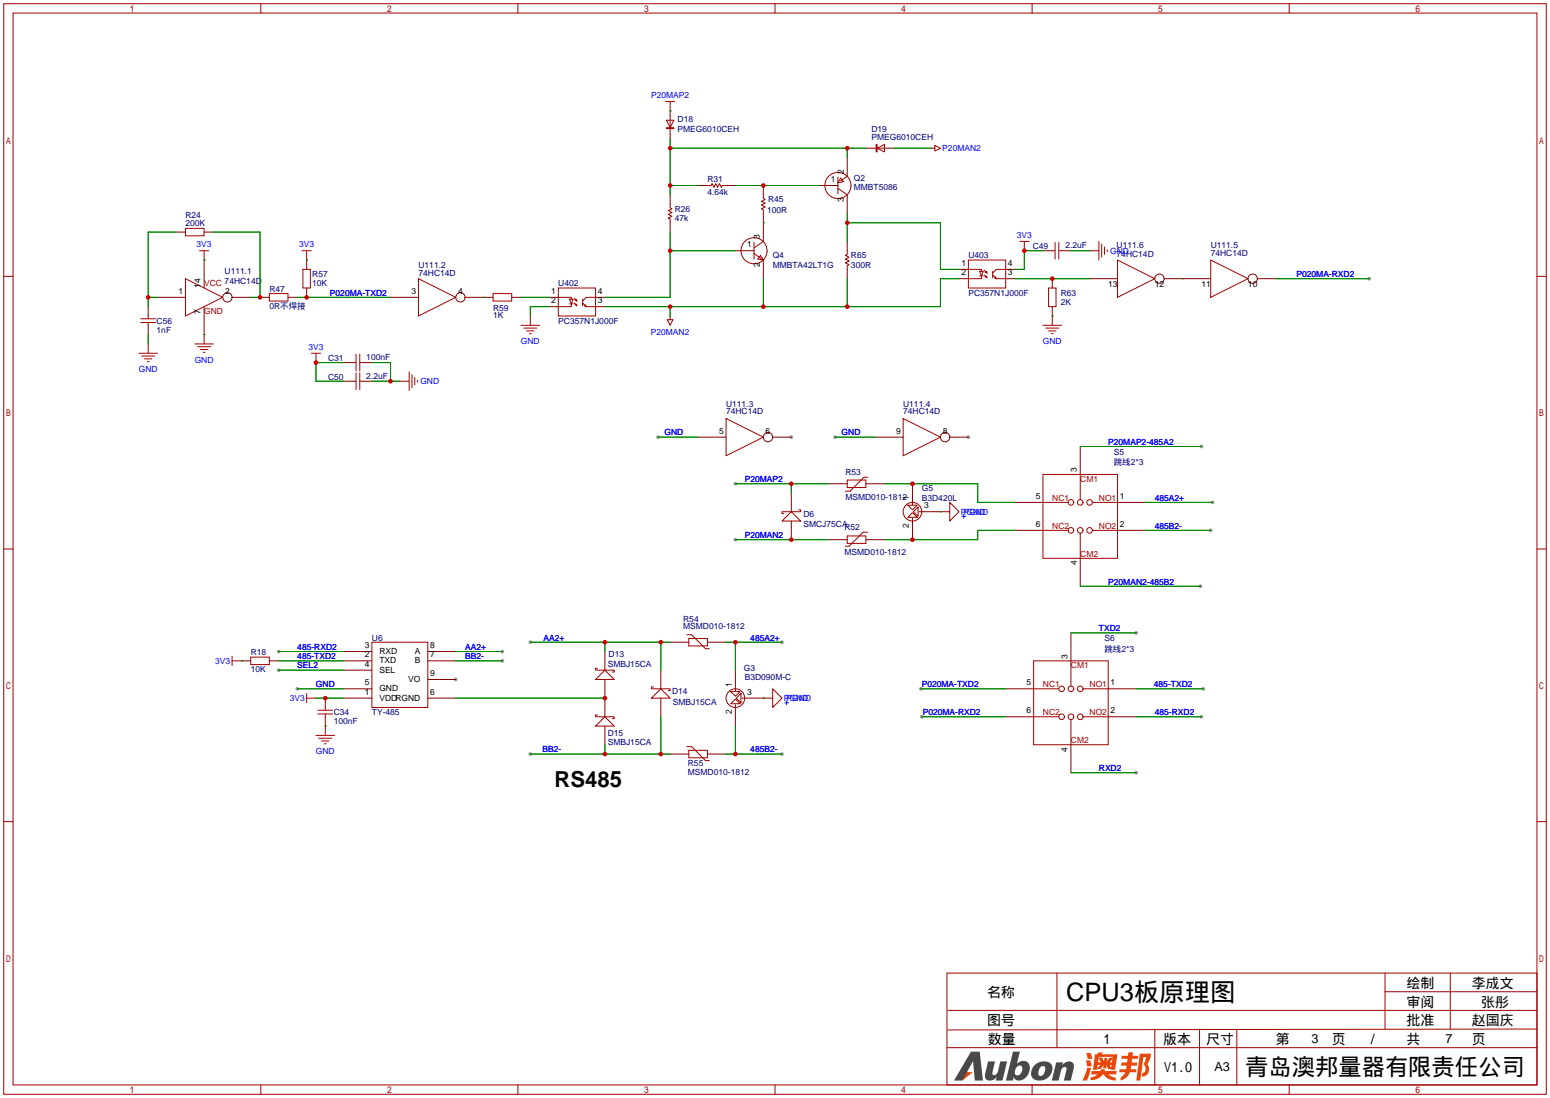
[picture p95: page 22]

# 非本安侧 本安侧

# 做本安使用时 本电路除接线端子外全部浇封厚度>1mm

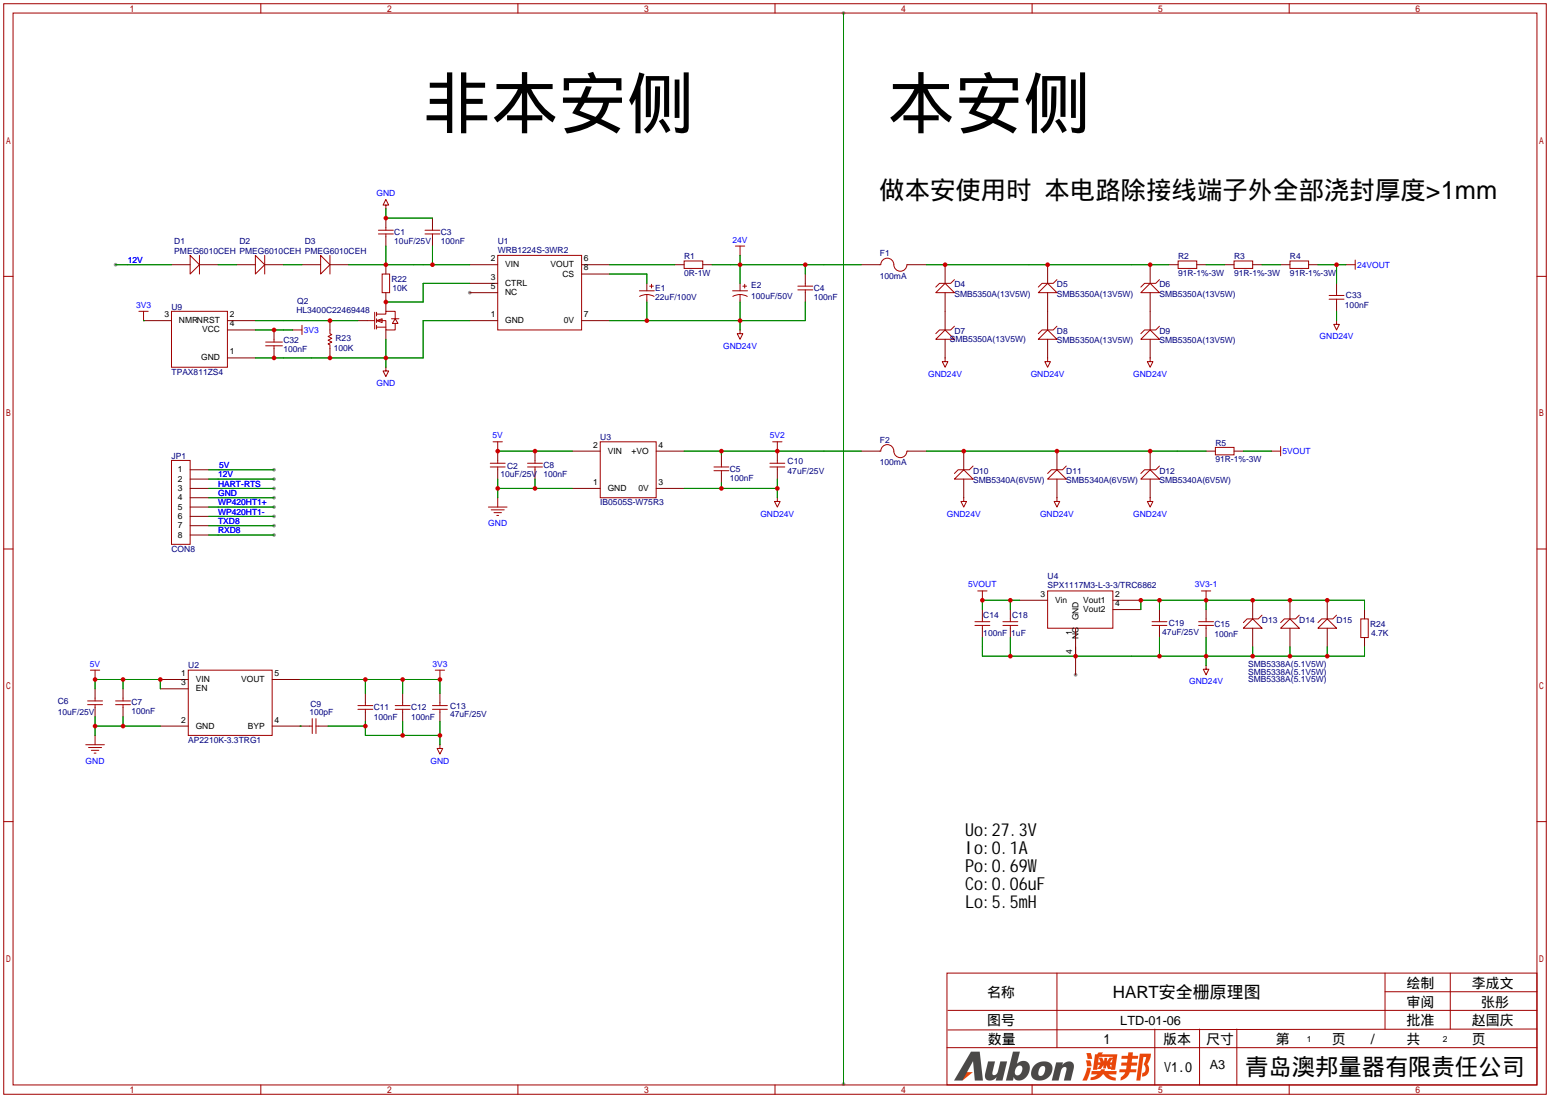
[picture p96: page 23]

# 非本安侧 本安侧 做本安使用时 本电路除接线端子外全部浇封厚度>1mm

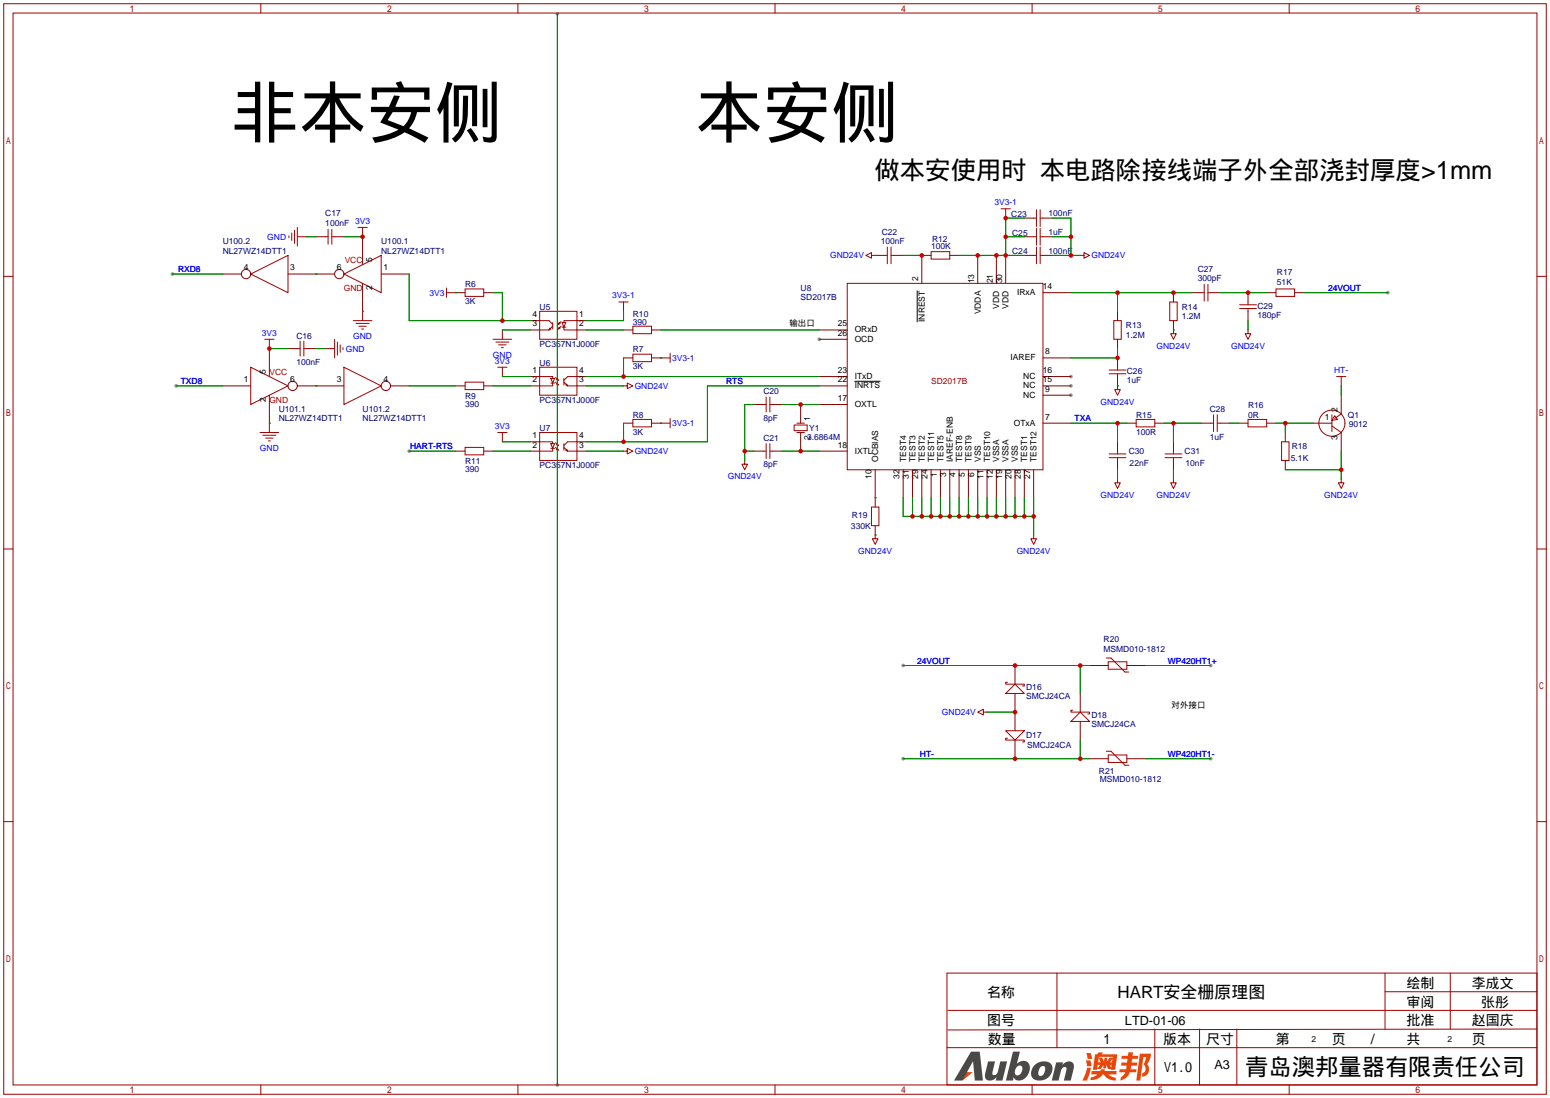
[picture p97: page 24]

## 非本安侧 本安侧

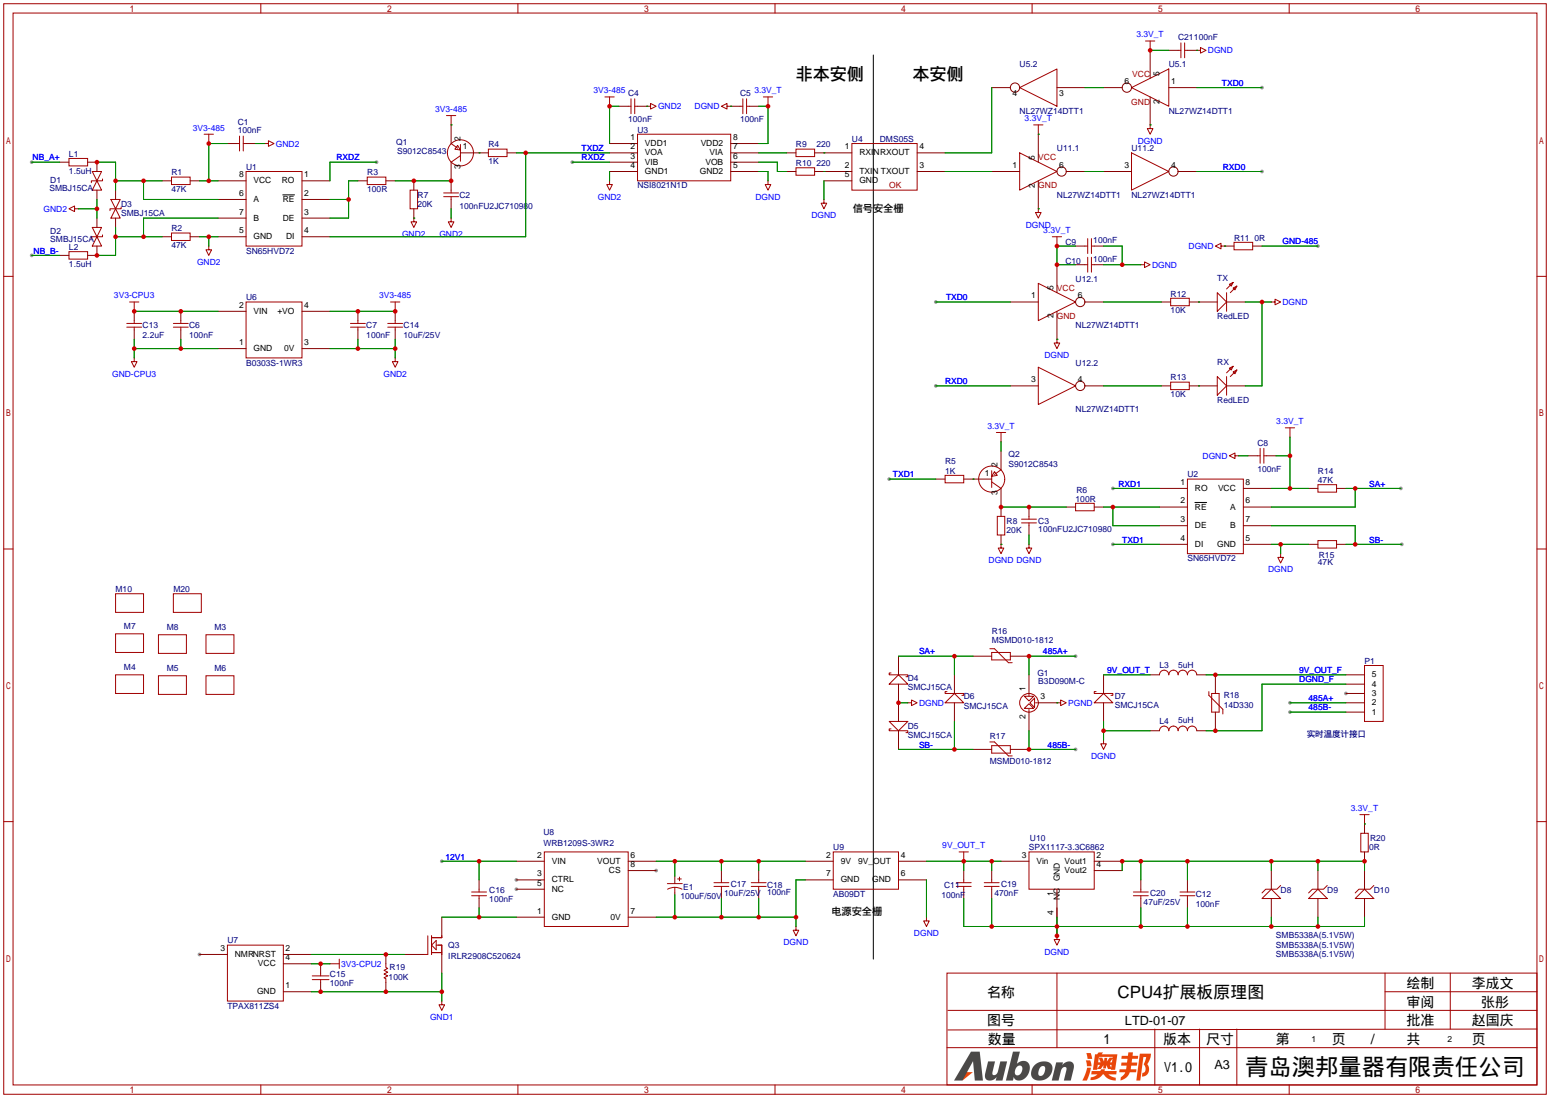
[picture p98: page 25]

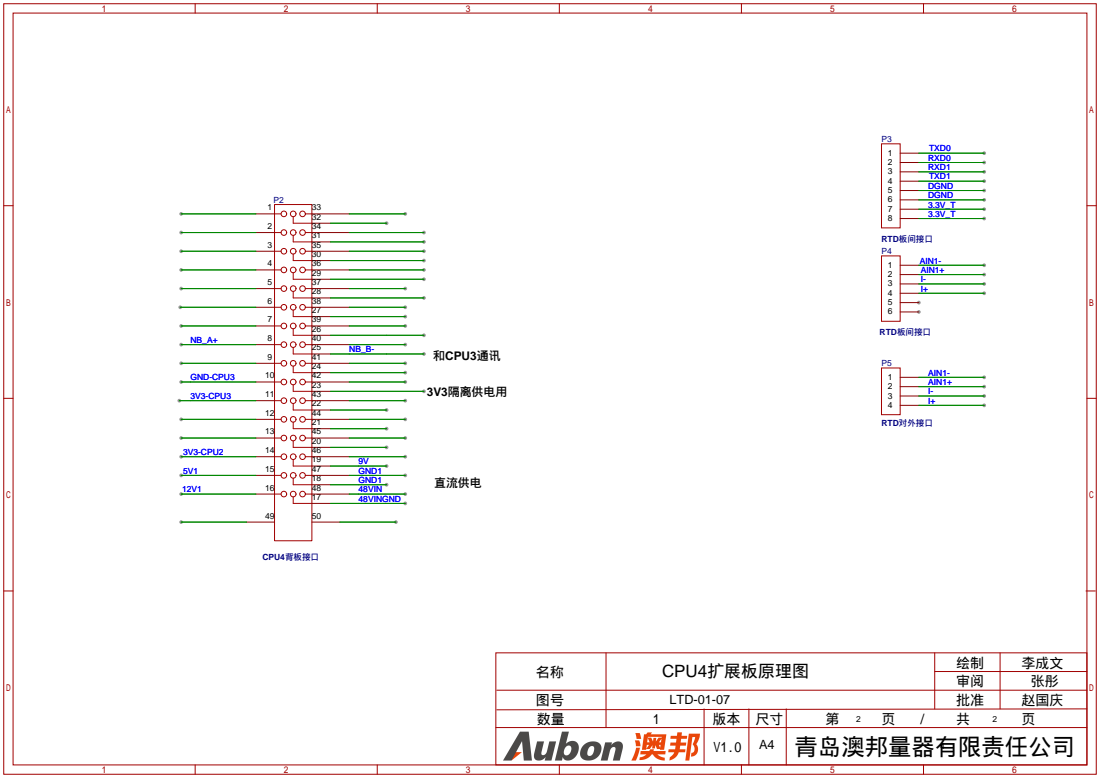
[picture p99: page 26]

# 本电路除接线端子外全部浇封厚度>1mm

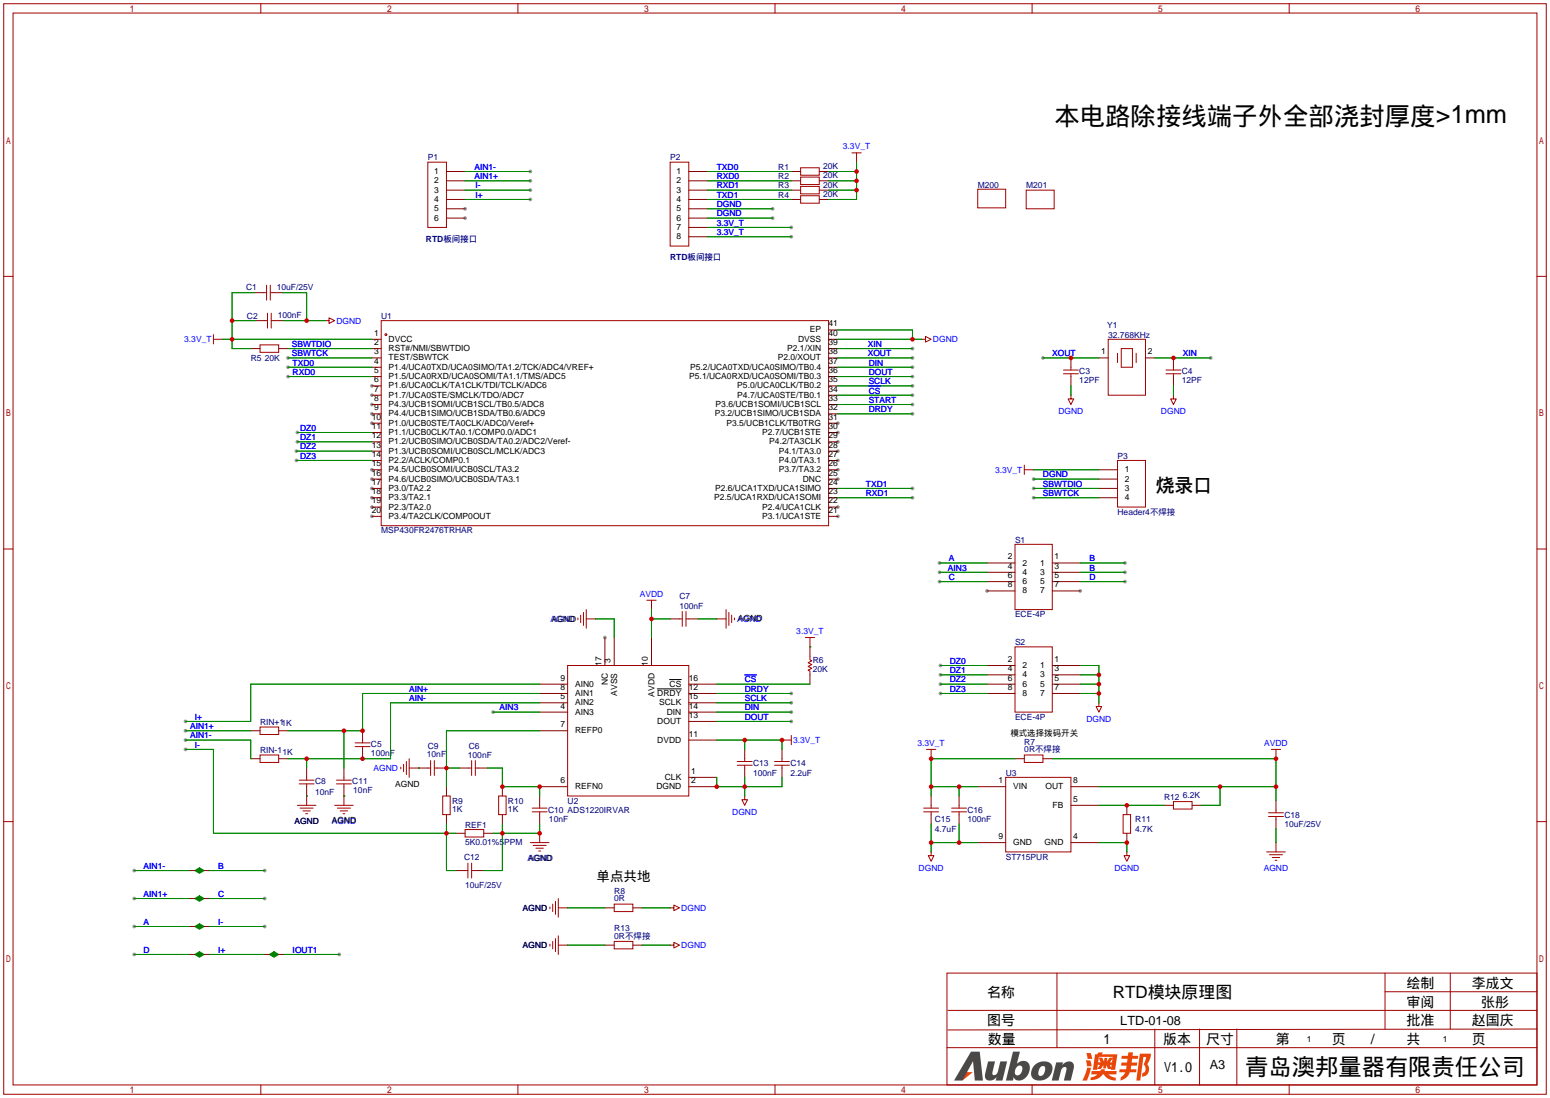
[picture p100: page 27]

# 做本安使用时 本电路除接线端子外全部浇封厚度>1mm

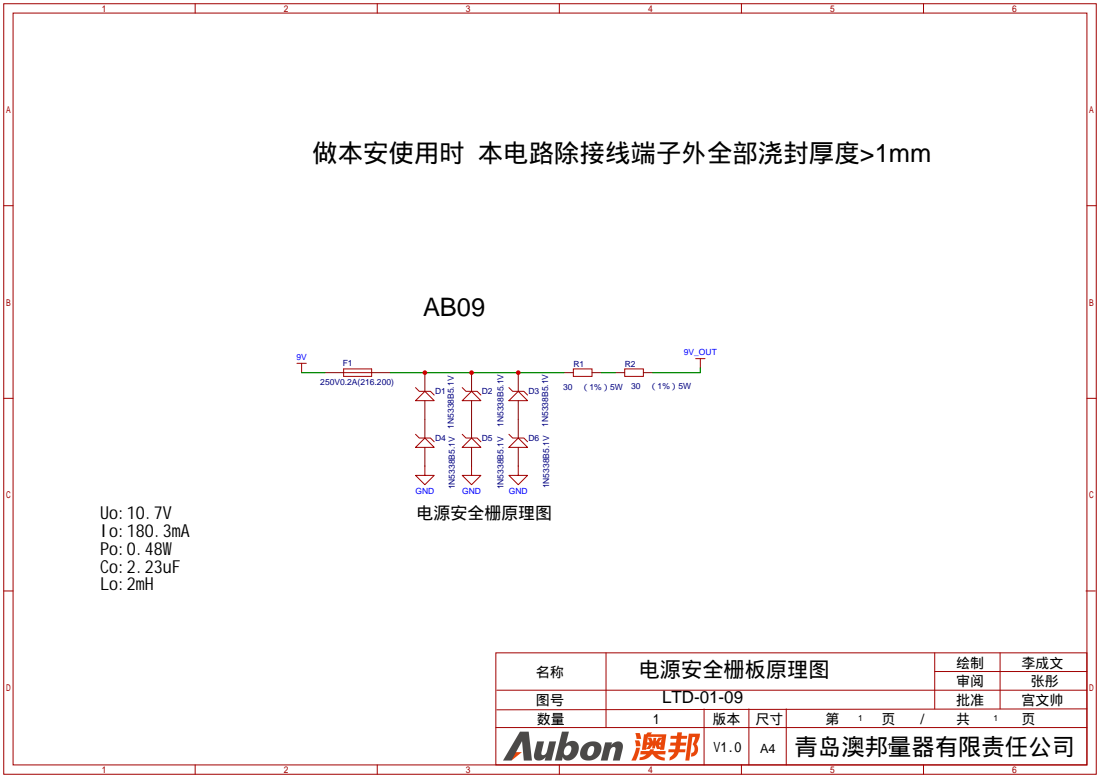
[picture p101: page 28]

# 做本安使用时 本电路除接线端子外全部浇封厚度

>1mm

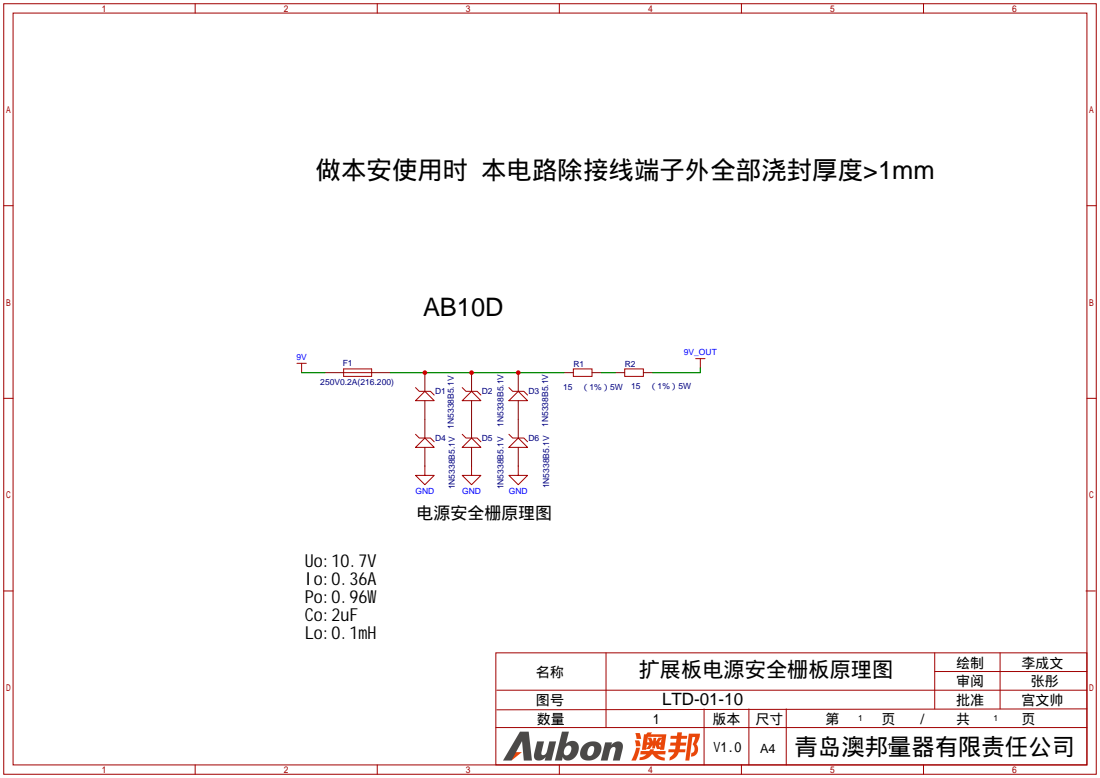
[picture p102: page 29]

# 做本安使用时 本电路除接线端子外全部浇封厚度>1mm

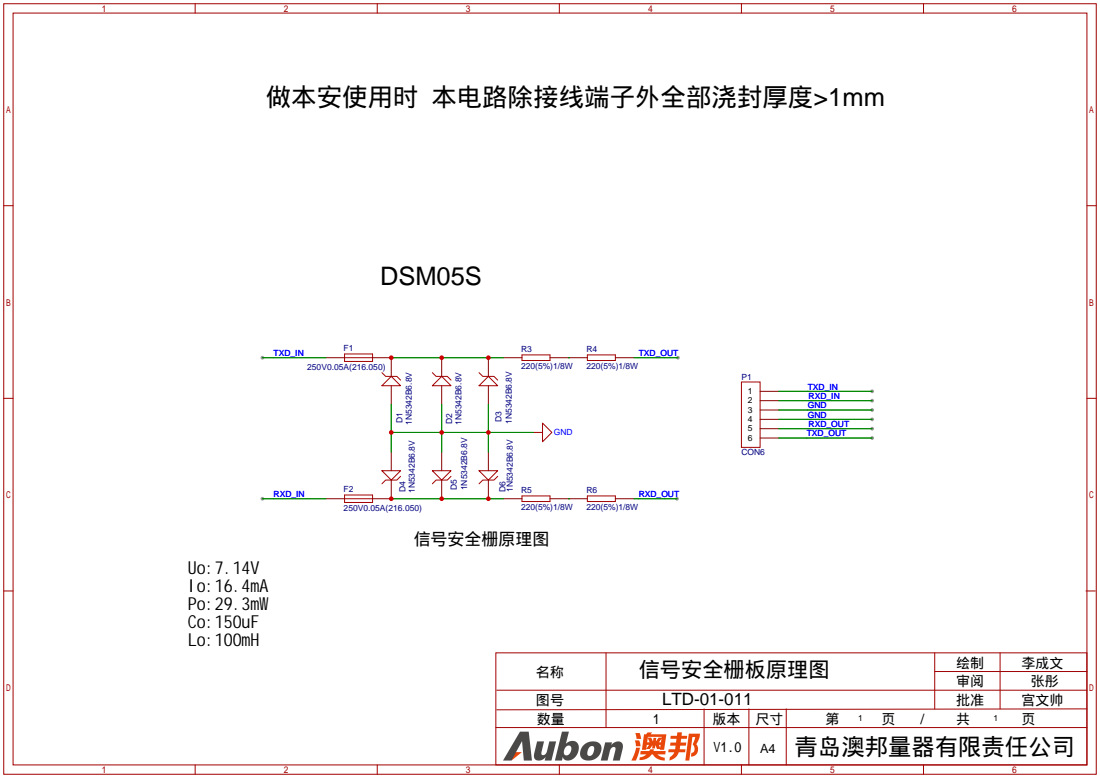
[picture p103: page 30]
