duanxuebin1998/cube/docs/07_硬件原理图/00_原始资料/DM4四代数字驱动V6.0/DM4测水连接板V6.0.pdf

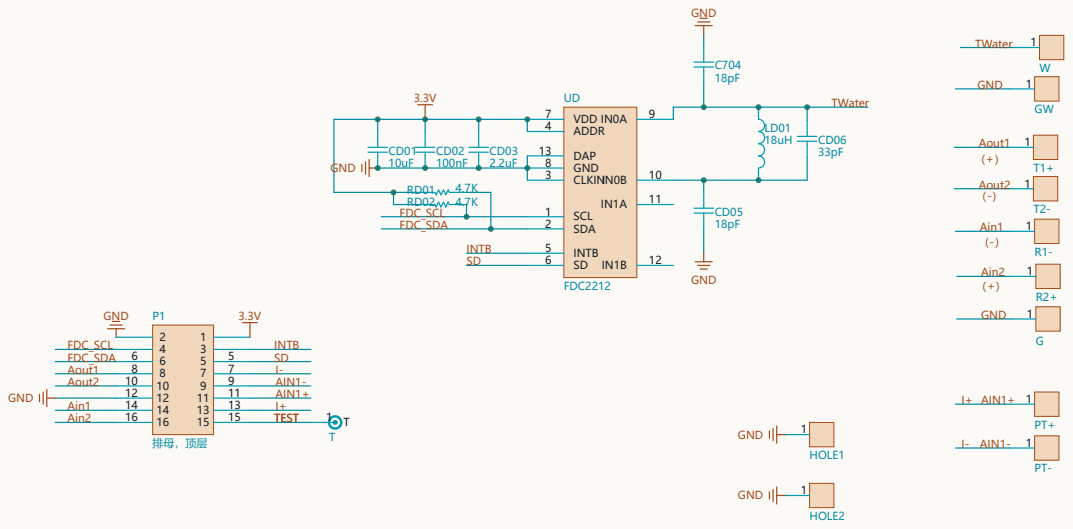
[picture p104: page 1]
GND; VDD; 1 SCL 2 SDA; CLKIN; ADDR; 5 INTB 6 SD; DAP; FDC_SCL FDC_SDA; INTB SD; Aout1 Aout2; Ain1 Ain2; TEST; HOLE1; HOLE2; Aout1; I- AIN1-; Aout2; Ain1; Ain2; AIN1+; TWater; TWater UD; FDC2212; FDC_SCL; FDC_SDA; AIN1-; Title; Number; Revision; Size; Sheet; Date:; File:; Drawn By:; 8/03/2026 DM4测水连接板V6.0.SchDoc
