duanxuebin1998/cube/docs/07_硬件原理图/00_原始资料/DM4四代数字驱动V6.0/DM4电源板V6.0.pdf

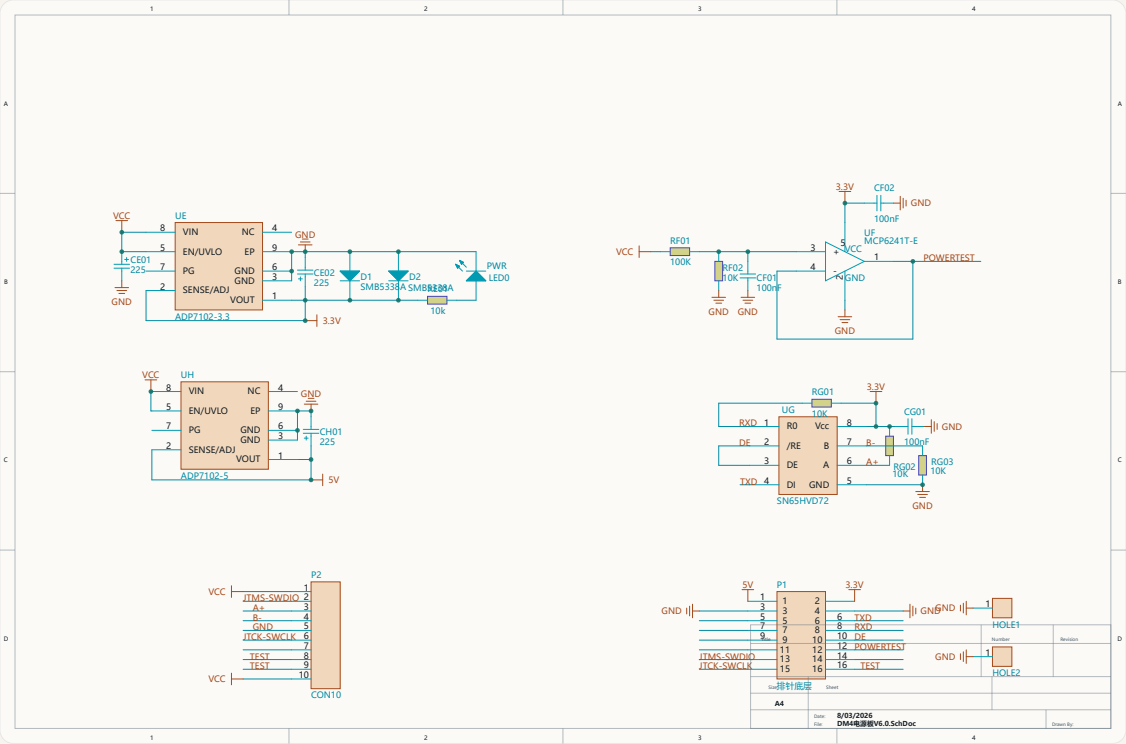
[picture p105: page 1]
VIN; EN/UVLO; SENSE/ADJ; 1 VOUT; 3 GND; 6 GND; 5 GND; 8 Vcc; VCC; GND; ADP7102-3.3; PWR LED0; POWERTEST; UF MCP6241T-E; D1 SMB5338A; D2 SMB5338A; SN65HVD72; TXD; RXD; 排针底层; TEST; JTMS-SWDIO JTCK-SWCLK; HOLE1; HOLE2; CON10; TEST TEST; JTMS-SWDIO; JTCK-SWCLK; ADP7102-5; TXD RXD; Title; Number; Revision; Size; Sheet; Date:; File:; Drawn By:; 8/03/2026 DM4电源板V6.0.SchDoc
