duanxuebin1998/cube/docs/07_硬件原理图/00_原始资料/无线滑环蓝牙主从机/LTD-Transfor-MAIN-A3_蓝牙主机原理图.pdf

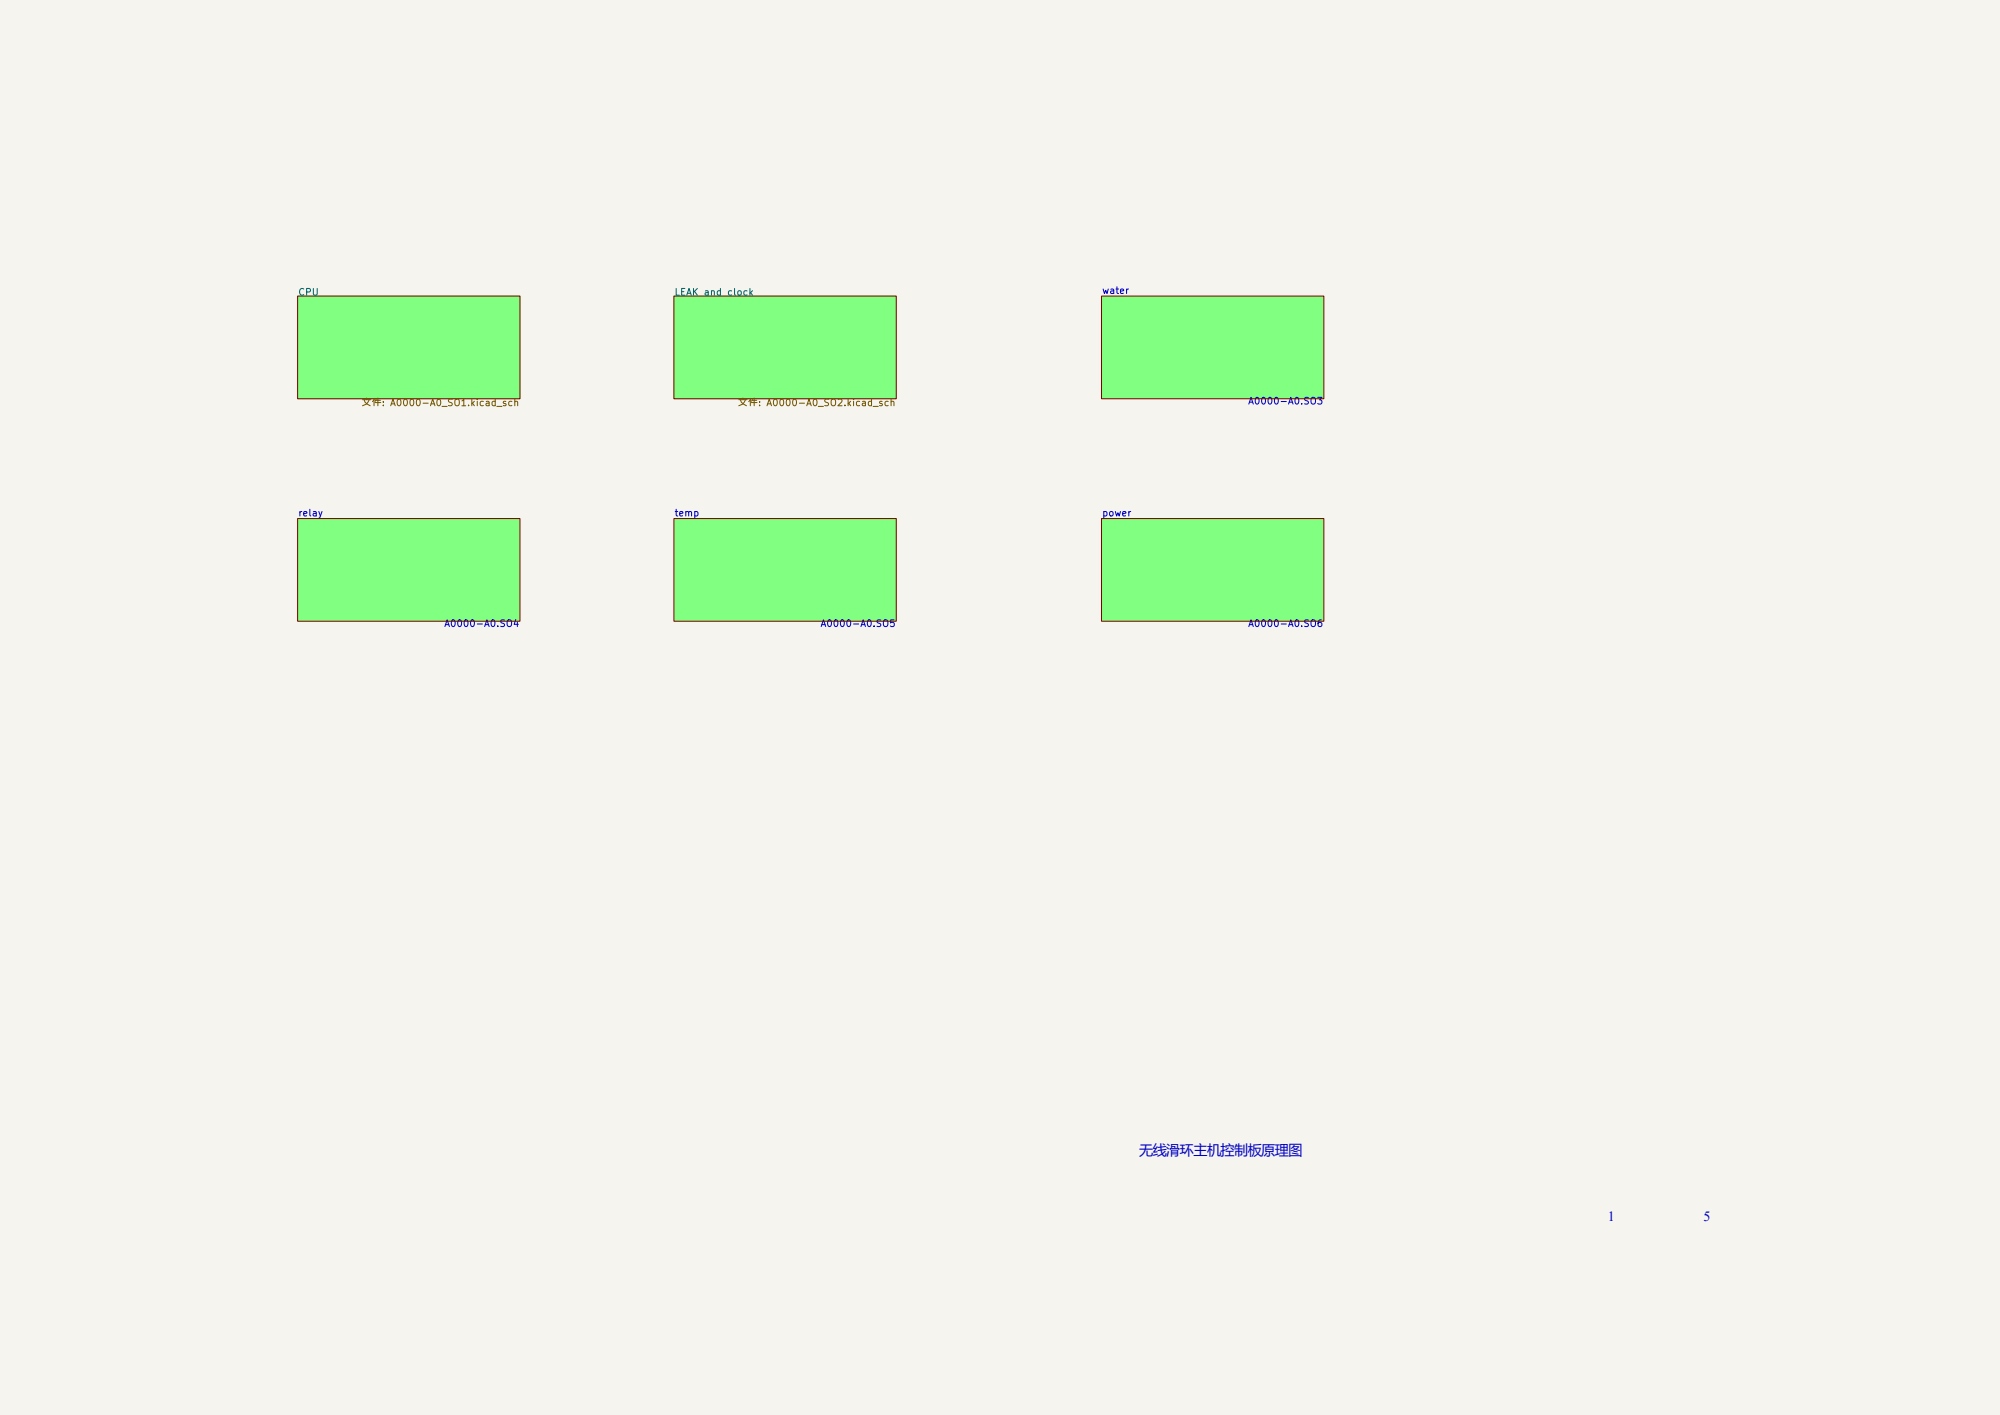
[picture p106: page 1]

LEAK and clock 文件: A0000-A0_SO2.kicad_sch
A0000-A0.SO3 无线滑环主机控制板原理图

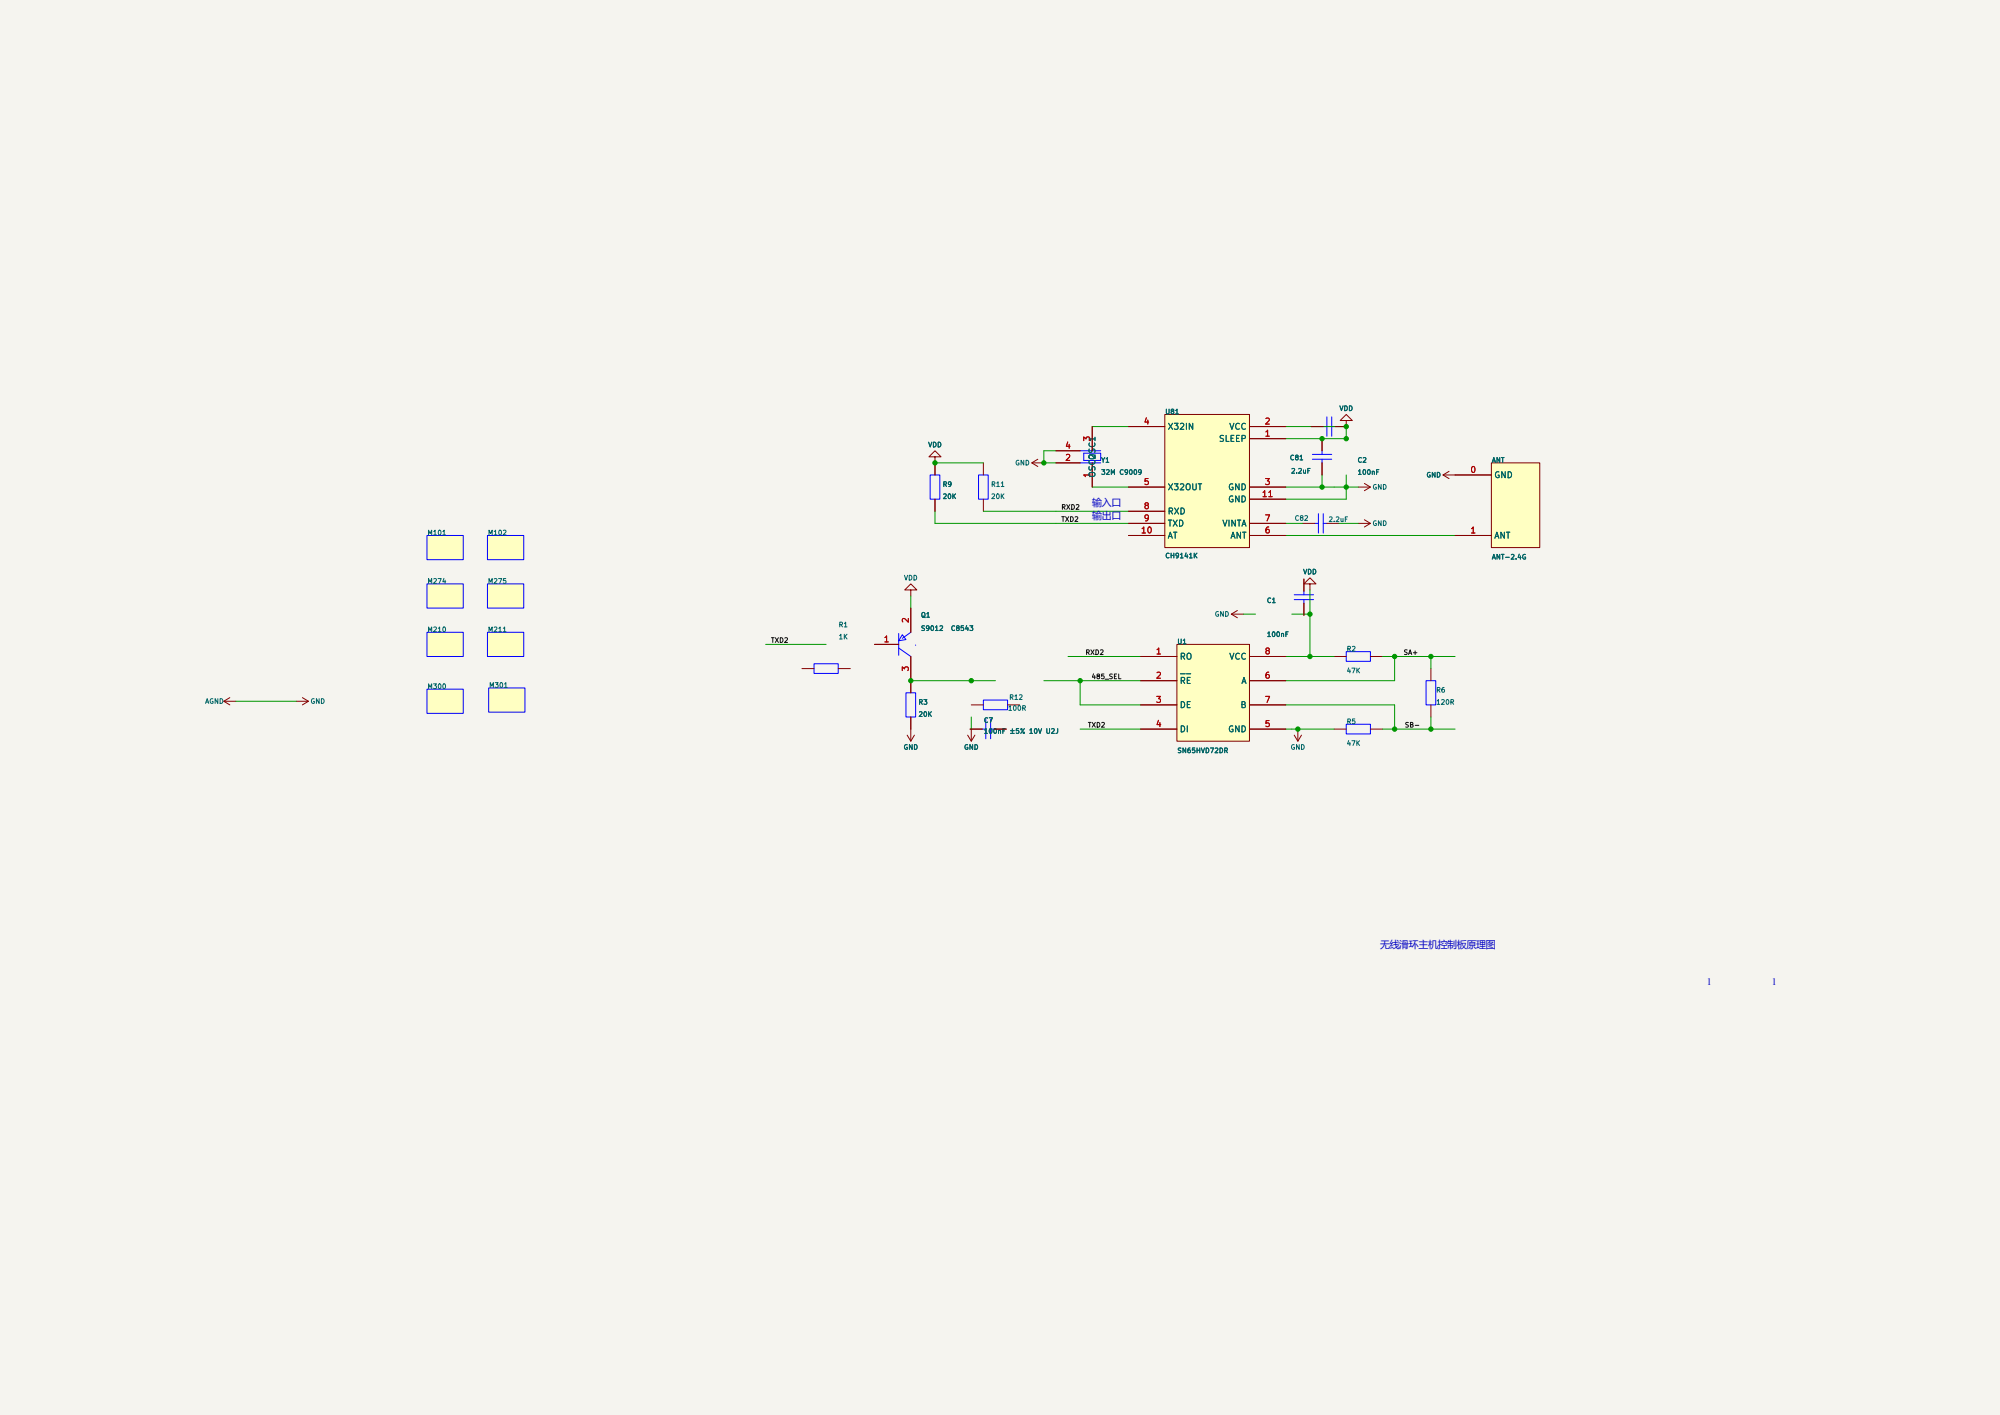
[picture p107: page 2]

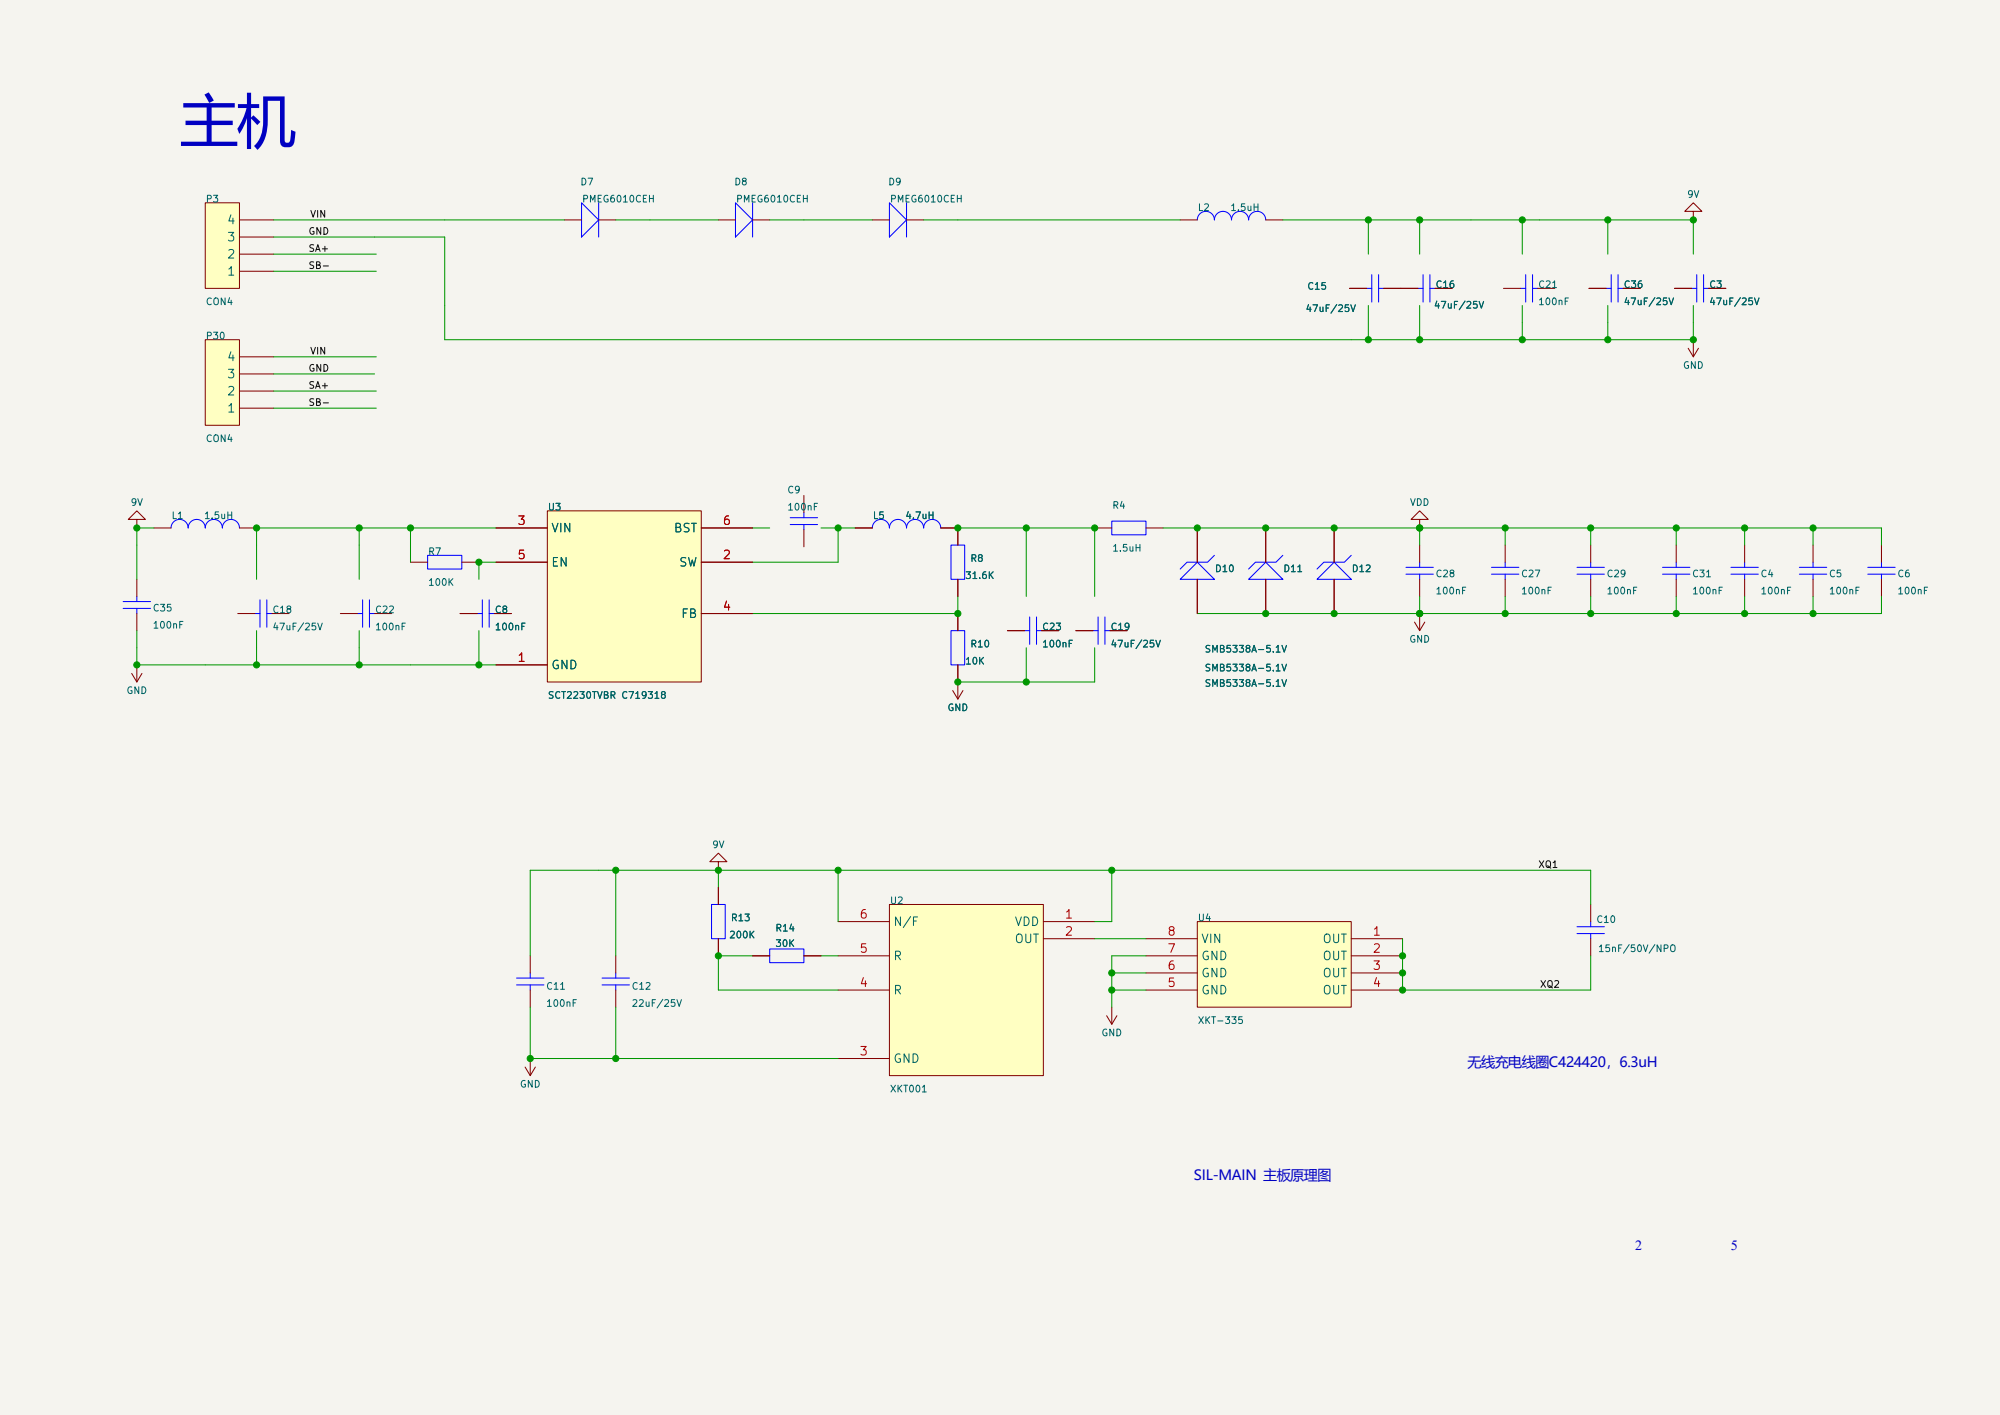
[picture p108: page 3]
