duanxuebin1998/cube/docs/07_硬件原理图/00_原始资料/S002-2026-V1.1.pdf

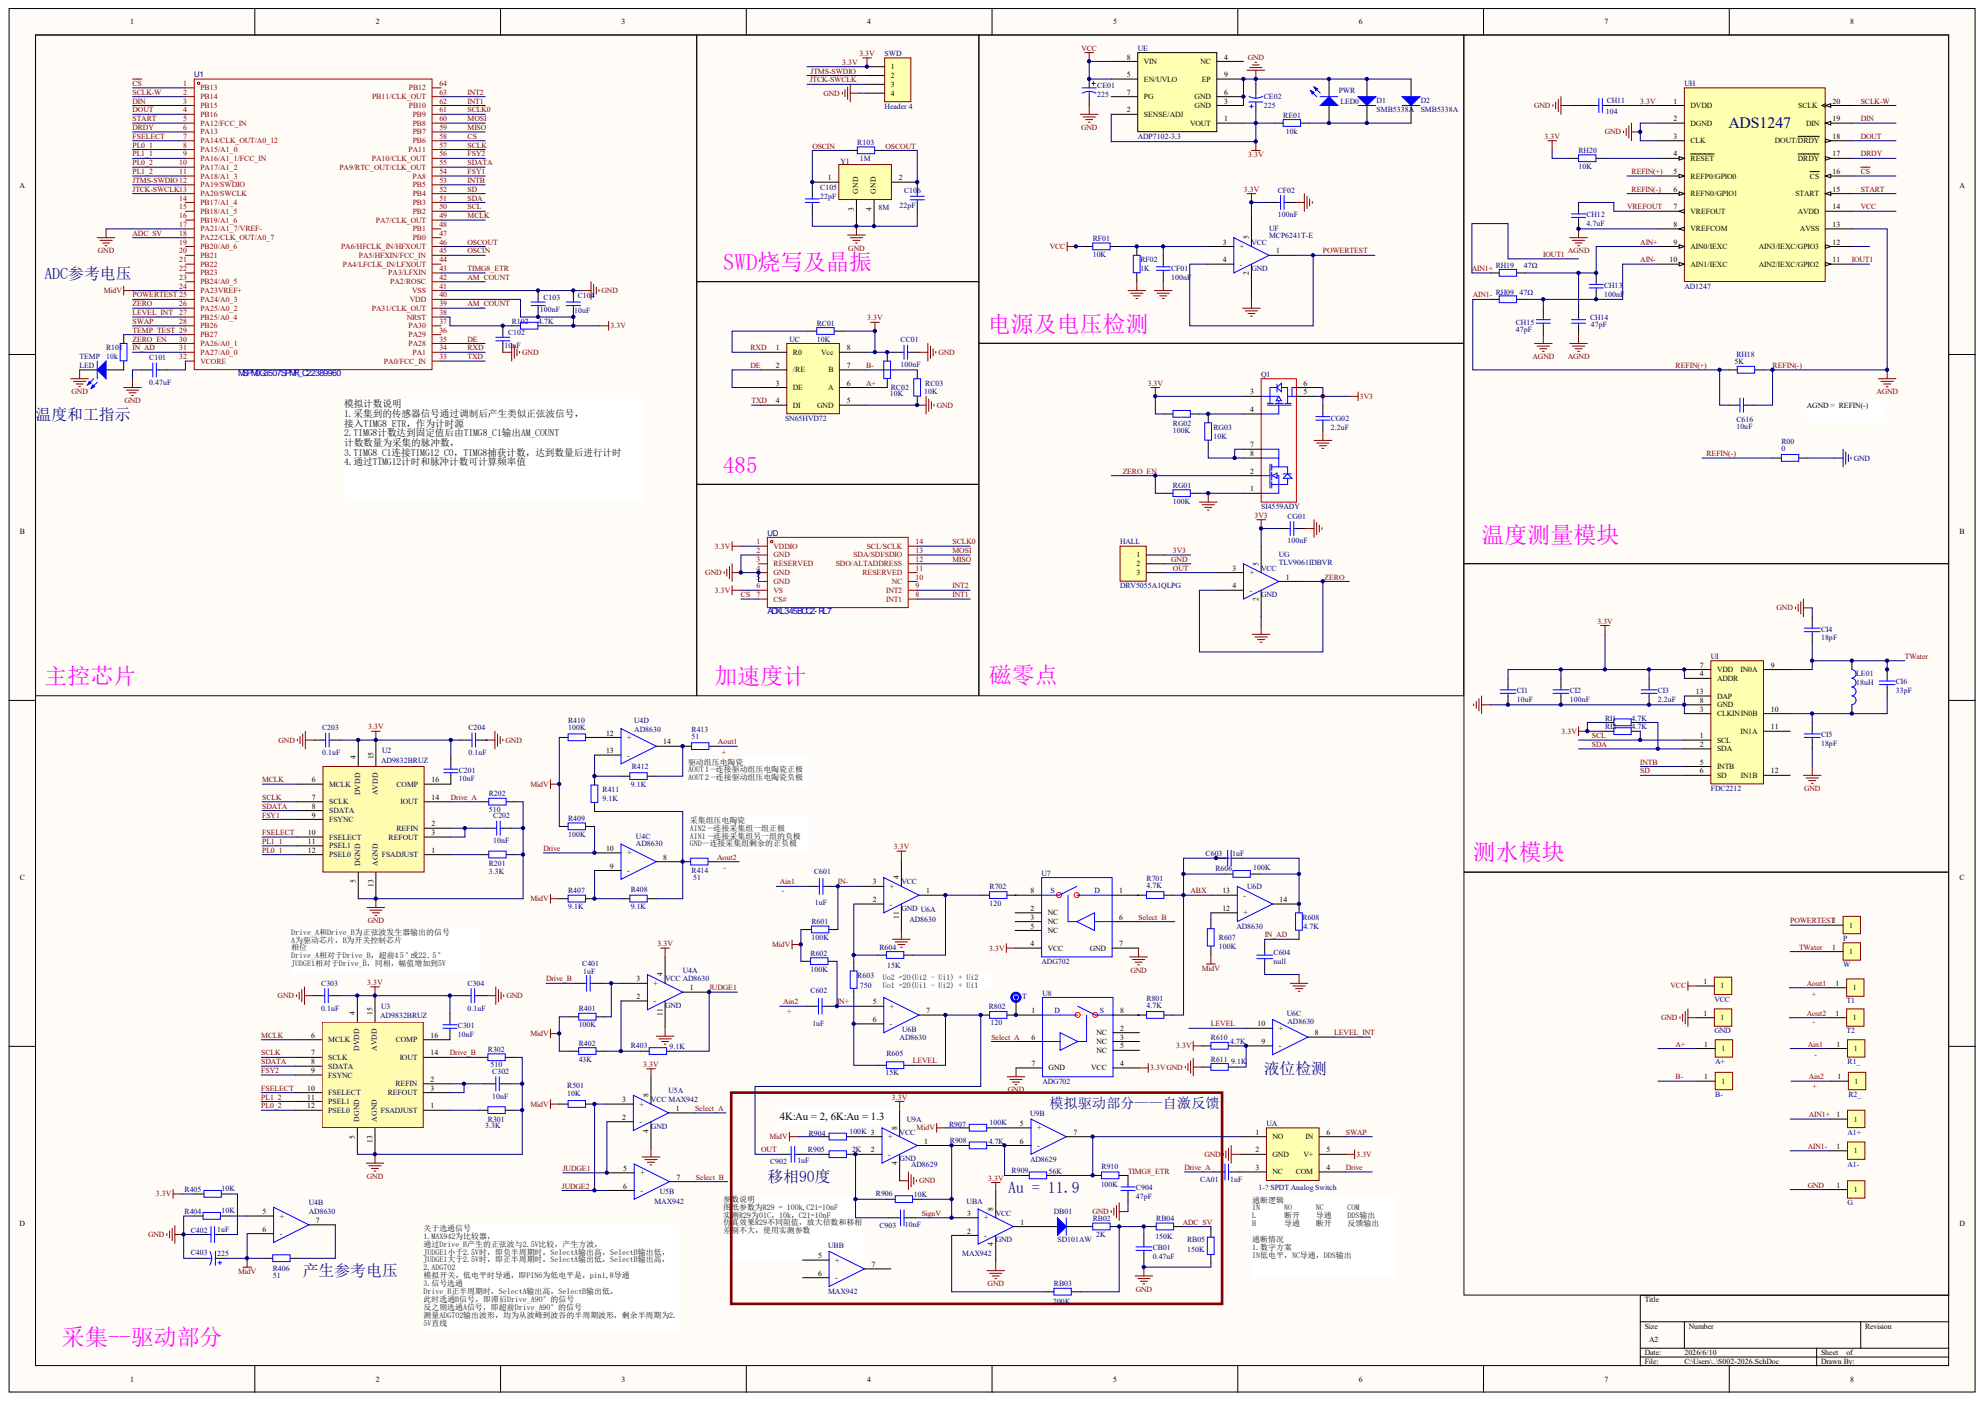
[picture p120: page 1]

3.信号选通
Drive_B正半周期时，SelectA输出高，SelectB输出低，
此时选通B信号，即滞后Drive_A90° 的信号 反之则选通A信号，即超前Drive_A90° 的信号 测量ADG702输出波形，均为从波峰到波谷的半周期波形，剩余半周期为2.
