duanxuebin1998/cube/docs/07_硬件原理图/00_原始资料/DM4四代数字驱动V6.0/DM4采集板V6.0.pdf

# 液位检测

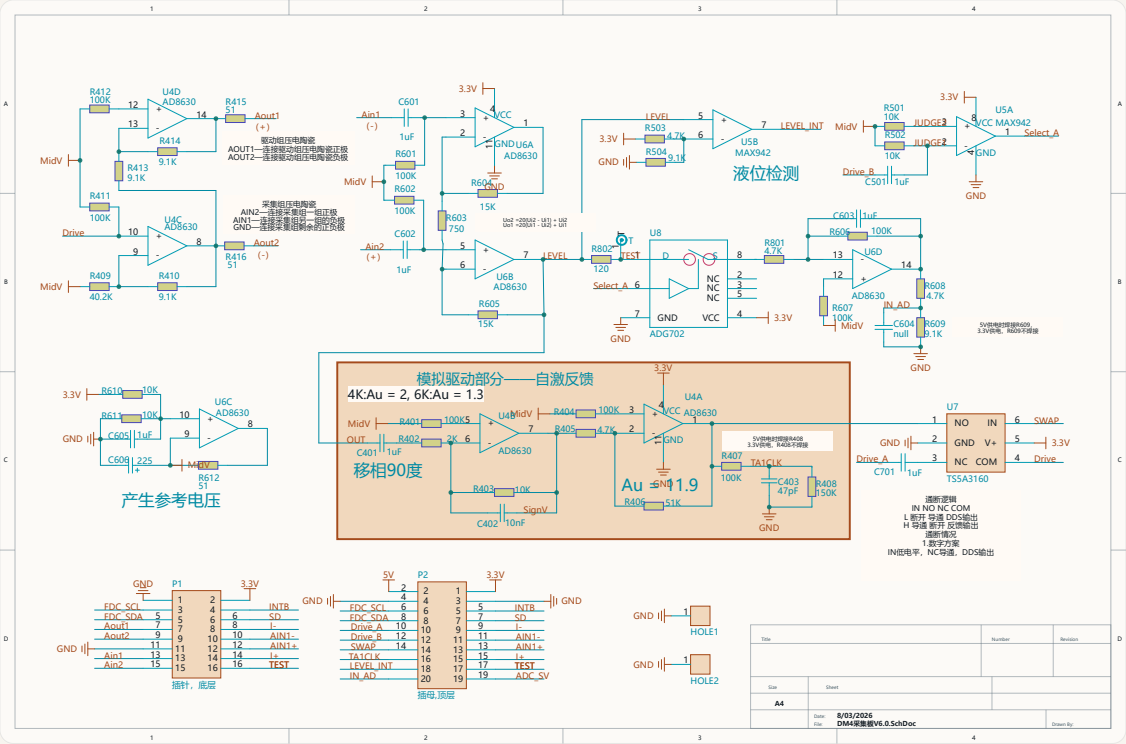
[picture p127: page 1]

通断逻辑
IN NO NC COM
L 断开 导通 DDS输出
H 导通 断开 反馈输出
通断情况
1.数字方案
