duanxuebin1998/cube/docs/07_硬件原理图/00_原始资料/DM4四代数字驱动V6.0/DM4驱动板V6.0.pdf

# ADS1247

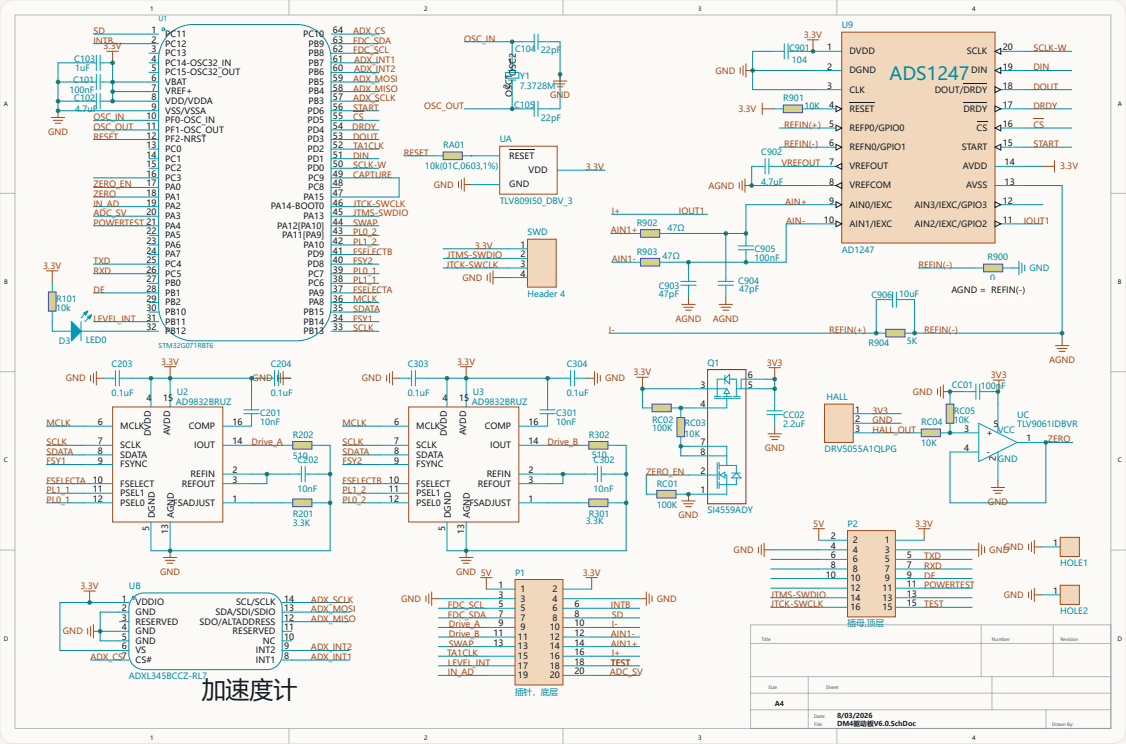
[picture p128: page 1]
