duanxuebin1998/cube/LTD_DISPLAY_CPU3/Core/Src/main.c

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
/* Includes ------------------------------------------------------------------*/
#include "main.h"
#include "crc.h"
#include "dma.h"
#include "iwdg.h"
#include "spi.h"
#include "tim.h"
#include "usart.h"
#include "gpio.h"

/* USER CODE BEGIN Includes */
#include "app_main.h"
/* USER CODE END Includes */


void SystemClock_Config(void);
/* USER CODE BEGIN 0 */
static HAL_StatusTypeDef Cpu3_SystemClockOscConfig(RCC_OscInitTypeDef *osc_config)
{
  HAL_StatusTypeDef status;

  status = HAL_RCC_OscConfig(osc_config);
  if ((status != HAL_OK) &&
      ((osc_config->OscillatorType & RCC_OSCILLATORTYPE_LSE) != 0U) &&
      (osc_config->LSEState != RCC_LSE_OFF)) {
    osc_config->OscillatorType &= ~RCC_OSCILLATORTYPE_LSE;
    osc_config->LSEState = RCC_LSE_OFF;
    status = HAL_RCC_OscConfig(osc_config);
  }

  return status;
}

#define HAL_RCC_OscConfig Cpu3_SystemClockOscConfig

/* USER CODE END 0 */

/**
  * @brief  The application entry point.
  * @retval int
  */
int main(void)
{

  /* MCU Configuration--------------------------------------------------------*/

  /* Reset of all peripherals, Initializes the Flash interface and the Systick. */
  HAL_Init();

  /* Configure the system clock */
  SystemClock_Config();

  /* Initialize all configured peripherals */
  MX_GPIO_Init();
  MX_DMA_Init();
  MX_USART1_UART_Init();
  MX_SPI1_Init();
  MX_TIM1_Init();
  MX_TIM2_Init();
  MX_TIM3_Init();
  MX_UART5_Init();
  MX_CRC_Init();
  MX_USART3_UART_Init();
  MX_USART2_UART_Init();
  MX_USART6_UART_Init();
  MX_TIM4_Init();
  MX_IWDG_Init();
  MX_SPI4_Init();
  /* USER CODE BEGIN 2 */
  App_Init();
  /* USER CODE END 2 */

  /* Infinite loop */
  /* USER CODE BEGIN WHILE */
  while (1) {
    App_MainLoop();
    /* USER CODE END WHILE */

    /* USER CODE BEGIN 3 */
    }
  /* USER CODE END 3 */
}

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
