duanxuebin1998/cube/LTD_MAIN_CPU2/Services/ParamStorage/system_parameter.c

/*
 * system_parameter.c
 *
 *  Created on: Feb 27, 2025
 *      Author: Duan Xuebin
 *
 * 说明:
 *  - DeviceParameters 中 command 仅用于command，不参与掉电参数校验
 *  - 从 sensorType 开始到 crc 之前的区域为持久化参数区
 */

#include "system_parameter.h"
#include "error_log.h"
#include "app_version.h"
#include "mb85rs2m.h"
#include "my_crc.h"
#include "Relay/relay_alarm_config.h"
#include "main.h"
#include "stateformodbus.h"
#include <stdint.h>
#include <string.h>
#include <stdio.h>
#include <stddef.h> /* offsetof */

volatile MeasurementResult g_measurement = {0};   /* 测量结果 */
volatile DeviceParameters  g_deviceParams = {0};  /* 设备参数 */
static volatile uint8_t g_device_params_save_pending = 0; /* Deferred save request flag */
/* 参数保存失败后的剩余自动重试次数，由前台有界递减。 */
static volatile uint8_t g_device_params_save_retry_count = 0U; /* Deferred save retry count */
static volatile uint32_t g_device_params_save_request_tick = 0; /* Last deferred save request tick */
static volatile uint8_t g_device_params_write_snapshot_valid = 0U; /* 写参前快照是否有效。 */
static volatile uint8_t g_device_params_factory_restore_in_progress = 0U; /* 恢复出厂覆盖整套参数期间关闭并发写入口。 */
static DeviceParameters g_device_params_write_snapshot; /* 写参前快照，供主循环延后打印差异。 */
/* 最近一次成功装载参数的来源标签，用于启动和迁移诊断日志。 */
static const char *g_device_params_last_load_source = "UNKNOWN";
#ifndef DEVICE_PARAMS_BOOT_FULL_PRINT_ENABLE
/* 上电后打印完整设备参数清单的编译开关；1 启用，仅用于启动诊断，打印不得位于中断上下文。 */
#define DEVICE_PARAMS_BOOT_FULL_PRINT_ENABLE 1U
#endif
/**
 * @brief 按事件选择完整参数、保存元数据或跳过保存摘要的输出方式。
 *
 * @param event 设备参数打印事件类型，决定日志标题和附加字段。
 * @param params 完整设备参数只读快照；包含版本、结构长度、测量与协议配置、AO、继电器以及 CRC 等持久字段，函数不会修改该快照。
 * @param reason 用于诊断输出的 NUL 结尾只读原因文字；该文字补充错误发生背景，不代替函数另行记录或返回的数值错误码。
 * @param source 用于参数保存诊断的 NUL 结尾来源标签；区分启动加载、命令保存、迁移或其它调用路径。
 */
static void print_device_params_event(DeviceParamPrintEvent event, const DeviceParameters *params, const char *reason, const char *source);
#define AO_NORMAL_CURRENT_MIN_MA_X100 400U /* AO正常输出电流最小值，单位0.01mA。 */
#define AO_NORMAL_CURRENT_MAX_MA_X100 2000U /* AO正常输出电流最大值，单位0.01mA。 */
#define AO_OUTPUT_CURRENT_MIN_MA_X100 320U /* AO特殊电流最小值，单位0.01mA。 */
#define AO_OUTPUT_CURRENT_MAX_MA_X100 2400U /* AO特殊电流最大值，单位0.01mA。 */

typedef struct {
    /* 命令参数原子快照；命令码、各参数值和独立代际一起复制，防止跨命令读取到混合数据。 */
    CommandType command; /* 本快照绑定的设备命令码。 */
    uint32_t values[DEVICE_COMMAND_ARG_COUNT]; /* 按 DeviceCommandArgumentField 索引保存的命令参数值数组。 */
    uint32_t generations[DEVICE_COMMAND_ARG_COUNT]; /* 各命令参数槽独立的更新代际副本；与参数值一起验证快照未被并发写入撕裂。 */
    uint8_t valid; /* 命令码、参数值和各代际前后一致、快照可以执行的标志。 */
} DeviceCommandArgumentSnapshot;

/* 串口或 Modbus 写入侧正在组装的命令参数快照。 */
static volatile DeviceCommandArgumentSnapshot g_pending_command_arguments;
/* 命令开始执行时锁存的参数快照，执行期间保持不变。 */
static DeviceCommandArgumentSnapshot g_active_command_arguments;
/* 各命令参数槽的更新代际，用于判定快照复制前后是否一致。 */
static volatile uint32_t g_command_argument_generations[DEVICE_COMMAND_ARG_COUNT];

/**
 * @brief 报告CPU2是否正在用出厂值整体覆盖运行参数。
 *
 * @details 调用场景：UART5 FC10在解析候选参数前判断七个命令参数能否写入。
 * @note 关键约束：只读取易失标志，不阻塞、不打印，可在UART5中断上下文调用。
 *
 * @return true 表示 CPU2 正在执行整份出厂参数覆盖，其他持久化写入应避让；false 表示当前没有恢复出厂事务。
 */
bool DeviceParams_IsFactoryRestoreInProgress(void)
{
    return g_device_params_factory_restore_in_progress != 0U;
}

/**
 * @brief 返回指定命令前置参数对应的共享保持寄存器起始地址。
 *
 * @param field 待查询或显示的字段枚举值。该枚举指定七个 CPU2 命令前置参数之一，用于计算位掩码并消费对应确认状态。
 * @return 返回按当前映射得到的指定命令前置参数对应的共享保持寄存器起始地址；非法输入使用 @brief 说明的兜底地址或无效值。
 */
static uint16_t DeviceCommandArguments_RegisterAddress(DeviceCommandArgumentField field)
{
    static const uint16_t addresses[DEVICE_COMMAND_ARG_COUNT] = {
        HOLDREGISTER_DEVICEPARAM_CALIBRATE_OIL_LEVEL,
        HOLDREGISTER_DEVICEPARAM_CALIBRATE_WATER_LEVEL,
        HOLDREGISTER_DEVICEPARAM_CALIBRATE_TANK_HEIGHT,
        HOLDREGISTER_DEVICEPARAM_SP_MEAS_POSITION,
        HOLDREGISTER_DEVICEPARAM_SP_MONITOR_POSITION,
        HOLDREGISTER_DEVICEPARAM_DENSITY_DISTRIBUTION_OIL_LEVEL,
        HOLDREGISTER_DEVICEPARAM_MOTOR_COMMAND_DISTANCE
    };

    return (field < DEVICE_COMMAND_ARG_COUNT) ? addresses[field] : HOLDREGISTER_AMOUNT;
}

/**
 * @brief 从运行参数读取指定命令前置参数。
 *
 * @param field 待查询或显示的字段枚举值。该枚举指定七个 CPU2 命令前置参数之一，用于计算位掩码并消费对应确认状态。
 * @return 返回指定命令当前保存的前置参数原始值；命令不需要或无法映射前置参数时返回 0。
 */
static uint32_t DeviceCommandArguments_ReadGlobal(DeviceCommandArgumentField field)
{
    switch (field) {
    case DEVICE_COMMAND_ARG_CALIBRATE_OIL_LEVEL:
        return g_deviceParams.calibrateOilLevel;
    case DEVICE_COMMAND_ARG_CALIBRATE_WATER_LEVEL:
        return g_deviceParams.calibrateWaterLevel;
    case DEVICE_COMMAND_ARG_CALIBRATE_TANK_HEIGHT:
        return g_deviceParams.calibrateTankHeight;
    case DEVICE_COMMAND_ARG_SINGLE_POINT_MEASUREMENT_POSITION:
        return g_deviceParams.singlePointMeasurementPosition;
    case DEVICE_COMMAND_ARG_SINGLE_POINT_MONITORING_POSITION:
        return g_deviceParams.singlePointMonitoringPosition;
    case DEVICE_COMMAND_ARG_DENSITY_DISTRIBUTION_OIL_LEVEL:
        return g_deviceParams.densityDistributionOilLevel;
    case DEVICE_COMMAND_ARG_MOTOR_COMMAND_DISTANCE:
        return g_deviceParams.motorCommandDistance;
    default:
        return 0U;
    }
}

/**
 * @brief 把指定值写回运行参数；调用方必须持有短临界区。
 *
 * @param field 待查询或显示的字段枚举值。该枚举指定七个 CPU2 命令前置参数之一，用于计算位掩码并消费对应确认状态。
 * @param value 命令写入使用的输入数值。
 */
static void DeviceCommandArguments_WriteGlobal(DeviceCommandArgumentField field, uint32_t value)
{
    switch (field) {
    case DEVICE_COMMAND_ARG_CALIBRATE_OIL_LEVEL:
        g_deviceParams.calibrateOilLevel = value;
        break;
    case DEVICE_COMMAND_ARG_CALIBRATE_WATER_LEVEL:
        g_deviceParams.calibrateWaterLevel = value;
        break;
    case DEVICE_COMMAND_ARG_CALIBRATE_TANK_HEIGHT:
        g_deviceParams.calibrateTankHeight = value;
        break;
    case DEVICE_COMMAND_ARG_SINGLE_POINT_MEASUREMENT_POSITION:
        g_deviceParams.singlePointMeasurementPosition = value;
        break;
    case DEVICE_COMMAND_ARG_SINGLE_POINT_MONITORING_POSITION:
        g_deviceParams.singlePointMonitoringPosition = value;
        break;
    case DEVICE_COMMAND_ARG_DENSITY_DISTRIBUTION_OIL_LEVEL:
        g_deviceParams.densityDistributionOilLevel = value;
        break;
    case DEVICE_COMMAND_ARG_MOTOR_COMMAND_DISTANCE:
        g_deviceParams.motorCommandDistance = value;
        break;
    default:
        break;
    }
}

/**
 * @brief 在已关闭中断的短临界区内，把当前七字段绑定到待执行命令。
 *
 * @param command 已被接受、准备执行的 CommandType 命令；七个前置参数将在同一临界区内与其绑定。
 */
static void DeviceCommandArguments_CapturePendingLocked(CommandType command)
{
    uint32_t index;

    g_pending_command_arguments.command = command;
    g_pending_command_arguments.valid = (command != CMD_NONE) ? 1U : 0U;
    for (index = 0U; index < DEVICE_COMMAND_ARG_COUNT; index++) {
        g_pending_command_arguments.values[index] =
            DeviceCommandArguments_ReadGlobal((DeviceCommandArgumentField)index);
        g_pending_command_arguments.generations[index] =
            g_command_argument_generations[index];
    }
}

/**
 * @brief 恢复出厂完成后重新发布期间已经ACK的最新待执行命令。
 *
 * @details 调用场景：整套默认参数保存完成、重新开放七字段写入口之前。
 * @note 关键约束：按最终出厂值重新绑定参数；重复恢复命令仍按不可自中断规则丢弃。
 */
static void DeviceCommandArguments_RebindAfterFactoryRestore(void)
{
    CommandType pending_command;
    uint32_t primask = __get_PRIMASK();

    __disable_irq();
    if (g_pending_command_arguments.valid != 0U) {
        pending_command = g_pending_command_arguments.command;
        if (pending_command == CMD_RESTORE_FACTORY) {
            g_pending_command_arguments.valid = 0U;
            if (g_deviceParams.command == CMD_RESTORE_FACTORY) {
                g_deviceParams.command = CMD_NONE;
            }
        } else {
            g_deviceParams.command = pending_command;
            DeviceCommandArguments_CapturePendingLocked(pending_command);
        }
    }
    __set_PRIMASK(primask);
}

/**
 * @brief 为本次成功写入涉及的命令前置参数递增逐字段代次。
 *
 * @details 调用场景：CPU2 FC10 候选参数全部校验通过并提交到 g_deviceParams 后。
 * @note 关键约束：同值写入也必须递增，防止当前命令收尾清零覆盖下一次同值请求。
 *
 * @param start 本次连续处理范围的起始索引。该值是 CPU2 共享保持寄存器写区间的起始地址，用于记录七个命令前置参数的覆盖掩码。
 * @param count 参与本次处理的数据项数量。
 */
void DeviceCommandArguments_RecordWrite(uint16_t start, uint16_t count)
{
    uint32_t index;
    uint32_t primask = __get_PRIMASK();

    __disable_irq();
    for (index = 0U; index < DEVICE_COMMAND_ARG_COUNT; index++) {
        uint16_t address =
            DeviceCommandArguments_RegisterAddress((DeviceCommandArgumentField)index);
        if (LtdModbus_RangeContains(start, count, address, REG_STRIDE)) {
            g_command_argument_generations[index]++;
        }
    }
    __set_PRIMASK(primask);
}

/**
 * @brief 把当前七字段与已经接受的待执行命令原子绑定。
 *
 * @details 调用场景：Modbus 命令寄存器写入成功后。
 * @note 关键约束：只更新 pending 快照，不得覆盖正在执行命令的 active 快照。
 *
 * @param command 已被接受、准备执行的 CommandType 命令；函数原子捕获并绑定当前七个前置参数。
 */
void DeviceCommandArguments_CapturePending(CommandType command)
{
    uint32_t primask = __get_PRIMASK();

    __disable_irq();
    DeviceCommandArguments_CapturePendingLocked(command);
    __set_PRIMASK(primask);
}

/**
 * @brief 由 CPU2 内部路径入队正式命令并同步绑定当前七字段。
 *
 * @details 调用场景：上电默认命令、串口命令和业务内部续接命令。
 * @note 关键约束：命令值和参数快照在同一短临界区发布。
 *
 * @param command 准备写入内部待执行槽的正式 CommandType 命令。
 */
void DeviceCommand_Queue(CommandType command)
{
    uint32_t primask = __get_PRIMASK();

    __disable_irq();
    g_deviceParams.command = command;
    DeviceCommandArguments_CapturePendingLocked(command);
    __set_PRIMASK(primask);
}

/**
 * @brief 原子判断是否存在能够切换当前流程的新命令。
 *
 * @details 调用场景：阻塞测量、传感器通信和电机等待循环的既有退出检查。
 * @note 关键约束：保持原自中断白名单和重复命令规则，只防止条件清零覆盖并发到达的新命令。
 *
 * @return true 表示当前 pending 命令满足切换条件，正在运行的可打断流程应退出；false 表示没有待执行命令，或待命令与当前命令重复且不在自打断白名单。
 */
bool HasEffectiveCommandSwitchRequest(void)
{
    CommandType pending_command;
    CommandType current_command;
    uint32_t primask = __get_PRIMASK();
    bool switch_requested = false;

    __disable_irq();
    pending_command = g_deviceParams.command;
    current_command = g_measurement.device_status.current_command;
    if (pending_command != CMD_NONE) {
        if ((current_command != CMD_NONE) &&
            (pending_command == current_command) &&
            !IsSelfInterruptibleCommand(current_command)) {
            g_deviceParams.command = CMD_NONE;
            if ((g_pending_command_arguments.valid != 0U) &&
                (g_pending_command_arguments.command == pending_command)) {
                g_pending_command_arguments.valid = 0U;
            }
        } else {
            switch_requested = true;
        }
    } else if (new_command_ready != 0U) {
        switch_requested = true;
    }
    __set_PRIMASK(primask);
    return switch_requested;
}

/**
 * @brief 在已关闭中断的短临界区内，把匹配的 pending 参数提升为 active 参数。
 *
 * @param command 主循环即将执行的 CommandType 命令；只有与 pending 绑定命令一致时才提升参数快照。
 */
static void DeviceCommandArguments_ActivatePendingLocked(CommandType command)
{
    uint32_t index;
    uint8_t pending_matches =
        ((g_pending_command_arguments.valid != 0U) &&
         (g_pending_command_arguments.command == command)) ? 1U : 0U;

    g_active_command_arguments.command = command;
    g_active_command_arguments.valid = 1U;
    for (index = 0U; index < DEVICE_COMMAND_ARG_COUNT; index++) {
        if (pending_matches != 0U) {
            g_active_command_arguments.values[index] =
                g_pending_command_arguments.values[index];
            g_active_command_arguments.generations[index] =
                g_pending_command_arguments.generations[index];
        } else {
            g_active_command_arguments.values[index] =
                DeviceCommandArguments_ReadGlobal((DeviceCommandArgumentField)index);
            g_active_command_arguments.generations[index] =
                g_command_argument_generations[index];
        }
    }
    if (pending_matches != 0U) {
        g_pending_command_arguments.valid = 0U;
    }
}

/**
 * @brief 原子取走一个待执行正式命令，并同步把其 pending 参数提升为 active 参数。
 *
 * @details 调用场景：主循环在原始串口命令分支之后、自动恢复分支之前调用。
 * @note 关键约束：命令读取、条件清零和参数提升位于同一短临界区；不消费其它命令的 pending 快照。
 *
 * @param command 命令输出指针；成功取队列时写入待执行 CommandType，队列为空时保持调用方原值。
 * @return true 表示已原子取走一项 pending 正式命令，并把对应 pending 参数提升为 active 参数；false 表示输出指针为空或当前没有待执行命令。
 */
bool DeviceCommand_TakePending(CommandType *command)
{
    CommandType captured_command;
    uint32_t primask;

    if (command == NULL) {
        return false;
    }
    primask = __get_PRIMASK();
    __disable_irq();
    captured_command = g_deviceParams.command;
    if (captured_command == CMD_NONE) {
        __set_PRIMASK(primask);
        return false;
    }

    g_deviceParams.command = CMD_NONE;
    DeviceCommandArguments_ActivatePendingLocked(captured_command);
    g_measurement.device_status.current_command = captured_command;
    *command = captured_command;
    __set_PRIMASK(primask);
    return true;
}

/**
 * @brief 在自动恢复重试与最后时刻到达的正式命令之间做一次原子仲裁。
 *
 * 调用场景：FaultRecovery_Poll 决定重试后、主循环真正执行命令前。
 *
 * @param retry_command 命令。
 * @param selected_command 用于返回恢复流程最终选择执行的设备命令。
 * @return true 表示选中了新的 pending 命令，false 表示继续自动重试。
 * @note 关键约束：有 pending 时保持正式命令优先；否则复用原 active 参数，并在同一临界区发布 current_command。
 */
bool DeviceCommand_PrepareRecoveryExecution(CommandType retry_command,
                                            CommandType *selected_command)
{
    CommandType pending_command;
    uint32_t primask;
    bool pending_selected = false;

    if (selected_command == NULL) {
        return false;
    }
    primask = __get_PRIMASK();
    __disable_irq();
    pending_command = g_deviceParams.command;
    if (pending_command != CMD_NONE) {
        g_deviceParams.command = CMD_NONE;
        DeviceCommandArguments_ActivatePendingLocked(pending_command);
        *selected_command = pending_command;
        pending_selected = true;
    } else {
        if ((g_active_command_arguments.valid == 0U) ||
            (g_active_command_arguments.command != retry_command)) {
            DeviceCommandArguments_ActivatePendingLocked(retry_command);
        }
        *selected_command = retry_command;
    }
    g_measurement.device_status.current_command = *selected_command;
    __set_PRIMASK(primask);
    return pending_selected;
}

/**
 * @brief 返回当前命令绑定的参数值；非命令上下文返回最新全局值。
 *
 * @details 调用场景：测量、标定和电机业务消费七个前置参数时。
 * @note 关键约束：只有 active 命令与 current_command 一致时才读取快照。
 *
 * @param field 待读取的命令参数字段枚举；必须小于 DEVICE_COMMAND_ARG_COUNT。
 * @return field 越界时返回 0；活动命令快照与 current_command 一致时返回冻结参数值，否则返回对应字段的最新全局参数值。
 */
uint32_t DeviceCommandArguments_Get(DeviceCommandArgumentField field)
{
    if (field >= DEVICE_COMMAND_ARG_COUNT) {
        return 0U;
    }
    if ((g_active_command_arguments.valid != 0U) &&
        (g_active_command_arguments.command ==
         g_measurement.device_status.current_command)) {
        return g_active_command_arguments.values[field];
    }
    return DeviceCommandArguments_ReadGlobal(field);
}

/**
 * @brief 消费一次性参数后仅在该字段未被后续写入时清零全局值。
 *
 * @details 调用场景：油位或水位标定完成后的原有清零位置。
 * @note 关键约束：后续同值写入也由逐字段代次识别，不能被当前命令收尾误清。
 *
 * @param field 待查询或显示的字段枚举值。该枚举指定七个 CPU2 命令前置参数之一，用于计算位掩码并消费对应确认状态。
 */
void DeviceCommandArguments_ClearIfUnchanged(DeviceCommandArgumentField field)
{
    uint32_t primask;
    uint8_t active_matches;

    if (field >= DEVICE_COMMAND_ARG_COUNT) {
        return;
    }
    primask = __get_PRIMASK();
    __disable_irq();
    active_matches =
        ((g_active_command_arguments.valid != 0U) &&
         (g_active_command_arguments.command ==
          g_measurement.device_status.current_command)) ? 1U : 0U;
    if ((active_matches == 0U) ||
        ((g_command_argument_generations[field] ==
          g_active_command_arguments.generations[field]) &&
         (DeviceCommandArguments_ReadGlobal(field) ==
          g_active_command_arguments.values[field]))) {
        DeviceCommandArguments_WriteGlobal(field, 0U);
        g_command_argument_generations[field]++;
    }
    __set_PRIMASK(primask);
}
/**
 * @brief 将继电器报警输出枚举值转换成中文打印文本，便于现场调试查看。
 *
 * @param value 待转换为现场可读文字的枚举值。
 * @return 返回继电器报警输出枚举值转换成中文打印文本，便于现场调试查看对应的只读文本首地址；内容由当前输入或语言配置选择，调用方不得修改或释放。
 */
static const char * relay_operating_mode_str(uint32_t value)
{
    switch ((RelayAlarmOperatingMode)value) {
    case RELAY_ALARM_OPERATING_DISABLED:
        return "禁用";
    case RELAY_ALARM_OPERATING_OUTPUT_PASSIVE:
        return "无源输出";
    default:
        return "未定义";
    }
}

/**
 * @brief 返回继电器数字源枚举对应的中文名称。
 *
 * @param value 待转换为现场可读文字的枚举值。
 * @return 返回继电器数字源枚举对应的中文名称对应的只读文本首地址；内容由当前输入或语言配置选择，调用方不得修改或释放。
 */
static const char * relay_digital_source_str(uint32_t value)
{
    switch ((RelayAlarmDigitalSource)value) {
    case RELAY_ALARM_DIGITAL_NONE:
        return "无";
    case RELAY_ALARM_DIGITAL_H:
        return "高报";
    case RELAY_ALARM_DIGITAL_HH:
        return "高高报";
    case RELAY_ALARM_DIGITAL_H_OR_HH:
        return "高报或高高报";
    case RELAY_ALARM_DIGITAL_L:
        return "低报";
    case RELAY_ALARM_DIGITAL_LL:
        return "低低报";
    case RELAY_ALARM_DIGITAL_L_OR_LL:
        return "低报或低低报";
    case RELAY_ALARM_DIGITAL_ANY:
        return "任意报警";
    default:
        return "未定义";
    }
}

/**
 * @brief 把继电器触点类型转换为调试打印文字。
 *
 * @param value 待转换为现场可读文字的枚举值。
 * @return 返回调试打印文字对应的只读文本首地址；内容由当前输入或语言配置选择，调用方不得修改或释放。
 */
static const char * relay_contact_type_str(uint32_t value)
{
    switch ((RelayAlarmContactType)value) {
    case RELAY_ALARM_CONTACT_NORMALLY_OPEN:
        return "常开";
    case RELAY_ALARM_CONTACT_NORMALLY_CLOSED:
        return "常闭";
    default:
        return "未定义";
    }
}

/**
 * @brief 把继电器报警模式转换为调试打印文字。
 *
 * @param value 本次报警门限判断使用的实时输入值。
 * @return 返回调试打印文字对应的只读文本首地址；内容由当前输入或语言配置选择，调用方不得修改或释放。
 */
static const char * relay_alarm_mode_str(uint32_t value)
{
    switch ((RelayAlarmMode)value) {
    case RELAY_ALARM_MODE_OFF:
        return "关";
    case RELAY_ALARM_MODE_ON:
        return "开";
    case RELAY_ALARM_MODE_LATCHING:
        return "锁存";
    default:
        return "未定义";
    }
}

/**
 * @brief 返回继电器报警源枚举对应的中文名称。
 *
 * @param value 本次报警门限判断使用的实时输入值。
 * @return 返回继电器报警源枚举对应的中文名称对应的只读文本首地址；内容由当前输入或语言配置选择，调用方不得修改或释放。
 */
static const char * relay_alarm_source_str(uint32_t value)
{
    switch ((RelayAlarmSource)value) {
    case RELAY_ALARM_SOURCE_TANK_LEVEL:
        return "储罐液位";
    case RELAY_ALARM_SOURCE_LIQUID_TEMP:
        return "液相温度";
    case RELAY_ALARM_SOURCE_WATER_LEVEL:
        return "水位";
    case RELAY_ALARM_SOURCE_DISPLACER_POS:
        return "浮子位置";
    case RELAY_ALARM_SOURCE_NONE:
        return "无";
    default:
        return "未定义";
    }
}

/**
 * @brief 返回继电器错误动作枚举对应的中文名称。
 *
 * @param value 待转换为现场可读文字的枚举值。
 * @return 返回继电器错误动作枚举对应的中文名称对应的只读文本首地址；内容由当前输入或语言配置选择，调用方不得修改或释放。
 */
static const char * relay_error_value_str(uint32_t value)
{
    switch ((RelayAlarmErrorValue)value) {
    case RELAY_ALARM_ERROR_NO_ALARM:
        return "无报警";
    case RELAY_ALARM_ERROR_HH_H:
        return "高高/高";
    case RELAY_ALARM_ERROR_H:
        return "高";
    case RELAY_ALARM_ERROR_L:
        return "低";
    case RELAY_ALARM_ERROR_LL_L:
        return "低低/低";
    case RELAY_ALARM_ERROR_ALL_ALARMS:
        return "全部报警";
    default:
        return "未定义";
    }
}

/**
 * @brief 将继电器清锁存命令转换成中文打印文本。
 *
 * @param value 本次报警门限判断使用的实时输入值。
 * @return 返回继电器清锁存命令转换成中文打印文本对应的只读文本首地址；内容由当前输入或语言配置选择，调用方不得修改或释放。
 */
static const char * relay_clear_alarm_str(uint32_t value)
{
    switch (value) {
    case RELAY_ALARM_CLEAR_NO:
        return "否";
    case RELAY_ALARM_CLEAR_YES:
        return "是";
    default:
        return "未定义";
    }
}
/**
 * @brief 将继电器报警阈值的 32 位原始位模式还原为单精度浮点数。
 *
 * @param raw 旧设备参数中继电器报警值的 IEEE 754 Float32 原始 32 位位模式。
 * @return 返回与 raw 的 32 位 IEEE 754 位模式完全一致的 float 数值；不执行缩放或范围修正。
 */
static float relay_alarm_raw_to_float(uint32_t raw)
{
    float value;
    /* 按原始位转换 IEEE754 float，避免字段打印改变协议解释口径。 */
    memcpy(&value, &raw, sizeof(value));
    return value;
}

#ifndef DEVICE_PARAMS_SAVE_DEBOUNCE_MS
#define DEVICE_PARAMS_SAVE_DEBOUNCE_MS 100u /* 参数存储配置：设备 PARAMS 保存 DEBOUNCE 毫秒。 */
#endif
/* 主循环延后保存连续失败上限；到达3次后清待处理标志并保留存储故障码。 */
#define DEVICE_PARAMS_SAVE_DEFERRED_RETRY_LIMIT 3U

/* param_version和 magic 常量 */
#define DEVICE_PARAM_VERSION   (3u) /* 参数存储配置：设备 参数 版本。 */
#define DEVICE_PARAM_MAGIC     (0x4C54444Du)  /* 'LTDM' */
#define DENSITY_X100_PROTOCOL_VERSION (13u) /* 密度参数从协议13开始按 x100 存储。 */

/*
 * 持久化区域说明:
 *  - command 不参与掉电参数校验
 *  - 从 sensorType 起到 crc 前为持久化参数区
 */
#define DEVICE_PARAM_PERSIST_OFFSET   (offsetof(DeviceParameters, sensorType)) /* 参数结构中参与持久化校验的起始偏移。 */
#define DEVICE_PARAM_PERSIST_LEN      (offsetof(DeviceParameters, crc) - DEVICE_PARAM_PERSIST_OFFSET) /* 参数结构中参与持久化校验的字节长度。 */
#define DEVICE_PARAM_PERSIST_START(p) ((uint8_t *)(p) + DEVICE_PARAM_PERSIST_OFFSET) /* 参数存储配置：设备 参数 持久化 启动。 */

/**
 * @brief 把继电器浮点报警阈值转换为 32 位原始位模式。
 *
 * @param value 本次报警门限判断使用的实时输入值。
 * @return 返回转换后的 IEEE 754 单精度位模式或浮点值；转换保持原始 32 位，不进行数值缩放。
 */
static uint32_t relay_alarm_float_to_raw(float value)
{
    uint32_t raw;
    /* 将继电器报警浮点阈值按 IEEE-754 Float32 原始位模式保存为 uint32_t，避免数值强转改变小数含义。 */
    memcpy(&raw, &value, sizeof(raw));
    return raw;
}

/* ========================= 参数存储逻辑 ========================= */

/**
 * @brief 根据持久化区计算crc（不含command和crc字段）。
 *
 * @param params 完整设备参数只读快照；包含版本、结构长度、测量与协议配置、AO、继电器以及 CRC 等持久字段，函数不会修改该快照。
 * @return 返回设备参数持久化区域按冻结范围计算的 CRC32，不包含运行命令和 crc 字段本身。
 */
static uint32_t device_param_crc(const DeviceParameters *params)
{
    const uint8_t *crc_base = DEVICE_PARAM_PERSIST_START(params);
    const uint32_t crc_size = (uint32_t)DEVICE_PARAM_PERSIST_LEN;
    return CRC32_HAL((const uint8_t *)crc_base, crc_size);
}

/**
 * @brief 清除四路继电器的瞬时锁存清除命令。
 *
 * @param params 待清除运行态瞬时命令的 DeviceParameters 可写对象；函数只把四路继电器 clear_alarm 字段复位，不修改其它持久配置。
 */
static void clear_relay_alarm_runtime_commands(DeviceParameters *params)
{
    for (uint32_t channel = 0U; channel < RELAY_ALARM_CHANNEL_COUNT; channel++) {
        params->relayAlarm[channel].clear_alarm = RELAY_ALARM_CLEAR_NO;
    }
}
#define MOTOR_LOCAL_CIRC_MIN_001MM  (50000u)    /* 50.000mm，和motor_count_first_loop_circumference_mm模型下限保持一致 */
#define MOTOR_LOCAL_CIRC_MAX_001MM  (5000000u)  /* 5000.000mm，防止旧 reserved 脏值被当成有效周长 */
#define MOTOR_LOCAL_CIRC_FALLBACK_001MM (600000u) /* 默认 600.000mm，用于first_loop_circumference_mm本身也异常时兜底 */
#define ENCODER_WHEEL_CIRC_FALLBACK_001MM (95000u) /* 默认95.000mm；当前机械规格尚未定义可靠上下限。 */

/**
 * @brief 根据首圈周长生成电机本地周长默认值，并对旧参数脏值执行范围兜底。
 *
 * @return 返回由首圈周长换算并限制后的电机本地周长默认值，单位 0.001 mm。
 */
static uint32_t device_params_default_motor_local_circ_001mm(void)
{
    uint32_t value = g_deviceParams.first_loop_circumference_mm * 100U;

    if ((value < MOTOR_LOCAL_CIRC_MIN_001MM) ||
        (value > MOTOR_LOCAL_CIRC_MAX_001MM)) {
        value = MOTOR_LOCAL_CIRC_FALLBACK_001MM;
    }
    return value;
}

/**
 * @brief 把旧参数存储中的无符号密度 x10 定点值迁移为当前 x100 定点值。
 *
 * 输入 0 保持为 0；其他值乘以 DENSITY_PARAM_MIGRATE_FACTOR，乘法超出 uint32_t 范围时饱和为 UINT32_MAX。
 *
 * @param raw 旧参数存储中的无符号密度 x10 定点值。
 * @return raw 为 0 时返回 0；可表示时返回 raw 乘以 10 的 x100 定点值，乘法溢出时返回 UINT32_MAX。
 * @note 该函数只执行倍率迁移，不解释具体密度字段的业务上下限。
 */
static uint32_t density_param_scale_x10_to_x100(uint32_t raw)
{
    if (raw == 0U) {
        return 0U;
    }
    if (raw > (0xFFFFFFFFUL / DENSITY_PARAM_MIGRATE_FACTOR)) {
        return 0xFFFFFFFFUL;
    }
    return raw * DENSITY_PARAM_MIGRATE_FACTOR;
}

/**
 * @brief 以旧基准值为中心将密度修正量从 x10 换算为 x100。
 *
 * @param raw 旧参数存储中的密度修正 x10 编码，以 DENSITY_CORRECTION_OLD_BASE_RAW 为零点。
 * @return 返回以当前修正零点为基准的 x100 编码；由旧 x10 编码换算后小于 0 时返回 0，超过 uint32_t 范围时返回 UINT32_MAX。
 */
static uint32_t density_correction_scale_x10_to_x100(uint32_t raw)
{
    int64_t delta = (int64_t)raw - (int64_t)DENSITY_CORRECTION_OLD_BASE_RAW;
    int64_t value = (int64_t)DENSITY_CORRECTION_BASE_RAW +
                    (delta * (int64_t)DENSITY_PARAM_MIGRATE_FACTOR);

    if (value < 0) {
        return 0U;
    }
    if (value > 0xFFFFFFFFLL) {
        return 0xFFFFFFFFUL;
    }
    return (uint32_t)value;
}

/**
 * @brief 当 protocolVersion 小于 13 时，将密度目标、阈值、滞回量和修正量从 x10 迁移为 x100。
 *
 * @return 1 表示旧协议密度参数已从 x10 迁移为 x100；无需迁移时返回 0。
 */
static int migrate_density_params_runtime(void)
{
    if (g_deviceParams.protocolVersion >= DENSITY_X100_PROTOCOL_VERSION) {
        return 0;
    }

    g_deviceParams.oilLevelDensity = density_param_scale_x10_to_x100(g_deviceParams.oilLevelDensity);
    g_deviceParams.oilLevelThreshold = density_param_scale_x10_to_x100(g_deviceParams.oilLevelThreshold);
    g_deviceParams.oilLevelHysteresisThreshold = density_param_scale_x10_to_x100(g_deviceParams.oilLevelHysteresisThreshold);
    g_deviceParams.densityCorrection = density_correction_scale_x10_to_x100(g_deviceParams.densityCorrection);
    return 1;
}
/**
 * @brief 用当前 CPU2 固件版本覆盖 FRAM 中的历史软件版本。
 *
 * @return 1 表示 FRAM 中的软件版本已更新为当前 CPU2 固件版本；原值一致时返回 0。
 */
static int apply_firmware_version_runtime(void)
{
    if (g_deviceParams.softwareVersion == CPU2_APP_VERSION_U32) {
        return 0;
    }

    g_deviceParams.softwareVersion = CPU2_APP_VERSION_U32;
    return 1;
}
/**
 * @brief 协议版本固定由当前固件维护。
 *
 * 旧程序没有该语义，原reserved1位置默认为0；新程序统一写入当前协议，供CPU3判断共享数据能力。
 *
 * @return 1 表示 FRAM 中的协议版本已更新为当前固件版本；原值一致时返回 0。
 */
static int apply_protocol_version_runtime(void)
{
    uint32_t old_protocol = g_deviceParams.protocolVersion;

    if (old_protocol == DEVICE_PROTOCOL_VERSION) {
        return 0;
    }

    if ((old_protocol < 10U) || (old_protocol > DEVICE_PROTOCOL_VERSION)) {
        g_deviceParams.bottom_encoder_correction_tank_height = 0U;
        g_deviceParams.fault_auto_recovery_retry_limit = FAULT_AUTO_RECOVERY_RETRY_DEFAULT;
    }

    if ((old_protocol < 14U) || (old_protocol > DEVICE_PROTOCOL_VERSION)) {
        g_deviceParams.si_profile_first_point = 5000U;
        g_deviceParams.si_profile_increment = 10000U;
        g_deviceParams.si_profile_dwell_time = 10U;
        g_deviceParams.si_profile_bottom_detect_interval = 1U;
    }

    if ((old_protocol < 25U) || (old_protocol > DEVICE_PROTOCOL_VERSION)) {
        /* 协议25首次赋予reserved3水位滞后时间语义，旧槽位不得直接作为有效秒数。 */
        g_deviceParams.water_level_hysteresis_time_s = 0U;
    }
    /* 协议36复用两个保留槽；历史值不能解释为已启用刷新，升级不清除其它现场参数。 */
    if ((old_protocol < 36U) || (old_protocol > DEVICE_PROTOCOL_VERSION)) {
        g_deviceParams.liquidLevelReferenceRefreshEnable = 0U;
        g_deviceParams.liquidLevelReferenceRefreshIntervalMin = 1440U;
    }
    g_deviceParams.protocolVersion = DEVICE_PROTOCOL_VERSION;
    return 1;
}
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
