duanxuebin1998/cube/(commit log)

2025-07-03 chore: 初始化计量仪各板卡及验证工程（CPU2 V0.0.0.0 / CPU3 V0.0.0.0 / 无线主机 V4.1）
    版本：
    - CPU2：V0.0.0.0（历史提交编号）
    - CPU3：V0.0.0.0（历史提交编号）
    - 无线主机：V4.1（历史工程目录标识）
    协议版本/兼容性：
    - 不涉及协议变化；兼容性以该历史提交的代码树为准。
    本次修改：
    - 导入 CPU2、CPU3、无线主机及外围验证工程，建立仓库初始代码基线。
    验证：
    - 提交差异复核：通过；本次仅重写说明，代码树保持不变。
    [LTD故障代码表.xlsx]
2025-08-04 feat: 完成CPU2核心板基础测量与故障框架（CPU2 V0.1.0.0 / CPU3 V0.0.0.1 / 无线主机 V4.1）
    - CPU2：V0.1.0.0（历史提交编号）
    - CPU3：V0.0.0.1（历史提交编号）
    - 涉及 DSM、LTD 或无线传感器通信；协议口径以该历史提交的代码树为准。
    - 形成 CPU2 新称重工程的测量调度、故障管理、传感器、电机和参数存储基础。
    - 同步整理早期 CPU3、迷你板及无线主机工程。
    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
    [LTD故障代码表.xlsx]
2025-08-07 feat: 建立CPU3显示与主板通信工程（CPU2 V0.2.0.0 / CPU3 V0.1.0.0）
    - CPU2：V0.2.0.0（历史提交编号）
    - CPU3：V0.1.0.0（历史提交编号）
    - 涉及 CPU2/CPU3 内部通信或寄存器映射；地址和字段口径以该历史提交的代码树为准。
    - 新增 CPU3 显示、菜单、按键和参数处理代码。
    - 建立 CPU3 与 CPU2 的 Modbus 通信和数据轮询基础。
    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
2025-08-29 feat: 增加CPU3对外通信与罐上操作（CPU2 V0.2.0.1 / CPU3 V0.2.0.0）
    - CPU2：V0.2.0.1（历史提交编号）
    - CPU3：V0.2.0.0（历史提交编号）
    - 涉及外部 Modbus、DSM 或瓦锡兰通信；接口口径以该历史提交的代码树为准。
    - 增加 CPU3 对外 DSM/Modbus 通信处理。
    - 完善罐上操作菜单、按键和显示流程，并同步 CPU2 相关通信。
    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
2025-09-01 feat: 增加CPU3第三路串口通信（CPU3 V0.3.0.0）
    - CPU3：V0.3.0.0（历史提交编号）
    - 配置 CPU3 USART3、DMA、接收中断和 RS485 管脚。
    - 接入主板通信处理流程。
    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
2025-09-03 perf: 降低无线滑环主机运行频率（CPU2 V0.2.0.2 / CPU3 V0.3.0.1 / 无线主机 V4.1）
    - CPU2：V0.2.0.2（历史提交编号）
    - CPU3：V0.3.0.1（历史提交编号）
    - 新增无线滑环低功耗工程并降低主机运行频率。
    - 同步调整 CPU2 测量和 CPU3 外设配置。
    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
2025-09-05 feat: 增加4-20mA电流输出驱动（CPU2 V0.3.0.0 / CPU3 V0.4.0.0）
    - CPU2：V0.3.0.0（历史提交编号）
    - CPU3：V0.4.0.0（历史提交编号）
    - 为 CPU2 增加 AD5421 电流输出驱动及 SPI/HART 管脚配置。
    - 为 CPU3 补充对应的串口和通信接口配置。
    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
2025-09-05 feat: 增加CPU3一体机对外通信协议（CPU3 V0.5.0.0）
    - CPU3：V0.5.0.0（历史提交编号）
    - 完善 CPU3 DSM Modbus 数据解析、参数读写和从站响应。
    - 增加与一体机上位机的通信处理。
    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
2025-09-10 feat: 增加CPU2 HART与AD5421支持（CPU2 V0.4.0.0 / 无线主机 V4.1）
    - CPU2：V0.4.0.0（历史提交编号）
    - 接入 HART 收发、AD5421 电流输出和相关 SPI/UART 管脚。
    - 同步无线主机通信相关代码。
    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
2025-10-17 refactor: 重构CPU2液位流程并整理工程目录（CPU2 V0.4.0.1 / CPU3 V0.5.0.1）
    - CPU2：V0.4.0.1（历史提交编号）
    - CPU3：V0.5.0.1（历史提交编号）
    - 重构找液位、液位跟随、称重和传感器处理。
    - 移动 CPU2 Core 文件到应用目录，并同步 CPU3 协议映射。
    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
    [LTD故障代码表.xlsx]
2025-10-18 refactor: 整理CPU2工程目录与模块引用（CPU2 V0.4.0.2）
    - CPU2：V0.4.0.2（历史提交编号）
    - 调整 CPU2 Core、驱动和服务目录结构。
    - 更新故障、测量、传感器和电机模块的引用关系。
    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
2025-10-23 fix: 完善CPU2电机称重与回零故障处理（CPU2 V0.4.1.0）
    - CPU2：V0.4.1.0（历史提交编号）
    - 完善电机运动、称重采样和故障码处理。
    - 调整回零、罐底和液位测量流程，形成首个稳定基线。
    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
    [TMC5130.c, TMC5130.h, app_main.c, encoder.c, fault_manager.c, main.h, measure.c]
2025-11-04 fix: 完善CPU2测量流程与板间串口控制（CPU2 V0.4.2.0 / CPU3 V0.5.1.0）
    - CPU2：V0.4.2.0（历史提交编号）
    - CPU3：V0.5.1.0（历史提交编号）
    - 继续完善回零、罐底、液位、电机和传感器处理。
    - 调整 CPU2/CPU3 串口、RS485 方向控制和 HART 通信，形成第二个稳定基线。
    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
    [TMC5130.c, ad5421.c, app_main.c, communicate.c, display_tankopera.c, fault_manager.c]
2025-11-10 refactor: 拆分传感器协议并统一命令参数映射（CPU2 V0.5.0.0 / CPU3 V0.6.0.0）
    - CPU2：V0.5.0.0（历史提交编号）
    - CPU3：V0.6.0.0（历史提交编号）
    - 将 DSM 与 LTD 传感器通信从通用传感器模块中拆分。
    - 新增密度测量入口，重整 CPU2/CPU3 命令、状态和参数映射。
    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
2025-11-18 fix: 修正液位测量显示与回零异常处理（CPU2 V0.5.1.0 / CPU3 V0.6.1.0）
    - CPU2：V0.5.1.0（历史提交编号）
    - CPU3：V0.6.1.0（历史提交编号）
    - 修正液位值更新、下行距离、盲区和参数小数位。
    - 调整空载/满载菜单，并在零点标定卡住时报错上行。
    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
    [app_main.c, display_tankopera.c, dsm_sensor_communication.c, dsm_sensor_communication.h, encoder.c, encoder.h, ltd_sensor_communication.c, ltd_sensor_communication.h]
2025-11-19 refactor: 建立CPU3应用入口并整理CPU2传感器代码（CPU2 V0.5.1.1 / CPU3 V0.6.1.1）
    - CPU2：V0.5.1.1（历史提交编号）
    - CPU3：V0.6.1.1（历史提交编号）
    - 新增 CPU3 应用初始化和主循环入口。
    - 整理 CPU2 串口、传感器和电机代码，并移除未使用的 ADC 驱动文件。
    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
2025-11-20 feat: 增加CPU3瓦锡兰协议与通信分层（CPU3 V0.7.0.0）
    - CPU3：V0.7.0.0（历史提交编号）
    - 新增瓦锡兰 Modbus 通信、寄存器映射和设备地址模块。
    - 将 CPU3 通信代码分为外部协议、内部主板通信和公共组件。
    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
2025-11-26 chore: 将CPU2和CPU3中文源码切换为GB2312编码（CPU2 V0.5.1.2 / CPU3 V0.7.0.1）
    - CPU2：V0.5.1.2（历史提交编号）
    - CPU3：V0.7.0.1（历史提交编号）
    - 转换显示、测量、通信和参数源码的中文编码。
    - 保持中文菜单和调试输出可在原工具链中正常显示。
    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
2025-12-01 feat: 重排测量指令并增加密度计算参数（CPU2 V0.6.0.0 / CPU3 V0.8.0.0）
    - CPU2：V0.6.0.0（历史提交编号）
    - CPU3：V0.8.0.0（历史提交编号）
    - 重新编排 CPU2/CPU3 测量和调试指令。
    - 增加密度计算、显示和瓦锡兰测量所需参数。
    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
2025-12-04 refactor: 统一设备参数命令与状态映射（CPU2 V0.7.0.0 / CPU3 V0.9.0.0）
    - CPU2：V0.7.0.0（历史提交编号）
    - CPU3：V0.9.0.0（历史提交编号）
    - 重整 CPU2/CPU3 设备参数、命令和运行状态定义。
    - 完善菜单分组、称重显示、瓦锡兰参数和 Modbus 数据同步。
    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
2025-12-08 feat: 完善瓦锡兰密度分布测量与结果读取（CPU2 V0.8.0.0 / CPU3 V0.10.0.0 / 无线主机 V4.1）
    - CPU2：V0.8.0.0（历史提交编号）
    - CPU3：V0.10.0.0（历史提交编号）
    - 完善瓦锡兰密度分布测量流程、测点生成和稳定采样。
    - 支持 CPU3 按测点数分段读取密度分布结果。
    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
2025-12-10 feat: 增加无线传感器通信与故障重试（CPU2 V0.9.0.0 / CPU3 V0.11.0.0 / 无线主机 V4.1）
    - CPU2：V0.9.0.0（历史提交编号）
    - CPU3：V0.11.0.0（历史提交编号）
    - 新增 CPU2 无线传感器通信、超时重试和帧校验。
    - 新增无线主机通信模块，并同步 CPU3 状态和参数读取。
    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
2025-12-11 feat: 增加CPU3通信配置存储与看门狗（CPU2 V0.10.0.0 / CPU3 V0.12.0.0）
    - CPU2：V0.10.0.0（历史提交编号）
    - CPU3：V0.12.0.0（历史提交编号）
    - 增加 CPU3 三路串口协议配置、FRAM 保存和动态重配。
    - 建立通信管理器并为 CPU2/CPU3 接入独立看门狗。
    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
2025-12-12 refactor: 统一CPU3参数同步与菜单结构（CPU2 V0.10.0.1 / CPU3 V0.12.0.1）
    - CPU2：V0.10.0.1（历史提交编号）
    - CPU3：V0.12.0.1（历史提交编号）
    - 将 CPU3 本机参数与 CPU2 参数同步逻辑分离。
    - 重构罐上菜单、DSM 参数解析和内部主板通信。
    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
2025-12-15 fix: 修正CPU3串口接收恢复与RS485收发切换（CPU2 V0.10.1.0 / CPU3 V0.12.1.0 / 无线主机 V4.1）
    - CPU2：V0.10.1.0（历史提交编号）
    - CPU3：V0.12.1.0（历史提交编号）
    - 补充 CPU3 串口接收异常后的 DMA 恢复。
    - 调整三路 RS485 发送后的方向切换延时和参数转发声明。
    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
    [address.c, address.h, app_main.c, app_main.h, com_port_config.h, communicate.c, cpu3_comm_display_params.c, device_param_sync.c]
2025-12-18 refactor: 将主控和显示工程统一命名为CPU2与CPU3（CPU2 V0.10.1.1 / CPU3 V0.12.1.1）
    - CPU2：V0.10.1.1（历史提交编号）
    - CPU3：V0.12.1.1（历史提交编号）
    - 将现用工程重命名为 LTD_MAIN_CPU2 和 LTD_DISPLAY_CPU3。
    - 把旧工程移动到 old 目录并同步项目内引用。
    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
    [LTD故障代码表.xlsx]
2025-12-20 feat: 增加水位测量与CPU3串口配置菜单（CPU2 V0.11.0.0 / CPU3 V0.13.0.0）
    - CPU2：V0.11.0.0（历史提交编号）
    - CPU3：V0.13.0.0（历史提交编号）
    - 新增 CPU2 水位寻找、标定和跟随流程。
    - 增加 CPU3 波特率、校验位、停止位和协议类型配置菜单。
    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
    [LTD故障代码表.xlsx]
2025-12-25 refactor: 重构CPU3协议分发与串口DMA队列（CPU2 V0.11.0.1 / CPU3 V0.14.0.0）
    - CPU2：V0.11.0.1（历史提交编号）
    - CPU3：V0.14.0.0（历史提交编号）
    - 按端口配置分发 DSM、瓦锡兰和 LTD 协议。
    - 增加串口 DMA 发送排队、接收恢复和延迟重配，并完善 CPU2 水位流程。
    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
2025-12-26 fix: 修正水位寻找恢复与CPU2通信解析（CPU2 V0.11.1.0 / CPU3 V0.14.1.0）
    - CPU2：V0.11.1.0（历史提交编号）
    - CPU3：V0.14.1.0（历史提交编号）
    - 水位状态异常时分步上行重新寻找水面。
    - 修正 CPU3 的 DSM 数据解析和 CPU2 通信处理，移除重复菜单代码。
    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
    [cpu2_communicate.c, dataanalysis_modbus.c, display_tankopera.c, measure_density.c]
2025-12-30 feat: 增加多种密度分布测量方式（CPU2 V0.12.0.0 / CPU3 V0.15.0.0）
    - CPU2：V0.12.0.0（历史提交编号）
    - CPU3：V0.15.0.0（历史提交编号）
    - 增加普通分布、国标、每米和区间密度测量。
    - 统一测点生成、单点采样、结果汇总和 CPU3 结果读取。
    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
    [LTD故障代码表.xlsx]
2025-12-31 feat: 增加陀螺仪罐底检测（CPU2 V0.13.0.0）
    - CPU2：V0.13.0.0（历史提交编号）
    - 增加基于陀螺仪角度的罐底检测，并保留称重检测方式。
    - 补充角度读取、基准保存和罐底检测参数。
    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
    [LTD故障代码表.xlsx]
2025-12-31 test: 增加电机测试流程并调整运动保护（CPU2 V0.14.0.0）
    - CPU2：V0.14.0.0（历史提交编号）
    - 增加电机往返和测量流程测试入口。
    - 调整罐底、液位、回零和 TMC5130 运动保护。
    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
2026-01-06 chore: 增加CPU2文本编码验证副本并调整水位跟随（CPU2 V0.14.1.0）
    - CPU2：V0.14.1.0（历史提交编号）
    - 建立 CPU2 文本编码验证副本。
    - 调整水位跟随步长、滞后和丢失判定，并同步电机参数。
    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
    [LTD故障代码表.xlsx]
2026-01-09 fix: 修正CPU3本机参数被重复同步的问题（CPU2 V0.14.2.0 / CPU3 V0.15.1.0）
    - CPU2：V0.14.2.0（历史提交编号）
    - CPU3：V0.15.1.0（历史提交编号）
    - CPU3 批量同步参数时跳过本机参数，避免配置错位。
    - 补充罐底状态检查并移除临时锁文件。
    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
    [LTD故障代码表.xlsx]
2026-01-09 feat: 补齐CPU2参数并同步CPU3映射（CPU2 V0.15.0.0 / CPU3 V0.16.0.0）
    - CPU2：V0.15.0.0（历史提交编号）
    - CPU3：V0.16.0.0（历史提交编号）
    - 补齐 CPU2 命令、设备、机械、称重、液位、水位和罐底参数。
    - 同步 CPU3 菜单、寄存器映射、参数读写和存储结构。
    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
2026-01-12 refactor: 重整CPU3参数菜单与CPU2运动测量流程（CPU2 V0.15.0.1 / CPU3 V0.16.0.1）
    - CPU2：V0.15.0.1（历史提交编号）
    - CPU3：V0.16.0.1（历史提交编号）
    - 重整 CPU3 参数分组、命令状态显示和字库检查。
    - 完善 CPU2 测量调度、电机位置、称重和水位流程。
    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
    [LTD故障代码表.xlsx]
2026-01-15 feat: 增加水位调试命令与罐底角度显示（CPU2 V0.16.0.0 / CPU3 V0.17.0.0）
    - CPU2：V0.16.0.0（历史提交编号）
    - CPU3：V0.17.0.0（历史提交编号）
    - 增加水位跟随、运行到位、强制运动和水位标定命令及状态。
    - 增加罐底检测方式选择和陀螺仪角度显示。
    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
    [LTD故障代码表.xlsx]
2026-01-19 feat: 增加上电默认命令和水位零点电容参数（CPU2 V0.17.0.0 / CPU3 V0.18.0.0）
    - CPU2：V0.17.0.0（历史提交编号）
    - CPU3：V0.18.0.0（历史提交编号）
    - 增加上电默认命令、水位零点电容及瓦锡兰密度参数。
    - 完善水位标定、瓦锡兰状态映射和电机运动控制。
    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
    [LTD故障代码表.xlsx]
2026-01-23 fix: 修正电机目标位置控制与密度有效性判断（CPU2 V0.17.1.0 / CPU3 V0.18.1.0）
    - CPU2：V0.17.1.0（历史提交编号）
    - CPU3：V0.18.1.0（历史提交编号）
    - 按尺带卷绕模型修正电机位置换算和到位停止判断。
    - 过滤无效密度值并同步 CPU2/CPU3 相关参数。
    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
    [LTD故障代码表.xlsx]
2026-01-24 fix: 修正CPU3版本显示与液位参数单位（CPU2 V0.17.2.0 / CPU3 V0.18.2.0）
    - CPU2：V0.17.2.0（历史提交编号）
    - CPU3：V0.18.2.0（历史提交编号）
    - 更新 CPU3 版本标识和显示字库。
    - 修正液位模式、修正参数单位及姿态角显示条件。
    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
    [LTD故障代码表.xlsx]
2026-02-02 feat: 增加液位测量方式与稳定采样参数（CPU2 V0.18.0.0 / CPU3 V0.19.0.0）
    - CPU2：V0.18.0.0（历史提交编号）
    - CPU3：V0.19.0.0（历史提交编号）
    - 增加相对频率、定频、密度和超声液位测量方式。
    - 增加液位跟随频率/密度参数并完善密度稳定采样。
    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
    [LTD故障代码表.xlsx]
2026-02-03 fix: 完善福建LNG现场瓦锡兰通信与状态映射（CPU2 V0.18.1.0 / CPU3 V0.19.1.0）
    - CPU2：V0.18.1.0（历史提交编号）
    - CPU3：V0.19.1.0（历史提交编号）
    - 修正瓦锡兰寄存器响应、参数下发和工作状态映射。
    - 调整密度测量、单点监测和传感器有效值处理。
    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
    [cpu2_communicate.c, measure.c, measure_tank_height.c, motor_ctrl.c, system_parameter.c, wartsila_density_measurement.c]
2026-02-26 feat: 增加水位快速寻找与跟随方式（CPU2 V0.19.0.0 / CPU3 V0.20.0.0）
    - CPU2：V0.19.0.0（历史提交编号）
    - CPU3：V0.20.0.0（历史提交编号）
    - 新增水位快速寻找、状态翻转判定和跟随流程。
    - 同步 CPU2/CPU3 水位模式、稳定阈值及罐底参数。
    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
    [LTD故障代码表.xlsx]
2026-02-27 fix: 修正CPU3参数字节序与通信声明（CPU2 V0.19.1.0 / CPU3 V0.20.1.0）
    - CPU2：V0.19.1.0（历史提交编号）
    - CPU3：V0.20.1.0（历史提交编号）
    - 修正 CPU3 参数写入时的寄存器字节序。
    - 统一串口接收长度、协议处理声明和参数转发函数。
    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
    [cpu2_communicate.c, dataanalysis_modbus.c, dataanalysis_modbus.h, display_tankopera.c, measure_tank_height.c, measure_zero.c, motor_ctrl.c, my_crc.c]
2026-03-03 fix: 修正罐高显示与水位跟随状态复位（CPU2 V0.19.2.0 / CPU3 V0.21.0.0）
    - CPU2：V0.19.2.0（历史提交编号）
    - CPU3：V0.21.0.0（历史提交编号）
    - 增加罐高结果显示并修正参数寄存器字节序。
    - 每次水位快速寻找前复位状态翻转记录，并增加仓库导览文档。
    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
    [display.c, display_tankopera.c, system_parameter.h]
2026-03-03 build: 增加CPU2 CMake构建配置（CPU2 V0.19.2.1 / CPU3 V0.21.0.0）
    - CPU2：V0.19.2.1（历史提交编号）
    - 增加 CPU2 CMake 工程、ARM GCC 工具链和构建脚本。
    - 补充 CPU2 本机构建说明。
    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
2026-03-03 build: 建立CPU2 CMake与Ninja构建基础（CPU2 V0.19.2.2 / CPU3 V0.21.0.0）
    - CPU2：V0.19.2.2（历史提交编号）
    - 为 CPU2 建立 CMake、Ninja 和 ARM GCC 构建入口。
    - 增加构建预设、链接选项和基础说明。
    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
2026-03-03 chore: 停止跟踪old历史工程目录（CPU2 V0.19.2.4 / CPU3 V0.21.0.1）
    - CPU2：V0.19.2.4（历史提交编号）
    - CPU3：V0.21.0.1（历史提交编号）
    - 将 old 历史工程目录从 Git 跟踪中移除。
    - 同步忽略规则、编辑器设置和构建预设。
    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
2026-03-03 chore: 删除多余验证工程和历史副本（CPU2 V0.19.2.5 / CPU3 V0.21.0.2）
    - CPU2：V0.19.2.5（历史提交编号）
    - CPU3：V0.21.0.2（历史提交编号）
    - 删除 CPU2 文本副本、迷你板、电机、水位及旧文本验证工程。
    - 保留当前 CPU2、CPU3 和无线主机工程作为维护入口。
    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
    [LTD故障代码表.xlsx]
2026-03-04 docs: 整理仓库导览并增加CPU2解耦方案（CPU2 V0.19.2.6 / CPU3 V0.21.0.2）
    - CPU2：V0.19.2.6（历史提交编号）
    - 将仓库扫描报告移入文档目录。
    - 增加 CPU2 解耦实施方案并补充称重接口说明。
    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
2026-03-04 fix: 修正CPU2与CPU3头文件大小写（CPU2 V0.19.3.0 / CPU3 V0.21.1.0）
    - CPU2：V0.19.3.0（历史提交编号）
    - CPU3：V0.21.1.0（历史提交编号）
    - 统一 CPU2/CPU3 头文件引用大小写，避免区分大小写的构建环境失败。
    - 同步水位电容换算和位置更新引用。
    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
    [app_main.c, density_analysis_calculation.c, display.c, display_tankopera.c, hgs.c]
2026-03-04 build: 增加CPU3 CMake构建与自动检查（CPU2 V0.19.3.0 / CPU3 V0.21.1.1）
    - CPU3：V0.21.1.1（历史提交编号）
    - 增加 CPU3 CMake 工程、构建预设和构建脚本。
    - 将自动构建扩展到 CPU2/CPU3。
    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
2026-03-05 refactor: 整理CPU2主循环并恢复电机碰撞检测（CPU2 V0.19.4.0 / CPU3 V0.21.1.2）
    - CPU2：V0.19.4.0（历史提交编号）
    - CPU3：V0.21.1.2（历史提交编号）
    - 将 CPU2 主循环改为单次调度并整理测试入口。
    - 恢复运动中的称重碰撞检测，调整 TMC5130 配置并删除未用 RAM 链接脚本。
    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
2026-03-05 feat: 增加液位水位与尺带修正参数（CPU2 V0.20.0.0 / CPU3 V0.22.0.0）
    - CPU2：V0.20.0.0（历史提交编号）
    - CPU3：V0.22.0.0（历史提交编号）
    - 增加液位滞后时间、水位修正、气相温度和尺带温度补偿参数。
    - 升级参数结构版本并同步 CPU2/CPU3 寄存器和菜单。
    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
    [dataanalysis_modbus.c, device_param_sync.c, display_tankopera.c, display_tankopera.h, stateformodbus.h, system_parameter.c, system_parameter.h]
2026-03-06 feat: 增加设备参数与编码器双备份（CPU2 V0.21.0.0）
    - CPU2：V0.21.0.0（历史提交编号）
    - 为设备参数和编码器记录增加 FRAM A/B 双份保存、校验和回退。
    - 增加双备份损坏恢复测试入口。
    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
2026-03-06 docs: 增加开发者导览入口（CPU2 V0.21.0.1 / CPU3 V0.22.0.1）
    - CPU2：V0.21.0.1（历史提交编号）
    - CPU3：V0.22.0.1（历史提交编号）
    - 在 README 中增加开发者文档入口。
    - 更新仓库扫描报告。
    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
2026-03-06 feat: 增加恒线速度控制与失步检测（CPU2 V0.22.0.0 / CPU3 V0.23.0.0）
    - CPU2：V0.22.0.0（历史提交编号）
    - CPU3：V0.23.0.0（历史提交编号）
    - 根据尺带卷径动态换算 TMC5130 速度，保持线速度稳定。
    - 增加失步检测、速度限制和运行中速度补偿。
    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
2026-03-12 fix: 补充无线主机通信头文件引用（CPU2 V0.22.0.0 / CPU3 V0.23.0.0 / 无线主机 V4.1）
    - 在无线主机 USART 模块中包含通信接口头文件，补齐函数声明。
    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
    [usart.c]
2026-03-16 feat: 增加电机条件运动与单次速度控制（CPU2 V0.23.0.0）
    - CPU2：V0.23.0.0（历史提交编号）
    - 增加条件运动接口和带速度参数的运动接口。
    - 统一速度设置入口，并在临时速度命令结束后恢复默认速度。
    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
2026-03-16 refactor: 统一带速度运动接口并恢复分段变速（CPU2 V0.23.1.0）
    - CPU2：V0.23.1.0（历史提交编号）
    - 应用层统一使用带速度参数的电机接口。
    - 恢复零点、水位和罐底测量中的阶段性变速。
    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
2026-03-16 fix: 细分传感器通信故障并修正响应校验（CPU2 V0.23.2.0）
    - CPU2：V0.23.2.0（历史提交编号）
    - 细分无线主机、无线从机和传感器通信故障。
    - 修正 DSM/LTD/无线响应长度、帧尾、校验和错误码映射。
    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
    [dsm_sensor_communication.c, dsm_sensor_communication.h, ltd_sensor_communication.c, measure_tank_height.c, system_parameter.h]
2026-03-17 fix: 完善CPU2与CPU3通信恢复和参数同步（CPU2 V0.23.3.0 / CPU3 V0.23.1.0）
    - CPU2：V0.23.3.0（历史提交编号）
    - CPU3：V0.23.1.0（历史提交编号）
    - 完善 CPU3 串口收发方向、参数存储和批量同步。
    - 修正 CPU2 通信轮询、寄存器分组和命令处理。
    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
    [app_main.c, cpu2_communicate.c, cpu2_communicate.h, cpu3_comm_display_params.c, dataanalysis_modbus.c, display_tankopera.c, hostcommu.c, hostcommu_modbus.c]
2026-03-25 fix: 清理CPU2与CPU3构建告警（CPU2 V0.23.3.1 / CPU3 V0.23.1.1 / 无线主机 V4.1）
    - CPU2：V0.23.3.1（历史提交编号）
    - CPU3：V0.23.1.1（历史提交编号）
    - 清理 CPU2 外部声明、易变变量读取和未使用调试函数告警。
    - 清理 CPU3 CRC、显示和瓦锡兰参数转发告警。
    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
    [AS5145.c, app_main.c, cpu2_communicate.c, dataanalysis_modbus.c, display.c, display_tankopera.c, hostcommu_modbus.c, main.c]
2026-03-27 fix: 修正密度分布取点与单位口径（CPU2 V0.23.4.0）
    - CPU2：V0.23.4.0（历史提交编号）
    - 修正区间密度测点使用的上下限参数。
    - 统一液位高度存储为 0.1 mm，并避免当前命令被误判为切换。
    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
    [measure_density.c, system_parameter.c, system_parameter.h]
2026-03-27 fix: 完善水位跟随与命令切换处理（CPU2 V0.24.0.0）
    - CPU2：V0.24.0.0（历史提交编号）
    - 统一测量流程的有效命令切换判定。
    - 支持水位稳定窗口配置，并优化跟随步长和传感器异常处理。
    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
    [dsm_sensor_communication.c, measure.c, motor_ctrl.c]
2026-03-28 fix: 完善板间通信恢复与液位流程（CPU2 V0.24.1.0 / CPU3 V0.23.2.0）
    - CPU2：V0.24.1.0（历史提交编号）
    - CPU3：V0.23.2.0（历史提交编号）
    - 完善 CPU3 串口 DMA 收发切换和错误恢复。
    - 调整 CPU2 水位跟随、液位搜索、状态同步和传感器容错。
    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
    [app_main.c, display.c, dsm_sensor_communication.c, measure.c, system_parameter.h, usart.c]
2026-03-28 fix: 完善编码器与称重通信故障处理（CPU2 V0.25.0.0 / CPU3 V0.24.0.0）
    - CPU2：V0.25.0.0（历史提交编号）
    - CPU3：V0.24.0.0（历史提交编号）
    - 完善 AS5145 编码器 SSI 读取、断线识别和重试恢复。
    - 增加称重通信超时检测并同步 CPU3 故障码。
    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
    [AS5145.c, LTD_MAIN_CPU2.ioc, app_main.c, motor_ctrl.c, system_parameter.h, usart.h, weight.c]
2026-03-28 fix: 水位标定后恢复跟随并使单点监测可打断（CPU2 V0.25.1.0）
    - CPU2：V0.25.1.0（历史提交编号）
    - 水位标定完成后恢复原有跟随状态，并统一校验标定值。
    - 瓦锡兰分布测量结束后由主循环启动可被新命令打断的单点监测。
    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
    [app_main.c, measure.c]
2026-03-30 fix: 水位长时间未稳定时进入跟随监测（CPU2 V0.25.2.0）
    - CPU2：V0.25.2.0（历史提交编号）
    - 增加水位跟随进入超时，长时间未达到稳态时仍置入跟随监测状态。
    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
2026-04-09 feat: 增加罐高标定并完善DSM显示联动（CPU2 V0.26.0.0 / CPU3 V0.25.0.0）
    - CPU2：V0.26.0.0（历史提交编号）
    - CPU3：V0.25.0.0（历史提交编号）
    - 增加罐高标定命令、状态、参数和屏幕入口。
    - 修正罐底、水位、DSM 寄存器映射及液位/角度显示。
    - `cmake --build --preset cpu2-debug`：原提交记录为通过。
    - `cmake --build --preset cpu3-debug`：原提交记录为通过。
    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
    [在线一体机寄存器说明V1.225 .xlsx]
2026-04-10 fix: 完善液位重试与电机状态同步（CPU2 V0.26.1.0 / CPU3 V0.25.1.0）
    - CPU2：V0.26.1.0（历史提交编号）
    - CPU3：V0.25.1.0（历史提交编号）
    - 统一传感器通信重试，完善液位模式恢复和盲区等待退出。
    - 拆分静态/运动液位判定，并统一电机状态上报和 CPU3 图标显示。
    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
    [dataanalysis_modbus.c, display.c, dsm_sensor_communication.c, ltd_sensor_communication.c, motor_ctrl.c, motor_ctrl.h, wartsila_density_measurement.c, weight.c]
2026-04-13 fix: 支持串口调试流程被新命令打断（CPU2 V0.26.2.0）
    - CPU2：V0.26.2.0（历史提交编号）
    - 将串口命令纳入统一命令切换判定。
    - 为持续运行测试和底层运动等待增加中断退出及停机处理。
    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
    [TMC5130.c, measure.c, system_parameter.h]
2026-04-13 perf: 合并CPU3连续参数写入的FRAM保存（CPU2 V0.26.2.1）
    - CPU2：V0.26.2.1（历史提交编号）
    - 为 CPU3 参数写请求增加 100 ms 防抖。
    - 合并连续保存请求，减少 FRAM 重复写入和通信阻塞。
    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
2026-04-25 fix: 调整主循环优先级并增强罐底测量容错（CPU2 V0.26.3.0）
    - CPU2：V0.26.3.0（历史提交编号）
    - 调整命令和错误状态处理优先级。
    - 增加陀螺仪基准采样、二次精找和异常回退，并调整水位跟随阈值。
    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
    [app_main.c, measure.c, measure_tank_height.c]
2026-04-25 feat: 增加固定点测量样机展示程序（CPU2 V0.27.0.0）
    - CPU2：V0.27.0.0（历史提交编号）
    - 增加固定点虚拟测量和周期数据刷新。
    - 增加串口 X 调试命令以启动展示流程，并支持新命令打断。
    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
2026-04-28 refactor: 统一电机编码器与测量参数（CPU2 V0.27.0.1 / CPU3 V0.25.1.1）
    - CPU2：V0.27.0.1（历史提交编号）
    - CPU3：V0.25.1.1（历史提交编号）
    - 重构 TMC5130、电机位置源、编码器换算和测量流程参数。
    - 同步 CPU2/CPU3 状态、Modbus 参数、显示菜单和项目资料。
    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
    [LTD故障代码表.xlsx]
2026-04-28 fix: 修正电机状态显示并让电流立即生效（CPU2 V0.27.1.0）
    - CPU2：V0.27.1.0（历史提交编号）
    - 结合驱动状态和目标位置判断电机运行状态。
    - 增加运行电流即时写入，并保持显示、存储和驱动寄存器一致。
    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
    [dataanalysis_modbus.c, motor_ctrl.c, motor_ctrl.h, wartsila_density_measurement.c]
2026-04-29 refactor: 拆分电机控制模块并保护位置读数（CPU2 V0.27.2.0）
    - CPU2：V0.27.2.0（历史提交编号）
    - 拆分电机驱动参数、运动接口和位置模型。
    - 增加 TMC5130 SPI、XACTUAL 稳定读取和写入失败保护，并调整回零减速。
    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
2026-04-30 fix: 修正电机回零与记步状态处理（CPU2 V0.27.3.0 / CPU3 V0.25.1.1）
    - CPU2：V0.27.3.0（历史提交编号）
    - 修正粗找/精找零点、停稳判断和速度刷新。
    - 回零后清理电机记步基准并同步参数 CRC，补充现场分析文档。
    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
    [TMC5130.c, measure.c, measure_zero.c, motor_ctrl.h, motor_ctrl_driver_param.c, motor_ctrl_internal.h, motor_ctrl_motion_api.c, motor_ctrl_position_model.c]
2026-05-06 feat: 增加位置源切换参数并补齐CPU3字库（CPU2 V0.28.0.0 / CPU3 V0.26.0.0）
    - CPU2：V0.28.0.0（历史提交编号）
    - CPU3：V0.26.0.0（历史提交编号）
    - 增加位置源自动切换、罐底编码器修正和失步检测参数。
    - 补齐 CPU3 字库并同步 CPU2/CPU3 参数与状态映射。
    - CPU3 字库检查：原提交记录为通过目标字检查。
    -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
    [dataanalysis_modbus.c, device_param_sync.c, display.c, display_tankopera.c, display_tankopera.h, encoder.c, encoder.h, font_check.py]
2026-05-08 fix: 完善电机测试与TMC5130故障诊断（CPU2 V0.29.0.0）
    - CPU2：V0.29.0.0（历史提交编号）
    - 扩展电机往返测试参数和命令格式。
    - 完善 TMC5130 到位确认、GSTAT/DRV_STATUS 诊断和异常停机。
    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
    [TMC5130.c, TMC5130.h, app_main.c, measure.c, motor_ctrl.h, motor_ctrl_driver_param.c, motor_ctrl_motion_api.c]
2026-05-09 test: 增加TMC5130静态SPI测试与状态上报（CPU2 V0.30.0.0 / CPU3 V0.27.0.0）
    - CPU2：V0.30.0.0（历史提交编号）
    - CPU3：V0.27.0.0（历史提交编号）
    - 增加 YT 调试命令和 TMC5130 静态 SPI 测试。
    - 改为由主循环统一刷新电机状态，并补充屏幕菜单文档。
    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
2026-05-09 feat: 增加水位变化监测与瓦锡兰探底频率（CPU2 V0.31.0.0 / CPU3 V0.28.0.0）
    - CPU2：V0.31.0.0（历史提交编号）
    - CPU3：V0.28.0.0（历史提交编号）
    - 水位跟随稳定后进入持续变化监测。
    - 拆分水位电容阈值，并增加瓦锡兰每 N 次密度测量后探底参数。
    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
2026-05-11 fix: 统一水位电容参数并调整跟随状态确认（CPU2 V0.31.1.0 / CPU3 V0.28.1.0）
    - CPU2：V0.31.1.0（历史提交编号）
    - CPU3：V0.28.1.0（历史提交编号）
    - 统一水位寻找阈值和滞后阈值在 CPU2/CPU3 的命名与映射。
    - 跟随状态改为进入监测循环时确认，并调整超时和调试输出。
    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
    [dataanalysis_modbus.c, device_param_sync.c, display_tankopera.c, display_tankopera.h, motor_ctrl_position_model.c, stateformodbus.h, system_parameter.c, system_parameter.h]
2026-05-11 feat: 引入固件版本体系（CPU2 V1.1.0.0 / CPU3 V1.1.0.0）
    - CPU2：V1.0.0.0 -> V1.1.0.0。
    - CPU3：V1.0.0.0 -> V1.1.0.0。
    - CPU2 与 CPU3 使用 major.minor 作为兼容契约，当前均为 V1.1.x，版本匹配。
    - CPU3 读取 CPU2 软件版本后会提示版本不匹配，便于现场识别不兼容组合。
    - 新增 CPU2/CPU3 固件版本头文件，统一 32 位版本编码和版本字符串。
    - CPU2 参数存储运行时写入当前固件版本，避免旧 FRAM 参数覆盖软件版本。
    - CPU3 本机版本改为 32 位版本，并显示 CPU2/CPU3 程序版本。
    - 新增 CPU2/CPU3 兼容宏和 CPU3 侧版本匹配提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
2026-05-11 feat: 新增CPU2串口BE编码器测试指令（CPU2 V1.2.0.0 / CPU3 V1.1.0.0）
    - CPU2：V1.1.0.0 -> V1.2.0.0。
    - CPU3：保持 V1.1.0.0。
    - 本次仅新增 CPU2 串口 B 类测试指令，不修改 Modbus、参数存储布局或 CPU2/CPU3 共享数据结构。
    - CPU2 兼容协议 minor 升至 2；CPU3 未同步升级时，版本兼容检查可能提示 CPU2/CPU3 minor 不一致。
    - 保留 B<mm> 原有电机模型往返测试行为。
    - 新增 BE<mm> 编码器反馈往返测试，参数单位为 mm。
    - BE 测试使用启动时编码器位置作为固定原点，每轮下行到固定目标、上行回固定原点，避免目标随循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
2026-05-11 fix: 完善液位跟随与频率异常恢复（CPU2 V1.2.1.0 / CPU3 V1.1.0.0）
    - CPU2：V1.2.0.0 -> V1.2.1.0。
    - 本次仅调整 CPU2 液位跟随和液位频率异常恢复流程。
    - 不修改 Modbus、参数存储布局或 CPU2/CPU3 共享寄存器映射。
    - CPU2/CPU3 兼容契约不变，仍按现有 major.minor 规则识别兼容性。
    - 液位跟随稳定时不再重复刷新液位值，只打印已保存的液位寄存器值并标明单位为 0.1mm。
    - 液位频率发生变化时，先进入寻找液位状态重新精找，成功后再恢复液位跟随状态并更新液位值。
    - 液位频率连续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
    [app_version.h]
2026-05-12 feat: 新增测量错误自动恢复（CPU2 V1.3.0.0 / CPU3 V1.1.0.0）
    - CPU2：V1.2.1.0 -> V1.3.0.0。
    - 本次仅调整 CPU2 测量异常恢复、电机驱动复位后重初始化、传感器通信重试和部件参数检查逻辑。
    - 不修改 Modbus 寄存器映射、参数存储布局或 CPU2/CPU3 共享数据结构。
    - CPU2 兼容协议 minor 升至 3；CPU3 未同步升级时，版本兼容检查可能提示 CPU2/CPU3 minor 不一致。
    - 新增测量命令异常后的自动恢复流程，保持原错误状态，每 1 秒读取部件参数，全部部件恢复正常后重新执行完整测量命令。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
2026-05-13 feat: 统一CPU2错误日志和错误码传递（CPU2 V1.4.0.0 / CPU3 V1.1.0.0）
    - CPU2：V1.3.0.0 -> V1.4.0.0。
    - 本次仅调整 CPU2 错误日志、错误码传递、故障出口去重和现场诊断文档，不修改 Modbus 寄存器映射、参数存储布局或 CPU2/CPU3 共享数据结构。
    - CPU2 兼容协议 minor 升至 4；CPU3 未同步升级时，版本兼容检查可能提示 CPU2/CPU3 minor 不一致。
    - 新增 CPU2 统一错误日志模块，统一输出错误重试、重试成功、错误报警、最终报错四类现场日志。
    - 调整 fault_manager 最终报错出口，由统一出口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
2026-05-14 fix: 修复电机24V断电与命令切换处理（CPU2 V1.4.1.0 / CPU3 V1.1.1.0）
    - CPU2：V1.4.0.0 -> V1.4.1.0。
    - CPU3：V1.1.0.0 -> V1.1.1.0。
    - 本次不修改 Modbus 寄存器映射、参数存储布局、命令枚举数值或 CPU2/CPU3 共享字段含义。
    - CPU2/CPU3 固件版本继续独立递增。
    - CPU3 显示 CPU2 程序版本时仅按主版本判断兼容，minor/patch/build 不再触发版本不匹配提示。
    - 新增长等待公共入口 AbortableDelay_CommandSwitch，让固定点监测、模式稳定等待和称重稳定等待可响应命令切换。
    - 调整 STATE_SWITCH 日志语义，命令切换不再作为错误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
    [TMC5130.c, TMC5130.h, abortable_delay.c, abortable_delay.h, app_main.c, app_version.h, display_tankopera.c, dsm_sensor_communication.c]
2026-05-14 feat: 增加CPU2/CPU3协议版本检查（CPU2 V1.5.0.0 / CPU3 V1.2.0.0）
    - CPU2: V1.4.1.0 -> V1.5.0.0
    - CPU3: V1.1.1.0 -> V1.2.0.0
    - 协议版本：0 -> 1；CPU2 V1.5.0.0 与 CPU3 V1.2.0.0 按 DEVICE_PROTOCOL_VERSION 严格匹配。
    - 固件版本仅用于显示和发布追踪，不再作为 CPU2/CPU3 兼容判断依据。
    - 旧 CPU3 读取到协议版本 0 时视为旧协议；新 CPU3 只有读到与本机相同的协议版本才判定兼容。
    - 将原 reserved1 预留位替换为协议版本字段，并同步变量名、寄存器名和操作码名。
    - CPU2 启动和 Modbus 发布时写入当前协议版本，CPU3 同步读取并在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
2026-05-15 feat: CPU3显示故障原因（CPU2 V1.5.0.0 / CPU3 V1.3.0.0）
    - CPU2：保持 V1.5.0.0。
    - CPU3：V1.2.0.0 -> V1.3.0.0。
    - 仅修改 CPU3 本地显示逻辑和本地错误码枚举补齐，不新增 Modbus 寄存器，不改变 REG_DEVICE_STATUS_ERROR_CODE 含义，CPU2/CPU3 共享协议版本不变。
    - 修改内容：状态栏继续显示原故障代码；设备详情页新增中文故障原因行；长原因支持占用下一详情行显示；补充故障原因文案、字库汉字和 CPU2 新增错误码定义。
    - 版本变化：CPU3 V1.2.0.0 -> V1.3.0.0，CPU2 保持 V1.5.0.0。
    - cmake 配置并构建 LTD_DISPLAY_CPU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
2026-05-15 feat: 优化CPU2传感器通信与回零点处理（CPU2 V1.5.1.0 / CPU3 V1.3.0.0）
    - CPU2：V1.5.0.0 -> V1.5.1.0。
    - CPU3：保持 V1.3.0.0。
    - 本次不修改 CPU2/CPU3 共享寄存器地址、字段含义或协议版本。
    - CPU3 固件无需同步升级。
    - USART6 增加 DMA 收发配置，DSM 文本协议按换行终止符接收，LTD/V2 与无线链路按 8 字节固定帧接收。
    - 优化 UART6 异常帧、硬件错误、超时和 BCC 错误处理，补充通信重试详情日志。
    - 传感器协议识别改为读取传感器编号，LTD/V2 使用传感器编号寄存器，DSM 一代使用 CN 振动管编号。
    - 新增传感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
2026-05-15 feat: 支持CPU3长按返回取消测量（CPU2 V1.6.0.0 / CPU3 V1.4.0.0）
    - CPU2: V1.5.1.0 -> V1.6.0.0
    - CPU3: V1.3.0.0 -> V1.4.0.0
    - CPU2/CPU3 共享协议版本：1 -> 2。
    - 新增共享命令 CMD_CANCEL_MEASUREMENT = 16；CPU2 V1.6.0.0 与 CPU3 V1.4.0.0 配套使用。
    - 旧 CPU2 不识别命令 16，协议版本不匹配时应按 CPU3 状态页提示处理。
    - CPU3 状态显示界面长按返回时，运行/测量状态进入“是否停止测量?”确认页；返回键取消，确认键直接下发取消测量命令。
    - CPU3 故障状态长按返回进入故障原因查看页，状态栏仍显示原错误代码。
    - 移除测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
2026-05-15 feat: 新增瓦锡兰探底修正罐高参数（CPU2 V1.7.0.0 / CPU3 V1.5.0.0）
    - CPU2：V1.6.0.0 -> V1.7.0.0。
    - CPU3：V1.4.0.0 -> V1.5.0.0。
    - CPU2/CPU3 共享协议版本升级到 3。
    - 将原 reserved23 参数位定义为探底修正罐高，用于瓦锡兰分布测后罐底编码修正。
    - 旧参数存储升级时默认该参数为 0，表示继续沿用液位罐高，降低现场兼容风险。
    - CPU2 探底后编码器修正改用探底修正罐高参数，并在罐底实高偏差超过最大偏差时跳过编码修正。
    - 瓦锡兰分布测量后先移动到固定点监测位置，再执行探底；固定点移动或探底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
    [app_version.h, cpu2_communicate.c, dataanalysis_modbus.c, device_param_sync.c, display_tankopera.c, display_tankopera.h, font_check.py, measure.c]
2026-05-15 fix: 限制恢复重跑并修正罐底离底流程（CPU2 V1.7.1.1 / CPU3 V1.5.0.0）
    - CPU2：V1.7.0.0 -> V1.7.1.1。
    - CPU3：保持 V1.5.0.0。
    - 未改变 CPU2/CPU3 共享协议、寄存器映射或命令编号。
    - 读取部件参数命令仍可反复执行；本次只限制自动恢复后重入测量命令的次数。
    - 罐底粗找前增加离底确认：如果进入找底流程时已触底，先分段上行并复查，确保粗找从 NORMAL 状态开始。
    - 罐底精找前离底上行改为无称重检测，避免离底动作误触发称重碰撞报错。
    - 自动恢复新增测量重跑次数上限，同一条命令最多自动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
    [app_version.h, fault_recovery.c, measure_tank_height.c]
2026-05-16 修复LTD协议与瓦锡兰分布测量问题（CPU2 V1.7.1.2 / CPU3 V1.5.0.0）
    - CPU2：V1.7.1.1 -> V1.7.1.2。
    - 该历史提交未单列协议或兼容性说明；本次说明改写不改变该提交的文件树和程序行为。
    - 1. 修正LTD模式切换帧参数码和应答校验规则，避免正常传感器在回零或读取部件参数后误报13-13。
    - 2. 读取部件参数时先切换LTD密度模式并等待稳定，密度/频率未稳定时允许部分成功，不连带判失败。
    - 3. 优化固定点监测退出体验，传感器重试和稳定等待支持命令切换快速打断，并补充稳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
    [LTD故障代码表.xlsx]
2026-05-16 修复: 完善液位同步和负位置保护（CPU2 V1.7.2.0 / CPU3 V1.5.0.0）
    - CPU2：V1.7.1.2 -> V1.7.2.0。
    - 不修改 CPU2/CPU3 共享寄存器、命令码和数据结构字段含义
    - 不升级 DEVICE_PROTOCOL_VERSION
    - 不修改本设备和瓦锡兰设备对应关系，CPU3 无需同步升级
    - 液位修正后强制刷新当前位置，并同步 oil_measurement.oil_level 和 density_distribution.Density_oil_level
    - 液位修正和罐高变化后改为按当前记步源刷新业务位置；电机记步模式下使用 TMC5130 XACTUAL，不再强制使用外部编码轮覆盖 sensor_position
    - 编码器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
    [app_version.h, encoder.c, measure.c, measure_density.c, measure_tank_height.c, motor_ctrl.h, motor_ctrl_motion_api.c, motor_ctrl_position_model.c]
2026-05-16 docs: 整理项目文档目录（CPU2 V1.7.2.0 / CPU3 V1.5.0.0）
    - CPU2：保持 V1.7.2.0。
    - 不改变 CPU2/CPU3 共享协议。
    - 不包含 SI7000 协议适配代码或 SI7000 专项文档内容。
    - 将根目录 docs 按构建与版本、协议与寄存器、需求与计划、问题分析与整改、界面与菜单、测试记录归档。
    - 将 CPU2/CPU3 子项目文档迁移到对应中文分类目录，并补充 README 索引。
    - 更新项目 README 的文档入口，清理英文或无业务含义文件名。
    - 保留芯片型号、协议名、日志扩展名等必要英文命名。
    - git dif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
    [DSM寄存器说明V1.225.xlsx, LTD故障代码表.xlsx]
2026-05-19 fix: 增加罐底下行保护并修复回零误报（CPU2 V1.7.3.0 / CPU3 V1.5.0.0）
    - CPU2：V1.7.2.0 -> V1.7.3.0。
    - 本次仅修改 CPU2 罐底测量保护和称重碰撞判定逻辑。
    - 不修改 CPU2/CPU3 共享协议、寄存器映射、命令码或参数布局，DEVICE_PROTOCOL_VERSION 不变。
    - maxDownDistance 继续沿用原参数含义，不新增参数，不改变已有参数地址。
    - 罐底粗找和精找每轮下行前增加最大尺带长度保护，限制值为 tankHeight + maxDownDistance。
    - 当尺带长度超过最大允许位置且仍未识别到罐底时，立即快速停机并返回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
    [app_version.h, measure_tank_height.c, weight.c]
2026-05-21 docs: 整理CH9141K无线滑环匹配资料（CPU2 V1.7.3.0 / CPU3 V1.5.0.0）
    - CPU2：保持 V1.7.3.0。
    - 未修改固件代码、参数存储、Modbus 映射或 CPU2/CPU3 共享协议。
    - 本次只整理蓝牙透传芯片资料和无线滑环匹配方案，不影响固件输出。
    - 将 CH9141K 规格书和 CH9141EVT 使用说明归档到 CPU2 芯片手册目录。
    - 将无线滑环人工匹配过程归档到通信与解耦目录。
    - 新增无线滑环设备端匹配方案，说明 CPU2 接管 UART6 执行 AT 指令、扫描连接、写入默认 MAC 和恢复透传的实施路径。
    - 更新 LTD_MAIN_CPU2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
2026-05-23 工具: 添加CPU2构建和ST-LINK下载任务（CPU2 V1.7.3.0 / CPU3 V1.5.0.0）
    - 不改变CPU2/CPU3共享协议，不影响固件输出。
    - 新增VSCode CPU2 CMake配置、编译任务。
    - 新增ST-LINK检测、下载、复位连接下载和编译并下载组合任务。
    - ST-LINK CLI按process任务直接调用，避免Program Files (x86)路径被PowerShell错误拆分。
    - git diff --cached --check
    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
2026-05-23 feat: 适配 SI7000 外部协议（CPU2 V1.8.0.0 / CPU3 V1.6.0.0）
    - CPU2: V1.7.3.0 -> V1.8.0.0
    - CPU3: V1.5.0.0 -> V1.6.0.0
    - DEVICE_PROTOCOL_VERSION 从 3 升级到 4。
    - CPU2/CPU3 需要同为协议版本 4，CPU3 才能完整获得 SI7000 转换所需的 profile 完成、探底参考、液位到达和偏差报警状态。
    - 新增 CPU3 SI7000 Modbus 从站和协议选择分发，集中处理线圈、寄存器、异常响应和影子区。
    - 扩展 CPU2/CPU3 共享测量状态，补充 profile 完成、探底参考、液位到达和偏差报警等状态。
    - 新增 CPU3 本地 RTC 时间接口，用于 SI7000 当前时间和 profile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
2026-06-01 fix: 调整 CPU2 串口 B/BE 低检测执行流程（CPU2 V1.8.1.0 / CPU3 V1.6.0.0）
    - CPU2：V1.8.0.0 -> V1.8.1.0。
    - CPU3：保持 V1.6.0.0。
    - 本次仅调整 CPU2 串口 B/BE 调试指令执行流程。
    - 不修改 Modbus、SI7000、CPU2/CPU3 共享寄存器映射、参数存储布局或 DEVICE_PROTOCOL_VERSION。
    - B<mm>、BE<mm>、S 后缀和 ,1 后缀命令格式保持兼容。
    - 将 process_command() 中 B/BE 分支前置到 MeasureStart() 之前，避免调试指令被测量初始化、称重、电机健康检查或历史错误码拦截。
    - 为 B/BE 增加专用低检测运动路径，直接写 TMC5130 RAMPMODE、VMAX、XTARG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
    [app_version.h, measure.c]
2026-06-01 feat: 完善无线滑环最近匹配正式命令与 MAC 显示（CPU2 V1.9.0.0 / CPU3 V1.6.0.0）
    - CPU2: V1.7.3.0 -> V1.9.0.0
    - 说明：CPU2 V1.8.0.0 作为无线滑环本地调试能力的阶段性开发口径，不单独发布。
    - DEVICE_PROTOCOL_VERSION: 3 -> 4。
    - 新增共享命令 CMD_PAIR_NEAREST_WIRELESS_SLIPRING = 117。
    - 在输入寄存器末尾追加 WirelessPairingStatus，用于发布匹配结果、从机 MAC、失败错误码和更新计数。
    - 旧 CPU2 不识别命令 117，需要依赖协议版本检查避免混用。
    - 新增 CH9141K AT 封装和 wireless_pairing 流程，保留 SPS、SP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
2026-06-02 docs: 整理下一步固件工作计划（CPU2 V1.9.0.0 / CPU3 V1.7.0.0）
    - CPU2：保持 V1.9.0.0。
    - CPU3：保持 V1.7.0.0。
    - 未修改 CPU2/CPU3 共享协议。
    - 新增 2026-06-02 下一步固件工作计划文档。
    - 按 P0/P1/P2 梳理蓝牙配置、传感器断线、电机定位、SI7000、急停、状态显示、自动恢复和 P2 扩展项。
    - 根据补充说明标记已确认和待确认问题。
    - git diff --check
    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
2026-06-02 feat: 支持 DSM V1.228 外部协议兼容（CPU2 V1.9.0.0 / CPU3 V1.8.0.0）
    - CPU3：V1.7.0.0 -> V1.8.0.0。
    - CPU2/CPU3 共享 DEVICE_PROTOCOL_VERSION 不变。
    - 本次仅调整 CPU3 外部 DSM 协议适配层，不修改 CPU2/CPU3 共享命令、共享参数语义或寄存器映射。
    - DSM V1.228 第 6 段保持寄存器按外部兼容占位处理，不落地到 CPU2 参数存储或内部状态机。
    - 增加 DSM V1.228 外部状态翻译、自检占位状态与兼容状态码。
    - 增加第 6 段保持寄存器零值占位响应，满足 DSM V1.228 新增区间读取兼容。
    - 调整 DSM 线圈命令映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
2026-06-03 fix: 限制单点目标位置范围并修正标定零点收尾（CPU2 V1.9.1.0 / CPU3 V1.8.0.0）
    - CPU2：V1.9.0.0 -> V1.9.1.0。
    - CPU3：保持 V1.8.0.0。
    - 不修改 DEVICE_PROTOCOL_VERSION。
    - 不修改 CPU2/CPU3 共享命令、共享参数语义、寄存器映射或共享结构体。
    - 单点测量和固定点监测参数仍可写入；执行时目标超出 blindZone 到 tankHeight 范围会报 PARAM_RANGE_ERROR 并阻止电机移动。
    - 新增 SinglePoint_CheckTargetPosition()，统一限制单点类目标位置。
    - 单点测量 singlePointMeasurementPosition 在移动前检查，超过零点或进入罐底盲区直接报错。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
    [app_version.h, measure.c, measure_density.c, motor_ctrl.c, motor_ctrl_driver_param.c, motor_ctrl_internal.h, motor_ctrl_motion_api.c]
2026-06-03 固件: 完善启动安全、串口调试状态和参数同步（CPU2 V1.10.0.0 / CPU3 V1.9.0.0）
    - CPU2: V1.9.1.0 -> V1.10.0.0
    - CPU3: V1.8.0.0 -> V1.9.0.0
    - DEVICE_PROTOCOL_VERSION: 5u -> 6u。
    - 新增 CPU2/CPU3 共享 STATE_DEBUG_MODE = 0x0033，用于串口调试期间在 CPU3 显示调试模式。
    - 原 reserved2 参数槽复用为 fault_auto_recovery_retry_limit，保持寄存器地址和后续字段不移动。
    - empty_weight 空载重量改为 int32_t 有符号 32 位参数解释，寄存器仍占 2 个 word，负值按补码传输。
    - CPU2/CPU3 需要成对升级到协议版本 6；旧版本混用应由协议兼容检查拦截。
    本次修改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
2026-06-04 fix: 优化 BE 连续换向和电机掉电恢复（CPU2 V1.11.0.0 / CPU3 V1.9.0.0）
    - CPU2：V1.10.0.0 -> V1.11.0.0。
    - CPU3：保持 V1.9.0.0。
    - 不修改 CPU2/CPU3 共享命令、共享状态、共享参数语义、寄存器映射或参数存储布局。
    - BE 旧命令 BE<mm>、BE<mm>S、BE<mm>,1 保持兼容。
    - 新增 BE<mm>,<速度m/min>,<加速度倍率>，速度按 m/min 解析，加速度按当前斜坡倍率临时写入。
    - BE 下行/上行改为速度模式长距离连续运动，到编码器目标只打印位置并立即换向，不再到位减速停机。
    - BE 异常、超时和提前停稳时先重新初始化电机，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
    [app_main.c, app_version.h, fault_manager.c, fault_recovery.c, measure.c, measure_zero.c, motor_ctrl.h, motor_ctrl_driver_param.c]
2026-06-06 build: 整理 CPU2 BSP 外设驱动目录（CPU2 V1.11.0.1 / CPU3 V1.9.0.0）
    - CPU2：V1.11.0.0 -> V1.11.0.1。
    - 不修改 CPU2/CPU3 共享命令、共享状态、共享参数语义、寄存器映射或 DEVICE_PROTOCOL_VERSION。
    - 外设驱动文件内容保持不变，仅调整目录位置；头文件名和对外 API 保持兼容。
    - 将 CPU2 TMC5130、AS5145、CH9141EVT、MB85RS2M 和 AD5421 外设驱动从 Drivers/Peripherals 迁移到 BSP/Peripherals。
    - 更新 CPU2 CMake 构建脚本，改从 BSP/Peripherals/src 编译并从 BSP/Peripherals/inc 引入头文件。
    - 同步更新 CPU2 相关文档路径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
2026-06-06 docs: 归档硬件原理图和ST功能安全资料（CPU2 V1.11.0.1 / CPU3 V1.9.0.0）
    - CPU2：保持 V1.11.0.1。
    - 未修改 CPU2/CPU3 源码、共享协议、寄存器或固件行为。
    - 本次提交不需要升级 DEVICE_PROTOCOL_VERSION 或固件版本。
    - 新增 07_硬件原理图目录，归档储罐自动计量仪原理图 PDF，并整理逐页硬件链路和固件关联点。
    - 新增原理图与 CPU2/CPU3 固件对照问题清单，并提供 Markdown 与 HTML 阅读版。
    - 归档 ST 官方 SIL、STM32F4 Safety Manual、FMEA/FMEDA、X-CUBE-STL 应用笔记和 X-CUBE-STL-F4 V2.0.0 包内文档。
    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
2026-06-06 feat: 新增四路继电器方式2报警输出（CPU2 V1.12.0.0，CPU3 V1.10.0.0）
    - CPU2: V1.11.0.1 -> V1.12.0.0
    - CPU3: V1.9.0.0 -> V1.10.0.0
    - DEVICE_PROTOCOL_VERSION: 6 -> 7。
    - DeviceParameters 在 reserved33 后新增 relayAlarm[4]，每路 13 个 32 位字段；删除旧 DO 报警字段后保持寄存器净增 98 个寄存器。
    - MeasurementResult 在无线滑环匹配状态后新增四路 RelayAlarmRuntimeState，每路 10 个输入寄存器，共 40 个。
    - CPU2/CPU3 必须同为协议版本 7 才能显示、写入和执行四路继电器方式2配置；旧协议由 CPU3 严格相等检查拦截。
    - CPU2 新增 Servic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
2026-06-06 refactor: 清理正式固件未用代码并整理文档资料（CPU2 V1.12.0.1 / CPU3 V1.10.0.1）
    - CPU2: V1.12.0.0 -> V1.12.0.1
    - CPU3: V1.10.0.0 -> V1.10.0.1
    - DEVICE_PROTOCOL_VERSION 保持 7，不改变 CPU2/CPU3 共享寄存器地址、字段含义、命令码、参数解释口径或外部协议响应语义。
    - 本次删除的是已确认未用、未进入正式调用链的旧接口、备用调试入口和历史兼容路径；CPU2 写入测量结果、CPU3 读取 CPU2 输入寄存器、SI7000 主分发和 DSM 主协议路径保留。
    - 删除源码后 CPU2/CPU3 hex 哈希发生变化，按构建产物变化升级 CPU2/CPU3 build 版本。
    本次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
    [LTD故障代码表.xlsx]
2026-06-08 chore: 纳入 CubeIDE 工程配置文件（CPU2 V1.12.0.1 / CPU3 V1.10.0.1）
    - CPU2：保持 V1.12.0.1。
    - CPU3：保持 V1.10.0.1。
    - 不涉及 CPU2/CPU3 共享协议变化
    - 不改变固件运行行为和对外兼容性
    - 调整 .gitignore，允许追踪 3 个固件工程的 CubeIDE/CubeMX 配置文件
    - 新增 LTD_MAIN_CPU2、LTD_DISPLAY_CPU3、WirelessHost_V4.1_init 的 .project/.cproject/.mxproject
    - 保留可复现的 IDE 工程配置，便于后续导入和维护
    - 已确认提交范围为 .gitignore 和 3 个工程目录下的 IDE 配置文件
    - 未运行固件构建；本次不修改源码、协议或构建产物
    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
2026-06-08 fix: 优化电机停止判定并整理继电器报警输出文档（CPU2 V1.12.0.2 / CPU3 V1.10.0.2）
    - CPU2：V1.12.0.1 -> V1.12.0.2。
    - CPU3：V1.10.0.1 -> V1.10.0.2。
    - DEVICE_PROTOCOL_VERSION 保持 7，不改变 CPU2/CPU3 共享寄存器地址、命令码、参数字段顺序或参数解释口径
    - CPU2 电机运动状态读取改为错误码加输出参数，TMC5130 通信失败会向上返回具体错误码，不再误判为已停止
    - CPU3 继电器相关菜单和文档统一为继电器报警输出口径，不改变协议布局
    - 统一 MotorCtrl_IsDriverMoving 和 MotorDriver_ReadMovingState 停止判定，综合 RAMPSTAT、V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
    [app_main.c, app_version.h, cpu2_communicate.c, dataanalysis_modbus.c, device_param_sync.c, display_tankopera.c, display_tankopera.h, motor_ctrl.h]
2026-06-09 fix: 修复电机停止等待并优化CPU3选择型菜单（CPU2 V1.12.1.0 / CPU3 V1.10.1.0）
    - CPU2：V1.12.0.2 -> V1.12.1.0。
    - CPU3：V1.10.0.2 -> V1.10.1.0。
    - DEVICE_PROTOCOL_VERSION 保持 7
    - 不改变 CPU2/CPU3 共享寄存器地址、字段数值编码、参数存储结构或外部协议响应语义
    - CPU2 修复停止命令后的刹停等待判定；普通运动到位仍保留 XTARGET/XACTUAL 差值检查
    - CPU3 仅优化 OLED 参数菜单的人机交互，数值编码和参数下发语义不变
    - CPU2 新增停止专用 MotorDriver_ReadStoppingState，停止等待只依据 RAMPSTAT.vzero 和 VACTUAL 判断物理停止
    - CPU2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
    [app_version.h, display_tankopera.c, motor_ctrl_driver_param.c, motor_ctrl_internal.h, motor_ctrl_motion_api.c, system_parameter.c]
2026-06-09 feat: 优化参数菜单状态页并修正只读显示（CPU2 V1.12.1.1，CPU3 V1.11.1.0）
    - CPU2: V1.12.1.0 -> V1.12.1.1
    - CPU3: V1.10.1.0 -> V1.11.1.0
    - DEVICE_PROTOCOL_VERSION 保持 7，不改变 CPU2/CPU3 共享寄存器地址、字段顺序、命令码、参数存储结构或外部协议响应语义。
    - CPU2 DEVICE_PARAM_VERSION 保持 3，DeviceParameters 结构大小和字段顺序不变，不触发旧 FRAM 参数恢复出厂。
    - CPU3 本机 FRAM 参数结构未新增字段；旧存储读取后会按协议收敛 COM 串口参数。
    - 只读版本、魔术字和 CRC 的修复只改变 CPU3 OLED 显示格式，不改变寄存器值、参数保存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
    [app_version.h, cpu3_comm_display_params.c, display.c, display_tankopera.c, display_tankopera.h, measure_tank_height.c, system_parameter.c, system_parameter.h]
2026-06-09 fix: 同步CPU2系统参数出厂默认值（CPU2 V1.12.1.2 / CPU3 V1.11.1.0）
    - CPU2：V1.12.1.1 -> V1.12.1.2。
    - CPU3：保持 V1.11.1.0。
    - DEVICE_PROTOCOL_VERSION 保持 7，不改变 CPU2/CPU3 共享寄存器、结构体、命令码或协议语义。
    - CPU2 DEVICE_PARAM_VERSION 保持 3，DeviceParameters 结构大小不变，旧 FRAM 参数通常保留。
    - 新默认值只在恢复出厂、FRAM A/B 均无效或首次写入参数区时生效。
    - 根据 LNG 计量仪屏幕菜单同步 11 项 CPU2 恢复出厂默认值。
    - 将位置源自动切换非法值和瓦锡兰探底间隔越界值的运行期回退值同步为新默认值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
    [app_version.h, system_parameter.c]
2026-06-09 feat: CPU3继电器报警阈值动态显示单位（CPU2 V1.12.1.2 / CPU3 V1.11.1.1）
    - CPU2：保持 V1.12.1.2。
    - CPU3：V1.11.1.0 -> V1.11.1.1。
    - DEVICE_PROTOCOL_VERSION 保持 7。
    - 不改变保持寄存器地址、字段顺序、命令码、DeviceParameters 结构大小、CPU2 参数存储格式或范围校验规则。
    - 本次仅改变 CPU3 OLED 参数菜单的单位显示，不改变参数写入值、倍率或 CPU2 执行逻辑。
    - R1~R4 的 HH/H/L/LL 报警阈值和报警滞回按同一路报警取值源动态显示单位。
    - 储罐液位、水位、浮子位置显示 mm；液相温度显示 ℃；无或非法值不显示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
2026-06-09 修正CPU3参数单位倍率与手输值存储（CPU2 V1.12.1.2 / CPU3 V1.11.1.2）
    - CPU3：V1.11.1.1 -> V1.11.1.2。
    - 背景：CPU3参数菜单中部分单位/倍率口径与CPU2实际算法不一致，密度手输值显示倍率和本地存储宽度也存在截断风险。
    - 主要改动：补齐电机限速、液位阈值、水位电容、探底角度等参数单位；将液位找液/滞后阈值改为整数Hz显示；将密度手输值修正为kg/m3 x10口径；将CPU3本地手输值字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
    [app_version.h, cpu3_comm_display_params.c, cpu3_comm_display_params.h, system_parameter.c]
2026-06-10 chore: 同步参数默认值、状态页矩阵和磁通量菜单文档（CPU2 V1.12.1.3 / CPU3 V1.11.1.4）
    - CPU2: V1.12.1.2 -> V1.12.1.3
    - CPU3: V1.11.1.2 -> V1.11.1.4
    - CPU2 DEVICE_PARAM_VERSION 保持 3，DeviceParameters 结构大小不变。
    - CPU3 本地参数结构和 CPU3_PARAM_VERSION 不变，从 V1.11.1.3 升级到 V1.11.1.4 不会触发本地显示/通信参数重建。
    - 本次追加改动仅恢复 CPU3 参数菜单显示名并同步文档说明，不改变寄存器地址、命令码、字段倍率、默认值或算法计算口径。
    - 同步 CPU2 系统参数出厂默认值和旧存储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
    [CPU3状态页显示参数矩阵.xlsx]
2026-06-11 chore: 忽略本地 worktree 目录（CPU2 V1.12.1.3 / CPU3 V1.11.1.4）
    - CPU2：保持 V1.12.1.3。
    - CPU3：保持 V1.11.1.4。
    - 背景：项目内创建 .worktrees 目录前，需要先确保该目录不会被误纳入版本控制。
    - 主要改动：
    - 在 .gitignore 中追加 .worktrees/ 忽略规则。
    - 验证方式：
    - git check-ignore -v .worktrees/ 确认目录忽略规则生效。
    - 影响范围：
    - 仅影响本地辅助 worktree 目录的 Git 跟踪规则，不改变固件源码和构建产物。
    验证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
2026-06-11 fix: 优化读取部件参数持续刷新与DSM兼容（CPU2 V1.12.2.0 / CPU3 V1.11.2.0）
    - CPU2: V1.12.1.3 -> V1.12.2.0
    - CPU3: V1.11.1.4 -> V1.11.2.0
    - DEVICE_PROTOCOL_VERSION 未升级，CPU2/CPU3 共享调试区寄存器地址保持不变。
    - DSM 0x0104 恢复一代上位机 X_Angele + 0x8000 解析口径。
    - 水位调试字段改名为 water_capacitance_x10，保留历史寄存器位置并明确单位为 0.1pF。
    - 读取部件参数命令在 STATE_READPARAMETEROVER 内部持续周期刷新，并保留命令切换打断路径。
    - CPU3 读取部件参数页面改为显示 debug_data 快照，避免沿用上一次业务测量结果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
    [app_version.h, dataanalysis_modbus.c, display.c, measure_density.c, stateformodbus.h, system_parameter.c, system_parameter.h]
2026-06-11 feat: 合入CPU2点动长距离运动接口（CPU2 V1.13.0.0 / CPU3 V1.11.2.0）
    - CPU2：V1.12.2.0 -> V1.13.0.0。
    - CPU3：保持 V1.11.2.0。
    - DEVICE_PROTOCOL_VERSION 保持 7，不新增 CPU2/CPU3 共享命令码、状态码、寄存器地址或参数字段。
    - CPU2 DEVICE_PARAM_VERSION 保持 3，DeviceParameters 结构大小不变，升级不会因参数存储版本触发恢复出厂。
    - BJ/BJP 仅为 CPU2 本地串口调试命令；既有 MotorCtrl_MoveToPosition 和 MotorCtrl_MoveAndWait 保持原有位置模式方案。
    - 暴露 TMC5130 速度点动接口 stpr_rotate，并在 stpr_stop 停机后恢复安全位置模式状态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
2026-06-11 chore: 拆分CPU2串口测试命令并整理构建流程（CPU2 V1.13.0.1 / CPU3 V1.11.2.0）
    - CPU2：V1.13.0.0 -> V1.13.0.1。
    - CPU2 DEVICE_PARAM_VERSION 保持 3，DeviceParameters 结构大小不变，升级到 V1.13.0.1 不会因参数存储版本触发恢复出厂。
    - CPU2 本地串口测试命令字符、参数格式和执行入口保持兼容，本次暂不区分正式/测试构建。
    - CPU3 屏幕资料和刷新问题分析只新增文档与资料归档，不改变 CPU3 固件代码或协议行为。
    - 将 CPU2 串口测试命令实现从 measure.c 拆到 test.c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
    [app_version.h, measure.c]
2026-06-11 feat: 新增CPU3屏幕亮度配置并优化OLED刷新恢复（CPU2 V1.13.0.1 / CPU3 V1.12.0.0）
    - CPU2：保持 V1.13.0.1。
    - CPU3：V1.11.2.0 -> V1.12.0.0。
    - DEVICE_PROTOCOL_VERSION 保持 7，不改变 CPU2/CPU3 共享命令、状态、输入寄存器和 CPU2 设备参数语义。
    - CPU2 DEVICE_PARAM_VERSION 保持 3，CPU2 参数存储结构和升级清参规则不变。
    - CPU3 本地参数版本 CPU3_PARAM_VERSION 从 0x0003 升至 0x0004；V3 升级保留既有显示/通信配置，屏幕亮度补默认中低挡并写回 V4。
    - 新增 HOLDREGISTER_CPU3_BRIGHTNESS 使用 CPU3 本地预留保持寄存器地址，不提升共享协议版本。
    本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
2026-06-11 fix: 优化CPU3长按确认进入配置菜单稳定性（CPU2 V1.13.0.1 / CPU3 V1.12.1.0）
    - CPU3：V1.12.0.0 -> V1.12.1.0。
    - DEVICE_PROTOCOL_VERSION 保持 7，不改变 CPU2/CPU3 共享命令、状态、寄存器或 CPU2 参数语义。
    - CPU3 本地显示/通信参数结构和 CPU3_PARAM_VERSION 保持 0x0004，不触发 CPU3 本地参数重建。
    - 本次只影响 CPU3 本地按键识别、长按进入配置菜单和长按返回确认页的 UI 操作体验。
    - 长按确认进入配置菜单阈值从约 3.0 秒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
    [app_version.h, display.c, exit.c, exit.h]
2026-06-11 fix: 优化瓦锡兰分布测量流程（CPU2 V1.13.1.0 / CPU3 V1.12.1.0）
    - CPU2：V1.13.0.1 -> V1.13.1.0。
    - CPU3：保持 V1.12.1.0。
    - 不修改 CPU2/CPU3 共享命令、状态、输入寄存器、共享结构体或设备参数字段语义。
    - 不修改外部 Wartsila 寄存器映射和 CPU3 外部 Wartsila 主站状态码表达。
    - CPU2 DEVICE_PARAM_VERSION 保持 3，DeviceParameters 结构大小不变，升级不触发恢复出厂参数。
    - 瓦锡兰分布测起始点定位和点间移动改为只按位置运行，不在运动中切液位模式或检测空气。
    - 到点后用密度模式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
    [app_version.h, measure.c, wartsila_density_measurement.c]
2026-06-11 fix: 修复电机绝对目标越界保护（CPU2 V1.13.2.0 / CPU3 V1.12.1.0）
    - CPU2：V1.13.1.0 -> V1.13.2.0。
    - DEVICE_PROTOCOL_VERSION 保持 7，不新增共享命令、状态、寄存器、结构体或设备参数字段。
    - CPU2 DEVICE_PARAM_VERSION 保持 3，DeviceParameters 结构大小不变，升级不触发恢复出厂。
    - 目标越界继续使用 PARAM_RANGE_ERROR (0x00110003)，不新增错误码。
    - 拆分编码器 tick 运动起步等待和到位等待，保留超时、误差和命令中断判断。
    - 精简 MotorCtrl_MoveAndWait 不可达重试框架，统一正式运动目标计算和速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
    [app_version.h, fault_recovery.c, motor_ctrl_motion_api.c]
2026-06-11 style: 统一自编源码中文注释格式（CPU2 V1.13.2.0 / CPU3 V1.12.1.0）
    - CPU2：保持 V1.13.2.0。
    - DEVICE_PROTOCOL_VERSION 不变
    - 暂存源码剥离注释和空白后与 HEAD 的可执行 token 一致，运行语义不变
    - 为 CPU2/CPU3/WirelessHost 自编源码补充中文说明注释
    - 将 C/C++ 注释统一为 /* ... */ 块注释，移除 // 注释形式
    - 整理块注释空格和行尾注释格式，满足 SIL 注释规范
    - 自编源码扫描：129 个 .c/.h，raw_double_slash_occurrences=0，decode_failures=0，replacement_char_files=0，double_quest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
    [AS5145.c, AS5145.h, TMC5130.c, TMC5130.h, TMC5130_Constants.h, TMC5130_Pins.h, TMC5130_Register.h, ad5421.c]
2026-06-12 style: 统一自编源码中文注释格式（CPU2 V1.13.2.0 / CPU3 V1.12.1.0）
    - 仅调整注释和空白格式，不改变 CPU2/CPU3 共享命令、状态、寄存器、结构体或设备参数字段。
    - 暂存源码剥离注释和空白后与提交前可执行 token 一致，运行语义不变。
    - 为 CPU2、CPU3 和 WirelessHost 自编源码补充中文说明注释。
    - 将 C/C++ 注释统一为 /* ... */ 块注释，移除 // 注释形式。
    - 整理块注释空格和行尾注释格式，满足 SIL 注释规范。
    - git diff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
2026-06-12 feat: 新增连续找液位方式并同步协议8（CPU2 V1.14.0.0 / CPU3 V1.13.0.0）
    - CPU2: V1.13.2.0 -> V1.14.0.0
    - CPU3: V1.12.1.0 -> V1.13.0.0
    - DEVICE_PROTOCOL_VERSION: 7 -> 8。
    - liquidLevelMeasurementMethod 保持原寄存器和字段位置，语义扩展为 0=相对频率、1=定频、2=密度连续找液位、3=超声预留、4=连续相对频率、5=连续定频。
    - CPU2/CPU3 必须同为协议版本 8；协议版本 7 不支持新执行路径和菜单语义。
    - CPU2 DEVICE_PARAM_VERSION 保持 3，DeviceParameters 结构大小不变，升级不因参数存储版本清参数。
    - CPU2 新增密度连续找液位/跟随闭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
2026-06-13 docs: 整理 CPU2 程序流程文档阶段稿（CPU2 V1.14.0.0 / CPU3 V1.13.0.0）
    - CPU2：保持 V1.14.0.0。
    - CPU3：保持 V1.13.0.0。
    - 本次为文档整理，不修改 Modbus 寄存器、命令码、参数语义或 CPU2/CPU3 共享协议。
    - 新增 LTD_MAIN_CPU2/docs/00_程序流程 统一入口、问题点总表、16 个功能域页面、流程样式脚本和源码扫描清单。
    - 补充 CPU2 HART 接口程序梳理文档和 CPU2 找液位详细流程梳理文档。
    - 更新 LTD_MAIN_CPU2 和根 docs 索引，补充新文档入口。
    - 当前 01-09 功能域已按业务级 SVG 深化；10-16 为统一流程初稿，后续继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
2026-06-13 feat: 优化电机点动与位置模式流程（CPU2 V1.14.0.1 / CPU3 V1.13.0.0）
    - CPU2：V1.14.0.0 -> V1.14.0.1。
    - DEVICE_PROTOCOL_VERSION 保持 8。
    - 未新增 CPU2/CPU3 共享命令、状态、寄存器或参数字段。
    - BJ/BJP 本地串口测试命令格式保持不变。
    - 新增 MotorMotionTargetPlan，统一相对运动、绝对位置运动和点动位置模式的目标规划、方向和范围检查口径。
    - 收敛运动前准备、命令切换中断、临时速度恢复、起步观察、运行期健康检查和停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
2026-06-13 docs: 整理CPU2和CPU3程序流程导航（CPU2 V1.14.0.1 / CPU3 V1.13.0.0）
    - CPU2：保持 V1.14.0.1。
    - 不改变 CPU2/CPU3 共享协议、寄存器布局、参数存储或固件运行行为。
    - 本次提交仅补齐程序流程资料和跨 CPU 文档导航，不影响现场固件兼容性。
    - 新增 CPU3 程序流程文档目录，覆盖启动调度、CPU2 内部通信、外部协议、DSM、Wartsila/SI7000、显示按键、菜单参数和本机参数恢复。
    - 新增 docs/00_程序流程导航 统一入口和跨 CPU 业务链路页面，串联液位、水位、密度、参数、故障和外部协议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
2026-06-13 feat: 增加读取部件参数蓝牙RSSI并优化CPU3菜单（CPU2 V1.15.0.0 / CPU3 V1.14.0.0）
    - CPU2：V1.14.0.1 -> V1.15.0.0。
    - CPU3：V1.13.0.0 -> V1.14.0.0。
    - feat: 增加读取部件参数蓝牙RSSI并优化CPU3菜单
    - py tools\check_wireless_rssi_contract.py
    - py tools\check_si7000_protocol_contract.py
    - py tools\check_density_level_control_contract.py
    - py tools\check_read_part_params_refresh_contract.py
    - py LTD_DISPLAY_CPU3\font_check.py
    - py tools\update_flow_navigation.py
    - cmake -S LTD_MAIN_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
    [CPU3状态页显示参数矩阵.xlsx]
2026-06-16 docs: 梳理CPU2和CPU3程序流程文档（CPU2 V1.15.0.0 / CPU3 V1.14.0.0）
    - CPU2：保持 V1.15.0.0。
    - CPU3：保持 V1.14.0.0。
    - 按当前代码整理 CPU2/CPU3 程序流程 HTML，补齐跨页导航和业务链路入口
    - 优化复杂 SVG 流程图显示规则，修正部分流程图重叠、压缩和可读性问题
    - 增加静态文档站点生成脚本，site 作为本地生成目录并加入忽略规则
    - py tools\\update_flow_navigation.py
    - py tools\\build_static_docs_site.py
    - SVG 节点重叠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
2026-06-17 feat: 新增AO模拟电流输出运行态与使能参数（CPU2 V1.16.0.0 / CPU3 V1.15.0.0）
    - CPU2：V1.15.0.0 -> V1.16.0.0。
    - CPU3：V1.14.0.0 -> V1.15.0.0。
    - DEVICE_PROTOCOL_VERSION: 9 -> 10。
    - 协议版本 10 在无线 RSSI 运行态后追加 AoOutputRuntime 输入寄存器尾段，发布 AO 目标电流、最近写入电流、来源、AD5421 故障标志、READFAULT 原始值、最近错误码和更新时间。
    - 协议版本 10 将原 reserved26 正式替换为 AoOutputEnable，地址保持 0x00C2-0x00C3，语义为 0=关闭、1=启用。
    - CPU2/CPU3 必须同为协议版本 10 才能正确读取 AO 运行态，并正确显示、写入和执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
2026-06-17 fix: 修复状态页刷新与参数范围校验（CPU2 V1.16.0.1 / CPU3 V1.15.0.1）
    - CPU2: V1.16.0.0 -> V1.16.0.1
    - CPU3: V1.15.0.0 -> V1.15.0.1
    - DEVICE_PROTOCOL_VERSION 保持 10，不新增 CPU2/CPU3 共享寄存器、命令码或输入寄存器尾段。
    - 协议版本 10 同时覆盖 AoOutputRuntime 输入寄存器尾段和 AoOutputEnable 保持寄存器语义。
    - CPU2 DEVICE_PARAM_VERSION 保持 3，DeviceParameters 结构大小不变；旧 FRAM 中 bottom_detect_mode 异常值运行期归零，保持寄存器读取路径按 0/非0 归一化为 0/1。
    - CPU3 状态页增加 2 秒运行数据采样节流，非采样周期只恢复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
    [app_version.h, dataanalysis_modbus.c, display.c, display_tankopera.c, system_parameter.c]
2026-06-17 feat: 增加CPU3 RTC LSE电池保持与屏幕校时（CPU2 V1.16.0.1 / CPU3 V1.15.0.2）
    - CPU2：保持 V1.16.0.1。
    - CPU3：V1.15.0.1 -> V1.15.0.2。
    - CPU2 DEVICE_PARAM_VERSION 保持 3，CPU3 本机参数版本保持 0x0004，不触发参数存储恢复出厂。
    - 新 CPU3 板优先使用外部 32.768 kHz LSE 和 VBAT 纽扣电池保持 RTC；旧板或 LSE 起振失败时自动回退内部 LSI。
    - CubeMX 工程启用 RTC/HAL RTC 文件，.ioc 配置 RTC 时钟优先为 LSE。
    - CPU3 系统时钟配置增加 LSE 失败兜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
2026-06-18 fix: 修复CPU3串口协议默认值与手动参数覆盖（CPU2 V1.16.0.1 / CPU3 V1.15.1.0）
    - CPU3：V1.15.0.2 -> V1.15.1.0。
    - DEVICE_PROTOCOL_VERSION 保持 10，不新增 CPU2/CPU3 共享寄存器、命令码或输入寄存器尾段
    - CPU2 DEVICE_PARAM_VERSION 保持 3，DeviceParameters 结构大小不变，不触发 CPU2 参数恢复出厂
    - CPU3 本机参数版本保持 0x0004，旧 FRAM 中合法 COM 串口配置继续保留
    - 修改 COM1/COM2/COM3 协议时自动带出对应协议默认串口参数
    - 波特率、数据位、校验和停止位允许后续单独修改，上电加载时只修正非法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
    [app_version.h, com_port_config.h, cpu3_comm_display_params.c, system_parameter.c]
2026-06-22 docs: 修正CPU2和CPU3流程文档显示与导航（CPU2 V1.16.0.1 / CPU3 V1.15.1.0）
    - CPU3：保持 V1.15.1.0。
    - 仅更新流程文档、导航样式和生成脚本，不改变固件运行行为、CPU2/CPU3共享协议或参数存储格式。
    - 修复CPU2/CPU3流程页SVG响应式显示、文字换行、横向溢出和选择器污染问题。
    - 补充CPU3外部COM串口重配安全点、DSM写保持寄存器到参数下发等业务级流程。
    - 重新生成统一入口、跨CPU链路导航和相关流程页跳转关系。
    - 同步流程文档相关索引、问题点和历史文档入口。
    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
2026-06-23 fix: 修复继电器报警限值写入（CPU2 V1.16.1.0 / CPU3 V1.15.2.0）
    - CPU2: V1.16.0.1 -> V1.16.1.0
    - CPU3: V1.15.1.0 -> V1.15.2.0
    - DEVICE_PROTOCOL_VERSION 保持 10，不新增共享寄存器、命令码或输入寄存器尾段。
    - CPU2 DEVICE_PARAM_VERSION 保持 3，DeviceParameters 结构大小不变，升级不会触发恢复出厂参数。
    - CPU3 本机参数版本保持 0x0004，不改变本机 FRAM 参数布局。
    - 修复 CPU3 菜单写入 CPU2 float 参数时的字序组织错误，使继电器报警 HH/H/L/LL 阈值和滞回可正确写入。
    - CPU3 本机参数写入时仅对非 float/double 参数应用 offset。
    - C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
    [app_version.h, display_tankopera.c, system_parameter.c]
2026-06-24 fix: 修复固定点定位点动两段减速（CPU2 V1.16.2.0 / CPU3 V1.15.2.0）
    - CPU2：V1.16.1.0 -> V1.16.2.0。
    - CPU3：保持 V1.15.2.0。
    - DEVICE_PROTOCOL_VERSION 保持 10；CPU2 DEVICE_PARAM_VERSION 保持 3，DeviceParameters 结构不变，不触发参数恢复出厂。
    - 正式固定点、密度分布、瓦锡兰测点和运行到指定位置改用 MotorCtrl_JogMoveToPosition；Jog 绝对定位按计算刹车距离切入 0.10m/min 低速，0.45mm 内慢停，取消低速段提前停机；最终误差超过 10mm 才返回 MEASUREMENT_POSITION_ERROR；同步版本记录、测试方案和流程文档。
    - cmake --bui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
    [app_version.h, measure.c, measure_density.c, motor_ctrl_motion_api.c, wartsila_density_measurement.c]
2026-06-24 feat: 改用蓝牙主从机链路并优化CPU3菜单（CPU2 V1.17.0.0 / CPU3 V1.16.0.0）
    - CPU2: V1.16.2.0 -> V1.17.0.0
    - CPU3: V1.15.2.0 -> V1.16.0.0
    - DEVICE_PROTOCOL_VERSION 保持 10，未新增或变更 CPU2/CPU3 共享寄存器、命令码、输入寄存器尾段或保持寄存器地址。
    - CPU2 DEVICE_PARAM_VERSION 保持 3，DeviceParameters 结构大小不变，不触发参数存储恢复出厂。
    - WIRELESS_HOST_COMM_TIMEOUT 和 WIRELESS_SLAVE_COMM_TIMEOUT 错误码数值保持不变，仅把现场语义和显示调整为蓝牙主机/蓝牙从机连接异常。
    - 旧无线主机/从机自身 8 字节通信模块移除后，传感器测量透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
2026-06-26 补充 CPU2 宏定义中文注释（CPU2 V1.17.0.0 / CPU3 V1.16.0.0）
    - CPU2: 保持 V1.17.0.0，未升级版本。
    - CPU3: 保持 V1.16.0.0。
    - DEVICE_PROTOCOL_VERSION 保持 10，不新增或变更共享寄存器、命令码、输入寄存器尾段或保持寄存器地址。
    - CPU2 DEVICE_PARAM_VERSION 保持 3，DeviceParameters 结构大小不变，不触发参数恢复出厂。
    - 本次只补充 #define 中文块注释，不修改宏值、业务逻辑、状态机、协议字段或构建配置。
    - 为 CPU2 自编代码中的 Application、Services、BSP/Peripherals 宏定义补充中文说明。
    - 覆盖测量流程、Mo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
2026-06-26 fix: 修复零点标定脱离误报并完善AO回读刷新（CPU2 V1.18.0.0 / CPU3 V1.16.0.0）
    - CPU2: V1.17.0.0 -> V1.18.0.0
    - CPU3: 保持 V1.16.0.0
    - DEVICE_PROTOCOL_VERSION 保持 10，不新增或变更 CPU2/CPU3 共享寄存器、命令码或状态契约。
    - DEVICE_PARAM_VERSION 保持 3，DeviceParameters 结构大小不变，升级不会触发恢复出厂参数。
    - 新增 AO400/AO1200/AO2000/AO2200/AOS 为 CPU2 本地串口正式回读测试命令，不影响 CPU3 菜单和外部协议。
    - 回零/零点标定的退让和脱离零点动作改用专用无称重保护下行，成功后重置稳定称重基准，避免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
    [LTD_MAIN_CPU2.ioc, ad5421.c, ad5421.h, ao_output.c, ao_output.h, app_main.c, app_version.h, measure_zero.c]
2026-06-26 fix: 修复继电器报警数据源和息屏开关立即生效（CPU2 V1.18.1.0 / CPU3 V1.16.1.0）
    - CPU2: V1.18.0.0 -> V1.18.1.0
    - CPU3: V1.16.0.0 -> V1.16.1.0
    - DEVICE_PROTOCOL_VERSION 保持 10，不改变 CPU2/CPU3 共享寄存器、命令码或参数存储结构。
    - CPU2 DEVICE_PARAM_VERSION 保持 3，DeviceParameters 结构大小不变，升级通常保留旧 FRAM 参数。
    - 修复修正液位和液位跟随后未恢复 probe_at_liquid_level/liquid_stable，避免继电器液位报警源变成 99999 无效值后不恢复。
    - 继电器温度报警源增加初始值 0 无效判定，避免温度未刷新时把 0.00 当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
    [app_version.h, cpu3_comm_display_params.c, relay_output.c]
2026-06-26 fix: 完善AO参数量程并同步协议文档（CPU2 V1.18.1.1 / CPU3 V1.16.1.1）
    - CPU2：V1.18.1.0 -> V1.18.1.1。
    - CPU3：V1.16.1.0 -> V1.16.1.1。
    - 原提交未单列协议或兼容性说明；本次仅规范提交信息，文件树和程序行为保持不变。
    - 对齐参考程序的 AO 液位量程、电流起止点和 AO 独立报警阈值。
    - 保留 CurrentRangeStart_mA / CurrentRangeEnd_mA 作为正常输出电流端点，复用 AO 起点液位和 AO 终点液位字段表达液位映射范围。
    - 限制 AO 初始/高位/低位/故障/调试电流为 3.20..24.00mA，并在运行期归一化后支持回读。
    - 同步 CPU3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
    [ao_output.c, app_version.h, cpu2_communicate.c, dataanalysis_modbus.c, device_param_sync.c, display_tankopera.c, display_tankopera.h, hostcommu_modbus.c]
2026-06-29 汇总测量流程显示参数与协议语义调整（CPU2 V1.19.0.0 / CPU3 V1.17.0.0）
    - CPU2：V1.18.1.1 -> V1.19.0.0。
    - CPU3：V1.16.1.1 -> V1.17.0.0。
    - 本次提交按当前工作区整体合并提交，覆盖前面多个对话形成的源码、协议、显示菜单、工具脚本和文档改动。
    - CPU2/CPU3 协议版本升至 12，命令 115 改为 CMD_RESERVED_CMD7，强制提零点入口、菜单映射和状态文案全部移除。
    - 修复修正液位和水位标定的 0.1mm 固定偏差，标定反算不再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
    [LTD_DISPLAY_CPU3.ioc, TMC5130.c, app_main.c, app_version.h, cpu3_comm_display_params.c, dataanalysis_modbus.c, device_param_sync.c, display.c]
2026-06-29 feat: 完成密度两位精度与菜单协议整理（CPU2 V1.20.0.0 / CPU3 V1.18.0.0）
    - CPU2: V1.19.0.0 -> V1.20.0.0
    - CPU3: V1.17.0.0 -> V1.18.0.0
    - CPU2/CPU3 共享协议版本从 12 升至 13。
    - 内部密度 raw 语义升级为 kg/m3 x100，CPU2 保持 DEVICE_PARAM_VERSION=3，通过旧 protocolVersion 做运行期迁移，不因本次升级恢复出厂参数。
    - DSM、Wartsila、SI7000 外部协议保持各自对外密度口径，LTD 自有协议支持两位小数密度。
    - 完成 CPU2 密度参数倍率、密度修正、液位阈值兼容迁移和浮点阈值比较修复。
    - 同步 CPU3 参数菜单排序、K1~K4 继电器显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
    [app_version.h, cpu3_comm_display_params.c, device_param_sync.c, display.c, display_tankopera.c, display_tankopera.h, measure.c, measure_density.c]
2026-06-29 fix: 修复参数打印分布悬停与菜单空闲退出（CPU2 V1.20.1.0 / CPU3 V1.18.1.0）
    - CPU2：V1.20.0.0 -> V1.20.1.0。
    - CPU3：V1.18.0.0 -> V1.18.1.0。
    - DEVICE_PROTOCOL_VERSION 保持 13；CPU2 DEVICE_PARAM_VERSION 保持 3，DeviceParameters 结构大小不变，不触发恢复出厂参数；CPU3 本机参数存储版本保持 0x0005。
    - 主要修改：重构 CPU2 参数打印和 Modbus 写参快照，保存前输出实际差异，command 与继电器清锁存不再触发 FRAM 保存；修复分布密度逐点悬停按秒配置后换算为毫秒执行；统一单点稳定窗口、密度 raw 到 kg/m3 x100 的调试显示口径，并收敛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
    [AS5145.c, app_version.h, display.c, display_tankopera.c, display_tankopera.h, hostcommu_modbus.c, measure_density.c, motor_ctrl_driver_param.c]
2026-06-29 docs: 统一整机文档库治理与迁移（CPU2 V1.20.1.0 / CPU3 V1.18.1.0）
    - CPU2: 不变
    - CPU3: 不变
    - 本次为文档库迁移、索引治理和本地输出清理，不修改固件源码、参数存储、共享协议或对外通信行为。
    - 将 CPU2/CPU3 单独 docs 资料按整机业务域整理到 docs/，补充文档库索引、治理清单、迁移映射和使用指南。
    - 将程序流程、协议资料、问题分析、测试记录、SIL 资料和硬件原始资料归档到统一目录，并删除旧 CPU docs 入口。
    - 明确 docs-site/site/tmp 仅作为本机预览或临时输出，不作为正式文档源，并清理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
    [LTD故障代码表.xlsx]
2026-06-29 fix: 修复编码器通信诊断与上电AT干扰（CPU2 V1.20.2.0 / CPU3 V1.18.2.0）
    - CPU2: V1.20.1.0 -> V1.20.2.0
    - CPU3: V1.18.1.0 -> V1.18.2.0
    - DEVICE_PROTOCOL_VERSION 保持 13，不新增共享命令、寄存器或状态字段。
    - CPU2 DEVICE_PARAM_VERSION 保持 3，DeviceParameters 结构大小不变，不触发恢复出厂参数。
    - CPU3 本机参数存储版本保持 0x0005。
    - 优化 AS5145 编码器错误处理，取消单帧错误立即重试和日志刷屏，改为稳定有效帧门控和连续错误阈值上报。
    - 增加编码器错误计数和最后错误原始帧记录，便于诊断校验失败、OCF 未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
    [AS5145.c, app_main.c, app_version.h, ch9141_at.c, ch9141_at.h, encoder.c, fault_manager.c]
2026-07-01 fix: 调整 AS5145 编码器 SSI 错误重试和持续故障上报（CPU2 V1.20.3.0 / CPU3 V1.18.2.0）
    - CPU2: V1.20.2.0 -> V1.20.3.0。
    - CPU3: V1.18.2.0 保持不变。
    - DEVICE_PROTOCOL_VERSION 保持 13，不新增共享命令、寄存器或跨 CPU 状态字段。
    - CPU2 DEVICE_PARAM_VERSION 保持 3，DeviceParameters 结构大小不变，不触发 FRAM 参数恢复出厂。
    - 调整 AS5145 SSI 错误处理为前 3 次立即重试，持续故障只输出一次诊断并保持 TIM1 后续采样。
    - 单个完整有效 SSI 帧即可建立首个可信位置，清理未使用的编码器错误统计缓存。
    - SPI busy 和 DMA 启动失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
    [AS5145.c, app_version.h]
2026-07-01 docs: 整理SI协议与Wartsila文档资料（CPU2 V1.20.3.0 / CPU3 V1.18.2.0）
    - CPU2: V1.20.3.0（文档提交，不升版）
    - CPU3: V1.18.2.0（文档提交，不升版）
    - 仅整理文档、索引和原始资料归档，不改变固件输出、CPU2/CPU3共享协议或现场参数兼容性。
    - 相关源码、构建配置和工具脚本改动仍保留在工作区，未纳入本次提交。
    - 将文档侧SI7000专题收敛为SI协议专题，并把原始附件搬入00_原始资料目录且保留原文件名。
    - 更新SI协议需求总览、兼容映射、PLC联调、后续清单、改动整理和流程导航文档。
    - 新增Wartsil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
    [2026-01-27_莆田现场Wartsila抓包数据处理.xlsx]
2026-07-01 feat: 落地SI协议独立Profile兼容（CPU2 V1.21.0.0 / CPU3 V1.19.0.0）
    - CPU2: V1.20.3.0 -> V1.21.0.0
    - CPU3: V1.18.2.0 -> V1.19.0.0
    - DEVICE_PROTOCOL_VERSION: 13 -> 14
    - CPU2 DEVICE_PARAM_VERSION 保持 3，不触发恢复出厂；原 reserved30~reserved33 复用为 SI profile 参数并在旧协议迁移/运行期归一化补默认值
    - CPU3 本机参数版本升至 0x0006，新增 SI 自动 profile 和报警限值参数
    - CPU2/CPU3 必须同为协议 14；协议 13 不能识别 CMD_SI_PROFILE、profile_source 和新参数语义
    - 新增 CMD_SI_PROFILE，00004 Profile、屏幕 SI Profile 和自动调度均走独立 SI profile 流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
2026-07-02 fix: 修复 SI Profile 点位和无检测运行通信（CPU2 V1.21.1.0 / CPU3 V1.19.1.0）
    - CPU2: V1.21.0.0 -> V1.21.1.0
    - CPU3: V1.19.0.0 -> V1.19.1.0
    - DEVICE_PROTOCOL_VERSION 保持 14，不新增共享命令、共享寄存器、输入寄存器长度或跨 CPU 状态字段。
    - CPU2 DEVICE_PARAM_VERSION 保持 3，DeviceParameters 结构大小和 FRAM 参数校验规则不变，不会因本次升级触发恢复出厂参数。
    - CPU3 本机参数存储版本保持 0x0006，不改变本机 FRAM 布局。
    - 仍要求 CPU2/CPU3 同为协议版本 14 才能正确使用独立 SI Profile 命令、参数和输入寄存器点阵。
    - CPU2 SI P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
    [LTD故障代码统一表.xlsx, LTD故障代码表.xlsx]
2026-07-06 fix: 补齐 SI Profile 完成后自动回液位跟随（CPU2 V1.21.2.0 / CPU3 V1.19.1.0）
    - CPU2: V1.21.1.0 -> V1.21.2.0。
    - CPU3: V1.19.1.0 保持不变。
    - CPU2 DEVICE_PARAM_VERSION 保持 3，DeviceParameters 结构大小和 FRAM 参数校验规则不变，不会触发恢复出厂参数。
    - CPU3 本机参数存储版本保持 0x0006，本次无 CPU3 固件行为变化。
    - CPU2 SI Profile 成功锁存并进入完成态后，在没有其它待执行命令时自动排队 CMD_FIND_OIL，下一轮主循环恢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
    [app_version.h, measure_density.c]
2026-07-08 fix: 优化液位跟随滞后确认与定频速度闭环（CPU2 V1.21.3.0 / CPU3 V1.19.1.0）
    - CPU2: V1.21.2.0 -> V1.21.3.0。
    - DEVICE_PROTOCOL_VERSION 保持 14，不新增共享命令、寄存器地址、输入寄存器长度或跨 CPU 状态字段。
    - CPU2 DEVICE_PARAM_VERSION 保持 3，DeviceParameters 结构大小和 FRAM 校验规则不变，升级不清参数。
    - oilLevelHysteresisTime 仅用于方法 0/1 跟随变化确认；速度闭环稳定等待固定 1000 ms，旧 FRAM 参数值保留。
    - 方法 0/1 跟随偏差超滞后阈值后，按 oilLevelHysteresisTime 连续确认，0 立即重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
    [app_version.h, measure.c]
2026-07-08 fix: 修复编码轮速度补偿参考长度（CPU2 V1.21.4.0 / CPU3 V1.19.1.0）
    - CPU2: V1.21.3.0 -> V1.21.4.0
    - CPU3: V1.19.1.0 保持不变
    - CPU2 DEVICE_PARAM_VERSION 保持 3，DeviceParameters 结构大小和 FRAM 校验规则不变。
    - 本次只修复 CPU2 电机速度补偿参考长度，不改变 CPU3 菜单、外部协议或参数存储布局。
    - 运行中速度刷新统一使用速度补偿参考长度 helper，编码轮模式先刷新业务尺带长度再计算 VMAX。
    - 修复编码轮模式误用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
    [app_version.h, motor_ctrl_driver_param.c]
2026-07-08 docs: 整理问题整改资料与文档库索引（CPU2 V1.21.4.0 / CPU3 V1.19.1.0）
    - CPU2：保持 V1.21.4.0。
    - CPU3：保持 V1.19.1.0。
    - docs: 整理问题整改资料与文档库索引
    - py tools\check_docs_structure.py
    - py tools\check_markdown_links.py docs\03_问题分析与整改
    - py tools\check_version_bumped.py
    - py tools\check_commit_subject_versions.py --subject "docs: 整理问题整改资料与文档库索引（CPU2 V1.21.4.0 / CPU3 V1.19.1.0）"
    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
2026-07-08 fix: 修复AD5421断环恢复与AO运行态错误处理（CPU2 V1.21.5.0 / CPU3 V1.19.1.0）
    - CPU2: V1.21.4.0 -> V1.21.5.0
    - DEVICE_PROTOCOL_VERSION 保持 14，不改变 CPU2/CPU3 共享命令、寄存器和状态字段。
    - DEVICE_PARAM_VERSION 保持 3，参数结构和 FRAM 校验规则不变，升级不会恢复出厂参数。
    - 新增 AD5421 按目标电流恢复接口，恢复序列保留控制寄存器回读校验和 READFAULT 诊断。
    - AO 运行期诊断异常后按节流恢复到当前目标或最近有效目标，恢复成功后不再写故障电流。
    - AO 运行期 AD5421 错误只记录 AO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
    [LTD_MAIN_CPU2.ioc, ad5421.c, ad5421.h, ao_output.c, app_main.c, app_version.h, main.h]
2026-07-11 feat: 闭环传感器编号、上电蓝牙检测和CPU2通信失败反馈（CPU2 V1.21.6.0 / CPU3 V1.20.0.0）
    - CPU2：V1.21.5.0 -> V1.21.6.0。
    - CPU3：V1.19.1.0 -> V1.20.0.0。
    - 版本与兼容性：
    - CPU2 V1.21.5.0 升级到 V1.21.6.0，CPU3 V1.19.1.0 升级到 V1.20.0.0。
    - CPU2/CPU3 共享协议版本保持 14，CPU2 DEVICE_PARAM_VERSION 保持 3，CPU3 本机参数版本保持 0x0006。
    - 升级不清除 CPU2 参数；CPU2/CPU3 需成对升级以获得完整的通信快照、写 ACK 和失败反馈语义。
    - CPU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
    [在线一体机对外Modbus协议V1.228.xlsx]
2026-07-11 feat: 新增LTD共享Modbus、CPU2串口命令严检和流程门禁（CPU2 V1.22.0.0 / CPU3 V1.21.0.0）
    - CPU2：V1.21.6.0 -> V1.22.0.0。
    - CPU3：V1.20.0.0 -> V1.21.0.0。
    - feat: 新增LTD共享Modbus、CPU2串口命令严检和流程门禁
    - CPU2 clean-first 构建通过：V1.22.0.0，text=279556，data=2328，bss=27552。
    - CPU3 clean-first 构建通过：V1.21.0.0，text=162408，data=37380，bss=60420。
    - LTD Modbus 契约检查通过；CPU2 串口命令面板 10 组 67 按钮一致。
    - 主机 GCC 以 -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
2026-07-11 docs: 整理故障码治理、协议附件和文档库资料（CPU2 V1.22.0.0 / CPU3 V1.21.0.0）
    - CPU2：保持 V1.22.0.0。
    - CPU3：保持 V1.21.0.0。
    - 本提交仅整理文档、Office/PDF 附件和故障码交付输出，不修改固件源码、共享寄存器布局或运行行为；CPU2 保持 V1.22.0.0，CPU3 保持 V1.21.0.0，共享协议版本保持 14。
    - 故障码治理：
    - 明确 73 项 CPU2/CPU3 共享故障码以 CPU2 ErrorCode 为权威来源，CPU3 本机扩展码以 CPU3 枚举和产生链路为准。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
    [LTD内部技术与治理资料.xlsx, LTD故障代码统一表.xlsx]
2026-07-13 feat: 发布故障码协议15、外部协议切换与诊断治理（CPU2 V1.23.0.0 / CPU3 V1.22.0.0）
    - CPU2：V1.22.0.0 -> V1.23.0.0（MINOR）
    - CPU3：V1.21.0.0 -> V1.22.0.0（MINOR）
    - DEVICE_PROTOCOL_VERSION 由14升级为15。
    - 共享故障码按九个责任域重编号，协议15与14及更早版本不兼容，CPU2/CPU3必须成对升级。
    - DEVICE_PARAM_VERSION保持3，DeviceParameters布局不变，本次升级不会因参数布局变化恢复出厂参数，因此不升级软件MAJOR。
    - 完善TMC5130、AD5421、AO延迟诊断及传感器、无线、测量和参数错误归因。
    - 新增CPU3功能码0x46协议切换帧，A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
    [LTD内部技术与治理资料.xlsx, LTD故障代码统一表.xlsx]
2026-07-13 chore: 流程导航与工具脚本改为本地维护（CPU2 V1.23.0.0 / CPU3 V1.22.0.0）
    - CPU2 V1.23.0.0、CPU3 V1.22.0.0 均保持不变。
    - 本次只调整Git纳管边界，不改变固件输出。
    - DEVICE_PROTOCOL_VERSION保持15。
    - 不改变CPU2/CPU3共享寄存器、命令、状态或参数语义。
    - 停止跟踪docs/00_程序流程导航/与tools/，保留本地文件继续生成、更新和同步。
    - 补充忽略规则及本地维护说明。
    - 保留本地提交标题钩子恢复约束。
    - git diff --cached --check通过。
    - 与原提交树比较，仅保留上一提交的软件版本修正、测试方案重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
2026-07-14 feat: 新增CPU2设备侧安全传感器协议、完整参数分页读取并保留旧协议回退（CPU2 V1.24.0.0 / CPU3 V1.22.0.0）
    - CPU2：V1.23.0.0 -> V1.24.0.0（MINOR）
    - CPU3：保持 V1.22.0.0
    - DEVICE_PROTOCOL_VERSION 保持 15；SAFE_SENSOR=14 和 READ_PARAM_PAGE 仅属于 CPU2 与传感器之间的设备侧协议，不改变 CPU2/CPU3 共享寄存器、字段布局、命令、状态或消费语义
    - 传感器安全协议保持 V1；READ_PARAM_PAGE(0x63) 由 CAP_PARAM_RW 单独声明，无该能力的原 V1 传感器仍可激活并执行既有测量
    - DEVICE_PARAM_VERSION 保持 3；DeviceParameters 布局、元信息和 CRC 范围不变，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
2026-07-14 feat: 按二代计量仪责任域重构故障码并同步双端显示（CPU2 V1.25.0.0 / CPU3 V1.23.0.0）
    - CPU2：V1.24.0.0 -> V1.25.0.0（MINOR）
    - CPU3：V1.22.0.0 -> V1.23.0.0（MINOR）
    - DEVICE_PROTOCOL_VERSION：15 -> 17；协议16仅为未发布的开发过渡。
    - 协议17重新分类、删减并重编号共享故障码，CPU2和CPU3必须成对升级。
    - DEVICE_PARAM_VERSION保持3，CPU3本机参数版本保持0x0006，升级不会清除现场参数。
    - 按二代计量仪责任域同步CPU2/CPU3故障码定义、日志名称、原因映射和屏幕显示。
    - 当前保留61项使用中故障、3项预留故障，12项停用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
    [LTD内部技术与治理资料.xlsx, LTD故障代码统一表.xlsx]
2026-07-15 feat: 根据现场抓包进一步兼容SI协议（CPU2 V1.26.0.0 / CPU3 V1.24.0.0）
    - CPU2：V1.25.0.0 -> V1.26.0.0。
    - CPU3：V1.23.0.0 -> V1.24.0.0。
    - feat: 根据现场抓包进一步兼容SI协议
    - CPU2、CPU3 clean-first构建通过，生成V1.26.0.0和V1.24.0.0固件。
    - SI共享契约、Modbus Golden Frame、RSSI契约、版本门禁、文档、编码、注释和Git空白检查通过。
    - 尚未完成真实RS485、PLC响应时延、FRAM故障注入、快速重启、跨日调度和Complete边沿高频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
2026-07-16 feat: 发布协议21故障码、AO配置与通信一致性（CPU2 V1.27.0.0 / CPU3 V1.25.0.0）
    - CPU2：V1.26.0.0 -> V1.27.0.0（MINOR）
    - CPU3：V1.24.0.0 -> V1.25.0.0（MINOR）
    - DEVICE_PROTOCOL_VERSION 由18升级到21，统一发布协议19故障码治理、协议20 AO配置与运行态、协议21固定点结果代际；18/21、19/21和20/21混搭均严格拒绝运行。
    - 协议21新增0x0A44单点测量完成代际、0x0A46固定点监测样本代际，REG_ENG调整为0x0A48。
    - CPU2 DEVICE_PARAM_VERSION保持3、CPU3本机参数存储保持V7；结构大小和FRAM布局不变，AO复用既有保留槽并迁移合法旧值，不因本次升级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
    [LTD内部技术与治理资料.xlsx, LTD故障代码统一表.xlsx, LTD故障代码统一表（非正式版本）0715.xlsx, NMS81_4-20mA输出菜单配置清单.xlsx]
2026-07-17 feat: 发布协议23故障码、AO分布同步与现场兼容（CPU2 V1.28.0.0 / CPU3 V1.26.0.0）
    - CPU2：V1.27.0.0 -> V1.28.0.0（MINOR）
    - CPU3：V1.25.0.0 -> V1.26.0.0（MINOR）
    - DEVICE_PROTOCOL_VERSION由21升级到23；协议22未单独发布，其共享故障码重排随协议23首次正式发布。
    - 协议23沿用协议22故障编号，收敛AO故障动作与非跟随输出语义；协议21、22、23固件不得交叉混搭。
    - CPU2 DEVICE_PARAM_VERSION保持3，CPU3本机参数版本保持V7；AO继续复用原13个持久化槽，升级不清除其它现场参数。
    - 按一代同义子码和最低可用子码规则重排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
    [LTD内部技术与治理资料.xlsx, LTD故障代码统一表.xlsx, 多协议命令闭环矩阵.csv]
2026-07-17 feat: 发布协议24 AO过程保持与CPU2通讯健康（CPU2 V1.29.0.0 / CPU3 V1.27.0.0）
    - CPU2：V1.28.0.0 -> V1.29.0.0（MINOR）
    - CPU3：V1.26.0.0 -> V1.27.0.0（MINOR）
    - DEVICE_PROTOCOL_VERSION由23升级到24；AO输出源1、初始电流和运行态来源语义不兼容，CPU2和CPU3必须成对升级。
    - CPU2 DEVICE_PARAM_VERSION保持3，DeviceParameters大小、13个AO槽位、FRAM元信息和CRC范围不变，不因本次升级恢复出厂参数。
    - CPU3本机参数版本保持V7；通信健康计数仅驻留RAM并在上电时清零，不进入共享协议或FRAM。
    - 旧FRAM中的output_source=1会由空高改按传感器位置解释，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
2026-07-18 feat: 新增CPU3通信诊断并修复点阵同步恢复（CPU2 V1.29.1.0 / CPU3 V1.28.0.0）
    - CPU2：V1.29.0.0 -> V1.29.1.0。
    - CPU3：V1.27.0.0 -> V1.28.0.0。
    - 完善 CPU2 分布点阵原子发布与 CPU3 同代恢复；新增 CPU3 异步通信诊断日志；移除 COM 路径忙等待并调整中断优先级；同步正式文档、问题台账与 AO 逻辑 PDF。
    - CPU2/CPU3 clean-first 构建通过；点阵、测量来源、通信超时、外部新鲜度、DSM/Wartsila/SI/LTD、ISR 边界、编码、Markdow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
    [LTD_DISPLAY_CPU3.ioc, app_main.c, app_version.h, cpu2_communicate.c, cpu2_communicate.h, cpu3_debug_log.c, cpu3_debug_log.h, device_param_sync.c]
2026-07-20 feat: 发布协议25水位参数并收口多协议资料（CPU2 V1.30.0.0 / CPU3 V1.29.0.0）
    - CPU2: V1.29.1.0 -> V1.30.0.0
    - CPU3: V1.28.0.0 -> V1.29.0.0
    - DEVICE_PROTOCOL_VERSION由24升级为25，双端严格匹配；协议25复用reserved3承载水位滞后时间预留参数，范围0..3600s、默认0，协议24及更早存储升级时归零且不清除其它现场参数。CPU2参数存储版本3和CPU3本机参数版本V7保持不变。
    - Wärtsilä FC10仅接受现场byteCount=quantity格式，标准2*quantity格式返回异常码0x03；SI继续沿用协议18契约，AO继续沿用协议24初始/过程/保持语义。
    - 打通水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
    [多协议命令闭环矩阵.csv]
2026-07-21 fix: 修复UART连续流量中断活锁并完善双端通信恢复（CPU2 V1.30.1.0 / CPU3 V1.29.1.0）
    - CPU2：V1.30.0.0 -> V1.30.1.0
    - CPU3：V1.29.0.0 -> V1.29.1.0
    - DEVICE_PROTOCOL_VERSION保持25，CPU2参数存储版本保持3，CPU3本机参数版本保持V7。
    - 不改变共享寄存器、功能码、命令、参数含义、FRAM布局、合法帧响应内容及外部协议格式。
    - CPU3四路UART统一隔离DMA收满和硬件错误，按端口退避恢复，DMA成功后再开启IDLE中断，并用前台健康代际约束IWDG。
    - CPU2修复512字节长度截断，统一四路DMA接收恢复，将HART与板间Modbus解析延后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
    [app_main.c, app_main.h, app_version.h, cpu2_communicate.c, cpu3_comm_display_params.c, cpu3_comm_display_params.h, hostcommu.c, usart.c]
2026-07-24 feat: 发布协议27固定地址并交付LH、AO修正与继电器维护闭环（CPU2 V1.31.0.0 / CPU3 V1.30.0.0）
    - CPU2：V1.30.1.0 -> V1.31.0.0（MINOR）
    - CPU3：V1.29.1.0 -> V1.30.0.0（MINOR）
    - DEVICE_PROTOCOL_VERSION由25提升到27；协议26的AO电流修正随协议27首个正式组合交付，CPU2和CPU3必须成对升级，旧紧凑地址程序不得混用。
    - CPU2 DEVICE_PARAM_VERSION保持3，DeviceParameters大小、字段偏移、struct_size、FRAM A/B地址和CRC范围不变；AO修正复用预留槽，旧协议存储升级时归零，不恢复出厂、不清除其它现场参数。
    - CPU3本机参数版本保持V7；LH和协议切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
    [ao_output.c, app_main.c, app_version.h, com_port_config.h, cpu2_communicate.c, cpu3_comm_display_params.c, dataanalysis_modbus.c, device_param_sync.c]
2026-07-24 feat: 补齐CPU3维护显示与LH状态投影并治理文档库（CPU2 V1.31.0.0 / CPU3 V1.31.0.0）
    - CPU2：保持V1.31.0.0，本次不修改CPU2固件行为。
    - CPU3：V1.30.0.0 -> V1.31.0.0（MINOR）
    - DEVICE_PROTOCOL_VERSION保持27；固定地址、命令118/119、AO修正、维护和继电器共享字段布局不变，双端继续按协议27配套。
    - CPU2 DEVICE_PARAM_VERSION保持3，CPU3本机参数版本保持V7；新增操作码、徽标记忆和LH投影均为CPU3运行态，不改变FRAM布局、不清现场参数。
    - LH对外状态语义收紧为手册白名单；未定义CPU2内部状态由原值透传改为待机兜底，LH主机需要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
    [app_version.h, display.c, display_tankopera.c, display_tankopera.h]
2026-07-24 fix: 缩短CPU2监督节拍并收紧双端持久参数写门禁（CPU2 V1.31.1.0 / CPU3 V1.31.1.0）
    - CPU2：V1.31.0.0 -> V1.31.1.0（PATCH）
    - CPU3：V1.31.0.0 -> V1.31.1.0（PATCH）
    - DEVICE_PROTOCOL_VERSION保持27；共享地址、字段、命令和外部合法帧格式不变。
    - CPU2 DEVICE_PARAM_VERSION保持3，DeviceParameters结构、字段偏移、FRAM A/B地址和CRC范围不变；CPU3本机参数版本保持V7，不恢复出厂、不清现场参数。
    - 本次改变持久参数写入的运行态权限，不改变已保存值的解释；CPU3只做快照预检查，CPU2仍拥有最终裁决。
    - CPU2 TIM4由约2秒调整为2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
    [LTD_MAIN_CPU2.ioc, app_version.h, cpu2_communicate.c, display_tankopera.c, fault_recovery.c, hostcommu_modbus.c, system_parameter.h]
2026-07-24 feat: 新增固定频率找液位与LH FC01并修复测量失败传播（CPU2 V1.32.0.0 / CPU3 V1.32.0.0）
    - CPU2：V1.31.1.0 -> V1.32.0.0（MINOR）
    - CPU3：V1.31.1.0 -> V1.32.0.0（MINOR）
    - DEVICE_PROTOCOL_VERSION保持27；板间共享地址、字段、命令和参数语义不变。
    - CPU2 DEVICE_PARAM_VERSION保持3，DeviceParameters结构、字段偏移、FRAM A/B地址和CRC范围不变；LF覆盖值只在单次运行生效，不写FRAM。
    - CPU3本机参数版本保持V7；LH新增FC01仅改变外部协议能力，不改变本机FRAM布局。
    - CPU2新增LF、LF=<频率>[,<死区>]和LF?串口调试闭环；按频差控制方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
    [app_version.h, ltd_sensor_communication.c, measure_density.c, serial_command.c, serial_command_parser.c]
2026-07-25 feat: 发布协议28参数事务、继电器配置校验与CPU3快照门禁（CPU2 V1.33.0.0 / CPU3 V1.33.0.0）
    - CPU2：V1.32.0.0 -> V1.33.0.0
    - CPU3：V1.32.0.0 -> V1.33.0.0
    - DEVICE_PROTOCOL_VERSION由27提升到28，CPU2/CPU3必须严格配套。
    - 不新增、删除或移动共享寄存器，不改变字段宽度、字序、命令值、设备状态或故障码。
    - DEVICE_PARAM_VERSION保持3，CPU3本机参数版本保持0x0007，不恢复出厂、不清除现场参数。
    - 为七个命令前置参数建立pending/active快照和逐字段ACK确认，以命令到达前最后一次CPU2 ACK成功值生效。
    - 活动态只放开命令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
2026-07-25 docs: 整理外部COM发现、版本与问题复核及油水硬件资料（CPU2 V1.33.0.0 / CPU3 V1.33.0.0）
    - CPU2/CPU3保持V1.33.0.0。
    - 本提交只整理正式资料，不修改固件版本。
    - DEVICE_PROTOCOL_VERSION保持28。
    - 不修改CPU2/CPU3共享协议、参数存储、外部协议实现或运行行为。
    - 新增CPU3外部COM 0xF8/0x47安全快速设备发现方案并更新协议索引。
    - 纳入协议27与LH适配改动及测试方案PDF。
    - 更新高价值问题分阶段整改方案、配套PDF和索引，并纳入故障码逐项核查PDF。
    - 新增电容式油水界面与原油含水率测量原理Markdown和自包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
2026-07-25 feat: 发布协议29故障码与CPU3通信启动优化（CPU2 V1.34.0.0 / CPU3 V1.34.0.0）
    - CPU2: V1.33.0.0 -> V1.34.0.0
    - CPU3: V1.33.0.0 -> V1.34.0.0
    - CPU2/CPU3共享协议28升级为29。
    - 取消12-11并交换18/21故障类别，不兼容旧故障码，不提供协议28兼容映射。
    - 将13-2统一为震动管频率异常并补齐OLED字库，将13-26密度上限调整为3000.0 kg/m³。
    - 保留12-6、15-16、21-5预留项，同步源码、工作簿、协议与正式文档。
    - 远程0x46仅切换协议并保持物理串口参数；屏幕切换继续应用协议默认模板。
    - CPU3启动增加1000 ms非阻塞外部COM保护，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
    [LTD内部技术与治理资料.xlsx, LTD故障代码统一表.xlsx]
2026-07-28 feat: 发布协议30编码器与掉电恢复整改（CPU2 V1.35.0.0 / CPU3 V1.35.0.0）
    - CPU2：V1.34.0.0 -> V1.35.0.0。
    - CPU3：V1.34.0.0 -> V1.35.0.0。
    - `DEVICE_PROTOCOL_VERSION 29 -> 30`，新增23-1～23-6共享故障码；CPU2/CPU3必须严格使用协议30配套。`DEVICE_PARAM_VERSION`保持3，CPU3参数版本保持0x0007，不清现场参数；编码器位置记录只写V2并兼容V1。
    - 实现编码器连续异常锁存、ISR延后处理、FRAM单所有者及A/B位置提交；增加24V ADC/DMA监控、局部恢复、运动门禁和紧急位置保存；位置不可信时允许回零/标定零点并传播标零持久化失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
    [LTD故障代码统一表.xlsx]
2026-07-29 feat: 新增扭力温度显示并修复标定与Newhall接收（CPU2 V1.36.0.0 / CPU3 V1.36.0.0）
    - CPU2: V1.35.0.0 -> V1.36.0.0
    - CPU3: V1.35.0.0 -> V1.36.0.0
    - DEVICE_PROTOCOL_VERSION 30 -> 31，复用0x0116~0x0117传递扭力模块温度原始位。
    - 双端保持严格相等门禁；DEVICE_PARAM_VERSION=3不变，不清现场参数。
    - Newhall候选帧统一校验22字节、CC 03 83帧头和BCC，合法后才更新重量、通信存活和温度。
    - CPU3在扭力标定等待页和读取部件参数完成页显示扭力温度。
    - 修复水位标定命令切换、AO写区间感知校验和零值罐高标定半生效。
    - 整理Newhal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
    [app_version.h, dataanalysis_modbus.c, display.c, display_tankopera.c, hostcommu_modbus.c, measure_tank_height.c, stateformodbus.h, system_parameter.c]
2026-07-29 fix: 修复CH9141K RSSI半ACK清理（CPU2 V1.36.1.0 / CPU3 V1.36.0.0）
    - CPU2: V1.36.0.0 -> V1.36.1.0
    - CPU3: 保持 V1.36.0.0
    - DEVICE_PROTOCOL_VERSION 保持 31
    - DEVICE_PARAM_VERSION 保持 3，参数结构与FRAM布局不变
    - RSSI开启前登记清理责任，半ACK后仍执行关闭
    - OFF/EXIT未确认时有界强制清理UART6与DMA残留
    - 透传RSSI阶段的STATE_SWITCH在清理后向上传递
    - RSSI契约、传感器故障契约、版本门禁和diff检查通过
    - CPU2 clean-first构建通过，两个HEX SHA-256一致
    - 真实CH9141K故障注入与恢复后首条DSM Cl响应尚未台架验证
    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
    [app_version.h, ch9141_at.c, ch9141_at.h, wireless_pairing.c]
2026-07-30 docs: 完善全工程中文代码注释（CPU2 V1.36.1.0 / CPU3 V1.36.0.0）
    - CPU2：V1.36.1.0（未变）
    - CPU3：V1.36.0.0（未变）
    - 仅修改注释，CPU2/CPU3 共享协议、参数存储和运行行为均不变。
    - 为 167 个 C/H 文件补充并优化中文函数、变量、宏定义和内部执行注释。
    - 函数采用完整标准 Doxygen 格式，宏按实际语义逐项说明；仅 DSM 连续同构密度地址统一说明。
    - 修正返回值含义写反或与当前实现不符的错误注释，保留原有有效说明。
    - 167/167 文件的可执行代码令牌与父提交一致，确认提交不含业务代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
    [AS5145.c, AS5145.h, TMC5130.c, TMC5130.h, TMC5130_Constants.h, TMC5130_Pins.h, TMC5130_Register.h, abortable_delay.c]
2026-08-07 fix: 修复液位标定AO量程并归档近期设计资料（CPU2 V1.36.2.0 / CPU3 V1.36.0.0）
    - CPU2：V1.36.1.0 -> V1.36.2.0
    - CPU3：保持 V1.36.0.0
    - CPU2/CPU3 共享协议版本保持 31，CPU2 参数存储版本保持 3；未改变既有外部通信协议兼容性。
    - 液位标定提交新罐高后立即归一化 AO 端点，避免旧动态量程阻塞后续写入或继续参与输出换算。
    - 归档故障码、协议、菜单、DSM 问题分析、传感器安全通信、CPU2 软件详细设计中期包及 DM4 V6.0 原理图资料，并补齐目录索引。
    - CPU2 clean-first 构建、参数/测量/AO/液位/传感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
    [LTD故障代码统一表.xlsx]
2026-08-07 docs: 整理安全传感器、DM4与架构资料并移除WirelessHost旧工程（CPU2 V1.36.2.0 / CPU3 V1.36.0.0）
    - CPU2：保持 V1.36.2.0
    - 未修改 CPU2/CPU3 固件、共享协议版本或参数存储版本；安全传感器 LTD 协议内容仍是前期需求沟通记录，不代表已实现或已确认兼容性。
    - 补充安全传感器前期 LTD 协议需求沟通记录，更新安全通信落地方案和需求目录。
    - 归档 CG01 V1.3、ER02 二代软件架构编制工作包、评审记录、架构文档及 Visio 源文件，并同步 CPU2 详细设计编制计划。
    - 更新 DM4 四代数字驱动 V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
2026-08-07 chore: 建立CUBE仓库级skill与提交硬门禁（CPU2 V1.36.2.0 / CPU3 V1.36.0.0）
    - 未修改固件、共享协议、外部协议或参数存储格式；本次仅调整仓库级协作规则、skill 与 Git 提交校验流程。
    - 将 CUBE 专项工作流迁入仓库级 `.agents/skills/cube-development/`，按固件、协议、安全、文档、版本和 Git 场景拆分引用资料。
    - 在 AGENTS.md 固化仓库级 skill 优先级、全部提交与指定范围语义、四段式提交正文及 `.agents/` 根目录边界。
    - 增加提交正文格式、提交范围和上下文快照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
2026-08-07 fix: 修复电机目标运动固定一小时超时（CPU2 V1.36.3.0 / CPU3 V1.36.0.0）
    - CPU2：V1.36.2.0 -> V1.36.3.0（PATCH）
    - DEVICE_PROTOCOL_VERSION 保持 31，CPU2/CPU3 共享命令、寄存器、状态和字段语义不变。
    - DEVICE_PARAM_VERSION 保持 3，参数结构和 FRAM 布局不变，升级不恢复出厂、不清除现场参数。
    - MOTOR_RUN_TIMEOUT 错误码、命令切换、碰撞检测、驱动健康检查和既有故障恢复策略不变。
    - 按计划距离和已生效线速度计算单次目标运动等待预算，取 max(1 小时, 理论时间 × 2 + 1 分钟)，并限制在 uint32_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
    [app_version.h, motor_ctrl_motion_api.c]
2026-08-07 chore: 固化CUBE工程技能与提交门禁（CPU2 V1.36.3.0 / CPU3 V1.36.0.0）
    - CPU2：V1.36.3.0 -> 保持不变
    - CPU3：V1.36.0.0 -> 保持不变
    - CPU2/CPU3 共享协议版本 31、CPU2 参数存储版本 3、CPU3 参数存储版本 0x0007 均保持不变。
    - 本次仅调整仓库规则、Codex 工程 skill 和 Git 跟踪边界，不改变固件、外部协议或现场兼容行为。
    - 将任务生命周期、工程地图、现场证据、正式 Word、docs-site 和验证证据规则整理为按需加载的仓库级 reference，并同步 skill 触发信息与界面元数据。
    - 增加上下文快照恢复、任务写入租约、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
    [LTD内部技术与治理资料.xlsx, LTD故障代码统一表.xlsx]
2026-08-07 fix: 修复DSM定长收帧与UART6透明链路交接（CPU2 V1.36.4.0 / CPU3 V1.36.0.0）
    - CPU2：V1.36.3.0 -> V1.36.4.0（PATCH）
    - CPU3：保持V1.36.0.0
    - DEVICE_PROTOCOL_VERSION保持31，DEVICE_PARAM_VERSION保持3，参数结构和存储布局不变，升级不清现场参数。
    - DSM线上命令与响应定义保持兼容；补齐既有CV/Cv六字节响应的事务层支持，不加入自动探测顺序。
    - 建立DSM命令级定长收帧和严格帧校验，修复特殊BCC截帧、宽松ACK、整数频率误拒绝、错误6/7误解析、UART错误丢失及误导日志。
    - 增加CH9141K UART6链路状态与有界恢复，严格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
    [app_version.h, ch9141_at.c, ch9141_at.h, dsm_sensor_communication.c, motor_ctrl_lost_step_detect.c, wireless_pairing.c]
2026-08-08 docs: 设计V2并整理传感器安全协议资料（CPU2 V1.36.4.0 / CPU3 V1.36.0.0）
    - CPU2：V1.36.4.0 -> V1.36.4.0，文档设计与整理不改变固件输出
    - CPU3：V1.36.0.0 -> V1.36.0.0，文档设计与整理不改变固件输出
    - CPU2/CPU3共享DEVICE_PROTOCOL_VERSION保持32，DEVICE_PARAM_VERSION和CPU3_PARAM_VERSION均不变
    - 传感器安全通信V1线上protocol_version=0x01及字节契约不变；V2为protocol_version=0x02的待评审候选设计，不允许失败后静默降级到V1
    - 本提交不改变现行固件、共享寄存器、命令、参数存储或已冻结V1协议行为
    - 将V2控制面收敛为HELLO、STA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
2026-08-08 feat: 新增多参数V4传感器主动与交互适配（CPU2 V1.37.0.0 / CPU3 V1.37.0.0）
    - CPU2：V1.36.4.0 -> V1.37.0.0（MINOR）
    - CPU3：V1.36.0.0 -> V1.37.0.0（MINOR）
    - CPU2/CPU3 DEVICE_PROTOCOL_VERSION由31提升到32，新增MULTIPARAM_V4_SENSOR=15共享语义；协议31及更早程序不能与协议32混搭。
    - CPU2 DEVICE_PARAM_VERSION保持3，CPU3本机参数版本保持0x0007；DeviceParameters结构、CRC和FRAM布局不变，升级不恢复出厂、不清除现场参数。
    - 多参数V4传感器协议与多参数传感器通信协议V3.0不兼容；固件分别保留V4和V3通信路径，降级前需关闭V4主动方式并改回旧固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
    [DM4传感器通讯方案V4.0原始工作簿.xlsx]
2026-08-08 docs: 更新SIL架构、传感器协议与硬件资料（CPU2 V1.37.0.0 / CPU3 V1.37.0.0）
    - CPU2：V1.37.0.0 -> V1.37.0.0（保持不变；本次仅修改文档与资料）
    - CPU3：V1.37.0.0 -> V1.37.0.0（保持不变；本次仅修改文档与资料）
    - CPU2/CPU3 共享协议保持 32 不变，CPU2 参数存储版本 3、CPU3 参数存储版本 0x0007 均保持不变；本次不修改固件、共享协议实现或参数存储。
    - ER02 V0.2 保留 CPU2 V1.36.3.0、CPU3 V1.36.0.0、共享协议 31 的实现事实冻结基线，并明确当前工作树为 CPU2/CPU3 V1.37.0.0、共享协议 32，后续吸收实现前仍需单独复核差异。
    - 传感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
2026-08-10 feat: 新增DSM版本识别与扩展参数读取（CPU2 V1.38.0.0 / CPU3 V1.37.0.0）
    - CPU2：V1.37.0.0 -> V1.38.0.0
    - CPU3：V1.37.0.0，保持不变
    - CPU2/CPU3共享协议保持32，CPU2参数存储版本保持3，不改变DeviceParameters、FRAM布局或CPU3对外协议
    - V1/V2仅在Cv通信超时且CV前缀为07时兼容；BCC、格式和UART错误保持原错误码，既有测水电容特殊映射、zero_cap和一代磁零点语义不变
    - 增加Cv/CV版本读取、RAM会话上下文和V3至V6维护线分类，版本读取失败后仍继续CN身份探测
    - 增加CK供电电压、CM密度分析定长收帧与有效位，CM区分27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
2026-08-10 feat: 发布协议33、AO千分之一毫安修正与V4交互闭环（CPU2 V1.39.0.0 / CPU3 V1.38.0.0）
    - CPU2：V1.38.0.0 -> V1.39.0.0
    - CPU3：V1.37.0.0 -> V1.38.0.0
    - CPU2/CPU3共享协议由32升至33；AO修正、最终目标与最近实发值统一为mA x1000，基础AO配置仍为mA x100，按base_mA_x100 * 10 + correction_mA_x1000计算。
    - CPU2参数存储版本保持3，CPU3参数存储版本保持0x0007；DeviceParameters大小、地址、元信息和CRC范围不变，不恢复出厂、不清其它现场参数。
    - 协议26～32的旧AO修正值乘10迁移，协议25及更早或未知版本归零；0.001mA仅为数字修正分辨率，不代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
    [ad5421.c, ad5421.h, ao_output.c, ao_output.h, app_version.h, dataanalysis_modbus.c, device_param_sync.c, display_tankopera.c]
2026-08-11 fix: 修正传感器识别与故障显示文案（CPU2 V1.39.1.0 / CPU3 V1.38.1.0）
    - CPU2：V1.39.0.0 -> V1.39.1.0
    - CPU3：V1.38.0.0 -> V1.38.1.0
    - 共享协议版本保持33，CPU2参数存储版本保持3，CPU3参数存储版本保持0x0007；参数结构、地址和CRC范围不变，升级不清现场参数。
    - V3、V4和DSM线上协议不变；仅修正识别路由、正识别号判据及V4识别时的临时交互模式切换。
    - 按R01分流多参数传感器代际，V3读取R22、V4读取R67；V3、V4和DSM均只接受正识别号，普通识别不再发送安全HELLO。
    - 主动V4识别时临时进入交互方式读取身份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
    [LTD故障代码统一表.xlsx]
2026-08-12 refactor: 优化显示字库索引与只读存储（CPU2 V1.39.1.0 / CPU3 V1.38.1.1）
    - CPU2：保持V1.39.1.0不变。
    - CPU3：V1.38.1.0 -> V1.38.1.1（BUILD）。
    - DEVICE_PROTOCOL_VERSION保持33，CPU2/CPU3参数存储版本均不变，不恢复出厂或清除现场参数。
    - OLED显示文案不变，493个保留字形与修改前首次命中点阵逐字节一致。
    - 删除StockMap及点阵中的7个重复项，统一0至492全局索引，并保留117个仅由静态扫描判定的候选未用字。
    - 将字库和绘制接口改为只读，data段相对基线减少16976字节；增加6条编译期断言并清除42处只读字符串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
2026-08-13 fix: 增加CPU3 UART5帧间静默保护（CPU2 V1.39.1.0 / CPU3 V1.38.2.0）
    - CPU2：V1.39.1.0，保持不变
    - CPU3：V1.38.1.1 -> V1.38.2.0
    - DEVICE_PROTOCOL_VERSION保持33；共享寄存器、帧格式、命令和参数语义不变，参数存储不变且不清除现场参数。
    - CPU3统一在CPU2响应结束后记录总线时刻，下一事务切换RS485发送方向前保证3 ms毫秒门限。
    - 保留原超时、失败、快照失效和恢复语义，不对FC10自动重发。
    - 补充现场证据边界、回归方案、版本记录和测试方案。
    - 协议33隔离基线下UART5帧间保护、通信超时、带参事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
    [app_version.h, cpu2_communicate.c]
2026-08-13 fix: 修正固定频率液位闭环与低液位保护（CPU2 V1.39.2.0 / CPU3 V1.38.2.0）
    - CPU2：V1.39.1.0 -> V1.39.2.0
    - CPU3：V1.38.2.0，保持不变
    - CPU2/CPU3 DEVICE_PROTOCOL_VERSION 保持 33，不新增或移动共享寄存器、命令、状态及字段。
    - CPU2 DEVICE_PARAM_VERSION 保持 3，DeviceParameters 结构与 FRAM 布局不变，升级不清除现场参数；LF 覆盖仍仅对本次运行有效。
    - 方法5直接使用 oilLevelFrequency，以 oilLevelThreshold 和 oilLevelHysteresisThreshold 分别控制首次搜索与持续跟随死区，按频差决定方向并限制速度。
    - 删除命中液体后的固定下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
    [app_version.h]
2026-08-13 feat: 增加外部协议只读查询（CPU2 V1.39.2.0 / CPU3 V1.39.0.0）
    - CPU2：V1.39.2.0，保持不变
    - CPU3：V1.38.2.0 -> V1.39.0.0
    - DEVICE_PROTOCOL_VERSION保持33，CPU3参数存储版本保持0x0007；不改变CPU2/CPU3共享协议、参数结构或FRAM布局，升级不清除现场参数。
    - 既有0x46协议切换目标和0x00 ACK保持兼容；新增0xFF只读查询及0x01查询响应，旧固件异常或超时由上位机按候选回退业务指纹。
    - CPU3统一管理入口返回当前外部COM运行态协议原始值，查询只返回HANDLED，不进入协议保存、FRAM写入或UART重配流程。
    - 保持指令切换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
2026-08-14 fix: 发布编码器连续性保护与诊断统计（CPU2 V1.40.0.0 / CPU3 V1.40.0.0）
    - CPU2：V1.39.2.0 -> V1.40.0.0
    - CPU3：V1.39.0.0 -> V1.40.0.0
    - CPU2/CPU3共享协议由33升级为34，同步12-6上电位置变化过大、12-13编码器线性度差和12-17编码器位置连续性异常的枚举、显示与资料口径；12-13当前仅保留诊断映射，不主动锁存停车。
    - CPU2 DEVICE_PARAM_VERSION保持3，CPU3 CPU3_PARAM_VERSION保持0x0007，参数结构和大小不变，升级不恢复出厂参数；编码轮周长零值在运行态归一为95.000 mm，FC10拒绝写入零值。
    - 将AS5145的10 ms SSI采样改为TIM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
    [LTD故障代码统一表.xlsx]
2026-08-17 docs: 校正正式资料版本与治理口径（CPU2 V1.40.0.0 / CPU3 V1.40.0.0）
    - CPU2：V1.40.0.0，保持不变
    - CPU3：V1.40.0.0，保持不变
    - DEVICE_PROTOCOL_VERSION保持34，CPU2参数存储版本保持3，CPU3本机参数版本保持0x0007；本提交只校正文档，不改变固件输出、共享地址、参数结构或兼容行为。
    - 将构建、版本、故障码和文档治理资料同步到CPU2/CPU3 V1.40.0.0、共享协议34及当前故障码统计口径。
    - 更新CPU2通信、LTD、DSM、SI、Wartsila、系统参数、CPU3界面与菜单等正式资料中的历史版本、现状和索引说明。
    - 将CPU3文档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
2026-08-17 fix: 修正方法5精细调速与AO禁用态硬件门禁（CPU2 V1.40.1.0 / CPU3 V1.40.0.0）
    - CPU2：V1.40.0.0 -> V1.40.1.0
    - DEVICE_PROTOCOL_VERSION保持34，CPU2 DEVICE_PARAM_VERSION保持3，CPU3参数版本保持0x0007；共享地址、命令、状态、参数结构和FRAM布局不变，升级不恢复出厂或清除现场参数。
    - 方法5首次换向后及持续跟随阶段按死区外频差使用0.0007~0.10 m/min二次曲线调速，新增精细速度运动入口并保留方向、驱动健康、位置、称重、碰撞和命令切换门禁。
    - 精细速度低于0.03 m/min时不套用原0.5 mm/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
    [ao_output.c, app_version.h, motor_ctrl.h, motor_ctrl_motion_api.c]
2026-08-17 fix: 修正OLED恢复闭环与命令确认页按键（CPU2 V1.40.1.0 / CPU3 V1.40.1.0）
    - CPU2：V1.40.1.0，保持不变
    - CPU3：V1.40.0.0 -> V1.40.1.0
    - DEVICE_PROTOCOL_VERSION保持34，CPU3参数版本保持0x0007；共享地址、命令、状态、故障、参数结构和FRAM布局不变，升级不恢复出厂或清除现场参数。
    - SSD1325硬恢复在复位释放后等待1 ms，清零完整128×80 GDDRAM，再恢复128×64可见窗口；底层返回首个HAL失败，显示层在恢复或清屏失败时终止当前帧。
    - 每轮OLED恢复最多连续尝试3次，达到上限后等待60秒窗口、SPI新错误或显式唤醒请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
    [app_version.h, display.c, display_tankopera.c, hgs.c, hgs.h]
2026-08-18 feat: 增加DM4 V4调试与通信质量监测（CPU2 V1.41.0.0 / CPU3 V1.40.1.0）
    - CPU2：V1.40.1.0 -> V1.41.0.0。
    - CPU3：保持V1.40.1.0。
    - CPU2/CPU3 DEVICE_PROTOCOL_VERSION保持34，CPU2 DEVICE_PARAM_VERSION保持3，不触发清参。
    - DM4 V4请求临时使用广播地址，接受设备地址应答且编号0为合法未初始化值；兼容无线滑环在主动帧中插入连续零字节。
    - 增加V4主动帧72字节P0至P14解析、通信质量统计、最近异常包记录和连续三包异常报警。
    - 增加主动/交互模式、通道开关、寄存器读写和质量查询串口调试命令，并打印探测及读取失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
2026-08-19 feat: 整理传感器分层并统一DM4身份（CPU2 V1.41.0.0 / CPU3 V1.40.1.0）
    - CPU2：V1.41.0.0。
    - CPU3：V1.40.1.0。
    - DEVICE_PROTOCOL_VERSION统一为35，CPU2与CPU3按DM4物理类型14及旧类型15迁移规则配套。
    - 保留DSM、Multiparam V3、DM4 V4和预留Safe协议边界；未改变已确认的协议帧和参数存储版本。
    - 完成传感器识别、运行态、驱动注册、UART6所有权、DSM/V3/DM4协议和维护诊断分层整理。
    - 增加DM4 V4主动/交互通信调试、通信质量监测、主动帧解析、功能使能互斥和异常包诊断支持。
    - 将液位重试策略收回液位业务模块，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
2026-08-19 修复无线滑环匹配后传感器识别与瞬时13-3（CPU2 V1.41.1.0 / CPU3 V1.40.1.0）
    - CPU2：V1.41.0.0 -> V1.41.1.0（PATCH）。
    - DEVICE_PROTOCOL_VERSION保持34；不新增或移动共享寄存器、命令、状态及字段。
    - CPU2 DEVICE_PARAM_VERSION保持3，参数结构、CRC和FRAM布局不变；旧无线RSSI匹配接口继续兼容。
    - 正式命令117在无线滑环连接保存后重新识别传感器，识别成功后才发布匹配成功；测量命令检测状态无效时主动重识别，失败则拒绝测量。
    - V4主动探测的预期静默只记录质量统计，不触发全局异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
    [app_version.h, measure.c, multiparam_v4_communication.h, multiparam_v4_diagnostics.c, sensor_detector.c, wireless_pairing.c, wireless_pairing.h]
2026-08-19 增加V3/V4串口写寄存器调试与通信安全保护（CPU2 V1.42.0.0 / CPU3 V1.40.1.0）
    - CPU2：V1.41.1.0 -> V1.42.0.0（MINOR）。
    - DEVICE_PROTOCOL_VERSION保持35，CPU2/CPU3共享寄存器、共享命令和参数存储结构不变。
    - CPU2 DEVICE_PARAM_VERSION保持3，旧参数存储可直接升级，不恢复出厂、不清除现场参数。
    - V3.0和V4.0协议帧保持兼容；V4 P65通信方式仍由V4I/V4A专用时序处理，普通V4写入使用已学习的单播地址。
    - V3W复用既有V3请求帧构造器，统一写入字节序，保留ACK、重试、TX/RX打印和读回校验。
    - 增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
2026-08-21 refactor: 整理CPU2测量流程模块并恢复探底兜底（CPU2 V1.42.1.0 / CPU3 V1.40.1.0）
    - CPU2：V1.42.0.0 -> V1.42.1.0
    - CPU3：V1.40.1.0 -> 保持 V1.40.1.0
    - CPU2/CPU3 DEVICE_PROTOCOL_VERSION 保持 35，不新增或移动共享寄存器、共享命令、共享状态和共享字段。
    - CPU2 DEVICE_PARAM_VERSION 保持 3，DeviceParameters 结构大小、字段偏移、struct_size、CRC 范围和 FRAM 布局不变；升级不恢复出厂、不清除现场参数。
    - CPU3 CPU3_PARAM_VERSION 保持 0x0007，CPU3 固件和外部共享区协议无需同步升级；正式测量命令编号、串口调试命令名称和既有外部协议地址保持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
2026-08-21 修复DM4 V4新数据状态发布（CPU2 V1.42.2.0 / CPU3 V1.40.1.0）
    - CPU2：V1.42.1.0 -> V1.42.2.0
    - CPU3：保持V1.40.1.0
    - DEVICE_PROTOCOL_VERSION保持35，DM4 V4帧格式、参数地址、D/S/L/M命令和当前广播地址策略保持兼容。
    - DEVICE_PARAM_VERSION保持3，参数存储结构、FRAM布局和现场参数兼容性不变。
    - 更新DM4 V4状态字解析、测量模式和独立功能开关处理。
    - 修正V3固定8字节控制帧及广播应答兼容路径，保留参数4负值快扫完成标志的绝对值解析。
    - 主动帧发布温度前校验Bit8，发布动态黏度和运动黏度前校验Bit10；密度读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
    [app_version.h, multiparam_v4_communication.h, multiparam_v4_interactive.c, multiparam_v4_internal.h, multiparam_v4_measurement.c, sensor_driver_registry.c, service_debug_sensor_protocol.c]
2026-08-24 fix: 修复连续速度与DM4密度等待并换版架构资料（CPU2 V1.42.3.0 / CPU3 V1.40.1.0）
    - CPU2：V1.42.2.0 -> V1.42.3.0（PATCH）。
    - CPU2/CPU3 DEVICE_PROTOCOL_VERSION保持35，不新增或移动共享寄存器、命令、状态和字段；CPU3无需升级。
    - CPU2 DEVICE_PARAM_VERSION保持3，DeviceParameters结构、CRC和FRAM布局不变，升级不恢复出厂、不清除现场参数。
    - DM4 V4帧格式、R04地址和有符号频率编码保持兼容；仅细化密度模式R04为0的未扫描等待语义，液位模式0和INT32_MIN的异常语义不变。
    - 连续速度运动增加独立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
    [app_version.h, motor_ctrl.c, motor_ctrl_driver_param.c, motor_ctrl_internal.h, motor_ctrl_motion_api.c, motor_ctrl_position_model.c, multiparam_v4_measurement.c, oil_level_position.c]
2026-08-25 fix: 修复密度读取模式前置（CPU2 V1.42.4.0 / CPU3 V1.40.1.0）
    - CPU2：V1.42.3.0 -> V1.42.4.0
    - CPU3：V1.40.1.0，保持不变
    - DEVICE_PROTOCOL_VERSION保持35，CPU2/CPU3共享协议不变
    - DEVICE_PARAM_VERSION保持3，参数结构和FRAM布局不变，升级不清除现场参数
    - DM4 V4、DSM和V3帧格式、命令码、参数地址及错误码保持兼容
    - 命令15读取密度前统一准备密度模式，V4和DSM成功后立即读取，V3保留3秒稳定等待
    - DM4普通通信自检和无线综合通信测试分别记录模式切换结果，切换失败时不继续读取密度
    - 同步CPU2版本头、CHANGELOG和V1.4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
    [app_version.h, part_diagnostics.c, service_debug_command.c]
2026-08-26 fix: 修复DM4综合通信自检判定（CPU2 V1.42.5.0 / CPU3 V1.40.1.0）
    - CPU2：V1.42.4.0 -> V1.42.5.0
    - DM4 V4、V3、DSM和CH9141K线上协议及错误码保持兼容
    - SC统一委托识别流程先监听V4主动帧，未命中后才查询蓝牙并在透传恢复后再次监听
    - V4交互模式空气中无有效密度时记录通信正常，主动流超时和其它错误仍按异常处理
    - 同步CPU2版本、CHANGELOG、串口调试说明和V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
    [app_version.h, service_debug_command.c]
2026-08-26 fix: CPU2 USART1 RX启用内部上拉（CPU2 V1.42.5.1 / CPU3 V1.40.1.0）
    - CPU2：V1.42.5.0 -> V1.42.5.1（BUILD）。
    - DEVICE_PROTOCOL_VERSION保持35，CPU2/CPU3共享寄存器、命令、状态和字段不变。
    - CPU2 DEVICE_PARAM_VERSION保持3，参数结构、FRAM布局和现场参数兼容性不变。
    - USART1帧格式、PA9/PA10复用、DMA和中断配置保持兼容，仅PA10 RX增加内部上拉。
    - USART1 MSP初始化拆分TX/RX GPIO配置，PA9保持GPIO_NOPULL，PA10 RX设置GPIO_PULLUP。
    - CubeMX .ioc同步记录PA10.GPIO_PuPd=GPIO_PULLUP，并新增V1.42.5.1改动与测试方案。
    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
    [LTD_MAIN_CPU2.ioc, app_version.h, usart.c]
2026-08-26 build: 增加CPU2 Debug/Release双构建（CPU2 V1.42.6.0 / CPU3 V1.40.1.0）
    - CPU2由V1.42.5.1升级为V1.42.6.0。
    - CPU3保持V1.40.1.0。
    - DEVICE_PARAM_VERSION保持3，CPU3_PARAM_VERSION保持0x0007，参数布局、元信息和CRC范围不变，升级不清除现场参数。
    - Debug保留USART1调试命令接收；Release关闭USART1 RX DMA、IDLE中断和恢复轮询，USART1发送及对外业务协议不变。
    - CMake增加CPU2_BUILD_VARIANT=debug|release和对应编译宏，固件固定名及版本名增加DEBUG或RELEASE后缀。
    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
2026-08-26 fix: 修复V4密度无效值误报通信故障（CPU2 V1.42.7.0 / CPU3 V1.40.1.0）
    - CPU2：V1.42.6.0 -> V1.42.7.0（PATCH）。
    - DEVICE_PROTOCOL_VERSION保持35，DEVICE_PARAM_VERSION保持3；CPU2/CPU3共享寄存器、命令、状态、字段和FRAM布局不变。
    - DM4 V4帧格式、交互读写流程和底层通信错误码保持兼容，仅调整密度测量参数无效时的上层归一化结果。
    - R04无效频率统一输出0，R07无效密度统一输出0，R06无效温度输出NaN。
    - 交互读取与主动帧读取采用一致的无效值处理；传输、应答、地址、BCC/CRC和模式错误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
    [app_version.h, multiparam_v4_measurement.c]
2026-08-26 docs: 更新项目资料索引并纳入WorkBuddy根目录白名单（CPU2 V1.42.7.0 / CPU3 V1.40.1.0）
    - CPU2 V1.42.7.0；CPU3 V1.40.1.0，文档与仓库规则改动不调整固件版本。
    - 不涉及协议、寄存器或通信兼容性变更。
    - 更新构建版本、协议、界面、SIL及总入口文档索引；补充架构设计资料；将 .workbuddy 纳入仓库根目录白名单及忽略规则。
    - 通过提交范围检查、暂存区空白检查、版本标题检查及仓库根目录布局检查。
    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
2026-08-27 fix: 增加V4事务帧间隔并提示负频率不稳定（CPU2 V1.42.8.0 / CPU3 V1.40.1.0）
    - CPU2：V1.42.7.0 -> V1.42.8.0（PATCH）。
    - DEVICE_PROTOCOL_VERSION保持35；CPU2/CPU3共享寄存器、共享命令、共享状态和共享字段不变。
    - CPU2 DEVICE_PARAM_VERSION保持3，DeviceParameters结构、CRC范围和FRAM布局不变，升级不清除现场参数。
    - DM4 V4帧格式、R/W/D/L/M/S命令、参数65切换和错误码保持兼容。
    - CPU2所有V4事务统一记录退出tick并在下一笔发送前施加至少30 ms帧间隔，覆盖有效应答、业务校验失败、异常帧和超时路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
    [app_version.h, multiparam_v4_interactive.c, multiparam_v4_internal.h, multiparam_v4_measurement.c]
2026-09-02 docs: 更新CPU2调试协议与SI对外PLC资料（CPU2 V1.42.8.0 / CPU3 V1.40.1.0）
    - CPU2：保持 V1.42.8.0，本次仅更新现有行为的正式文档和PDF。
    - CPU3：保持 V1.40.1.0，本次未修改固件源码或构建产物。
    - DEVICE_PROTOCOL_VERSION 保持35；CPU2参数存储版本保持3，CPU3本机参数版本保持V7，CPU2/CPU3共享寄存器、共享命令和存储布局均未改变。
    - 新增SI Modbus RTU对外PLC协议卷，整理当前功能码、寄存器、异常响应和Profile生命周期；这是对现有协议35实现的外部契约归档，不新增协议行为。
    - 更新CPU2串口调试命令协议卷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
2026-09-03 fix: 修复V4通信重试与频率判定（CPU2 V1.42.9.0 / CPU3 V1.40.1.0）
    - CPU2：V1.42.8.0 -> V1.42.9.0（PATCH）。
    - DEVICE_PROTOCOL_VERSION保持35，DEVICE_PARAM_VERSION保持3；共享协议、参数结构和FRAM布局不变，升级不清除现场参数。
    - DM4 V4帧格式、参数地址、功能码和错误码保持兼容；仅调整CPU2本地重试、日志及频率业务分层。
    - 幂等V4事务仅对五类通信错误最多尝试3次，并逐次打印TX/RX原包；写入和L/M等非幂等动作保持单次命令边界。
    - 读取部件参数复用相同通信重试；频率0按未稳定值停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
    [app_version.h, fault_recovery.c, multiparam_v4_communication.h, multiparam_v4_diagnostics.c, multiparam_v4_interactive.c, multiparam_v4_internal.h, multiparam_v4_measurement.c, oil_level_common.c]
2026-09-04 fix: 修复SI探底Point0与密度模式稳定读取（CPU2 V1.42.10.0 / CPU3 V1.40.1.0）
    - CPU2：V1.42.9.0 -> V1.42.10.0
    - CPU3：保持 V1.40.1.0
    - DEVICE_PROTOCOL_VERSION 保持 35，共享寄存器、命令、状态和 SI 对外语义不变。
    - DEVICE_PARAM_VERSION 保持 3，参数结构与 FRAM 布局不变，CPU3 无需升级。
    - 探底成功后直接以上提 100 mm 的当前实际位置为 Point0，本轮不再下行；复用旧底时按旧底上方 100 mm 恢复 Point0。
    - 每点到位后先切 D 模式，再执行 40003 停留，零值及非有限、非正值按未稳定继续读取。
    - 五分钟超时沿用原有最后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
    [app_version.h, measure_density_si.c]
2026-09-05 feat: 新增LED面板指示灯初始化（CPU2 V1.42.10.0 / CPU3 V1.41.0.0）
    - CPU2：保持 V1.42.10.0
    - CPU3：V1.40.1.0 -> V1.41.0.0
    - DEVICE_PROTOCOL_VERSION 保持 35，CPU3_PARAM_VERSION 保持 0x0007；共享协议、参数存储、串口、SPI 和 OLED 行为保持兼容。
    - 定义 WLED1=PF10、WLED2=PF0，并配置为低速推挽输出、无上下拉。
    - 初始化时将两个引脚置为低电平常亮，并同步 CubeMX .ioc 配置。
    - 更新 CPU3 版本、CHANGELOG 和改动与测试方案。
    - CPU3 V1.41.0.0 clean-first 构建通过，62 个目标完成；固定名和版本名 HEX 的 SHA-256 均为 067353FD8C41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
2026-09-05 修复方式5丢步检测并更新架构资料（CPU2 V1.42.11.0 / CPU3 V1.41.0.0）
    - CPU2：V1.42.10.0 -> V1.42.11.0（PATCH）
    - CPU3：保持 V1.41.0.0
    - DEVICE_PROTOCOL_VERSION 保持 35，CPU2 参数版本保持 3，CPU3 参数版本保持 0x0007
    - 共享寄存器、命令、状态、SI 对外协议和参数存储布局不变
    - 称重探底可靠性改造未纳入，普通液位向下绝对称重阈值保持原行为
    - 方式5按上一时段有效指令方向和速度积分期望位移，换向重建前沿，停止等待不累计位移
    - 业务位置、电机模型和编码器按指令方向累计有效前进量，低速检测启停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
    [app_version.h, motor_ctrl.h, motor_ctrl_lost_step_detect.c, oil_level_frequency.c]
2026-09-07 新增液位定时矫正与密度复核（CPU2 V1.43.0.0 / CPU3 V1.42.0.0）
    - CPU2：`V1.42.11.0 -> V1.43.0.0`（MINOR）。
    - CPU3：`V1.41.0.0 -> V1.42.0.0`（MINOR）。
    - 共享协议`35 -> 36`，CPU2/CPU3必须成对升级。新增32位保持寄存器`0x0904/0x0906`，分别为刷新开关0/1和周期60～10080分钟，默认0/1440，高字在前；新增共享故障15-34，不复用历史15-32/15-33。
    - CPU2存储版本3、CPU3本机参数版本0x0007保持不变，参数结构688字节、CRC偏移684和FRAM布局不变。新字段复用reserved10/11；兼容旧镜像补默认值，保留其它现场参数和协议33～35的AO修正，不因本次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
    [CUBE版本改动记录_售后版.xlsx, LTD故障代码统一表.xlsx]
2026-09-07 fix: 称重探底改用减重量并补齐下行保护（CPU2 V1.44.0.0 / CPU3 V1.43.0.0）
    - CPU2：V1.43.0.0 -> V1.44.0.0（MINOR）。
    - CPU3：V1.42.0.0 -> V1.43.0.0（MINOR）。
    - 共享协议36 -> 37，双板配套升级。原0x0216探底扭力阈值名称、地址、单位和数值保留，物理含义改为触底减重量；绝对下限固定500，不新增参数；0x0908仍只读预留。
    - CPU2存储版本3、CPU3本机版本0x0007、参数结构688字节、CRC偏移684和FRAM布局不变。从当前基线升级不清参、不转换原阈值；现场须按新含义复核，旧不兼容存储沿用历史处理。
    - 预计罐底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
    [CUBE版本改动记录_售后版.xlsx]
2026-09-08 docs: 收口 CUBE 规则、版本资料与问题台账（CPU2 V1.44.0.0 / CPU3 V1.43.0.0）
    - CPU2：V1.44.0.0 -> 保持；本次仅整理规则、版本资料、故障码和问题台账。
    - CPU3：V1.43.0.0 -> 保持；本次仅整理规则、版本资料、故障码和问题台账。
    - 共享协议保持当前资料中的协议版本 37；CPU2 DEVICE_PARAM_VERSION 保持 3、CPU3 本机参数版本保持 0x0007，现有参数结构和兼容约束不变。
    - 本次未修改固件、协议字段或参数结构，不新增硬件、RS485、现场或 SIL 验证结论。
    - 更新仓库 AGENTS 与 cube-development skill/reference，收敛任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
    [CUBE版本改动记录_售后版.xlsx, LTD故障代码统一表.xlsx, Ⅱ代储罐在线计量仪版本升级记录.xlsx]
2026-09-14 fix: 修复CPU3外部COM长期运行后的通信无响应（CPU2 V1.44.0.0 / CPU3 V1.43.1.0）
    - CPU2：保持 V1.44.0.0。
    - CPU3：V1.43.0.0 -> V1.43.1.0（PATCH）。
    - DEVICE_PROTOCOL_VERSION 保持37；CPU2/CPU3共享寄存器、命令、状态和外部协议帧格式不变。
    - CPU2 DEVICE_PARAM_VERSION 保持3，CPU3 CPU3_PARAM_VERSION 保持0x0007；参数结构、CRC和FRAM布局不变，升级不清除现场参数。
    - CPU3外部COM启动保护改为无符号tick经过时间比较，并在达到1000 ms后锁存就绪状态，避免HAL_GetTick长期运行回绕后重新停止处理COM1/COM2/COM3帧。
    - 保留屏幕、CPU2板间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
    [Ⅱ代储罐在线计量仪版本升级记录.xlsx]
2026-09-21 docs: 整理SIL模板与问题分析资料（CPU2 V1.44.0.0 / CPU3 V1.43.1.0）
    - CPU3：保持 V1.43.1.0。
    - DEVICE_PROTOCOL_VERSION 保持 37；本次仅整理文档、外部认证模板和硬件设计资料，不修改 CPU2/CPU3 共享寄存器、命令、状态、外部协议帧或参数存储。
    - CPU2 DEVICE_PARAM_VERSION 保持 3，CPU3 CPU3_PARAM_VERSION 保持 0x0007；不改变参数结构、CRC 或 FRAM 布局。
    - 新增 CPU2/CPU3 自编代码规模统计、CPU3 外部 COM 长期运行回绕、UART6/蓝牙现场证据和 SI-7000 线盘报警资料，并更新问题索引；明确 LR-01 已随 CPU3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
    [FMEDA分析报告示例_V0.0.2.xlsx, FMEDA模板.xlsx, IEC 61508 提交审核文件清单.xlsx, LTD故障代码统一表.xlsx, PCBA生产规范.xlsx, 人员能力评价表.xlsx, 文档管理清单.xlsx, 生产PFMEA分析报告.xlsx]
2026-09-21 fix: 清零液位跟随后的自动恢复重跑计数（CPU2 V1.44.1.0 / CPU3 V1.43.1.0）
    - CPU2：V1.44.0.0 -> V1.44.1.0（PATCH）。
    - DEVICE_PROTOCOL_VERSION 保持 37；共享寄存器、命令、状态及 CPU2/CPU3 配套关系不变。
    - CPU2 DEVICE_PARAM_VERSION 保持 3，CPU3 CPU3_PARAM_VERSION 保持 0x0007；参数结构、CRC 范围和 FRAM 布局不变，升级不恢复出厂、不清除现场参数。
    - 液位业务成功写入 STATE_FLOWOIL 后，仅在活动自动恢复上下文中清零 command_retry_count。
    - 后续连续无法进入跟随状态时仍按既有 fault_auto_recovery_retry_lim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
    [Ⅱ代储罐在线计量仪版本升级记录.xlsx]
2026-09-24 fix: 修复继电器报警参数非对齐访问风险（CPU2 V1.44.2.0 / CPU3 V1.43.1.0）
    - CPU2：V1.44.1.0 -> V1.44.2.0（PATCH）
    - CPU3：保持 V1.43.1.0
    - DEVICE_PROTOCOL_VERSION 保持 37，CPU2 DEVICE_PARAM_VERSION 保持 3；ARM 下继电器配置偏移 458、参数总大小 682、CRC 和 FRAM 布局不变，升级不清参数。
    - 将 RelayAlarmConfig 明确为 1 字节对齐类型，避免非对齐浮点配置访问触发 HardFault。
    - 增加子结构大小、对齐、父结构偏移和总大小的编译期断言。
    - 同步 CPU2 版本头、CHANGELOG、售后版本记录和改动与测试方案。
    - CPU2 V1.44.2.0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
    [Ⅱ代储罐在线计量仪版本升级记录.xlsx]
2026-09-24 fix: 将继电器报警屏蔽收口为维护模式控制（CPU2 V1.45.0.0 / CPU3 V1.44.0.0）
    - CPU2：V1.44.2.0 -> V1.45.0.0
    - CPU3：V1.43.1.0 -> V1.44.0.0
    - DEVICE_PROTOCOL_VERSION 从 37 提升到 38；manual_alarm_inhibit 保留地址、宽度和结构位置但固定发布 0，继电器实际屏蔽及 K1 至 K4 最终逻辑动作仅由 maintenance_mode_active 控制。
    - 协议 37/38 字段语义不兼容，CPU2/CPU3 必须成套升级，混用由严格相等门禁拦截；双端参数存储版本、结构大小、CRC 范围和 FRAM 布局不变，升级不清现场参数。
    - 删除普通及强制上下行对人工报警屏蔽字段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
    [Ⅱ代储罐在线计量仪版本升级记录.xlsx]
2026-09-24 fix: 修复无线状态格式异常直接停机（CPU2 V1.45.1.0 / CPU3 V1.44.0.0）
    - CPU2：V1.45.0.0 -> V1.45.1.0
    - CPU3：保持 V1.44.0.0
    - DEVICE_PROTOCOL_VERSION 保持 38，CPU2/CPU3 共享命令、寄存器、状态、错误码数值和字段语义不变。
    - CPU2 参数存储版本保持 3，DeviceParameters 及 FRAM 布局不变；本次仅调整 CPU2 内部只读无线状态诊断恢复。
    - 无线状态格式异常最多重做三次完整只读事务，每次安全完成 RSSI 清理、退出 AT 和 UART6 透明交接后再重试。
    - 连续三次格式异常且交接安全时发布无效快照并继续其它部件诊断；非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
    [Ⅱ代储罐在线计量仪版本升级记录.xlsx]
2026-09-28 feat: CPU3设备状态页新增俄文显示（CPU2 V1.45.1.0 / CPU3 V1.45.0.0）
    - CPU2：V1.45.1.0 -> V1.45.1.0（保持不变）
    - CPU3：V1.44.0.0 -> V1.45.0.0（MINOR）
    - DEVICE_PROTOCOL_VERSION 保持 38，CPU2/CPU3 共享寄存器、命令、状态和错误码语义不变；CPU2 参数存储版本保持 3。
    - CPU3 本机参数存储由 V7 升至 V8，保留合法显示、SI、串口及兼容槽参数并更新本机版本；非法语言回退英文，非法串口字段按协议 profile 修正。旧固件降级读取 V8 时会恢复本机默认参数。
    - 统一管理稳定语言编号和页面文本域；设备状态页及启动通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
    [Ⅱ代储罐在线计量仪版本升级记录.xlsx]
